pratham-cloud-ctrl/Project-ATO/docs/README.md

# Project ATO documentation

**[Open the browser build inspector](https://pratham-cloud-ctrl.github.io/Project-ATO/)**
for 3D models, PCB/component lookup, all four copper layers, schematic sheets
and standard/native downloads.

**[Open the Explore hub](explore/README.md)** for the current viewer guides.

| I want to… | Start here |
|---|---|
| Understand the research idea and mechanisms | [Theory](explore/theory.md) |
| Inspect the CAD and open editable models | [CAD & 3D](explore/cad.md) |
| Browse the boards and open KiCad | [Electronics](explore/electronics.md) |
| Understand the current target firmware | [Firmware](explore/firmware.md) |
| Assess the evidence or reproduce checks | [Reviewer guide](explore/reviewer-guide.md) |
| Locate the source behind a result | [Repository map](explore/repository-map.md) |

The [integrated paper](../output/pdf/Project_ATO_Integrated_Manuscript.pdf) is the
complete illustrated account. The [evidence audit](stage6/evidence-review.md),
[claim register](stage6/evidence-claims.csv) and
[requirements trace](stage6/requirements-claims-trace.csv) support detailed review.

The `stage1`–`stage6` folders preserve the development record. Their dates and
scope matter: an early allocation or historical subsystem is not automatically
the current implementation. The Explore guides identify the intended current
files without moving the preserved sources.
