pratham-cloud-ctrl/Project-ATO/electronics/stage4/integrated-pcb/provenance/exporter-sources/README.md

# Exact exporter source snapshots

The source snapshot is named by its LF-normalized SHA-256. It preserves the
actual source used for the first seven board exports before a final review
strengthened the exporter guard to require current native DRC hashes and exclude
the separately generated geometry receipt. It is evidence, not another entry
point to run. Use the current `export_boards.py` for future exports.

The current independent `verify_exports.py` checks every saved output, the
current source/DRC/project/schematic binding and the current STEP reimport receipt
for **all eight boards**, including earlier exports. Their already verified
geometry bytes are retained. No earlier render is relabeled as generated by a
new source revision.
