pratham-cloud-ctrl/Project-ATO/docs/stage3/mechanism-to-electronics-handoff.md

# Mechanism requirements for the detailed electronics design

12 October 2026. This is the handoff from reduced Stage 3 mechanisms to the
upcoming native electronics/firmware work. It is not a completed KiCad design,
selected monitor revision or implant qualification.

The system must retain the complete spinal recording → interpretation →
personalized stimulation → monitored response → feedback chain. Both retained
motor practice and specific physiological feedback use the platform, with
target-specific contacts and operating profiles. The existing Stage 2 FreeCAD
solids are allocation envelopes, not populated engineering CAD.

| Interface or responsibility | Present baseline / finding | Required detailed-design evidence |
|---|---|---|
| Recording | 16 contact streams at 4 kHz with timestamped block acquisition | Native differential acquisition/filter/ADC circuitry, noise/dynamic range, physical aperture timestamps, clipping and missing samples |
| Artifact/recovery | Digital residual qualification can reject recordings long after a train | Analog recovery/saturation analysis, route-coupled artifact model and recorded validity; the software counterfactual does not certify an AFE |
| Output | Two independent physical sources, whole 40 Hz reference profiles | Source/routing ownership, simultaneous-source service, waveform sequencing and no fractional catch-up pulses |
| Delivered dose | Independent current/charge/compliance observations; nominal uncertainty about 44.1% of phase charge | A revised independently evidenced integration/edge/guard scheme if tighter precision is needed; correlated errors and interrupted dose retained |
| Timing | 11.85 ms processing allocation plus support age, frame wait and observed response onset | Actual embedded schedules, buffering and worst-case latency, observed clock bounds, expiration and cancellation |
| Response authority | Actual motor authority remains negative; finite conditional resting maps only | Profile/route/context-bound mapping and uncertainty, including the product of gain and dose uncertainty; unsupported cases inhibit |
| Forecasting | New frozen external observer passes its finite no-dose confirmation; historical assisted-context validation still fails | Whole-prefix state/calibration resources, pre-dose freeze or qualified response correction, explicit support/horizon domain, target implementation; future commanded dose cannot be treated as measured |
| Pressure feedback | External pressure supports the selected model; dense active blocks do not qualify neural recording | Sensor transport/support/freshness, feedback/fallback state machines and appropriate power/rate allocations; no invented neural pressure value |
| Fault supervision | Offline pulse admission/rearm and finite fallback witnesses exist | Continuous route switching, guard latency, waveform faults, link loss, reboot and power behavior exercised in native circuit/firmware models |
| Power/package | Stage 2 budgets include rejected continuous strong-pressure and all-max cases | Recalculate instantaneous/average power, heat, memory and buses for actual components; populate matched CAD envelopes |

The current monitor candidate allocates 1 MHz aggregate ADC throughput and a
16 Mbit/s shared bus. Those limits apply across both sources and health/voltage
traffic. Prospective sampling rates from the
[precision requirements](motor-precision-requirements.md) are a redesign demand,
not approved settings on the existing architecture. More samples alone do not
prove a smaller edge, intersample waveform or gain error.

KiCad, ngspice, FreeCAD/build123d and Blender are already available in the
[verified free toolchain](toolchain-selection.md). Use KiCad for native electrical
sources and board layout, ngspice for scoped circuit evidence, and parametric
FreeCAD/build123d assemblies for component/package fit. Blender follows the
engineering geometry for technical views. No new paid software is required for
this handoff.

Keep interfaces, units, profile IDs and evidence qualifications machine readable.
Revise channel, monitoring, power or package budgets openly when mechanism work
requires it. A polished enclosure or PCB must not hide an unresolved causal link.

## New precision and timing input, 9 October 2026

The [observed-map requirements](delivery-requirements.md) add four fresh
calibrations and 24 precision thresholds. A prospective 4%-of-nominal charge
uncertainty is a circuit investigation target for selected single-route
corrections with an illustrative 8 mm forecast allocation. It is not an already
qualified monitor or predictor. At a 15 mm forecast input the corresponding
single-route target tightens below 0.5%; simultaneous full two-source correction
fails even with a perfect monitor because response uncertainty remains.

The [new predictor](assisted-prediction.md) admits selected finite predetermined
recordings but rejects changed response/faster/dense contexts. Dynamic
execution-time response and policy qualification are separate requirements in
the [coupling specification](dynamic-coupling-specification.md). Native firmware
must carry live dose intervals, physical support/availability, tested domain IDs
and cancellation state, rather than accepting a saved context name as authority.

New neural captures use [actual electrode apertures](source-sensitivity.md).
The digital bound does not establish analog AFE settling. Dense stimulation still
requires explicitly labeled external fallback in the tested configuration.

## Connected pilot and native monitoring input, 12 October 2026

The [reset-trial pilot](isolated-pilot.md) combines independent expert-reference
error, a zero-future baseline, finite-frame response intervals and timed delayed
residual cancellation. Its conservative learner-drift forecast gate fails before
any pulse is admitted. Improved charge precision alone cannot repair that
forecast. The fixed 15 mm baseline and 25 mm complete-correction allocations
remain unchanged.

Runtime firmware must retain tested support ranges and exact past-action
prefixes in addition to model/context IDs. Intersections must preserve holes in
validated coverage. Cached permission cannot replace a fresh guard check before
each launch; total measurement loss must expire pending forecasts.

The [Stage 4 entry plan](../stage4/entry-plan.md) starts a separate native
two-source Kelvin-shunt, signed-integrator and endpoint-monitoring circuit. Each
cathodic/anodic phase, net charge and recovery tail requires an observed window;
the final bipolar integral alone would conceal opposing phase errors. An
independent fault latch must also inhibit output. Its component power and input
bias may revise the Stage 2 allocation. Schematic/ERC correctness does not earn
the proposed 4% dose interval: continuous waveform, settling, window boundaries,
leakage and interrupted-charge errors still need quantified circuit evidence.

## Confirmed external observer and bounded integration input

The [separate observer confirmation](../../experiments/stage3/observed-state-observer/README.md)
retains 16 new sensor-noise pairs on two grids, with all 915,200 coordinate
residuals audited. The largest error plus the unchanged 3 mm label allowance is
11.354 mm, below the 15 mm forecast gate. This finite result uses one measured
prior, the whole accepted position prefix and a declared 60 ms synthetic
movement prior. It is external sensing, not evidence of useful live spinal
information. It does not replace the historical negative pilot.

The [reviewed pre-dose freeze](observer-integration-plan.md) seals the observer
at decision 0.975 s after consuming supports through 0.950 s. It records all 26
targets from 0.975 to 1.100 s, including a separate delayed diagnostic for the
target equal to creation time. After sealing, positions feed independent guards
only. A new measurement cannot revise the frozen candidate or grant a second
shot. Forecast authority ends at 1.100 s; it is not extended by an empty queue.
These clocks are a finite simulation contract, not measured embedded deadlines.

Two blocks remain independent of baseline prediction. The actual monitored
dose has approximately 44.1% nominal-charge uncertainty, and every inherited
isolated motor action domain rejects. In addition, inherited response
validation disabled learning. A stimulation-induced change to voluntary
movement in a learning-enabled trial requires a separately observed interaction
allowance; it cannot be absorbed into the no-dose predictor or assumed zero.
Neither a tighter proposed monitor nor a passing observer alone authorizes a
nonzero learning intervention.

Firmware cannot copy the desktop implementation without a resource redesign.
It has ten state means and 55 unique covariance entries, plus 101 learned prior
and drift entries. Python stores the full 100-entry covariance; its optional
transition cache alone can reach 1,638,400 bytes, above the proposed 512 KB RAM.
The [linked SDK example](../stage4/firmware-toolchain.md) proves compiler setup
only. Actual observer/controller memory, execution time, ADC/DMA, timer, bus and
supervision backends remain required Stage 4 evidence.

Keep prospective forecasts immutable after launch. A completed independent
monitor may supply a new actual-dose interval only when it becomes available;
it must not rewrite earlier commitments or erase a physically delivered phase.
The observed response window ends at 600 ms lag with no qualified release rule.
Unknown residual response remains unavailable rather than becoming zero.
Hard-OFF assessment, pending queues, inhibition and physical rearm therefore
need explicit target state machines. A full simulator reset is a declared
washout premise, not a future implant recovery mechanism.
