pratham-cloud-ctrl/Project-ATO/electronics/stage4/integrated-pcb/BOARD_INDEX.md

# Populated board index

Open the [master schematic project](integration/master/ATO_integrated.kicad_pro) with
`OPEN_MASTER_KICAD.cmd`. Each board has an explicit PCB Editor launcher below.
These use the installed KiCad executable and do not depend on Windows file associations.
On another installation set `ATO_KICAD_BIN` to its KiCad 10 `bin` directory.

The board set has 1,298 electrical positions, 1,296 fitted components and 32
mechanical mounting holes. Two optional driver capacitors remain DNP.
Native previews may show optional package placements; fitted STEP and placement
exports explicitly honor the original population flags. All geometry is nominal.

| Board | Native PCB / launcher | Fitted / positions | Size, mm | 3D / copper / fabrication |
|---|---|---:|---|---|
| Monitoring Cell | [PCB](boards/monitoring-cell/monitoring_cell.kicad_pcb) · [launcher](OPEN_MONITORING_CELL.cmd) | 71 / 71 | 120 × 145 | [STEP](exports/monitoring-cell/populated.step) · [top](exports/monitoring-cell/top.png) · [3D](exports/monitoring-cell/isometric.png) · [copper](exports/monitoring-cell/top-copper.svg) · [fabrication reference](exports/monitoring-cell/fabrication-reference/README.md) |
| Current Driver | [PCB](boards/current-driver/current_driver.kicad_pcb) · [launcher](OPEN_CURRENT_DRIVER.cmd) | 154 / 156 | 175 × 155 | [STEP](exports/current-driver/populated.step) · [top](exports/current-driver/top.png) · [3D](exports/current-driver/isometric.png) · [copper](exports/current-driver/top-copper.svg) · [fabrication reference](exports/current-driver/fabrication-reference/README.md) |
| Recording Front End | [PCB](boards/recording-front-end/recording_front_end.kicad_pcb) · [launcher](OPEN_RECORDING_FRONT_END.cmd) | 153 / 153 | 155 × 190 | [STEP](exports/recording-front-end/populated.step) · [top](exports/recording-front-end/top.png) · [3D](exports/recording-front-end/isometric.png) · [copper](exports/recording-front-end/top-copper.svg) · [fabrication reference](exports/recording-front-end/fabrication-reference/README.md) |
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
