pratham-cloud-ctrl/Project-ATO/cad/stage5/future-interface/future-exploded-native.png

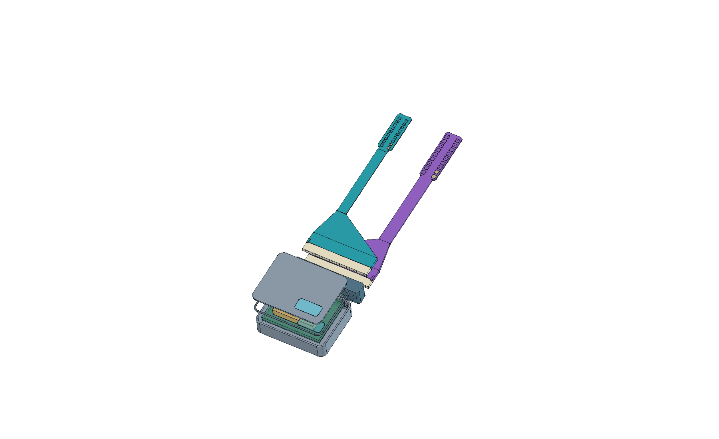
cad/stage5/future-interface/future-exploded-native.png
