pratham-cloud-ctrl/Project-ATO/cad/stage5/reference-full-native.png

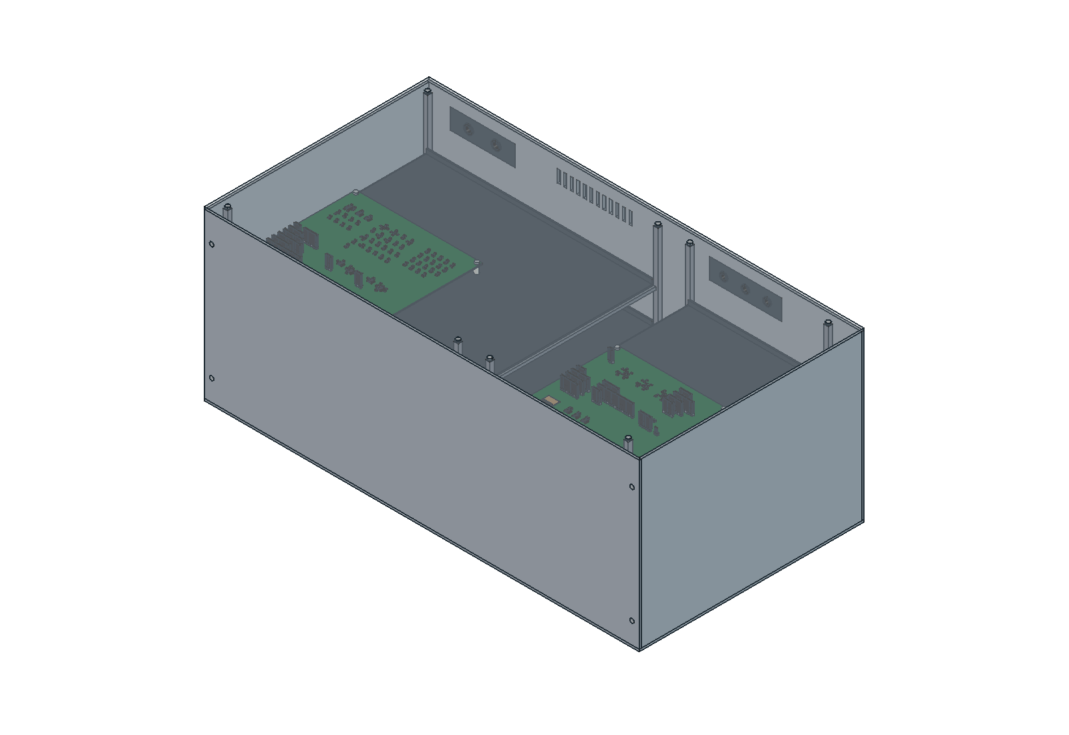
cad/stage5/reference-full-native.png
