pratham-cloud-ctrl/Project-ATO/cad/stage5/reference/drawings/contact-router-tray.png

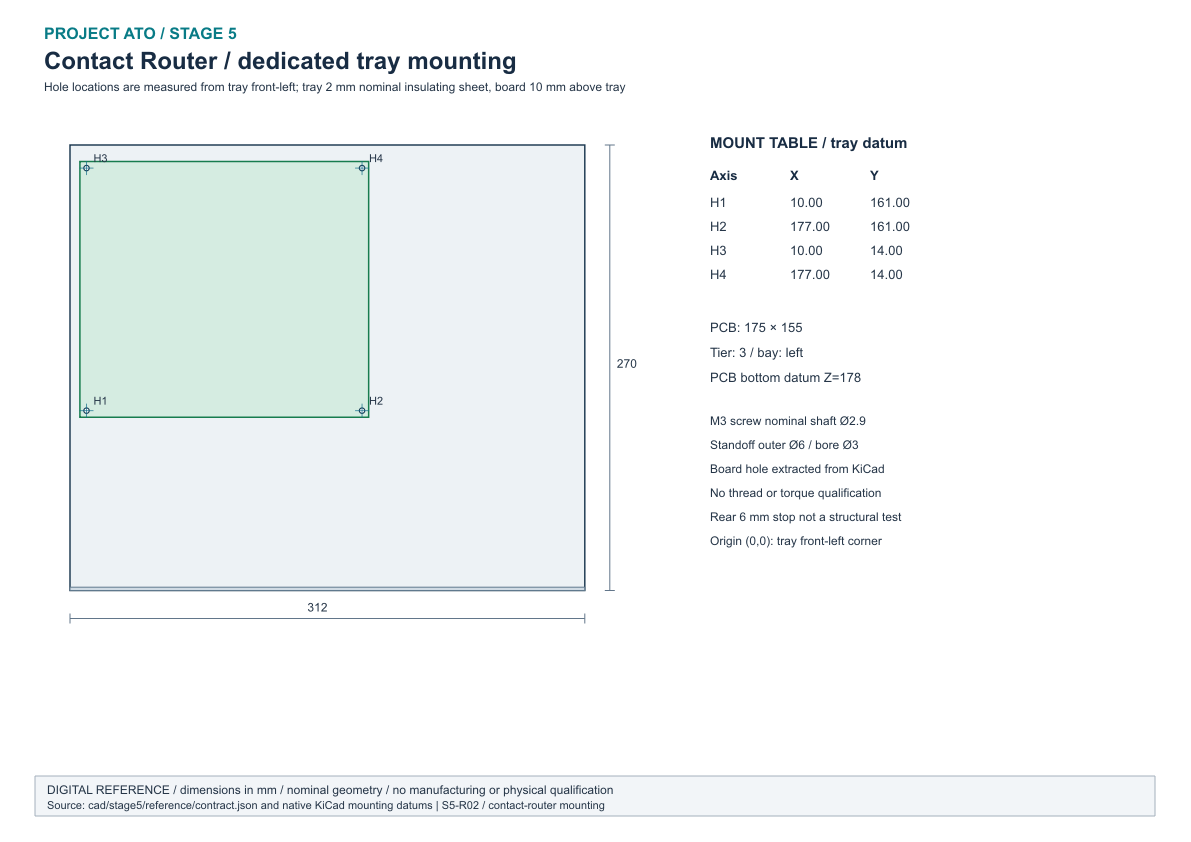
cad/stage5/reference/drawings/contact-router-tray.png
