pratham-cloud-ctrl/Project-ATO/cad/stage5/reference/drawings/controller-carrier-tray.png

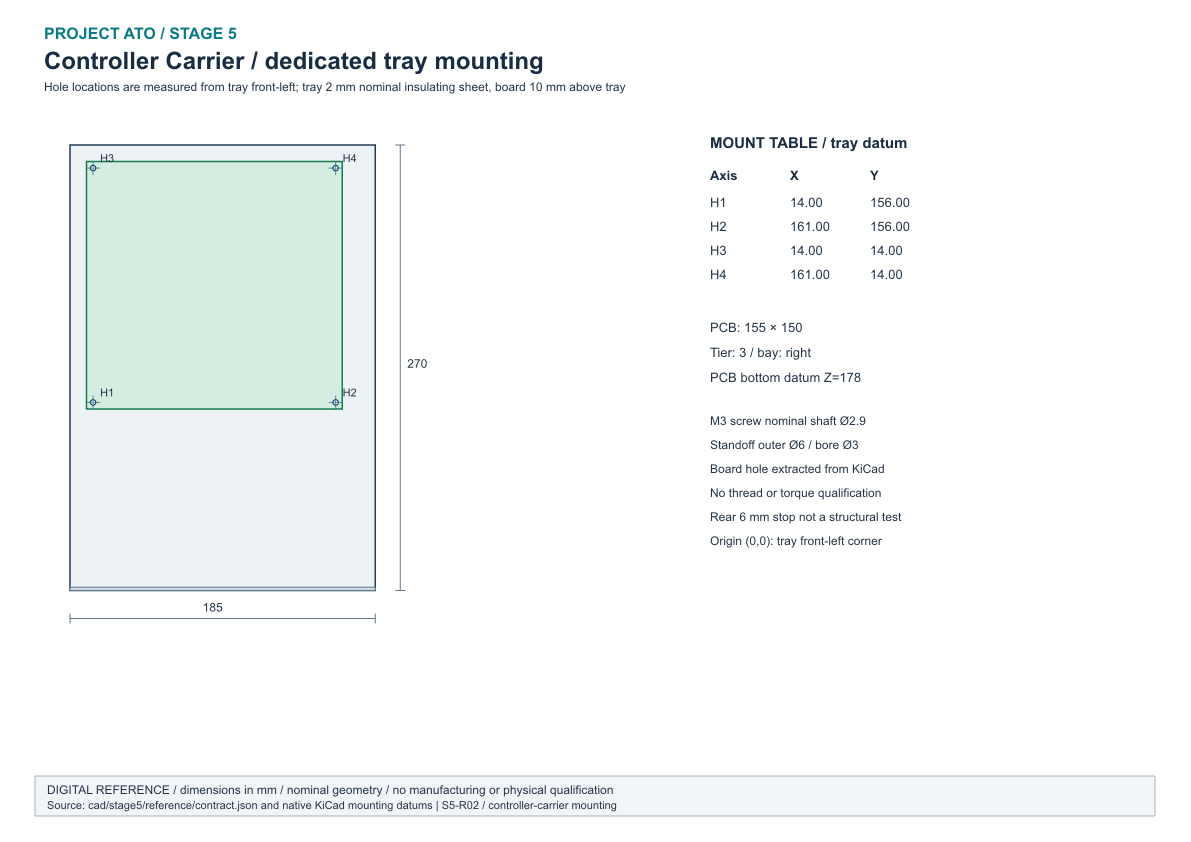
cad/stage5/reference/drawings/controller-carrier-tray.png
