pratham-cloud-ctrl/Project-ATO/cad/stage5/reference/drawings/reference-layout.png

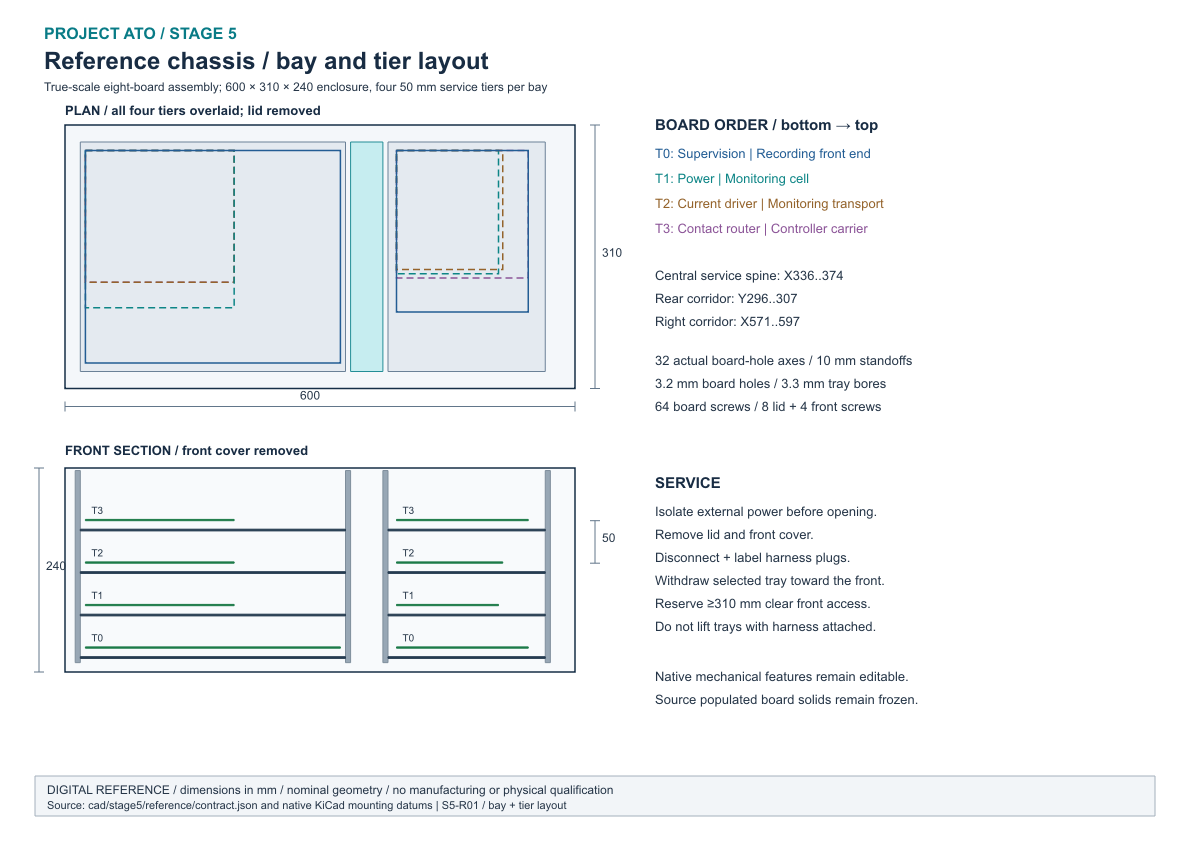
cad/stage5/reference/drawings/reference-layout.png
