pratham-cloud-ctrl/Project-ATO/cad/stage5/reference/drawings/supervision-tray.png

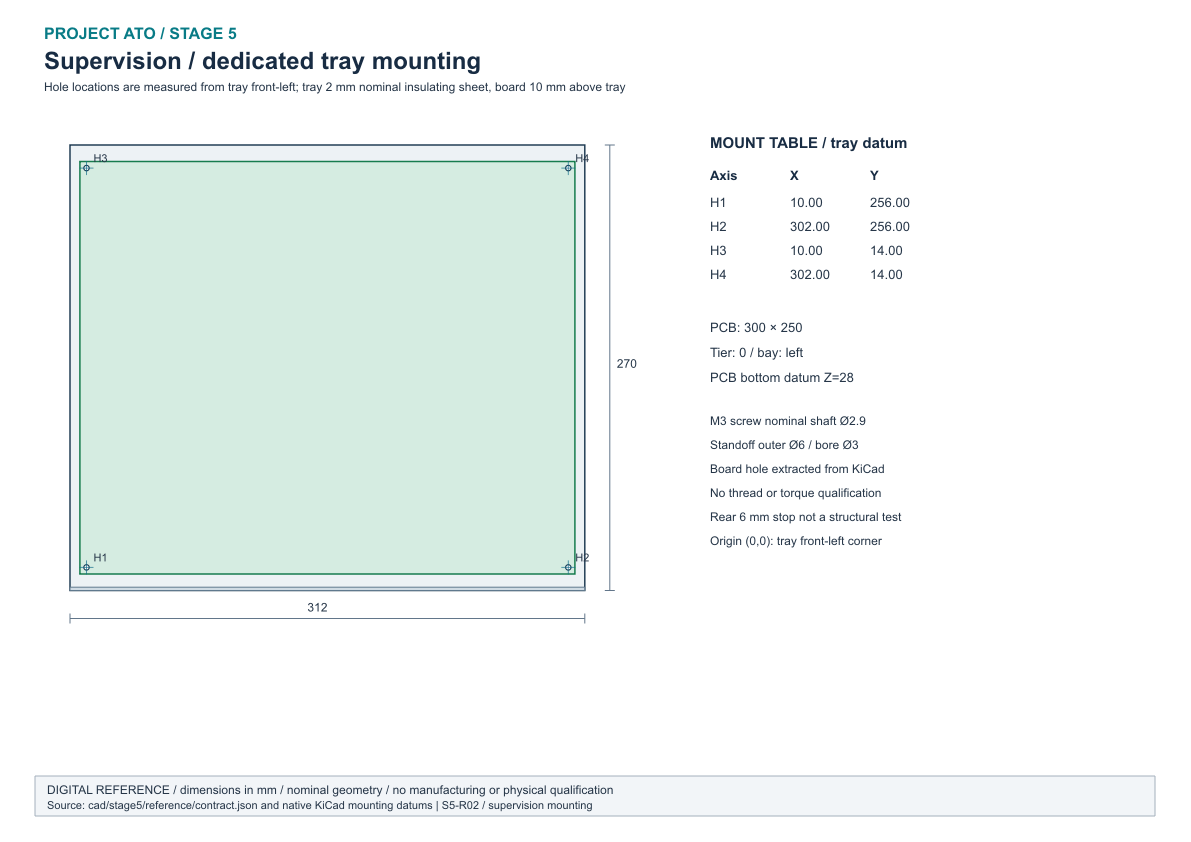
cad/stage5/reference/drawings/supervision-tray.png
