pratham-cloud-ctrl/Project-ATO/cad/stage5/renders/future_exploded.png

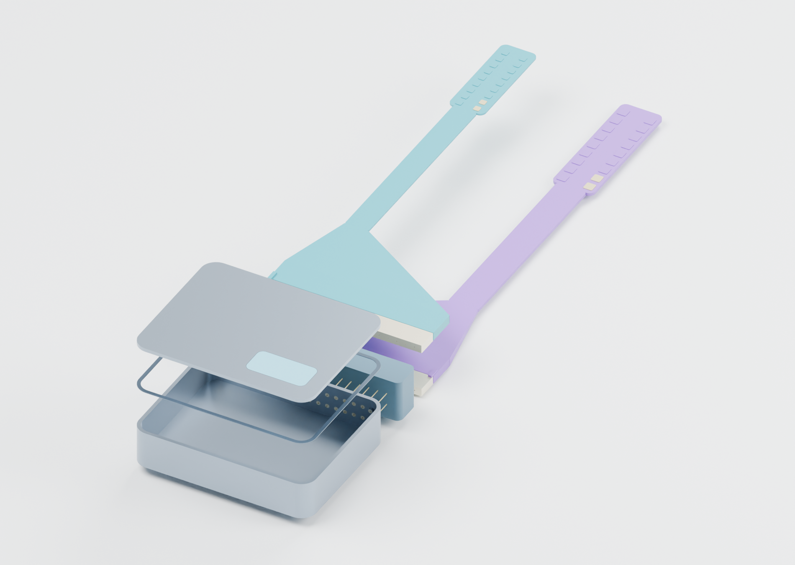
cad/stage5/renders/future_exploded.png
