pratham-cloud-ctrl/Project-ATO/docs/explore/inspector-review/reference-open.jpg

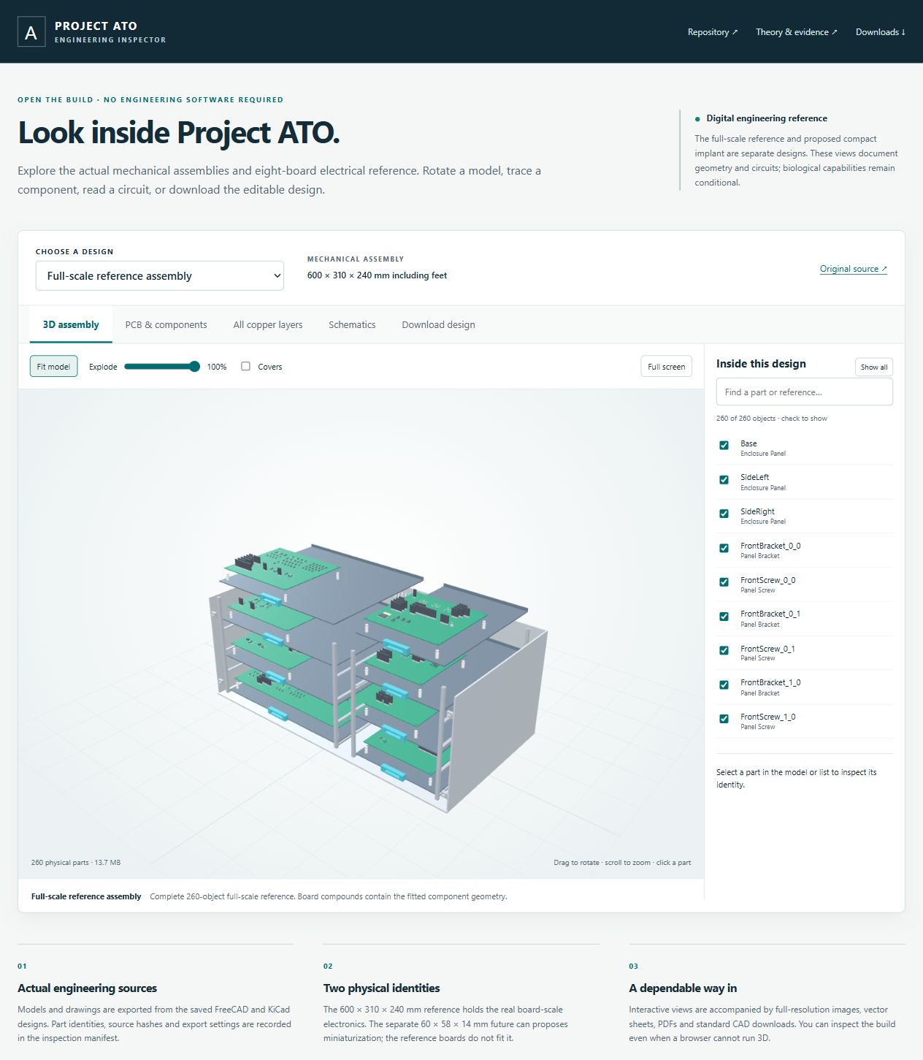
docs/explore/inspector-review/reference-open.jpg
