pratham-cloud-ctrl/Project-ATO/docs/stage1/figures/expert-learning.png

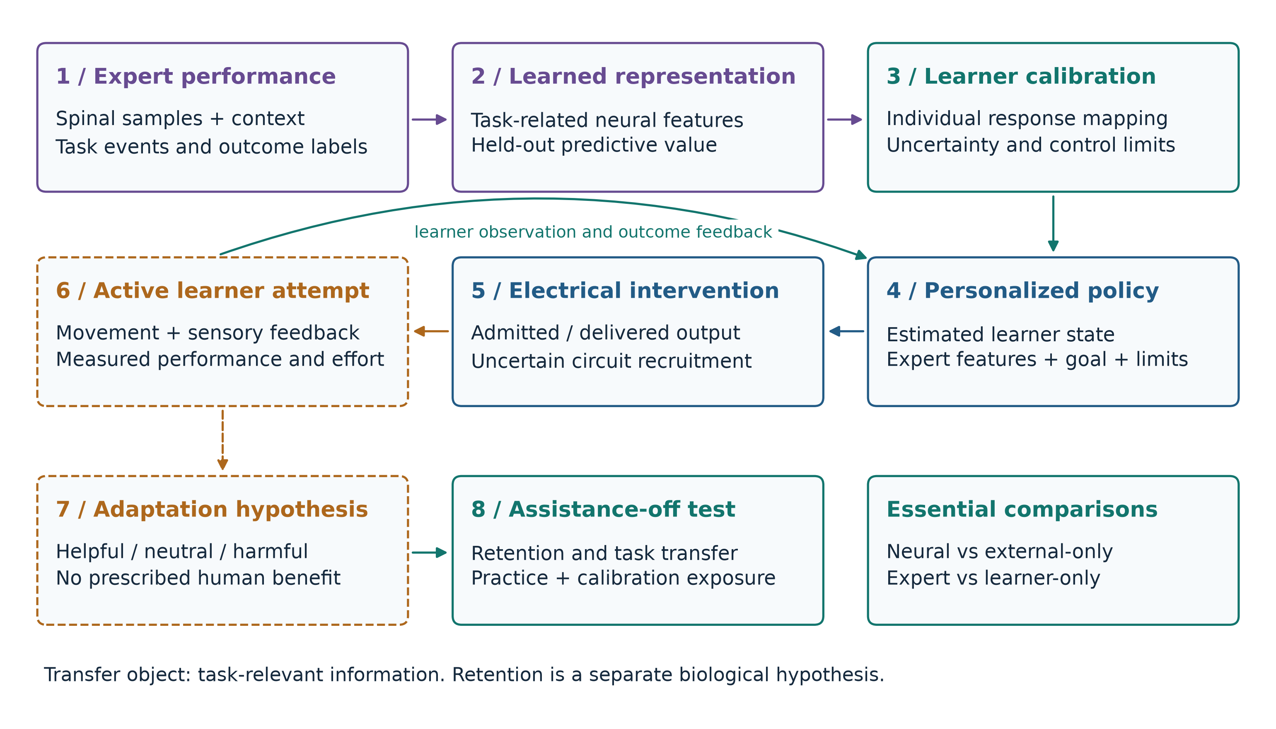
docs/stage1/figures/expert-learning.png
