pratham-cloud-ctrl/Project-ATO/docs/stage1/figures/full-system.png

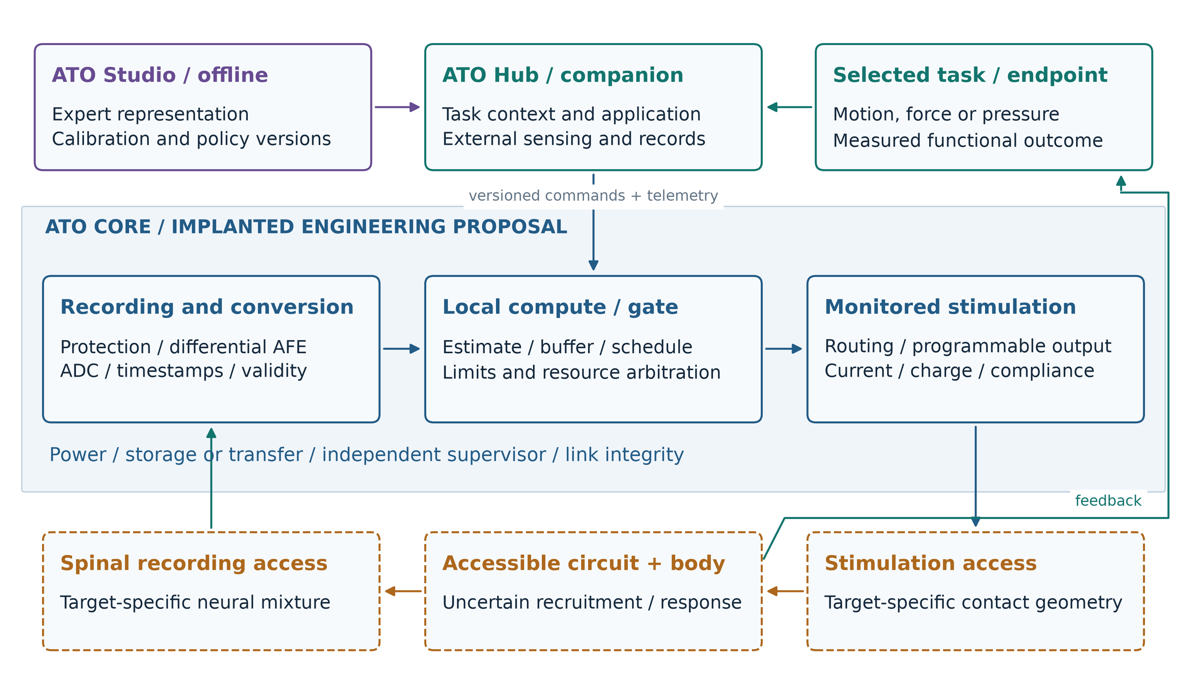
docs/stage1/figures/full-system.png
