pratham-cloud-ctrl/Project-ATO/docs/stage1/figures/physiological-control.png

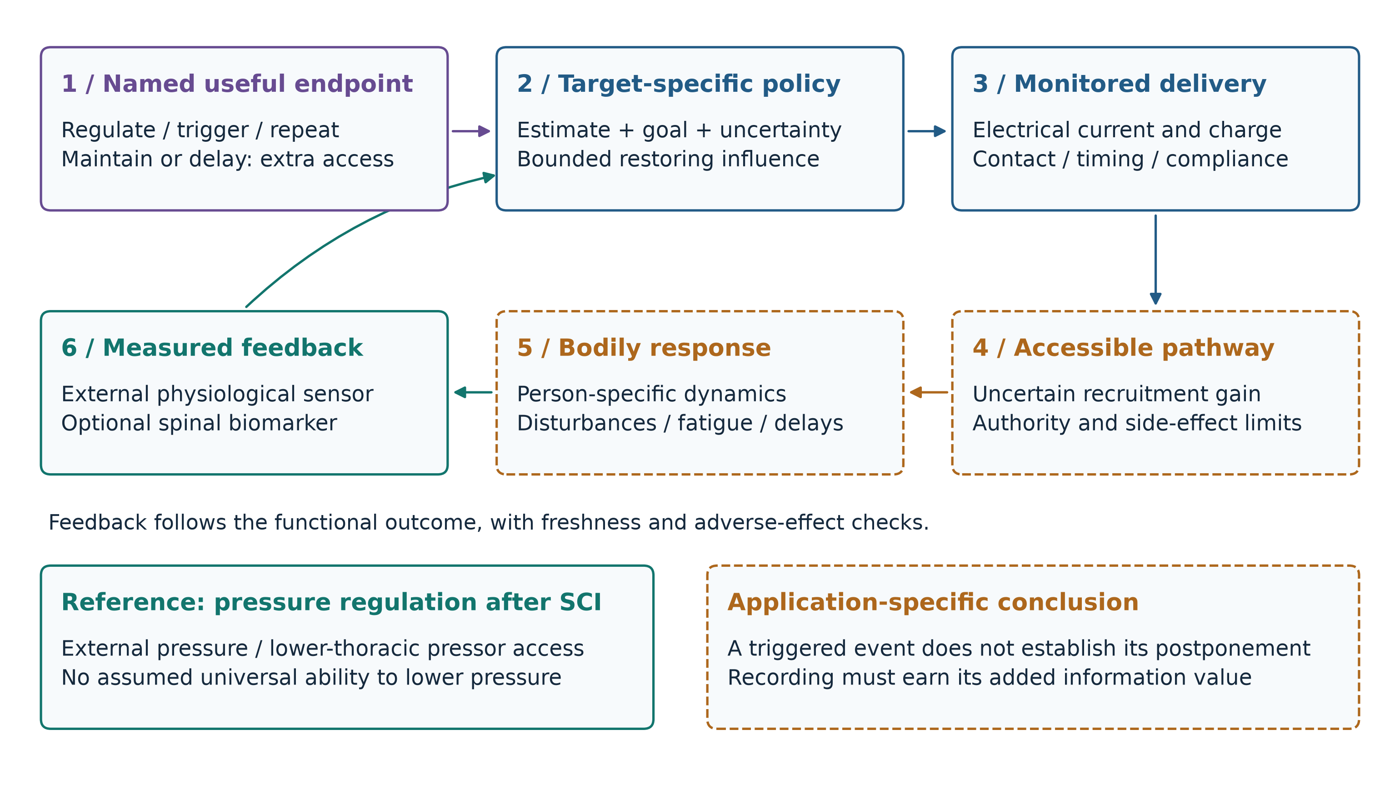
docs/stage1/figures/physiological-control.png
