pratham-cloud-ctrl/Project-ATO/docs/stage2/figures/artifact-timing.png

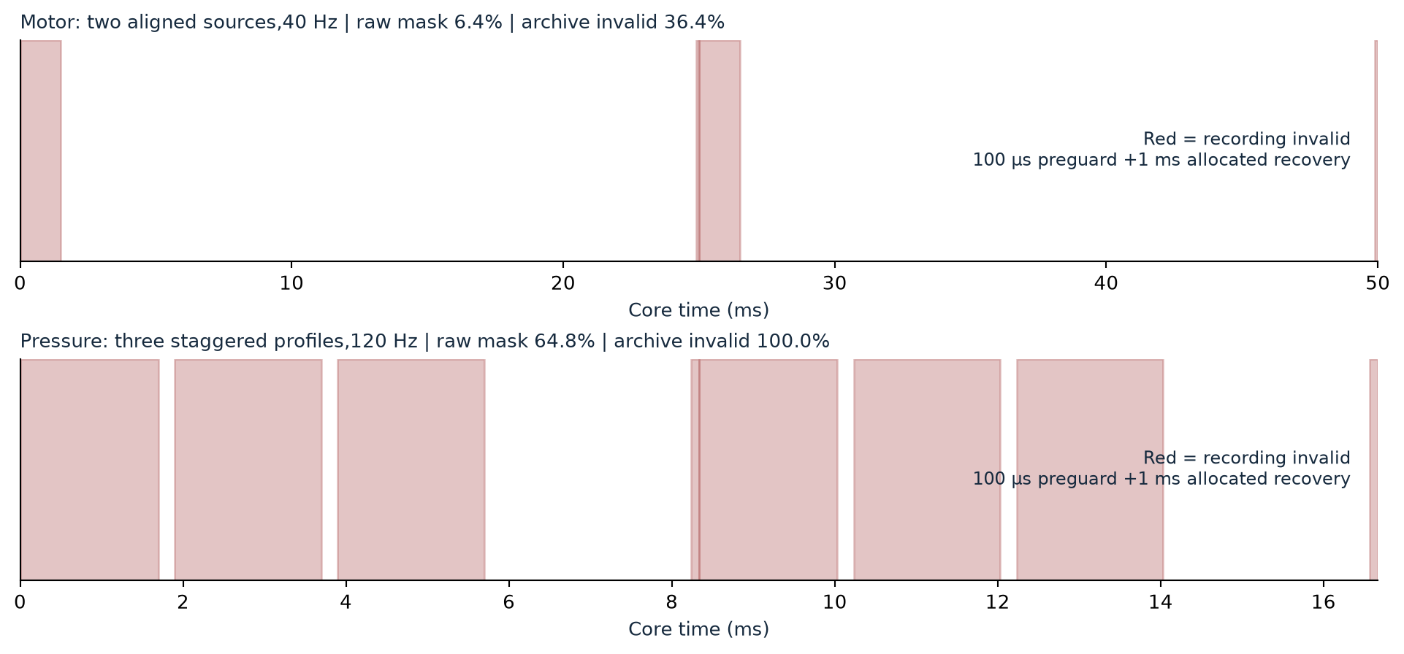
docs/stage2/figures/artifact-timing.png
