pratham-cloud-ctrl/Project-ATO/docs/stage2/figures/compliance-monitor.png

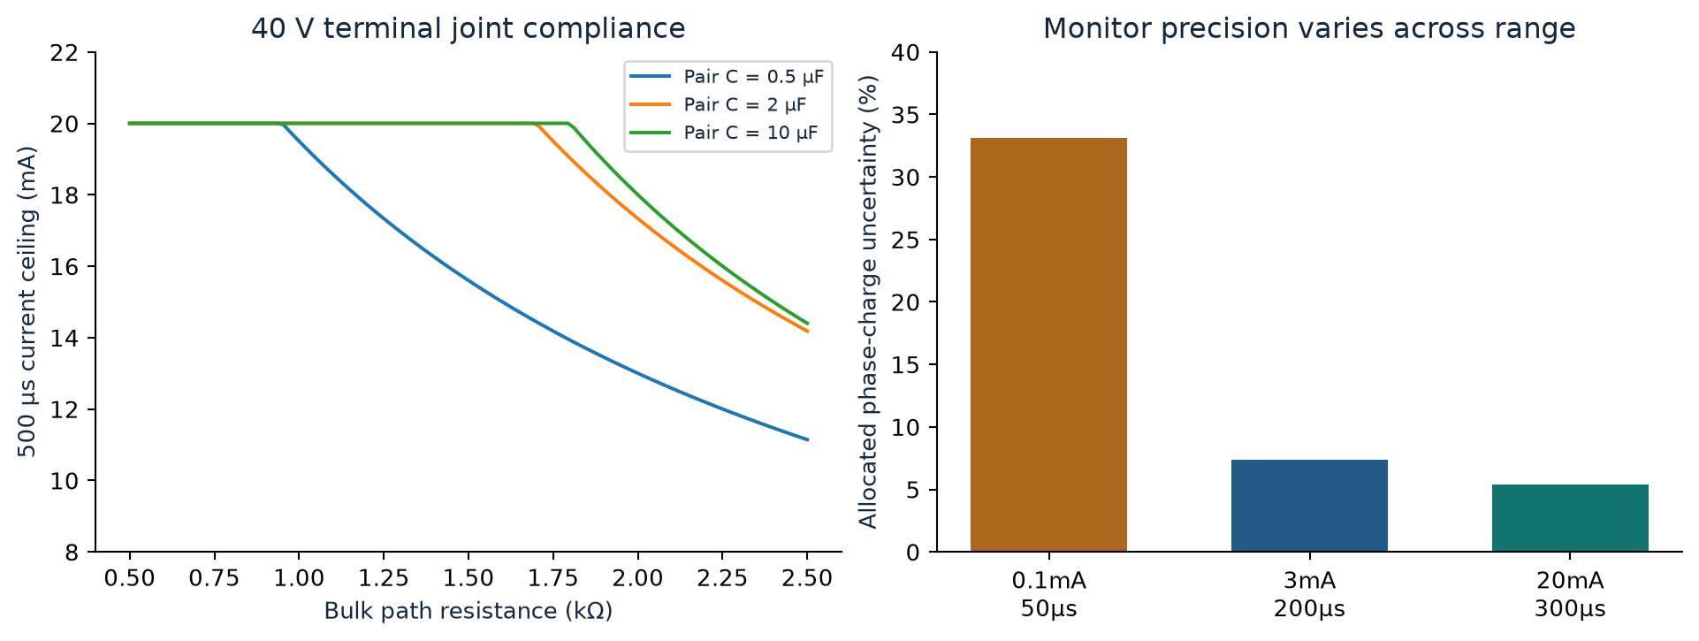
docs/stage2/figures/compliance-monitor.png
