pratham-cloud-ctrl/Project-ATO/docs/stage2/figures/mechanical-allocation.png

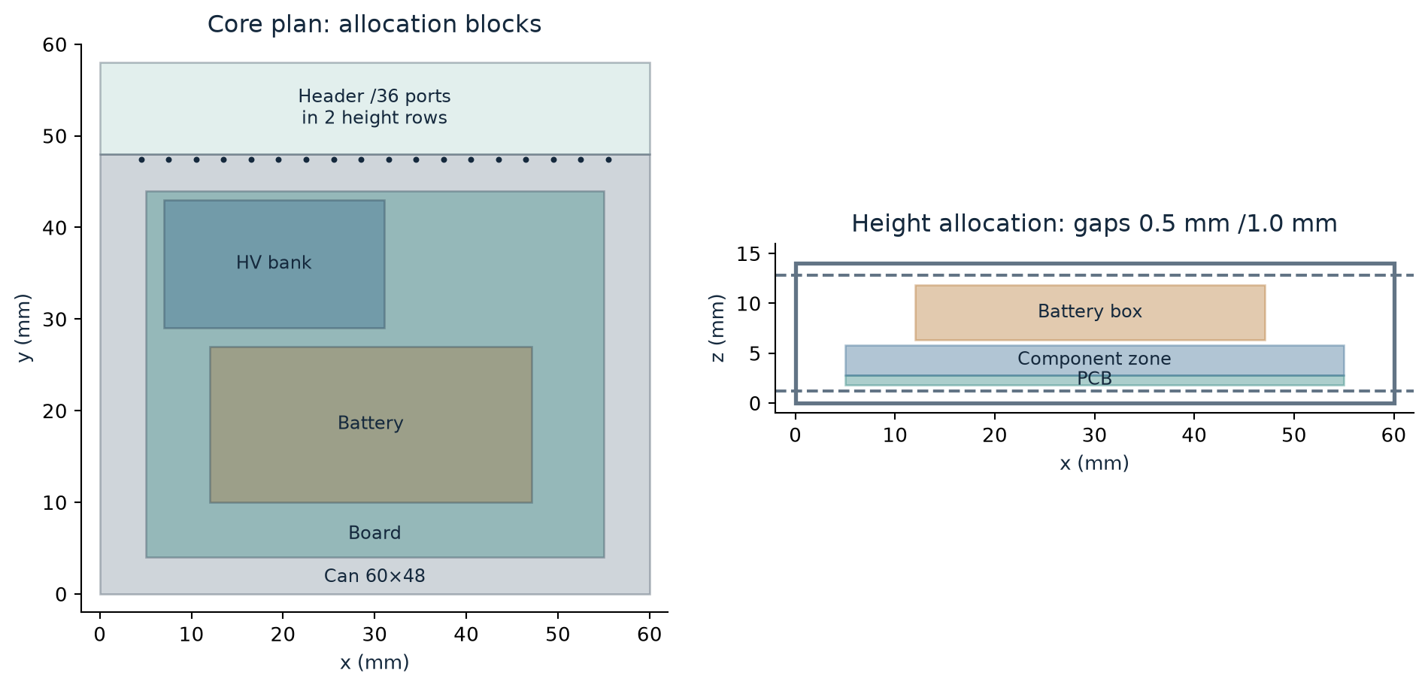
docs/stage2/figures/mechanical-allocation.png
