pratham-cloud-ctrl/Project-ATO/docs/stage2/figures/power-envelope.png

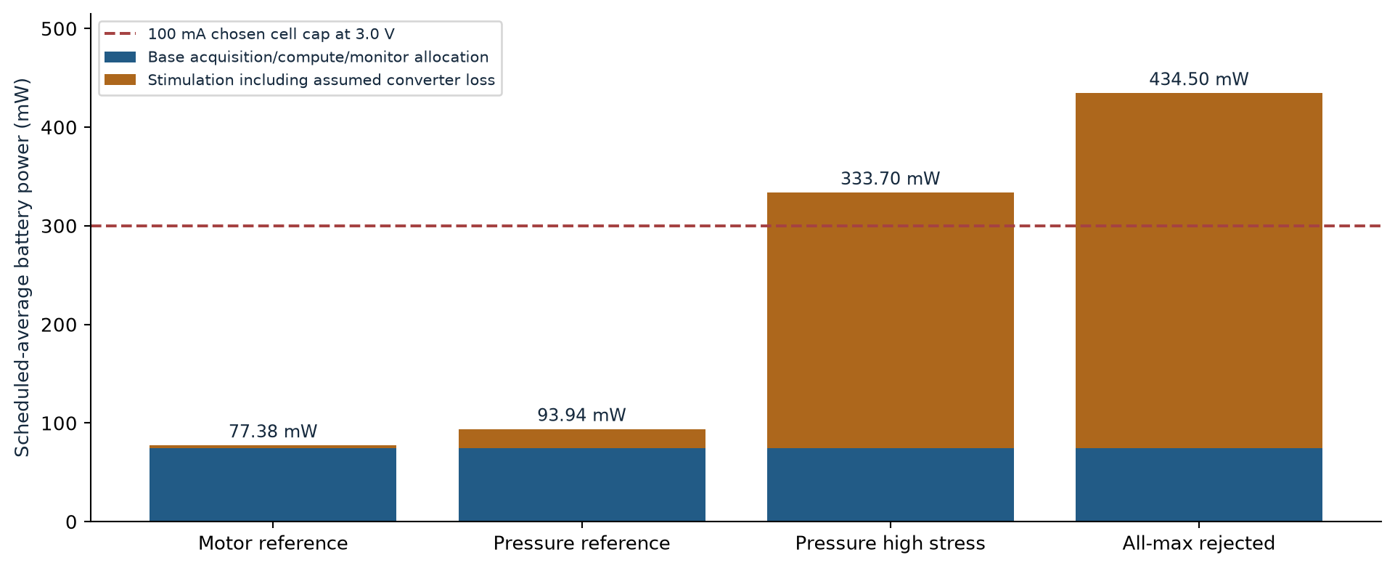
docs/stage2/figures/power-envelope.png
