pratham-cloud-ctrl/Project-ATO/docs/stage2/figures/recording-compute.png

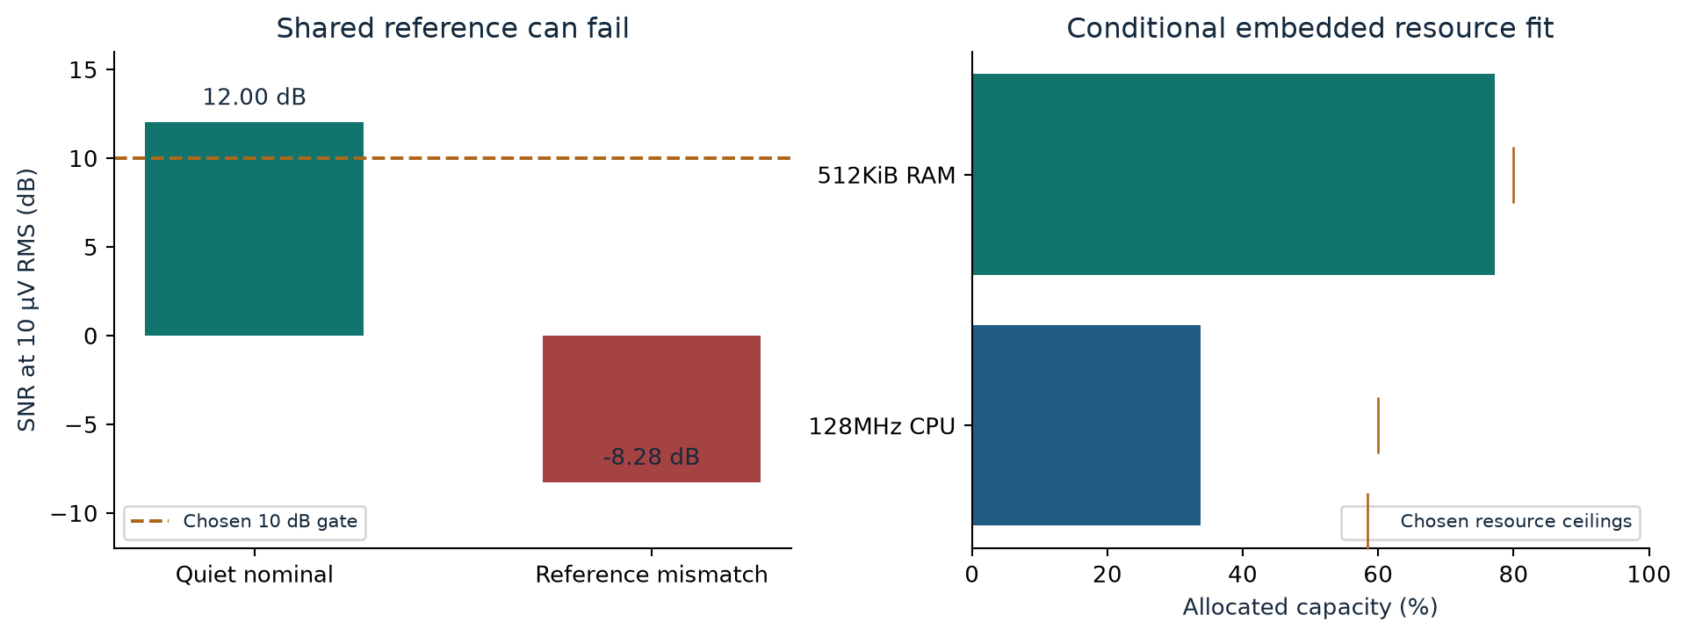
docs/stage2/figures/recording-compute.png
