pratham-cloud-ctrl/Project-ATO/docs/stage2/figures/thermal-envelope.png

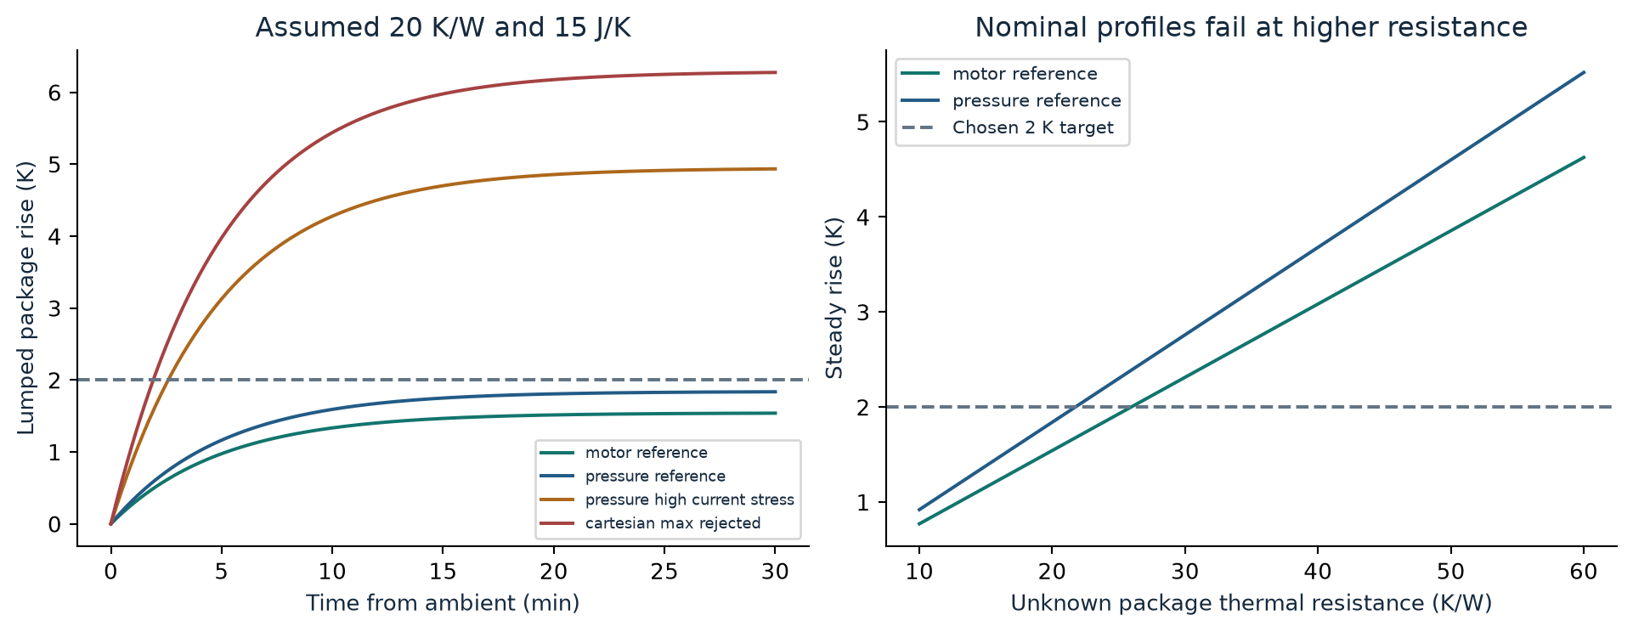
docs/stage2/figures/thermal-envelope.png
