pratham-cloud-ctrl/Project-ATO/docs/stage3/figures/acquisition-qualification.png

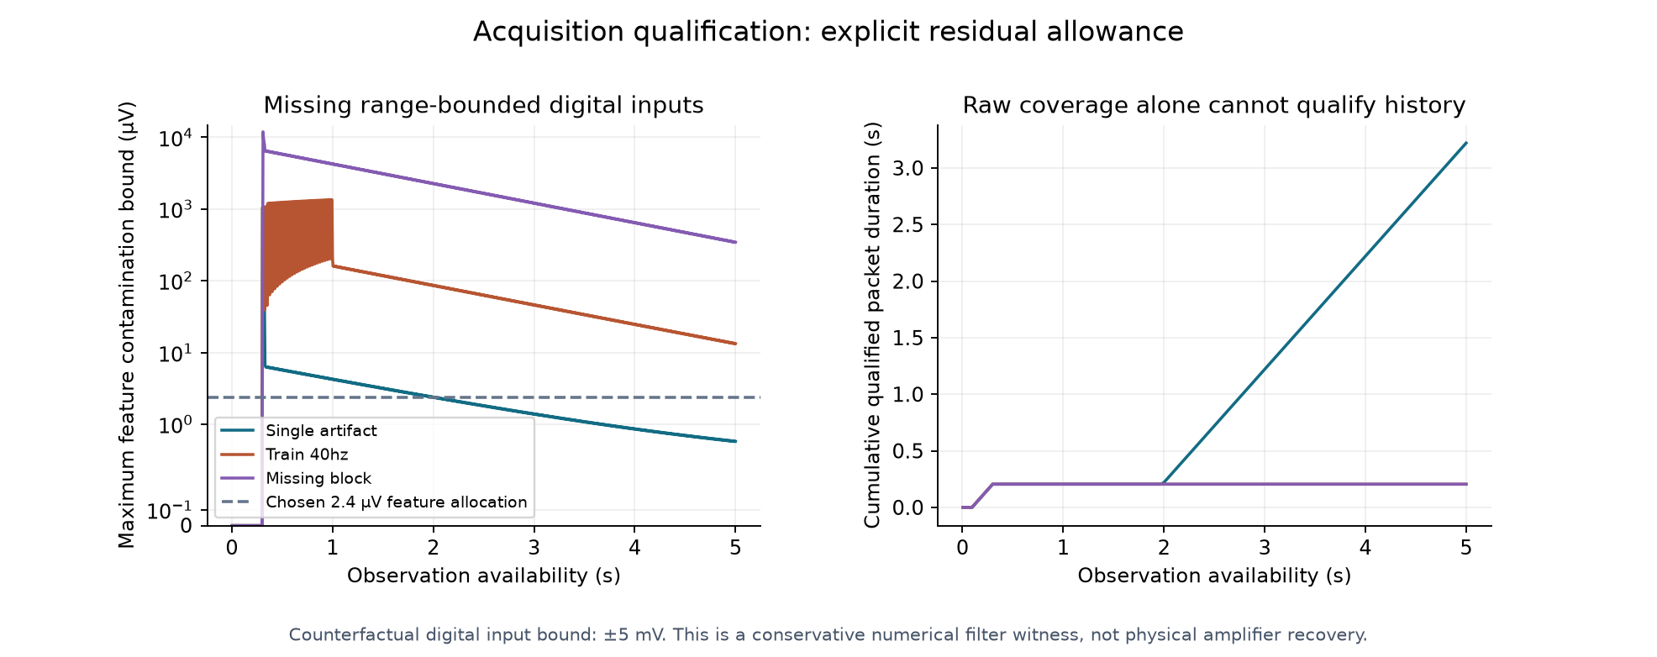
docs/stage3/figures/acquisition-qualification.png
