pratham-cloud-ctrl/Project-ATO/docs/stage3/figures/conditional-motor-comparisons.png

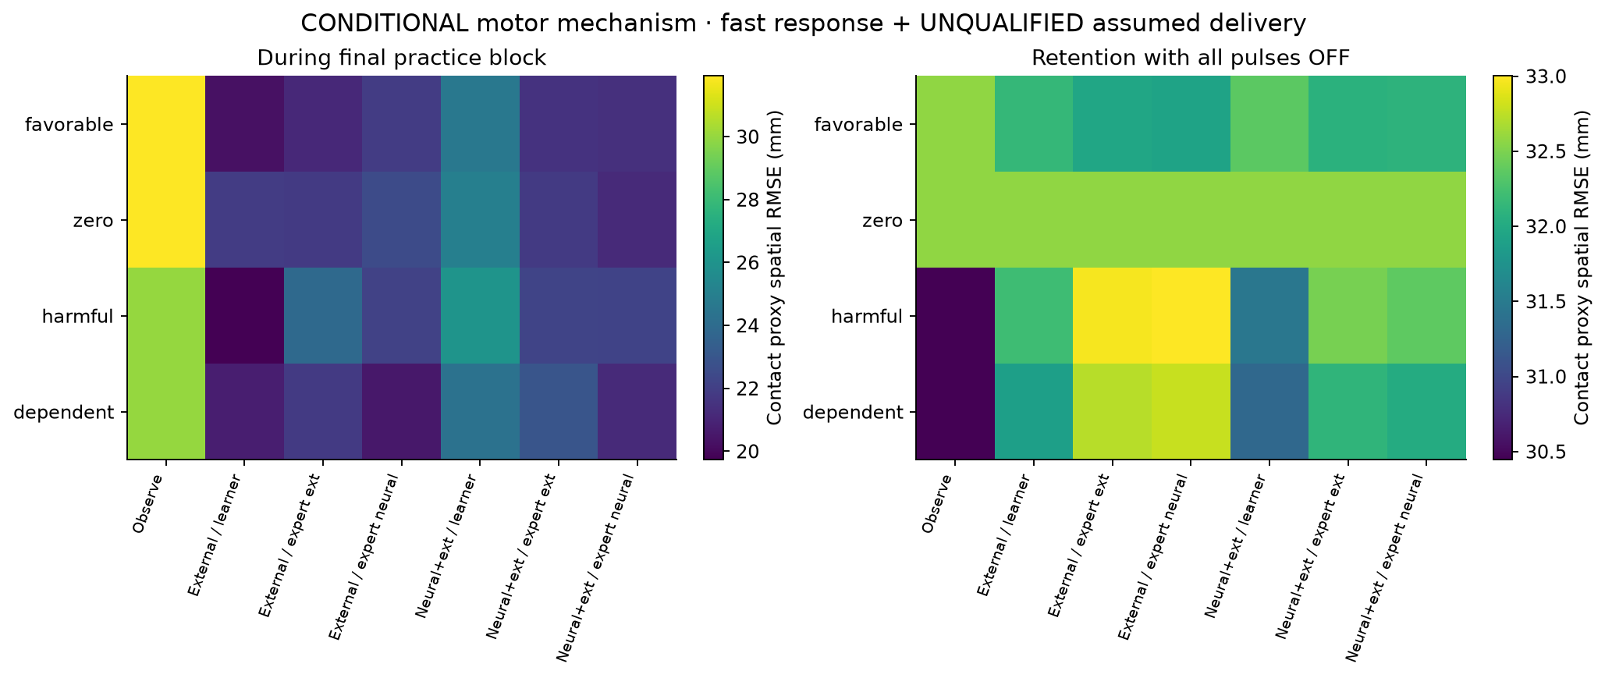
docs/stage3/figures/conditional-motor-comparisons.png
