pratham-cloud-ctrl/Project-ATO/docs/stage3/figures/electrical-delivery.png

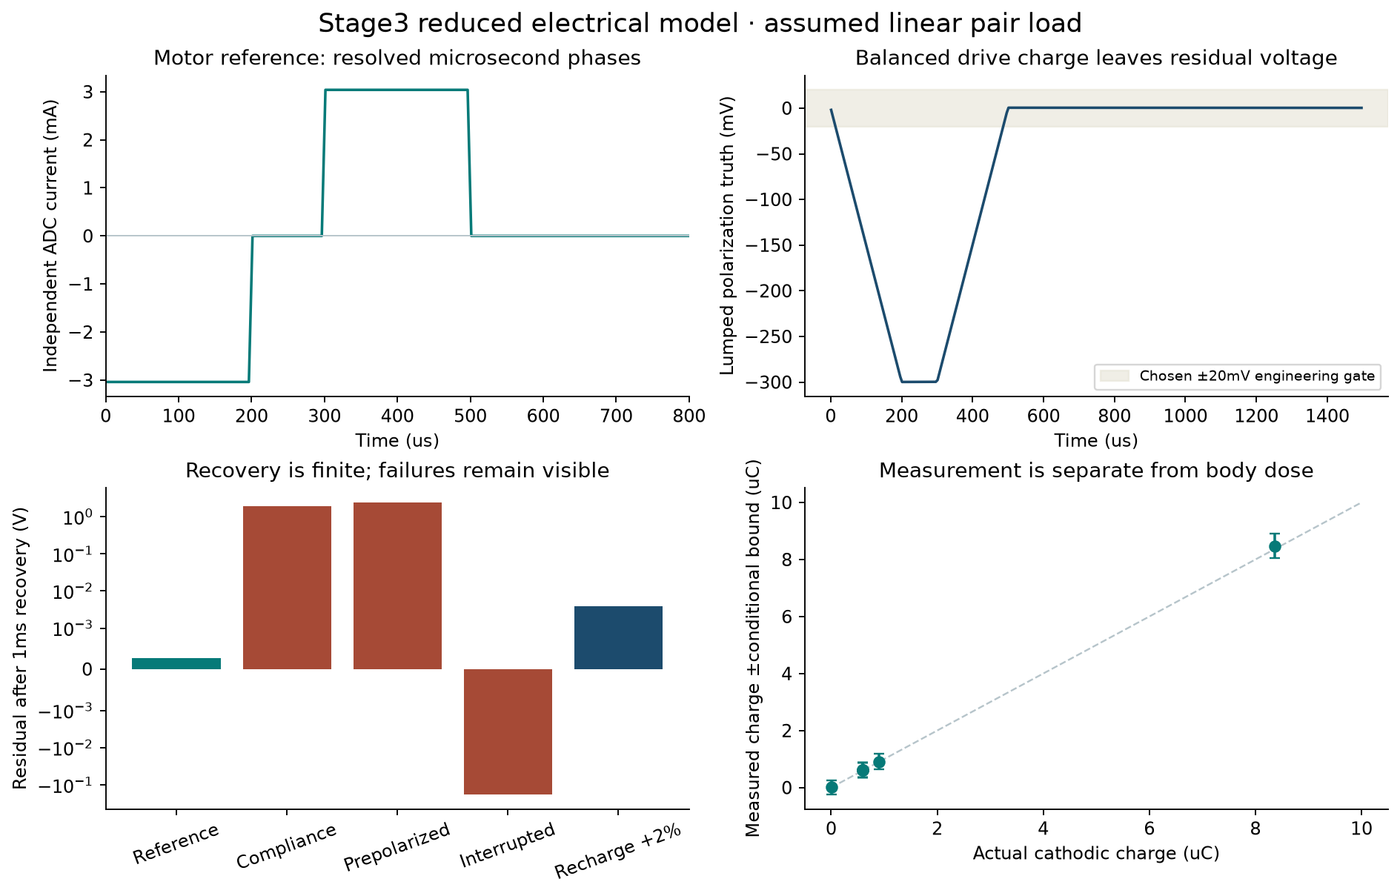
docs/stage3/figures/electrical-delivery.png
