pratham-cloud-ctrl/Project-ATO/docs/stage3/figures/mechanism-revision.png

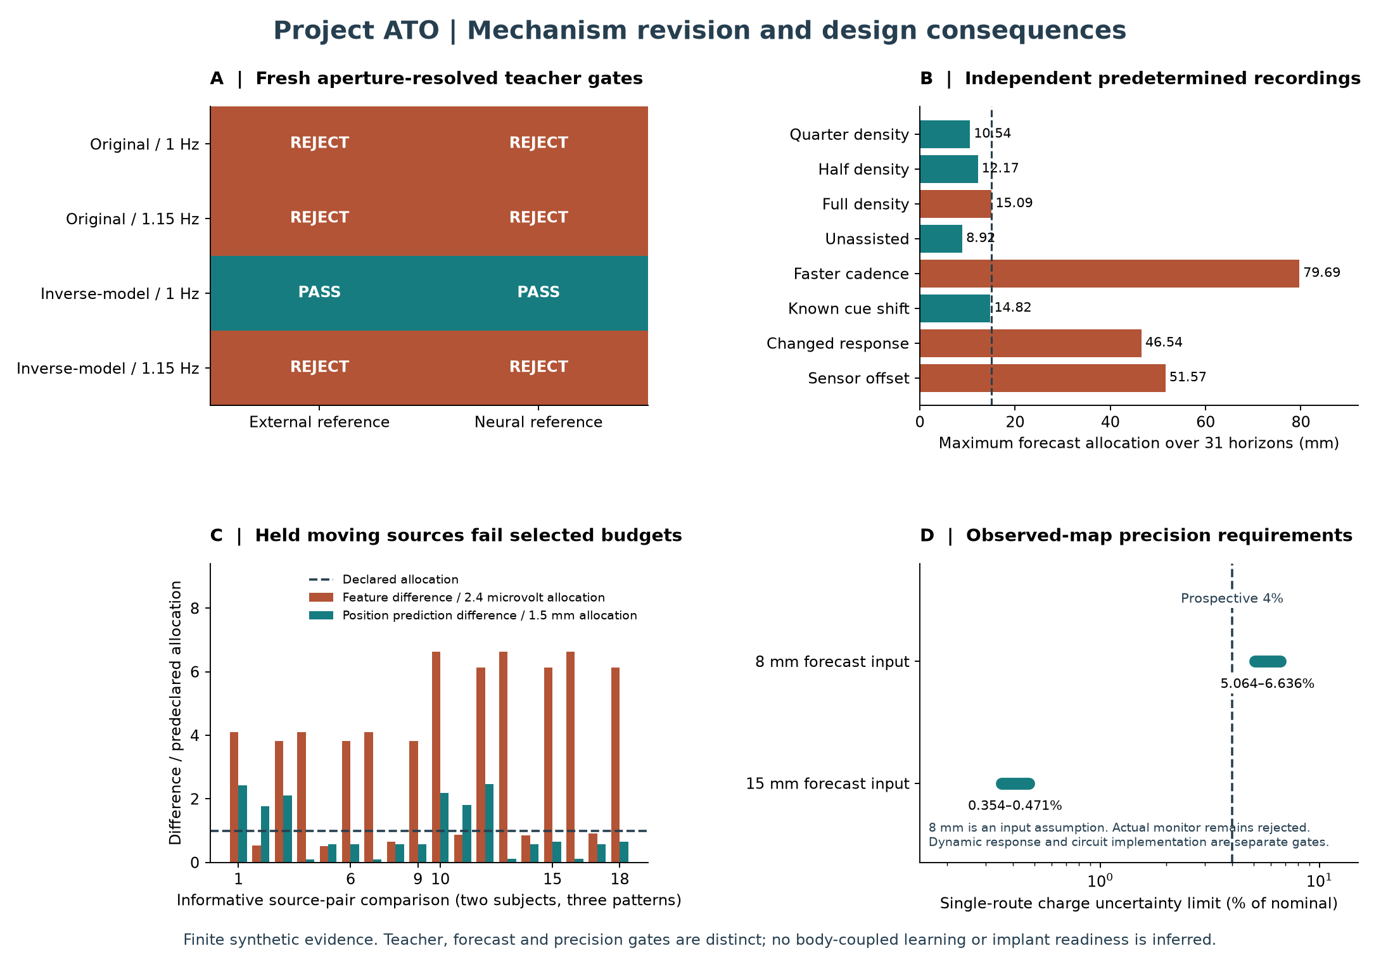
docs/stage3/figures/mechanism-revision.png
