pratham-cloud-ctrl/Project-ATO/docs/stage3/figures/pressure-comparisons.png

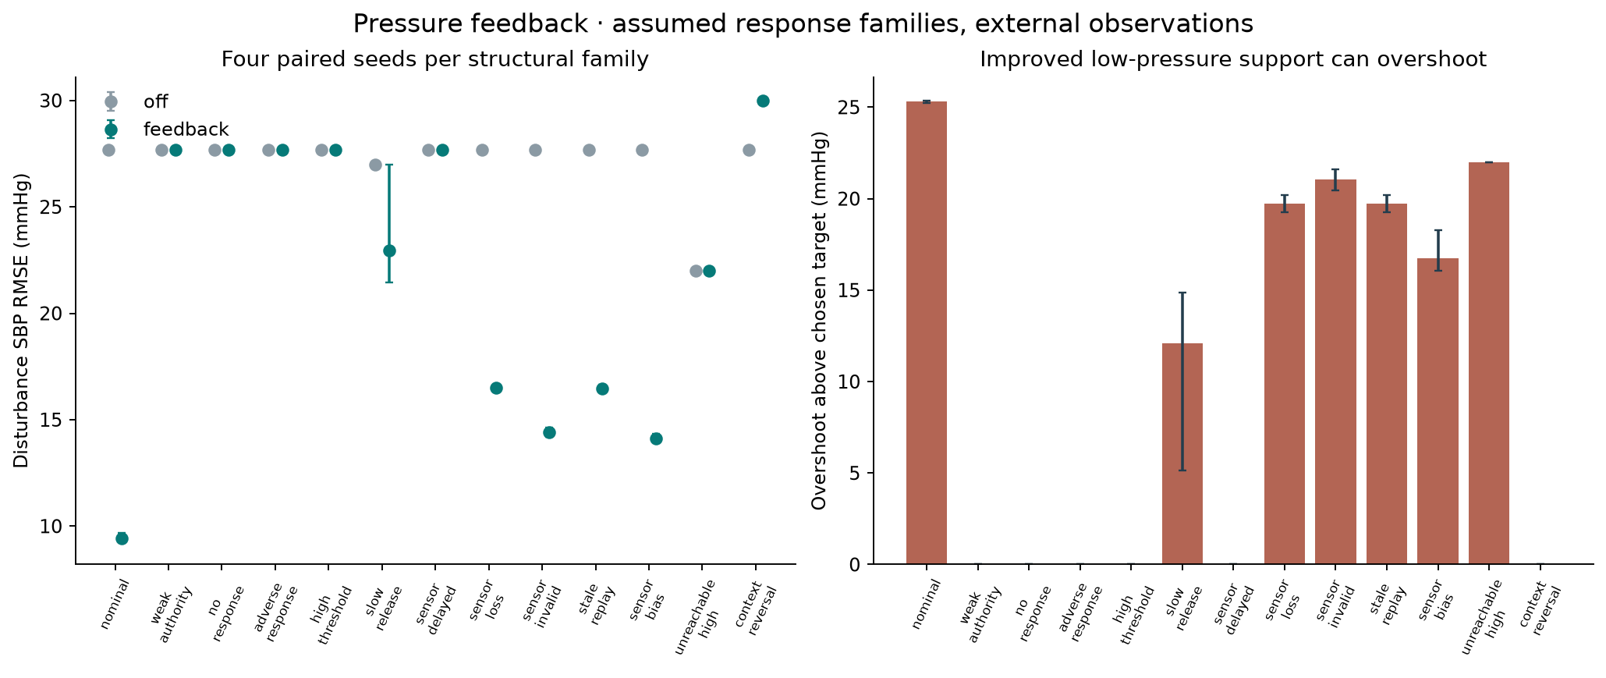
docs/stage3/figures/pressure-comparisons.png
