pratham-cloud-ctrl/Project-ATO/electronics/reports/schematic_preview.png

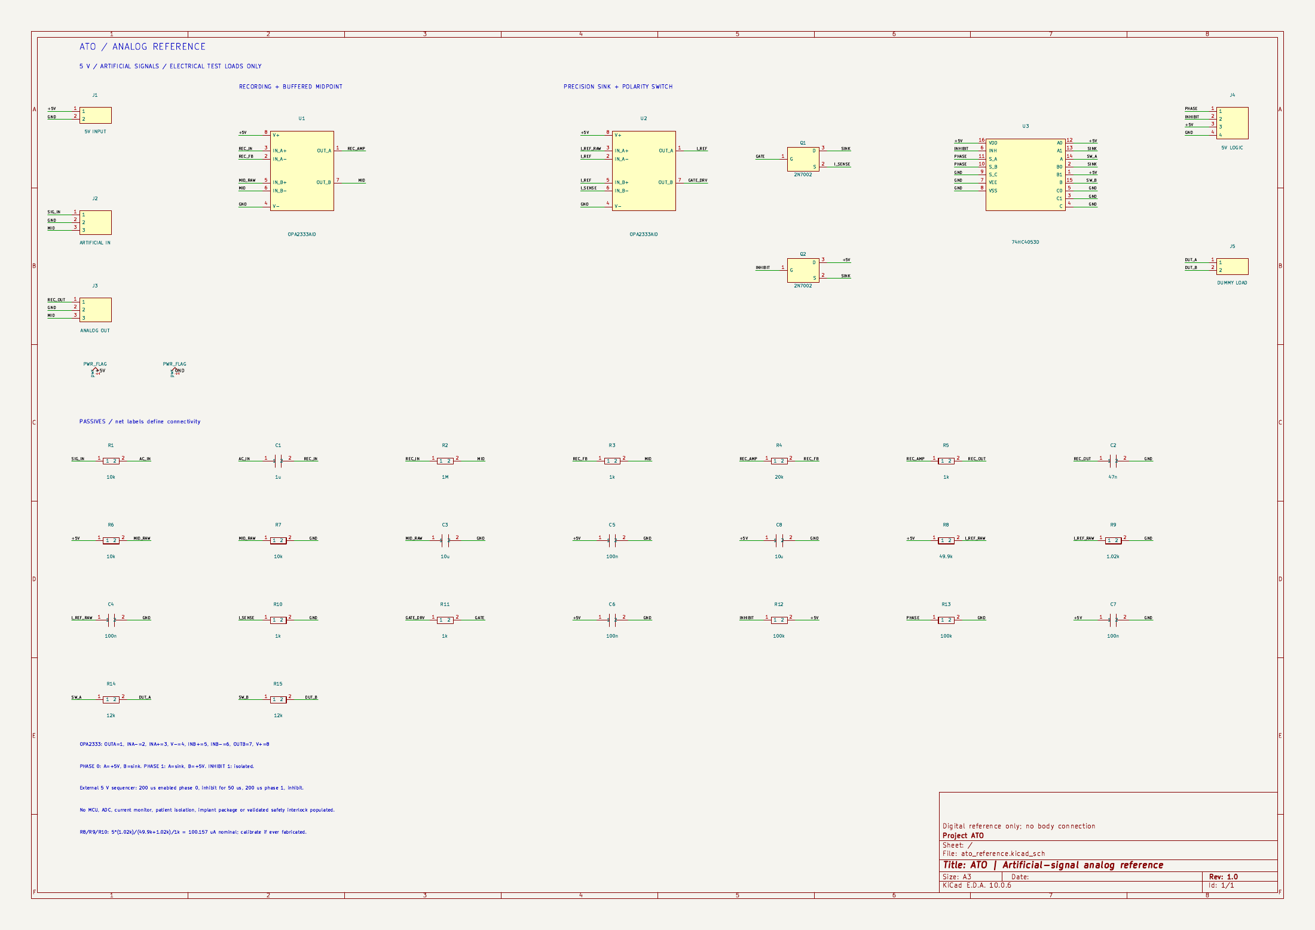
electronics/reports/schematic_preview.png
