pratham-cloud-ctrl/Project-ATO/electronics/stage4/contact-router/review/page-1.png

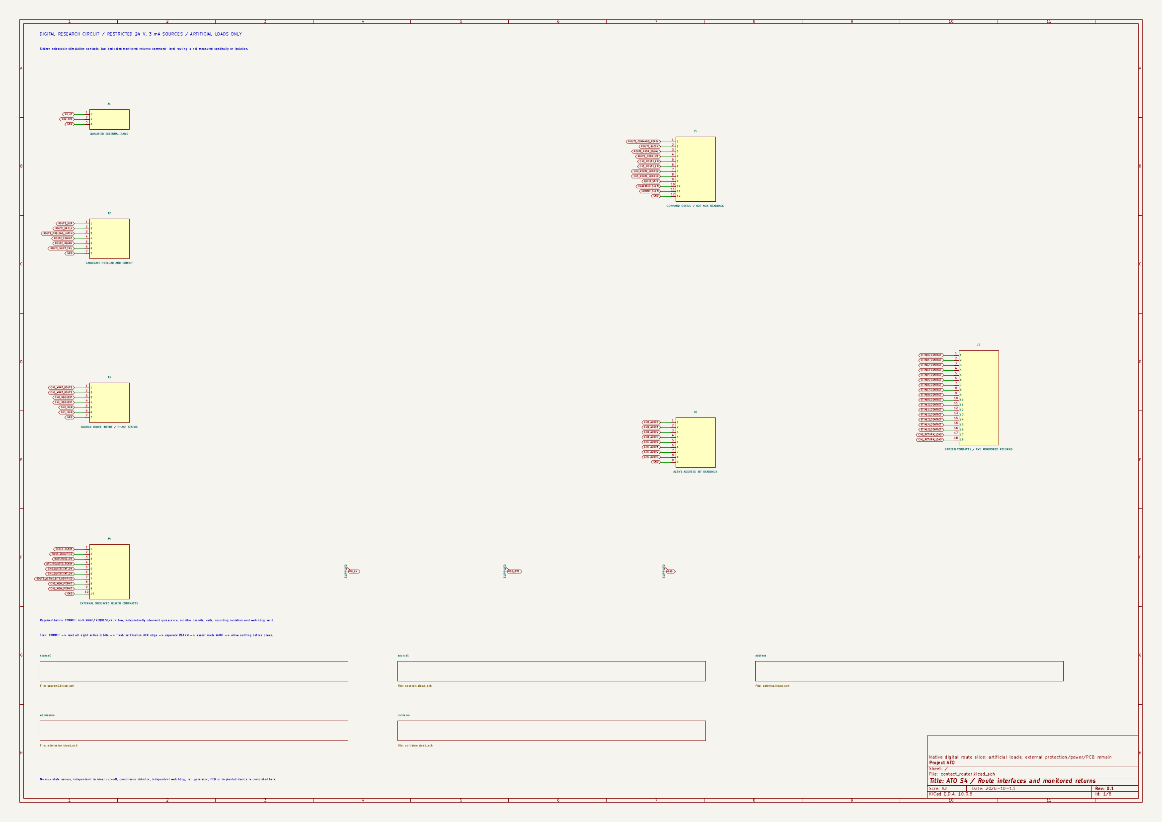
electronics/stage4/contact-router/review/page-1.png
