pratham-cloud-ctrl/Project-ATO/electronics/stage4/controller-carrier/review/page-2.png

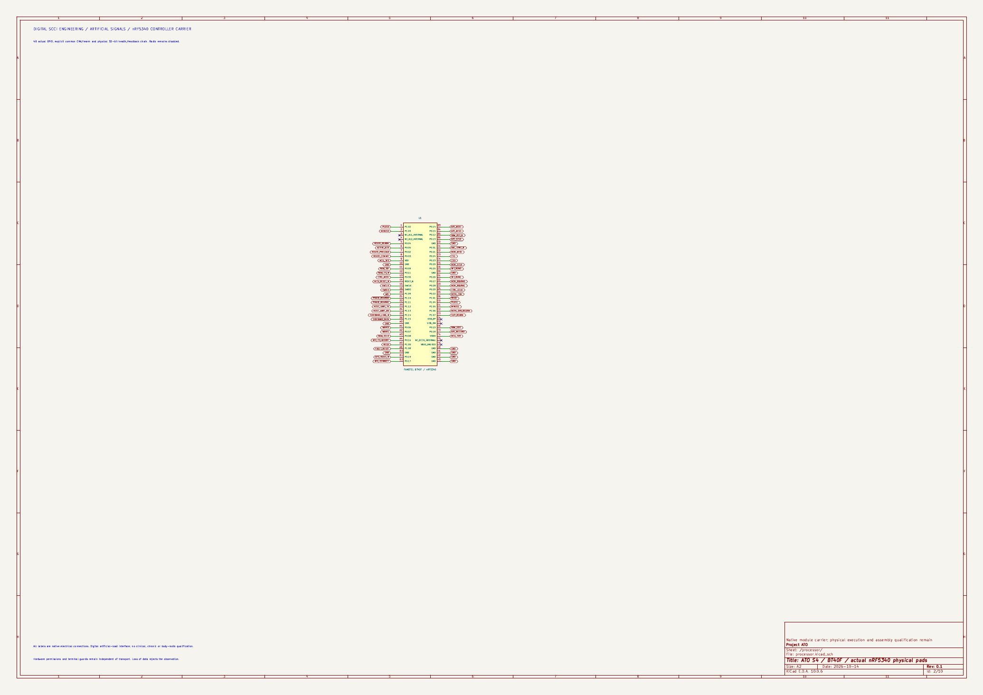
electronics/stage4/controller-carrier/review/page-2.png
