pratham-cloud-ctrl/Project-ATO/electronics/stage4/controller-carrier/review/page-8.png

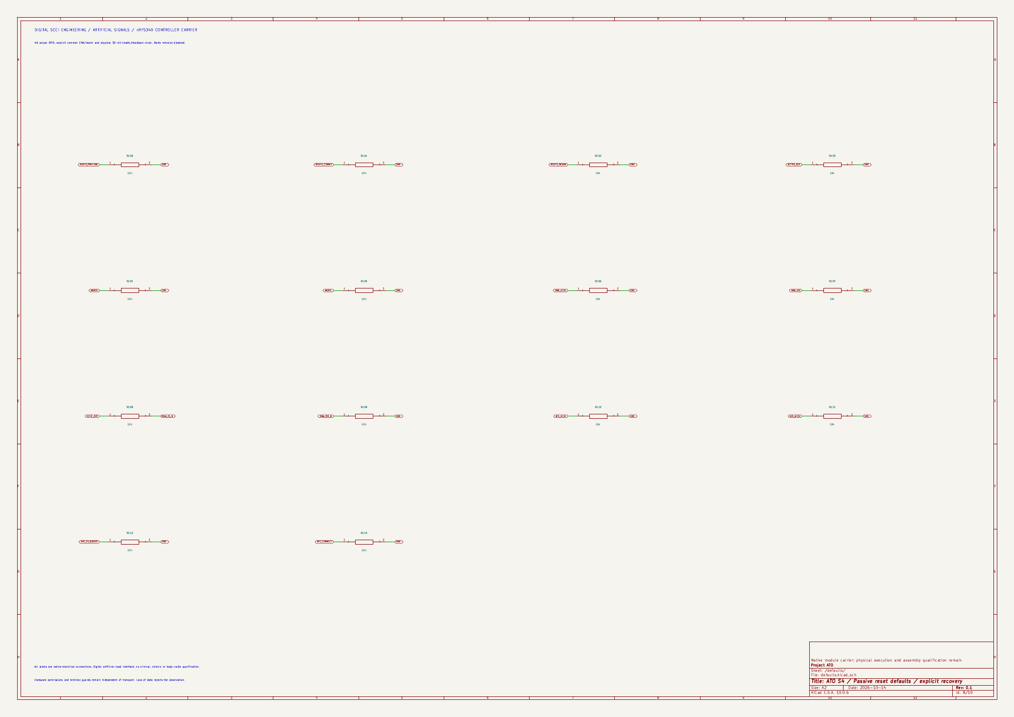
electronics/stage4/controller-carrier/review/page-8.png
