pratham-cloud-ctrl/Project-ATO/electronics/stage4/current-driver/review/page-1.png

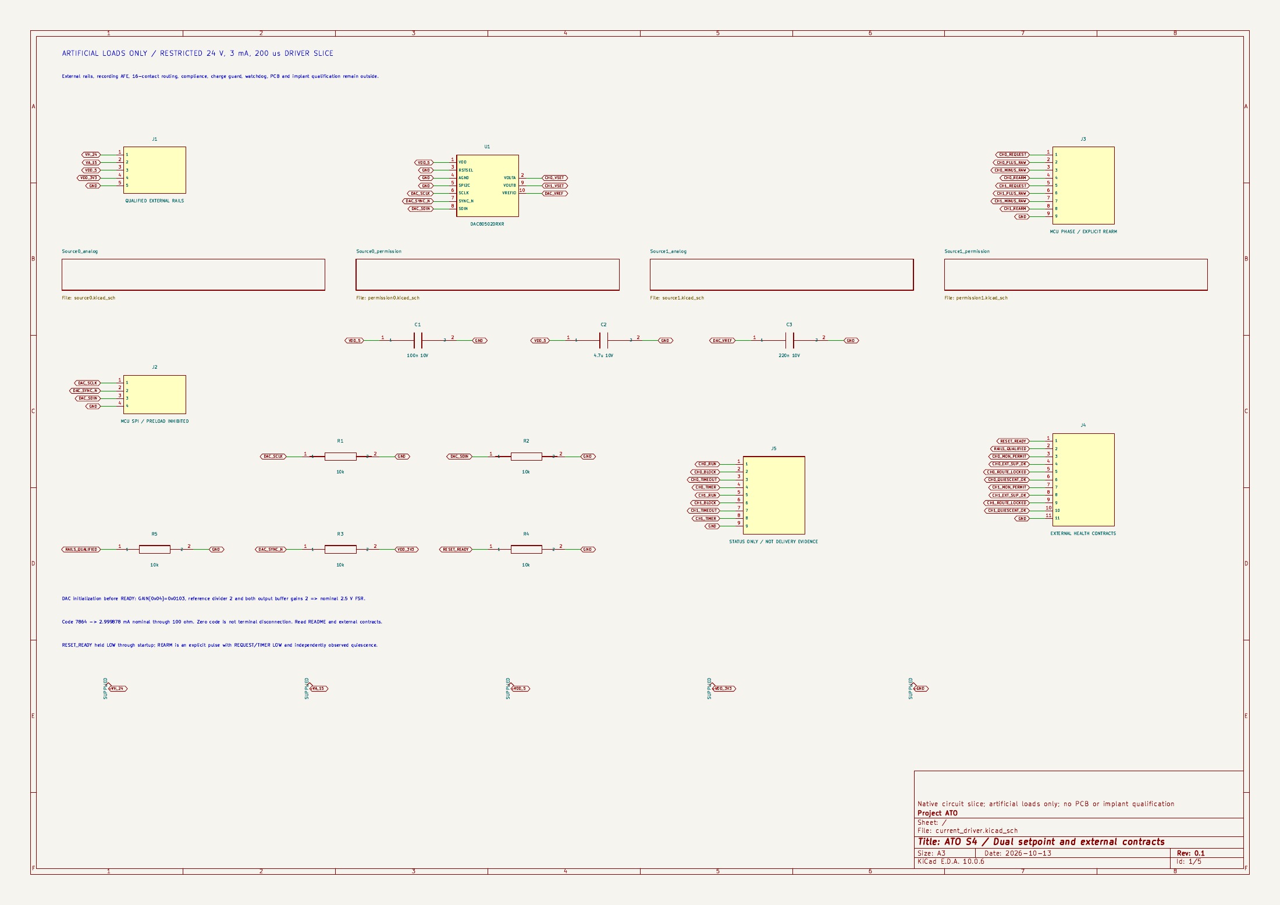
electronics/stage4/current-driver/review/page-1.png
