pratham-cloud-ctrl/Project-ATO/electronics/stage4/driver-study/driver-charge-paths.png

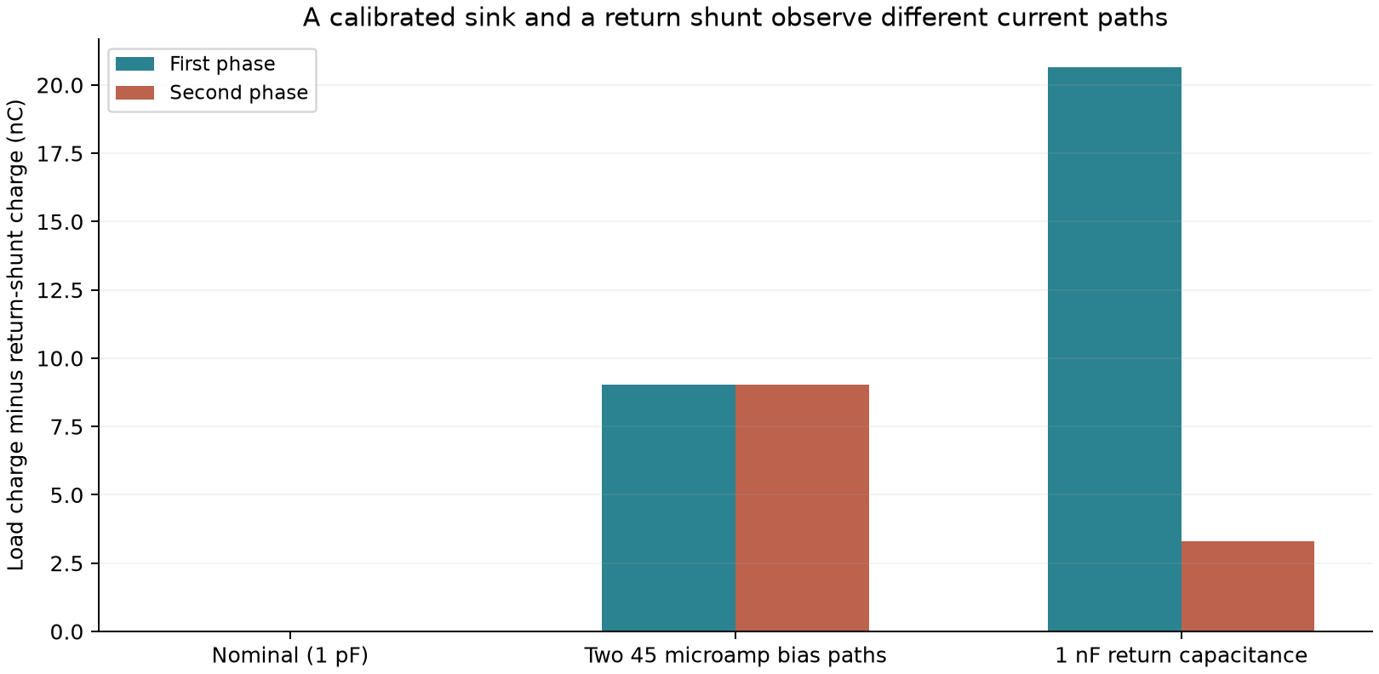
electronics/stage4/driver-study/driver-charge-paths.png
