pratham-cloud-ctrl/Project-ATO/electronics/stage4/driver-study/driver-waveforms.png

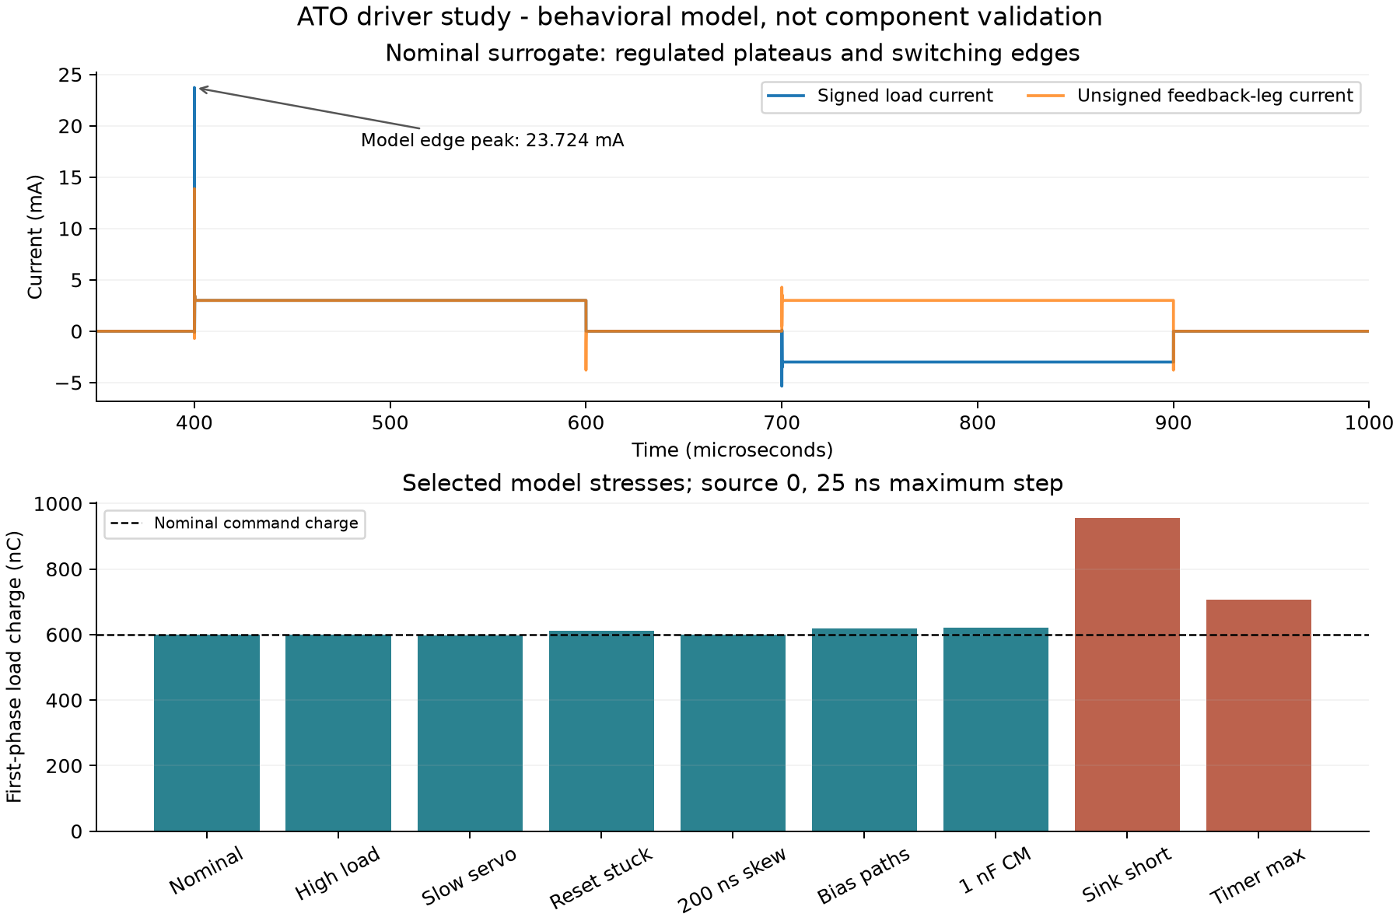
electronics/stage4/driver-study/driver-waveforms.png
