pratham-cloud-ctrl/Project-ATO/electronics/stage4/integrated-pcb/exports/contact-router/top.png

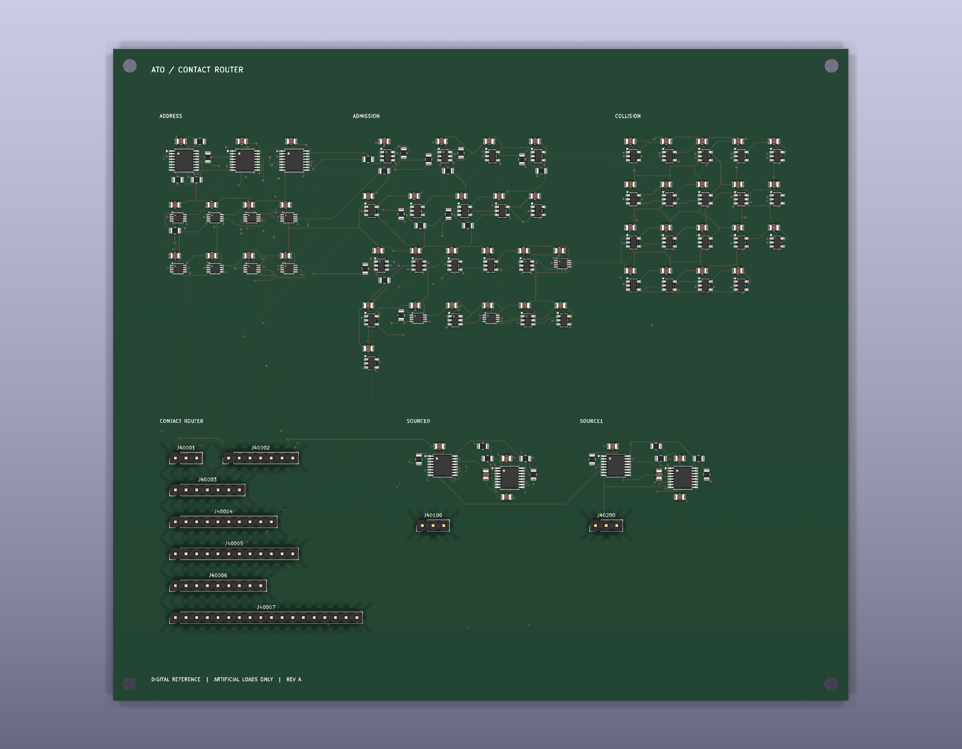
electronics/stage4/integrated-pcb/exports/contact-router/top.png
