pratham-cloud-ctrl/Project-ATO/electronics/stage4/integrated-pcb/exports/controller-carrier/bottom.png

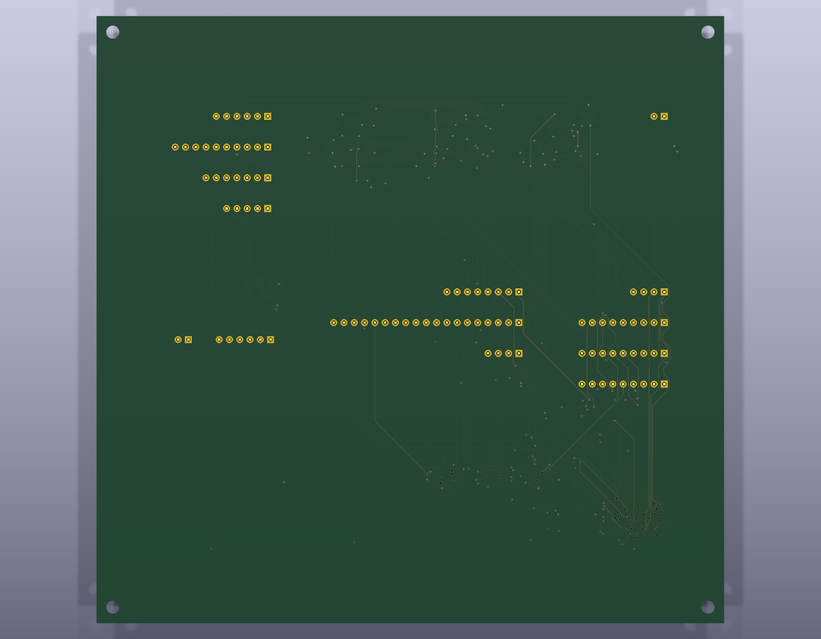
electronics/stage4/integrated-pcb/exports/controller-carrier/bottom.png
