pratham-cloud-ctrl/Project-ATO/electronics/stage4/integrated-pcb/exports/controller-carrier/top.png

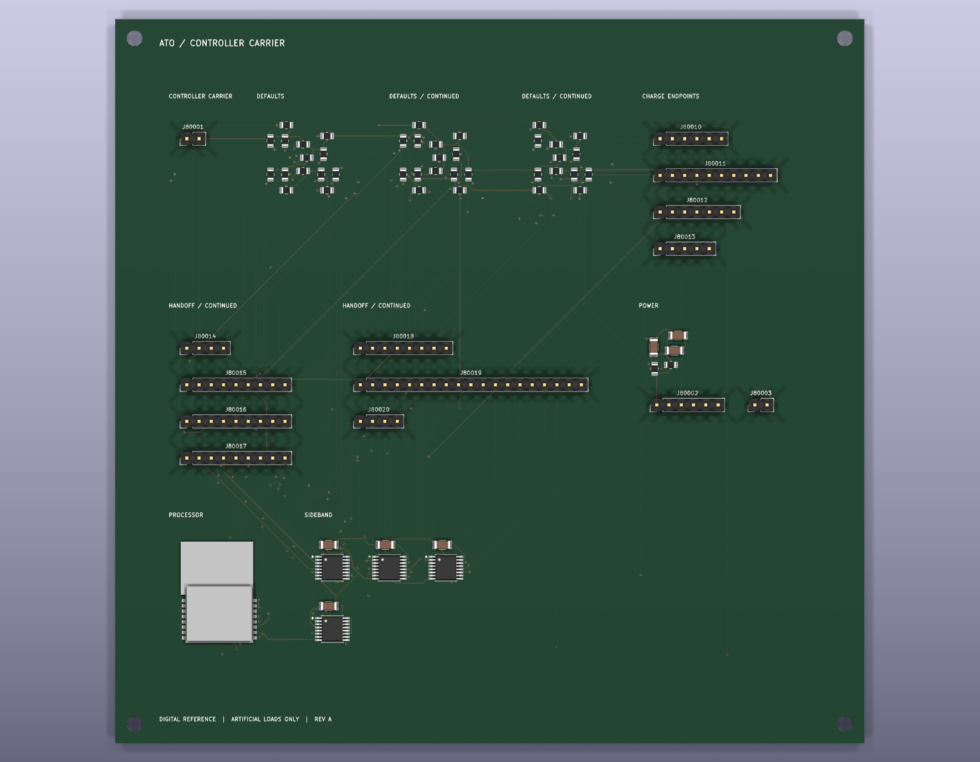
electronics/stage4/integrated-pcb/exports/controller-carrier/top.png
