pratham-cloud-ctrl/Project-ATO/electronics/stage4/integrated-pcb/exports/current-driver/bottom.png

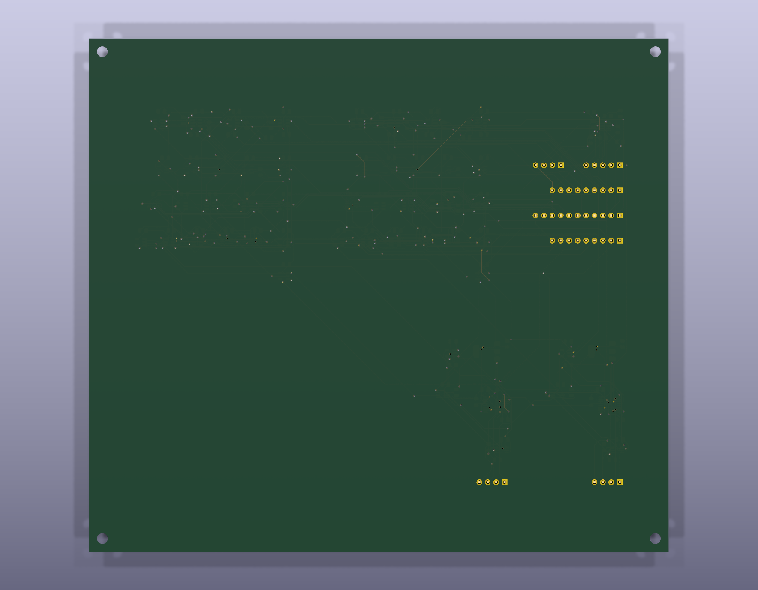
electronics/stage4/integrated-pcb/exports/current-driver/bottom.png
