pratham-cloud-ctrl/Project-ATO/electronics/stage4/integrated-pcb/exports/current-driver/top.png

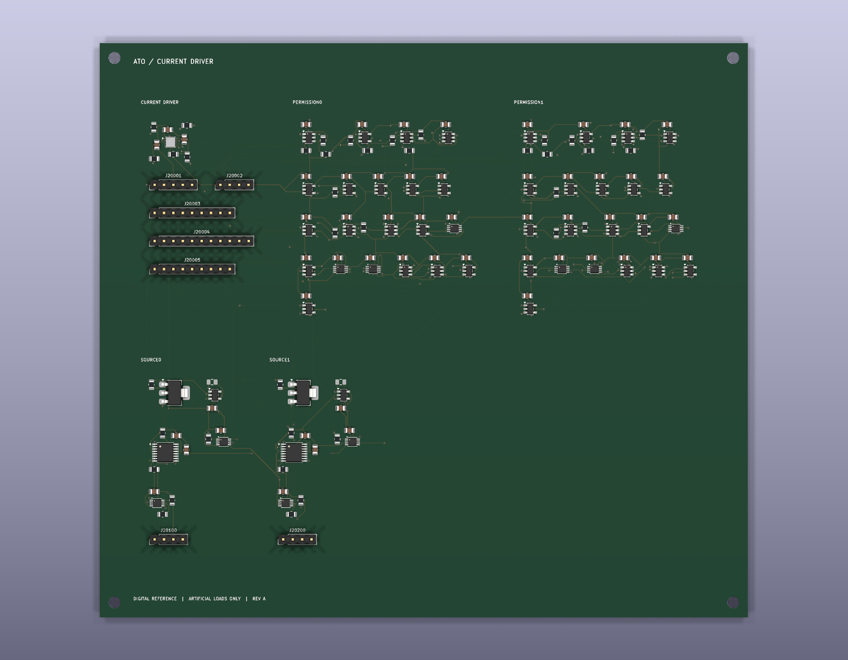
electronics/stage4/integrated-pcb/exports/current-driver/top.png
