pratham-cloud-ctrl/Project-ATO/electronics/stage4/integrated-pcb/exports/monitoring-cell/top.png

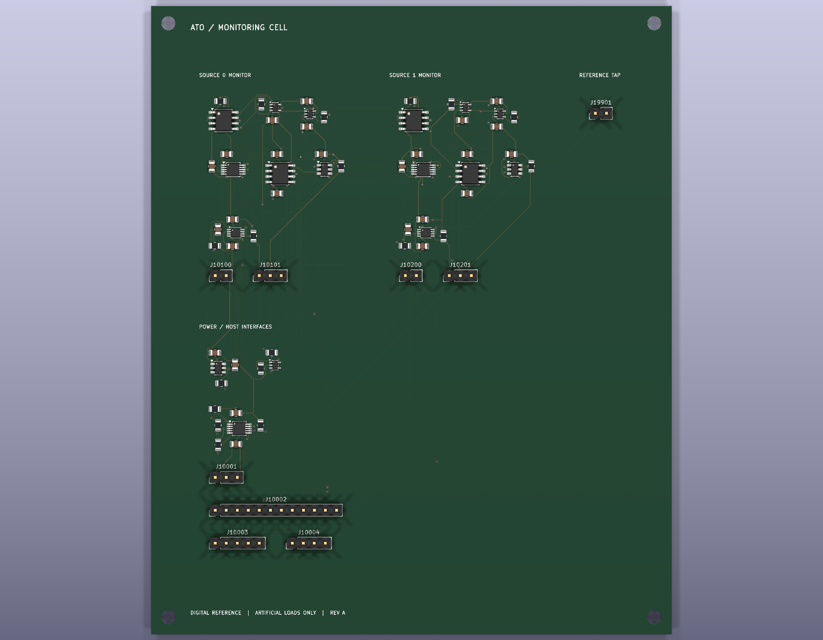
electronics/stage4/integrated-pcb/exports/monitoring-cell/top.png
