pratham-cloud-ctrl/Project-ATO/electronics/stage4/integrated-pcb/exports/monitoring-transport/top.png

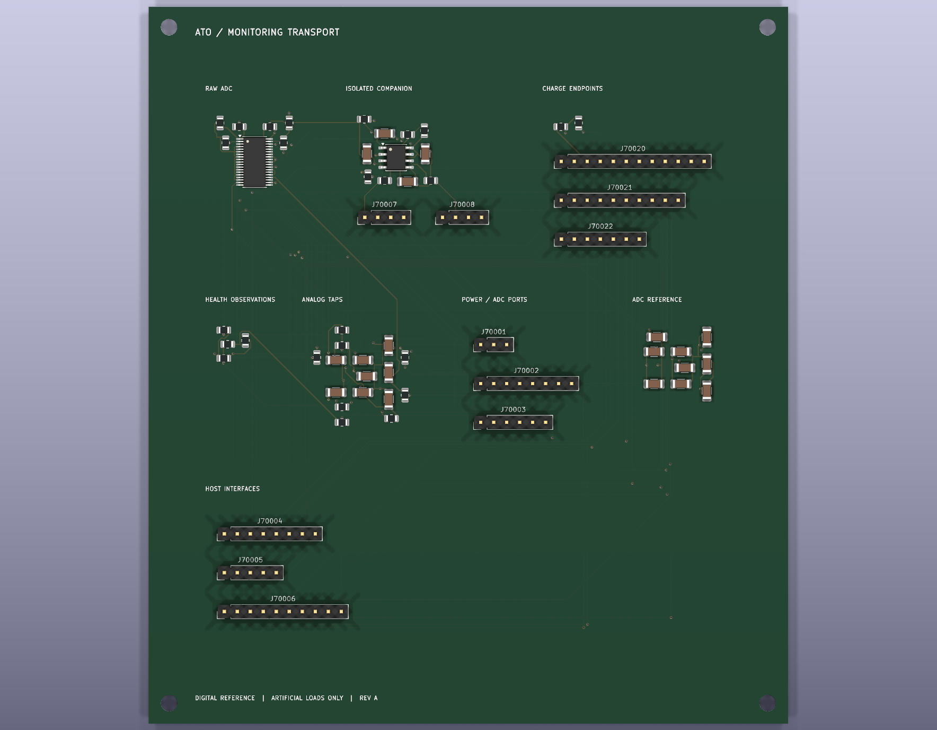
electronics/stage4/integrated-pcb/exports/monitoring-transport/top.png
