pratham-cloud-ctrl/Project-ATO/electronics/stage4/integrated-pcb/exports/power/bottom.png

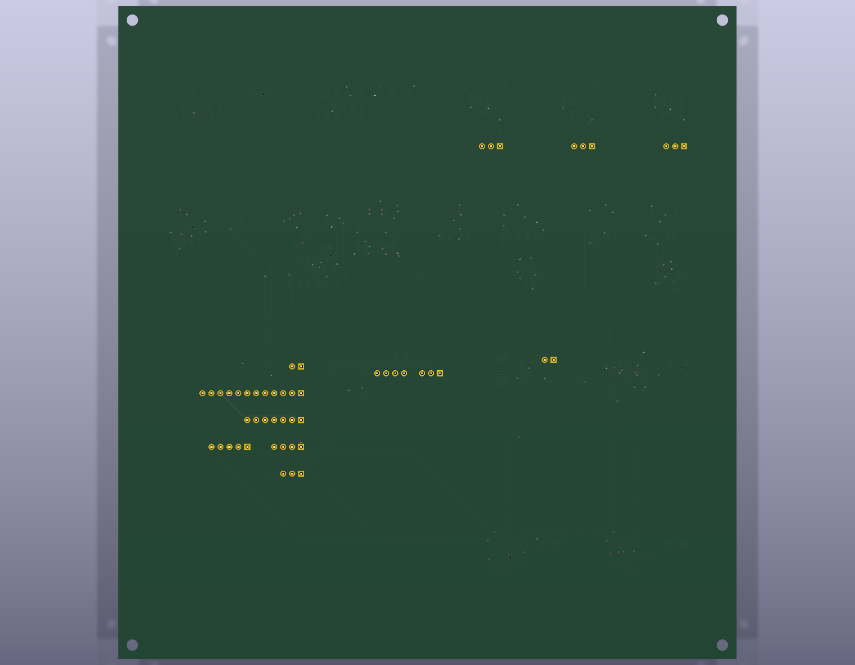
electronics/stage4/integrated-pcb/exports/power/bottom.png
