pratham-cloud-ctrl/Project-ATO/electronics/stage4/integrated-pcb/exports/power/top.png

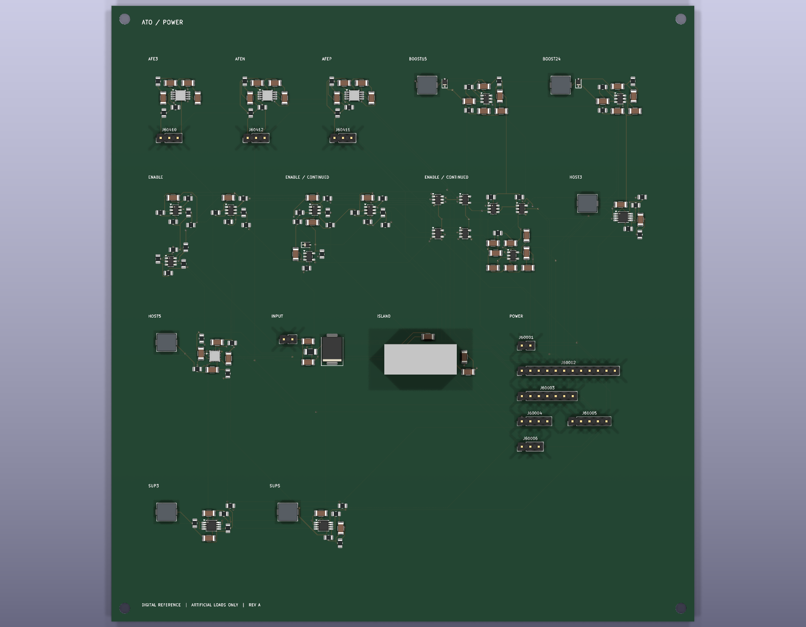
electronics/stage4/integrated-pcb/exports/power/top.png
