pratham-cloud-ctrl/Project-ATO/electronics/stage4/integrated-pcb/exports/recording-front-end/top.png

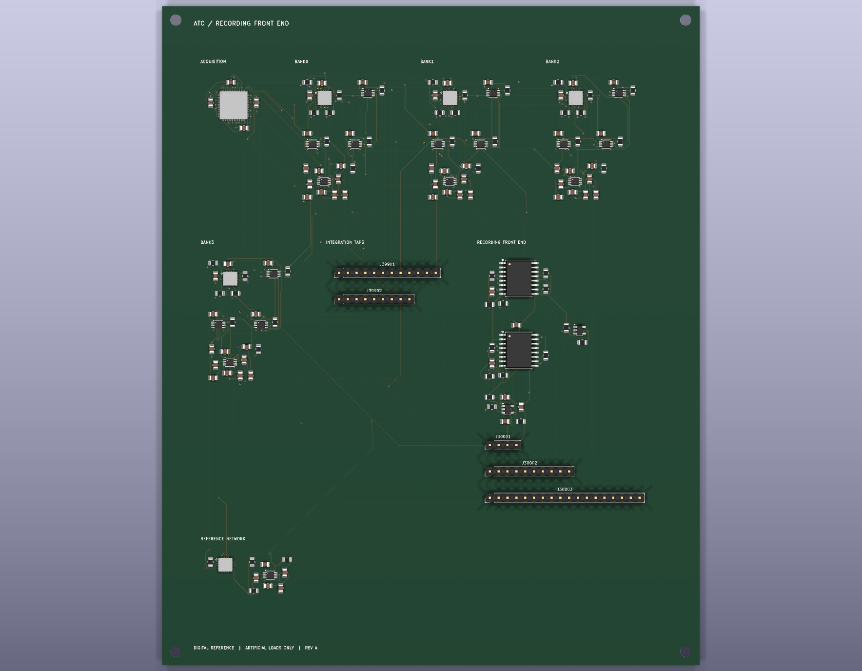
electronics/stage4/integrated-pcb/exports/recording-front-end/top.png
