pratham-cloud-ctrl/Project-ATO/electronics/stage4/integrated-pcb/exports/supervision/bottom.png

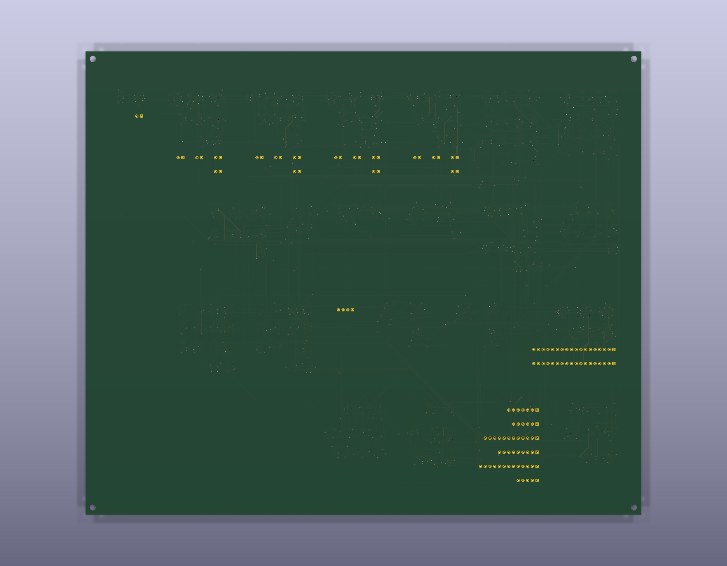
electronics/stage4/integrated-pcb/exports/supervision/bottom.png
