pratham-cloud-ctrl/Project-ATO/electronics/stage4/integrated-pcb/exports/supervision/top.png

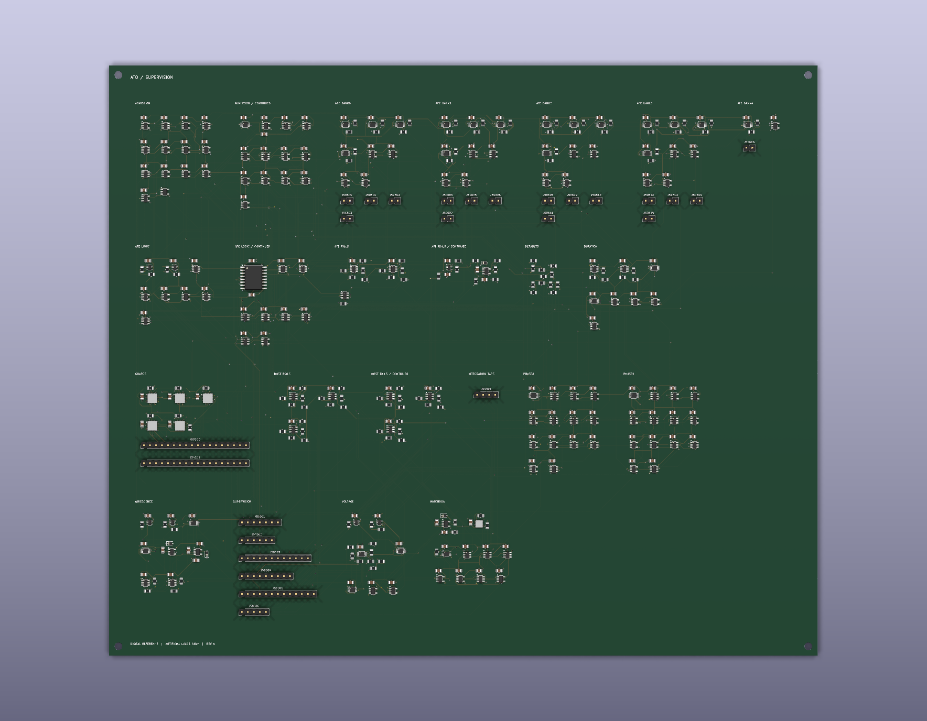
electronics/stage4/integrated-pcb/exports/supervision/top.png
