pratham-cloud-ctrl/Project-ATO/electronics/stage4/monitoring-cell/review/page-1.png

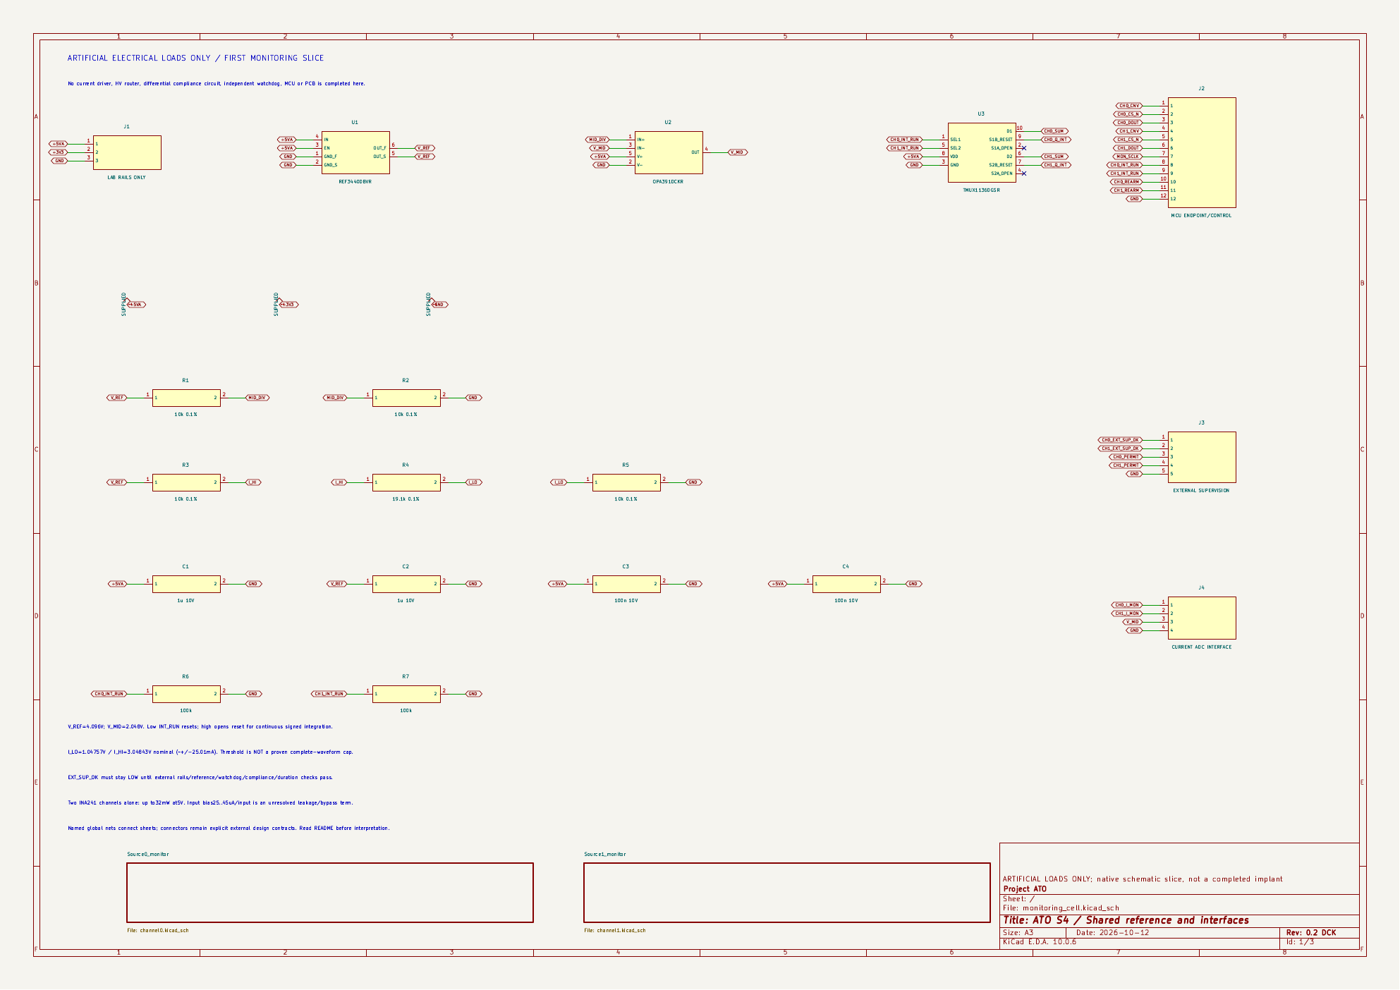
electronics/stage4/monitoring-cell/review/page-1.png
