pratham-cloud-ctrl/Project-ATO/electronics/stage4/monitoring-cell/review/page-2.png

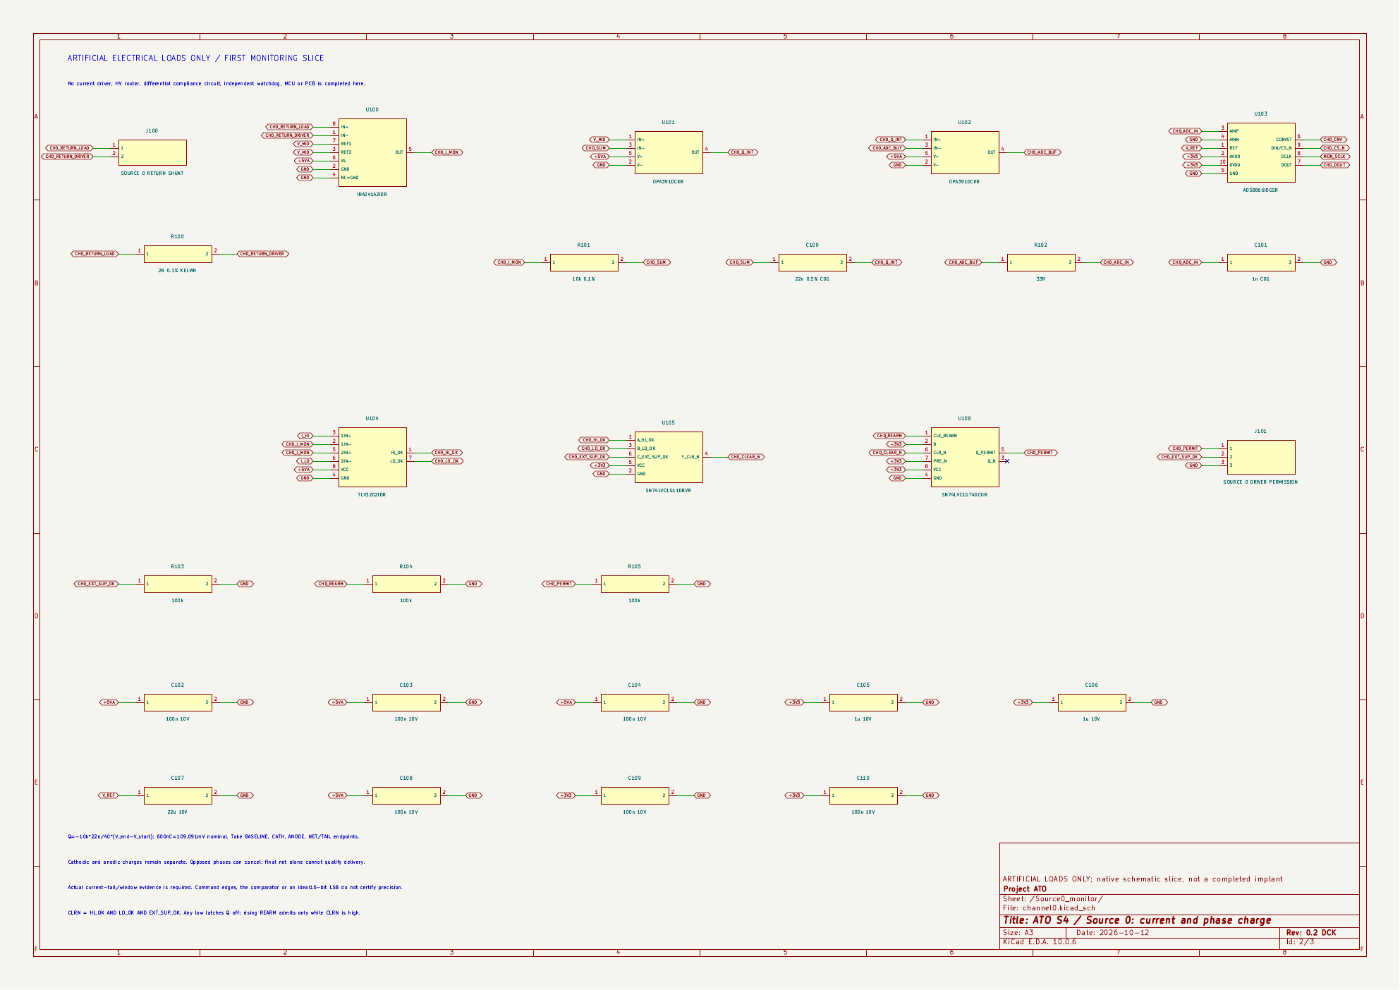
electronics/stage4/monitoring-cell/review/page-2.png
