pratham-cloud-ctrl/Project-ATO/electronics/stage4/monitoring-study/charge-witnesses.png

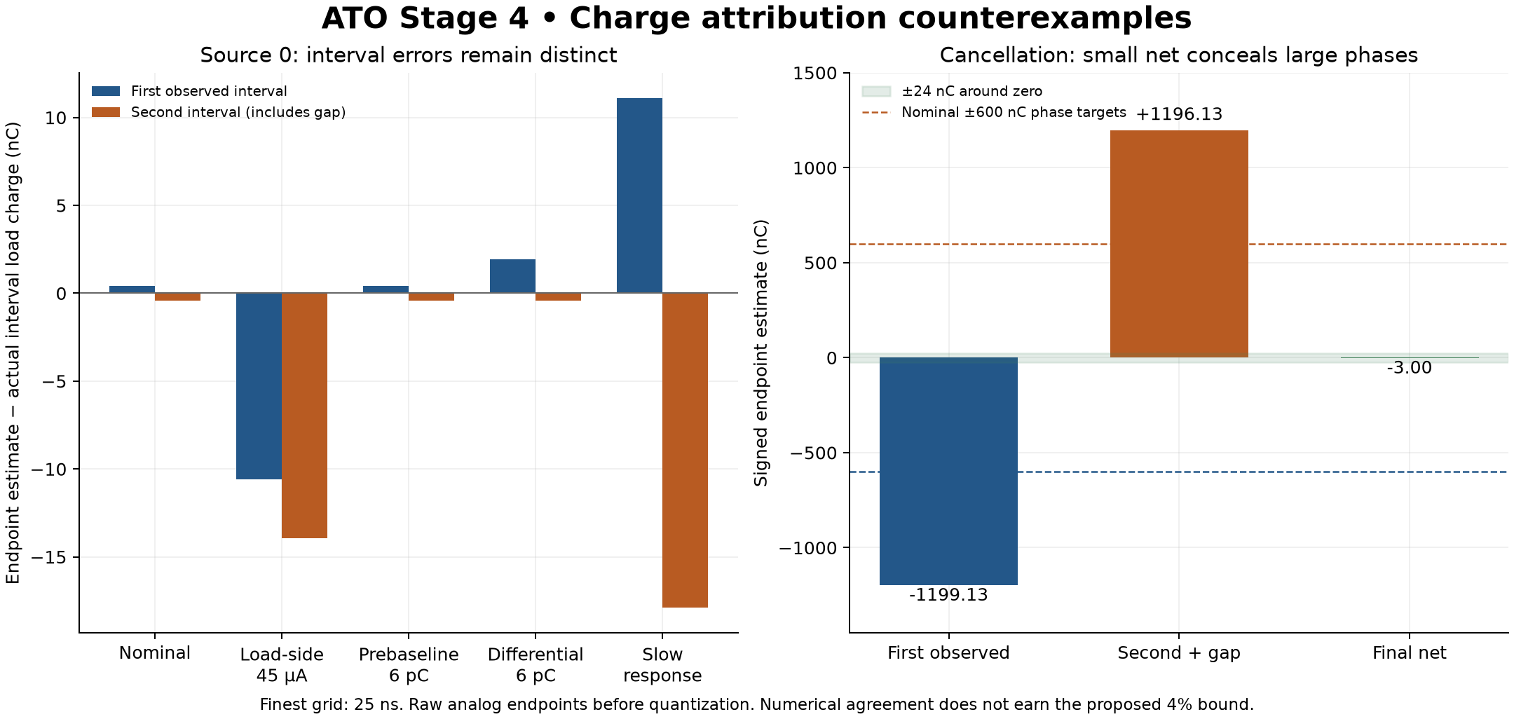
electronics/stage4/monitoring-study/charge-witnesses.png
