pratham-cloud-ctrl/Project-ATO/electronics/stage4/monitoring-study/waveforms.png

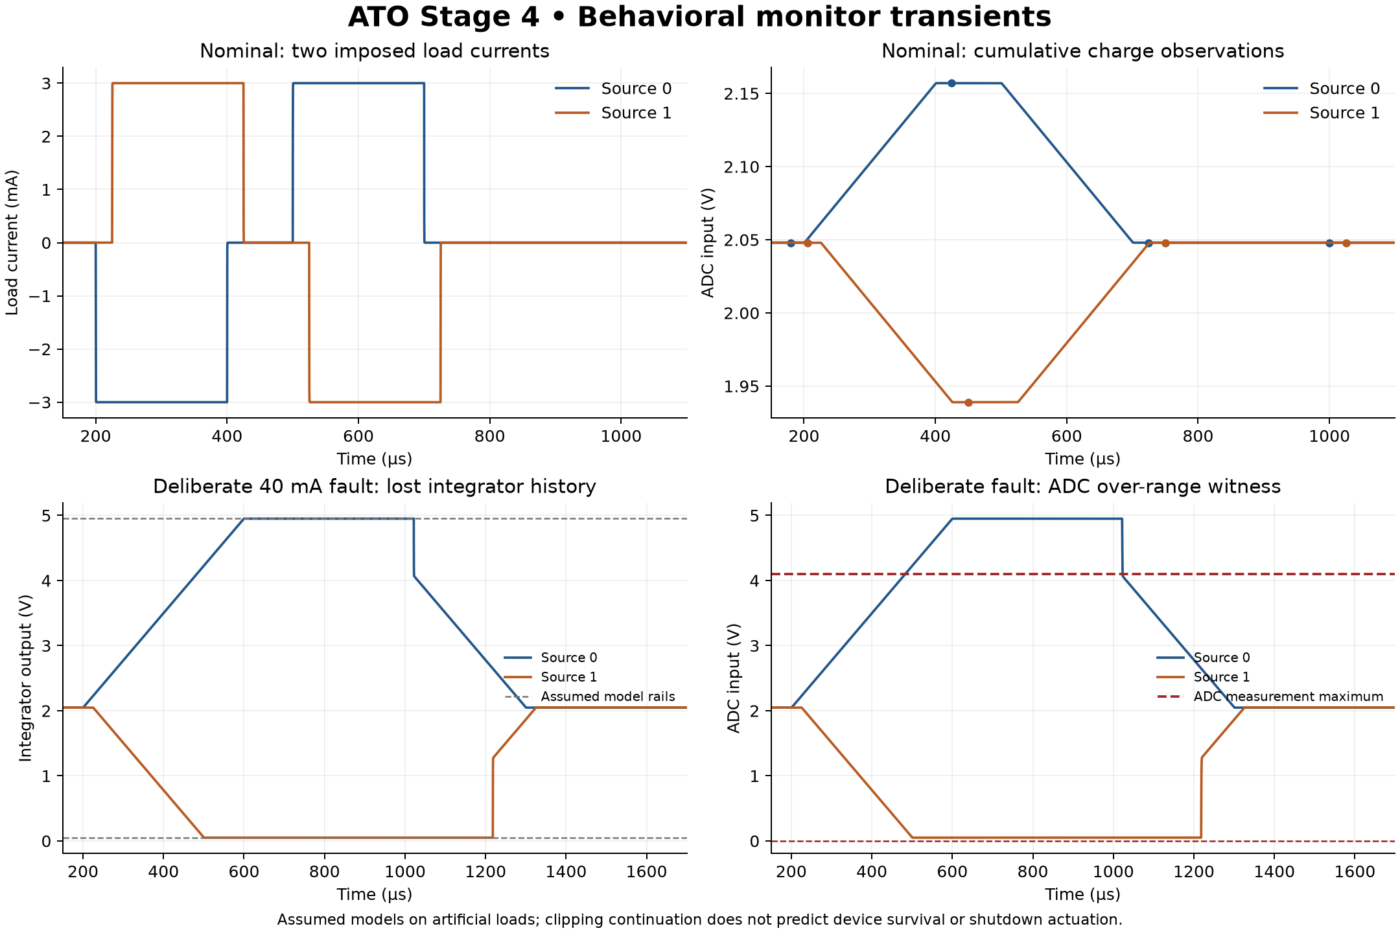
electronics/stage4/monitoring-study/waveforms.png
