pratham-cloud-ctrl/Project-ATO/electronics/stage4/monitoring-transport/review/final-review-contact.png

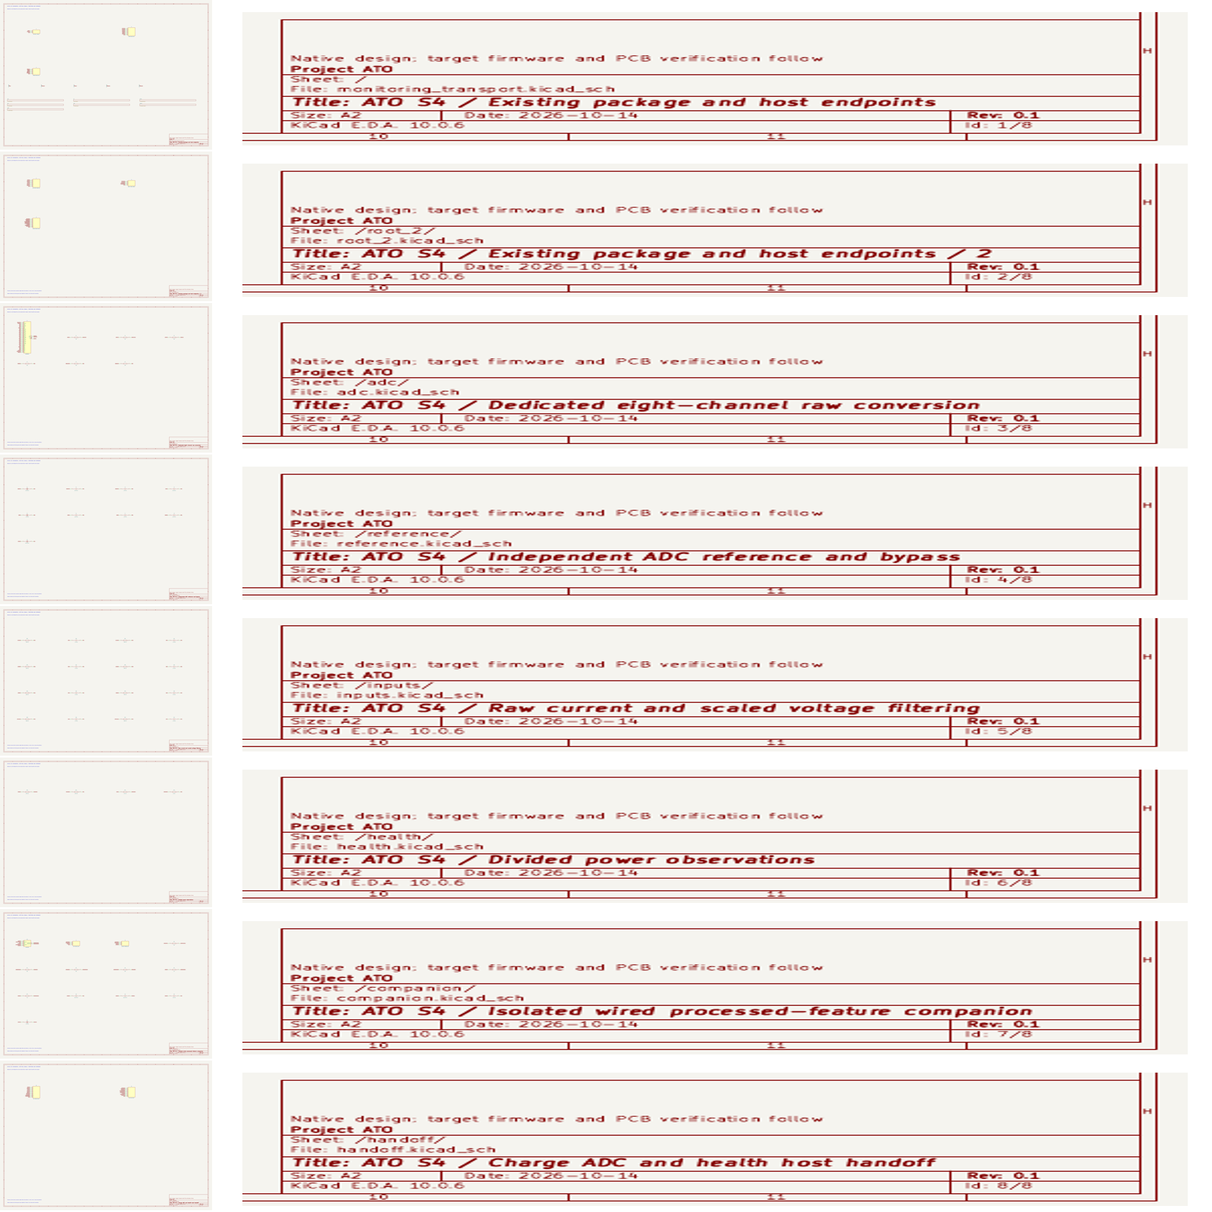
electronics/stage4/monitoring-transport/review/final-review-contact.png
