pratham-cloud-ctrl/Project-ATO/electronics/stage4/monitoring-transport/review/page-1.png

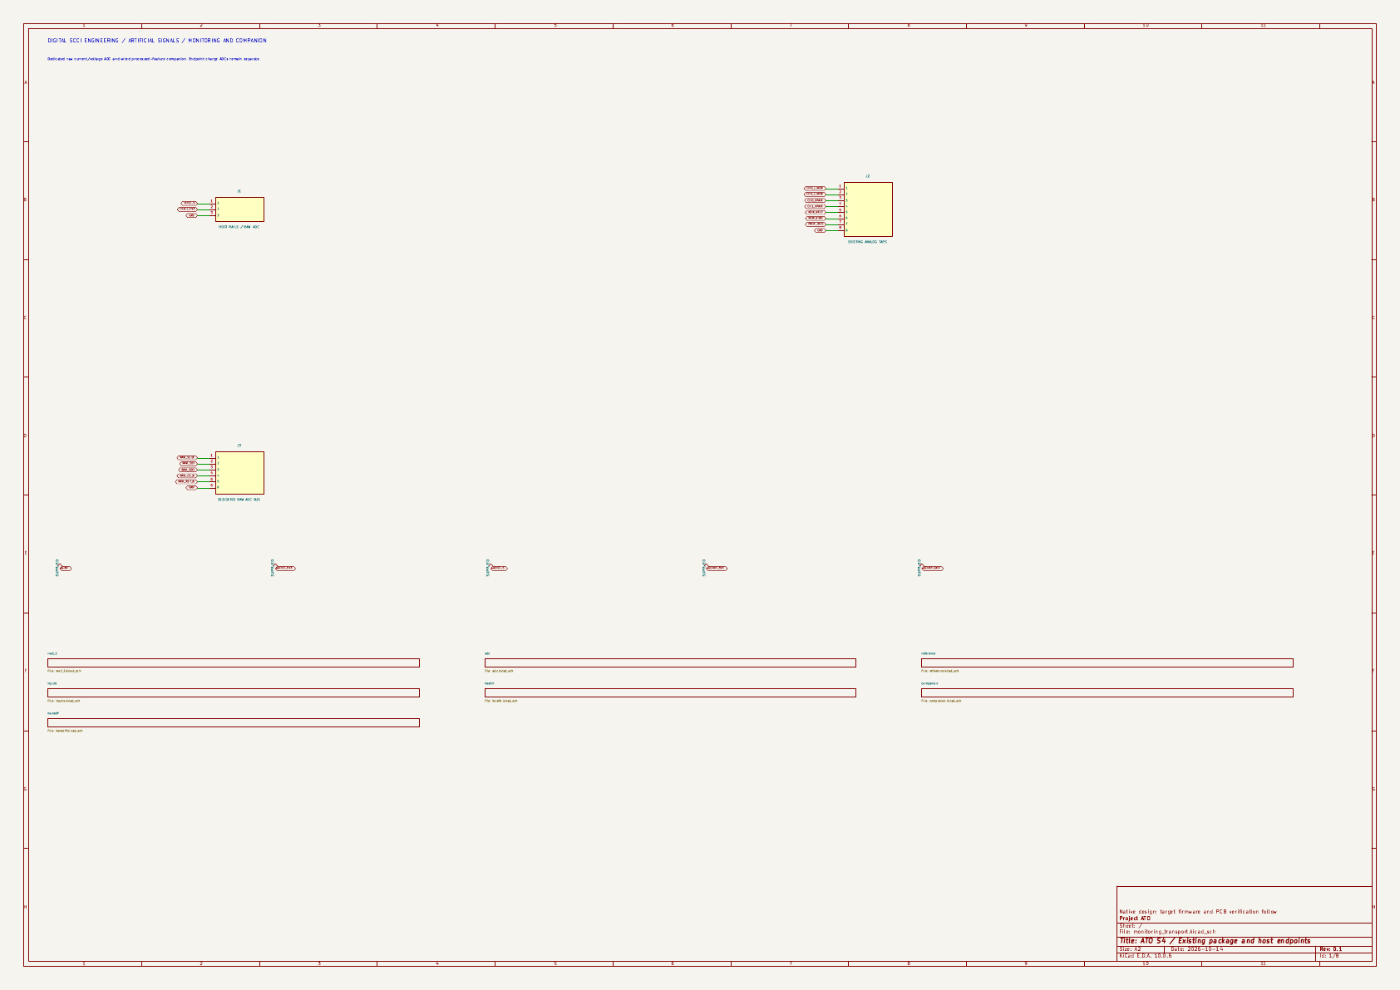
electronics/stage4/monitoring-transport/review/page-1.png
