pratham-cloud-ctrl/Project-ATO/electronics/stage4/monitoring-transport/review/page-2.png

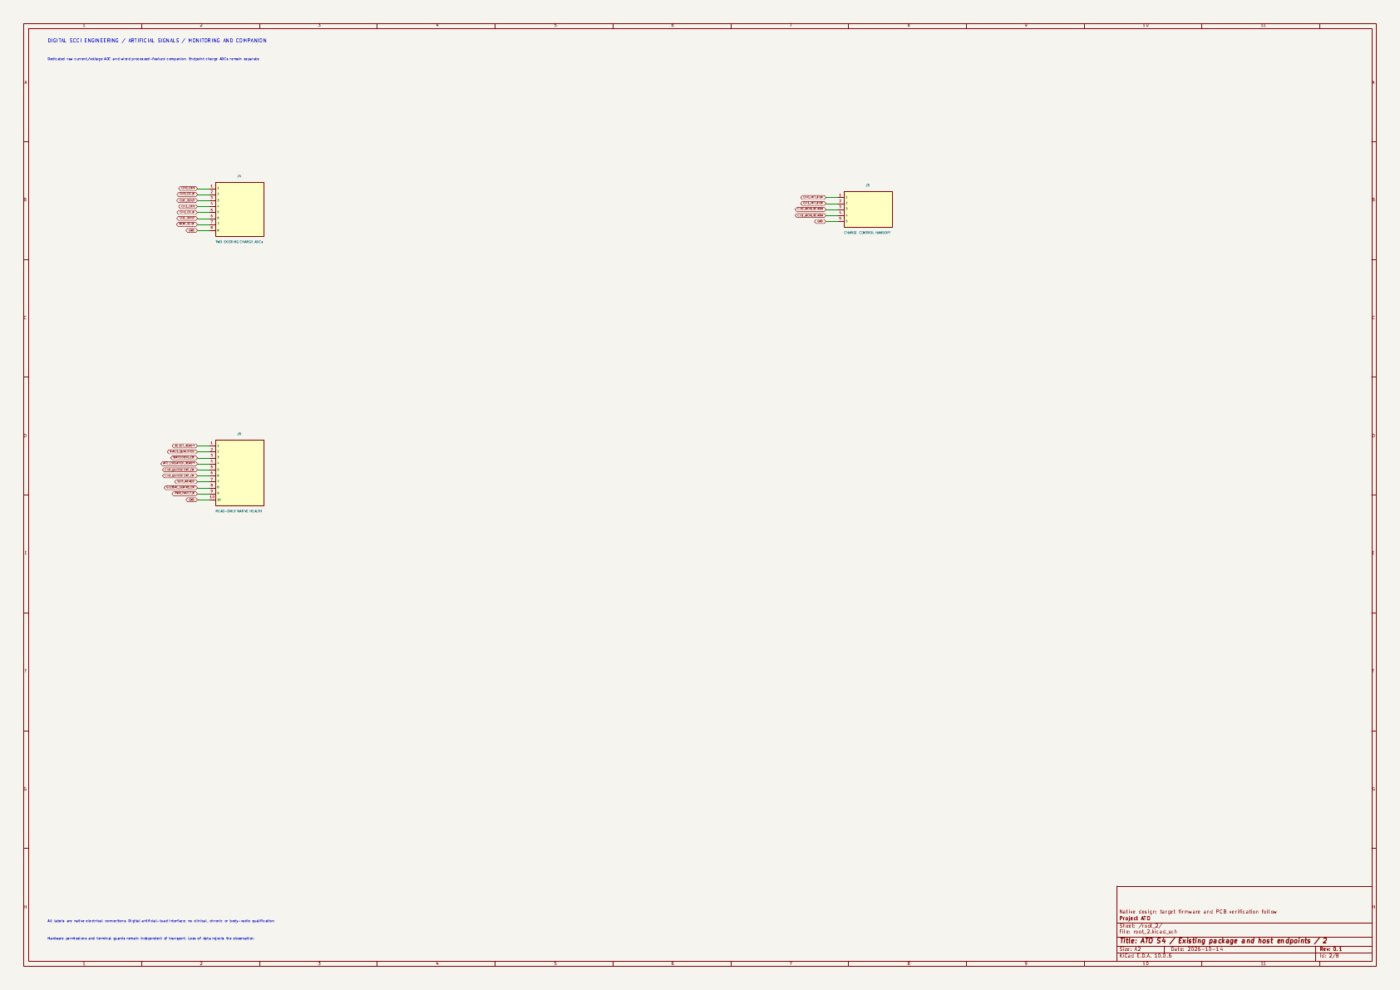
electronics/stage4/monitoring-transport/review/page-2.png
