pratham-cloud-ctrl/Project-ATO/electronics/stage4/monitoring-transport/review/page-7.png

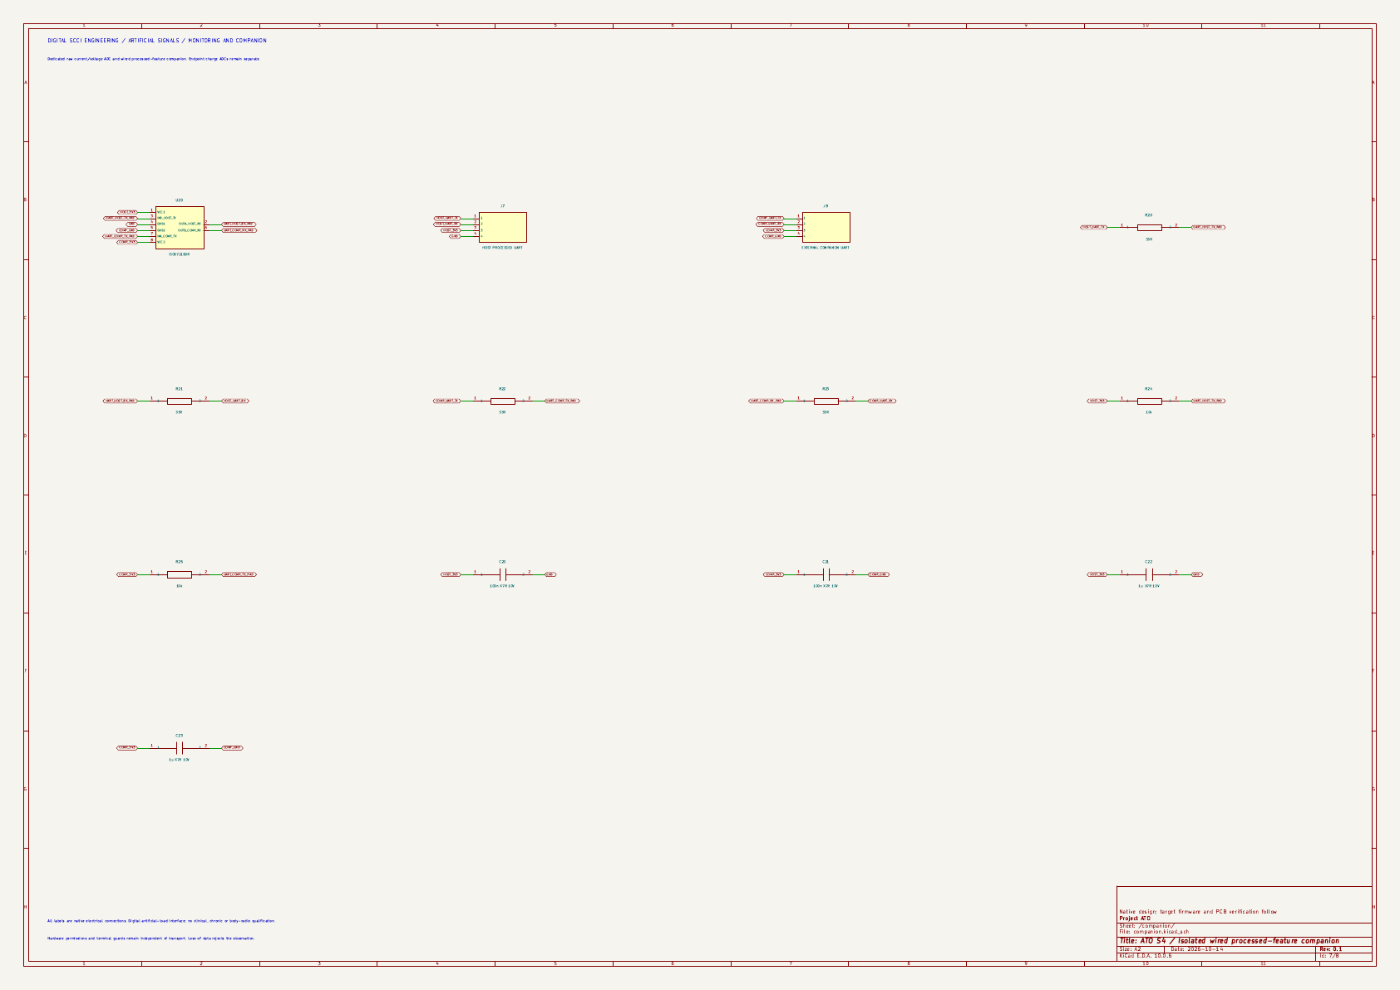
electronics/stage4/monitoring-transport/review/page-7.png
