pratham-cloud-ctrl/Project-ATO/electronics/stage4/power/review/page-07.png

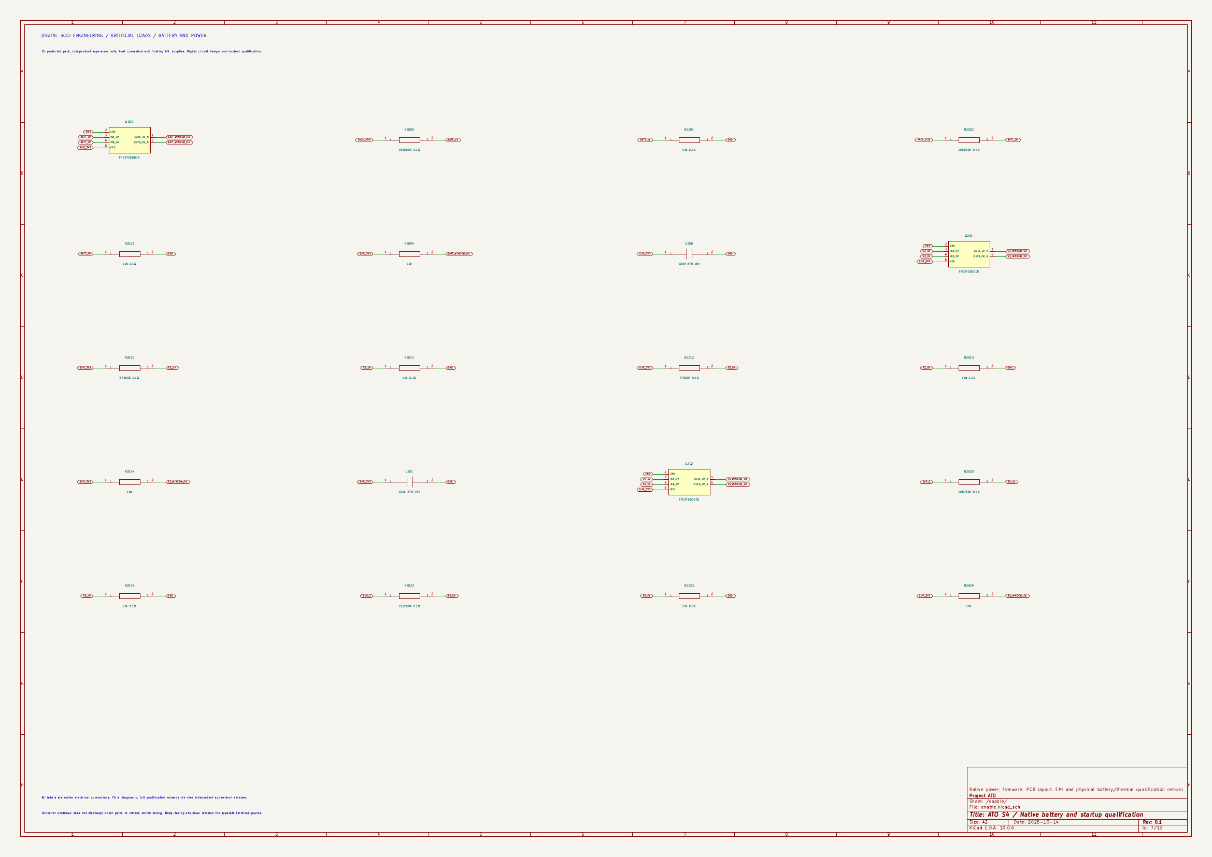
electronics/stage4/power/review/page-07.png
