pratham-cloud-ctrl/Project-ATO/electronics/stage4/power/review/page-08.png

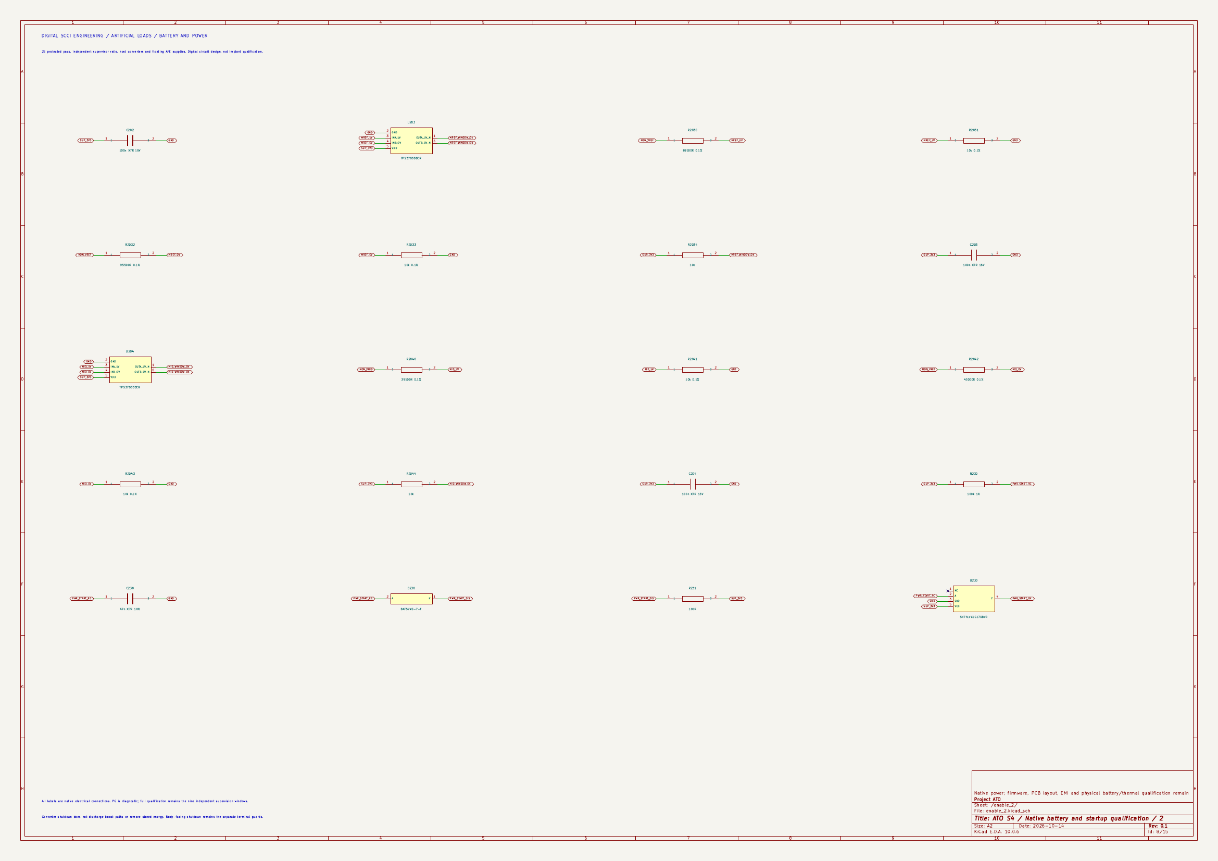
electronics/stage4/power/review/page-08.png
