pratham-cloud-ctrl/Project-ATO/electronics/stage4/power/review/page-09.png

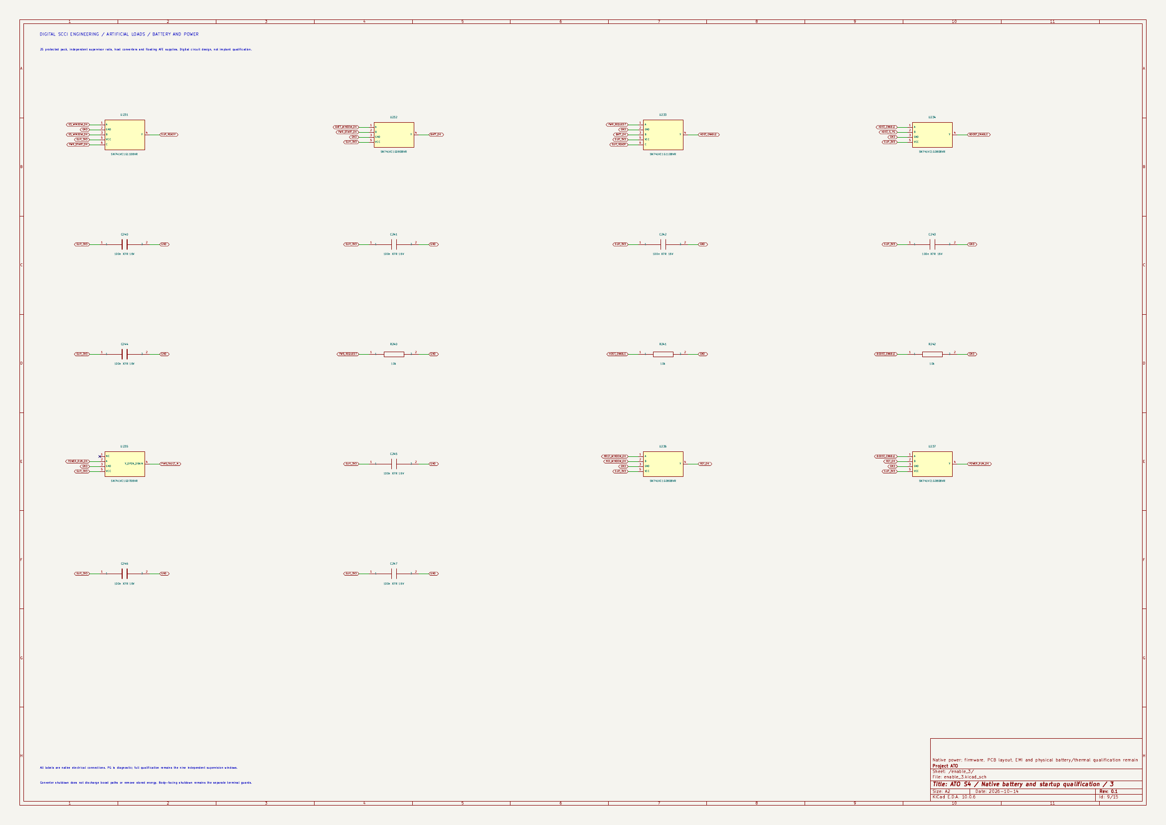
electronics/stage4/power/review/page-09.png
