pratham-cloud-ctrl/Project-ATO/electronics/stage4/recording-front-end/review/page-1.png

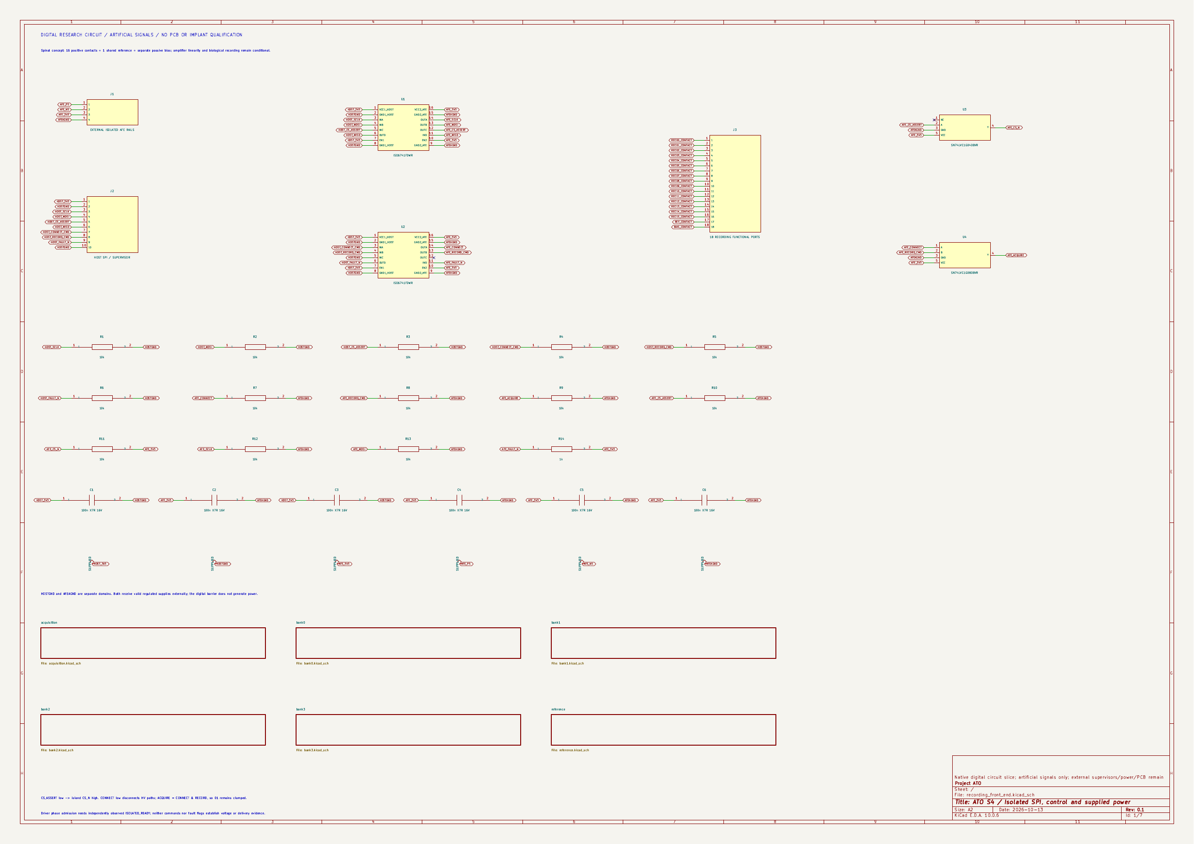
electronics/stage4/recording-front-end/review/page-1.png
