pratham-cloud-ctrl/Project-ATO/electronics/stage4/recording-front-end/review/page-2.png

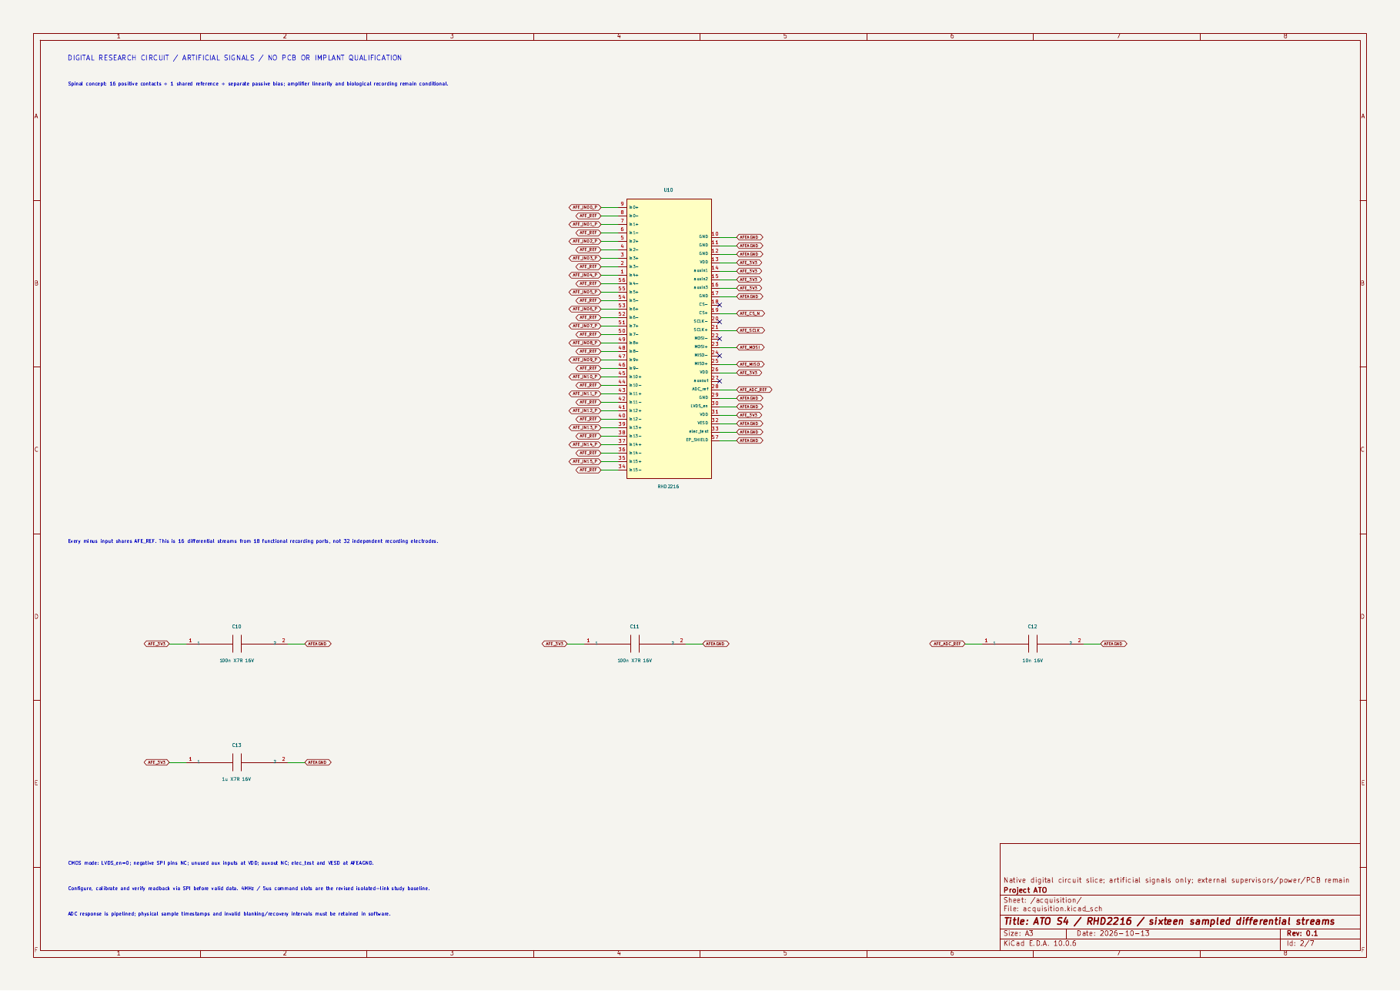
electronics/stage4/recording-front-end/review/page-2.png
