pratham-cloud-ctrl/Project-ATO/electronics/stage4/recording-front-end/review/page-3.png

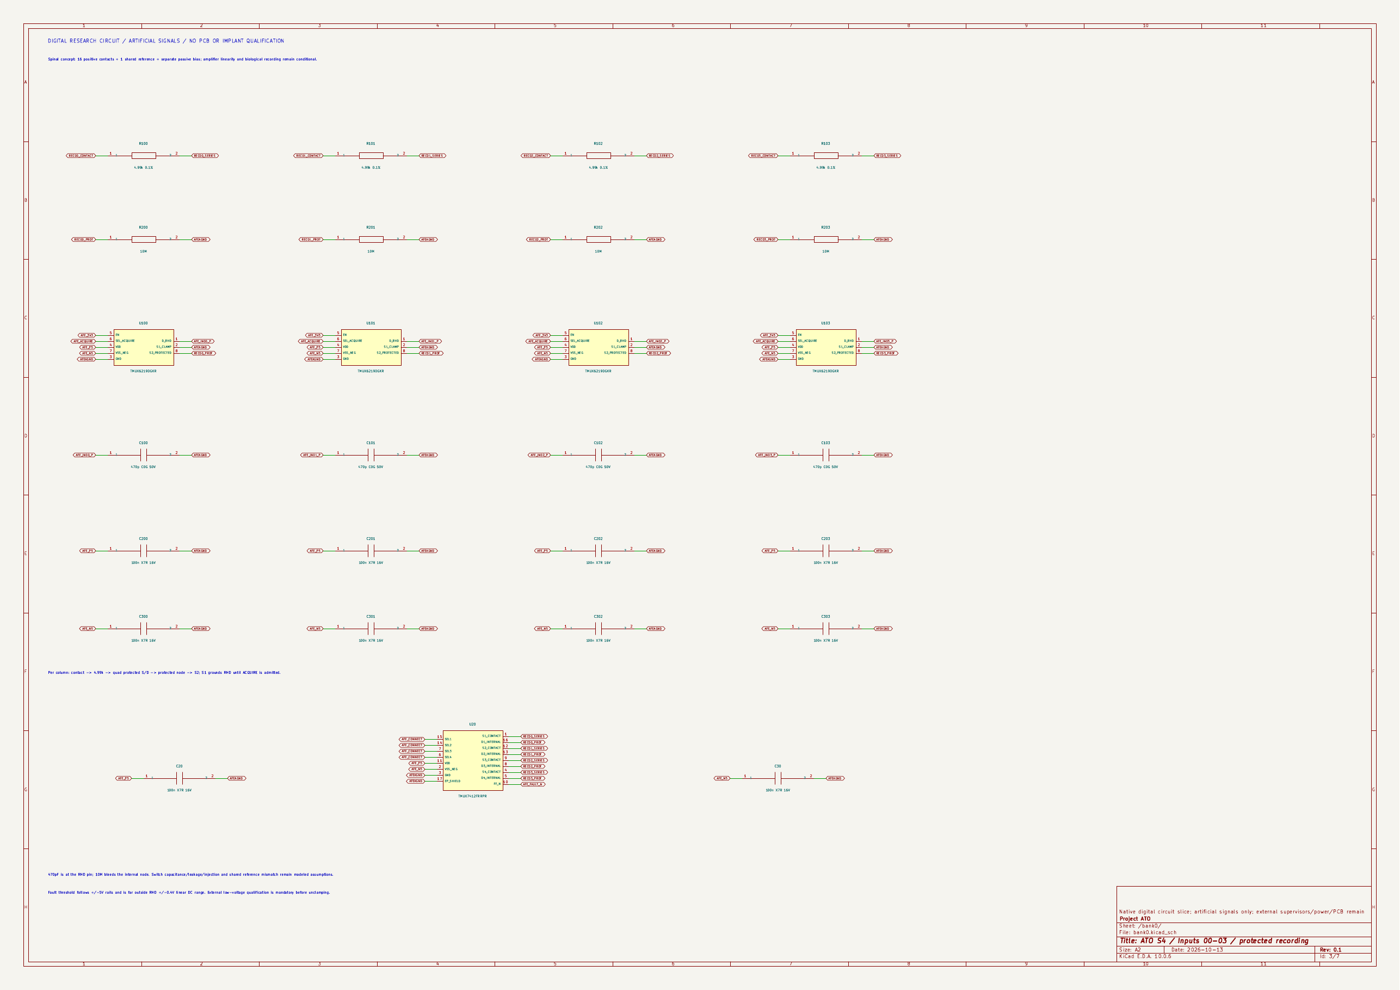
electronics/stage4/recording-front-end/review/page-3.png
