pratham-cloud-ctrl/Project-ATO/electronics/stage4/recording-study/input-network.png

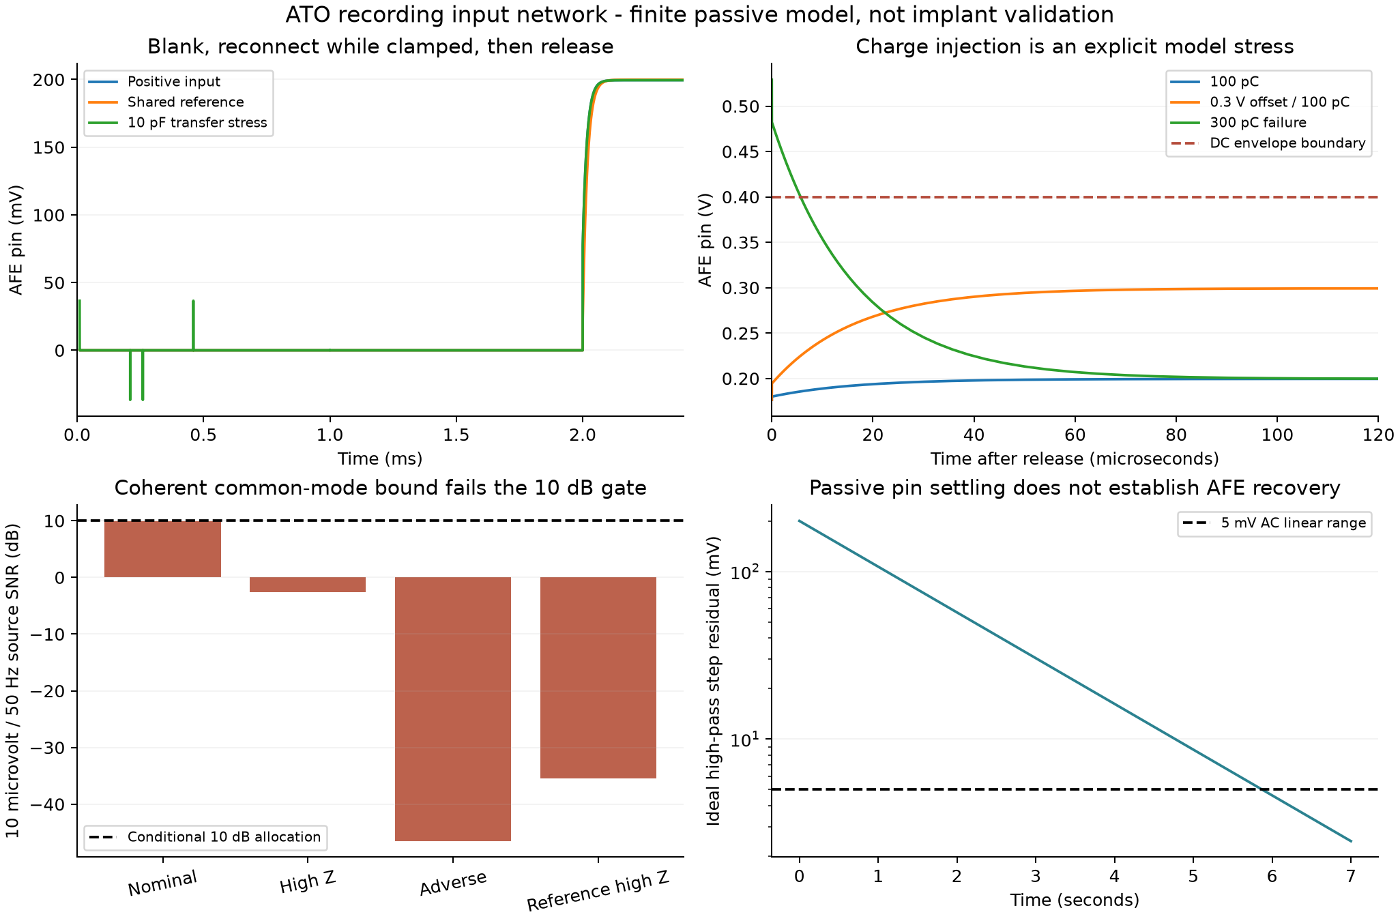
electronics/stage4/recording-study/input-network.png
