pratham-cloud-ctrl/Project-ATO/electronics/stage4/routing-study/router-parasitics.png

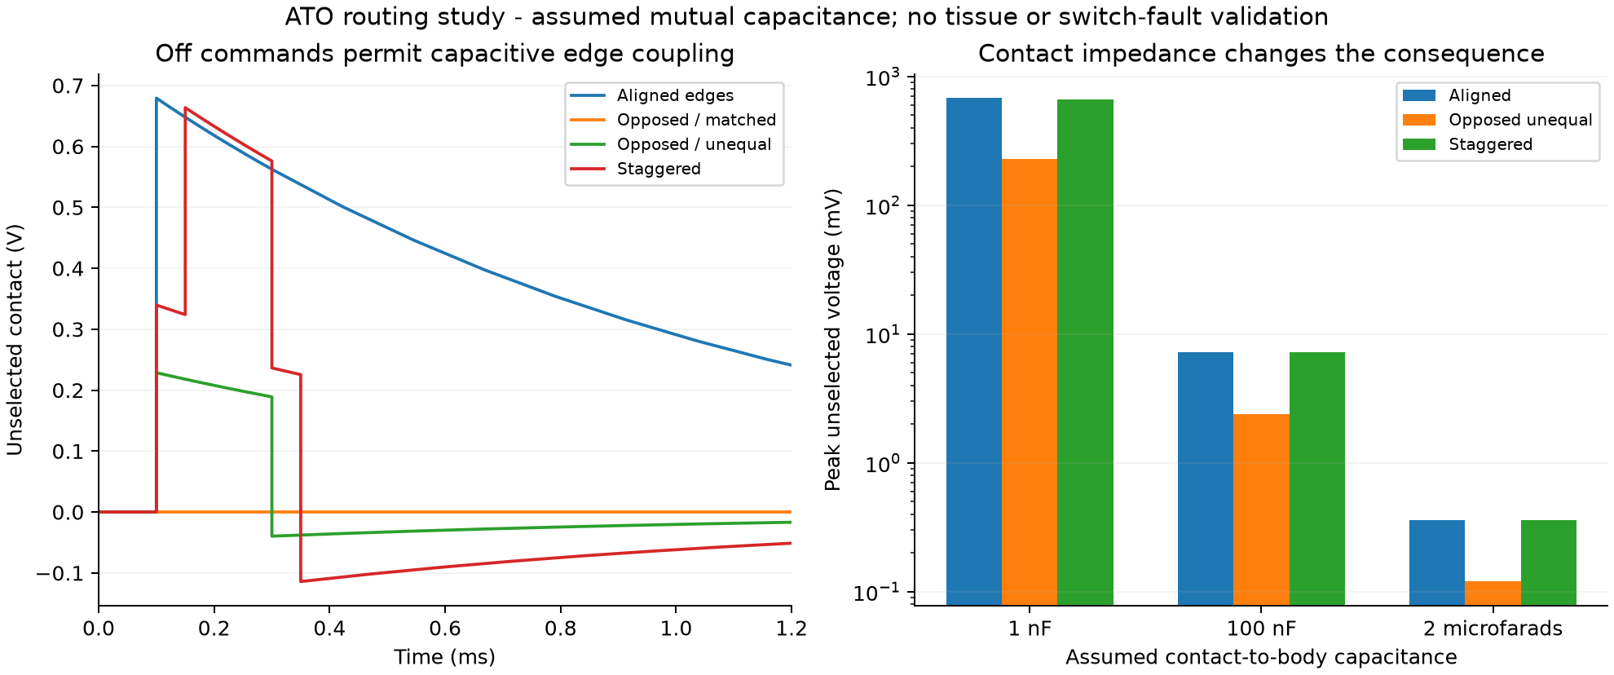
electronics/stage4/routing-study/router-parasitics.png
