pratham-cloud-ctrl/Project-ATO/electronics/stage4/supervision/review/page-1.png

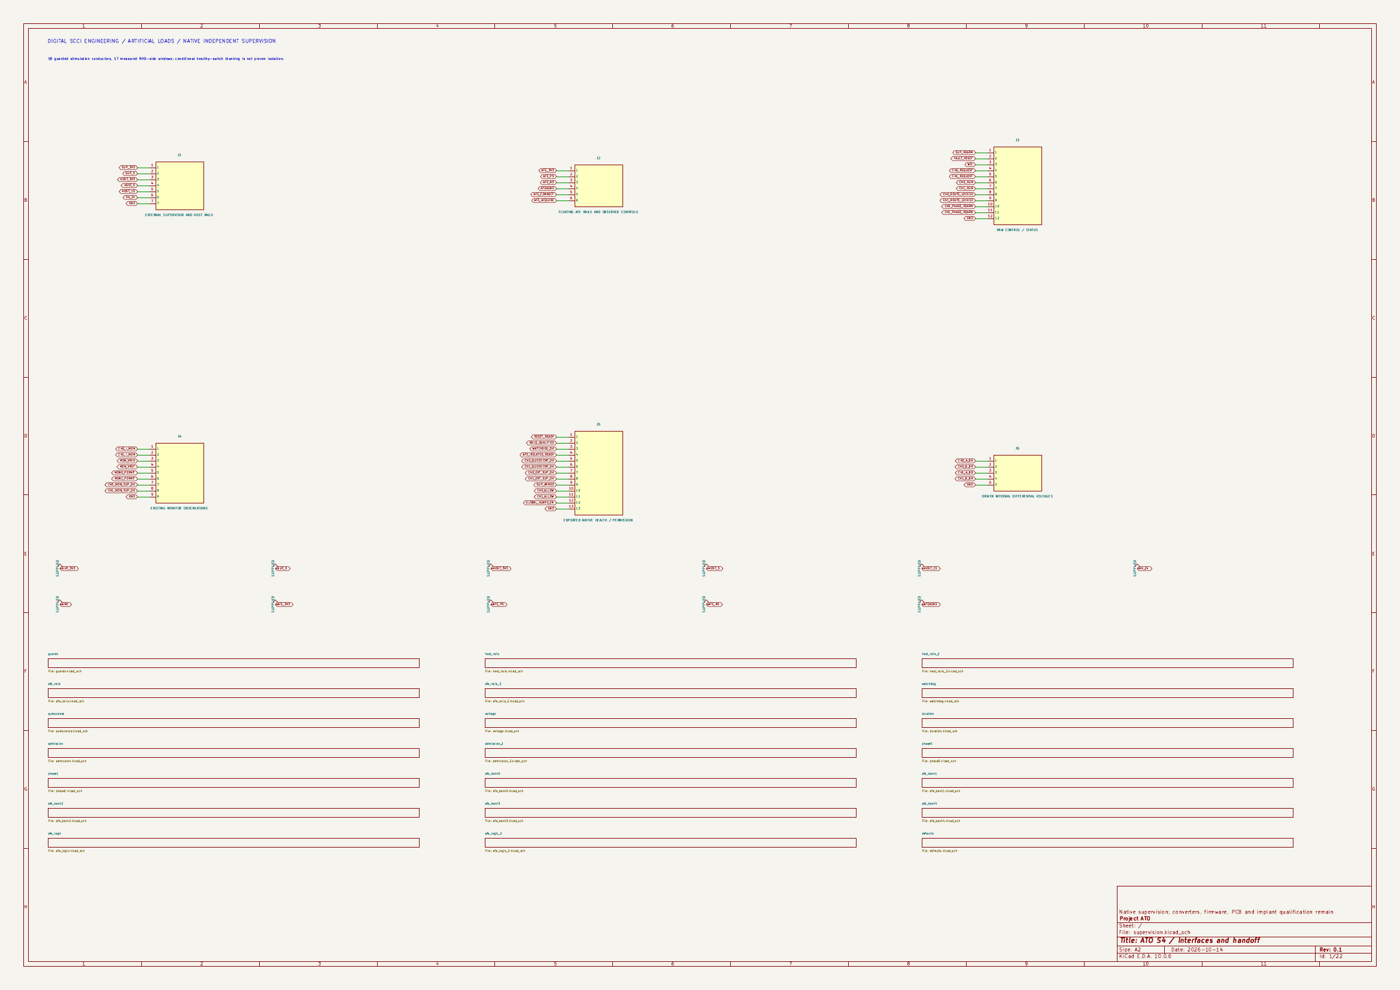
electronics/stage4/supervision/review/page-1.png
