pratham-cloud-ctrl/Project-ATO/electronics/stage4/supervision/review/page-2.png

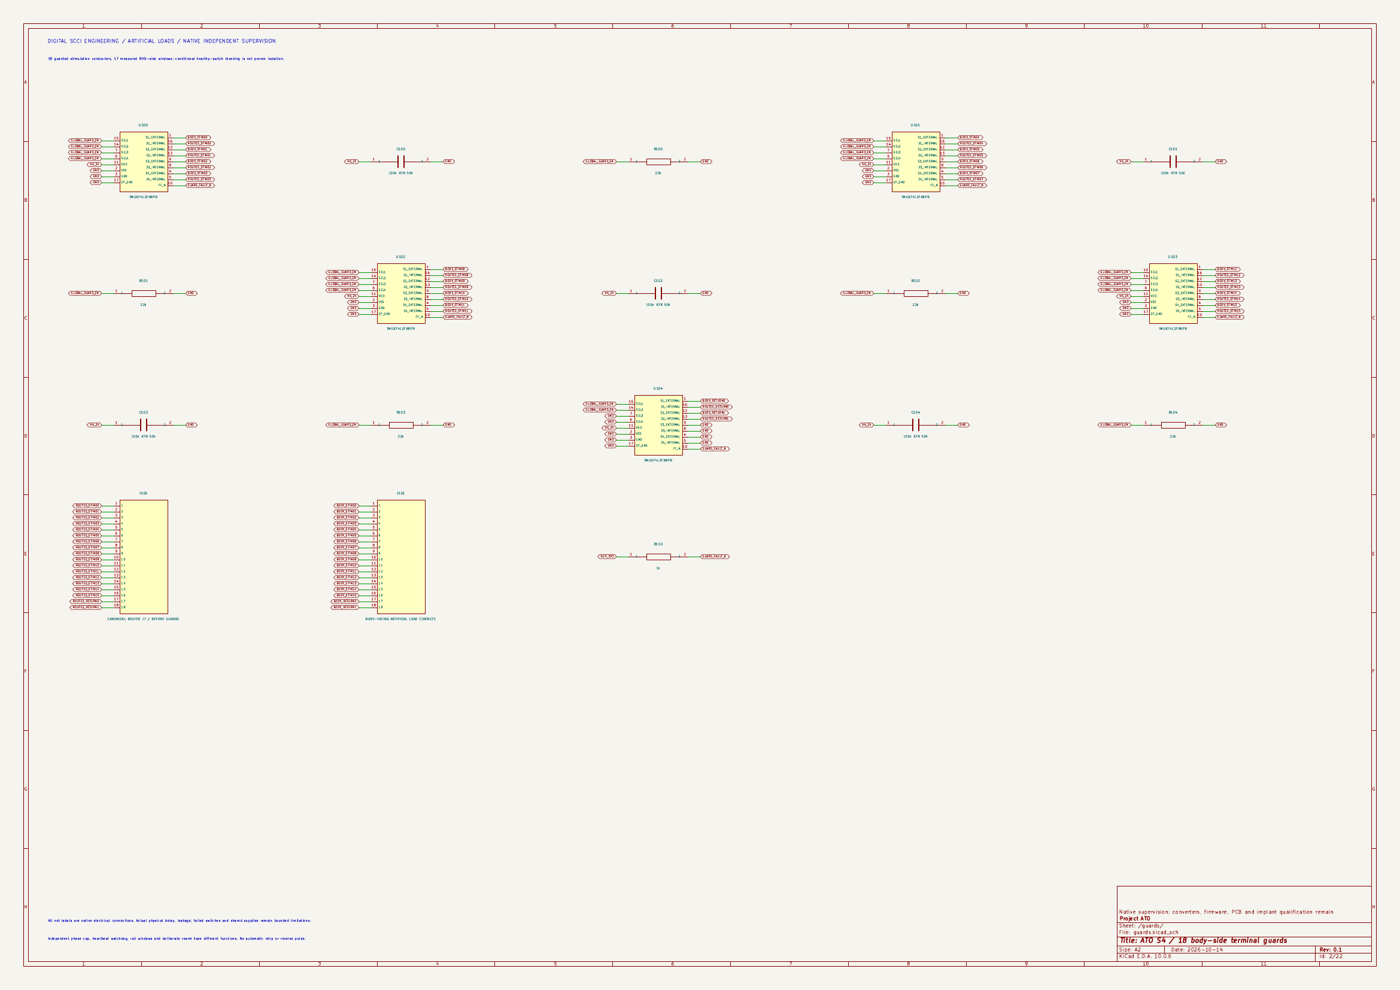
electronics/stage4/supervision/review/page-2.png
