pratham-cloud-ctrl/Project-ATO/electronics/stage4/supervision/review/page-7.png

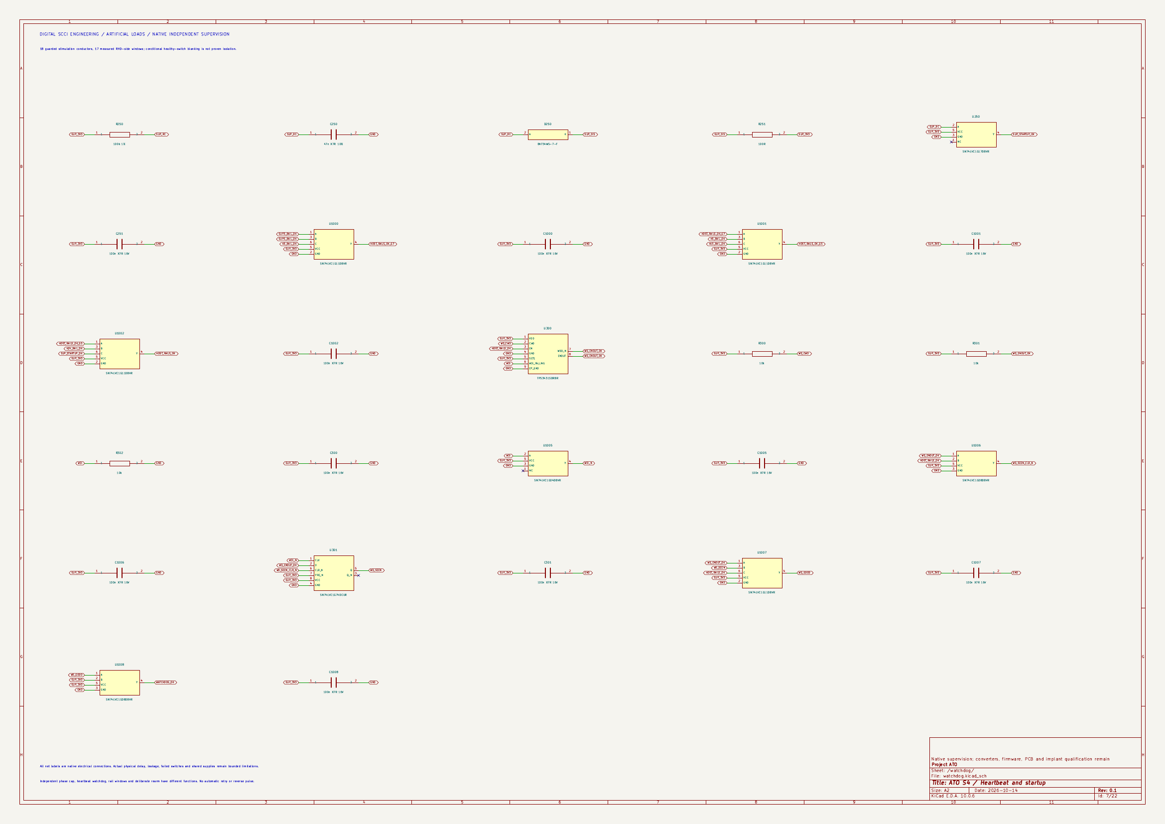
electronics/stage4/supervision/review/page-7.png
