pratham-cloud-ctrl/Project-ATO/electronics/stage4/supervision/review/page-9.png

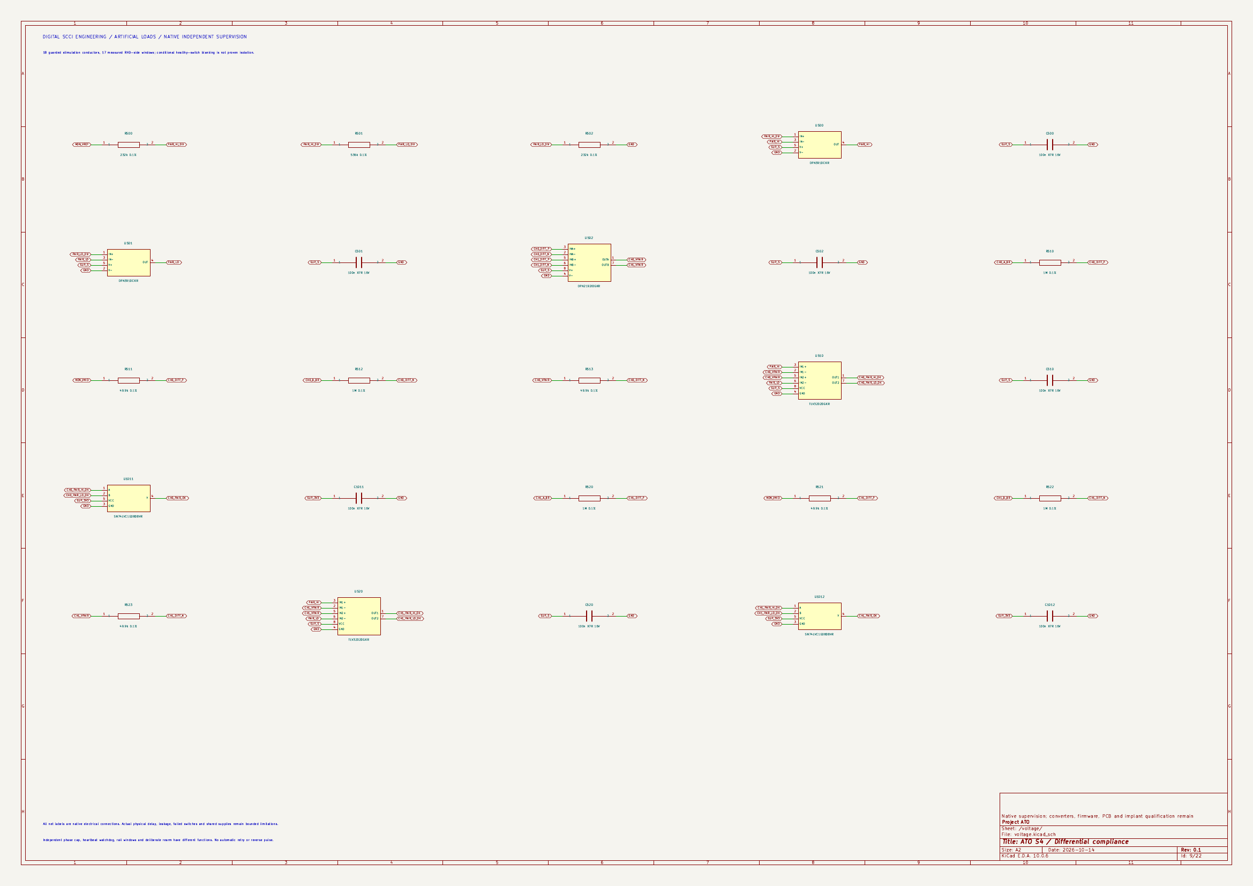
electronics/stage4/supervision/review/page-9.png
