pratham-cloud-ctrl/Project-ATO/experiments/stage3/conditional-concept/conditional-assistance.png

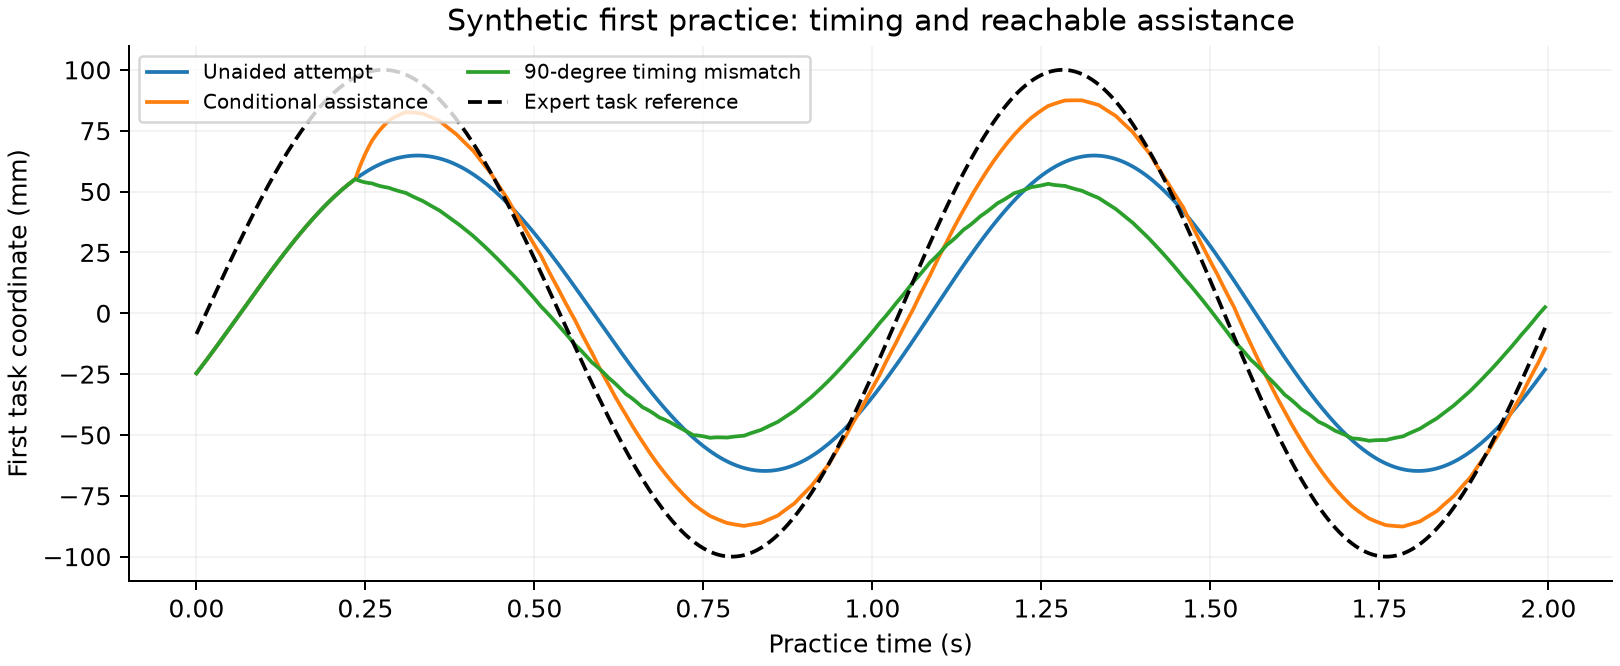
experiments/stage3/conditional-concept/conditional-assistance.png
