pratham-cloud-ctrl/Project-ATO/experiments/stage3/conditional-concept/conditional-learning.png

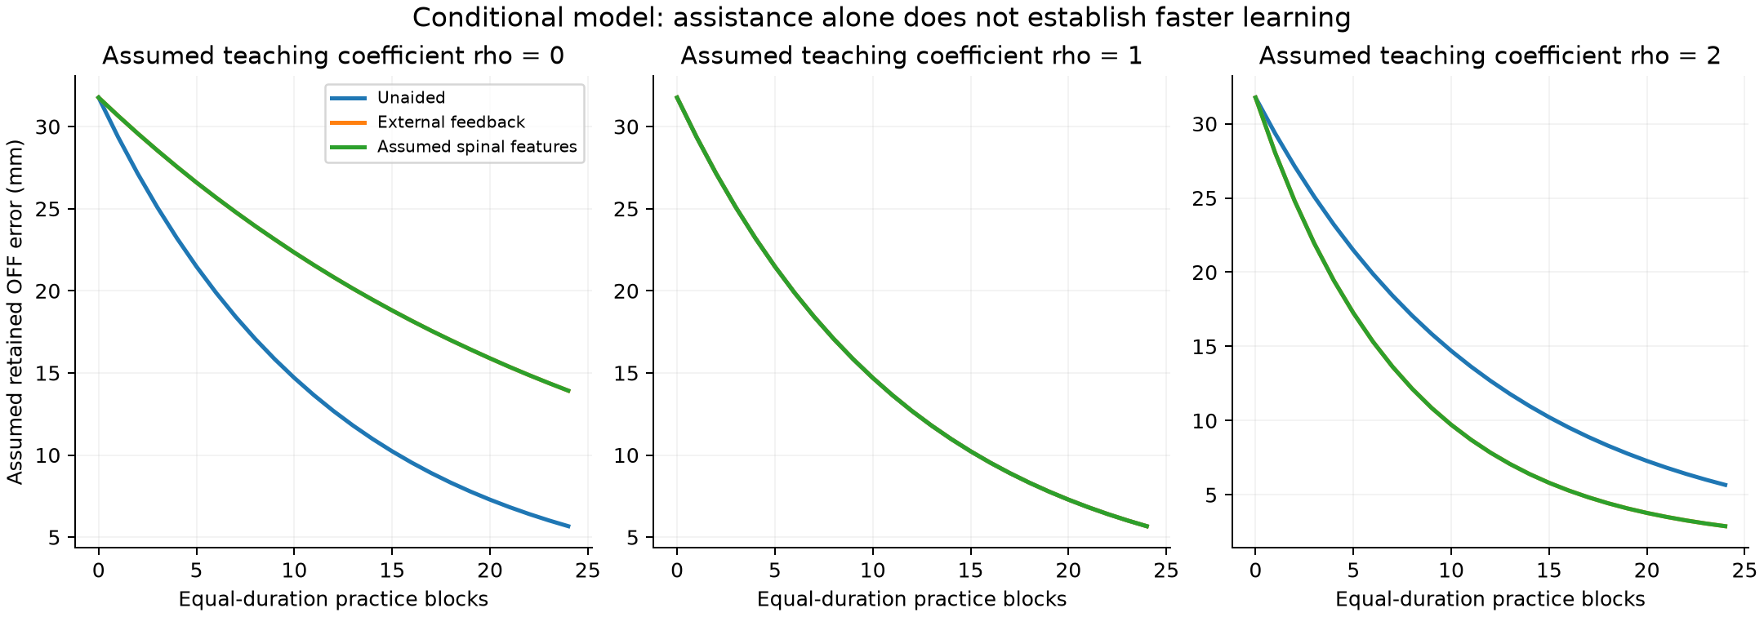
experiments/stage3/conditional-concept/conditional-learning.png
