pratham-cloud-ctrl/Project-ATO/figures/architecture.png

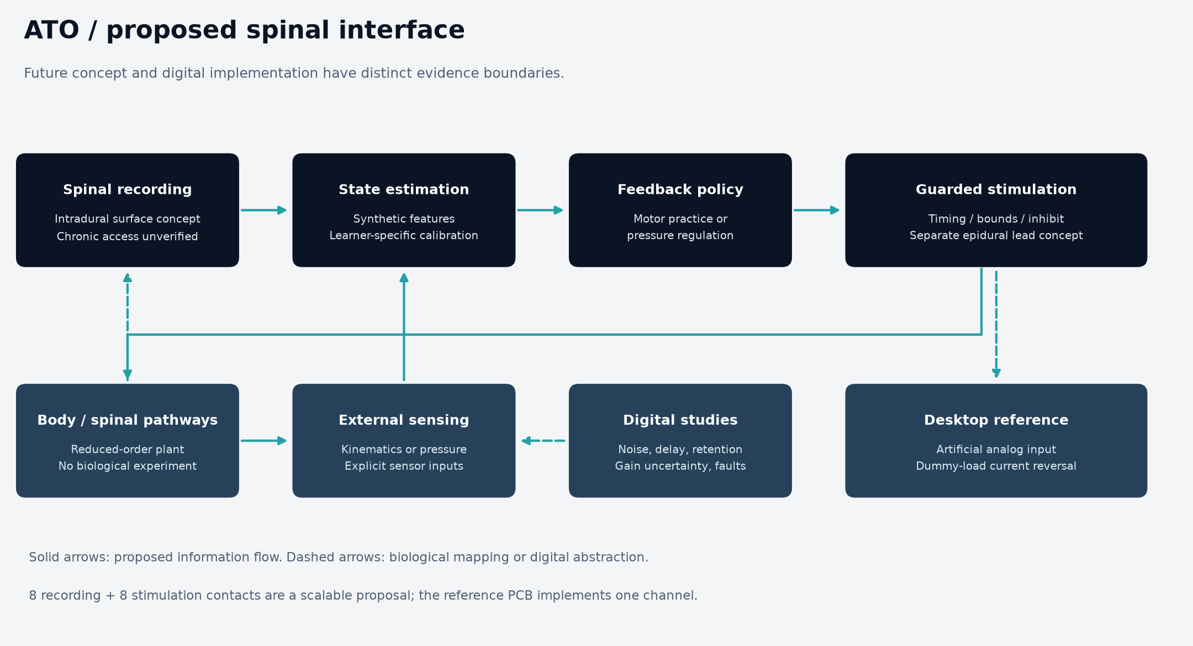
figures/architecture.png
