pratham-cloud-ctrl/Project-ATO/figures/mechanical-drawing.png

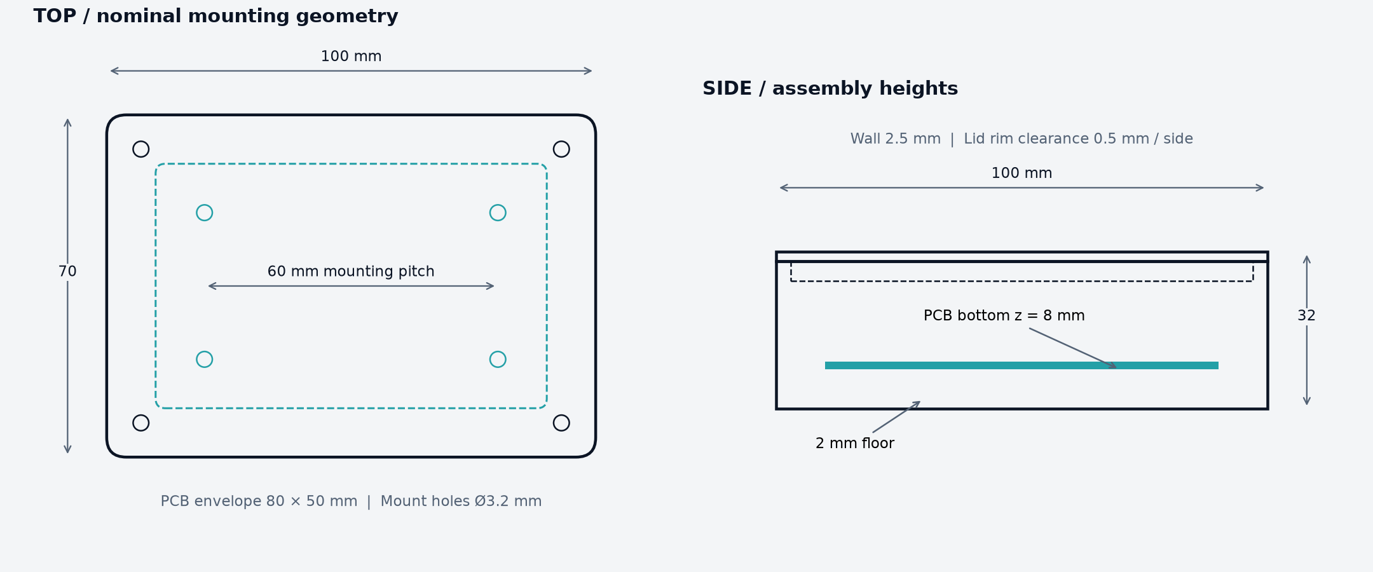
figures/mechanical-drawing.png
