pratham-cloud-ctrl/Project-ATO/figures/pulse_protocol.png

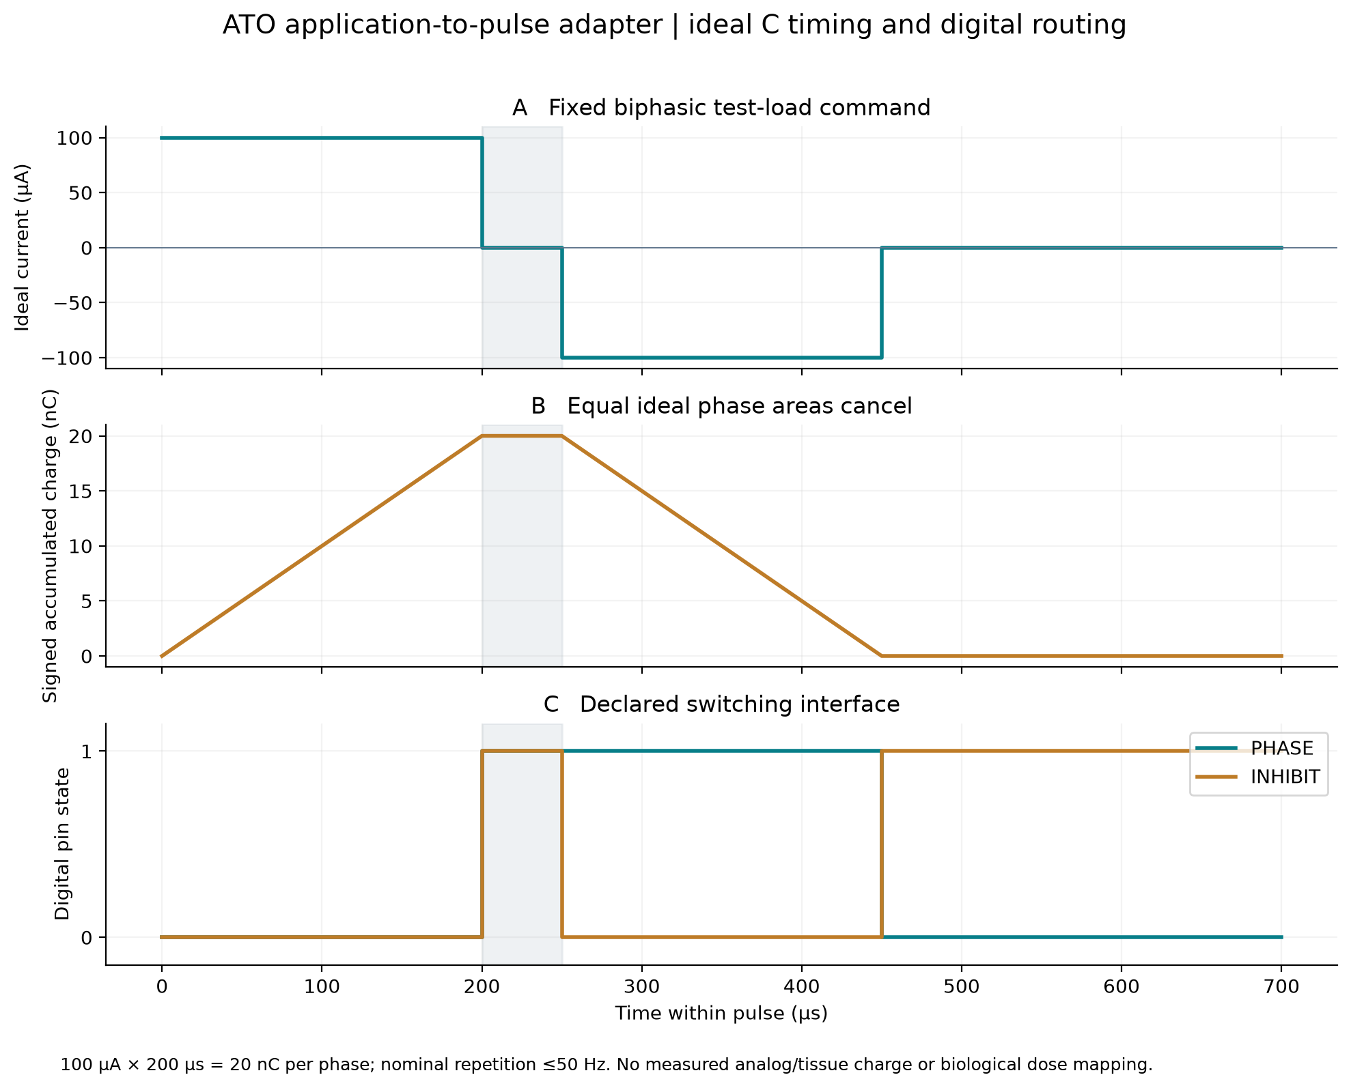
figures/pulse_protocol.png
