pratham-cloud-ctrl/Project-ATO/manuscript/stage6/figures/04_conditional_learning.png

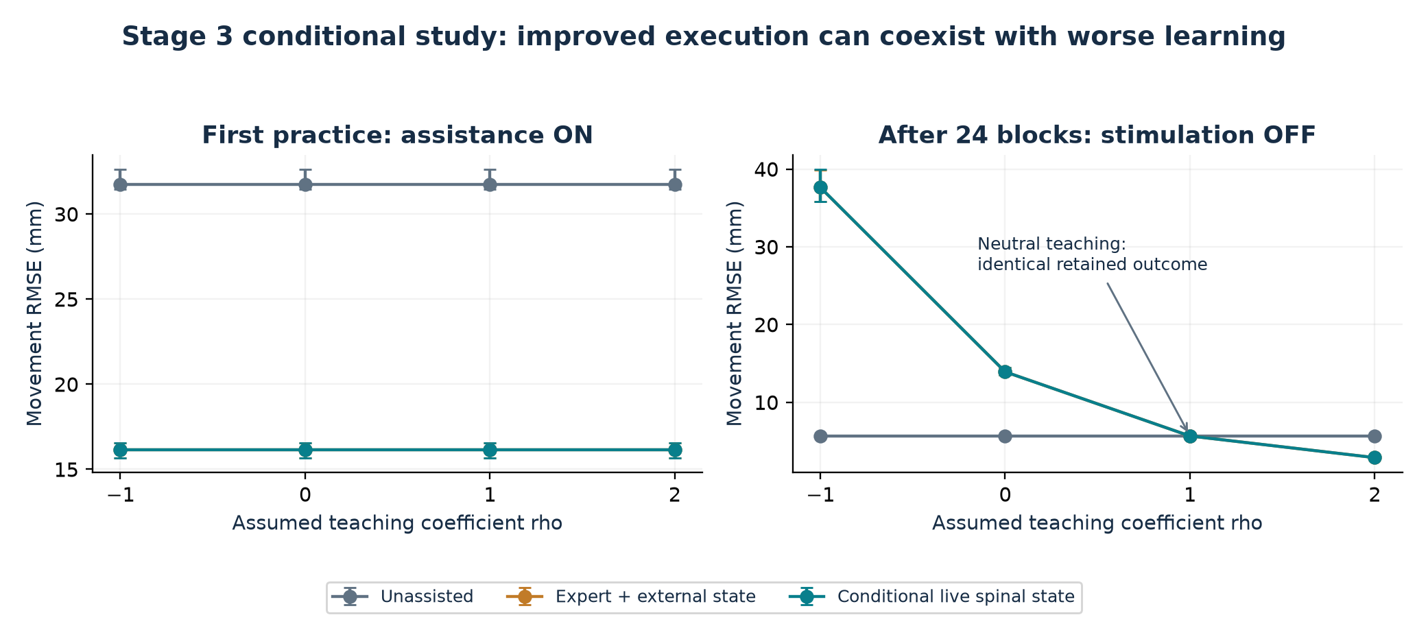
manuscript/stage6/figures/04_conditional_learning.png
