pratham-cloud-ctrl/Project-ATO/manuscript/stage6/figures/05_exposure.png

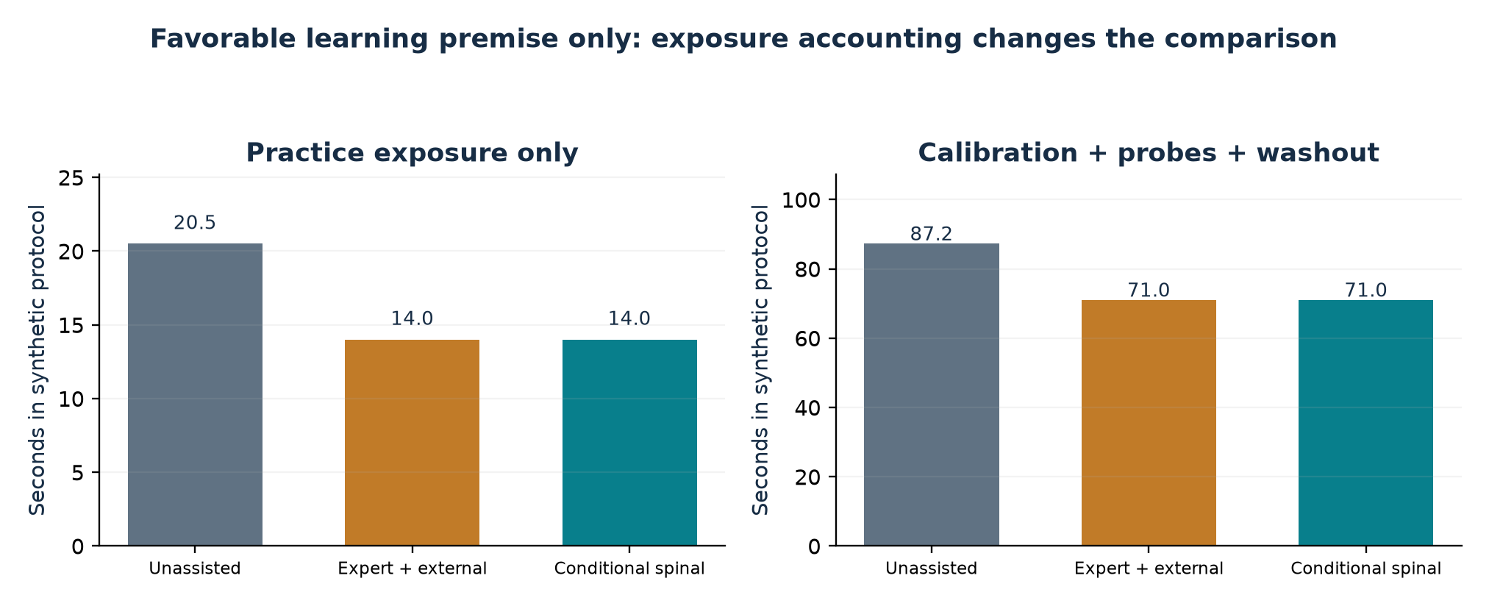
manuscript/stage6/figures/05_exposure.png
