pratham-cloud-ctrl/Project-ATO/manuscript/stage6/figures/06_pressure_tradeoff.png

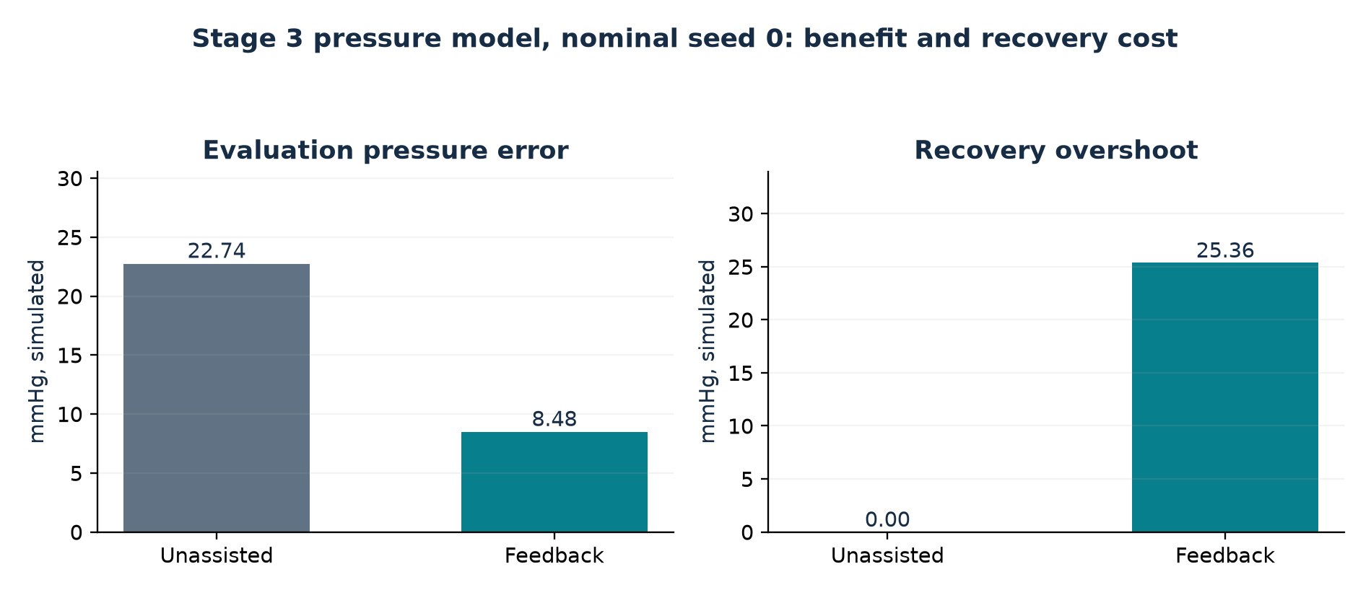
manuscript/stage6/figures/06_pressure_tradeoff.png
