pratham-cloud-ctrl/Project-ATO/manuscript/stage6/figures/07_integration.png

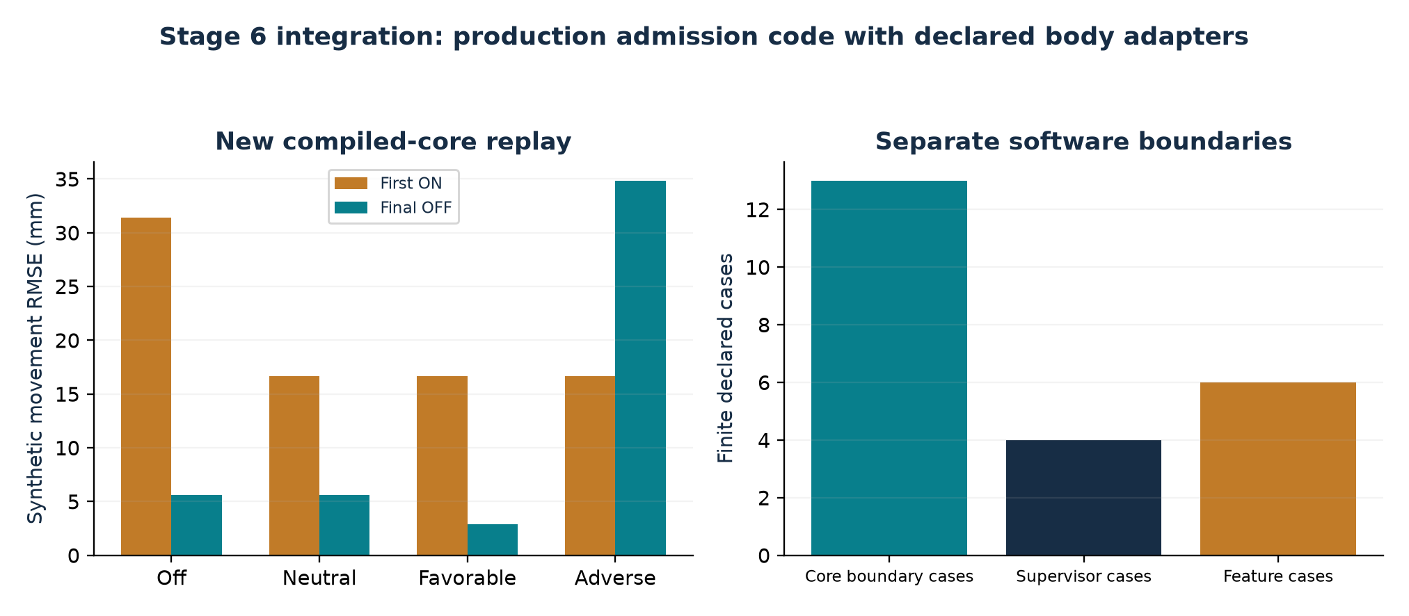
manuscript/stage6/figures/07_integration.png
