pratham-cloud-ctrl/Project-ATO/manuscript/stage6/figures/08_evidence.png

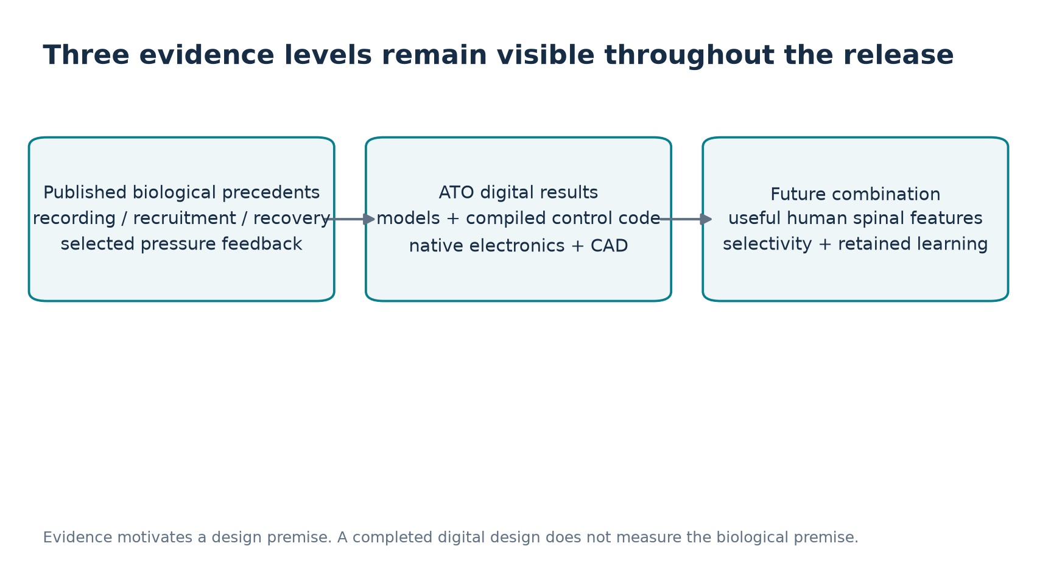
manuscript/stage6/figures/08_evidence.png
