pratham-cloud-ctrl/Project-ATO/manuscript/stage6/figures/09_runtime.png

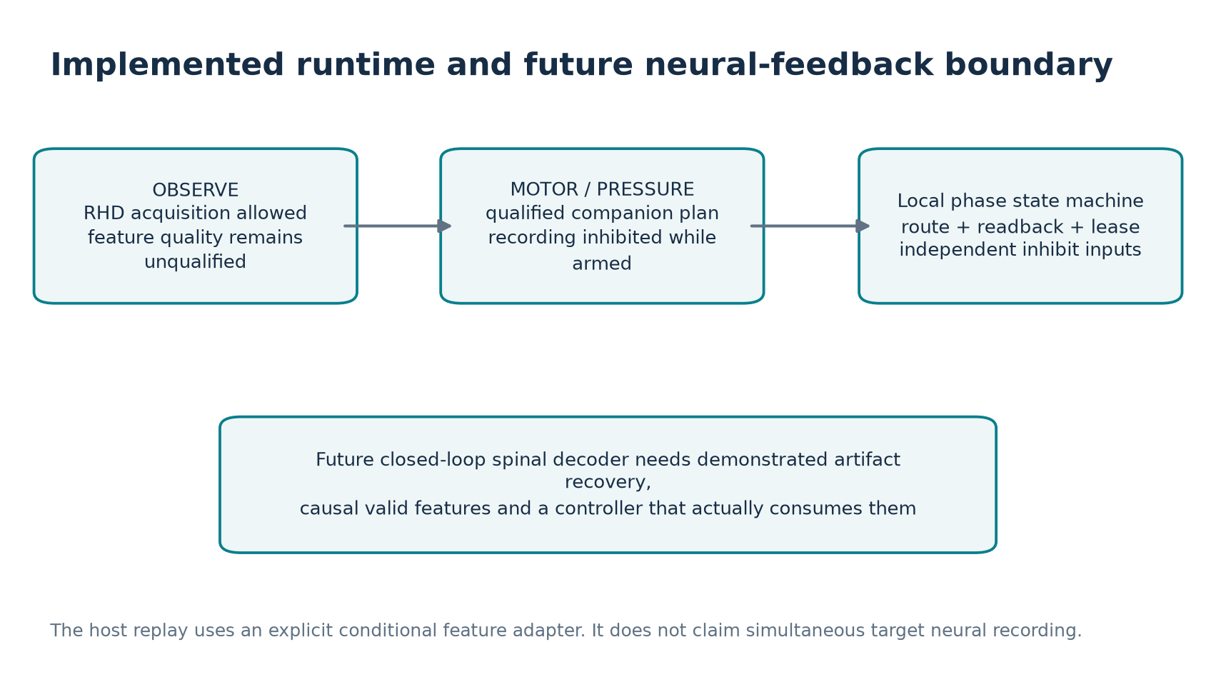
manuscript/stage6/figures/09_runtime.png
