pratham-cloud-ctrl/Project-ATO/media/ato-exploded.png

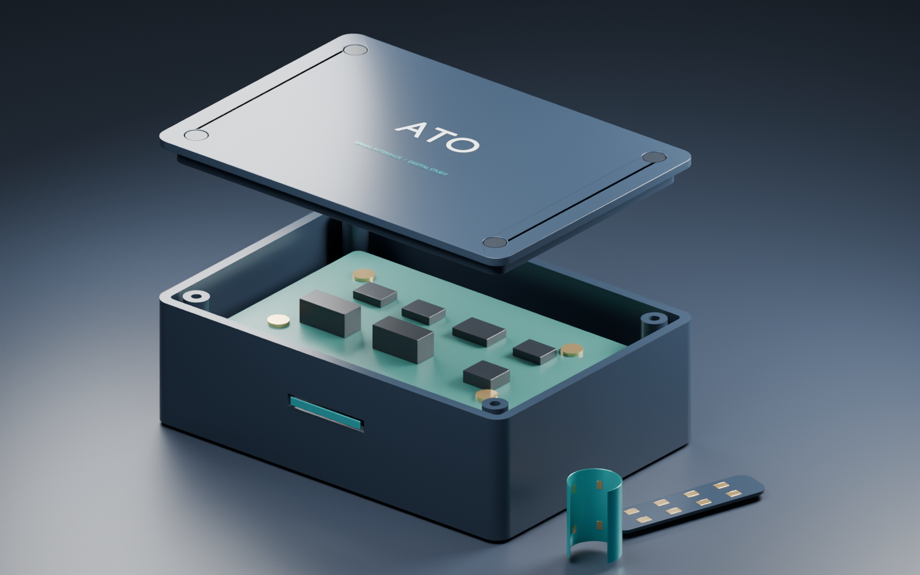
media/ato-exploded.png
