pratham-cloud-ctrl/Project-ATO/media/ato-hero.png

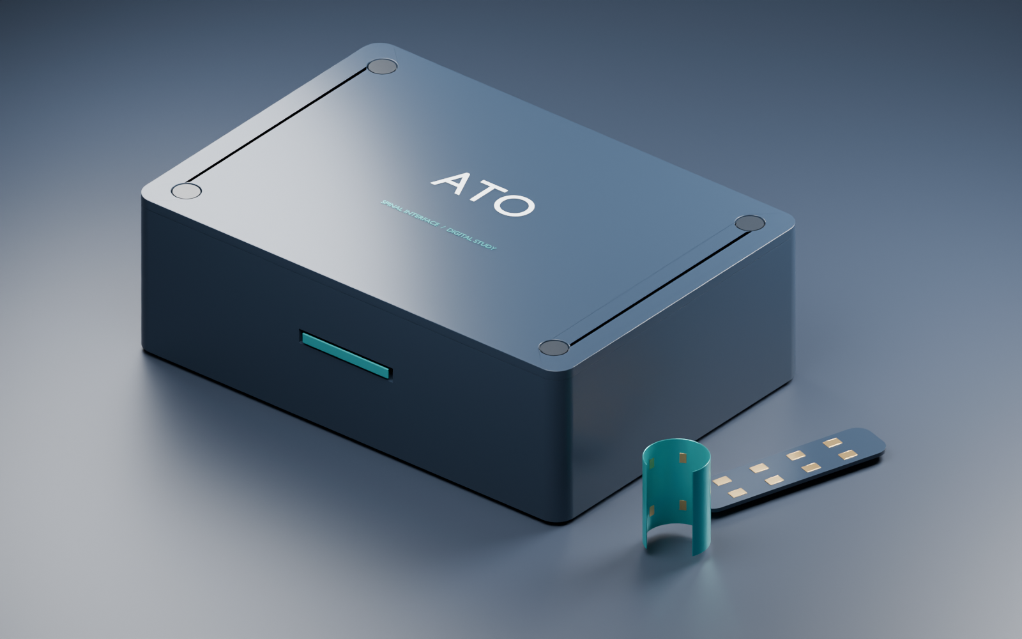
media/ato-hero.png
