pratham-cloud-ctrl/Project-ATO/electronics/stage4/controller-carrier/bom.csv

reference | value | footprint | sheet | description | primary_source
U1 | FANSTEL BT40F / nRF5340 | ato_controller:BT40F_Manufacturer_66Pad | processor | Actual66manufacturerpads;46GPIOallfree;32MHz/32.768kHzcrystalsandDC/DCnetworksinside;radioOFF;hostnormal3.3VtiesVDDandVDDH | https://www.fanstel.com/s/BT40F_BT40N-Product-Specifications.pdf
J1 | HOST POWER | ato_controller:PinHeader_1x02_P2.54mm_Vertical | root | Onlyhost3.3Vandreturn; noAFEisolatedreturnjoin
R1 | 0R | ato_controller:R_0805_2012Metric | power | Modulecurrentsense/link; inputrailquietnessandstartupunqualified
C1 | 47u X7R 10V | ato_controller:C_1206_3216Metric | power | Manufacturernoisyrailbulk; effectivecapacitanceandESRrequireselection
C2 | 1u X7R 10V | ato_controller:C_1206_3216Metric | power | Localmodulebypass
C3 | 100n X7R 10V | ato_controller:C_1206_3216Metric | power | LocalmoduleHFbypass
R2 | 10k | ato_controller:R_0805_2012Metric | power | ActiveLOWresetexternaldefault; SWDprobeorjumpercanassert
J2 | SWD / TARGET VREF | ato_controller:PinHeader_1x06_P2.54mm_Vertical | power | TargetVREFsenseonly; externalSWDprobenotpowerfeed; noradioorUSB
J3 | RESET SHORTING HEADER | ato_controller:PinHeader_1x02_P2.54mm_Vertical | power | Momentaryshortassertsreset; normallyopen
U10 | SN74LVC165APWR | ato_controller:TSSOP-16_4.4x5mm_P0.65mm | sideband | EightphysicalH..Asamplebits0..7; nearestQHreadbeforeshift; QH_Nunused | https://www.ti.com/lit/gpn/sn74lvc165a
C10 | 100n X7R 10V | ato_controller:C_1206_3216Metric | sideband | Onebypassattheactual165supplypins
U11 | SN74LVC165APWR | ato_controller:TSSOP-16_4.4x5mm_P0.65mm | sideband | EightphysicalH..Asamplebits8..15; nearestQHreadbeforeshift; QH_Nunused | https://www.ti.com/lit/gpn/sn74lvc165a
C11 | 100n X7R 10V | ato_controller:C_1206_3216Metric | sideband | Onebypassattheactual165supplypins
U12 | SN74LVC165APWR | ato_controller:TSSOP-16_4.4x5mm_P0.65mm | sideband | EightphysicalH..Asamplebits16..23; nearestQHreadbeforeshift; QH_Nunused | https://www.ti.com/lit/gpn/sn74lvc165a
C12 | 100n X7R 10V | ato_controller:C_1206_3216Metric | sideband | Onebypassattheactual165supplypins
U13 | SN74LVC165APWR | ato_controller:TSSOP-16_4.4x5mm_P0.65mm | sideband | EightphysicalH..Asamplebits24..31; nearestQHreadbeforeshift; QH_Nunused | https://www.ti.com/lit/gpn/sn74lvc165a
C13 | 100n X7R 10V | ato_controller:C_1206_3216Metric | sideband | Onebypassattheactual165supplypins
J10 | RAW MONITOR | ato_controller:PinHeader_1x06_P2.54mm_Vertical | handoff | monitoring-transport:J3
J11 | ISOLATED RECORDING HOST | ato_controller:PinHeader_1x10_P2.54mm_Vertical | handoff | recording-front-end:J2
J12 | SHARED CHARGE ENDPOINT SPI | ato_controller:PinHeader_1x07_P2.54mm_Vertical | handoff | monitoring-transport:J22
J13 | DOSE / MONITOR REARM | ato_controller:PinHeader_1x05_P2.54mm_Vertical | handoff | monitoring-transport:J20.8..11
J14 | DAC SERIAL | ato_controller:PinHeader_1x04_P2.54mm_Vertical | handoff_2 | current-driver:J2
J15 | DRIVER REQUEST / POLARITY | ato_controller:PinHeader_1x09_P2.54mm_Vertical | handoff_2 | current-driver:J3
J16 | ROUTE CANDIDATE / COMMIT | ato_controller:PinHeader_1x09_P2.54mm_Vertical | handoff_2 | contact-router:J2/J3/J4
J17 | ACTIVE ROUTE READBACK | ato_controller:PinHeader_1x09_P2.54mm_Vertical | handoff_2 | contact-router:J6
J18 | SUPERVISION CONTROL | ato_controller:PinHeader_1x08_P2.54mm_Vertical | handoff_3 | supervision:J3
J19 | NATIVE HEALTH OBSERVATIONS | ato_controller:PinHeader_1x19_P2.54mm_Vertical | handoff_3 | native health/status only; noindependentguardauthorityreplacement
J20 | ISOLATED COMPANION HOST UART | ato_controller:PinHeader_1x04_P2.54mm_Vertical | handoff_3 | monitoring-transport:J7
R100 | 10k | ato_controller:R_0805_2012Metric | defaults | Carrierresetbiaslow; unknownintegratorhistoryhelduntilqualifiedrecovery
R101 | 10k | ato_controller:R_0805_2012Metric | defaults | Carrierresetbiaslow; unknownintegratorhistoryhelduntilqualifiedrecovery
R102 | 10k | ato_controller:R_0805_2012Metric | defaults | Carrierresetbiaslow; unknownintegratorhistoryhelduntilqualifiedrecovery
R103 | 10k | ato_controller:R_0805_2012Metric | defaults | Carrierresetbiaslow; unknownintegratorhistoryhelduntilqualifiedrecovery
R104 | 10k | ato_controller:R_0805_2012Metric | defaults | Carrierresetbiaslow; unknownintegratorhistoryhelduntilqualifiedrecovery
R105 | 10k | ato_controller:R_0805_2012Metric | defaults | Carrierresetbiaslow; unknownintegratorhistoryhelduntilqualifiedrecovery
R106 | 10k | ato_controller:R_0805_2012Metric | defaults | Carrierresetbiaslow; unknownintegratorhistoryhelduntilqualifiedrecovery
R107 | 10k | ato_controller:R_0805_2012Metric | defaults | Carrierresetbiaslow; unknownintegratorhistoryhelduntilqualifiedrecovery
R108 | 10k | ato_controller:R_0805_2012Metric | defaults | Carrierresetbiashigh; unknownintegratorhistoryhelduntilqualifiedrecovery
R109 | 10k | ato_controller:R_0805_2012Metric | defaults | Carrierresetbiaslow; unknownintegratorhistoryhelduntilqualifiedrecovery
R110 | 10k | ato_controller:R_0805_2012Metric | defaults | Carrierresetbiaslow; unknownintegratorhistoryhelduntilqualifiedrecovery
R111 | 10k | ato_controller:R_0805_2012Metric | defaults | Carrierresetbiaslow; unknownintegratorhistoryhelduntilqualifiedrecovery
R112 | 10k | ato_controller:R_0805_2012Metric | defaults | Carrierresetbiaslow; unknownintegratorhistoryhelduntilqualifiedrecovery
R113 | 10k | ato_controller:R_0805_2012Metric | defaults | Carrierresetbiaslow; unknownintegratorhistoryhelduntilqualifiedrecovery
R114 | 10k | ato_controller:R_0805_2012Metric | defaults_2 | Carrierresetbiaslow; unknownintegratorhistoryhelduntilqualifiedrecovery
R115 | 10k | ato_controller:R_0805_2012Metric | defaults_2 | Carrierresetbiaslow; unknownintegratorhistoryhelduntilqualifiedrecovery
R116 | 10k | ato_controller:R_0805_2012Metric | defaults_2 | Carrierresetbiaslow; unknownintegratorhistoryhelduntilqualifiedrecovery
R117 | 10k | ato_controller:R_0805_2012Metric | defaults_2 | Carrierresetbiashigh; unknownintegratorhistoryhelduntilqualifiedrecovery
R118 | 10k | ato_controller:R_0805_2012Metric | defaults_2 | Carrierresetbiashigh; unknownintegratorhistoryhelduntilqualifiedrecovery
R119 | 10k | ato_controller:R_0805_2012Metric | defaults_2 | Carrierresetbiashigh; unknownintegratorhistoryhelduntilqualifiedrecovery
R120 | 10k | ato_controller:R_0805_2012Metric | defaults_2 | Carrierresetbiashigh; unknownintegratorhistoryhelduntilqualifiedrecovery
R121 | 10k | ato_controller:R_0805_2012Metric | defaults_2 | Carrierresetbiaslow; unknownintegratorhistoryhelduntilqualifiedrecovery
R122 | 10k | ato_controller:R_0805_2012Metric | defaults_2 | Carrierresetbiaslow; unknownintegratorhistoryhelduntilqualifiedrecovery
R123 | 10k | ato_controller:R_0805_2012Metric | defaults_2 | Carrierresetbiaslow; unknownintegratorhistoryhelduntilqualifiedrecovery
R124 | 10k | ato_controller:R_0805_2012Metric | defaults_2 | Carrierresetbiaslow; unknownintegratorhistoryhelduntilqualifiedrecovery
R125 | 10k | ato_controller:R_0805_2012Metric | defaults_2 | Carrierresetbiashigh; unknownintegratorhistoryhelduntilqualifiedrecovery
R126 | 10k | ato_controller:R_0805_2012Metric | defaults_2 | Carrierresetbiaslow; unknownintegratorhistoryhelduntilqualifiedrecovery
R127 | 10k | ato_controller:R_0805_2012Metric | defaults_2 | Carrierresetbiaslow; unknownintegratorhistoryhelduntilqualifiedrecovery
R128 | 10k | ato_controller:R_0805_2012Metric | defaults_3 | Carrierresetbiaslow; unknownintegratorhistoryhelduntilqualifiedrecovery
R129 | 10k | ato_controller:R_0805_2012Metric | defaults_3 | Carrierresetbiaslow; unknownintegratorhistoryhelduntilqualifiedrecovery
R130 | 10k | ato_controller:R_0805_2012Metric | defaults_3 | Carrierresetbiaslow; unknownintegratorhistoryhelduntilqualifiedrecovery
R131 | 10k | ato_controller:R_0805_2012Metric | defaults_3 | Carrierresetbiaslow; unknownintegratorhistoryhelduntilqualifiedrecovery
R132 | 10k | ato_controller:R_0805_2012Metric | defaults_3 | Carrierresetbiaslow; unknownintegratorhistoryhelduntilqualifiedrecovery
R133 | 10k | ato_controller:R_0805_2012Metric | defaults_3 | Carrierresetbiaslow; unknownintegratorhistoryhelduntilqualifiedrecovery
R134 | 10k | ato_controller:R_0805_2012Metric | defaults_3 | Carrierresetbiaslow; unknownintegratorhistoryhelduntilqualifiedrecovery
R135 | 10k | ato_controller:R_0805_2012Metric | defaults_3 | Carrierresetbiaslow; unknownintegratorhistoryhelduntilqualifiedrecovery
R136 | 10k | ato_controller:R_0805_2012Metric | defaults_3 | Carrierresetbiaslow; unknownintegratorhistoryhelduntilqualifiedrecovery
R137 | 10k | ato_controller:R_0805_2012Metric | defaults_3 | Carrierresetbiaslow; unknownintegratorhistoryhelduntilqualifiedrecovery
R138 | 10k | ato_controller:R_0805_2012Metric | defaults_3 | Carrierresetbiashigh; unknownintegratorhistoryhelduntilqualifiedrecovery
R139 | 10k | ato_controller:R_0805_2012Metric | defaults_3 | Carrierresetbiashigh; unknownintegratorhistoryhelduntilqualifiedrecovery
