pratham-cloud-ctrl/Project-ATO/electronics/stage4/recording-front-end/bom.csv

reference | value | footprint | sheet | dnp | description | primary_source
J1 | EXTERNAL ISOLATED AFE RAILS | ato_afe:PinHeader_1x04_P2.54mm_Vertical | root | False | Externally supplied regulated isolated rails; no isolated power converter or rail supervisor is implemented
J2 | HOST SPI / SUPERVISOR | ato_afe:PinHeader_1x10_P2.54mm_Vertical | root | False | Host/driver domain; active-high CS_ASSERT is inverted only on AFE island; voltage-qualified readiness is external
J3 | 18 RECORDING FUNCTIONAL PORTS | ato_afe:PinHeader_1x18_P2.54mm_Vertical | root | False | Research fixture header only: sixteen positive contacts, one reference and one separate body-bias contact; no stimulation return
U1 | ISO6741FDWR | ato_afe:SOIC-16W_7.5x10.3mm_P1.27mm | root | False | SPI galvanic barrier; F outputs default LOW when valid receive supply lacks valid input signal; no isolated power | https://www.ti.com/lit/ds/symlink/iso6741.pdf
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
