pratham-cloud-ctrl/Project-ATO/docs/explore/inspector-review/pcb-component.jpg

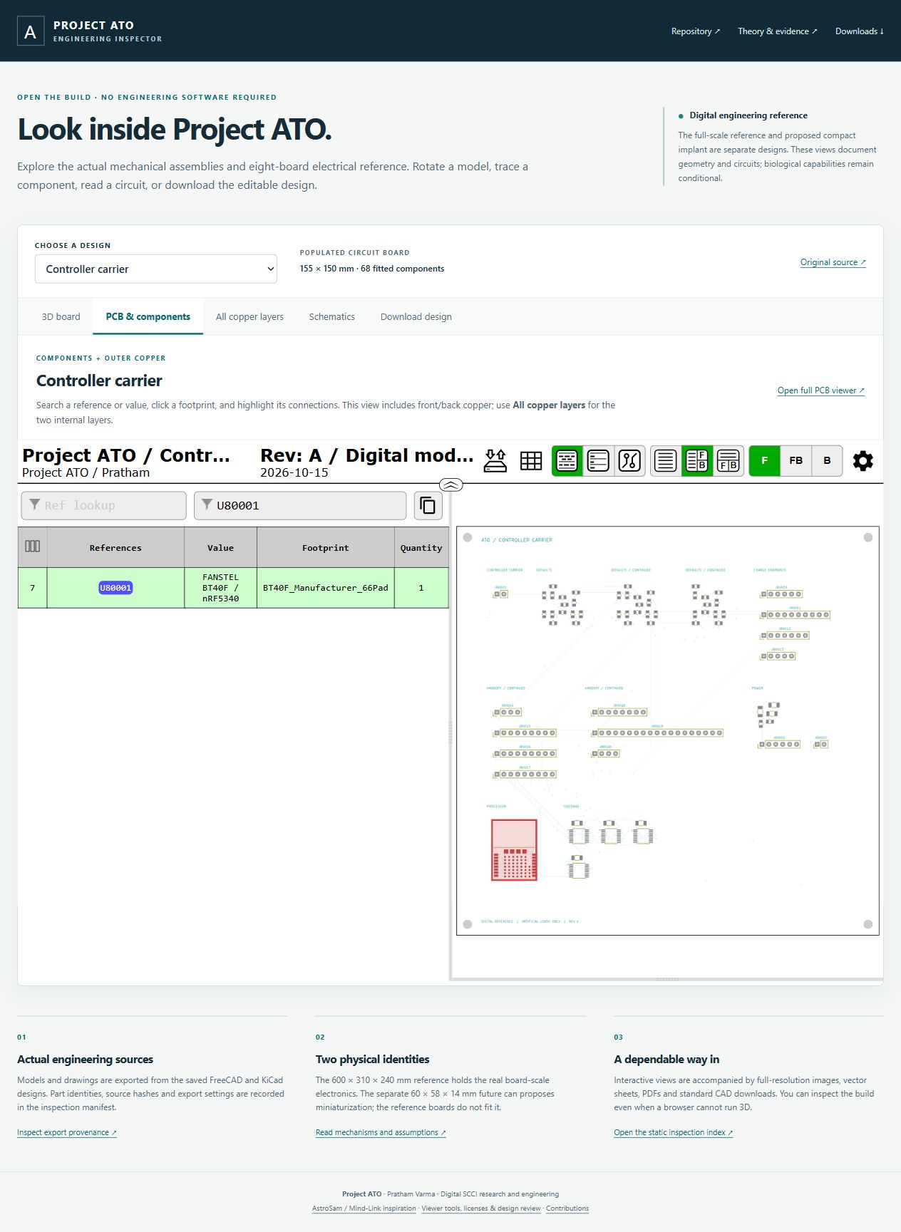
docs/explore/inspector-review/pcb-component.jpg
