pratham-cloud-ctrl/Project-ATO/cad/exports/ato-desktop-assembly.step

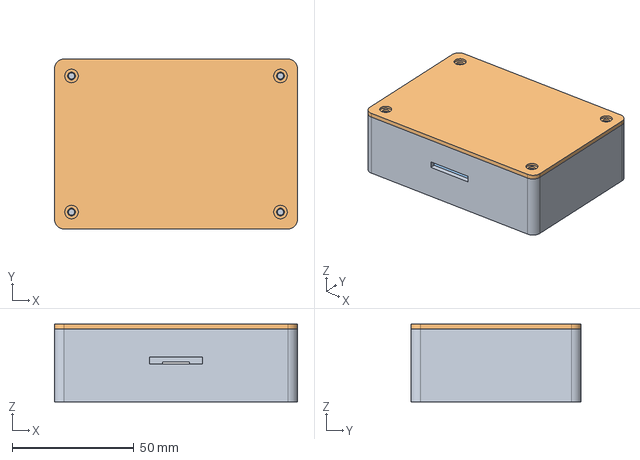
[picture p134: CAD file, 2026-10-07]
cad/exports/ato-desktop-assembly.step
100.0 x 70.0 x 32.0 mm
