pratham-cloud-ctrl/Project-ATO/cad/exports/lead-contacts.step

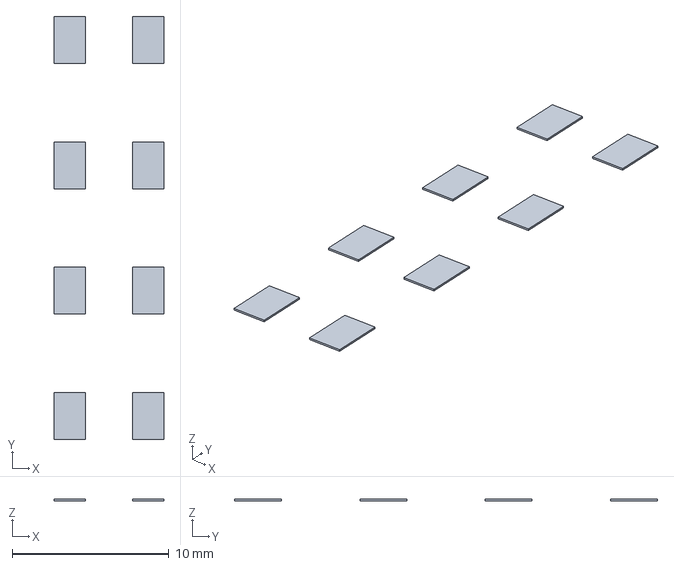
[picture p137: CAD file, 2026-10-07]
cad/exports/lead-contacts.step
7.00 x 27.0 x 0.1 mm
