pratham-cloud-ctrl/Project-ATO/cad/stage2/ATO_stage2_allocation.step

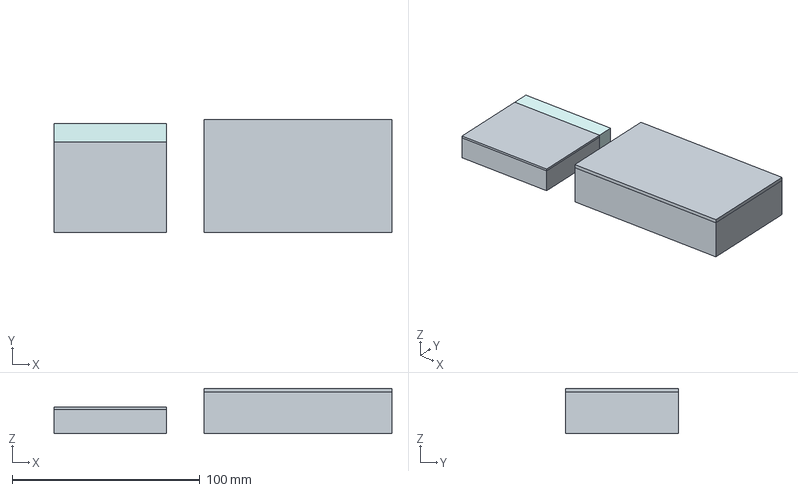
[picture p138: CAD file, 2026-10-16]
cad/stage2/ATO_stage2_allocation.step
180.0 x 60.0 x 24.0 mm
Core_Can_Open
Core_Lid_Unsealed
Dielectric_Header_Allocation
Unpopulated_PCB_Allocation
Contego_200_Bounding_Box
Effective_HV_Capacitor_Bank_Reservation
Hub_Open_Housing
Hub_Lid_Unsealed
Unqualified_Insulator_01
Interface_Port_01
Unqualified_Insulator_02
Interface_Port_02
Unqualified_Insulator_03
Interface_Port_03
Unqualified_Insulator_04
Interface_Port_04
Unqualified_Insulator_05
Interface_Port_05
Unqualified_Insulator_06
Interface_Port_06
Unqualified_Insulator_07
Interface_Port_07
Unqualified_Insulator_08
Interface_Port_08
Unqualified_Insulator_09
Interface_Port_09
Unqualified_Insulator_10
Interface_Port_10
Unqualified_Insulator_11
Interface_Port_11
Unqualified_Insulator_12
Interface_Port_12
Unqualified_Insulator_13
Interface_Port_13
Unqualified_Insulator_14
Interface_Port_14
Unqualified_Insulator_15
Interface_Port_15
Unqualified_Insulator_16
Interface_Port_16
Unqualified_Insulator_17
Interface_Port_17
Unqualified_Insulator_18
Interface_Port_18
Unqualified_Insulator_19
Interface_Port_19
Unqualified_Insulator_20
Interface_Port_20
Unqualified_Insulator_21
Interface_Port_21
Unqualified_Insulator_22
Interface_Port_22
Unqualified_Insulator_23
Interface_Port_23
Unqualified_Insulator_24
Interface_Port_24
Unqualified_Insulator_25
Interface_Port_25
Unqualified_Insulator_26
Interface_Port_26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
