pratham-cloud-ctrl/Project-ATO/cad/stage5/ATO_reference_inspection.stl

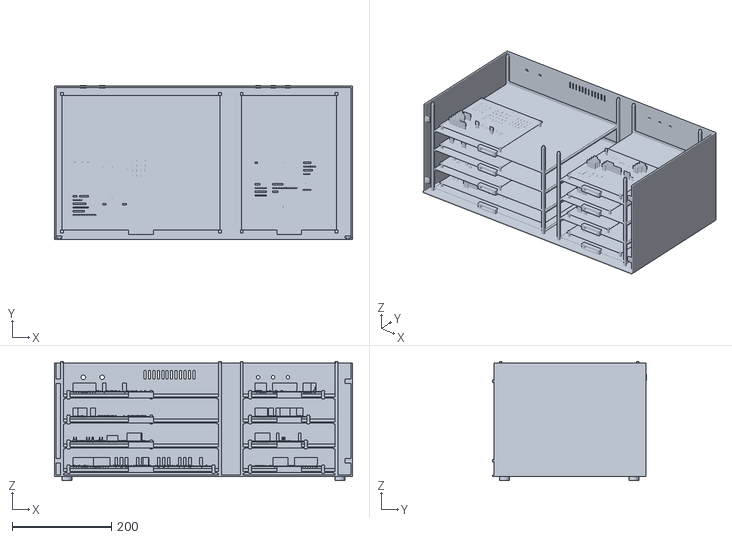
[picture p139: CAD file, 2026-10-16]
cad/stage5/ATO_reference_inspection.stl
600.0 x 311.0 x 240.0
