pratham-cloud-ctrl/Project-ATO/cad/stage5/future-interface/ATO_future_interface_exploded.step

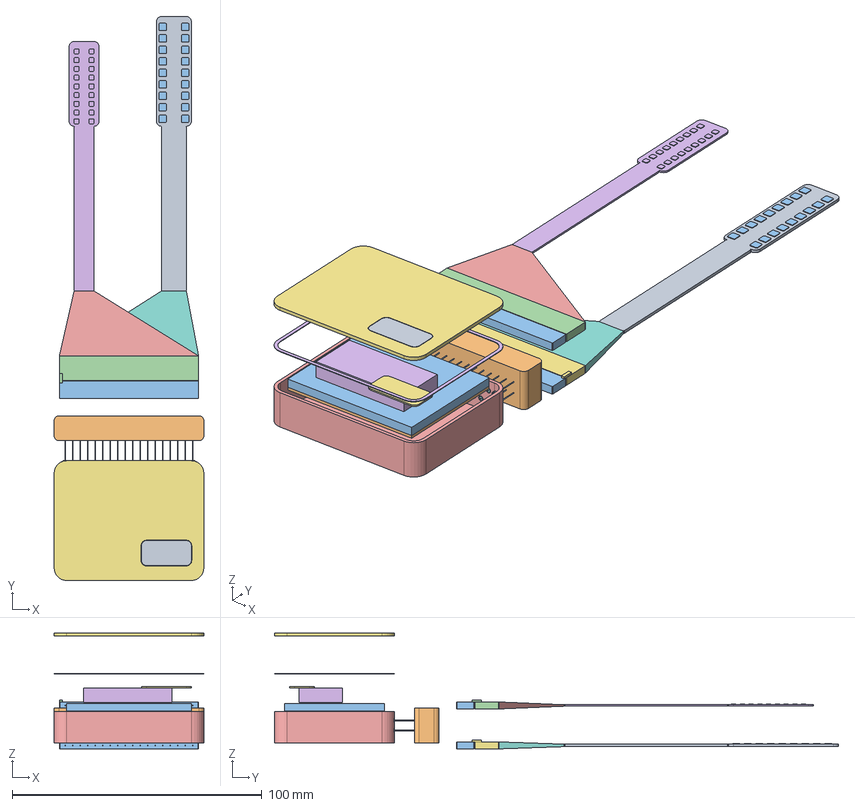
[picture p140: CAD file, 2026-10-16]
cad/stage5/future-interface/ATO_future_interface_exploded.step
60.0 x 226.0 x 46.4 mm
