pratham-cloud-ctrl/Project-ATO/cad/stage5/reference/stl/Standoff_monitoring_cell_H1.stl

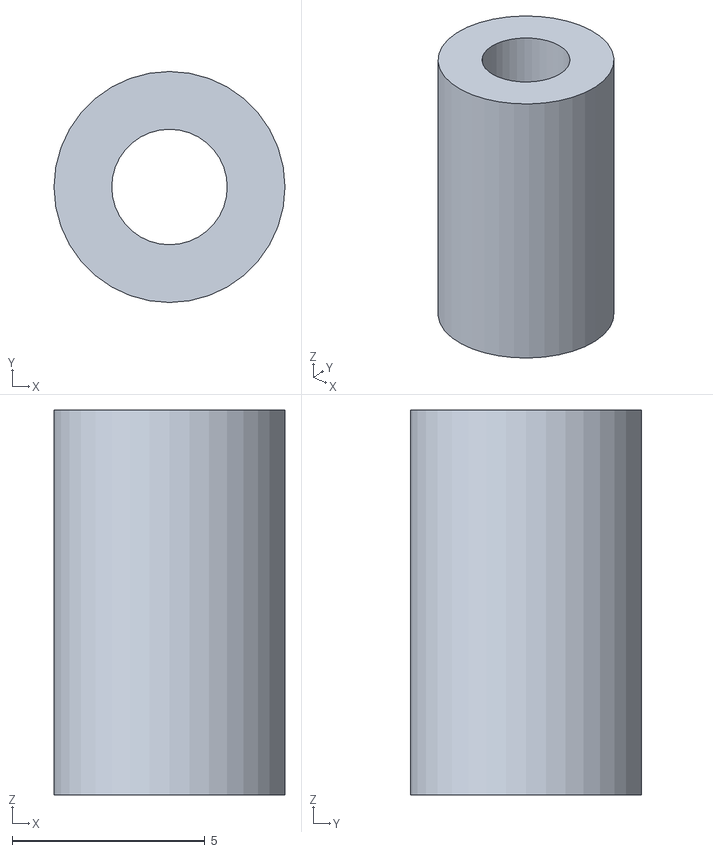
[picture p141: CAD file, 2026-10-16]
cad/stage5/reference/stl/Standoff_monitoring_cell_H1.stl
6.00 x 6.00 x 10.0
