pratham-cloud-ctrl/Project-ATO/electronics/models3d/SOT-23.step

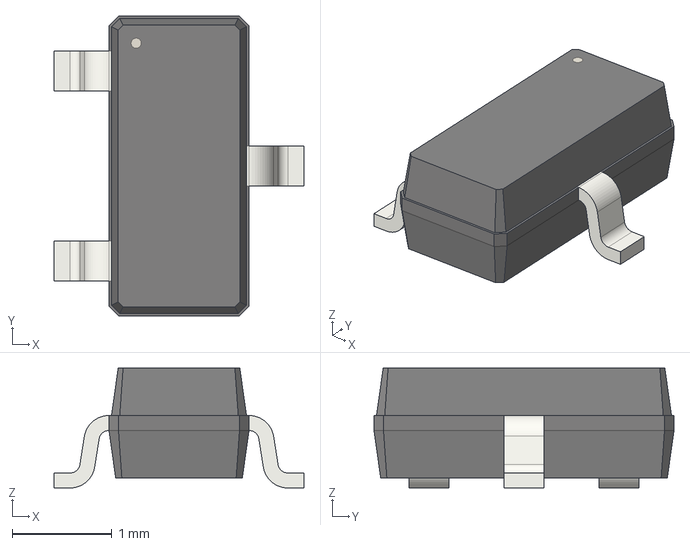
[picture p143: CAD file, 2026-10-07]
electronics/models3d/SOT-23.step
2.50 x 3.00 x 1.20 mm
