pratham-cloud-ctrl/Project-ATO/electronics/stage4/integrated-pcb/package-models/Texas_DGN0008D_VSSOP-8-1EP_3x3mm_P0.65mm_EP2x2.94mm_Mask1.57x1.89mm.step

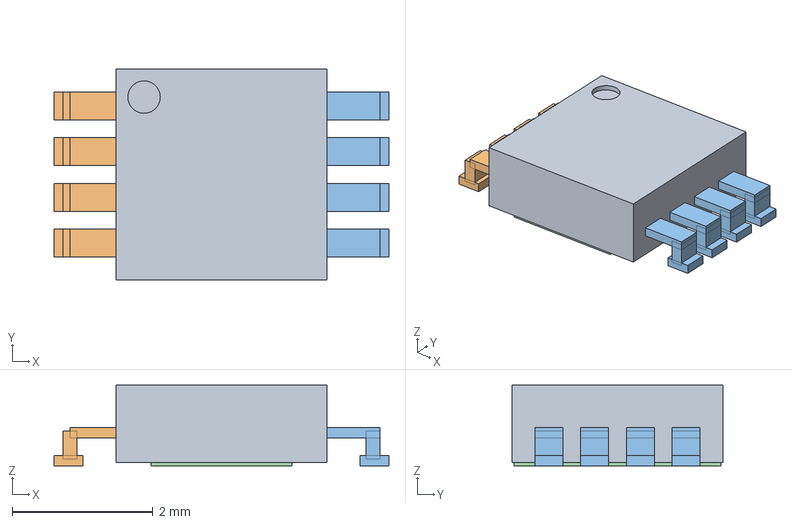
[picture p144: CAD file, 2026-10-16]
electronics/stage4/integrated-pcb/package-models/Texas_DGN0008D_VSSOP-8-1EP_3x3mm_P0.65mm_EP2x2.94mm_Mask1.57x1.89mm.step
4.76 x 3.00 x 1.15 mm
