pratham-cloud-ctrl/Project-ATO/inspector/downloads/ATO_monitoring-transport.step

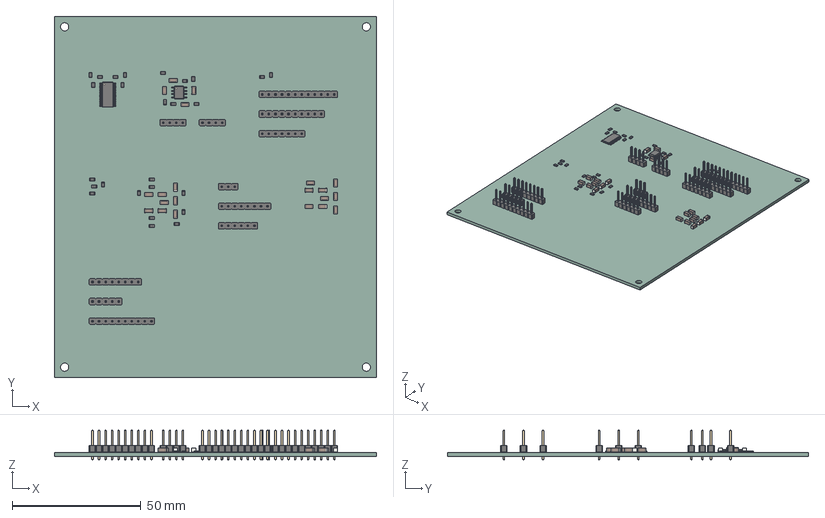
[picture p145: CAD file, 2026-10-16]
inspector/downloads/ATO_monitoring-transport.step
125.0 x 140.0 x 11.5 mm
C_1206_3216Metric x 21
SOIC-8_3.9x4.9mm_P1.27mm
R_0805_2012Metric x 26
PinHeader_1x04_P254mm_Vertical x 2
PinHeader_1x05_P254mm_Vertical
PinHeader_1x12_P254mm_Vertical
PinHeader_1x06_P254mm_Vertical
TSSOP-38_4.4x9.7mm_P0.5mm
PinHeader_1x10_P254mm_Vertical x 2
PinHeader_1x03_P254mm_Vertical
PinHeader_1x08_P254mm_Vertical x 2
PinHeader_1x07_P254mm_Vertical
monitoring_transport_PCB
