pratham-cloud-ctrl/Project-ATO/cad/stage2/populated_zone_reservation.step

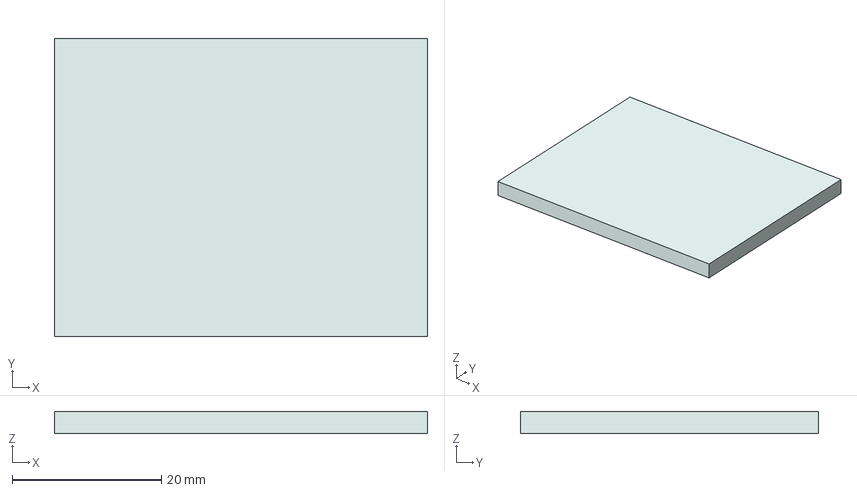
[picture p146: CAD file, 2026-10-16]
cad/stage2/populated_zone_reservation.step
50.0 x 40.0 x 3.00 mm
