pratham-cloud-ctrl/Project-ATO/cad/stage5/future-interface/ATO_future_interface.FCStd

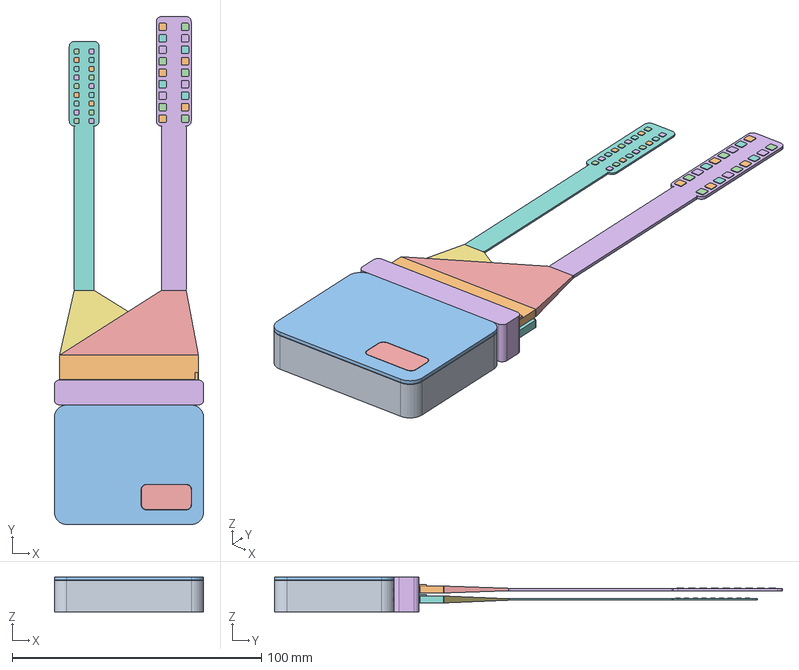
[picture p147: CAD file, 2026-10-16]
cad/stage5/future-interface/ATO_future_interface.FCStd
60.0 x 204.0 x 14.0 mm
Titanium can | 60 x 48 x 14 envelope
Conditional weld seam | no qualified process
Titanium lid | conditional RF window
RF window seal ring | nominal unqualified
Conditional RF glass window | 20 x 10 mm
Dielectric header | separately keyed R/S ports
P01 | Ti ferrule | REC_01
P01 | isolated ceramic sleeve
P01 | REC_01 feedthrough pin
P02 | Ti ferrule | REC_02
P02 | isolated ceramic sleeve
P02 | REC_02 feedthrough pin
P03 | Ti ferrule | REC_03
P03 | isolated ceramic sleeve
P03 | REC_03 feedthrough pin
P04 | Ti ferrule | REC_04
P04 | isolated ceramic sleeve
P04 | REC_04 feedthrough pin
P05 | Ti ferrule | REC_05
P05 | isolated ceramic sleeve
P05 | REC_05 feedthrough pin
P06 | Ti ferrule | REC_06
P06 | isolated ceramic sleeve
P06 | REC_06 feedthrough pin
P07 | Ti ferrule | REC_07
P07 | isolated ceramic sleeve
P07 | REC_07 feedthrough pin
P08 | Ti ferrule | REC_08
P08 | isolated ceramic sleeve
P08 | REC_08 feedthrough pin
P09 | Ti ferrule | REC_09
P09 | isolated ceramic sleeve
P09 | REC_09 feedthrough pin
P10 | Ti ferrule | REC_10
P10 | isolated ceramic sleeve
P10 | REC_10 feedthrough pin
P11 | Ti ferrule | REC_11
P11 | isolated ceramic sleeve
P11 | REC_11 feedthrough pin
P12 | Ti ferrule | REC_12
P12 | isolated ceramic sleeve
P12 | REC_12 feedthrough pin
P13 | Ti ferrule | REC_13
P13 | isolated ceramic sleeve
P13 | REC_13 feedthrough pin
P14 | Ti ferrule | REC_14
P14 | isolated ceramic sleeve
P14 | REC_14 feedthrough pin
P15 | Ti ferrule | REC_15
P15 | isolated ceramic sleeve
P15 | REC_15 feedthrough pin
P16 | Ti ferrule | REC_16
P16 | isolated ceramic sleeve
P16 | REC_16 feedthrough pin
P17 | Ti ferrule | REC_REFERENCE
P17 | isolated ceramic sleeve
P17 | REC_REFERENCE feedthrough pin
P18 | Ti ferrule | BODY_BIAS
P18 | isolated ceramic sleeve
P18 | BODY_BIAS feedthrough pin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
