pratham-cloud-ctrl/Project-ATO/electronics/models3d/SOIC-16_3.9x9.9mm_P1.27mm.step

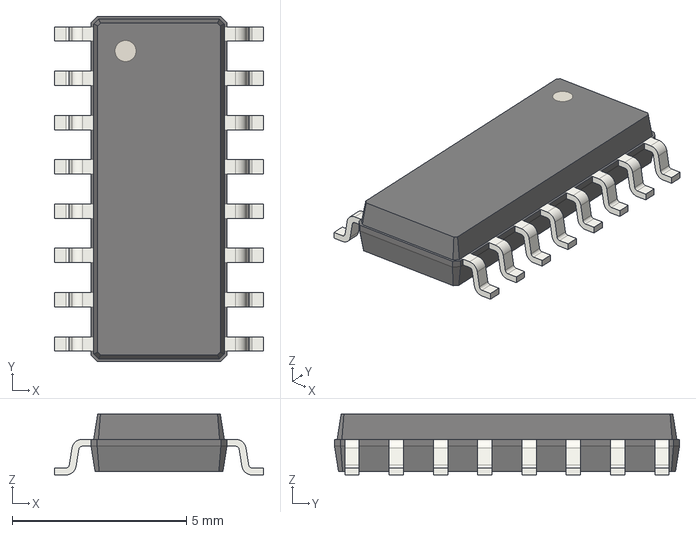
[picture p150: CAD file, 2026-10-07]
electronics/models3d/SOIC-16_3.9x9.9mm_P1.27mm.step
6.00 x 9.90 x 1.75 mm
