pratham-cloud-ctrl/Project-ATO/electronics/stage4/integrated-pcb/package-models/RHD2216_QFN56_8x8_P0.5_EP6.1.step

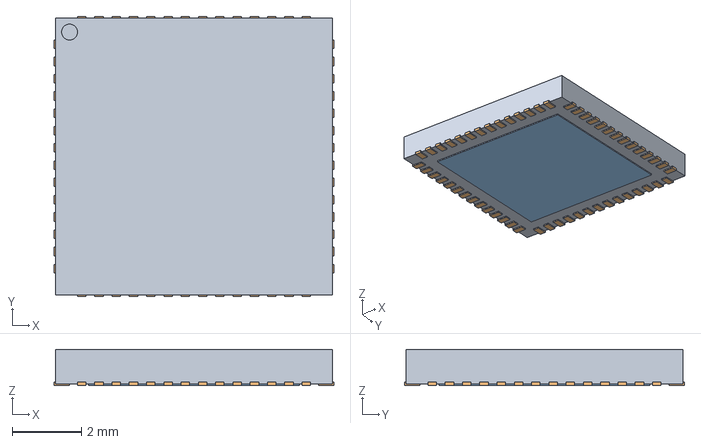
[picture p151: CAD file, 2026-10-16]
electronics/stage4/integrated-pcb/package-models/RHD2216_QFN56_8x8_P0.5_EP6.1.step
8.10 x 8.10 x 1.05 mm
