pratham-cloud-ctrl/Project-ATO/cad/exports/recording-cuff.step

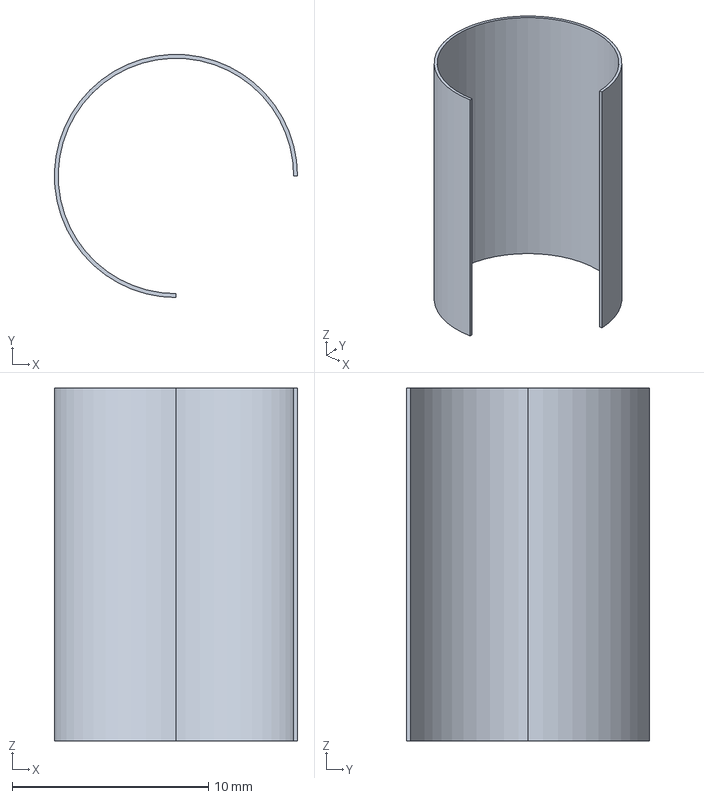
[picture p153: CAD file, 2026-10-07]
cad/exports/recording-cuff.step
12.4 x 12.4 x 18.0 mm
