pratham-cloud-ctrl/Project-ATO/electronics/stage4/integrated-pcb/package-models/TRACO_TMR3_SIP8_21.8x9.1_P2.54.step

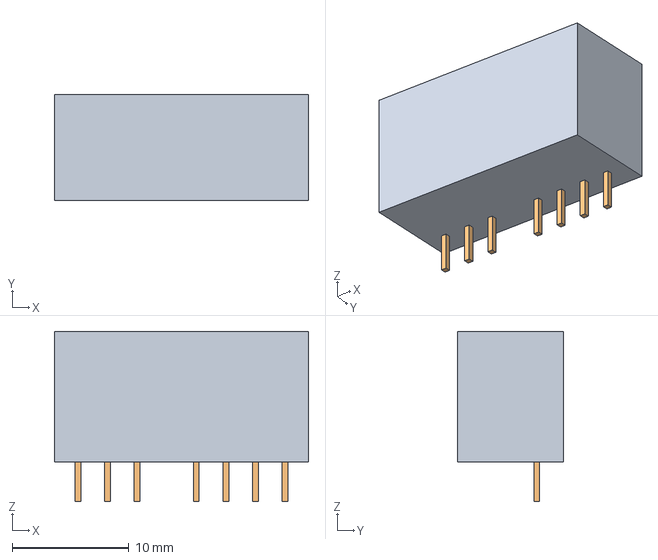
[picture p154: CAD file, 2026-10-16]
electronics/stage4/integrated-pcb/package-models/TRACO_TMR3_SIP8_21.8x9.1_P2.54.step
21.8 x 9.10 x 14.6 mm
