pratham-cloud-ctrl/Project-ATO/inspector/downloads/ATO_monitoring-cell.step

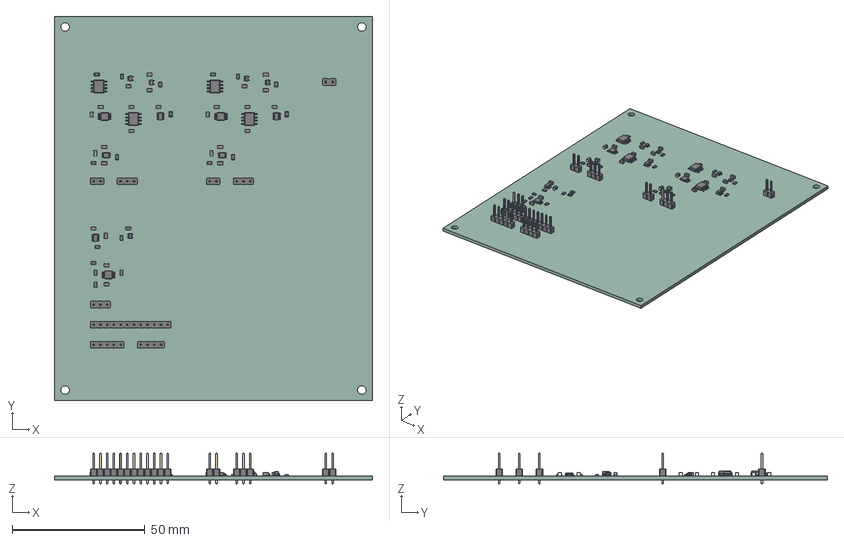
[picture p155: CAD file, 2026-10-16]
inspector/downloads/ATO_monitoring-cell.step
120.0 x 145.0 x 11.5 mm
C_0805_2012Metric x 26
PinHeader_1x02_P254mm_Vertical x 3
SOT-23-6 x 3
PinHeader_1x03_P254mm_Vertical x 3
R_0805_2012Metric x 19
MSOP-10_3x3mm_P0.5mm x 3
PinHeader_1x12_P254mm_Vertical
SOT-353_SC-70-5 x 5
VSSOP-8_2.3x2mm_P0.5mm x 2
PinHeader_1x05_P254mm_Vertical
SOIC-8_3.9x4.9mm_P1.27mm x 4
PinHeader_1x04_P254mm_Vertical
monitoring_cell_PCB
