pratham-cloud-ctrl/Project-ATO/cad/exports/lead-paddle.step

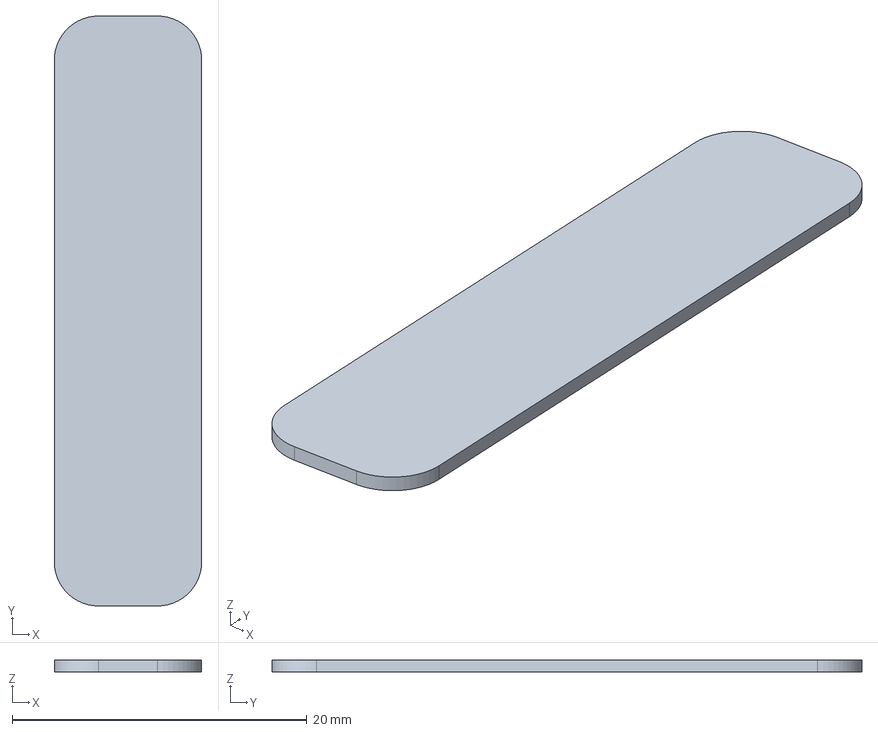
[picture p156: CAD file, 2026-10-07]
cad/exports/lead-paddle.step
10.0 x 40.0 x 0.8 mm
