pratham-cloud-ctrl/Project-ATO/electronics/stage4/integrated-pcb/package-models/Texas_DRB0008A_VSON8_3x3_P0.65_EP1.5x1.75.step

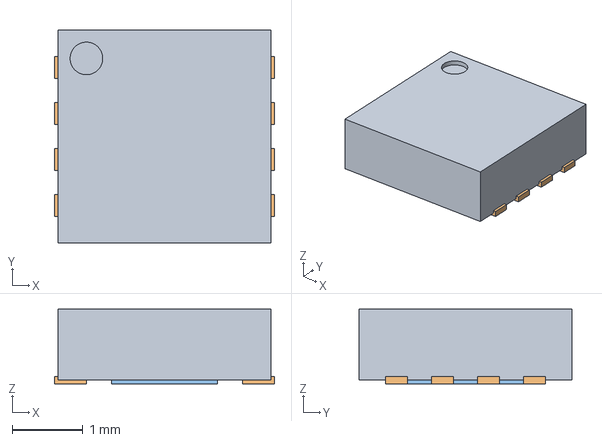
[picture p157: CAD file, 2026-10-16]
electronics/stage4/integrated-pcb/package-models/Texas_DRB0008A_VSON8_3x3_P0.65_EP1.5x1.75.step
3.10 x 3.00 x 1.05 mm
