pratham-cloud-ctrl/Project-ATO/inspector/downloads/ATO_recording-front-end.step

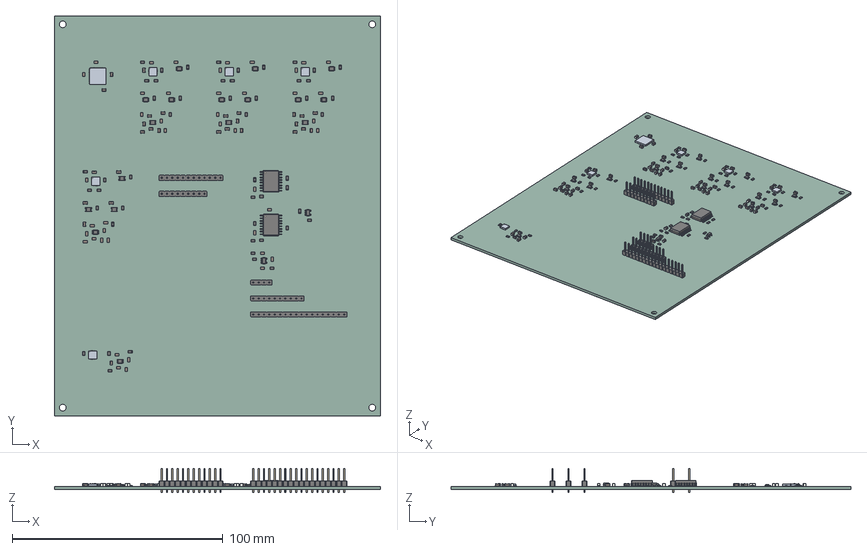
[picture p158: CAD file, 2026-10-16]
inspector/downloads/ATO_recording-front-end.step
155.0 x 190.0 x 11.5 mm
C_0805_2012Metric x 71
VSSOP-8_2.3x2mm_P0.5mm x 17
R_0805_2012Metric x 50
PinHeader_1x04_P254mm_Vertical
PinHeader_1x12_P254mm_Vertical
PinHeader_1x10_P254mm_Vertical
SOT-23-5 x 2
PinHeader_1x09_P254mm_Vertical
PinHeader_1x18_P254mm_Vertical
SOIC-16W_7.5x10.3mm_P1.27mm x 2
recording_front_end_PCB
