pratham-cloud-ctrl/Project-ATO/cad/exports/base.step

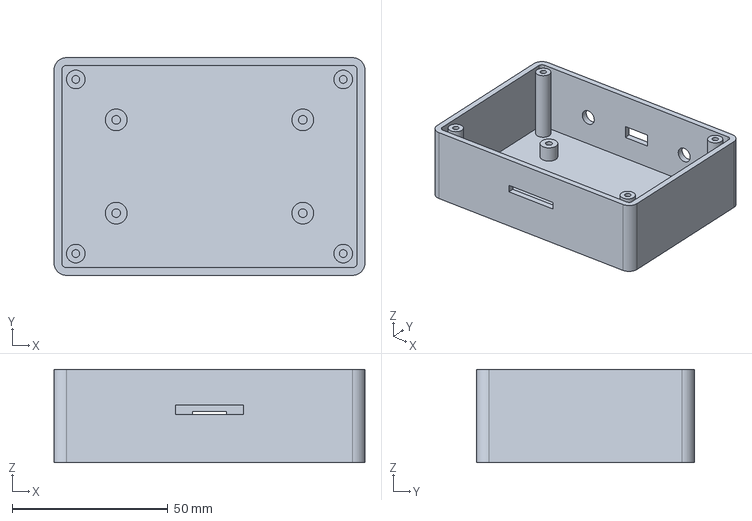
[picture p159: CAD file, 2026-10-07]
cad/exports/base.step
100.0 x 70.0 x 30.0 mm
