pratham-cloud-ctrl/Project-ATO/cad/stage5/reference/stl/Pull_controller_carrier.stl

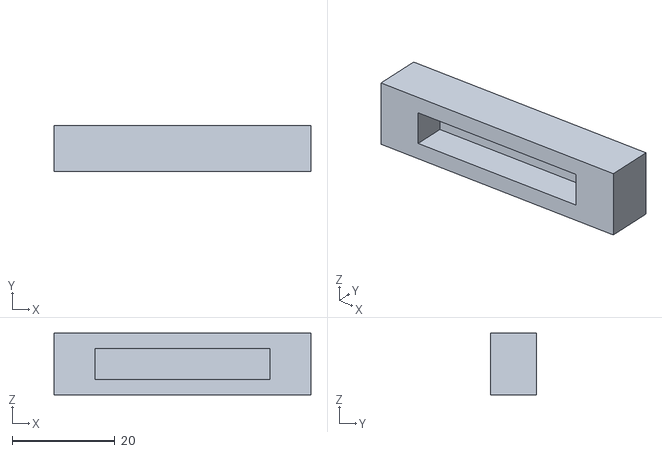
[picture p160: CAD file, 2026-10-16]
cad/stage5/reference/stl/Pull_controller_carrier.stl
50.0 x 9.00 x 12.0
