pratham-cloud-ctrl/Project-ATO/electronics/stage4/integrated-pcb/package-models/Texas_RRP0016A_WQFN16_4x4_P0.65_EP2.6.step

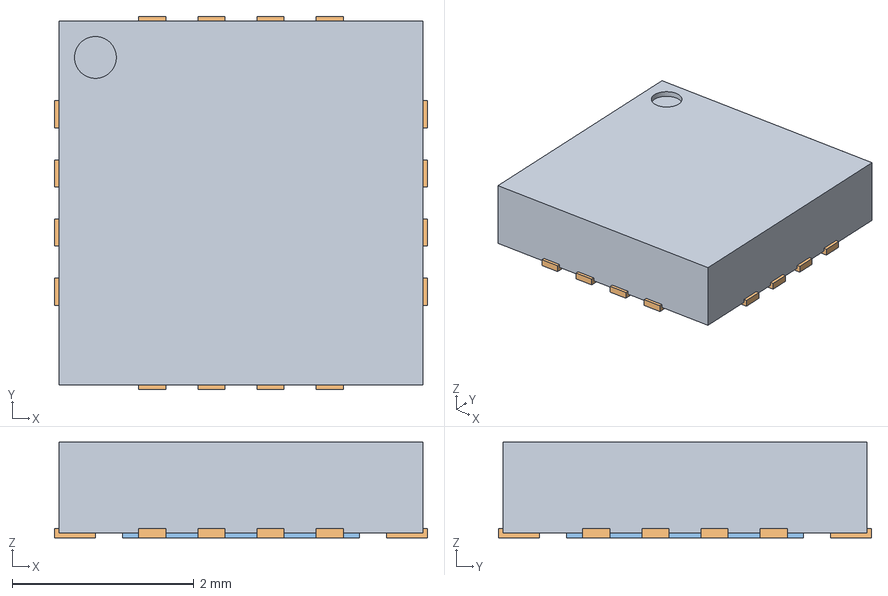
[picture p161: CAD file, 2026-10-16]
electronics/stage4/integrated-pcb/package-models/Texas_RRP0016A_WQFN16_4x4_P0.65_EP2.6.step
4.10 x 4.10 x 1.05 mm
