pratham-cloud-ctrl/Project-ATO/inspector/downloads/ATO_current-driver.step

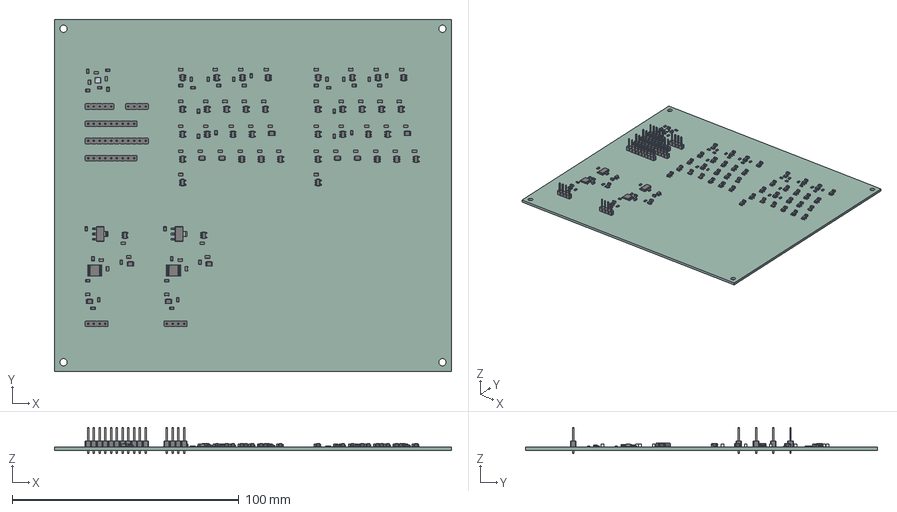
[picture p162: CAD file, 2026-10-16]
inspector/downloads/ATO_current-driver.step
175.0 x 155.0 x 11.5 mm
VSSOP-8_2.3x2mm_P0.5mm x 10
SOT-23-5 x 24
C_0805_2012Metric x 55
R_0805_2012Metric x 39
SOT-23-6 x 12
PinHeader_1x11_P254mm_Vertical
TSSOP-16_4.4x5mm_P0.65mm x 2
PinHeader_1x05_P254mm_Vertical
SOT-223 x 2
PinHeader_1x04_P254mm_Vertical x 3
PinHeader_1x09_P254mm_Vertical x 2
TSOT-23-6 x 2
current_driver_PCB
