pratham-cloud-ctrl/Project-ATO/cad/exports/recording-contacts.step

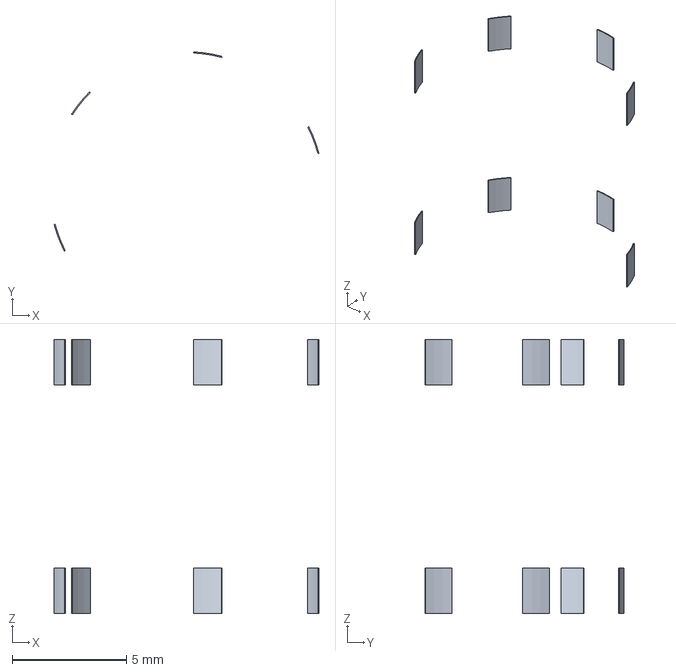
[picture p163: CAD file, 2026-10-07]
cad/exports/recording-contacts.step
11.6 x 8.72 x 12.0 mm
