pratham-cloud-ctrl/Project-ATO/cad/stage5/reference/stl/Rail_left_2_right.stl

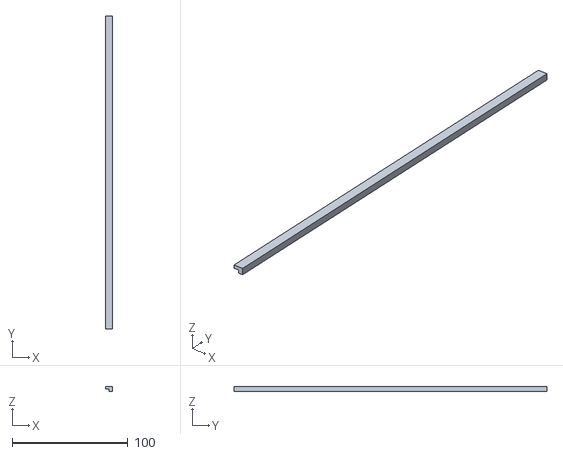
[picture p164: CAD file, 2026-10-16]
cad/stage5/reference/stl/Rail_left_2_right.stl
6.00 x 270.0 x 4.00
