pratham-cloud-ctrl/Project-ATO/electronics/stage4/integrated-pcb/package-models/VQFN-16-1EP_3x3mm_P0.5mm_EP1.68x1.68mm.step

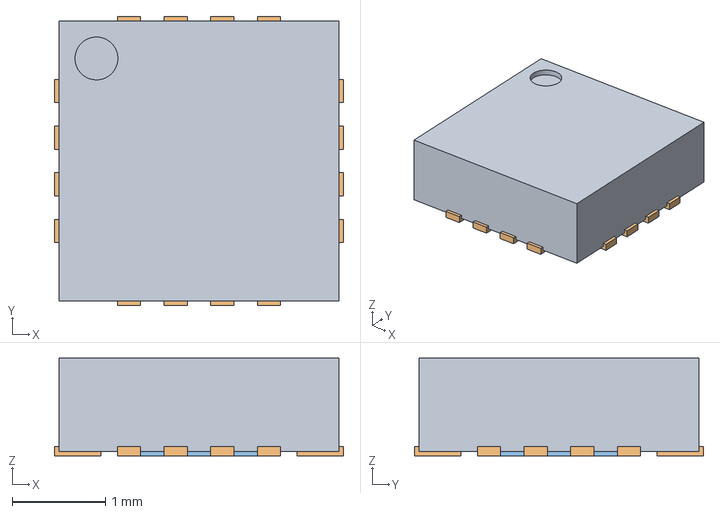
[picture p165: CAD file, 2026-10-16]
electronics/stage4/integrated-pcb/package-models/VQFN-16-1EP_3x3mm_P0.5mm_EP1.68x1.68mm.step
3.10 x 3.10 x 1.05 mm
