pratham-cloud-ctrl/Project-ATO/inspector/downloads/ATO_contact-router.step

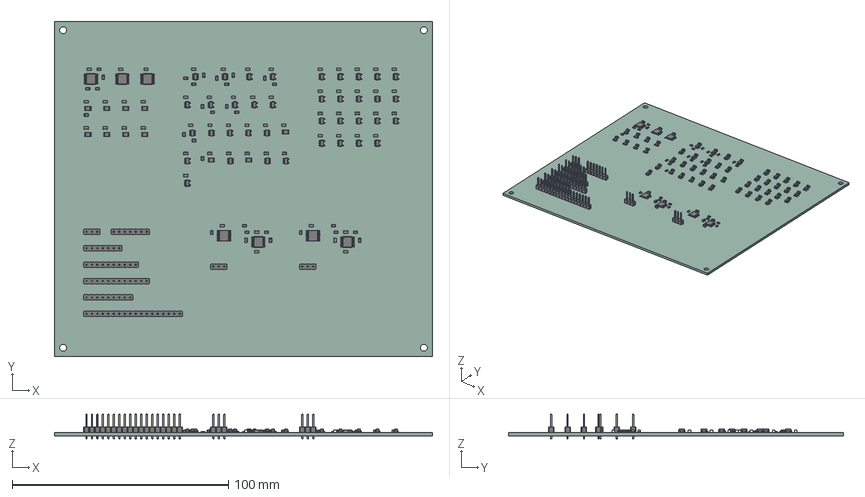
[picture p166: CAD file, 2026-10-16]
inspector/downloads/ATO_contact-router.step
175.0 x 155.0 x 11.5 mm
SOT-23-5 x 30
C_0805_2012Metric x 60
R_0805_2012Metric x 30
VSSOP-8_2.3x2mm_P0.5mm x 11
PinHeader_1x07_P254mm_Vertical x 2
TSSOP-16_4.4x5mm_P0.65mm x 7
PinHeader_1x18_P254mm_Vertical
PinHeader_1x09_P254mm_Vertical
SOT-23-6 x 8
PinHeader_1x12_P254mm_Vertical
PinHeader_1x03_P254mm_Vertical x 3
PinHeader_1x10_P254mm_Vertical
contact_router_PCB
