pratham-cloud-ctrl/Project-ATO/cad/exports/pcb-envelope.step

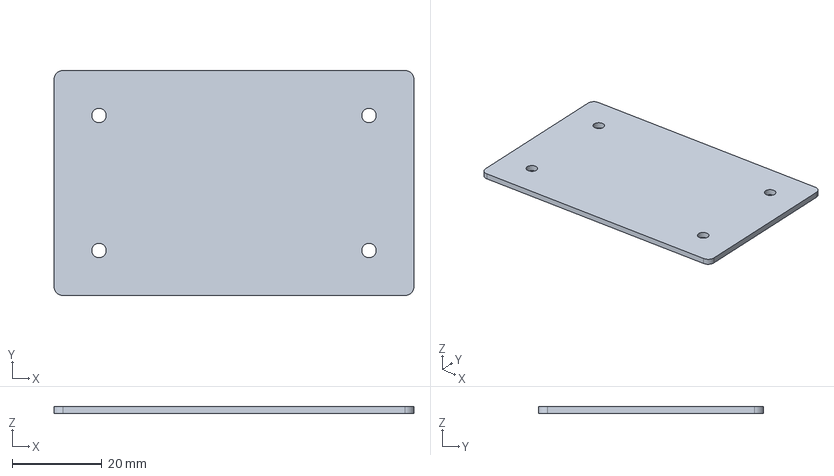
[picture p167: CAD file, 2026-10-07]
cad/exports/pcb-envelope.step
80.0 x 50.0 x 1.60 mm
