pratham-cloud-ctrl/Project-ATO/electronics/stage4/integrated-pcb/package-models/BT40F_Manufacturer_66Pad.step

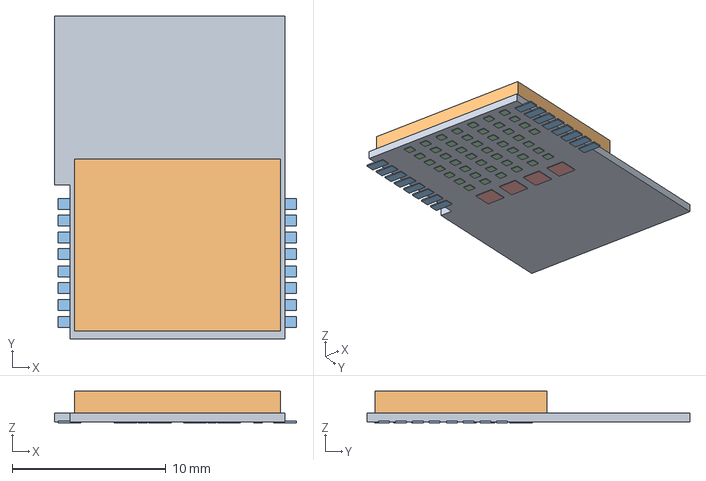
[picture p168: CAD file, 2026-10-16]
electronics/stage4/integrated-pcb/package-models/BT40F_Manufacturer_66Pad.step
15.7 x 21.0 x 2.05 mm
