pratham-cloud-ctrl/Project-ATO/inspector/downloads/ATO_power.step

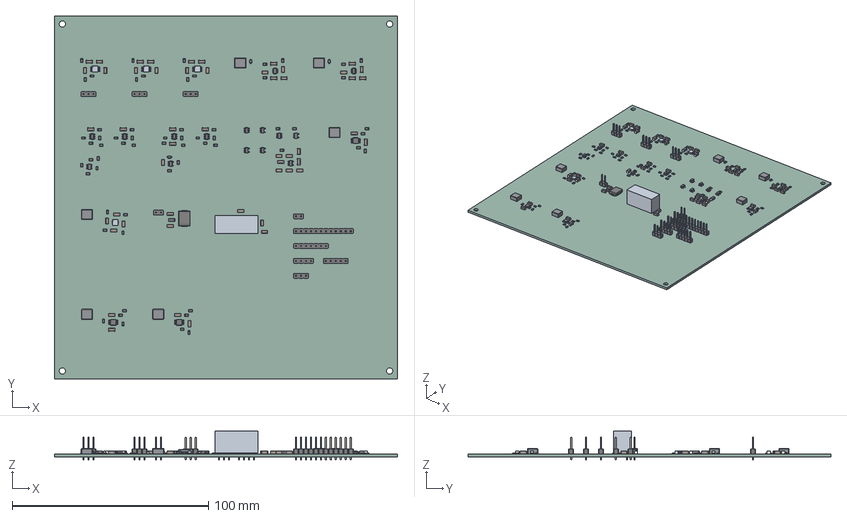
[picture p169: CAD file, 2026-10-16]
inspector/downloads/ATO_power.step
175.0 x 185.0 x 14.6 mm
R_0805_2012Metric x 61
C_1206_3216Metric x 51
L_Bourns_SRP5030T x 6
PinHeader_1x03_P254mm_Vertical x 4
VSSOP-8_3x3mm_P0.65mm x 3
PinHeader_1x12_P254mm_Vertical
D_SOD-323
Fuse_1206_3216Metric
SOT-23-6 x 7
SOT-23-5 x 6
D_SMC
PinHeader_1x05_P254mm_Vertical
PinHeader_1x04_P254mm_Vertical
PinHeader_1x07_P254mm_Vertical
PinHeader_1x02_P254mm_Vertical x 2
TSOT-23-6 x 2
D_SOD_323F x 2
power_PCB
