pratham-cloud-ctrl/Project-ATO/cad/exports/lid.step

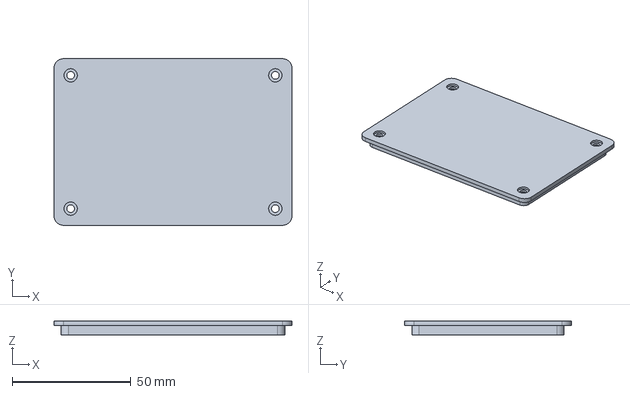
[picture p170: CAD file, 2026-10-07]
cad/exports/lid.step
100.0 x 70.0 x 6.00 mm
