pratham-cloud-ctrl/Project-ATO/electronics/stage4/integrated-pcb/package-models/Texas_DRX_WSON-10_2.5x2.5mm_P0.5mm.step

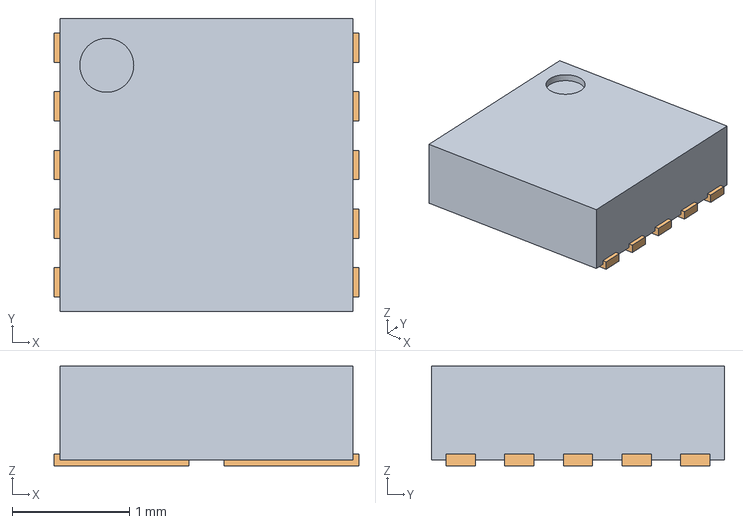
[picture p171: CAD file, 2026-10-16]
electronics/stage4/integrated-pcb/package-models/Texas_DRX_WSON-10_2.5x2.5mm_P0.5mm.step
2.60 x 2.50 x 0.85 mm
