pratham-cloud-ctrl/Project-ATO/cad/stage5/reference/stl/Base.stl

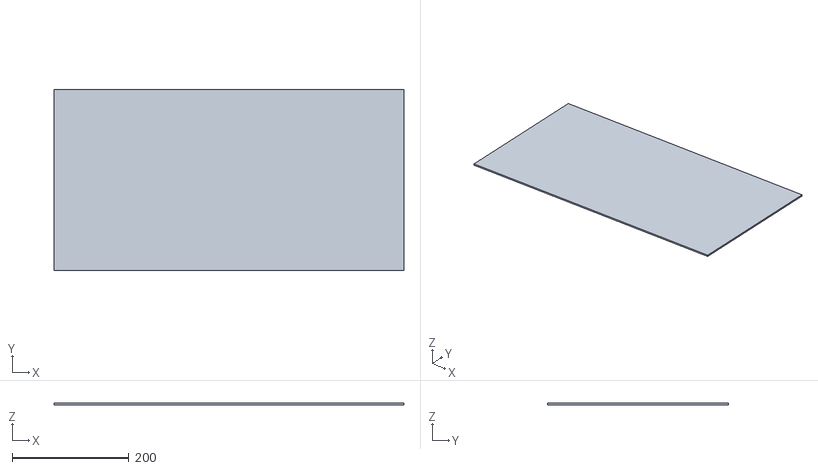
[picture p173: CAD file, 2026-10-16]
cad/stage5/reference/stl/Base.stl
600.0 x 310.0 x 3.00
