pratham-cloud-ctrl/Project-ATO/cad/stage5/reference/stl/Post_3_0.stl

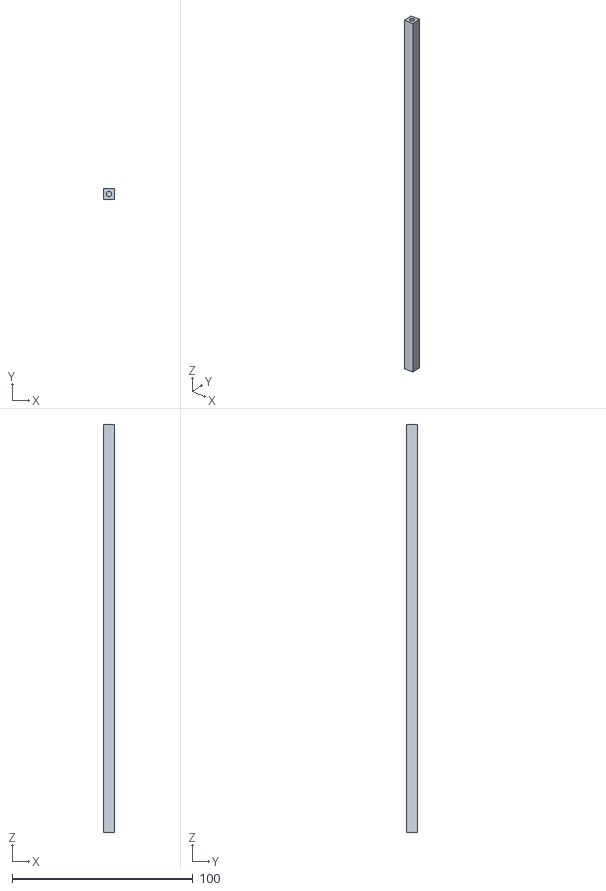
[picture p174: CAD file, 2026-10-16]
cad/stage5/reference/stl/Post_3_0.stl
6.00 x 6.00 x 226.0
