pratham-cloud-ctrl/Project-ATO/cad/stage5/reference/stl/Foot_2.stl

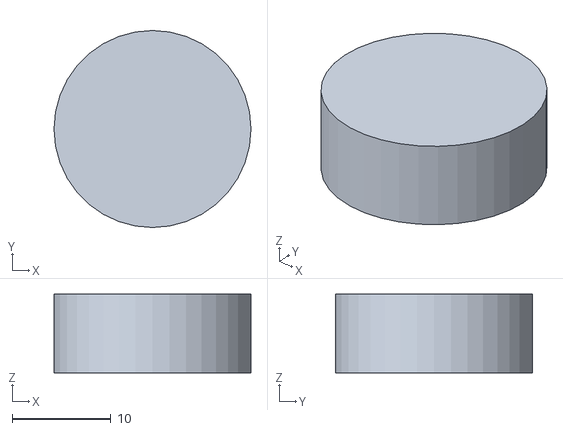
[picture p175: CAD file, 2026-10-16]
cad/stage5/reference/stl/Foot_2.stl
20.0 x 20.0 x 8.00
