pratham-cloud-ctrl/Project-ATO/cad/stage5/reference/stl/Tray_recording_front_end.stl

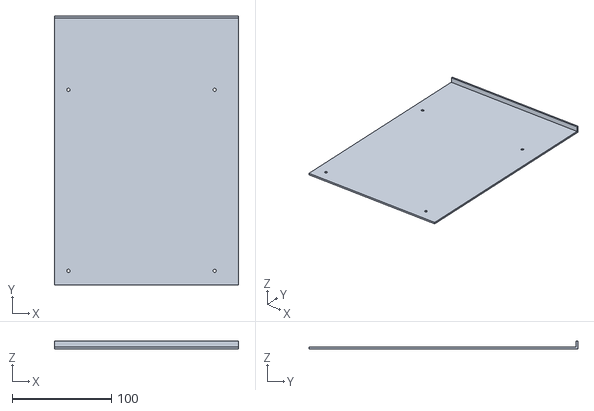
[picture p176: CAD file, 2026-10-16]
cad/stage5/reference/stl/Tray_recording_front_end.stl
185.0 x 270.0 x 8.00
