pratham-cloud-ctrl/Project-ATO/cad/stage5/reference/stl/Tray_power.stl

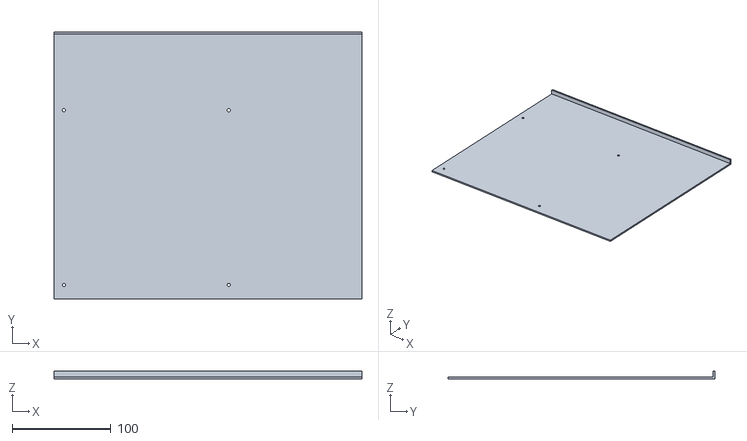
[picture p177: CAD file, 2026-10-16]
cad/stage5/reference/stl/Tray_power.stl
312.0 x 270.0 x 8.00
