pratham-cloud-ctrl/Project-ATO/cad/stage5/reference/stl/SideRight.stl

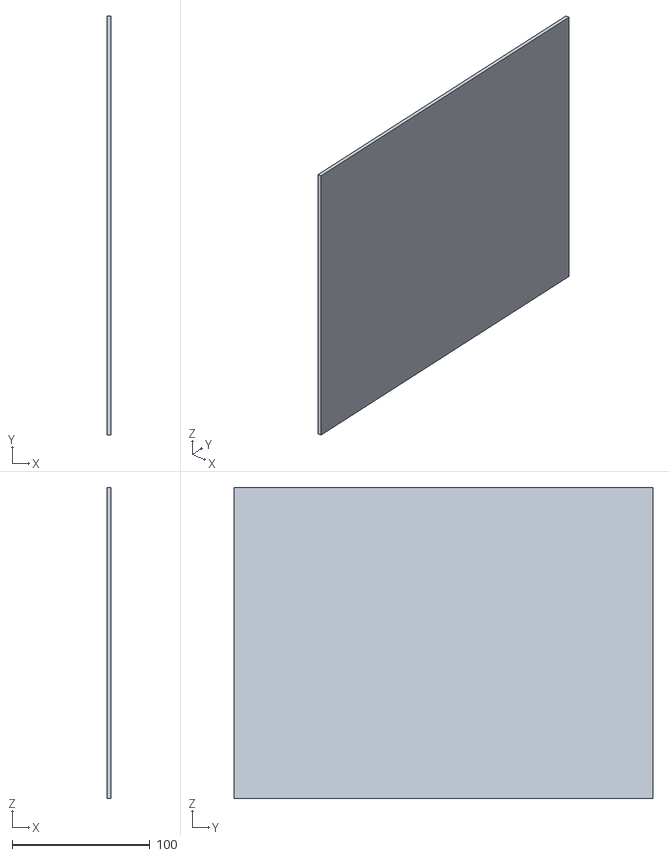
[picture p178: CAD file, 2026-10-16]
cad/stage5/reference/stl/SideRight.stl
3.00 x 304.0 x 226.0
