pratham-cloud-ctrl/Project-ATO/cad/stage5/reference/stl/FrontBracket_1_0.stl

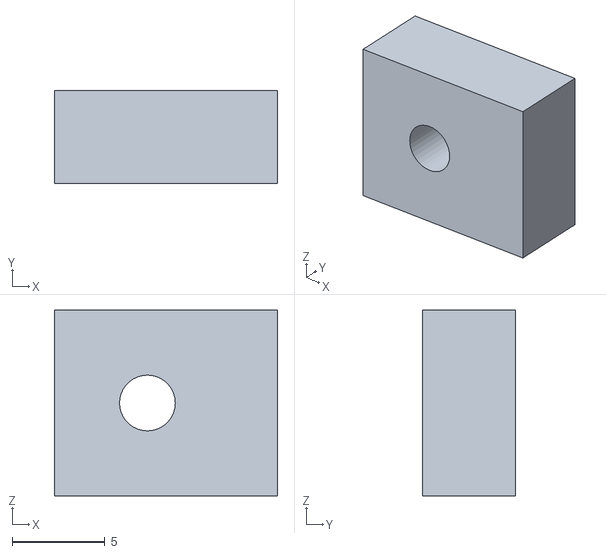
[picture p179: CAD file, 2026-10-16]
cad/stage5/reference/stl/FrontBracket_1_0.stl
12.0 x 5.00 x 10.0
