pratham-cloud-ctrl/Project-ATO/cad/stage5/reference/stl/RearPanel.stl

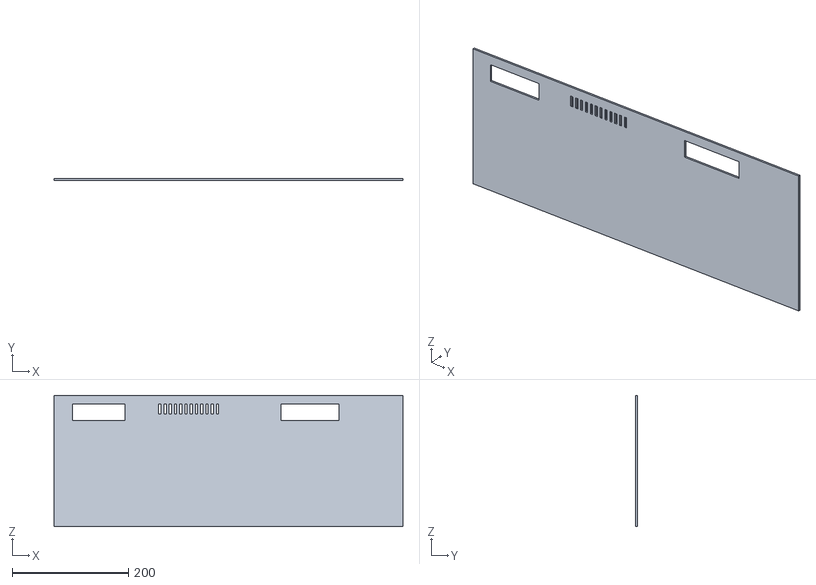
[picture p180: CAD file, 2026-10-16]
cad/stage5/reference/stl/RearPanel.stl
600.0 x 3.00 x 226.0
