pratham-cloud-ctrl/Project-ATO/(list of files, cad)

Other CAD files:
cad/ato-reference.FCStd
cad/stage5/harness/ATO_harness_routes.FCStd
cad/stage5/reference/ATO_reference_mechanical.step
cad/stage5/reference/stl/Standoff_power_H3.stl
cad/stage5/reference/stl/Rail_right_3_left.stl
inspector/downloads/ATO_Future_Interface.step
cad/stage5/reference/stl/Standoff_monitoring_transport_H3.stl
cad/stage5/reference/stl/Standoff_controller_carrier_H3.stl
cad/stage5/reference/stl/Standoff_recording_front_end_H2.stl
cad/stage5/reference/stl/Standoff_power_H2.stl
cad/stage5/reference/stl/Rail_right_0_right.stl
cad/stage5/reference/stl/Standoff_contact_router_H4.stl
cad/stage5/reference/stl/Rail_left_0_left.stl
cad/stage5/reference/stl/Standoff_controller_carrier_H1.stl
cad/stage5/reference/stl/Standoff_controller_carrier_H2.stl
cad/stage5/reference/stl/Post_2_0.stl
cad/stage5/reference/stl/Post_1_0.stl
cad/stage5/reference/stl/Tray_monitoring_cell.stl
cad/stage5/reference/stl/Pull_supervision.stl
cad/stage5/reference/stl/Rail_left_3_left.stl
cad/stage5/reference/stl/Rail_left_2_left.stl
cad/stage5/reference/stl/Rail_right_2_right.stl
cad/stage5/reference/stl/Standoff_contact_router_H2.stl
cad/stage5/reference/stl/Pull_contact_router.stl
cad/stage5/reference/stl/Rail_right_3_right.stl
cad/stage5/reference/stl/Standoff_power_H4.stl
cad/stage5/reference/stl/Standoff_supervision_H3.stl
cad/stage5/reference/stl/Standoff_monitoring_transport_H4.stl
cad/stage5/reference/stl/Post_0_1.stl
cad/stage5/reference/stl/Standoff_current_driver_H1.stl
cad/stage5/reference/stl/SideLeft.stl
cad/stage5/reference/stl/Standoff_monitoring_cell_H3.stl
cad/stage5/reference/stl/Pull_monitoring_cell.stl
cad/stage5/reference/stl/Pull_current_driver.stl
cad/stage5/reference/stl/Standoff_monitoring_transport_H2.stl
cad/stage5/reference/stl/Tray_current_driver.stl
cad/stage5/reference/stl/Foot_3.stl
cad/stage5/reference/stl/Post_2_1.stl
cad/stage5/reference/stl/Standoff_monitoring_cell_H2.stl
cad/stage5/reference/stl/Standoff_recording_front_end_H4.stl
cad/stage5/reference/stl/Standoff_monitoring_transport_H1.stl
cad/stage5/reference/stl/Standoff_current_driver_H4.stl
cad/stage5/reference/stl/Pull_recording_front_end.stl
cad/stage5/reference/stl/FrontBracket_0_1.stl
cad/stage5/reference/stl/Rail_left_1_left.stl
cad/stage5/reference/stl/Standoff_contact_router_H1.stl
cad/stage5/reference/stl/Tray_supervision.stl
cad/stage5/reference/stl/Post_0_0.stl
cad/stage5/reference/stl/Standoff_supervision_H2.stl
cad/stage5/reference/stl/Post_1_1.stl
cad/stage5/reference/stl/Rail_right_0_left.stl
cad/stage5/reference/stl/Rail_right_1_left.stl
cad/stage5/reference/stl/Standoff_contact_router_H3.stl
cad/stage5/reference/stl/FrontBracket_1_1.stl
cad/stage5/reference/stl/Standoff_supervision_H1.stl
cad/stage5/reference/stl/Rail_right_2_left.stl
cad/stage5/reference/stl/Pull_monitoring_transport.stl
cad/stage5/reference/stl/Rail_left_1_right.stl
cad/stage5/reference/stl/Standoff_current_driver_H2.stl
cad/stage5/reference/stl/FrontBracket_0_0.stl
cad/stage5/reference/stl/Standoff_controller_carrier_H4.stl
cad/stage5/reference/stl/Standoff_recording_front_end_H1.stl
cad/stage5/reference/stl/Standoff_power_H1.stl
cad/stage5/reference/stl/Tray_monitoring_transport.stl
cad/stage5/reference/stl/Standoff_current_driver_H3.stl
cad/stage5/reference/stl/Foot_0.stl
cad/stage5/reference/stl/Pull_power.stl
cad/stage5/reference/stl/Rail_right_1_right.stl
cad/stage5/reference/stl/Rail_left_0_right.stl
cad/stage5/reference/stl/Lid.stl
cad/stage5/reference/stl/Standoff_recording_front_end_H3.stl
cad/stage5/reference/stl/Post_3_1.stl
cad/stage5/reference/stl/Standoff_supervision_H4.stl
cad/stage5/reference/stl/Standoff_monitoring_cell_H4.stl
cad/stage5/reference/stl/Tray_contact_router.stl
cad/stage5/reference/stl/Rail_left_3_right.stl
cad/stage5/reference/stl/Tray_controller_carrier.stl
cad/stage5/reference/stl/Foot_1.stl
cad/ato-exploded.blend
cad/ato-presentation.blend
cad/exports/ato-desktop-assembly.stl
cad/exports/base.stl
cad/exports/lead-contacts.stl
cad/exports/lead-paddle.stl
cad/exports/lid.stl
cad/exports/pcb-envelope.stl
cad/exports/recording-contacts.stl
cad/exports/recording-cuff.stl
cad/stage2/ATO_stage2_allocation.FCStd
cad/stage5/future-interface/ATO_future_interface.stl
cad/stage5/future-interface/ATO_future_interface_exploded.FCStd
cad/stage5/harness/ATO_mating_interfaces.FCStd
cad/stage5/reference/stl/FrontScrew_0_0.stl
cad/stage5/reference/stl/FrontScrew_0_1.stl
cad/stage5/reference/stl/FrontScrew_1_0.stl
cad/stage5/reference/stl/FrontScrew_1_1.stl
cad/stage5/reference/stl/LidScrew_0_0.stl
cad/stage5/reference/stl/LidScrew_0_1.stl
cad/stage5/reference/stl/LidScrew_1_0.stl
cad/stage5/reference/stl/LidScrew_1_1.stl
cad/stage5/reference/stl/LidScrew_2_0.stl
cad/stage5/reference/stl/LidScrew_2_1.stl
cad/stage5/reference/stl/LidScrew_3_0.stl
cad/stage5/reference/stl/LidScrew_3_1.stl
cad/stage5/reference/stl/LowerScrew_contact_router_H1.stl
cad/stage5/reference/stl/LowerScrew_contact_router_H2.stl
cad/stage5/reference/stl/LowerScrew_contact_router_H3.stl
cad/stage5/reference/stl/LowerScrew_contact_router_H4.stl
cad/stage5/reference/stl/LowerScrew_controller_carrier_H1.stl
cad/stage5/reference/stl/LowerScrew_controller_carrier_H2.stl
cad/stage5/reference/stl/LowerScrew_controller_carrier_H3.stl
cad/stage5/reference/stl/LowerScrew_controller_carrier_H4.stl
cad/stage5/reference/stl/LowerScrew_current_driver_H1.stl
cad/stage5/reference/stl/LowerScrew_current_driver_H2.stl
cad/stage5/reference/stl/LowerScrew_current_driver_H3.stl
cad/stage5/reference/stl/LowerScrew_current_driver_H4.stl
cad/stage5/reference/stl/LowerScrew_monitoring_cell_H1.stl
cad/stage5/reference/stl/LowerScrew_monitoring_cell_H2.stl
cad/stage5/reference/stl/LowerScrew_monitoring_cell_H3.stl
cad/stage5/reference/stl/LowerScrew_monitoring_cell_H4.stl
cad/stage5/reference/stl/LowerScrew_monitoring_transport_H1.stl
cad/stage5/reference/stl/LowerScrew_monitoring_transport_H2.stl
cad/stage5/reference/stl/LowerScrew_monitoring_transport_H3.stl
cad/stage5/reference/stl/LowerScrew_monitoring_transport_H4.stl
cad/stage5/reference/stl/LowerScrew_power_H1.stl
cad/stage5/reference/stl/LowerScrew_power_H2.stl
cad/stage5/reference/stl/LowerScrew_power_H3.stl
cad/stage5/reference/stl/LowerScrew_power_H4.stl
cad/stage5/reference/stl/LowerScrew_recording_front_end_H1.stl
cad/stage5/reference/stl/LowerScrew_recording_front_end_H2.stl
cad/stage5/reference/stl/LowerScrew_recording_front_end_H3.stl
cad/stage5/reference/stl/LowerScrew_recording_front_end_H4.stl
cad/stage5/reference/stl/LowerScrew_supervision_H1.stl
cad/stage5/reference/stl/LowerScrew_supervision_H2.stl
cad/stage5/reference/stl/LowerScrew_supervision_H3.stl
cad/stage5/reference/stl/LowerScrew_supervision_H4.stl
cad/stage5/reference/stl/UpperScrew_contact_router_H1.stl
cad/stage5/reference/stl/UpperScrew_contact_router_H2.stl
cad/stage5/reference/stl/UpperScrew_contact_router_H3.stl
cad/stage5/reference/stl/UpperScrew_contact_router_H4.stl
cad/stage5/reference/stl/UpperScrew_controller_carrier_H1.stl
cad/stage5/reference/stl/UpperScrew_controller_carrier_H2.stl
cad/stage5/reference/stl/UpperScrew_controller_carrier_H3.stl
cad/stage5/reference/stl/UpperScrew_controller_carrier_H4.stl
cad/stage5/reference/stl/UpperScrew_current_driver_H1.stl
cad/stage5/reference/stl/UpperScrew_current_driver_H2.stl
cad/stage5/reference/stl/UpperScrew_current_driver_H3.stl
cad/stage5/reference/stl/UpperScrew_current_driver_H4.stl
cad/stage5/reference/stl/UpperScrew_monitoring_cell_H1.stl
cad/stage5/reference/stl/UpperScrew_monitoring_cell_H2.stl
cad/stage5/reference/stl/UpperScrew_monitoring_cell_H3.stl
cad/stage5/reference/stl/UpperScrew_monitoring_cell_H4.stl
cad/stage5/reference/stl/UpperScrew_monitoring_transport_H1.stl
cad/stage5/reference/stl/UpperScrew_monitoring_transport_H2.stl
cad/stage5/reference/stl/UpperScrew_monitoring_transport_H3.stl
cad/stage5/reference/stl/UpperScrew_monitoring_transport_H4.stl
cad/stage5/reference/stl/UpperScrew_power_H1.stl
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
