pratham-cloud-ctrl/Project-ATO/electronics/stage4/integrated-pcb/exports/contact-router/fabrication-reference/README.md

# Digital fabrication reference

Generated from the frozen native board. Gerbers, plated/nonplated drill,
all-footprint placement positions and an ungrouped source-XML BOM permit
inspection. Mounting holes are geometry rather than BOM components.
Placement coordinates retain KiCad native anchor convention and need
assembler-specific orientation review. No sourcing, stackup-vendor,
physical performance, medical clearance or manufacturing approval is
claimed. Use artificial loads only.
