pratham-cloud-ctrl/Project-ATO/cad/stage5/renders/future_assembled.png

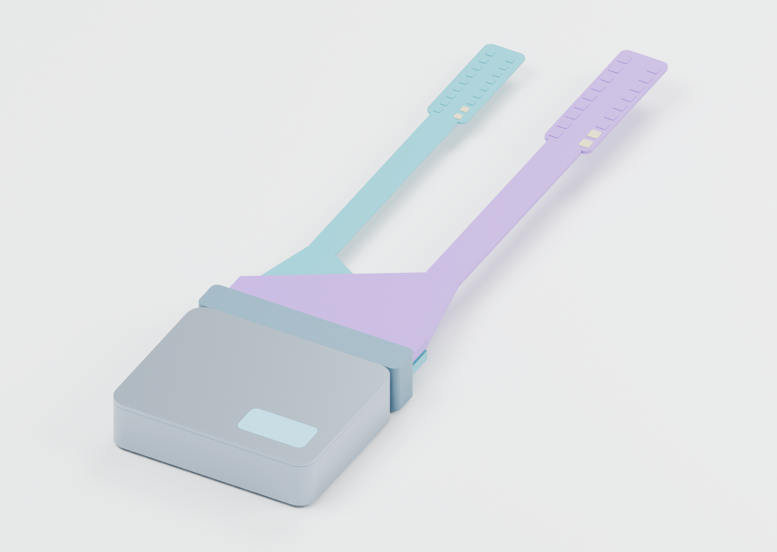
cad/stage5/renders/future_assembled.png
