pratham-cloud-ctrl/Project-ATO/docs/stage1/verification-matrix.csv

verification_id | objective | method | pass_criterion | evidence_type | stage | limitation
S1-V-001 | Preserve digital scope and release boundaries | Inspect specification; artifact status; spinal-only versus hybrid labels; synced-source handling; historical release boundaries; and attribution | Digital scope; source read-only policy; preserved historical release; AI and AstroSam contribution credit; and explicit hybrid labels agree across the dossier; no full implant or biological validation is claimed | Specification audit | Stage 1 | This row defines an audit; no new experiment or implementation is reported
S1-V-002 | Trace both ambitions through the complete mechanism | Inspect motor and target-specific physiological causal diagrams and interface ownership | Every required chain contains observations; interpretation; personalized or target-specific intervention; measured electrical delivery; uncertain response; and feedback with named owners | Specification audit | Stage 1 | Diagram completeness does not establish that the biological links work
S1-V-003 | Restrict online software to available information | Enumerate simulator truth; evaluator truth; training labels; decoder inputs; calibration observations; and controller payloads | No true phase; hidden learner skill; recruitment coefficient; future sample; or held-out outcome is available to online software except a labeled oracle condition | Specification audit | Stage 1 | Runtime leakage checks are planned for Stage 3; training-label availability may remain an explicit assumption
S1-V-004 | Separate evidence types and parameter provenance | Cross-reference model assumptions; evidence register; units; and values requiring primary-source investigation | Every biological link and provisional range is classified as published evidence; hypothesis; idealization; requirement; or digitally verified quantity with unresolved values identified | Specification audit | Stage 1 | This specification does not itself validate or source every provisional numerical range
S1-V-005 | Define comparisons capable of isolating information value | Review sensing-by-policy factorial and expert trajectory-only control | External-only and spinal-plus-external conditions cross expert-informed and learner-only policies; expert neural content has a trajectory-only comparator; null and harmful outcomes remain allowed | Specification audit | Stage 1 | Fair implemented comparisons and their outcomes remain future work
S1-V-006 | Define fair learner and evaluation budgets | Audit proposed practice; calibration; expert-resource; tuning; and evaluation budgets | Paired conditions share declared learner exposure; calibration effort; external sensors; disturbances; actuator constraints; and evaluation protocol; offline expert cost is disclosed separately | Specification audit | Stage 1 | Equal information availability is a design rule; it does not guarantee equivalent computation or biological burden
S1-V-007 | Separate contact and channel quantities | Audit proposed channel inventory and routing terminology | Recording contacts; digitized channels; independent output drivers; and simultaneous stimulation configurations are separately counted and connected to module responsibilities | Specification audit | Stage 1 | Final counts follow later observability; routing; timing; power; and mechanical budgets
S1-V-008 | Define later checks without claiming execution | Inspect every verification row and claim-to-evidence mapping | Each row states an objective; method; pass criterion; evidence type; stage; and limitation; future checks are not reported as passed | Specification audit | Stage 1 | A completed matrix is not completed verification
S1-V-009 | Keep application and placement selection reviewable | Compare candidate motor task families; physiological behaviors; external sensors; and placement alternatives | A reasoned recommendation and tradeoffs are prepared for the Stage 1 checkpoint; no old rhythmic task; contact count; or desktop dimensions are silently imposed | Specification audit | Stage 1 | Selection requires the project checkpoint and may change later budgets
S1-V-010 | Separate online assistance from retained learning claims | Audit proposed outcome definitions and adaptation assumptions | Active assistance; assistance-free retention; and held-out transfer have distinct trials and metrics; no fixed acquisition multiplier is an acceptance requirement | Specification audit | Stage 1 | Synthetic adaptation is not evidence of retained human learning
S1-V-101 | Generate electrode observations through a declared forward model | Implement source populations; geometry-dependent transfer; noise; drift; common mode; and artifact sources with unit tests | Decoder input is contact voltage after the declared acquisition path; source and transfer units close; no direct true-phase bypass supplies the normal controller | Synthetic model validation | Stage 3 | Planned; source populations and lead fields remain approximations rather than demonstrated human recordings
S1-V-102 | Prevent training and temporal information leakage | Audit grouped training splits; feature windows; timestamps; expert freezing; and held-out contexts | Online features use only causally available samples; repeated windows from held-out performances do not leak into training; expert pipeline is frozen before learner evaluation | Synthetic model validation | Stage 3 | Planned; a valid synthetic split does not establish generalization to real people
S1-V-103 | Expose observation identifiability failures | Construct distinct latent states with similar contact observations and reduced or redundant source information | Ambiguity is quantified; confidence or abstention reflects the declared criterion; failed discrimination is reported rather than repaired with hidden truth | Synthetic model validation | Stage 3 | Planned; the set of constructed ambiguous states is not an exhaustive biological identifiability proof
S1-V-104 | Learn expert content rather than replay expert voltage | Train the declared task-conditioned representation from expert observations and reference measurements | Representation generation is reproducible; includes multiple declared expert performances; maps into learner coordinates; and has no direct electrode-voltage replay equivalence claim | Synthetic model validation | Stage 3 | Planned; synthetic experts do not supply evidence that recorded human spinal features encode expertise
S1-V-105 | Identify learner response from calibration observations | Fit recruitment or local response models to bounded calibration inputs and measured delivery; evaluate held-out inputs and contexts | Parameter uncertainty and validity region are retained; held-out prediction is scored against preregistered Stage 2 criteria; unidentifiable or wrong-sign responses cause defined fallback or reported failure | Synthetic model validation | Stage 3 | Planned; response-model validity and acceptable prediction tolerances remain target-specific decisions
S1-V-106 | Measure incremental spinal and expert information value | Run paired sensing-by-policy factorial plus expert trajectory-only comparator using matched budgets | All primary contrasts and raw outcomes are reported including equality or deterioration; sensor timing and resource differences are disclosed; no superior result is required | Synthetic comparison | Stage 3 | Planned; favorable modeled information structure is not evidence of actual spinal access
S1-V-107 | Test content and mapping negative controls | Shuffle neural or expert associations; remove neural input; perturb expert context; and corrupt learner mapping | Comparisons expose sensitivity to relevant information and incorrect mappings; controls have equivalent declared information and exposure budgets | Synthetic comparison | Stage 3 | Planned; a shuffle can detect one dependency but cannot alone establish causal biological transfer
S1-V-108 | Permit favorable; zero; and harmful adaptation | Evaluate specified adaptation families with zero coupling; dependent learning; and detrimental intervention effects | Parameters are declared before comparisons; zero and harmful outcomes are preserved; no desired speedup is inserted and then treated as discovery | Synthetic model validation | Stage 3 | Planned; all artificial adaptation laws remain unvalidated models of biological learning
S1-V-109 | Measure unassisted retention and transfer separately | Disable assistance for probe trials and test held-out contexts with declared state reset; washout; and forgetting assumptions | Outcome scoring uses observed task performance; active-assistance metrics are separate; threshold censoring and any elapsed-time assumptions are reported | Synthetic comparison | Stage 3 | Planned; simulated retention intervals do not validate sleep consolidation or real elapsed-time learning
S1-V-110 | Challenge decoding and control under realistic interface defects | Sweep noise; geometry mismatch; drift; artifact recovery; unknown delay; saturation; sensor faults; and lost samples | Error; confidence; command activity; and failure transitions are reported over the declared envelope; unavailable observations are not silently replaced with truth | Synthetic robustness study | Stage 3 | Planned; selected sweeps are not an exhaustive operating or safety envelope
S1-V-111 | Expose insufficient authority and sensory costs | Construct unreachable task states; weak recruitment; cross-coupling; sensory-feedback disruption; and adverse response directions | The controller stays within the declared electrical contract and reports infeasibility; sensory cost; or target failure; authority is not increased silently to obtain success | Synthetic model validation | Stage 3 | Planned; modeled failure handling is not a safe clinical fallback and sensory-interference parameters remain uncertain
S1-V-112 | Use target-specific physiological dynamics and external sensing | After target selection connect measured delivery to uncertain recruitment; physiological response; and delayed biased external observation | The model names one output and requested behavior; unknown response parameters are estimated or bounded; physiological feedback is not assumed readable from spinal voltage | Synthetic model validation | Stage 3 | Planned; no human dose-response or clinical target is established
S1-V-113 | Determine whether physiological spinal recording adds value | Compare identical external-sensor feedback policies with and without the proposed additional spinal observable | Added information and its availability are defined; sustained and transient metrics are reported; no advantage is an acceptable result and the external-feedback stimulation architecture remains explicit | Synthetic comparison | Stage 3 | Planned; a recording benefit in a synthetic plant depends on its assumed observation mechanism
S1-V-114 | Account for physiological failure and termination | Challenge disturbance rejection; output limits; sensor bias and dropout; adverse coupling; and requested stop or mode transition | Sustained regulation and transient dips; overshoot; response onset; termination; effort; and loss of support are separately reported; inhibition is not labeled universally safe | Synthetic robustness study | Stage 3 | Planned; clinical harm and acceptable fallback behavior require evidence outside this digital project
S1-V-201 | Close signal and conversion budgets | Calculate source range; electrode impedance; AFE noise; headroom; filtering; ADC resolution; sampling; and saturation margins | Budget values have units and provenance; selected nominal and uncertainty cases meet declared margins or trigger a documented architecture change | Architecture analysis | Stage 2 | Planned; numerical acceptance thresholds require target-specific evidence and are not supplied here
S1-V-202 | Close causal timing and synchronization budgets | Analyze clocks; group delay; conversion; buffering; processing; telemetry; scheduling; jitter; and artifact recovery | End-to-end latency and clock uncertainty fit the declared control requirement or a specified redesign; future data and zero-cost communication are absent | Architecture analysis | Stage 2 | Planned; real MCU scheduling and clock performance remain unmeasured
S1-V-203 | Close power; heat; charge; and compliance budgets | Compute operating modes and worst declared load; energy; driver; monitor; reference; telemetry; and package cases | Power and delivery budgets include margins and failure cases; commanded and delivered current are distinct; no implicit free energy or universal analog cap is assumed | Architecture analysis | Stage 2 | Planned; a closed digital budget is not thermal; tissue; or hardware qualification
S1-V-204 | Bound uncertain response and control authority | Analyze identified parameter uncertainty and achievable target region under selected electrical limits | Authority and uncertainty envelopes are declared; unreachable targets and invalid response regions have specified outcomes; controller gains are not justified by a favorable plant alone | Architecture analysis | Stage 2 | Planned; selected reduced-order dynamics may omit adverse biological mechanisms
S1-V-301 | Integrate acquisition and ADC with actual decoder input | Run contact voltages through the selected digital circuit and sampling models and inspect sample frames | Decoder sees filtered; quantized; timestamped values with validity flags; clipping and recovery alter the input rather than bypassing it | Circuit and software simulation | Stage 4 | Planned; device-specific models remain conditional and no implanted recording is demonstrated
S1-V-302 | Verify multichannel sampling and stimulation routing | Exercise channel count; skew; multiplex settling; buffering; simultaneous routes; and invalid route requests | Observed timing and routing meet the versioned contract or produce a defined fault; channel identities do not change silently across modules | Circuit and software simulation | Stage 4 | Planned; this does not demonstrate chronic electrode independence or neural selectivity
S1-V-303 | Measure delivered charge under electrical uncertainty | Integrate modeled monitor current through electrode-load; compliance; mismatch; stored-polarization; and timing cases | Reported phase and net charge derive from modeled measured delivery rather than symmetric commands; uncertainty and violated limits are exposed | Circuit simulation | Stage 4 | Planned; circuit-model charge is not measured hardware or tissue safety evidence
S1-V-304 | Connect stimulation artifacts to acquisition validity | Drive artifact generation from actual modeled electrical delivery and route changes and test recovery | Invalid samples and recovery intervals enter the decoder quality contract; control uses no artifact-contaminated samples outside its declared policy | Circuit and software simulation | Stage 4 | Planned; artifact kernels and settling may differ substantially from a real implant
S1-V-305 | Verify independent current; voltage; and compliance monitoring | Inject delivery deviations while holding commanded values fixed and model sensor error and latency | The monitor detects deviations according to declared thresholds or reports blind regions; it does not infer delivery merely from the command | Circuit and software simulation | Stage 4 | Planned; monitoring independence and diagnostic coverage require hardware validation later
S1-V-306 | Exercise fault supervision and command admission | Inject stale or ambiguous state; lost radio; replayed or unauthorized messages; version-mismatched configuration; conflicting applications; reset; brownout; stuck monitor; main-clock failure; and independent supervisory faults | Local admission rejects invalid or unauthorized plans and configurations; application resource conflicts follow declared arbitration; independent detection and output response are measured; uncertain delivery and application-specific loss-of-support effects remain recorded | Software and circuit fault injection | Stage 4 | Planned; specified inhibition may itself cause lost physiological support and is not universally safe
S1-V-307 | Account for interrupted and distorted balancing phases | Interrupt power or timer action during a phase and apply compliance or current errors | Delivered charge imbalance is recorded; recovery or shutdown behavior is explicitly bounded; ideal completion on a software fault is not extended to a power-loss guarantee | Software and circuit fault injection | Stage 4 | Planned; a digital fallback does not establish electrochemical recovery or safe human interruption
S1-V-308 | Check supply and programmable-driver dependence | Sweep supply; reference; temperature-model parameters; configuration; current range; and electrode load | Driver behavior and compliance are evaluated against the declared contract; actual achievable settings and current uncertainty are recorded | Circuit simulation | Stage 4 | Planned; vendor and parasitic models may omit real worst cases
S1-V-309 | Verify native electronics completeness and consistency | Audit complete block schematic; native netlists; BOM; selected pinouts; logic levels; ERC; DRC; and schematic parity | Required acquisition; conversion; processing; stimulation; monitoring; power; communication; and supervision functions are represented; source and exports agree | Native design verification | Stage 4 | Planned; clean design rules do not prove signal integrity; analog stability; manufacturing yield; or biological effectiveness
S1-V-401 | Derive contact and lead geometry from mechanism | Map target structures; placement alternative; source transfer; recruitment assumptions; and contact rationale to parameterized geometry | Contact geometry and count have a stated rationale and uncertainty; different recording and stimulation placements are not conflated | Mechanical specification and geometry analysis | Stage 5 | Planned; anatomical fit and tissue compatibility are not established by a CAD model
S1-V-402 | Match physical contacts to electrical channels and routing | Cross-check contact; feedthrough; connector; harness; driver; and sampled-channel identities | A complete physical-to-electrical map exists and agrees with model and netlist identities; scaling adds its routing and resource costs | Mechanical and interface verification | Stage 5 | Planned; connection consistency does not demonstrate usable neural signals or selective recruitment
S1-V-403 | Fit selected components and interfaces in nominal assemblies | Import populated native boards; selected connectors; cable and feedthrough envelopes; and mounting geometry | No prohibited nominal interference remains; connector access; bend and strain-relief allowances are declared; generic holes are not called verified connector fits | Native CAD verification | Stage 5 | Planned; tolerances and physical assembly are not measured in an entirely digital project
S1-V-404 | Separate implant anatomy from desktop/test equivalents | Audit assemblies; drawings; coordinate systems; material assumptions; and purpose labels | Future implant; lead; companion; and test-equivalent geometries are distinctly identified; no desktop shell is relabeled as an implant package | Mechanical specification audit | Stage 5 | Planned; hermeticity; sterilization; chronic durability; and surgical feasibility need evidence beyond geometry
S1-V-405 | Connect package geometry to power and uncertainty budgets | Review thermal/energy analysis; material assumptions; anatomical reference variation; tolerances; and package envelopes | Mechanical choices are compatible with the declared budget and uncertainty cases or trigger a coordinated electronics/mechanical revision | Mechanical and architecture analysis | Stage 5 | Planned; no tissue-temperature or implant reliability guarantee follows from the selected reduced-order analysis
S1-V-501 | Trace the complete digital feedback loop | Replay generated sources through electrodes; AFE/ADC; embedded control; driver; measured current; recruitment; body response; and feedback on the declared clock | A trace links each interface and observed outcome for both selected applications; units; IDs; timing; quality; and faults agree without a hidden ideal bypass | Integrated digital verification | Stage 6 | Planned; full digital integration still does not prove the biological assumptions
S1-V-502 | Reproduce data and validity bookkeeping | Reproduce seeded studies and firmware traces from a clean checkout; inspect source/model/data versions and configuration/calibration/model activation logs and validity consistency | Raw results and metadata reproduce within declared tolerances; seeds and versions are preserved; every session and admitted output traces to the activated valid configuration calibration and model; incompatible or stale versions cannot silently activate | Reproducibility verification | Stage 6 | Planned; more repeatable synthetic data do not reduce unmodeled biological uncertainty
S1-V-503 | Audit every final claim against the appropriate evidence | Map manuscript and repository claims to requirements; assumptions; tests; sources; and unresolved links | No circuit; CAD; decoder; or synthetic-learning result is promoted into an unsupported human efficacy; implantation; or safety claim | Claim and evidence audit | Stage 6 | Planned; external evidence must be interpreted within its own placement; population; and study limits
S1-V-504 | Report negative outcomes and architecture revisions honestly | Review preregistered metrics; failures; censored thresholds; revisions; and uncertainty sensitivity | Null; harmful; unreachable; and failed comparisons are retained; revisions disclose changed assumptions; a positive effect is not required for a complete digital investigation | Integrated result audit | Stage 6 | Planned; a negative synthetic outcome also does not prove biological impossibility
S1-V-601 | Establish usable spinal observations in the intended setting | Evaluate independent experimental recordings and prospective validation against the chosen placement and task | Evidence establishes which target states are observable under declared context; artifact; and held-out conditions before a real biological decoding claim is made | External experimental evidence | Future biological validation outside project | Not performed or required to be generated by this entirely digital project; current synthetic sources cannot pass this check
S1-V-602 | Establish learner or physiological recruitment and causal influence | Evaluate controlled experiments relating measured delivery and anatomical route to response and adverse/off-target effects | Experimental evidence supports the claimed response and validity region before model recruitment is treated as established biology | External experimental evidence | Future biological validation outside project | Not performed here; a plausible mechanism or fitted synthetic map cannot establish this causal link
S1-V-603 | Establish retained skill and transfer rather than assistance only | Specify and eventually evaluate controlled assisted-practice; unassisted-retention; and transfer comparisons with appropriate review | Actual outcomes distinguish immediate assistance from retained causal learning and account for baseline practice and expert information before a human acceleration claim | External experimental evidence | Future biological validation outside project | No participant or animal experiments are authorized or reported; no fixed acquisition multiplier is presumed
S1-V-604 | Establish chronic interface and implanted-system suitability | Evaluate appropriate physical; electrochemical; biocompatibility; reliability; and chronic experimental evidence | Claims of chronic recording; tissue compatibility; sealing; implanted reliability; and safety have evidence specific to the proposed system | External physical and biological evidence | Future biological validation outside project | Not performed here; native CAD and circuit simulations cannot qualify an implant
