pratham-cloud-ctrl/Project-ATO/docs/stage2/verification-progress.csv

verification_id | stage2_status | completed_scope | remaining_scope | artifact
S1-V-201 | Analytical cases completed | Quiet nominal and adverse noise; range; sampling; FIR; ADC transport and compute budgets | Human signal range and contact impedance; component tolerances; physical artifact recovery | acquisition-and-compute.md
S1-V-202 | Conditional architecture specified and calculated | Causal processing/clock/blanking budgets; free-frame failure and paced-goal revision | Actual sensor/MCU timing; causal task information; recovery qualification | timing-and-control.md
S1-V-203 | Analytical cases completed with explicit rejections | Joint charge/compliance; monitor resources; energy/power/thermal cases; low-current reference and rejected strong cases | Delivered circuit waveforms; electrode chemistry; real cell/thermal/RF performance | selected-design.md
S1-V-204 | Partially specified; identification remains Stage3 | Pressor-only authority; calibration uncertainty and abstention contracts; electrical reachable inputs | Identify uncertain recruitment/body-response bounds and quantify functional target reachability from permitted observations | control-contracts.json
S1-V-402 | Functional inventory mapped; complete net map remains Stage4/5 | 36 CAD labels assigned to18 recording/reference/bias and18 stimulation/return roles;16 streams and2 sources | Exact chip pins/nets and anatomical lead configurations; coexistence of target lead sets | functional-port-map.csv
S1-V-403 | Preliminary geometry only | 80 allocation solids and STEP/FreeCAD round-trip;3088 nominal pair checks excluding72 intentional header/interface reservation pairs | Populated native PCB; true components/feedthroughs; harness access; tolerances and anatomical placement | ../../cad/stage2/inspection-checks.json
