pratham-cloud-ctrl/Project-ATO/results/application_pulse_events.csv

application | pulse_id | start_us | duration_us | current_ua | phase_pin | inhibit_pin | abstract_command | normalized_activity | state | ideal_net_pulse_charge_nc
pressure | 0 | 0 | 200 | 100 | 0 | 0 | 0.008792770680582679 | 0.008792770680582679 | 1 | 0.0
pressure | 0 | 200 | 50 | 0 | 1 | 1 | 0.008792770680582679 | 0.008792770680582679 | 2 | 0.0
pressure | 0 | 250 | 200 | -100 | 1 | 0 | 0.008792770680582679 | 0.008792770680582679 | 3 | 0.0
pressure | 0 | 450 | 19550 | 0 | 0 | 1 | 0.008792770680582679 | 0.008792770680582679 | 4 | 0.0
pressure | 1 | 2300000 | 200 | 100 | 0 | 0 | 0.0009735979524099427 | 0.0009735979524099427 | 1 | 0.0
pressure | 1 | 2300200 | 50 | 0 | 1 | 1 | 0.0009735979524099427 | 0.0009735979524099427 | 2 | 0.0
pressure | 1 | 2300250 | 200 | -100 | 1 | 0 | 0.0009735979524099427 | 0.0009735979524099427 | 3 | 0.0
pressure | 1 | 2300450 | 19550 | 0 | 0 | 1 | 0.0009735979524099427 | 0.0009735979524099427 | 4 | 0.0
pressure | 2 | 22842360 | 200 | 100 | 0 | 0 | 0.22145755878985762 | 0.22145755878985762 | 1 | 0.0
pressure | 2 | 22842560 | 50 | 0 | 1 | 1 | 0.22145755878985762 | 0.22145755878985762 | 2 | 0.0
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
