pratham-cloud-ctrl/Project-ATO/results/application_pulse_requests.csv

application | time_us | abstract_command | normalized_activity | sensor_fresh | accepted | firmware_fault
pressure | 0 | 0.008792770680582679 | 0.008792770680582679 | 1 | 1 | 0
pressure | 2300000 | 0.0009735979524099427 | 0.0009735979524099427 | 1 | 1 | 0
pressure | 22842360 | 0.22145755878985762 | 0.22145755878985762 | 1 | 1 | 0
pressure | 22932671 | 0.26145755878985766 | 0.26145755878985766 | 1 | 1 | 0
pressure | 23009165 | 0.2758001010246768 | 0.2758001010246768 | 1 | 1 | 0
pressure | 23081681 | 0.2958001010246768 | 0.2958001010246768 | 1 | 1 | 0
pressure | 23149294 | 0.301042749900912 | 0.301042749900912 | 1 | 1 | 0
pressure | 23215730 | 0.34104274990091205 | 0.34104274990091205 | 1 | 1 | 0
pressure | 23274374 | 0.36104274990091206 | 0.36104274990091206 | 1 | 1 | 0
pressure | 23329769 | 0.3583323622891609 | 0.3583323622891609 | 1 | 1 | 0
pressure | 23385583 | 0.3474635997031311 | 0.3474635997031311 | 1 | 1 | 0
pressure | 23443143 | 0.36184512132309943 | 0.36184512132309943 | 1 | 1 | 0
pressure | 23498415 | 0.3711543759842503 | 0.3711543759842503 | 1 | 1 | 0
pressure | 23552301 | 0.3828013042333759 | 0.3828013042333759 | 1 | 1 | 0
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
