pratham-cloud-ctrl/Project-ATO/results/motor_beta_sensitivity.csv

seed | policy | teaching_beta | noise | delay_s | learner_gain | assumed_delay_s | estimated_gain | baseline_rate | initial_skill | final_skill | final_unassisted_rmse | retained_rmse | first_assisted_rmse | first_unassisted_rmse | sessions_to_threshold | phase_rmse_rad
24000 | calibrated | 0.0 | 0.16 | 0.08 | 0.7521969270890319 | 0.08 | 0.7038819309749464 | 0.08984334611014975 | 0.22889042926787578 | 2.3751565330660247 | 0.04481345273333896 | 0.04709790839570682 | 0.09630411431055279 | 0.2990073946285305 | 25 | 0.0809173212703054
24001 | calibrated | 0.0 | 0.16 | 0.08 | 0.7646908587381082 | 0.08 | 0.7713242007840196 | 0.08559060392059196 | 0.12383913124885144 | 2.291831232136432 | 0.047505790101758164 | 0.04995011239915507 | 0.12259267191917243 | 0.32899240957898307 | 28 | 0.07487383218383538
24002 | calibrated | 0.0 | 0.16 | 0.08 | 0.9858108882636643 | 0.08 | 0.9687684057302318 | 0.08714521115695849 | 0.2397128069374236 | 2.345457625156278 | 0.04574040249617608 | 0.04808169776107684 | 0.10458549946456633 | 0.29606245353812527 | 26 | 0.0796778118062306
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
