pratham-cloud-ctrl/Project-ATO/experiments/stage3/observed-state-observer/frozen/observer-confirmation-root-review-12oct.md

# Independent root review before fresh capture generation

12 October 2026. This record was saved before the producer was run or any
confirmation sensor-noise draw was generated.

Root review message:

> ROOT PRE-GENERATION REVIEW APPROVED. Independently read complete protocol/
> producer, checked finite cohort/order, exact shared paired noise, sanitized
> runtime observations, fixed coverage/horizons, fullsrc byte manifest, immutable
> preflight, original observer/method bindings, unchanged gates and no-dose-only
> interpretation. Approved producer
> e177eb4837bbb437b8150a1a8a4daf9ee172719b6e3a2d407642771ac18d7c3d;
> protocol53658e9566216ab0358918cd2dc131dcb9aa6757987052001fd4d73319c4babf;
> receipt57c00950e44aee7c674f34a1335fd79f816f8ca09ce64ae66ce9916cf9bd3916.
> Save exact review record in tmp/observer-confirmation-root-review-12oct.md
> BEFORE running, then execute one --run-after-root-review referencing that file.
> No refit or revisions after outcomes. Report full coverage/failures and preserve
> original results. After run, independently audit saved raw targets/residuals/
> aggregates/sharednoise/hash bindings without regenerating/tuning.

This approves the bounded digital calculation. It is not approval for physical
stimulation, clinical/biological claims, an authoritative predictor replacement,
or any pilot/runtime change.
