pratham-cloud-ctrl/Project-ATO/experiments/stage3/observed-state-observer/frozen/observer-review-approval-12oct.md

# Pre-score independent review

The root agent independently reviewed the protocol, implementation, calibration
receipt and independent propagation/causality/noise check outputs before this
agent loaded or scored the sixteen development drift targets.

Frozen implementation SHA256:
`cbb2d6aa5a466261e372d1071cccf908983c8dbe8eeb8001b1d20428ed2362af`

Frozen method receipt SHA256:
`73a26e74e91f738fbc2f90e30655eaa0987a1e0d1ab905feb3b7aea52622e07a`

Root review message, 12 October 2026:

> Root independently reviewed revised protocol/source/receipt and check outputs;
> the timing issues are addressed and no remaining blocking issue found for this
> bounded development exercise. Approved to score the existing 16 development
> recordings and 8 temporal holdouts with EXACT frozen source and receipt,
> unchanged settings/gates. Record this review message/reference and both hashes
> in score outputs. No additional tuning after seeing outcomes. Full integration/
> fresh confirmation remains separate; desktop cache is not MCU evidence.

This is engineering review of a bounded development calculation. It is not
independent scientific confirmation or authorization to stimulate.
