pratham-cloud-ctrl/Project-ATO/electronics/stage4/driver-study/interval-results.csv

case | maximum_step_s | source | interval | start_s | end_s | load_charge_C | signed_shunt_charge_C | unsigned_feedback_charge_C | return_cap_charge_C | integrated_return_KCL_residual_C
nominal | 1e-07 | 0 | first | 0.0004 | 0.0006000000000000001 | 5.997914233194833e-07 | 5.997707877220627e-07 | 5.996977831124673e-07 | 2.06318532229607e-11 | 3.74419763236649e-15
nominal | 1e-07 | 0 | gap | 0.0006000000000000001 | 0.0007000000000000001 | 1.4959964687399479e-12 | 1.5014557308053114e-12 | -1.1019410080089492e-10 | -7.517746500461442e-15 | 2.058484435097964e-15
nominal | 1e-07 | 0 | second | 0.0007000000000000001 | 0.0009000000000000001 | -5.995669908701097e-07 | -5.995702959156774e-07 | 5.996749717415825e-07 | 3.3009321627302626e-12 | 4.113405019848151e-15
nominal | 1e-07 | 0 | whole_profile | 0.0004 | 0.0012000000000000001 | 2.2441267466920849e-10 | 2.0050218082515906e-10 | 1.1991523830816227e-06 | 2.389338536137684e-11 | 1.7108482672587324e-14
nominal | 1e-07 | 1 | first | 0.00042500000000000003 | 0.000625 | 5.997914201281901e-07 | 5.997707869295127e-07 | 5.996977829555874e-07 | 2.0629452481050596e-11 | 3.746196340075652e-15
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
