pratham-cloud-ctrl/Project-ATO/electronics/revisions/revA/spice_transient.csv

time_s | load_current_A | load_voltage_V | polarization_V
0.0 | -7.5386526841698e-22 | 1.5612511283791264e-17 | 1.5612511283791264e-17
5e-09 | -9.00684460487801e-18 | -8.991071775987791e-15 | 1.3877787807814457e-17
1e-08 | -9.00684460487801e-18 | -8.992806499463768e-15 | 1.214306433183765e-17
2e-08 | -9.00680091940191e-18 | -8.996275946415722e-15 | 8.673617379884035e-18
4e-08 | -1.2776651839398011e-18 | -1.2698175844150228e-15 | 6.938893903907228e-18
8e-08 | 2.5872906912752648e-18 | 2.5934115965853266e-15 | 5.204170427930421e-18
1.6e-07 | 6.561236556084565e-19 | 6.626643678231403e-16 | 5.204170427930421e-18
3.2e-07 | 6.582203225855569e-19 | 6.661338147750939e-16 | 6.938893903907228e-18
6.4e-07 | -3.0369466861822015e-19 | -2.96637714392034e-16 | 6.938893903907228e-18
1.14e-06 | -5.698778273681542e-20 | -5.0306980803327406e-17 | 6.938893903907228e-18
1.64e-06 | -5.599528878637397e-20 | -4.85722573273506e-17 | 6.938893903907228e-18
2.14e-06 | -5.59952904019611e-20 | -4.85722573273506e-17 | 6.938893903907228e-18
2.6399999999999997e-06 | -5.599529201754823e-20 | -4.85722573273506e-17 | 6.938893903907228e-18
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
