pratham-cloud-ctrl/Project-ATO/inspector/downloads/ATO_Integrated_Schematics.pdf

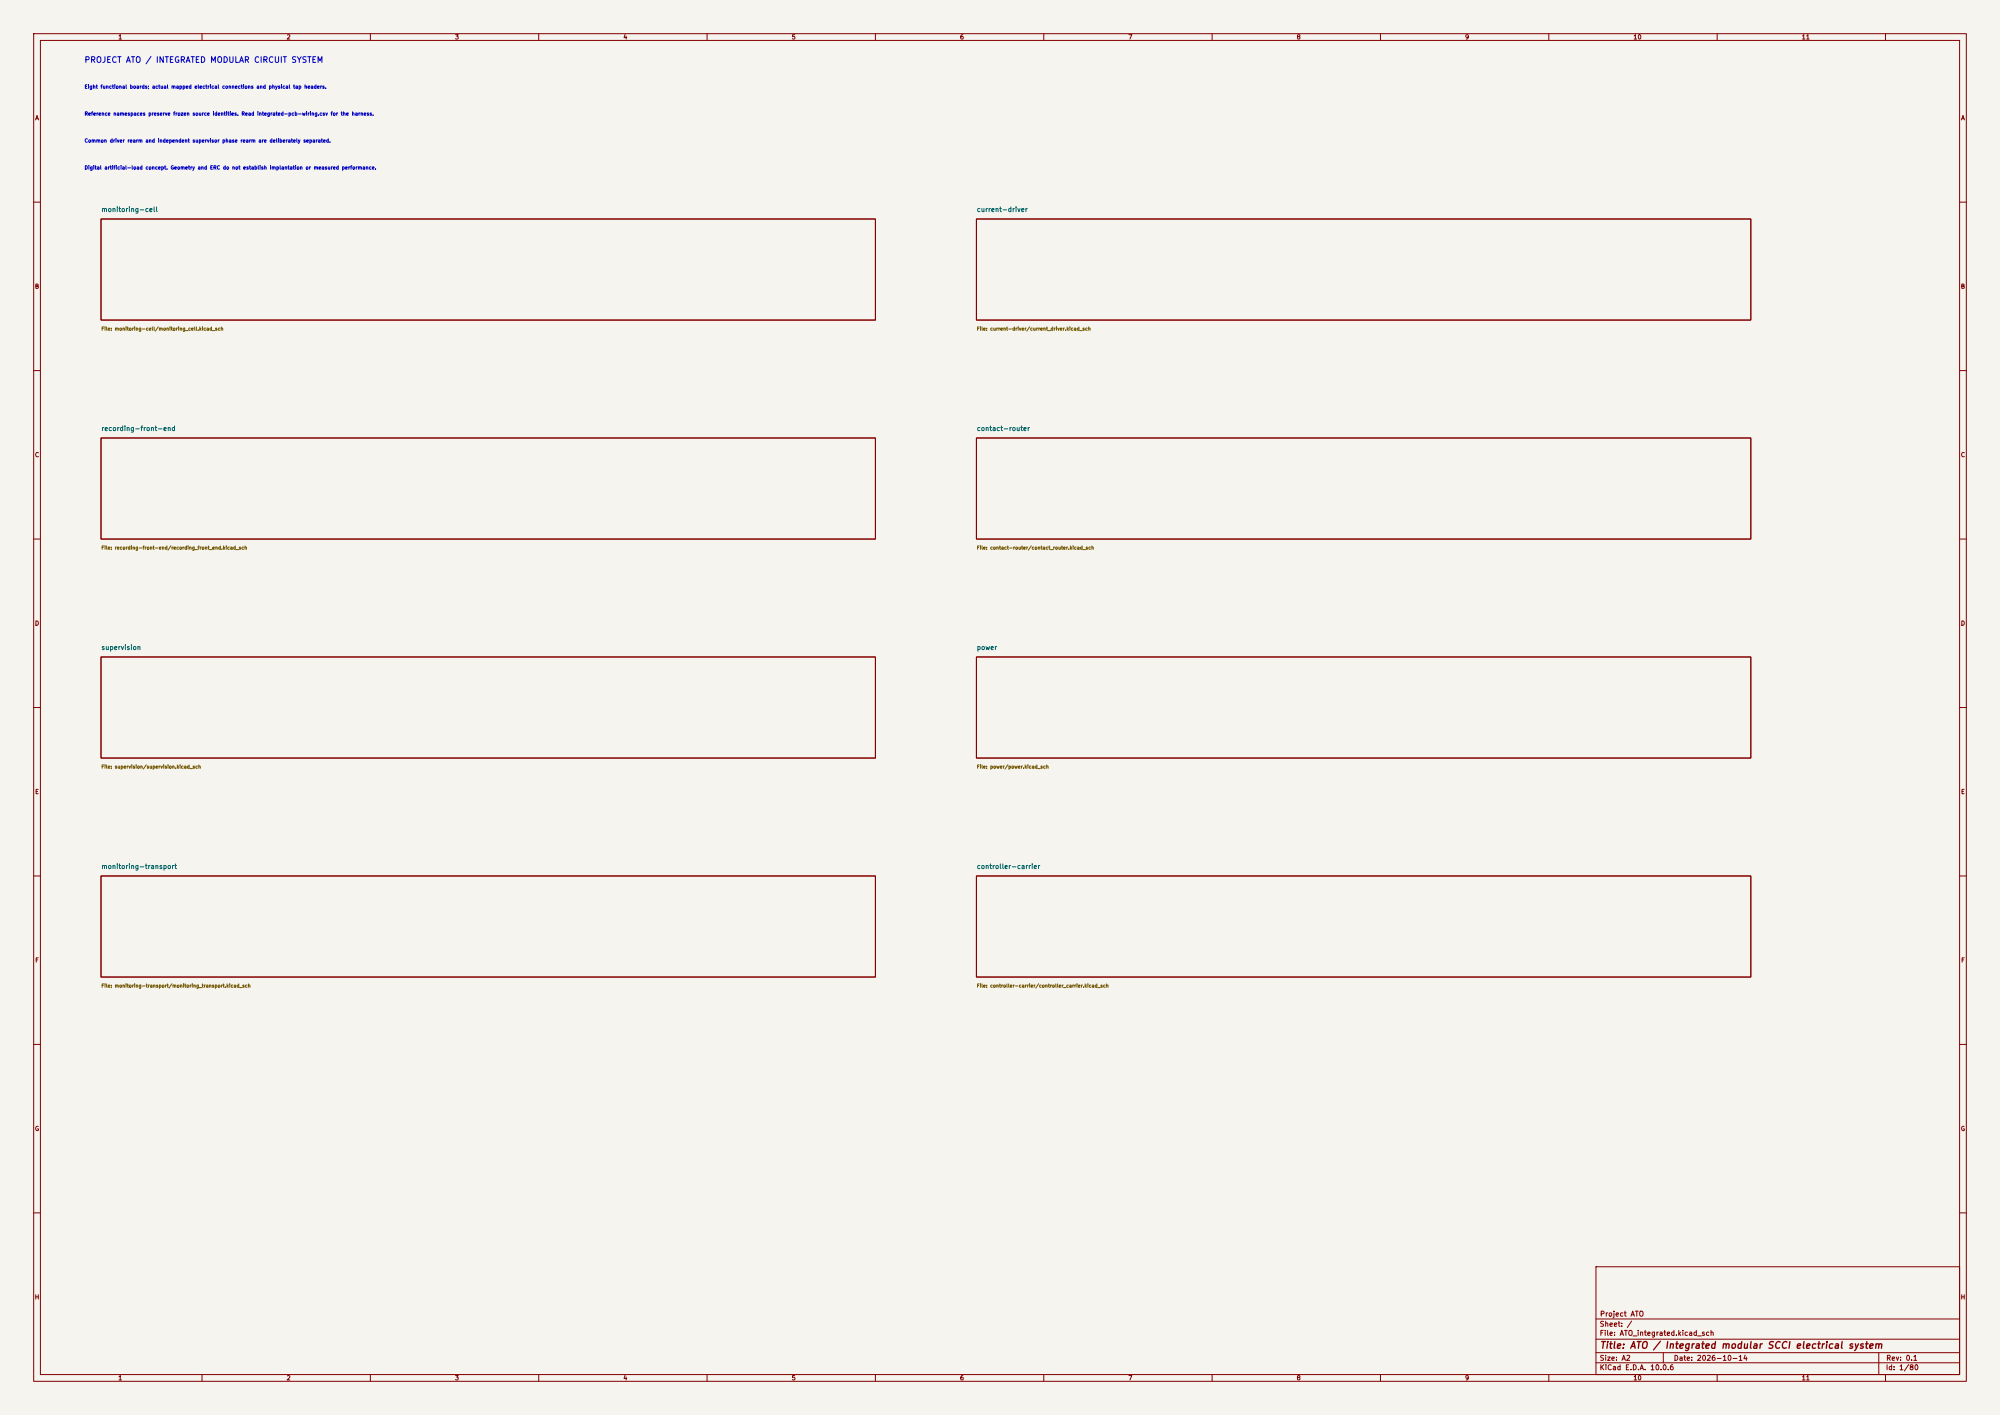
[picture p185: page 1]

PROJECT ATO / INTEGRATED MODULAR CIRCUIT SYSTEM

Eight functional boards; actual mapped electrical connections and physical tap headers. Reference namespaces preserve frozen source identities. Read integrated-pcb-wiring.csv for the harness. Common driver rearm and independent supervisor phase rearm are deliberately separated. Digital artificial-load concept. Geometry and ERC do not establish implantation or measured performance.

monitoring-cell File: monitoring-cell/monitoring_cell.kicad_sch

File: current-driver/current_driver.kicad_sch contact-router

File: recording-front-end/recording_front_end.kicad_sch supervision

File: contact-router/contact_router.kicad_sch power

File: supervision/supervision.kicad_sch monitoring-transport File: monitoring-transport/monitoring_transport.kicad_sch

File: power/power.kicad_sch controller-carrier

Project ATO
Sheet: /
File: ATO_integrated.kicad_sch
Title: ATO / Integrated modular SCCI electrical system

Size: A2 | Rev: 0.1
KiCad E.D.A. 10.0.6 | Id: 1/80

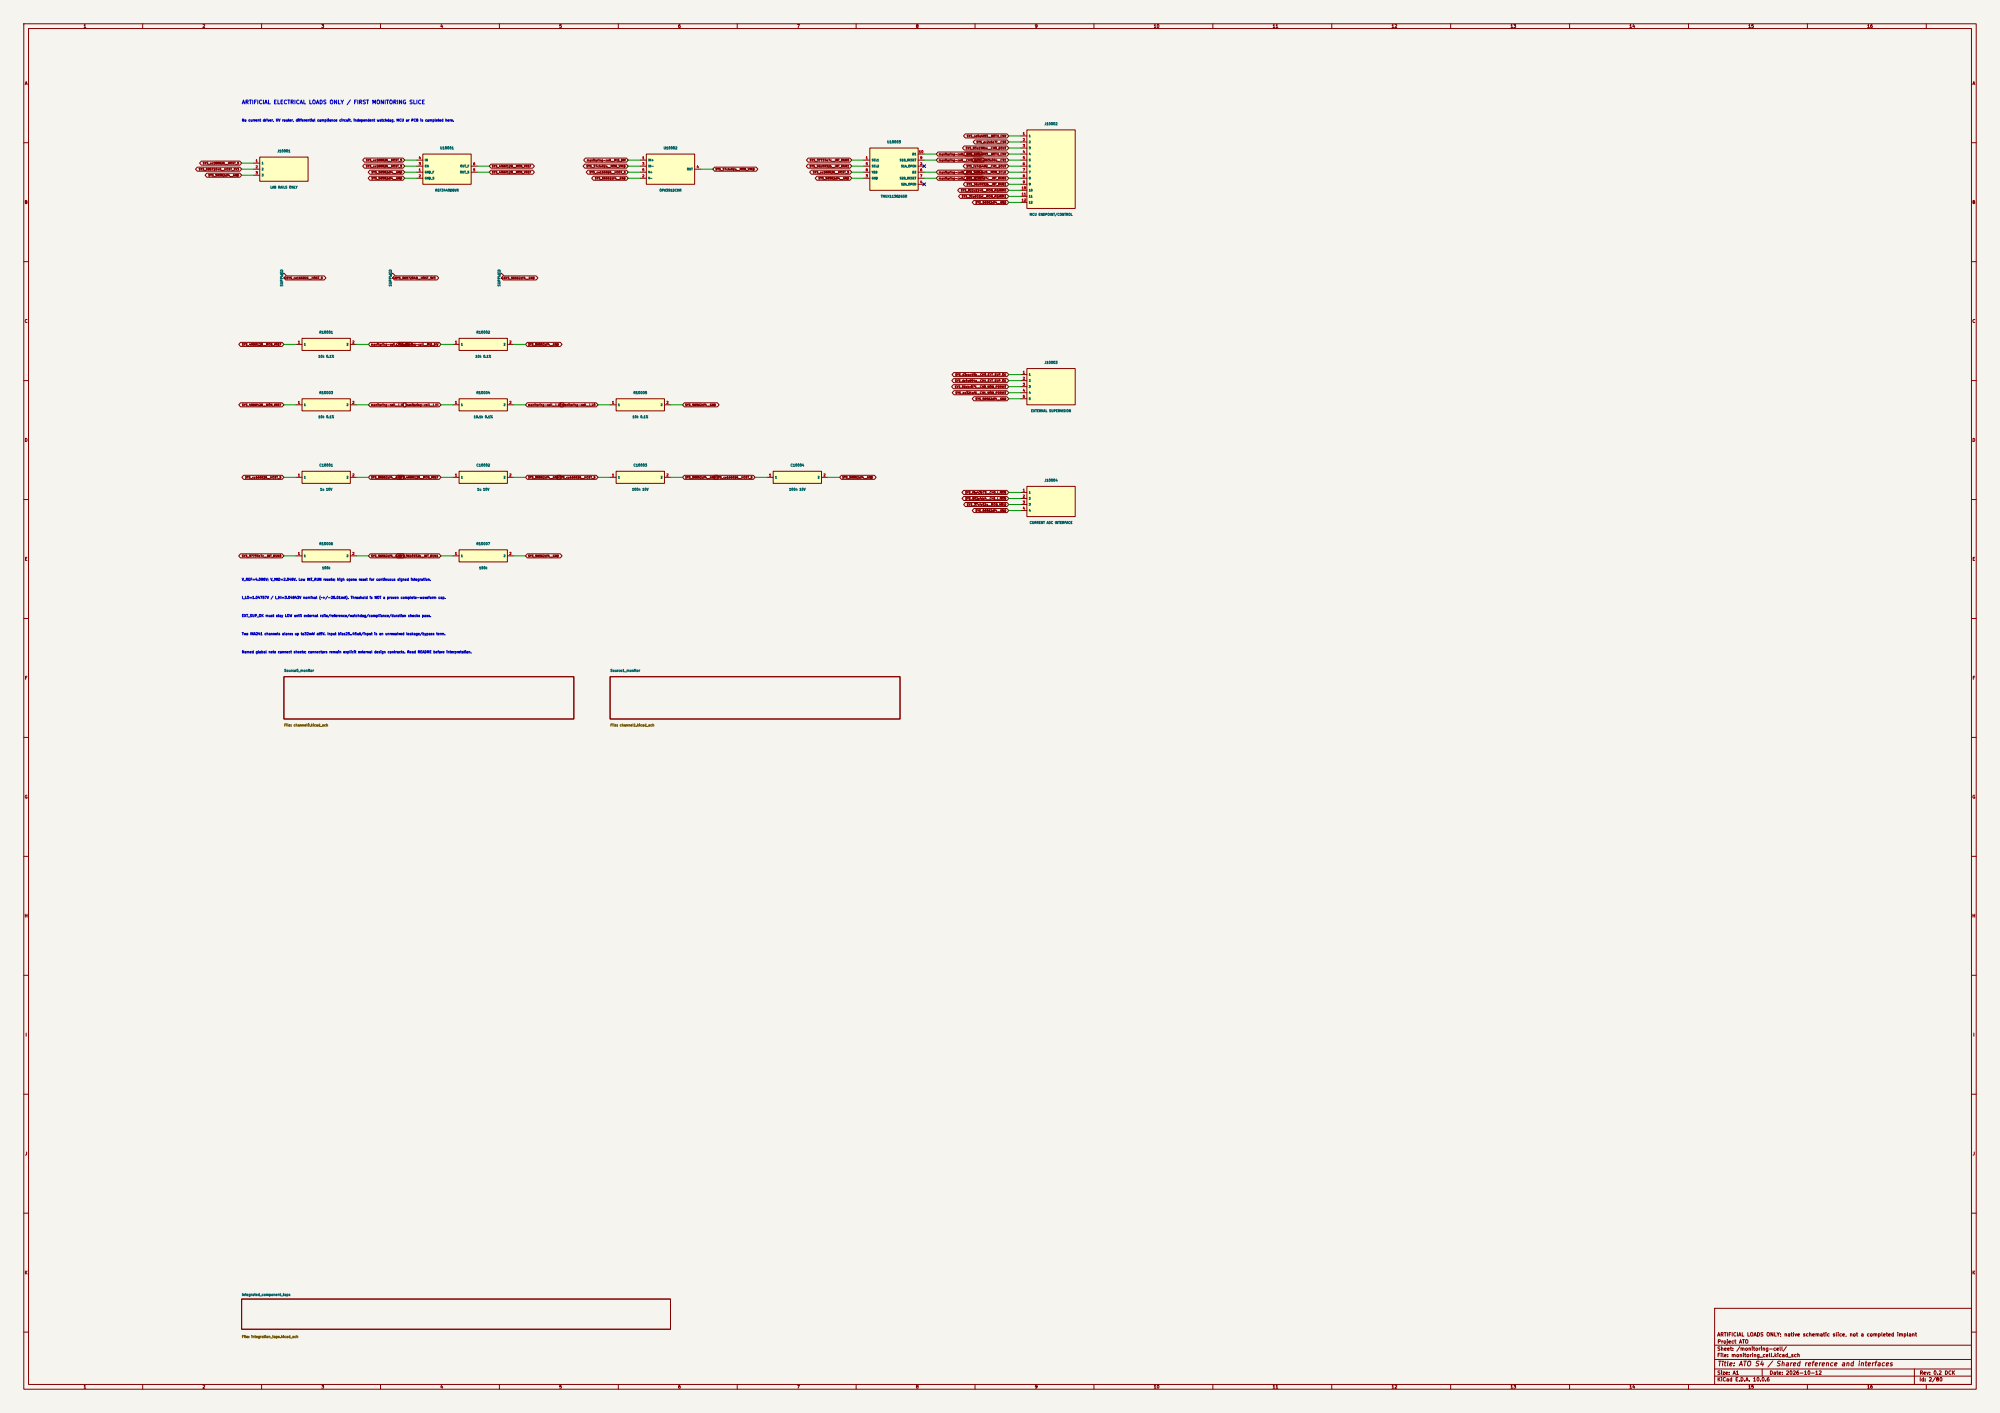
[picture p186: page 2]

No current driver, HV router, differential compliance circuit, independent watchdog, MCU or PCB is completed here. ARTIFICIAL ELECTRICAL LOADS ONLY / FIRST MONITORING SLICE

SYS_fd7db492__CH1_DOUT SYS_36b0932b__INT_RUN1 monitoring-cell__CH0_SUM monitoring-cell__CH0_Q_INT monitoring-cell__CH1_SUM monitoring-cell__CH1_Q_INT SYS_37cfe02a__MON_VMID monitoring-cell__MID_DIV monitoring-cell__MID_DIV monitoring-cell__I_HI monitoring-cell__I_HI SYS_ce166826__HOST_5

V_REF=4.096V; V_MID=2.048V. Low INT_RUN resets; high opens reset for continuous signed integration.

I_LO=1.04757V / I_HI=3.04843V nominal (~+/-25.01mA). Threshold is NOT a proven complete-waveform cap. EXT_SUP_OK must stay LOW until external rails/reference/watchdog/compliance/duration checks pass. Two INA241 channels alone: up to32mW at5V. Input bias25..45uA/input is an unresolved leakage/bypass term. Named global nets connect sheets; connectors remain explicit external design contracts. Read README before interpretation.

ARTIFICIAL LOADS ONLY; native schematic slice, not a completed implant

Sheet: /monitoring-cell/
File: monitoring_cell.kicad_sch
Title: ATO S4 / Shared reference and interfaces

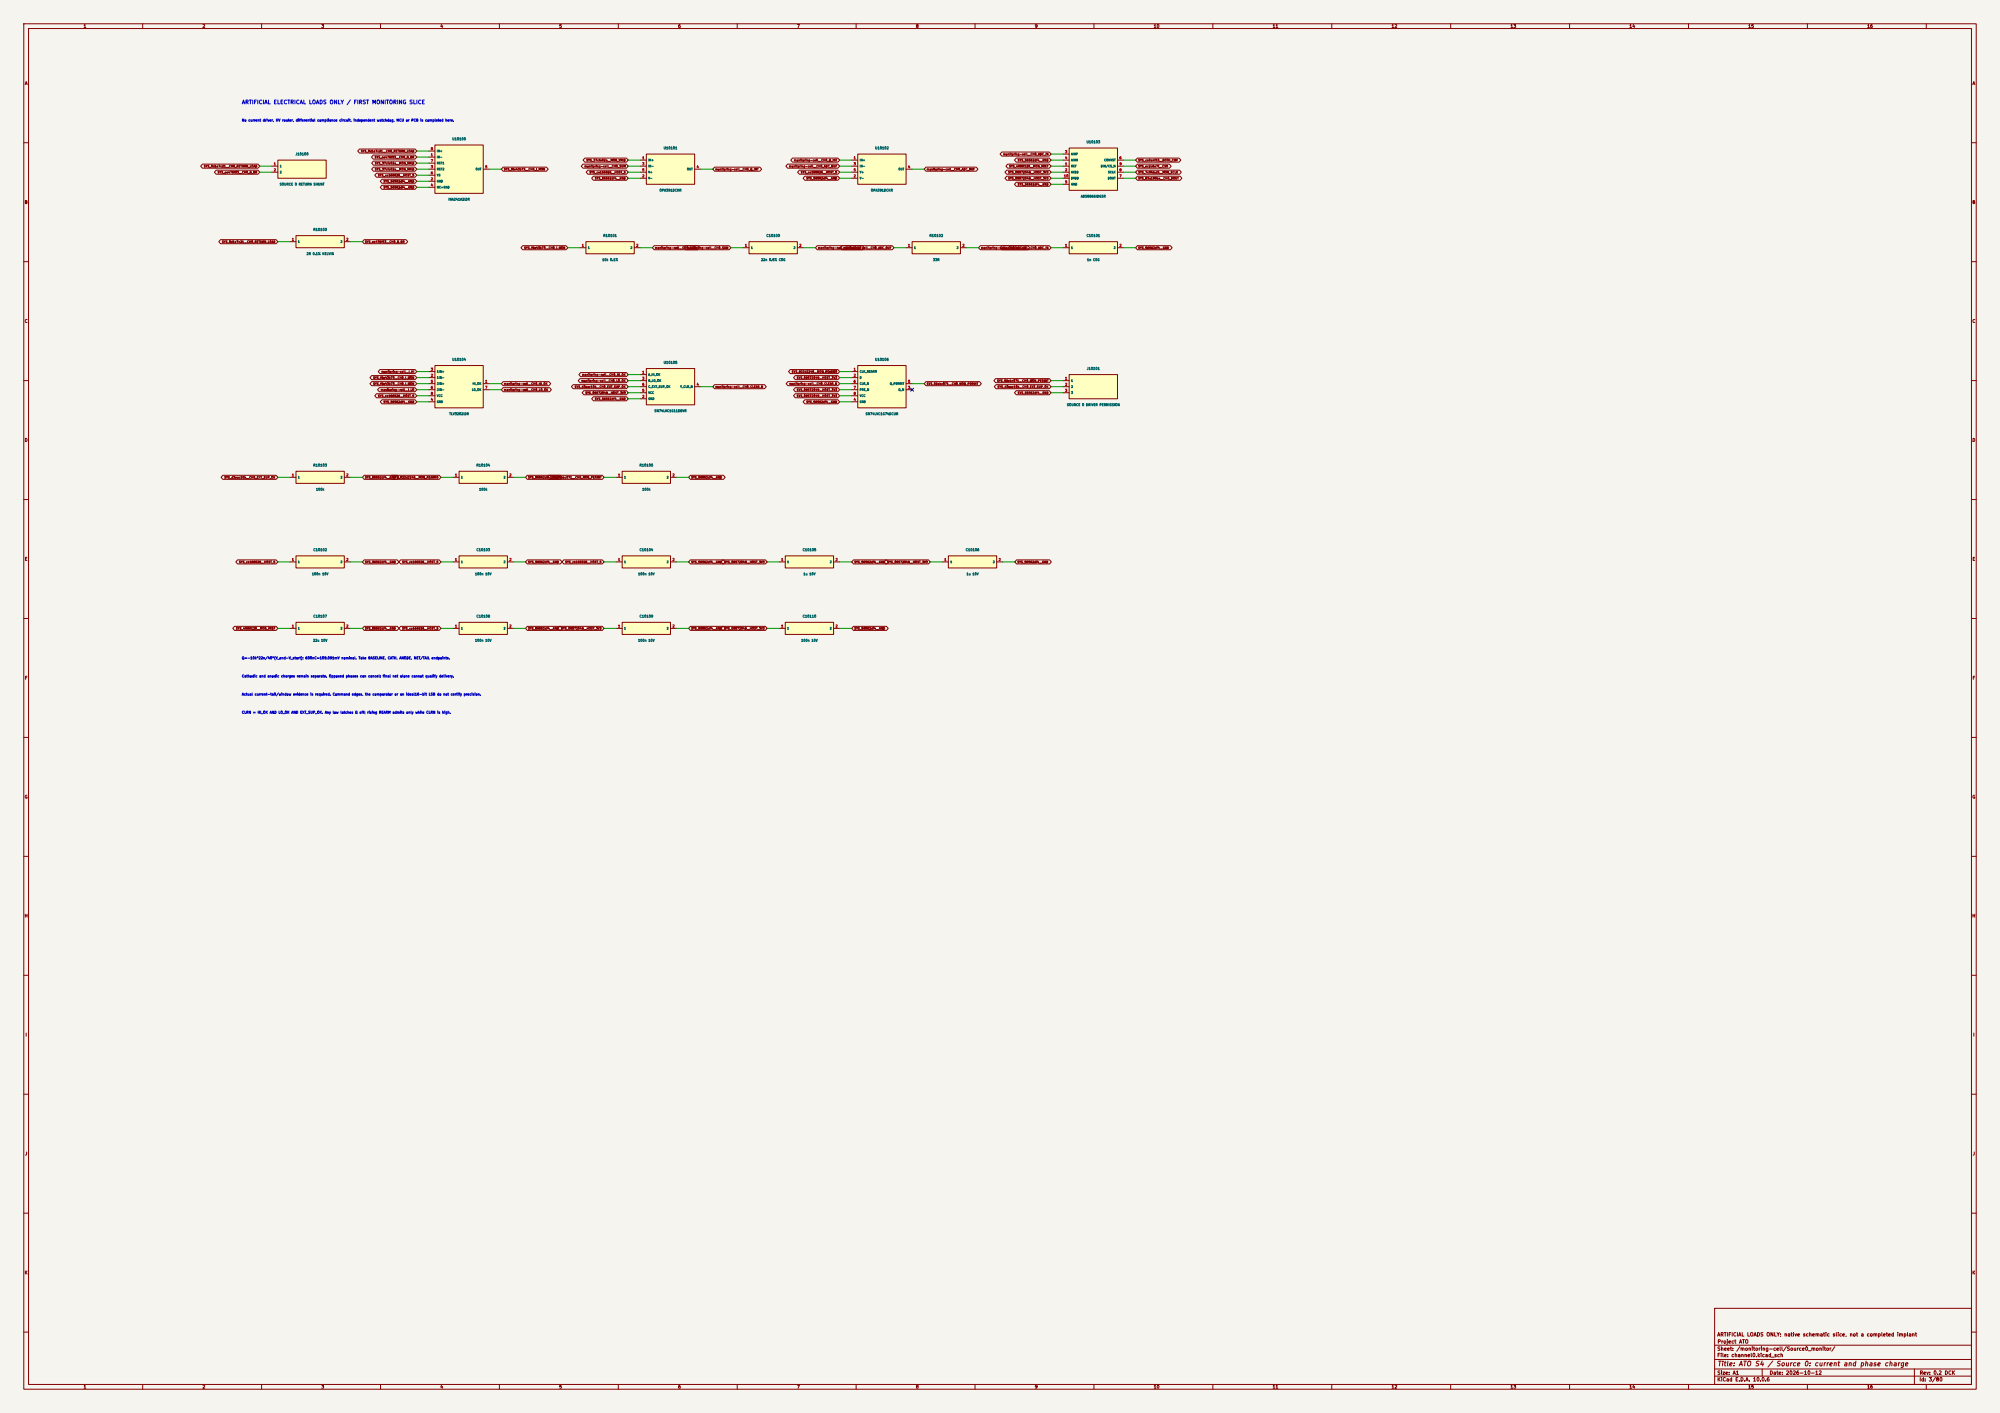
[picture p187: page 3]

SYS_08572049__HOST_3V3 ARTIFICIAL ELECTRICAL LOADS ONLY / FIRST MONITORING SLICE

No current driver, HV router, differential compliance circuit, independent watchdog, MCU or PCB is completed here.

CLRN = HI_OK AND LO_OK AND EXT_SUP_OK. Any low latches Q off; rising REARM admits only while CLRN is high. Q=-10k*22n/40*(V_end-V_start); 600nC=109.091mV nominal. Take BASELINE, CATH, ANODE, NET/TAIL endpoints. Cathodic and anodic charges remain separate. Opposed phases can cancel: final net alone cannot qualify delivery. Actual current-tail/window evidence is required. Command edges, the comparator or an ideal16-bit LSB do not certify precision.

ARTIFICIAL LOADS ONLY; native schematic slice, not a completed implant

Sheet: /monitoring-cell/Source0_monitor/
File: channel0.kicad_sch
Title: ATO S4 / Source 0: current and phase charge

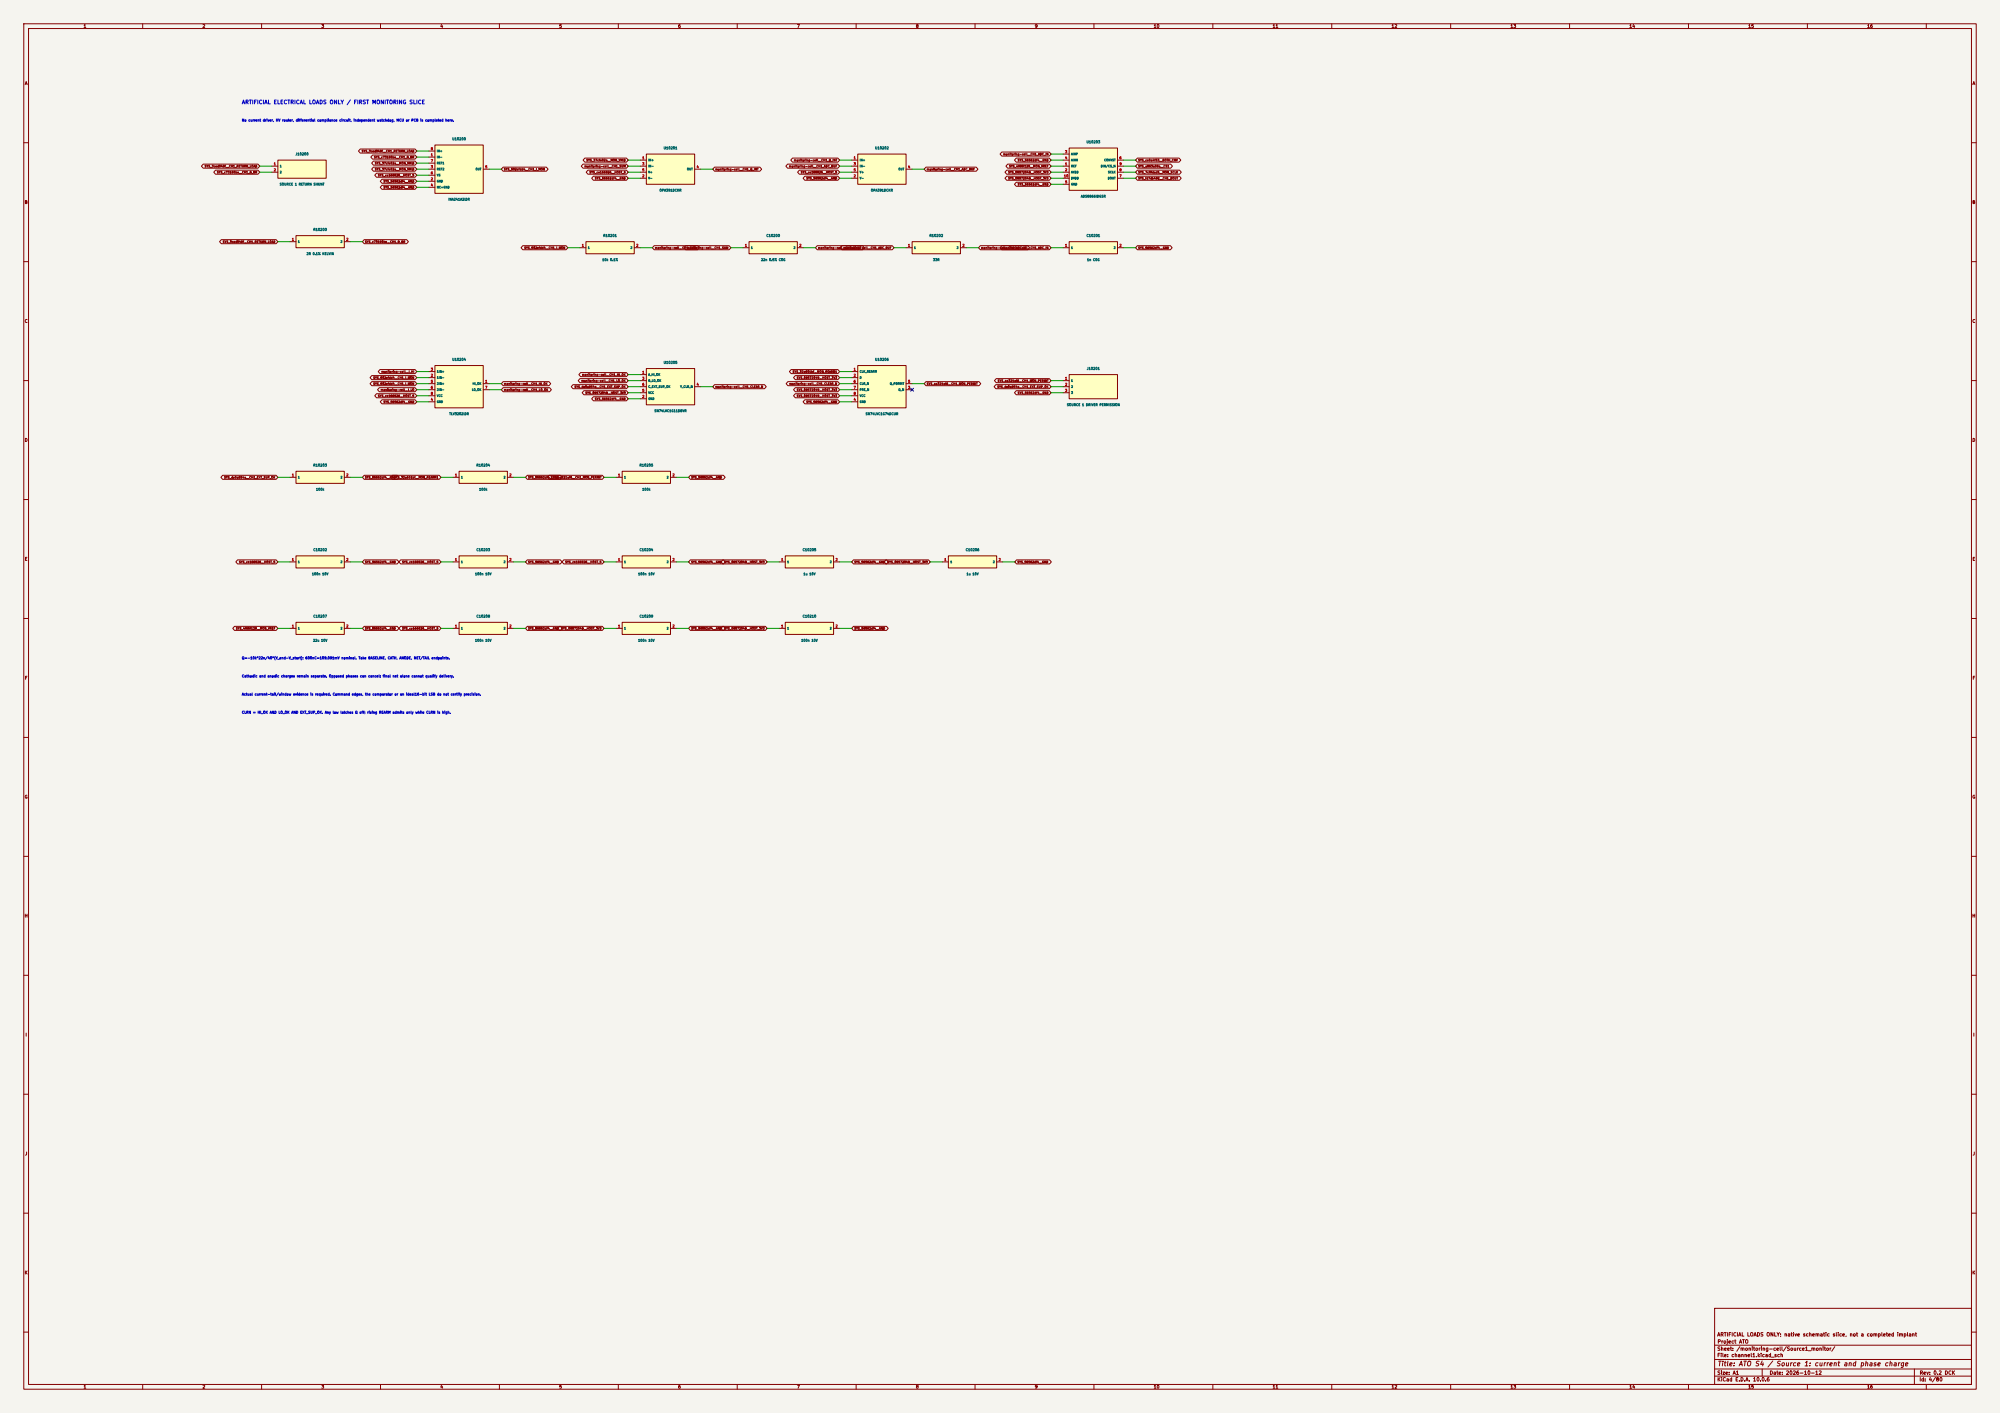
[picture p188: page 4]

SYS_08572049__HOST_3V3 ARTIFICIAL ELECTRICAL LOADS ONLY / FIRST MONITORING SLICE

No current driver, HV router, differential compliance circuit, independent watchdog, MCU or PCB is completed here.

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

ARTIFICIAL LOADS ONLY; native schematic slice, not a completed implant

Sheet: /monitoring-cell/Source1_monitor/
File: channel1.kicad_sch
Title: ATO S4 / Source 1: current and phase charge

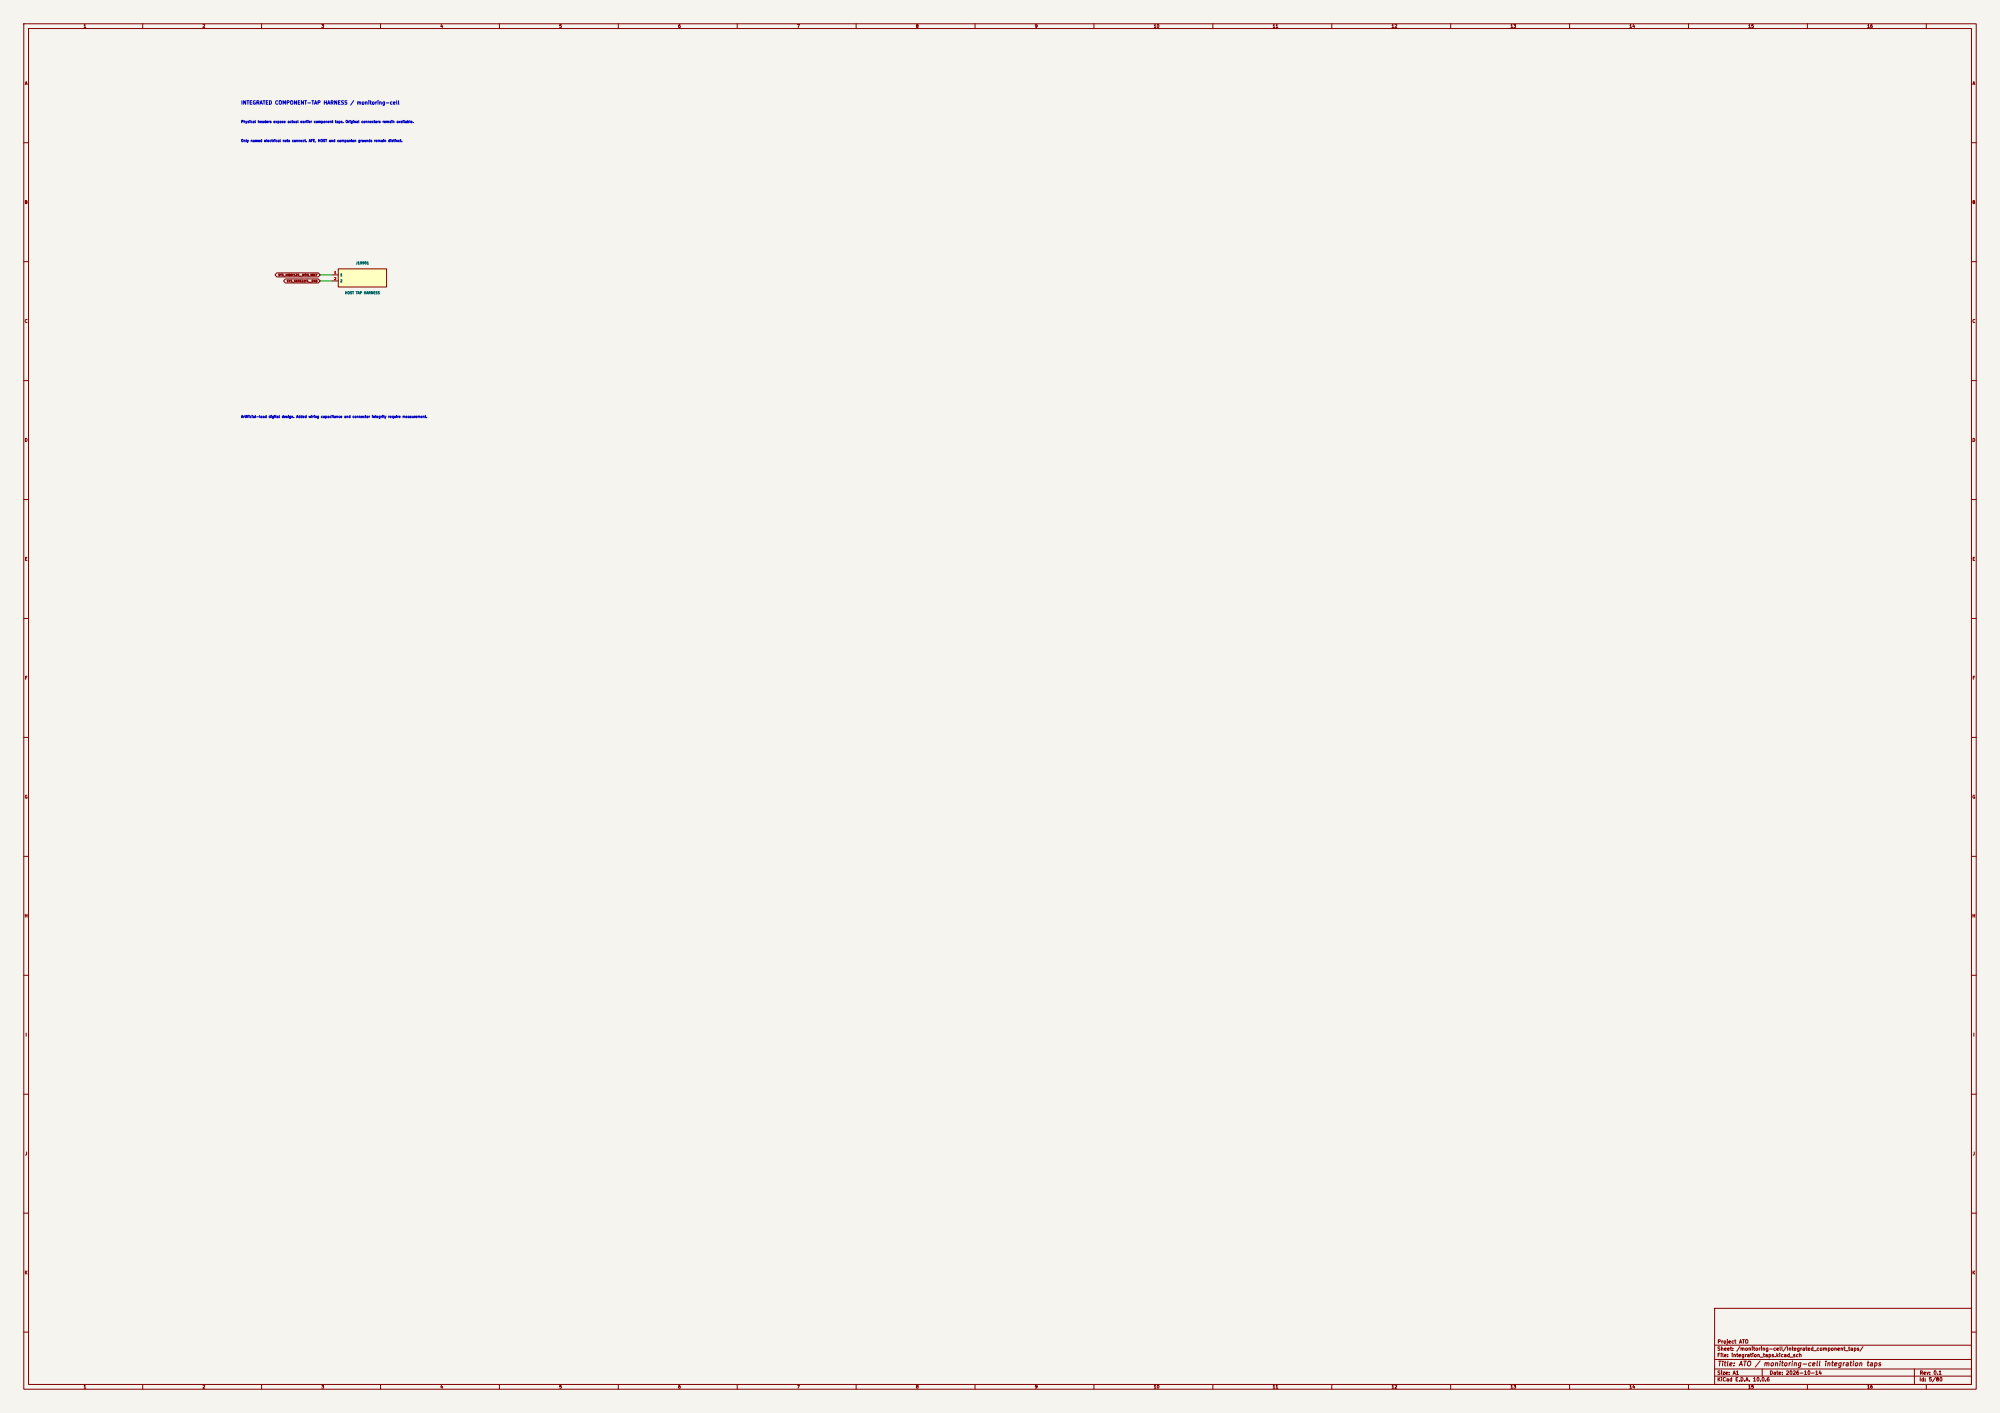
[picture p189: page 5]

INTEGRATED COMPONENT-TAP HARNESS / monitoring-cell Physical headers expose actual earlier component taps. Original connectors remain available. Only named electrical nets connect. AFE, HOST and companion grounds remain distinct.

Artificial-load digital design. Added wiring capacitance and connector integrity require measurement.

Sheet: /monitoring-cell/Integrated_component_taps/
File: integration_taps.kicad_sch
Title: ATO / monitoring-cell integration taps

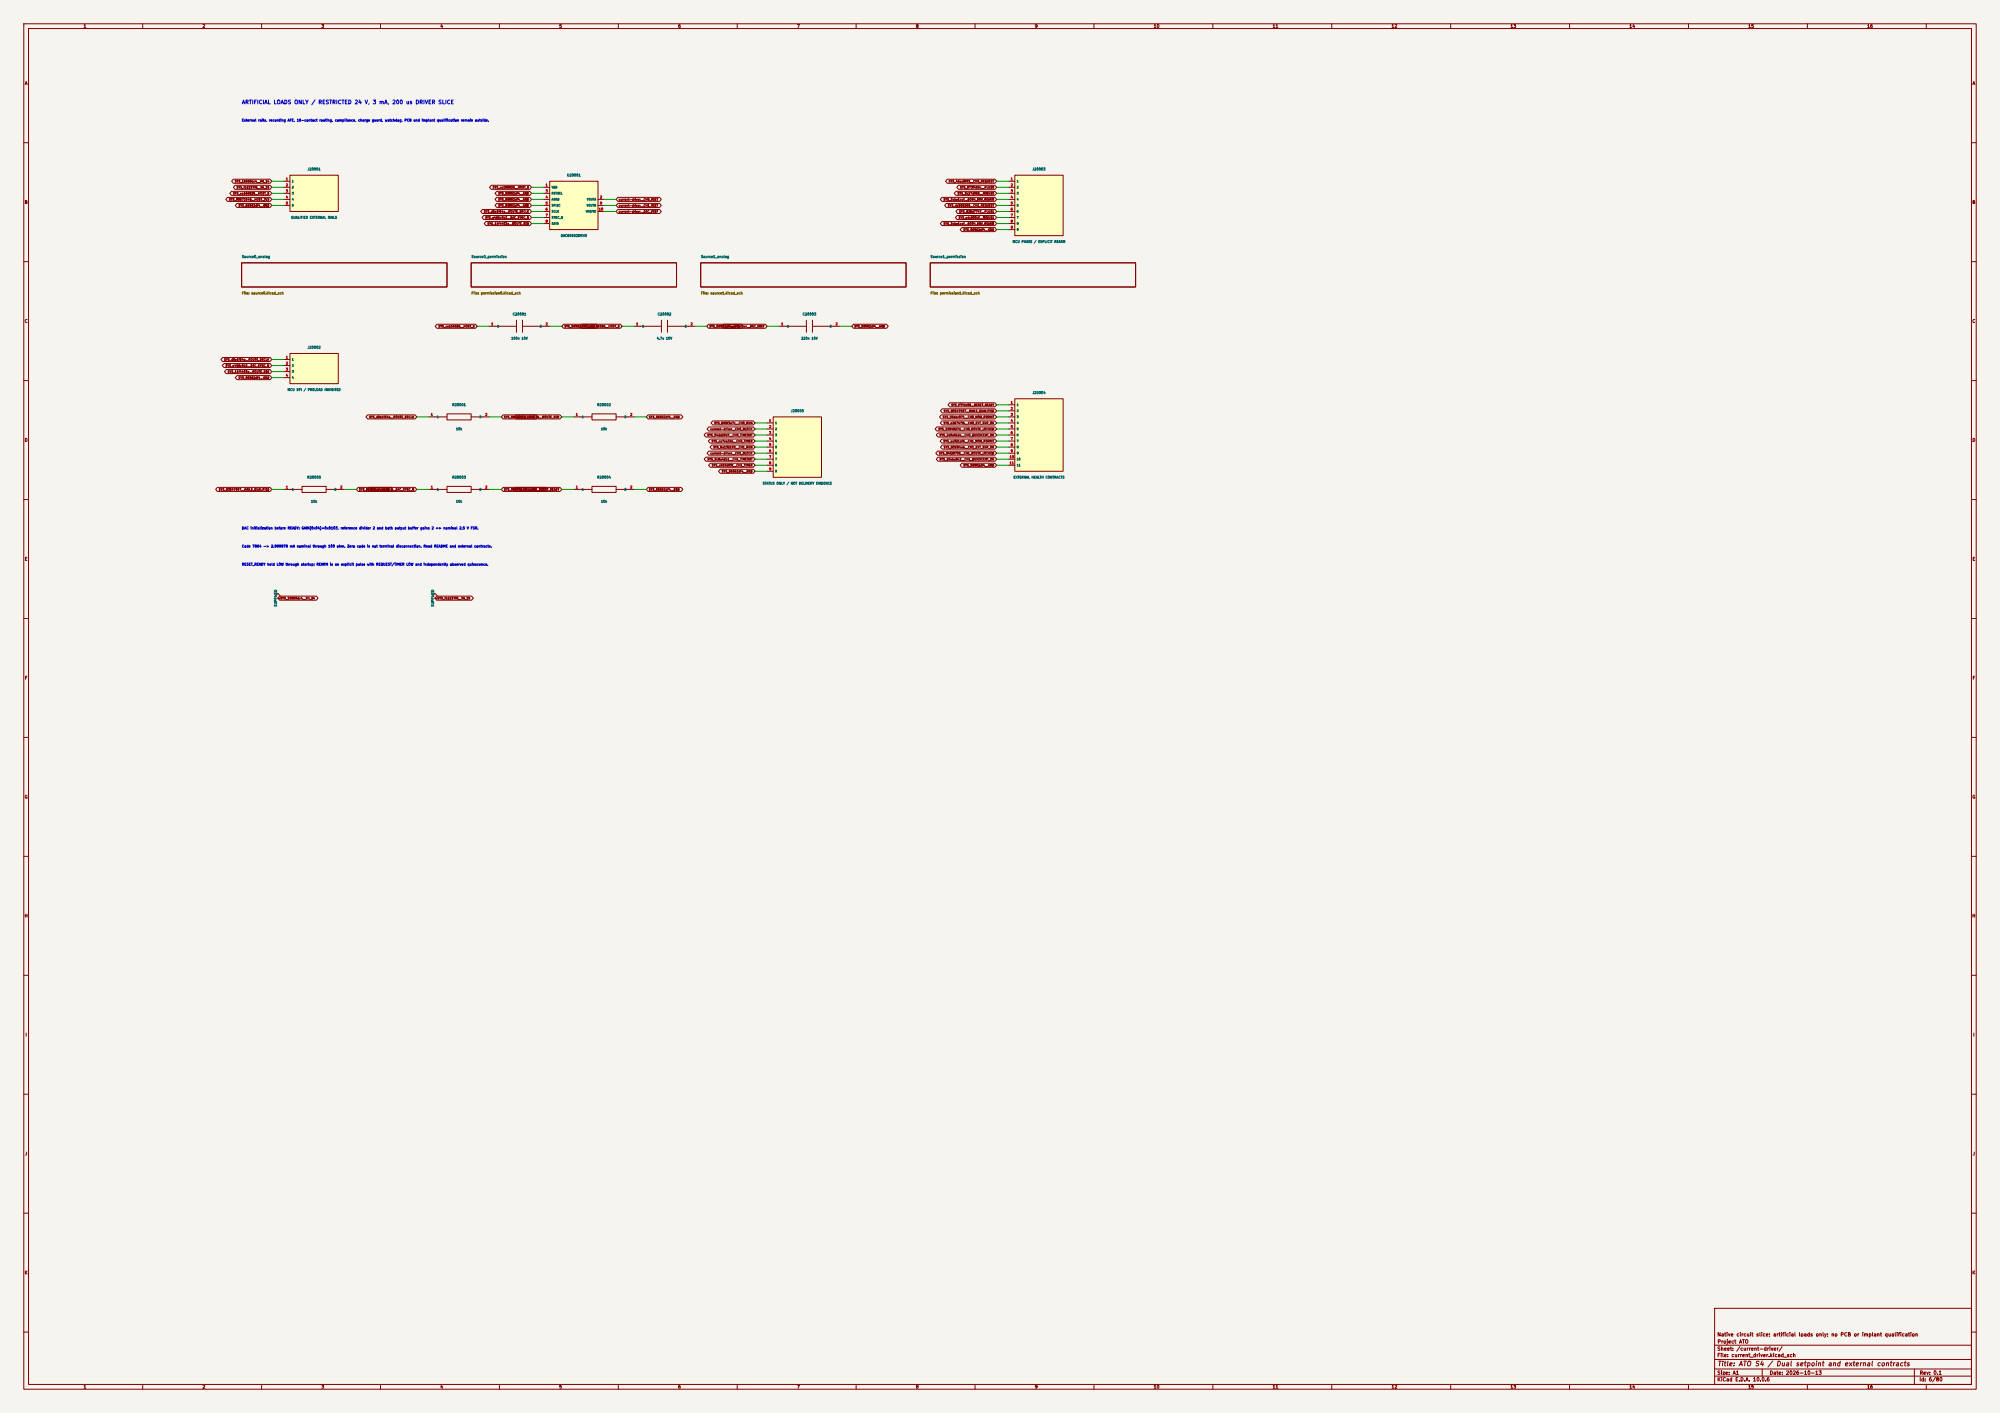
[picture p190: page 6]

ARTIFICIAL LOADS ONLY / RESTRICTED 24 V, 3 mA, 200 us DRIVER SLICE

External rails, recording AFE, 16-contact routing, compliance, charge guard, watchdog, PCB and implant qualification remain outside.

J20003 MCU PHASE / EXPLICIT REARM

J20002 MCU SPI / PRELOAD INHIBITED

STATUS ONLY / NOT DELIVERY EVIDENCE

DAC initialization before READY: GAIN[0x04]=0x0103, reference divider 2 and both output buffer gains 2 => nominal 2.5 V FSR. Code 7864 -> 2.999878 mA nominal through 100 ohm. Zero code is not terminal disconnection. Read README and external contracts. RESET_READY held LOW through startup; REARM is an explicit pulse with REQUEST/TIMER LOW and independently observed quiescence.

Native circuit slice; artificial loads only; no PCB or implant qualification

Sheet: /current-driver/
File: current_driver.kicad_sch
Title: ATO S4 / Dual setpoint and external contracts

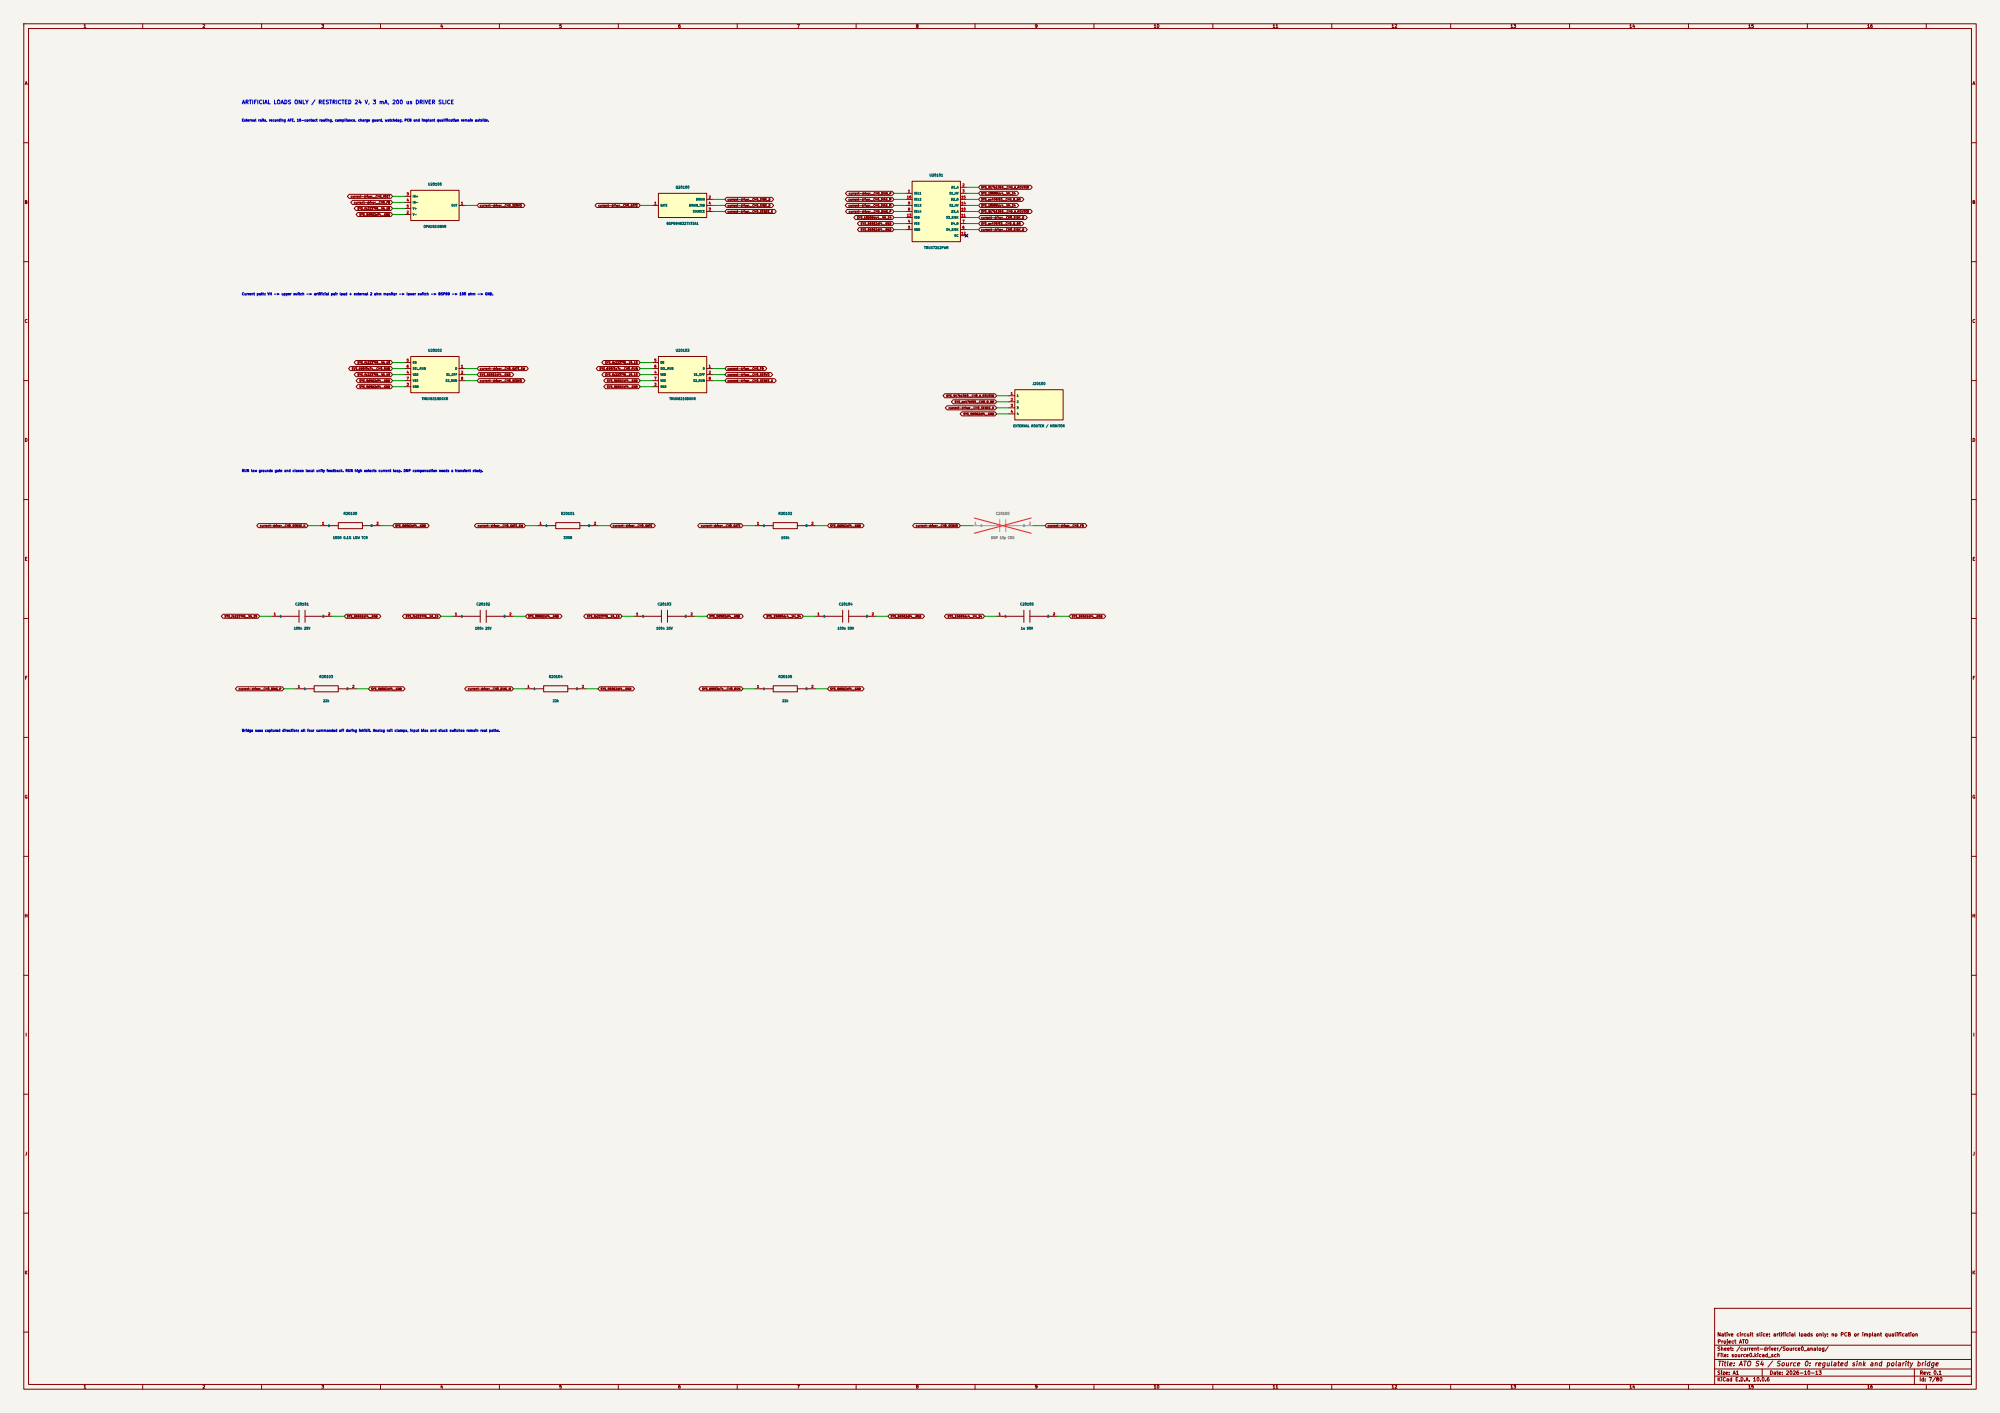
[picture p191: page 7]

ARTIFICIAL LOADS ONLY / RESTRICTED 24 V, 3 mA, 200 us DRIVER SLICE

External rails, recording AFE, 16-contact routing, compliance, charge guard, watchdog, PCB and implant qualification remain outside. Current path: VH -> upper switch -> artificial pair load + external 2 ohm monitor -> lower switch -> BSP89 -> 100 ohm -> GND. RUN low grounds gate and closes local unity feedback. RUN high selects current loop. DNP compensation needs a transient study.

Bridge uses captured direction; all four commanded off during inhibit. Analog rail clamps, input bias and stuck switches remain real paths.

Native circuit slice; artificial loads only; no PCB or implant qualification

Sheet: /current-driver/Source0_analog/
File: source0.kicad_sch
Title: ATO S4 / Source 0: regulated sink and polarity bridge

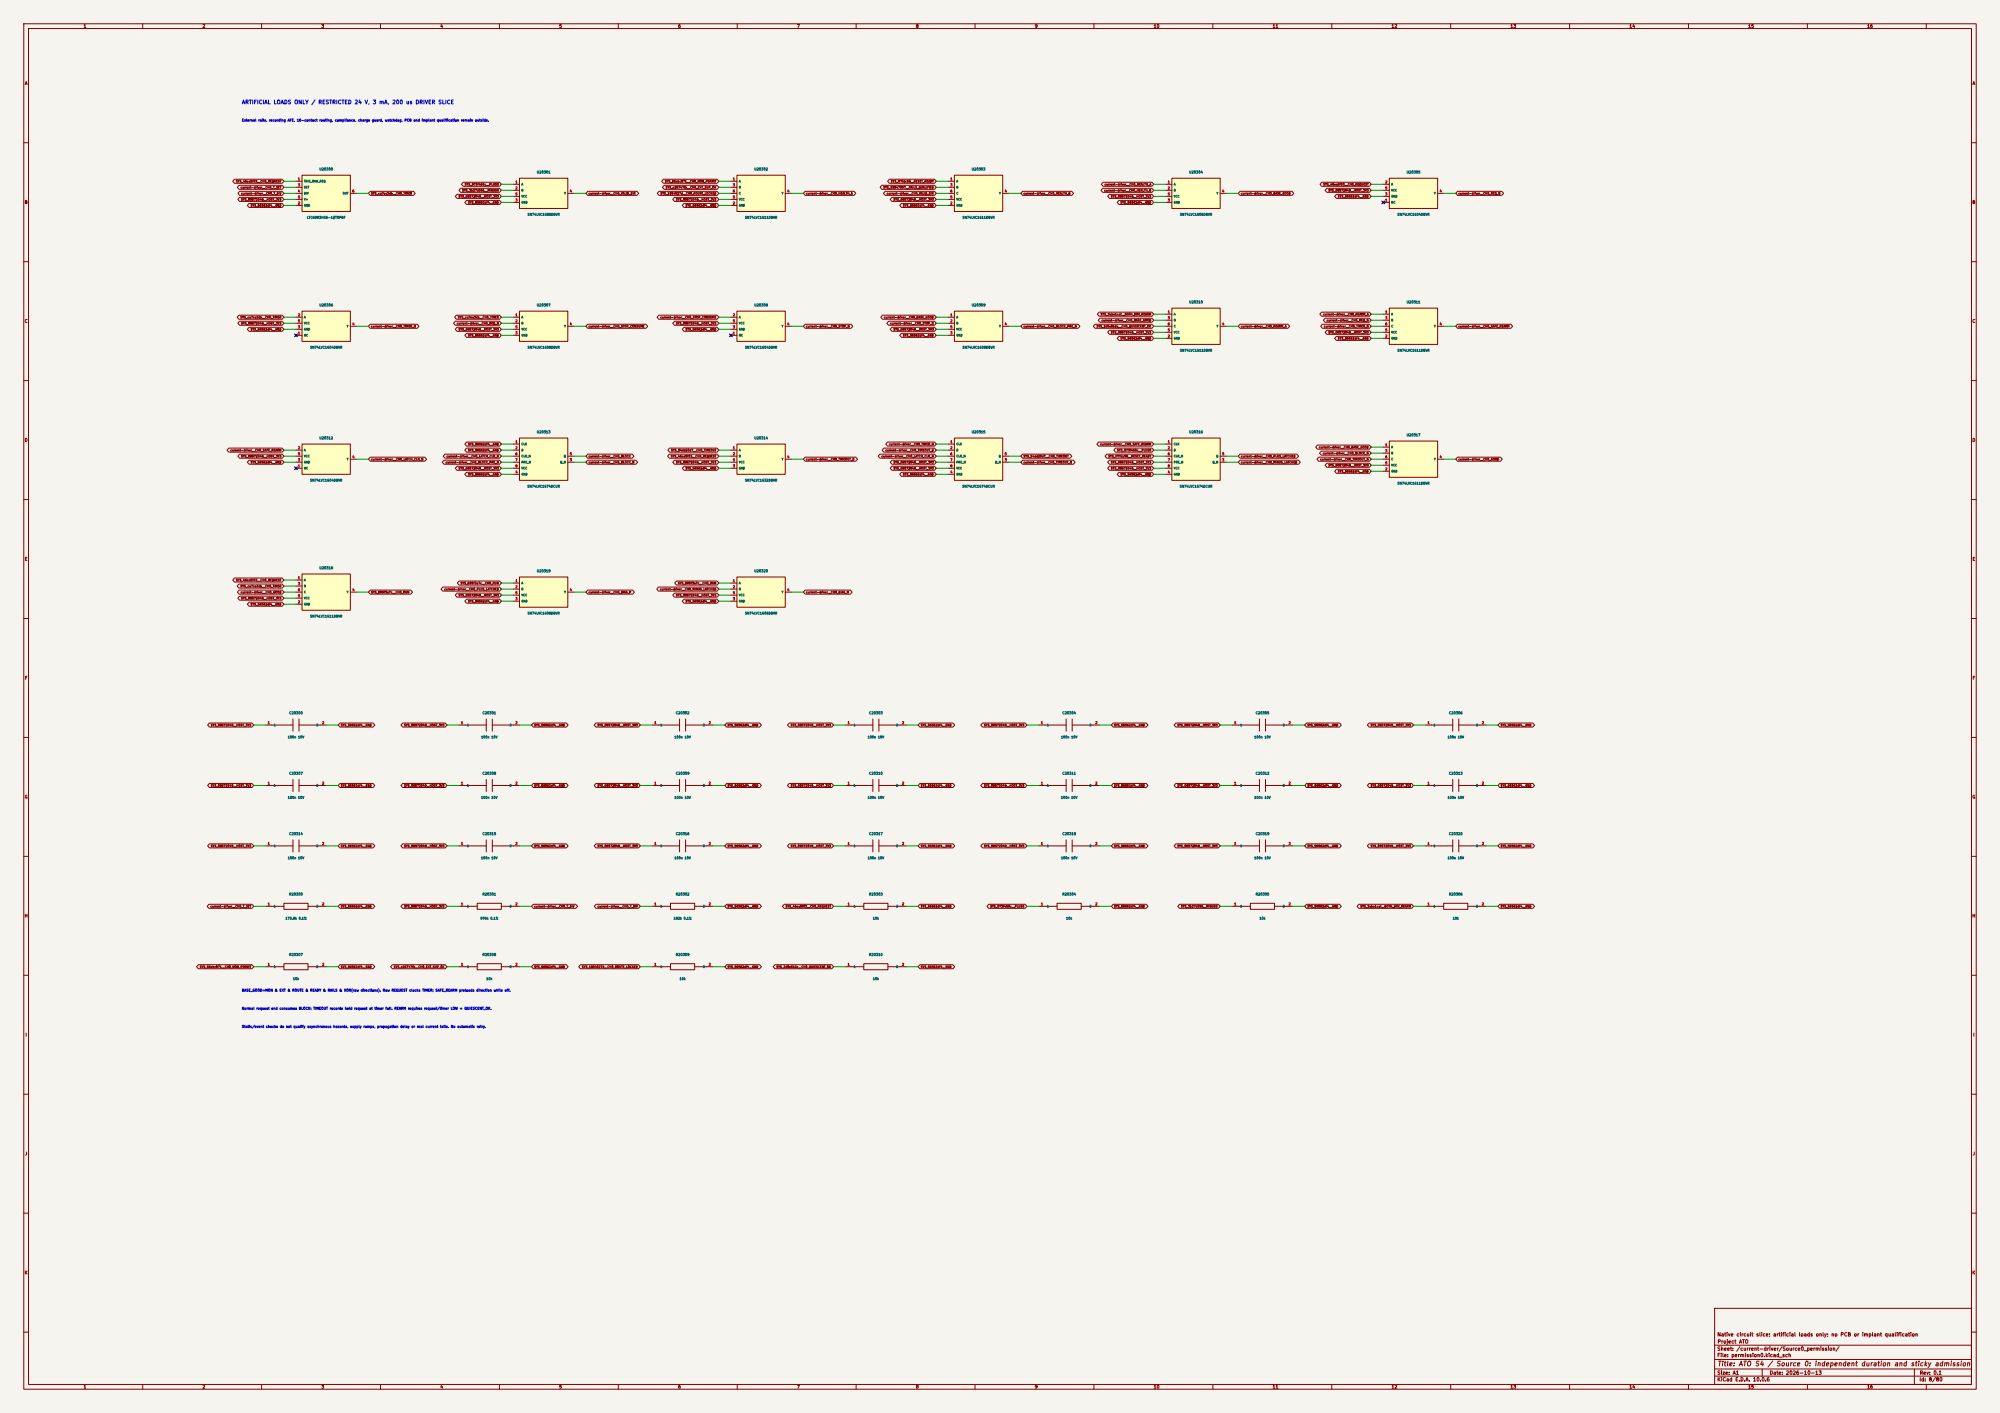
[picture p192: page 8]

ARTIFICIAL LOADS ONLY / RESTRICTED 24 V, 3 mA, 200 us DRIVER SLICE

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

BASE_GOOD=MON & EXT & ROUTE & READY & RAILS & XOR(raw directions). Raw REQUEST clocks TIMER; SAFE_REARM preloads direction while off.

Normal request end consumes BLOCK; TIMEOUT records held request at timer fall. REARM requires request/timer LOW + QUIESCENT_OK. Static/event checks do not qualify asynchronous hazards, supply ramps, propagation delay or real current tails. No automatic retry.

Native circuit slice; artificial loads only; no PCB or implant qualification

Sheet: /current-driver/Source0_permission/
File: permission0.kicad_sch
Title: ATO S4 / Source 0: independent duration and sticky admission

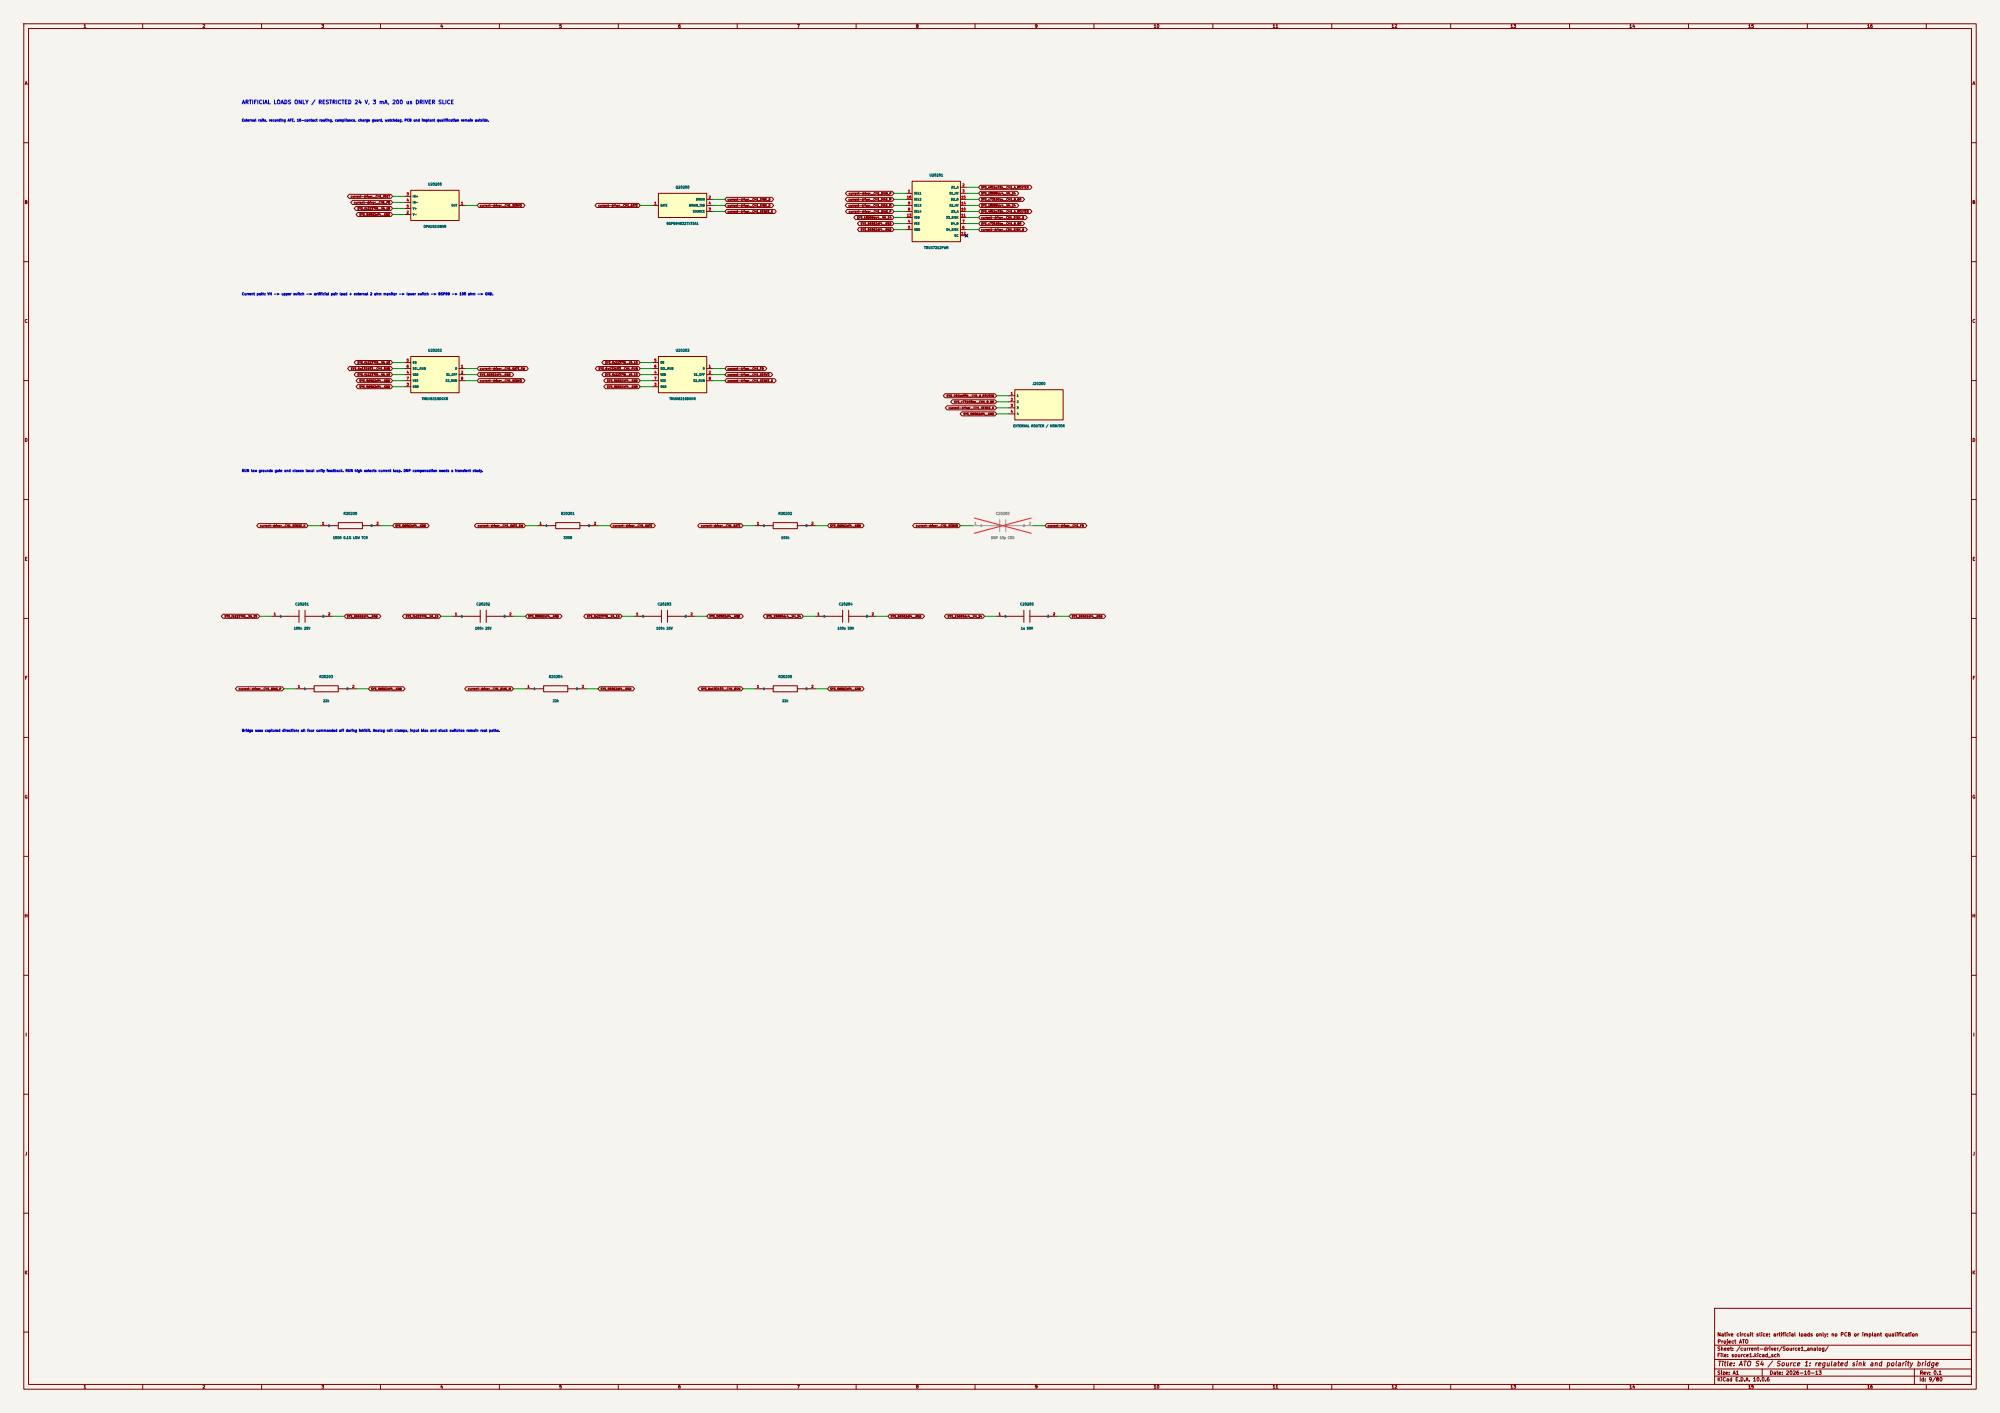
[picture p193: page 9]

ARTIFICIAL LOADS ONLY / RESTRICTED 24 V, 3 mA, 200 us DRIVER SLICE

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

Native circuit slice; artificial loads only; no PCB or implant qualification

Sheet: /current-driver/Source1_analog/
File: source1.kicad_sch
Title: ATO S4 / Source 1: regulated sink and polarity bridge

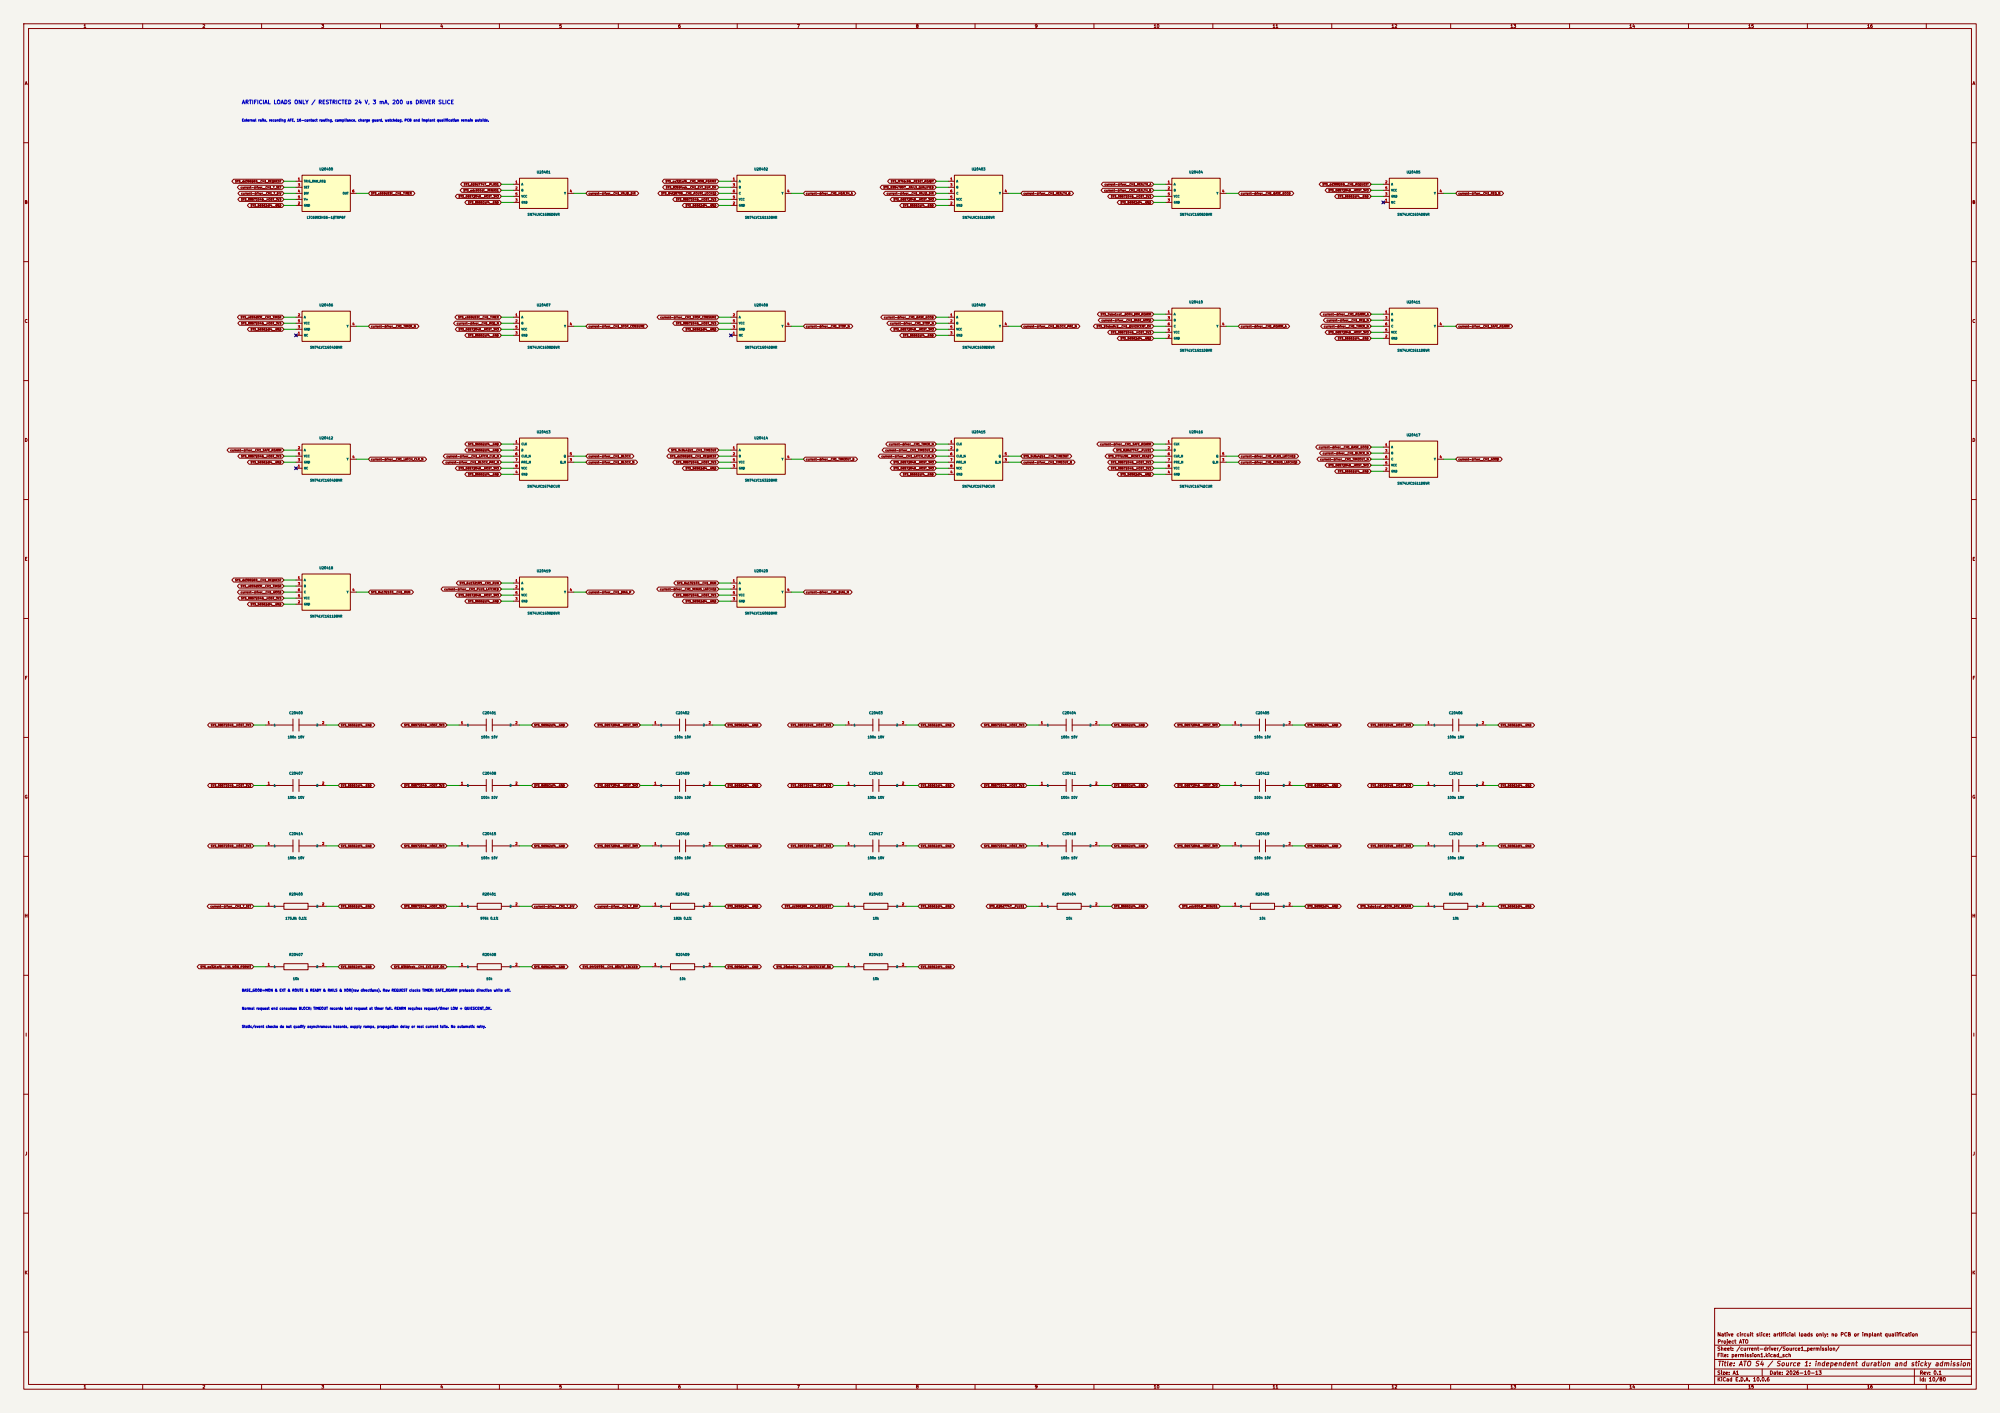
[picture p194: page 10]

ARTIFICIAL LOADS ONLY / RESTRICTED 24 V, 3 mA, 200 us DRIVER SLICE

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

Native circuit slice; artificial loads only; no PCB or implant qualification

Sheet: /current-driver/Source1_permission/
File: permission1.kicad_sch
Title: ATO S4 / Source 1: independent duration and sticky admission

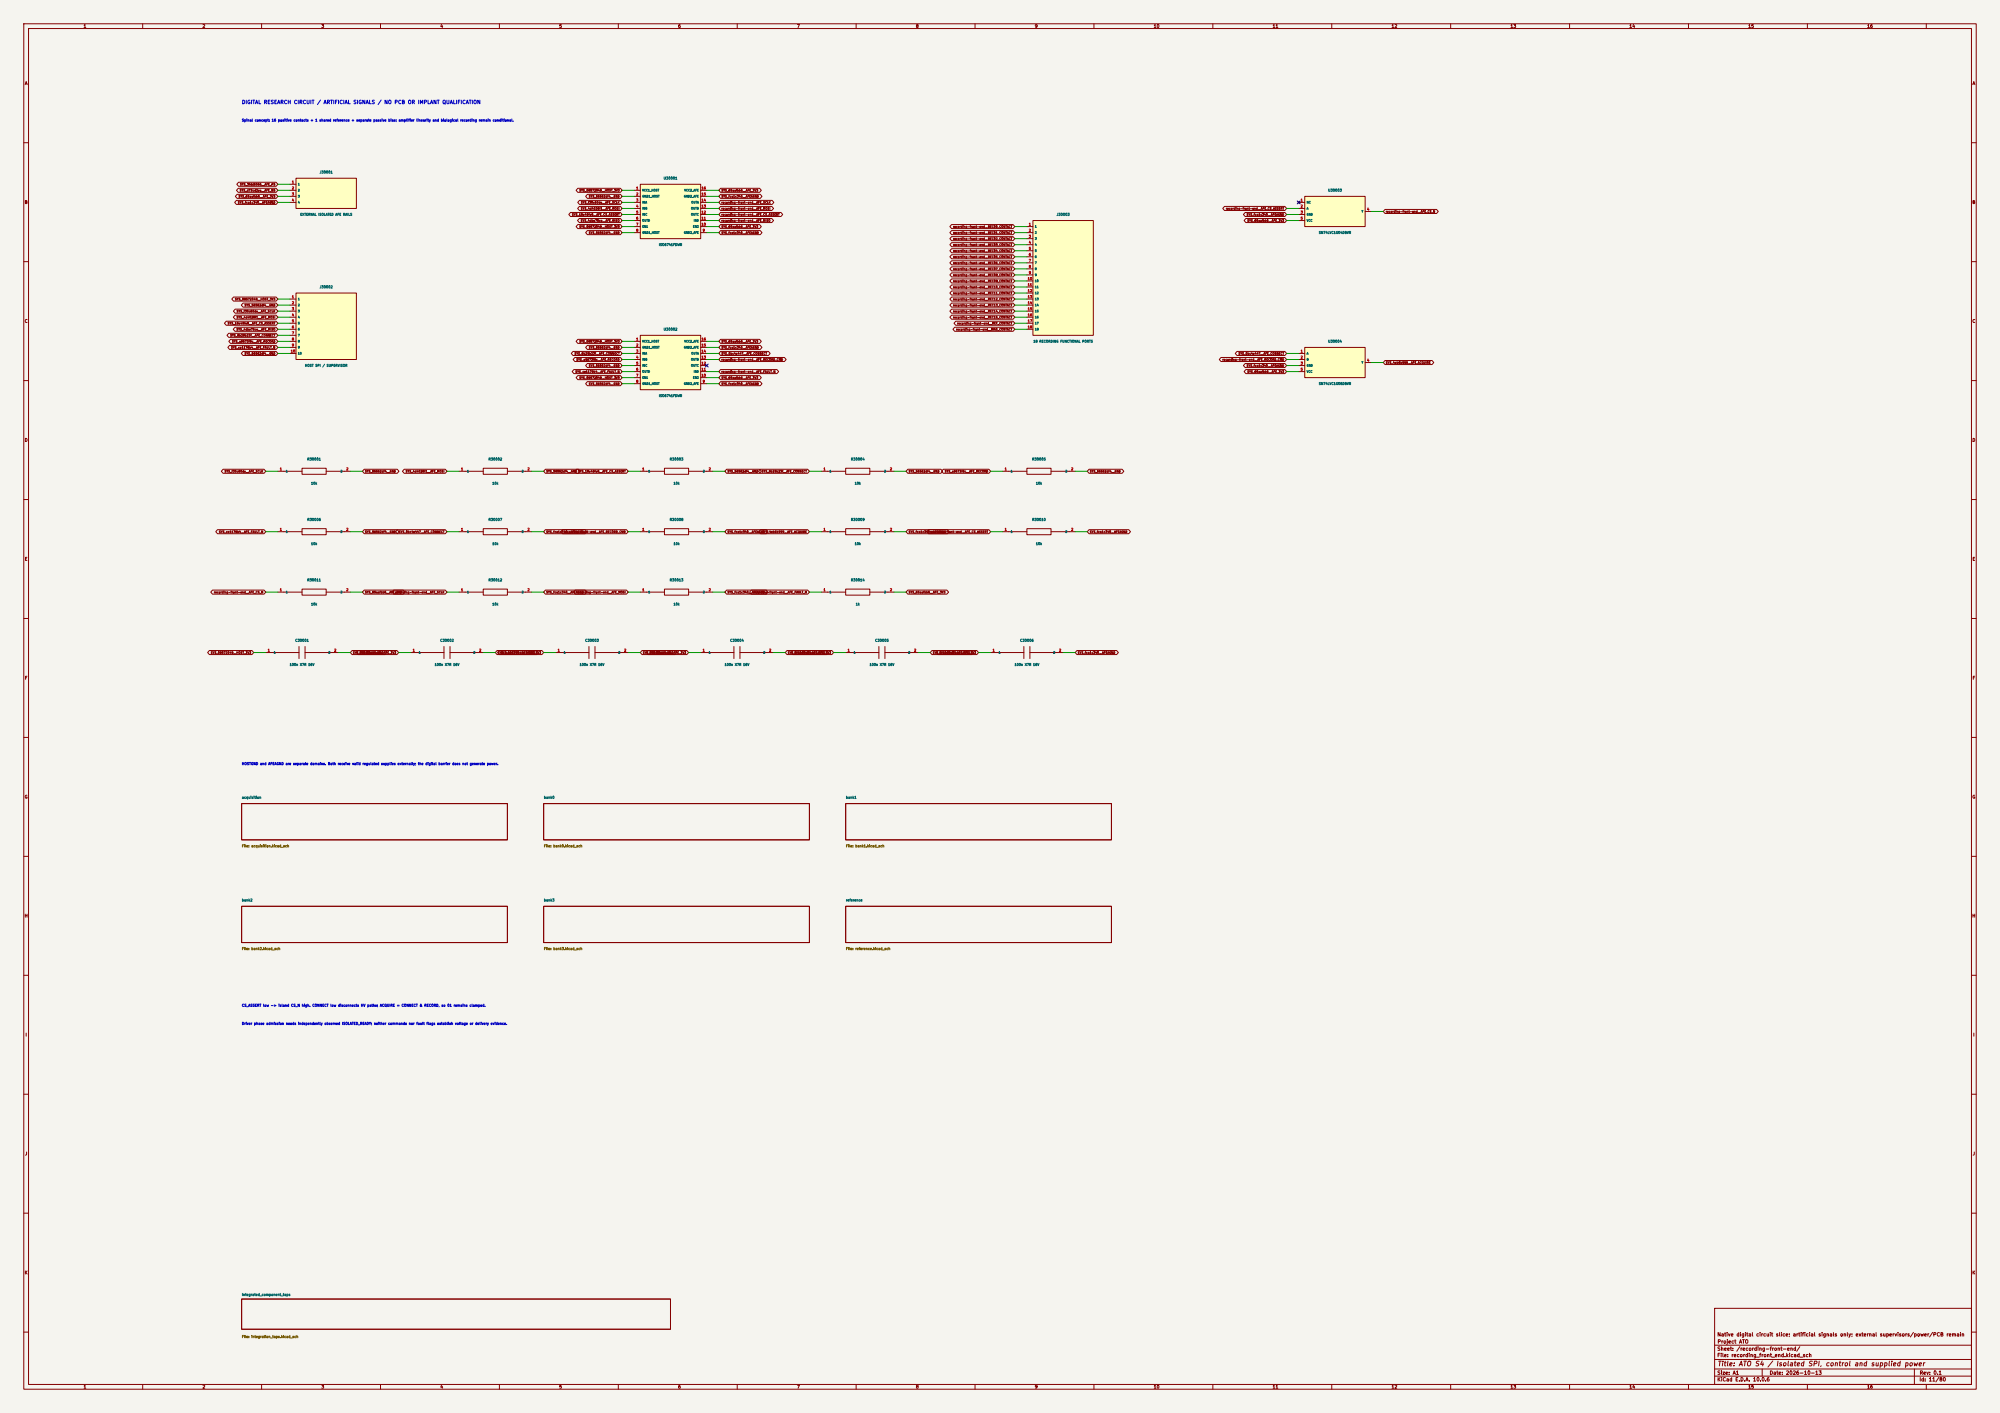
[picture p195: page 11]

SYS_08572049__HOST_3V3 DIGITAL RESEARCH CIRCUIT / ARTIFICIAL SIGNALS / NO PCB OR IMPLANT QUALIFICATION

Spinal concept: 16 positive contacts + 1 shared reference + separate passive bias; amplifier linearity and biological recording remain conditional.

recording-front-end__AFE_MOSI recording-front-end__AFE_CS_ASSERT

EXTERNAL ISOLATED AFE RAILS

HOSTGND and AFEAGND are separate domains. Both receive valid regulated supplies externally; the digital barrier does not generate power. CS_ASSERT low -> island CS_N high. CONNECT low disconnects HV paths; ACQUIRE = CONNECT & RECORD, so 01 remains clamped. Driver phase admission needs independently observed ISOLATED_READY; neither commands nor fault flags establish voltage or delivery evidence.

Native digital circuit slice; artificial signals only; external supervisors/power/PCB remain

Sheet: /recording-front-end/
File: recording_front_end.kicad_sch
Title: ATO S4 / Isolated SPI, control and supplied power

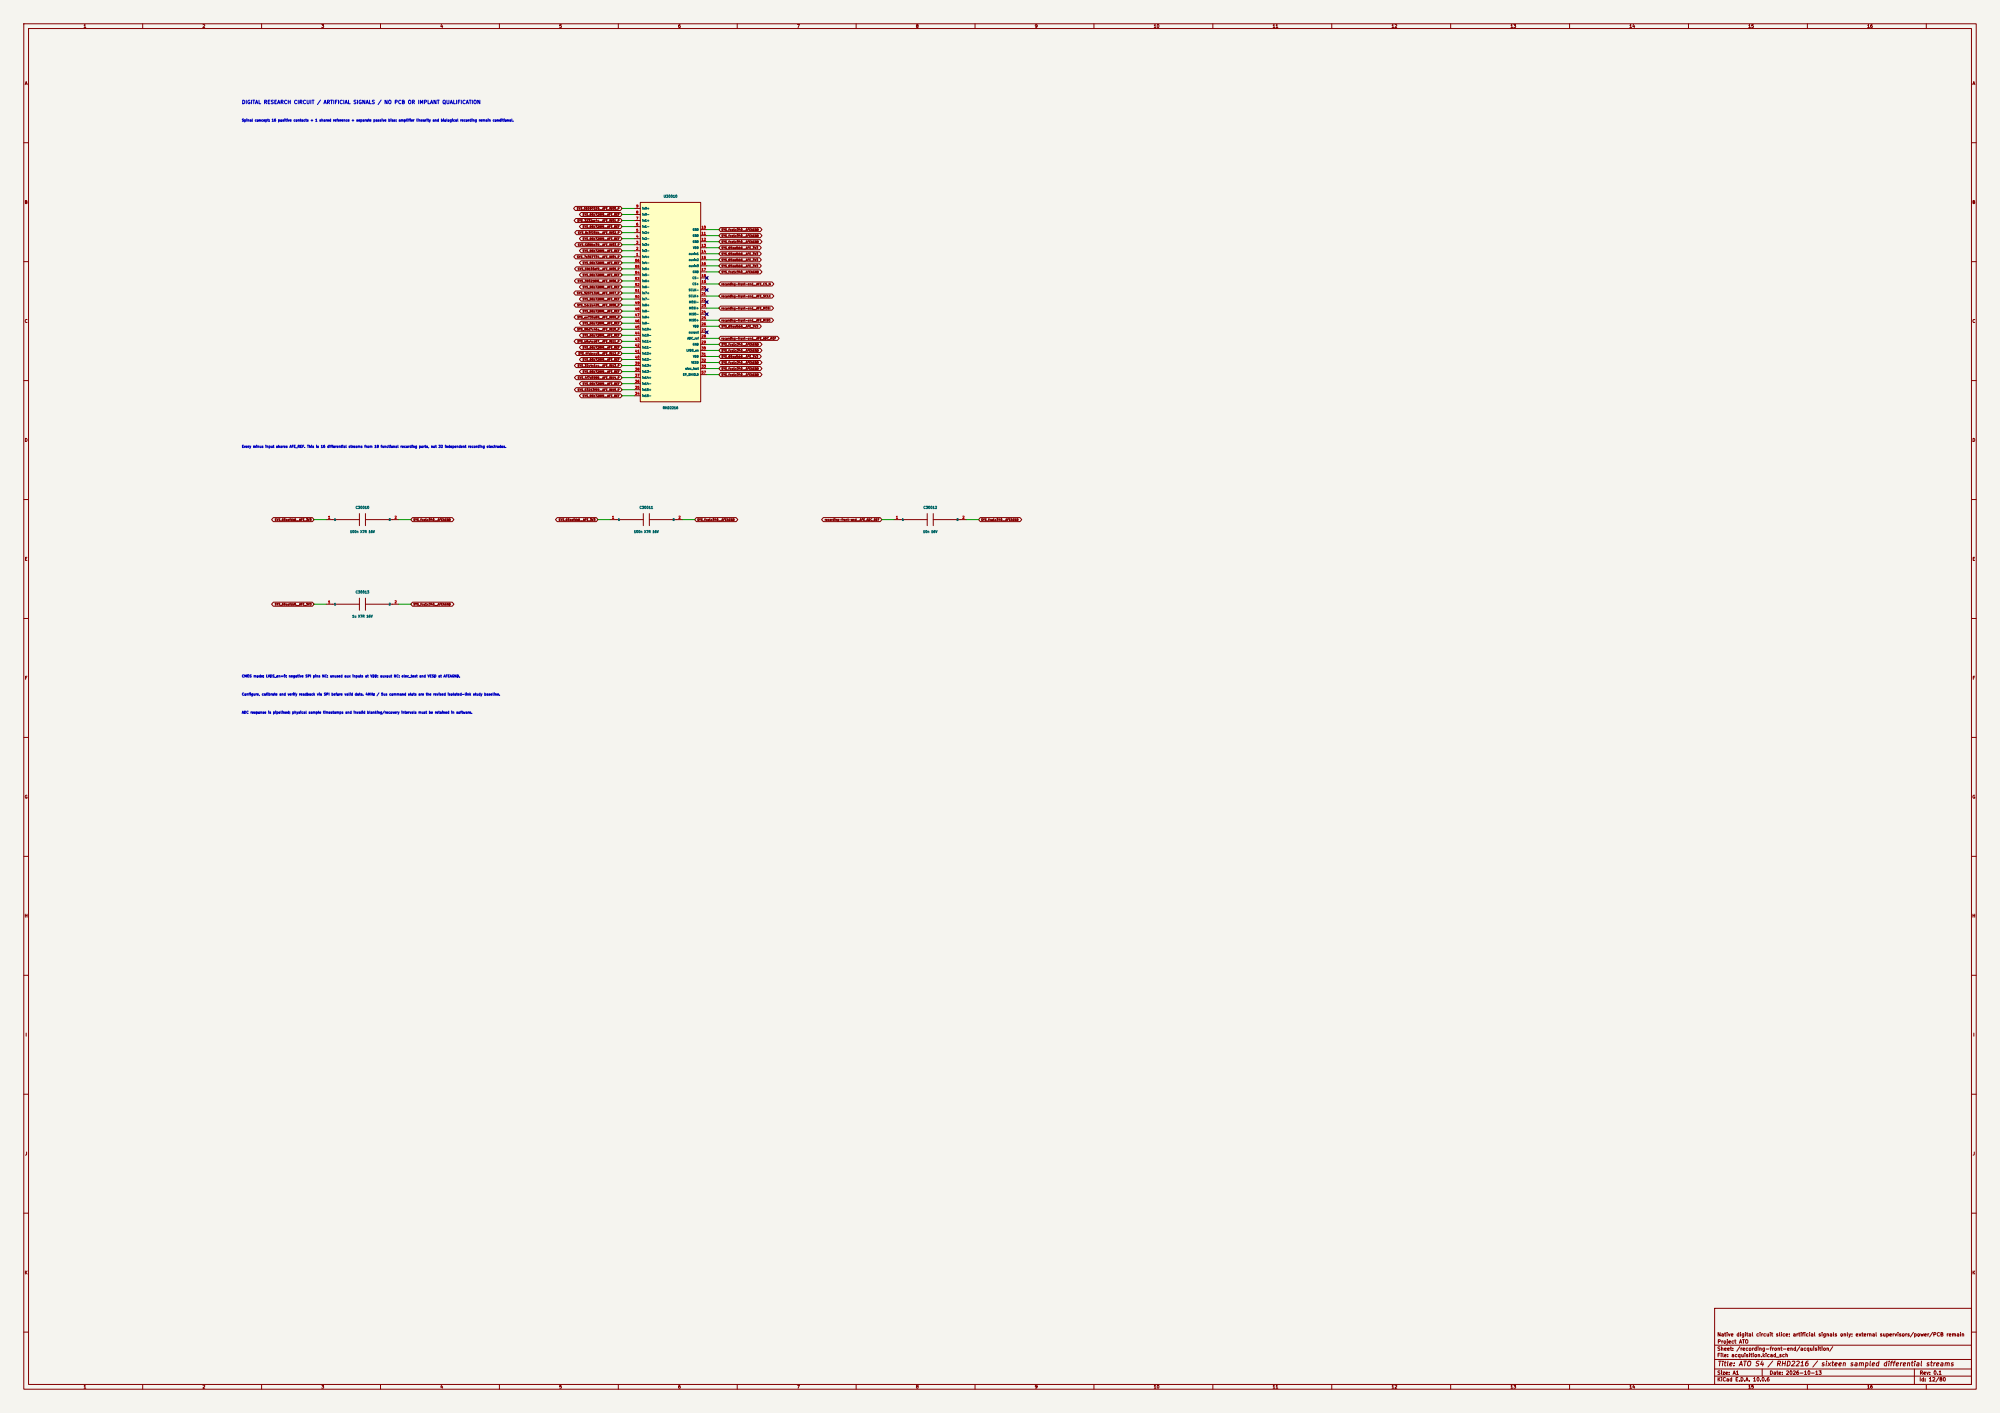
[picture p196: page 12]

Spinal concept: 16 positive contacts + 1 shared reference + separate passive bias; amplifier linearity and biological recording remain conditional. DIGITAL RESEARCH CIRCUIT / ARTIFICIAL SIGNALS / NO PCB OR IMPLANT QUALIFICATION

recording-front-end__AFE_MOSI recording-front-end__AFE_MISO

Every minus input shares AFE_REF. This is 16 differential streams from 18 functional recording ports, not 32 independent recording electrodes. Configure, calibrate and verify readback via SPI before valid data. 4MHz / 5us command slots are the revised isolated-link study baseline.

ADC response is pipelined; physical sample timestamps and invalid blanking/recovery intervals must be retained in software. CMOS mode: LVDS_en=0; negative SPI pins NC; unused aux inputs at VDD; auxout NC; elec_test and VESD at AFEAGND.

Native digital circuit slice; artificial signals only; external supervisors/power/PCB remain

Sheet: /recording-front-end/acquisition/
File: acquisition.kicad_sch
Title: ATO S4 / RHD2216 / sixteen sampled differential streams

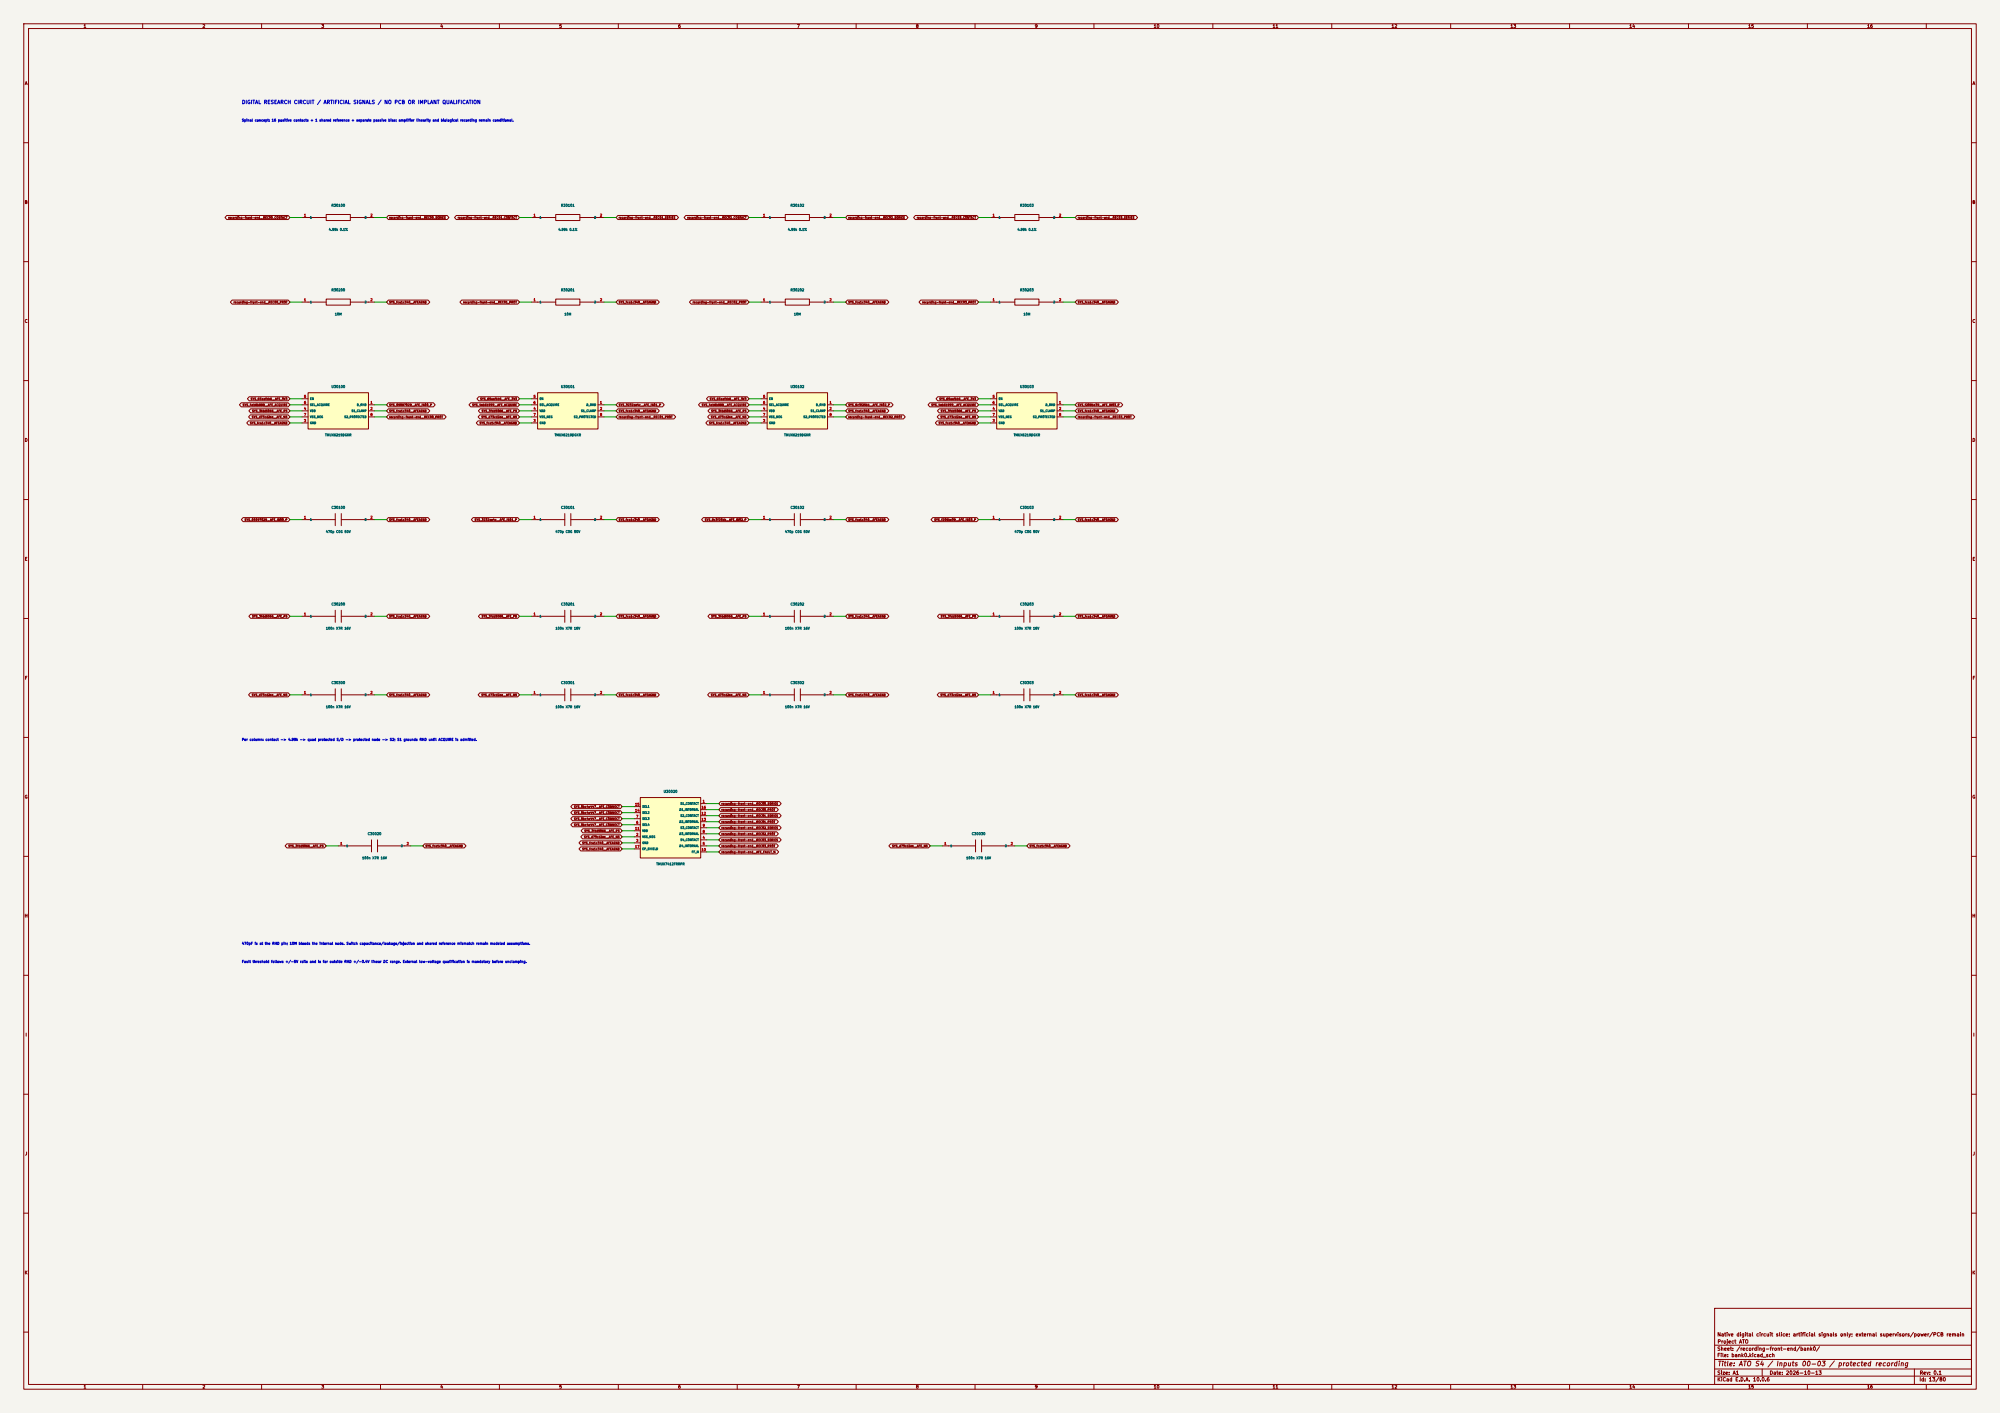
[picture p197: page 13]

DIGITAL RESEARCH CIRCUIT / ARTIFICIAL SIGNALS / NO PCB OR IMPLANT QUALIFICATION

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

Per column: contact -> 4.99k -> quad protected S/D -> protected node -> S2; S1 grounds RHD until ACQUIRE is admitted.

Fault threshold follows +/-5V rails and is far outside RHD +/-0.4V linear DC range. External low-voltage qualification is mandatory before unclamping. 470pF is at the RHD pin; 10M bleeds the internal node. Switch capacitance/leakage/injection and shared reference mismatch remain modeled assumptions.

Native digital circuit slice; artificial signals only; external supervisors/power/PCB remain

Sheet: /recording-front-end/bank0/
File: bank0.kicad_sch
Title: ATO S4 / Inputs 00-03 / protected recording

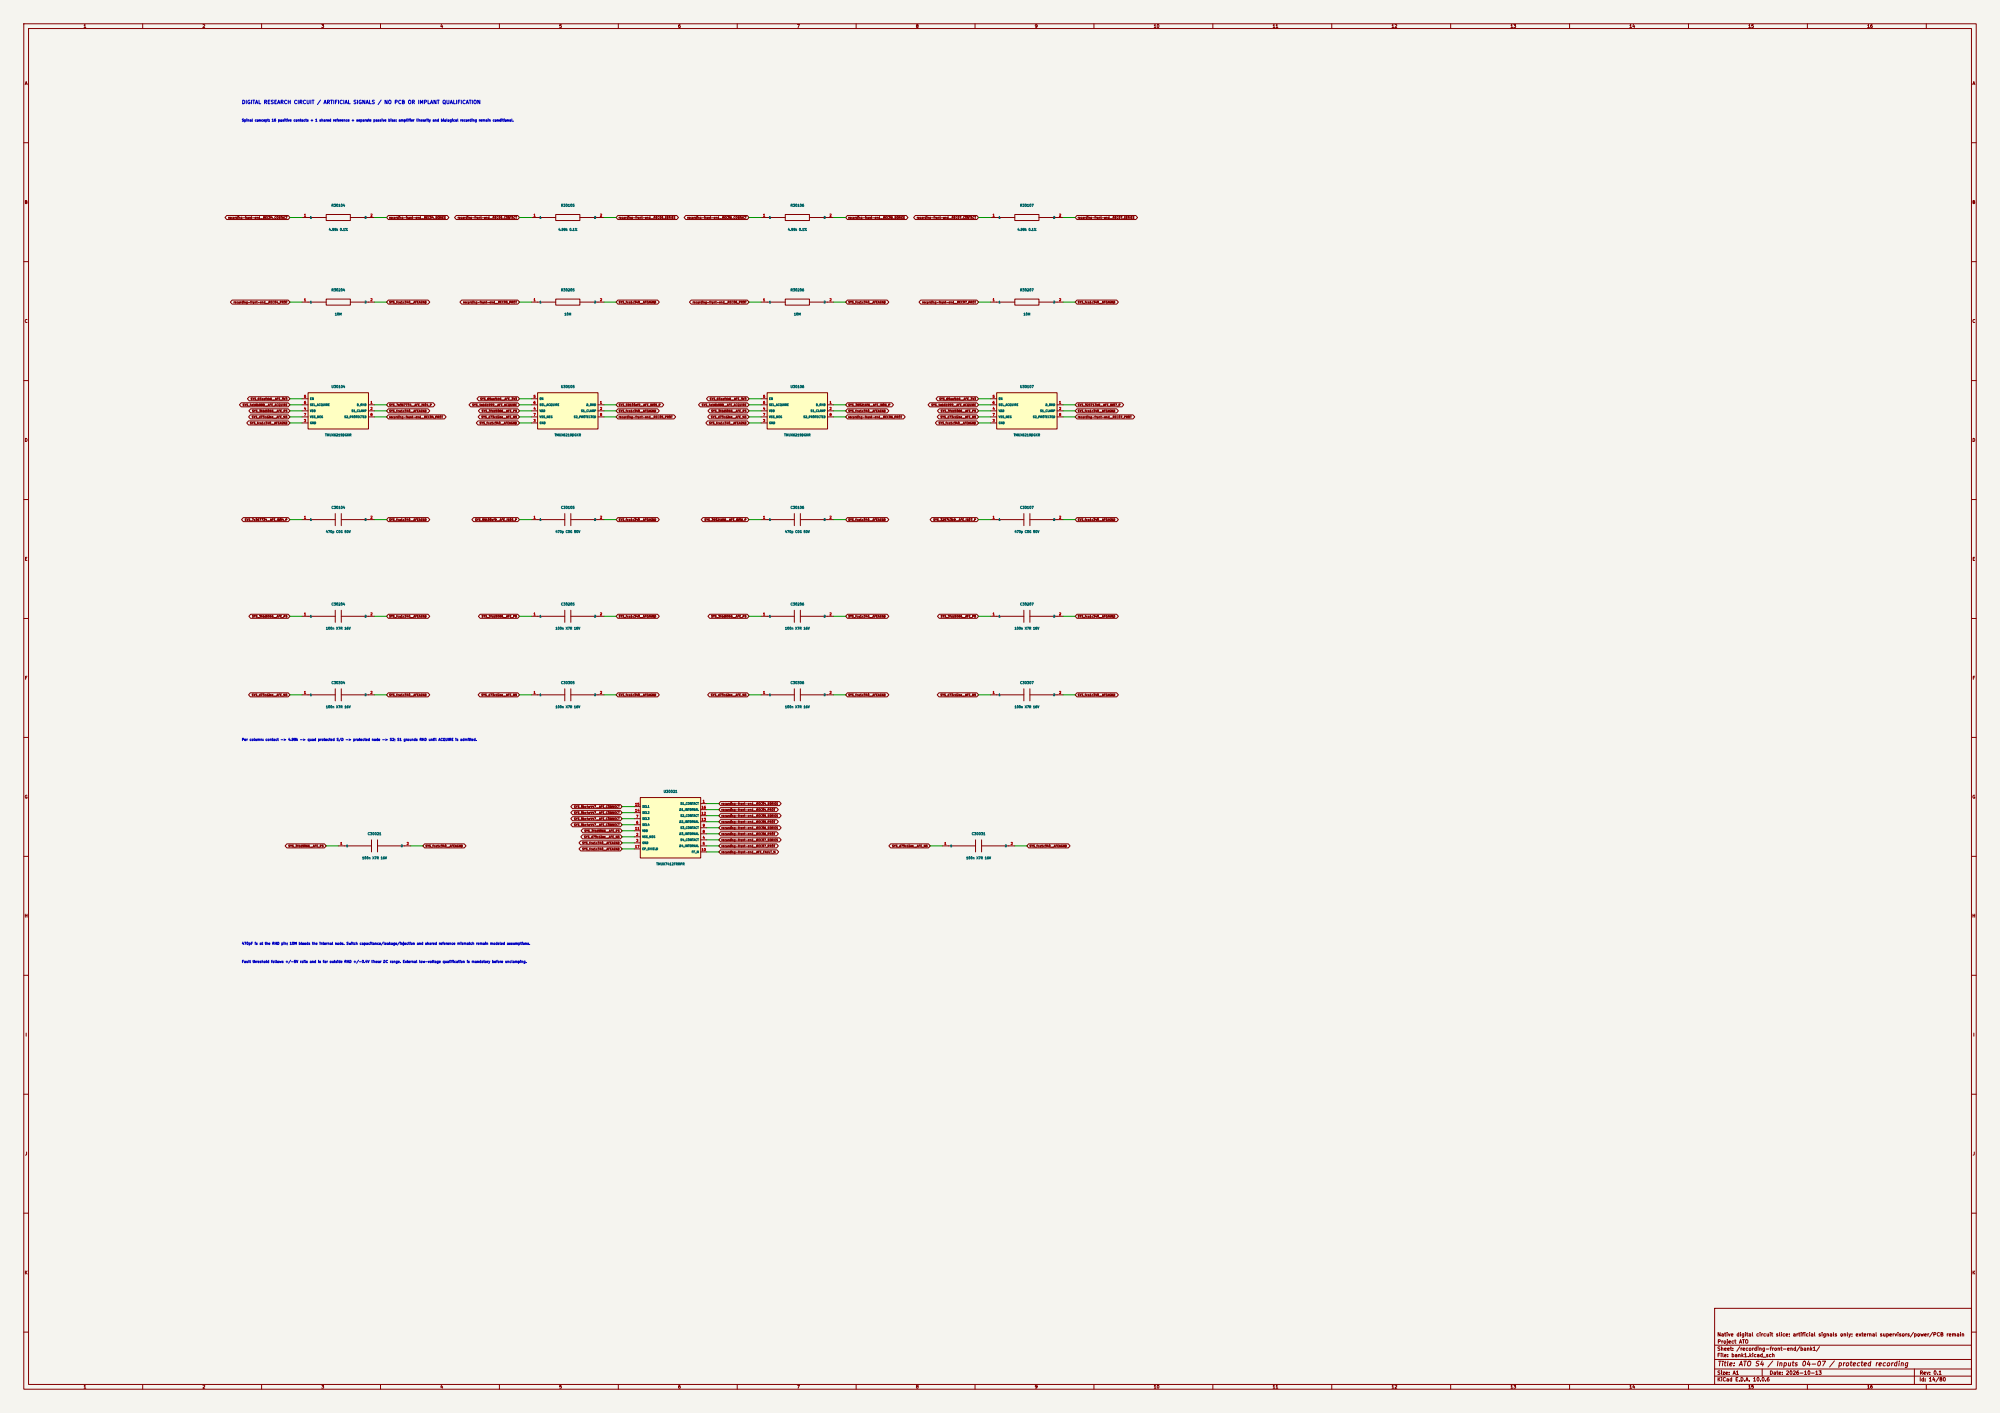
[picture p198: page 14]

DIGITAL RESEARCH CIRCUIT / ARTIFICIAL SIGNALS / NO PCB OR IMPLANT QUALIFICATION

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

Native digital circuit slice; artificial signals only; external supervisors/power/PCB remain

Sheet: /recording-front-end/bank1/
File: bank1.kicad_sch
Title: ATO S4 / Inputs 04-07 / protected recording

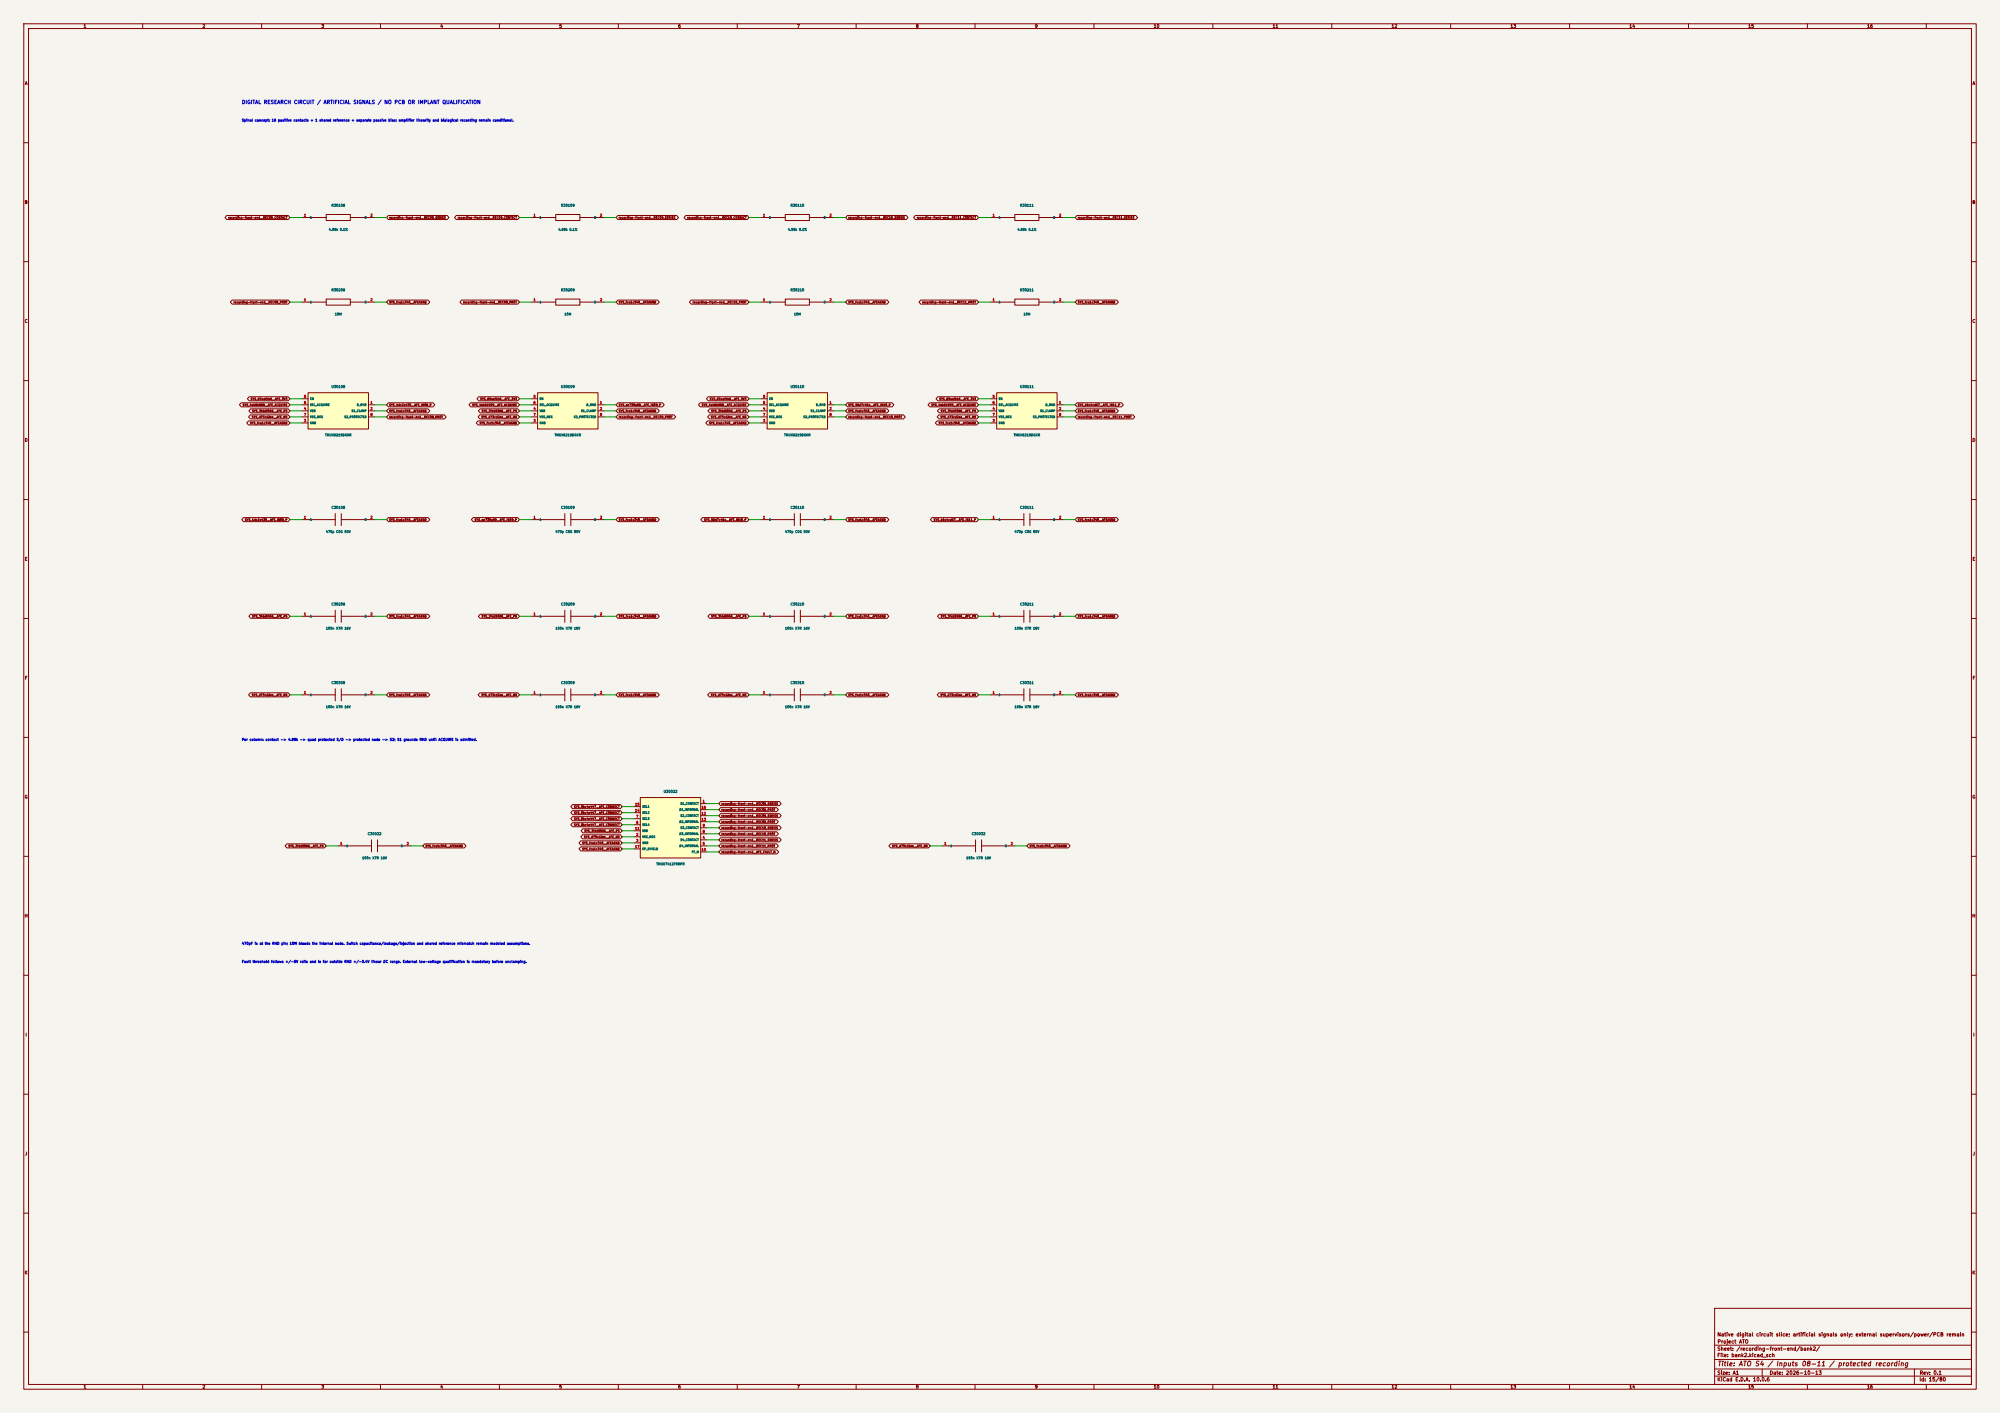
[picture p199: page 15]

DIGITAL RESEARCH CIRCUIT / ARTIFICIAL SIGNALS / NO PCB OR IMPLANT QUALIFICATION

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

Native digital circuit slice; artificial signals only; external supervisors/power/PCB remain

Sheet: /recording-front-end/bank2/
File: bank2.kicad_sch
Title: ATO S4 / Inputs 08-11 / protected recording

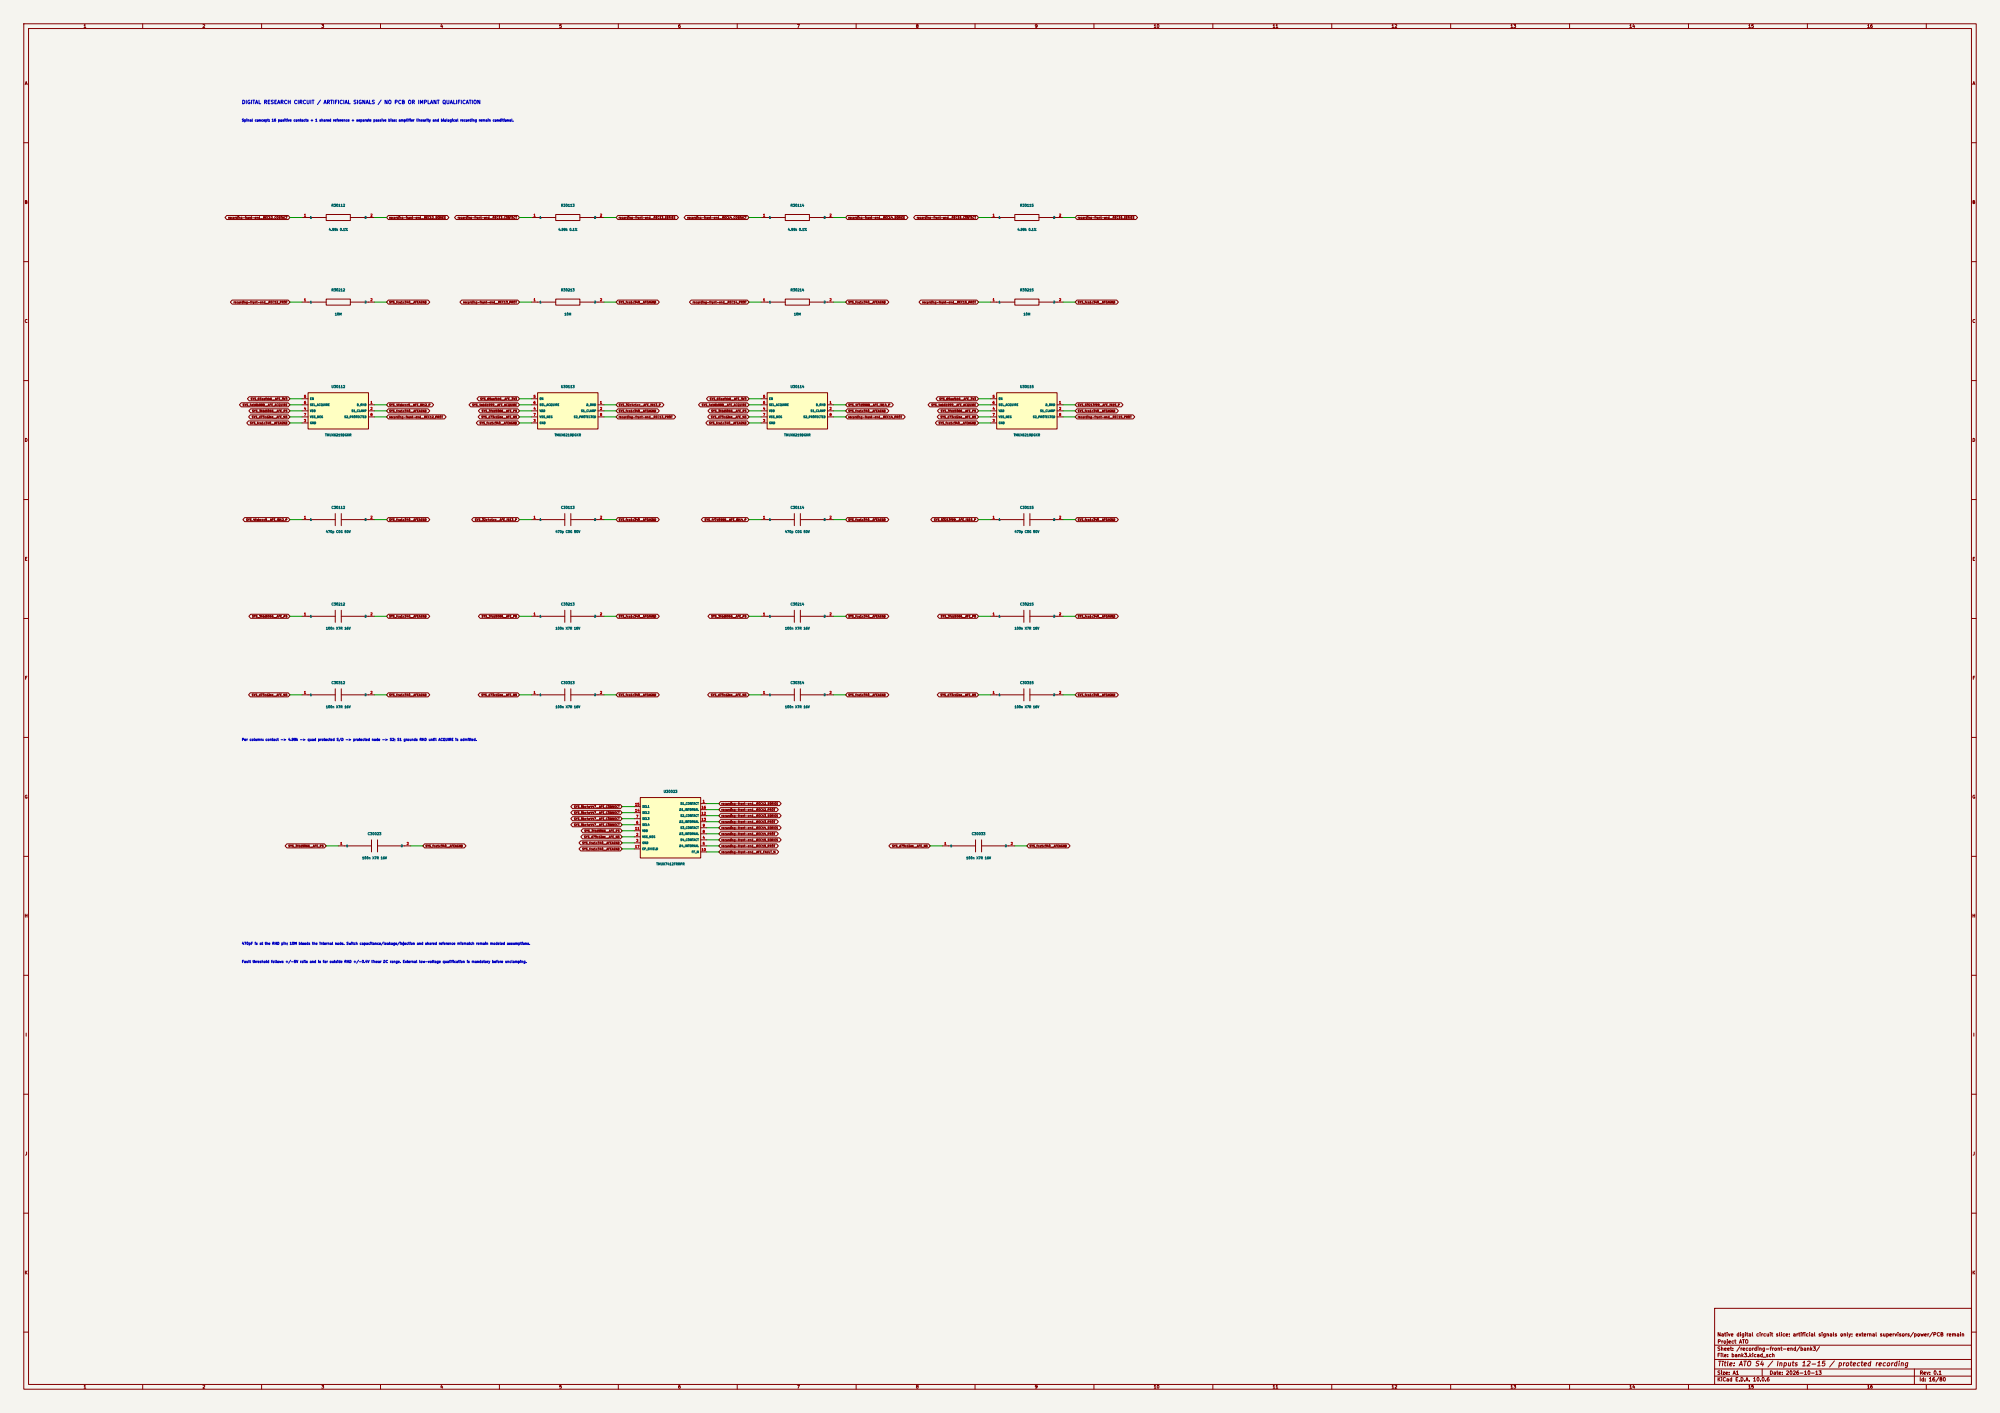
[picture p200: page 16]

DIGITAL RESEARCH CIRCUIT / ARTIFICIAL SIGNALS / NO PCB OR IMPLANT QUALIFICATION

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

Native digital circuit slice; artificial signals only; external supervisors/power/PCB remain

Sheet: /recording-front-end/bank3/
File: bank3.kicad_sch
Title: ATO S4 / Inputs 12-15 / protected recording

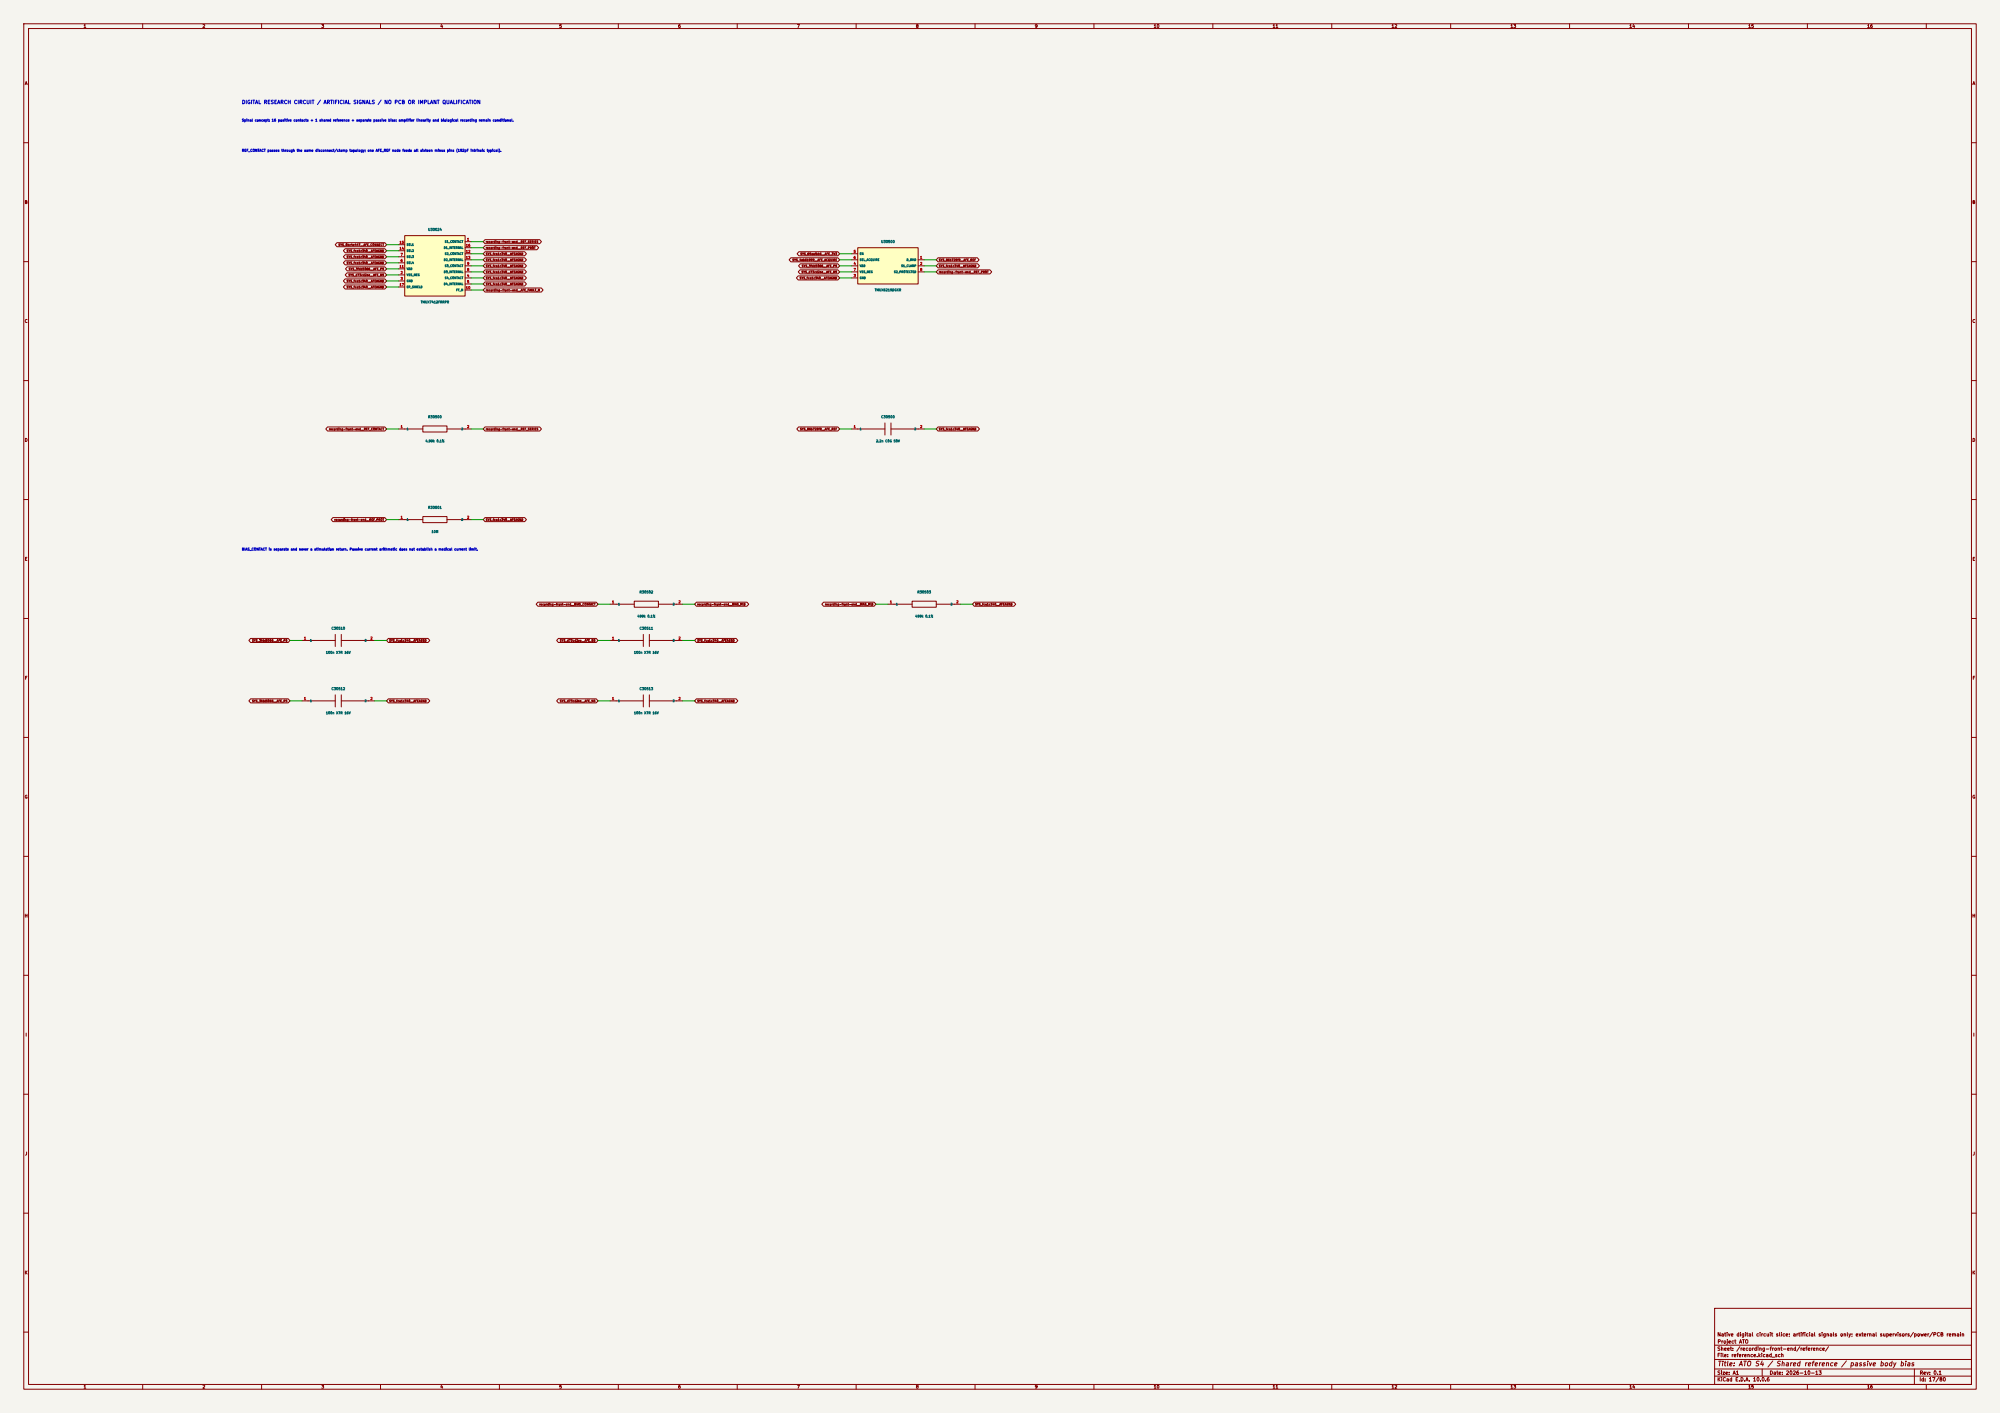
[picture p201: page 17]

recording-front-end__REF_PROT DIGITAL RESEARCH CIRCUIT / ARTIFICIAL SIGNALS / NO PCB OR IMPLANT QUALIFICATION

Spinal concept: 16 positive contacts + 1 shared reference + separate passive bias; amplifier linearity and biological recording remain conditional. REF_CONTACT passes through the same disconnect/clamp topology; one AFE_REF node feeds all sixteen minus pins (192pF intrinsic typical).

BIAS_CONTACT is separate and never a stimulation return. Passive current arithmetic does not establish a medical current limit.

Native digital circuit slice; artificial signals only; external supervisors/power/PCB remain

Sheet: /recording-front-end/reference/
File: reference.kicad_sch
Title: ATO S4 / Shared reference / passive body bias

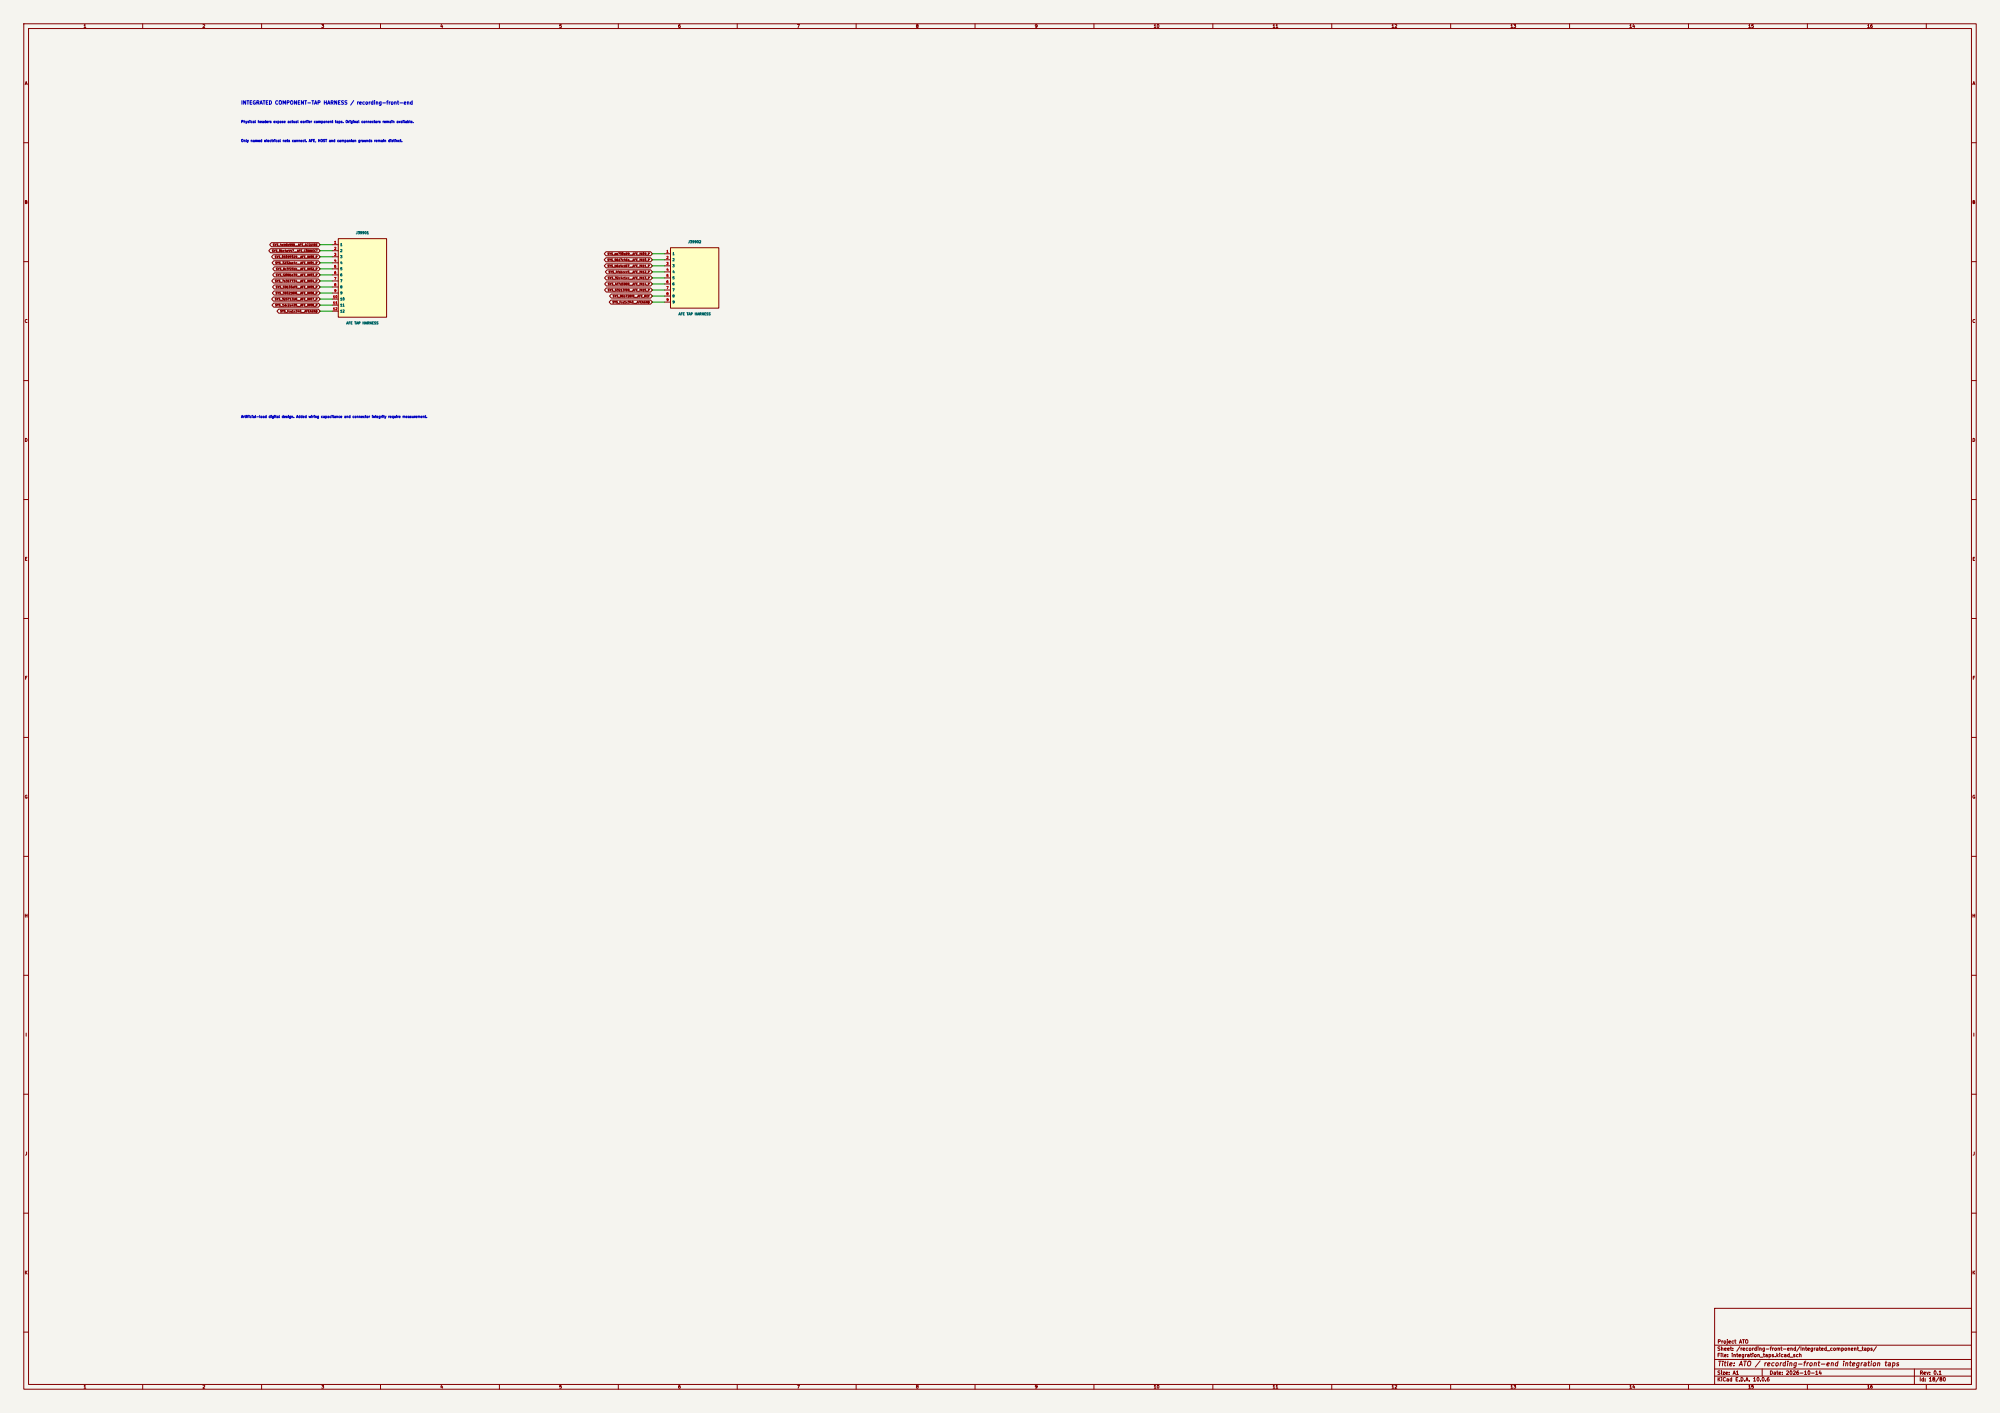
[picture p202: page 18]

Only named electrical nets connect. AFE, HOST and companion grounds remain distinct. Physical headers expose actual earlier component taps. Original connectors remain available. INTEGRATED COMPONENT-TAP HARNESS / recording-front-end

SYS_86b728f8__AFE_REF Artificial-load digital design. Added wiring capacitance and connector integrity require measurement.

Sheet: /recording-front-end/Integrated_component_taps/
File: integration_taps.kicad_sch
Title: ATO / recording-front-end integration taps

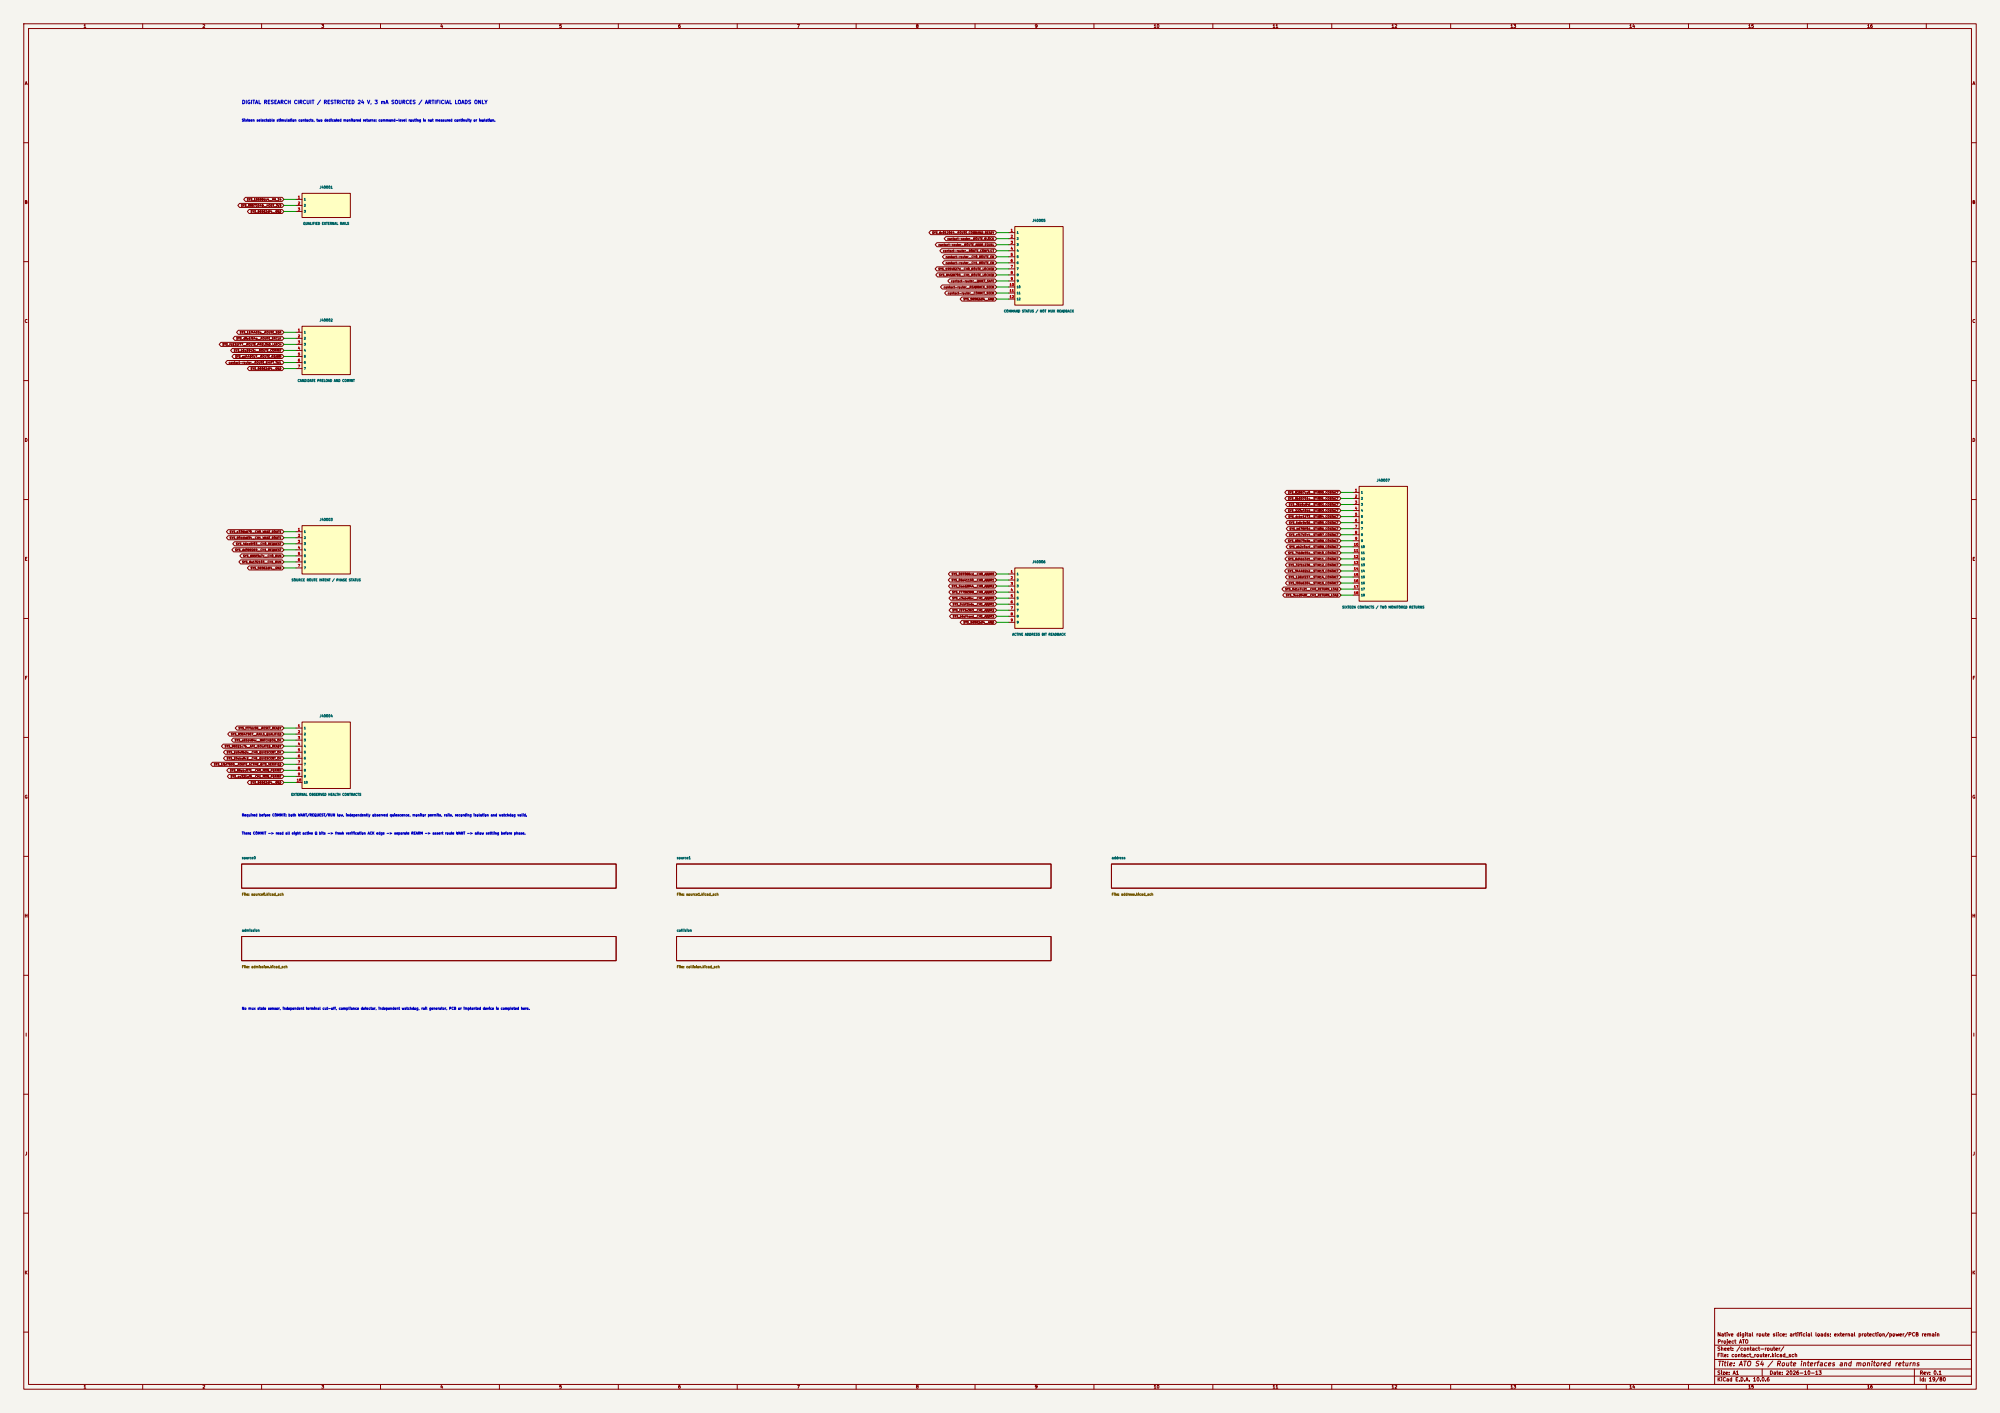
[picture p203: page 19]

contact-router__ROUTE_ADDR_EQUAL contact-router__ROUTE_CONFLICT Sixteen selectable stimulation contacts, two dedicated monitored returns; command-level routing is not measured continuity or isolation. DIGITAL RESEARCH CIRCUIT / RESTRICTED 24 V, 3 mA SOURCES / ARTIFICIAL LOADS ONLY

COMMAND STATUS / NOT MUX READBACK

CANDIDATE PRELOAD AND COMMIT

SOURCE ROUTE INTENT / PHASE STATUS

SIXTEEN CONTACTS / TWO MONITORED RETURNS

ACTIVE ADDRESS BIT READBACK

EXTERNAL OBSERVED HEALTH CONTRACTS

Required before COMMIT: both WANT/REQUEST/RUN low, independently observed quiescence, monitor permits, rails, recording isolation and watchdog valid. Then: COMMIT -> read all eight active Q bits -> fresh verification ACK edge -> separate REARM -> assert route WANT -> allow settling before phase. No mux state sensor, independent terminal cut-off, compliance detector, independent watchdog, rail generator, PCB or implanted device is completed here.

Native digital route slice; artificial loads; external protection/power/PCB remain

Sheet: /contact-router/
File: contact_router.kicad_sch
Title: ATO S4 / Route interfaces and monitored returns

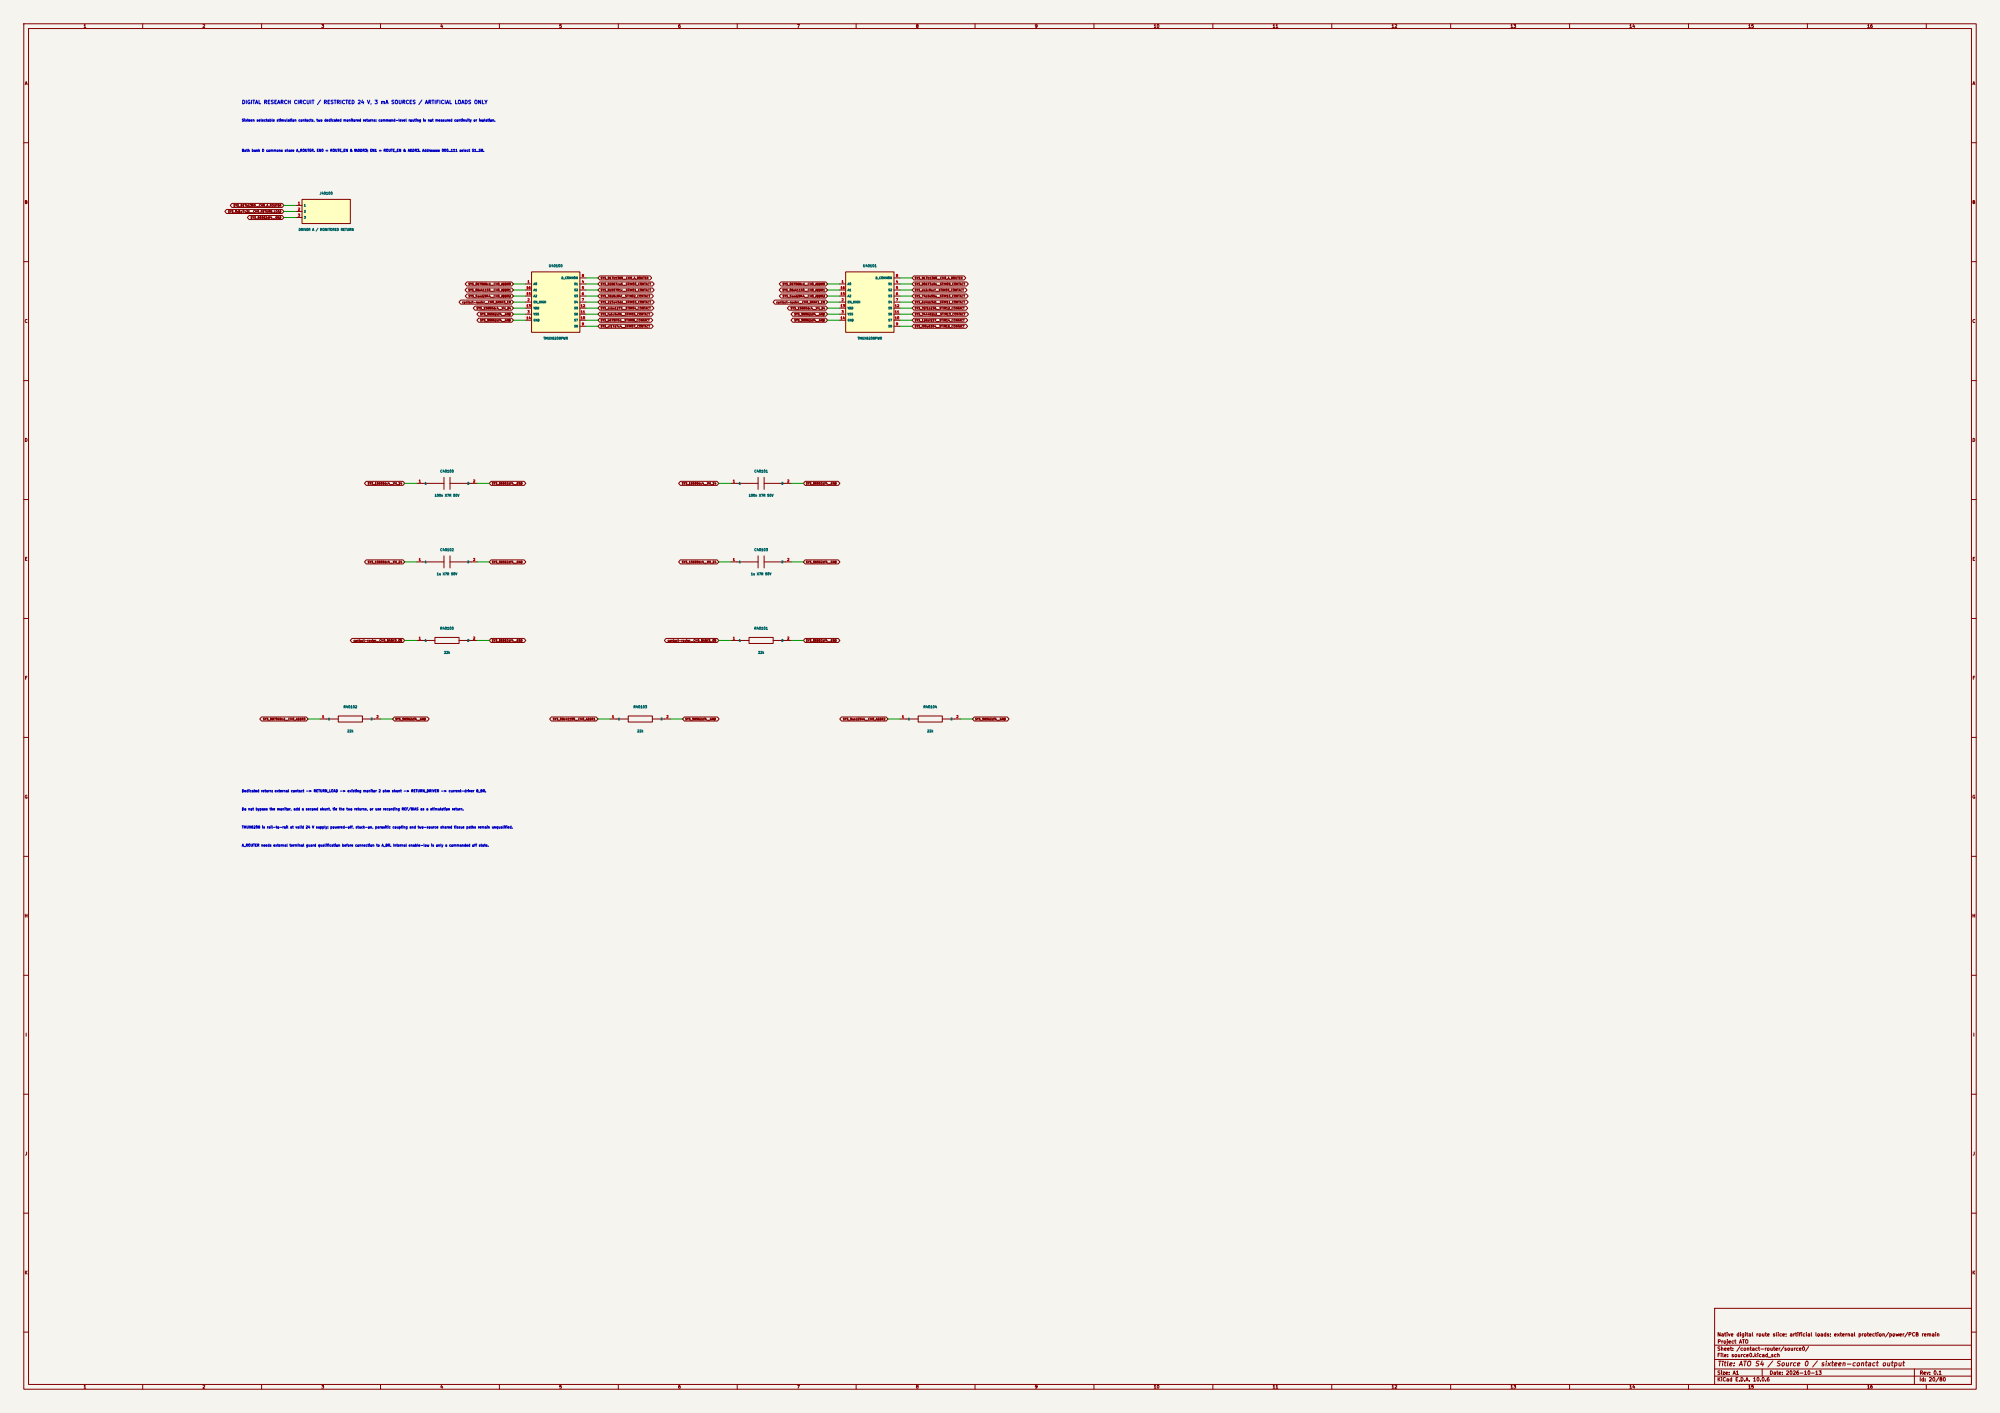
[picture p204: page 20]
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

Both bank D commons share A_ROUTER. EN0 = ROUTE_EN & !ADDR3; EN1 = ROUTE_EN & ADDR3. Addresses 000..111 select S1..S8.

Dedicated return: external contact -> RETURN_LOAD -> existing monitor 2 ohm shunt -> RETURN_DRIVER -> current-driver B_BR. Do not bypass the monitor, add a second shunt, tie the two returns, or use recording REF/BIAS as a stimulation return. TMUX6208 is rail-to-rail at valid 24 V supply; powered-off, stuck-on, parasitic coupling and two-source shared tissue paths remain unqualified. A_ROUTER needs external terminal guard qualification before connection to A_BR. Internal enable-low is only a commanded off state.

Native digital route slice; artificial loads; external protection/power/PCB remain

Sheet: /contact-router/source0/
File: source0.kicad_sch
Title: ATO S4 / Source 0 / sixteen-contact output

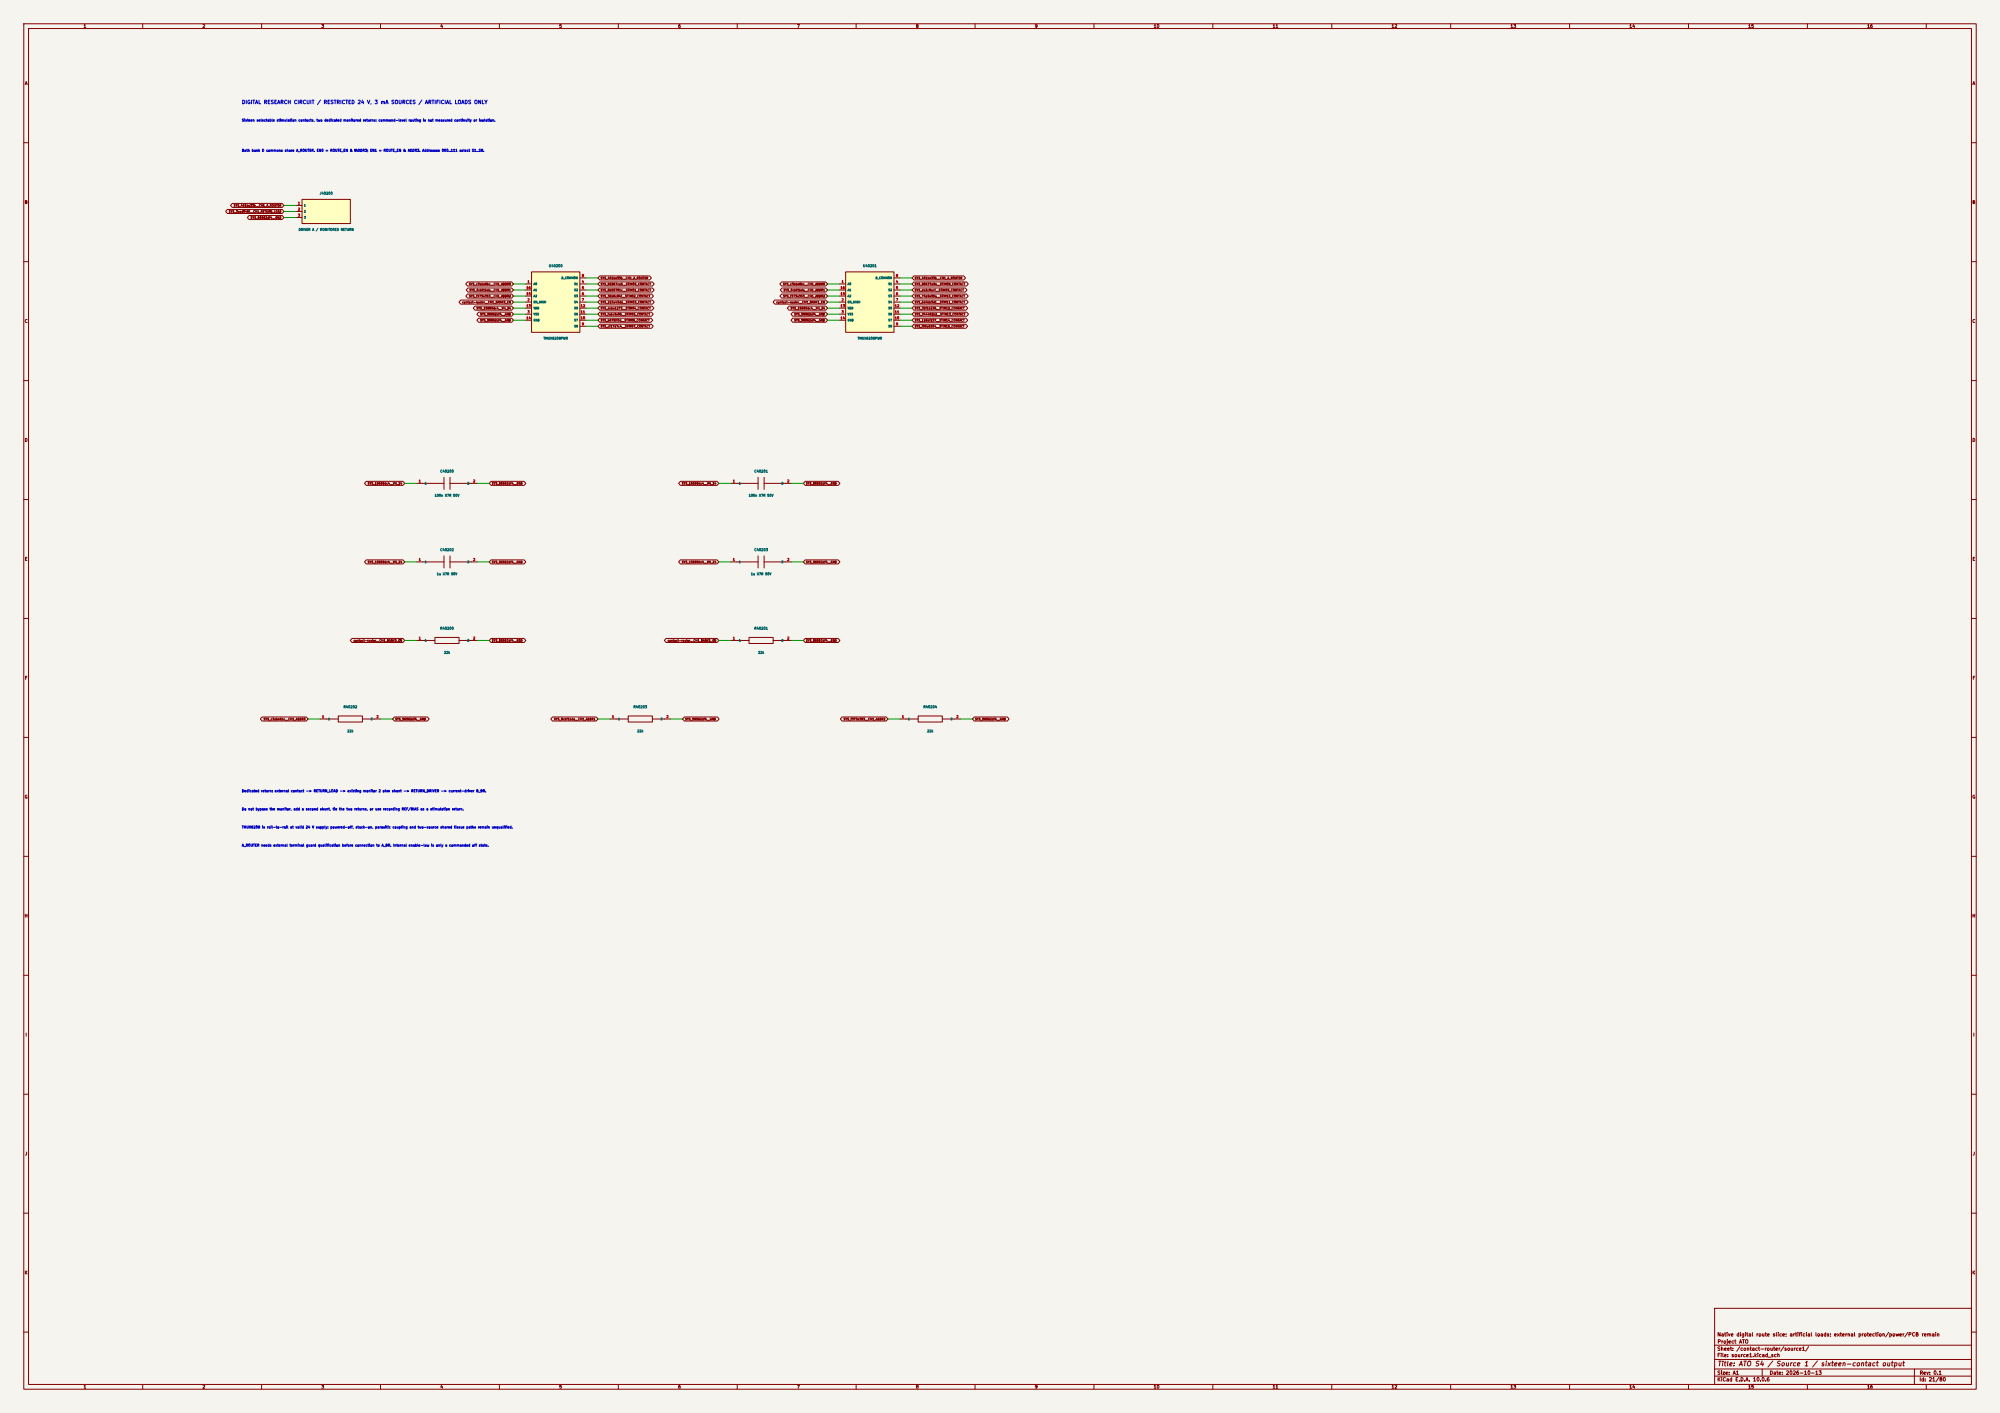
[picture p205: page 21]
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

Native digital route slice; artificial loads; external protection/power/PCB remain

Sheet: /contact-router/source1/
File: source1.kicad_sch
Title: ATO S4 / Source 1 / sixteen-contact output

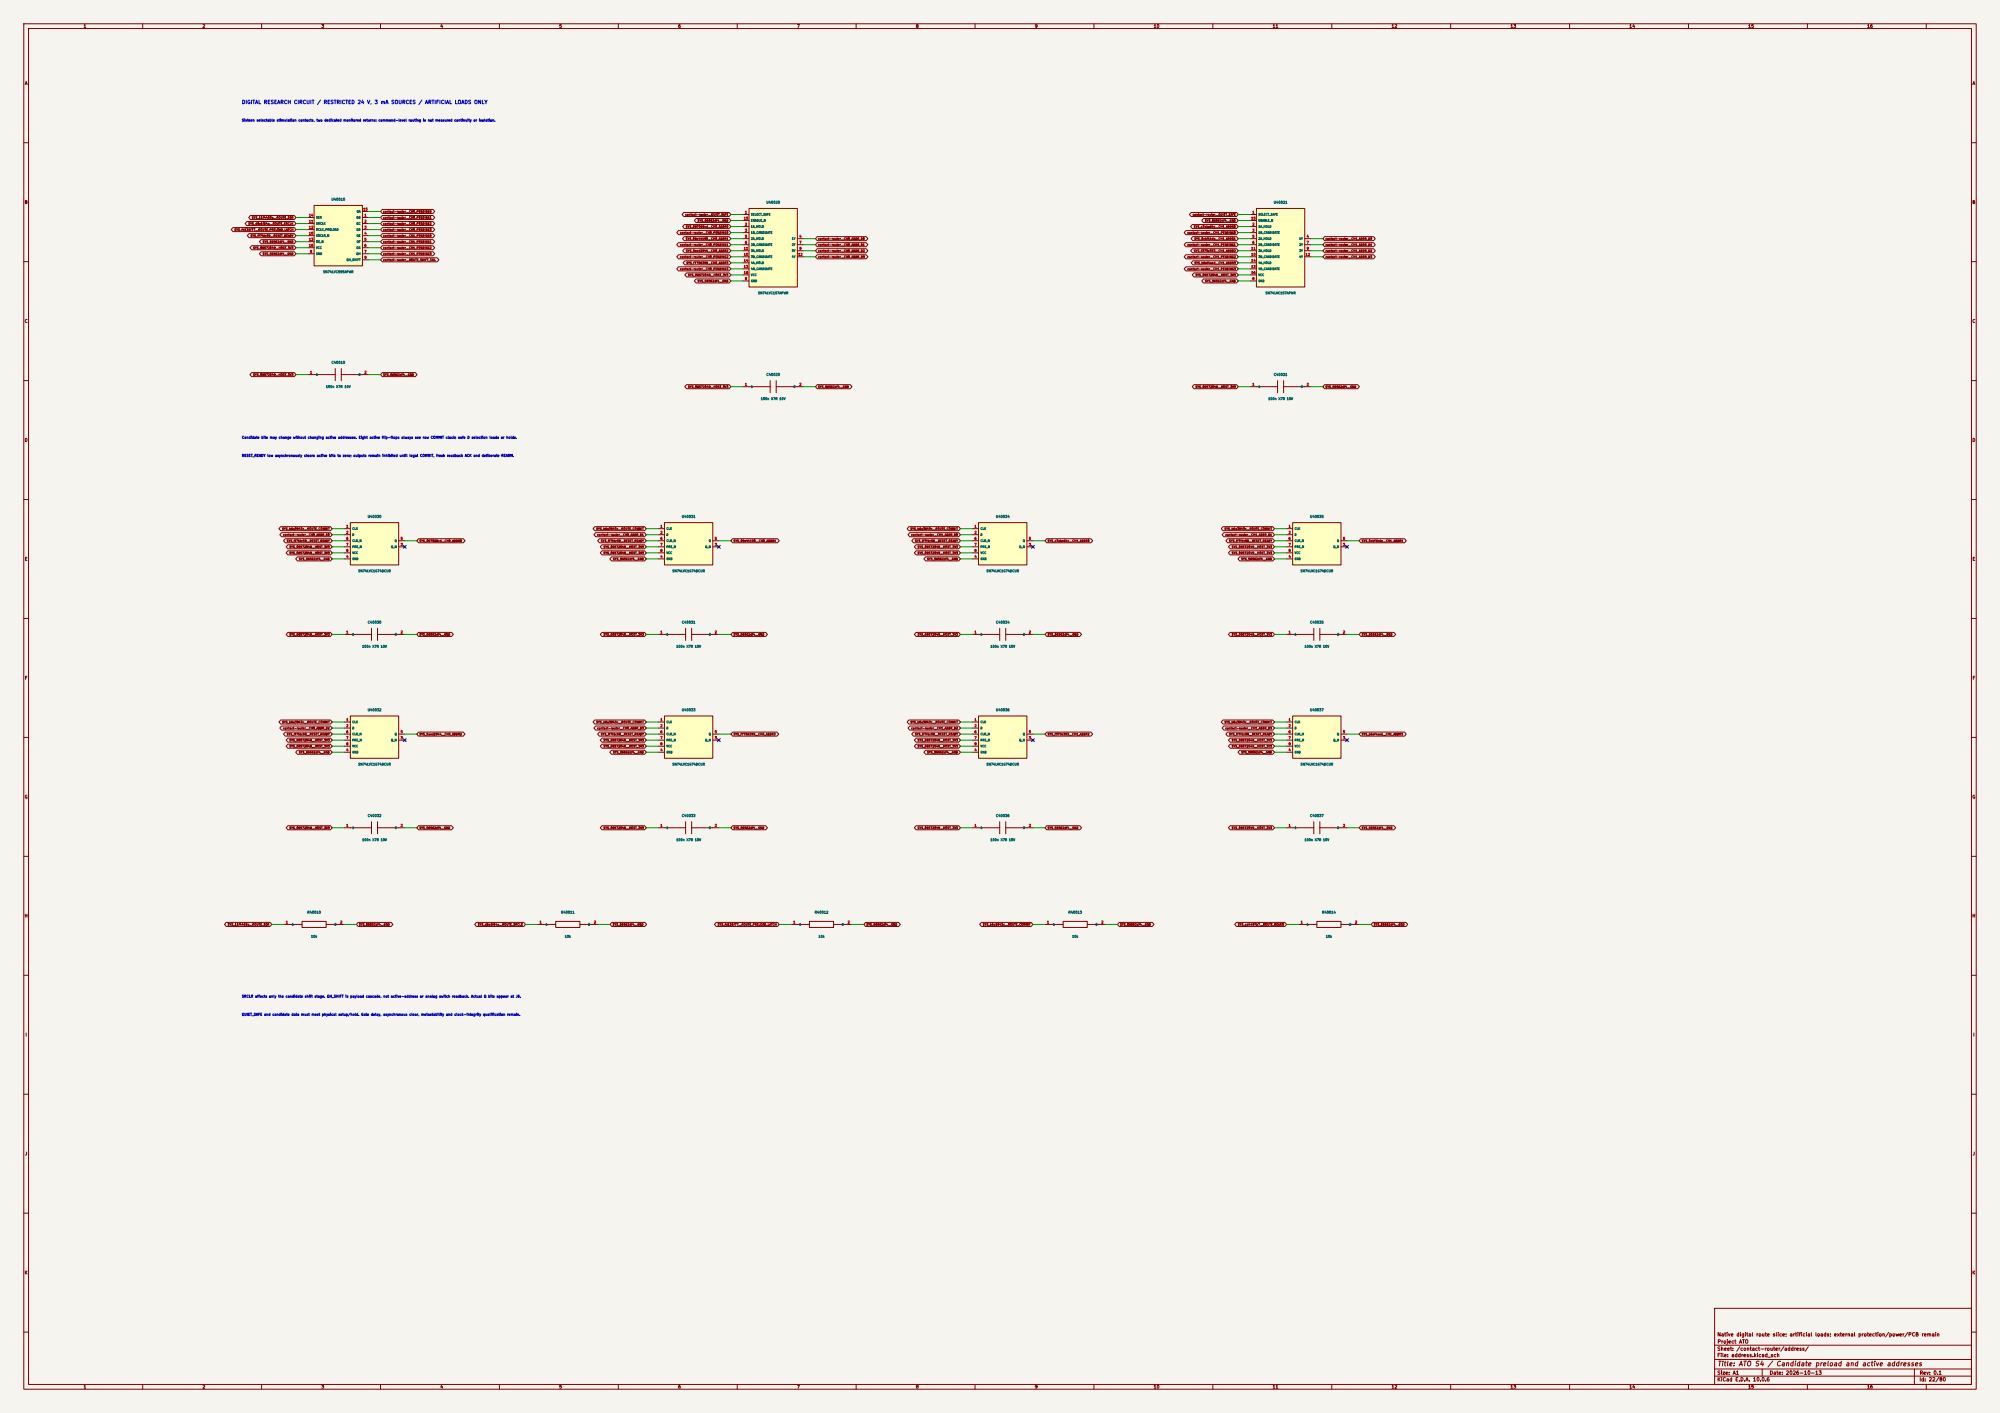
[picture p206: page 22]

DIGITAL RESEARCH CIRCUIT / RESTRICTED 24 V, 3 mA SOURCES / ARTIFICIAL LOADS ONLY

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

RESET_READY low asynchronously clears active bits to zero; outputs remain inhibited until legal COMMIT, fresh readback ACK and deliberate REARM. Candidate bits may change without changing active addresses. Eight active flip-flops always see raw COMMIT clock; safe D selection loads or holds.

SRCLR affects only the candidate shift stage. QH_SHIFT is payload cascade, not active-address or analog switch readback. Actual Q bits appear at J6. QUIET_SAFE and candidate data must meet physical setup/hold. Gate delay, asynchronous clear, metastability and clock-integrity qualification remain.

Native digital route slice; artificial loads; external protection/power/PCB remain

Sheet: /contact-router/address/
File: address.kicad_sch
Title: ATO S4 / Candidate preload and active addresses

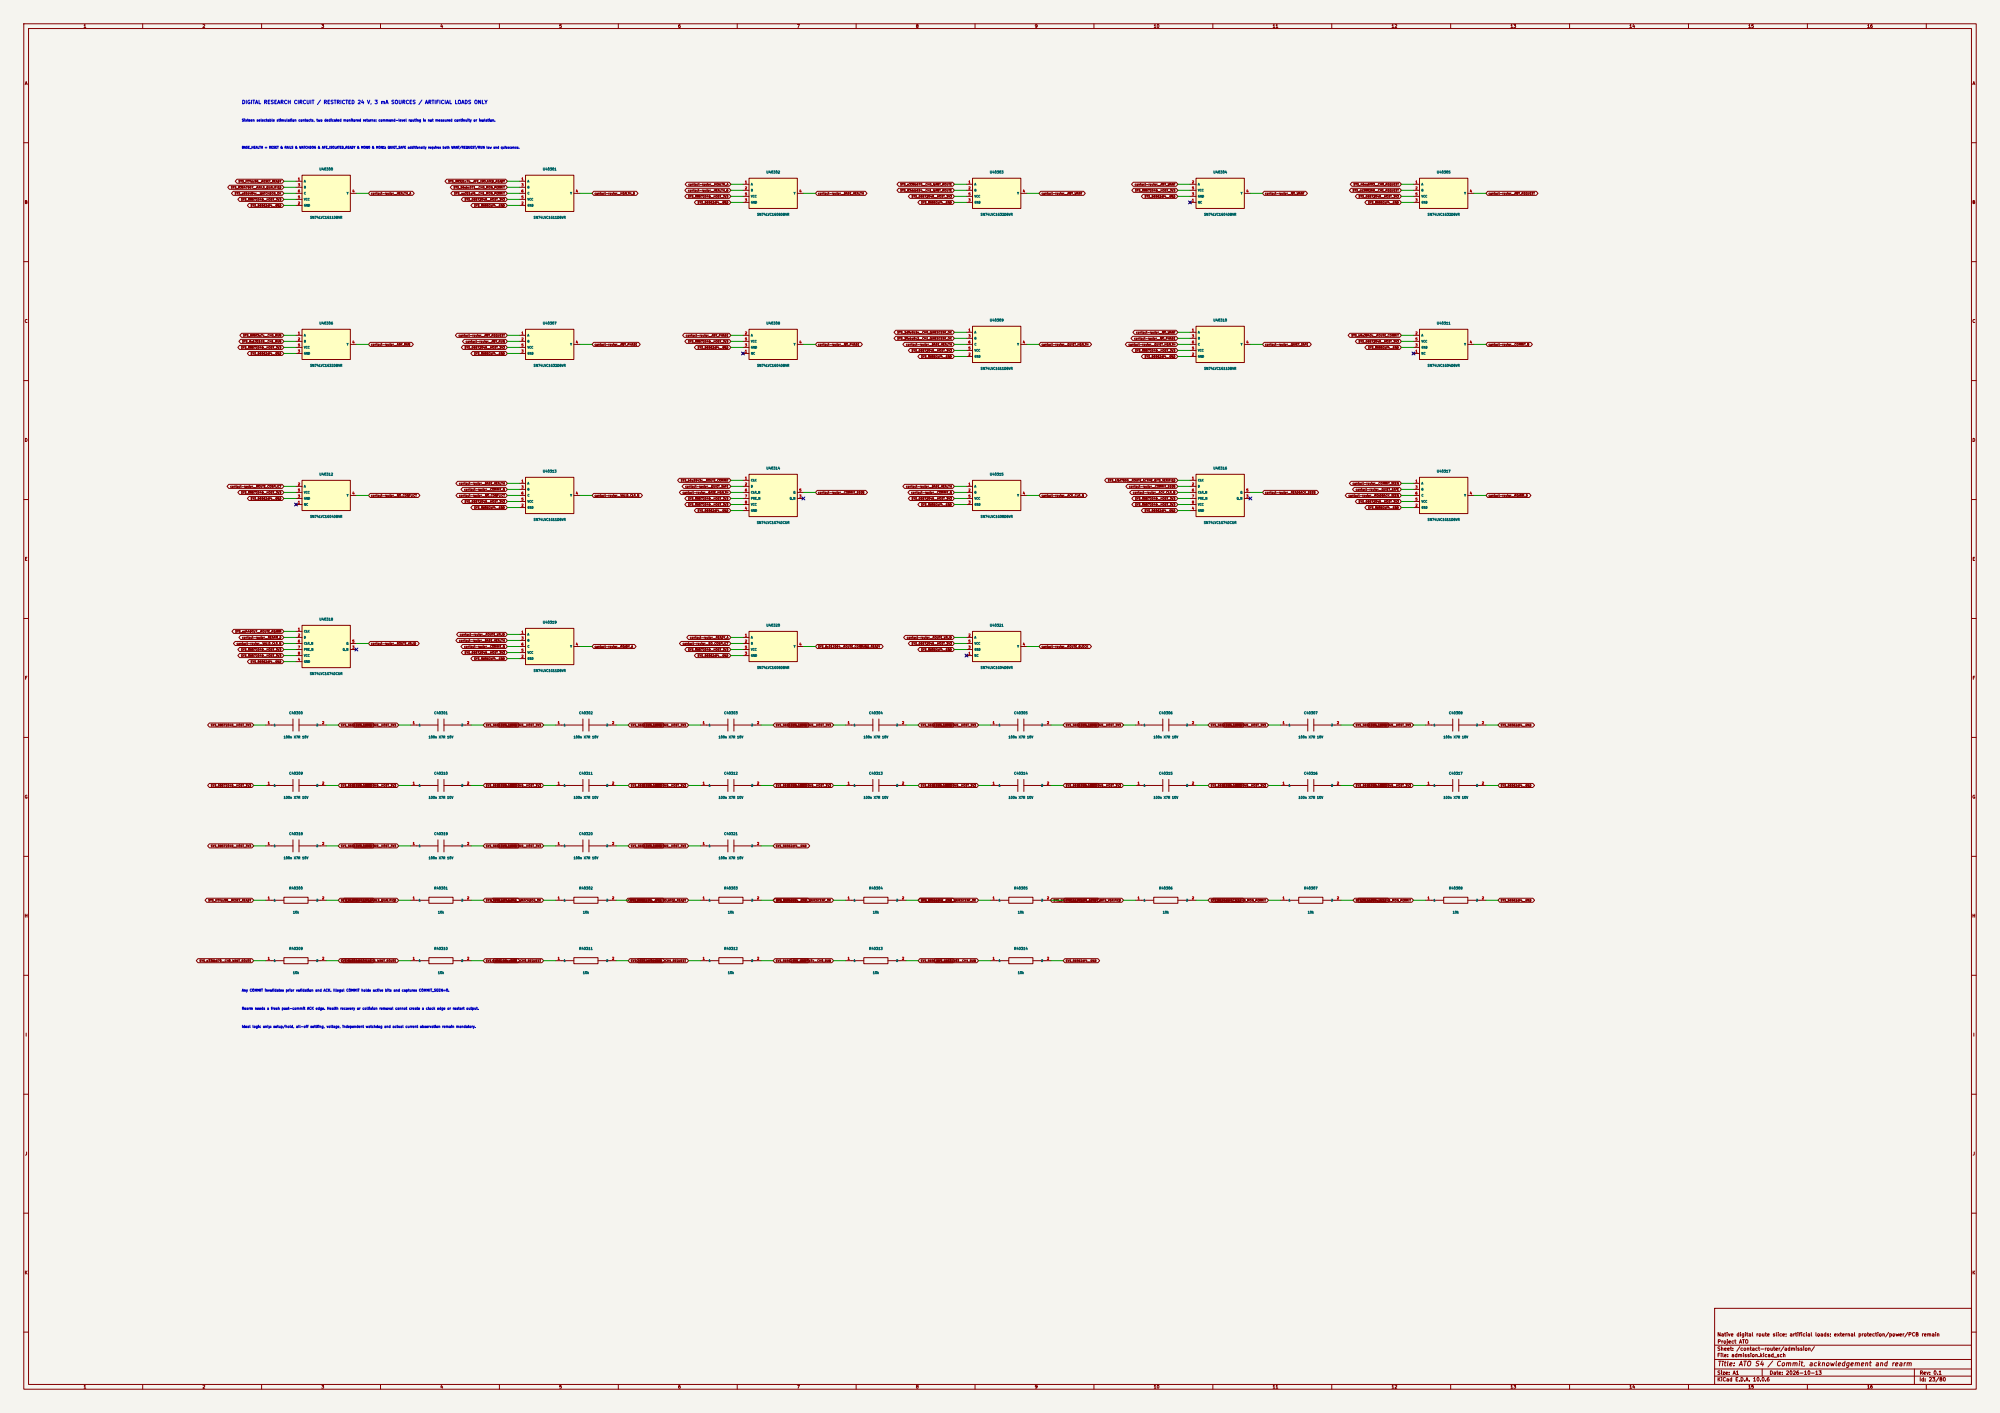
[picture p207: page 23]

DIGITAL RESEARCH CIRCUIT / RESTRICTED 24 V, 3 mA SOURCES / ARTIFICIAL LOADS ONLY

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

BASE_HEALTH = RESET & RAILS & WATCHDOG & AFE_ISOLATED_READY & MON0 & MON1; QUIET_SAFE additionally requires both WANT/REQUEST/RUN low and quiescence.

Rearm needs a fresh post-commit ACK edge. Health recovery or collision removal cannot create a clock edge or restart output. Any COMMIT invalidates prior validation and ACK. Illegal COMMIT holds active bits and captures COMMIT_SEEN=0.

Ideal logic only: setup/hold, all-off settling, voltage, independent watchdog and actual current observation remain mandatory.

Native digital route slice; artificial loads; external protection/power/PCB remain

Sheet: /contact-router/admission/
File: admission.kicad_sch
Title: ATO S4 / Commit, acknowledgement and rearm

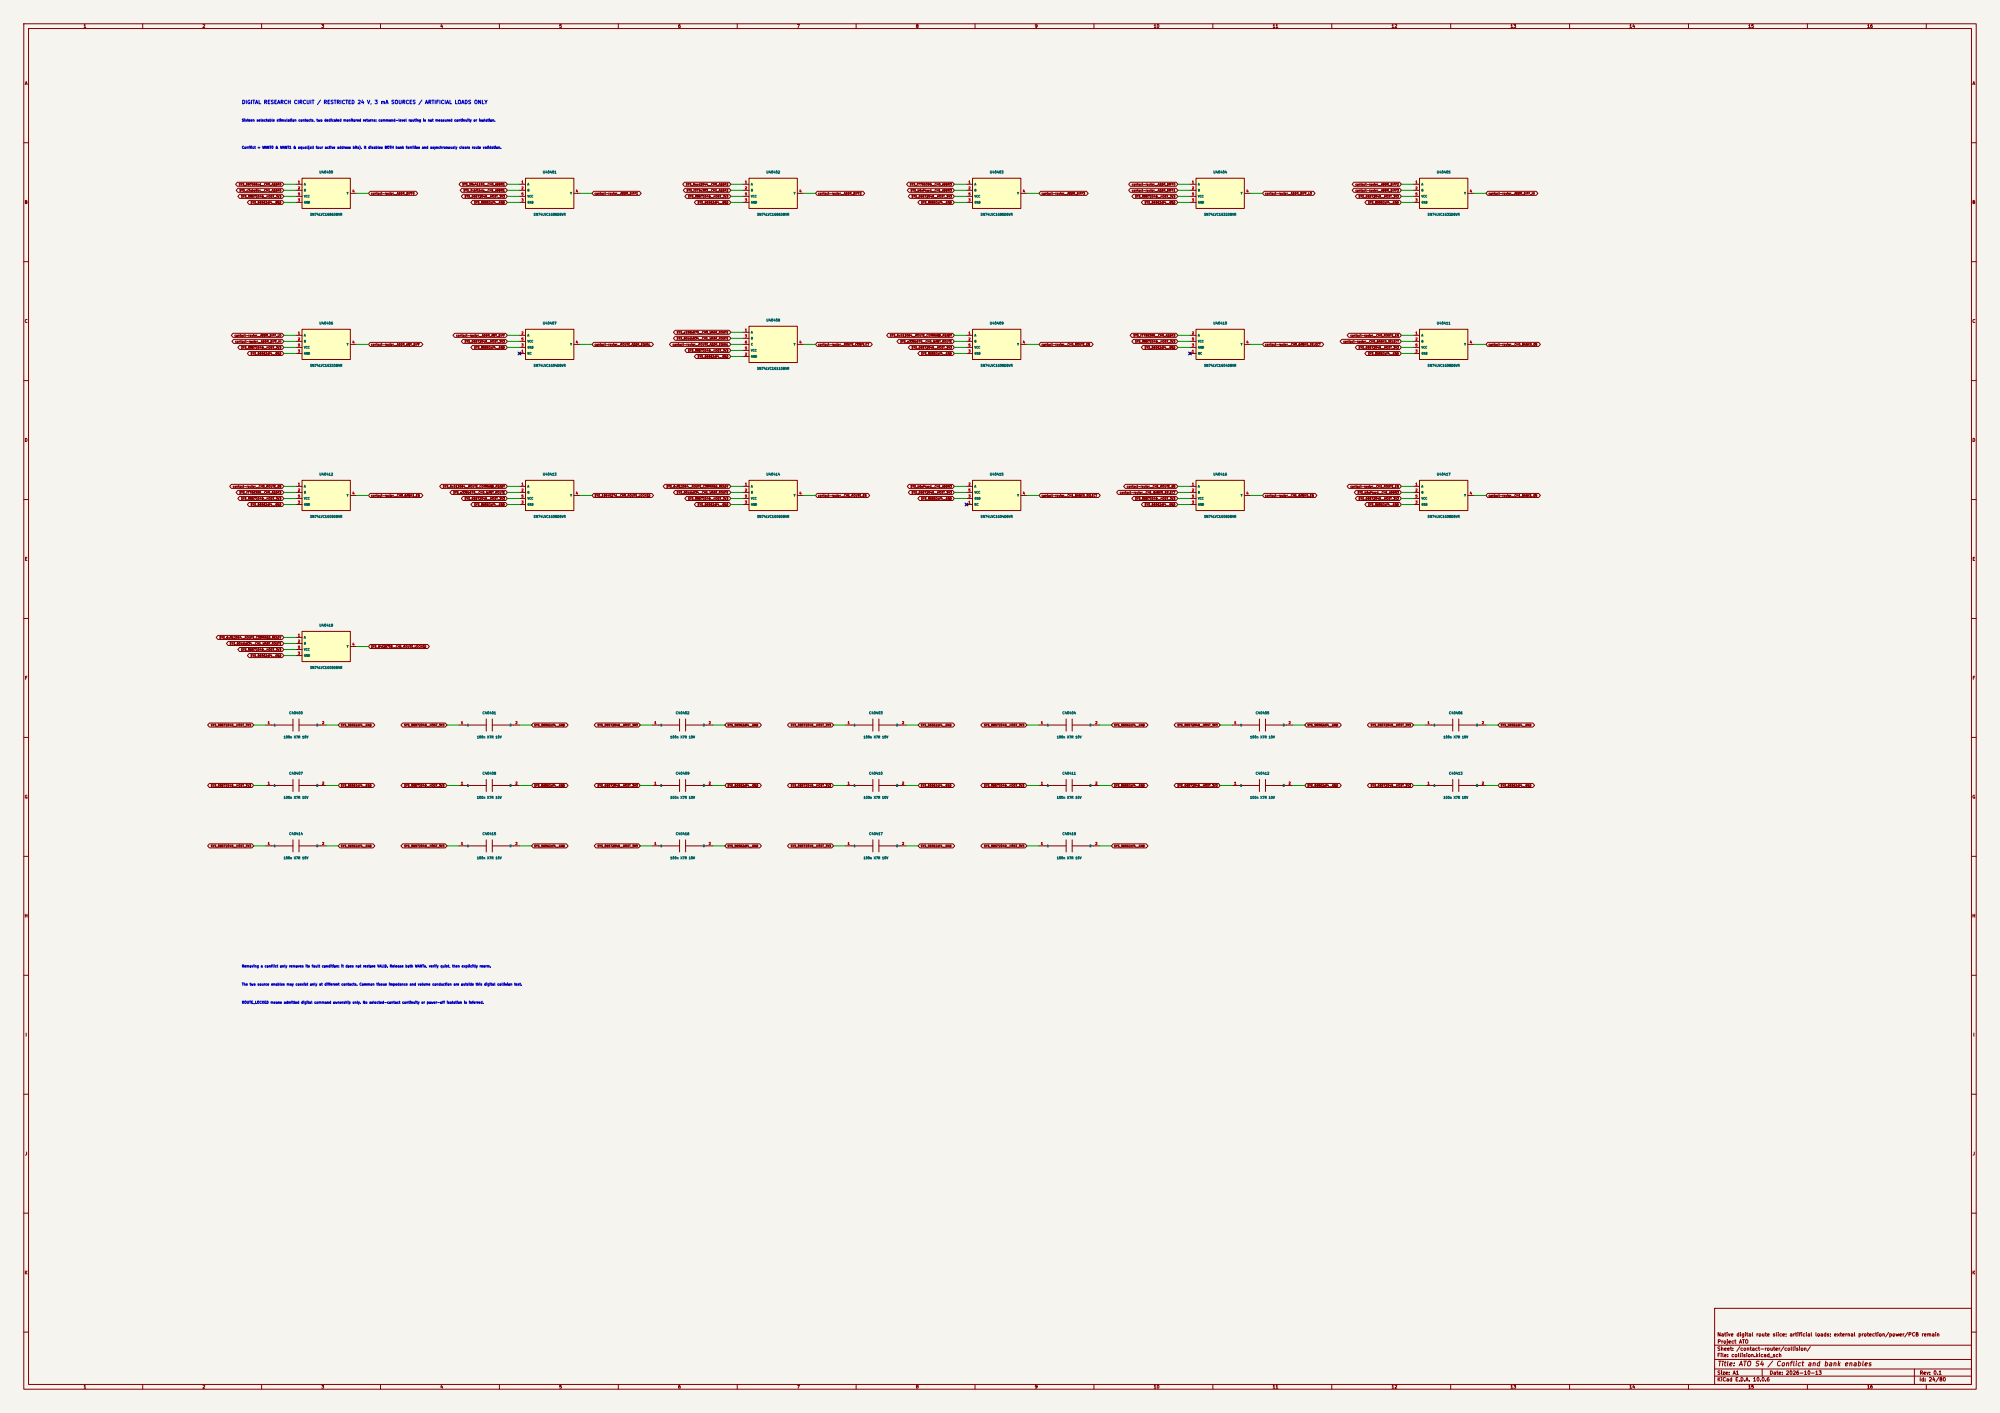
[picture p208: page 24]

Conflict = WANT0 & WANT1 & equal(all four active address bits). It disables BOTH bank families and asynchronously clears route validation. DIGITAL RESEARCH CIRCUIT / RESTRICTED 24 V, 3 mA SOURCES / ARTIFICIAL LOADS ONLY

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

Removing a conflict only removes its fault condition; it does not restore VALID. Release both WANTs, verify quiet, then explicitly rearm. The two source enables may coexist only at different contacts. Common tissue impedance and volume conduction are outside this digital collision test. ROUTE_LOCKED means admitted digital command ownership only. No selected-contact continuity or power-off isolation is inferred.

Native digital route slice; artificial loads; external protection/power/PCB remain

Sheet: /contact-router/collision/
File: collision.kicad_sch
Title: ATO S4 / Conflict and bank enables

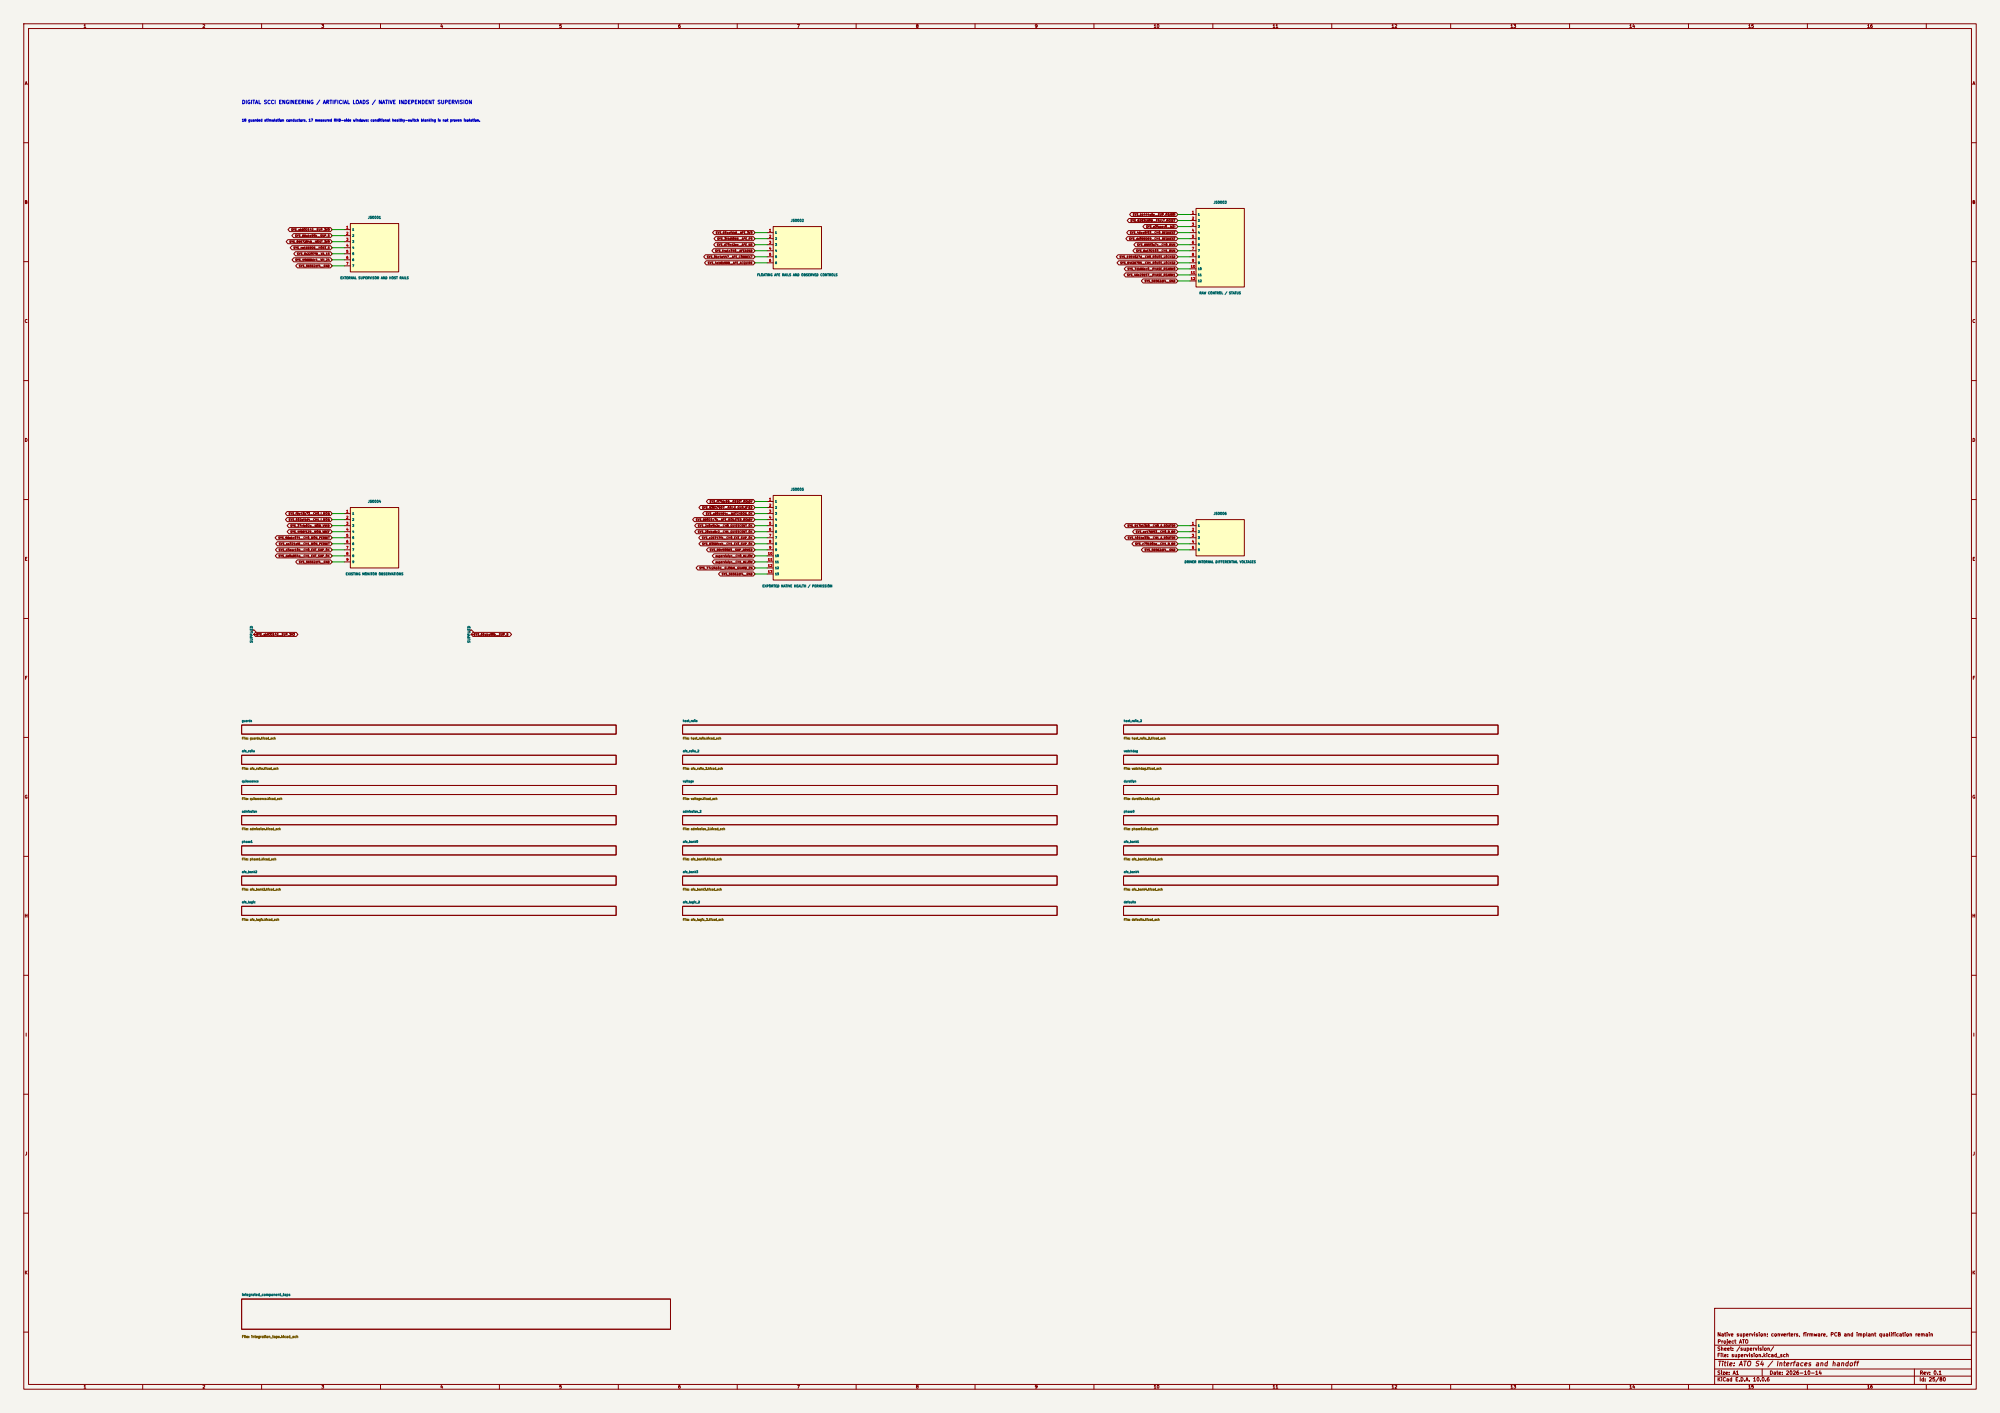
[picture p209: page 25]

DIGITAL SCCI ENGINEERING / ARTIFICIAL LOADS / NATIVE INDEPENDENT SUPERVISION

18 guarded stimulation conductors, 17 measured RHD-side windows; conditional healthy-switch blanking is not proven isolation.

EXTERNAL SUPERVISOR AND HOST RAILS

FLOATING AFE RAILS AND OBSERVED CONTROLS

DRIVER INTERNAL DIFFERENTIAL VOLTAGES

Native supervision; converters, firmware, PCB and implant qualification remain

Sheet: /supervision/
File: supervision.kicad_sch
Title: ATO S4 / Interfaces and handoff

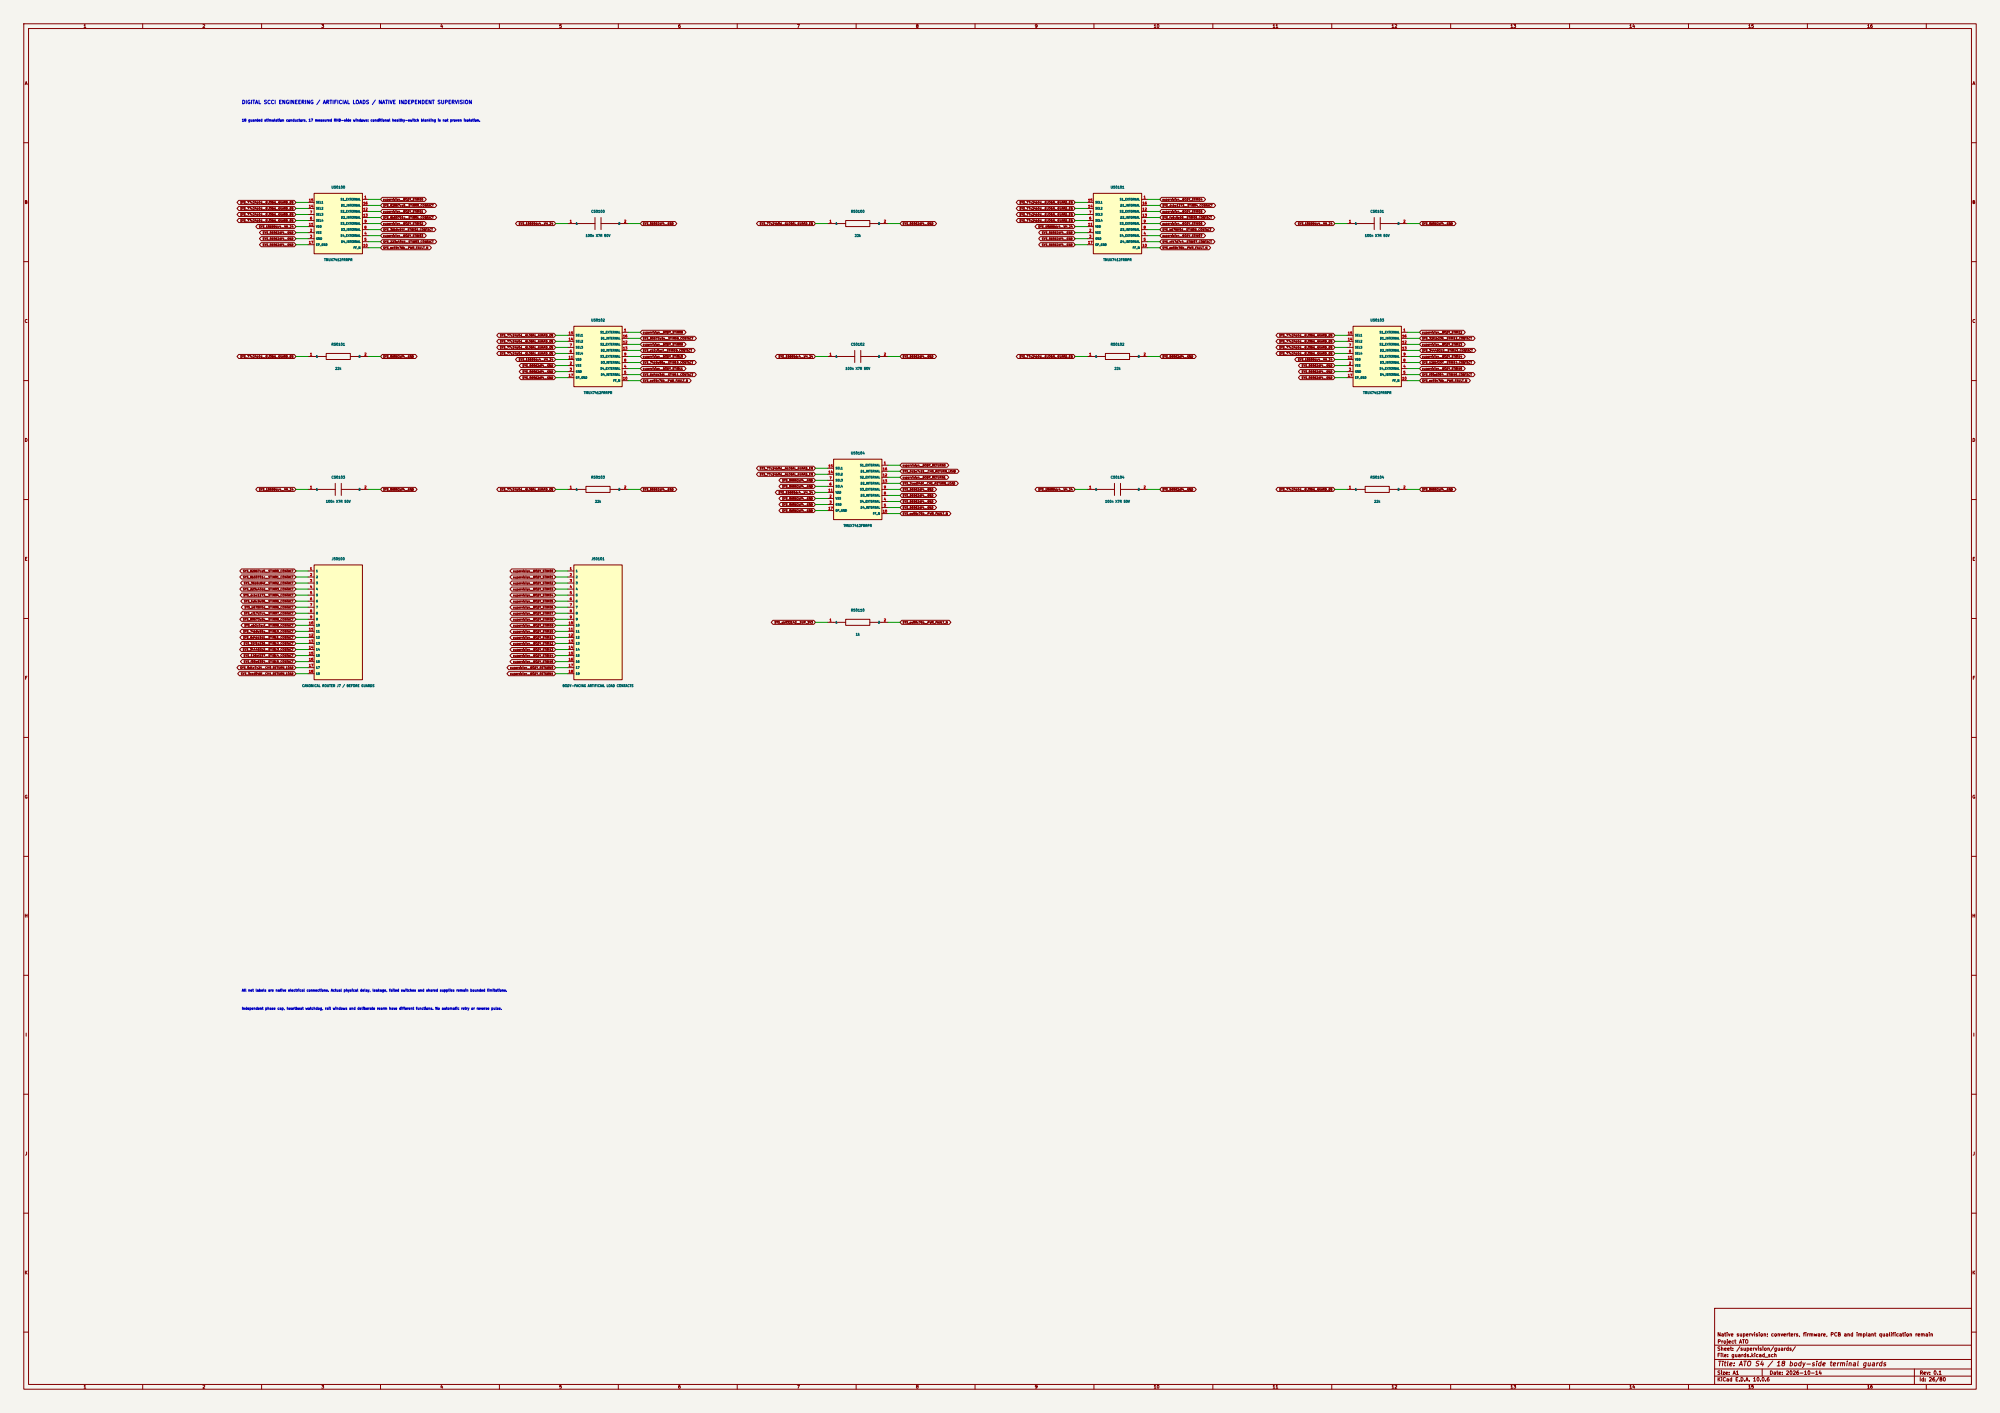
[picture p210: page 26]

SYS_77c24b0d__GLOBAL_GUARD_EN DIGITAL SCCI ENGINEERING / ARTIFICIAL LOADS / NATIVE INDEPENDENT SUPERVISION

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

CANONICAL ROUTER J7 / BEFORE GUARDS

BODY-FACING ARTIFICIAL LOAD CONTACTS

Independent phase cap, heartbeat watchdog, rail windows and deliberate rearm have different functions. No automatic retry or reverse pulse. All net labels are native electrical connections. Actual physical delay, leakage, failed switches and shared supplies remain bounded limitations.

Native supervision; converters, firmware, PCB and implant qualification remain

Sheet: /supervision/guards/
File: guards.kicad_sch
Title: ATO S4 / 18 body-side terminal guards

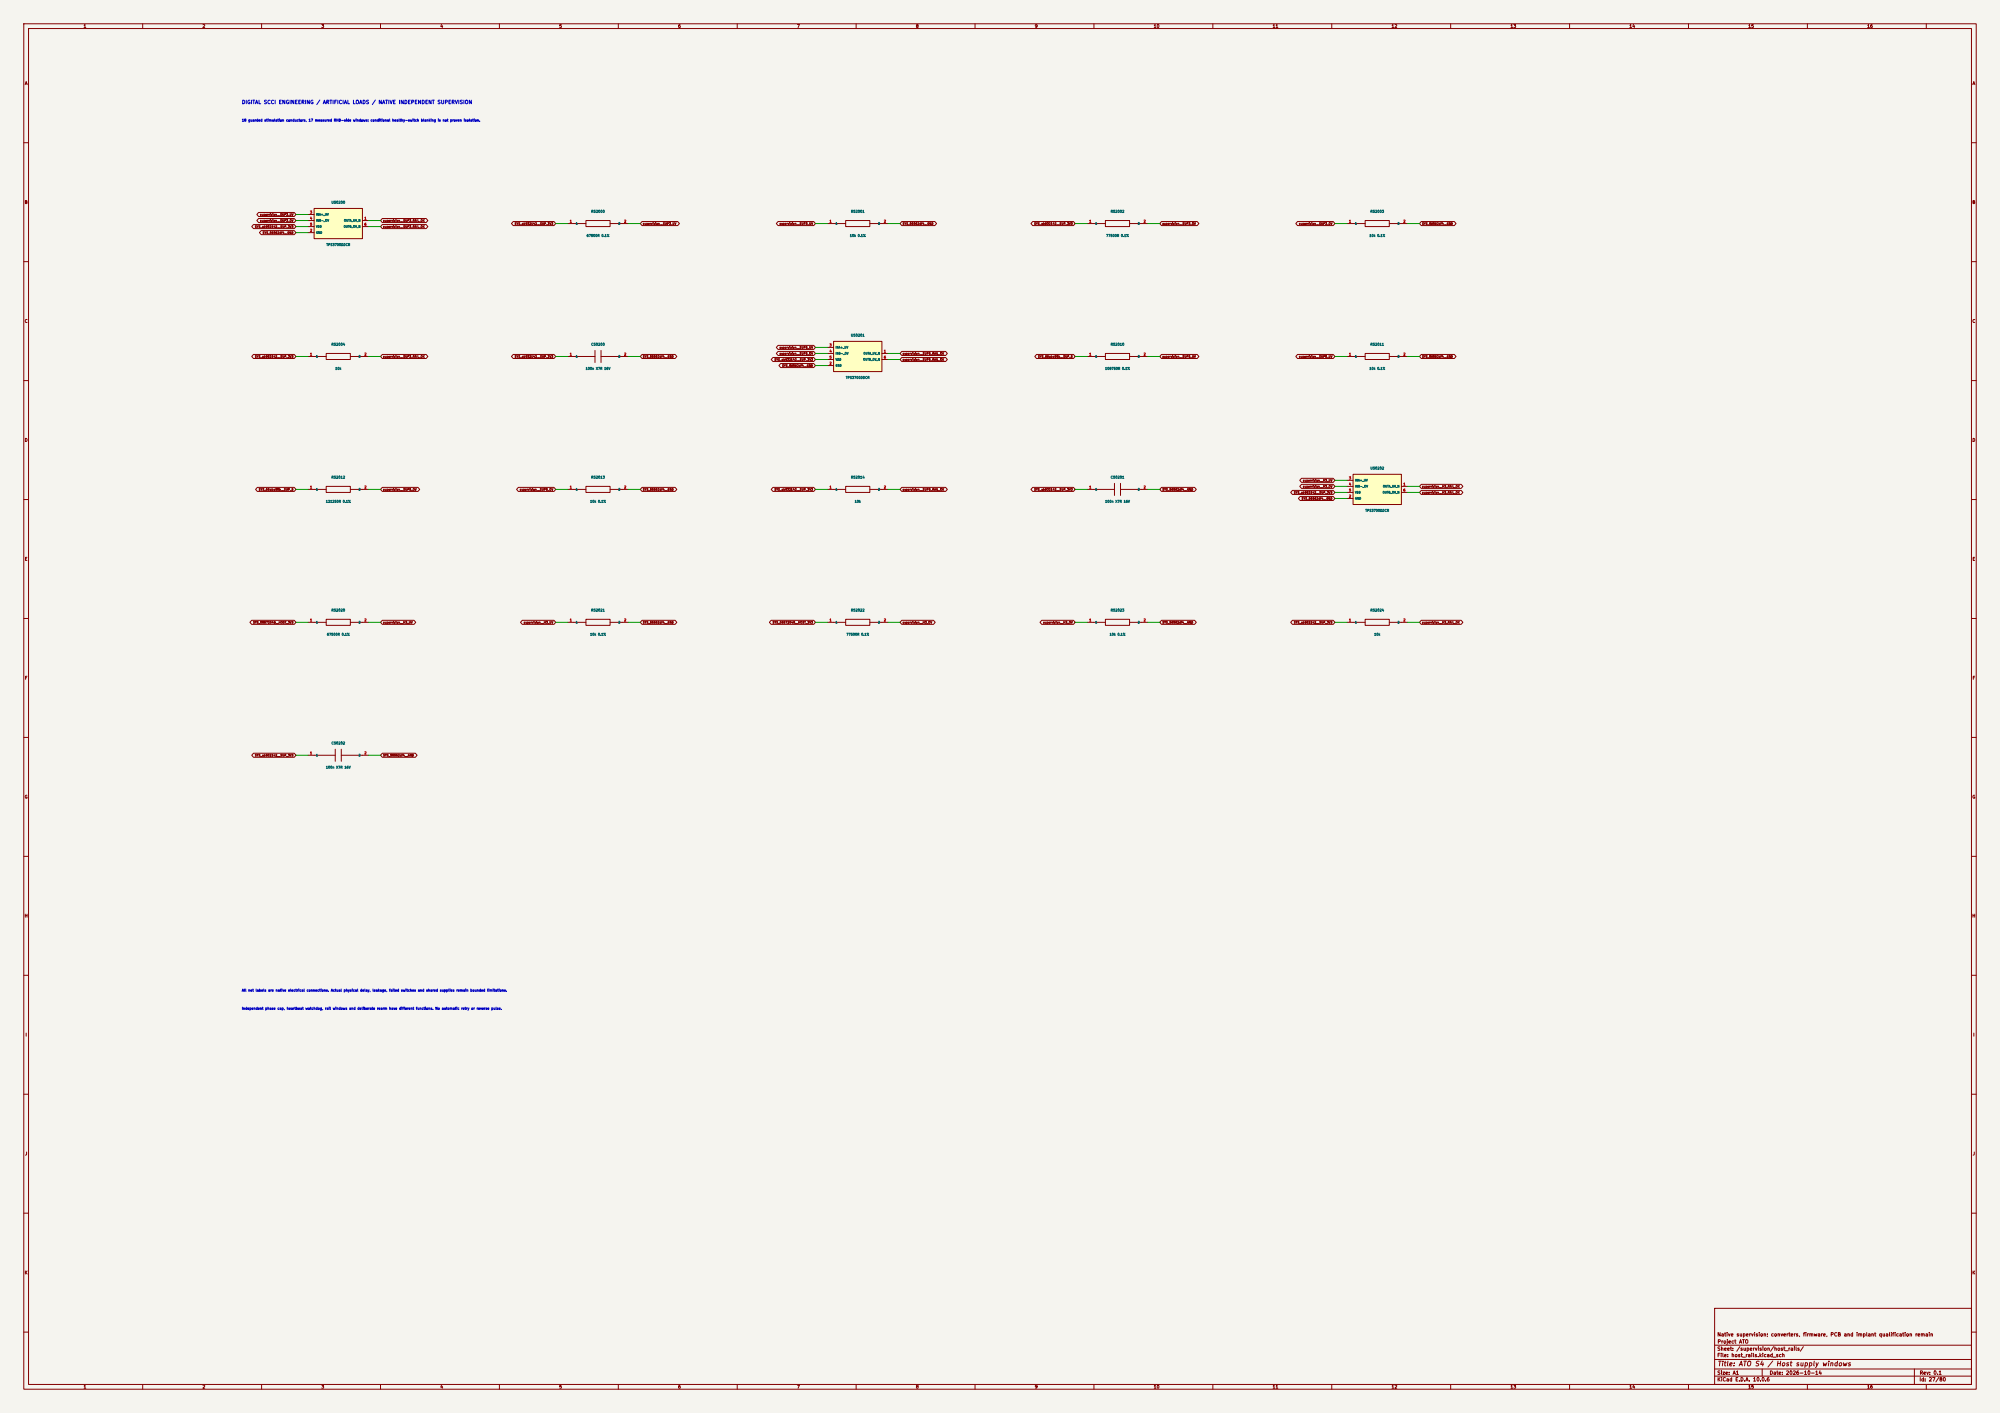
[picture p211: page 27]

DIGITAL SCCI ENGINEERING / ARTIFICIAL LOADS / NATIVE INDEPENDENT SUPERVISION

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

Native supervision; converters, firmware, PCB and implant qualification remain

Sheet: /supervision/host_rails/
File: host_rails.kicad_sch
Title: ATO S4 / Host supply windows

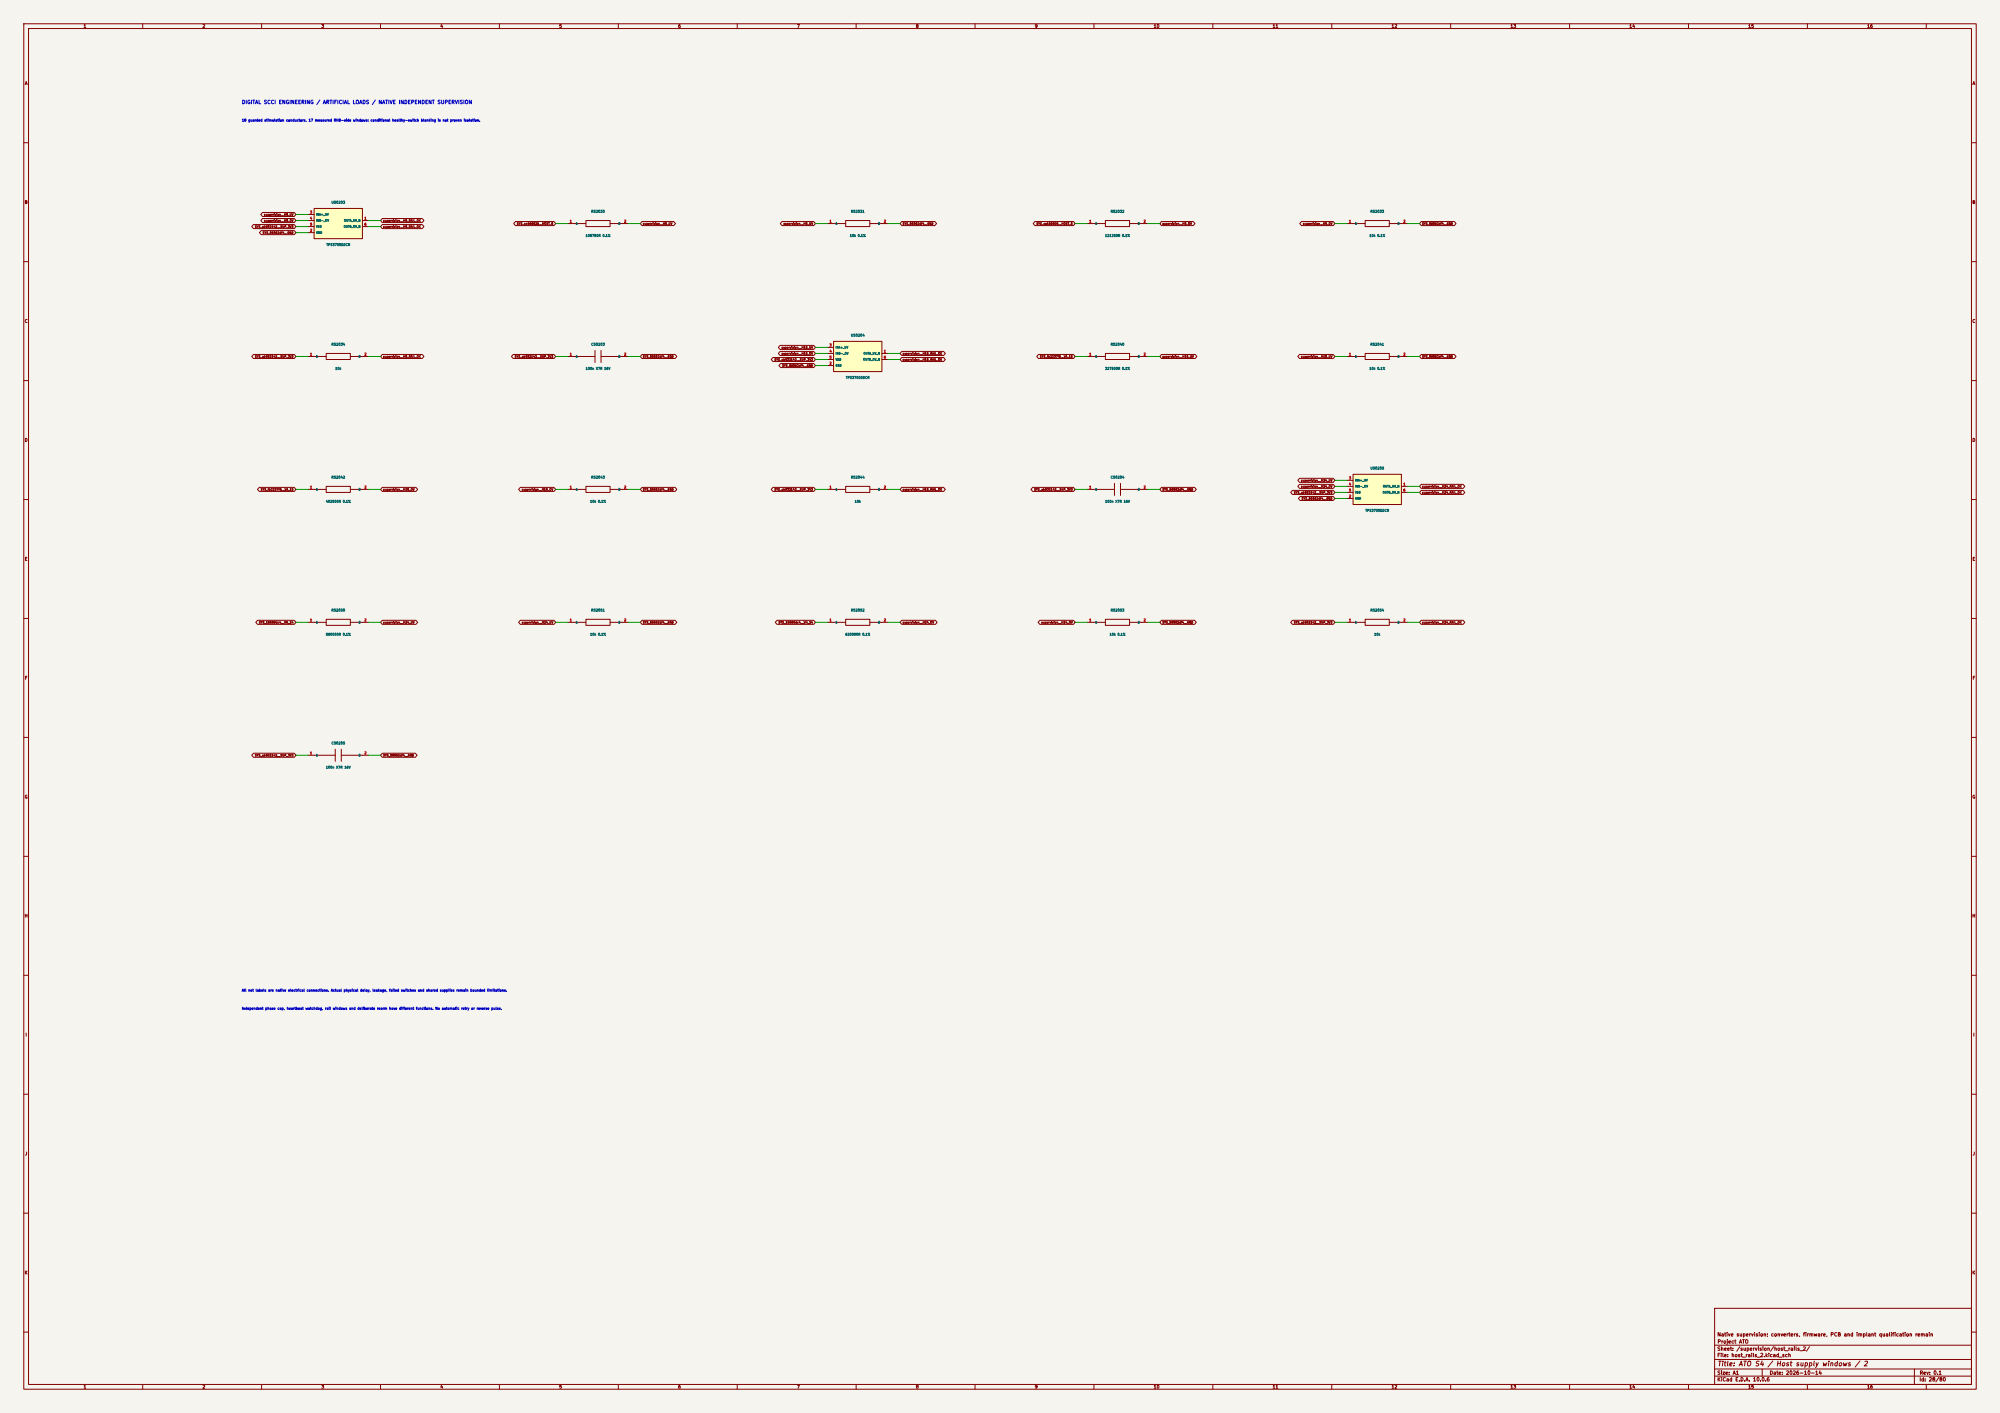
[picture p212: page 28]

DIGITAL SCCI ENGINEERING / ARTIFICIAL LOADS / NATIVE INDEPENDENT SUPERVISION

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

Native supervision; converters, firmware, PCB and implant qualification remain

Sheet: /supervision/host_rails_2/
File: host_rails_2.kicad_sch
Title: ATO S4 / Host supply windows / 2

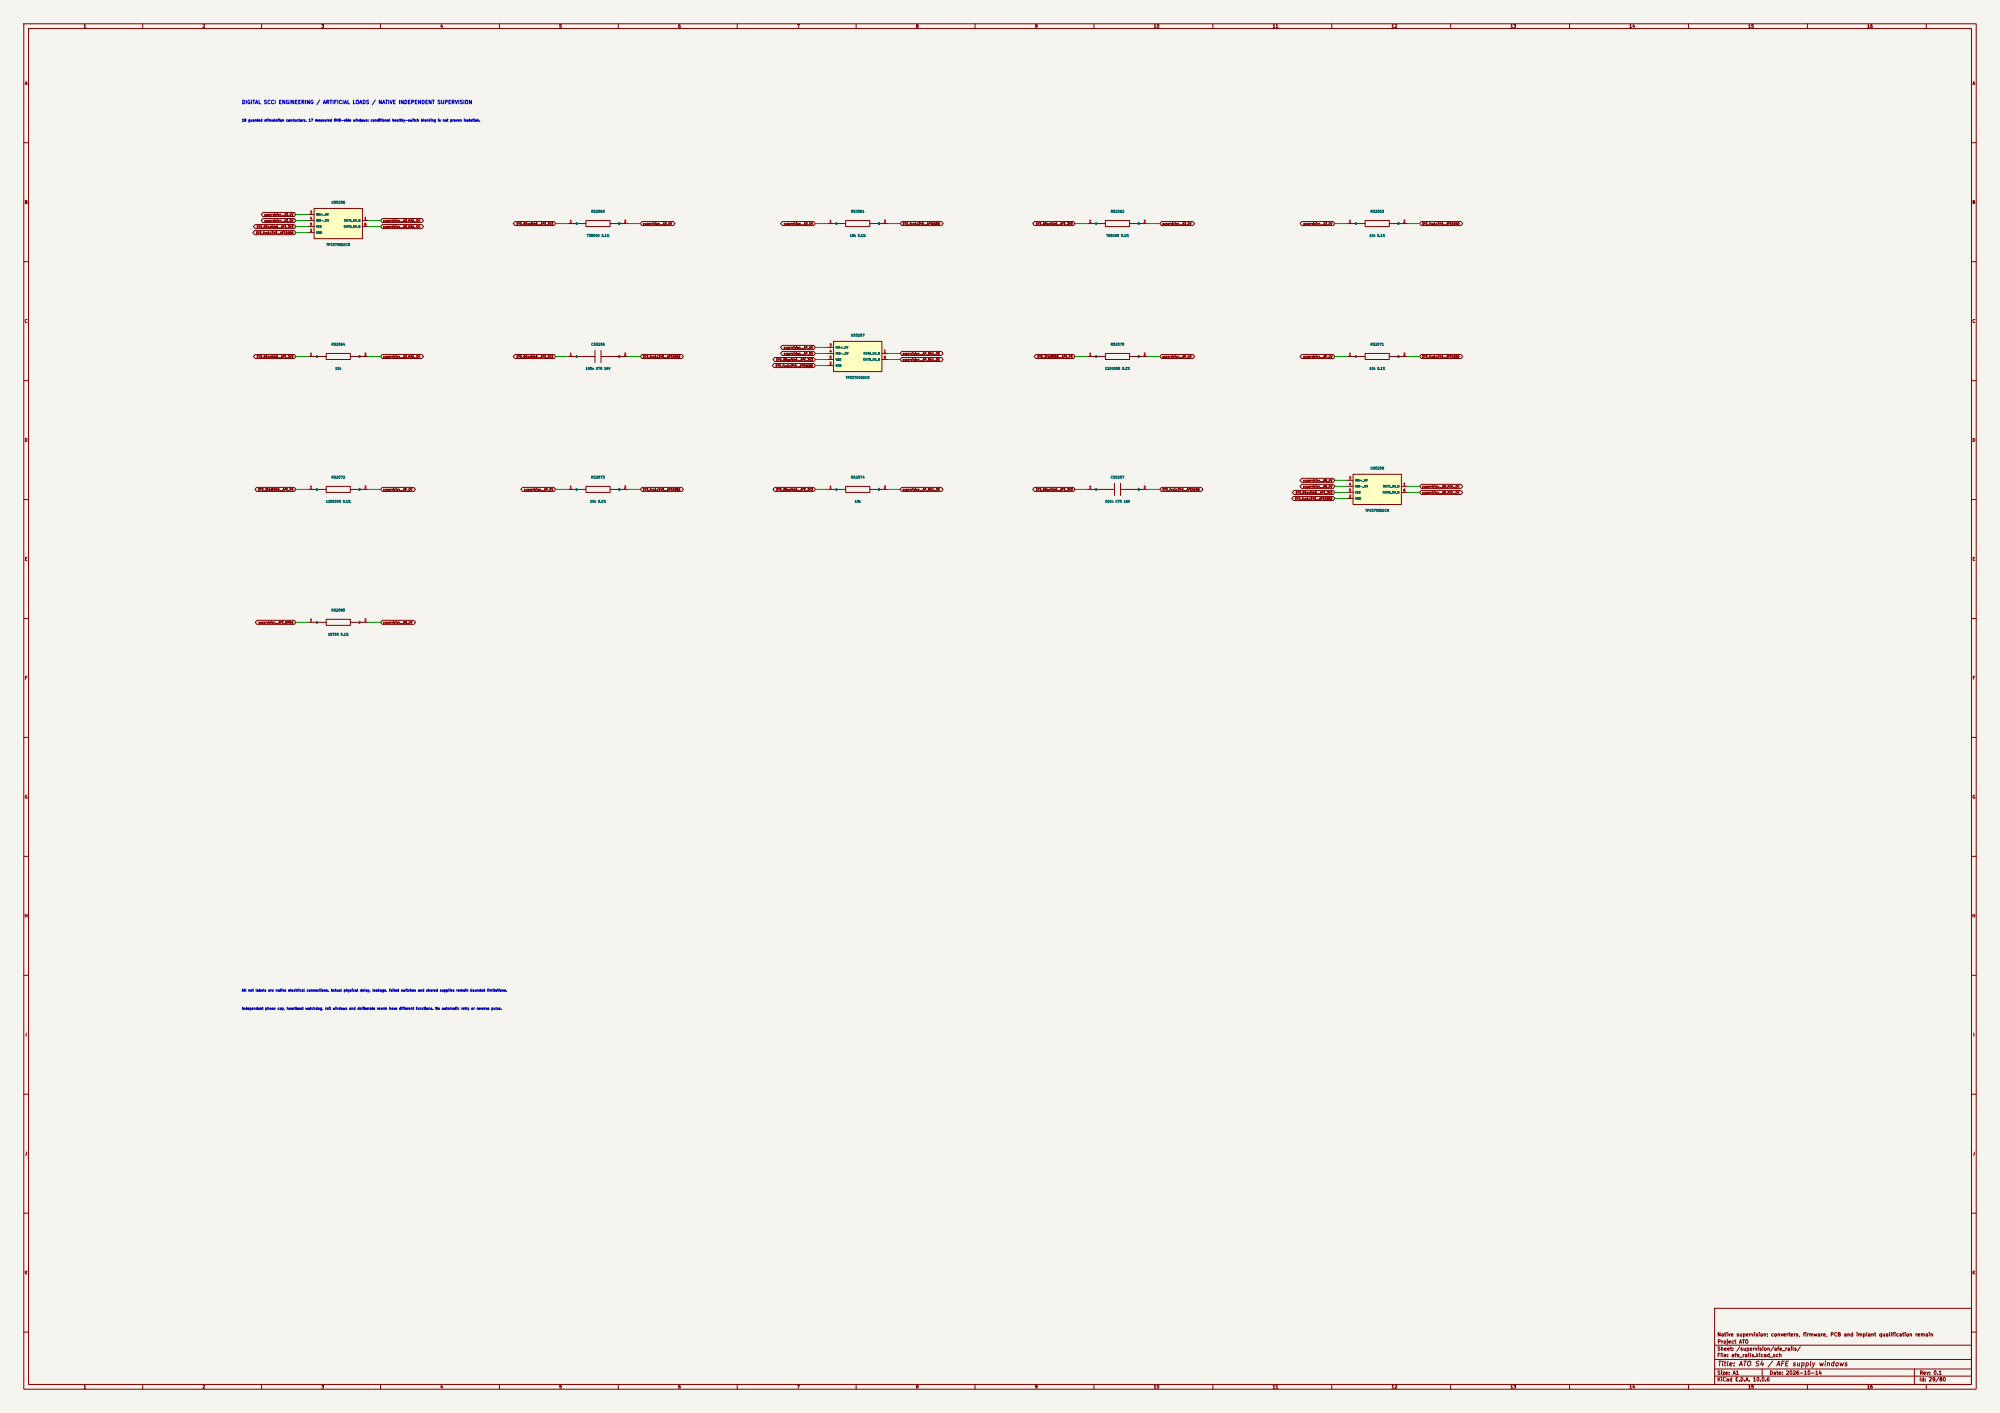
[picture p213: page 29]

DIGITAL SCCI ENGINEERING / ARTIFICIAL LOADS / NATIVE INDEPENDENT SUPERVISION

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

Native supervision; converters, firmware, PCB and implant qualification remain

Sheet: /supervision/afe_rails/
File: afe_rails.kicad_sch
Title: ATO S4 / AFE supply windows

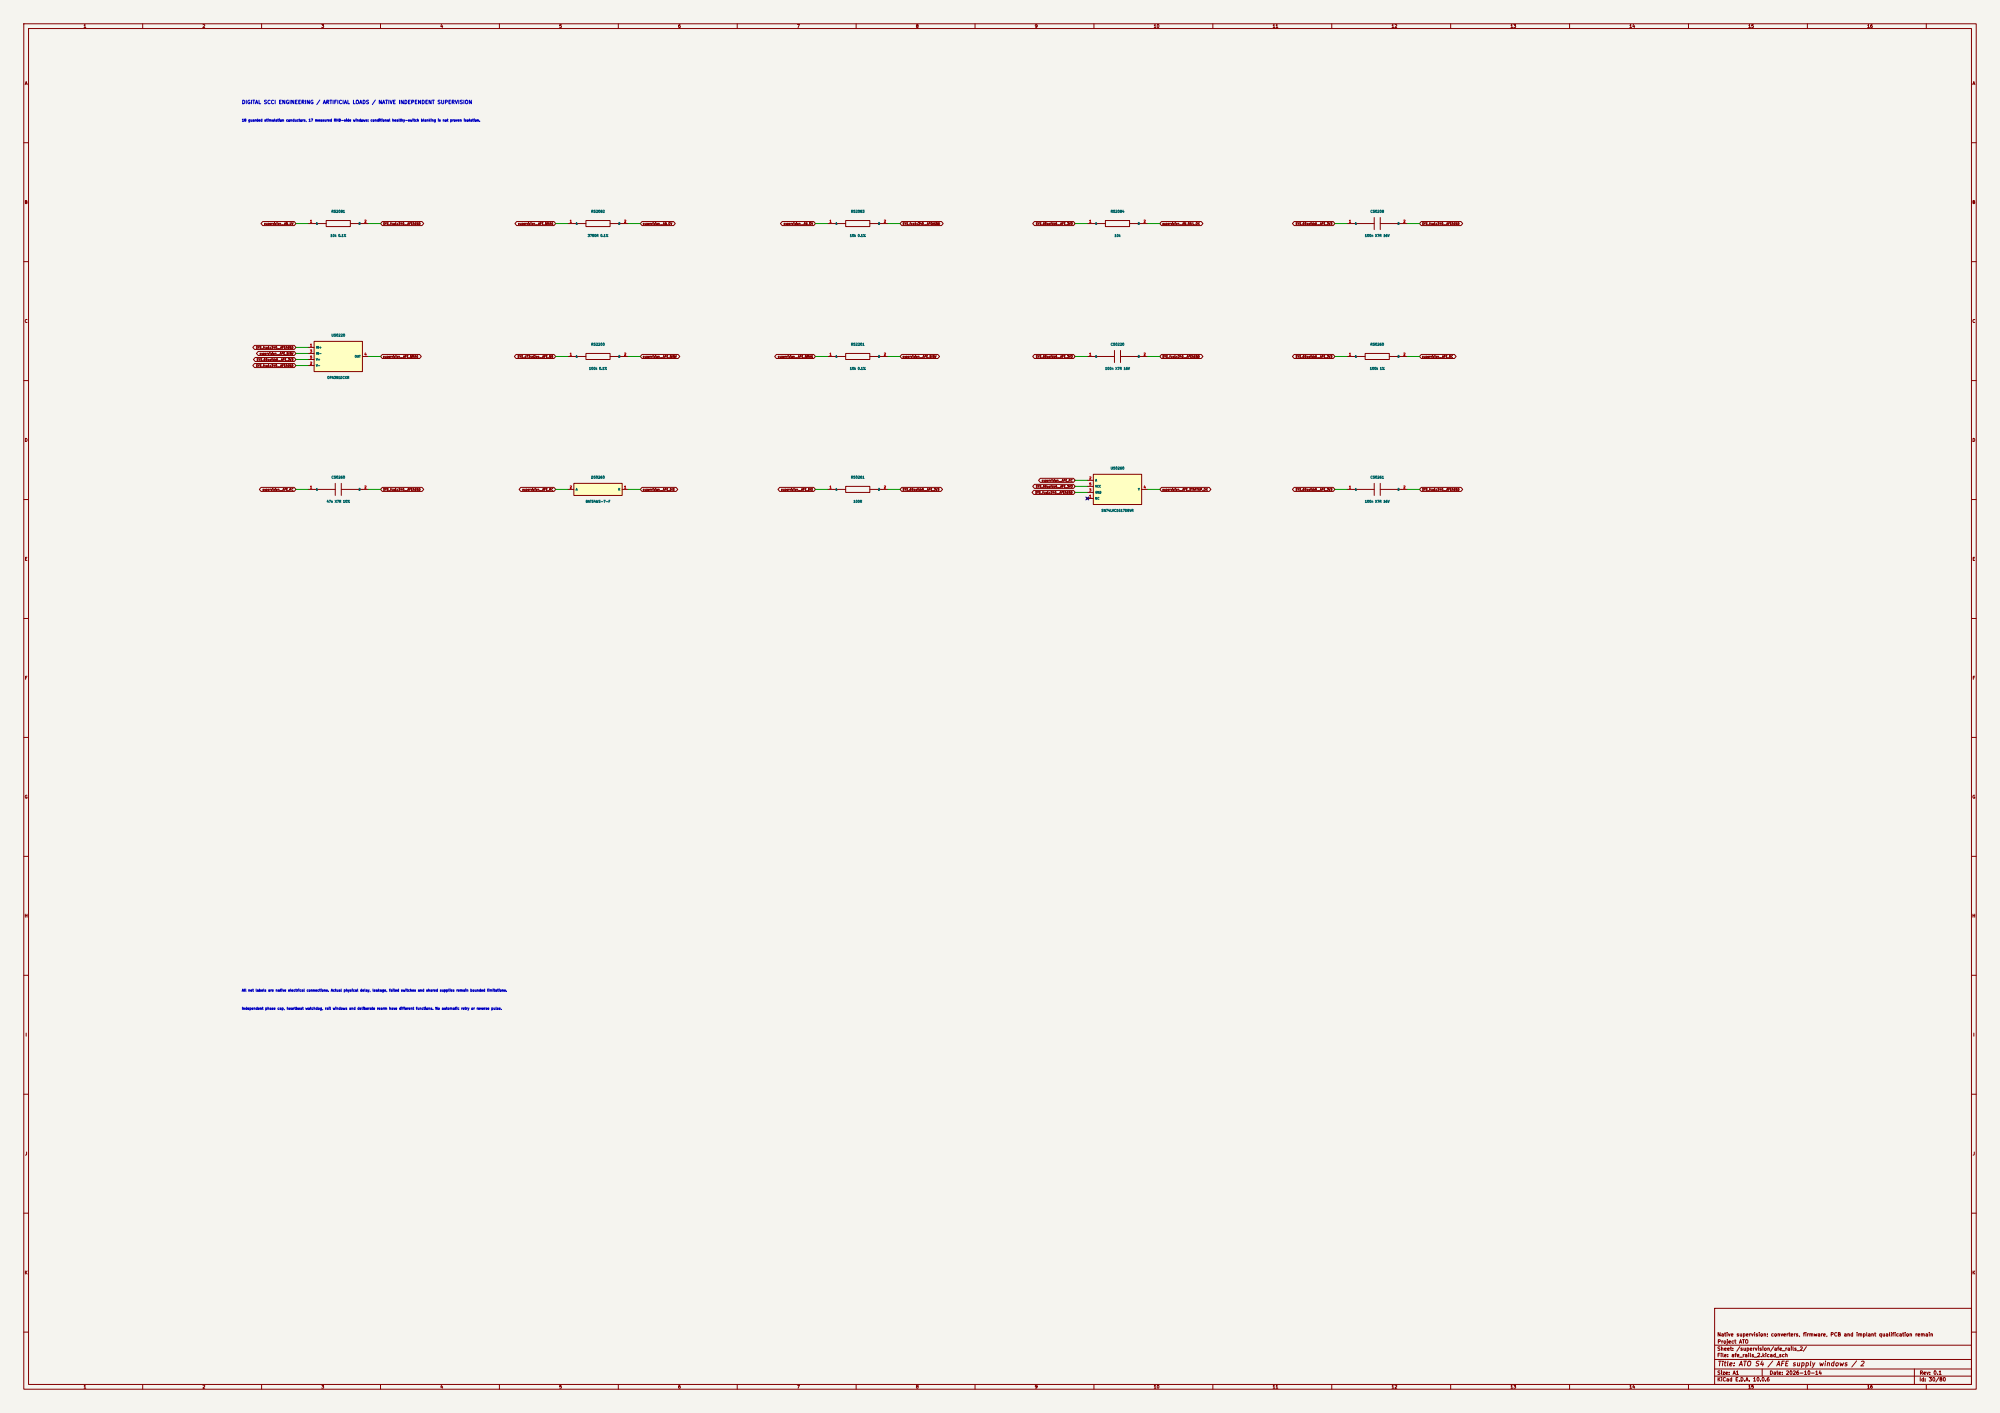
[picture p214: page 30]

DIGITAL SCCI ENGINEERING / ARTIFICIAL LOADS / NATIVE INDEPENDENT SUPERVISION

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

Native supervision; converters, firmware, PCB and implant qualification remain

Sheet: /supervision/afe_rails_2/
File: afe_rails_2.kicad_sch
Title: ATO S4 / AFE supply windows / 2

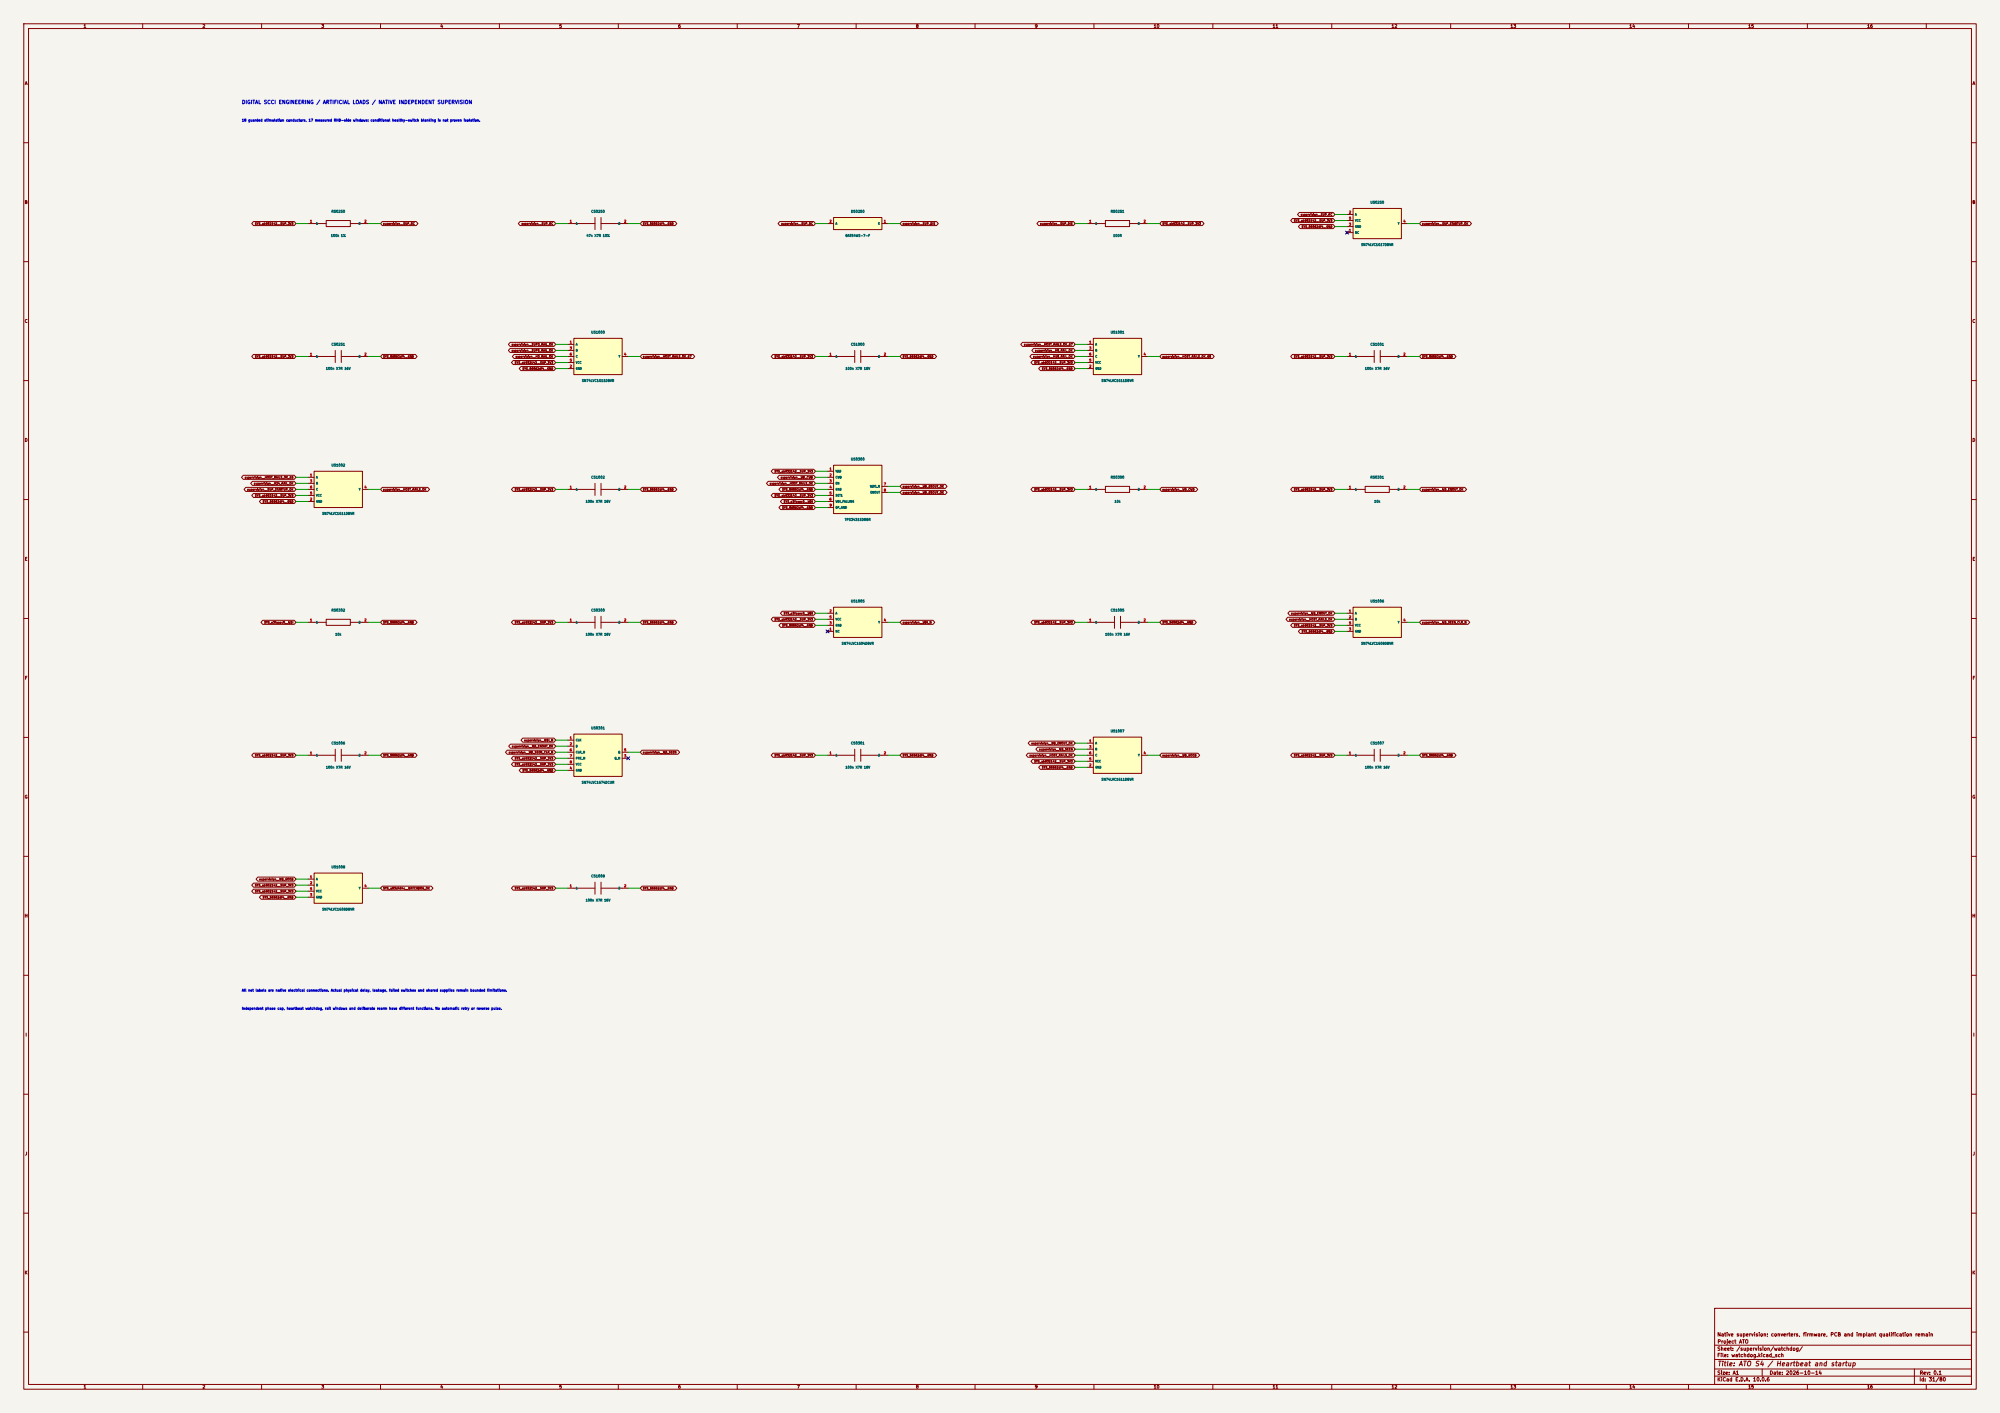
[picture p215: page 31]

DIGITAL SCCI ENGINEERING / ARTIFICIAL LOADS / NATIVE INDEPENDENT SUPERVISION

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

Native supervision; converters, firmware, PCB and implant qualification remain

Sheet: /supervision/watchdog/
File: watchdog.kicad_sch
Title: ATO S4 / Heartbeat and startup

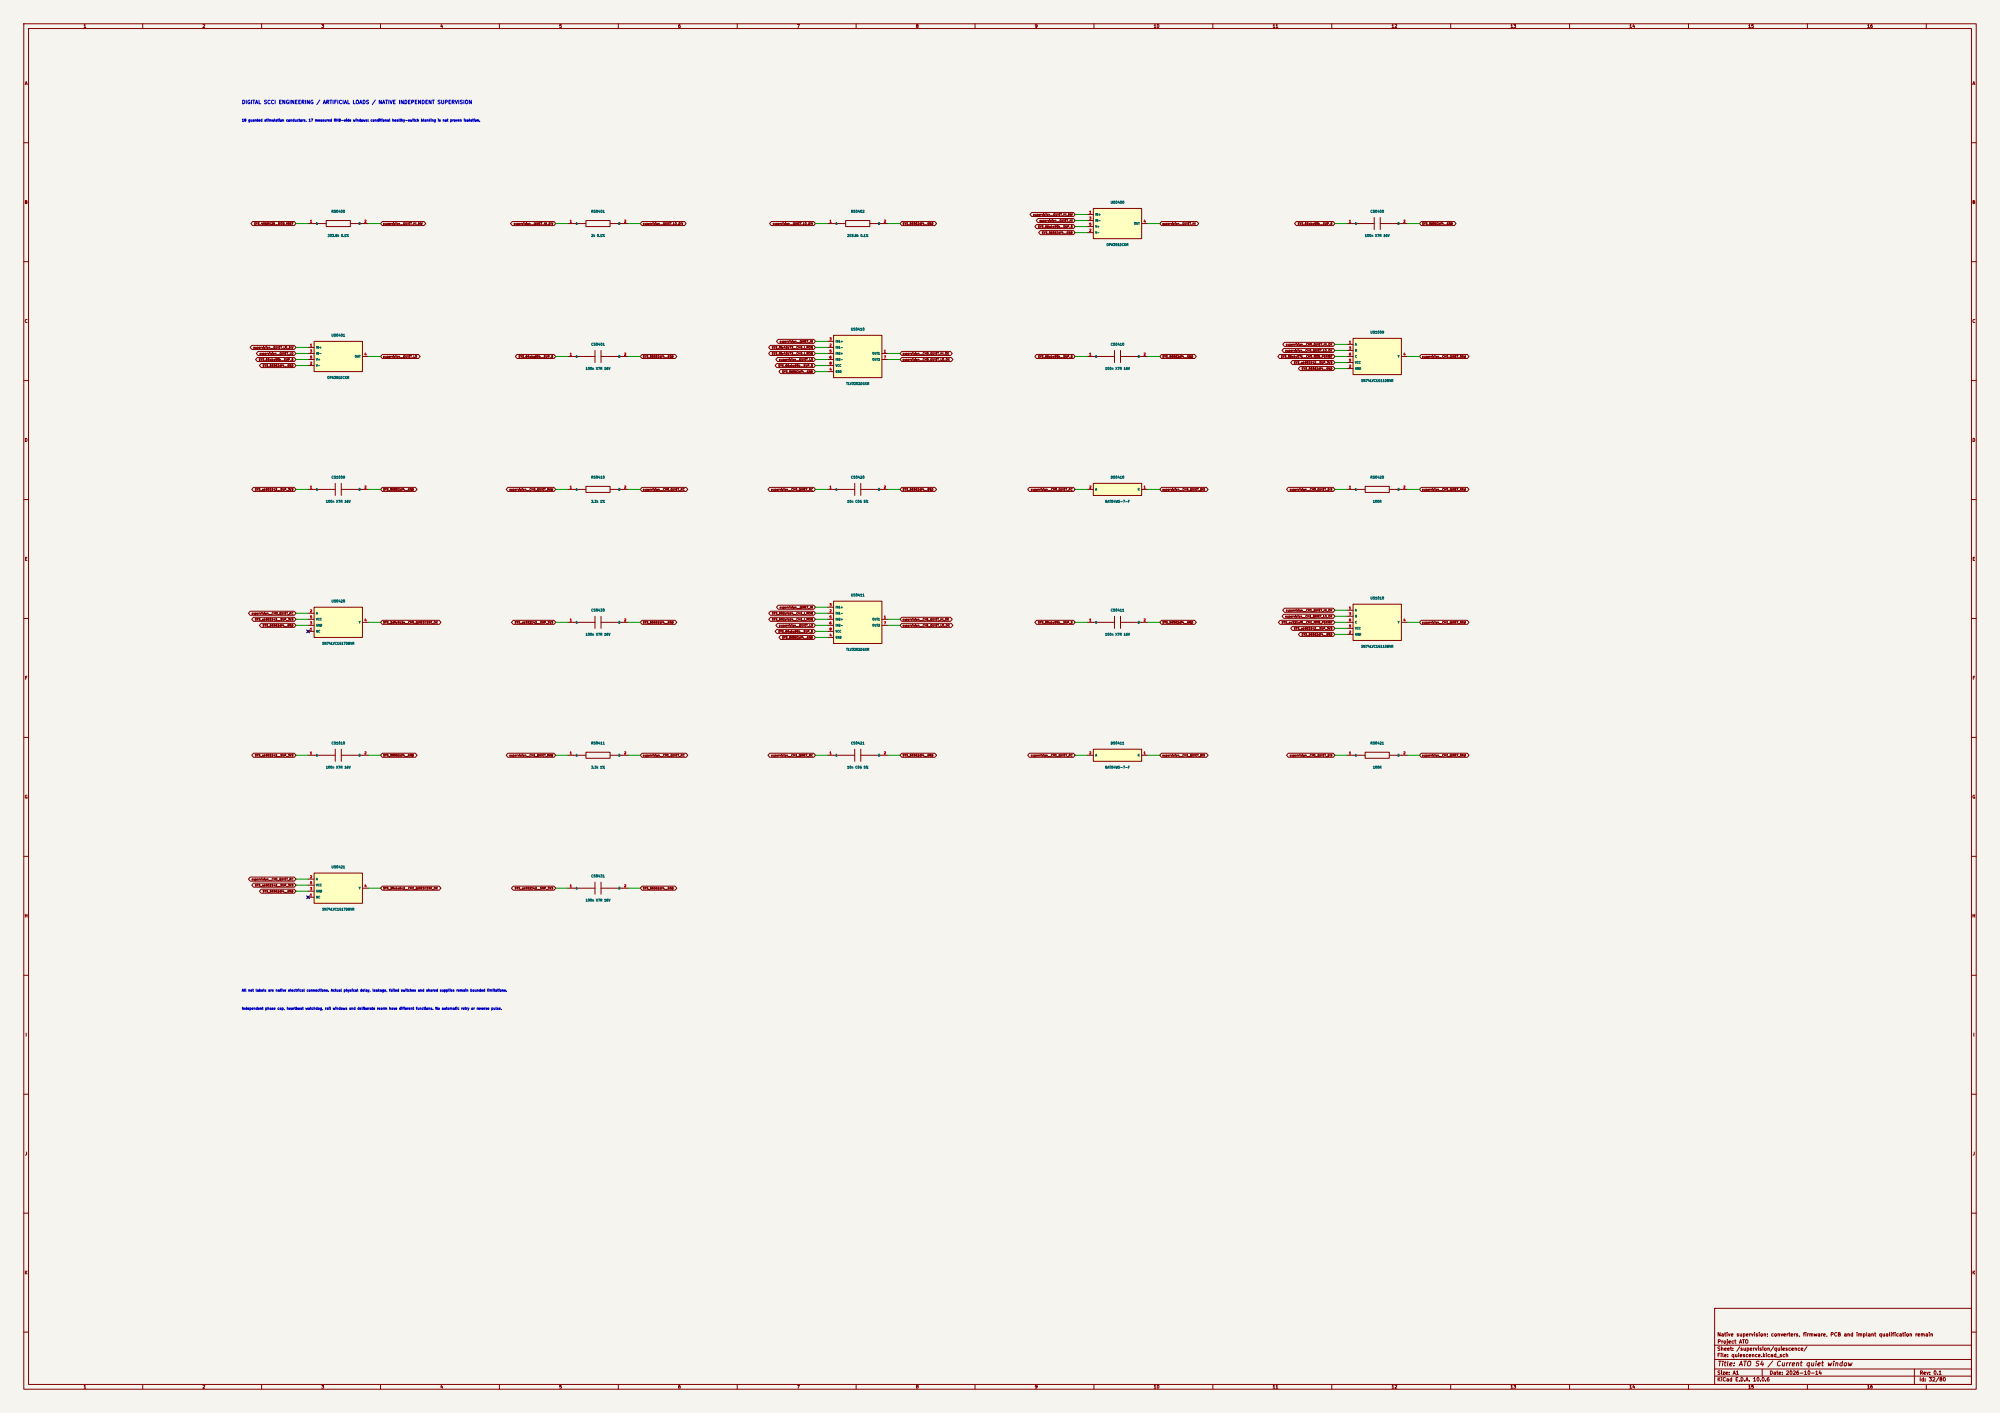
[picture p216: page 32]

DIGITAL SCCI ENGINEERING / ARTIFICIAL LOADS / NATIVE INDEPENDENT SUPERVISION

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

Native supervision; converters, firmware, PCB and implant qualification remain

Sheet: /supervision/quiescence/
File: quiescence.kicad_sch
Title: ATO S4 / Current quiet window

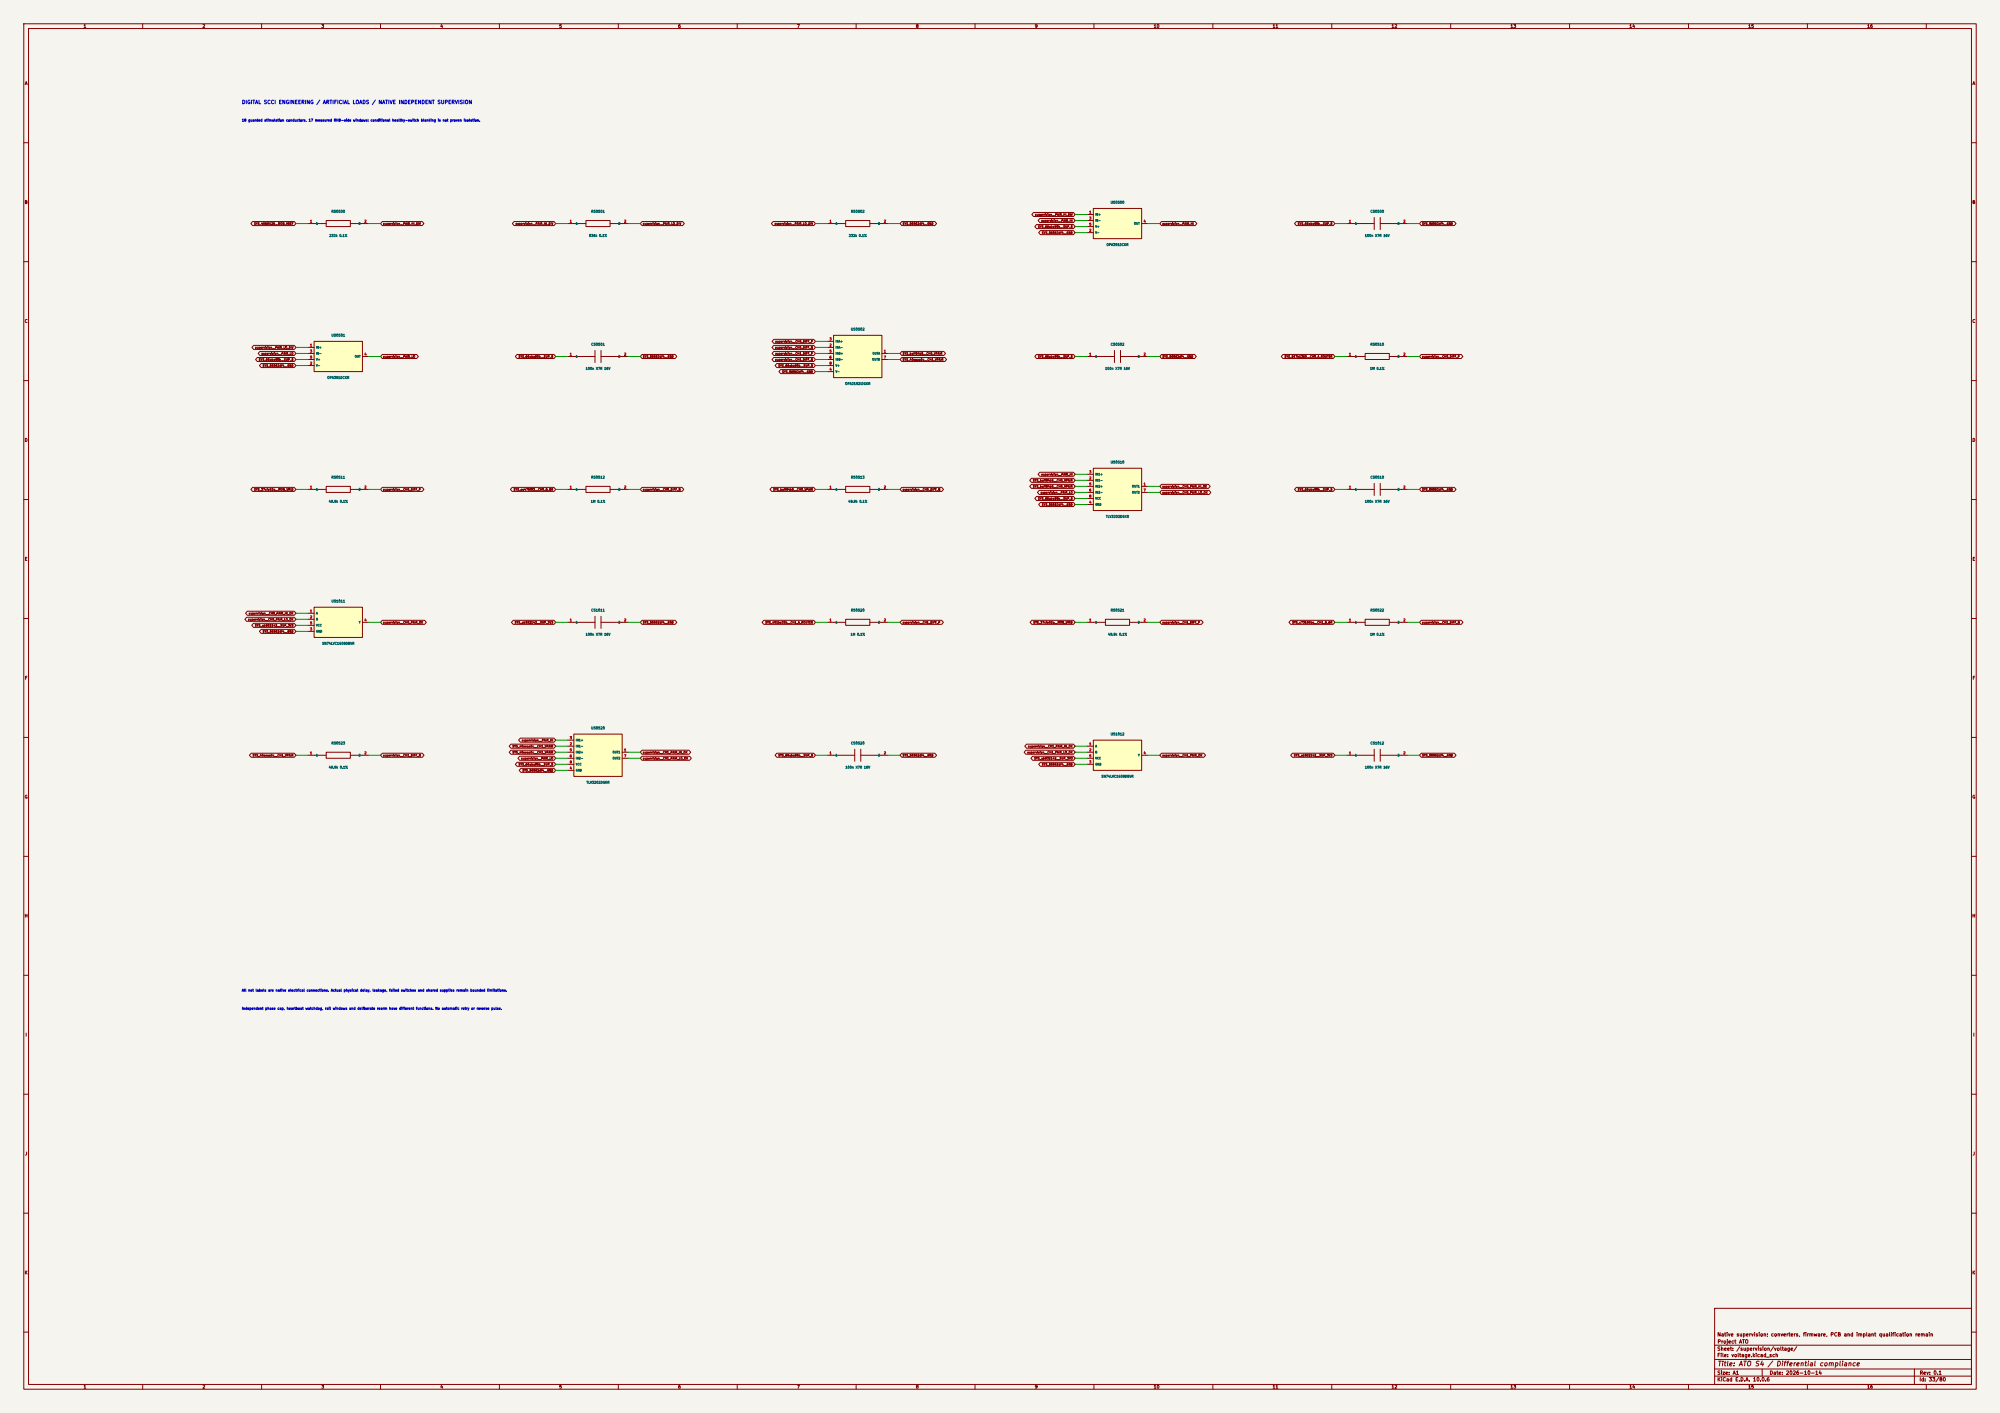
[picture p217: page 33]

18 guarded stimulation conductors, 17 measured RHD-side windows; conditional healthy-switch blanking is not proven isolation. DIGITAL SCCI ENGINEERING / ARTIFICIAL LOADS / NATIVE INDEPENDENT SUPERVISION

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

Native supervision; converters, firmware, PCB and implant qualification remain

Sheet: /supervision/voltage/
File: voltage.kicad_sch
Title: ATO S4 / Differential compliance

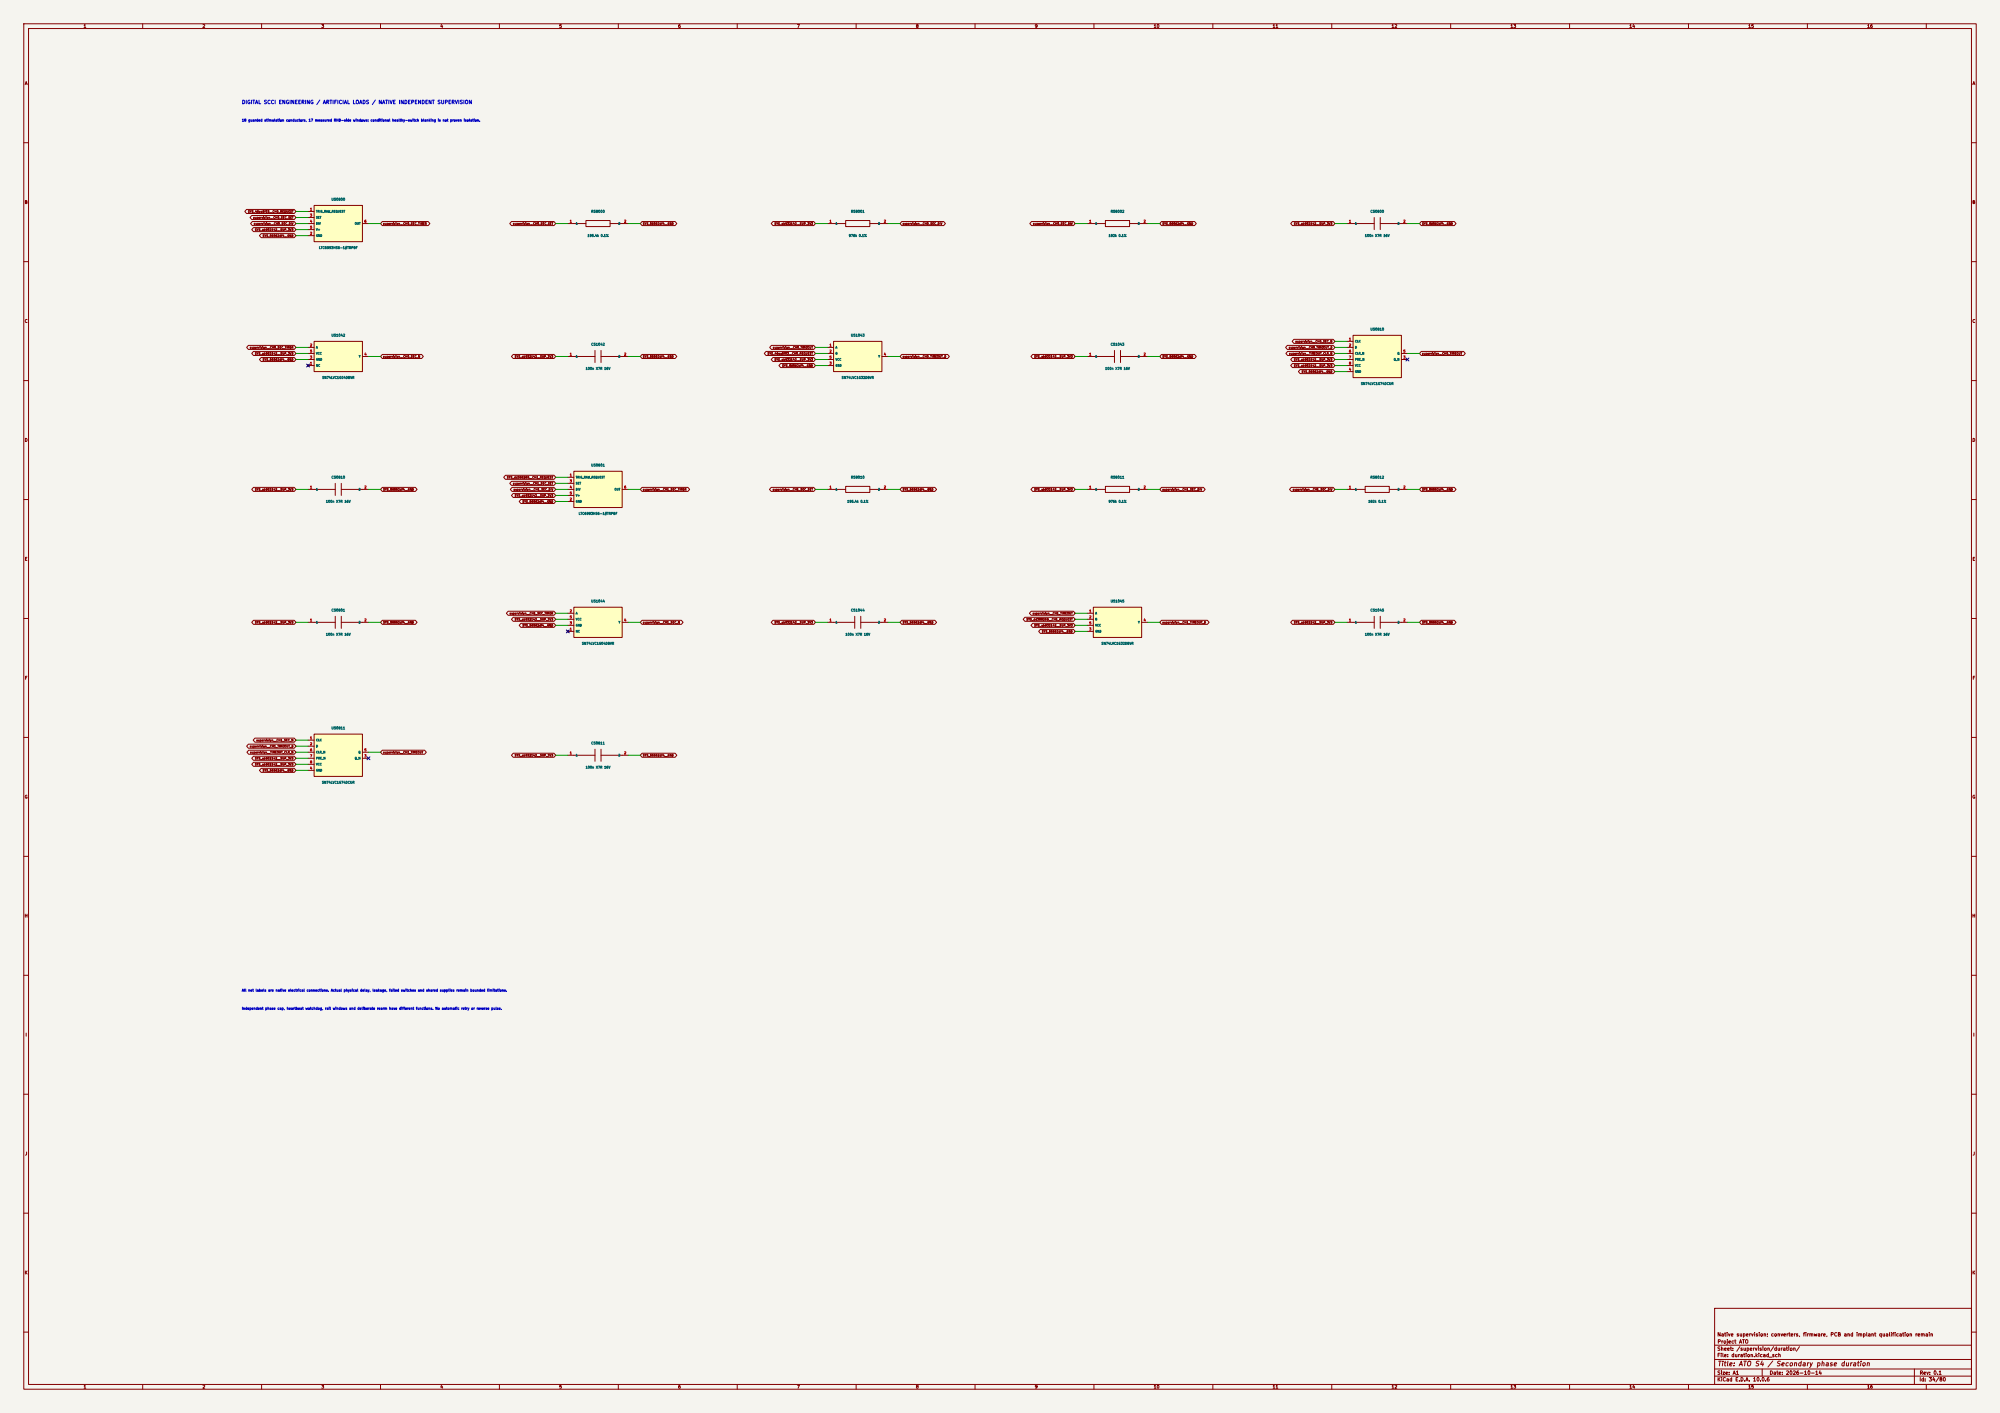
[picture p218: page 34]
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

Native supervision; converters, firmware, PCB and implant qualification remain

Sheet: /supervision/duration/
File: duration.kicad_sch
Title: ATO S4 / Secondary phase duration

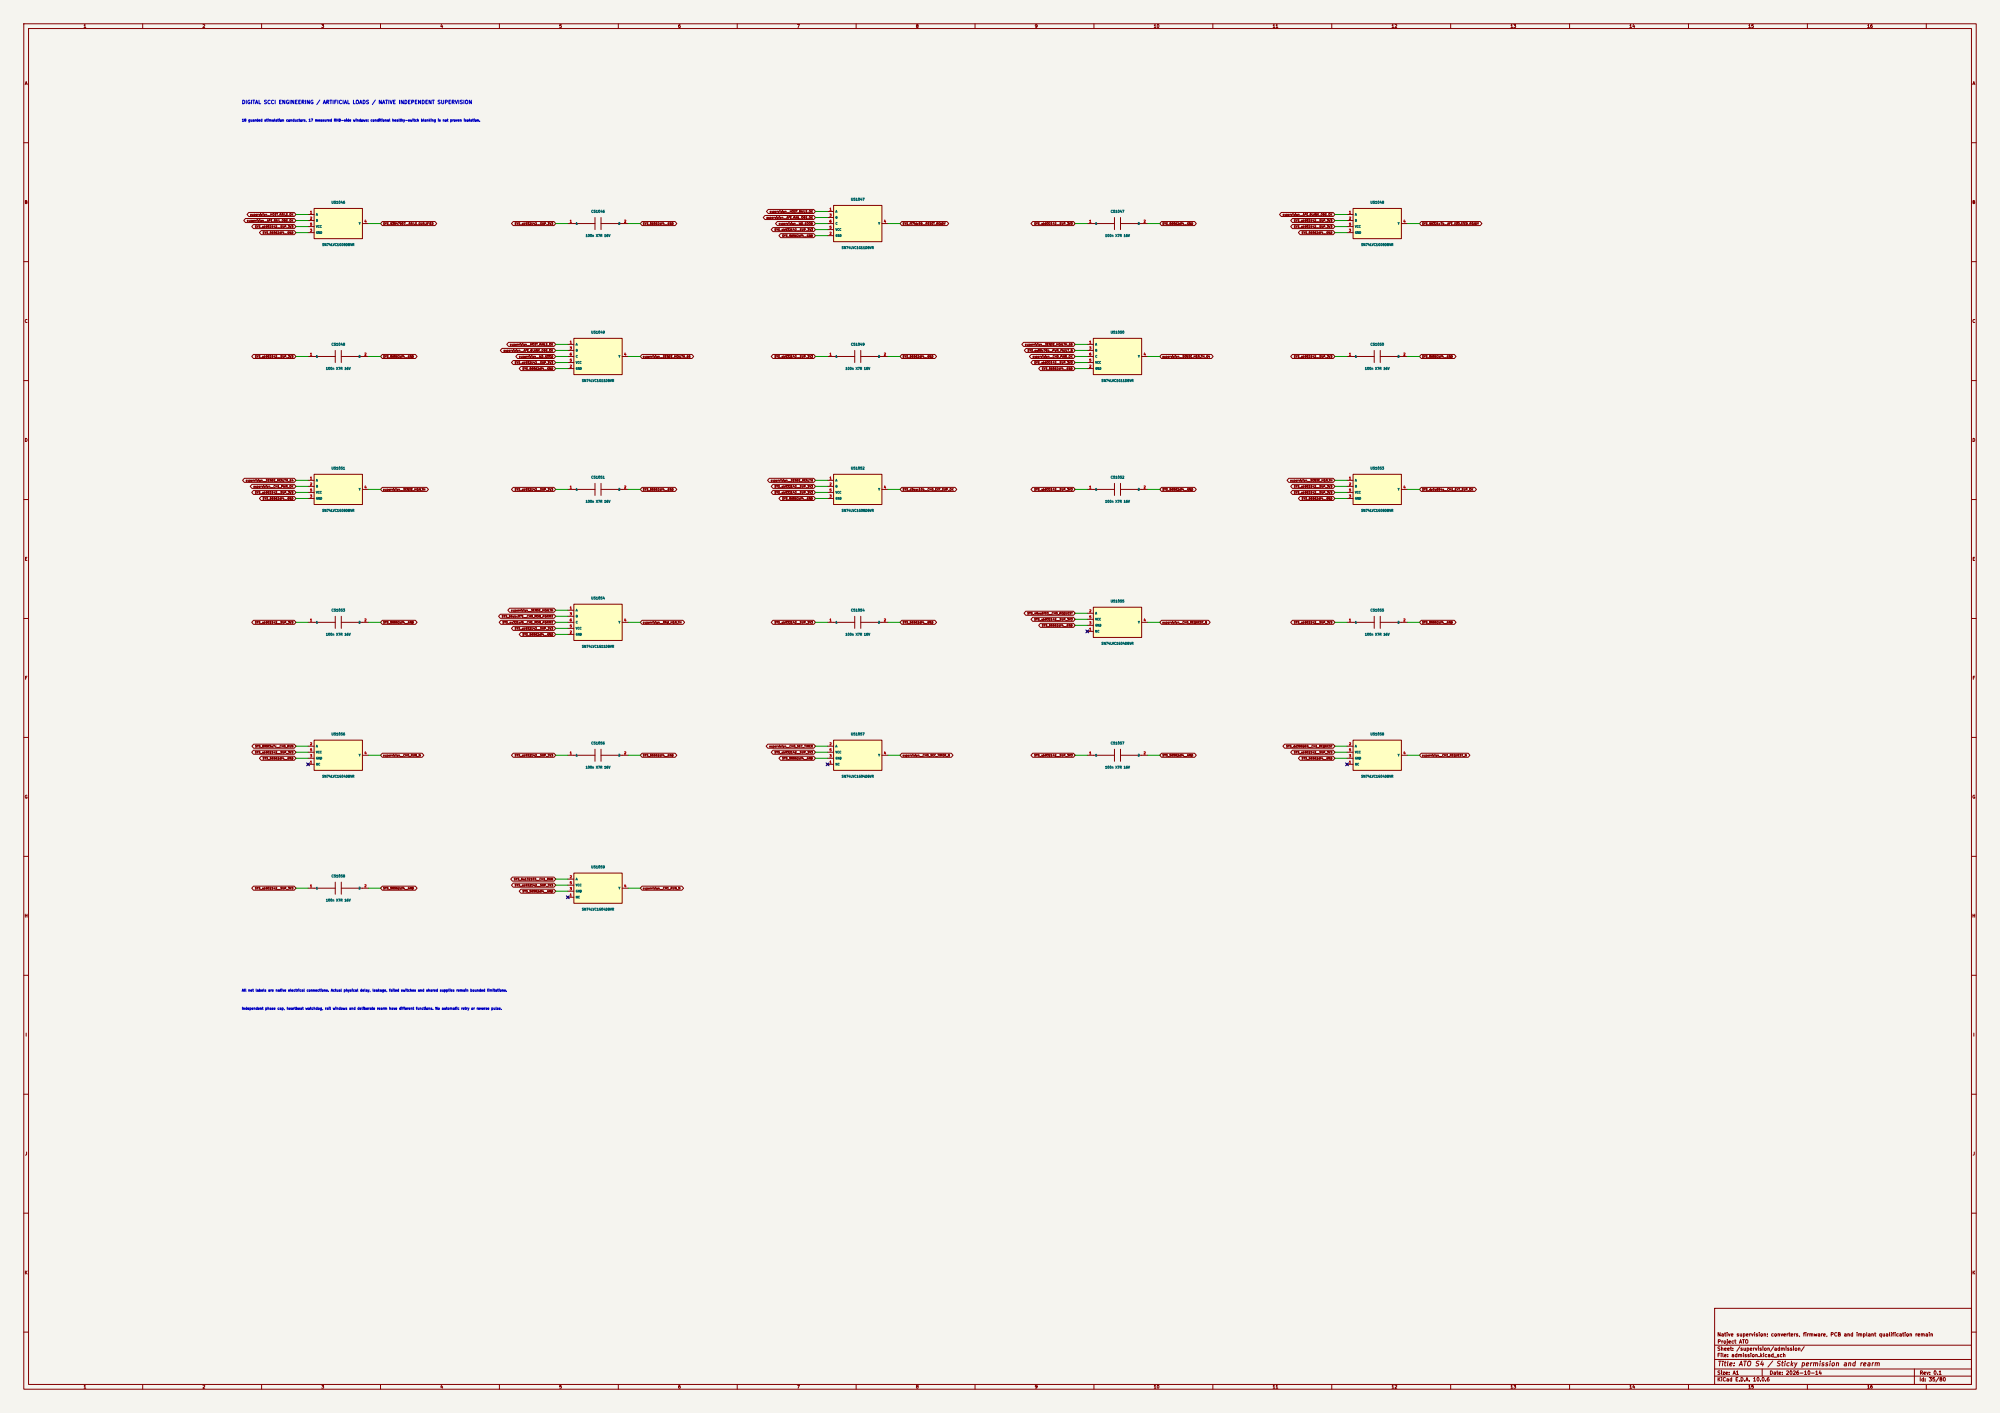
[picture p219: page 35]

DIGITAL SCCI ENGINEERING / ARTIFICIAL LOADS / NATIVE INDEPENDENT SUPERVISION

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

Native supervision; converters, firmware, PCB and implant qualification remain

Sheet: /supervision/admission/
File: admission.kicad_sch
Title: ATO S4 / Sticky permission and rearm

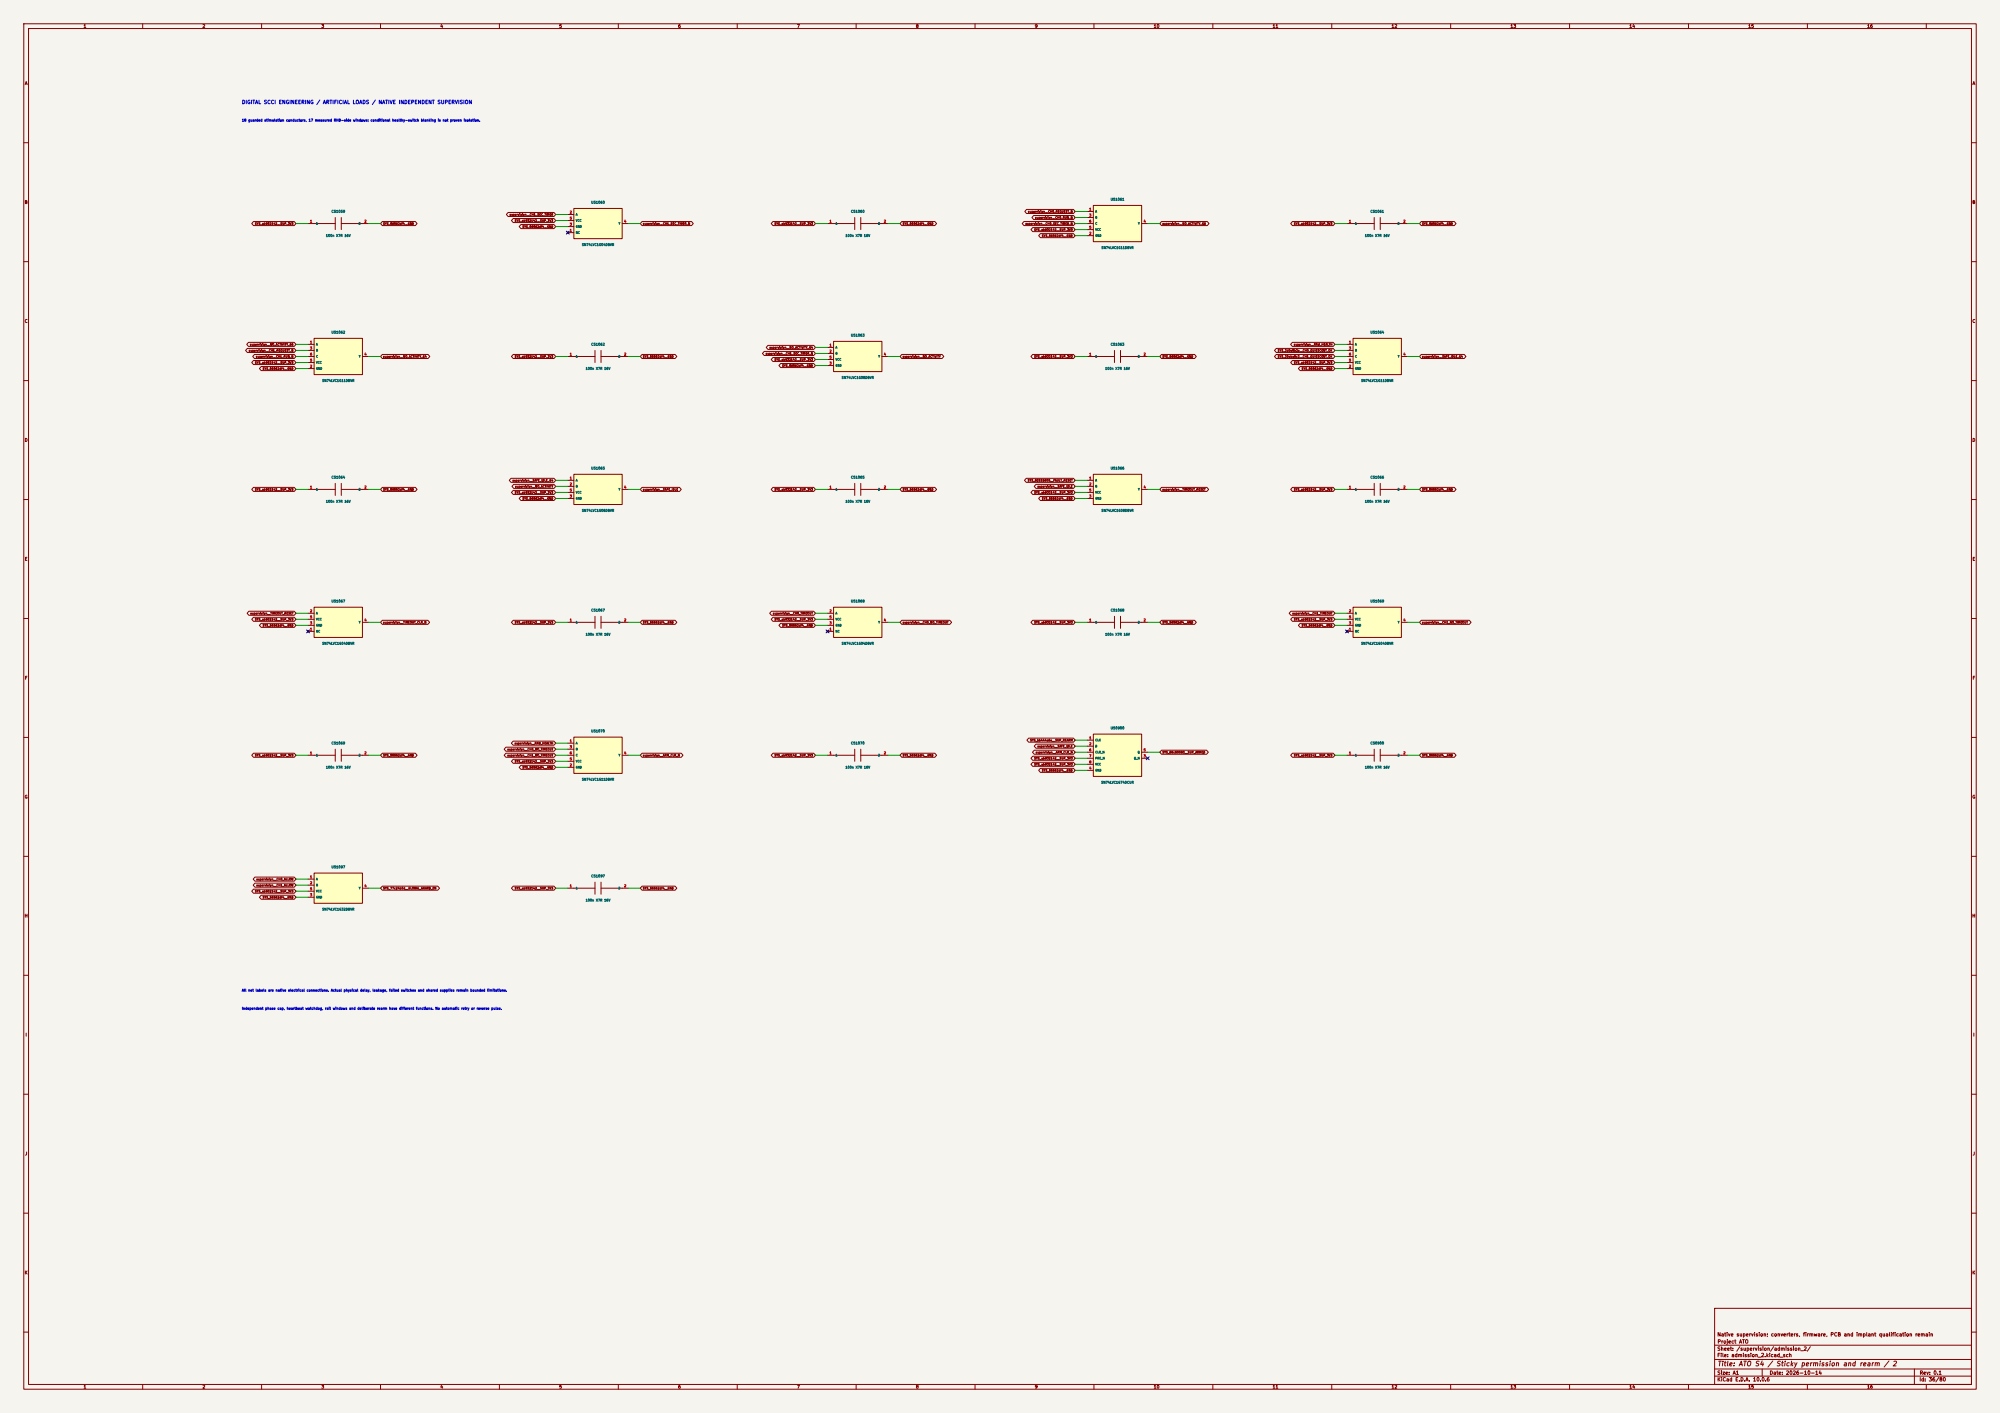
[picture p220: page 36]
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

Native supervision; converters, firmware, PCB and implant qualification remain
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
