pratham-cloud-ctrl/Project-ATO/electronics/stage4/contact-router/contact_router.pdf

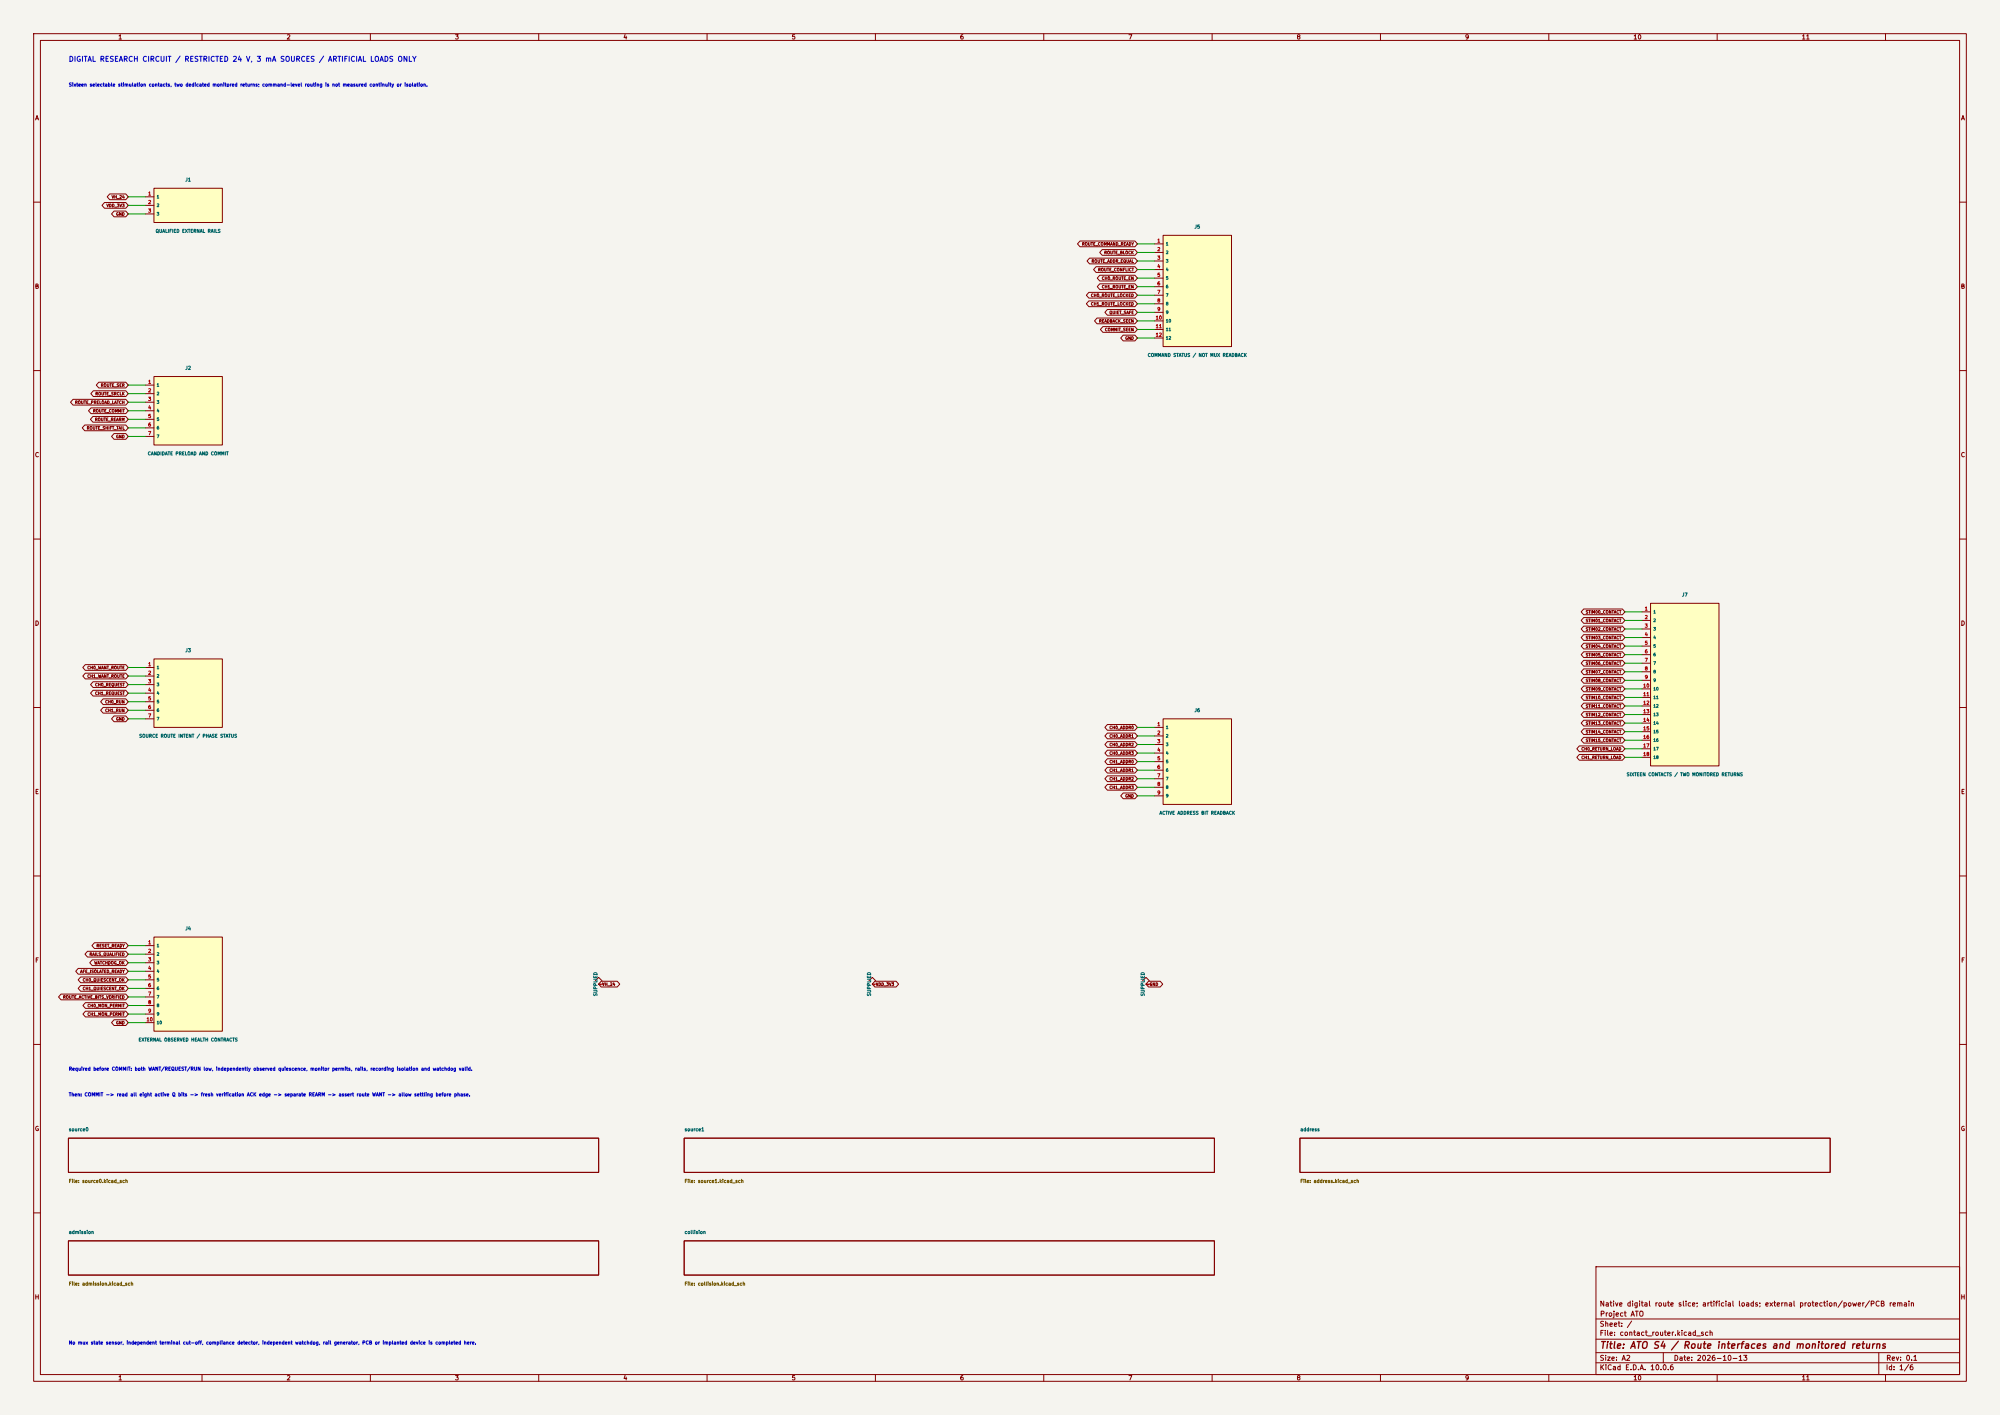
[picture p222: page 1]

Sixteen selectable stimulation contacts, two dedicated monitored returns; command-level routing is not measured continuity or isolation. DIGITAL RESEARCH CIRCUIT / RESTRICTED 24 V, 3 mA SOURCES / ARTIFICIAL LOADS ONLY

COMMAND STATUS / NOT MUX READBACK

SOURCE ROUTE INTENT / PHASE STATUS

SIXTEEN CONTACTS / TWO MONITORED RETURNS

ACTIVE ADDRESS BIT READBACK

Required before COMMIT: both WANT/REQUEST/RUN low, independently observed quiescence, monitor permits, rails, recording isolation and watchdog valid. Then: COMMIT -> read all eight active Q bits -> fresh verification ACK edge -> separate REARM -> assert route WANT -> allow settling before phase. No mux state sensor, independent terminal cut-off, compliance detector, independent watchdog, rail generator, PCB or implanted device is completed here.

Native digital route slice; artificial loads; external protection/power/PCB remain
Project ATO
Sheet: /
File: contact_router.kicad_sch
Title: ATO S4 / Route interfaces and monitored returns

Size: A2 | Rev: 0.1
KiCad E.D.A. 10.0.6 | Id: 1/6

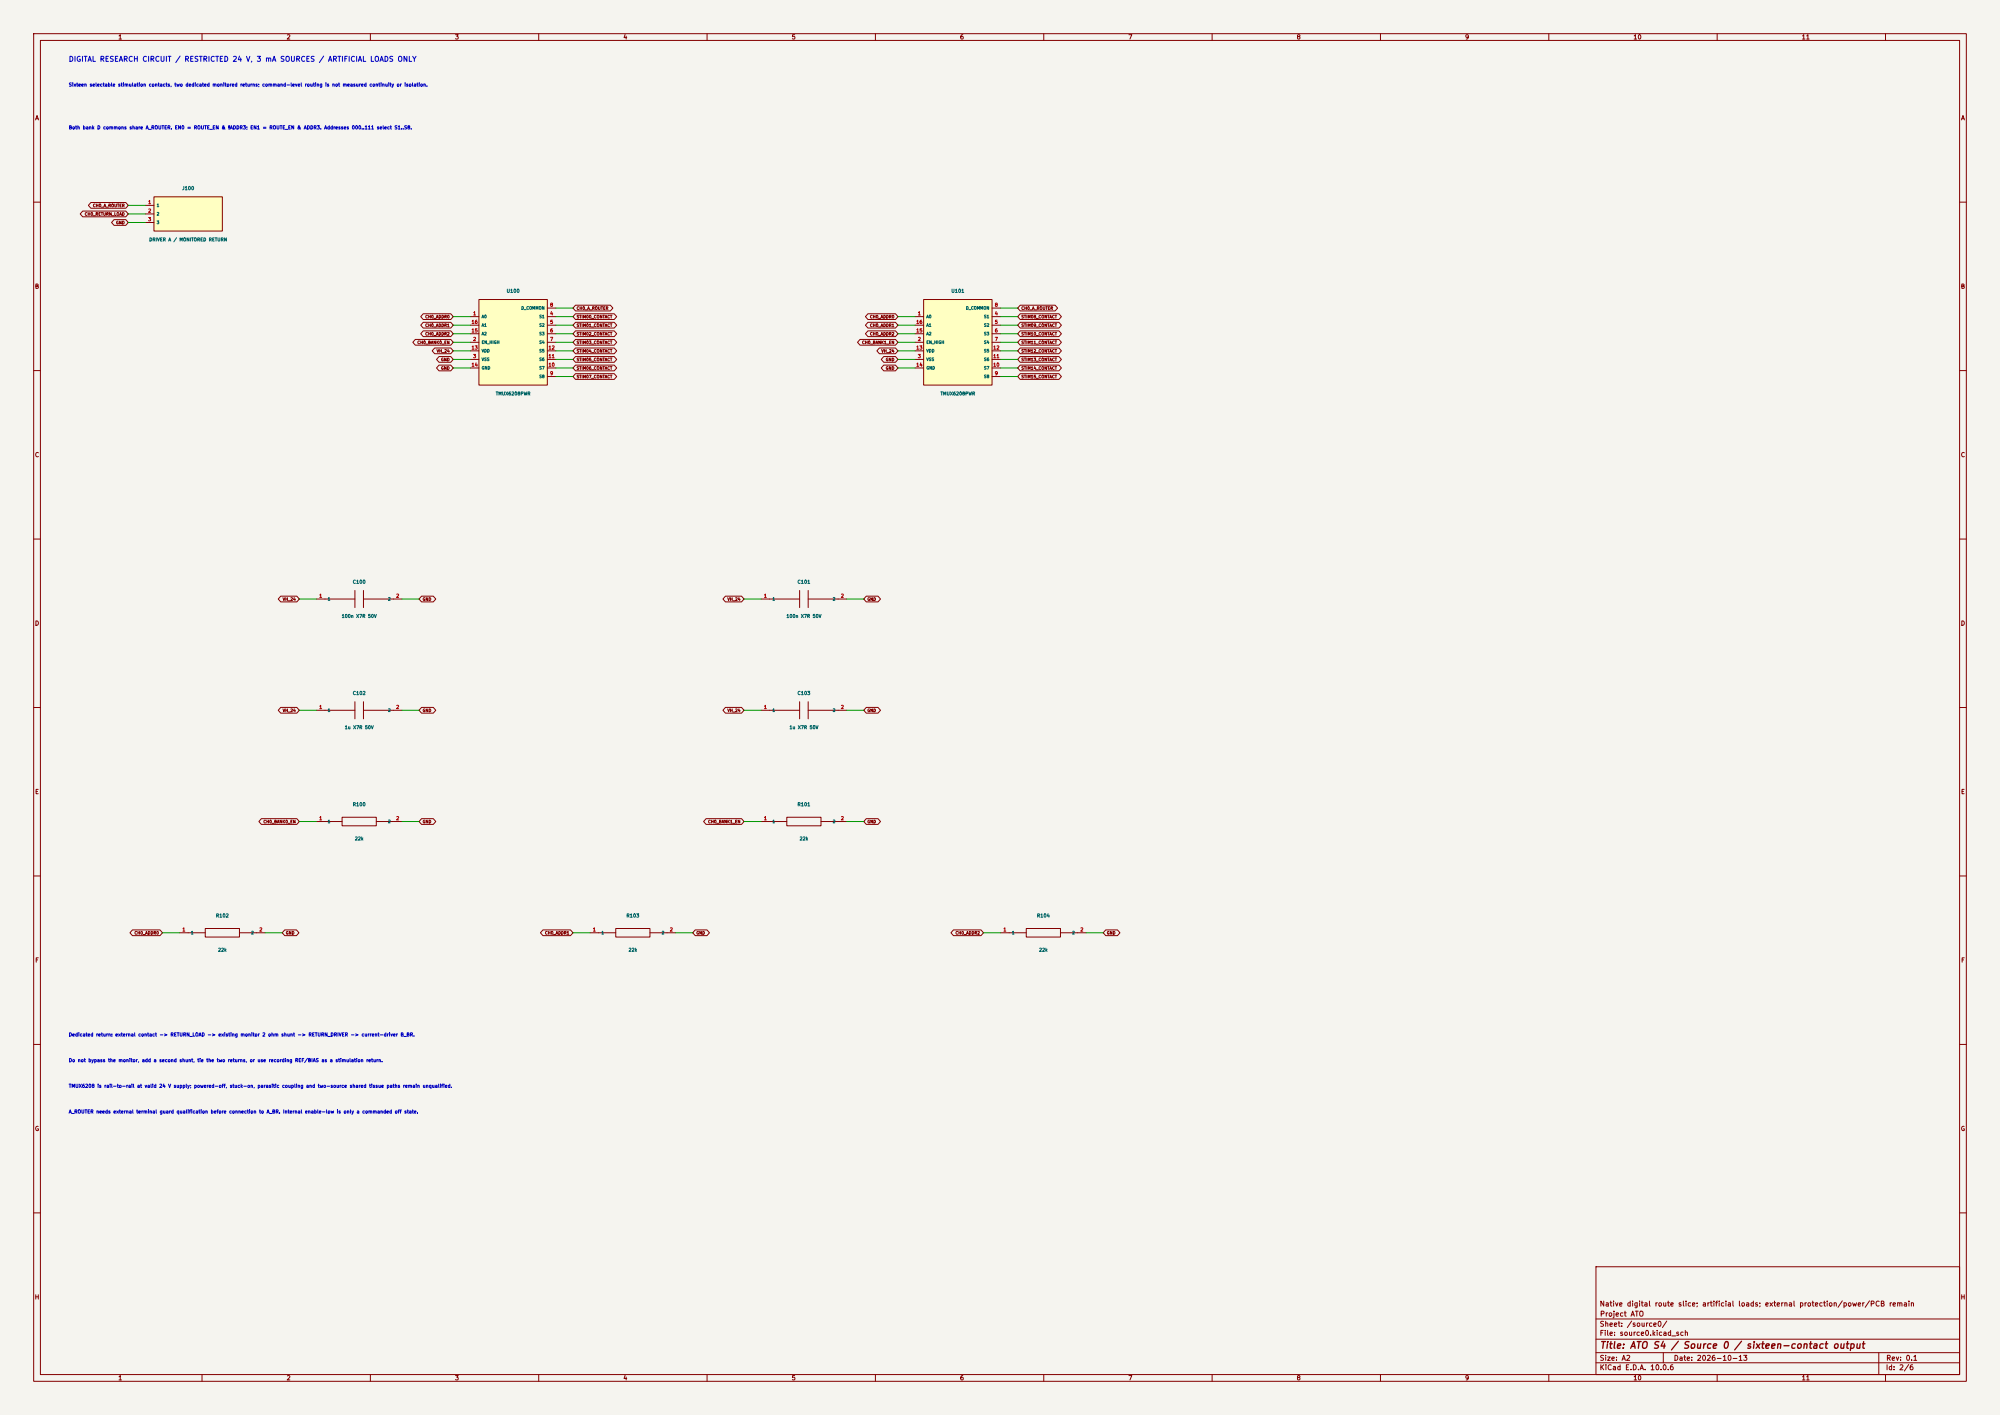
[picture p223: page 2]

DIGITAL RESEARCH CIRCUIT / RESTRICTED 24 V, 3 mA SOURCES / ARTIFICIAL LOADS ONLY

Sixteen selectable stimulation contacts, two dedicated monitored returns; command-level routing is not measured continuity or isolation. Both bank D commons share A_ROUTER. EN0 = ROUTE_EN & !ADDR3; EN1 = ROUTE_EN & ADDR3. Addresses 000..111 select S1..S8.

Dedicated return: external contact -> RETURN_LOAD -> existing monitor 2 ohm shunt -> RETURN_DRIVER -> current-driver B_BR. TMUX6208 is rail-to-rail at valid 24 V supply; powered-off, stuck-on, parasitic coupling and two-source shared tissue paths remain unqualified. A_ROUTER needs external terminal guard qualification before connection to A_BR. Internal enable-low is only a commanded off state. Do not bypass the monitor, add a second shunt, tie the two returns, or use recording REF/BIAS as a stimulation return.

Sheet: /source0/
File: source0.kicad_sch
Title: ATO S4 / Source 0 / sixteen-contact output

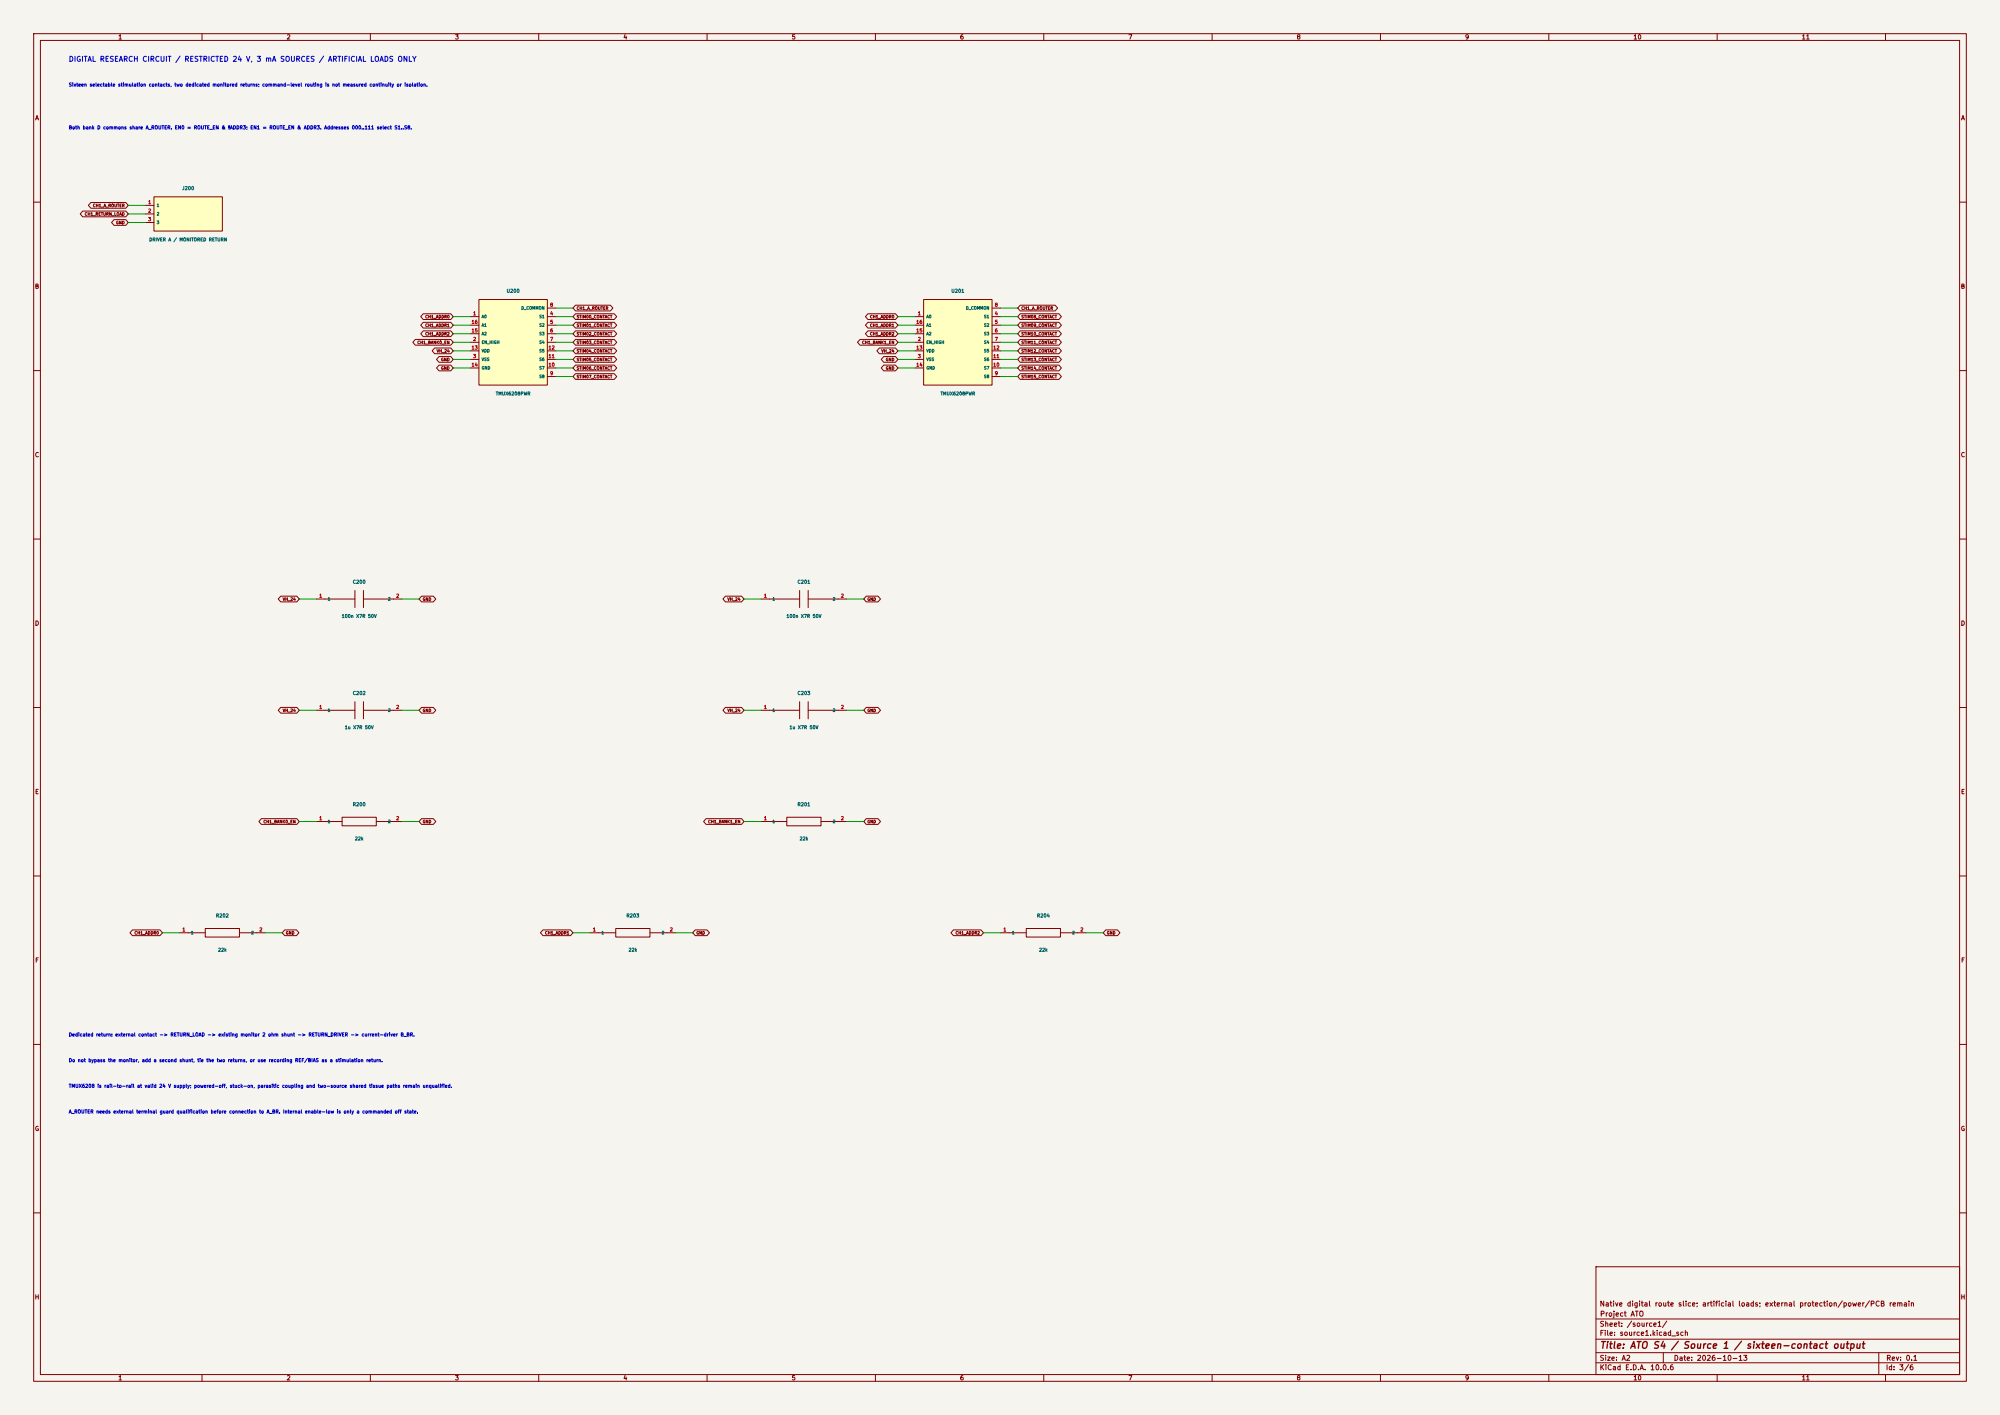
[picture p224: page 3]
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

Sheet: /source1/
File: source1.kicad_sch
Title: ATO S4 / Source 1 / sixteen-contact output

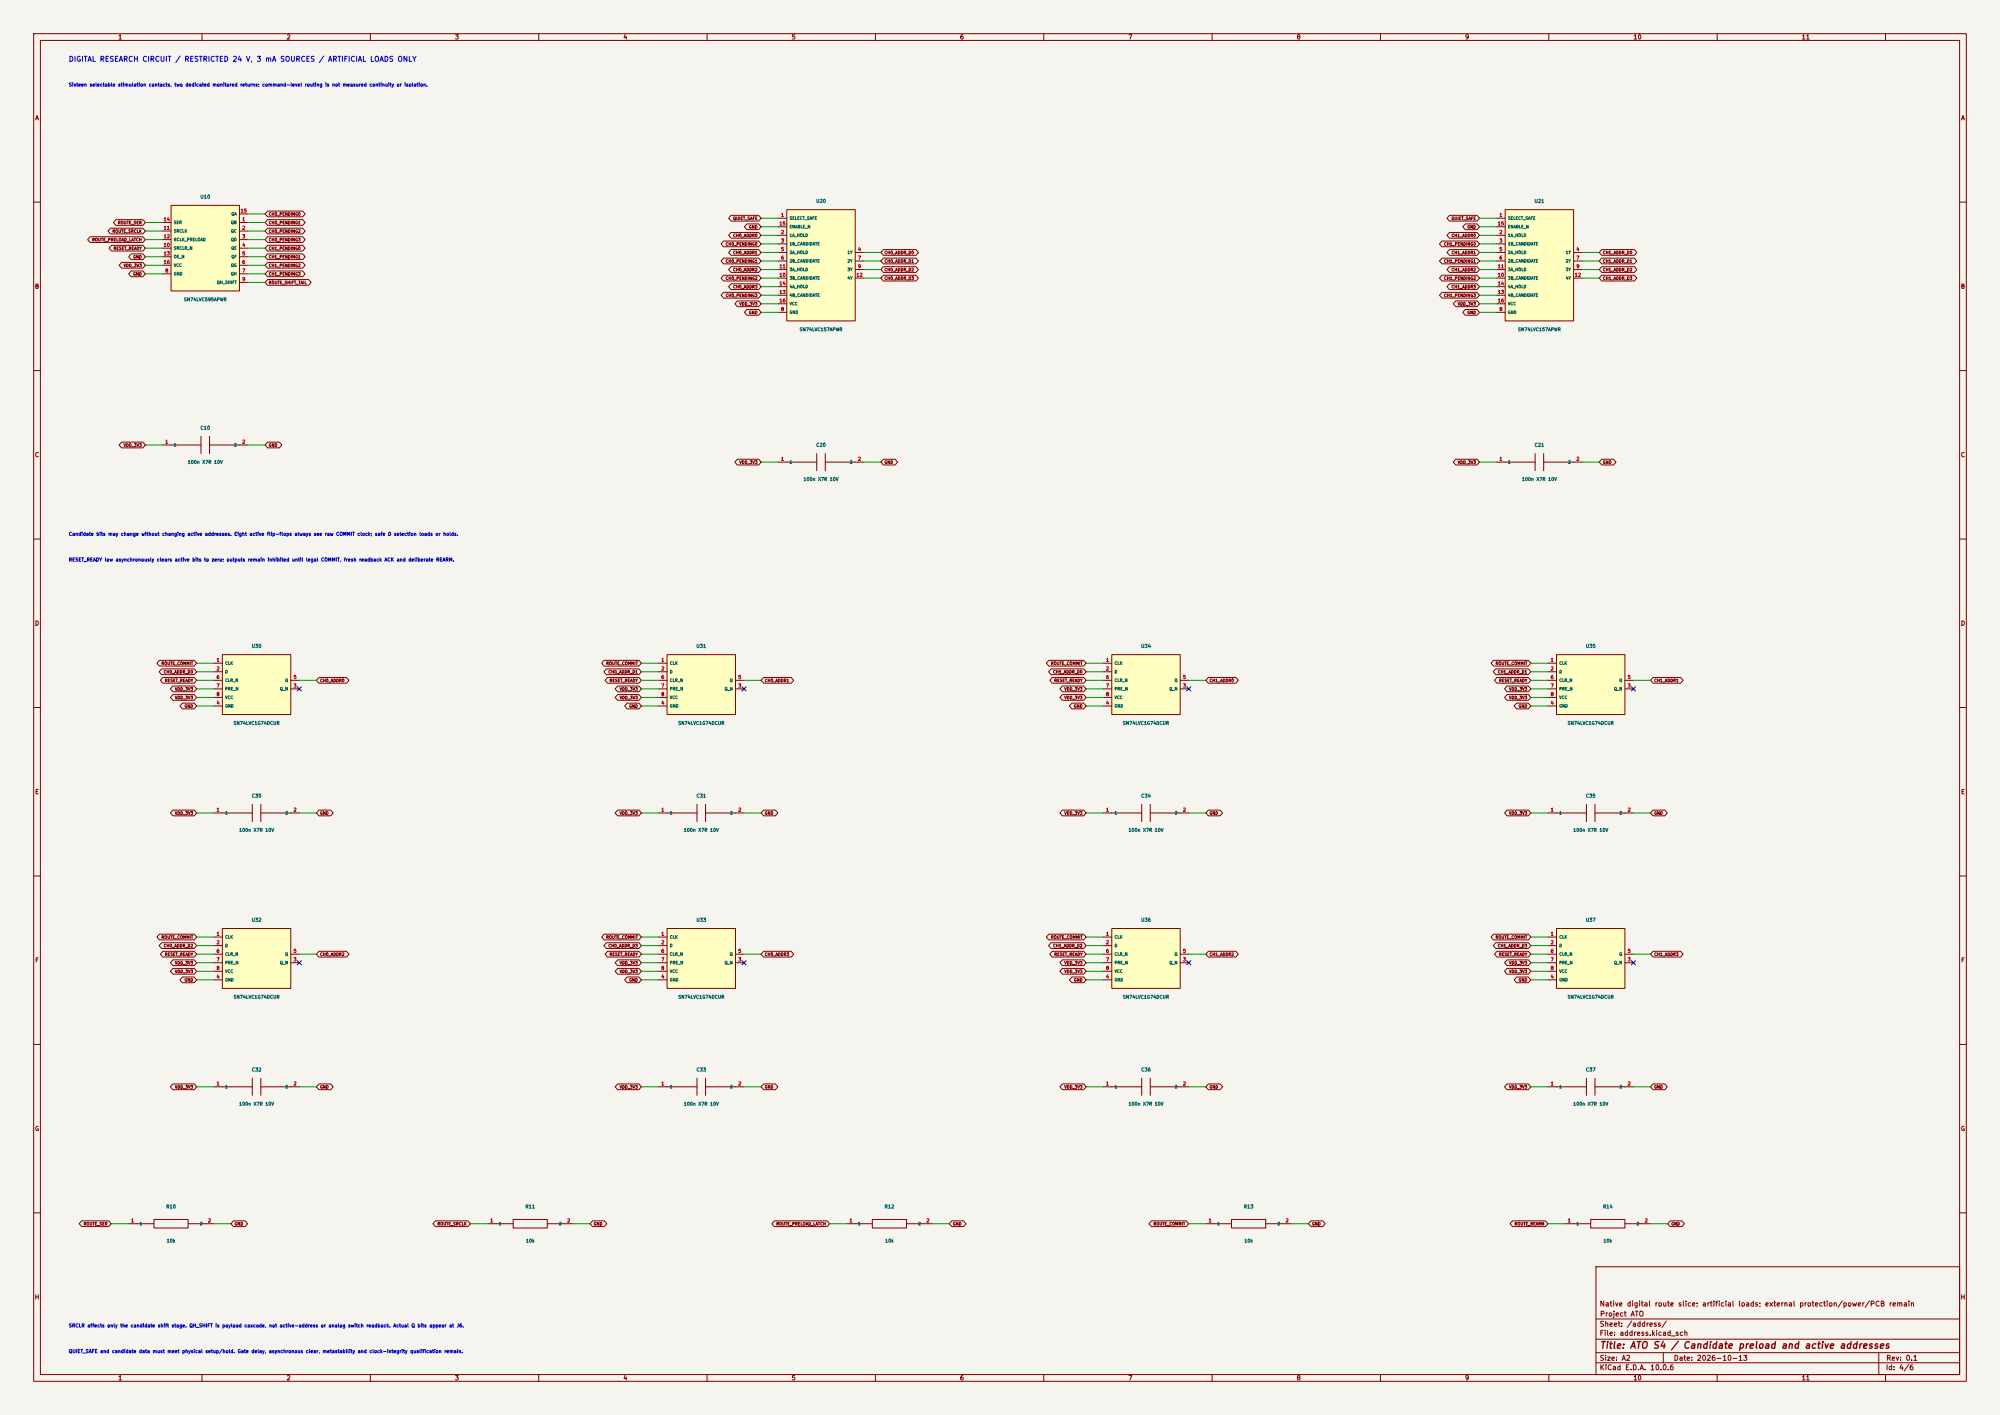
[picture p225: page 4]
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

RESET_READY low asynchronously clears active bits to zero; outputs remain inhibited until legal COMMIT, fresh readback ACK and deliberate REARM. Candidate bits may change without changing active addresses. Eight active flip-flops always see raw COMMIT clock; safe D selection loads or holds.

SRCLR affects only the candidate shift stage. QH_SHIFT is payload cascade, not active-address or analog switch readback. Actual Q bits appear at J6. QUIET_SAFE and candidate data must meet physical setup/hold. Gate delay, asynchronous clear, metastability and clock-integrity qualification remain.

Sheet: /address/
File: address.kicad_sch
Title: ATO S4 / Candidate preload and active addresses

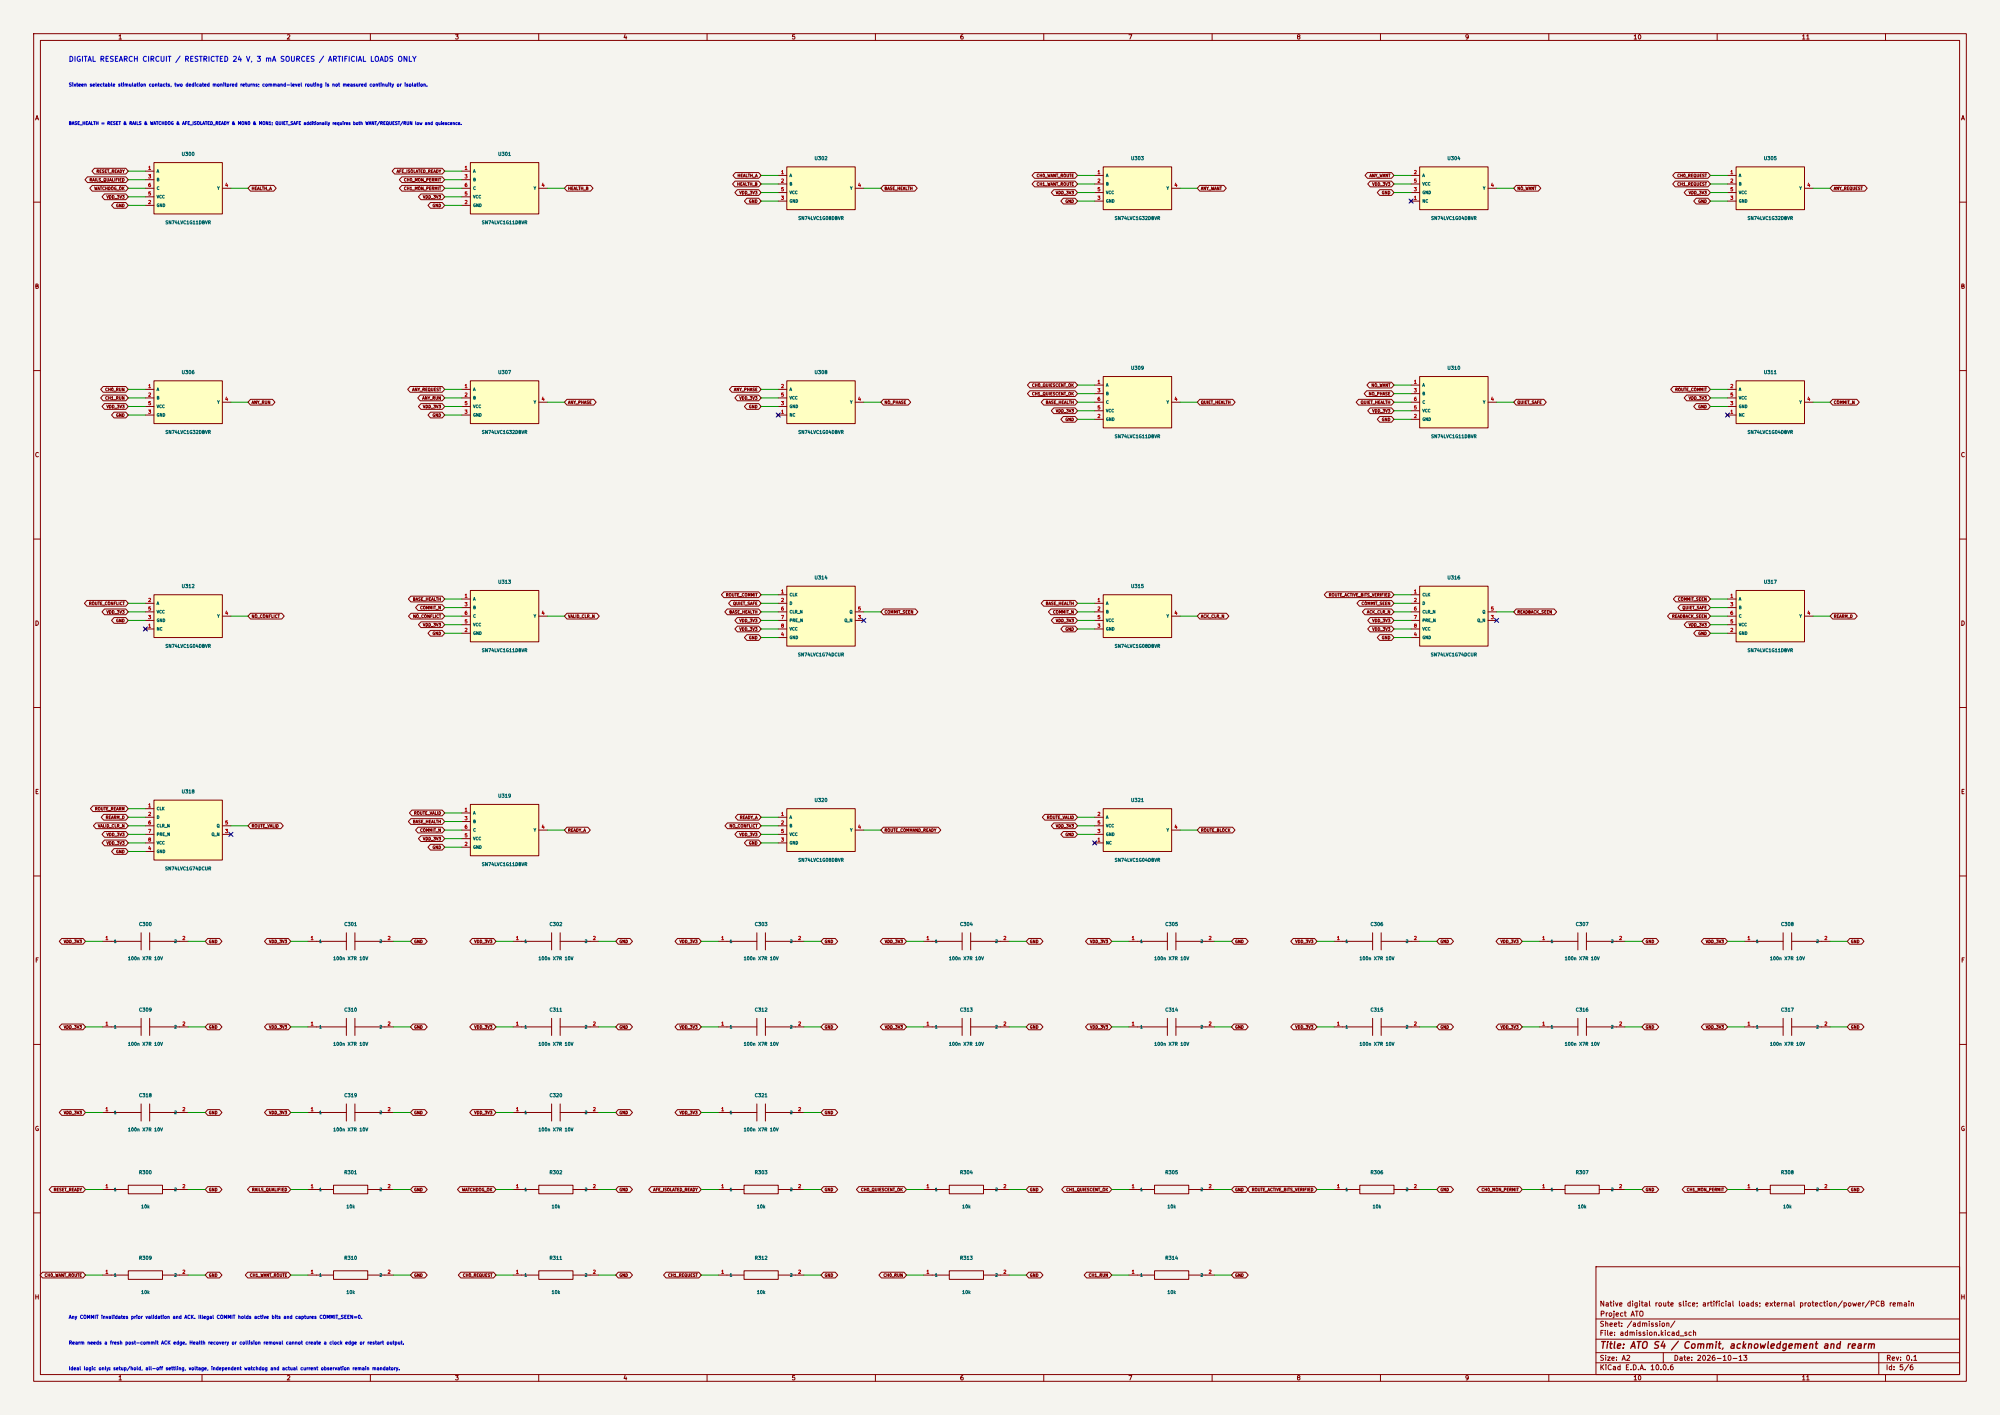
[picture p226: page 5]

BASE_HEALTH = RESET & RAILS & WATCHDOG & AFE_ISOLATED_READY & MON0 & MON1; QUIET_SAFE additionally requires both WANT/REQUEST/RUN low and quiescence. DIGITAL RESEARCH CIRCUIT / RESTRICTED 24 V, 3 mA SOURCES / ARTIFICIAL LOADS ONLY

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

Any COMMIT invalidates prior validation and ACK. Illegal COMMIT holds active bits and captures COMMIT_SEEN=0.

Sheet: /admission/
File: admission.kicad_sch
Title: ATO S4 / Commit, acknowledgement and rearm

Rearm needs a fresh post-commit ACK edge. Health recovery or collision removal cannot create a clock edge or restart output.

Ideal logic only: setup/hold, all-off settling, voltage, independent watchdog and actual current observation remain mandatory.

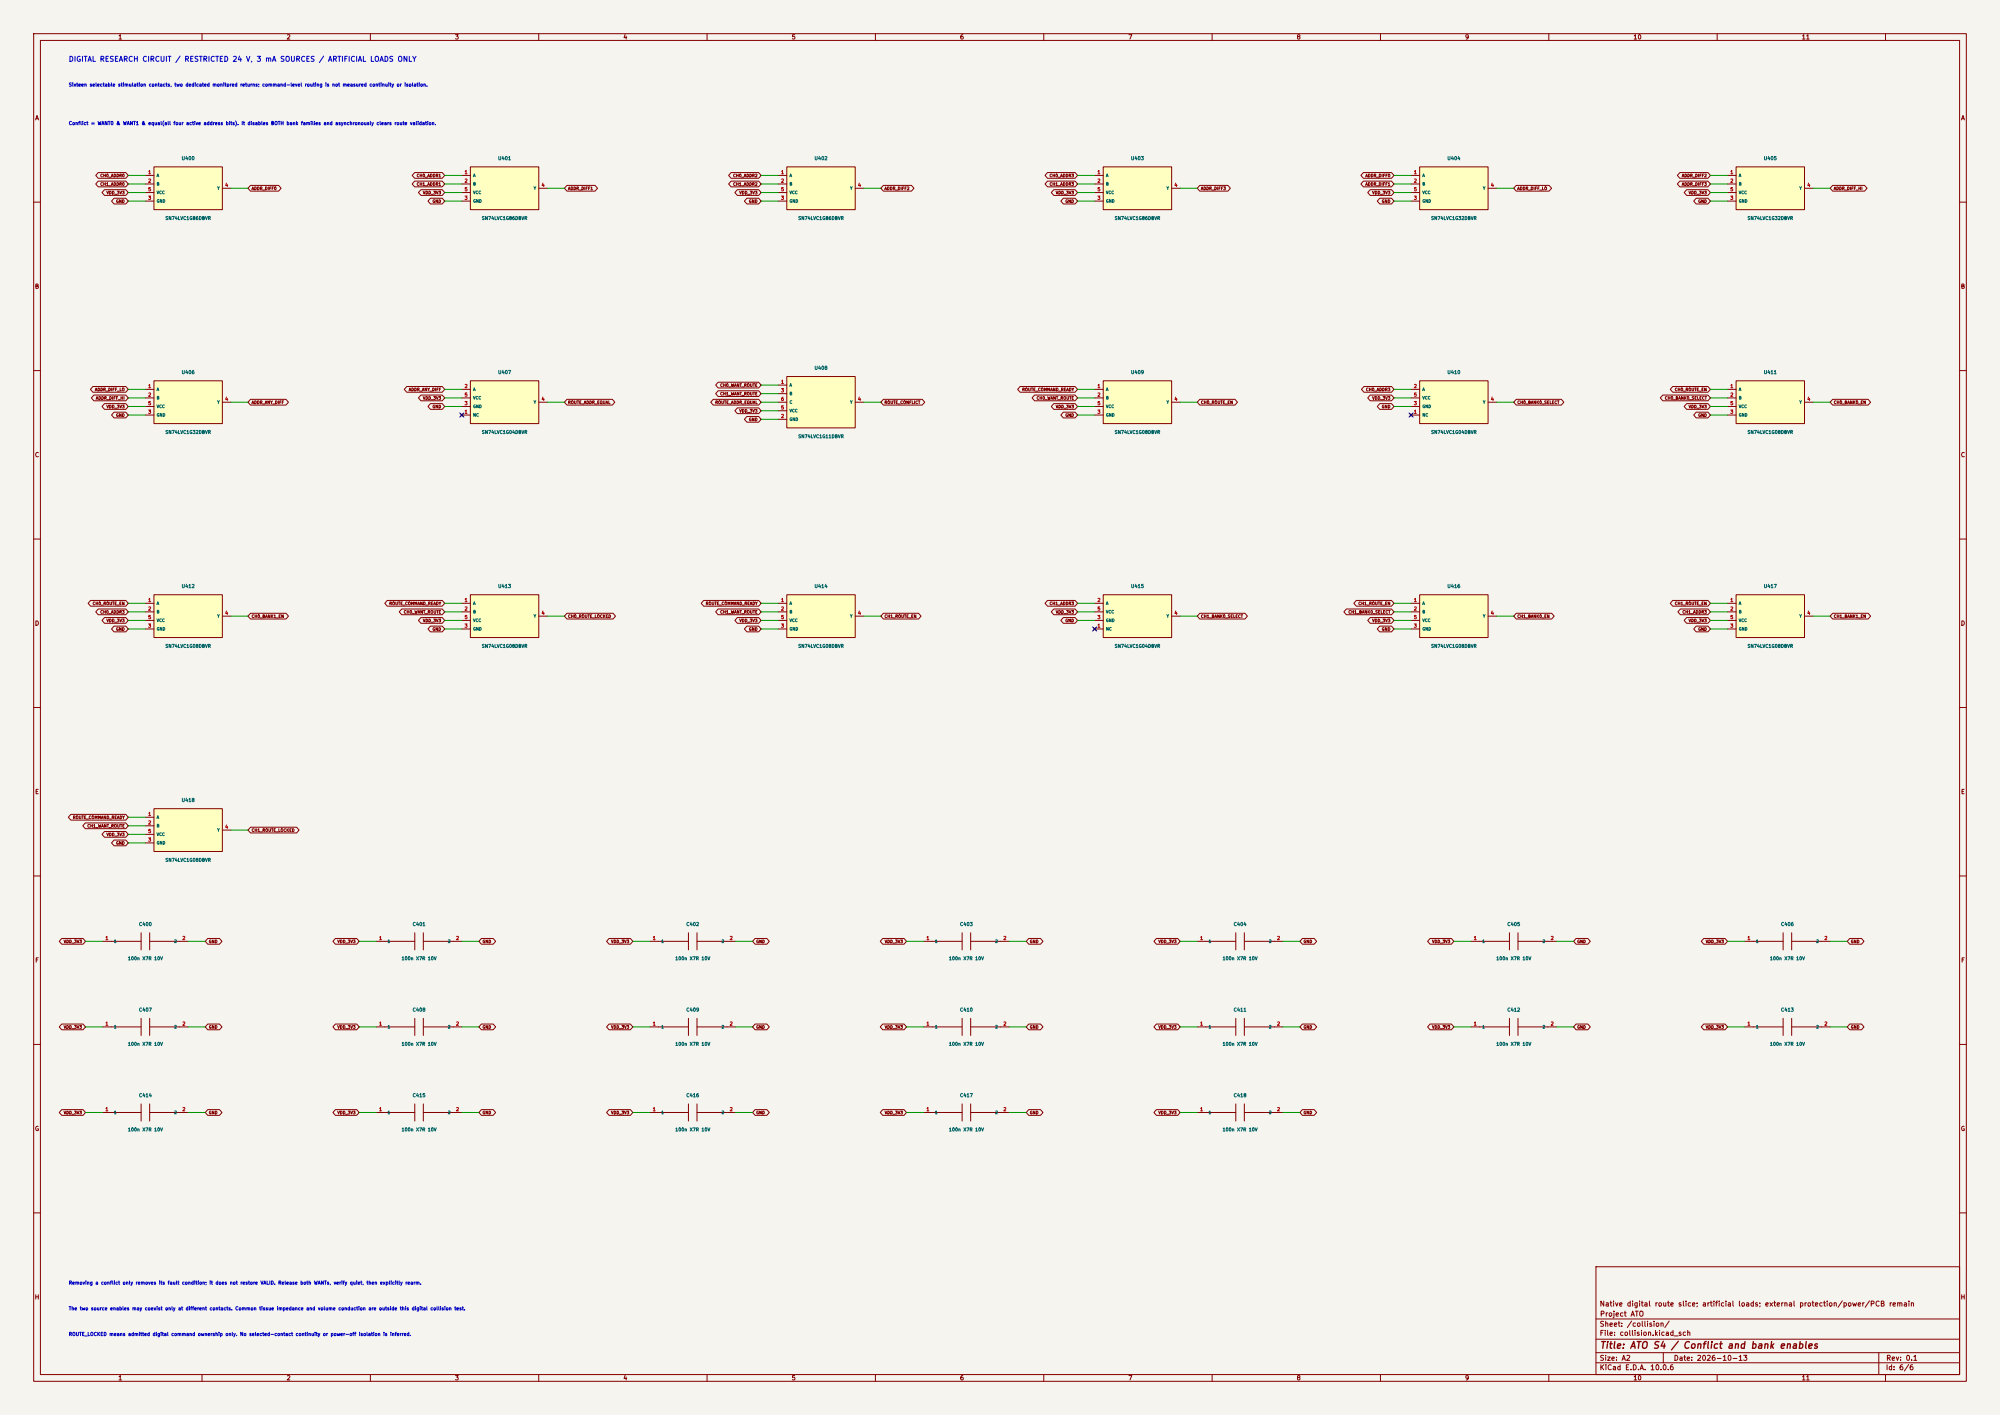
[picture p227: page 6]
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

Removing a conflict only removes its fault condition; it does not restore VALID. Release both WANTs, verify quiet, then explicitly rearm. The two source enables may coexist only at different contacts. Common tissue impedance and volume conduction are outside this digital collision test. ROUTE_LOCKED means admitted digital command ownership only. No selected-contact continuity or power-off isolation is inferred.

Sheet: /collision/
File: collision.kicad_sch
Title: ATO S4 / Conflict and bank enables
