pratham-cloud-ctrl/Project-ATO/electronics/stage4/power/power.pdf

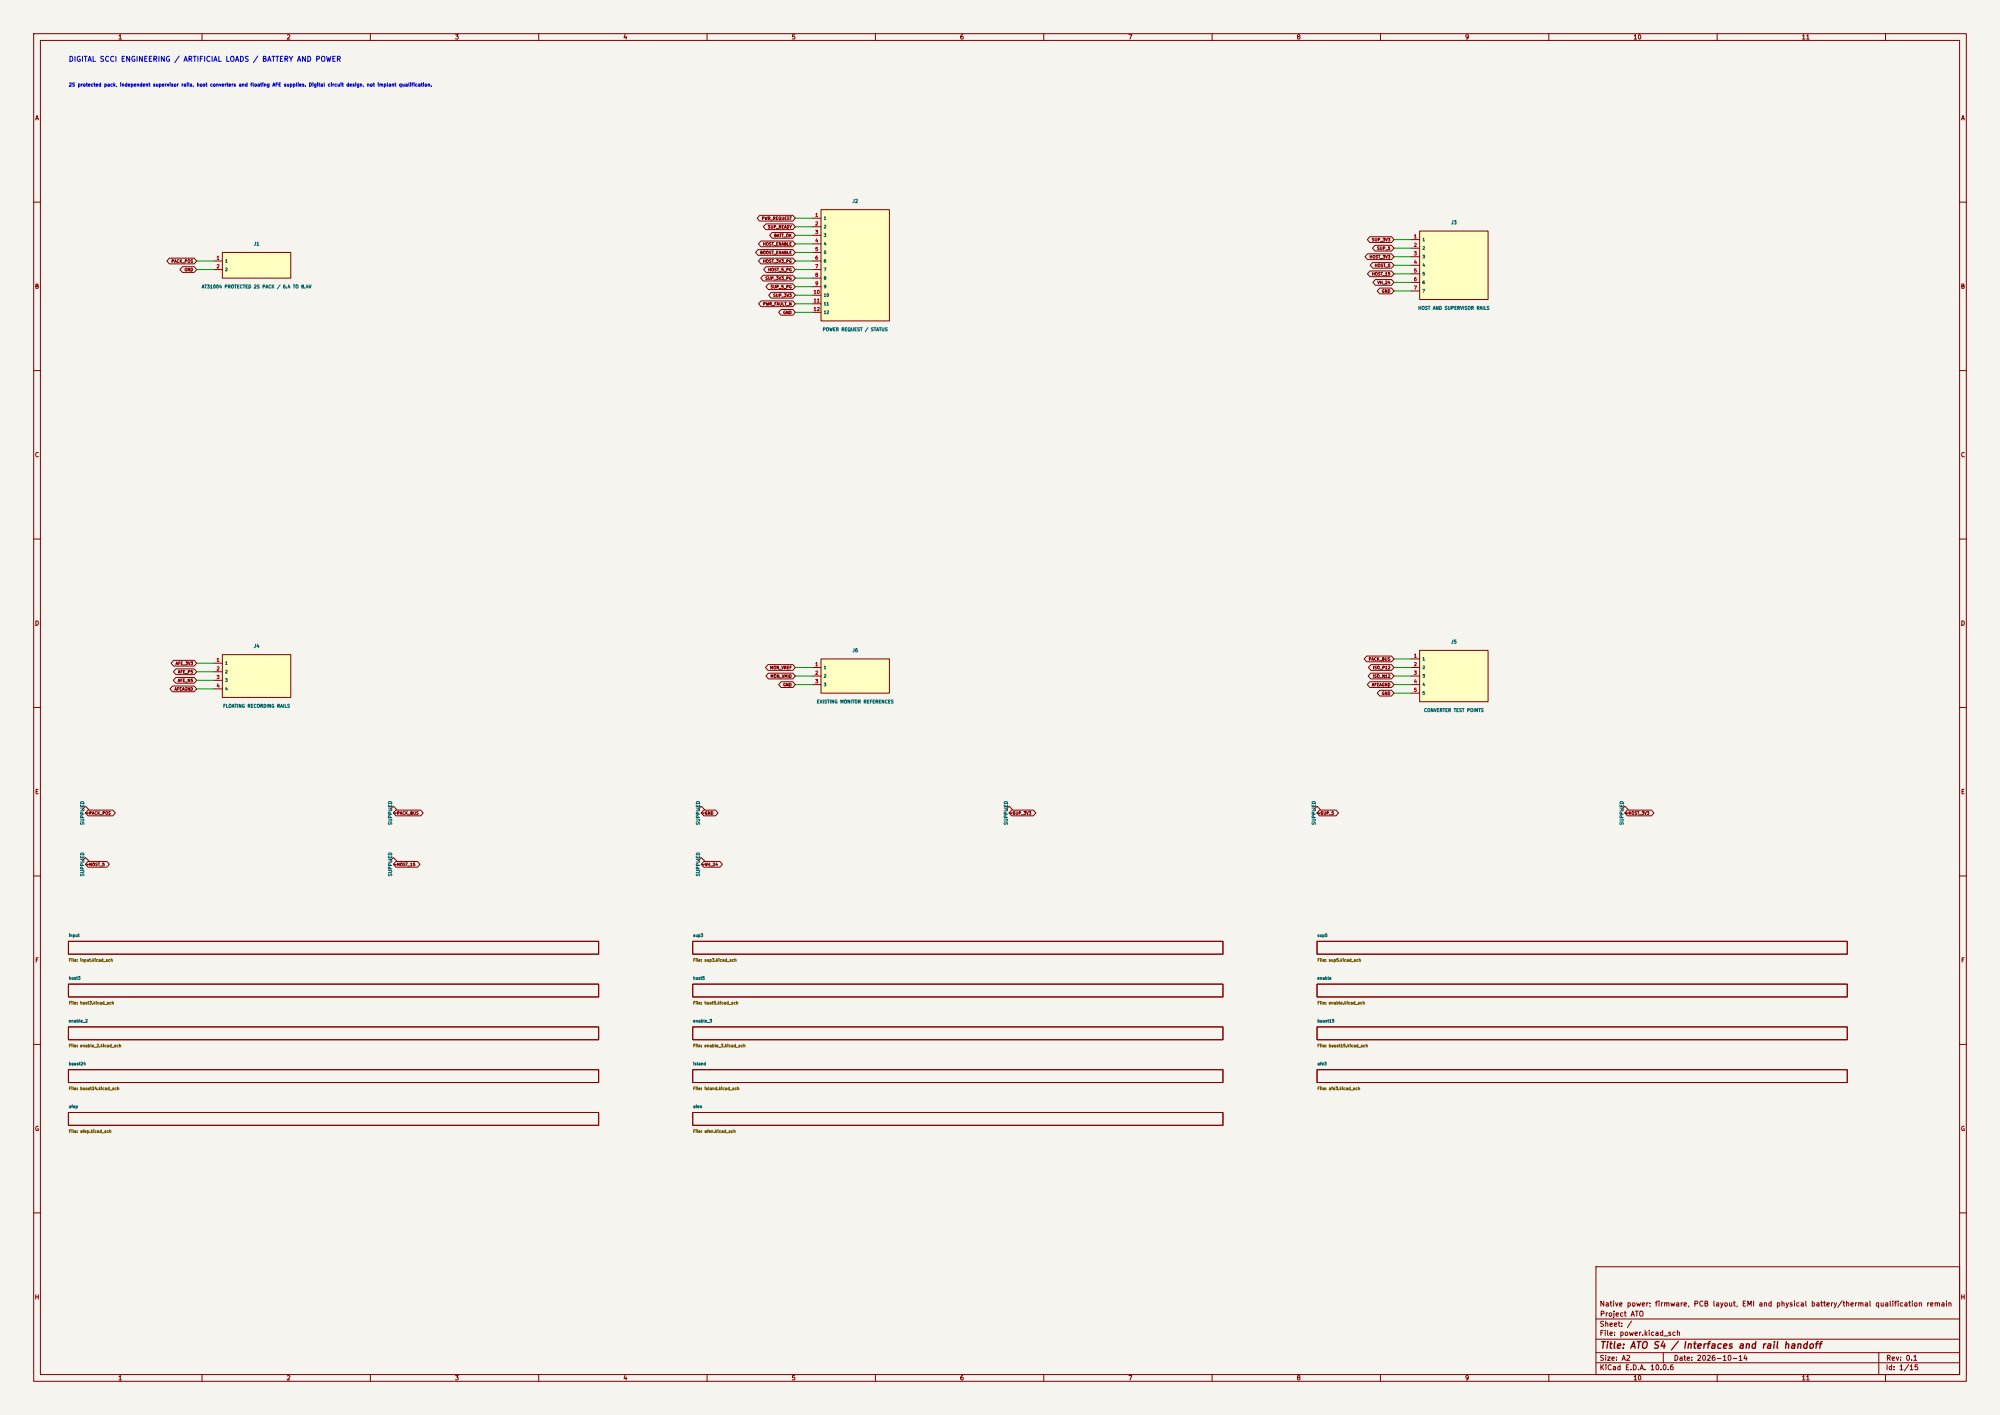
[picture p254: page 1]

2S protected pack, independent supervisor rails, host converters and floating AFE supplies. Digital circuit design, not implant qualification. DIGITAL SCCI ENGINEERING / ARTIFICIAL LOADS / BATTERY AND POWER

J3 HOST AND SUPERVISOR RAILS

Native power; firmware, PCB layout, EMI and physical battery/thermal qualification remain
Project ATO
Sheet: /
File: power.kicad_sch
Title: ATO S4 / Interfaces and rail handoff

Size: A2 | Rev: 0.1
KiCad E.D.A. 10.0.6 | Id: 1/15

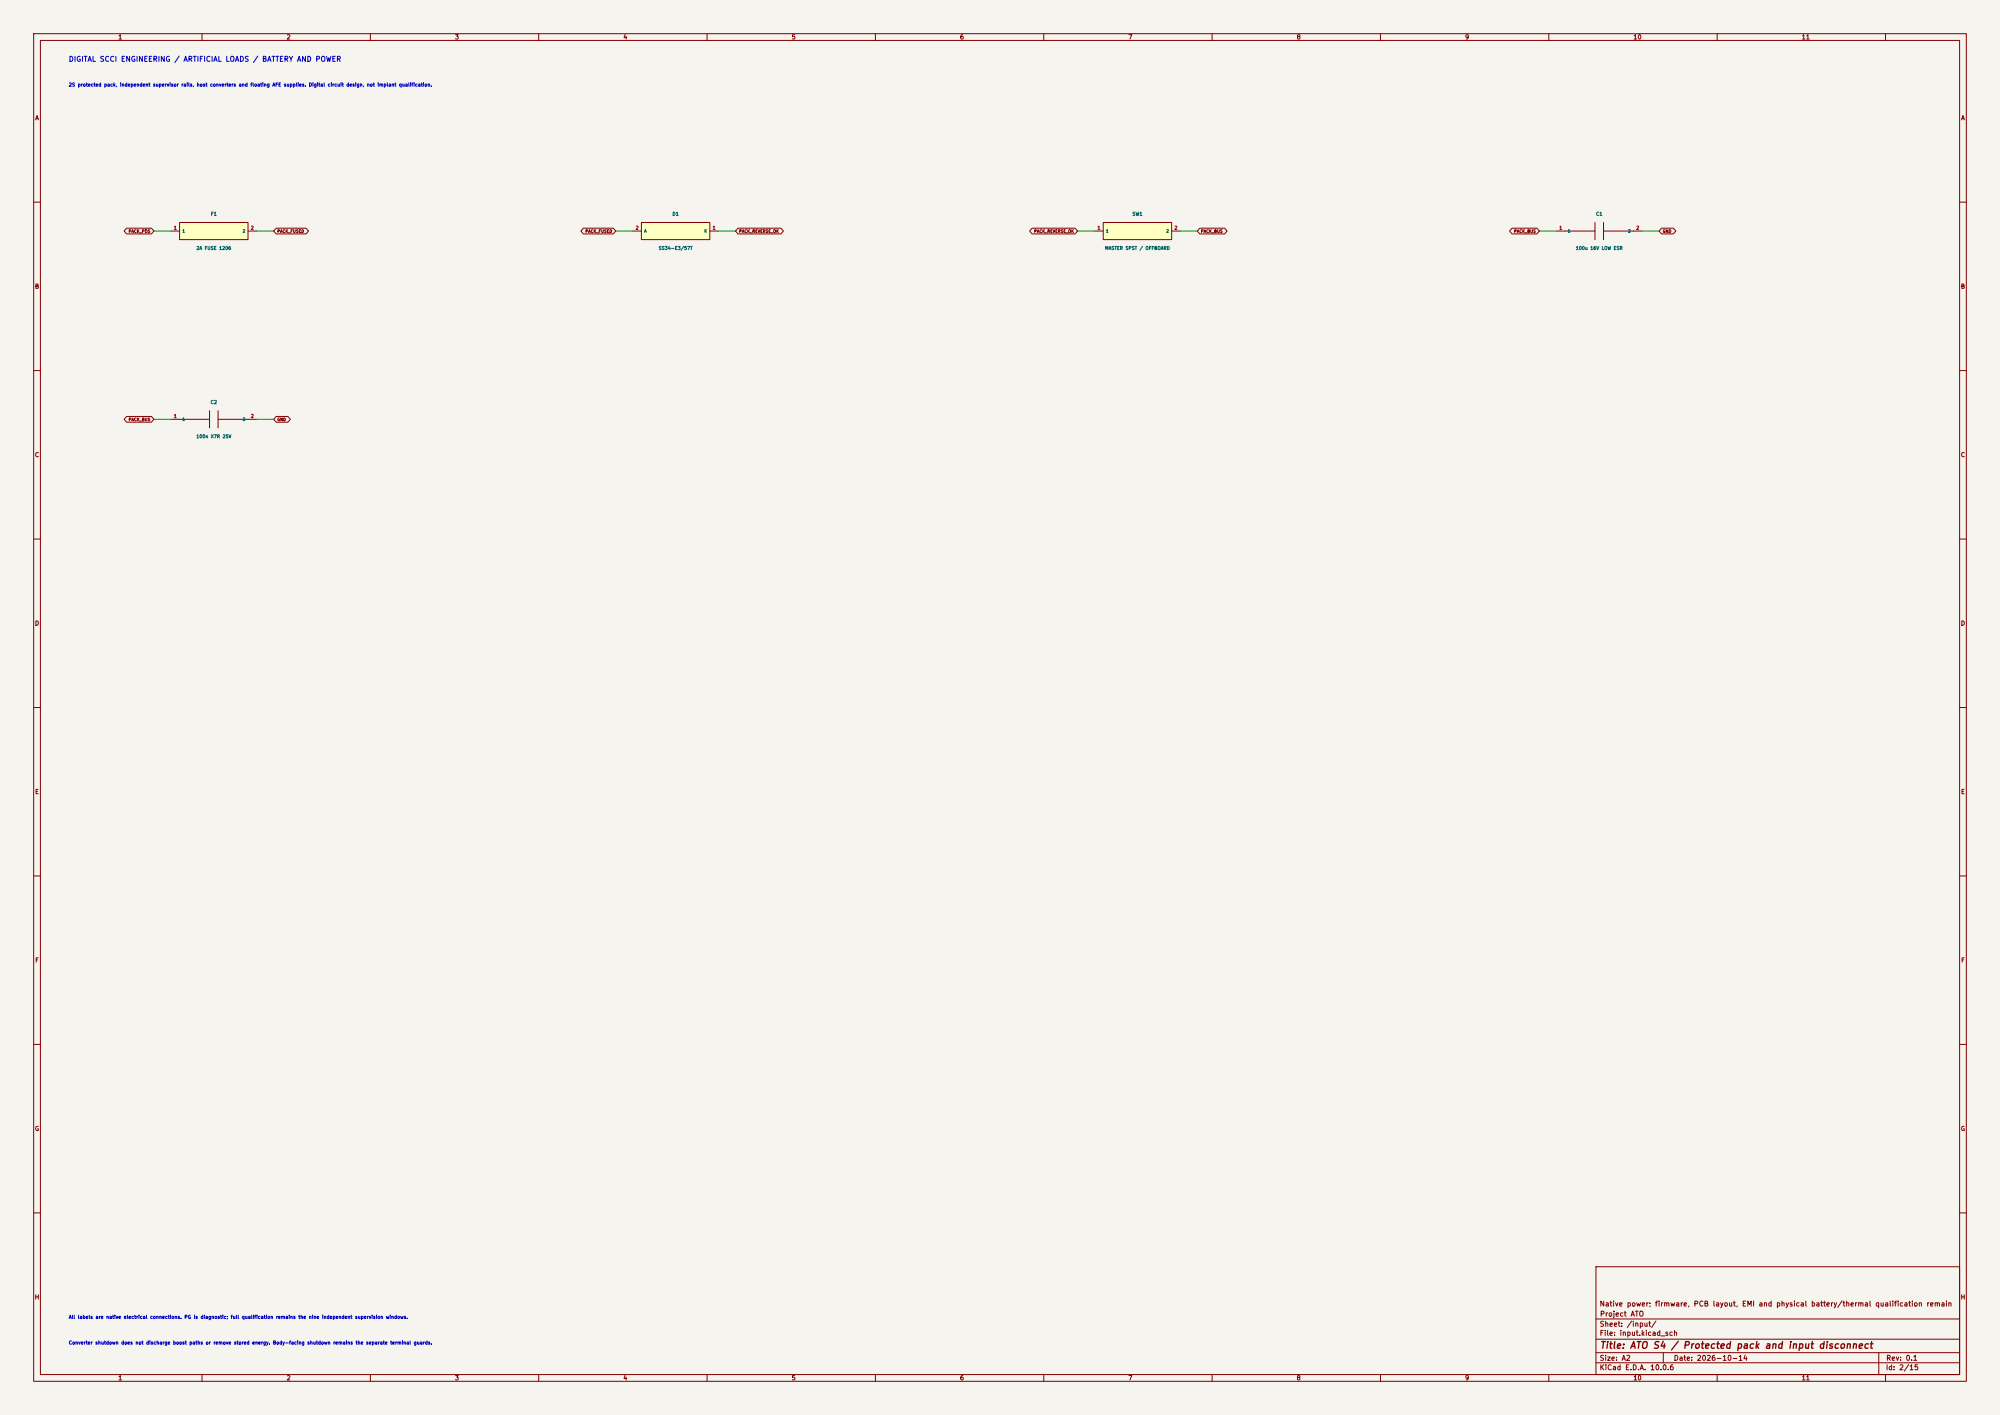
[picture p255: page 2]
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

Converter shutdown does not discharge boost paths or remove stored energy. Body-facing shutdown remains the separate terminal guards. All labels are native electrical connections. PG is diagnostic; full qualification remains the nine independent supervision windows.

Sheet: /input/
File: input.kicad_sch
Title: ATO S4 / Protected pack and input disconnect

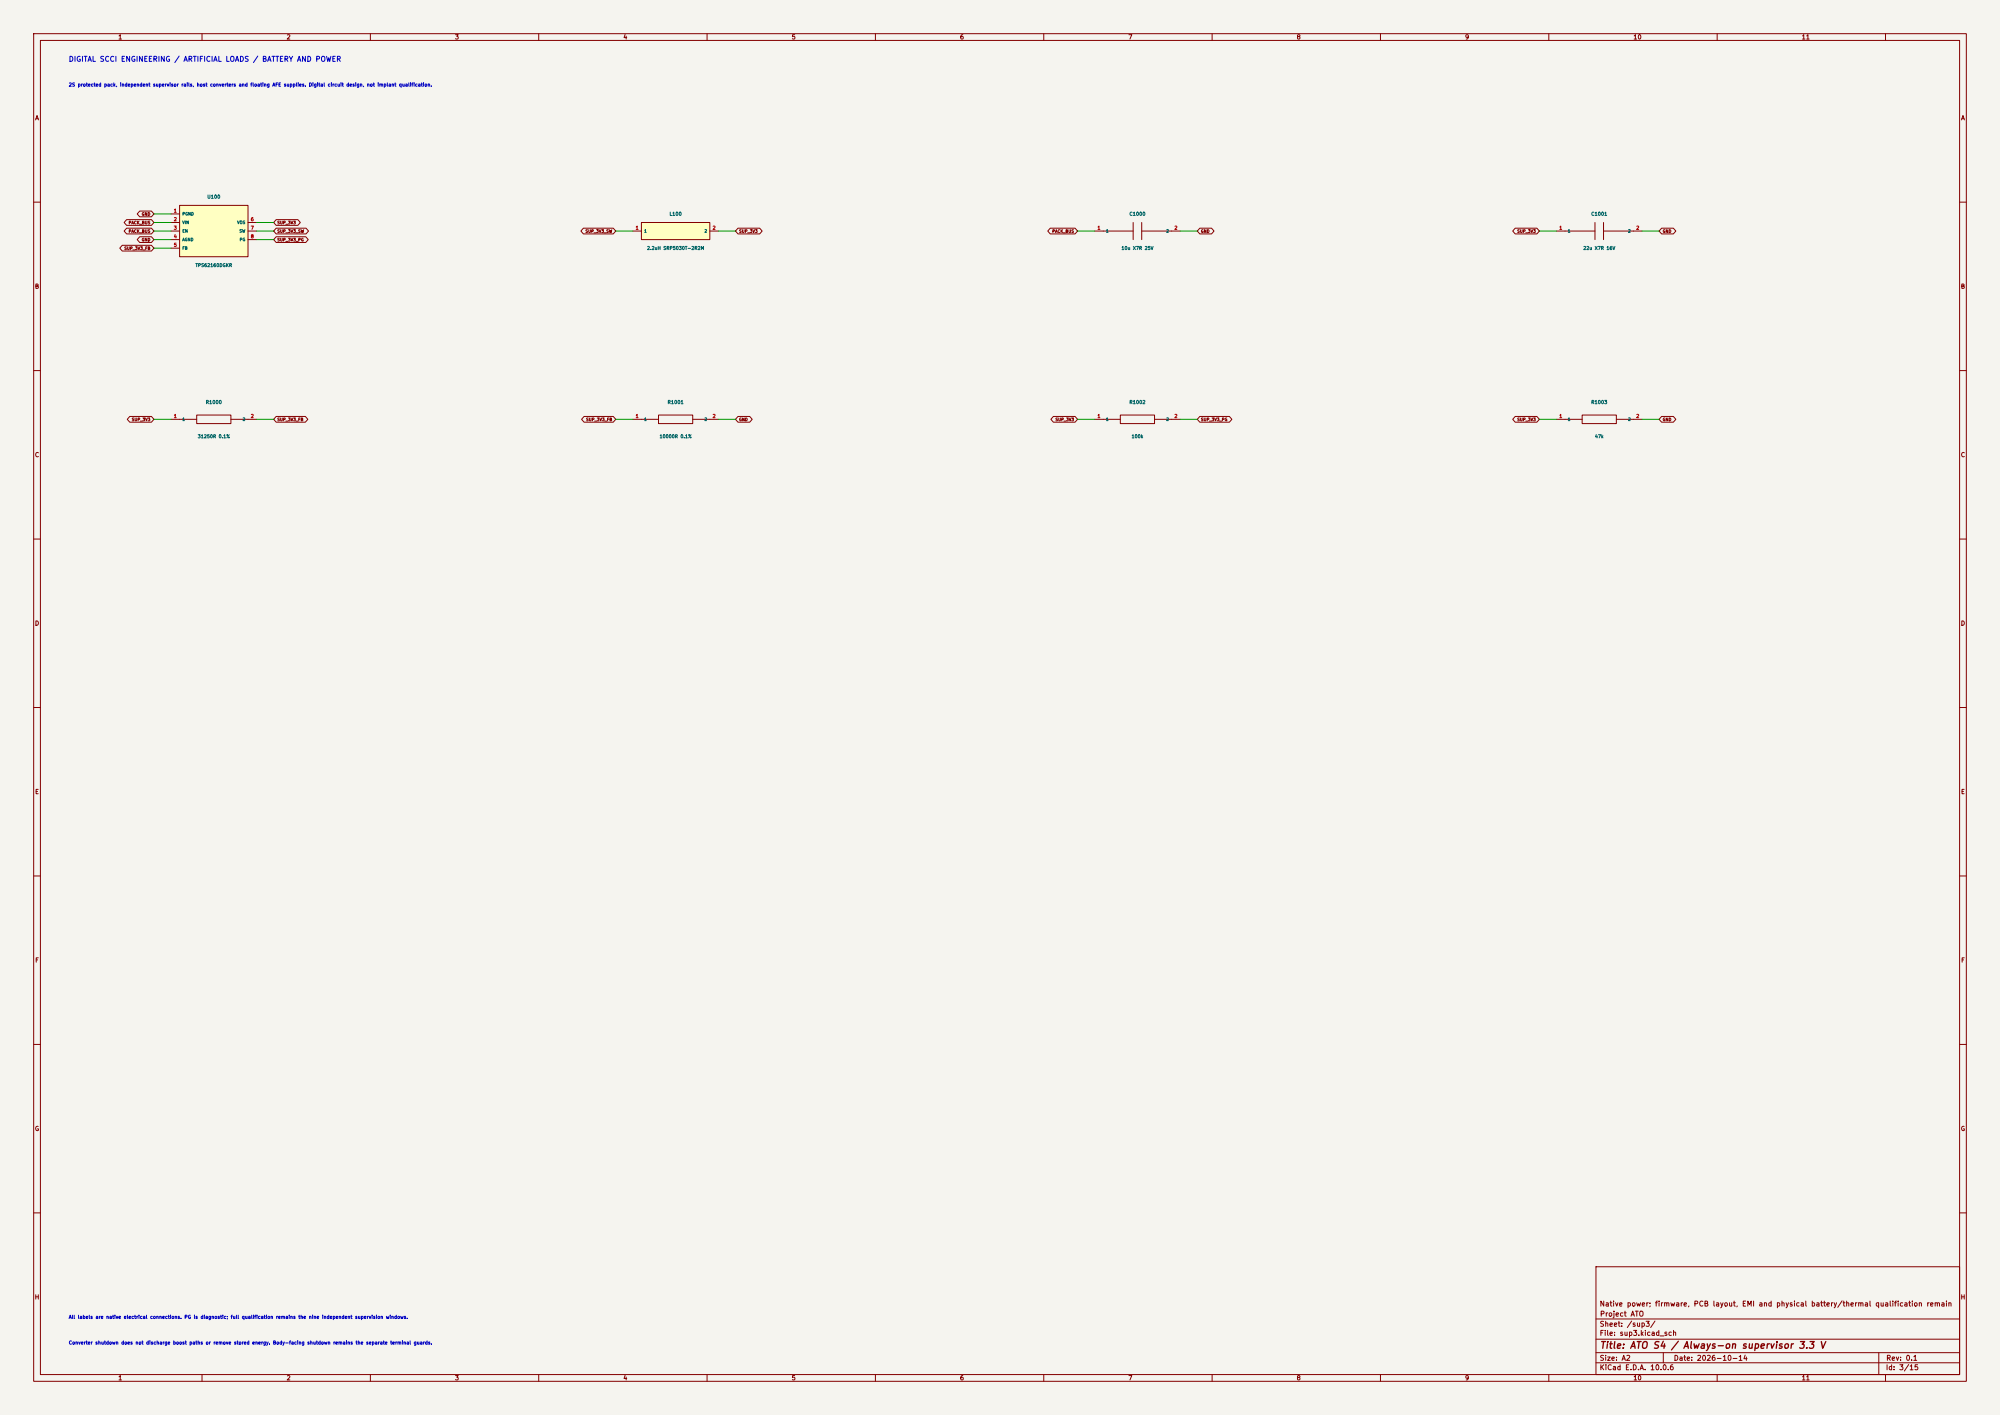
[picture p256: page 3]

PACK_BUS PACK_BUS DIGITAL SCCI ENGINEERING / ARTIFICIAL LOADS / BATTERY AND POWER

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

Sheet: /sup3/
File: sup3.kicad_sch
Title: ATO S4 / Always-on supervisor 3.3 V

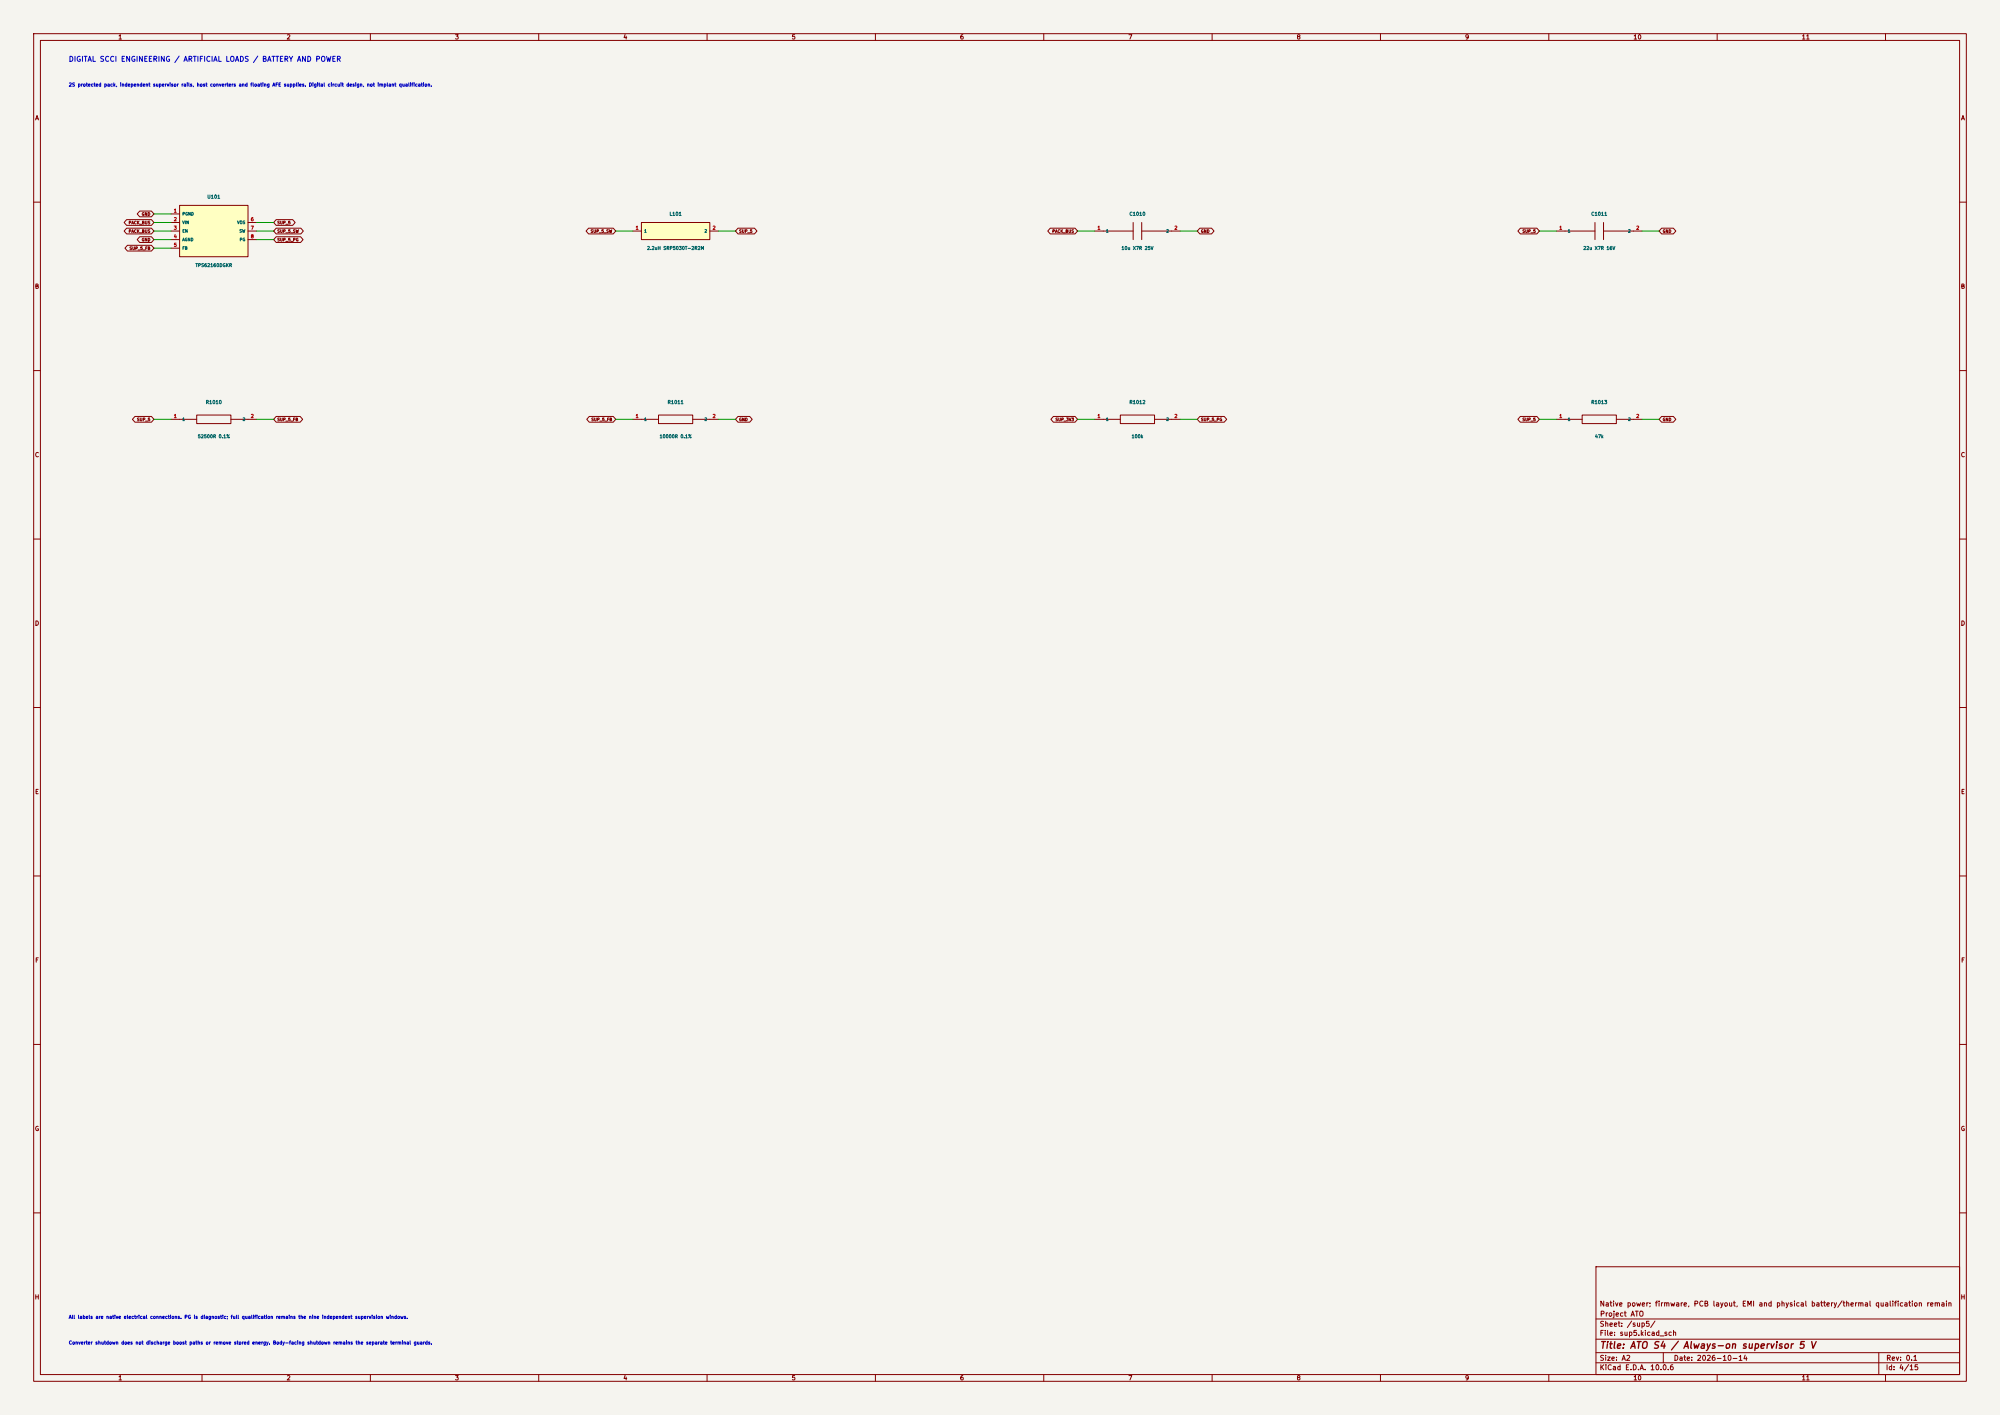
[picture p257: page 4]

PACK_BUS PACK_BUS DIGITAL SCCI ENGINEERING / ARTIFICIAL LOADS / BATTERY AND POWER

Sheet: /sup5/
File: sup5.kicad_sch
Title: ATO S4 / Always-on supervisor 5 V

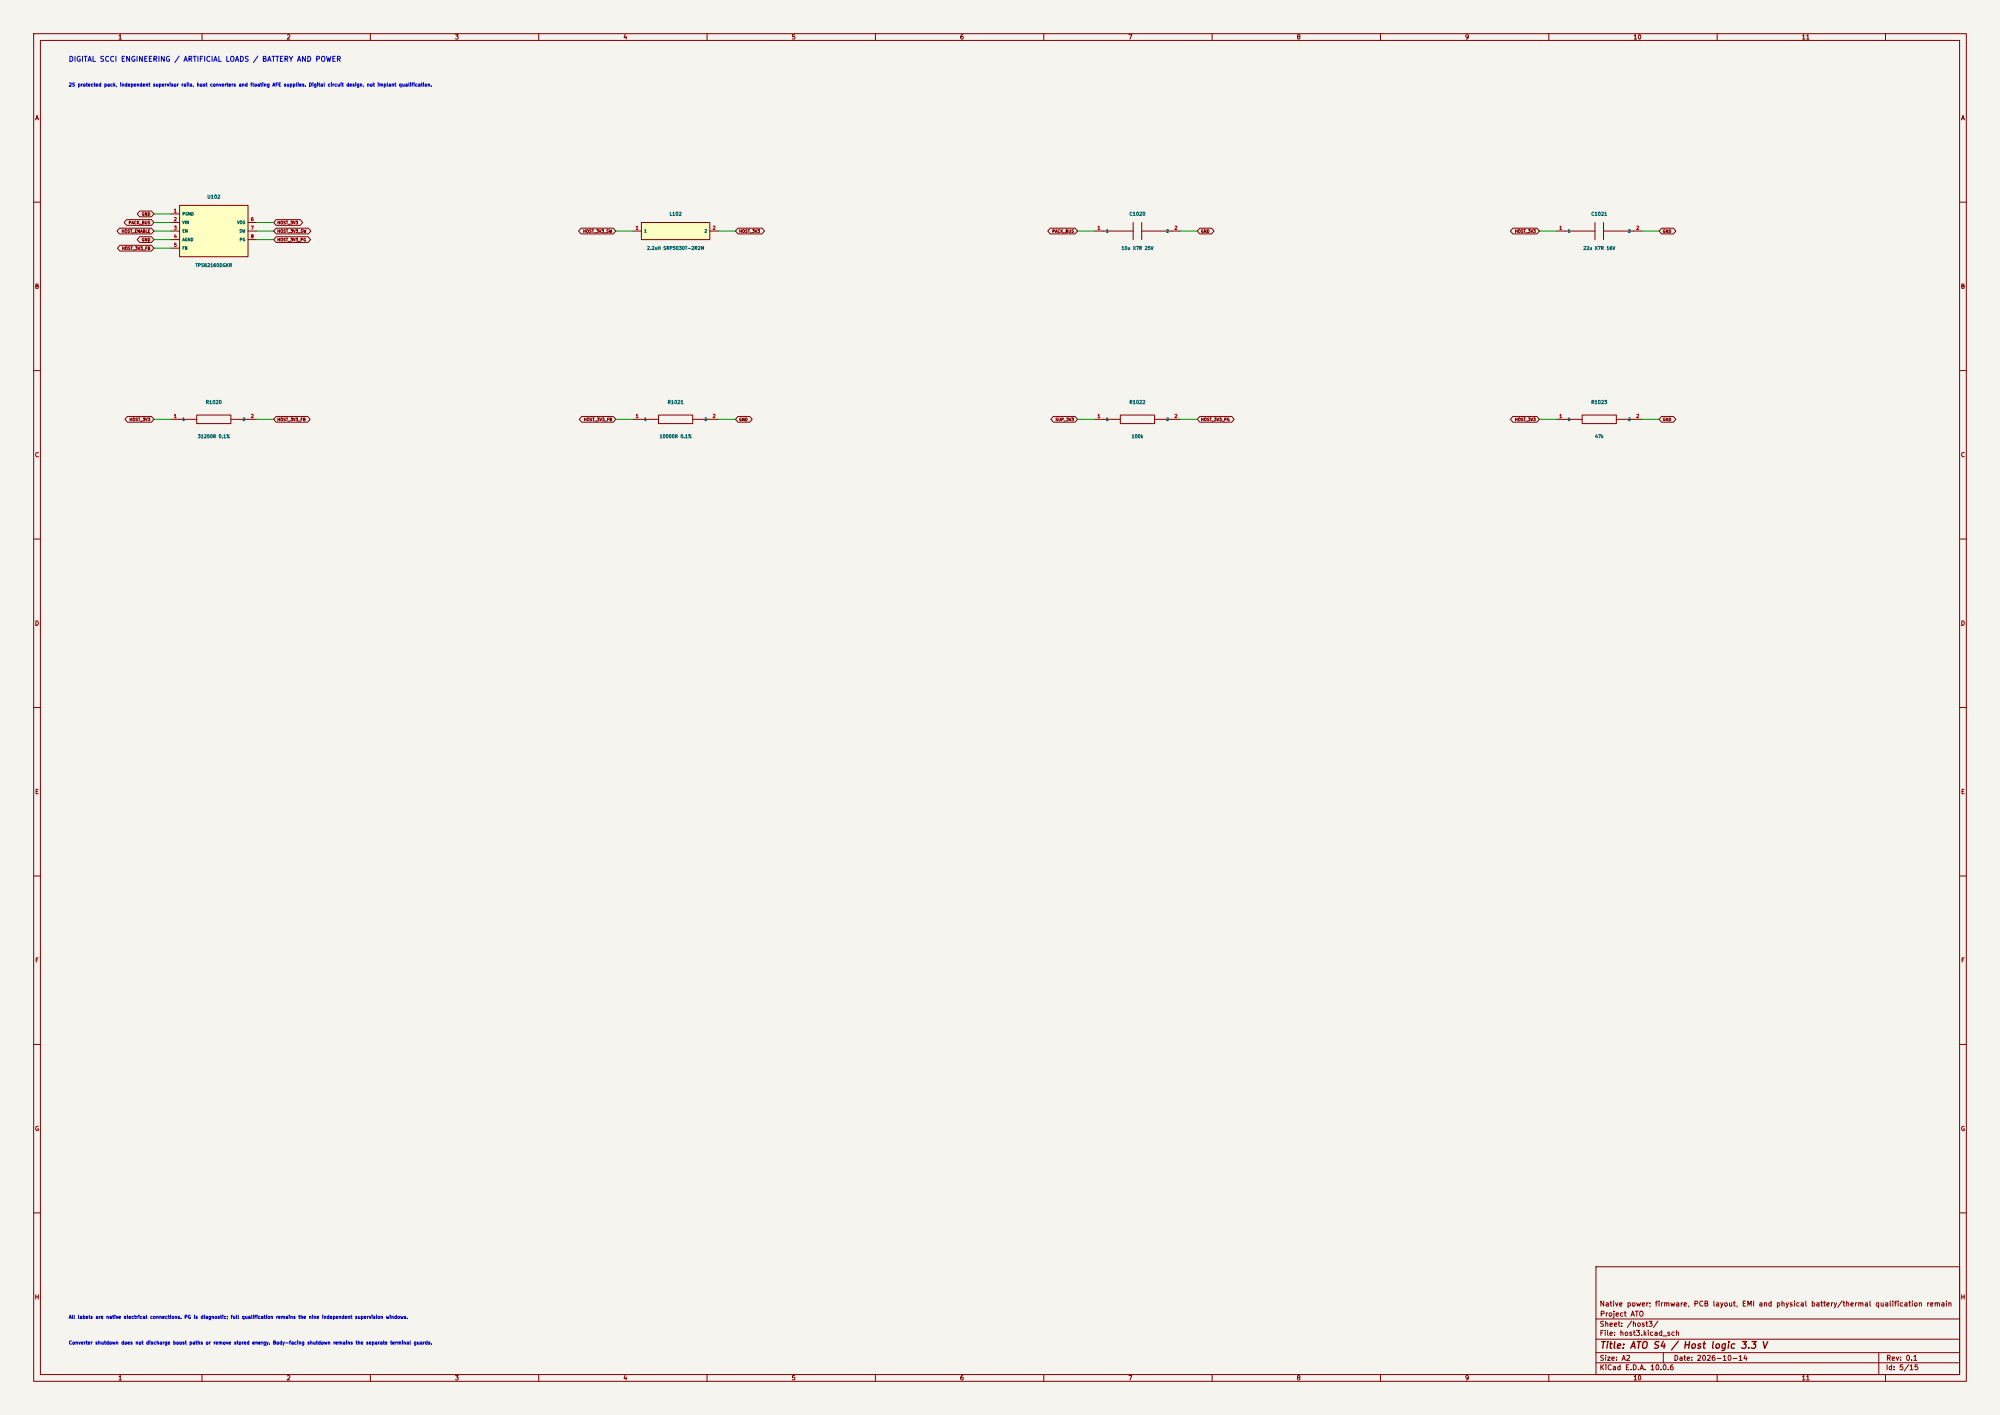
[picture p258: page 5]

PACK_BUS HOST_ENABLE DIGITAL SCCI ENGINEERING / ARTIFICIAL LOADS / BATTERY AND POWER

Sheet: /host3/
File: host3.kicad_sch
Title: ATO S4 / Host logic 3.3 V

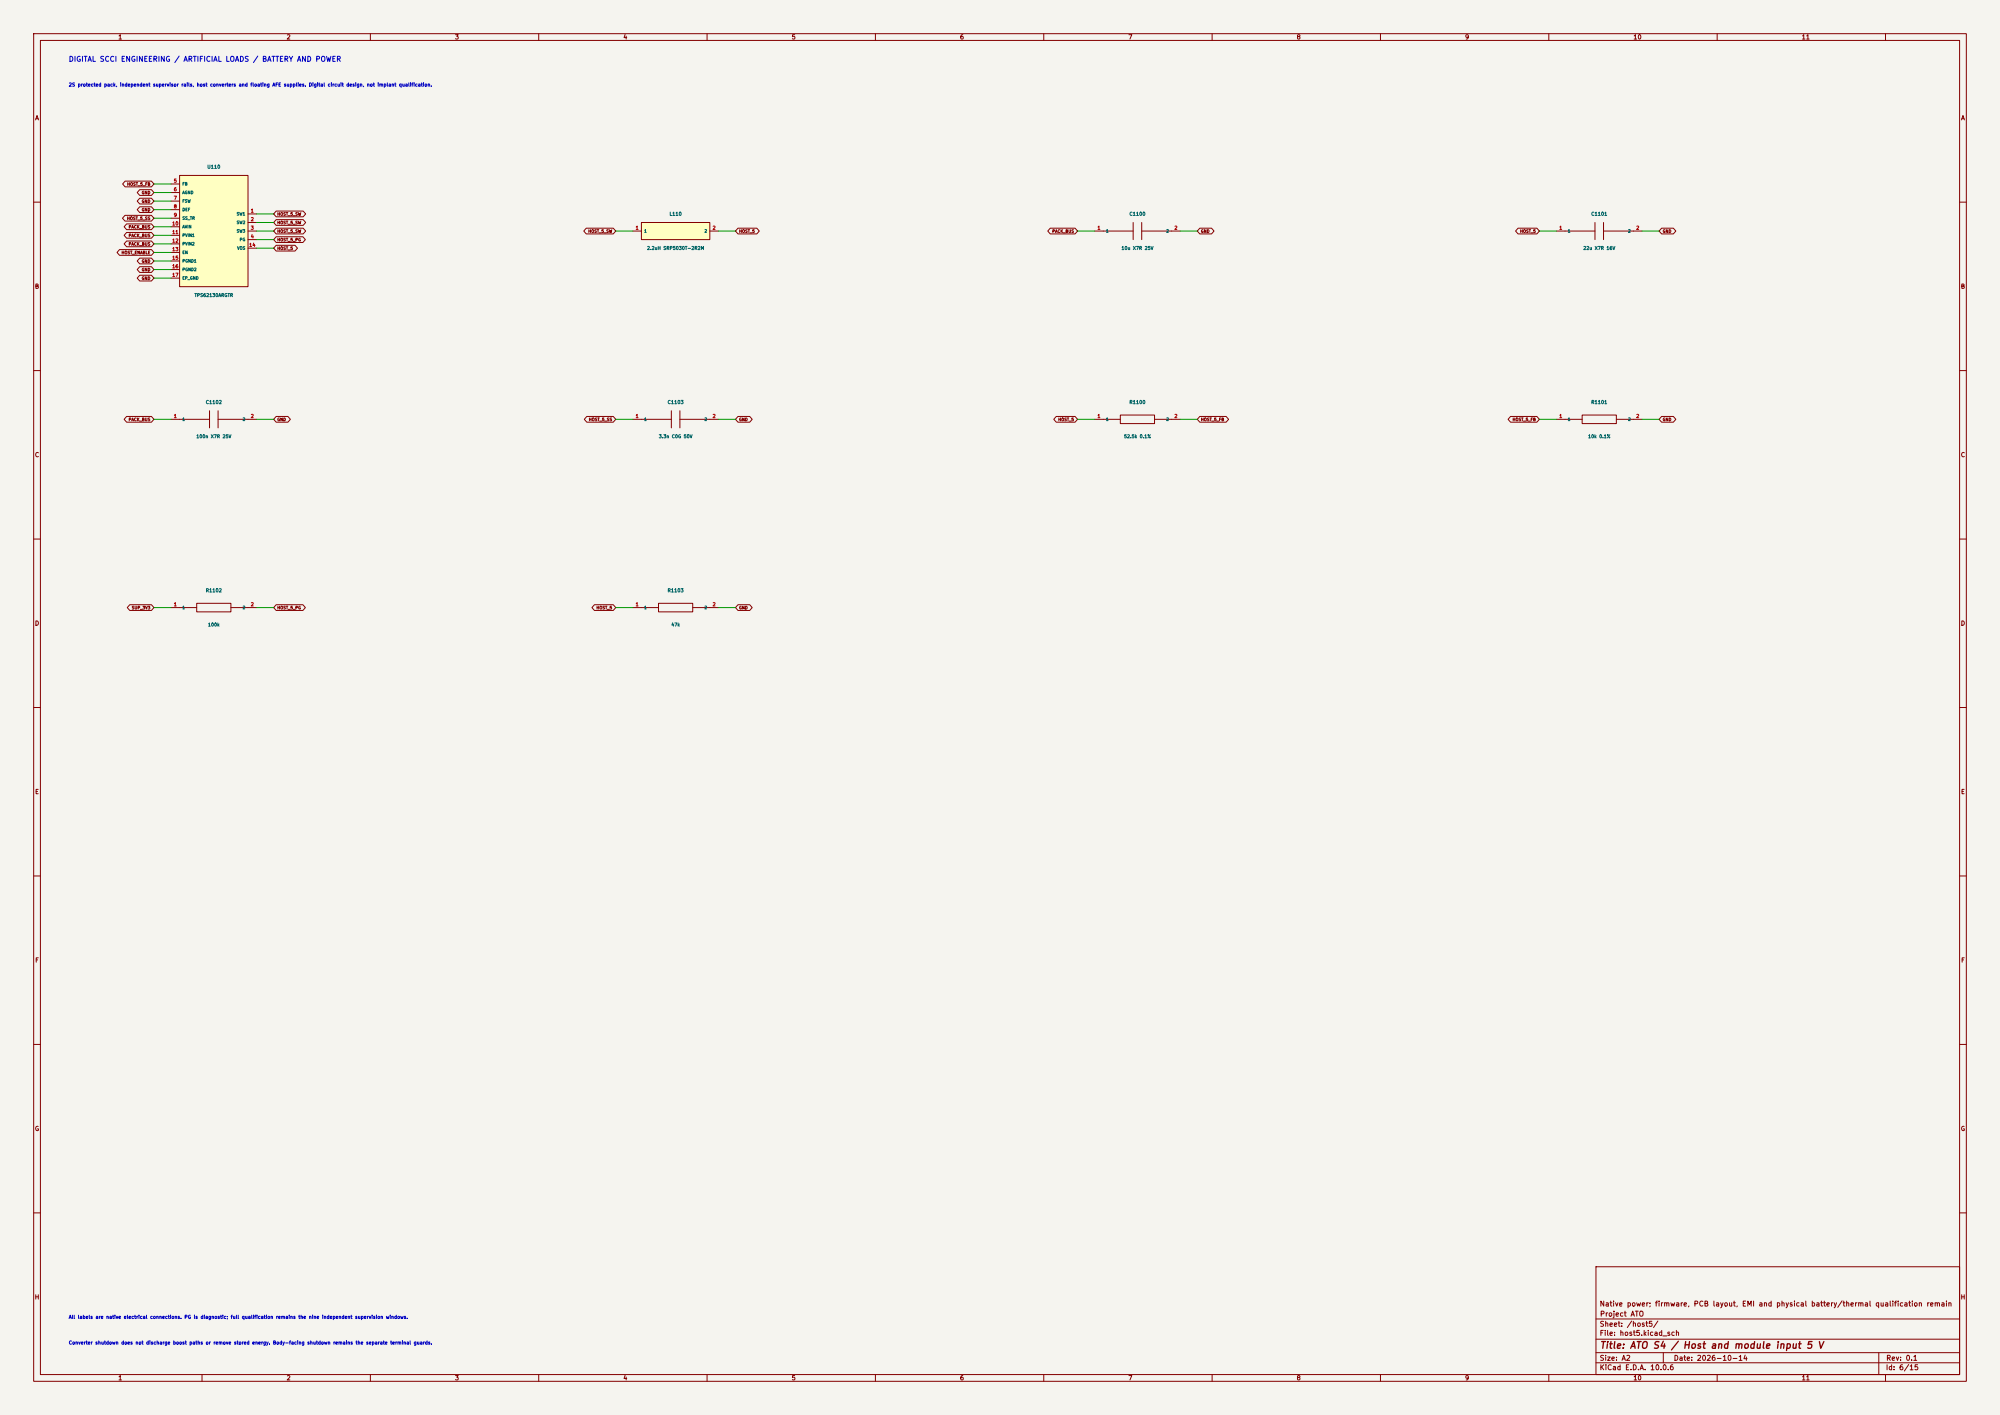
[picture p259: page 6]

All labels are native electrical connections. PG is diagnostic; full qualification remains the nine independent supervision windows. Converter shutdown does not discharge boost paths or remove stored energy. Body-facing shutdown remains the separate terminal guards.

Sheet: /host5/
File: host5.kicad_sch
Title: ATO S4 / Host and module input 5 V

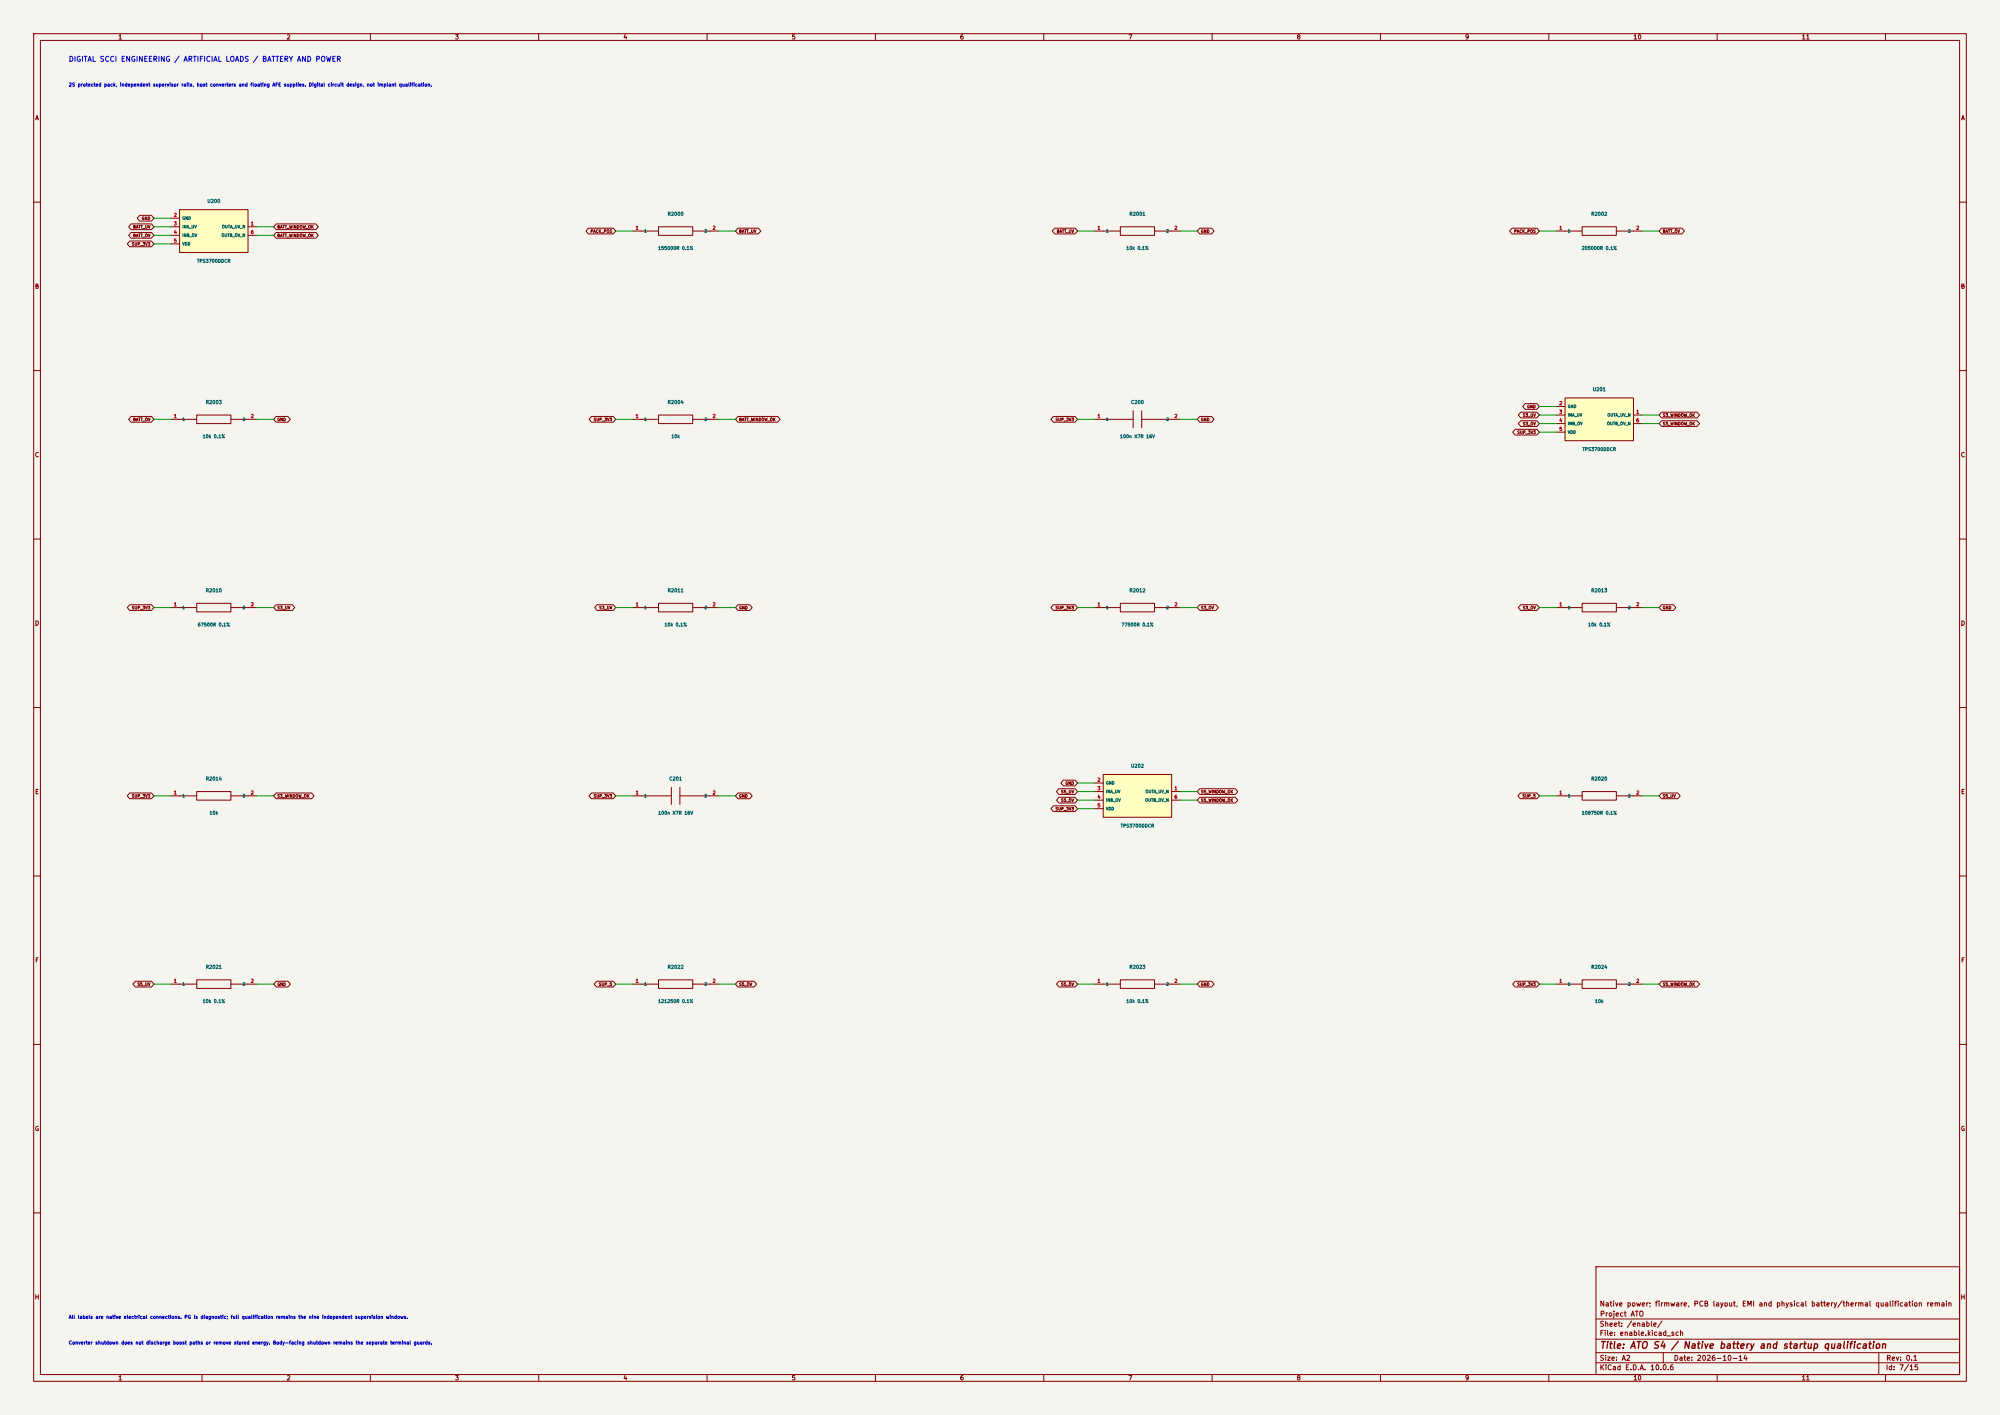
[picture p260: page 7]

DIGITAL SCCI ENGINEERING / ARTIFICIAL LOADS / BATTERY AND POWER

Sheet: /enable/
File: enable.kicad_sch
Title: ATO S4 / Native battery and startup qualification

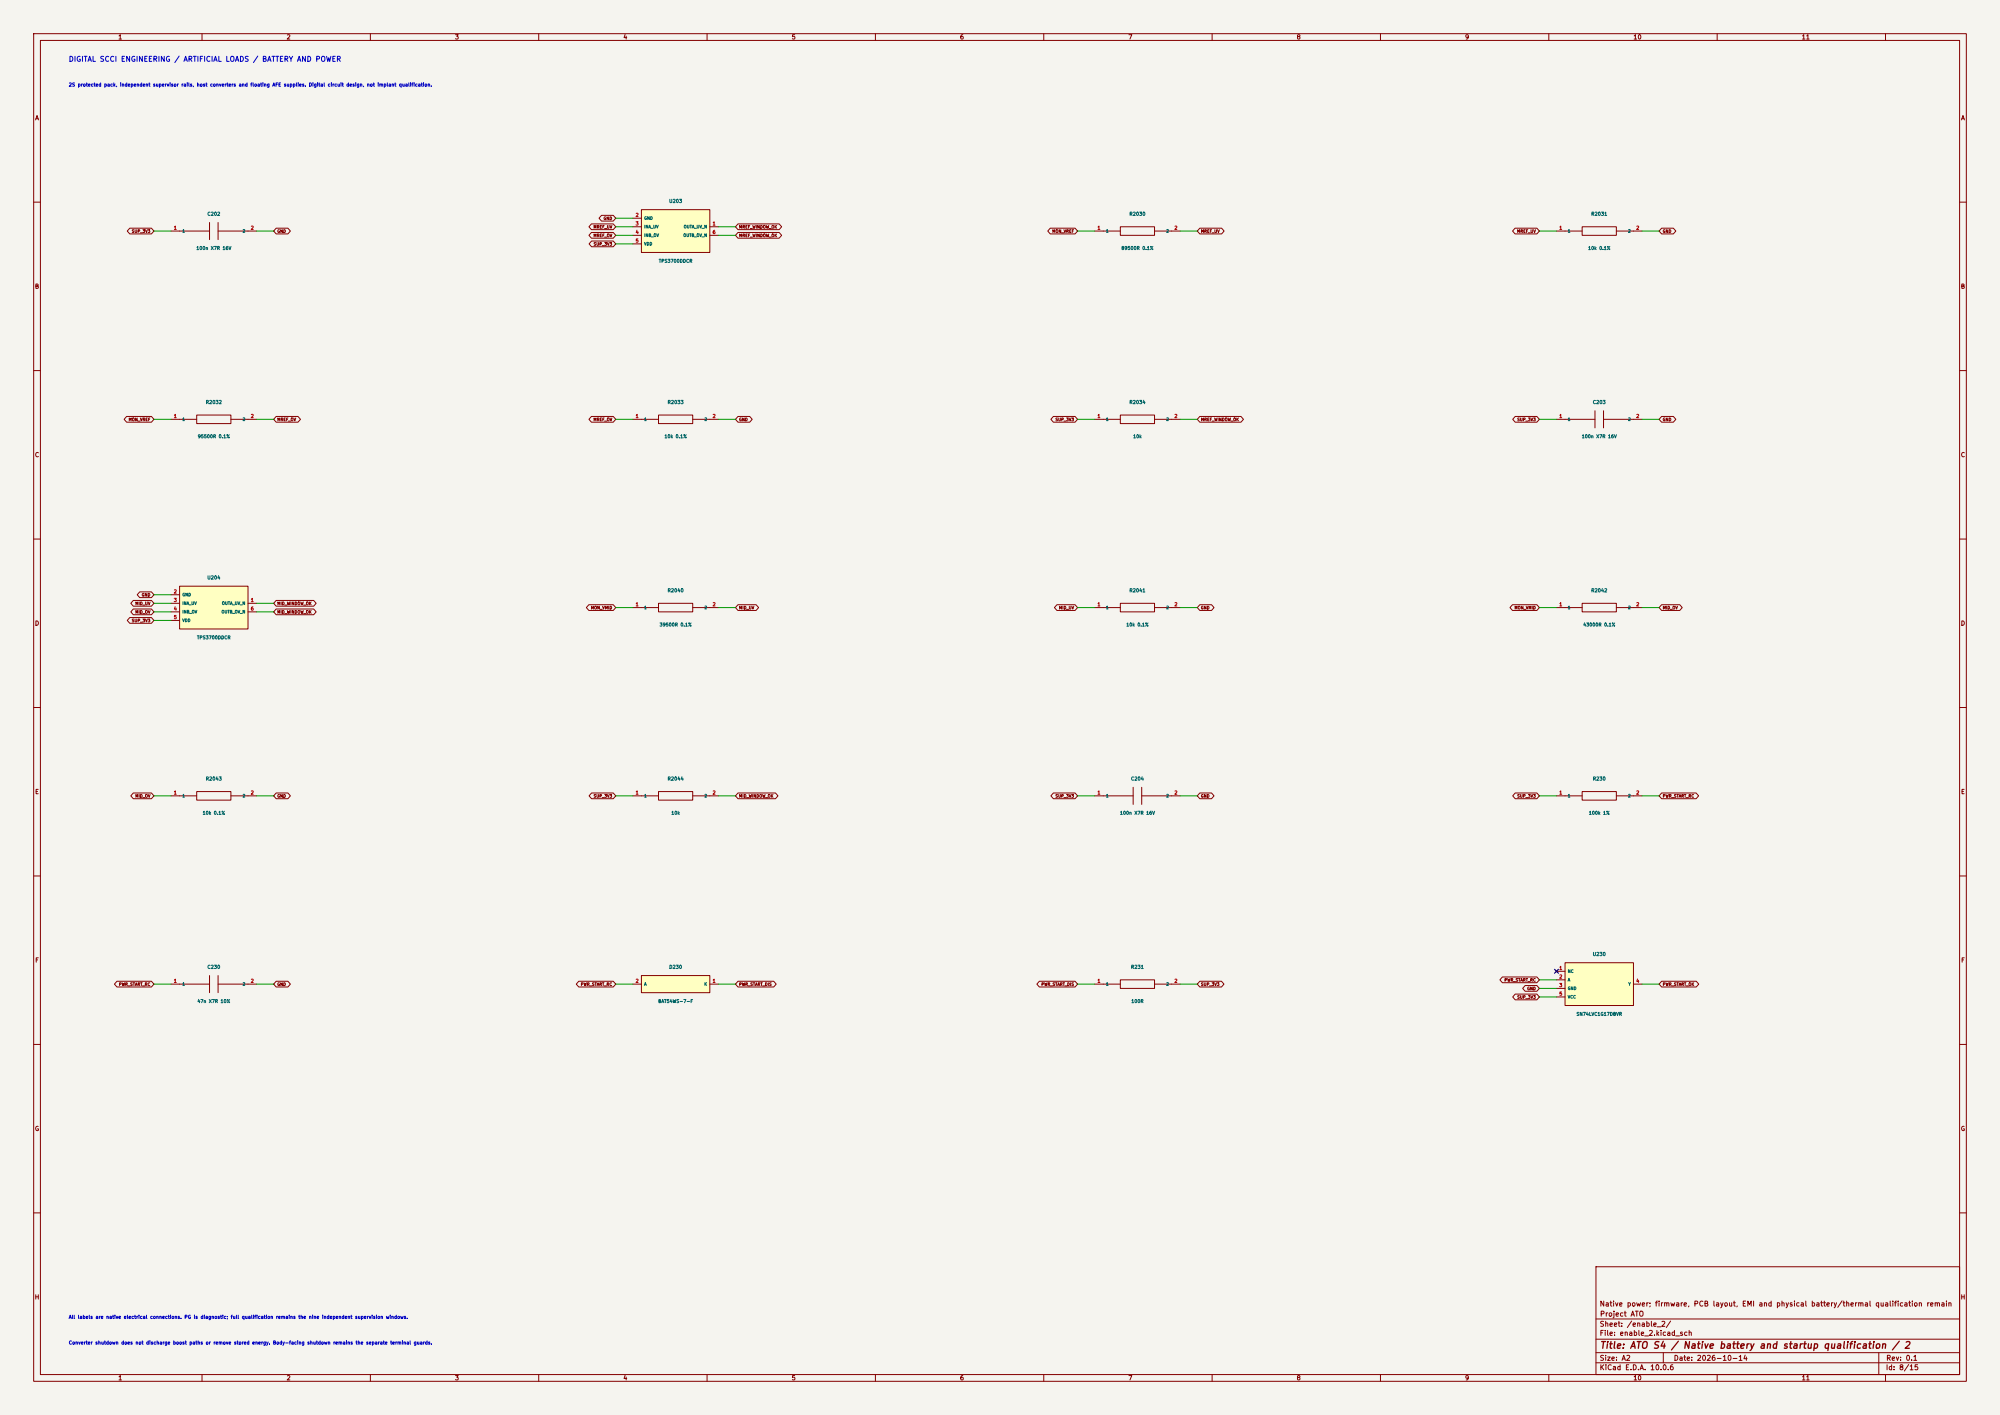
[picture p261: page 8]

DIGITAL SCCI ENGINEERING / ARTIFICIAL LOADS / BATTERY AND POWER

Sheet: /enable_2/
File: enable_2.kicad_sch
Title: ATO S4 / Native battery and startup qualification / 2

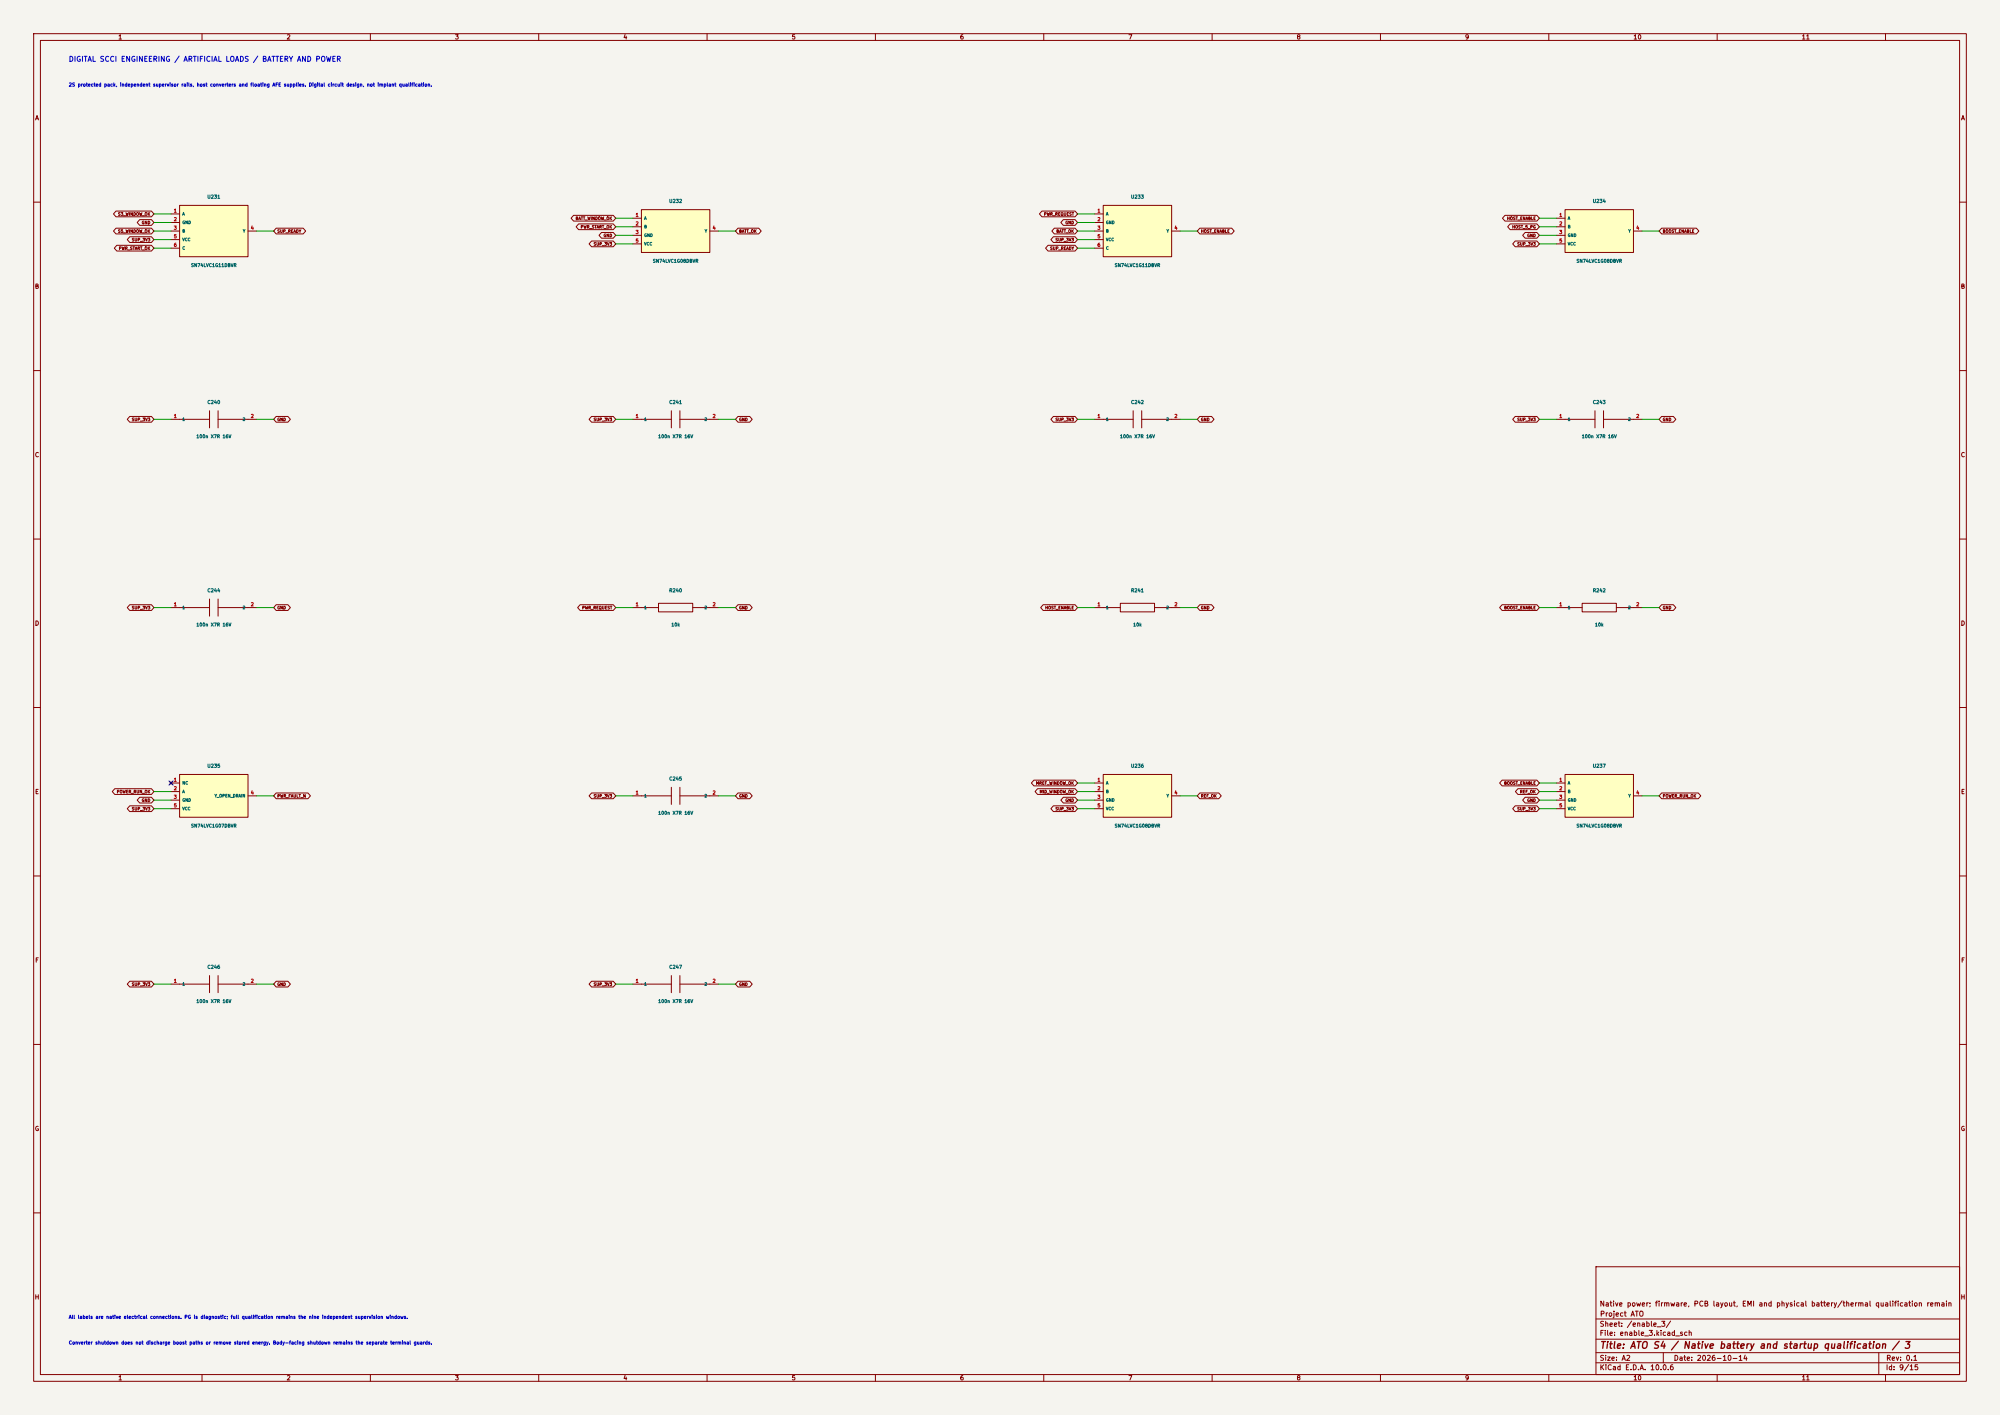
[picture p262: page 9]
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

Sheet: /enable_3/
File: enable_3.kicad_sch
Title: ATO S4 / Native battery and startup qualification / 3

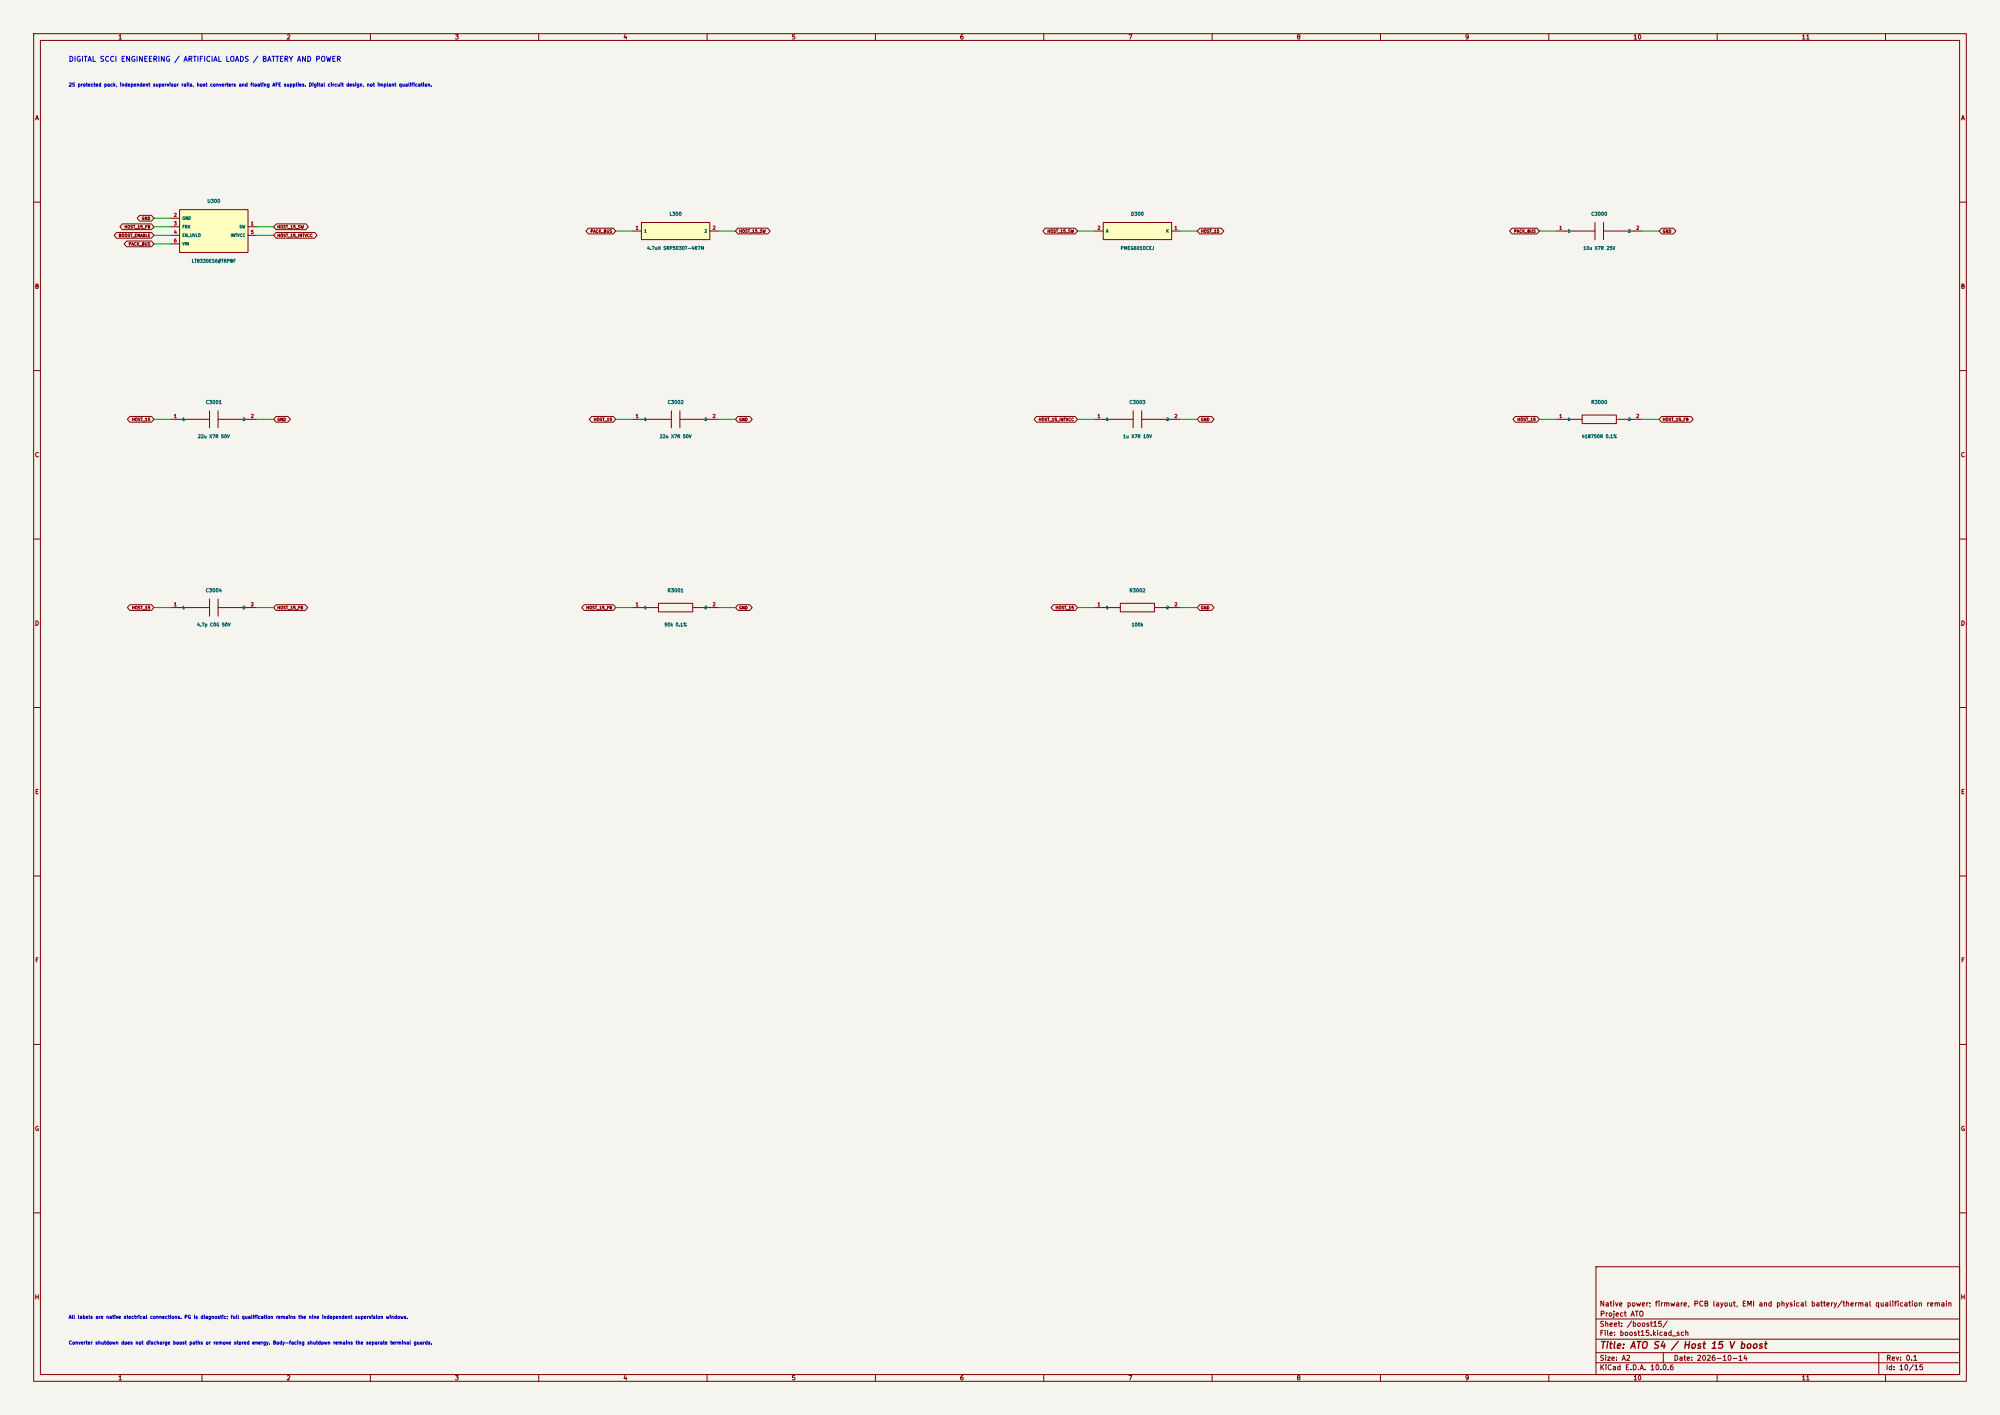
[picture p263: page 10]

DIGITAL SCCI ENGINEERING / ARTIFICIAL LOADS / BATTERY AND POWER

Sheet: /boost15/
File: boost15.kicad_sch
Title: ATO S4 / Host 15 V boost

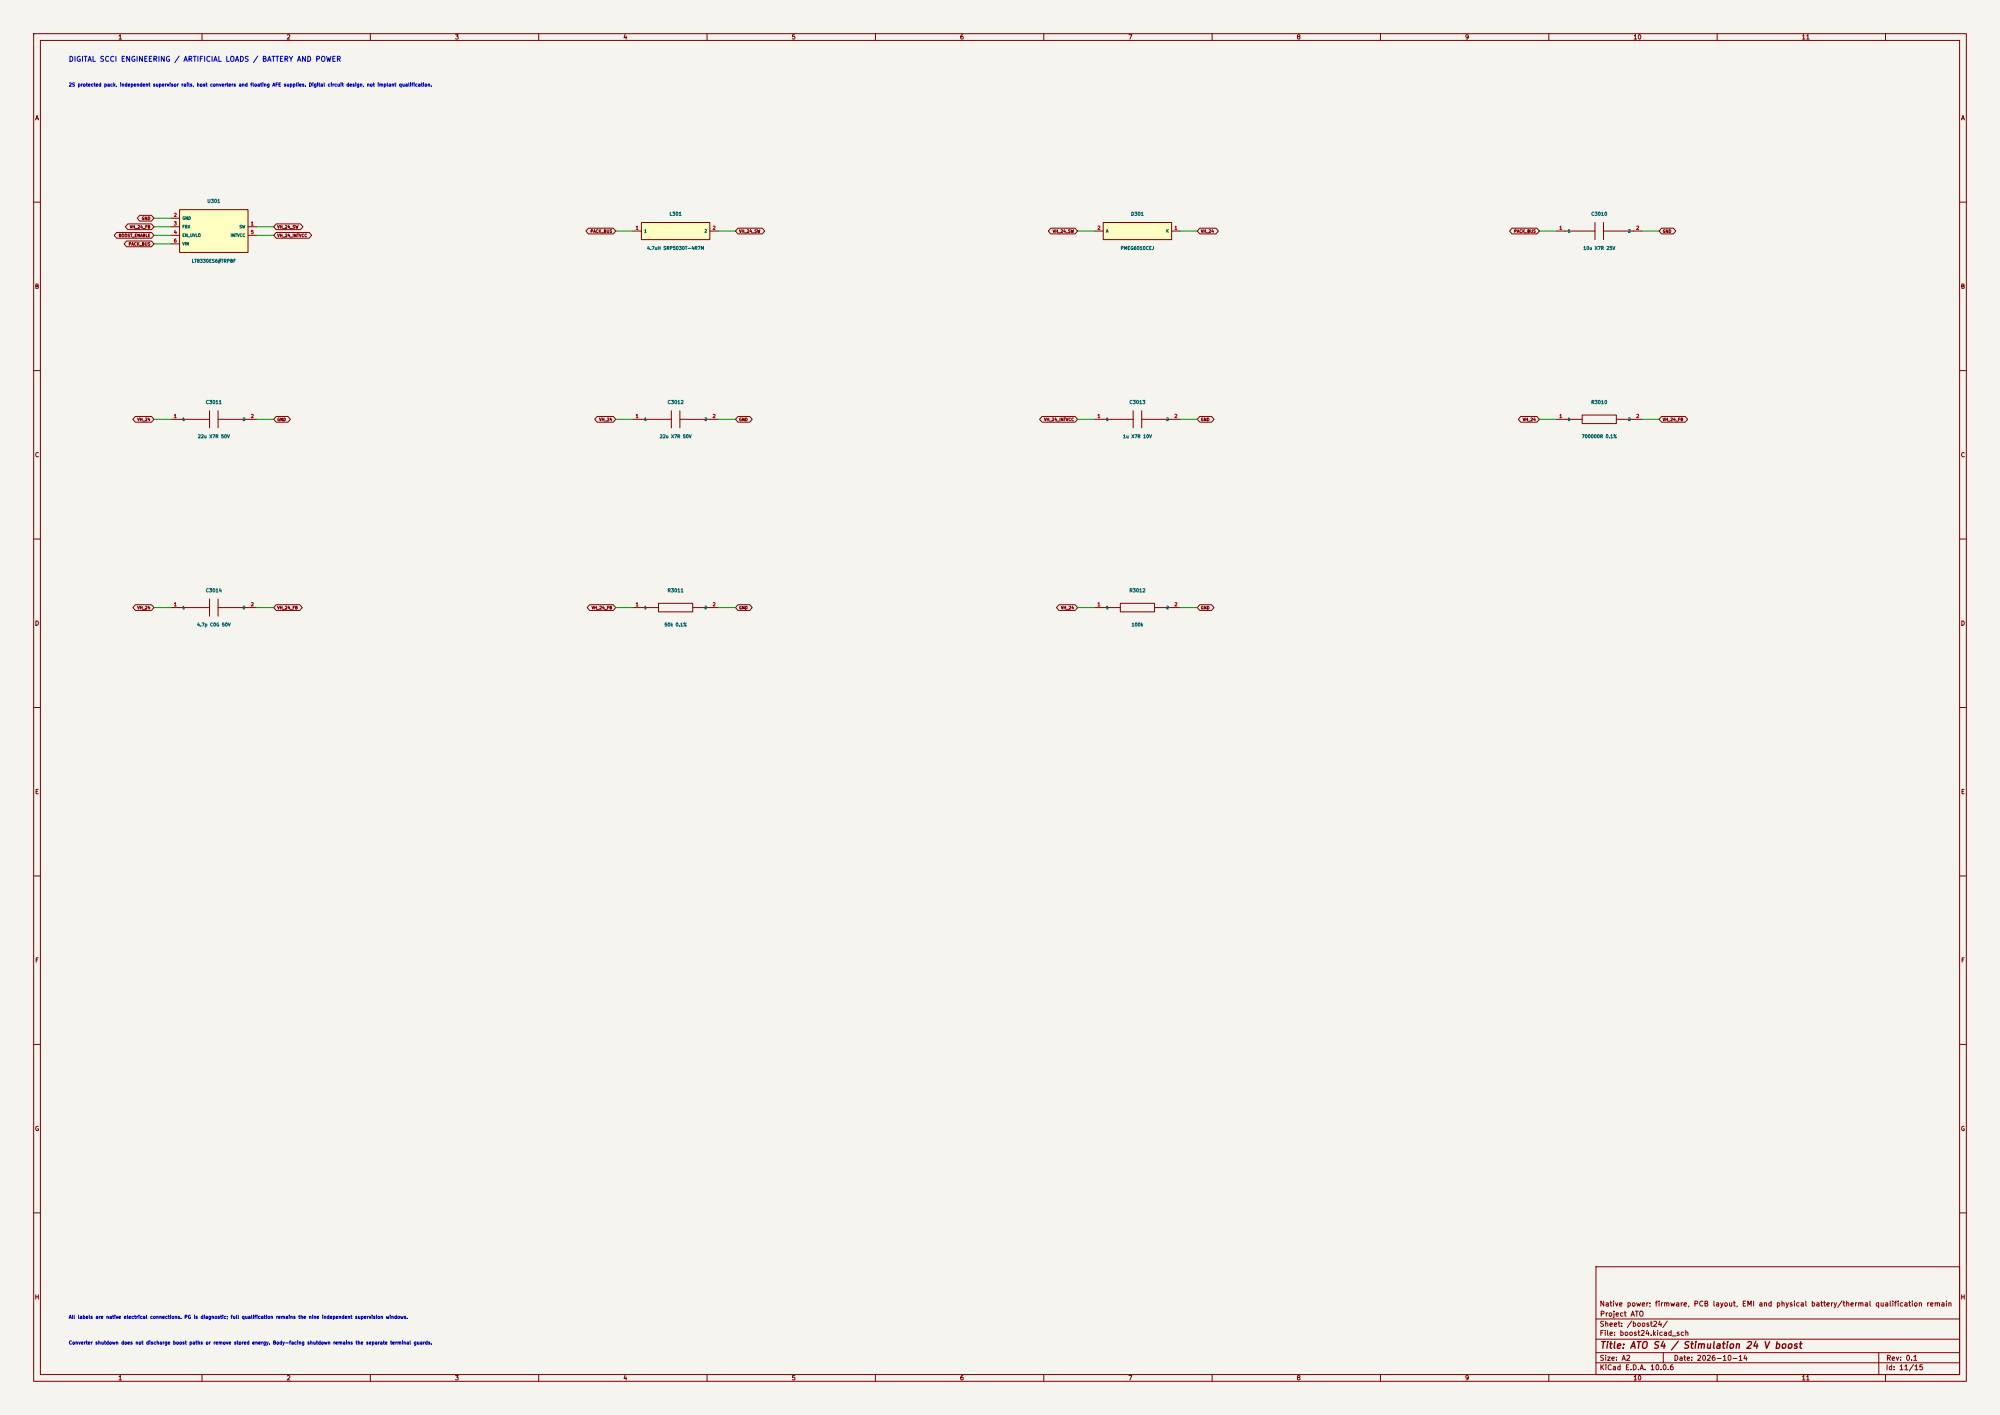
[picture p264: page 11]

DIGITAL SCCI ENGINEERING / ARTIFICIAL LOADS / BATTERY AND POWER

Sheet: /boost24/
File: boost24.kicad_sch
Title: ATO S4 / Stimulation 24 V boost

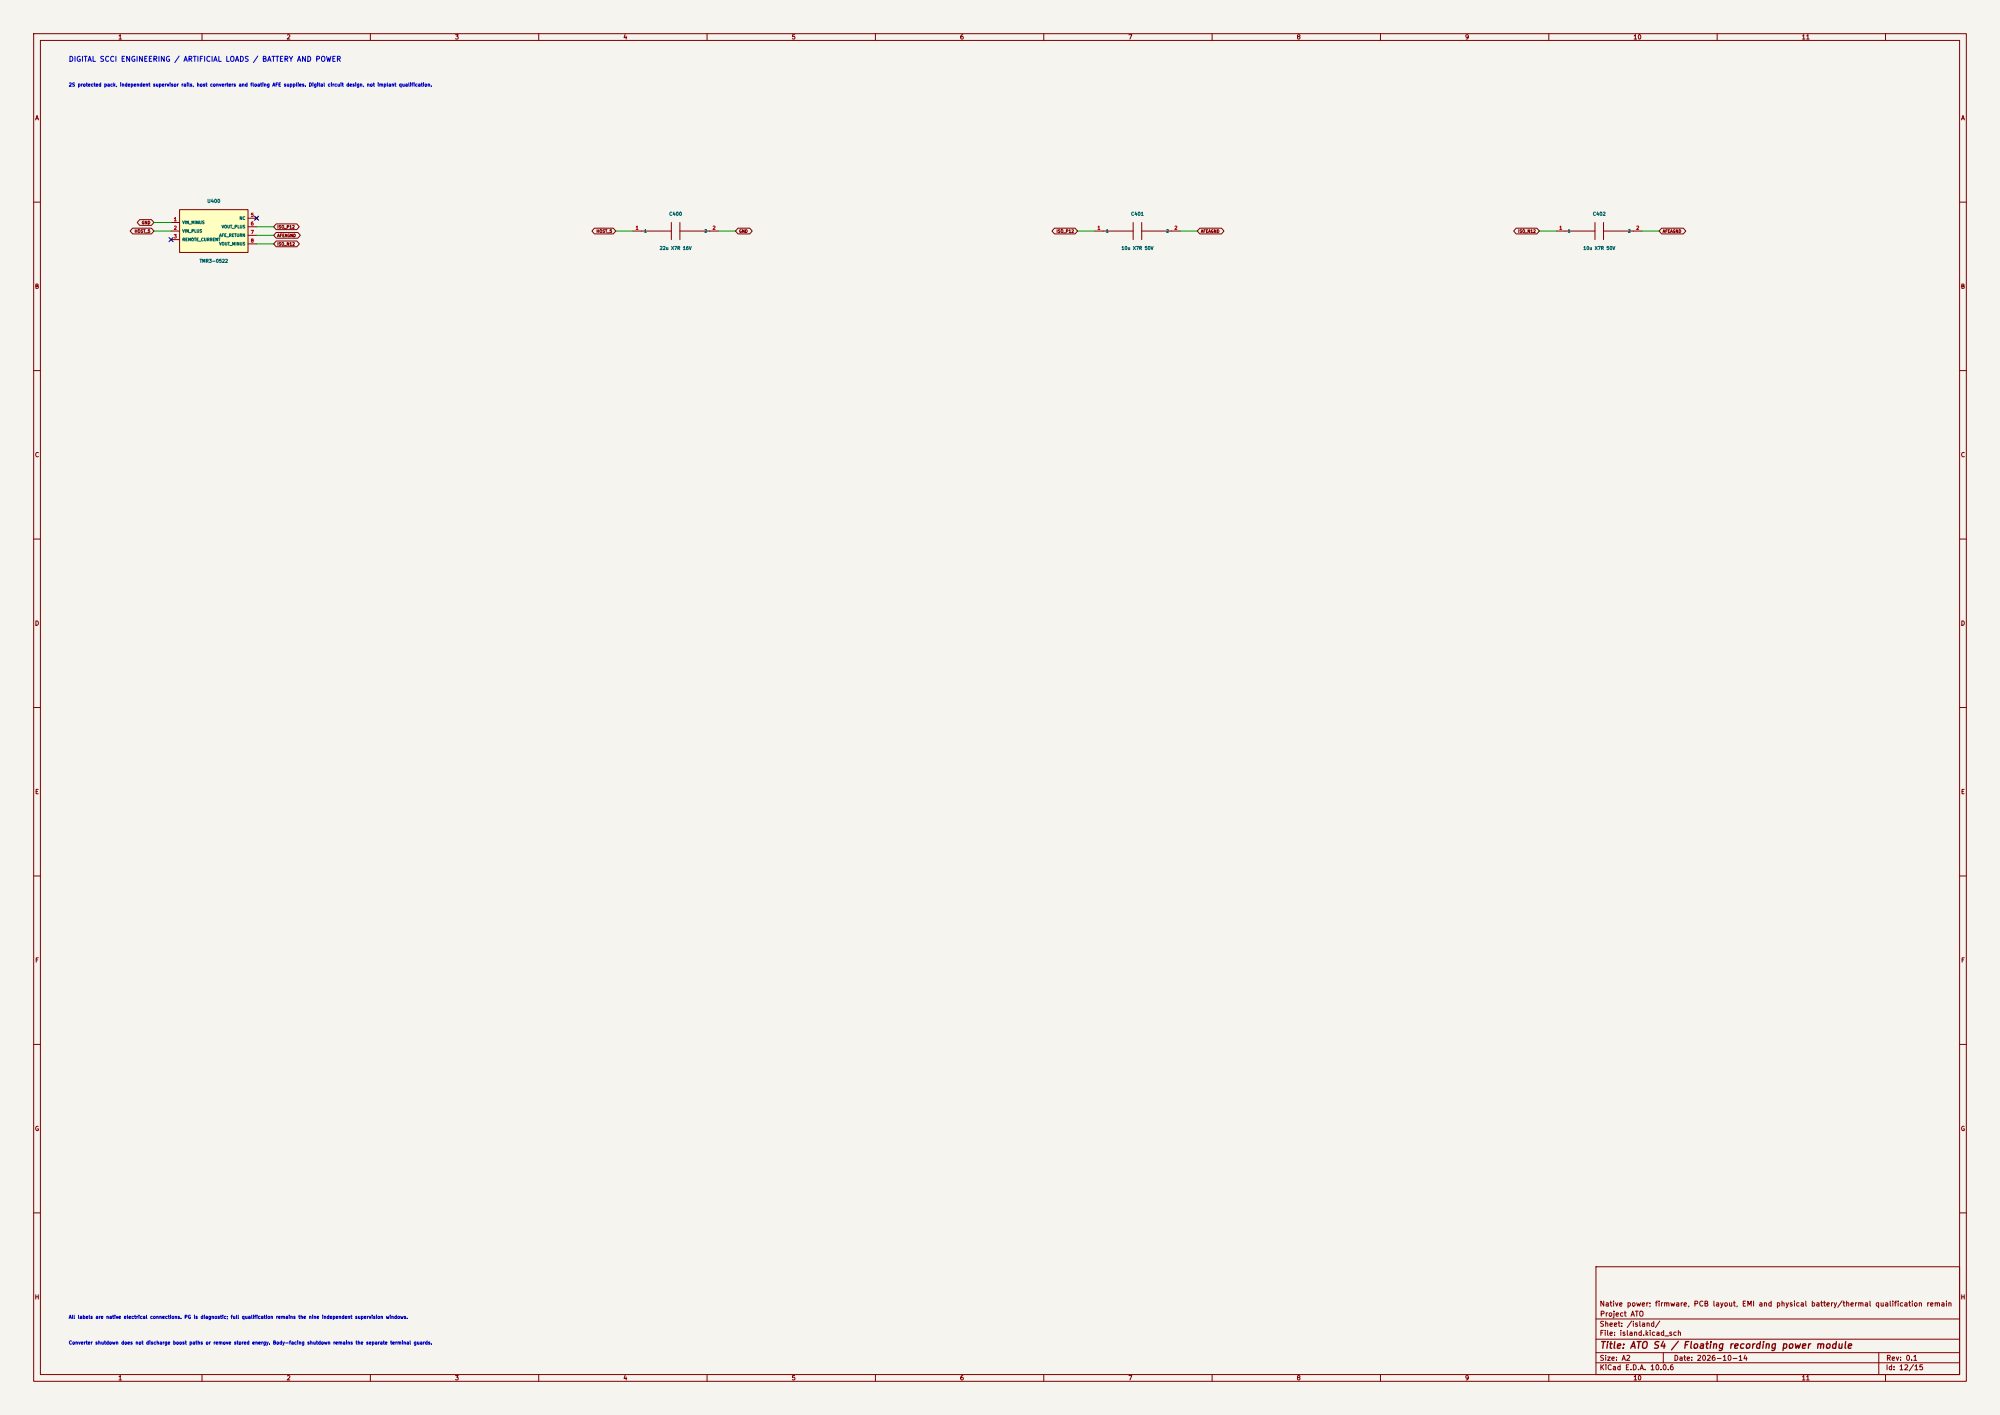
[picture p265: page 12]

DIGITAL SCCI ENGINEERING / ARTIFICIAL LOADS / BATTERY AND POWER

Sheet: /island/
File: island.kicad_sch
Title: ATO S4 / Floating recording power module

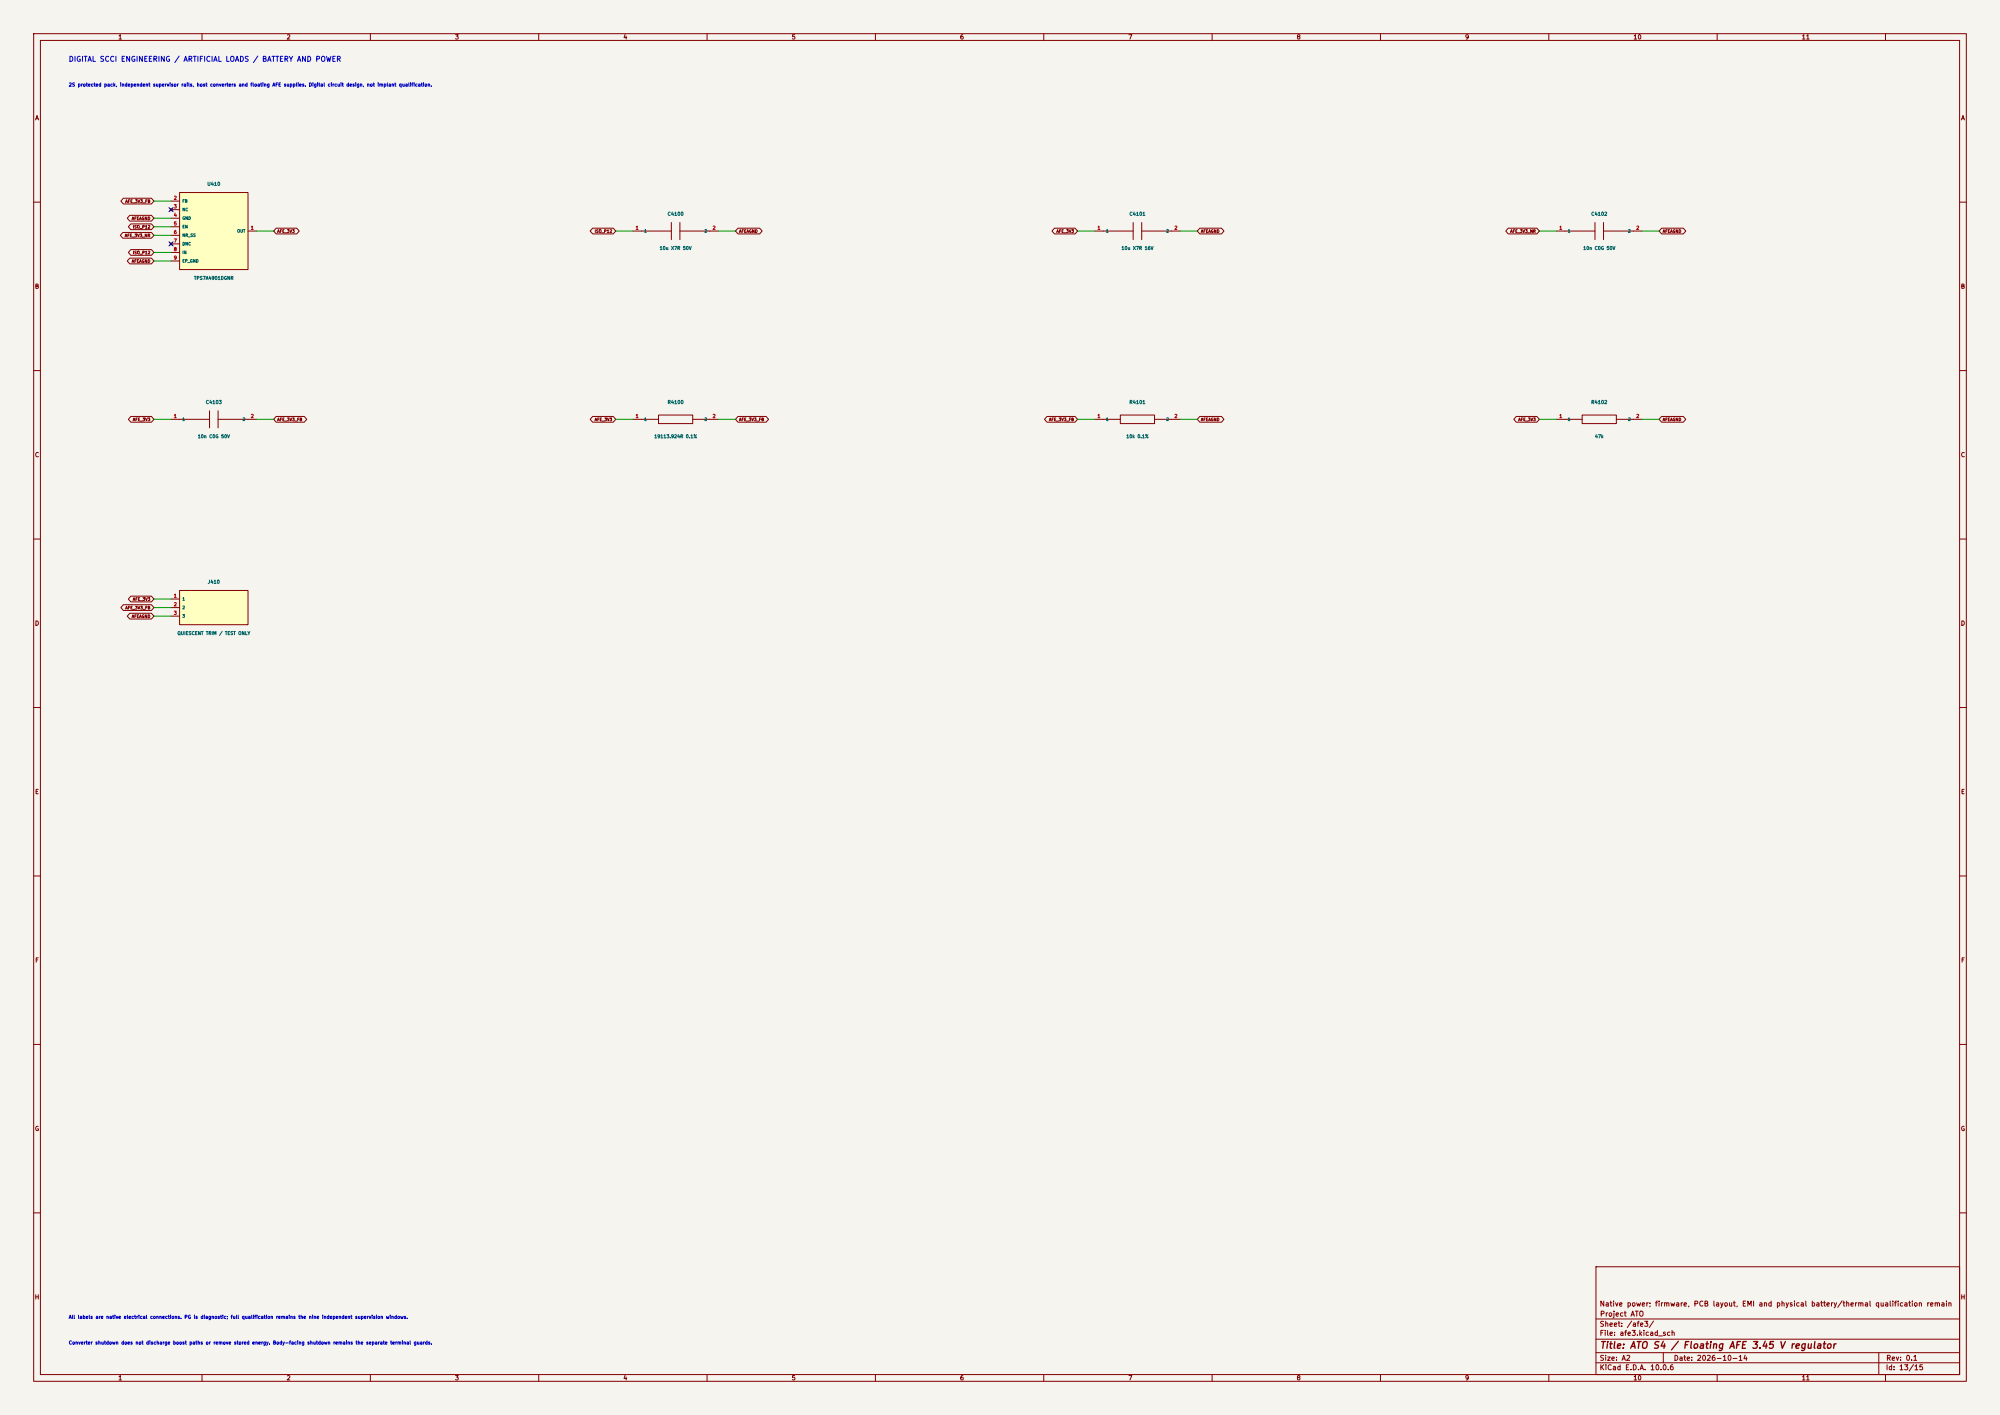
[picture p266: page 13]

AFE_3V3_FB 2S protected pack, independent supervisor rails, host converters and floating AFE supplies. Digital circuit design, not implant qualification. DIGITAL SCCI ENGINEERING / ARTIFICIAL LOADS / BATTERY AND POWER

J410 QUIESCENT TRIM / TEST ONLY

Sheet: /afe3/
File: afe3.kicad_sch
Title: ATO S4 / Floating AFE 3.45 V regulator

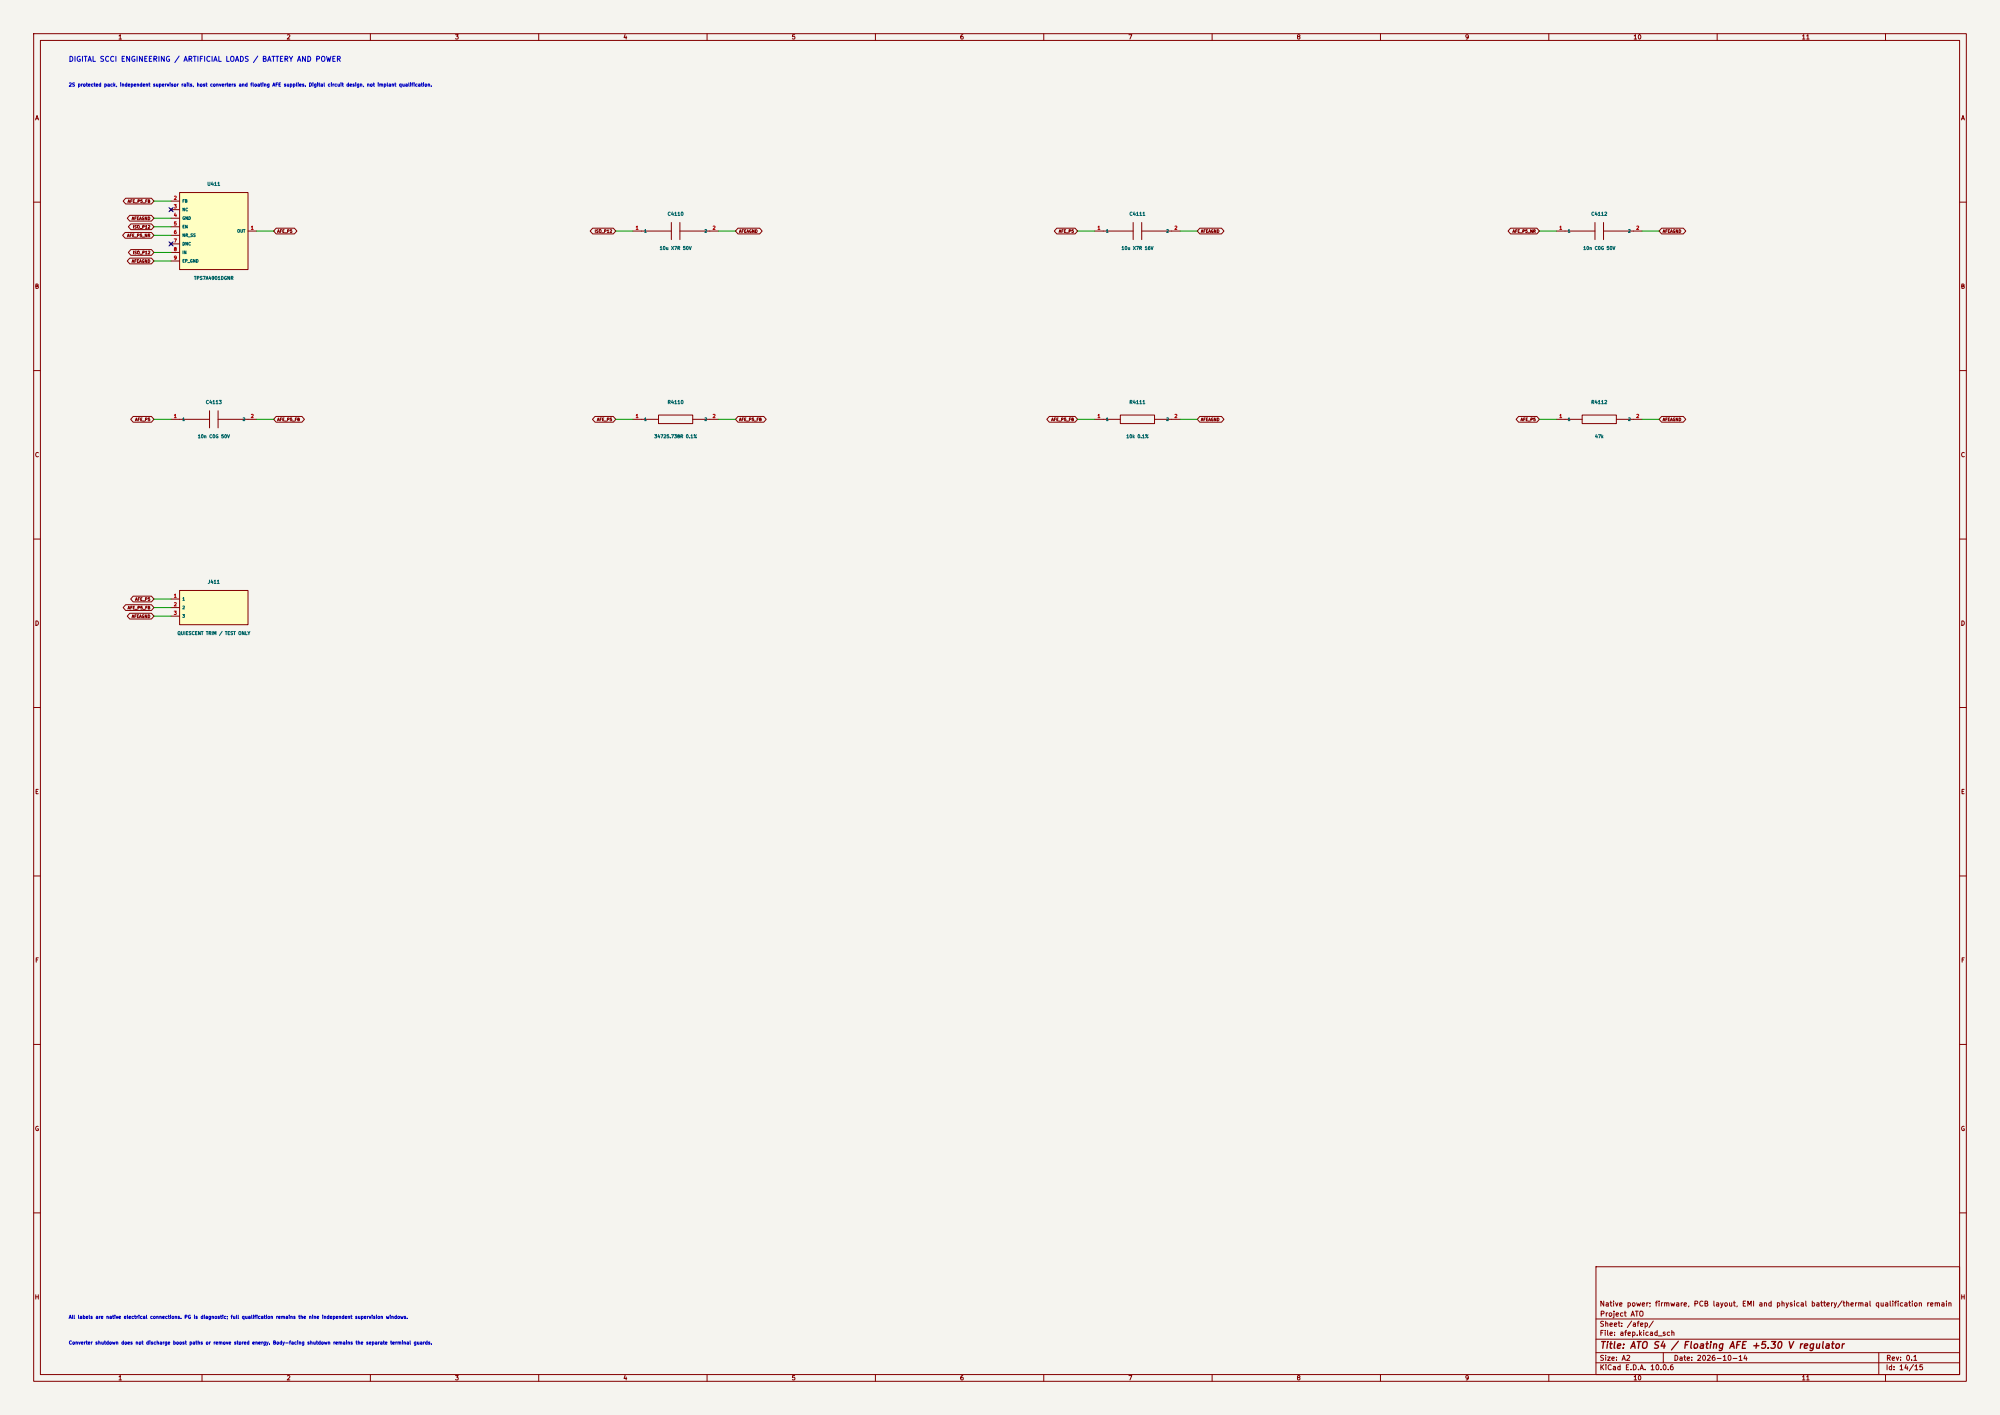
[picture p267: page 14]

AFE_P5_FB 2S protected pack, independent supervisor rails, host converters and floating AFE supplies. Digital circuit design, not implant qualification. DIGITAL SCCI ENGINEERING / ARTIFICIAL LOADS / BATTERY AND POWER

J411 QUIESCENT TRIM / TEST ONLY

Sheet: /afep/
File: afep.kicad_sch
Title: ATO S4 / Floating AFE +5.30 V regulator

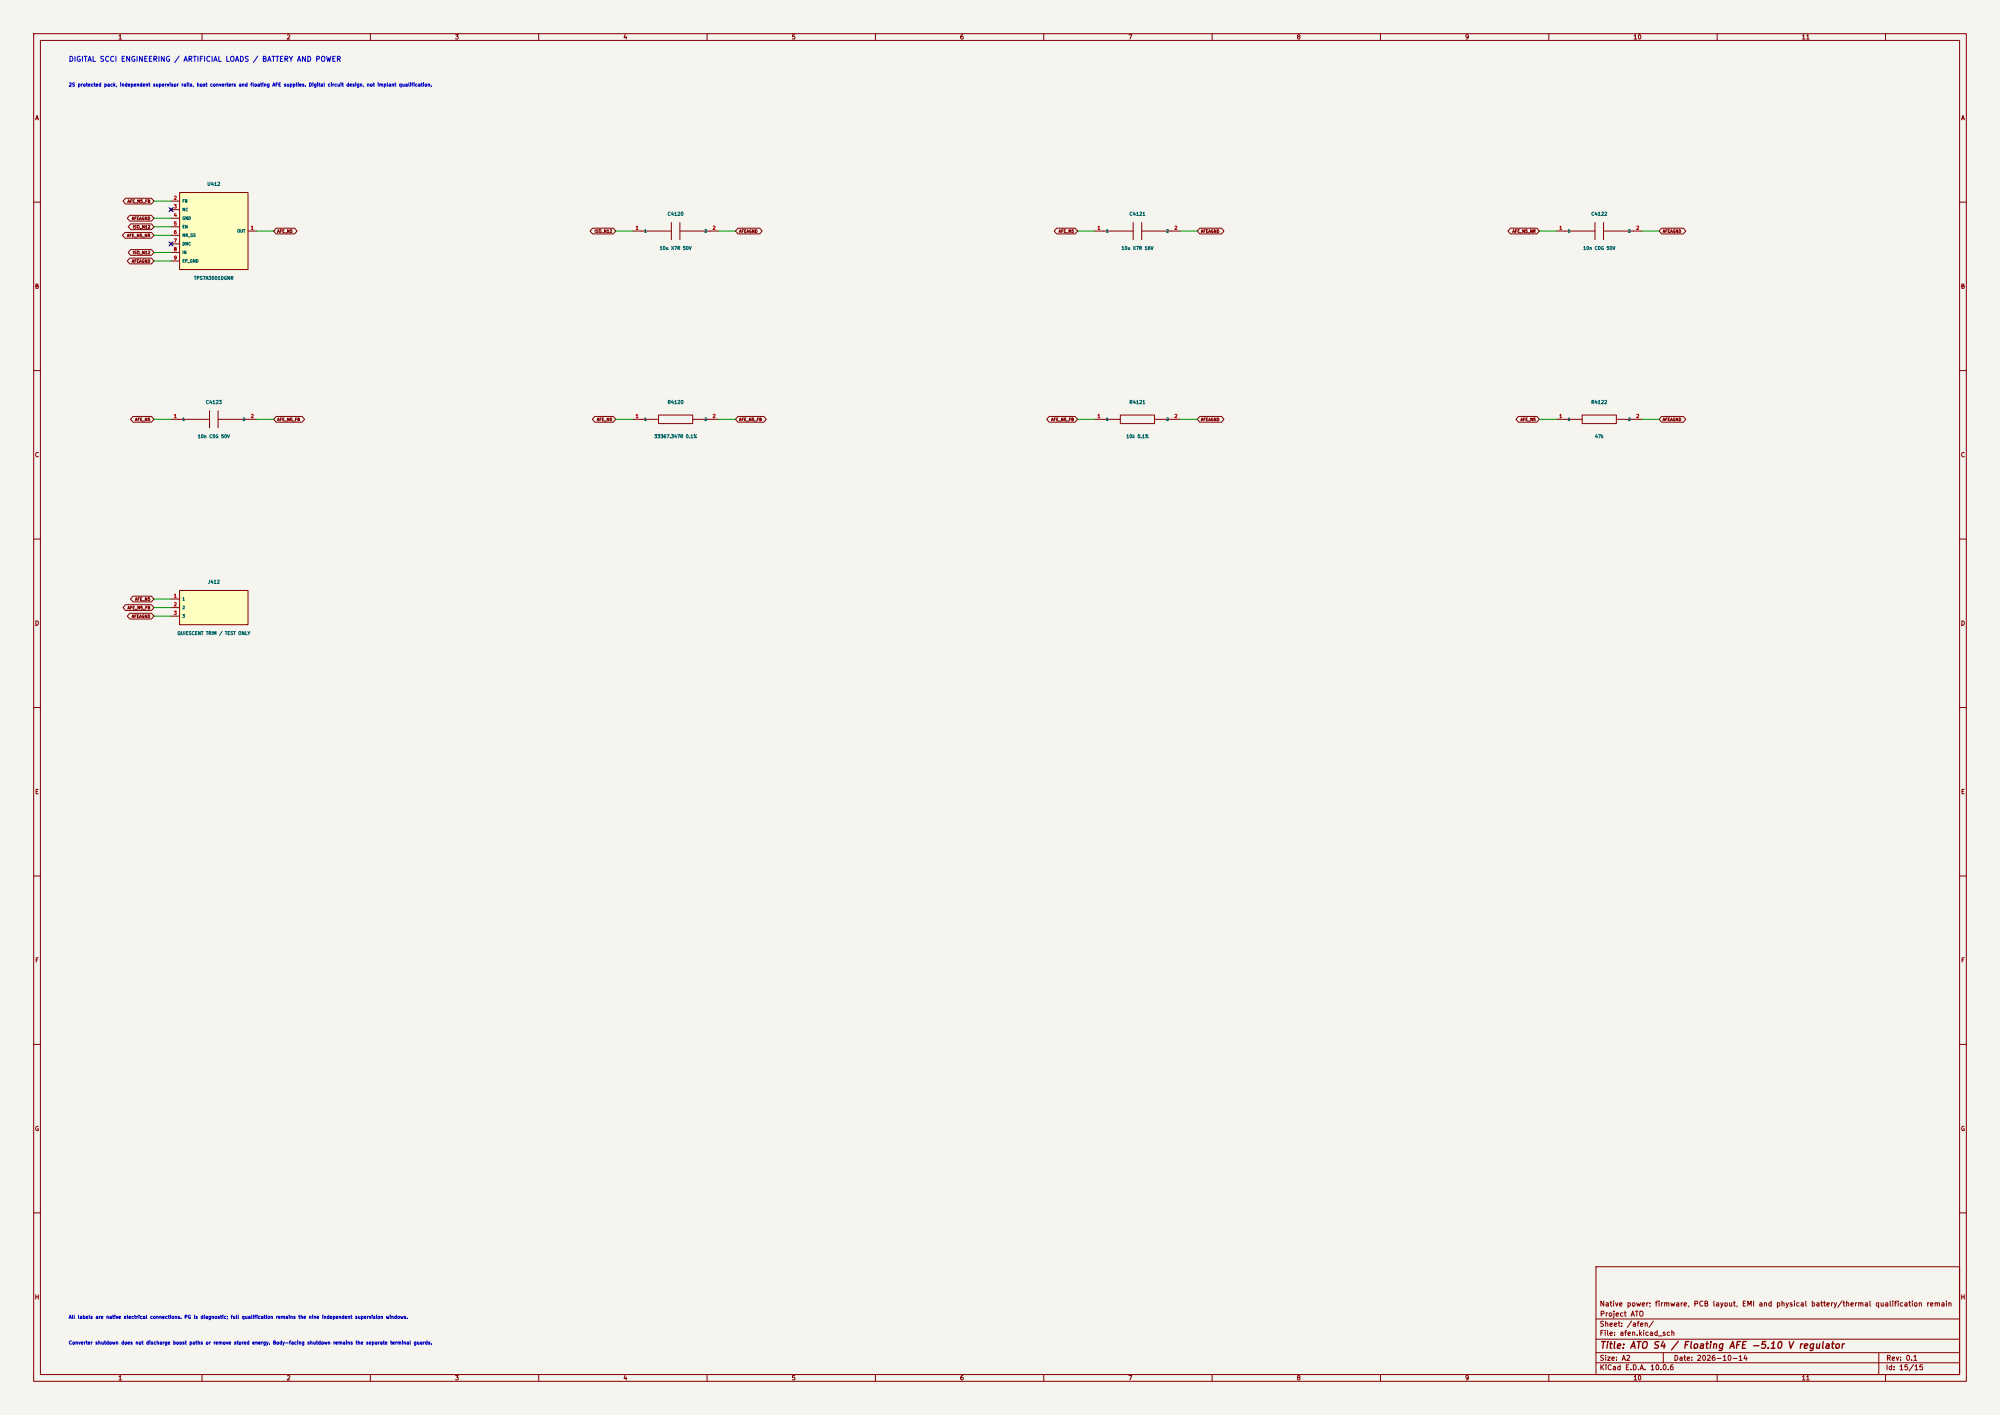
[picture p268: page 15]

AFE_N5_FB 2S protected pack, independent supervisor rails, host converters and floating AFE supplies. Digital circuit design, not implant qualification. DIGITAL SCCI ENGINEERING / ARTIFICIAL LOADS / BATTERY AND POWER

J412 QUIESCENT TRIM / TEST ONLY

Sheet: /afen/
File: afen.kicad_sch
Title: ATO S4 / Floating AFE -5.10 V regulator
