pratham-cloud-ctrl/Project-ATO/electronics/stage4/supervision/supervision.pdf

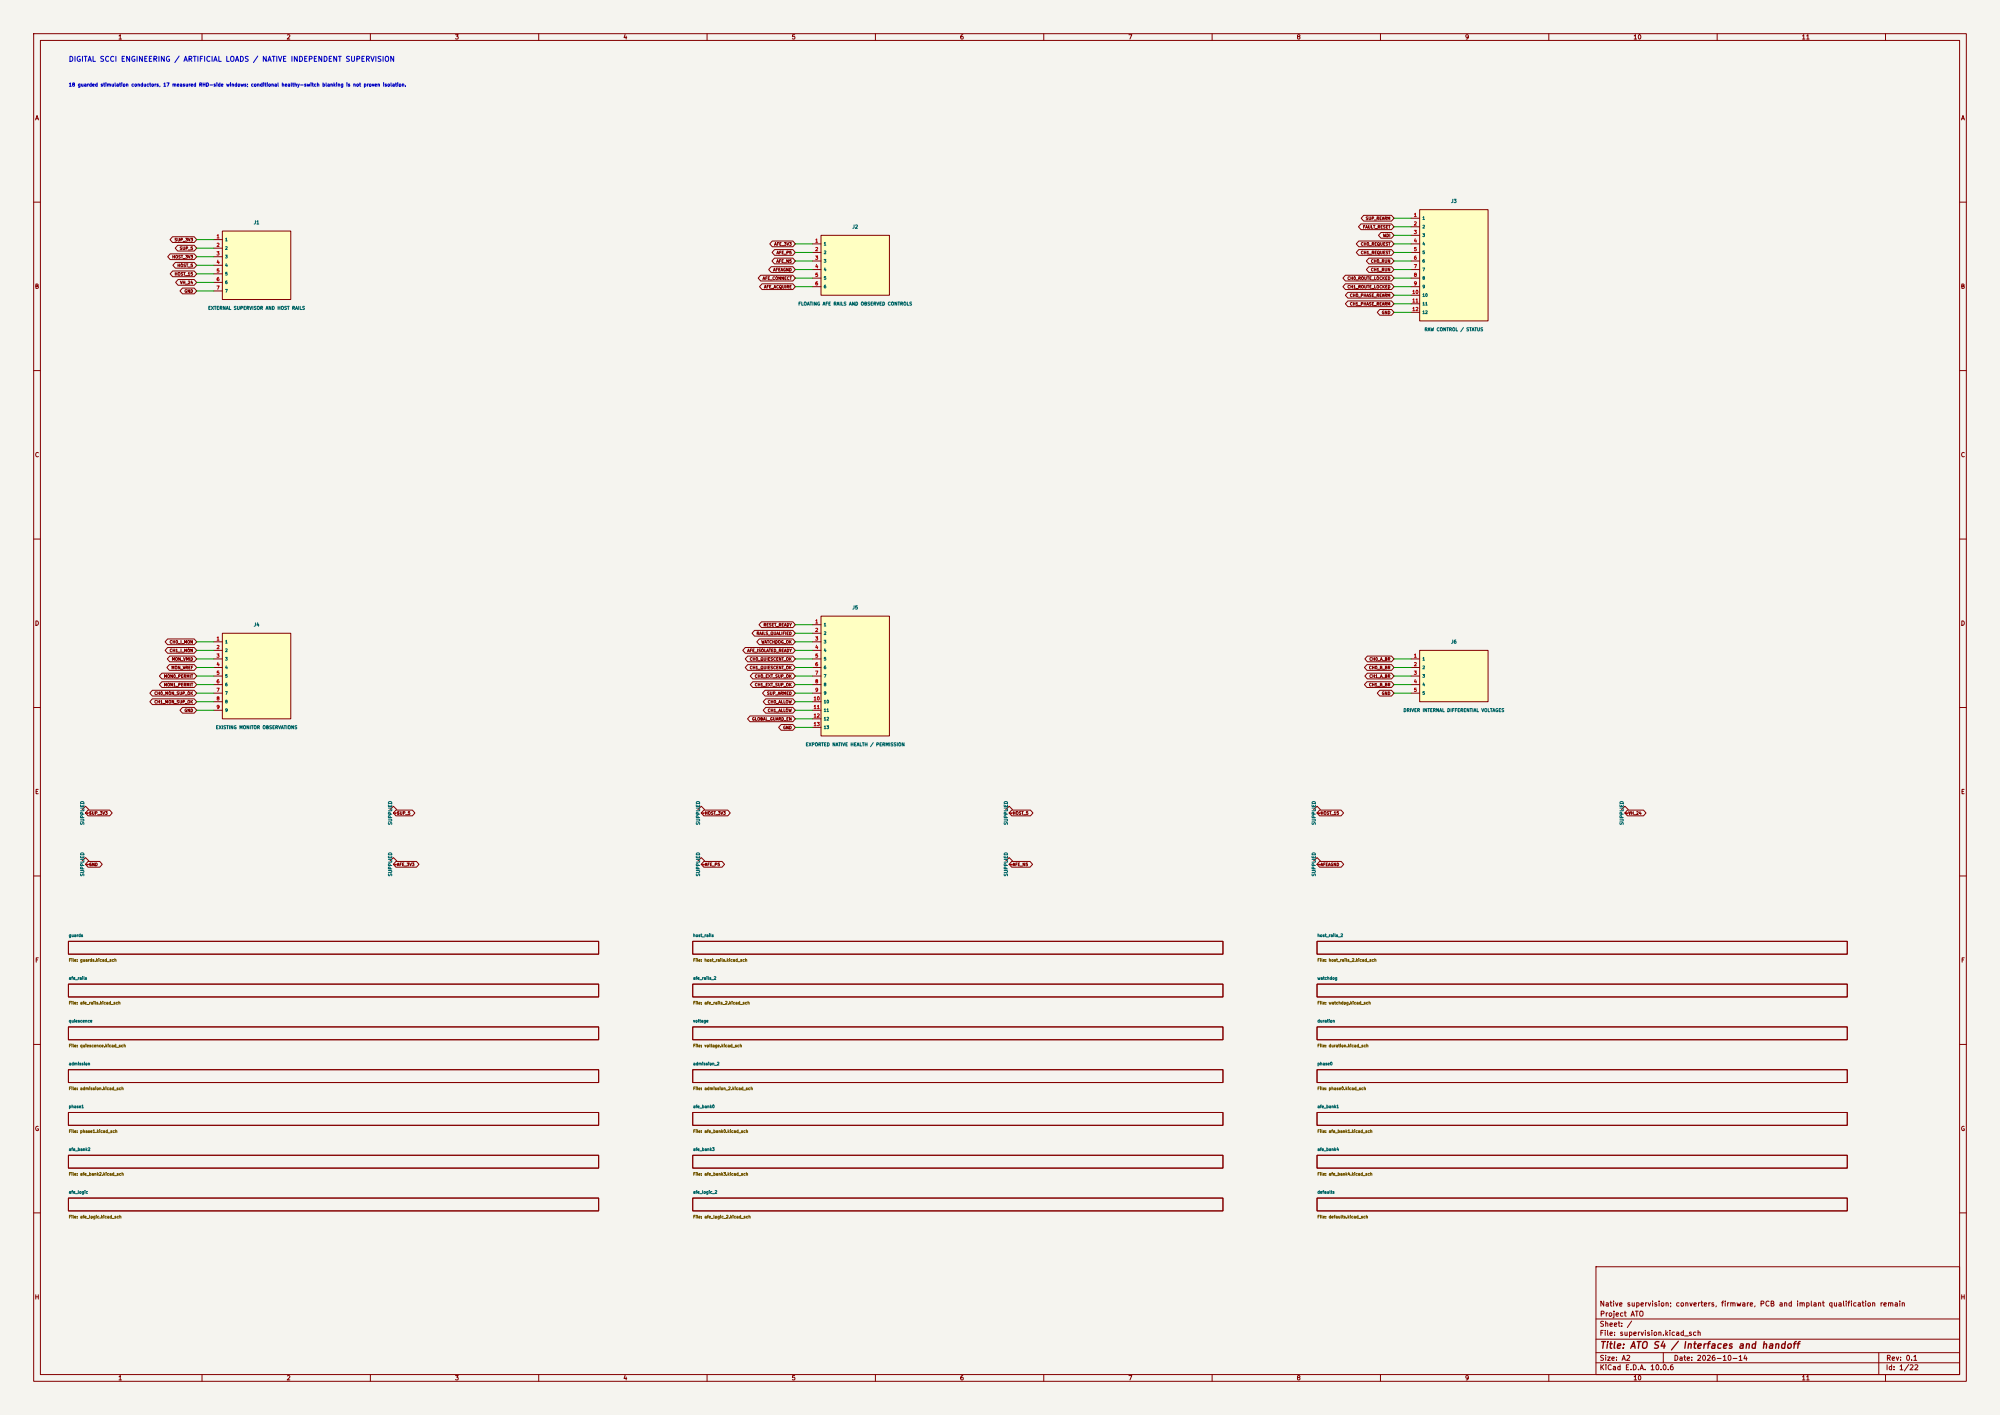
[picture p276: page 1]

18 guarded stimulation conductors, 17 measured RHD-side windows; conditional healthy-switch blanking is not proven isolation. DIGITAL SCCI ENGINEERING / ARTIFICIAL LOADS / NATIVE INDEPENDENT SUPERVISION

EXTERNAL SUPERVISOR AND HOST RAILS

DRIVER INTERNAL DIFFERENTIAL VOLTAGES SUPPLIED

EXPORTED NATIVE HEALTH / PERMISSION

Native supervision; converters, firmware, PCB and implant qualification remain
Project ATO
Sheet: /
File: supervision.kicad_sch
Title: ATO S4 / Interfaces and handoff

Size: A2 | Rev: 0.1
KiCad E.D.A. 10.0.6 | Id: 1/22

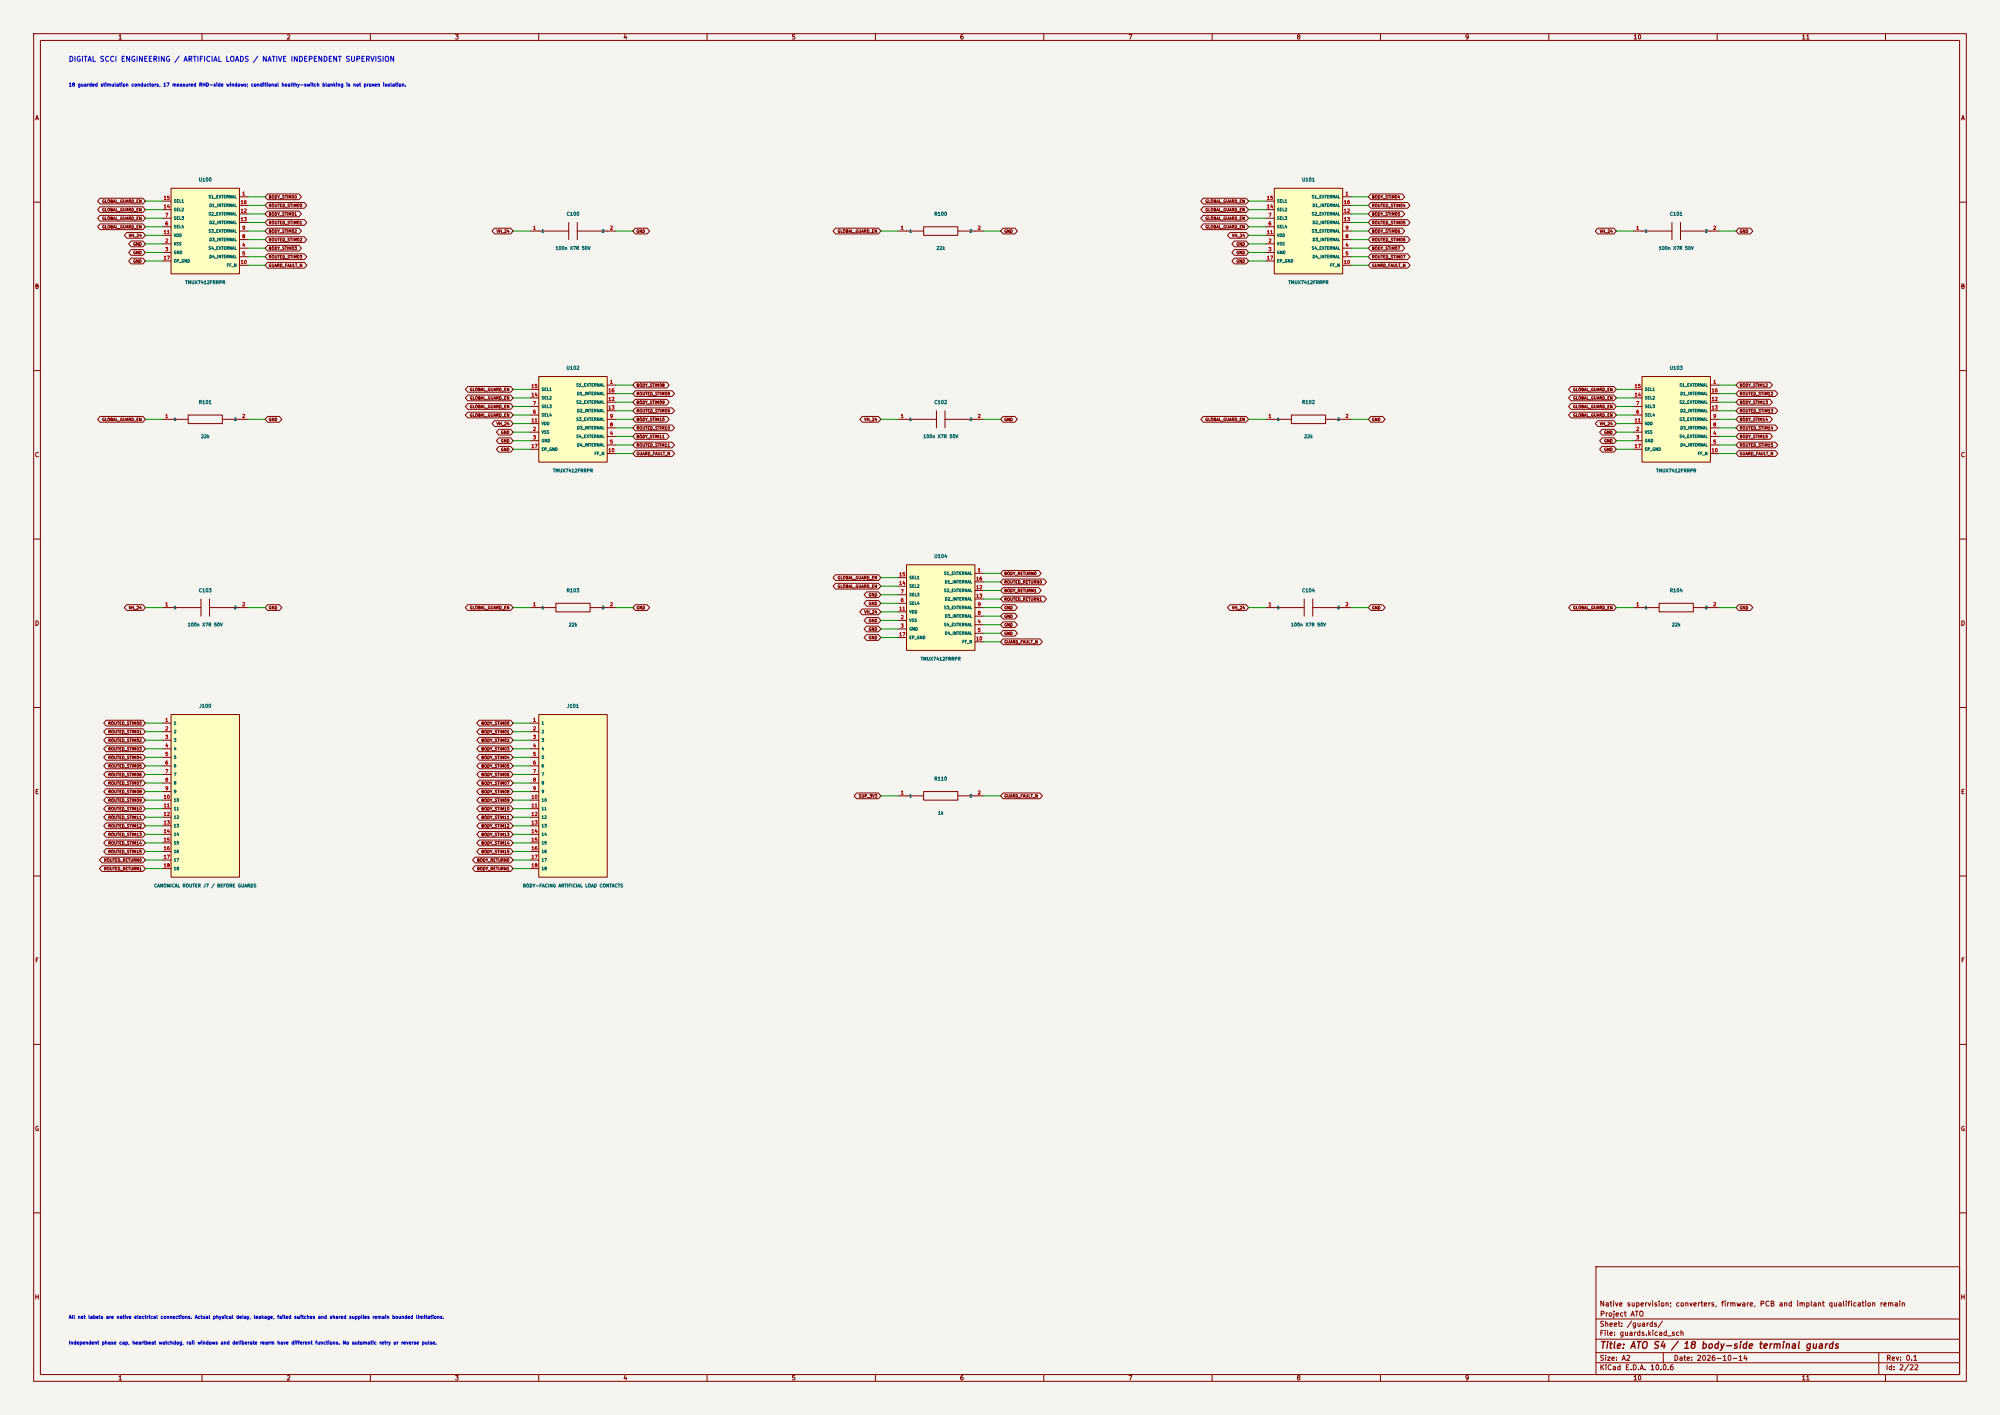
[picture p277: page 2]

DIGITAL SCCI ENGINEERING / ARTIFICIAL LOADS / NATIVE INDEPENDENT SUPERVISION

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

CANONICAL ROUTER J7 / BEFORE GUARDS

BODY-FACING ARTIFICIAL LOAD CONTACTS

All net labels are native electrical connections. Actual physical delay, leakage, failed switches and shared supplies remain bounded limitations.

Sheet: /guards/
File: guards.kicad_sch
Title: ATO S4 / 18 body-side terminal guards

Independent phase cap, heartbeat watchdog, rail windows and deliberate rearm have different functions. No automatic retry or reverse pulse.

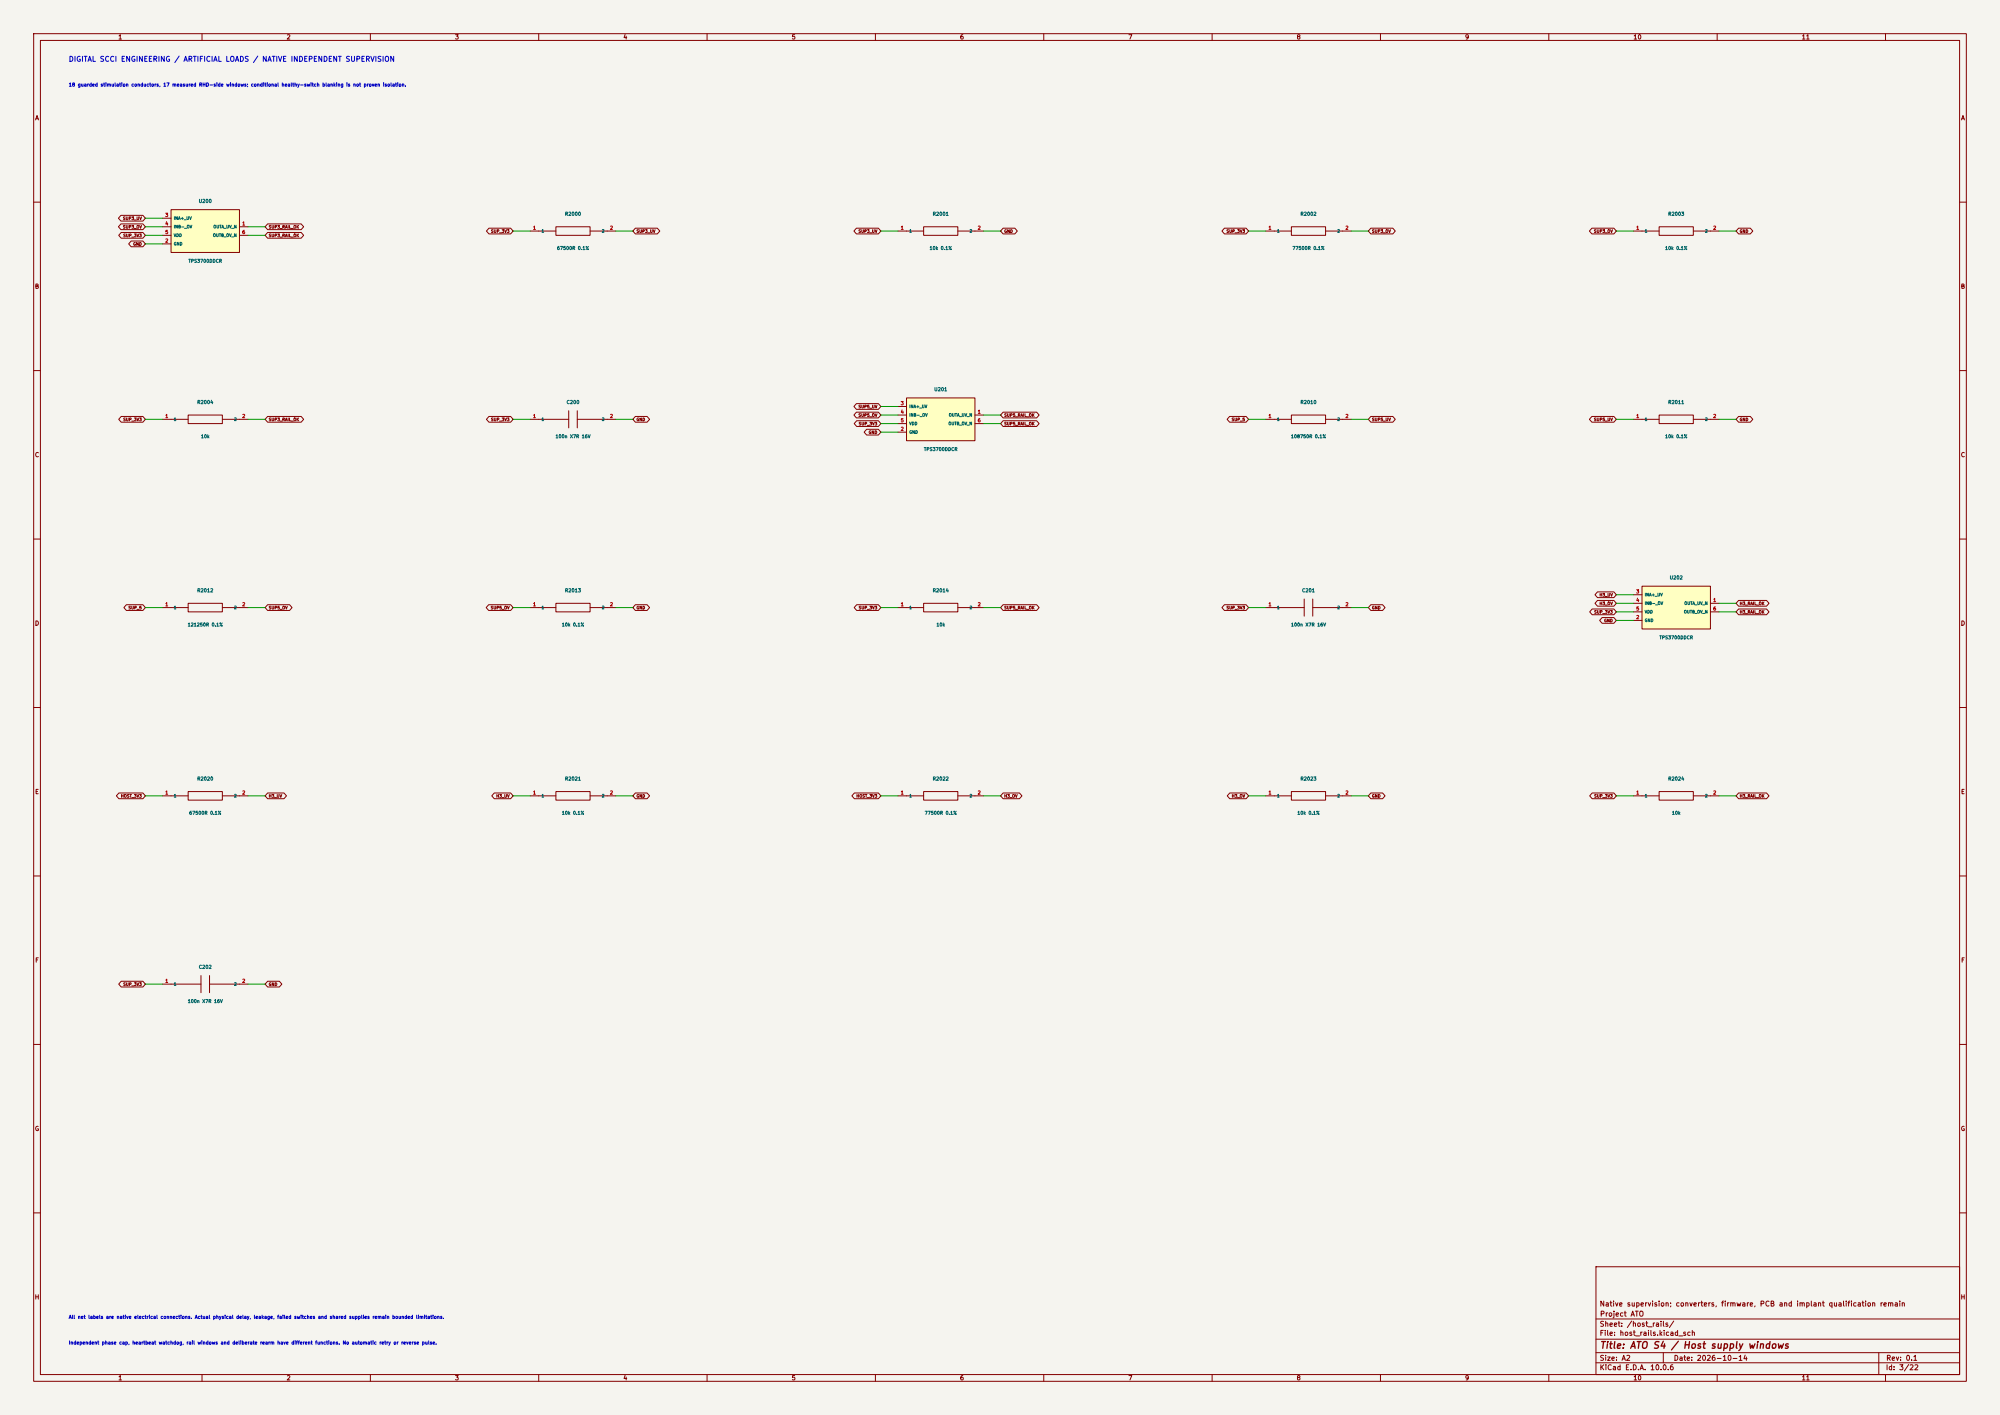
[picture p278: page 3]

Independent phase cap, heartbeat watchdog, rail windows and deliberate rearm have different functions. No automatic retry or reverse pulse. All net labels are native electrical connections. Actual physical delay, leakage, failed switches and shared supplies remain bounded limitations.

Sheet: /host_rails/
File: host_rails.kicad_sch
Title: ATO S4 / Host supply windows

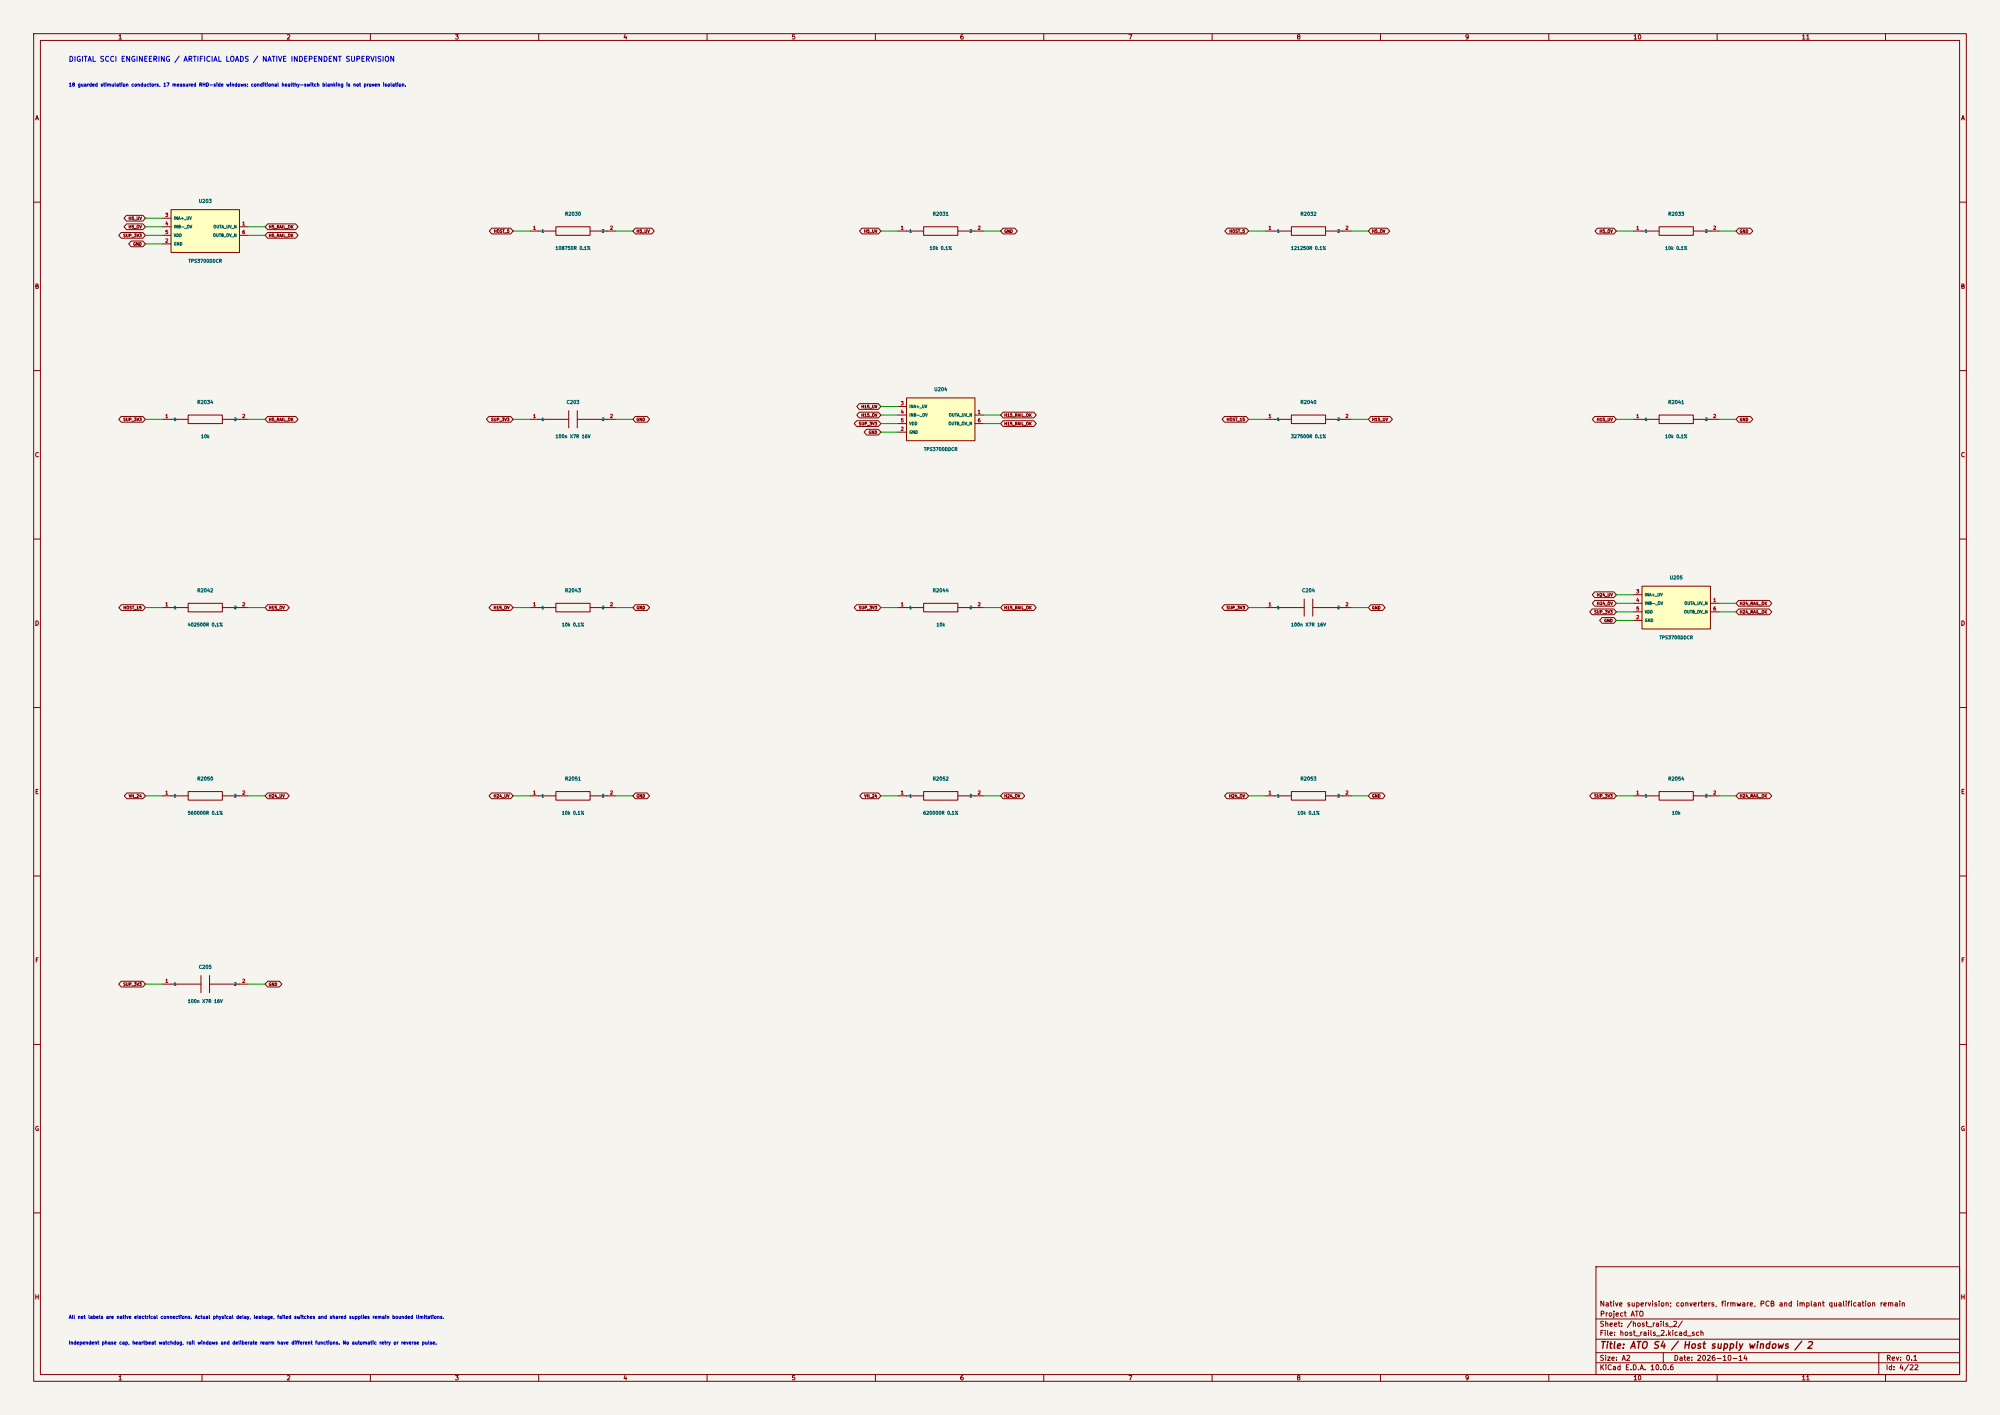
[picture p279: page 4]

H5_OV 18 guarded stimulation conductors, 17 measured RHD-side windows; conditional healthy-switch blanking is not proven isolation.

Sheet: /host_rails_2/
File: host_rails_2.kicad_sch
Title: ATO S4 / Host supply windows / 2

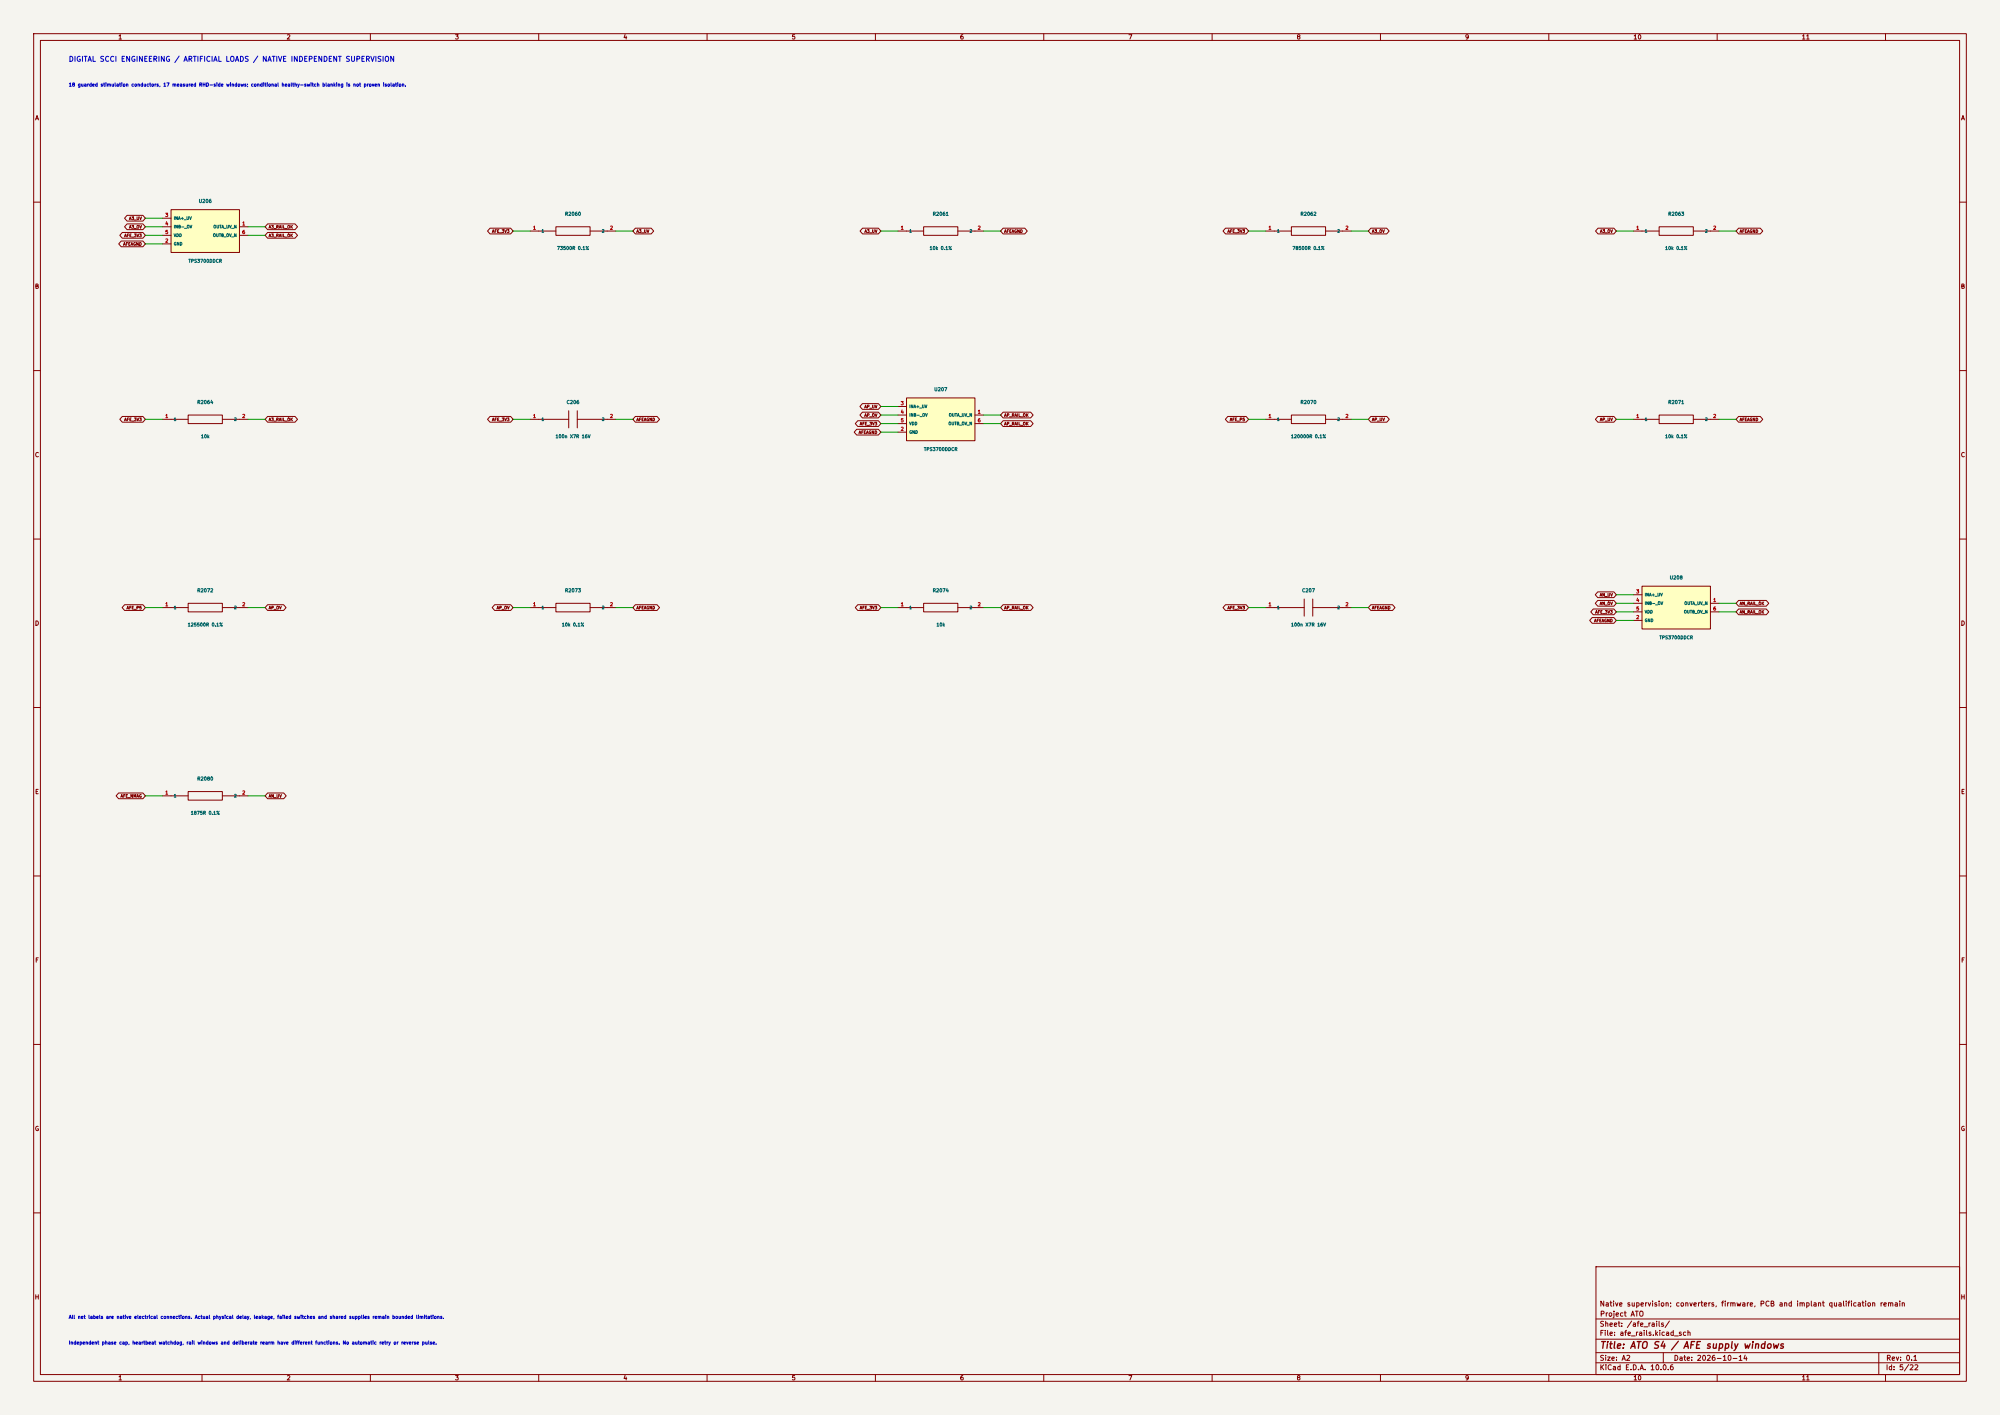
[picture p280: page 5]

Sheet: /afe_rails/
File: afe_rails.kicad_sch
Title: ATO S4 / AFE supply windows

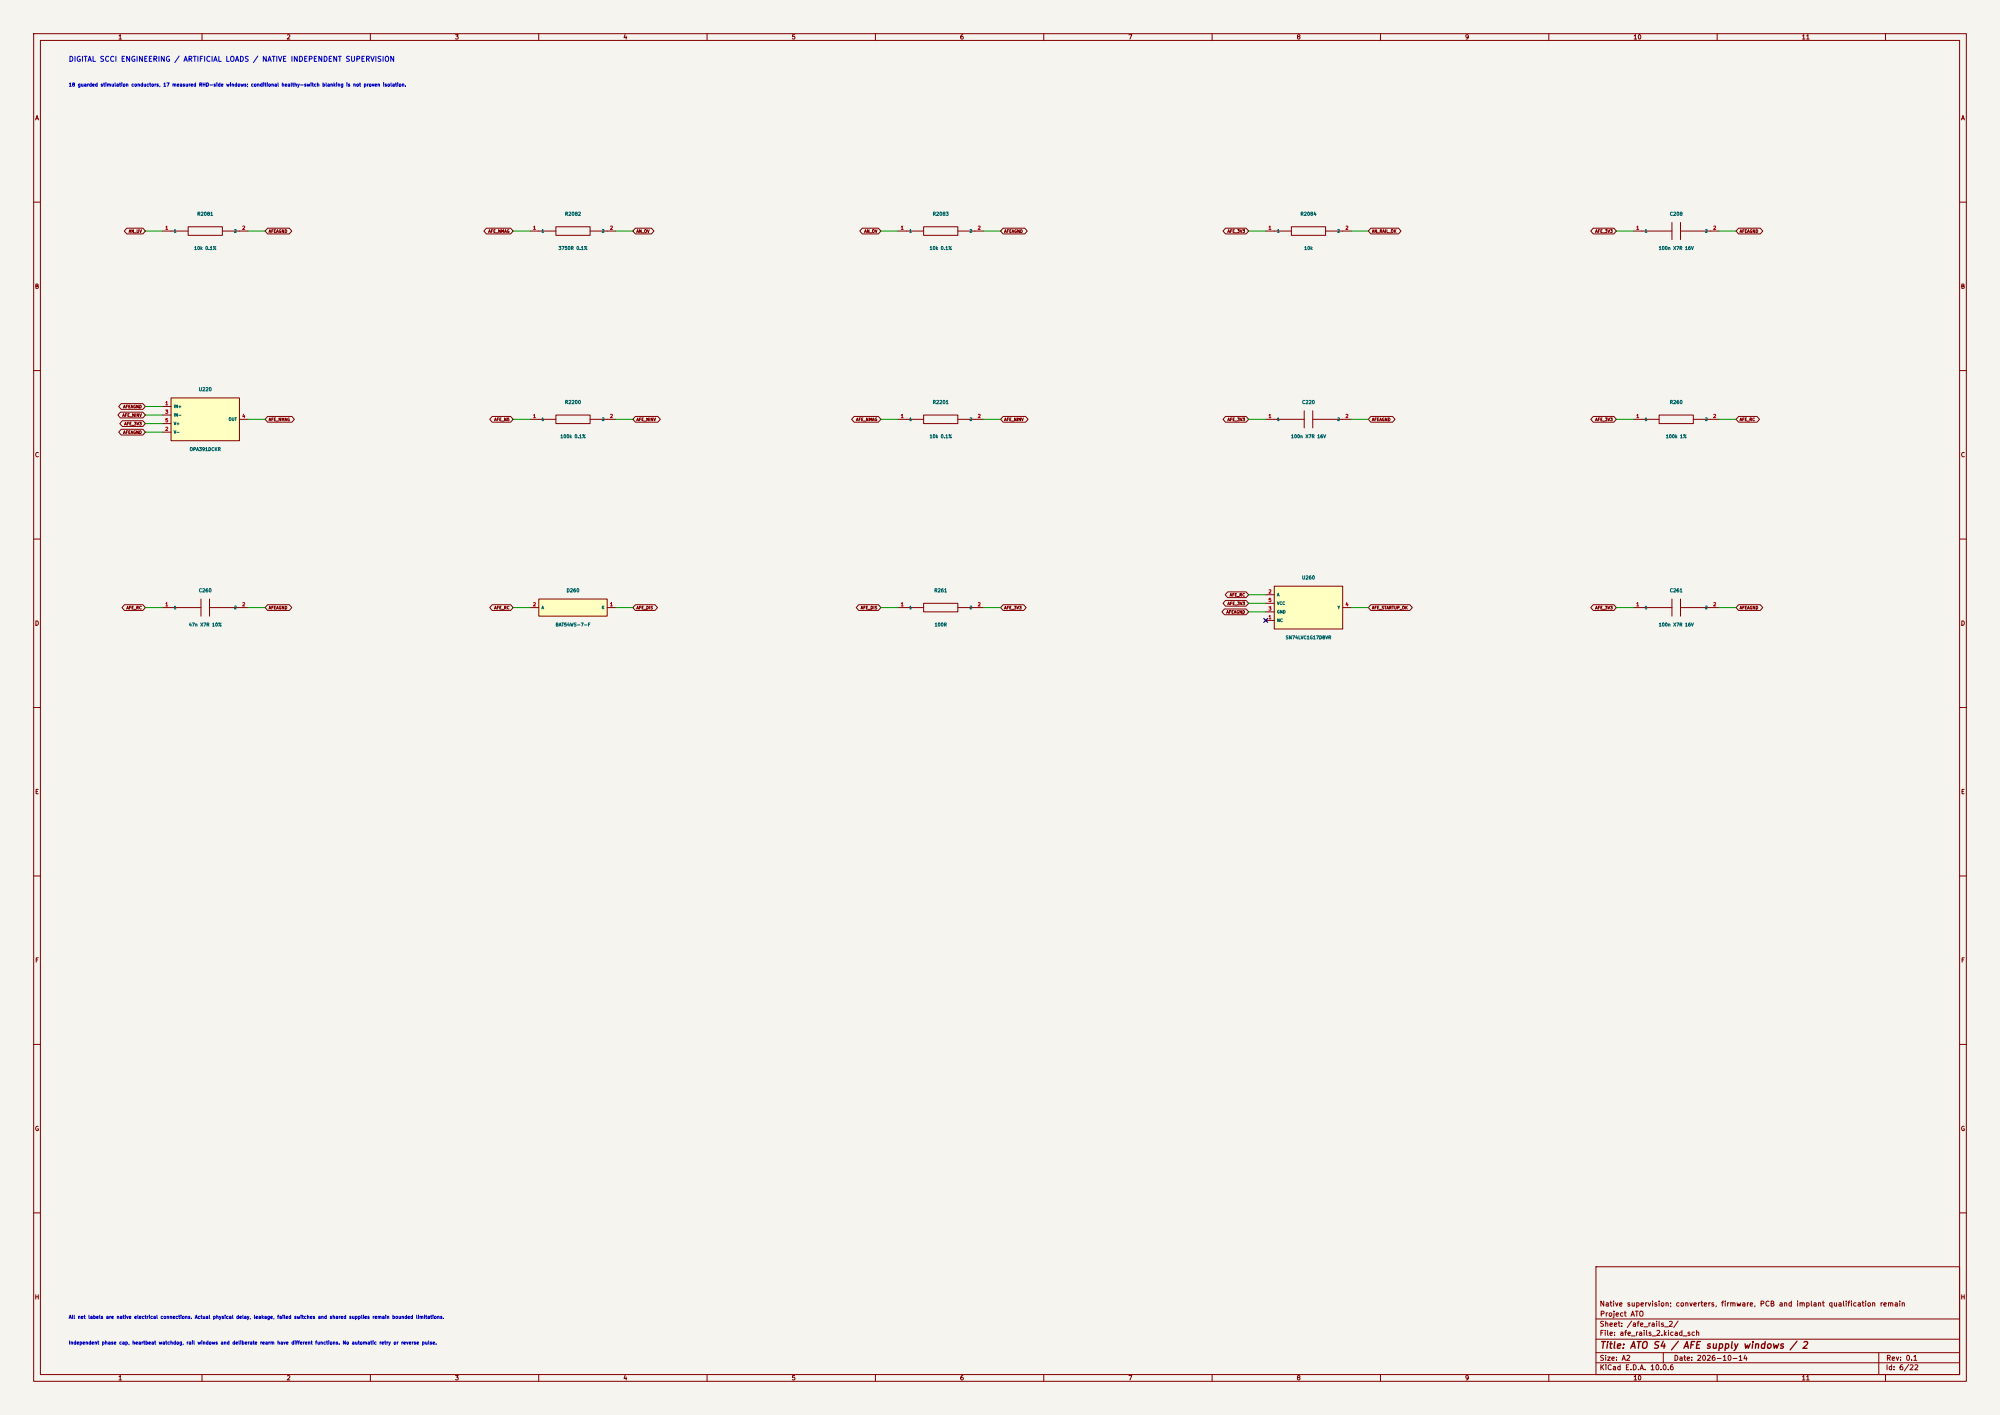
[picture p281: page 6]

Sheet: /afe_rails_2/
File: afe_rails_2.kicad_sch
Title: ATO S4 / AFE supply windows / 2

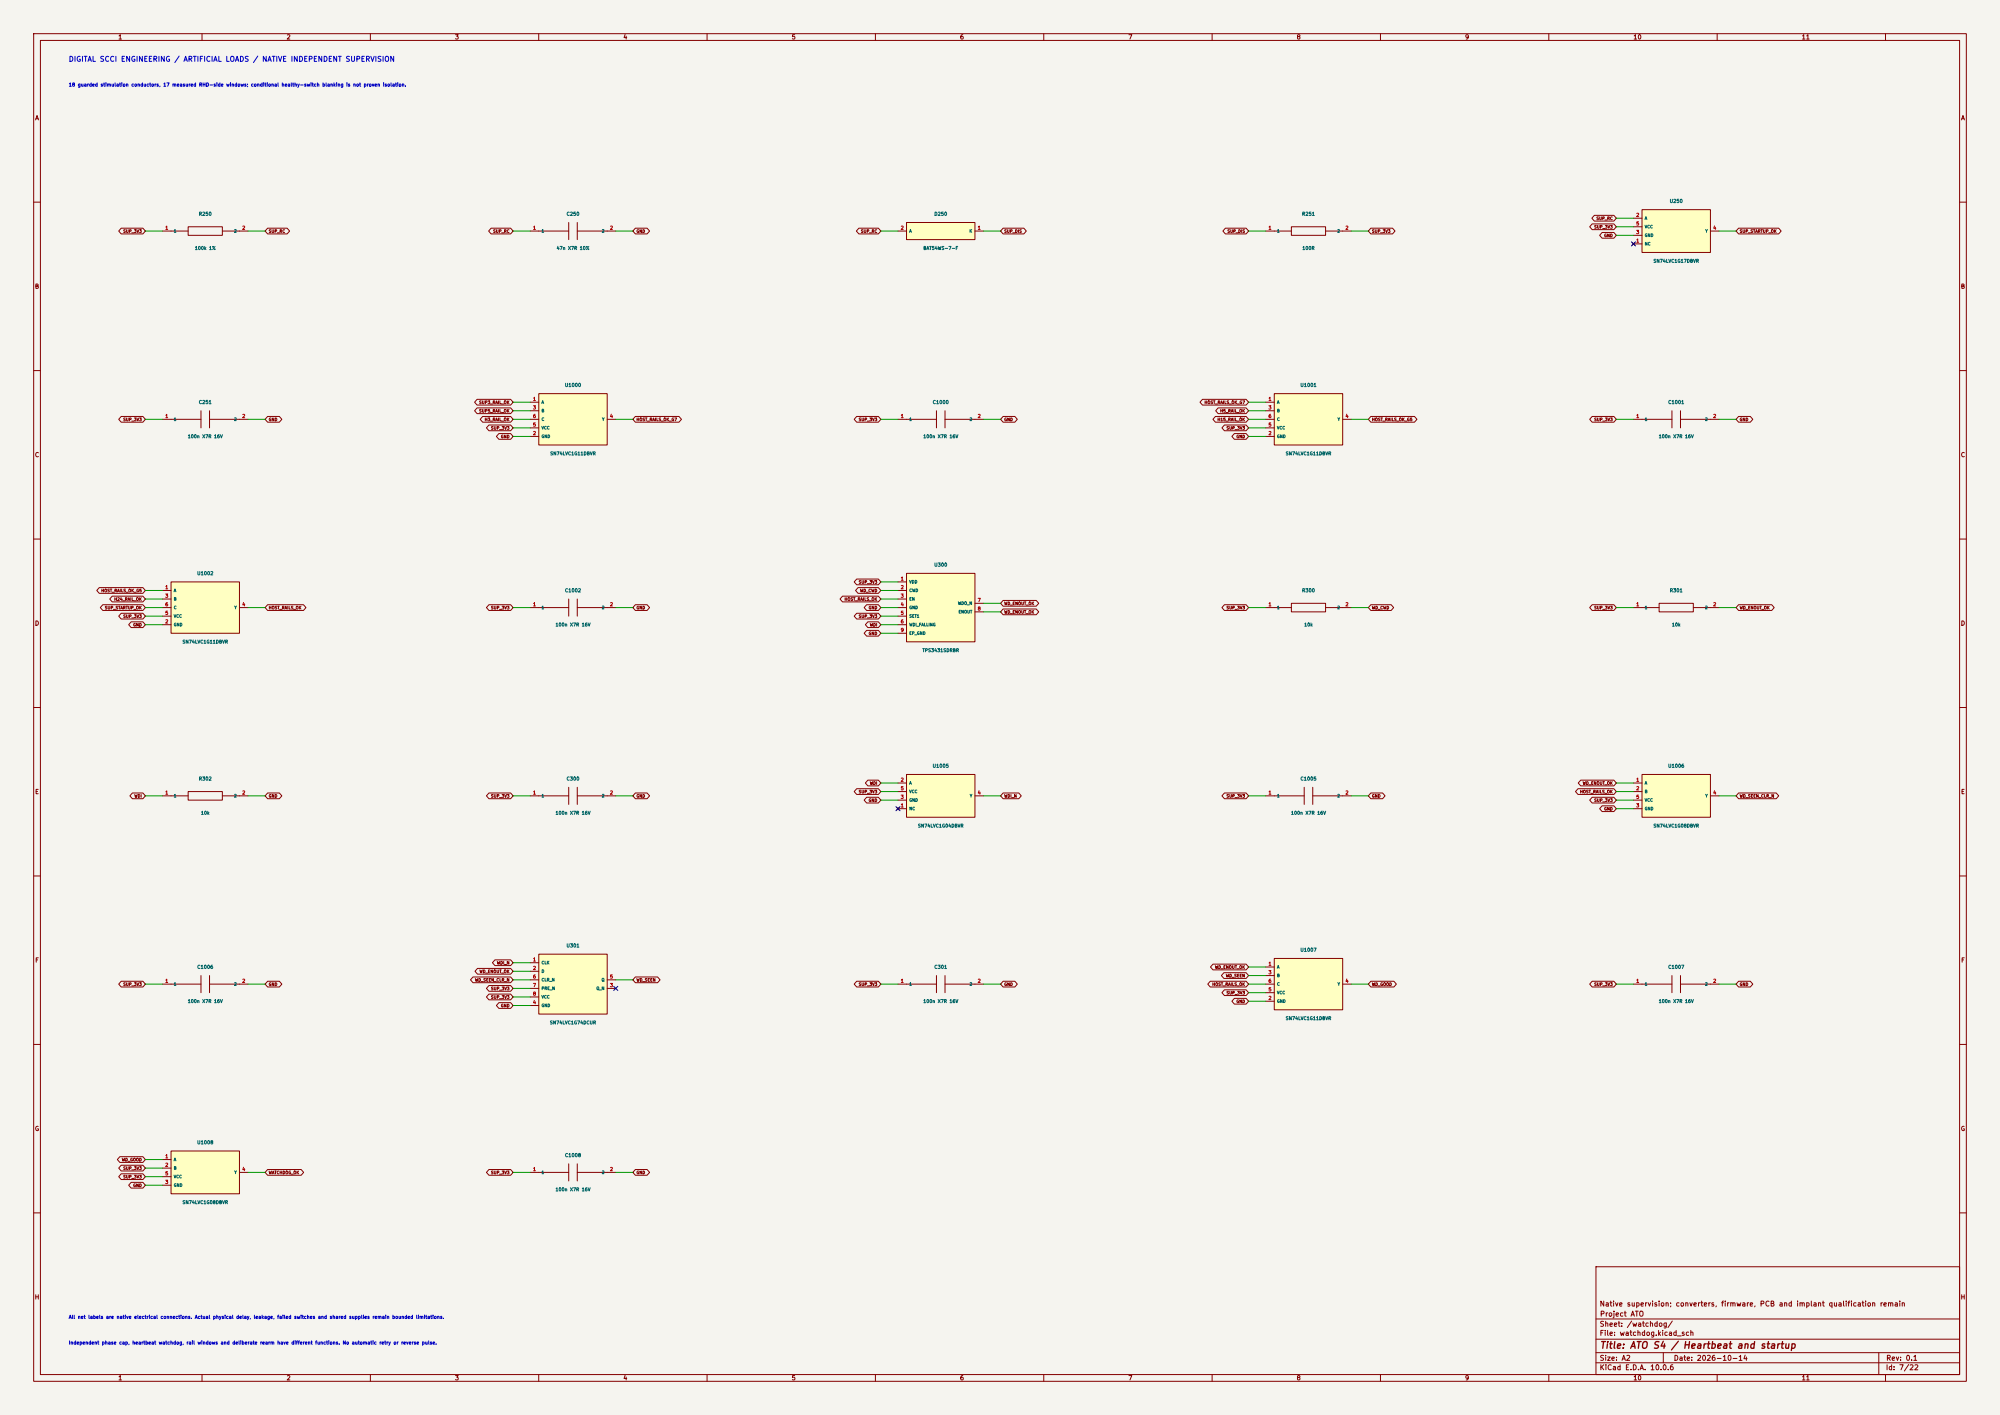
[picture p282: page 7]

Sheet: /watchdog/
File: watchdog.kicad_sch
Title: ATO S4 / Heartbeat and startup

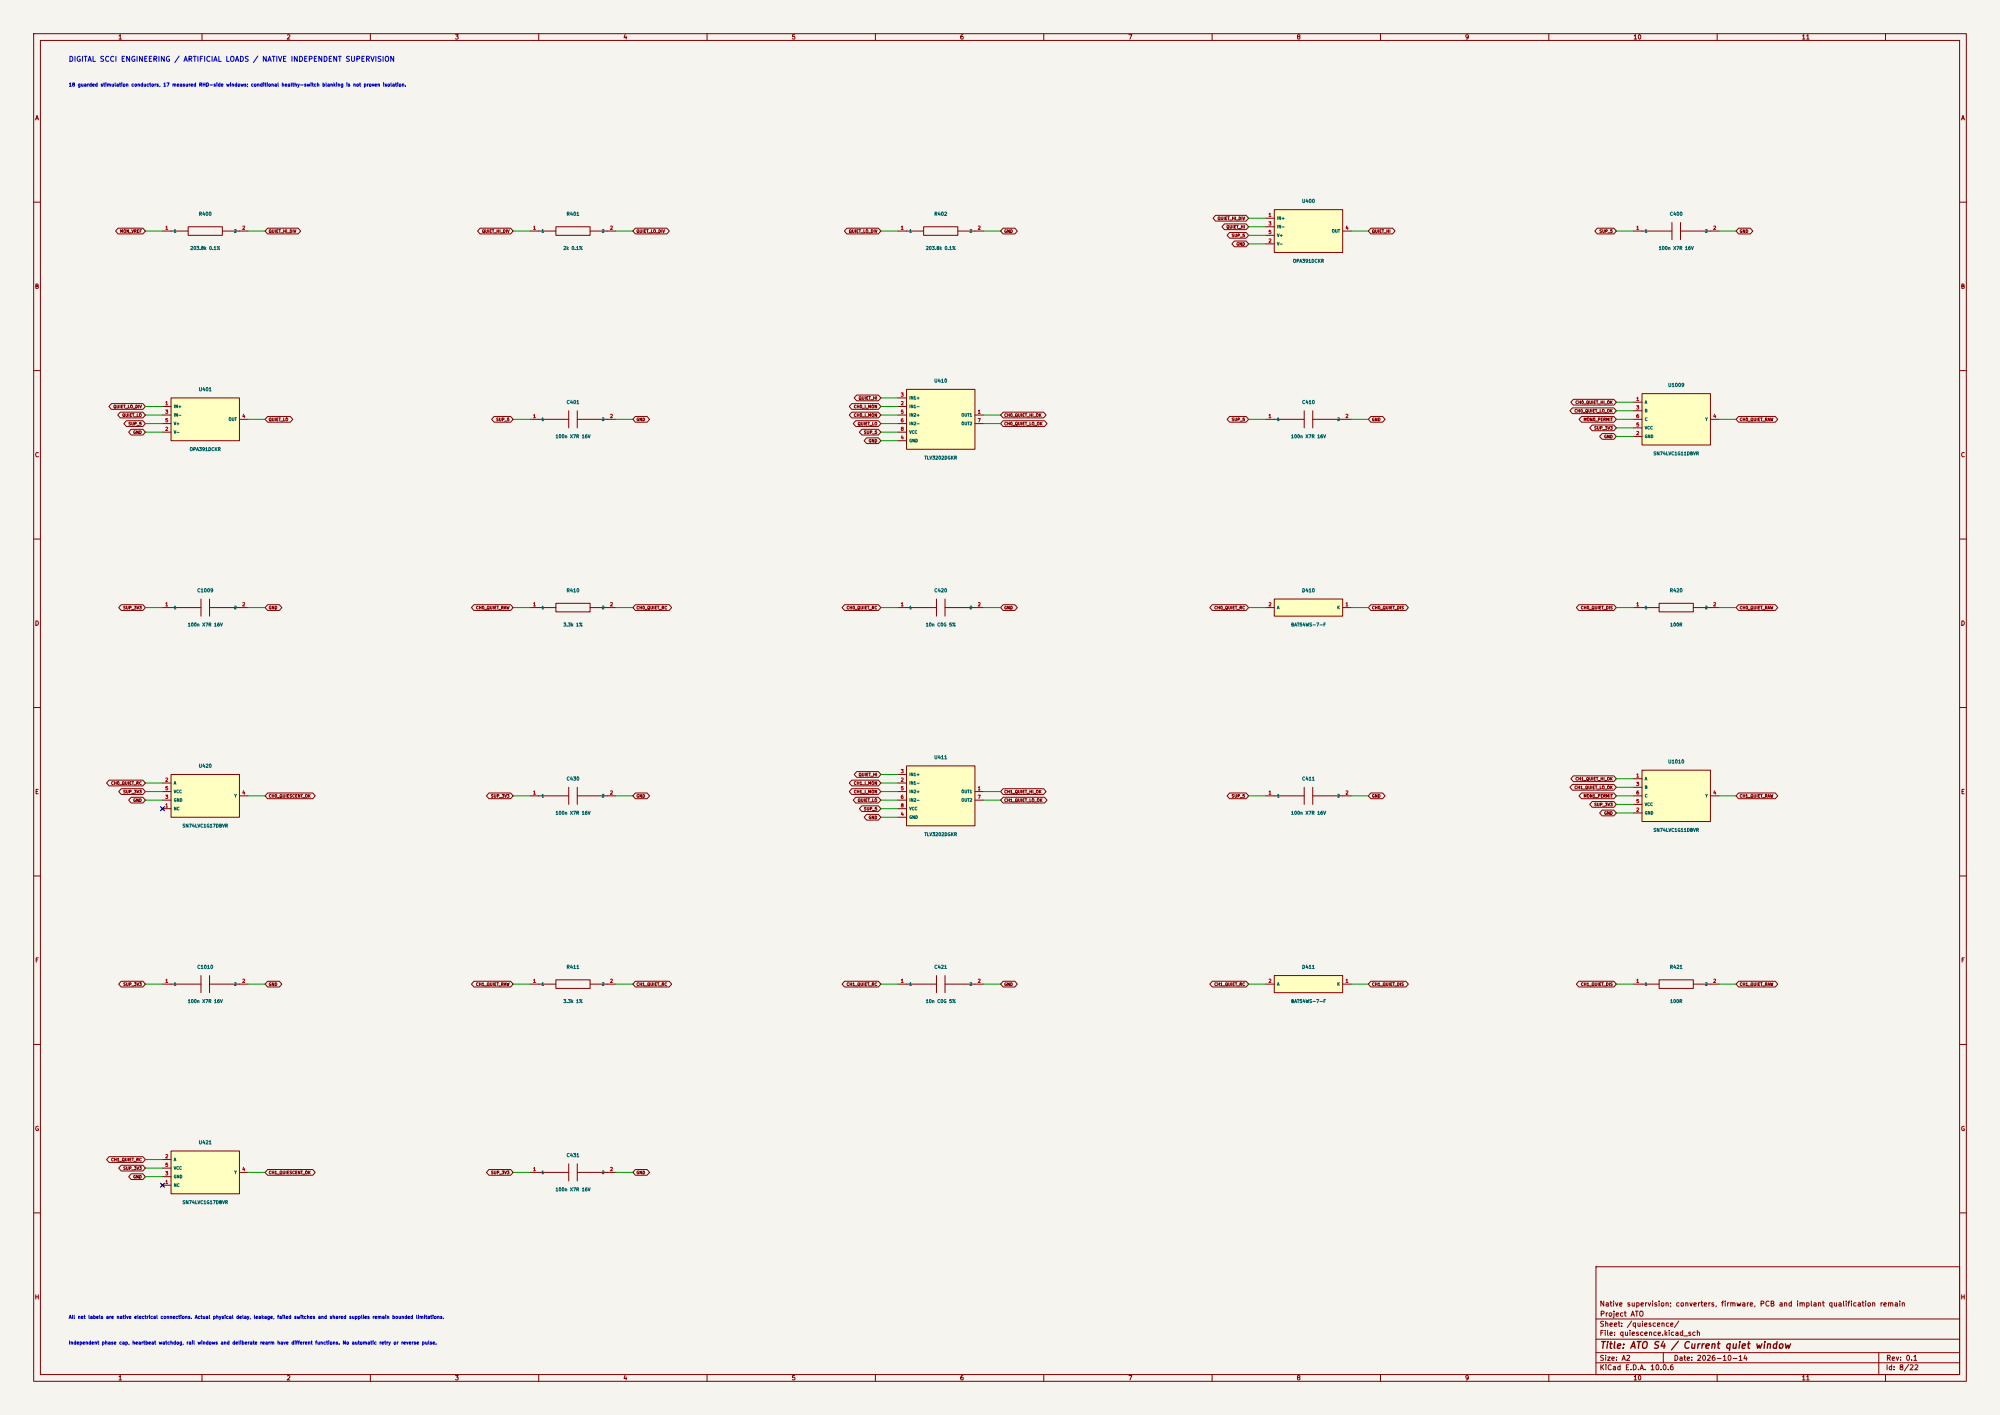
[picture p283: page 8]
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

Sheet: /quiescence/
File: quiescence.kicad_sch
Title: ATO S4 / Current quiet window

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

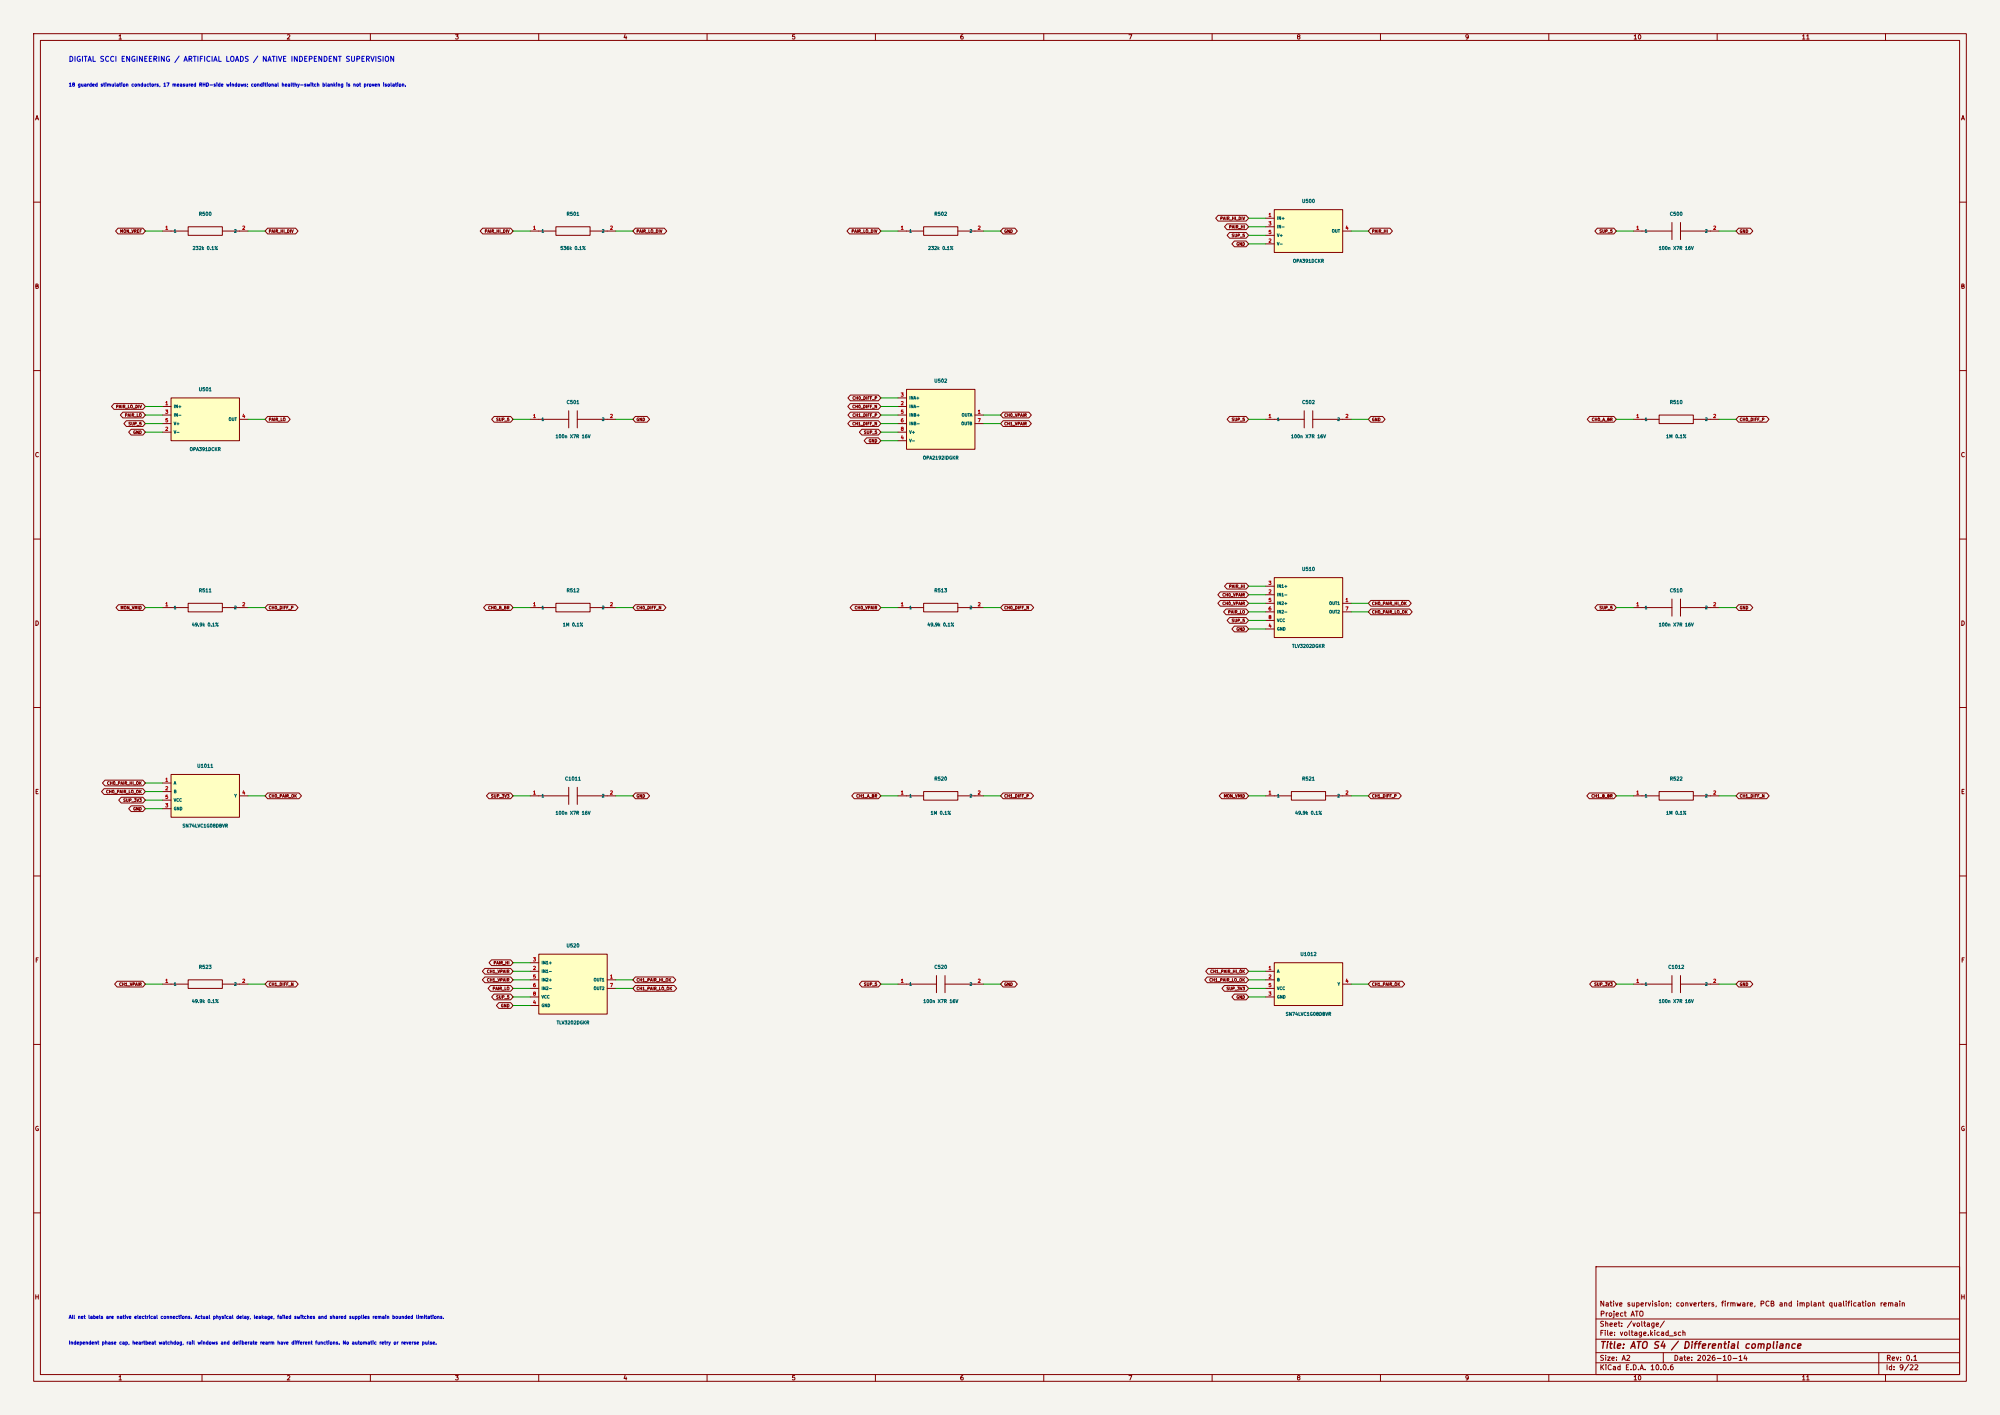
[picture p284: page 9]
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

Sheet: /voltage/
File: voltage.kicad_sch
Title: ATO S4 / Differential compliance

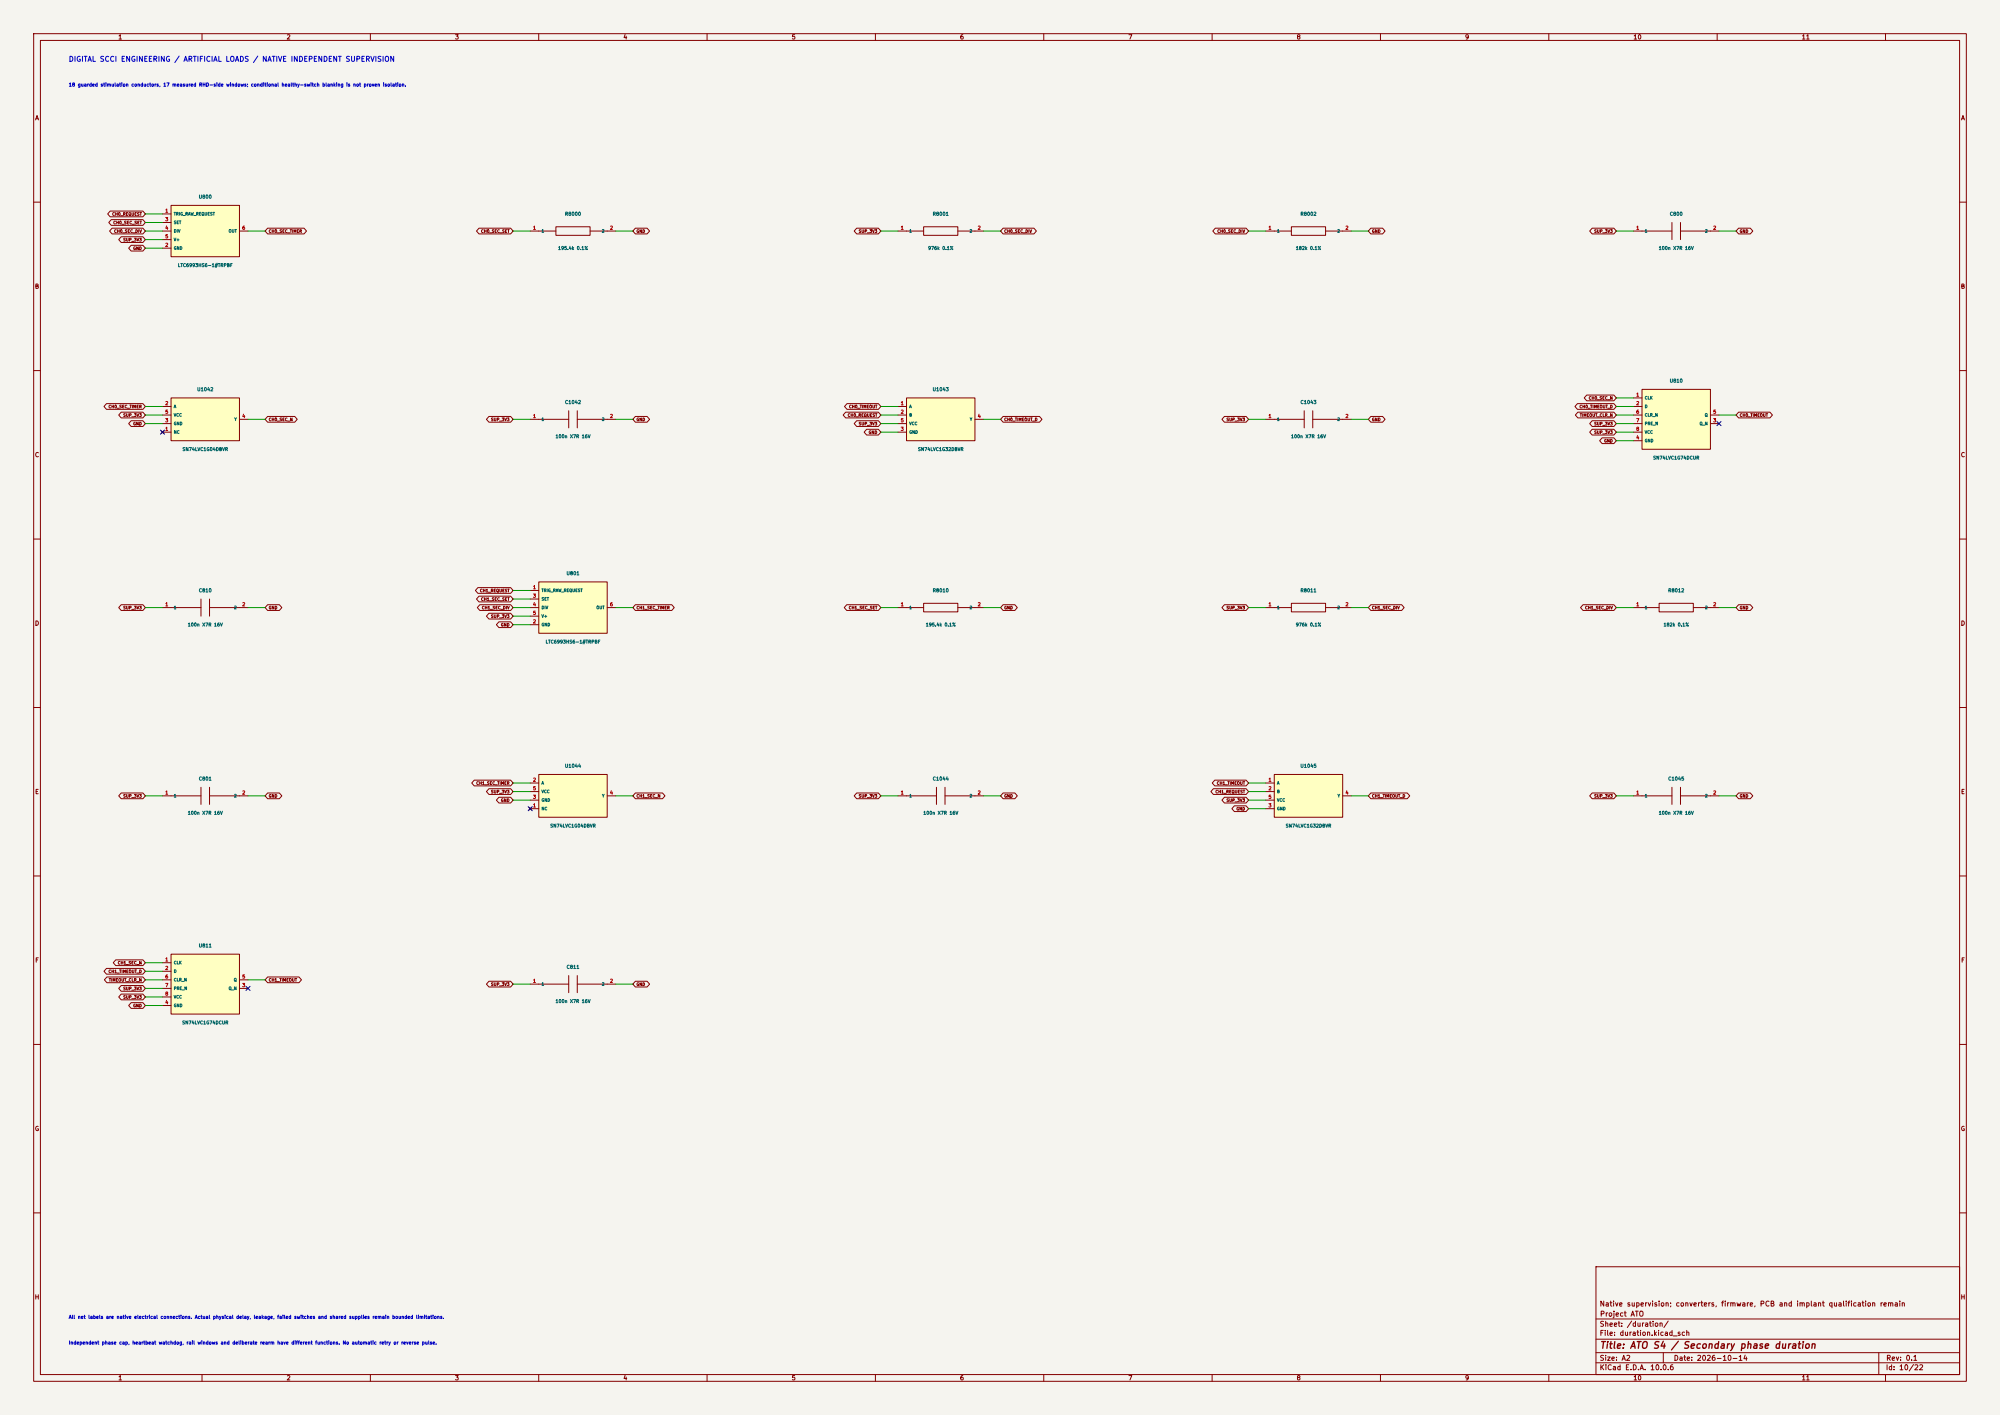
[picture p285: page 10]
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

Sheet: /duration/
File: duration.kicad_sch
Title: ATO S4 / Secondary phase duration

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

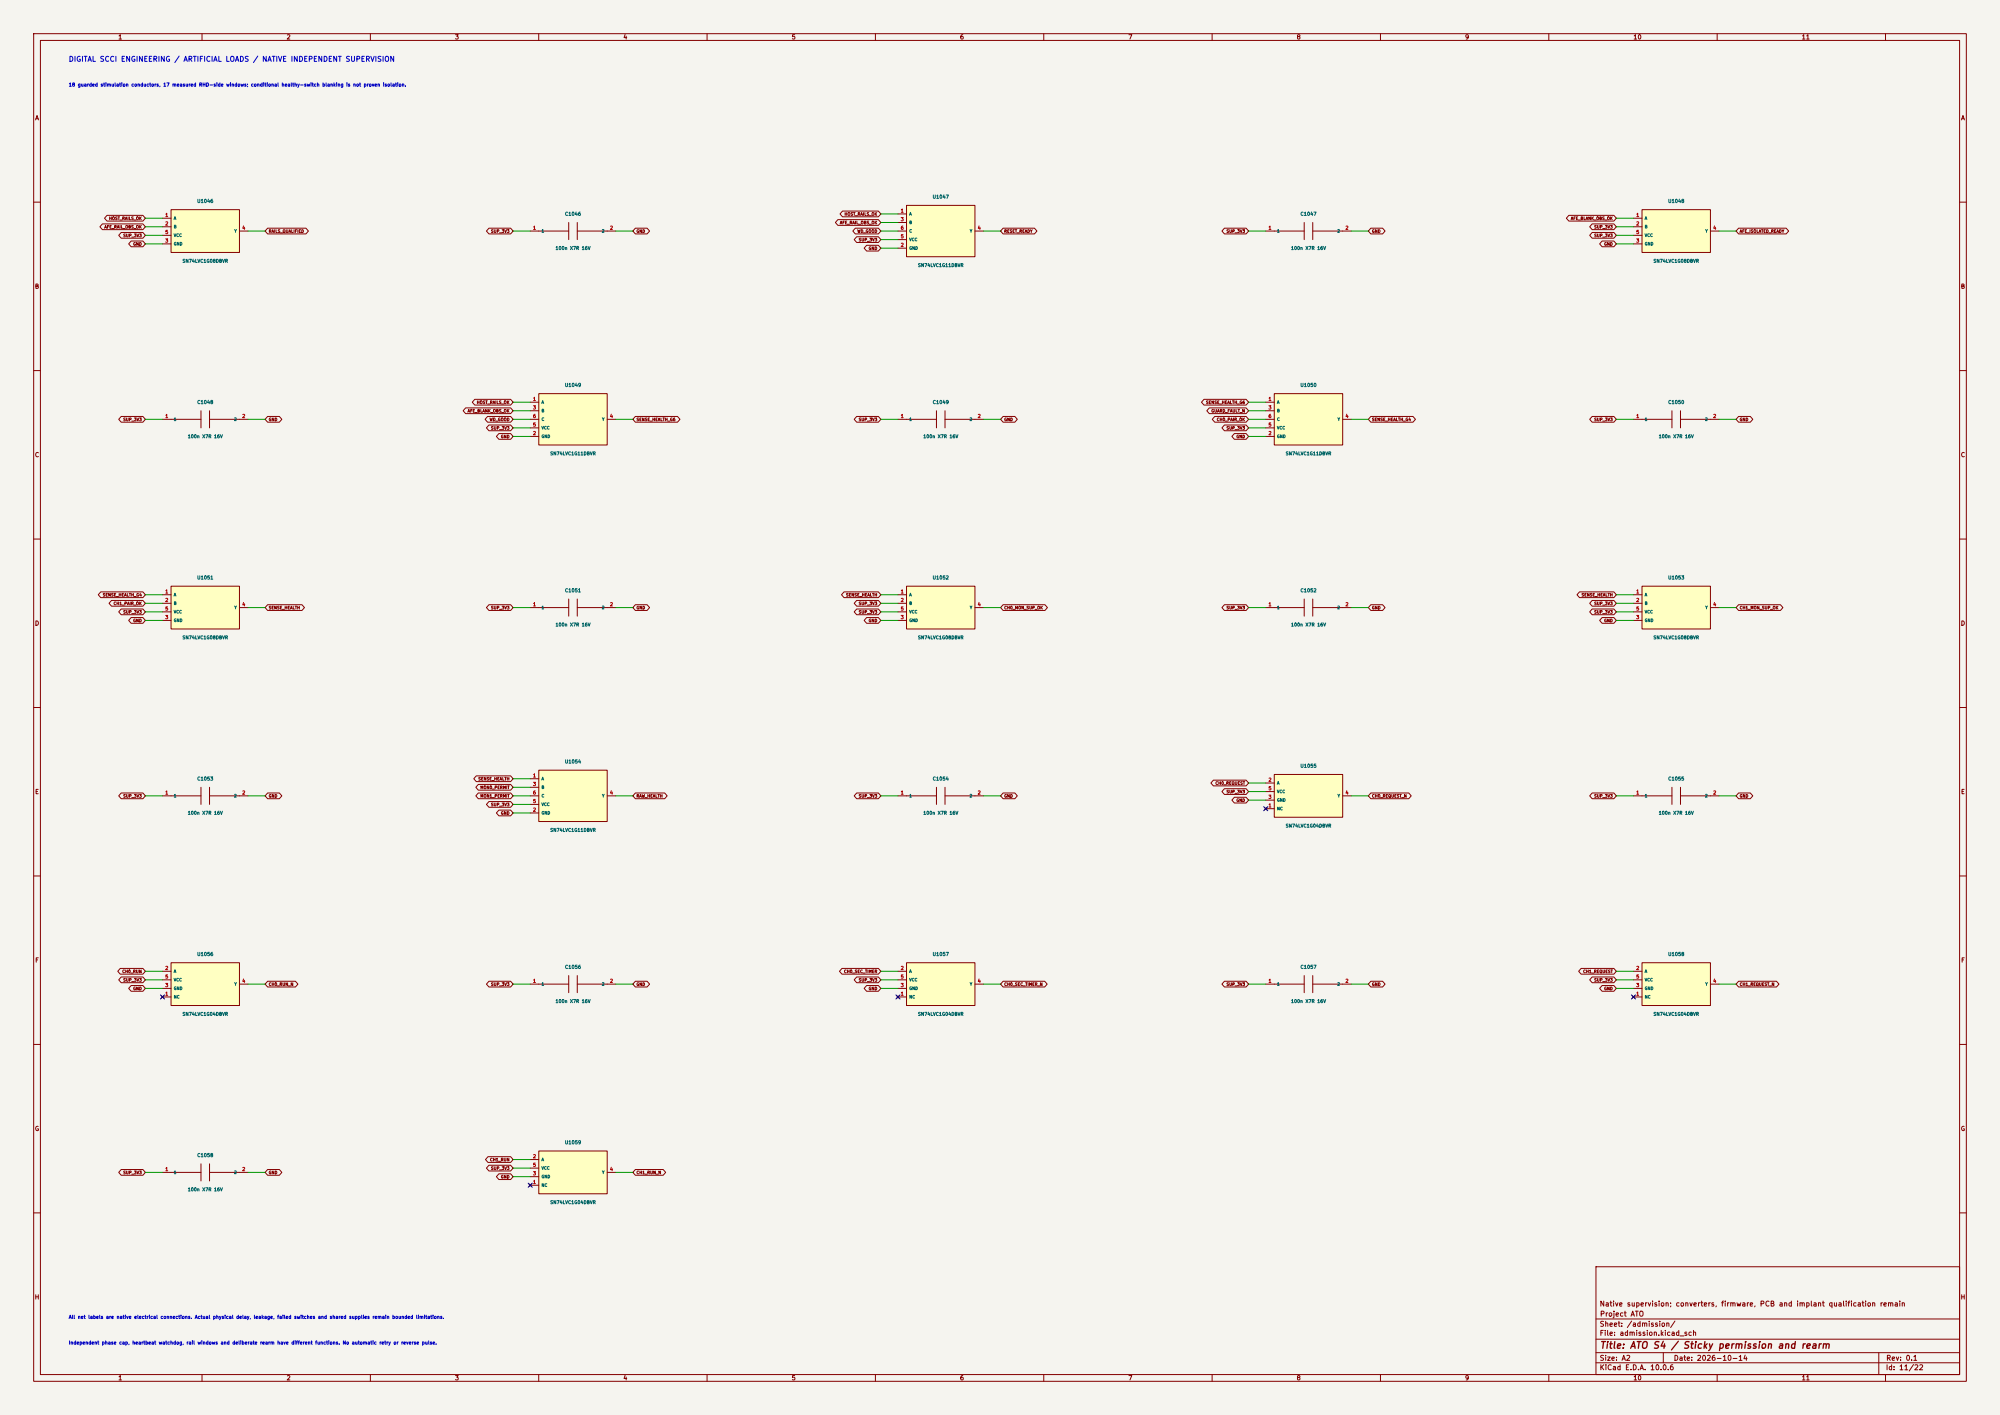
[picture p286: page 11]

Sheet: /admission/
File: admission.kicad_sch
Title: ATO S4 / Sticky permission and rearm

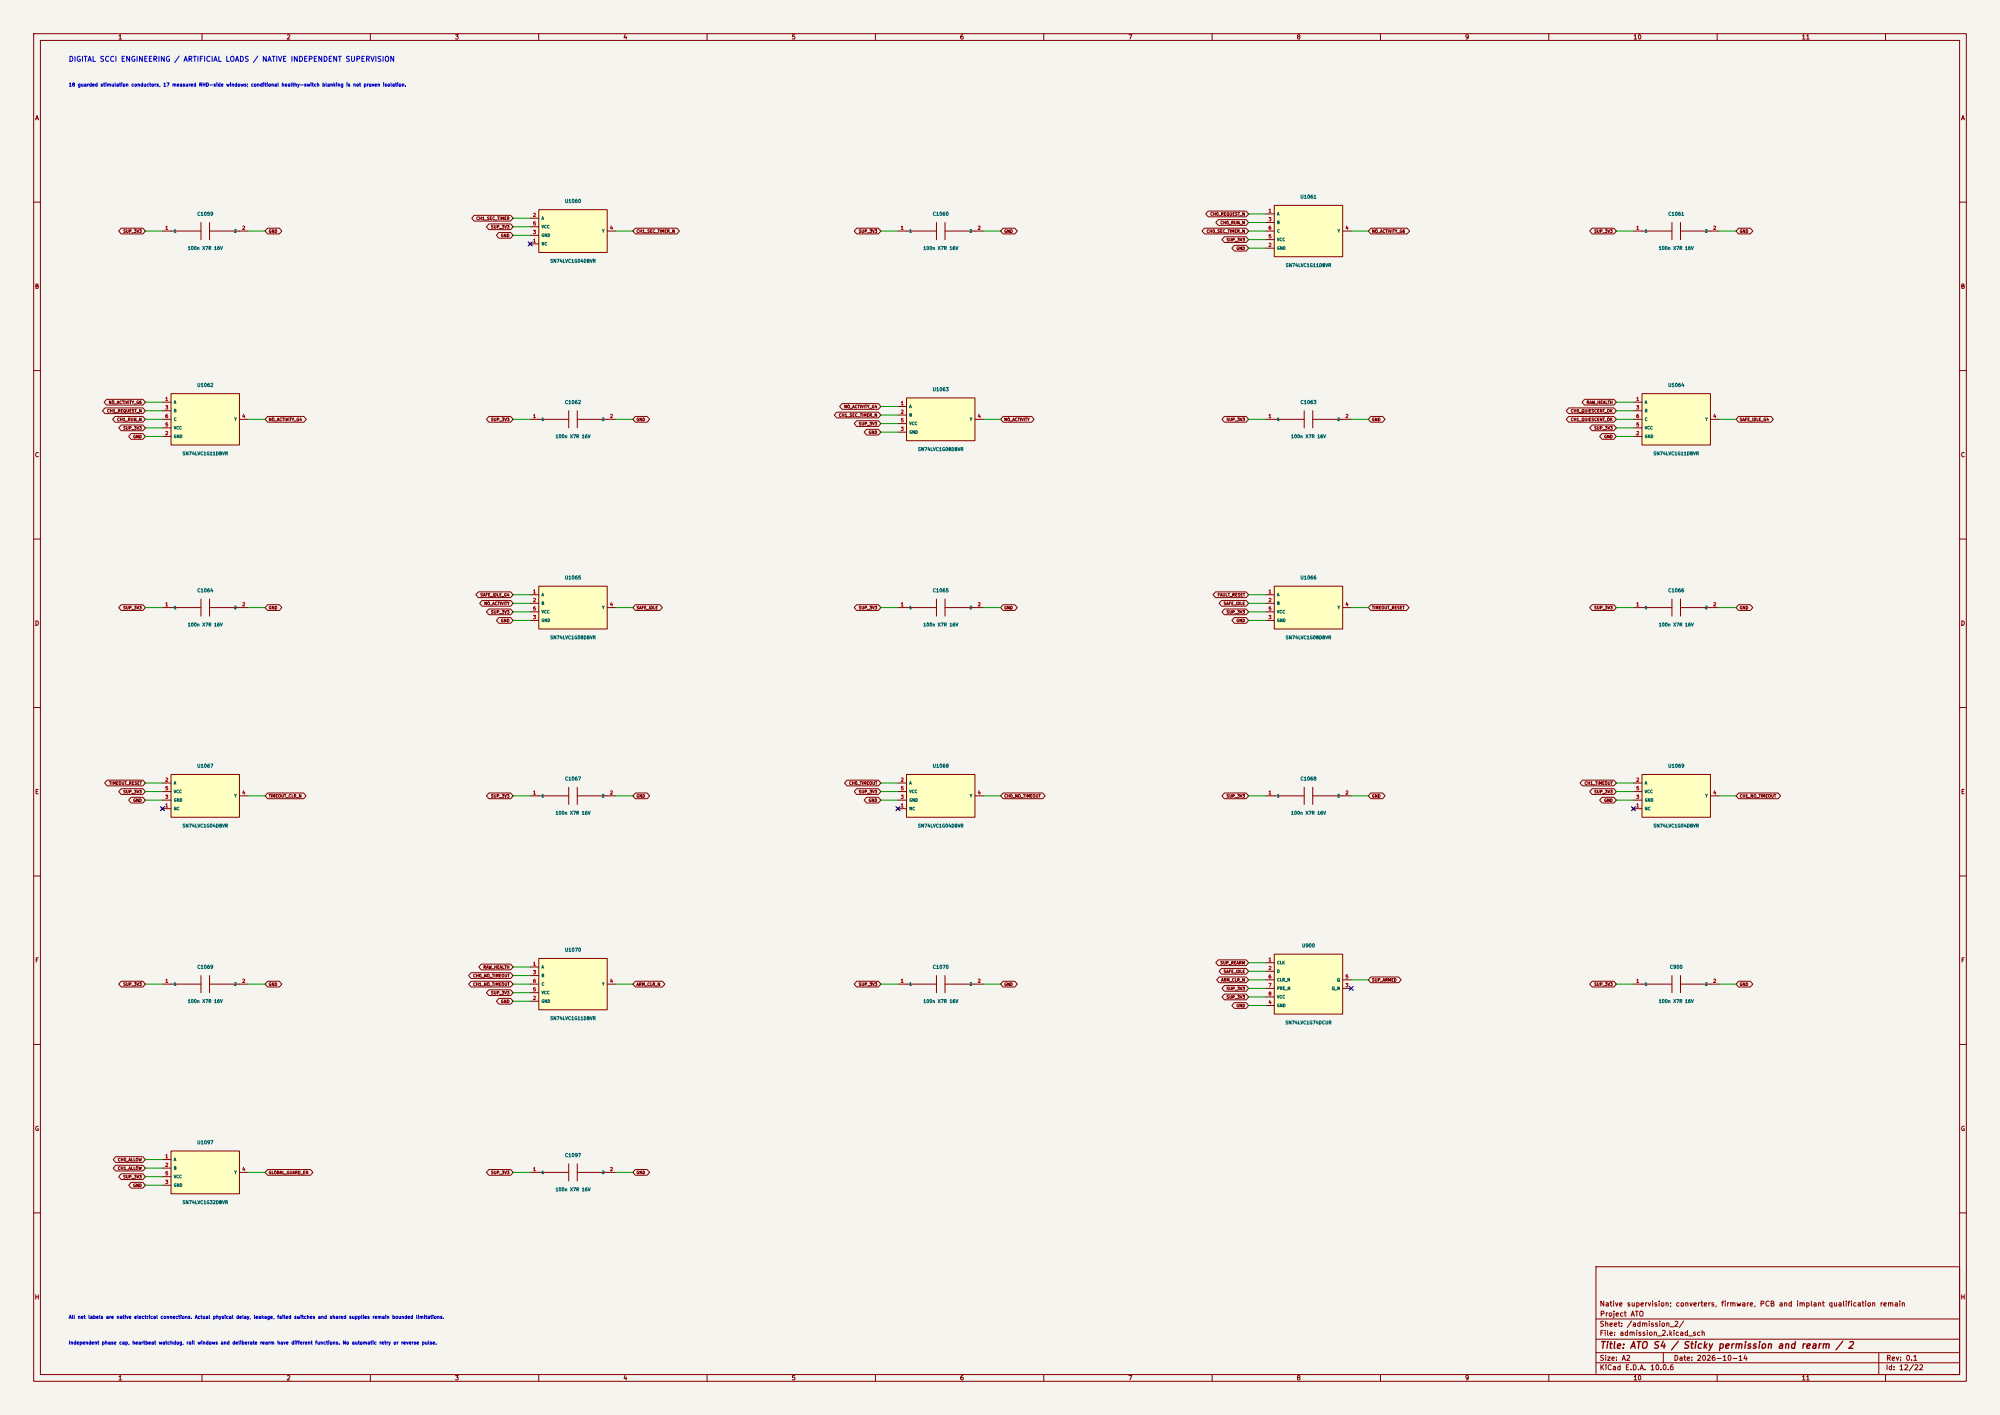
[picture p287: page 12]
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

Sheet: /admission_2/
File: admission_2.kicad_sch
Title: ATO S4 / Sticky permission and rearm / 2

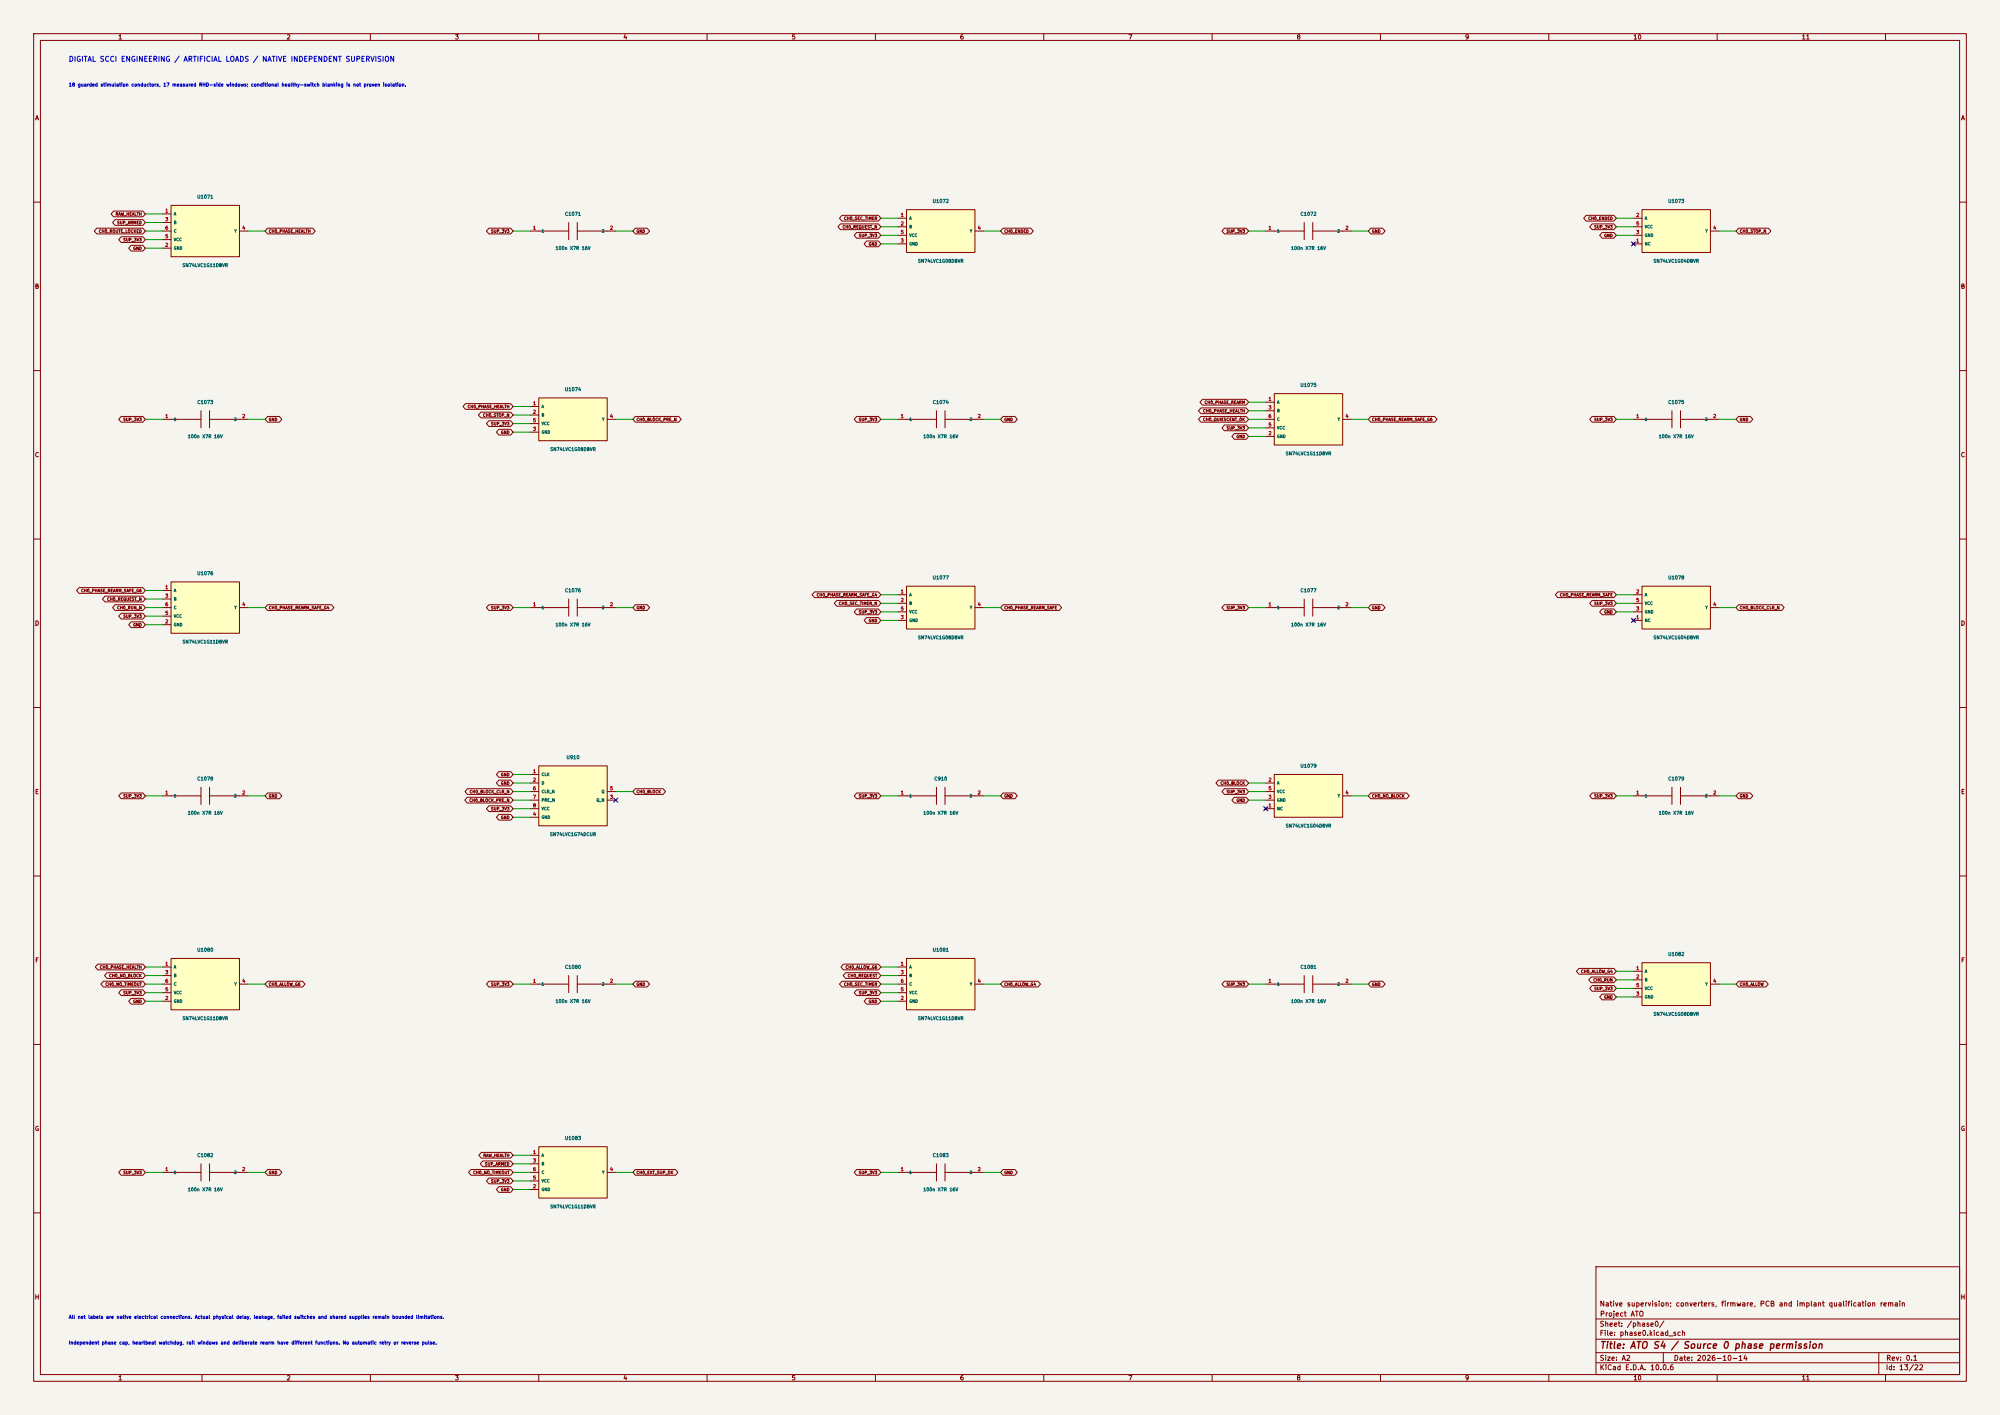
[picture p288: page 13]

Sheet: /phase0/
File: phase0.kicad_sch
Title: ATO S4 / Source 0 phase permission

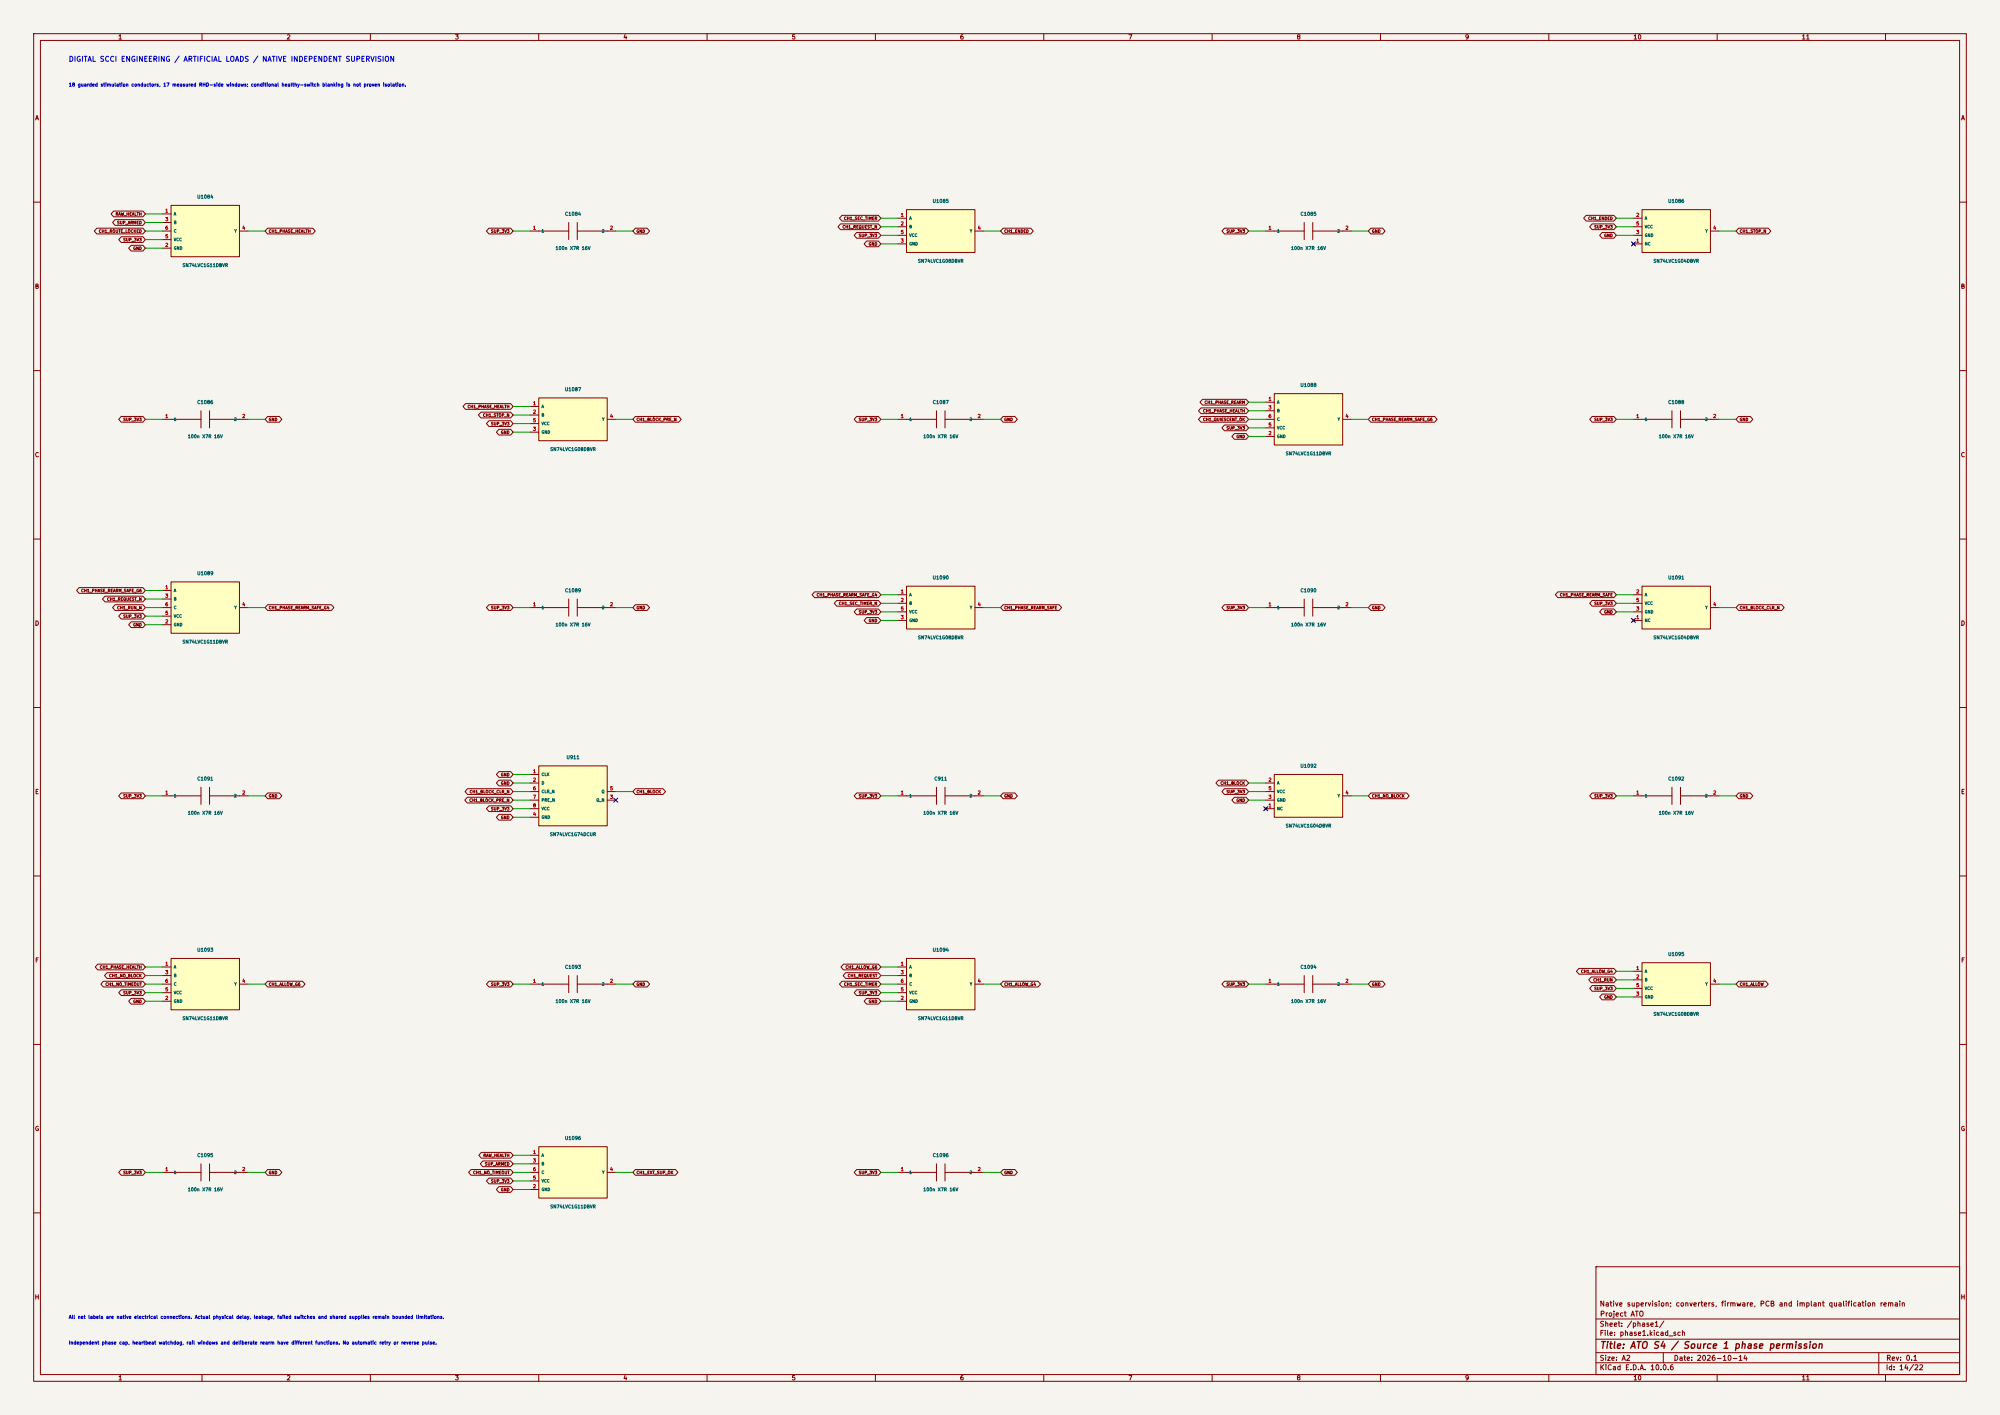
[picture p289: page 14]

Sheet: /phase1/
File: phase1.kicad_sch
Title: ATO S4 / Source 1 phase permission

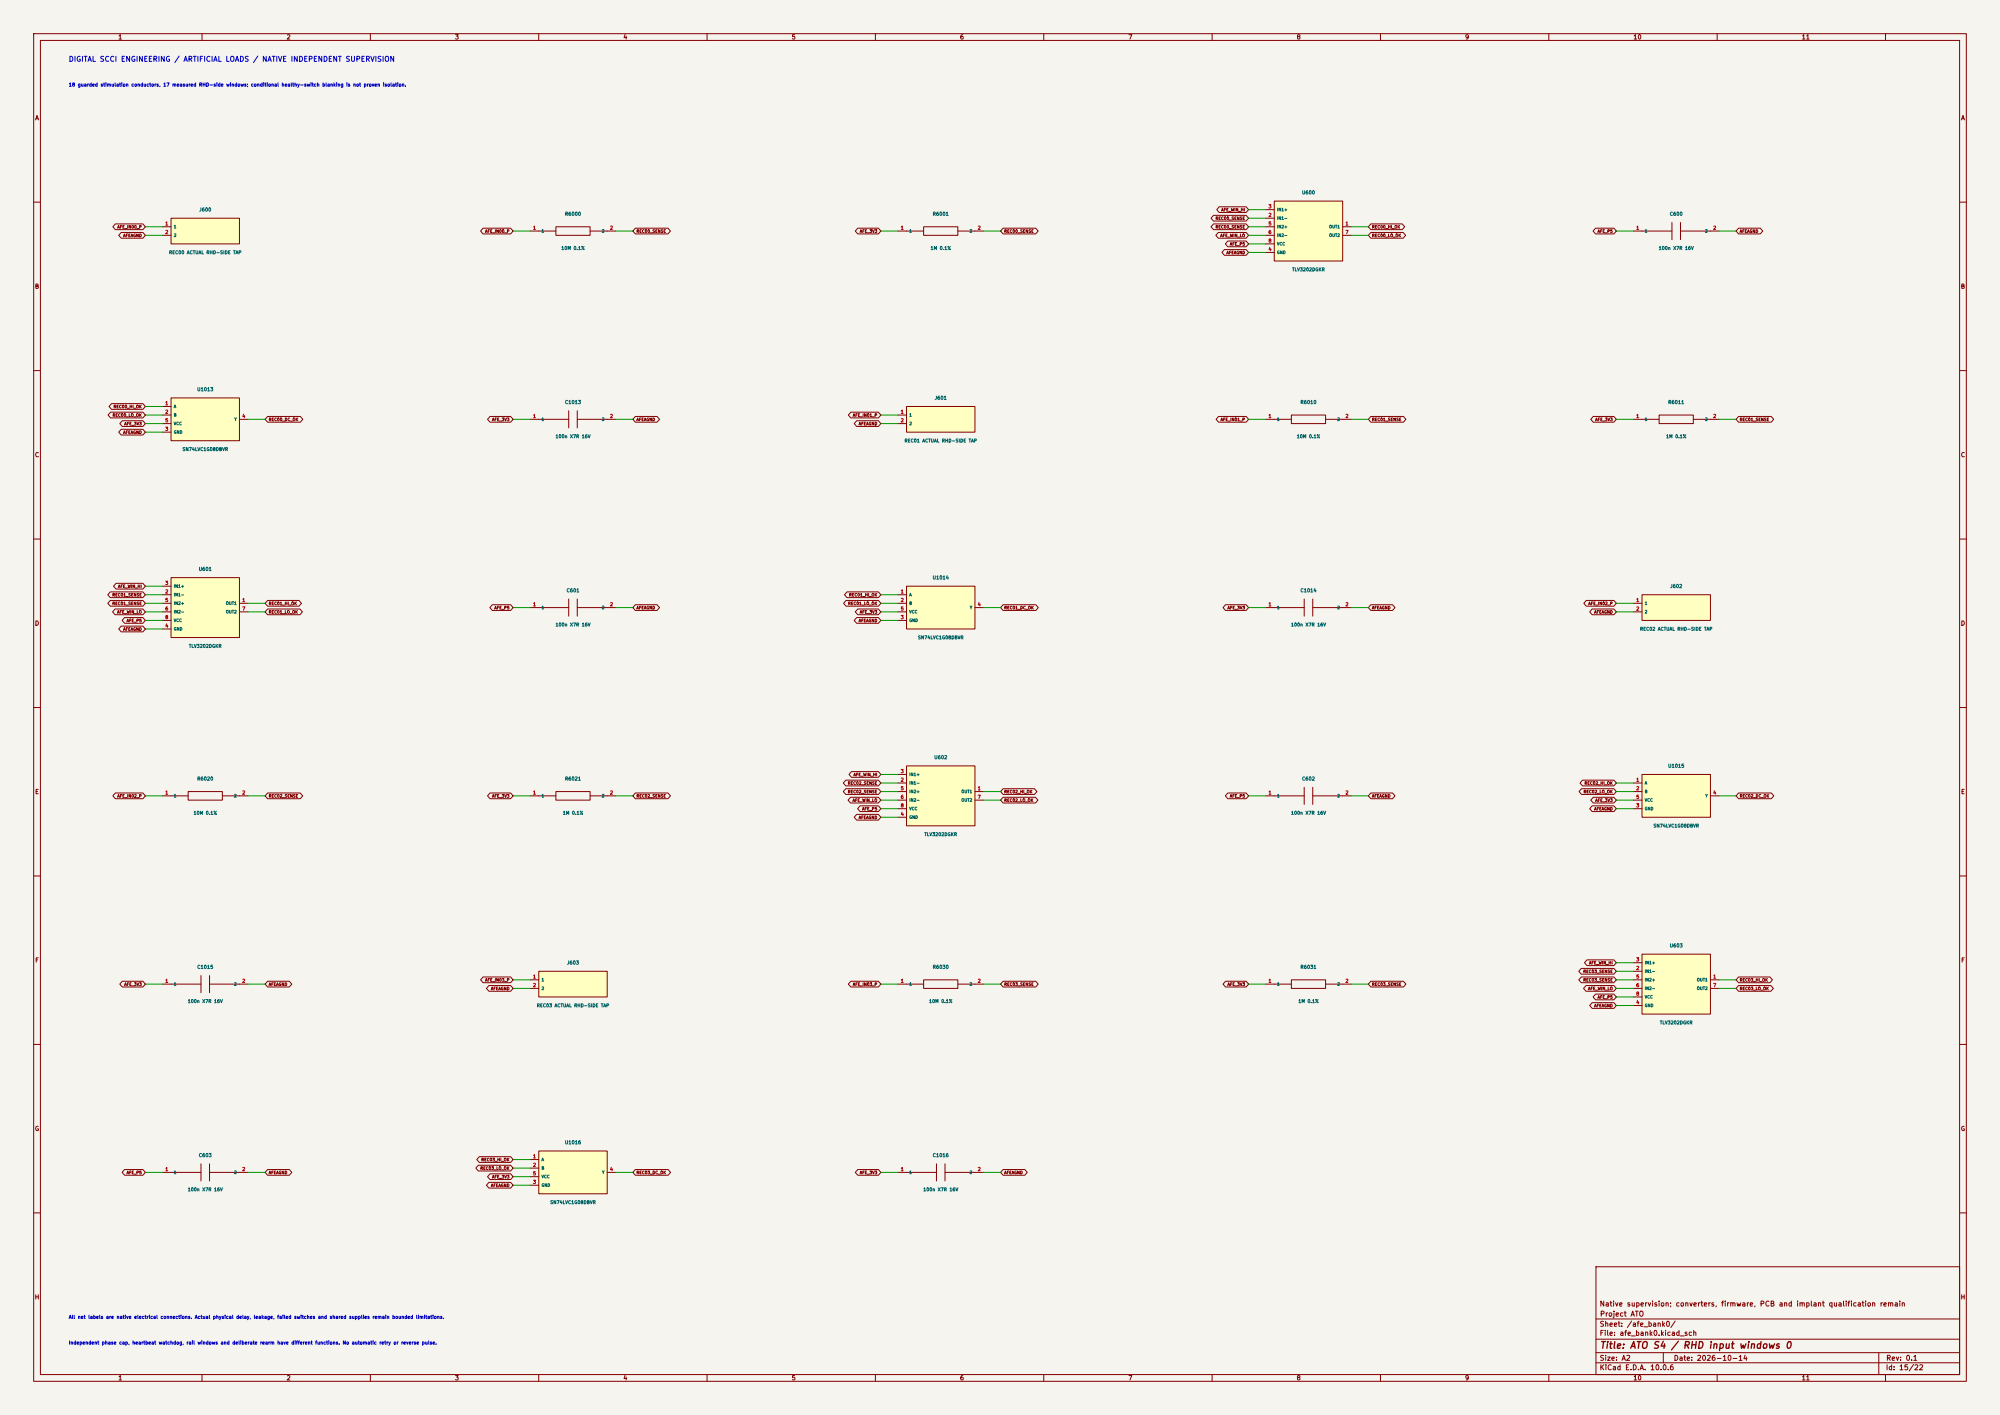
[picture p290: page 15]

REC00 ACTUAL RHD-SIDE TAP

REC01 ACTUAL RHD-SIDE TAP

REC02 ACTUAL RHD-SIDE TAP

REC03 ACTUAL RHD-SIDE TAP

Sheet: /afe_bank0/
File: afe_bank0.kicad_sch
Title: ATO S4 / RHD input windows 0

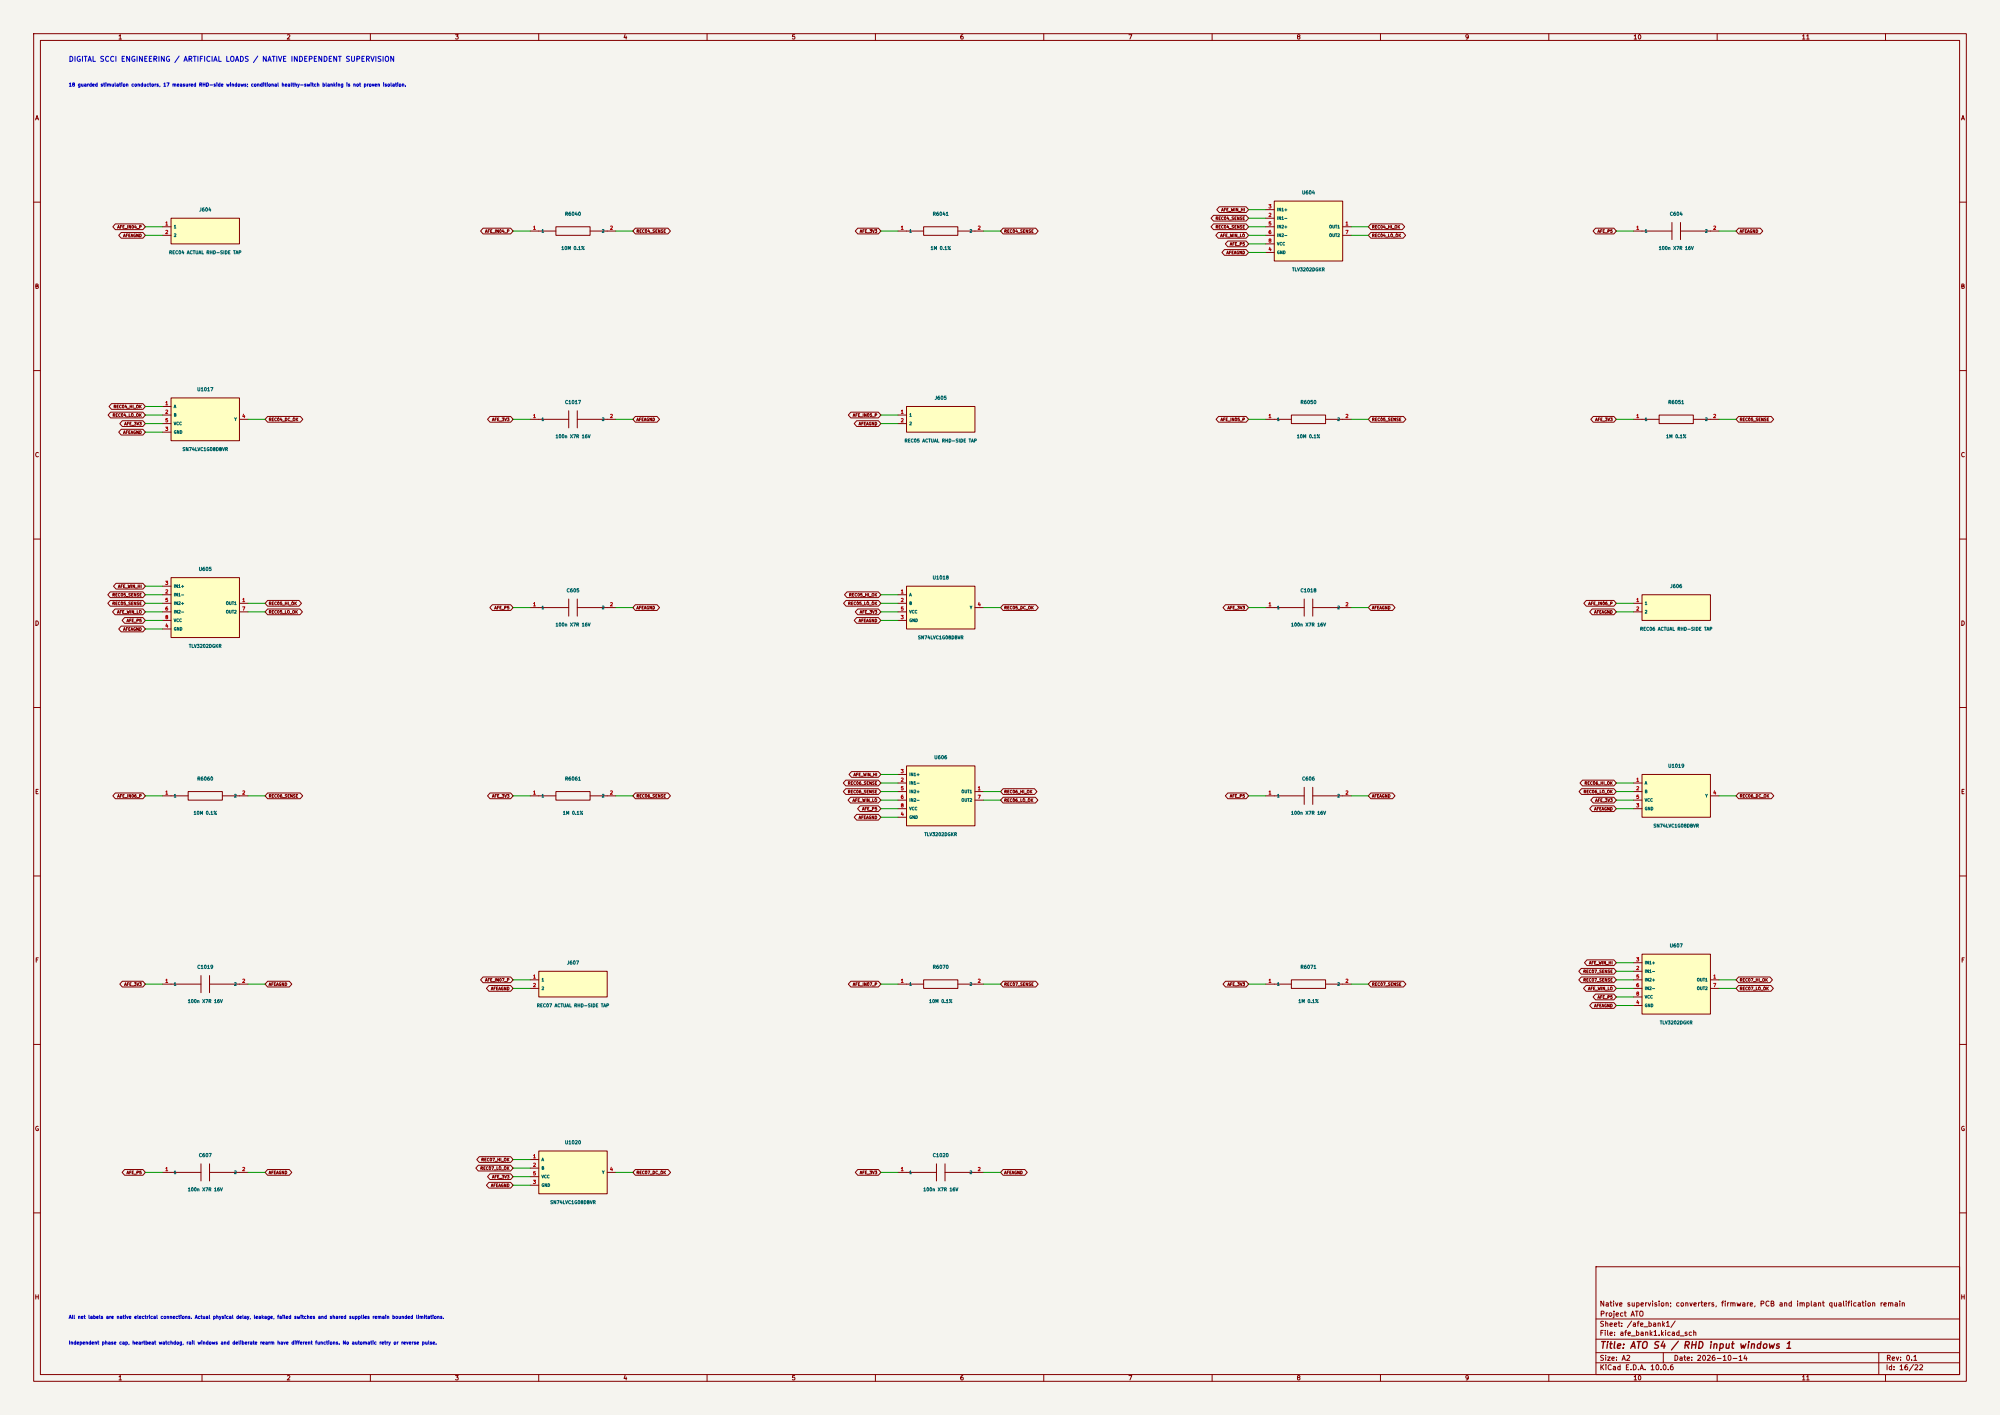
[picture p291: page 16]

REC04 ACTUAL RHD-SIDE TAP

REC05 ACTUAL RHD-SIDE TAP

REC06 ACTUAL RHD-SIDE TAP

REC07 ACTUAL RHD-SIDE TAP

Sheet: /afe_bank1/
File: afe_bank1.kicad_sch
Title: ATO S4 / RHD input windows 1

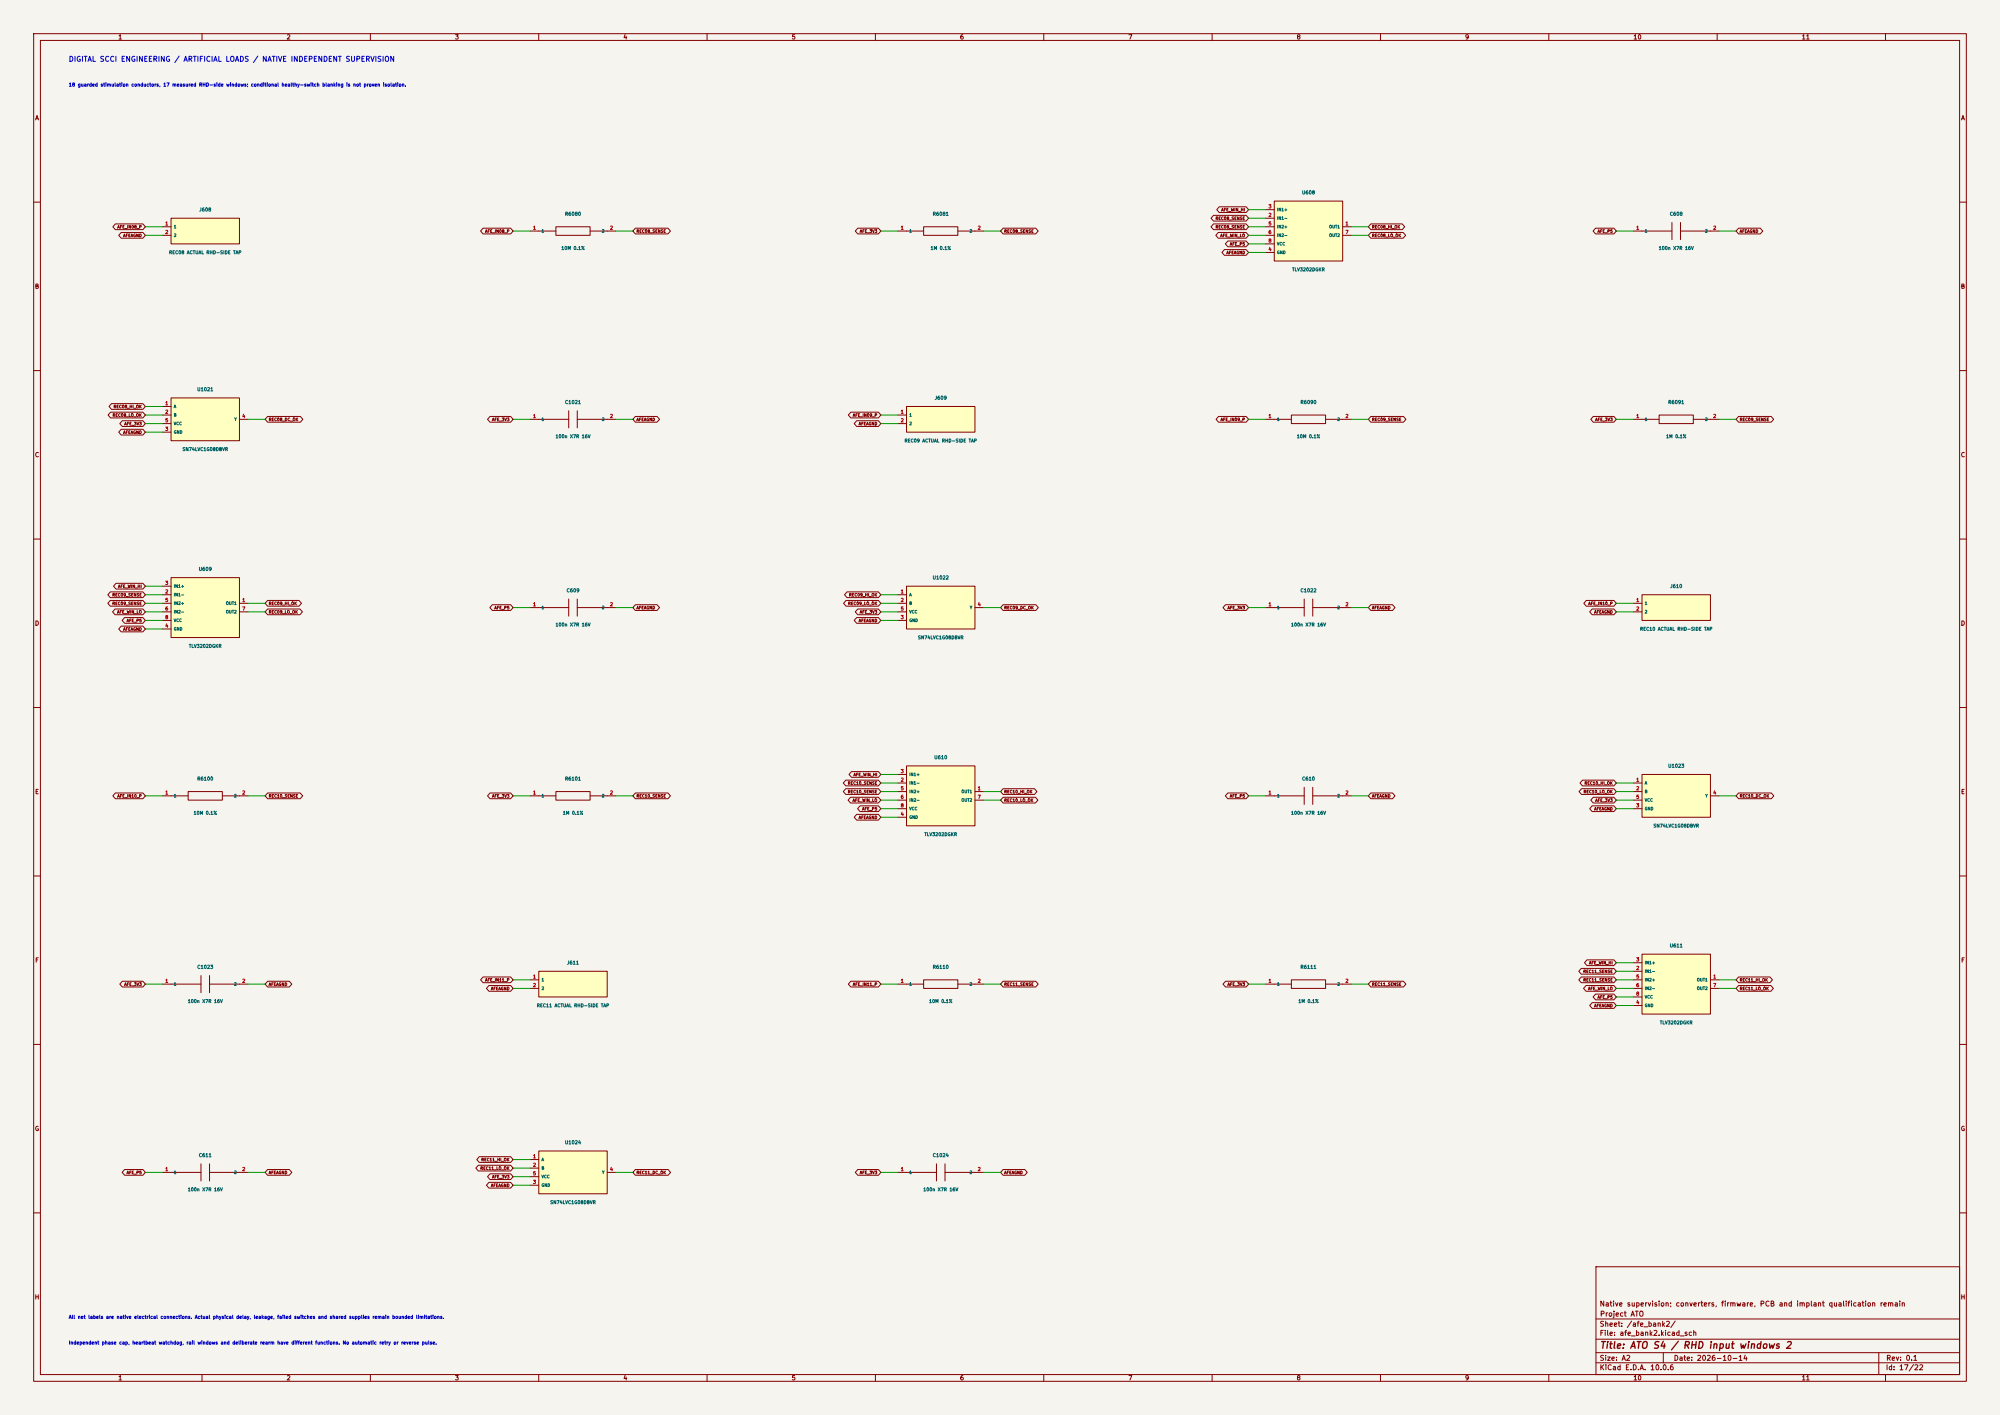
[picture p292: page 17]

REC08 ACTUAL RHD-SIDE TAP

REC09 ACTUAL RHD-SIDE TAP

REC10 ACTUAL RHD-SIDE TAP

REC11 ACTUAL RHD-SIDE TAP

Sheet: /afe_bank2/
File: afe_bank2.kicad_sch
Title: ATO S4 / RHD input windows 2

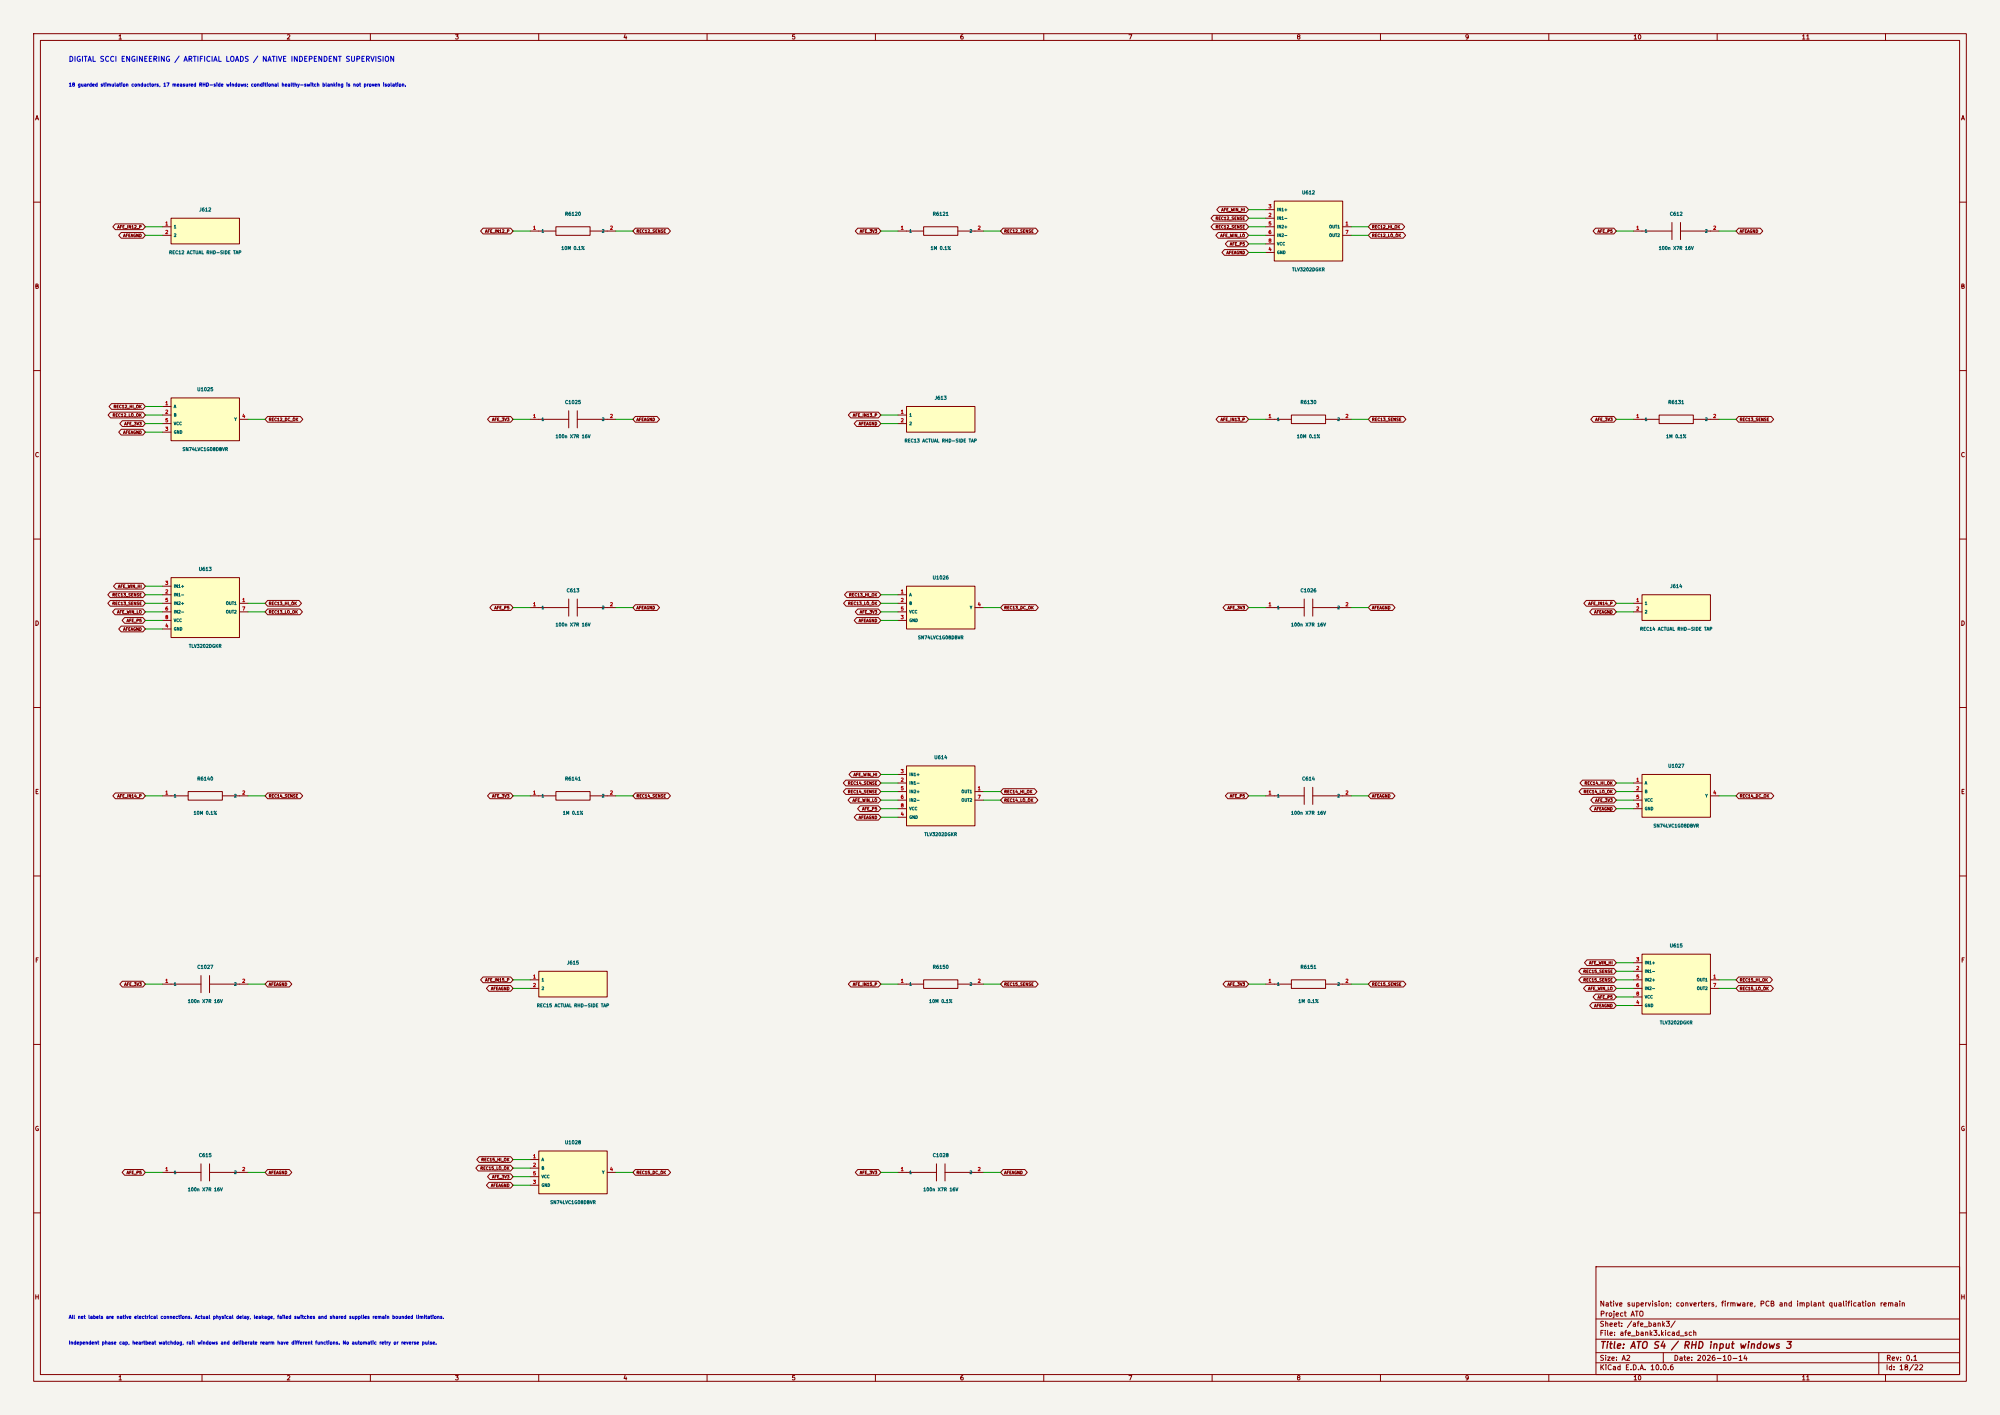
[picture p293: page 18]

REC12 ACTUAL RHD-SIDE TAP

REC13 ACTUAL RHD-SIDE TAP

REC14 ACTUAL RHD-SIDE TAP

REC15 ACTUAL RHD-SIDE TAP

Sheet: /afe_bank3/
File: afe_bank3.kicad_sch
Title: ATO S4 / RHD input windows 3

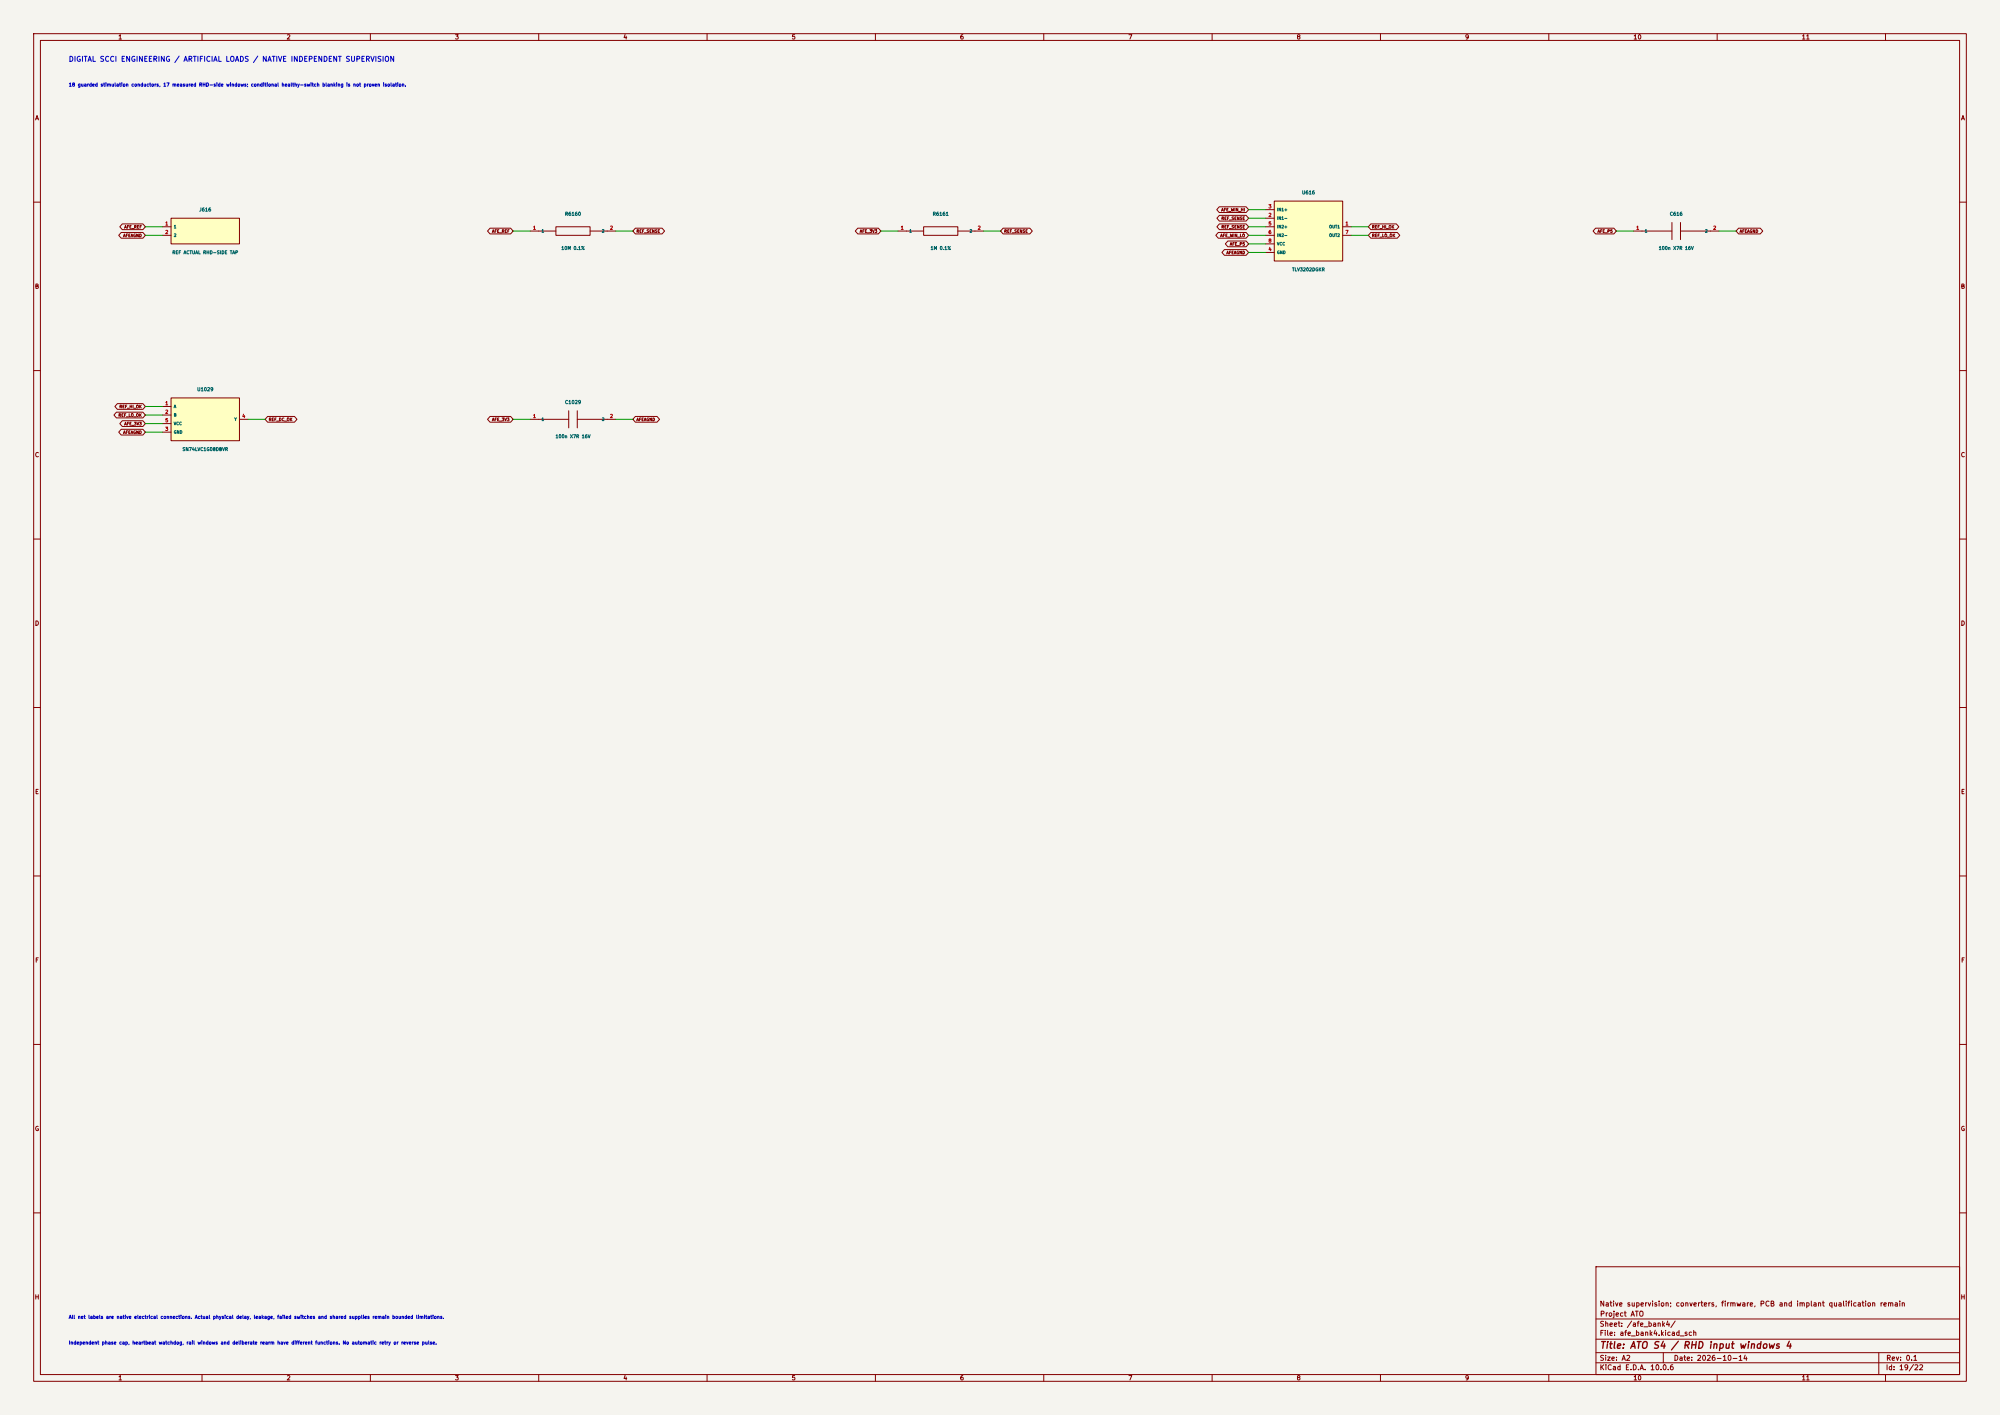
[picture p294: page 19]

AFEAGND DIGITAL SCCI ENGINEERING / ARTIFICIAL LOADS / NATIVE INDEPENDENT SUPERVISION

REF ACTUAL RHD-SIDE TAP

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

Sheet: /afe_bank4/
File: afe_bank4.kicad_sch
Title: ATO S4 / RHD input windows 4

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

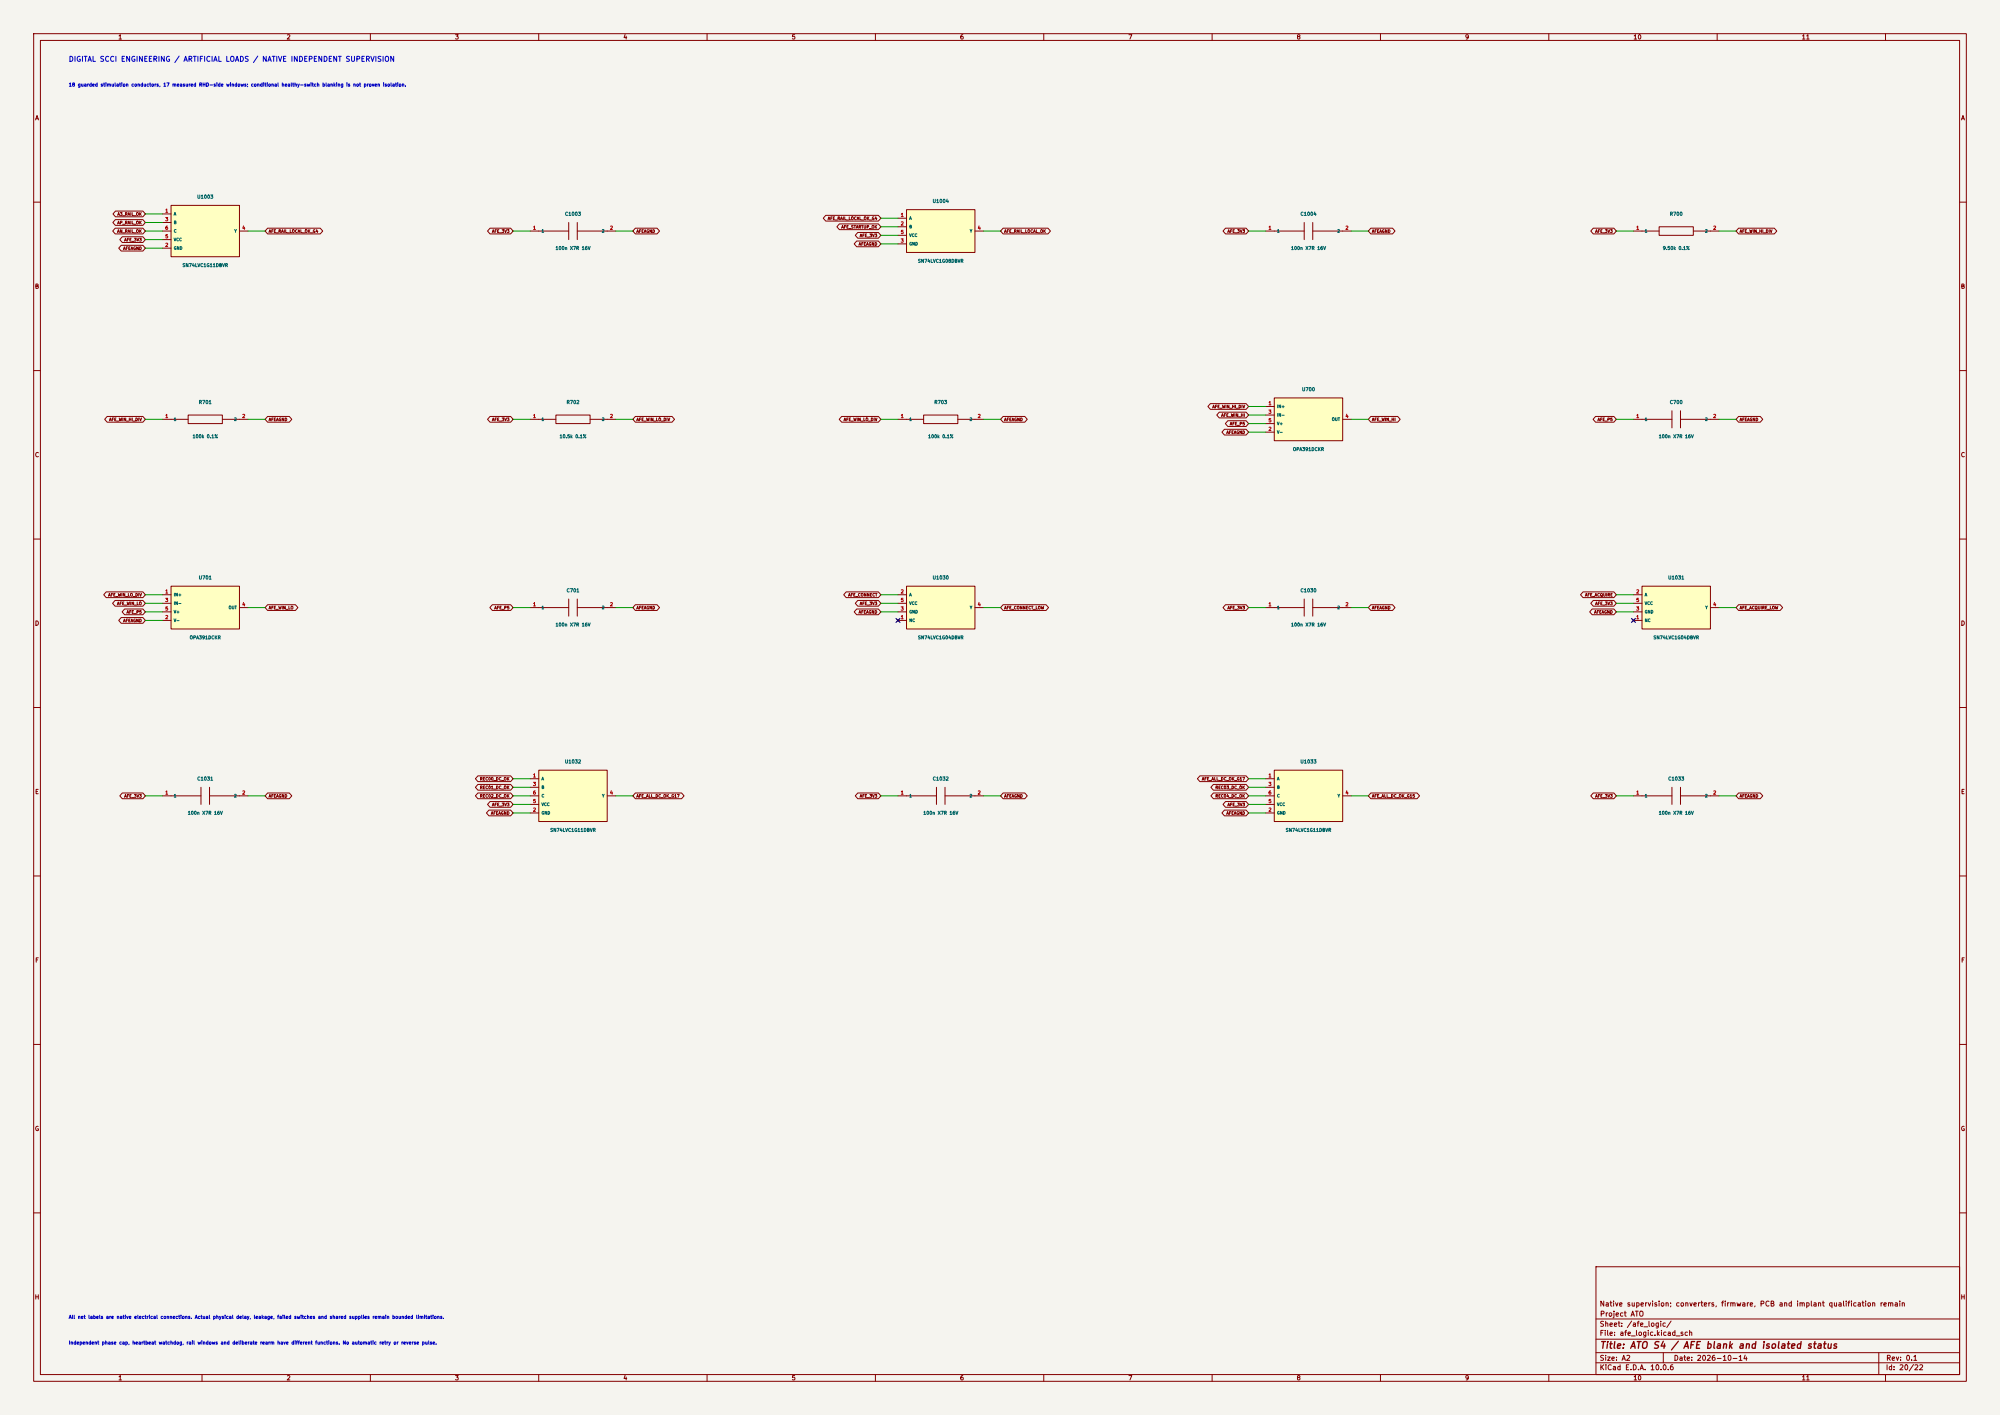
[picture p295: page 20]
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

Sheet: /afe_logic/
File: afe_logic.kicad_sch
Title: ATO S4 / AFE blank and isolated status

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

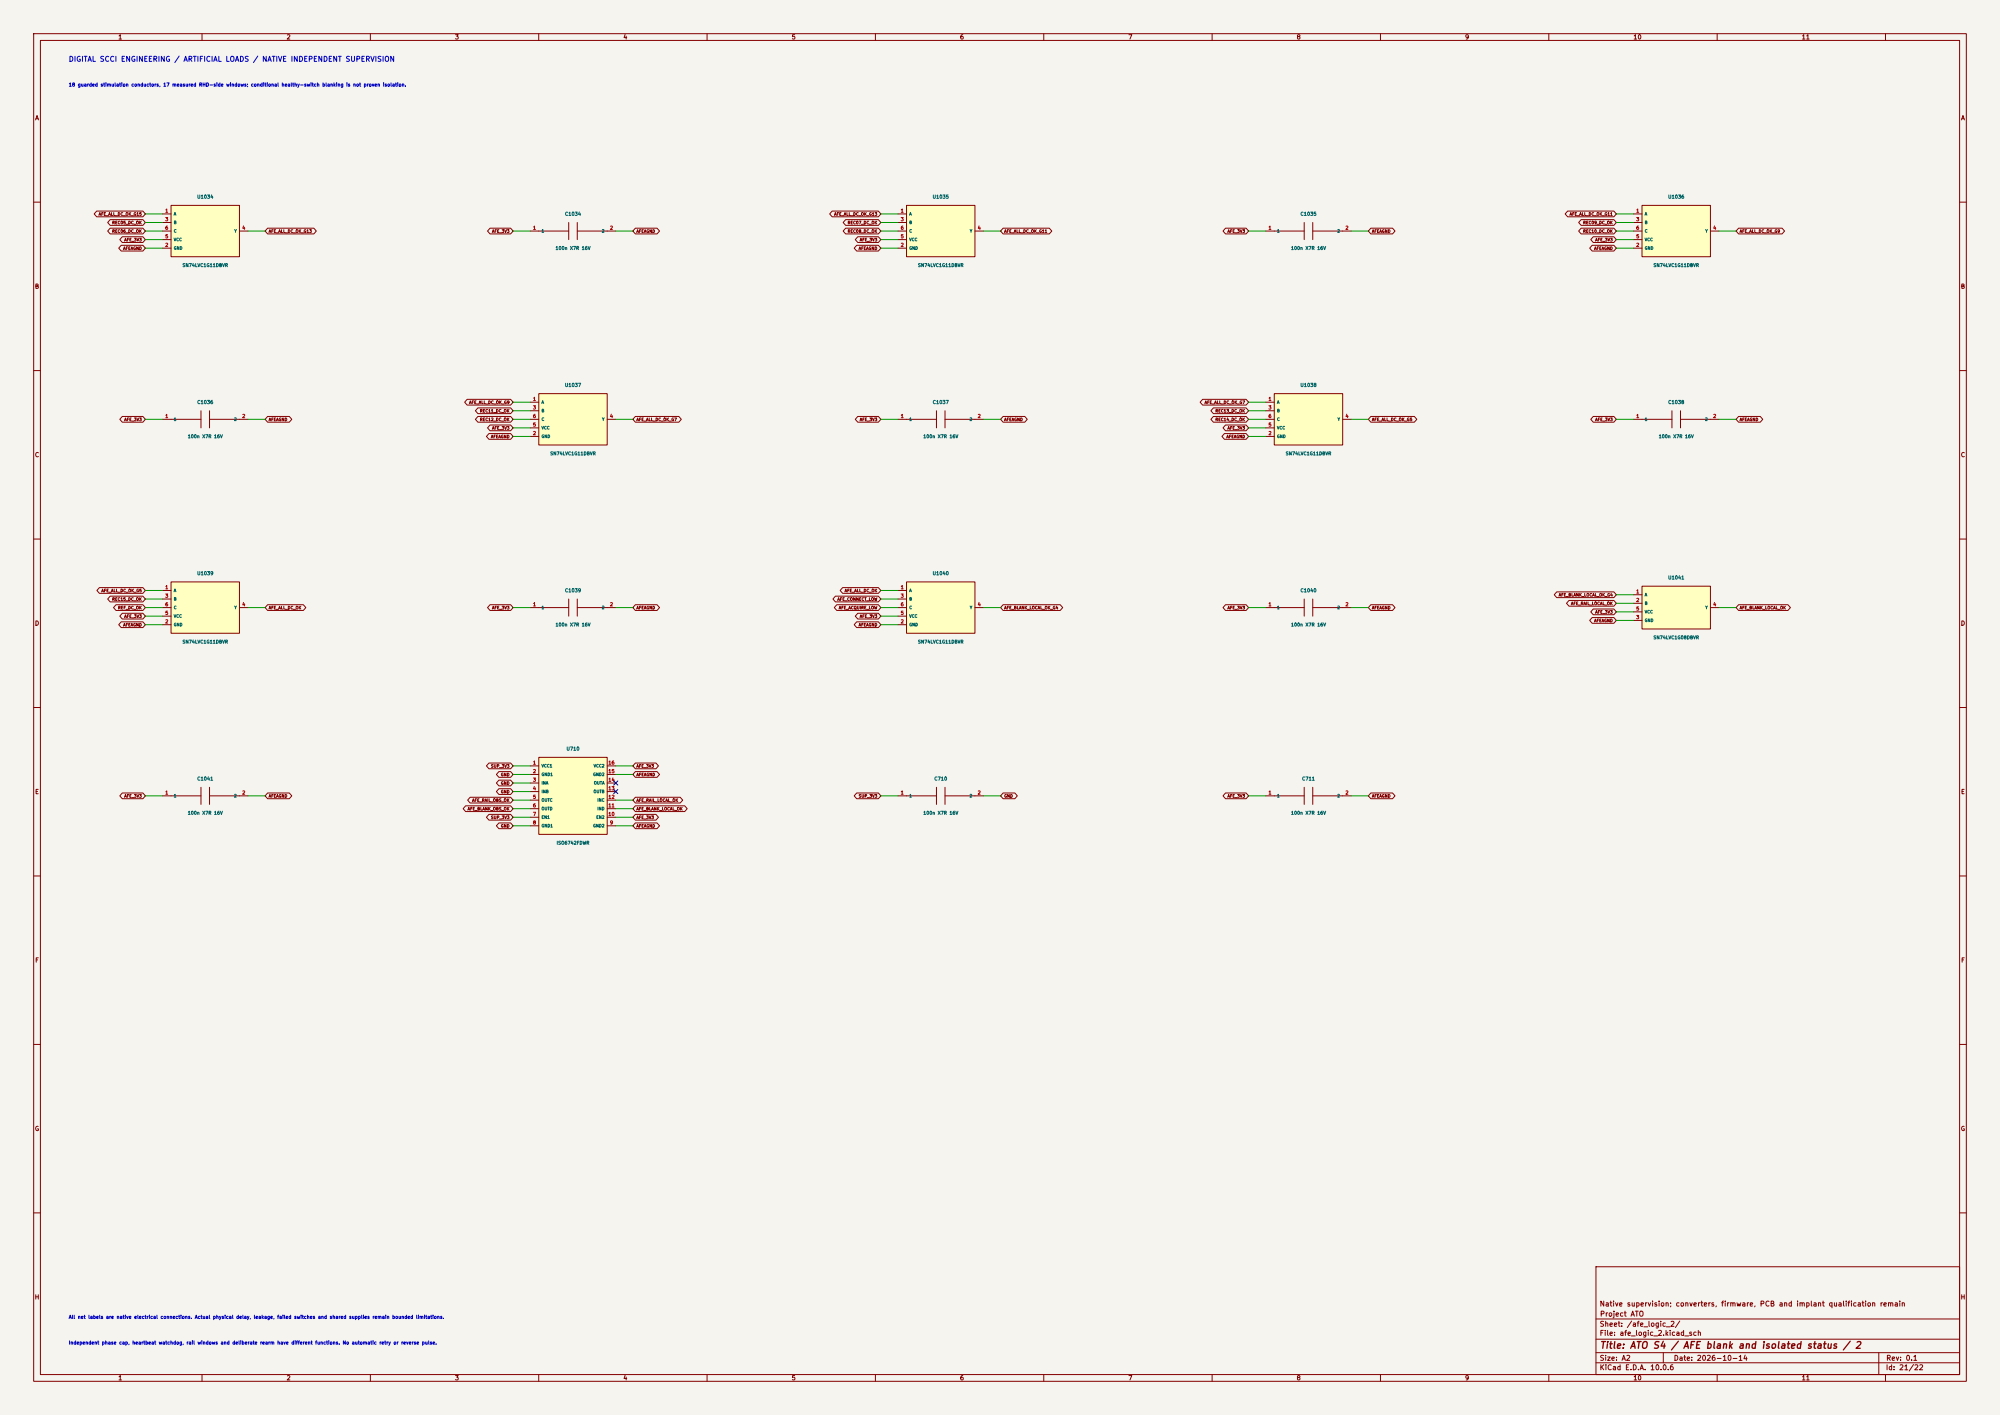
[picture p296: page 21]

AFEAGND DIGITAL SCCI ENGINEERING / ARTIFICIAL LOADS / NATIVE INDEPENDENT SUPERVISION

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

Sheet: /afe_logic_2/
File: afe_logic_2.kicad_sch
Title: ATO S4 / AFE blank and isolated status / 2

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

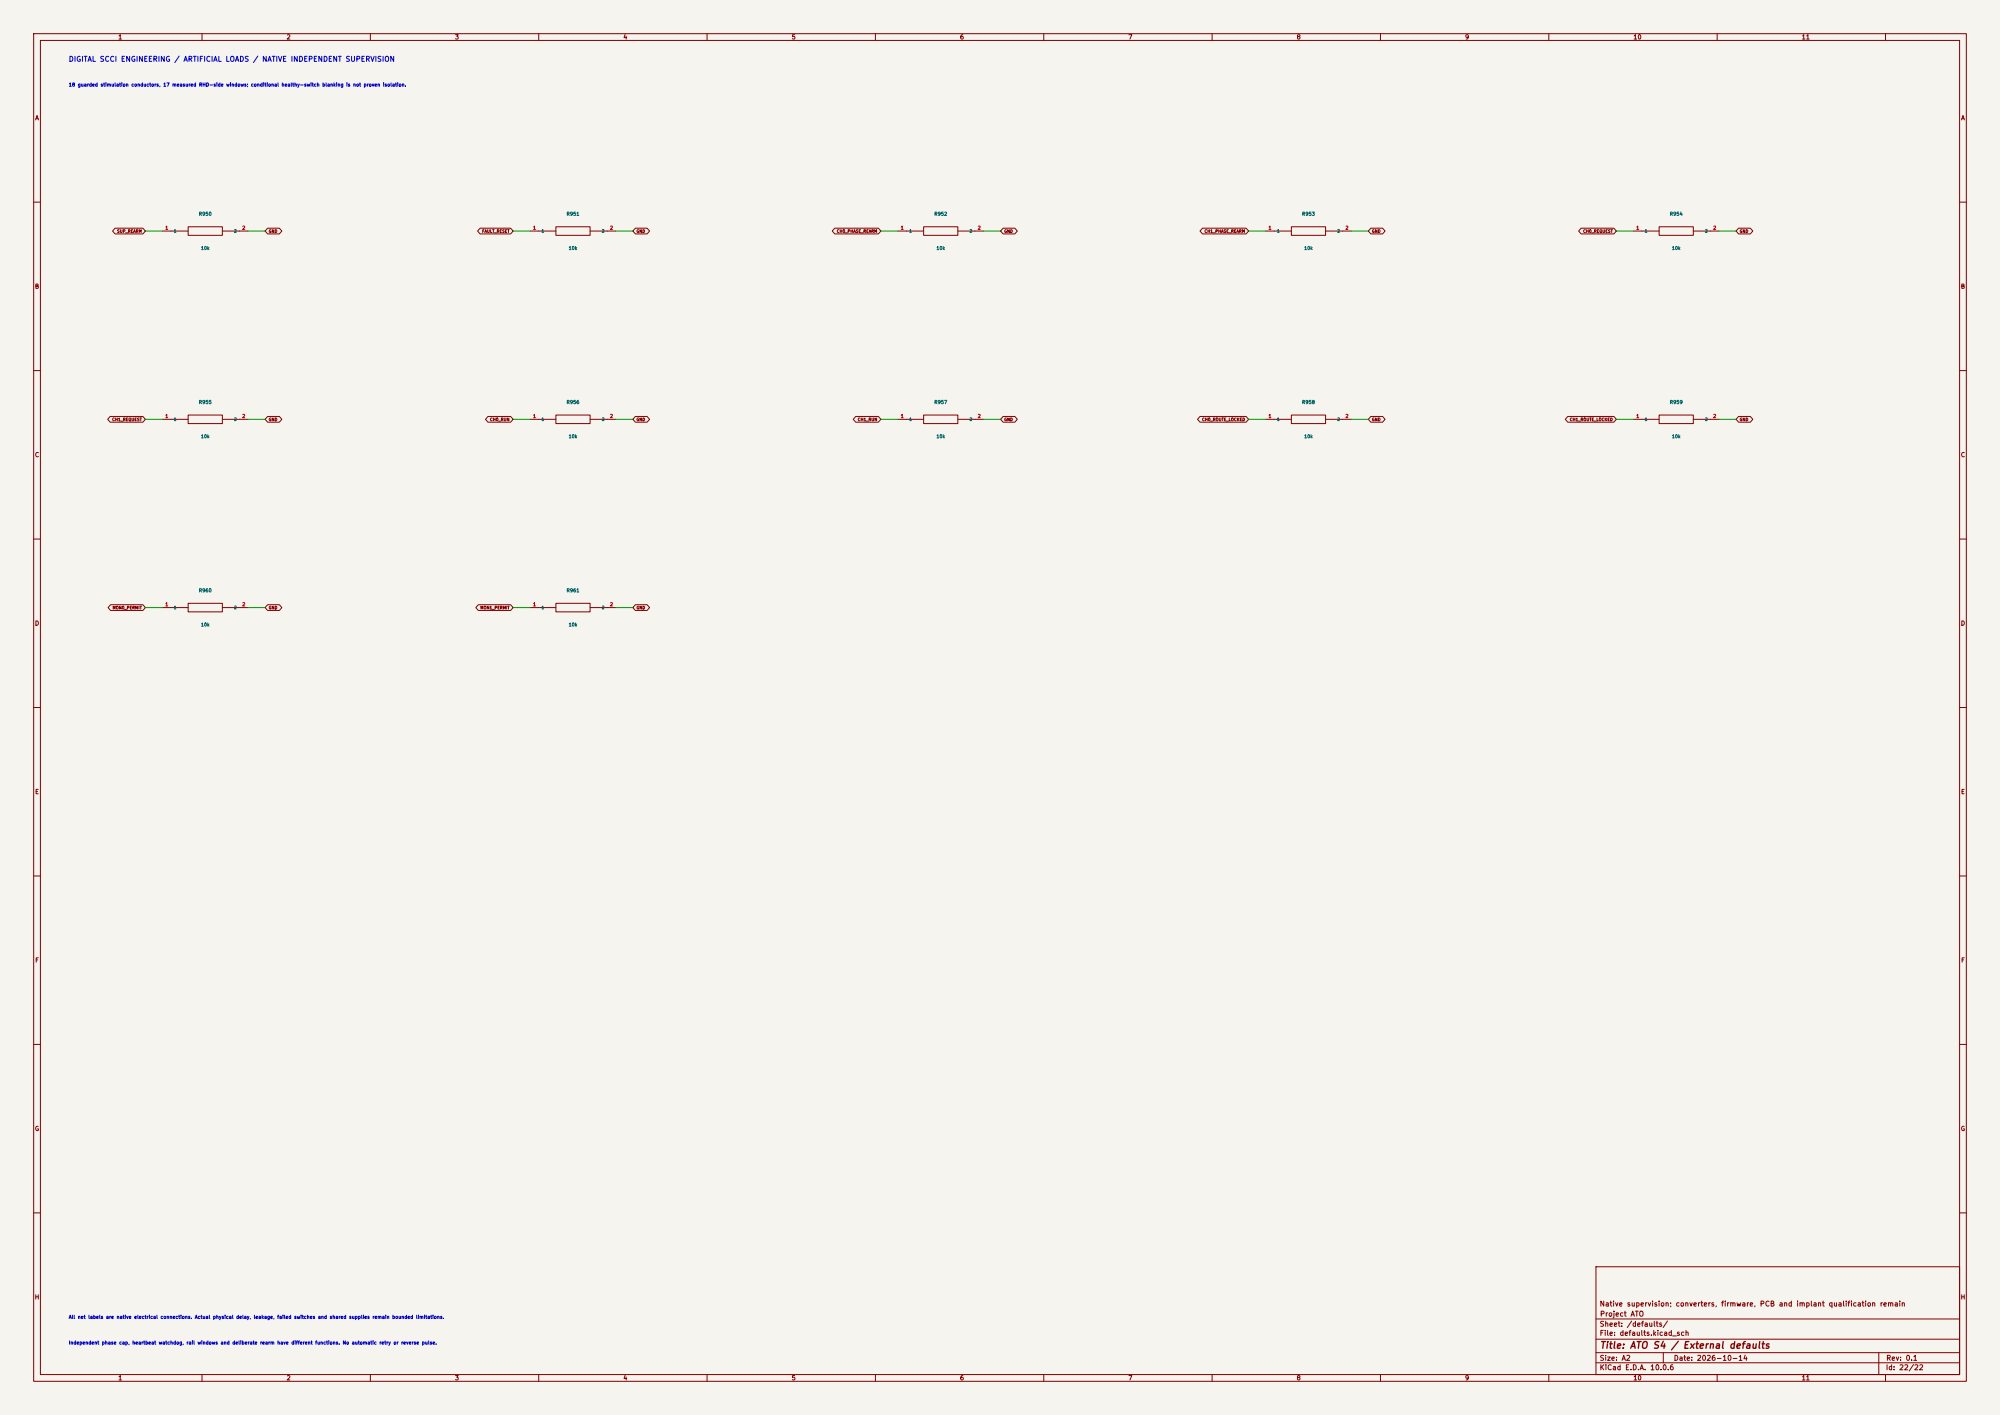
[picture p297: page 22]

Sheet: /defaults/
File: defaults.kicad_sch
Title: ATO S4 / External defaults
