pratham-cloud-ctrl/Project-ATO/(list of files, drawings)

Other design files:
electronics/stage4/integrated-pcb/boards/contact-router/contact_router.dsn
electronics/stage4/integrated-pcb/boards/contact-router/contact_router_corrected.dsn
electronics/stage4/integrated-pcb/boards/controller-carrier/controller_carrier.dsn
electronics/stage4/integrated-pcb/boards/current-driver/current_driver.dsn
electronics/stage4/integrated-pcb/boards/monitoring-cell/monitoring_cell.dsn
electronics/stage4/integrated-pcb/boards/monitoring-transport/monitoring_transport.dsn
electronics/stage4/integrated-pcb/boards/power/power.dsn
electronics/stage4/integrated-pcb/boards/recording-front-end/recording_front_end.dsn
electronics/stage4/integrated-pcb/boards/supervision/supervision.dsn
inspector/assets/schematic-hierarchy-mcp.json
