pratham-cloud-ctrl/Project-ATO/electronics/stage4/integrated-pcb/boards/supervision/supervision.kicad_pcb

## KiCad design electronics/stage4/integrated-pcb/boards/supervision/supervision.kicad_pcb (continued)

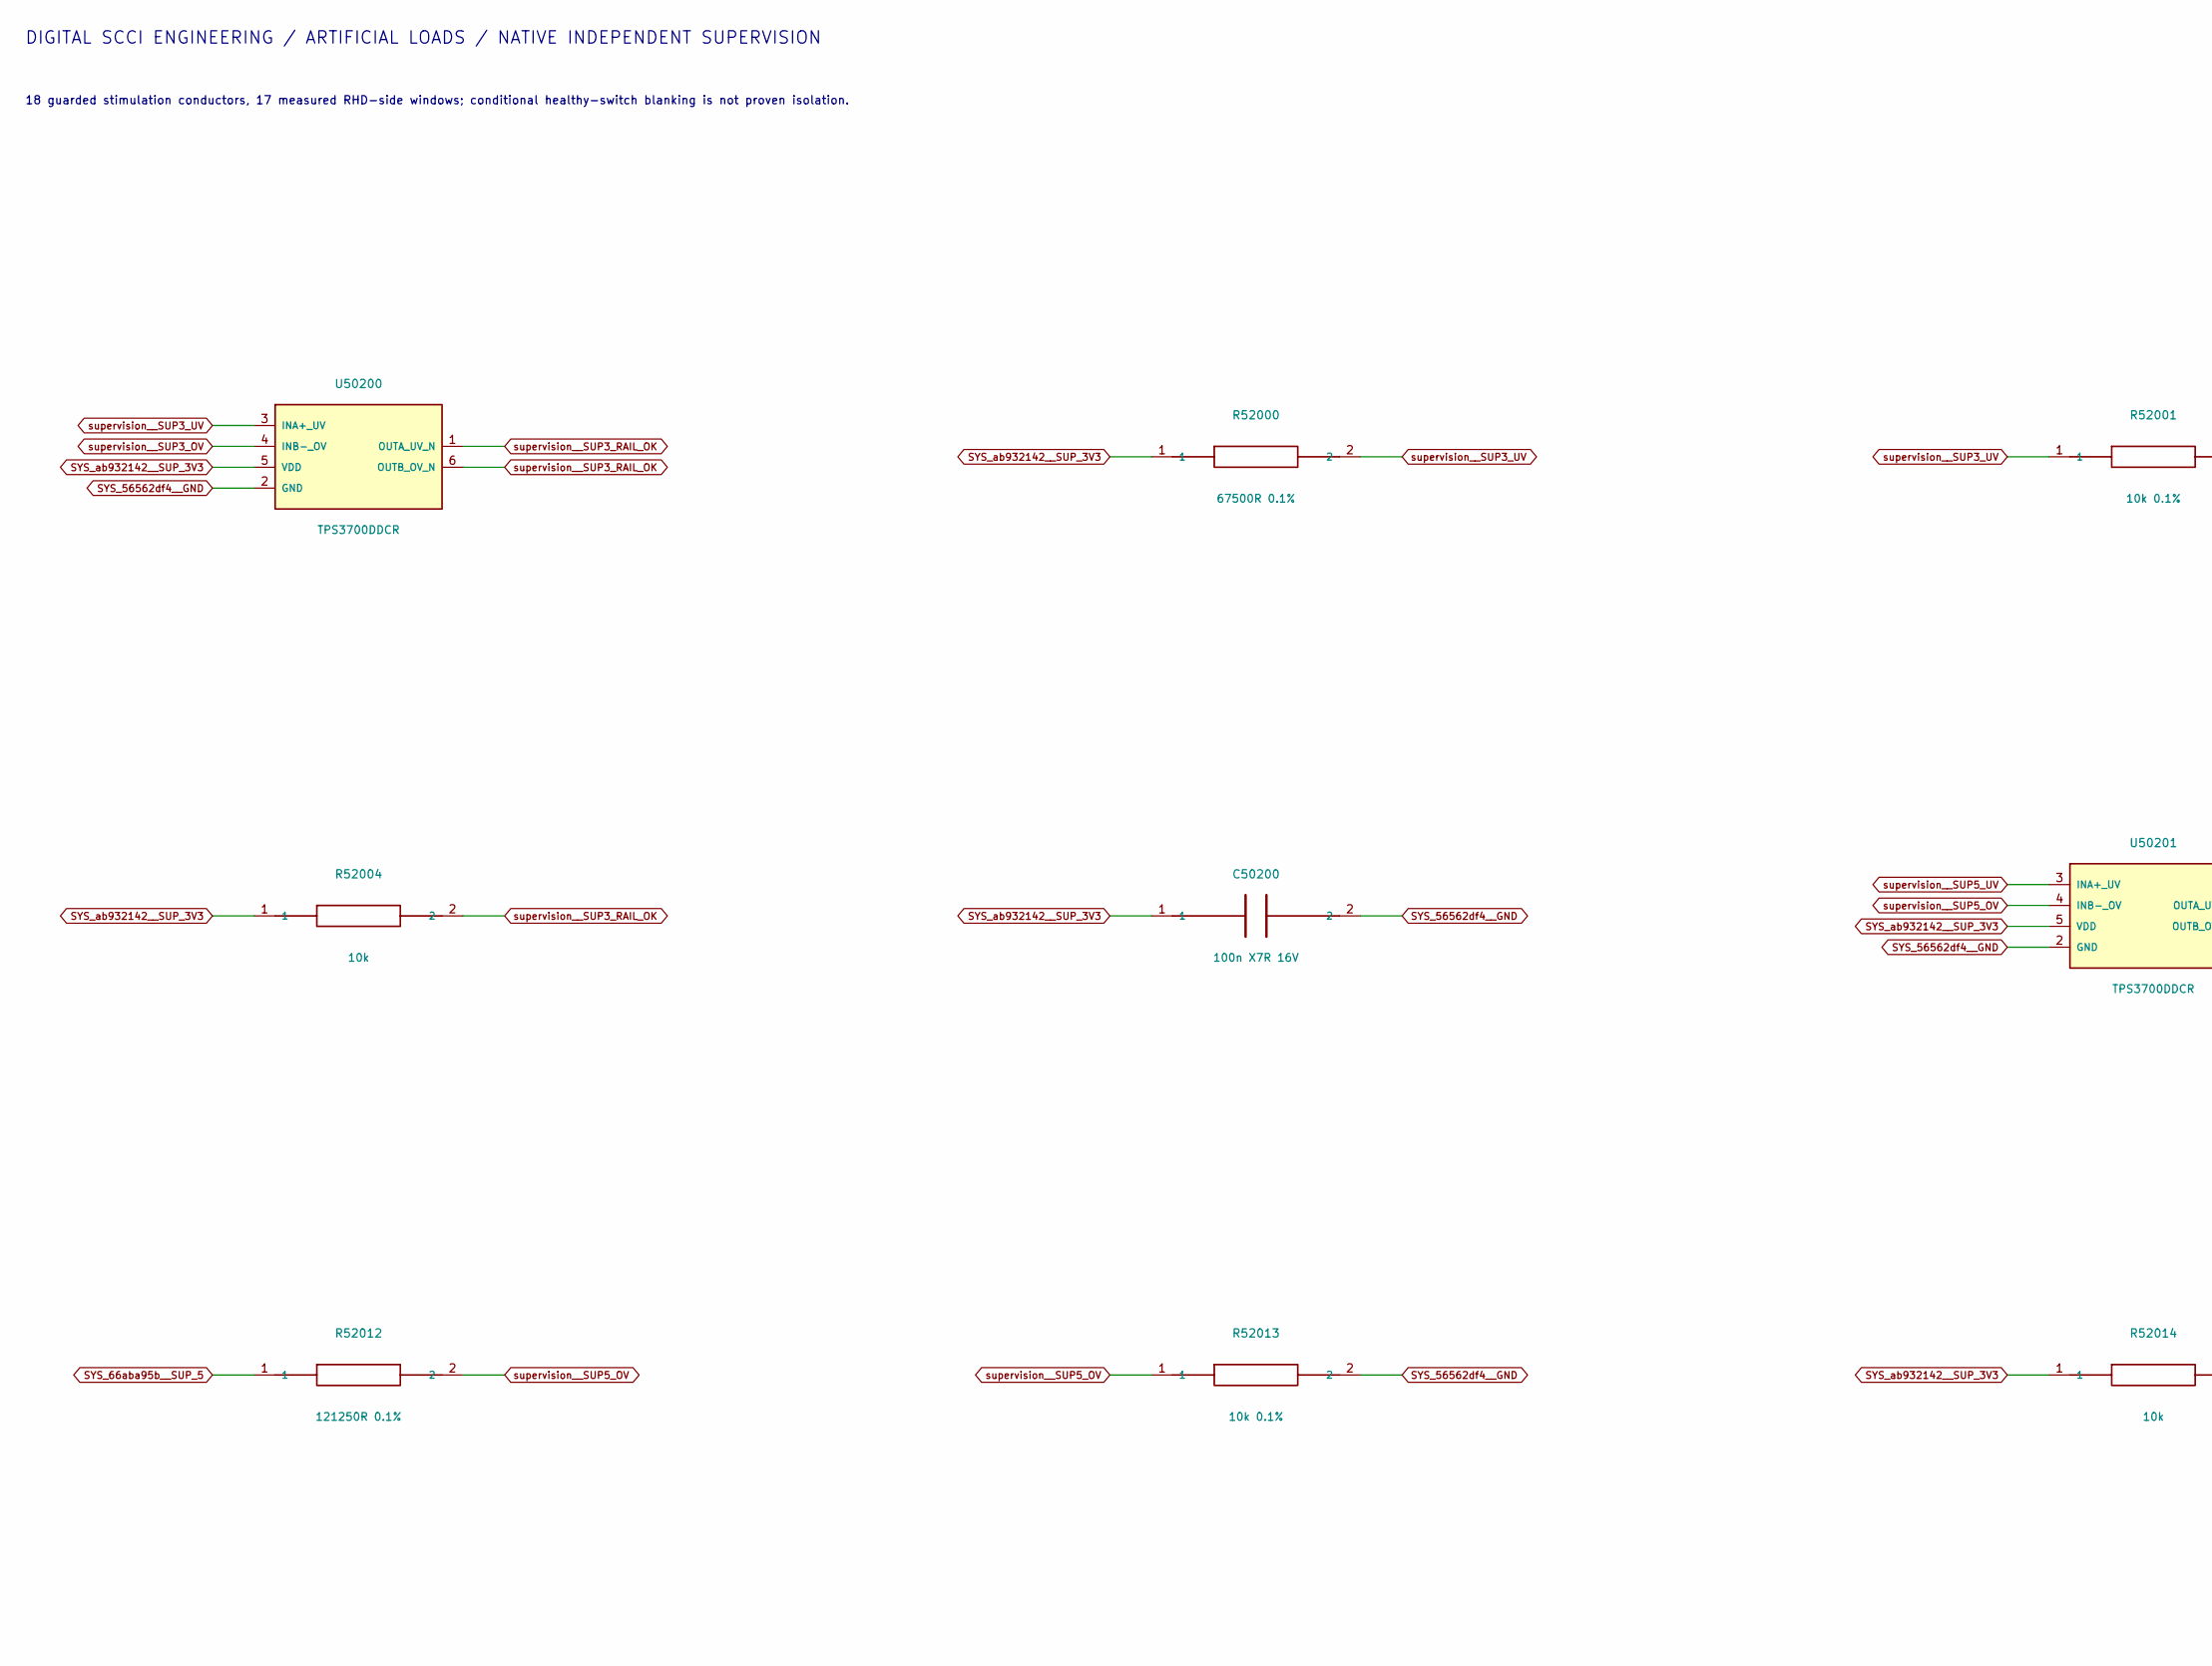
[picture p301: schematic host_rails.kicad_sch, ATO S4 / Host supply windows, part in row 1, column 1]

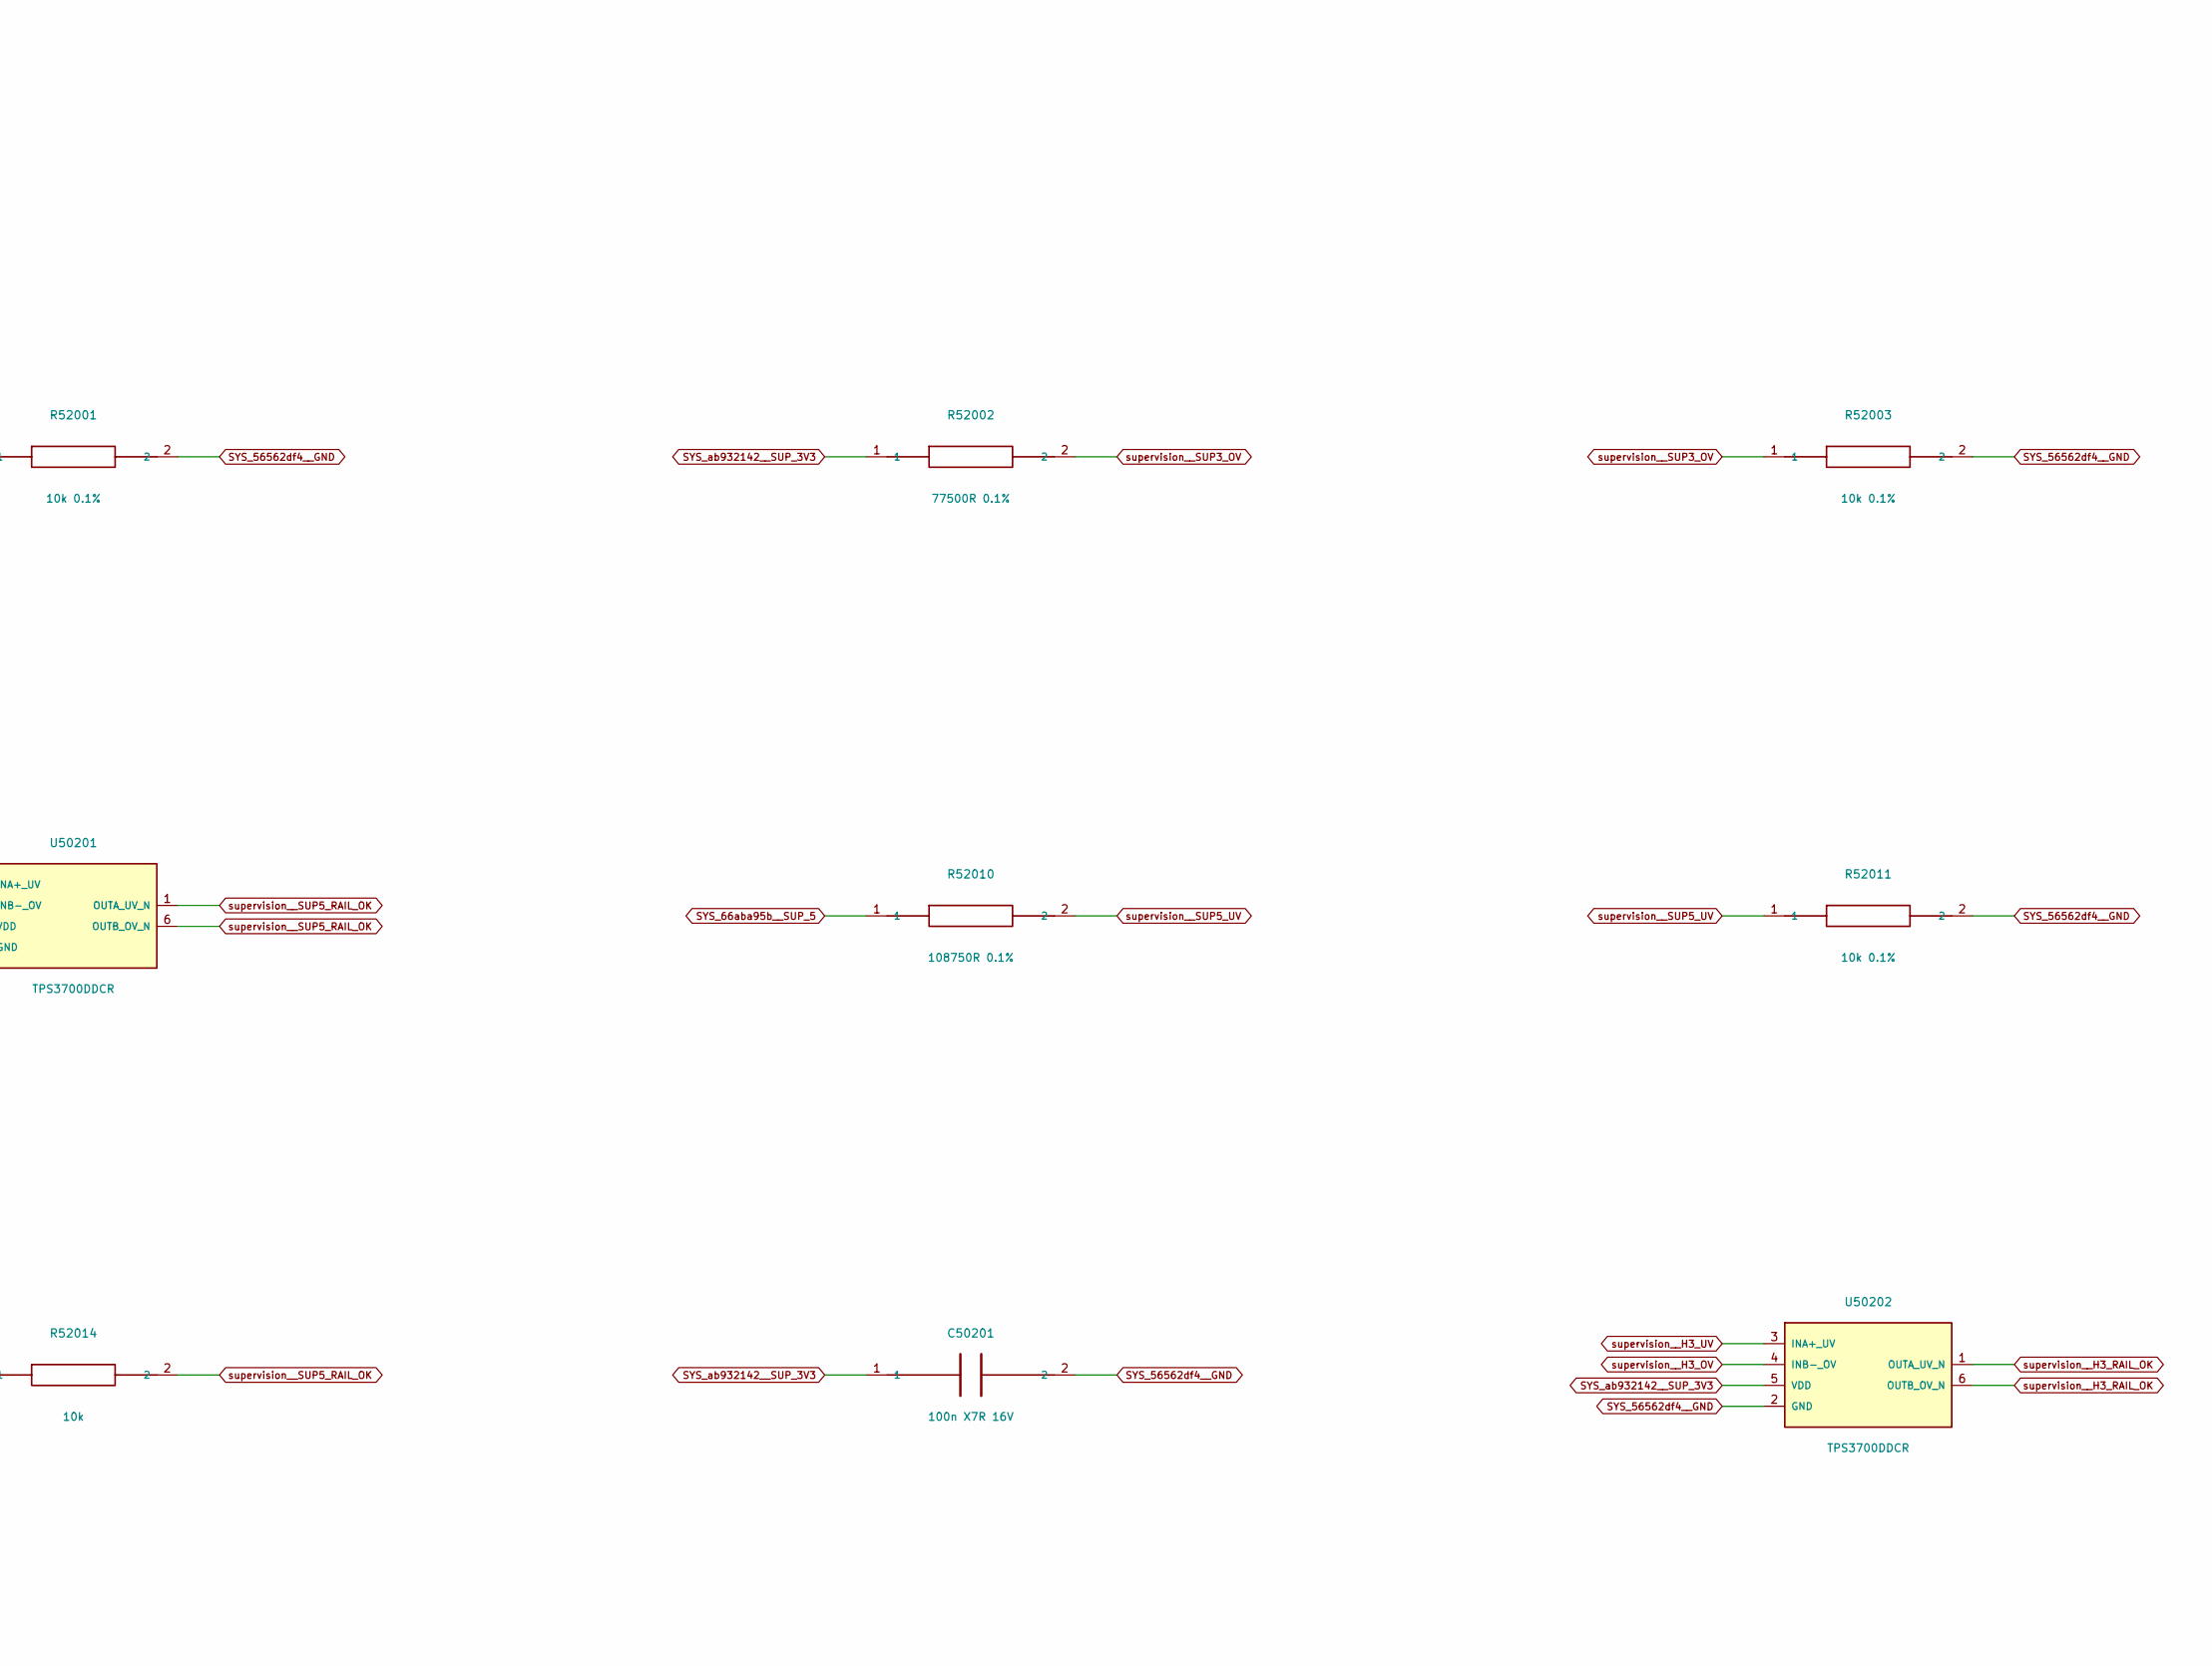
[picture p302: schematic host_rails.kicad_sch, ATO S4 / Host supply windows, part in row 1, column 2]

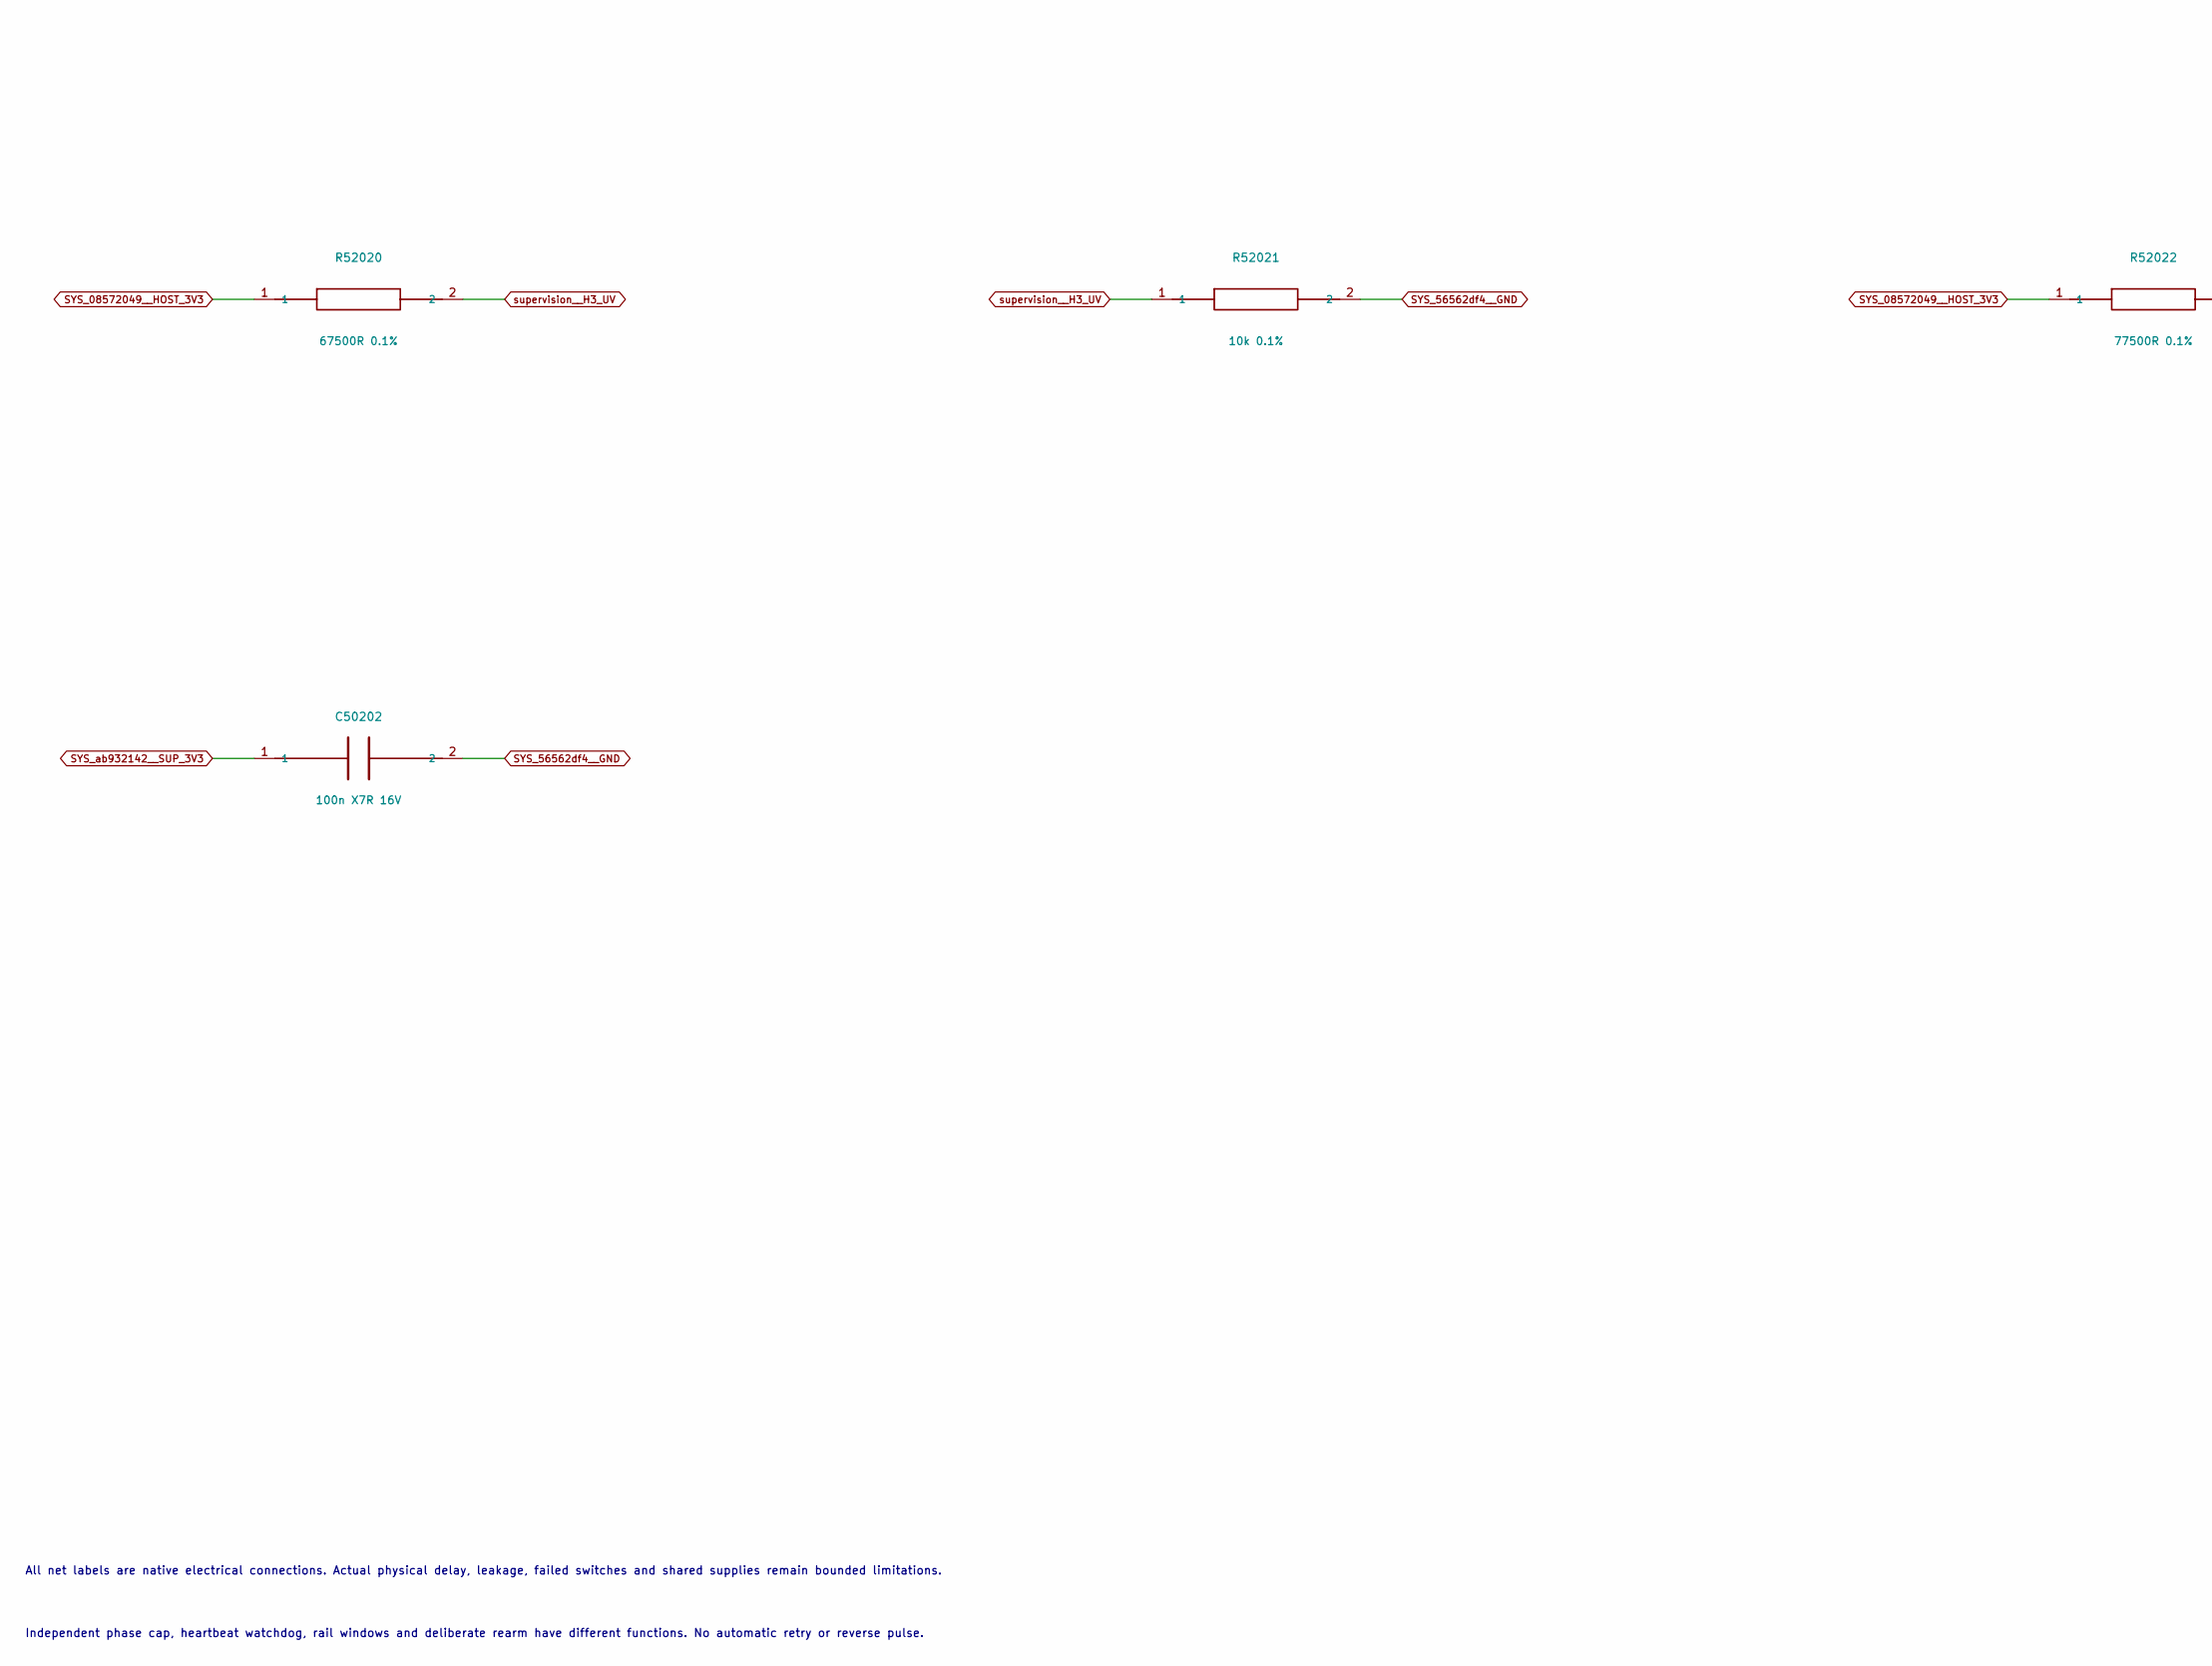
[picture p303: schematic host_rails.kicad_sch, ATO S4 / Host supply windows, part in row 2, column 1]

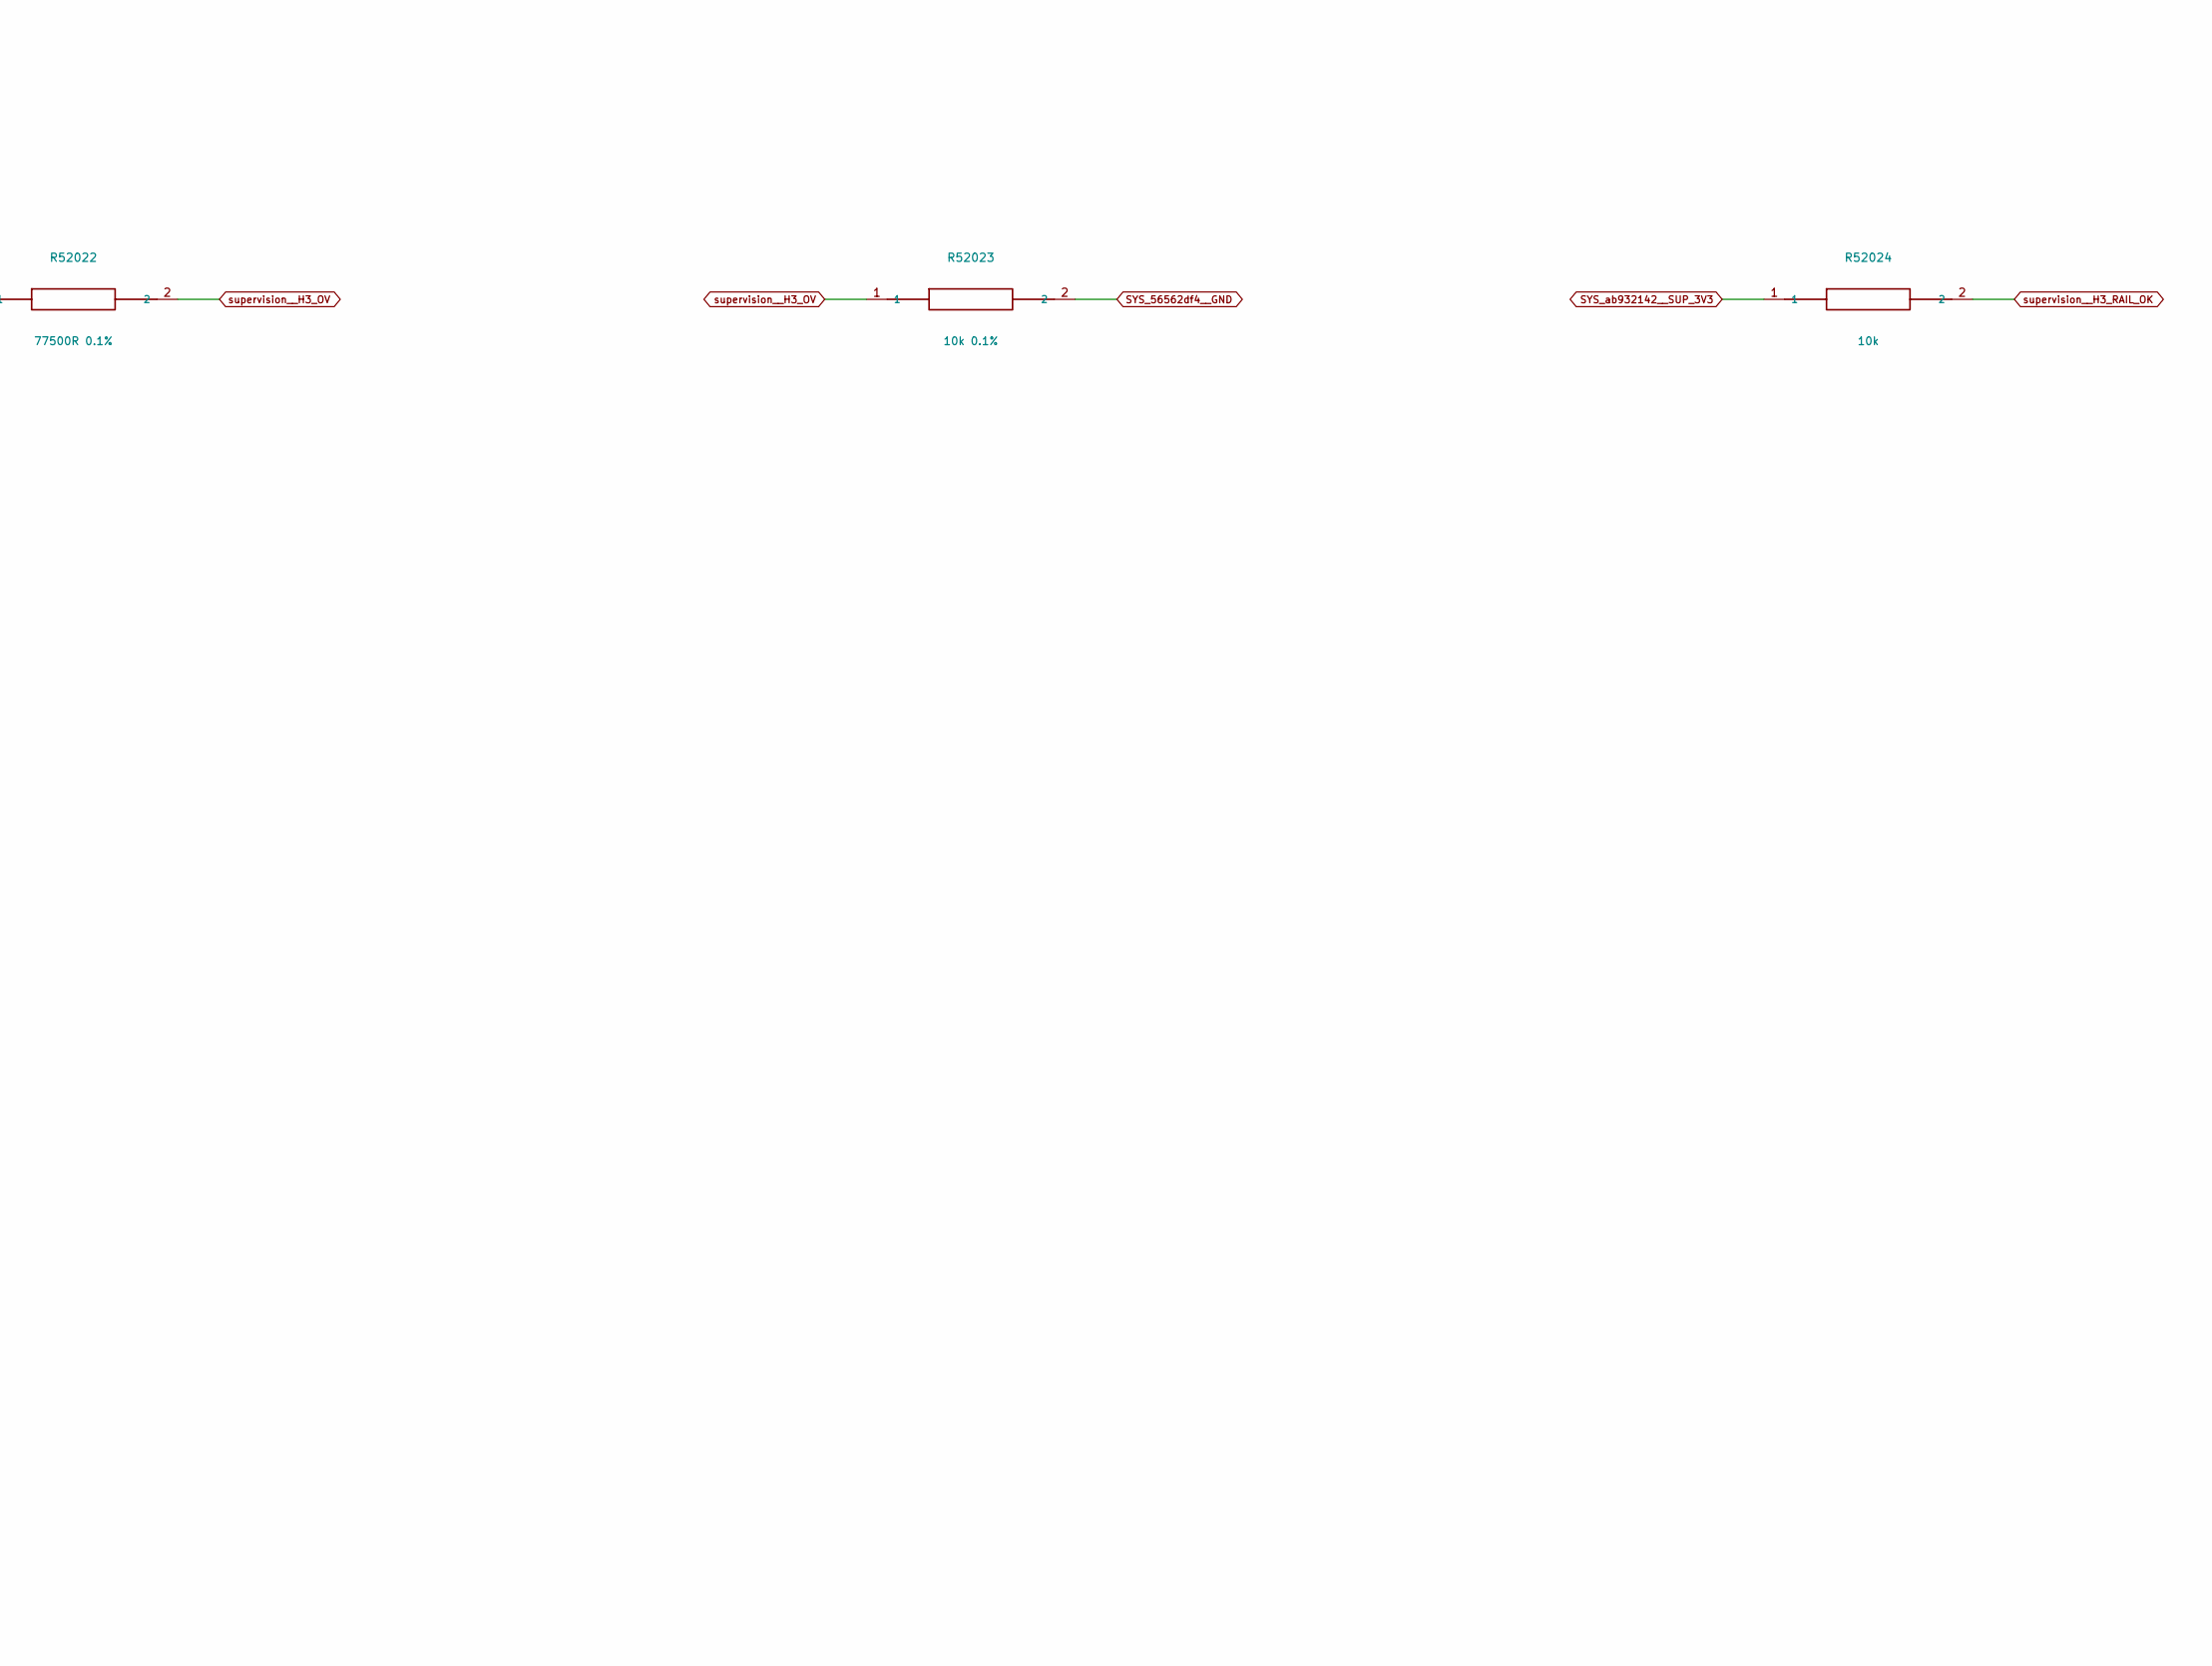
[picture p304: schematic host_rails.kicad_sch, ATO S4 / Host supply windows, part in row 2, column 2]

Parts:
C50200, C50201, C50202: 100n X7R 16V; C_0805_2012Metric
R52000, R52020: 67500R 0.1%; R_0805_2012Metric
R52001, R52003, R52011, R52013, R52021, R52023: 10k 0.1%; R_0805_2012Metric
R52002, R52022: 77500R 0.1%; R_0805_2012Metric
R52004, R52014, R52024: 10k; R_0805_2012Metric
R52010: 108750R 0.1%; R_0805_2012Metric
R52012: 121250R 0.1%; R_0805_2012Metric
U50200, U50201, U50202: TPS3700DDCR; SOT-23-6

Connections:
SYS_66aba95b__SUP_5: R52010.1, R52012.1; also elsewhere on the board
SYS_56562df4__GND: C50200.2, C50201.2, C50202.2, R52001.2, R52003.2, R52011.2, R52013.2, R52021.2, R52023.2, U50200.2 (GND), U50201.2 (GND), U50202.2 (GND); also elsewhere on the board
SYS_08572049__HOST_3V3: R52020.1, R52022.1; also elsewhere on the board
SYS_ab932142__SUP_3V3: C50200.1, C50201.1, C50202.1, R52000.1, R52002.1, R52004.1, R52014.1, R52024.1, U50200.5 (VDD), U50201.5 (VDD), U50202.5 (VDD); also elsewhere on the board
supervision__H3_OV: R52022.2, R52023.1, U50202.4 (INB-_OV)
supervision__H3_RAIL_OK: R52024.2, U50202.1 (OUTA_UV_N), U50202.6 (OUTB_OV_N); also elsewhere on the board
supervision__H3_UV: R52020.2, R52021.1, U50202.3 (INA+_UV)
supervision__SUP3_OV: R52002.2, R52003.1, U50200.4 (INB-_OV)
supervision__SUP3_RAIL_OK: R52004.2, U50200.1 (OUTA_UV_N), U50200.6 (OUTB_OV_N); also elsewhere on the board
supervision__SUP3_UV: R52000.2, R52001.1, U50200.3 (INA+_UV)
supervision__SUP5_OV: R52012.2, R52013.1, U50201.4 (INB-_OV)
supervision__SUP5_RAIL_OK: R52014.2, U50201.1 (OUTA_UV_N), U50201.6 (OUTB_OV_N); also elsewhere on the board
supervision__SUP5_UV: R52010.2, R52011.1, U50201.3 (INA+_UV)

Notes on the sheet:
DIGITAL SCCI ENGINEERING / ARTIFICIAL LOADS / NATIVE INDEPENDENT SUPERVISION
18 guarded stimulation conductors, 17 measured RHD-side windows; conditional healthy-switch blanking is not proven isolation.
All net labels are native electrical connections. Actual physical delay, leakage, failed switches and shared supplies remain bounded limitations.
Independent phase cap, heartbeat watchdog, rail windows and deliberate rearm have different functions. No automatic retry or reverse pulse.
