pratham-cloud-ctrl/Project-ATO/electronics/stage4/integrated-pcb/boards/supervision/supervision.kicad_pcb

## KiCad design electronics/stage4/integrated-pcb/boards/supervision/supervision.kicad_pcb (continued)

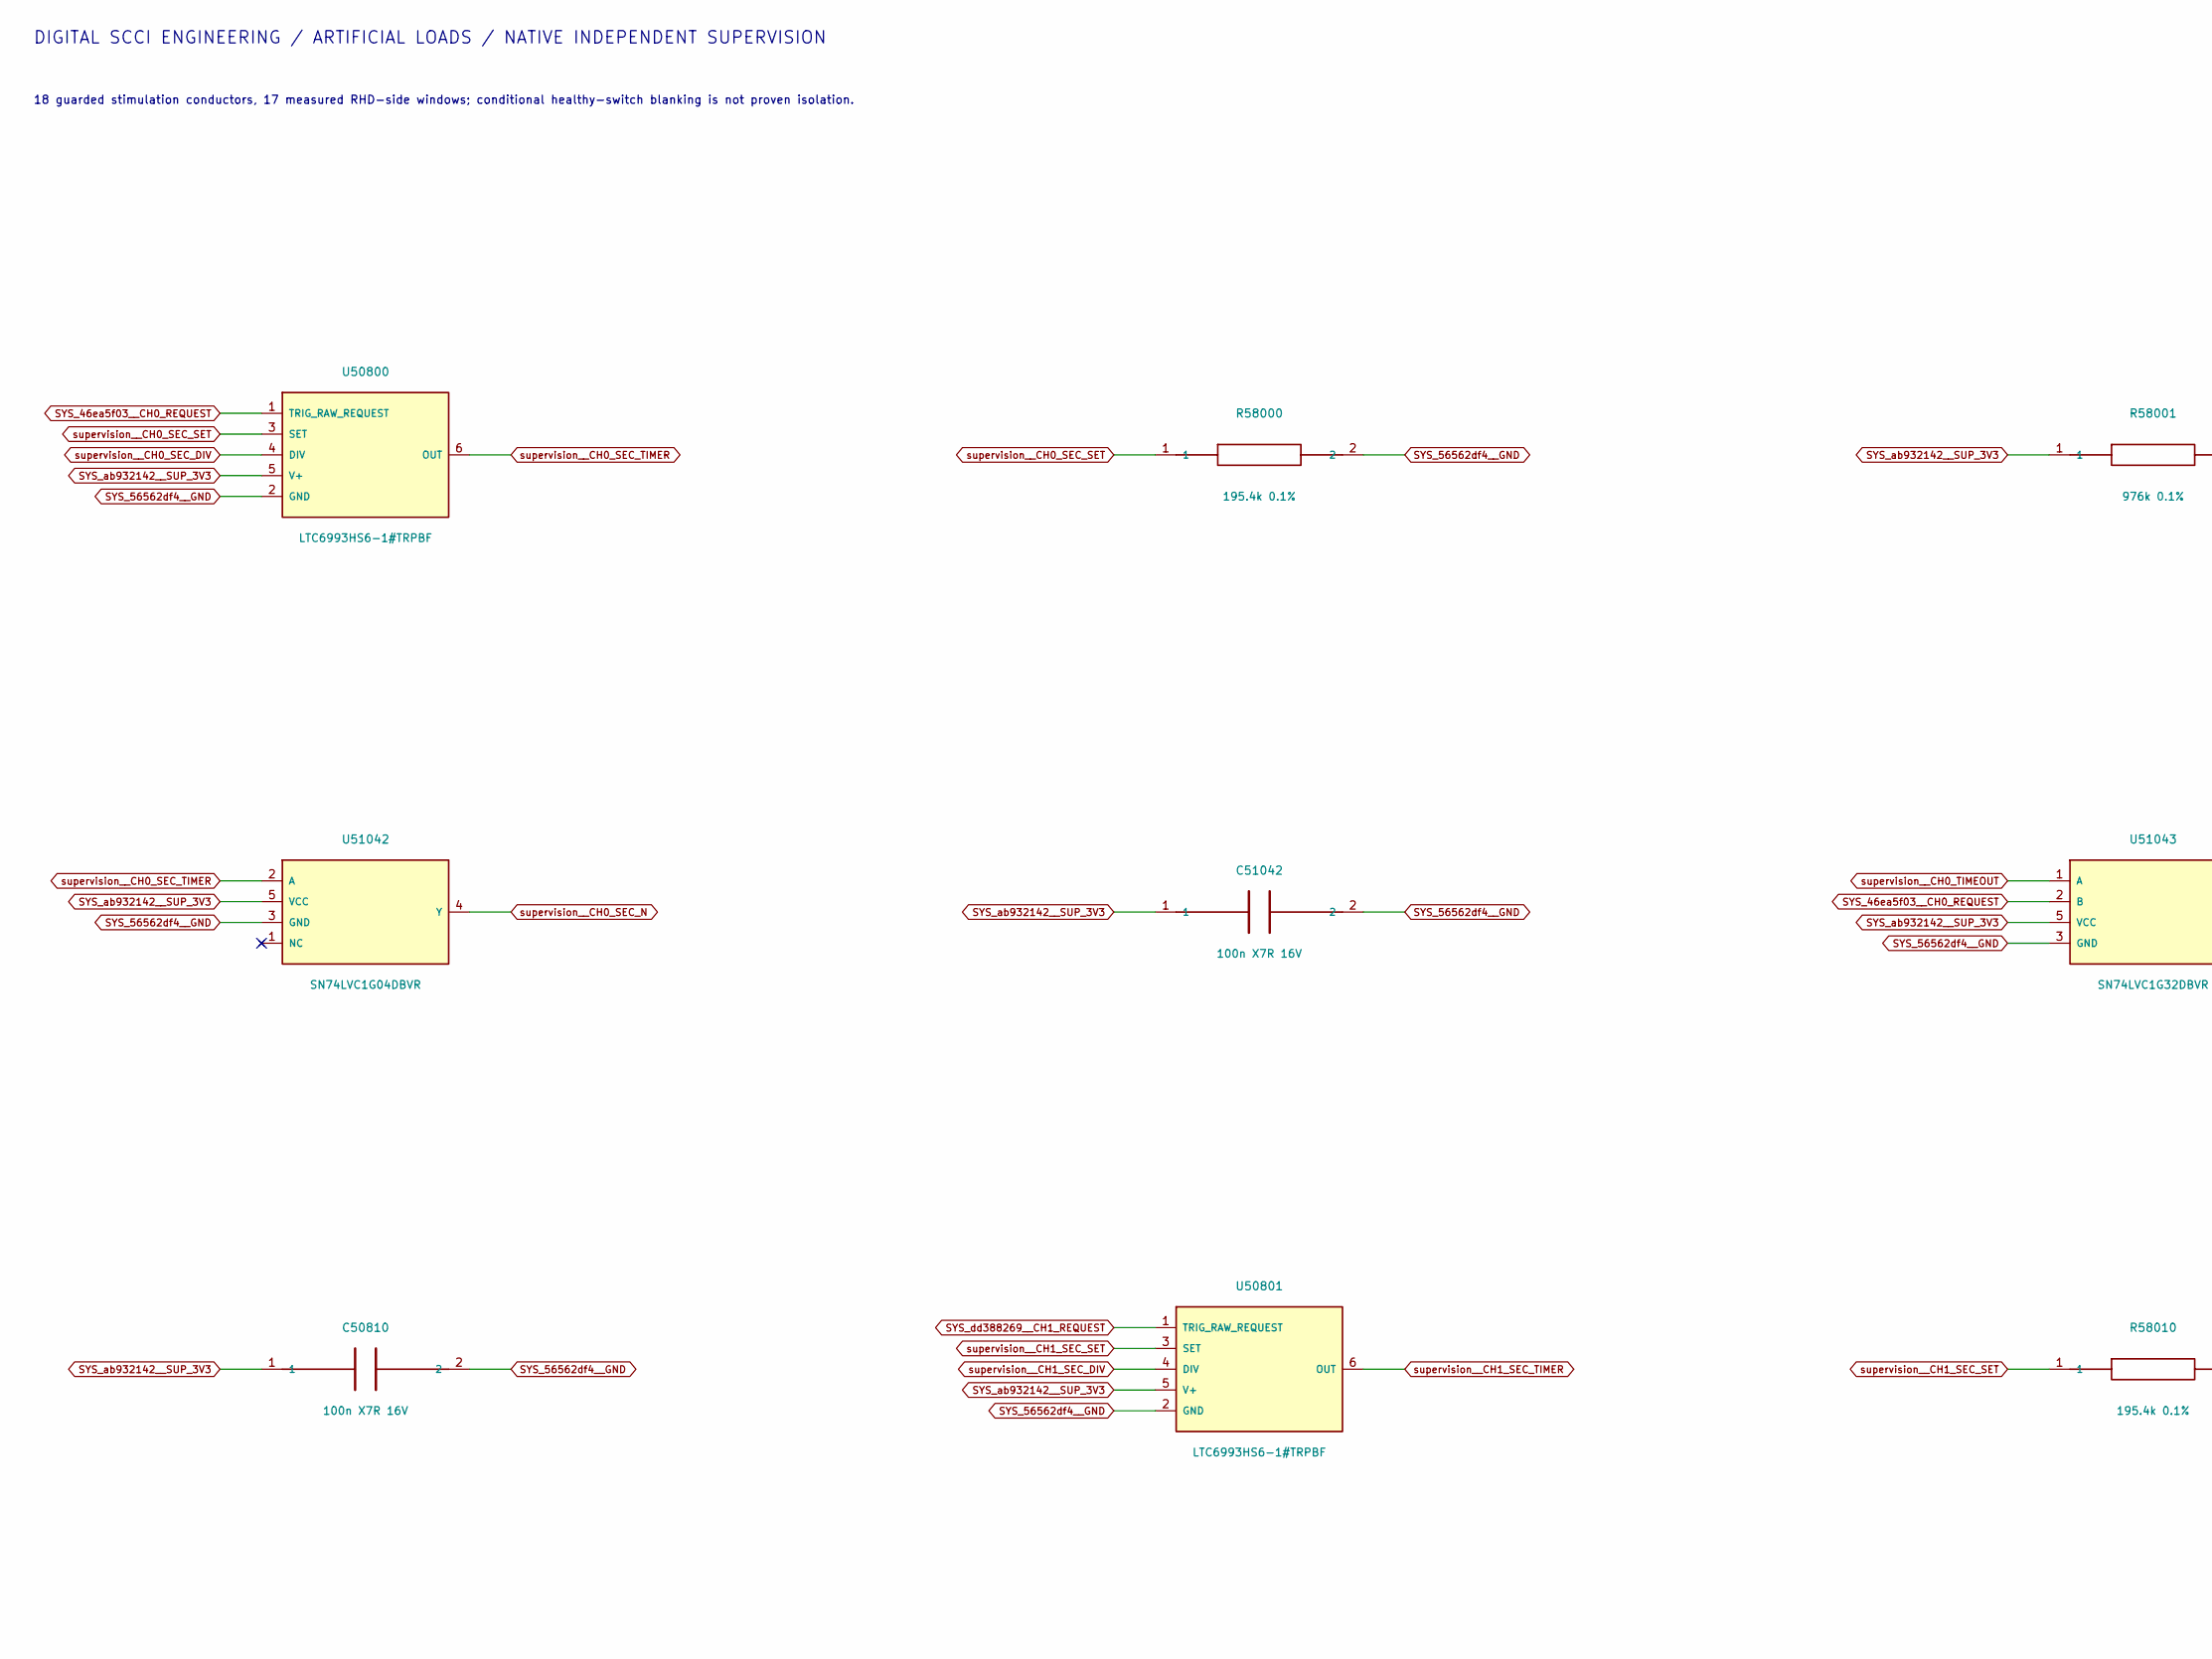
[picture p325: schematic duration.kicad_sch, ATO S4 / Secondary phase duration, part in row 1, column 1]

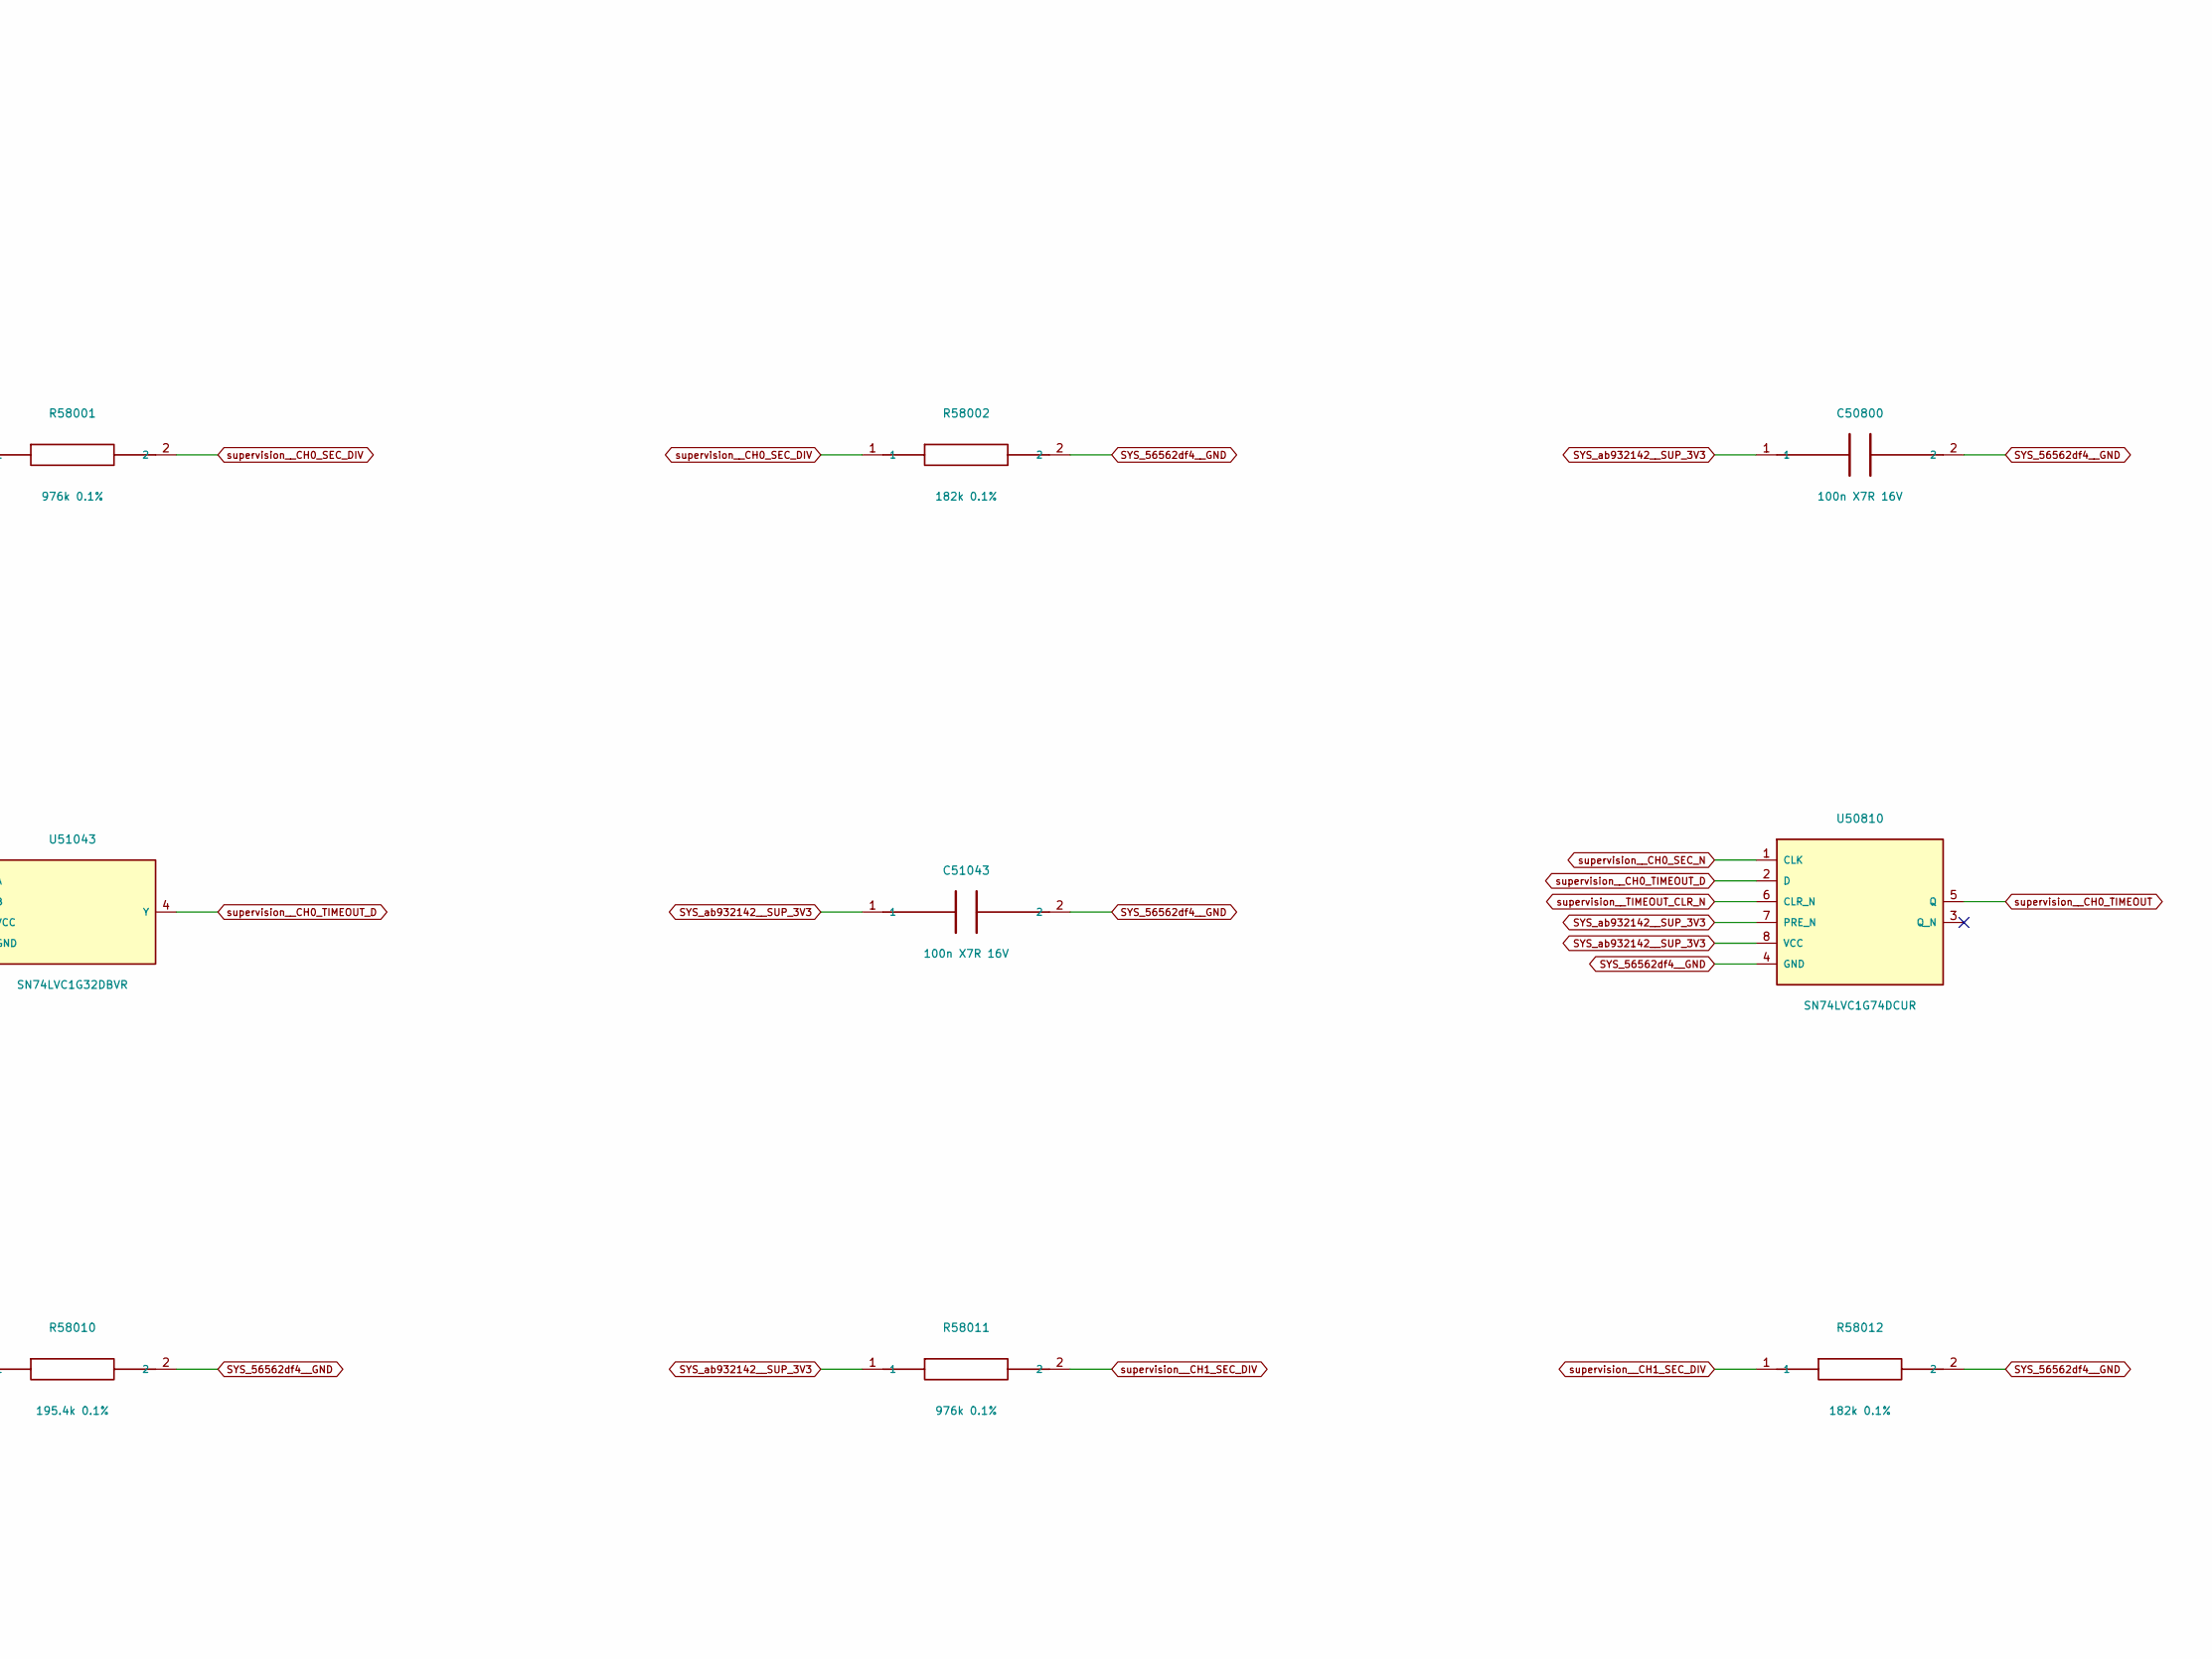
[picture p326: schematic duration.kicad_sch, ATO S4 / Secondary phase duration, part in row 1, column 2]

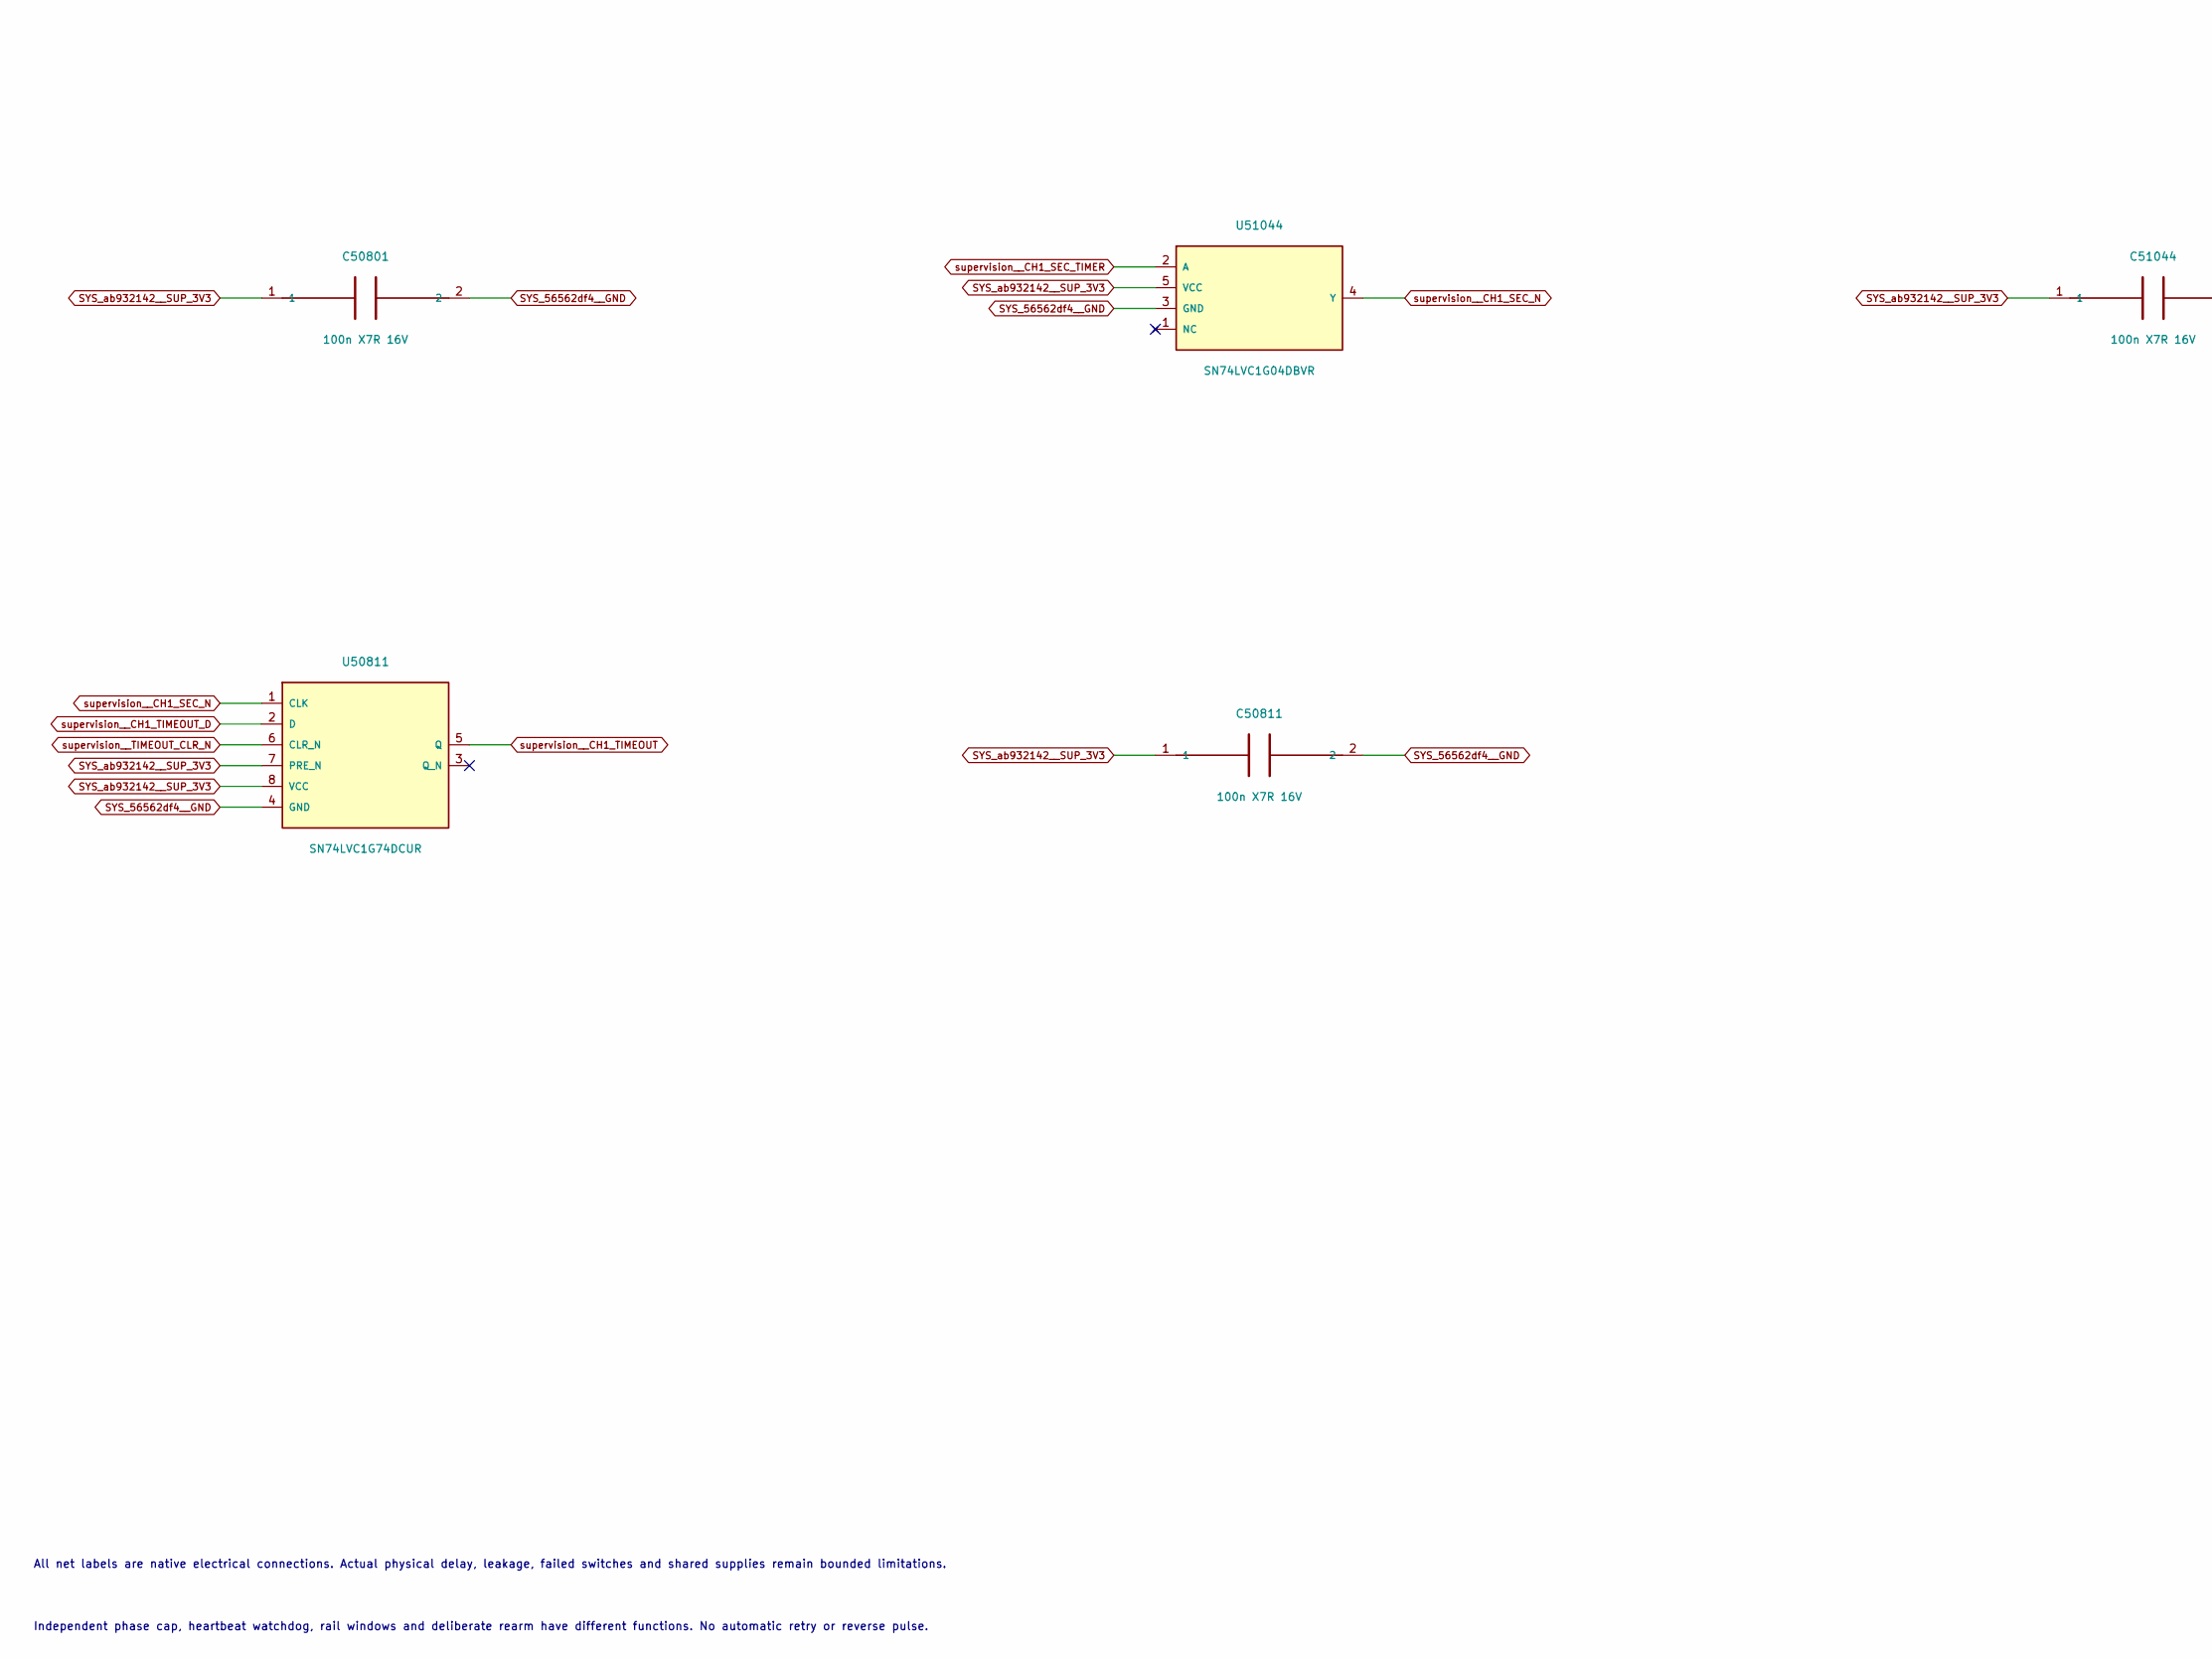
[picture p327: schematic duration.kicad_sch, ATO S4 / Secondary phase duration, part in row 2, column 1]

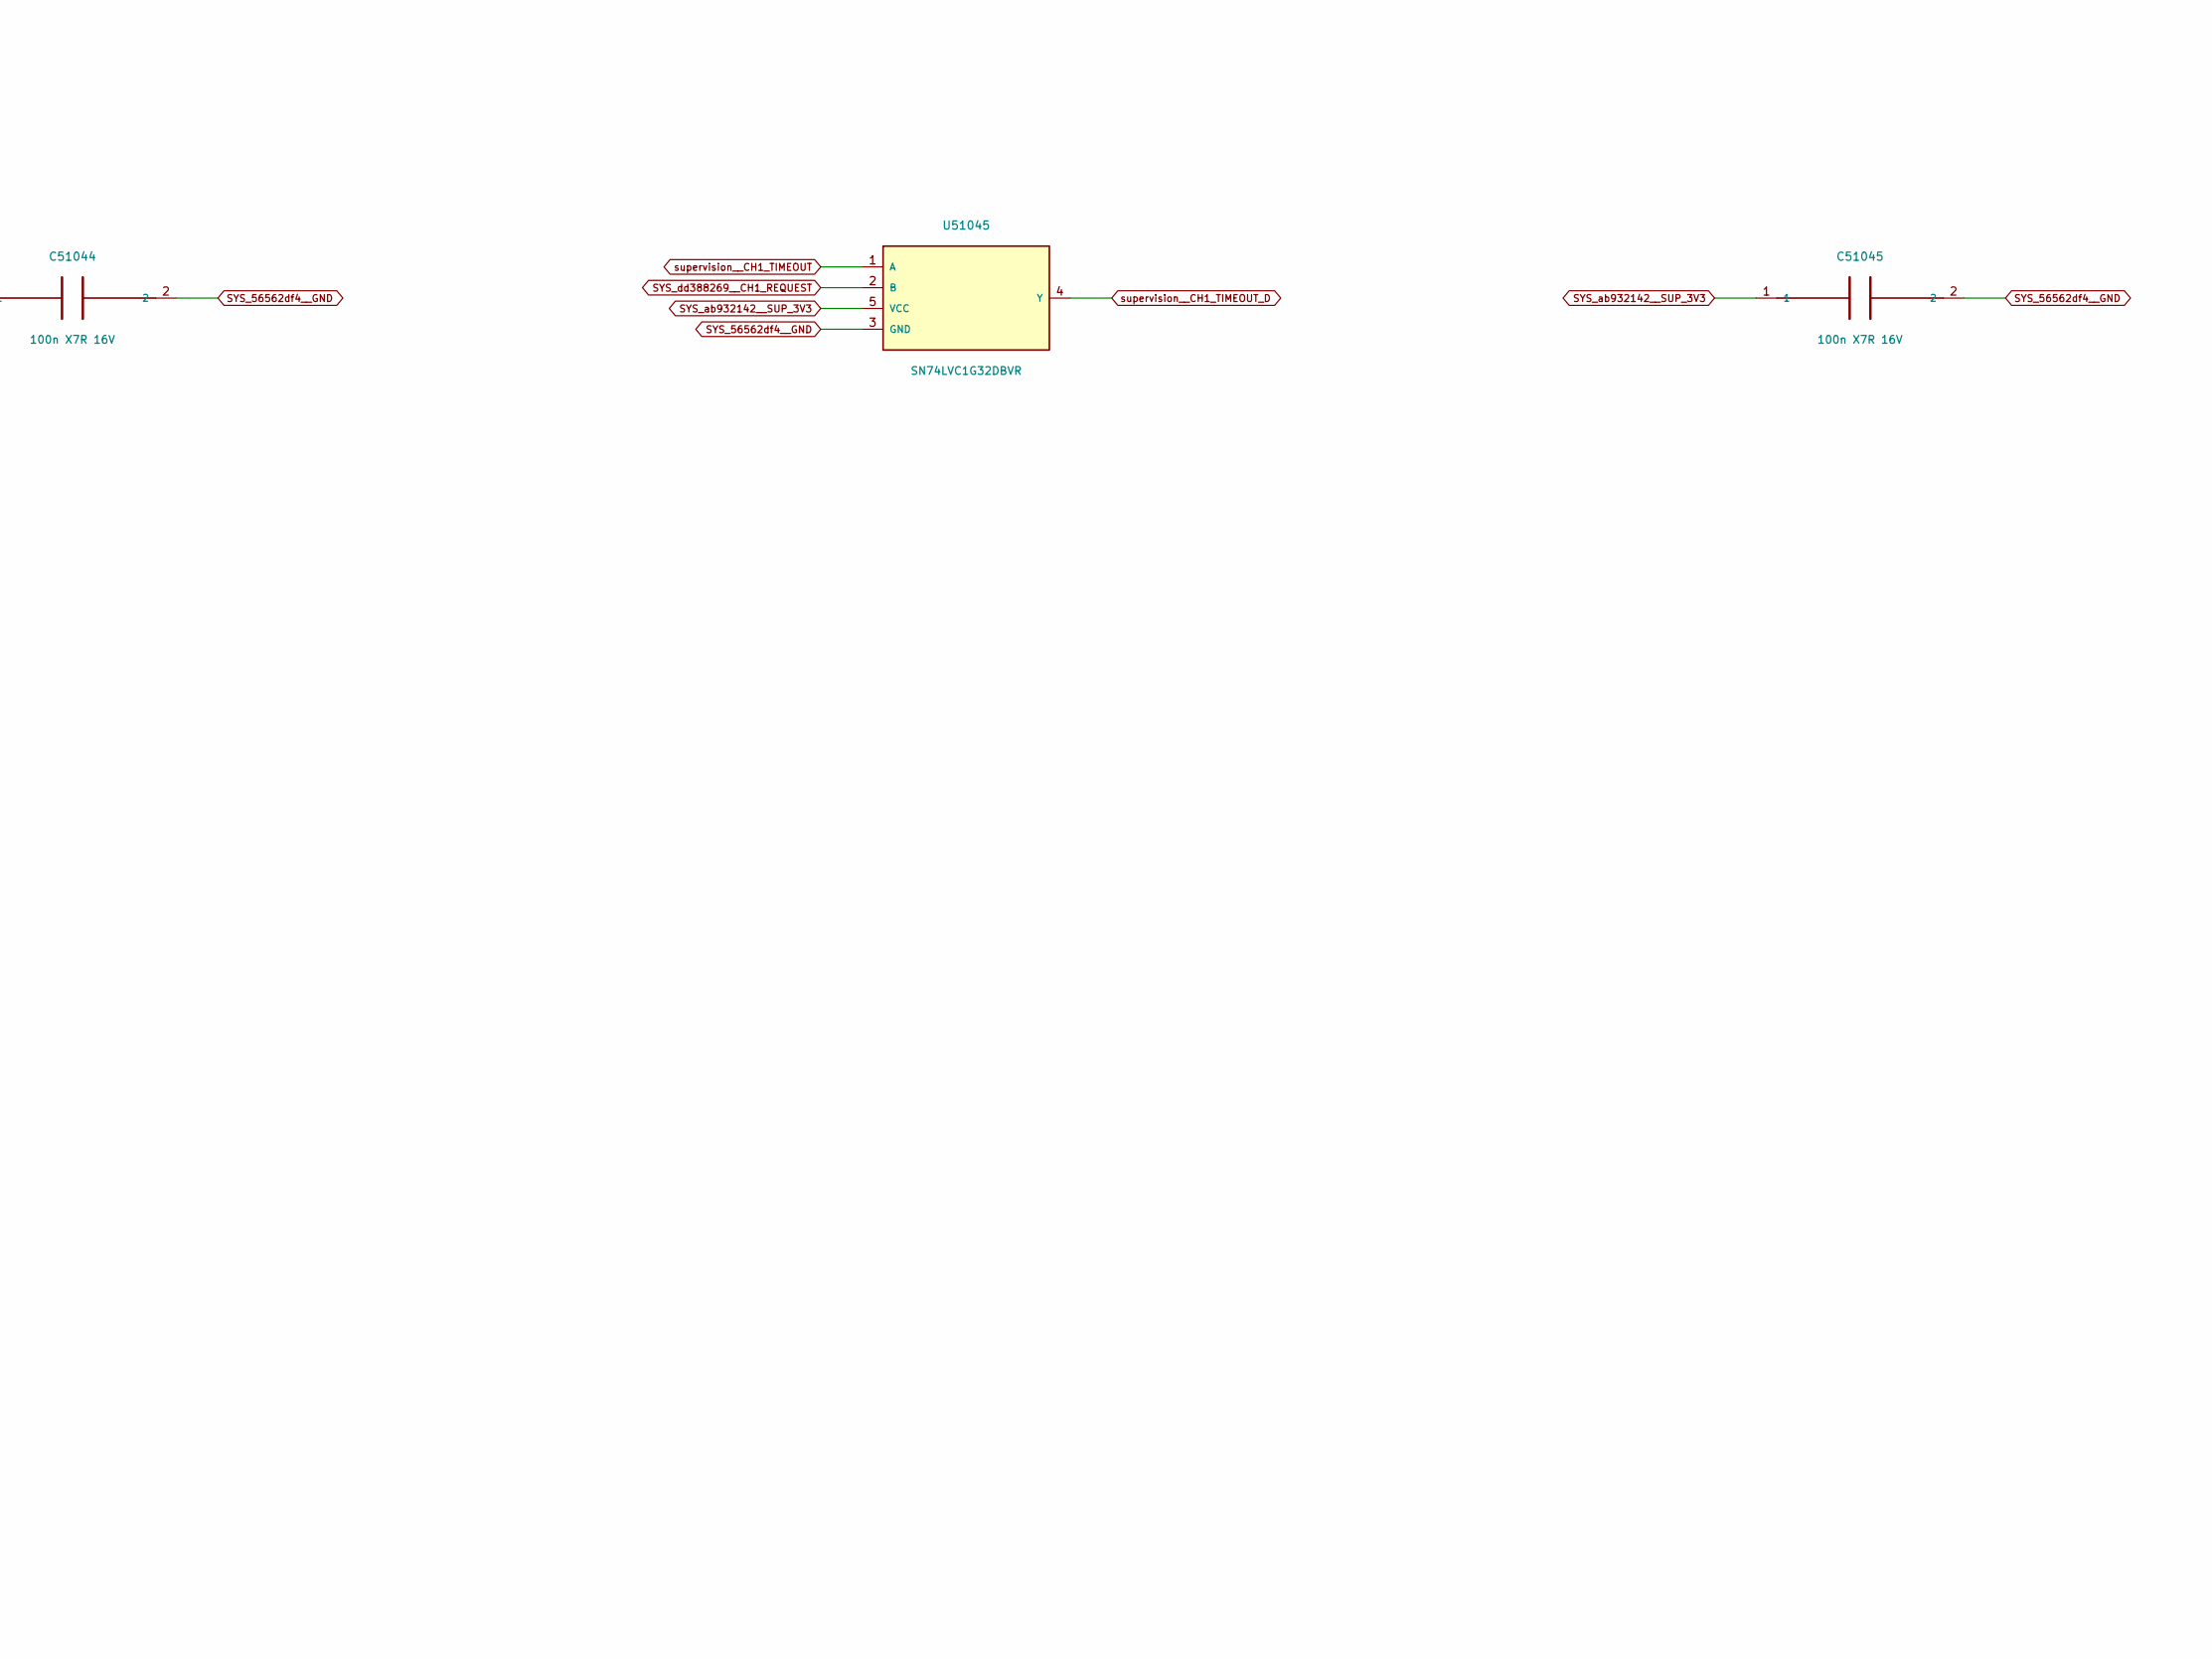
[picture p328: schematic duration.kicad_sch, ATO S4 / Secondary phase duration, part in row 2, column 2]

Parts:
C50800, C50801, C50810, C50811, C51042, C51043, C51044, C51045: 100n X7R 16V; C_0805_2012Metric
R58000, R58010: 195.4k 0.1%; R_0805_2012Metric
R58001, R58011: 976k 0.1%; R_0805_2012Metric
R58002, R58012: 182k 0.1%; R_0805_2012Metric
U50800, U50801: LTC6993HS6-1#TRPBF; TSOT-23-6
U50810, U50811: SN74LVC1G74DCUR; VSSOP-8_2.3x2mm_P0.5mm
U51042, U51044: SN74LVC1G04DBVR; SOT-23-5
U51043, U51045: SN74LVC1G32DBVR; SOT-23-5

Connections:
SYS_46ea5f03__CH0_REQUEST: U50800.1 (TRIG_RAW_REQUEST), U51043.2 (B); also elsewhere on the board
SYS_56562df4__GND: C50800.2, C50801.2, C50810.2, C50811.2, C51042.2, C51043.2, C51044.2, C51045.2, R58000.2, R58002.2, R58010.2, R58012.2, U50800.2 (GND), U50801.2 (GND), U50810.4 (GND), U50811.4 (GND), U51042.3 (GND), U51043.3 (GND), U51044.3 (GND), U51045.3 (GND); also elsewhere on the board
SYS_ab932142__SUP_3V3: C50800.1, C50801.1, C50810.1, C50811.1, C51042.1, C51043.1, C51044.1, C51045.1, R58001.1, R58011.1, U50800.5 (V+), U50801.5 (V+), U50810.7 (PRE_N), U50810.8 (VCC), U50811.7 (PRE_N), U50811.8 (VCC), U51042.5 (VCC), U51043.5 (VCC), U51044.5 (VCC), U51045.5 (VCC); also elsewhere on the board
SYS_dd388269__CH1_REQUEST: U50801.1 (TRIG_RAW_REQUEST), U51045.2 (B); also elsewhere on the board
supervision__CH0_SEC_DIV: R58001.2, R58002.1, U50800.4 (DIV)
supervision__CH0_SEC_N: U50810.1 (CLK), U51042.4 (Y)
supervision__CH0_SEC_SET: R58000.1, U50800.3 (SET)
supervision__CH0_SEC_TIMER: U50800.6 (OUT), U51042.2 (A); also elsewhere on the board
supervision__CH0_TIMEOUT: U50810.5 (Q), U51043.1 (A); also elsewhere on the board
supervision__CH0_TIMEOUT_D: U50810.2 (D), U51043.4 (Y)
supervision__CH1_SEC_DIV: R58011.2, R58012.1, U50801.4 (DIV)
supervision__CH1_SEC_N: U50811.1 (CLK), U51044.4 (Y)
supervision__CH1_SEC_SET: R58010.1, U50801.3 (SET)
supervision__CH1_SEC_TIMER: U50801.6 (OUT), U51044.2 (A); also elsewhere on the board
supervision__CH1_TIMEOUT: U50811.5 (Q), U51045.1 (A); also elsewhere on the board
supervision__CH1_TIMEOUT_D: U50811.2 (D), U51045.4 (Y)
supervision__TIMEOUT_CLR_N: U50810.6 (CLR_N), U50811.6 (CLR_N); also elsewhere on the board

Notes on the sheet:
DIGITAL SCCI ENGINEERING / ARTIFICIAL LOADS / NATIVE INDEPENDENT SUPERVISION
18 guarded stimulation conductors, 17 measured RHD-side windows; conditional healthy-switch blanking is not proven isolation.
All net labels are native electrical connections. Actual physical delay, leakage, failed switches and shared supplies remain bounded limitations.
Independent phase cap, heartbeat watchdog, rail windows and deliberate rearm have different functions. No automatic retry or reverse pulse.
