pratham-cloud-ctrl/Project-ATO/electronics/stage4/integrated-pcb/boards/supervision/supervision.kicad_pcb

## KiCad design electronics/stage4/integrated-pcb/boards/supervision/supervision.kicad_pcb (continued)

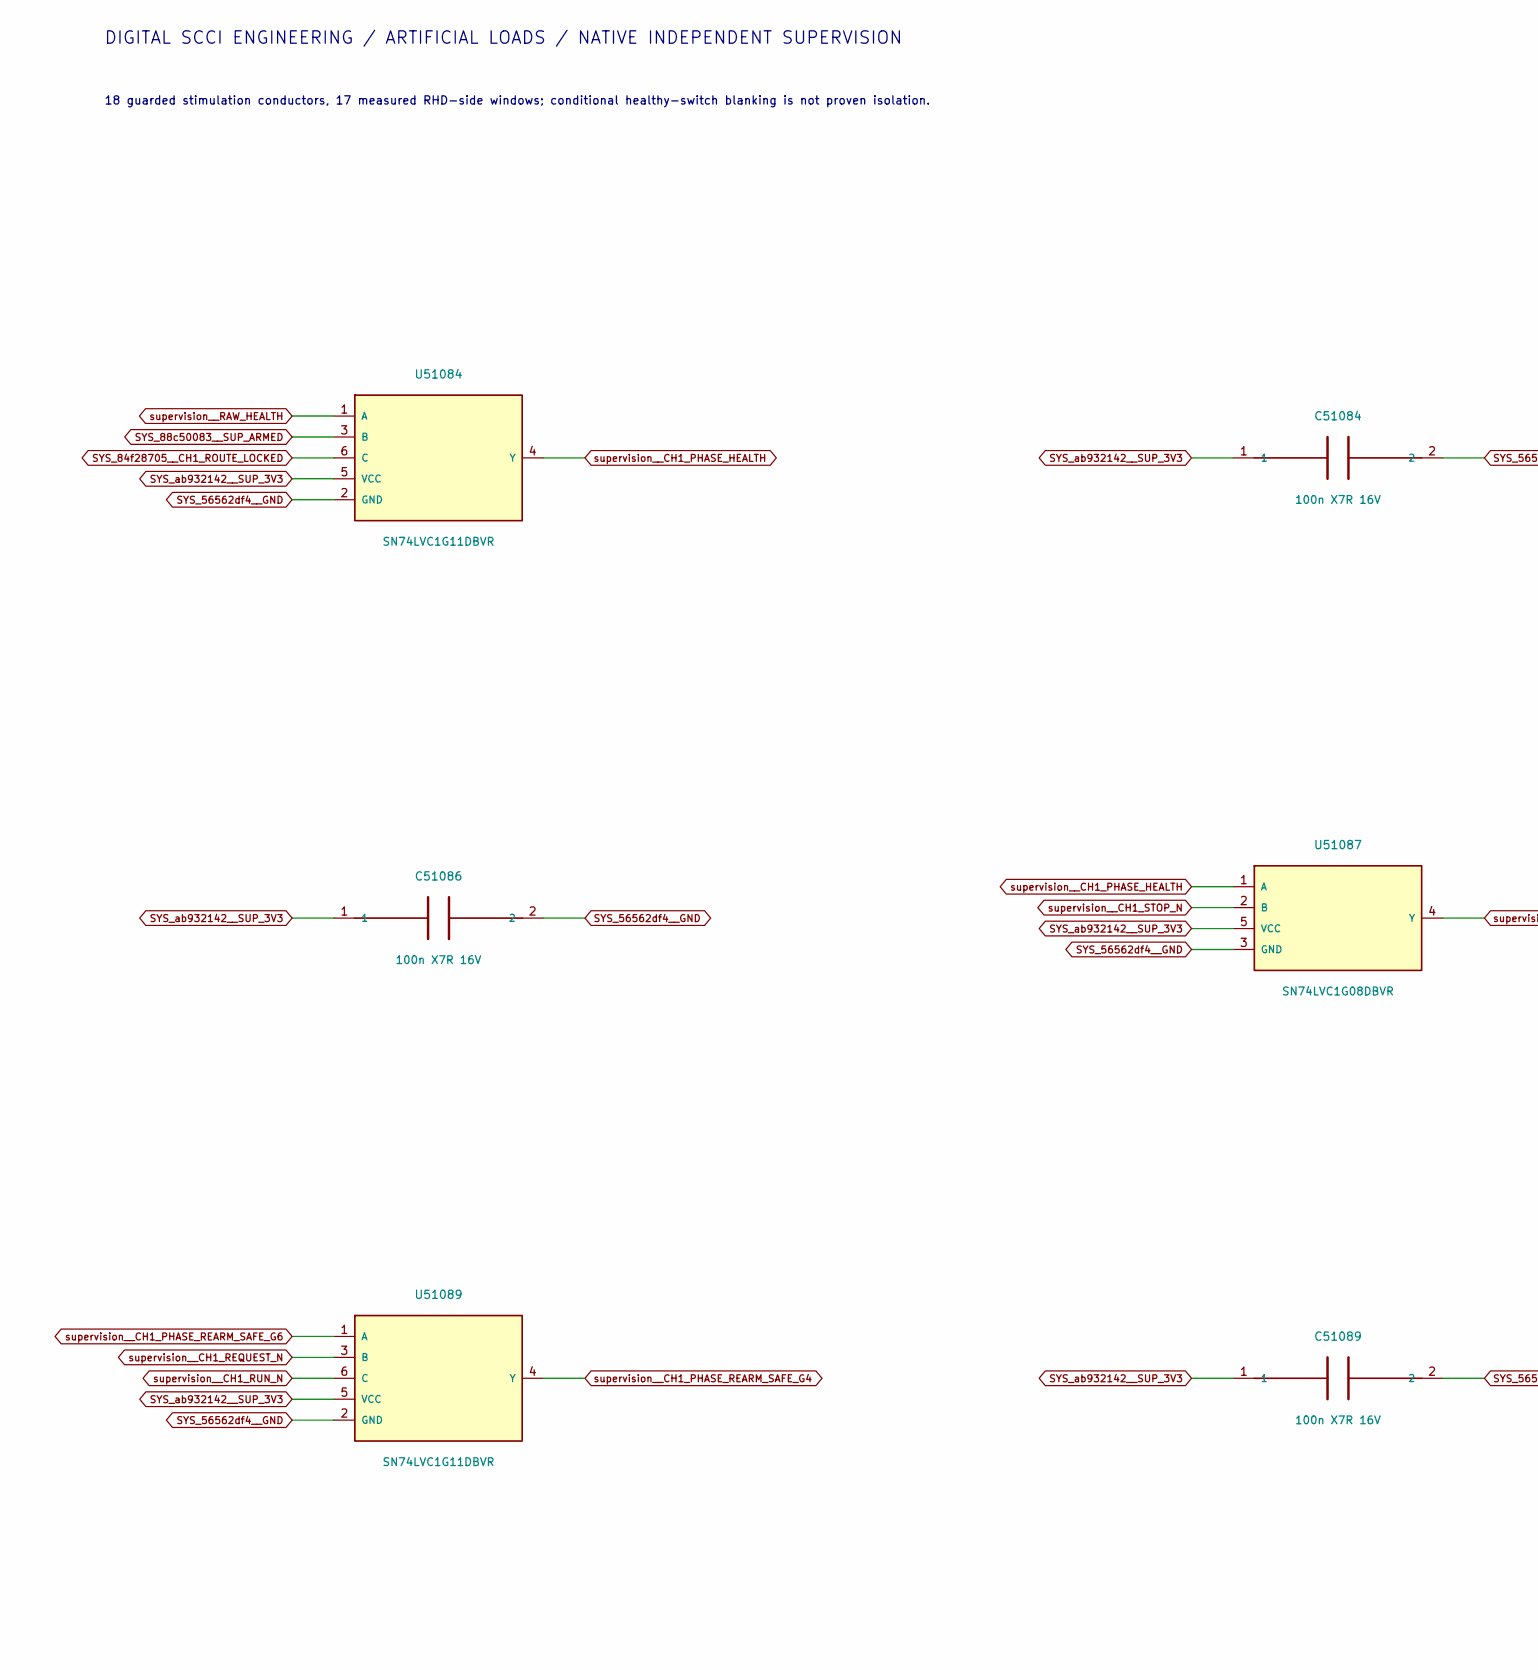
[picture p343: schematic phase1.kicad_sch, ATO S4 / Source 1 phase permission, part in row 1, column 1]

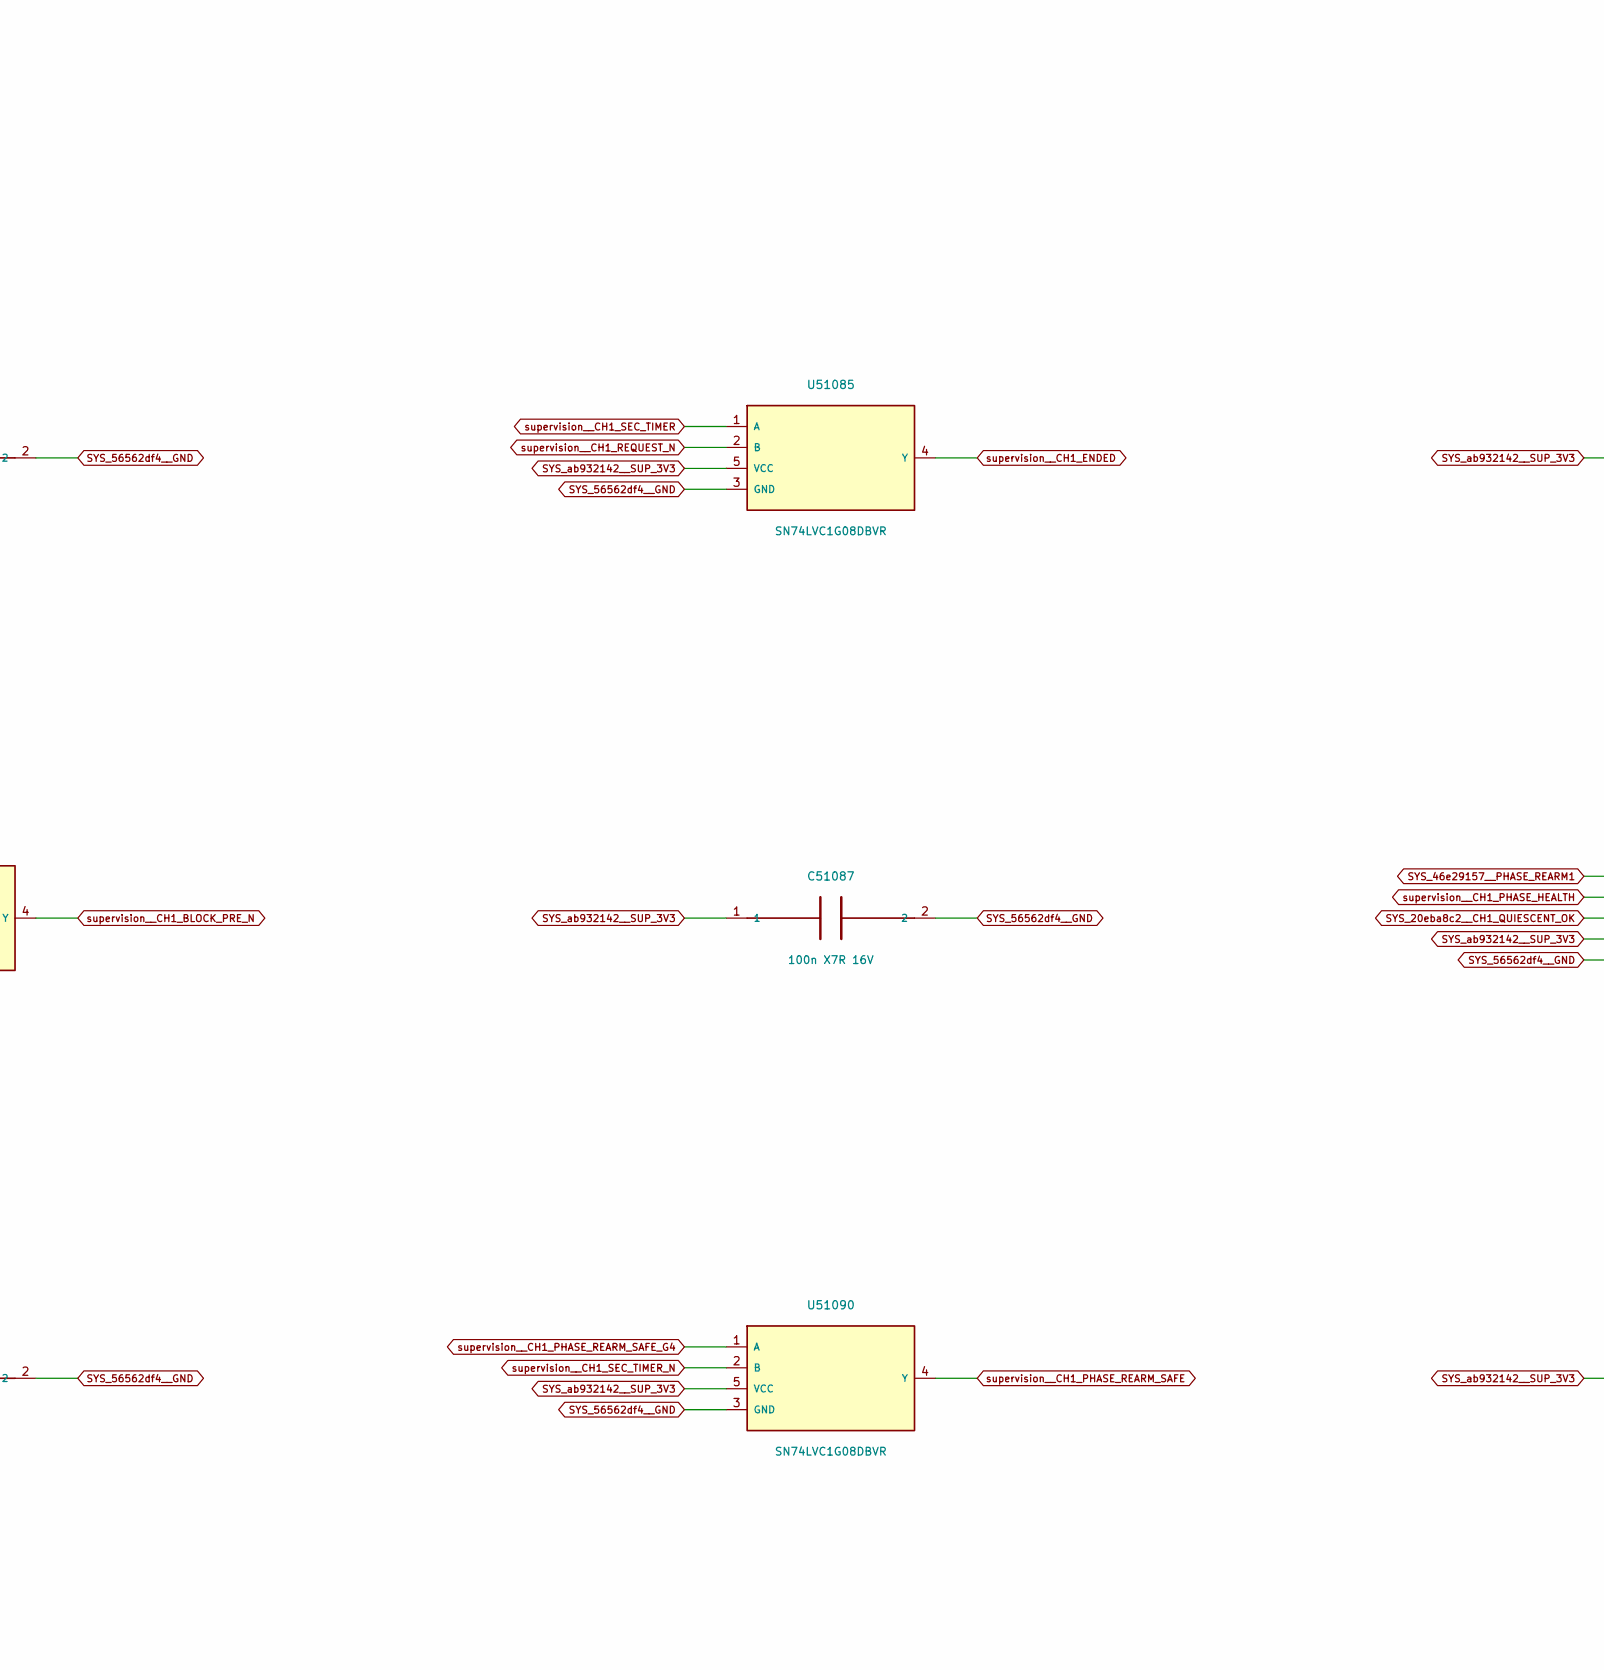
[picture p344: schematic phase1.kicad_sch, ATO S4 / Source 1 phase permission, part in row 1, column 2]

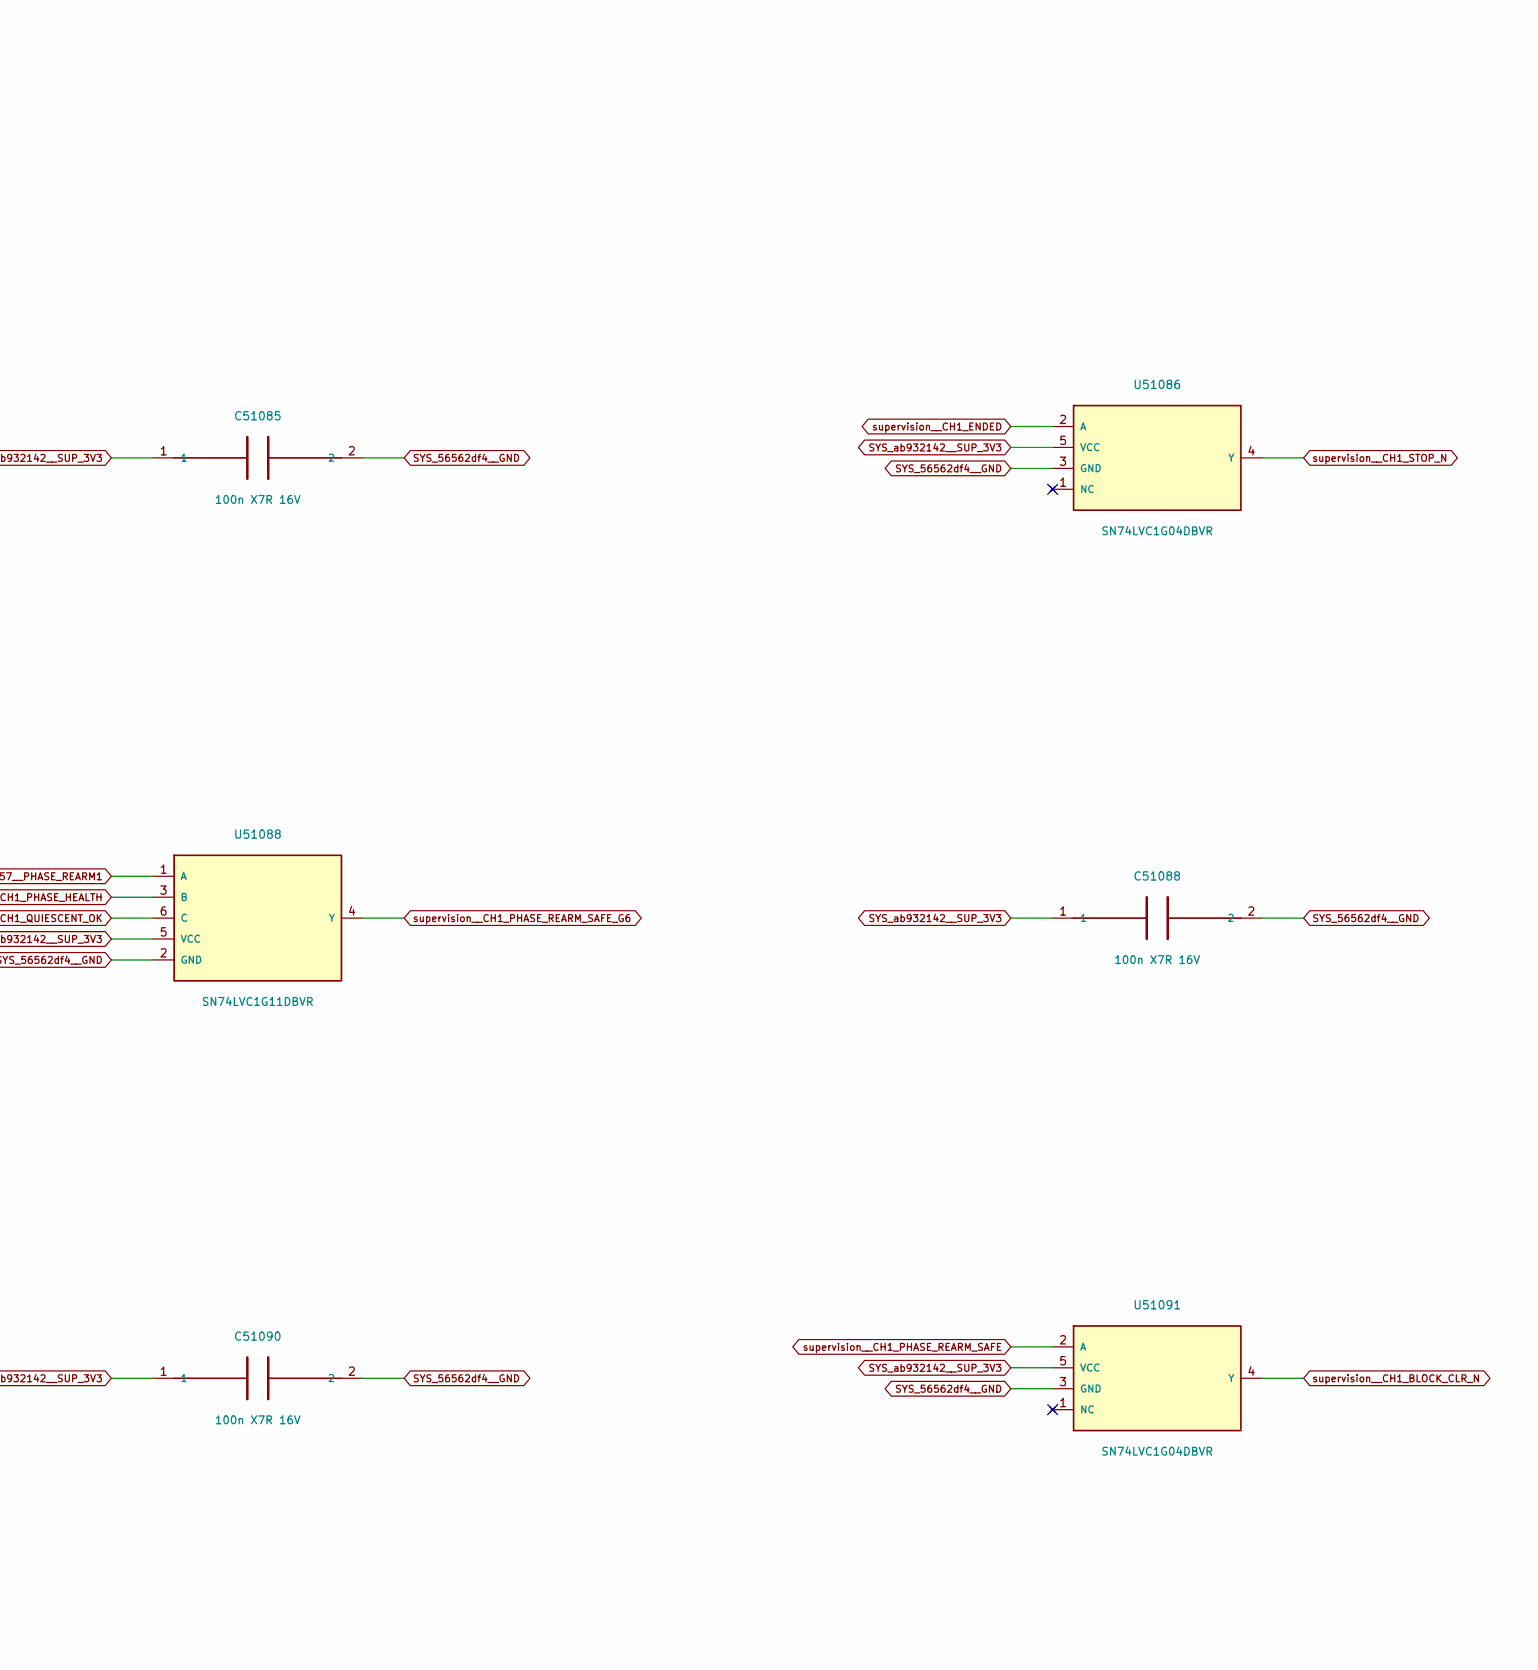
[picture p345: schematic phase1.kicad_sch, ATO S4 / Source 1 phase permission, part in row 1, column 3]

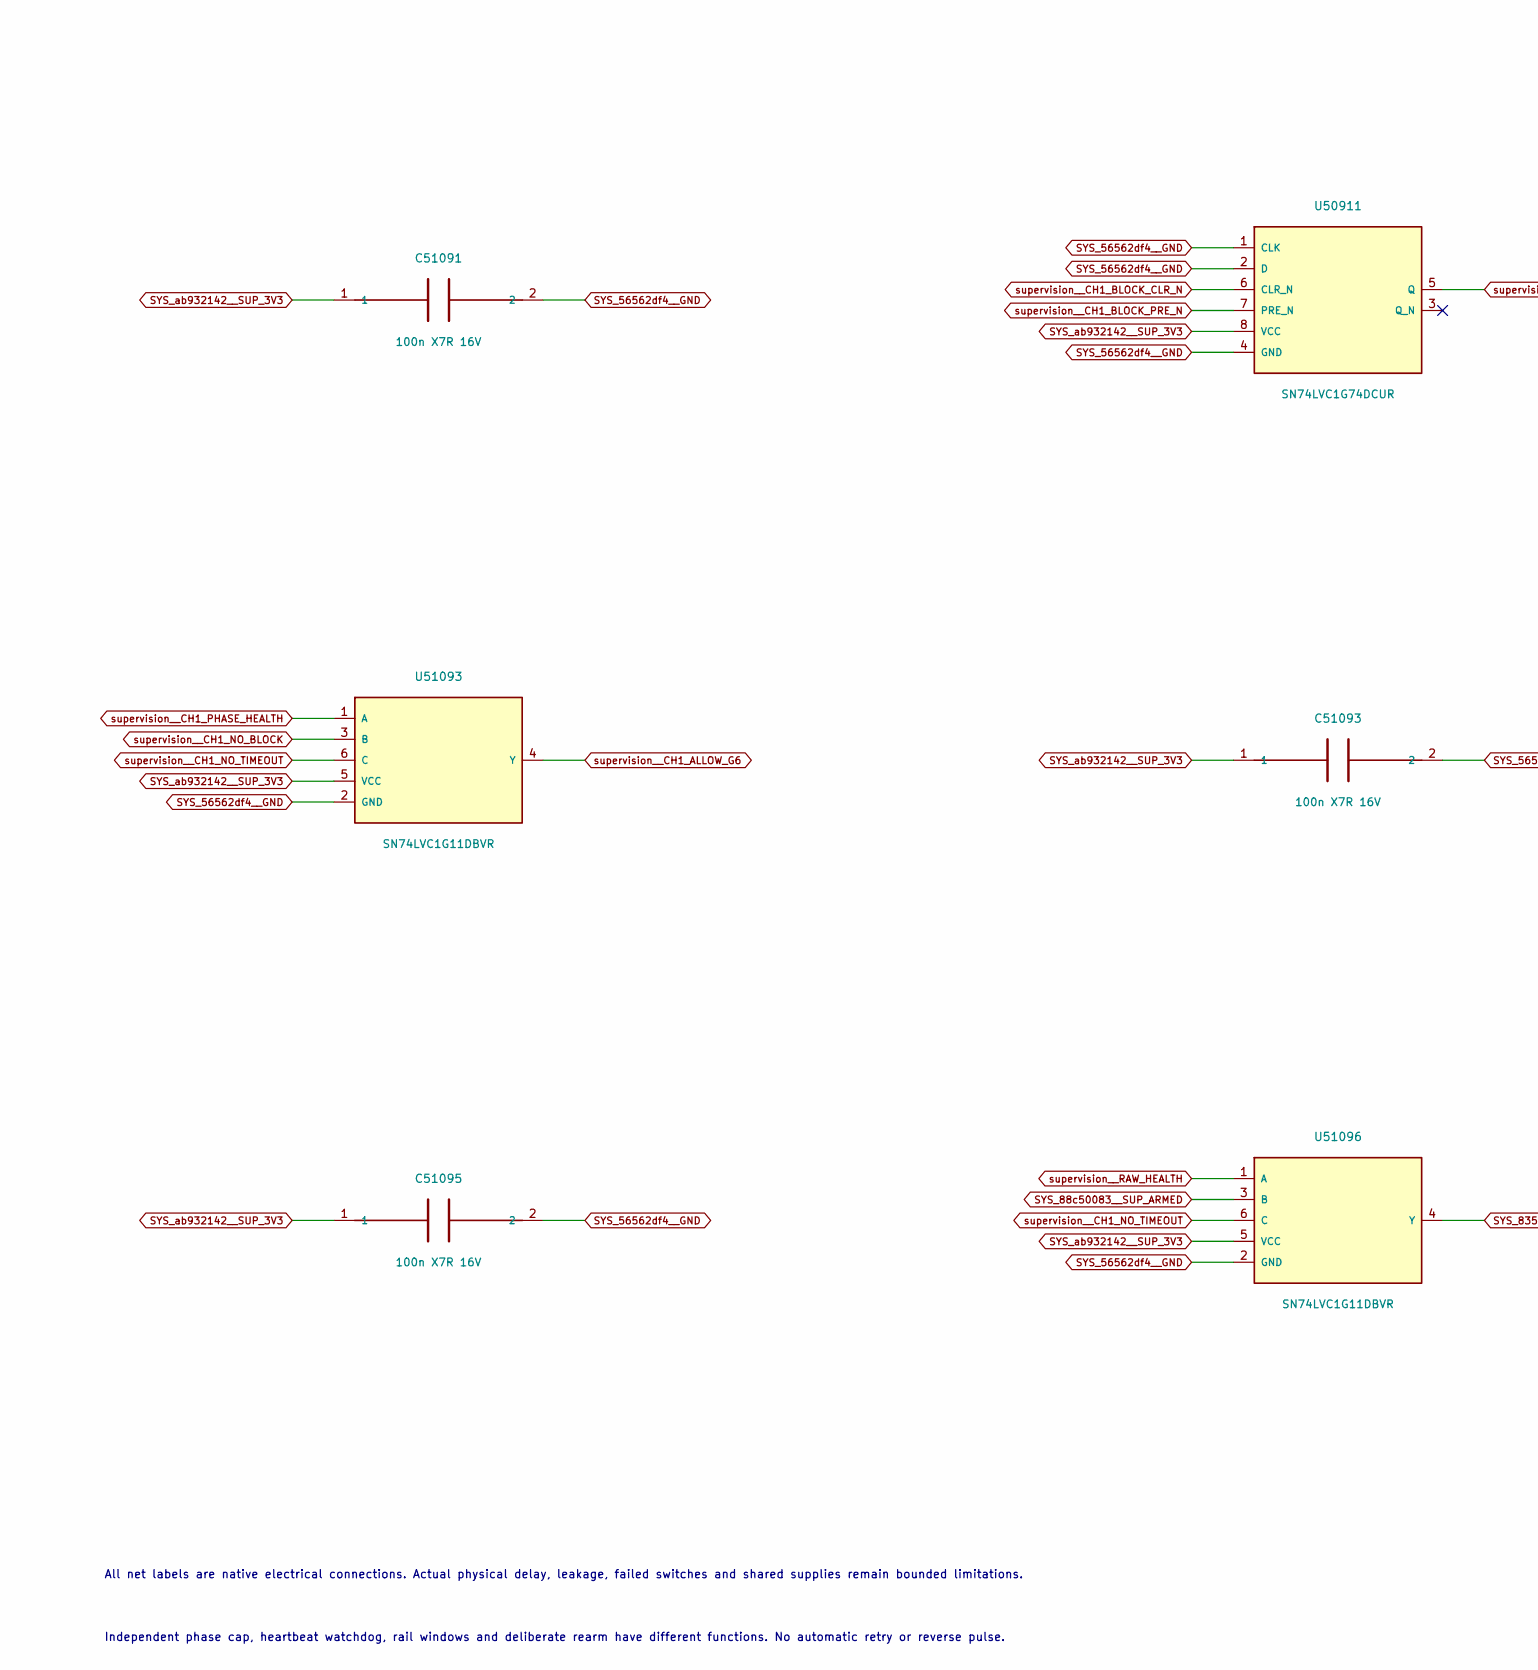
[picture p346: schematic phase1.kicad_sch, ATO S4 / Source 1 phase permission, part in row 2, column 1]

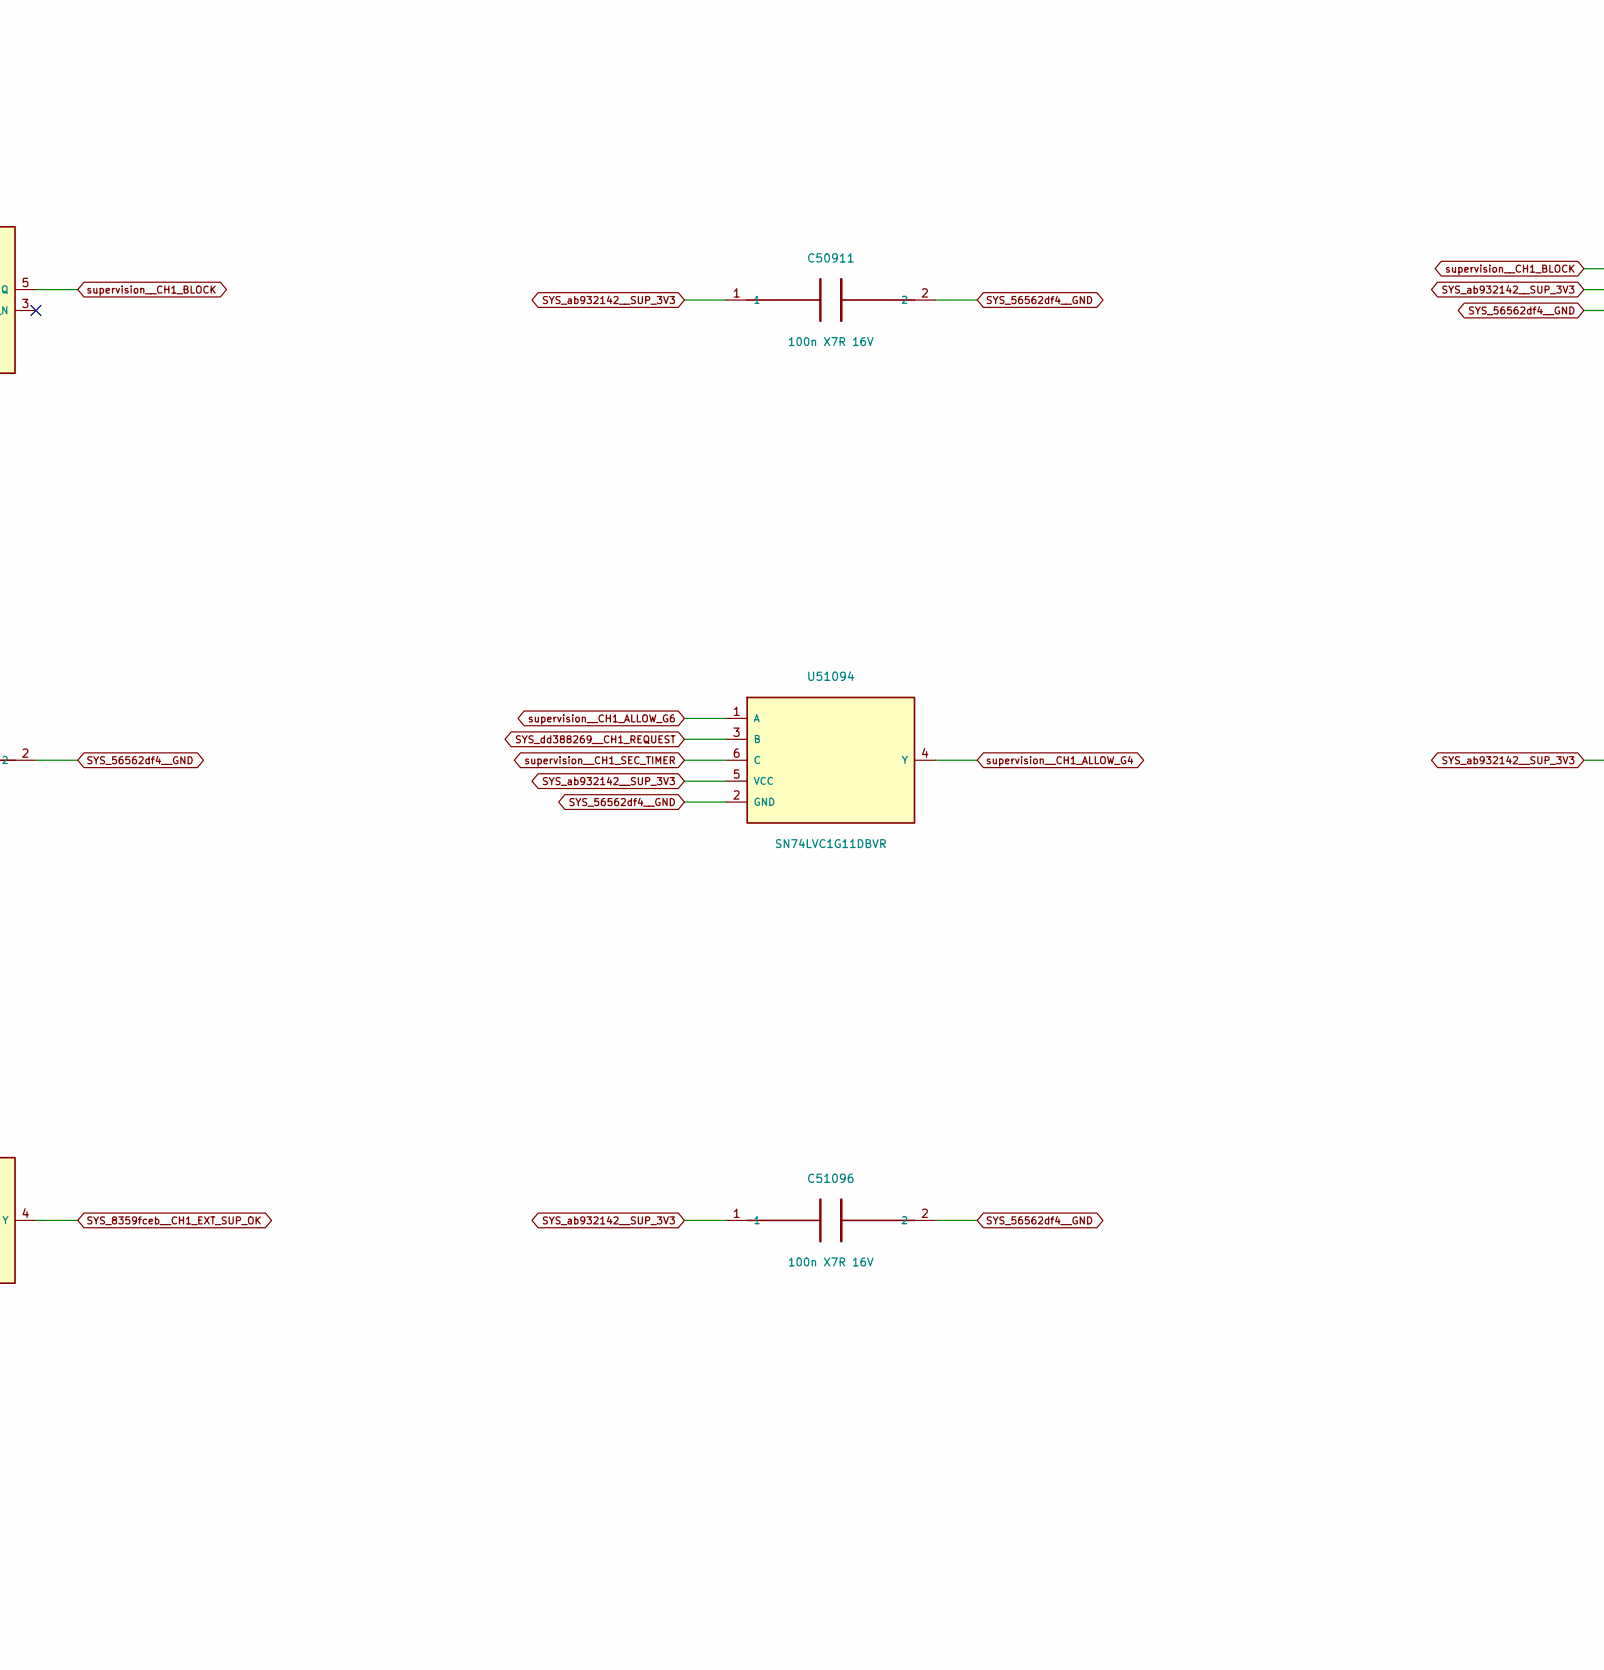
[picture p347: schematic phase1.kicad_sch, ATO S4 / Source 1 phase permission, part in row 2, column 2]

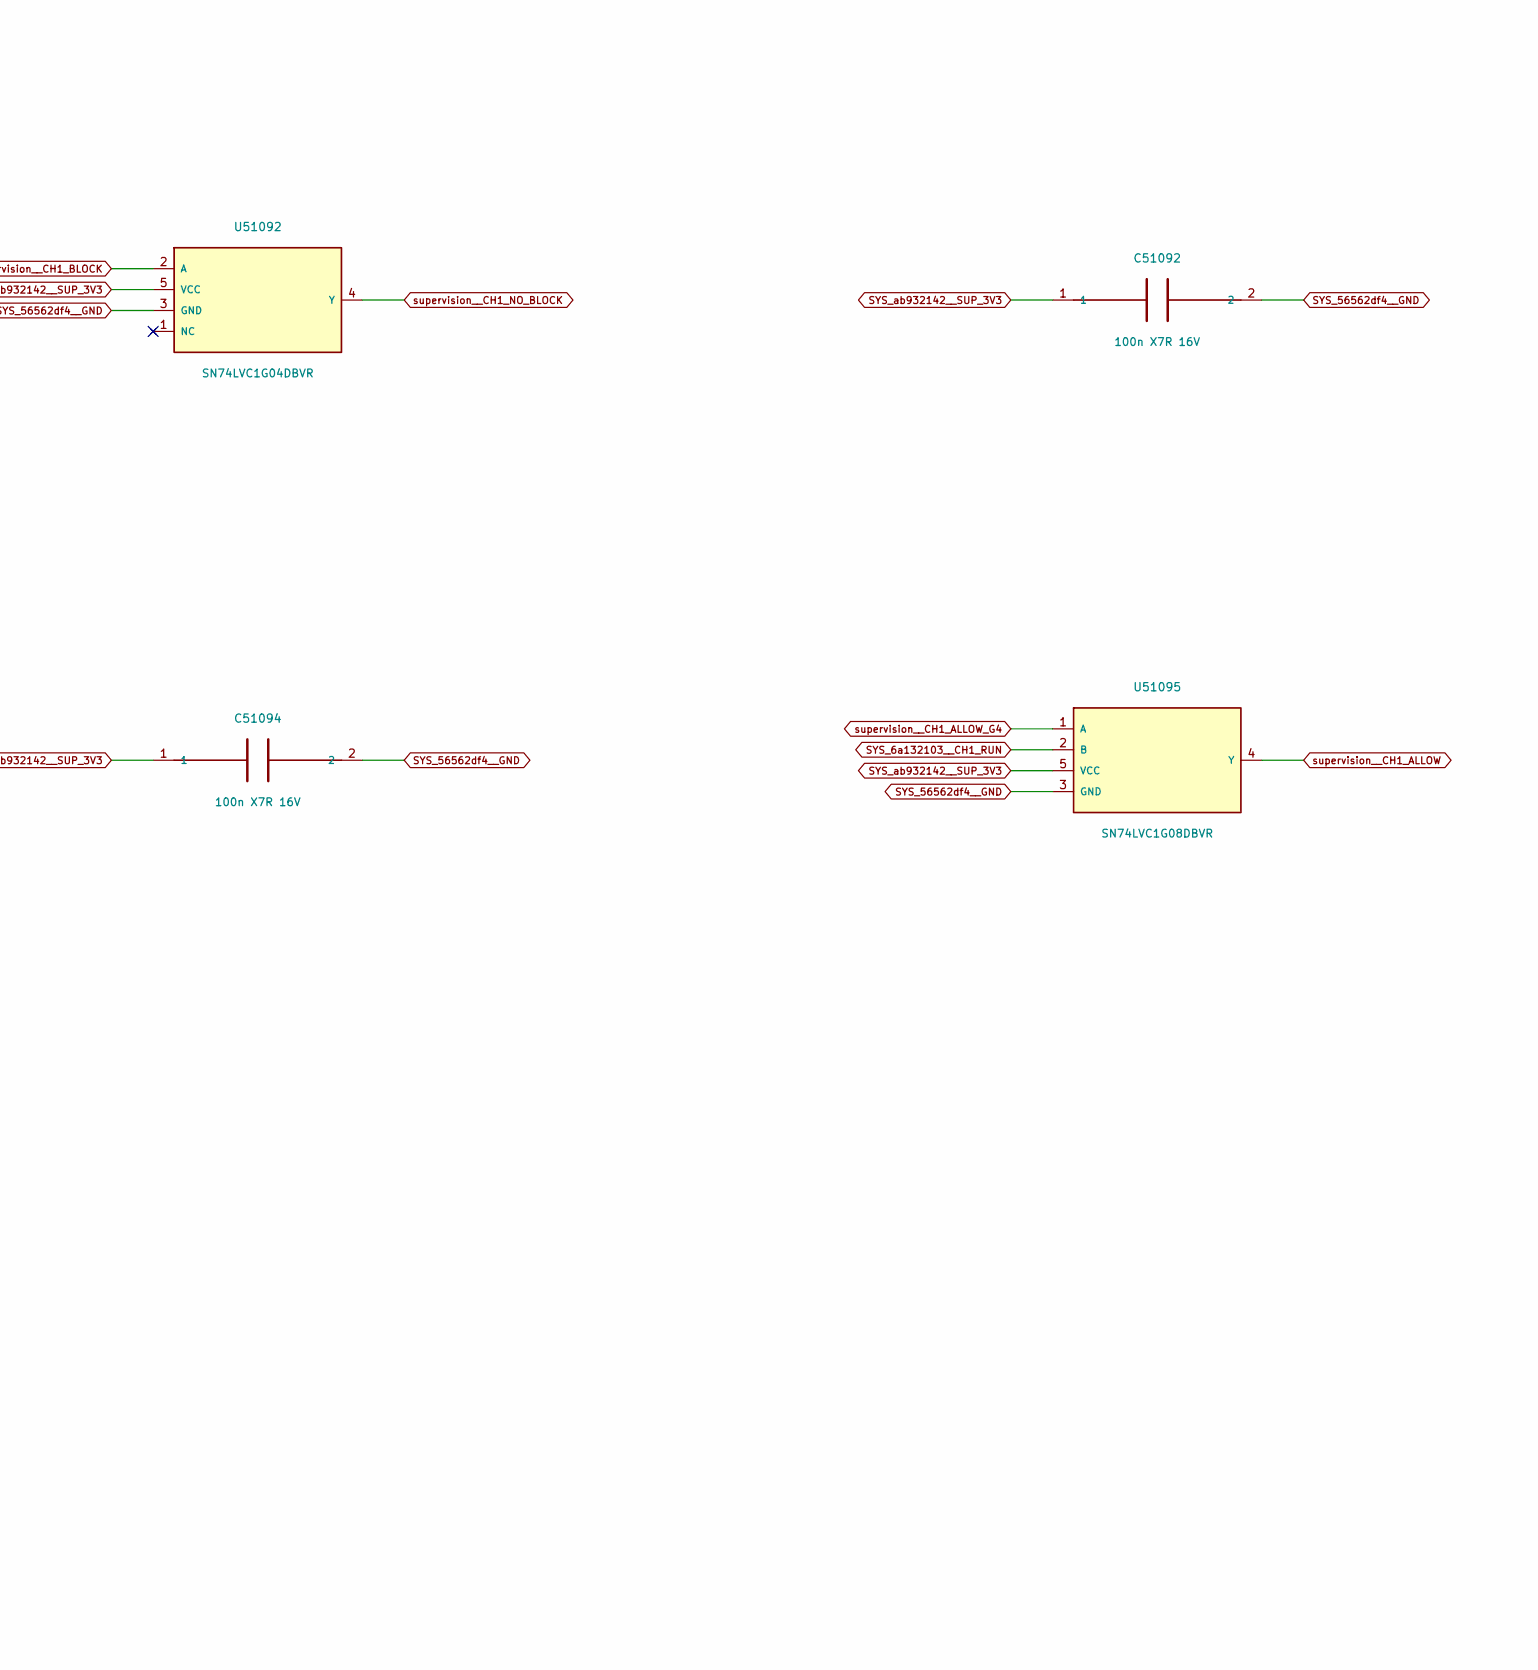
[picture p348: schematic phase1.kicad_sch, ATO S4 / Source 1 phase permission, part in row 2, column 3]

Parts:
C50911, C51084, C51085, C51086, C51087, C51088, C51089, C51090, C51091, C51092, C51093, C51094, C51095, C51096: 100n X7R 16V; C_0805_2012Metric
U50911: SN74LVC1G74DCUR; VSSOP-8_2.3x2mm_P0.5mm
U51084, U51088, U51089, U51093, U51094, U51096: SN74LVC1G11DBVR; SOT-23-6
U51085, U51087, U51090, U51095: SN74LVC1G08DBVR; SOT-23-5
U51086, U51091, U51092: SN74LVC1G04DBVR; SOT-23-5

Connections:
SYS_6a132103__CH1_RUN: U51095.2 (B); also elsewhere on the board
SYS_20eba8c2__CH1_QUIESCENT_OK: U51088.6 (C); also elsewhere on the board
SYS_46e29157__PHASE_REARM1: U51088.1 (A); also elsewhere on the board
SYS_84f28705__CH1_ROUTE_LOCKED: U51084.6 (C); also elsewhere on the board
SYS_88c50083__SUP_ARMED: U51084.3 (B), U51096.3 (B); also elsewhere on the board
SYS_8359fceb__CH1_EXT_SUP_OK: U51096.4 (Y); also elsewhere on the board
SYS_56562df4__GND: C50911.2, C51084.2, C51085.2, C51086.2, C51087.2, C51088.2, C51089.2, C51090.2, C51091.2, C51092.2, C51093.2, C51094.2, C51095.2, C51096.2, U50911.1 (CLK), U50911.2 (D), U50911.4 (GND), U51084.2 (GND), U51085.3 (GND), U51086.3 (GND), U51087.3 (GND), U51088.2 (GND), U51089.2 (GND), U51090.3 (GND), U51091.3 (GND), U51092.3 (GND), U51093.2 (GND), U51094.2 (GND), U51095.3 (GND), U51096.2 (GND); also elsewhere on the board
SYS_ab932142__SUP_3V3: C50911.1, C51084.1, C51085.1, C51086.1, C51087.1, C51088.1, C51089.1, C51090.1, C51091.1, C51092.1, C51093.1, C51094.1, C51095.1, C51096.1, U50911.8 (VCC), U51084.5 (VCC), U51085.5 (VCC), U51086.5 (VCC), U51087.5 (VCC), U51088.5 (VCC), U51089.5 (VCC), U51090.5 (VCC), U51091.5 (VCC), U51092.5 (VCC), U51093.5 (VCC), U51094.5 (VCC), U51095.5 (VCC), U51096.5 (VCC); also elsewhere on the board
SYS_dd388269__CH1_REQUEST: U51094.3 (B); also elsewhere on the board
supervision__CH1_ALLOW: U51095.4 (Y); also elsewhere on the board
supervision__CH1_ALLOW_G4: U51094.4 (Y), U51095.1 (A)
supervision__CH1_ALLOW_G6: U51093.4 (Y), U51094.1 (A)
supervision__CH1_BLOCK: U50911.5 (Q), U51092.2 (A)
supervision__CH1_BLOCK_CLR_N: U50911.6 (CLR_N), U51091.4 (Y)
supervision__CH1_BLOCK_PRE_N: U50911.7 (PRE_N), U51087.4 (Y)
supervision__CH1_ENDED: U51085.4 (Y), U51086.2 (A)
supervision__CH1_NO_BLOCK: U51092.4 (Y), U51093.3 (B)
supervision__CH1_NO_TIMEOUT: U51093.6 (C), U51096.6 (C); also elsewhere on the board
supervision__CH1_PHASE_HEALTH: U51084.4 (Y), U51087.1 (A), U51088.3 (B), U51093.1 (A)
supervision__CH1_PHASE_REARM_SAFE: U51090.4 (Y), U51091.2 (A)
supervision__CH1_PHASE_REARM_SAFE_G4: U51089.4 (Y), U51090.1 (A)
supervision__CH1_PHASE_REARM_SAFE_G6: U51088.4 (Y), U51089.1 (A)
supervision__CH1_REQUEST_N: U51085.2 (B), U51089.3 (B); also elsewhere on the board
supervision__CH1_RUN_N: U51089.6 (C); also elsewhere on the board
supervision__CH1_SEC_TIMER: U51085.1 (A), U51094.6 (C); also elsewhere on the board
supervision__CH1_SEC_TIMER_N: U51090.2 (B); also elsewhere on the board
supervision__CH1_STOP_N: U51086.4 (Y), U51087.2 (B)
supervision__RAW_HEALTH: U51084.1 (A), U51096.1 (A); also elsewhere on the board

Notes on the sheet:
DIGITAL SCCI ENGINEERING / ARTIFICIAL LOADS / NATIVE INDEPENDENT SUPERVISION
18 guarded stimulation conductors, 17 measured RHD-side windows; conditional healthy-switch blanking is not proven isolation.
All net labels are native electrical connections. Actual physical delay, leakage, failed switches and shared supplies remain bounded limitations.
Independent phase cap, heartbeat watchdog, rail windows and deliberate rearm have different functions. No automatic retry or reverse pulse.
