pratham-cloud-ctrl/Project-ATO/electronics/stage4/integrated-pcb/boards/monitoring-transport/monitoring_transport.kicad_pcb

## KiCad design electronics/stage4/integrated-pcb/boards/monitoring-transport/monitoring_transport.kicad_pcb (2026-10-16)

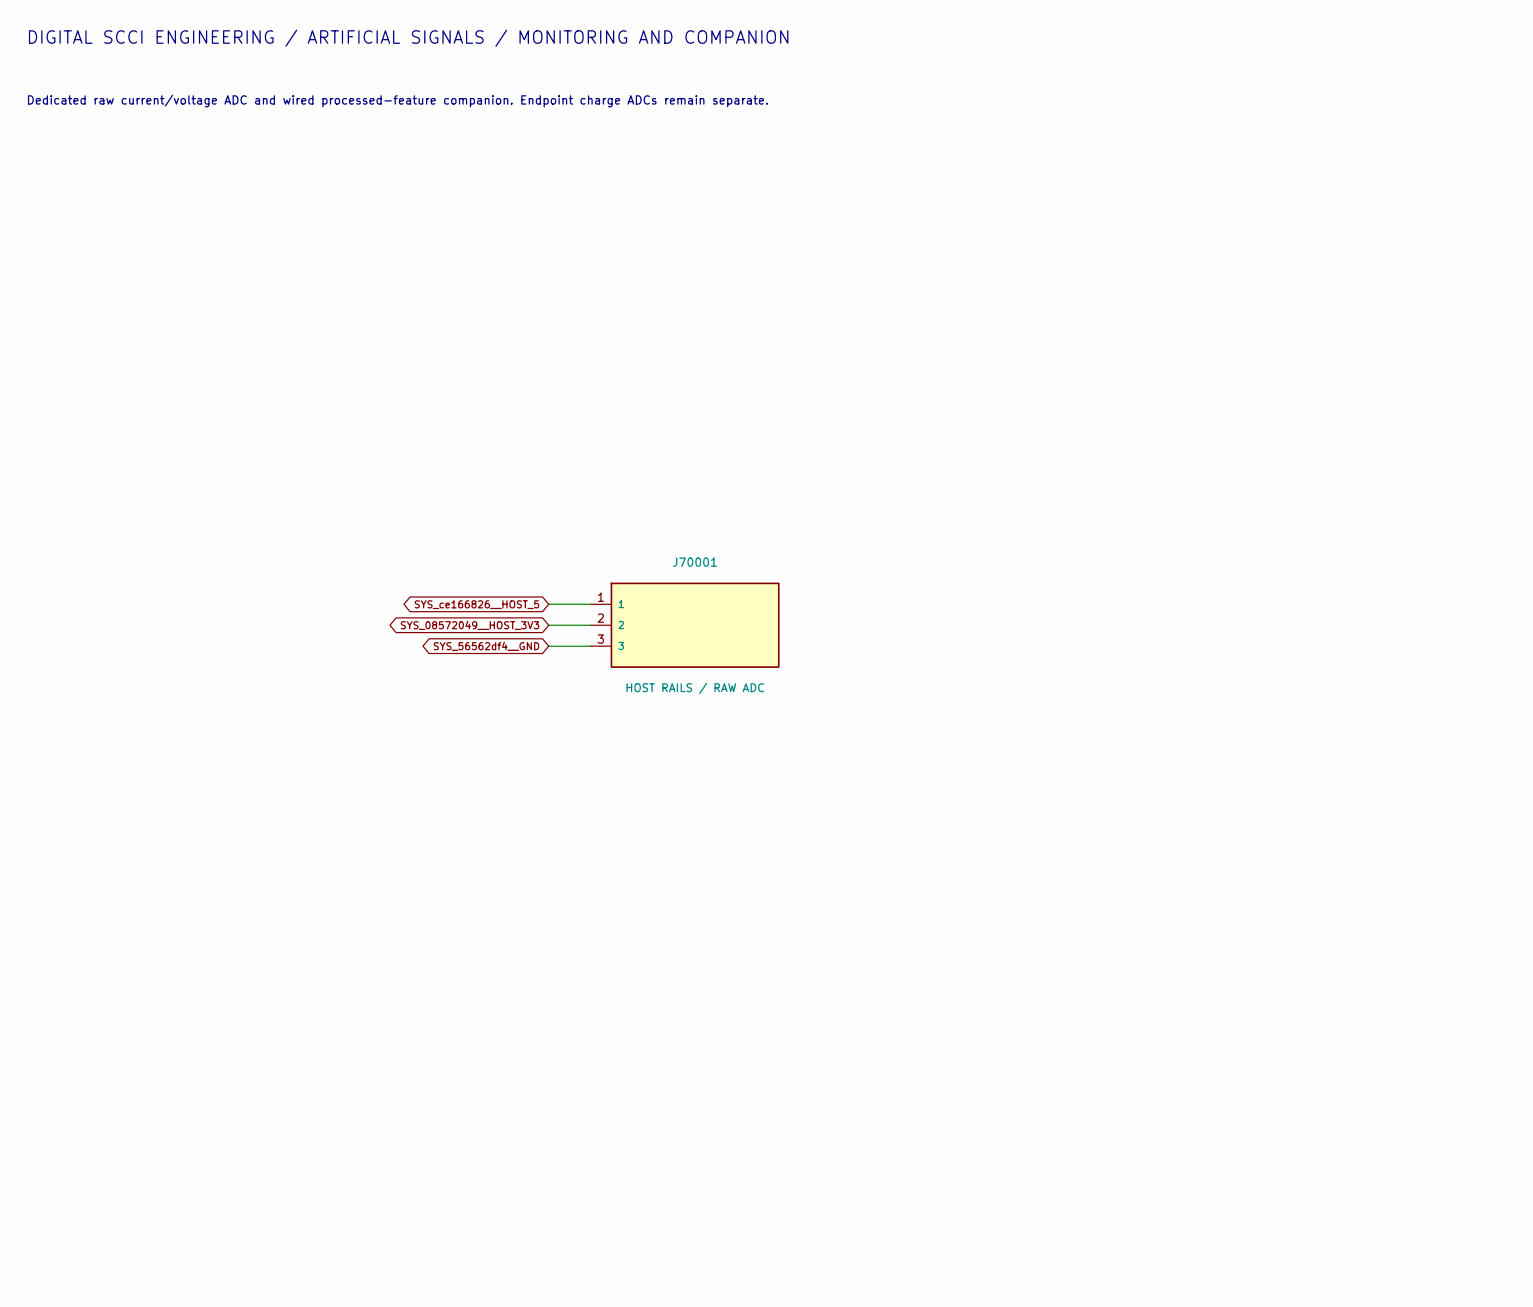
[picture p379: schematic monitoring_transport.kicad_sch, ATO S4 / Existing package and host endpoints, part in row 1, column 1]

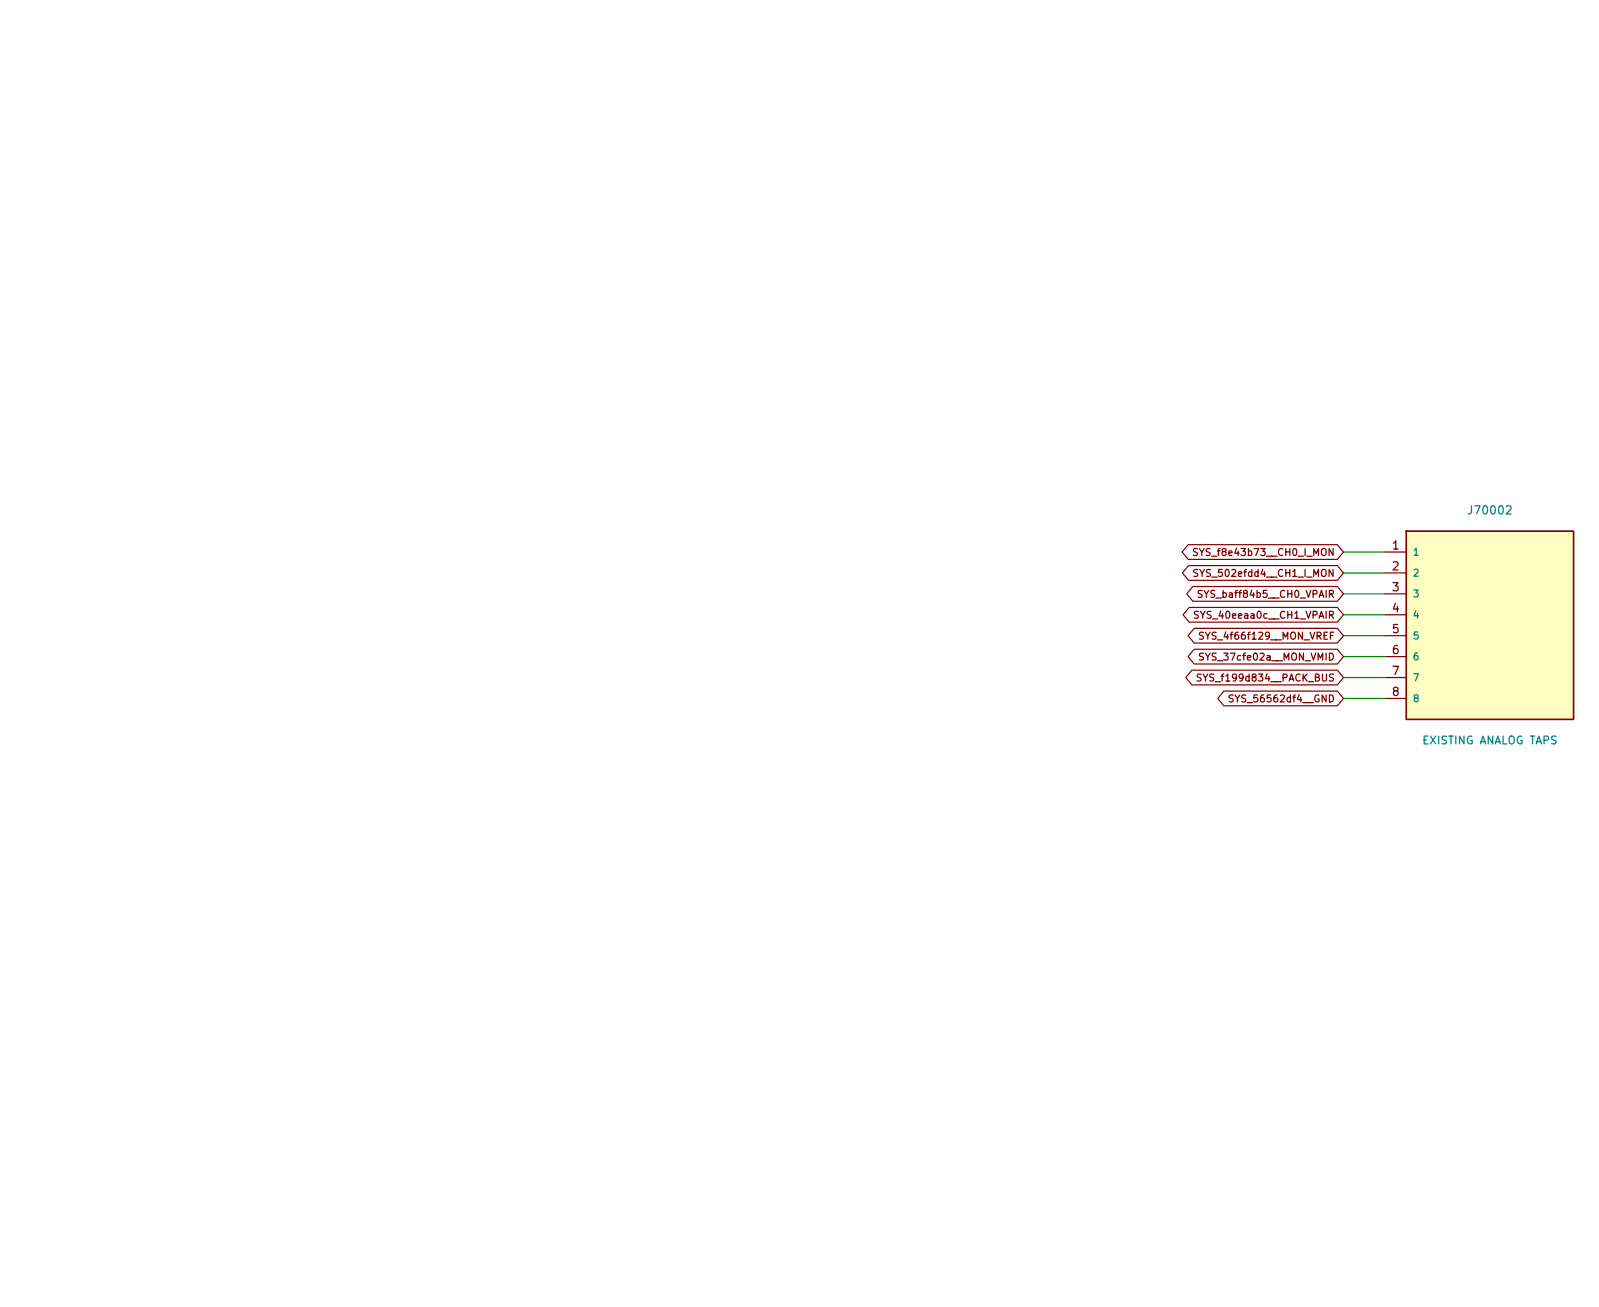
[picture p380: schematic monitoring_transport.kicad_sch, ATO S4 / Existing package and host endpoints, part in row 1, column 2]

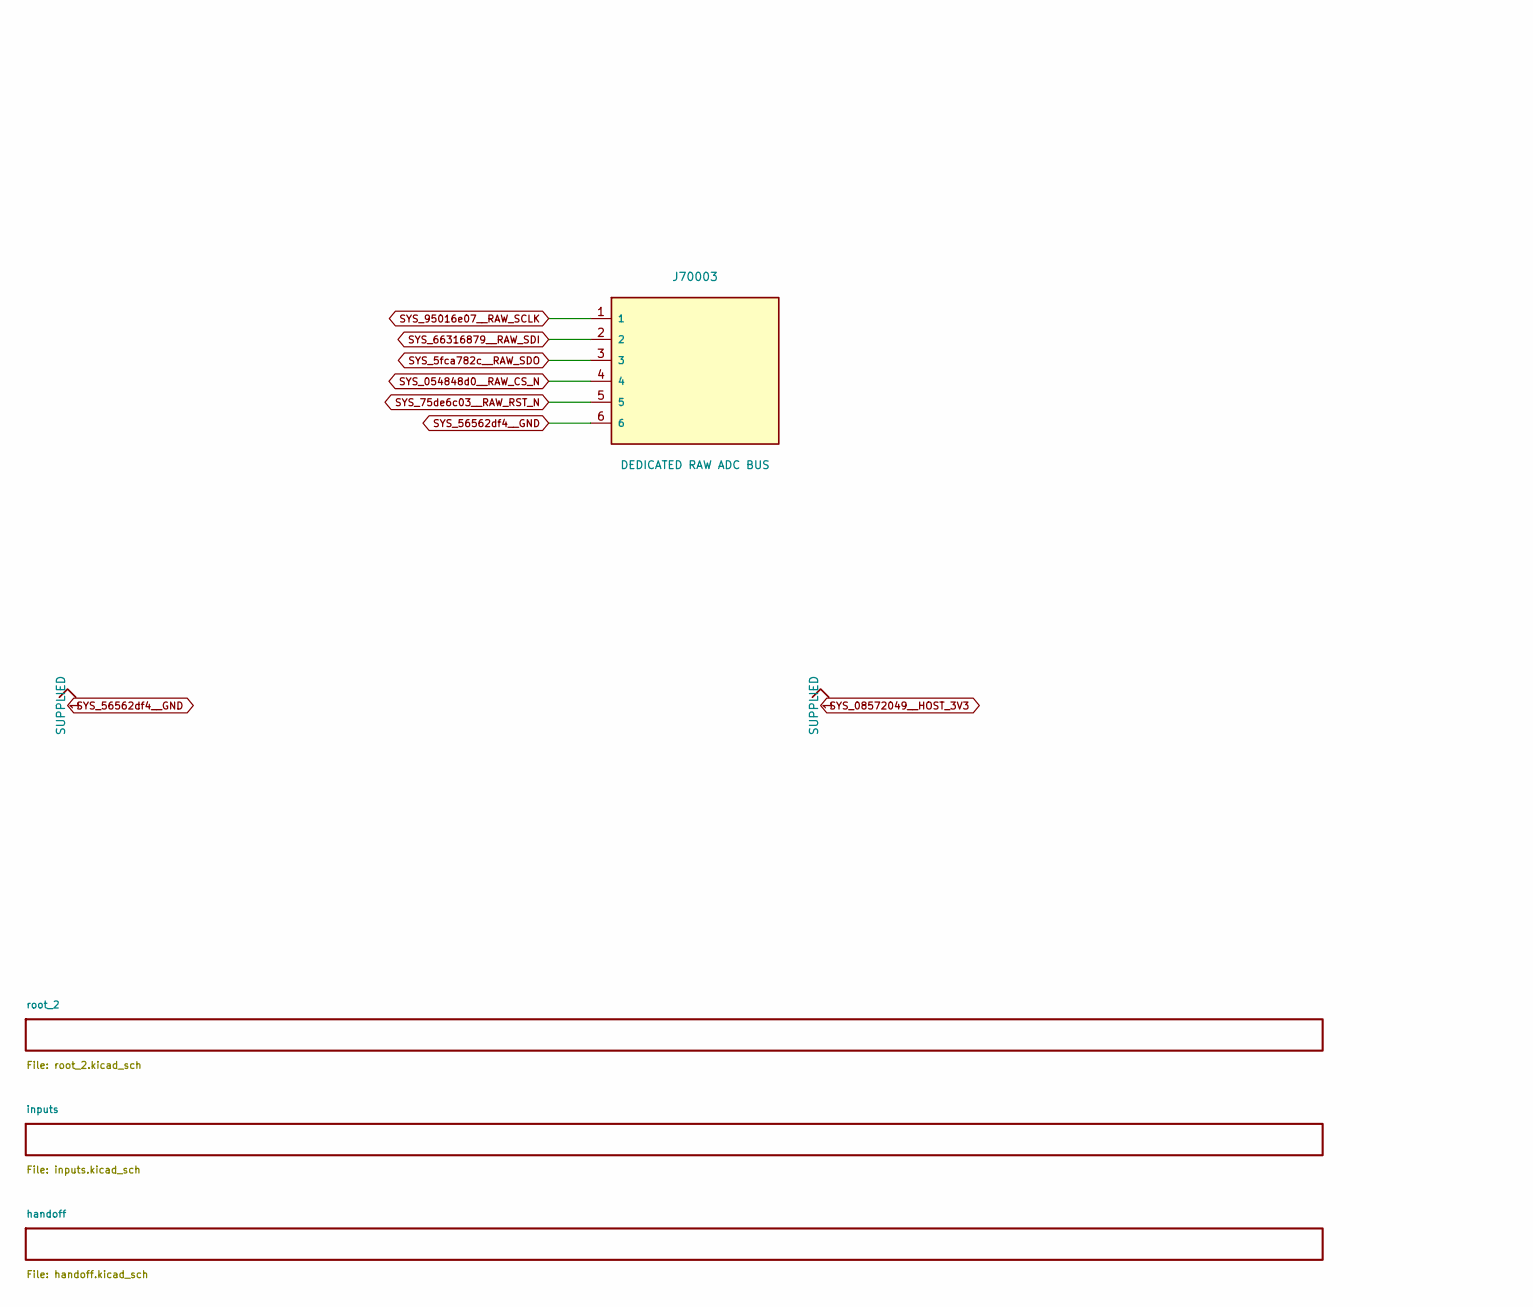
[picture p381: schematic monitoring_transport.kicad_sch, ATO S4 / Existing package and host endpoints, part in row 2, column 1]

Parts:
J70001: HOST RAILS / RAW ADC; PinHeader_1x03_P2.54mm_Vertical
J70002: EXISTING ANALOG TAPS; PinHeader_1x08_P2.54mm_Vertical
J70003: DEDICATED RAW ADC BUS; PinHeader_1x06_P2.54mm_Vertical

Connections:
SYS_4f66f129__MON_VREF: J70002.5; also elsewhere on the board
SYS_5fca782c__RAW_SDO: J70003.3; also elsewhere on the board
SYS_37cfe02a__MON_VMID: J70002.6; also elsewhere on the board
SYS_40eeaa0c__CH1_VPAIR: J70002.4; also elsewhere on the board
SYS_75de6c03__RAW_RST_N: J70003.5; also elsewhere on the board
SYS_502efdd4__CH1_I_MON: J70002.2; also elsewhere on the board
SYS_054848d0__RAW_CS_N: J70003.4; also elsewhere on the board
SYS_56562df4__GND: J70001.3, J70002.8, J70003.6; also elsewhere on the board
SYS_95016e07__RAW_SCLK: J70003.1; also elsewhere on the board
SYS_08572049__HOST_3V3: J70001.2; also elsewhere on the board
SYS_66316879__RAW_SDI: J70003.2; also elsewhere on the board
SYS_baff84b5__CH0_VPAIR: J70002.3; also elsewhere on the board
SYS_ce166826__HOST_5: J70001.1; also elsewhere on the board
SYS_f8e43b73__CH0_I_MON: J70002.1; also elsewhere on the board
SYS_f199d834__PACK_BUS: J70002.7; also elsewhere on the board

Notes on the sheet:
DIGITAL SCCI ENGINEERING / ARTIFICIAL SIGNALS / MONITORING AND COMPANION
Dedicated raw current/voltage ADC and wired processed-feature companion. Endpoint charge ADCs remain separate.
