pratham-cloud-ctrl/Project-ATO/electronics/stage4/integrated-pcb/boards/monitoring-transport/monitoring_transport.kicad_pcb

## KiCad design electronics/stage4/integrated-pcb/boards/monitoring-transport/monitoring_transport.kicad_pcb (continued)

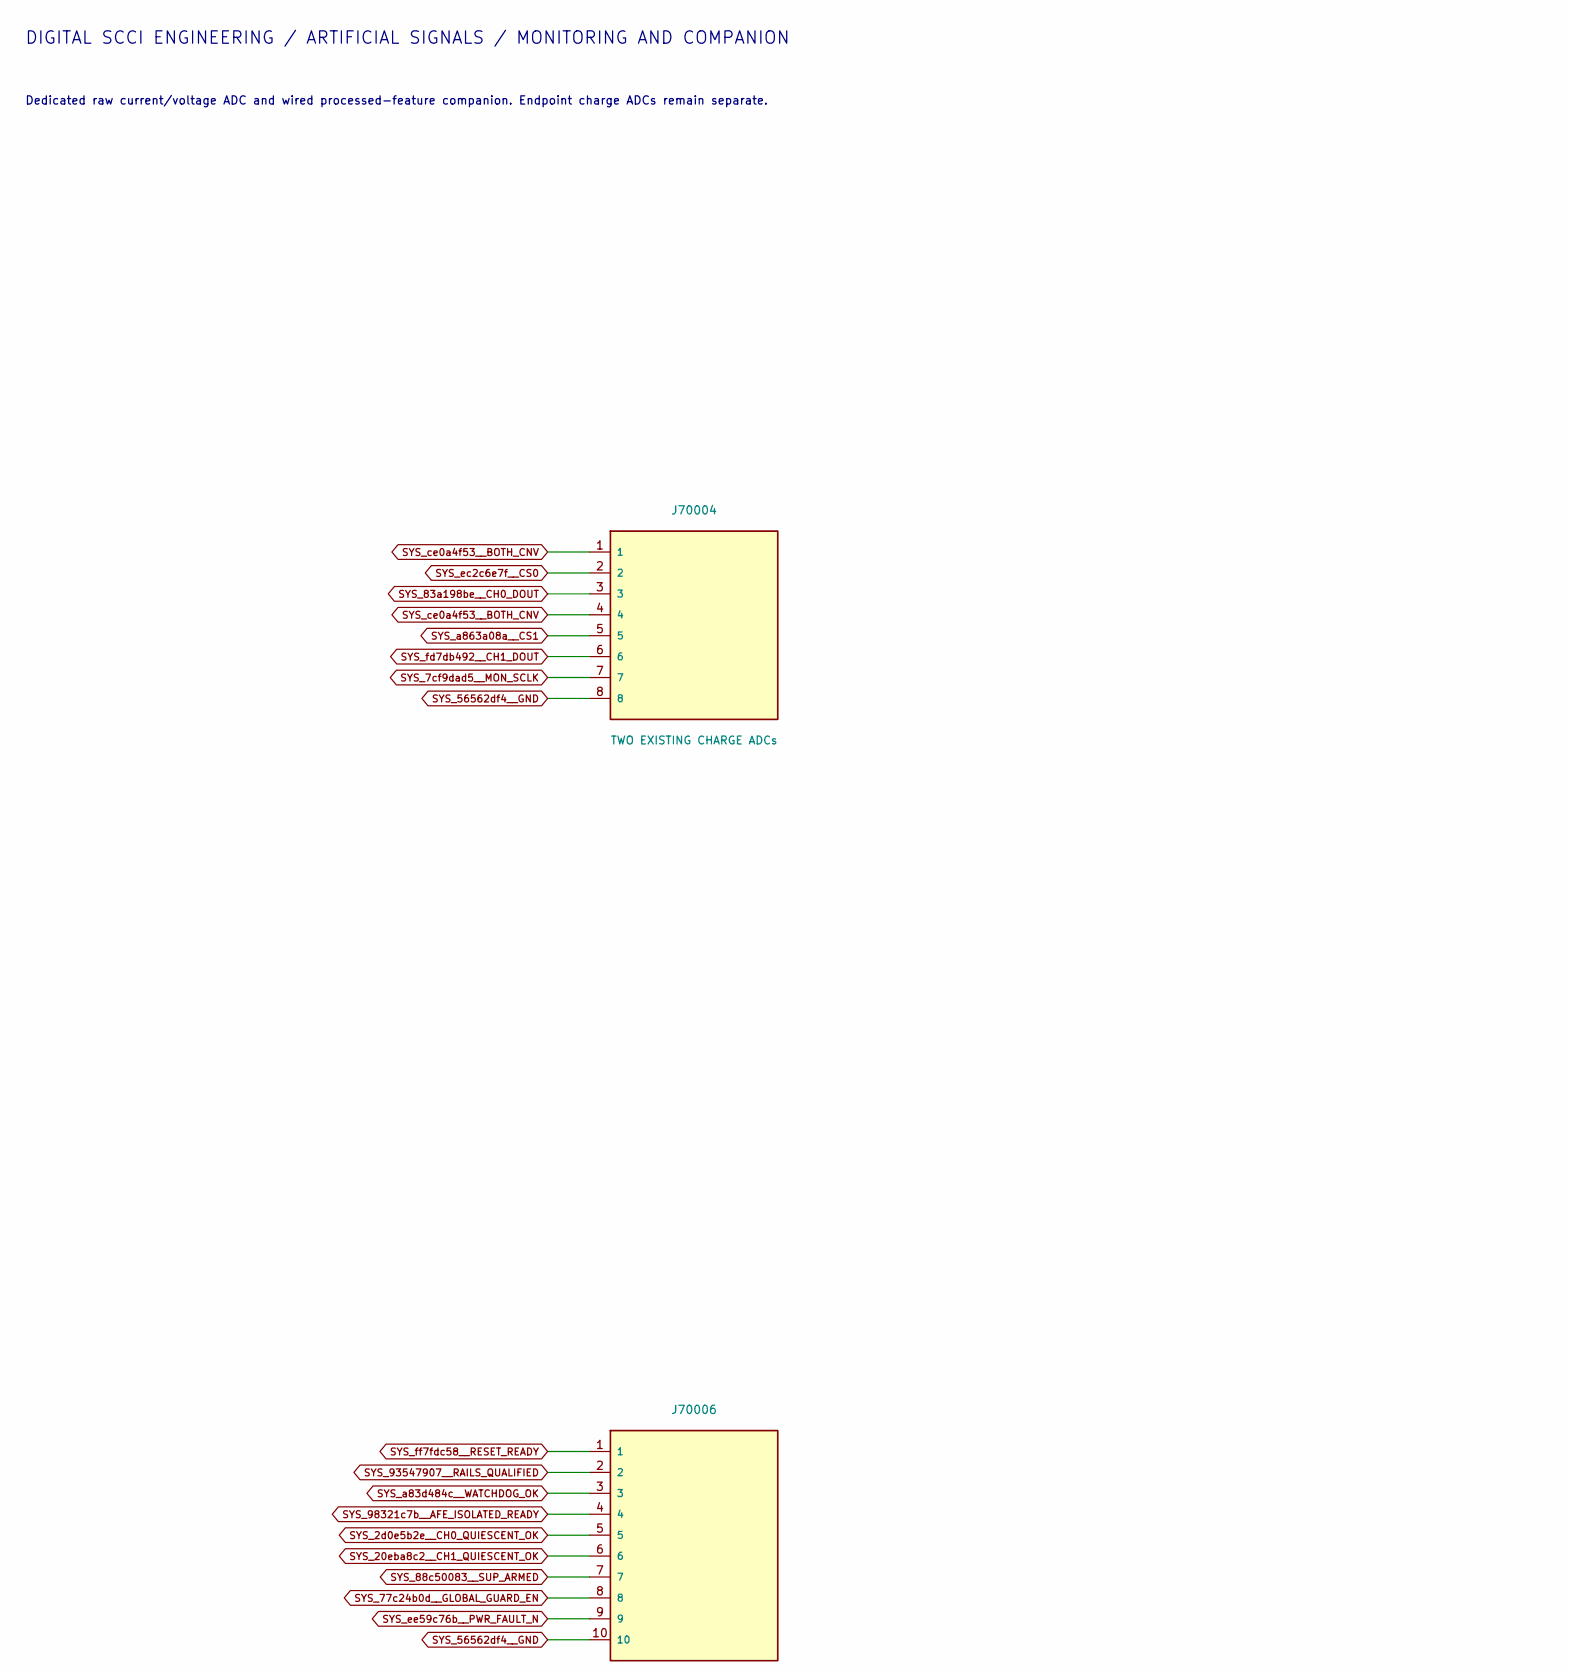
[picture p382: schematic root_2.kicad_sch, ATO S4 / Existing package and host endpoints / 2, part in row 1, column 1]

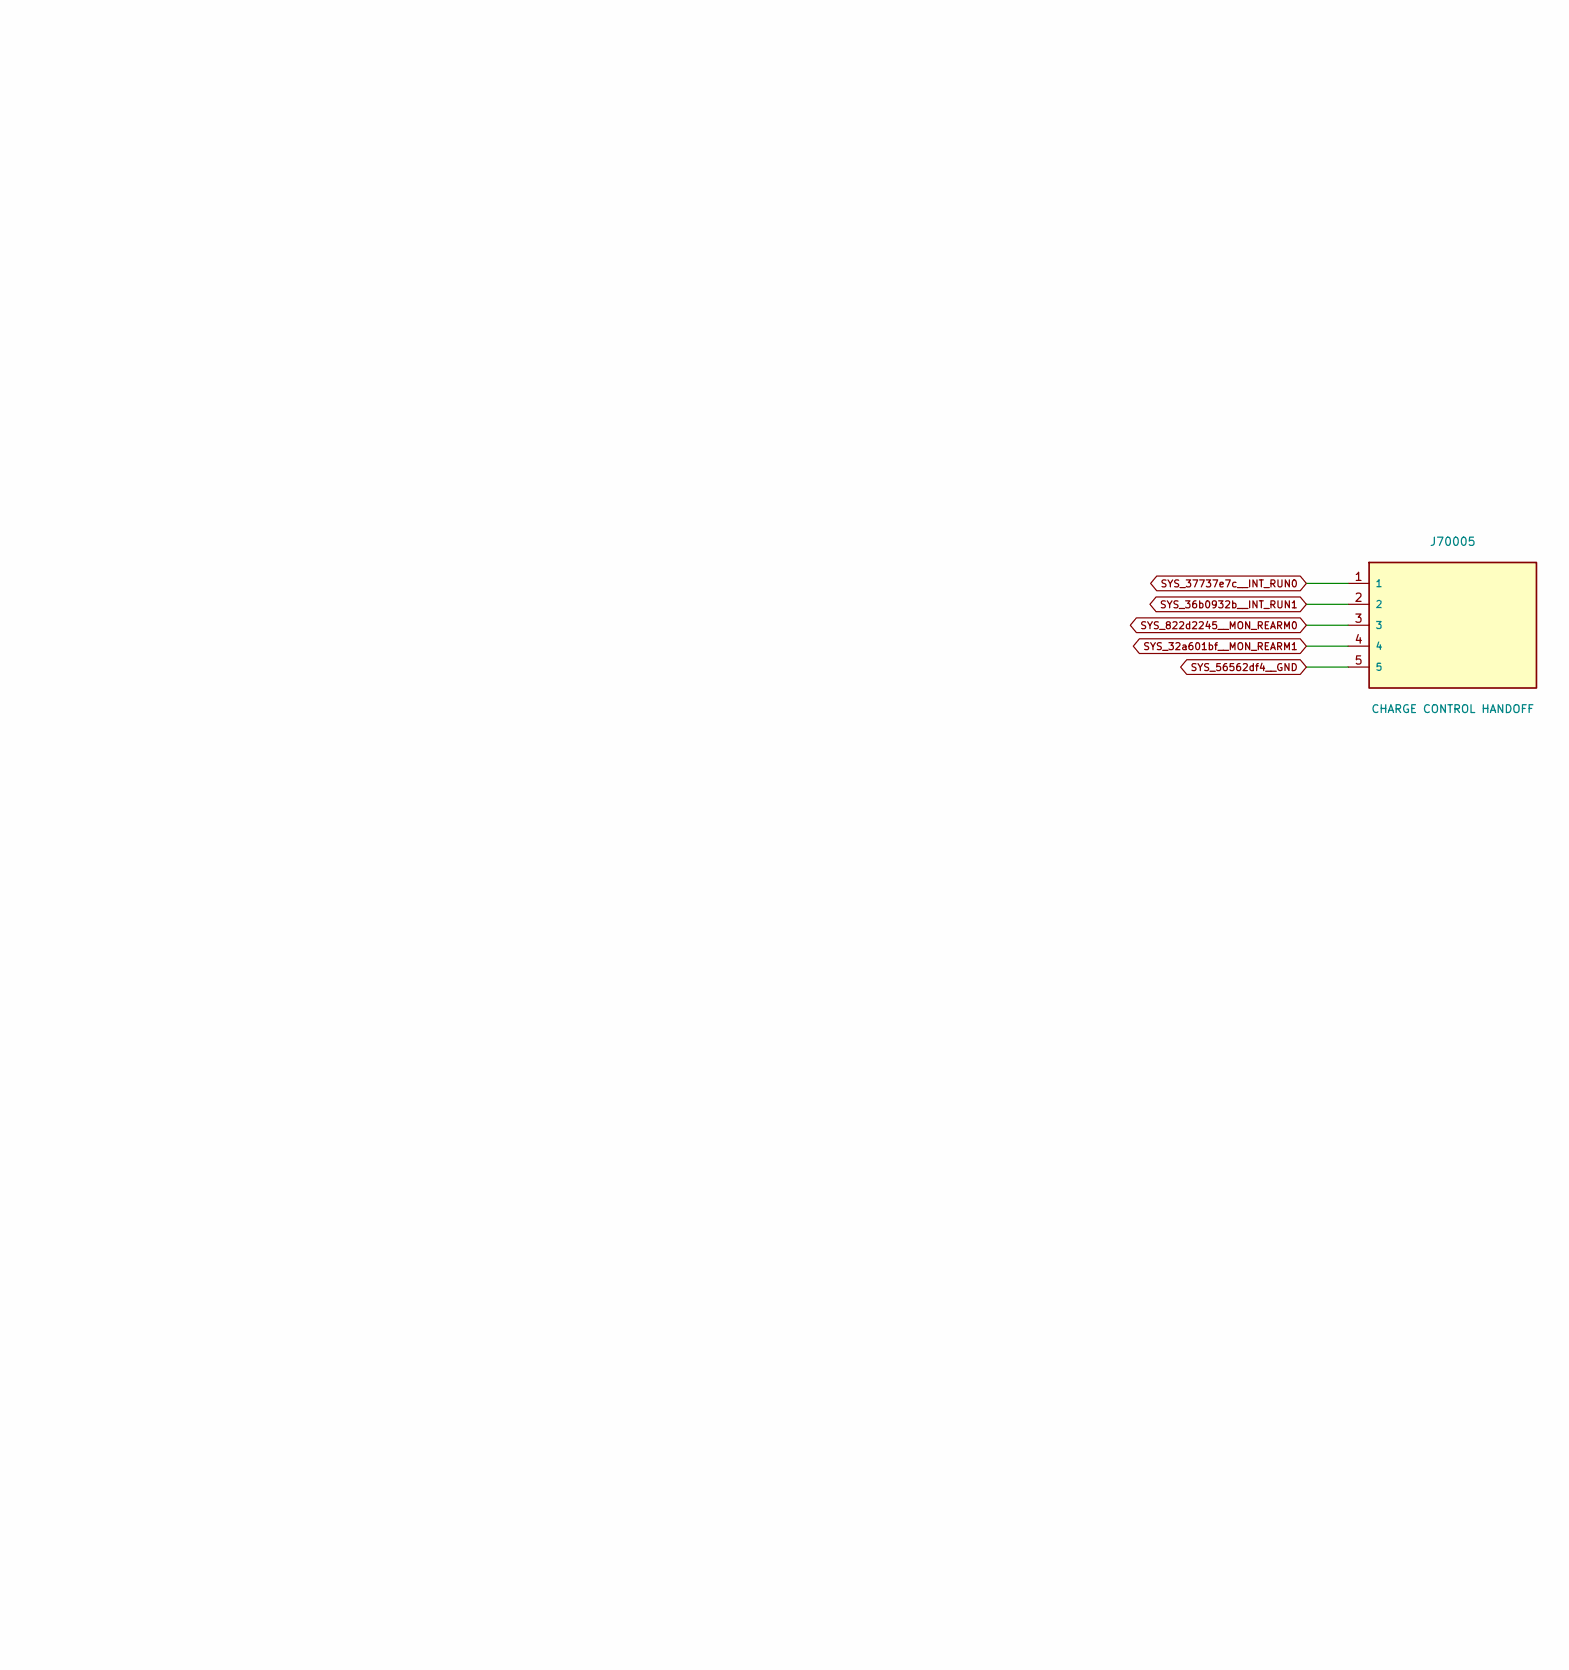
[picture p383: schematic root_2.kicad_sch, ATO S4 / Existing package and host endpoints / 2, part in row 1, column 2]

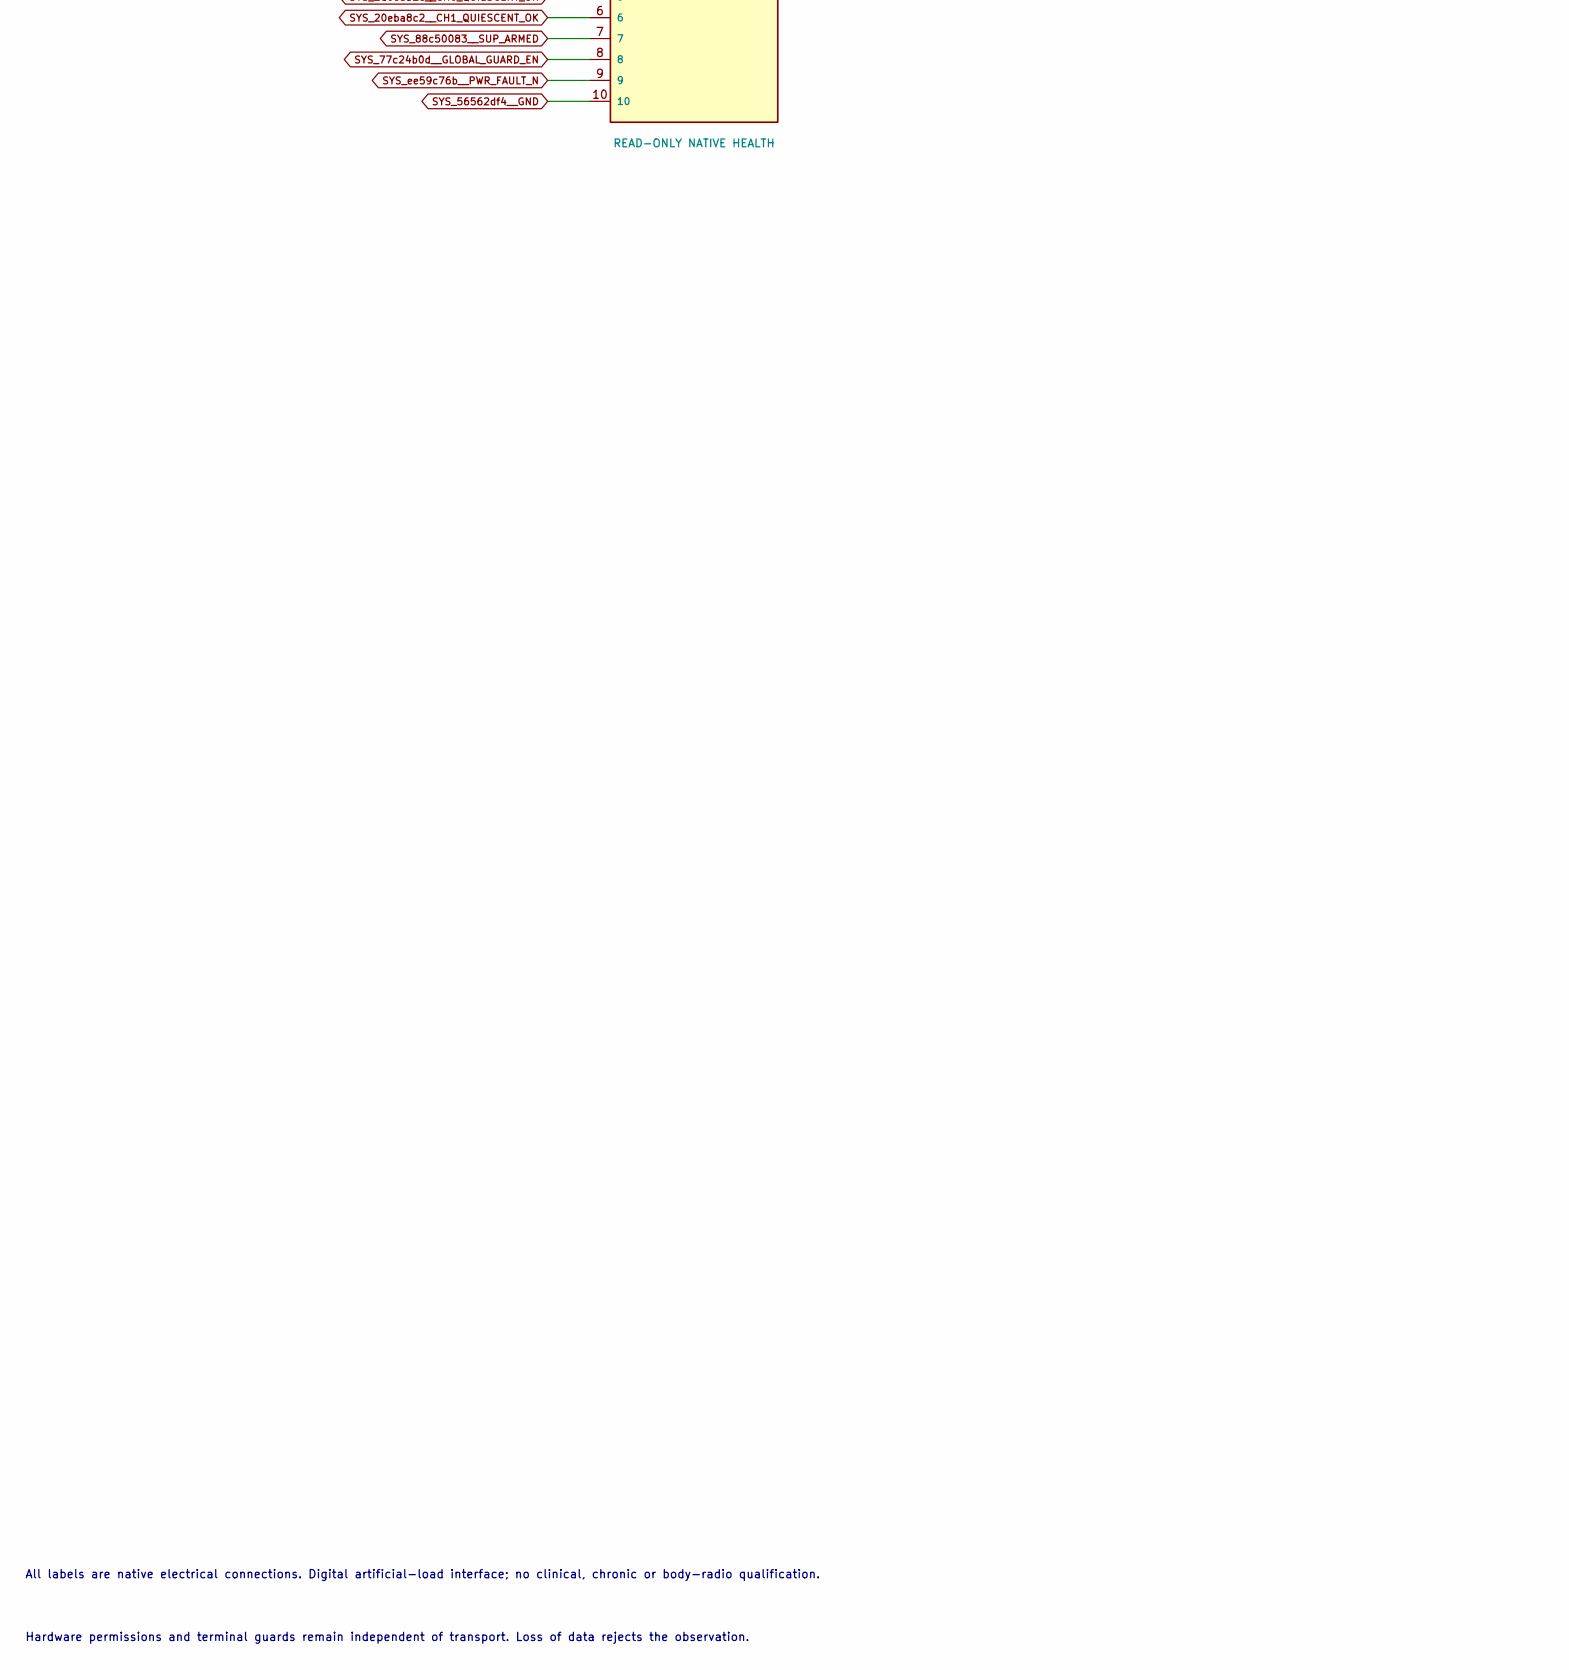
[picture p384: schematic root_2.kicad_sch, ATO S4 / Existing package and host endpoints / 2, part in row 2, column 1]

Parts:
J70004: TWO EXISTING CHARGE ADCs; PinHeader_1x08_P2.54mm_Vertical
J70005: CHARGE CONTROL HANDOFF; PinHeader_1x05_P2.54mm_Vertical
J70006: READ-ONLY NATIVE HEALTH; PinHeader_1x10_P2.54mm_Vertical

Connections:
SYS_2d0e5b2e__CH0_QUIESCENT_OK: J70006.5; also elsewhere on the board
SYS_7cf9dad5__MON_SCLK: J70004.7; also elsewhere on the board
SYS_20eba8c2__CH1_QUIESCENT_OK: J70006.6; also elsewhere on the board
SYS_32a601bf__MON_REARM1: J70005.4; also elsewhere on the board
SYS_36b0932b__INT_RUN1: J70005.2; also elsewhere on the board
SYS_77c24b0d__GLOBAL_GUARD_EN: J70006.8; also elsewhere on the board
SYS_83a198be__CH0_DOUT: J70004.3; also elsewhere on the board
SYS_88c50083__SUP_ARMED: J70006.7; also elsewhere on the board
SYS_822d2245__MON_REARM0: J70005.3; also elsewhere on the board
SYS_37737e7c__INT_RUN0: J70005.1; also elsewhere on the board
SYS_56562df4__GND: J70004.8, J70005.5, J70006.10; also elsewhere on the board
SYS_98321c7b__AFE_ISOLATED_READY: J70006.4; also elsewhere on the board
SYS_93547907__RAILS_QUALIFIED: J70006.2; also elsewhere on the board
SYS_a83d484c__WATCHDOG_OK: J70006.3; also elsewhere on the board
SYS_a863a08a__CS1: J70004.5; also elsewhere on the board
SYS_ce0a4f53__BOTH_CNV: J70004.1, J70004.4; also elsewhere on the board
SYS_ec2c6e7f__CS0: J70004.2; also elsewhere on the board
SYS_ee59c76b__PWR_FAULT_N: J70006.9; also elsewhere on the board
SYS_fd7db492__CH1_DOUT: J70004.6; also elsewhere on the board
SYS_ff7fdc58__RESET_READY: J70006.1; also elsewhere on the board

Notes on the sheet:
DIGITAL SCCI ENGINEERING / ARTIFICIAL SIGNALS / MONITORING AND COMPANION
Dedicated raw current/voltage ADC and wired processed-feature companion. Endpoint charge ADCs remain separate.
All labels are native electrical connections. Digital artificial-load interface; no clinical, chronic or body-radio qualification.
Hardware permissions and terminal guards remain independent of transport. Loss of data rejects the observation.

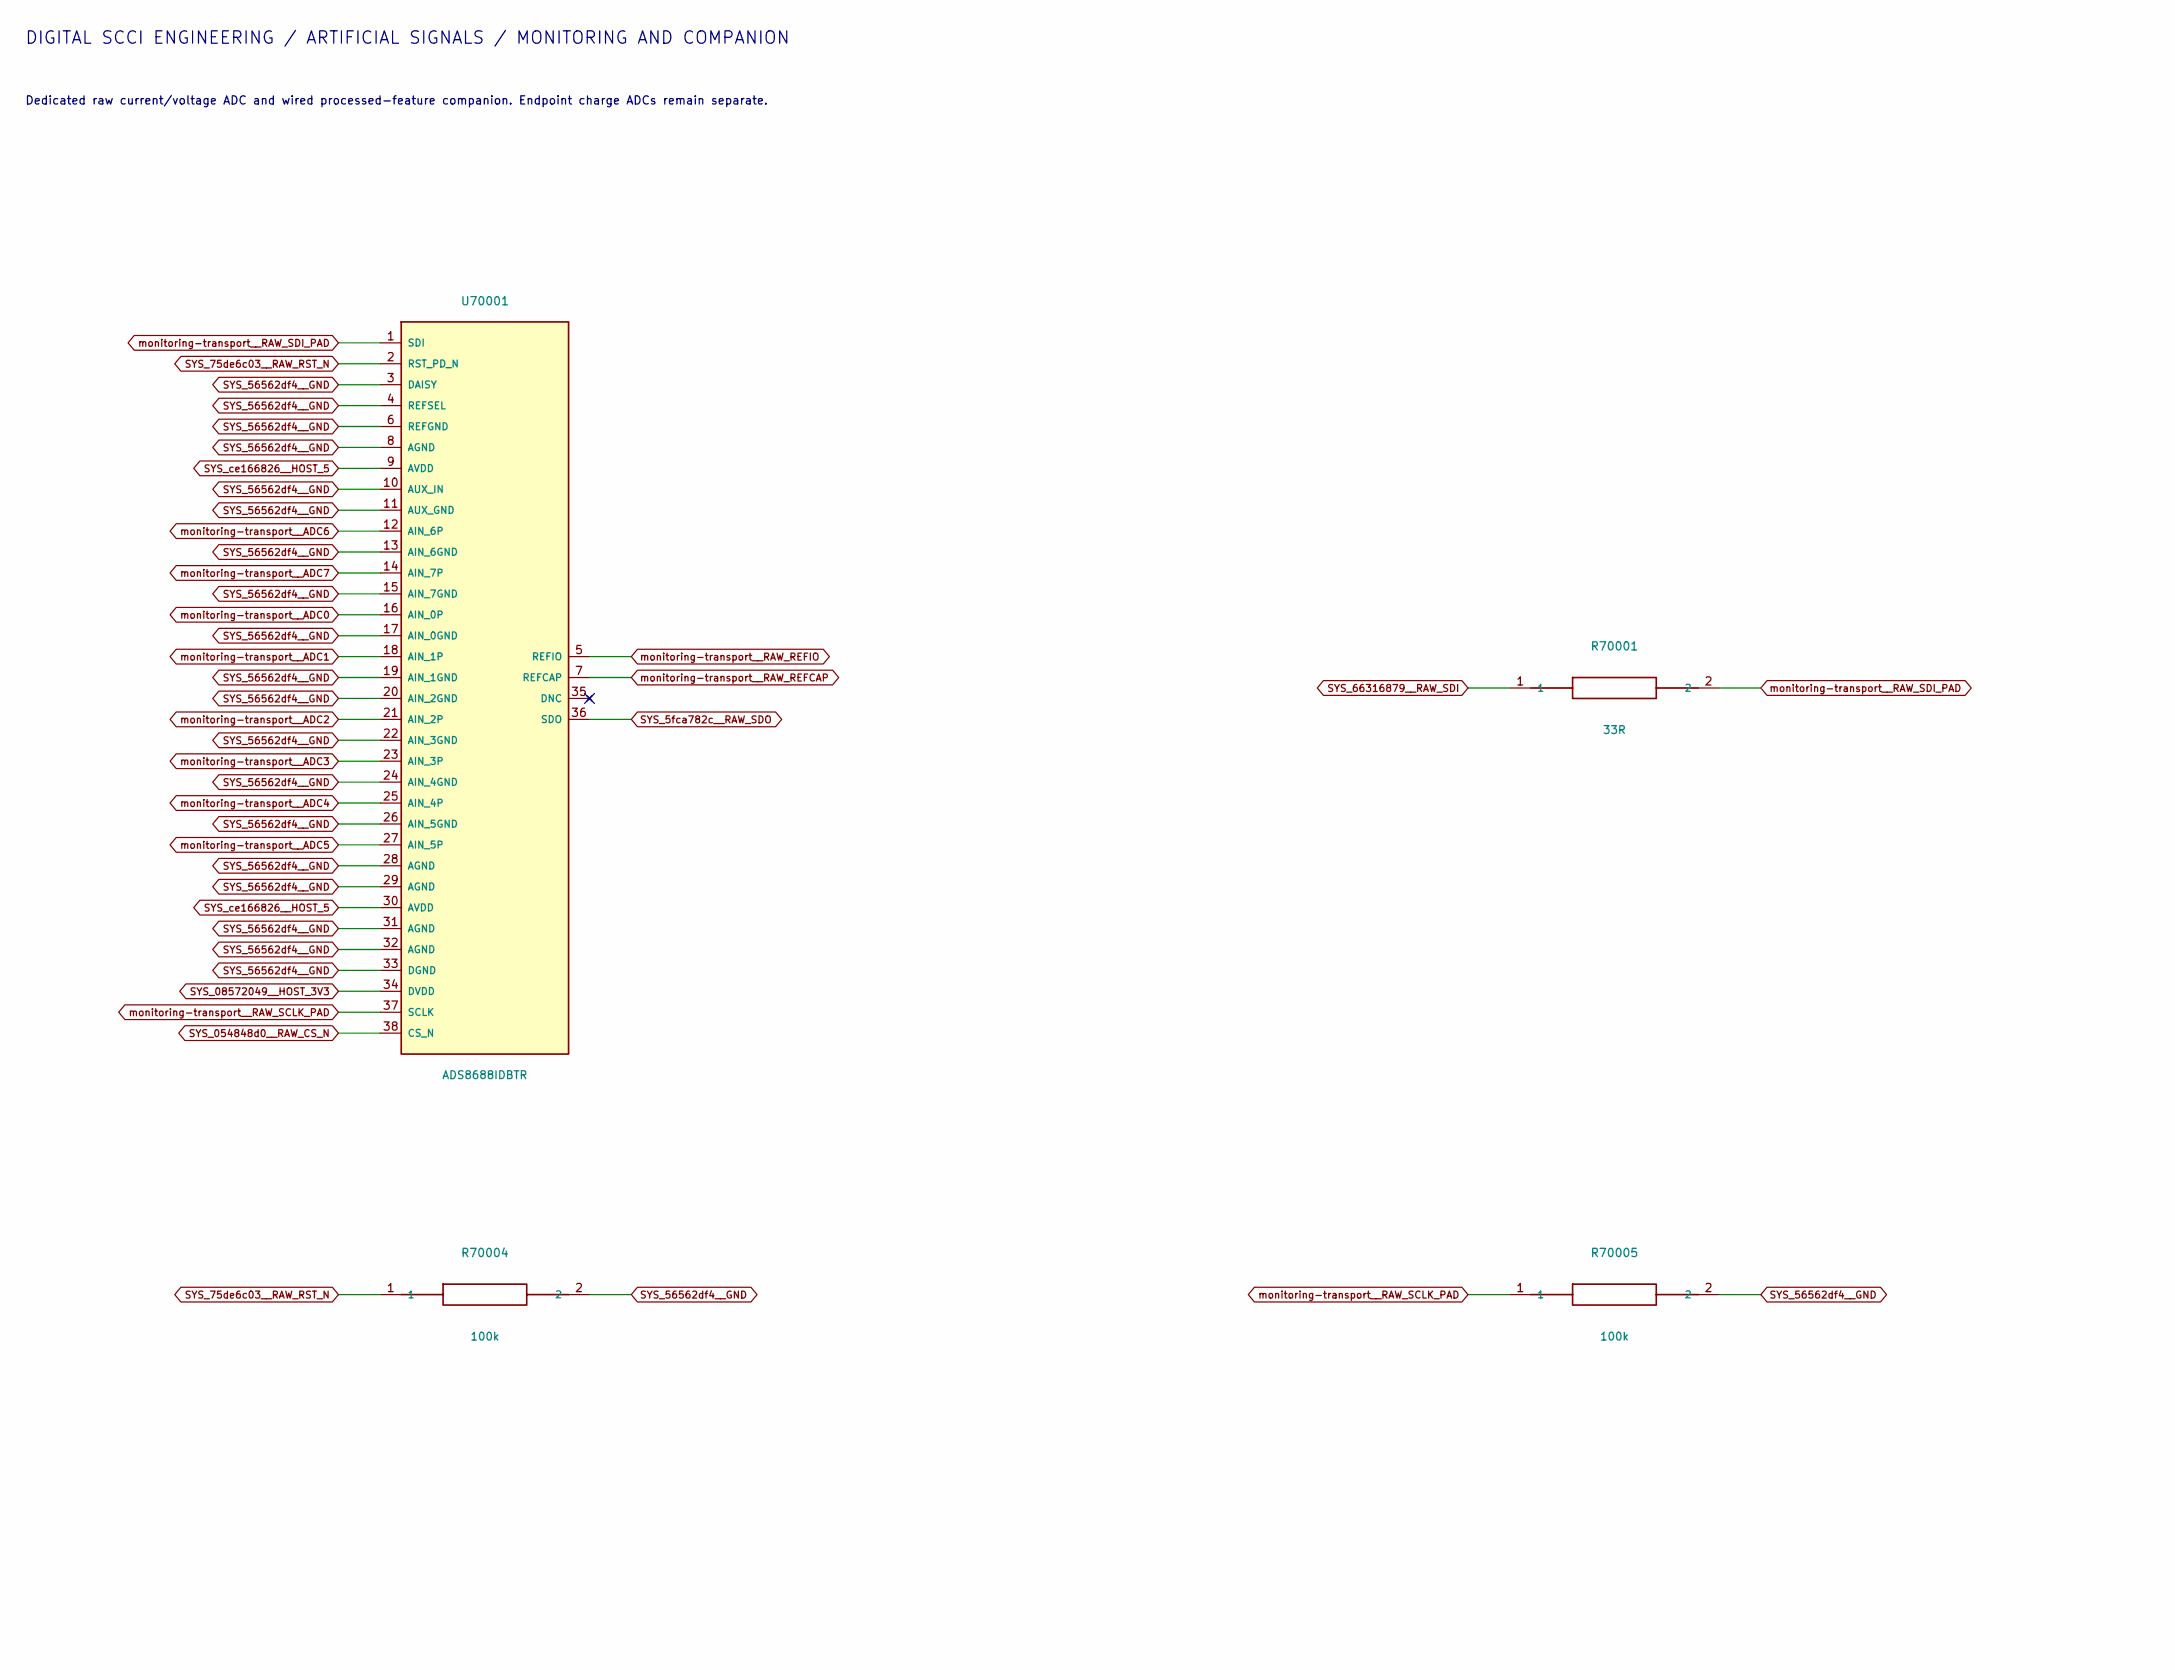
[picture p385: schematic adc.kicad_sch, ATO S4 / Dedicated eight-channel raw conversion, part in row 1, column 1]

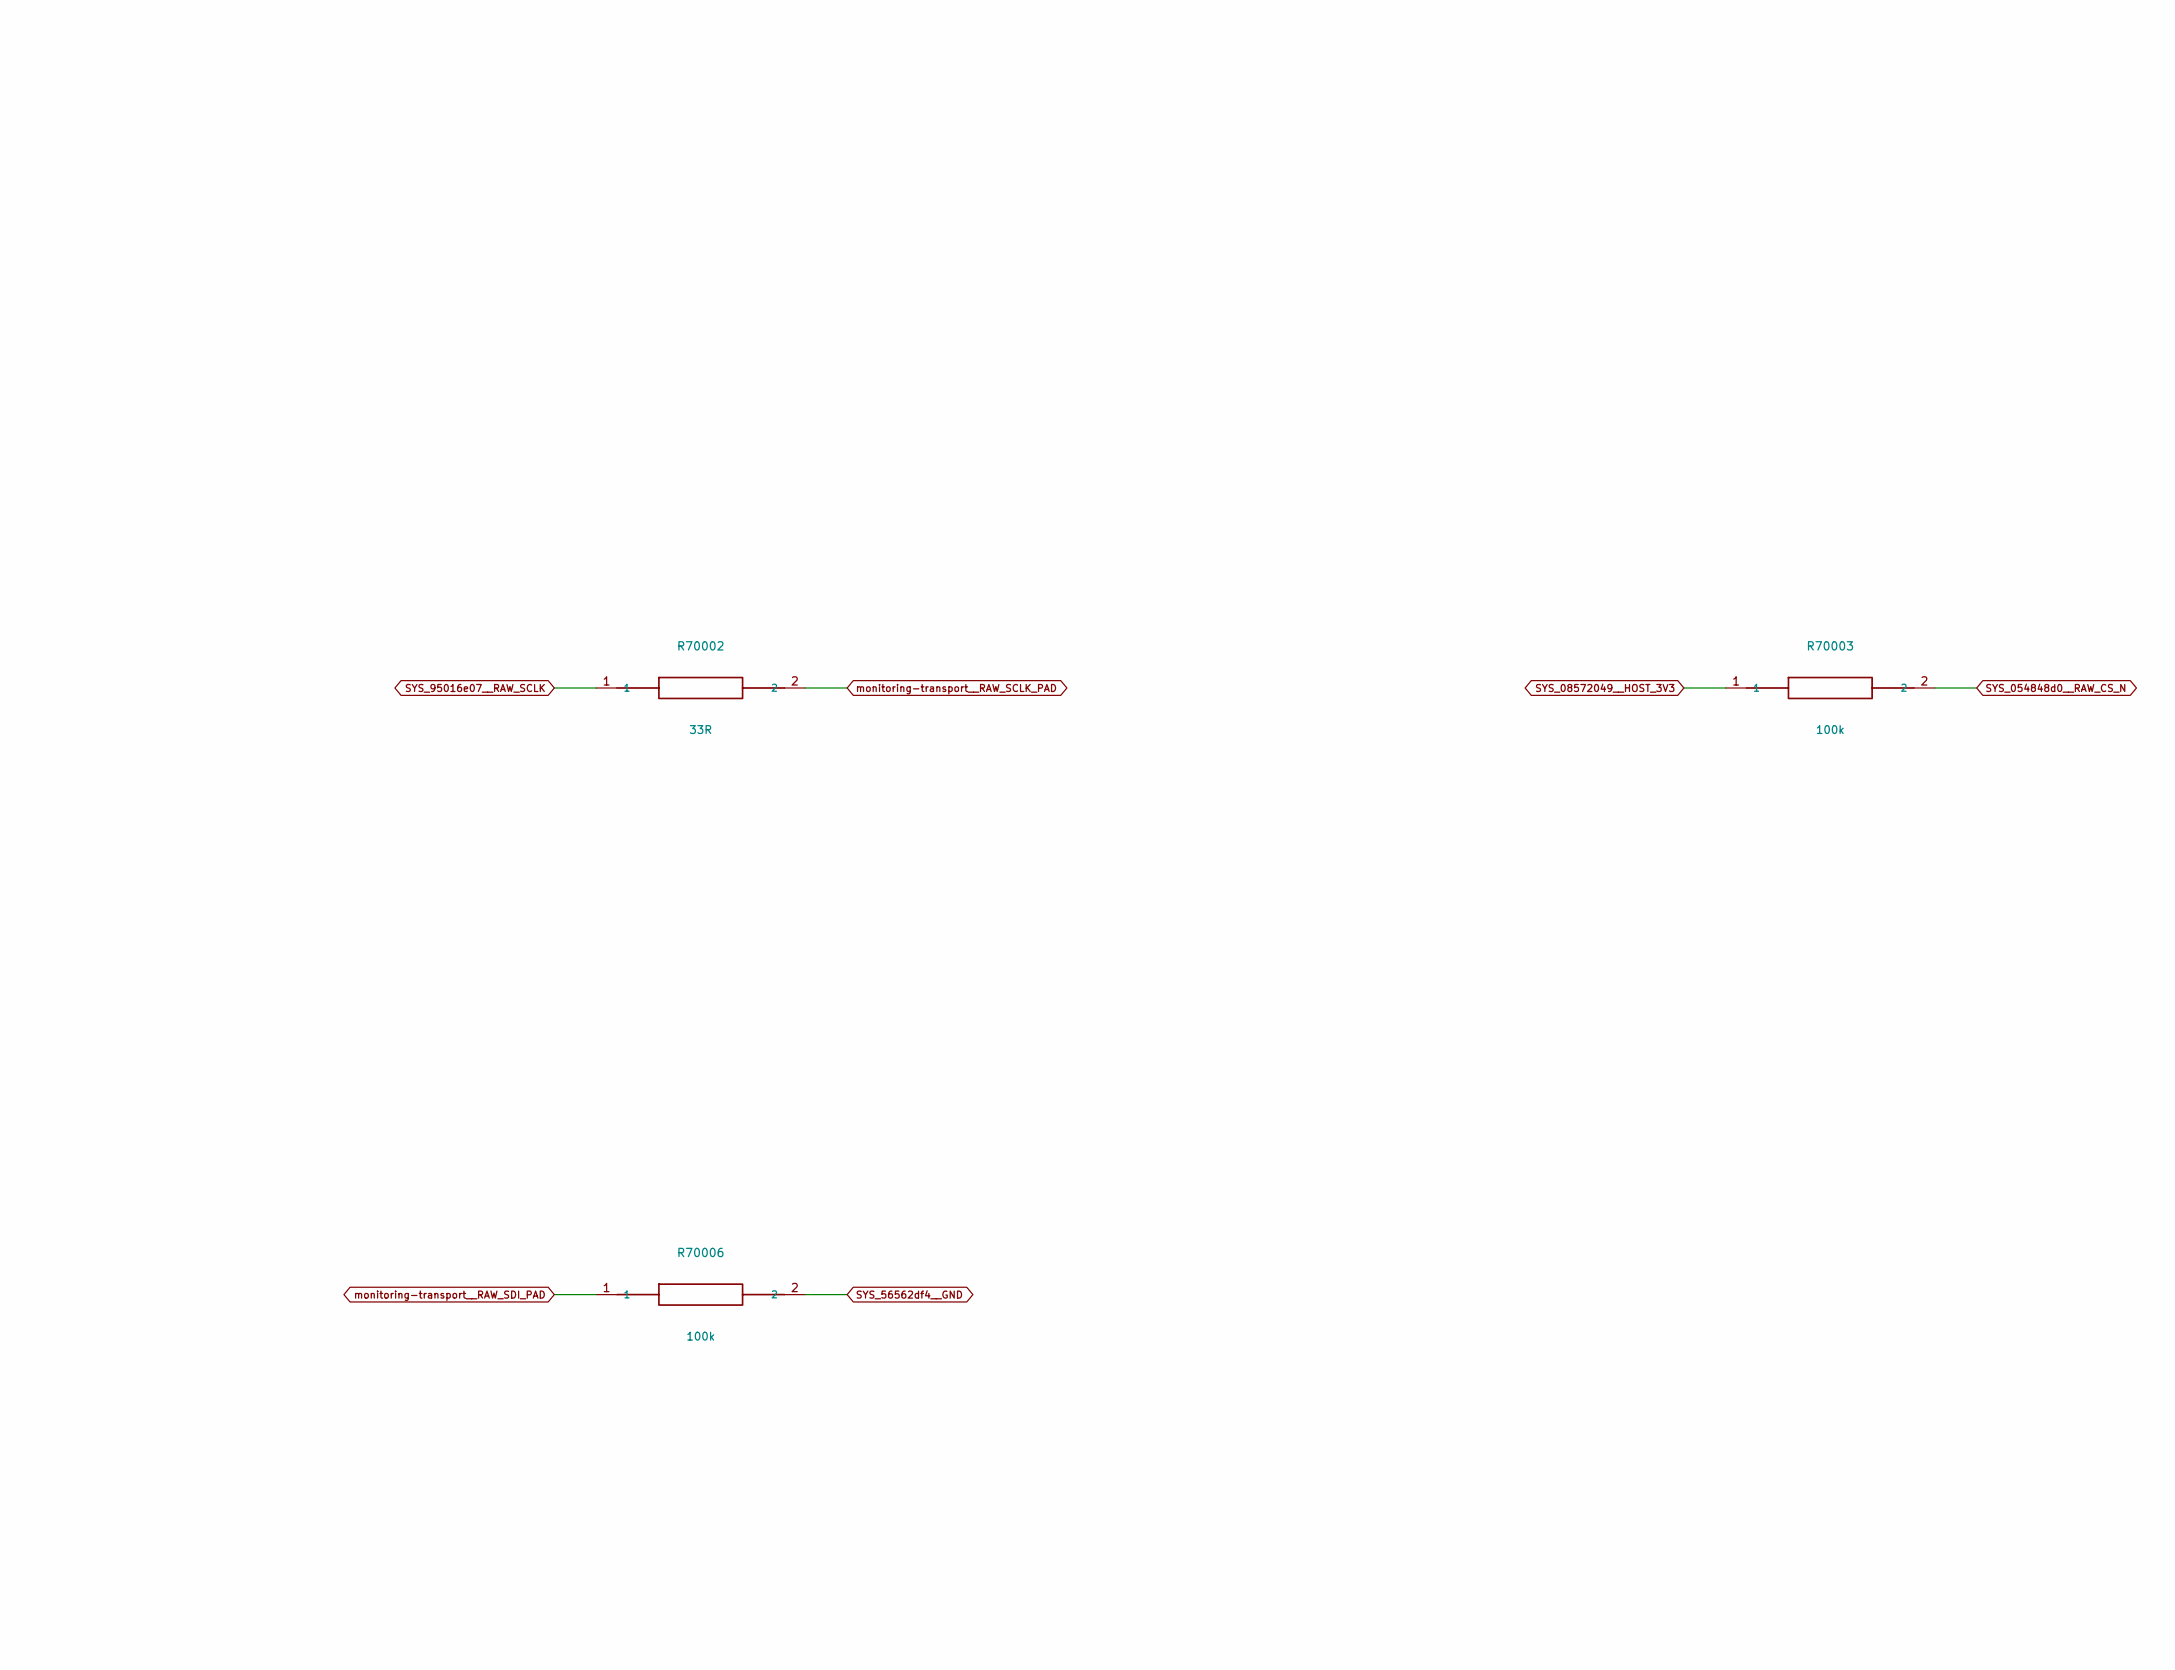
[picture p386: schematic adc.kicad_sch, ATO S4 / Dedicated eight-channel raw conversion, part in row 1, column 2]

Parts:
R70001, R70002: 33R; R_0805_2012Metric
R70003, R70004, R70005, R70006: 100k; R_0805_2012Metric
U70001: ADS8688IDBTR; TSSOP-38_4.4x9.7mm_P0.5mm

Connections:
SYS_5fca782c__RAW_SDO: U70001.36 (SDO); also elsewhere on the board
SYS_75de6c03__RAW_RST_N: R70004.1, U70001.2 (RST_PD_N); also elsewhere on the board
SYS_054848d0__RAW_CS_N: R70003.2, U70001.38 (CS_N); also elsewhere on the board
SYS_56562df4__GND: R70004.2, R70005.2, R70006.2, U70001.3 (DAISY), U70001.4 (REFSEL), U70001.6 (REFGND), U70001.8 (AGND), U70001.10 (AUX_IN), U70001.11 (AUX_GND), U70001.13 (AIN_6GND), U70001.15 (AIN_7GND), U70001.17 (AIN_0GND), U70001.19 (AIN_1GND), U70001.20 (AIN_2GND), U70001.22 (AIN_3GND), U70001.24 (AIN_4GND), U70001.26 (AIN_5GND), U70001.28 (AGND), U70001.29 (AGND), U70001.31 (AGND), U70001.32 (AGND), U70001.33 (DGND); also elsewhere on the board
SYS_95016e07__RAW_SCLK: R70002.1; also elsewhere on the board
SYS_08572049__HOST_3V3: R70003.1, U70001.34 (DVDD); also elsewhere on the board
SYS_66316879__RAW_SDI: R70001.1; also elsewhere on the board
SYS_ce166826__HOST_5: U70001.9 (AVDD), U70001.30 (AVDD); also elsewhere on the board
monitoring-transport__ADC0: U70001.16 (AIN_0P); also elsewhere on the board
monitoring-transport__ADC1: U70001.18 (AIN_1P); also elsewhere on the board
monitoring-transport__ADC2: U70001.21 (AIN_2P); also elsewhere on the board
monitoring-transport__ADC3: U70001.23 (AIN_3P); also elsewhere on the board
monitoring-transport__ADC4: U70001.25 (AIN_4P); also elsewhere on the board
monitoring-transport__ADC5: U70001.27 (AIN_5P); also elsewhere on the board
monitoring-transport__ADC6: U70001.12 (AIN_6P); also elsewhere on the board
monitoring-transport__ADC7: U70001.14 (AIN_7P); also elsewhere on the board
monitoring-transport__RAW_REFCAP: U70001.7 (REFCAP); also elsewhere on the board
monitoring-transport__RAW_REFIO: U70001.5 (REFIO); also elsewhere on the board
monitoring-transport__RAW_SCLK_PAD: R70002.2, R70005.1, U70001.37 (SCLK)
monitoring-transport__RAW_SDI_PAD: R70001.2, R70006.1, U70001.1 (SDI)

Notes on the sheet:
DIGITAL SCCI ENGINEERING / ARTIFICIAL SIGNALS / MONITORING AND COMPANION
Dedicated raw current/voltage ADC and wired processed-feature companion. Endpoint charge ADCs remain separate.
All labels are native electrical connections. Digital artificial-load interface; no clinical, chronic or body-radio qualification.
Hardware permissions and terminal guards remain independent of transport. Loss of data rejects the observation.
