pratham-cloud-ctrl/Project-ATO/electronics/stage4/integrated-pcb/boards/monitoring-transport/monitoring_transport.kicad_pcb

## KiCad design electronics/stage4/integrated-pcb/boards/monitoring-transport/monitoring_transport.kicad_pcb (continued)

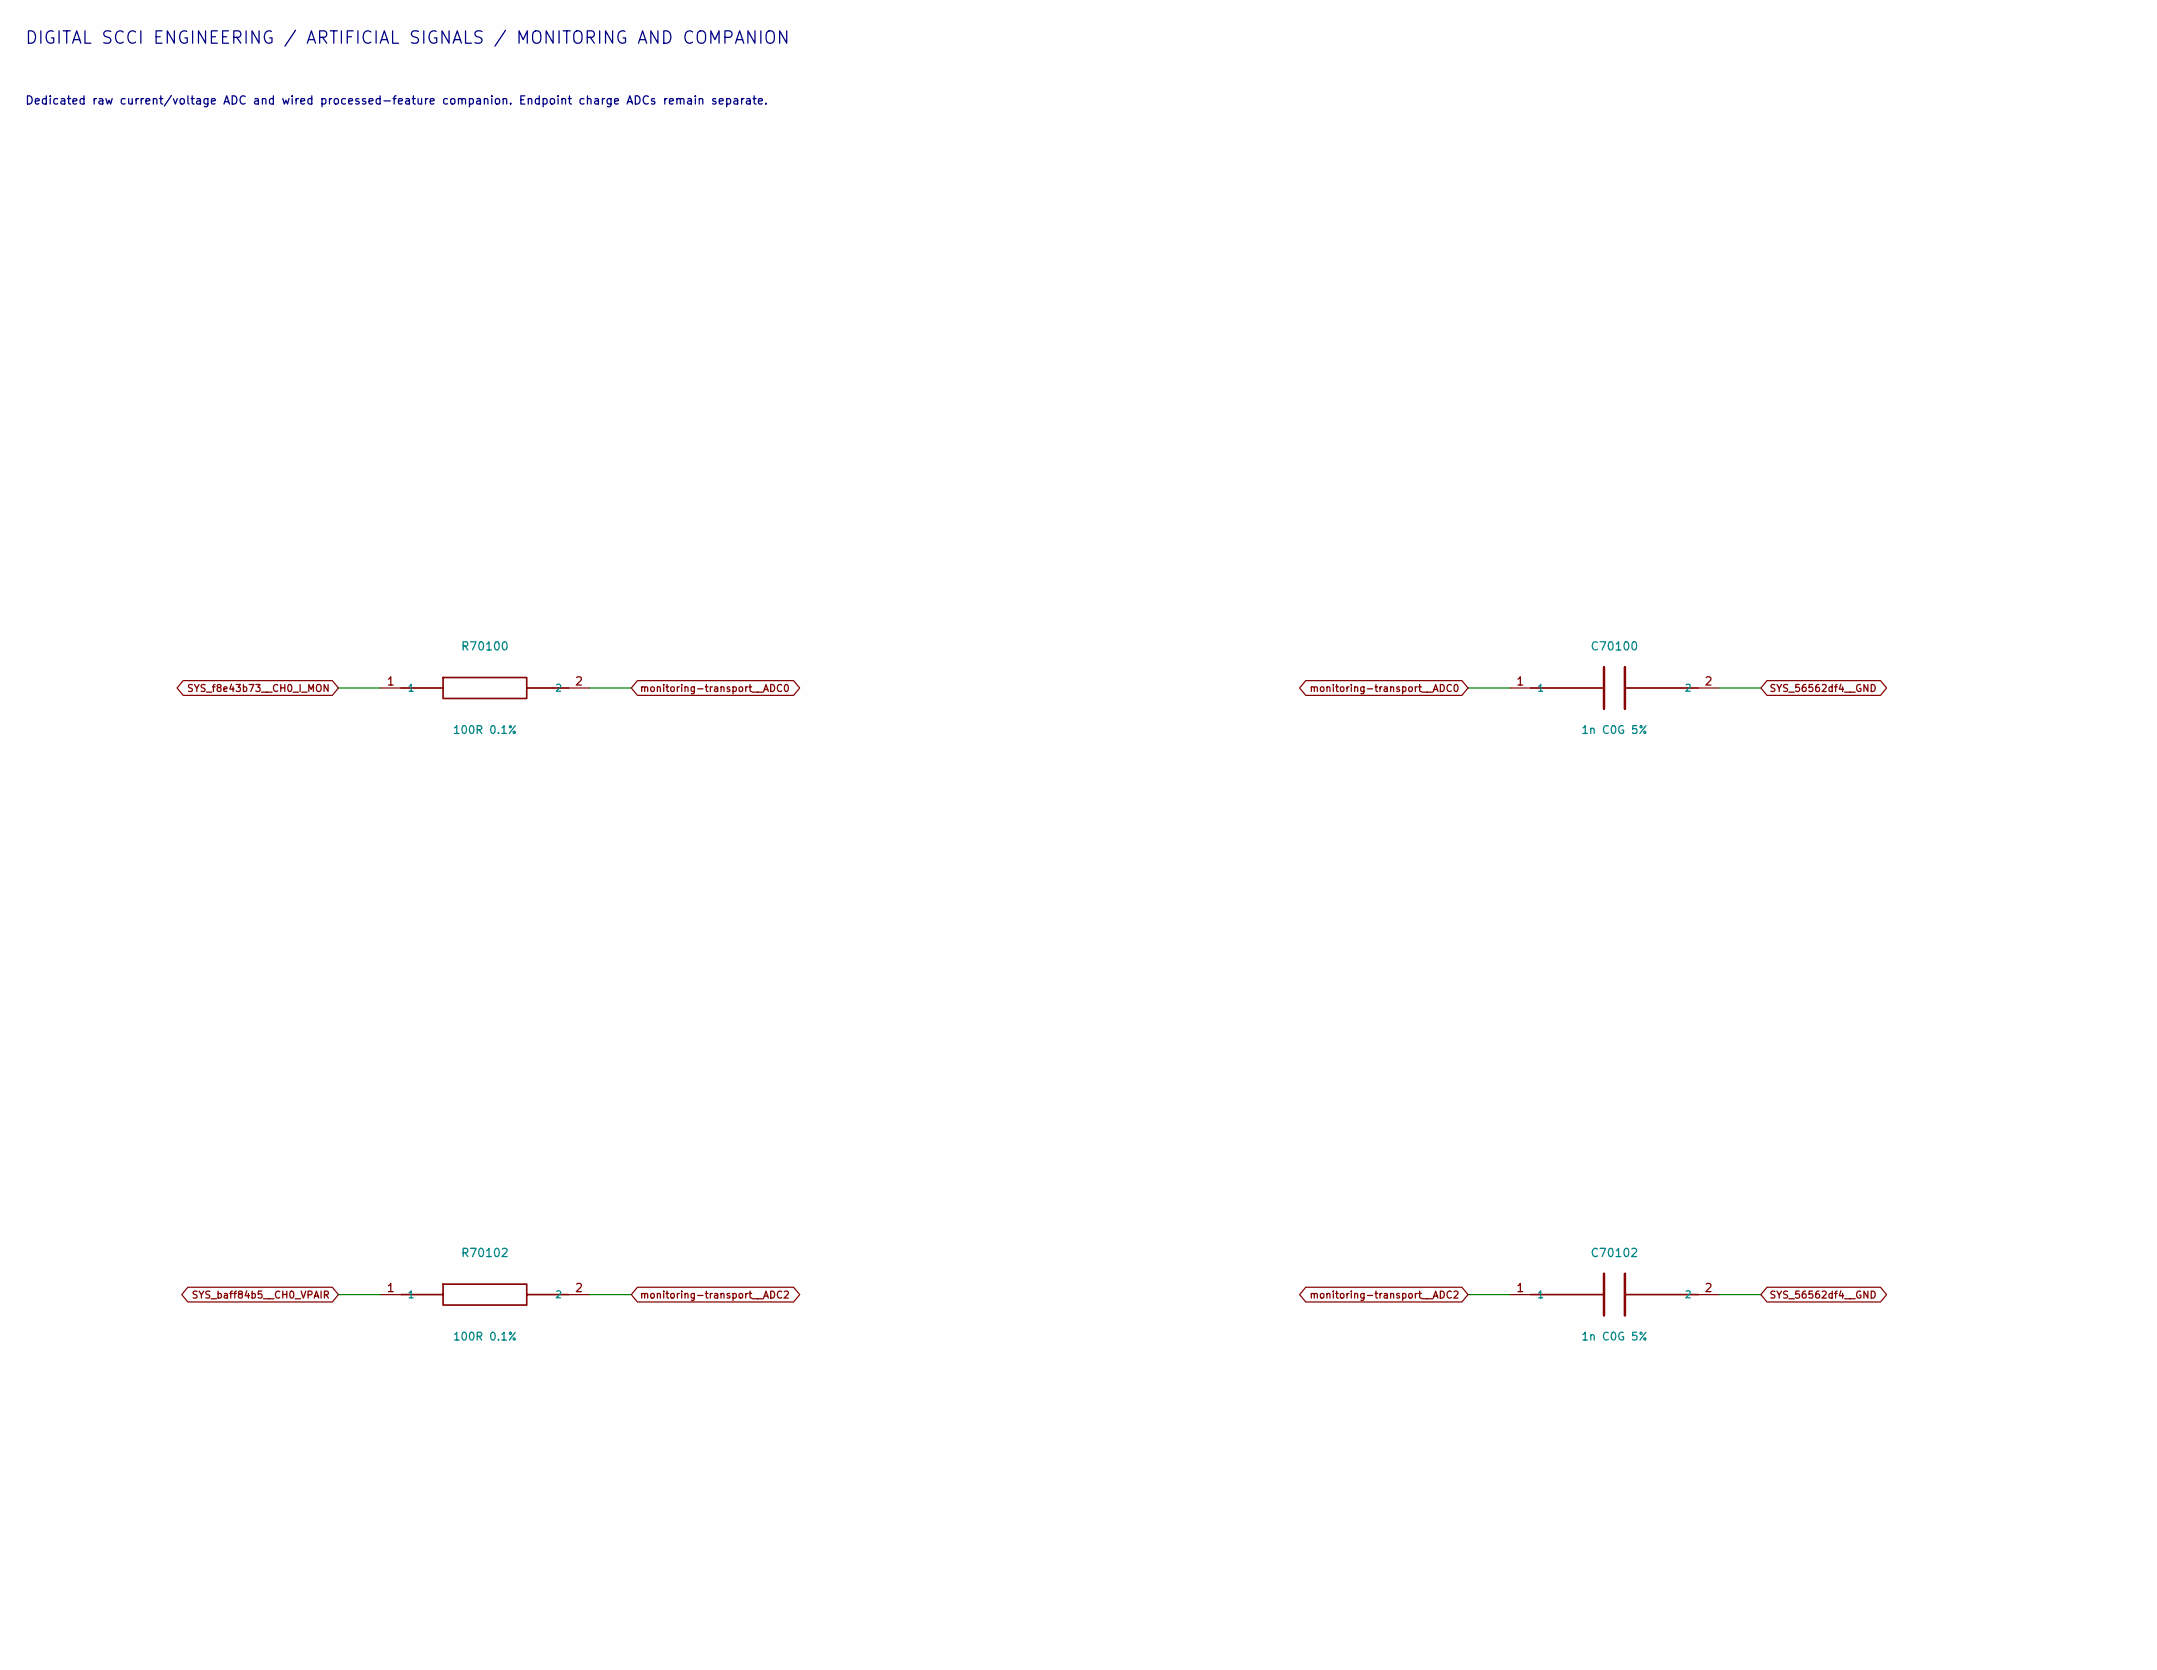
[picture p389: schematic inputs.kicad_sch, ATO S4 / Raw current and scaled voltage filtering, part in row 1, column 1]

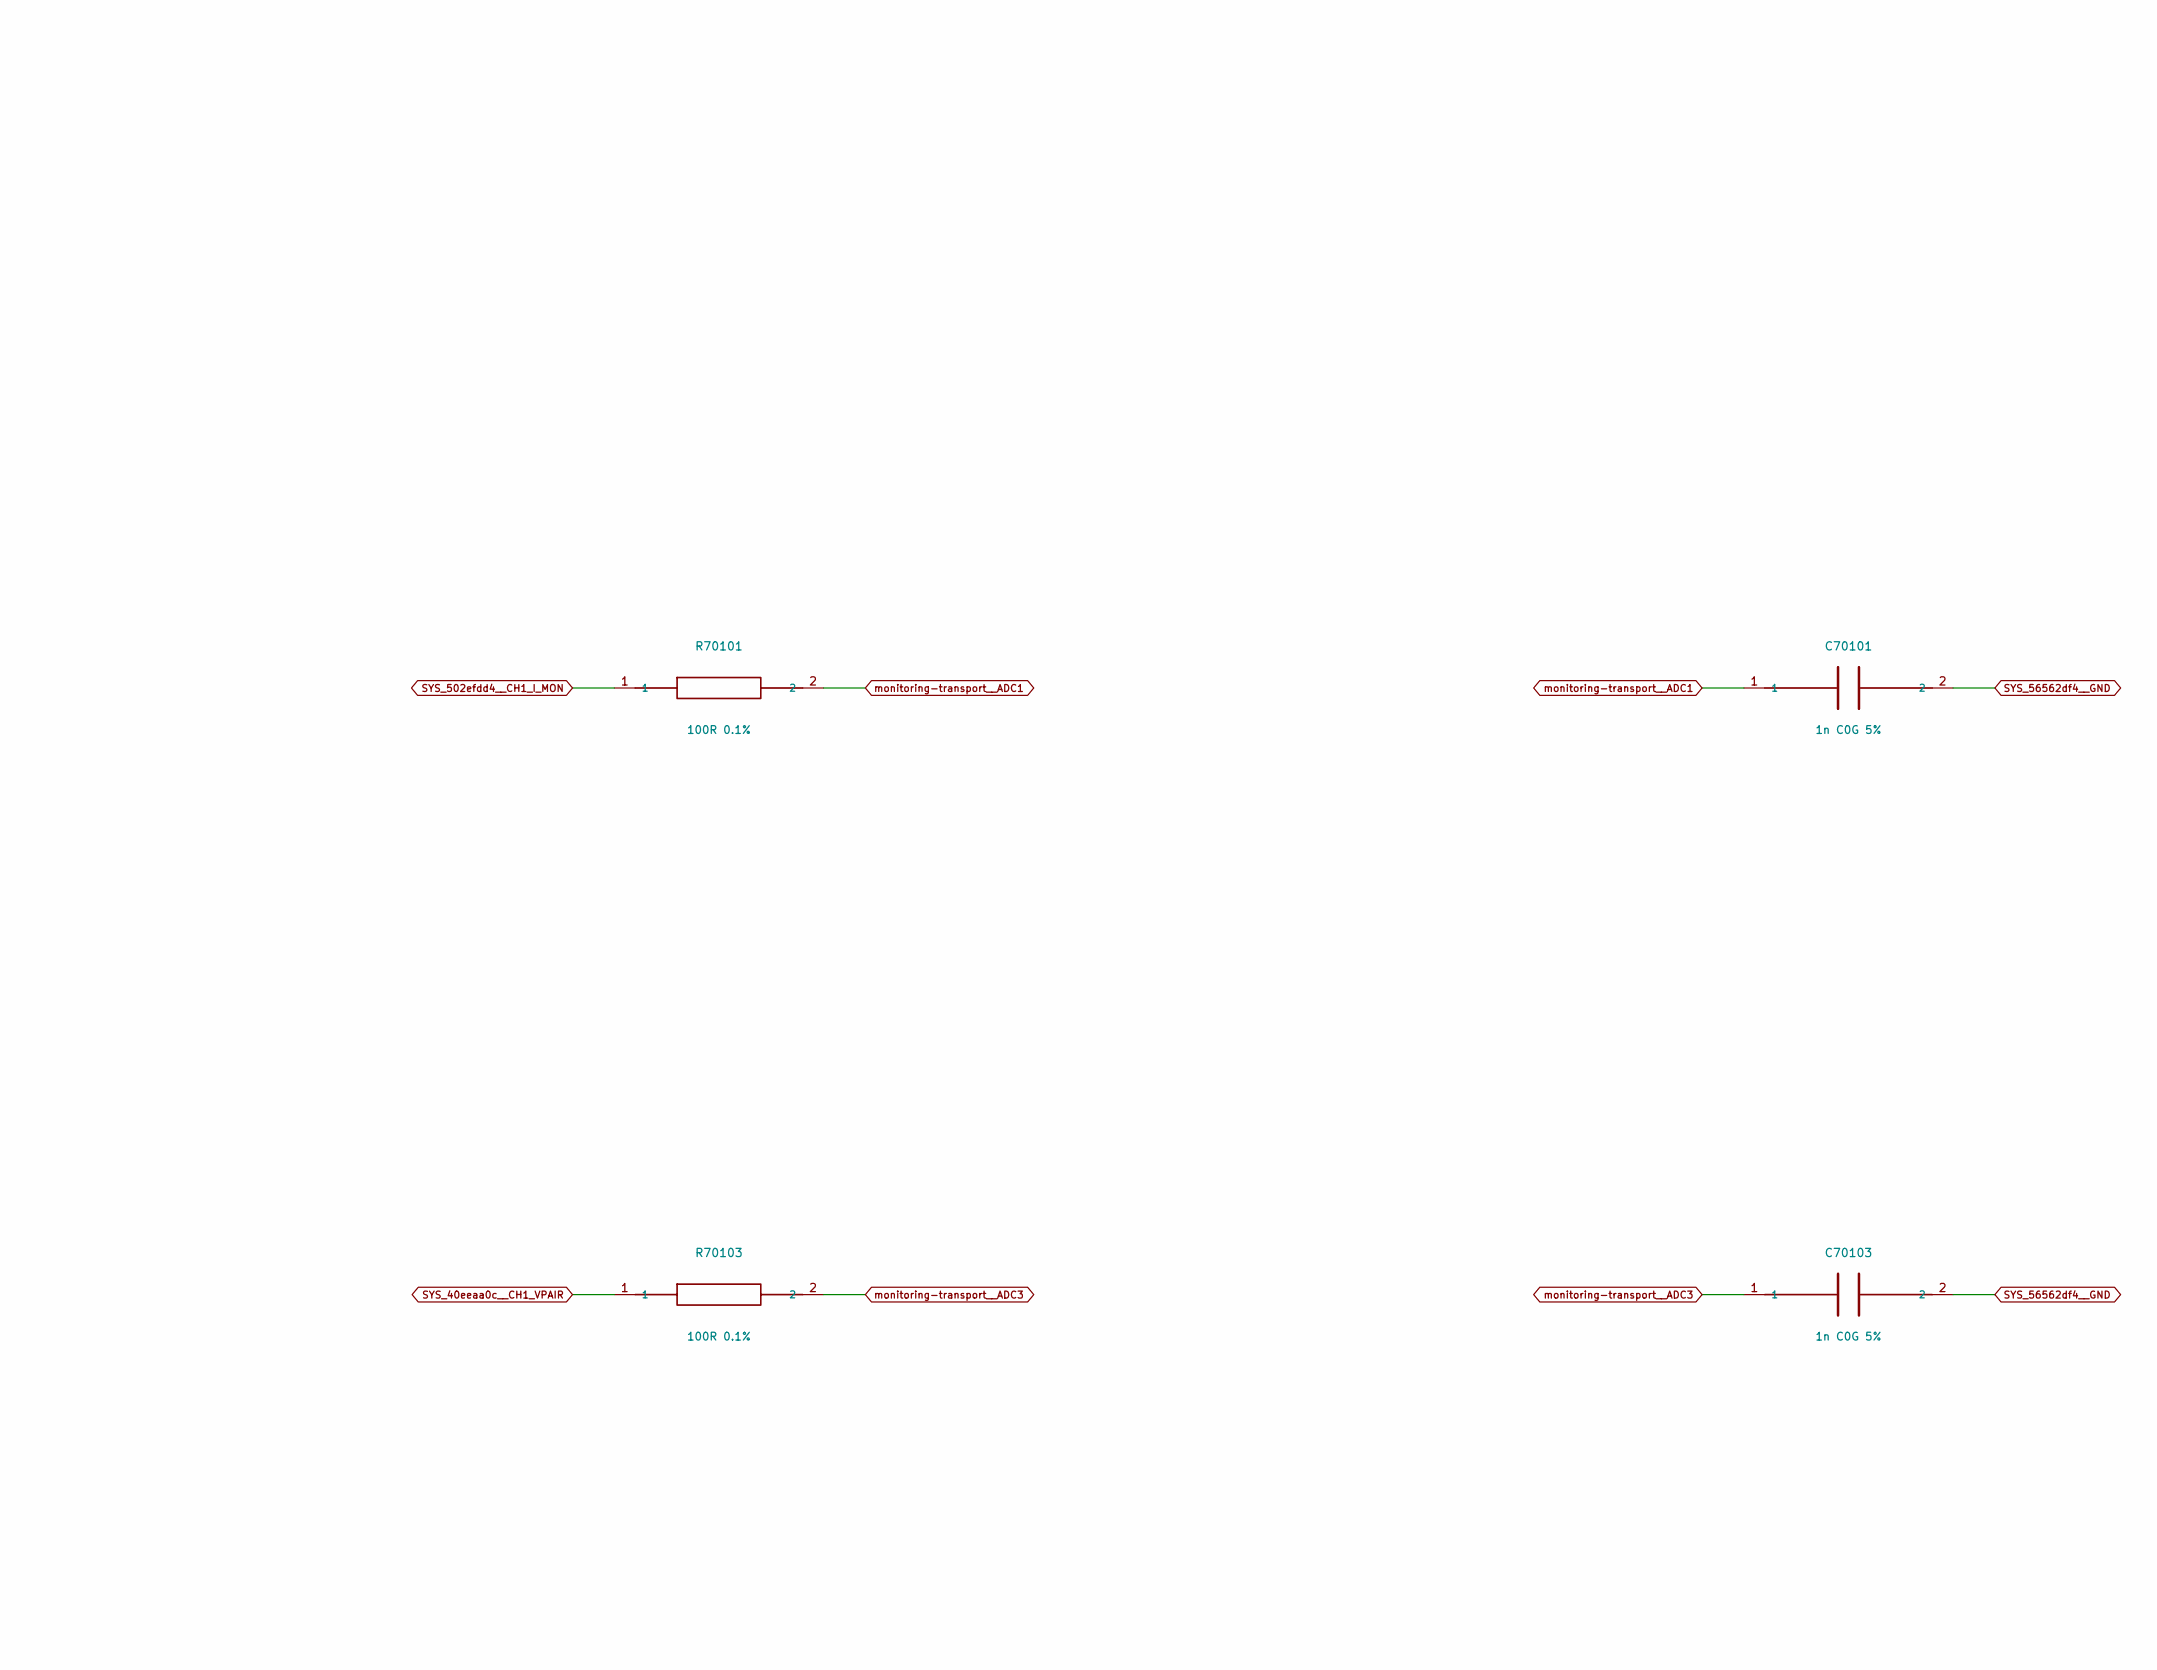
[picture p390: schematic inputs.kicad_sch, ATO S4 / Raw current and scaled voltage filtering, part in row 1, column 2]

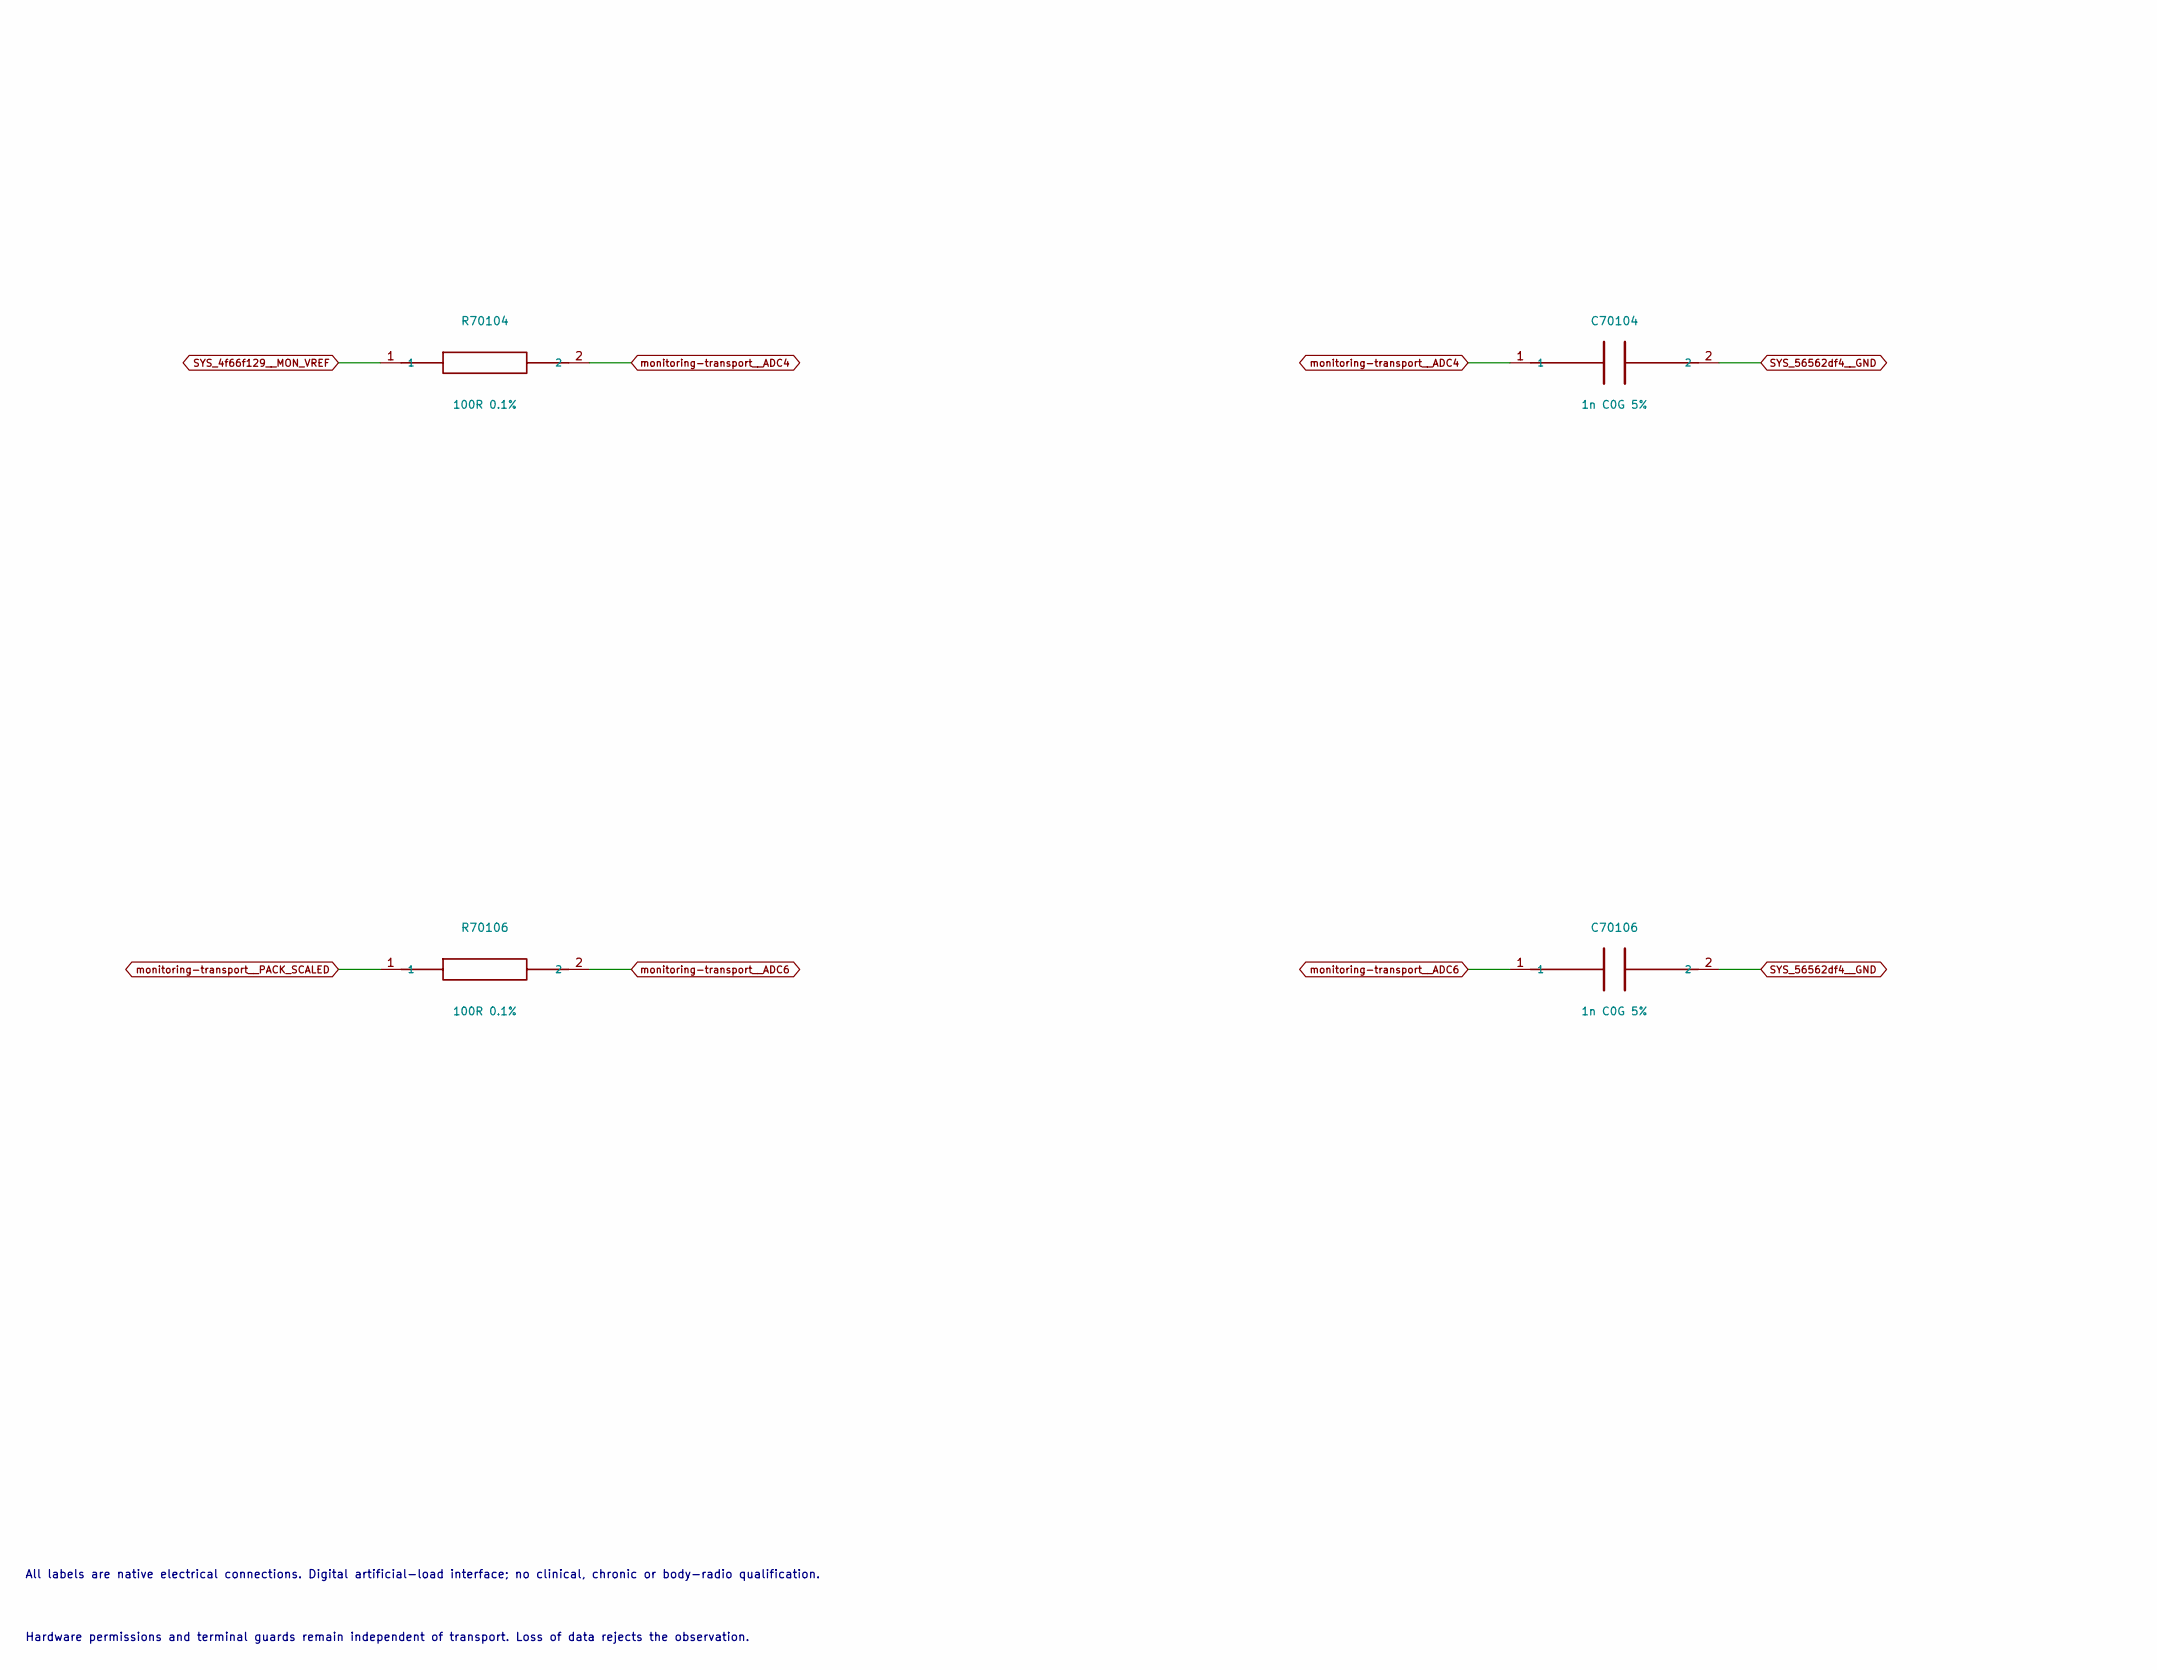
[picture p391: schematic inputs.kicad_sch, ATO S4 / Raw current and scaled voltage filtering, part in row 2, column 1]

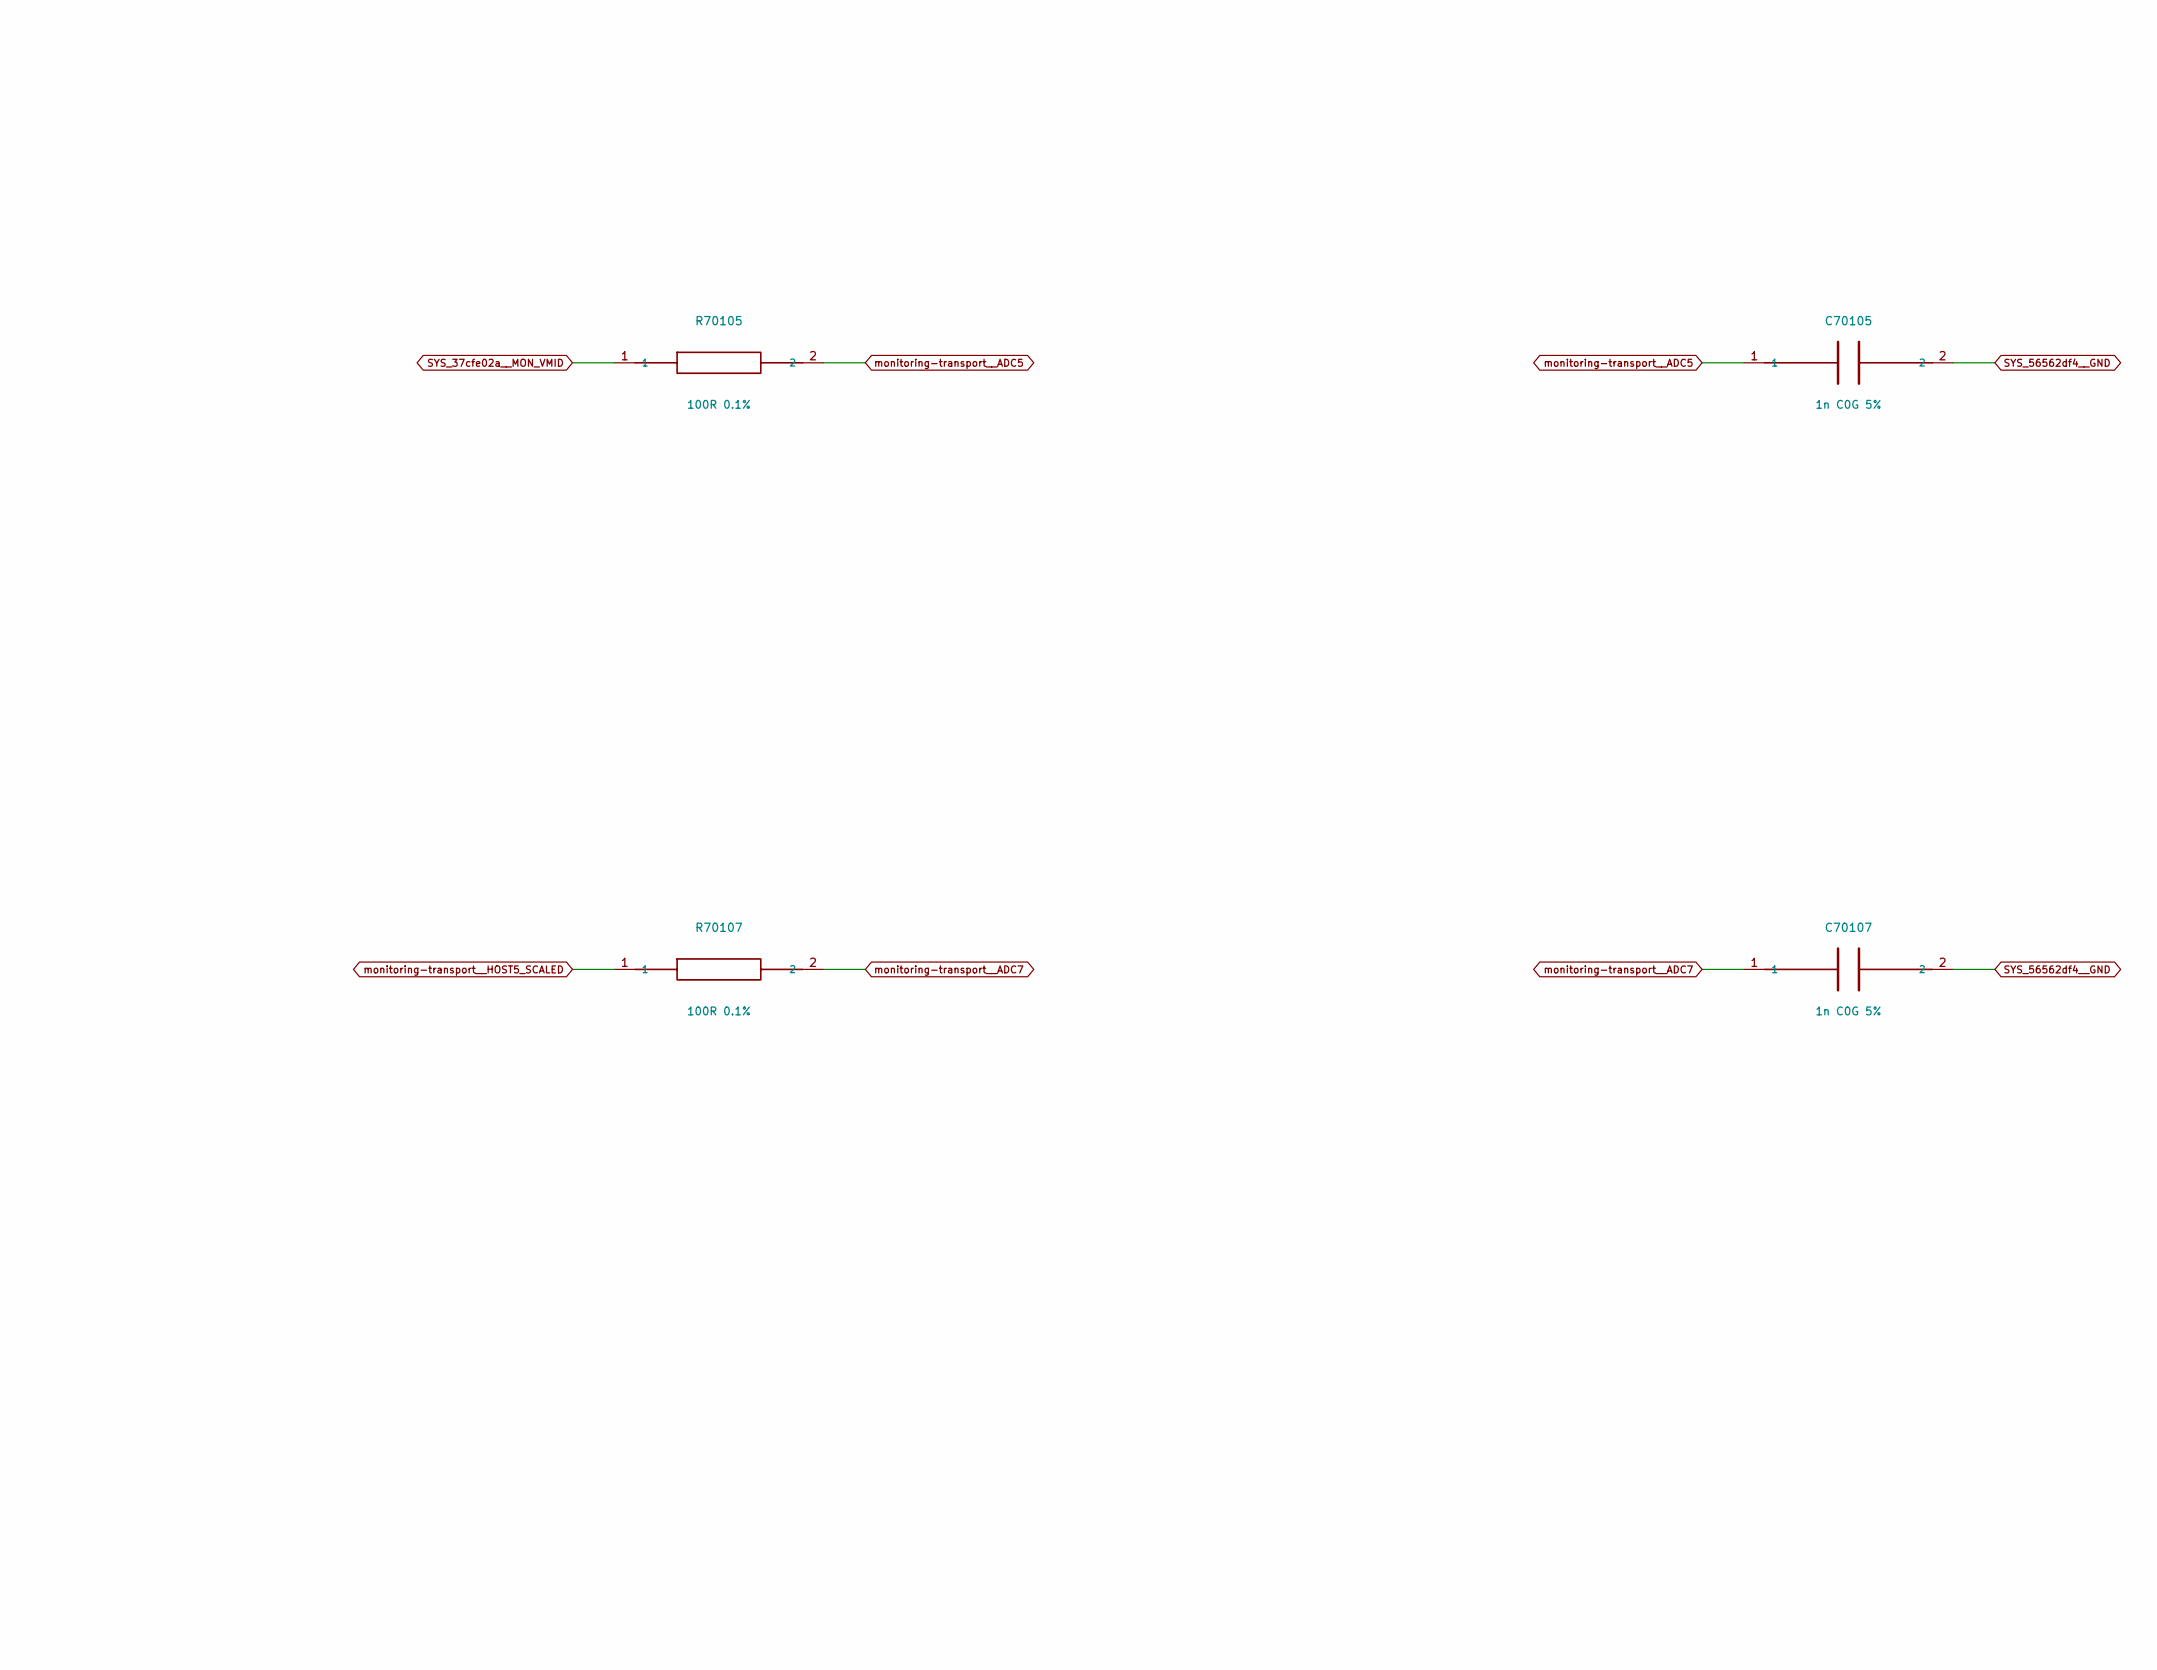
[picture p392: schematic inputs.kicad_sch, ATO S4 / Raw current and scaled voltage filtering, part in row 2, column 2]

Parts:
C70100, C70101, C70102, C70103, C70104, C70105, C70106, C70107: 1n C0G 5%; C_1206_3216Metric
R70100, R70101, R70102, R70103, R70104, R70105, R70106, R70107: 100R 0.1%; R_0805_2012Metric

Connections:
SYS_4f66f129__MON_VREF: R70104.1; also elsewhere on the board
SYS_37cfe02a__MON_VMID: R70105.1; also elsewhere on the board
SYS_40eeaa0c__CH1_VPAIR: R70103.1; also elsewhere on the board
SYS_502efdd4__CH1_I_MON: R70101.1; also elsewhere on the board
SYS_56562df4__GND: C70100.2, C70101.2, C70102.2, C70103.2, C70104.2, C70105.2, C70106.2, C70107.2; also elsewhere on the board
SYS_baff84b5__CH0_VPAIR: R70102.1; also elsewhere on the board
SYS_f8e43b73__CH0_I_MON: R70100.1; also elsewhere on the board
monitoring-transport__ADC0: C70100.1, R70100.2; also elsewhere on the board
monitoring-transport__ADC1: C70101.1, R70101.2; also elsewhere on the board
monitoring-transport__ADC2: C70102.1, R70102.2; also elsewhere on the board
monitoring-transport__ADC3: C70103.1, R70103.2; also elsewhere on the board
monitoring-transport__ADC4: C70104.1, R70104.2; also elsewhere on the board
monitoring-transport__ADC5: C70105.1, R70105.2; also elsewhere on the board
monitoring-transport__ADC6: C70106.1, R70106.2; also elsewhere on the board
monitoring-transport__ADC7: C70107.1, R70107.2; also elsewhere on the board
monitoring-transport__HOST5_SCALED: R70107.1; also elsewhere on the board
monitoring-transport__PACK_SCALED: R70106.1; also elsewhere on the board

Notes on the sheet:
DIGITAL SCCI ENGINEERING / ARTIFICIAL SIGNALS / MONITORING AND COMPANION
Dedicated raw current/voltage ADC and wired processed-feature companion. Endpoint charge ADCs remain separate.
All labels are native electrical connections. Digital artificial-load interface; no clinical, chronic or body-radio qualification.
Hardware permissions and terminal guards remain independent of transport. Loss of data rejects the observation.
