pratham-cloud-ctrl/Project-ATO/electronics/stage4/integrated-pcb/boards/monitoring-transport/monitoring_transport.kicad_pcb

## KiCad design electronics/stage4/integrated-pcb/boards/monitoring-transport/monitoring_transport.kicad_pcb (continued)

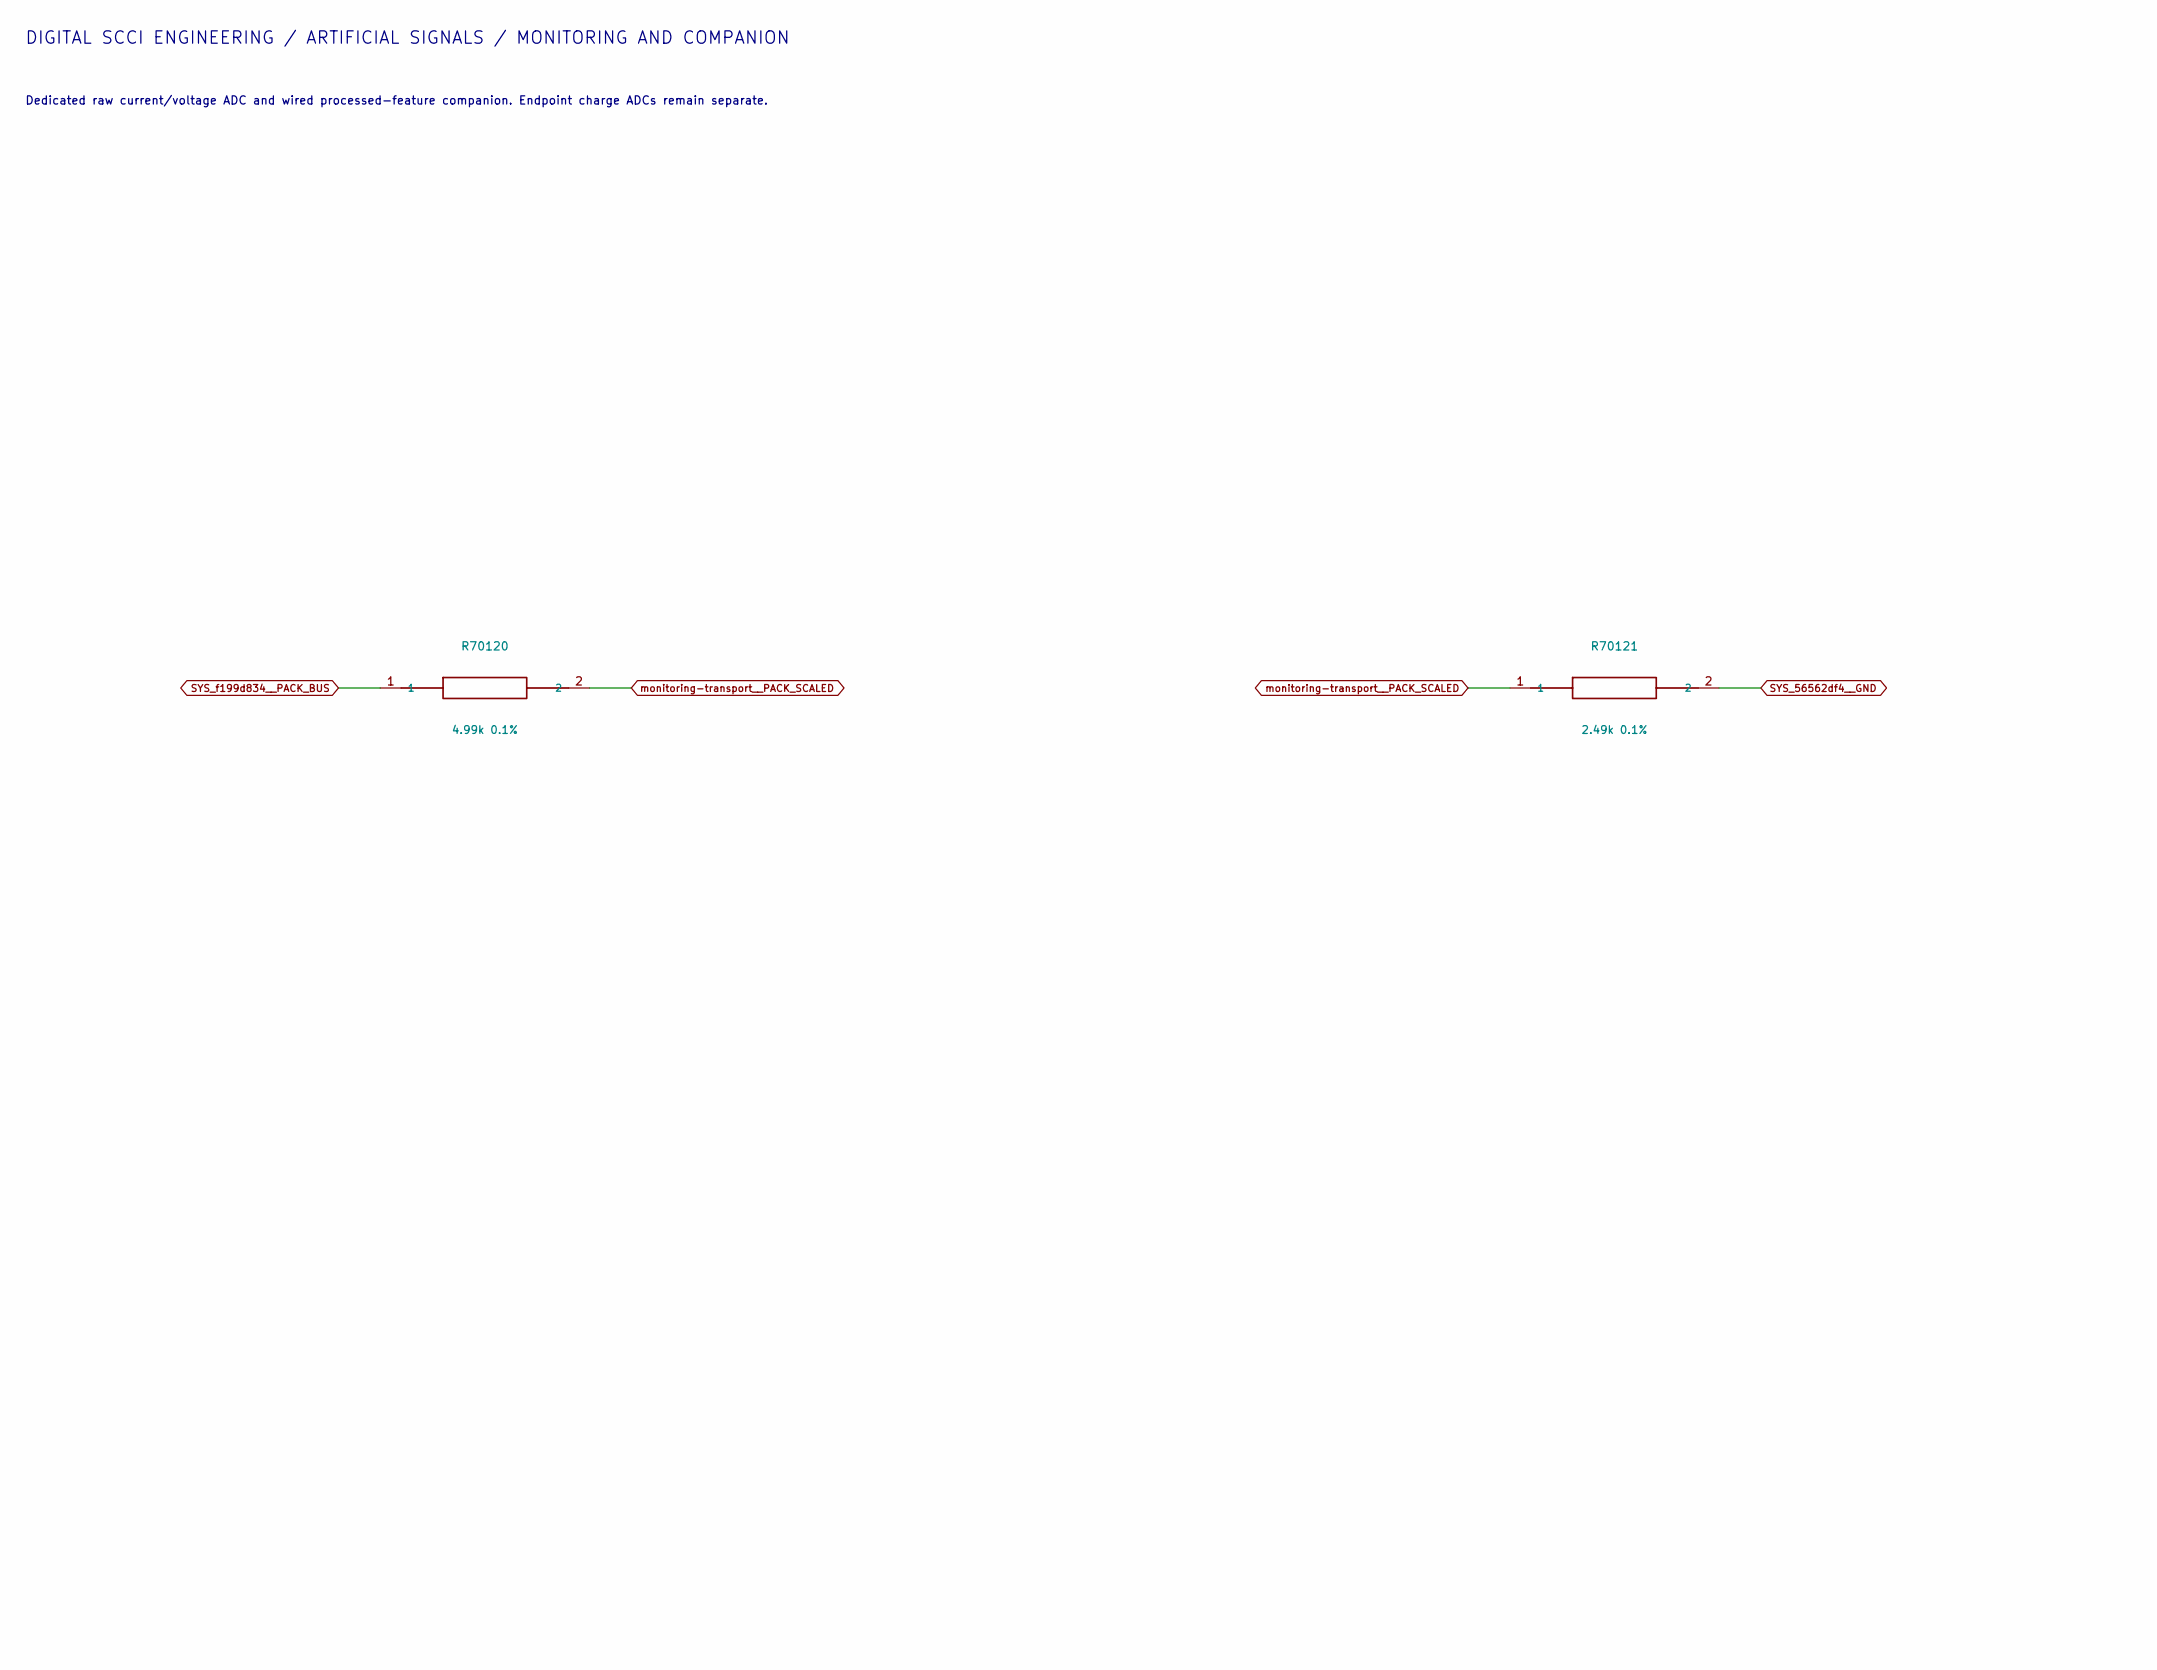
[picture p393: schematic health.kicad_sch, ATO S4 / Divided power observations, part in row 1, column 1]

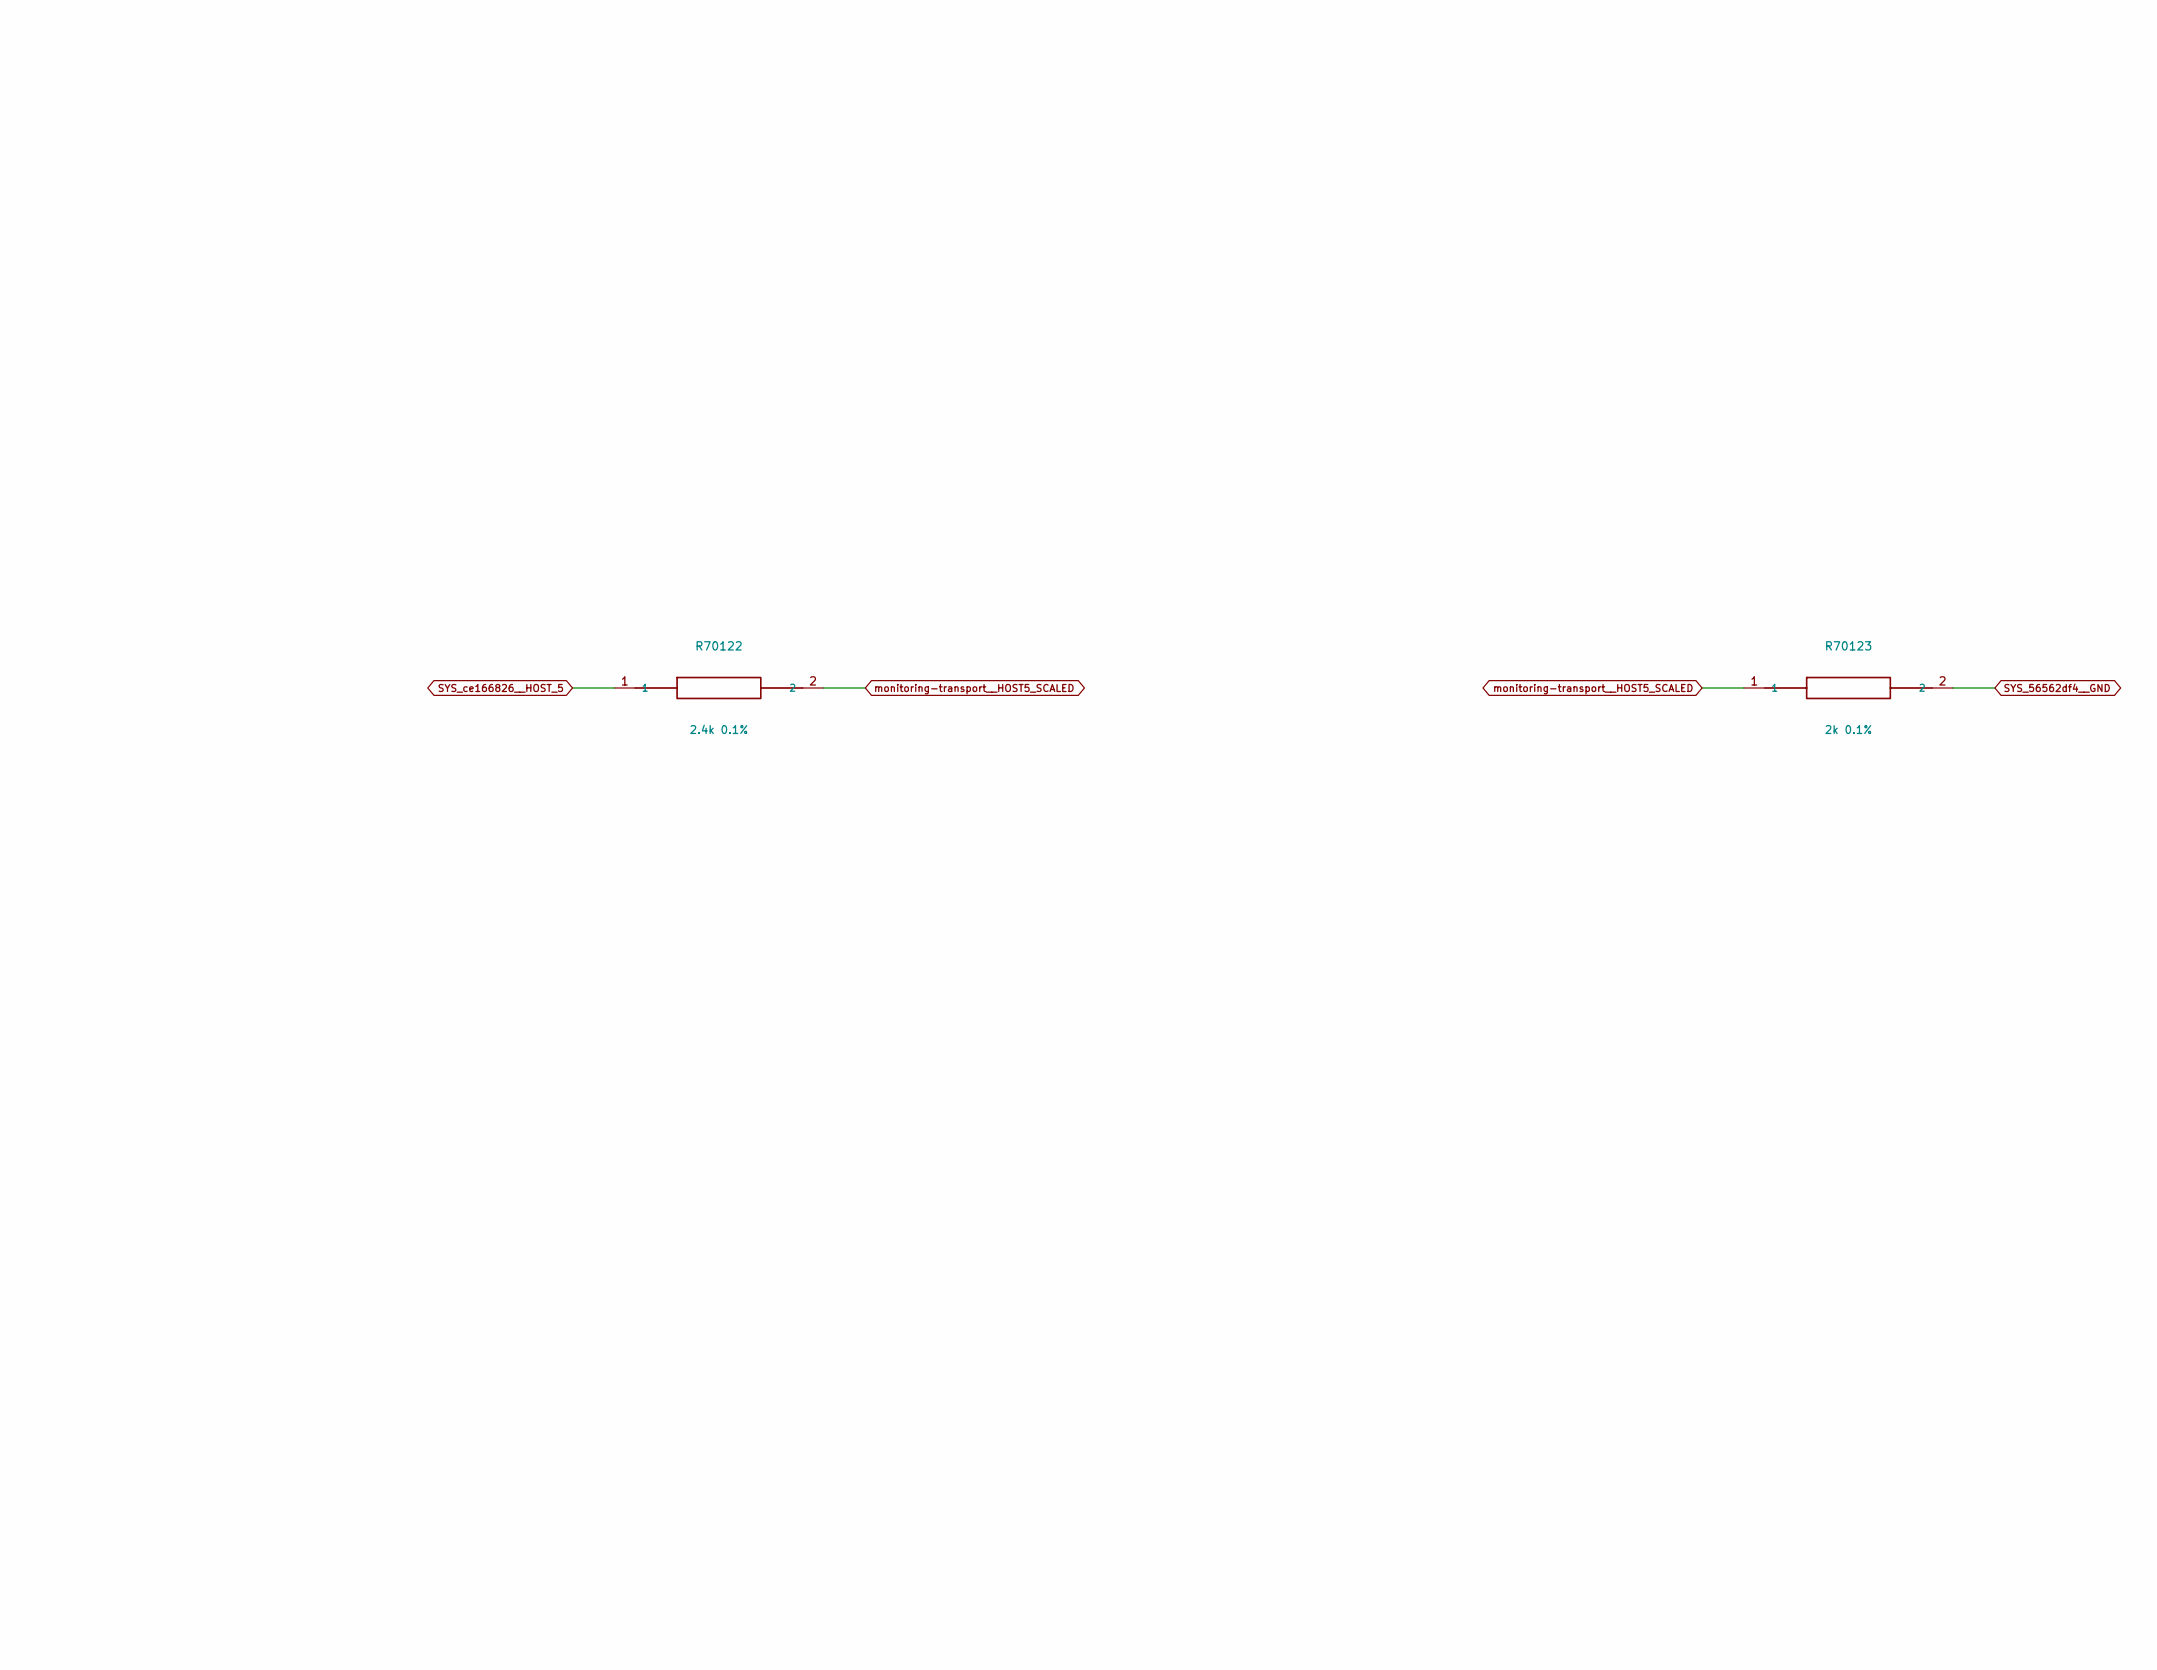
[picture p394: schematic health.kicad_sch, ATO S4 / Divided power observations, part in row 1, column 2]

Parts:
R70120: 4.99k 0.1%; R_0805_2012Metric
R70121: 2.49k 0.1%; R_0805_2012Metric
R70122: 2.4k 0.1%; R_0805_2012Metric
R70123: 2k 0.1%; R_0805_2012Metric

Connections:
SYS_56562df4__GND: R70121.2, R70123.2; also elsewhere on the board
SYS_ce166826__HOST_5: R70122.1; also elsewhere on the board
SYS_f199d834__PACK_BUS: R70120.1; also elsewhere on the board
monitoring-transport__HOST5_SCALED: R70122.2, R70123.1; also elsewhere on the board
monitoring-transport__PACK_SCALED: R70120.2, R70121.1; also elsewhere on the board

Notes on the sheet:
DIGITAL SCCI ENGINEERING / ARTIFICIAL SIGNALS / MONITORING AND COMPANION
Dedicated raw current/voltage ADC and wired processed-feature companion. Endpoint charge ADCs remain separate.
All labels are native electrical connections. Digital artificial-load interface; no clinical, chronic or body-radio qualification.
Hardware permissions and terminal guards remain independent of transport. Loss of data rejects the observation.
