pratham-cloud-ctrl/Project-ATO/electronics/stage4/integrated-pcb/boards/monitoring-transport/monitoring_transport.kicad_pcb

## KiCad design electronics/stage4/integrated-pcb/boards/monitoring-transport/monitoring_transport.kicad_pcb (continued)

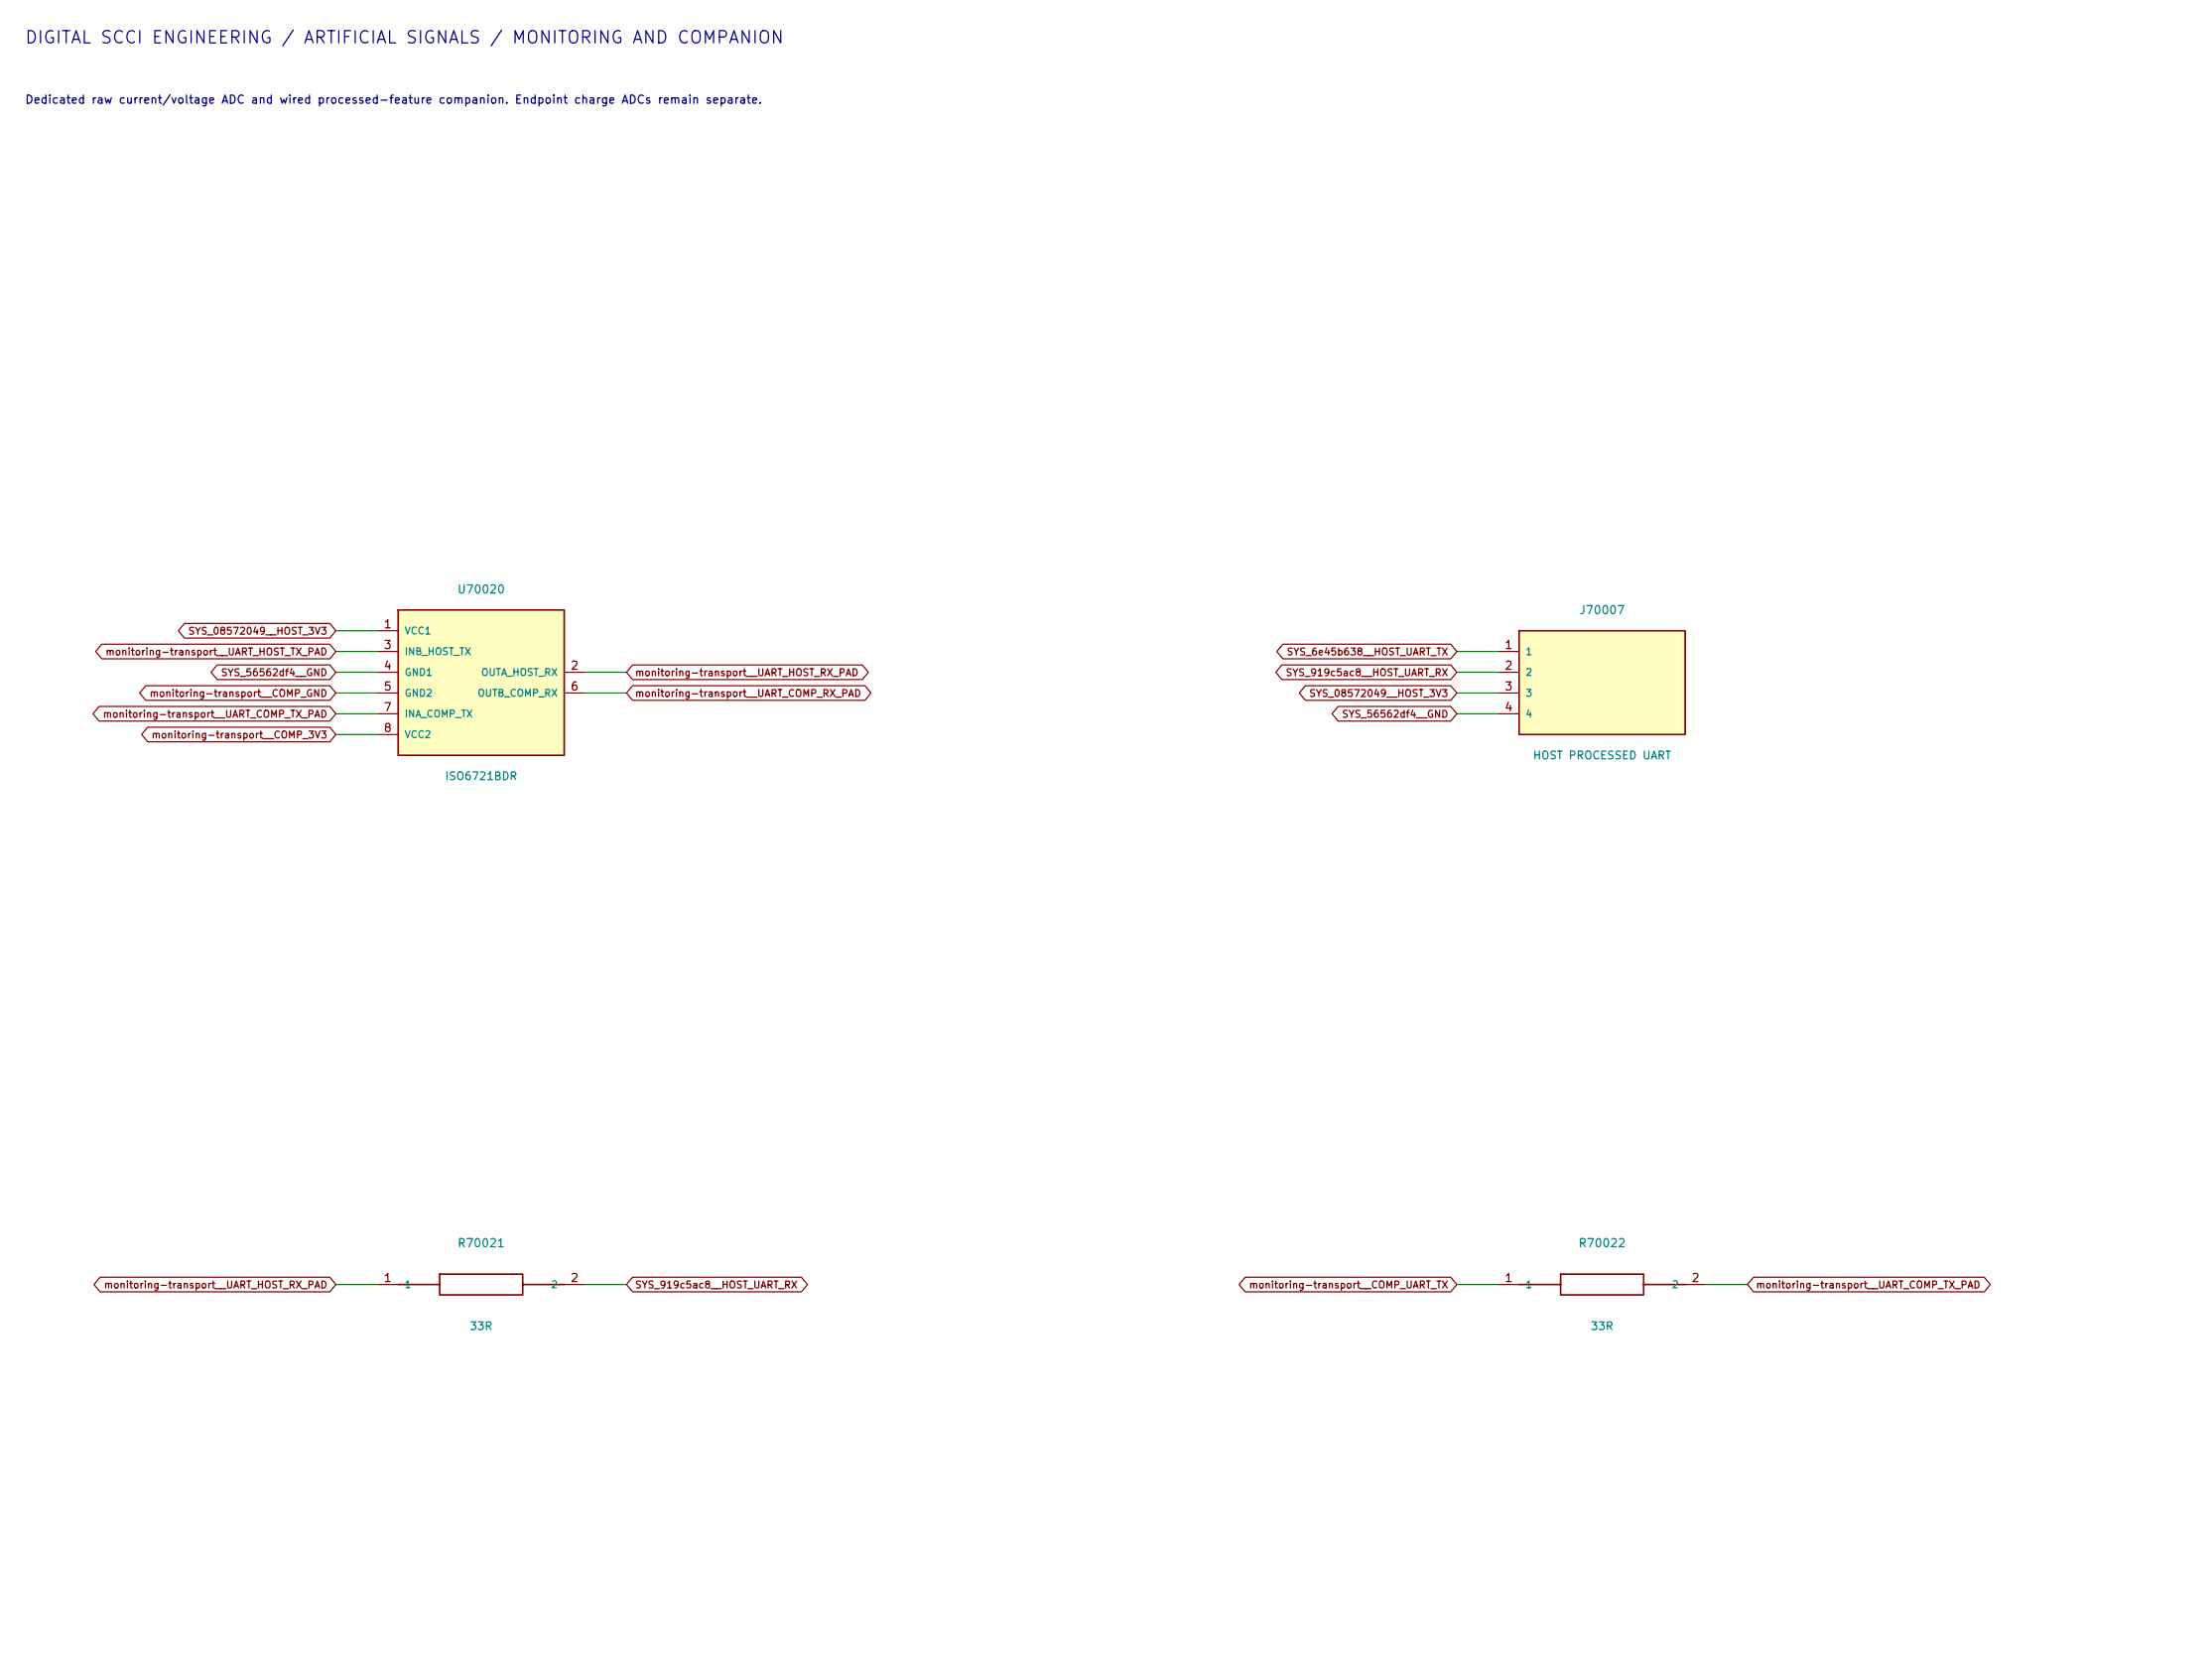
[picture p395: schematic companion.kicad_sch, ATO S4 / Isolated wired processed-feature companion, part in row 1, column 1]

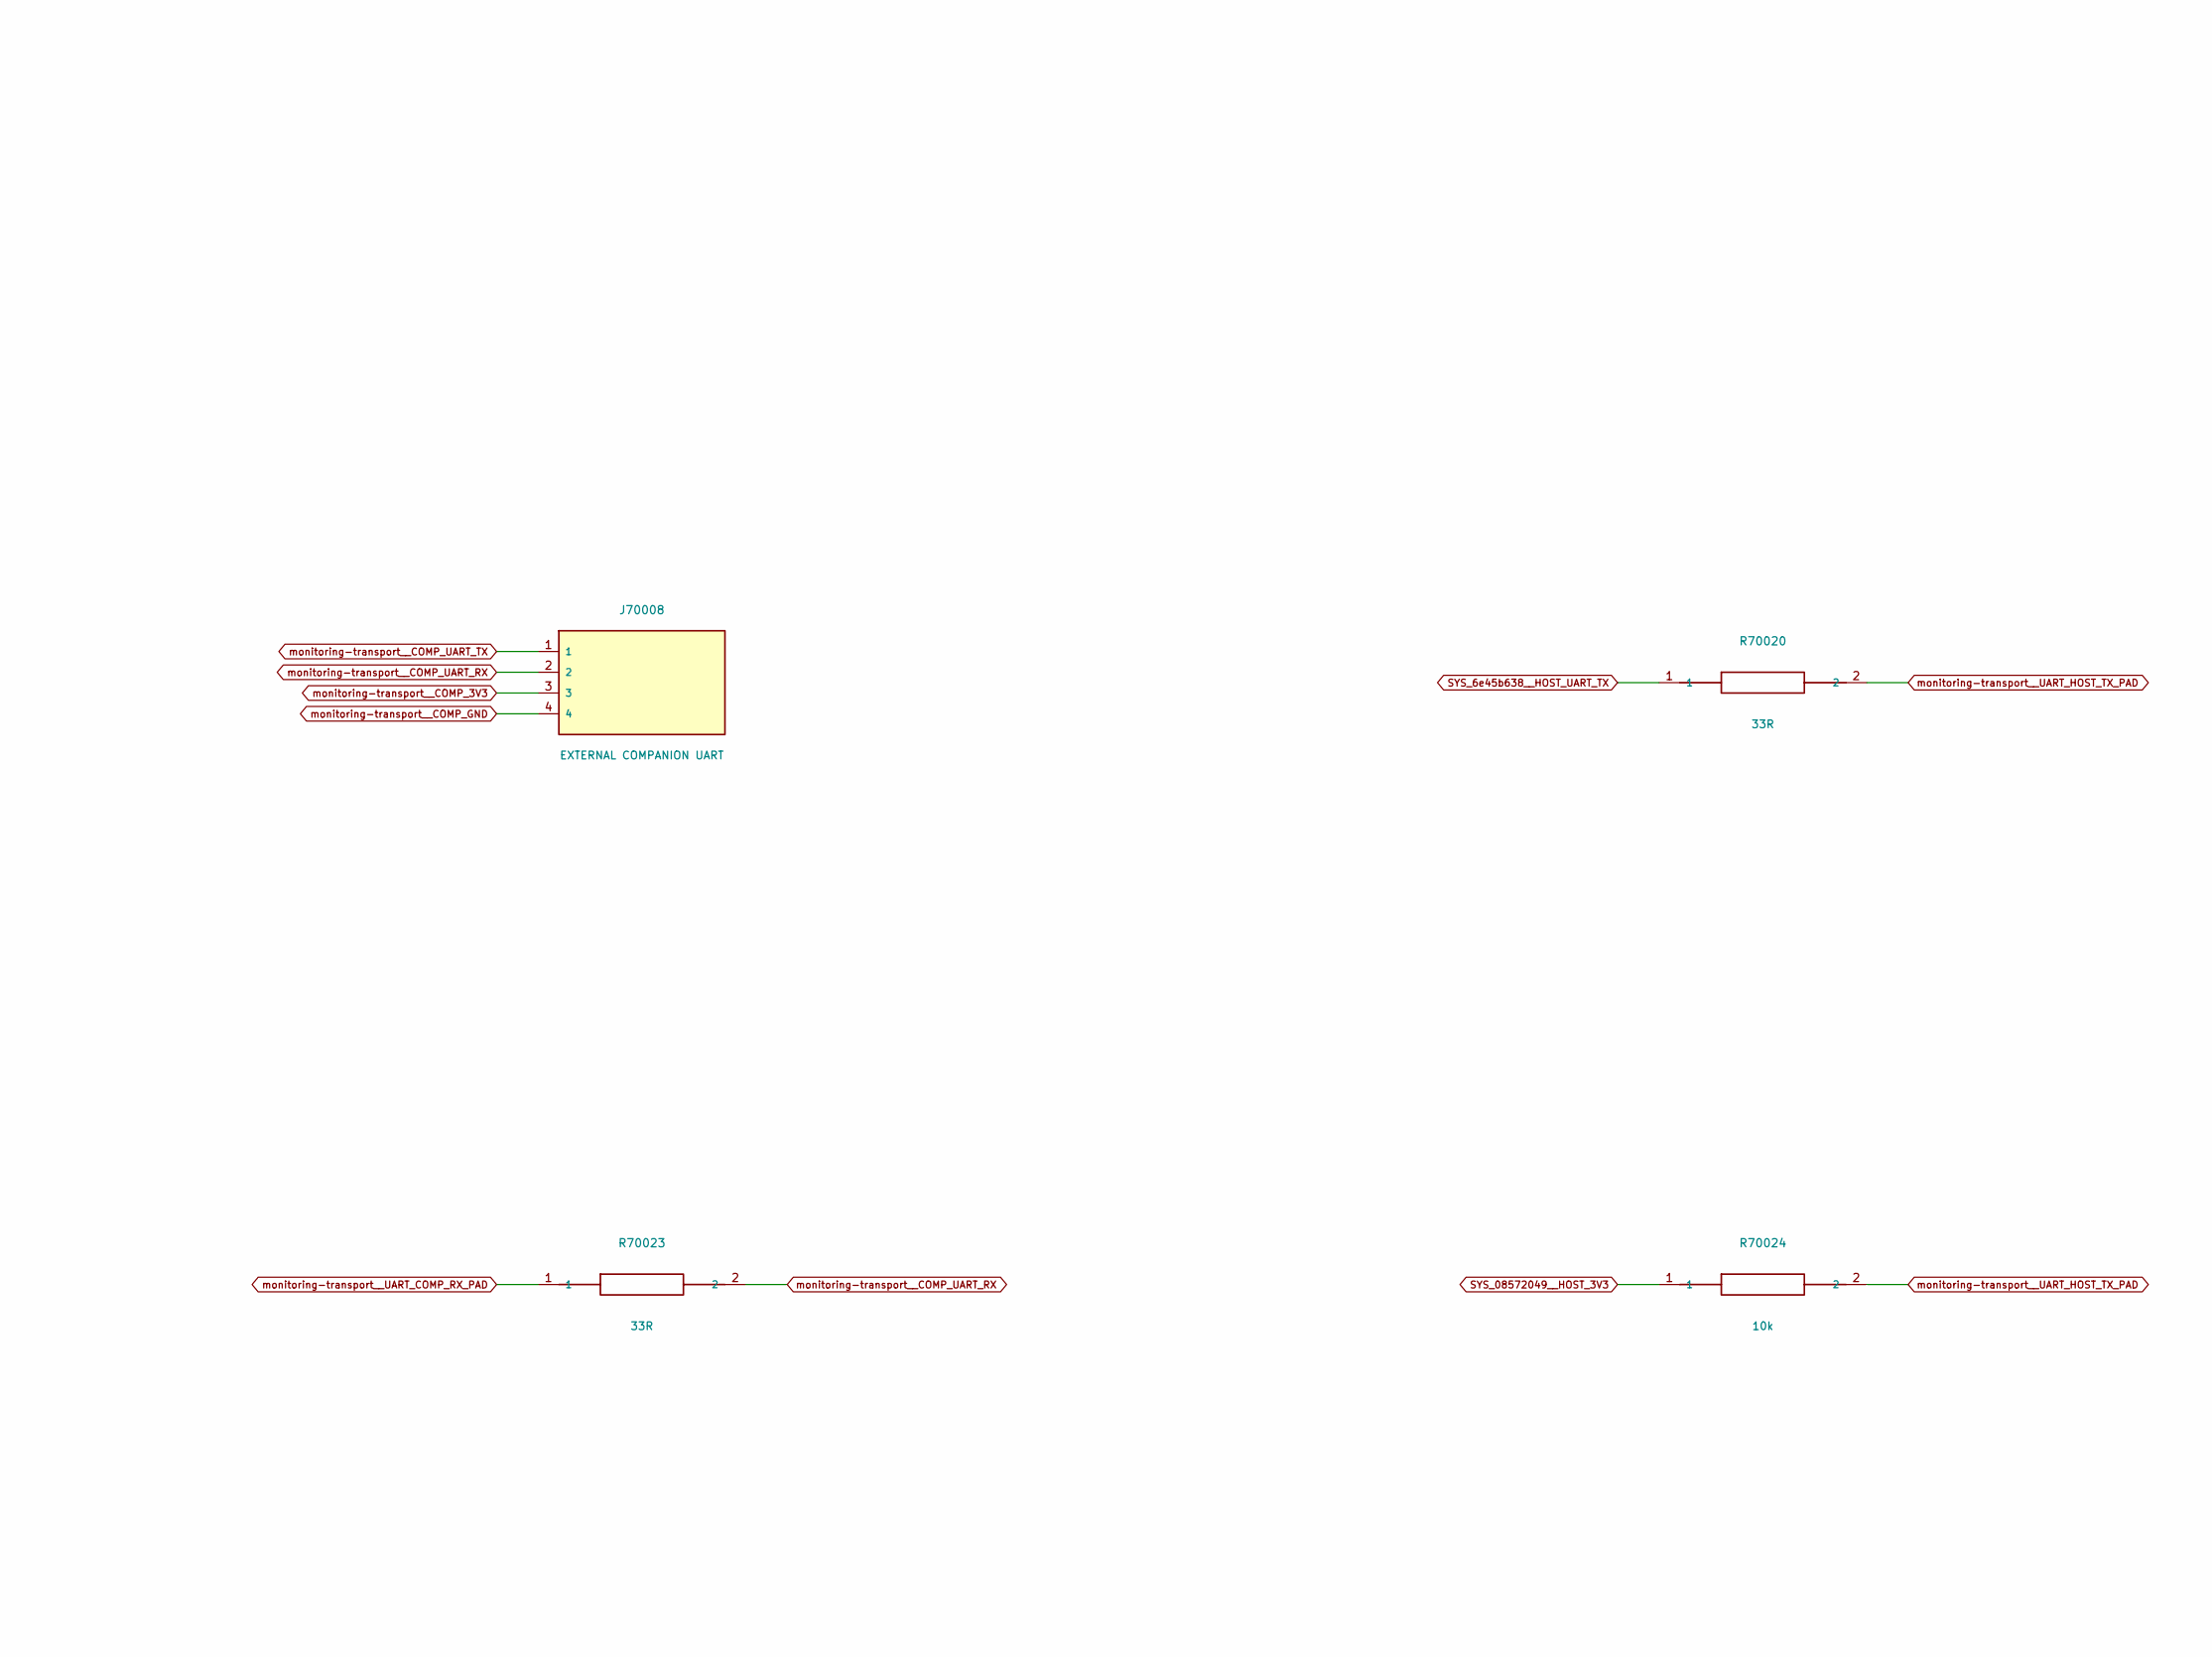
[picture p396: schematic companion.kicad_sch, ATO S4 / Isolated wired processed-feature companion, part in row 1, column 2]

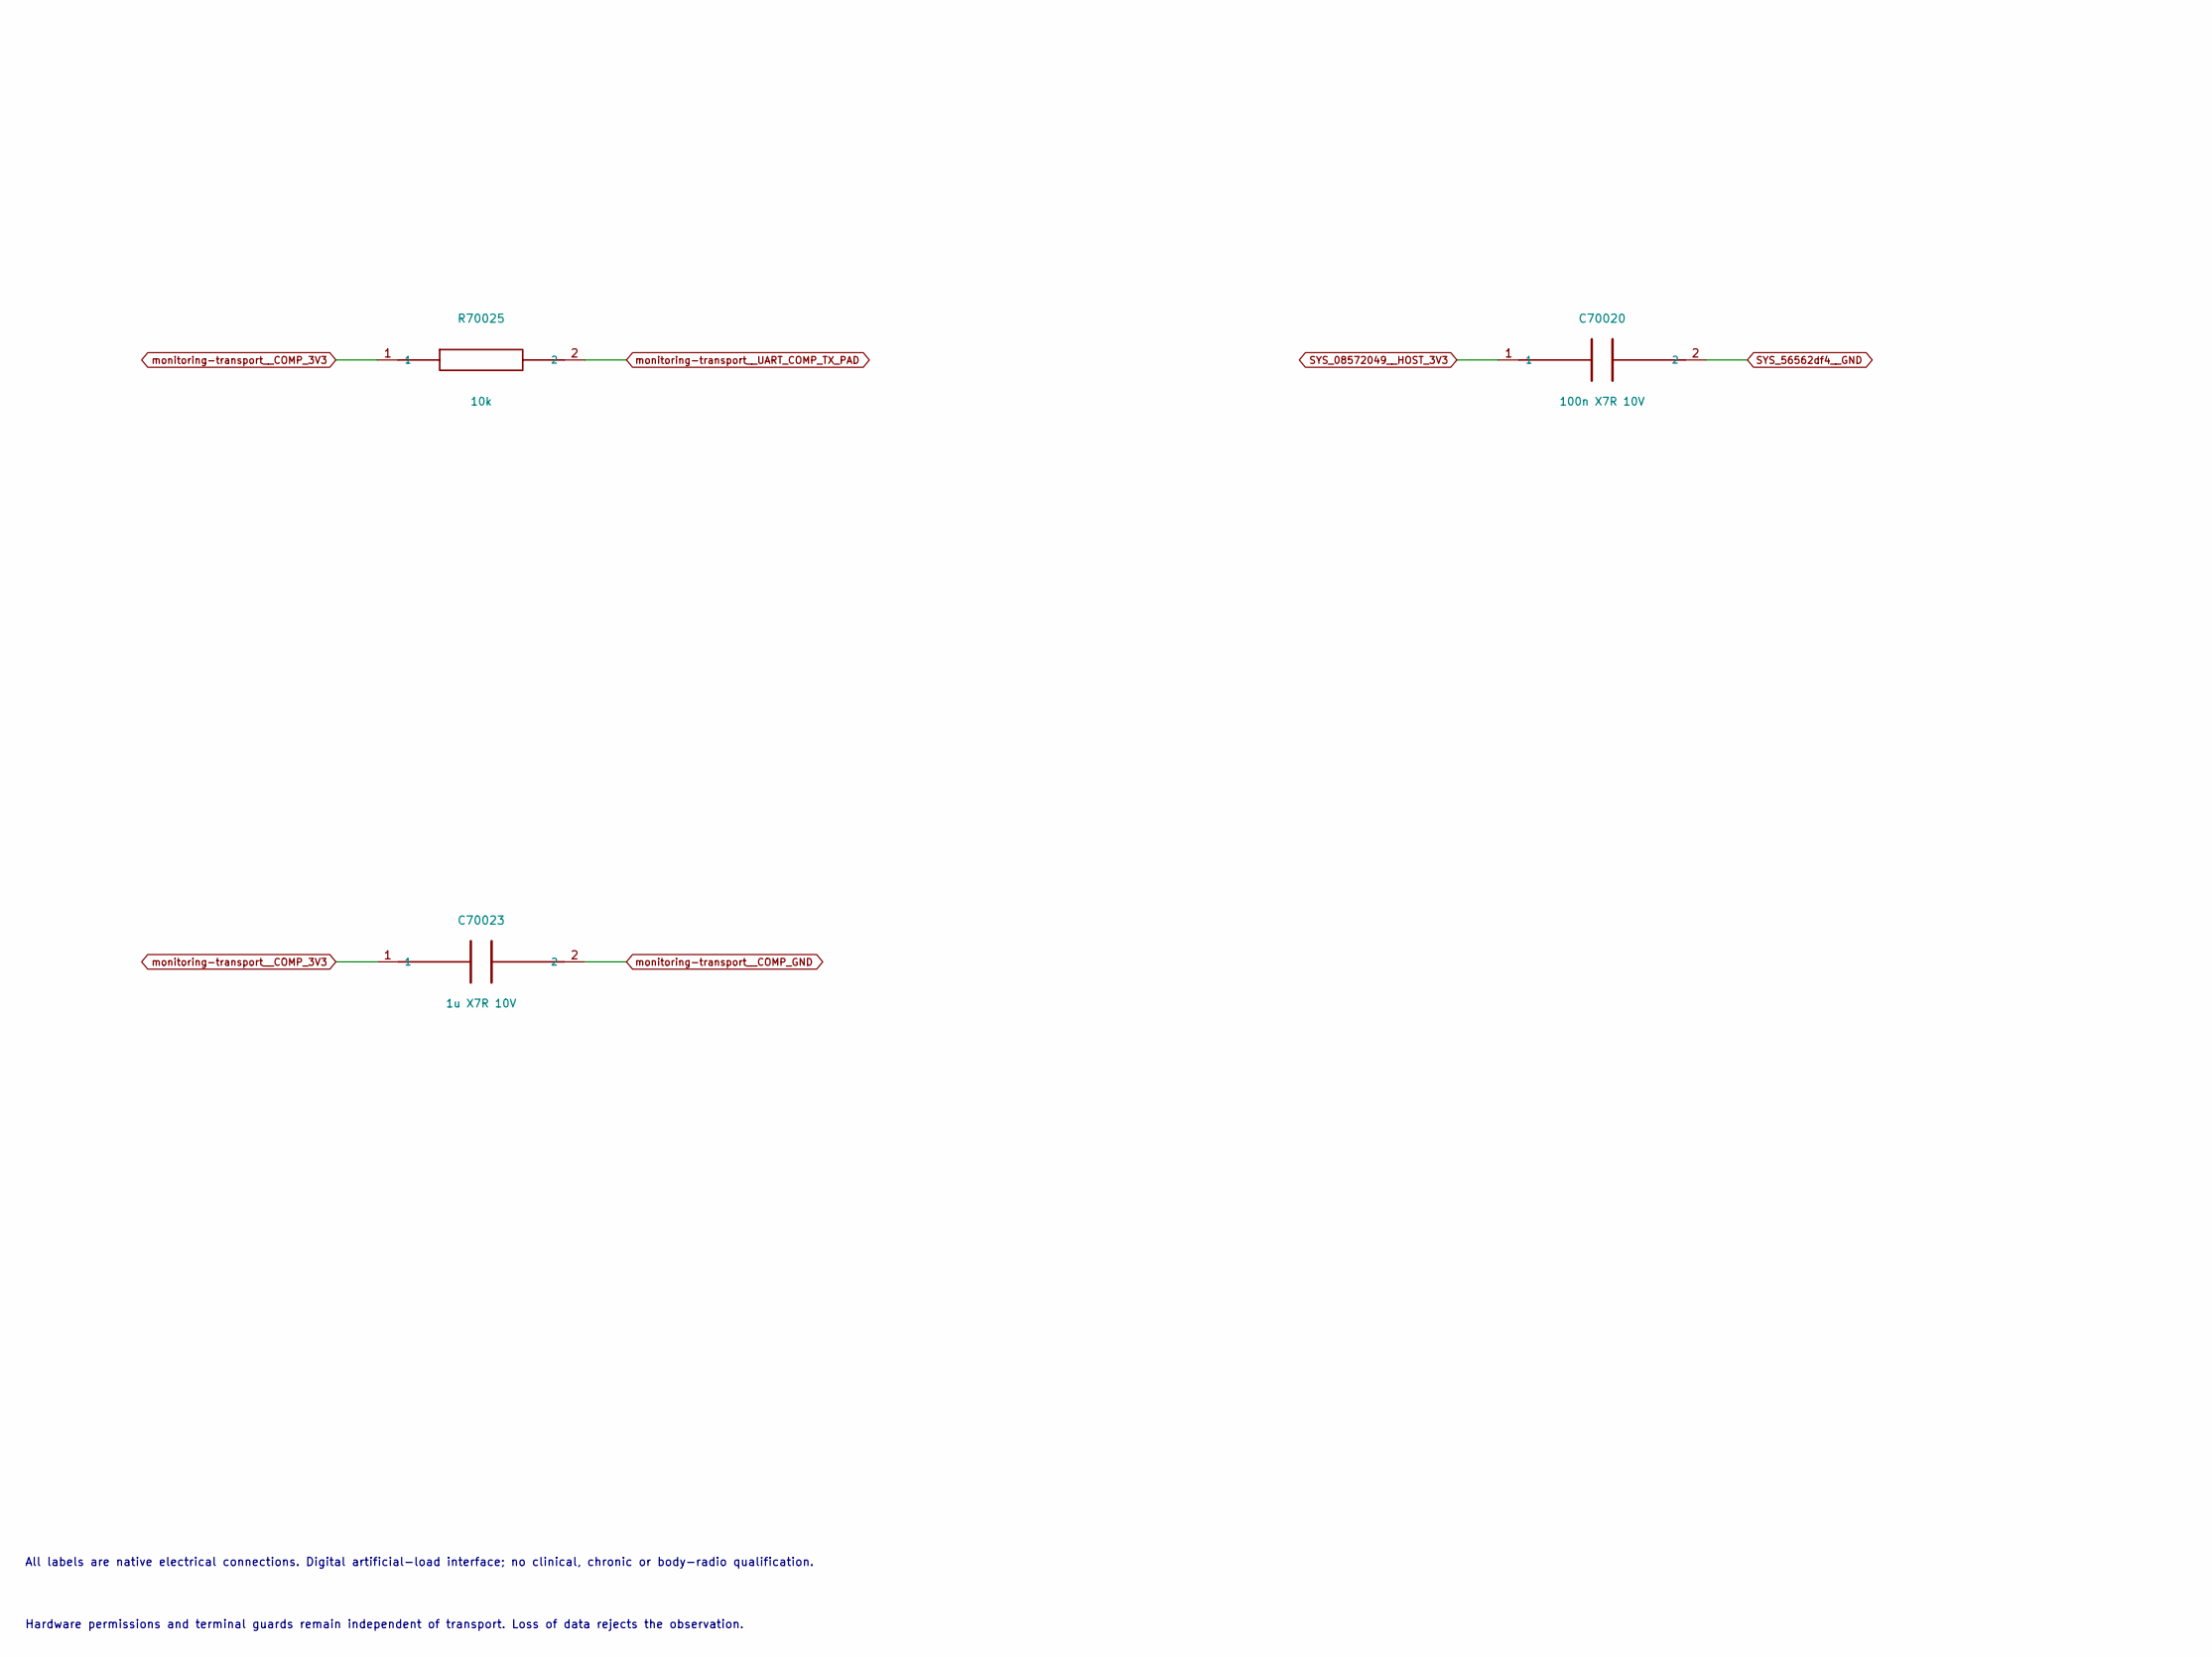
[picture p397: schematic companion.kicad_sch, ATO S4 / Isolated wired processed-feature companion, part in row 2, column 1]

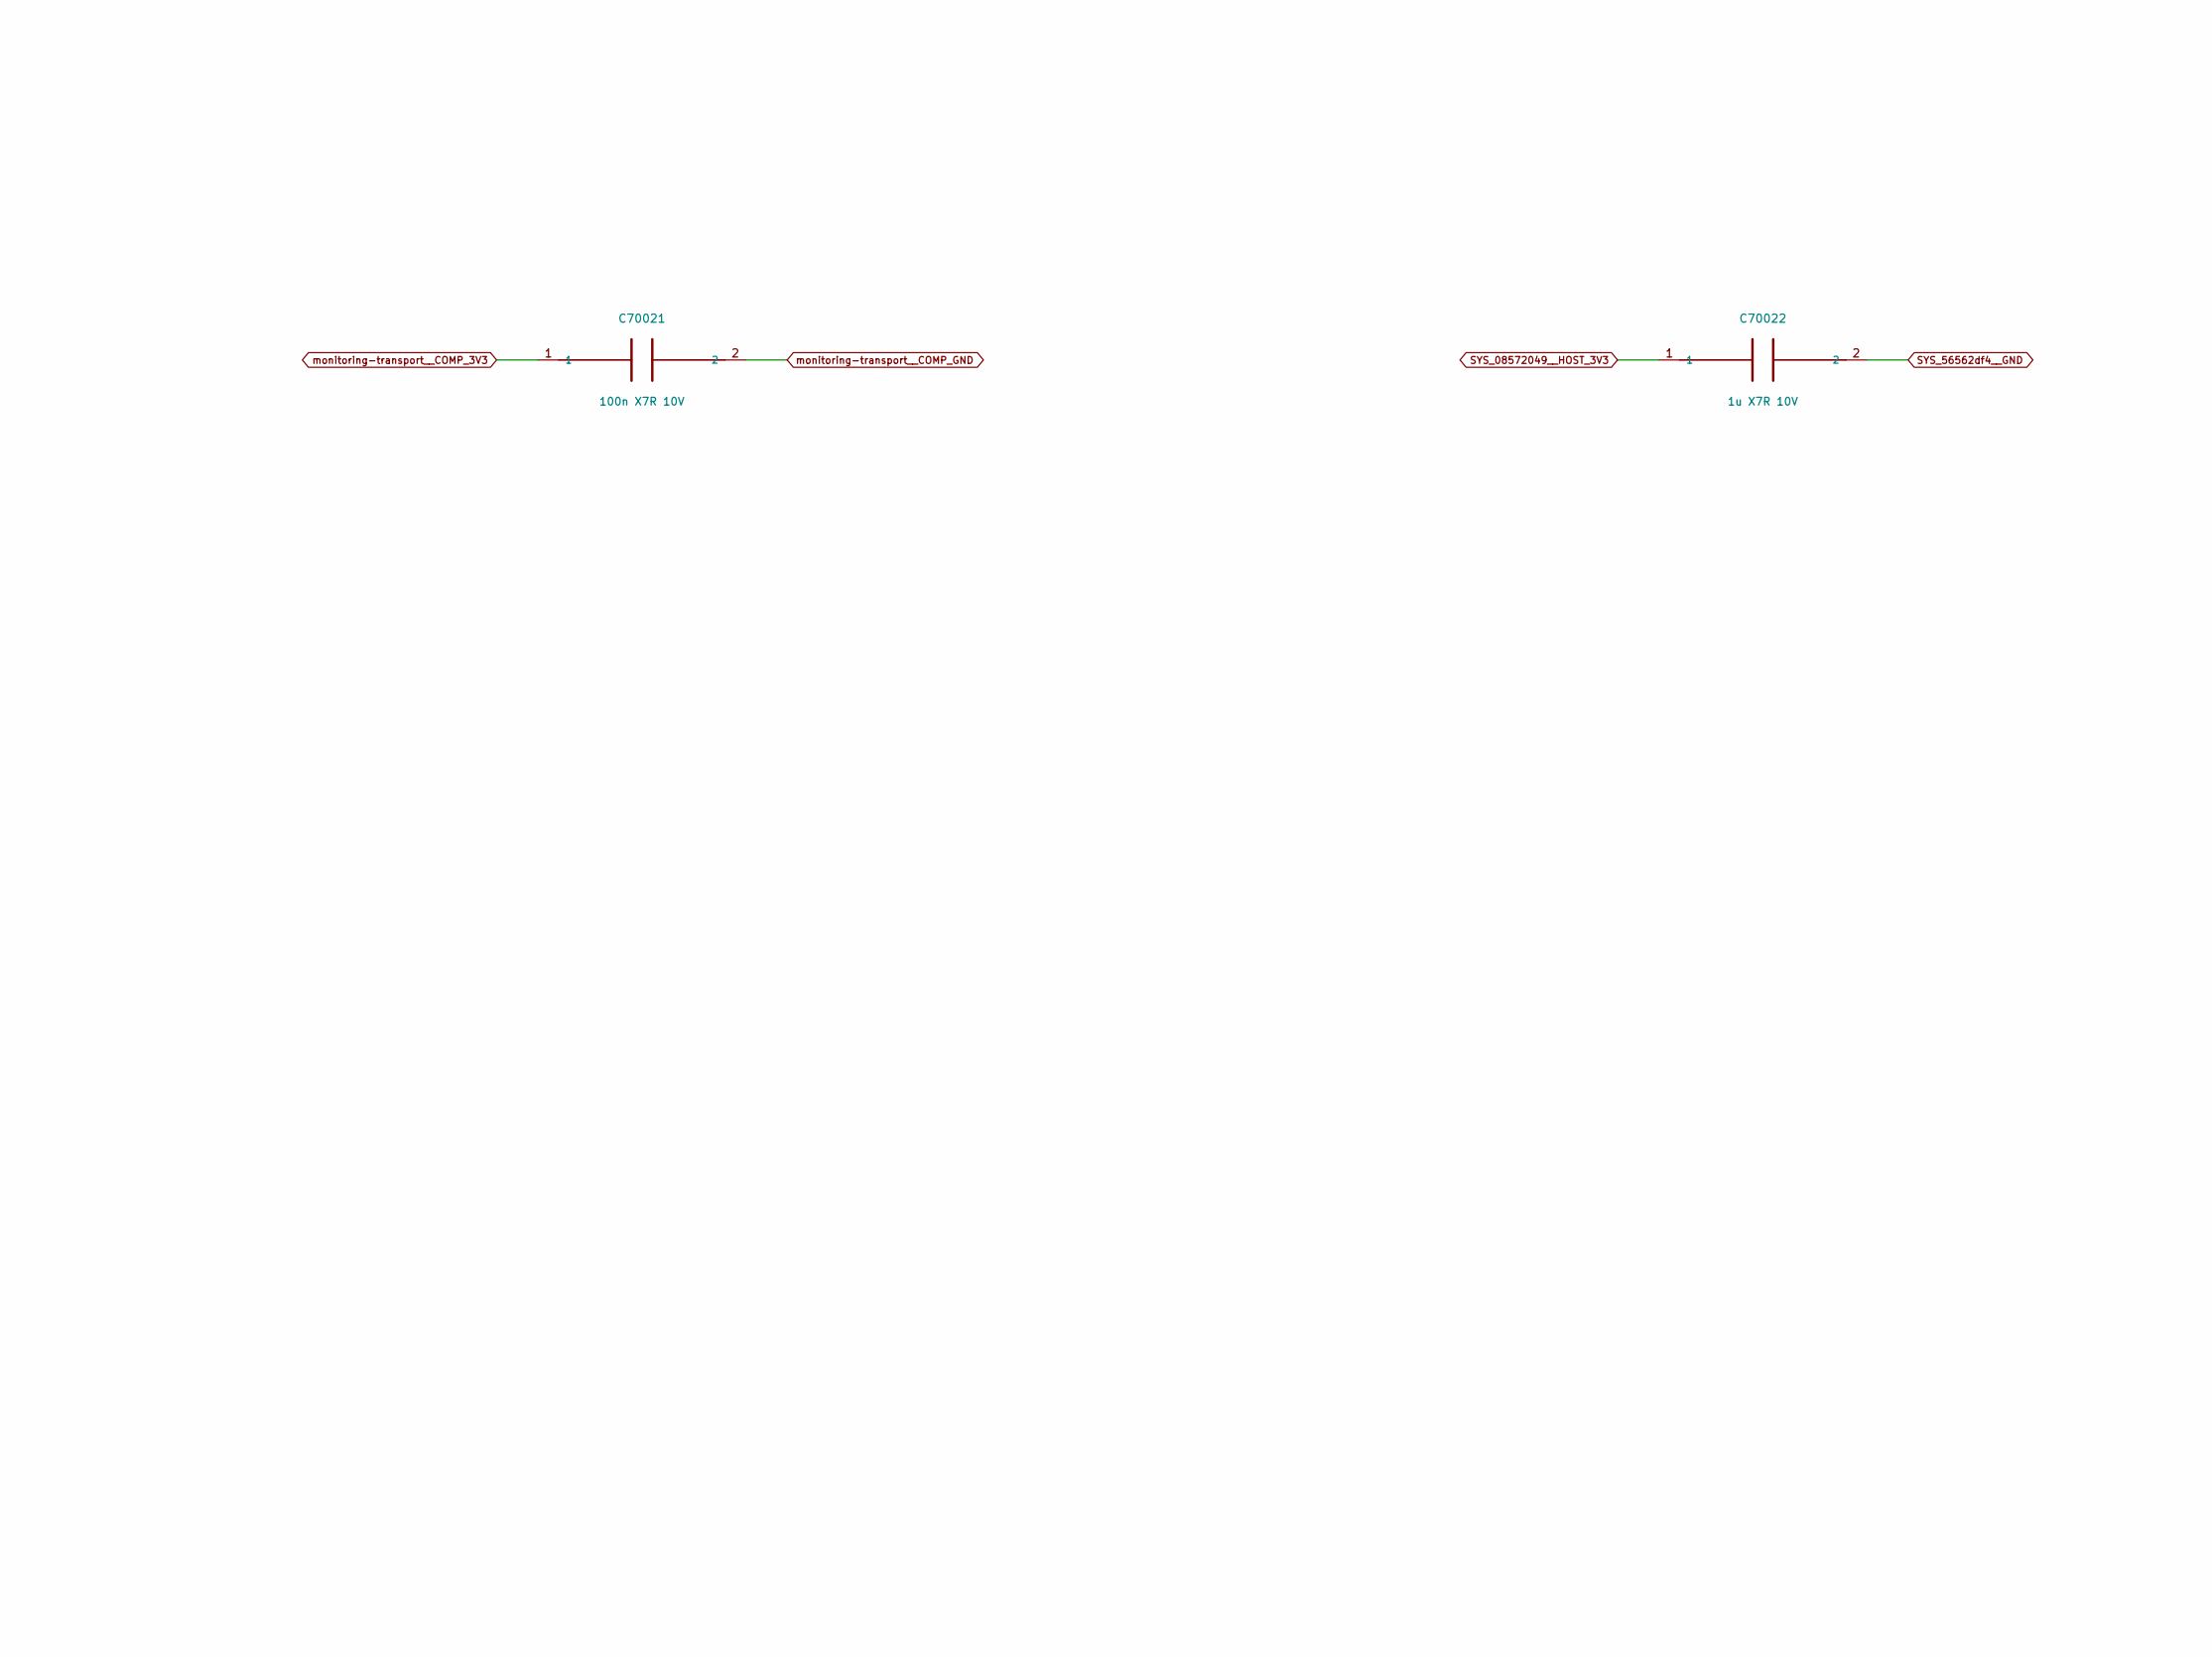
[picture p398: schematic companion.kicad_sch, ATO S4 / Isolated wired processed-feature companion, part in row 2, column 2]

Parts:
C70020, C70021: 100n X7R 10V; C_1206_3216Metric
C70022, C70023: 1u X7R 10V; C_1206_3216Metric
J70007: HOST PROCESSED UART; PinHeader_1x04_P2.54mm_Vertical
J70008: EXTERNAL COMPANION UART; PinHeader_1x04_P2.54mm_Vertical
R70020, R70021, R70022, R70023: 33R; R_0805_2012Metric
R70024, R70025: 10k; R_0805_2012Metric
U70020: ISO6721BDR; SOIC-8_3.9x4.9mm_P1.27mm

Connections:
SYS_6e45b638__HOST_UART_TX: J70007.1, R70020.1
SYS_919c5ac8__HOST_UART_RX: J70007.2, R70021.2
SYS_56562df4__GND: C70020.2, C70022.2, J70007.4, U70020.4 (GND1); also elsewhere on the board
SYS_08572049__HOST_3V3: C70020.1, C70022.1, J70007.3, R70024.1, U70020.1 (VCC1); also elsewhere on the board
monitoring-transport__COMP_3V3: C70021.1, C70023.1, J70008.3, R70025.1, U70020.8 (VCC2)
monitoring-transport__COMP_GND: C70021.2, C70023.2, J70008.4, U70020.5 (GND2)
monitoring-transport__COMP_UART_RX: J70008.2, R70023.2
monitoring-transport__COMP_UART_TX: J70008.1, R70022.1
monitoring-transport__UART_COMP_RX_PAD: R70023.1, U70020.6 (OUTB_COMP_RX)
monitoring-transport__UART_COMP_TX_PAD: R70022.2, R70025.2, U70020.7 (INA_COMP_TX)
monitoring-transport__UART_HOST_RX_PAD: R70021.1, U70020.2 (OUTA_HOST_RX)
monitoring-transport__UART_HOST_TX_PAD: R70020.2, R70024.2, U70020.3 (INB_HOST_TX)

Notes on the sheet:
DIGITAL SCCI ENGINEERING / ARTIFICIAL SIGNALS / MONITORING AND COMPANION
Dedicated raw current/voltage ADC and wired processed-feature companion. Endpoint charge ADCs remain separate.
All labels are native electrical connections. Digital artificial-load interface; no clinical, chronic or body-radio qualification.
Hardware permissions and terminal guards remain independent of transport. Loss of data rejects the observation.
