pratham-cloud-ctrl/Project-ATO/electronics/stage4/integrated-pcb/boards/monitoring-transport/monitoring_transport.kicad_pcb

## KiCad design electronics/stage4/integrated-pcb/boards/monitoring-transport/monitoring_transport.kicad_pcb (continued)

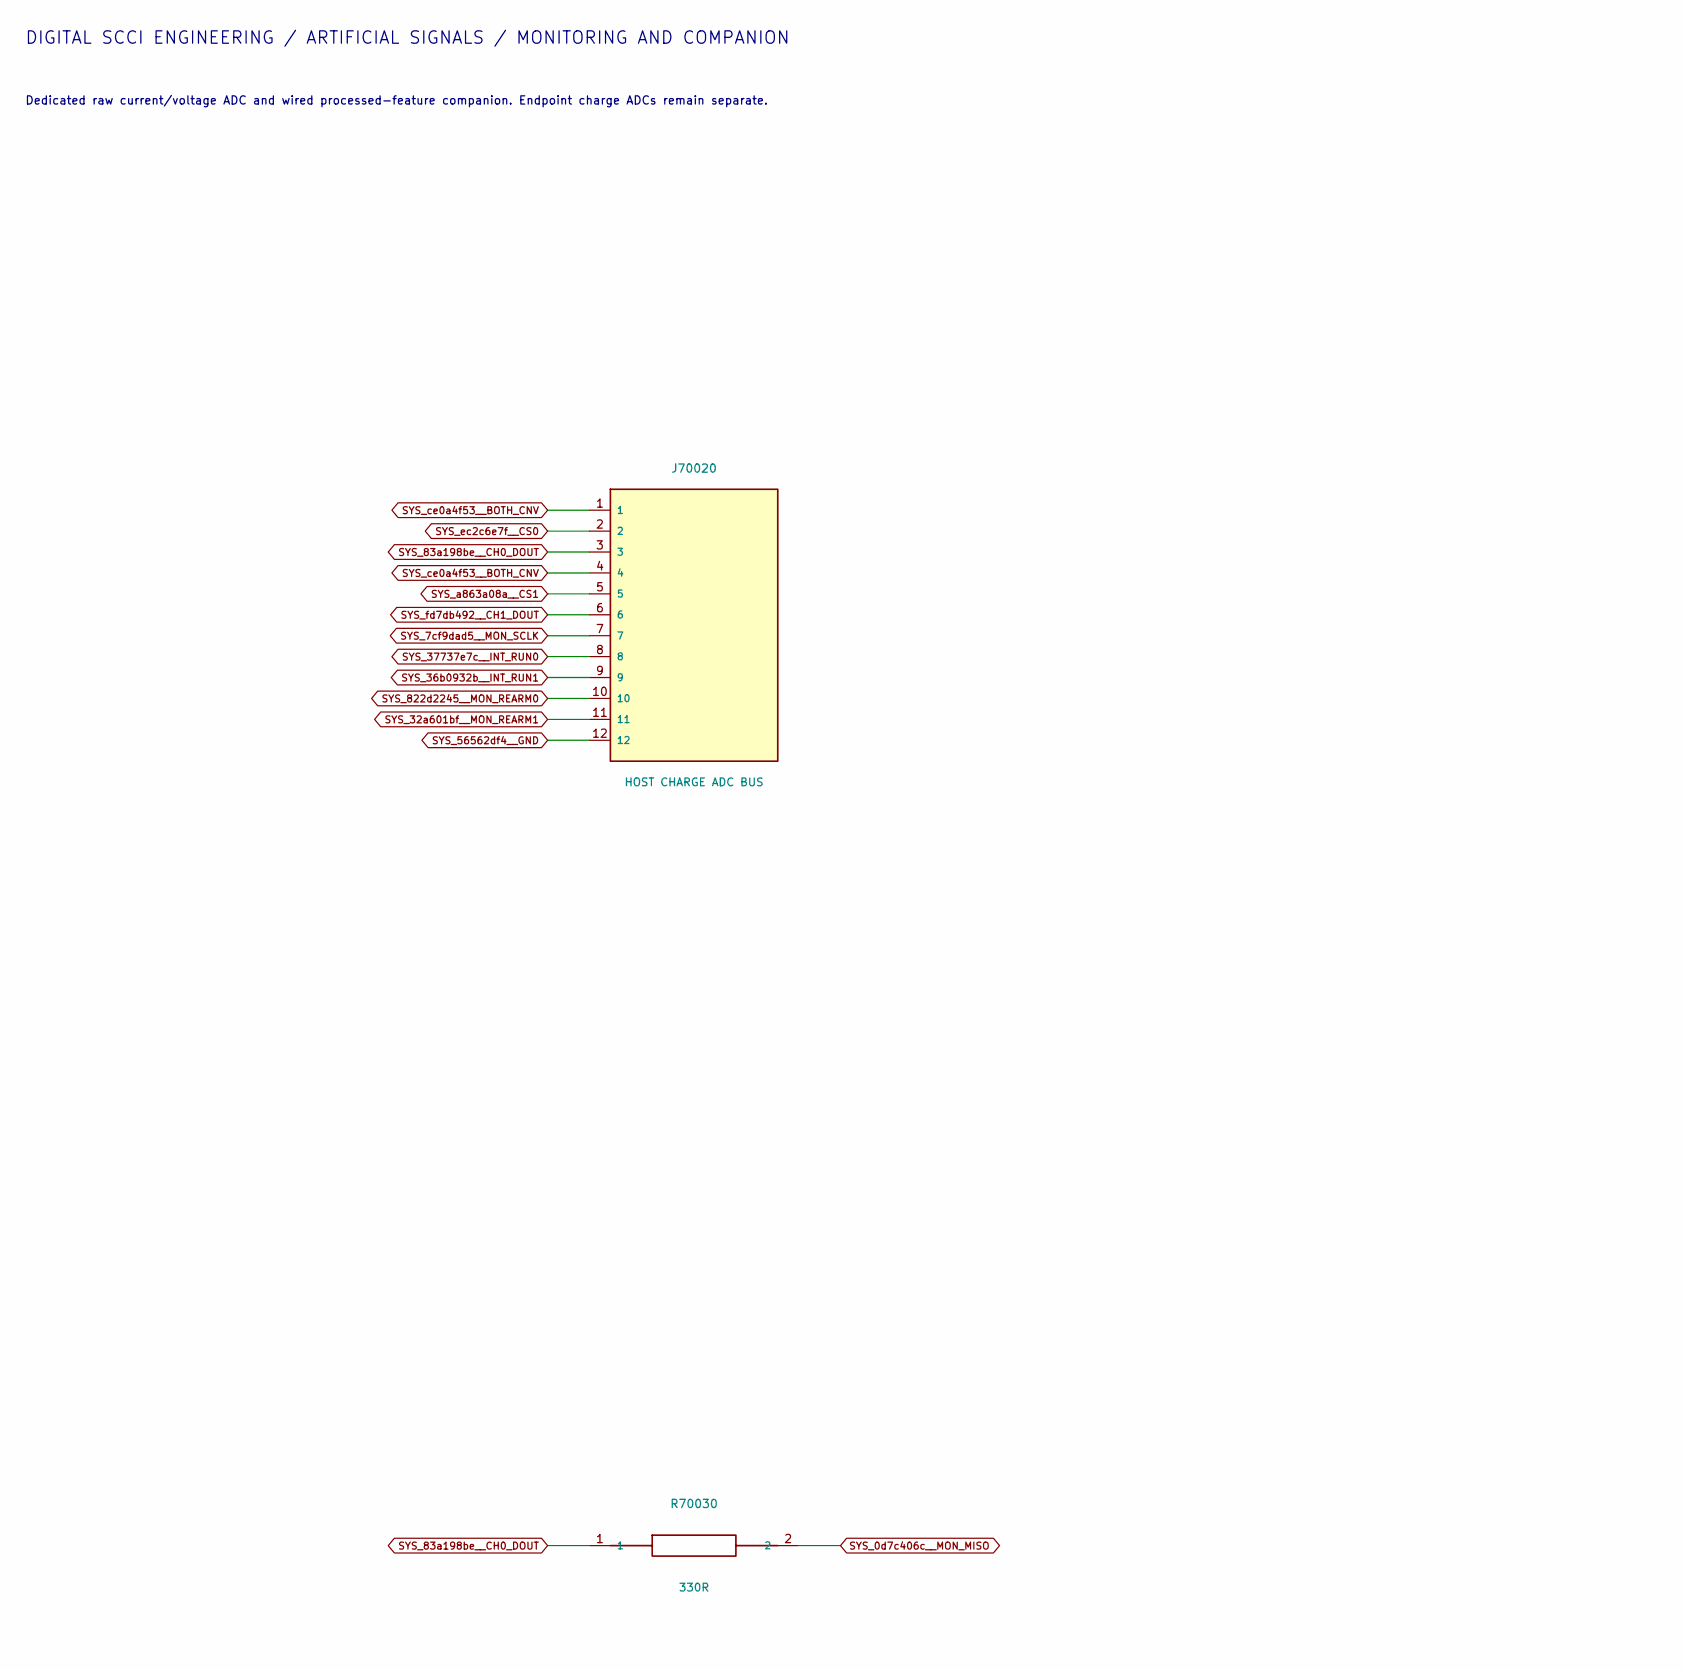
[picture p399: schematic handoff.kicad_sch, ATO S4 / Charge ADC and health host handoff, part in row 1, column 1]

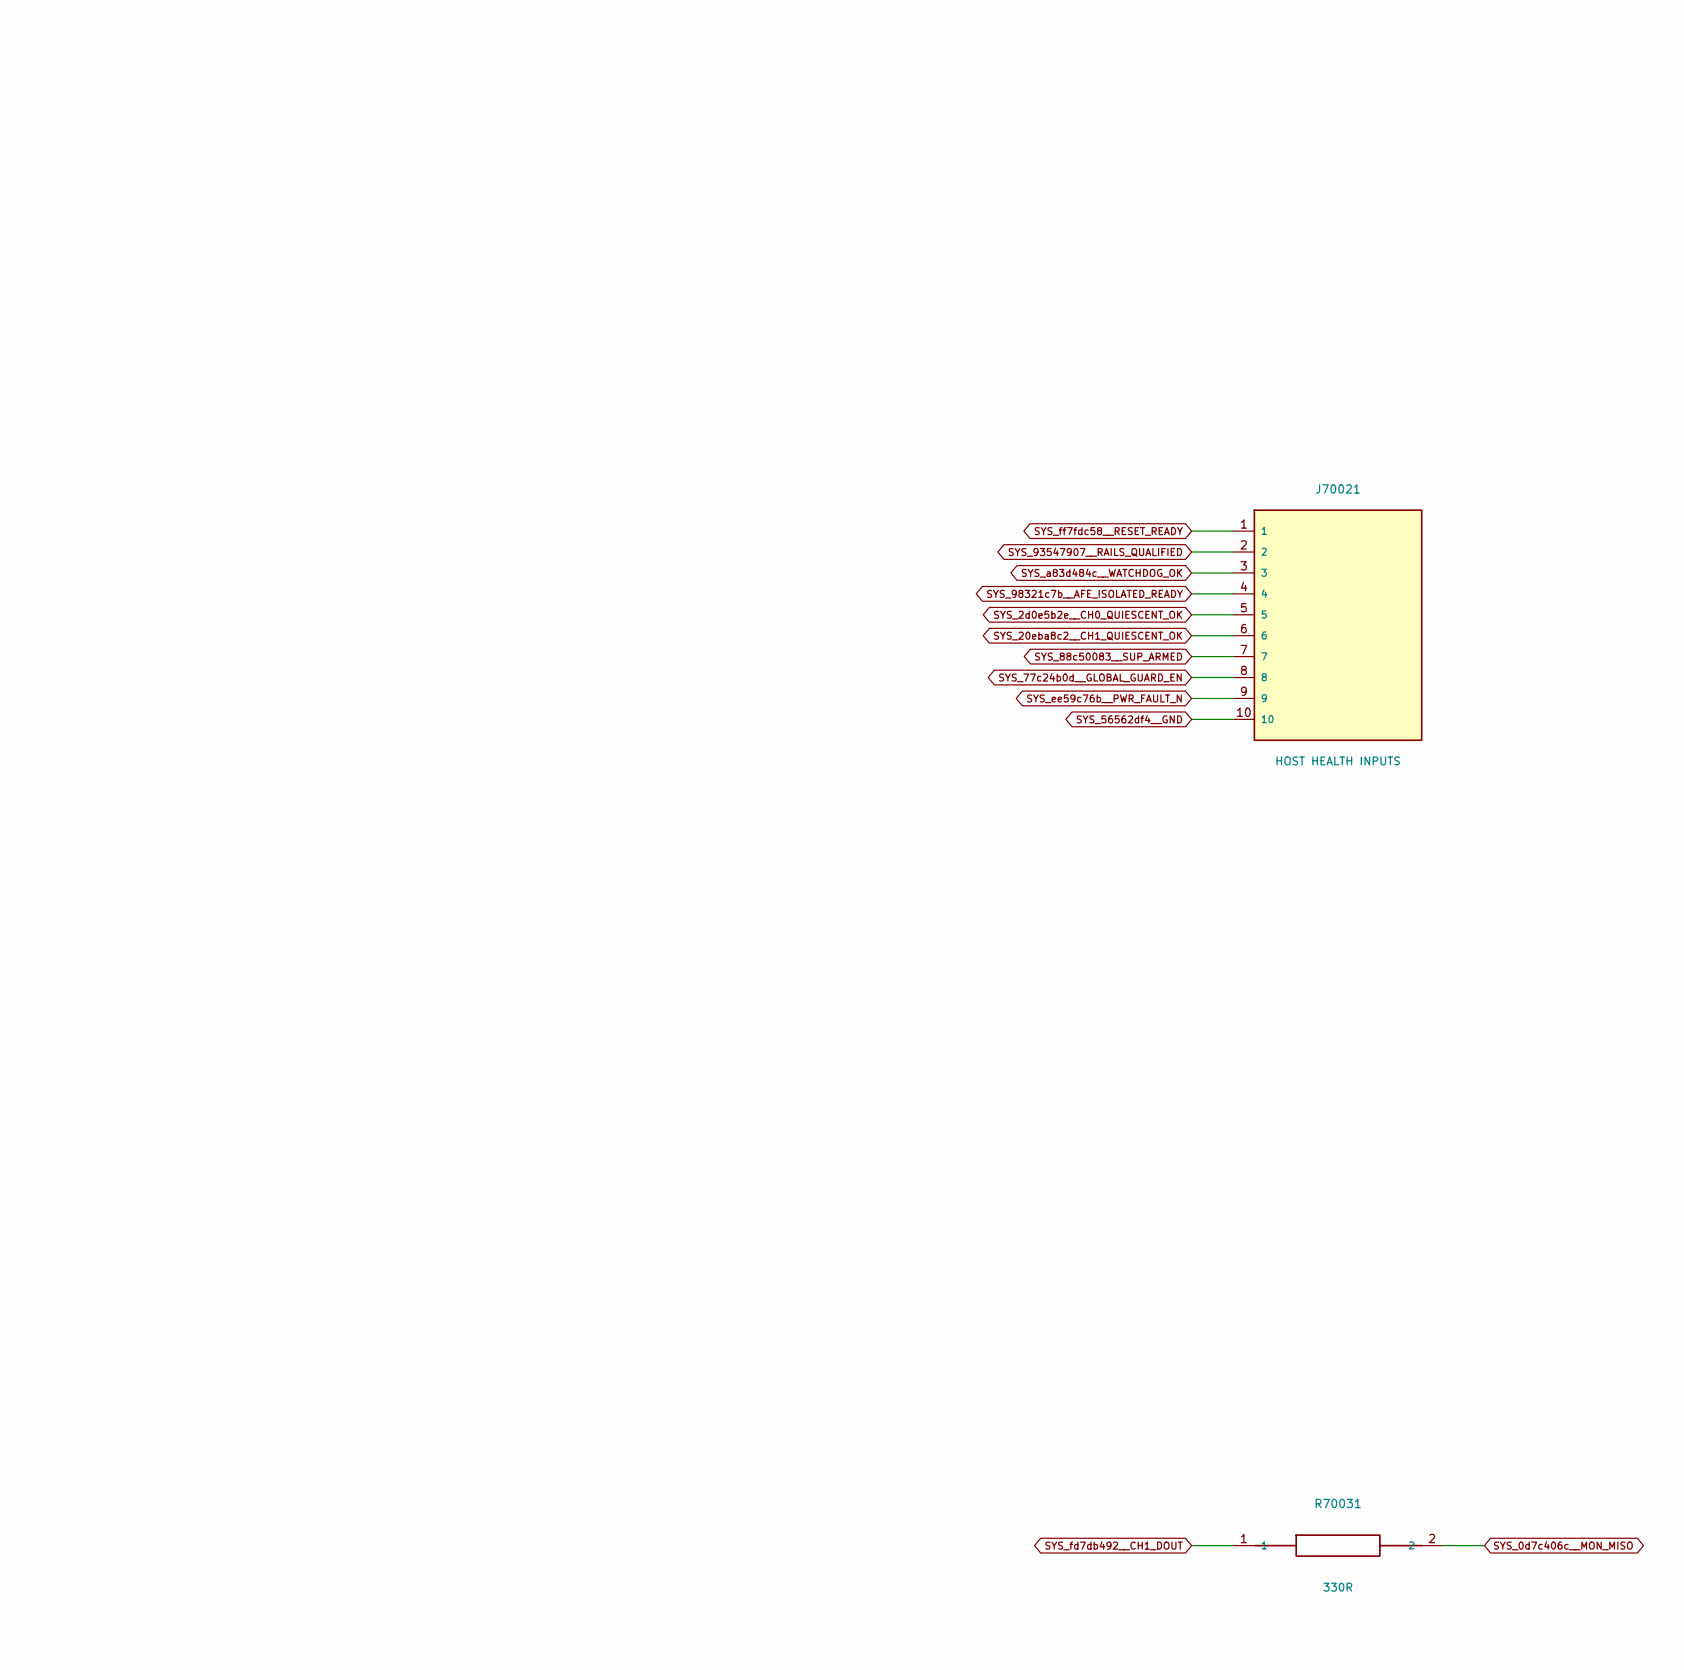
[picture p400: schematic handoff.kicad_sch, ATO S4 / Charge ADC and health host handoff, part in row 1, column 2]

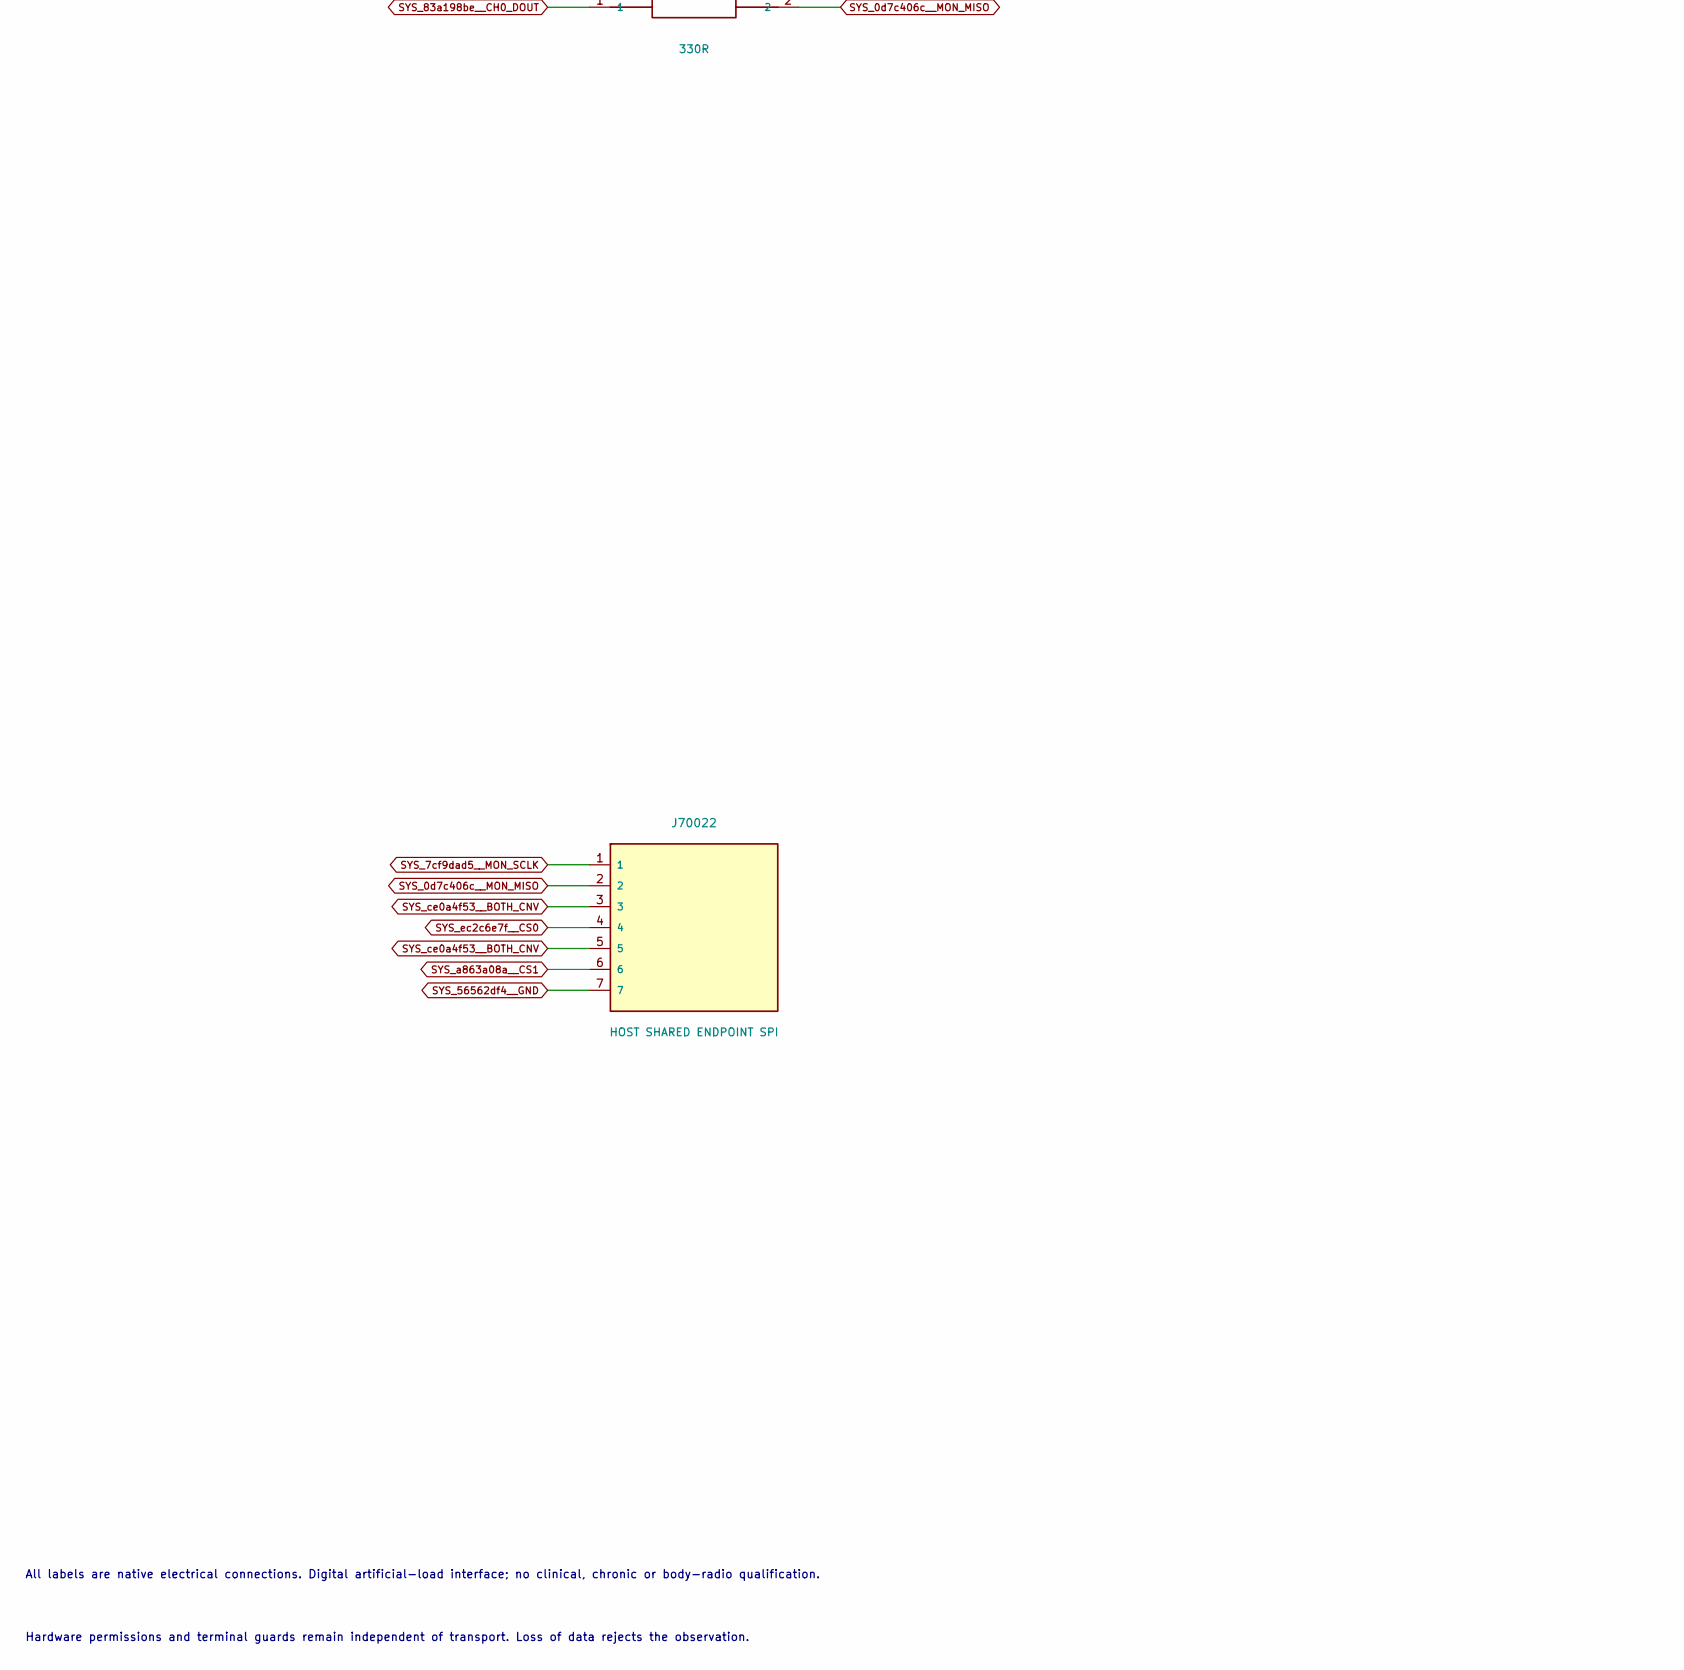
[picture p401: schematic handoff.kicad_sch, ATO S4 / Charge ADC and health host handoff, part in row 2, column 1]

Parts:
J70020: HOST CHARGE ADC BUS; PinHeader_1x12_P2.54mm_Vertical
J70021: HOST HEALTH INPUTS; PinHeader_1x10_P2.54mm_Vertical
J70022: HOST SHARED ENDPOINT SPI; PinHeader_1x07_P2.54mm_Vertical
R70030, R70031: 330R; R_0805_2012Metric

Connections:
SYS_0d7c406c__MON_MISO: J70022.2, R70030.2, R70031.2
SYS_2d0e5b2e__CH0_QUIESCENT_OK: J70021.5; also elsewhere on the board
SYS_7cf9dad5__MON_SCLK: J70020.7, J70022.1; also elsewhere on the board
SYS_20eba8c2__CH1_QUIESCENT_OK: J70021.6; also elsewhere on the board
SYS_32a601bf__MON_REARM1: J70020.11; also elsewhere on the board
SYS_36b0932b__INT_RUN1: J70020.9; also elsewhere on the board
SYS_77c24b0d__GLOBAL_GUARD_EN: J70021.8; also elsewhere on the board
SYS_83a198be__CH0_DOUT: J70020.3, R70030.1; also elsewhere on the board
SYS_88c50083__SUP_ARMED: J70021.7; also elsewhere on the board
SYS_822d2245__MON_REARM0: J70020.10; also elsewhere on the board
SYS_37737e7c__INT_RUN0: J70020.8; also elsewhere on the board
SYS_56562df4__GND: J70020.12, J70021.10, J70022.7; also elsewhere on the board
SYS_98321c7b__AFE_ISOLATED_READY: J70021.4; also elsewhere on the board
SYS_93547907__RAILS_QUALIFIED: J70021.2; also elsewhere on the board
SYS_a83d484c__WATCHDOG_OK: J70021.3; also elsewhere on the board
SYS_a863a08a__CS1: J70020.5, J70022.6; also elsewhere on the board
SYS_ce0a4f53__BOTH_CNV: J70020.1, J70020.4, J70022.3, J70022.5; also elsewhere on the board
SYS_ec2c6e7f__CS0: J70020.2, J70022.4; also elsewhere on the board
SYS_ee59c76b__PWR_FAULT_N: J70021.9; also elsewhere on the board
SYS_fd7db492__CH1_DOUT: J70020.6, R70031.1; also elsewhere on the board
SYS_ff7fdc58__RESET_READY: J70021.1; also elsewhere on the board

Notes on the sheet:
DIGITAL SCCI ENGINEERING / ARTIFICIAL SIGNALS / MONITORING AND COMPANION
Dedicated raw current/voltage ADC and wired processed-feature companion. Endpoint charge ADCs remain separate.
All labels are native electrical connections. Digital artificial-load interface; no clinical, chronic or body-radio qualification.
Hardware permissions and terminal guards remain independent of transport. Loss of data rejects the observation.

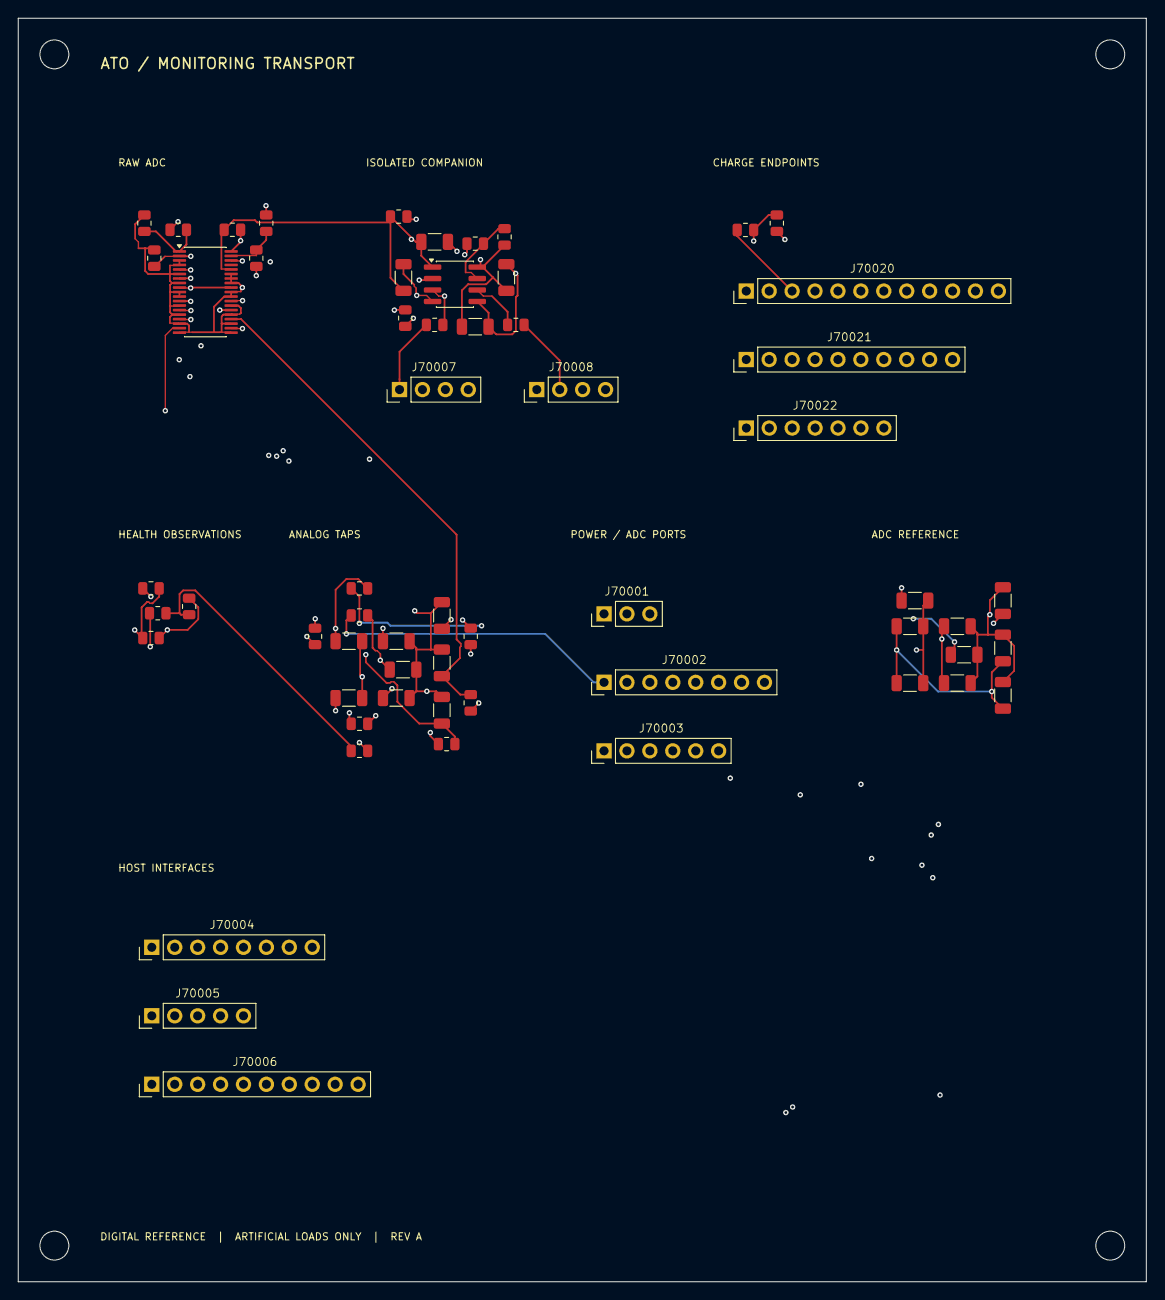
[picture p402: board monitoring_transport.kicad_pcb from above]

Board: 4 copper layers, 125.0 x 140.0 mm, 64 parts (0 on the bottom side), 59 nets.

Other parts of the board:
H1, H2, H3, H4: MountingHole_3.2mm_M3
