pratham-cloud-ctrl/Project-ATO/electronics/stage4/integrated-pcb/boards/power/power.kicad_pcb

## KiCad design electronics/stage4/integrated-pcb/boards/power/power.kicad_pcb (2026-10-16)

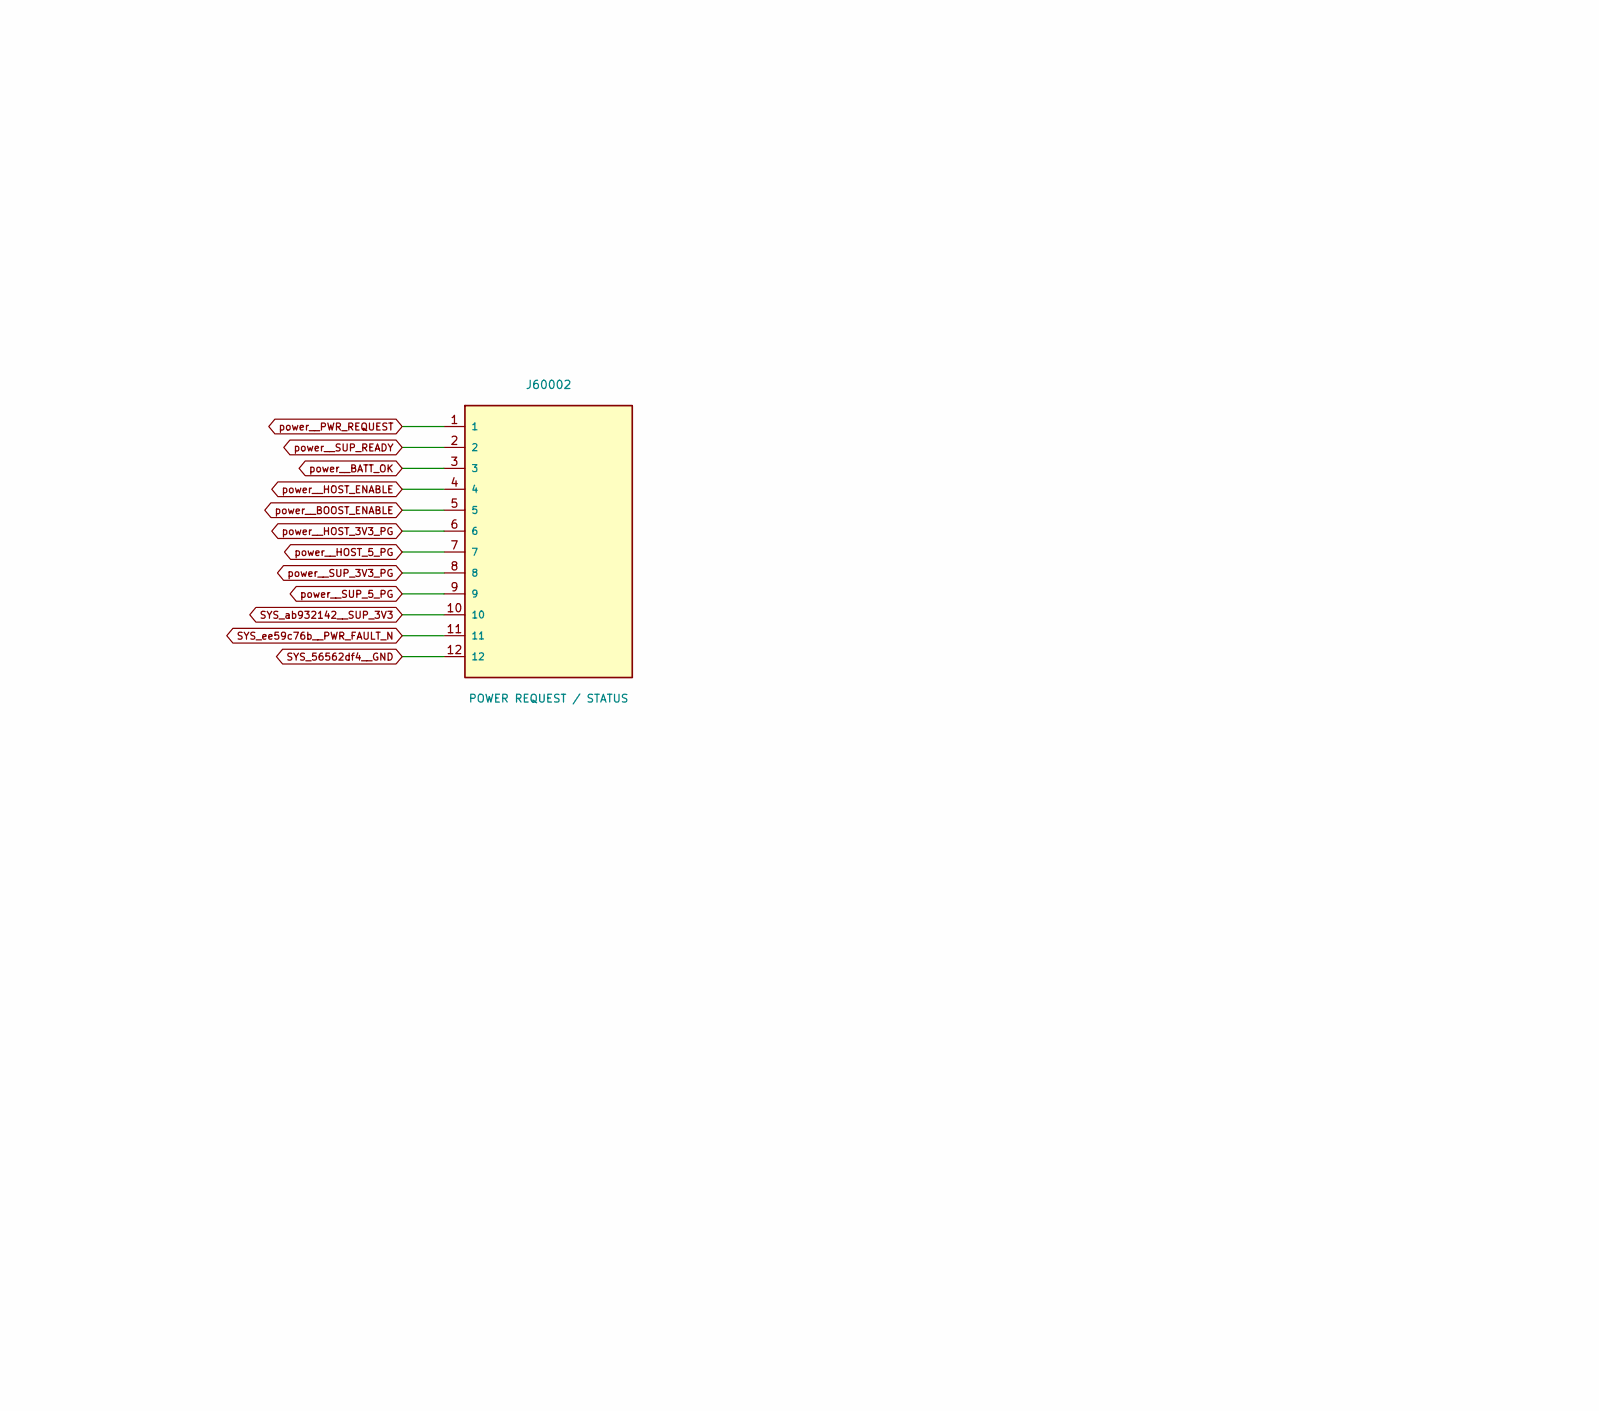
[picture p403: schematic power.kicad_sch, ATO S4 / Interfaces and rail handoff, part in row 1, column 2]

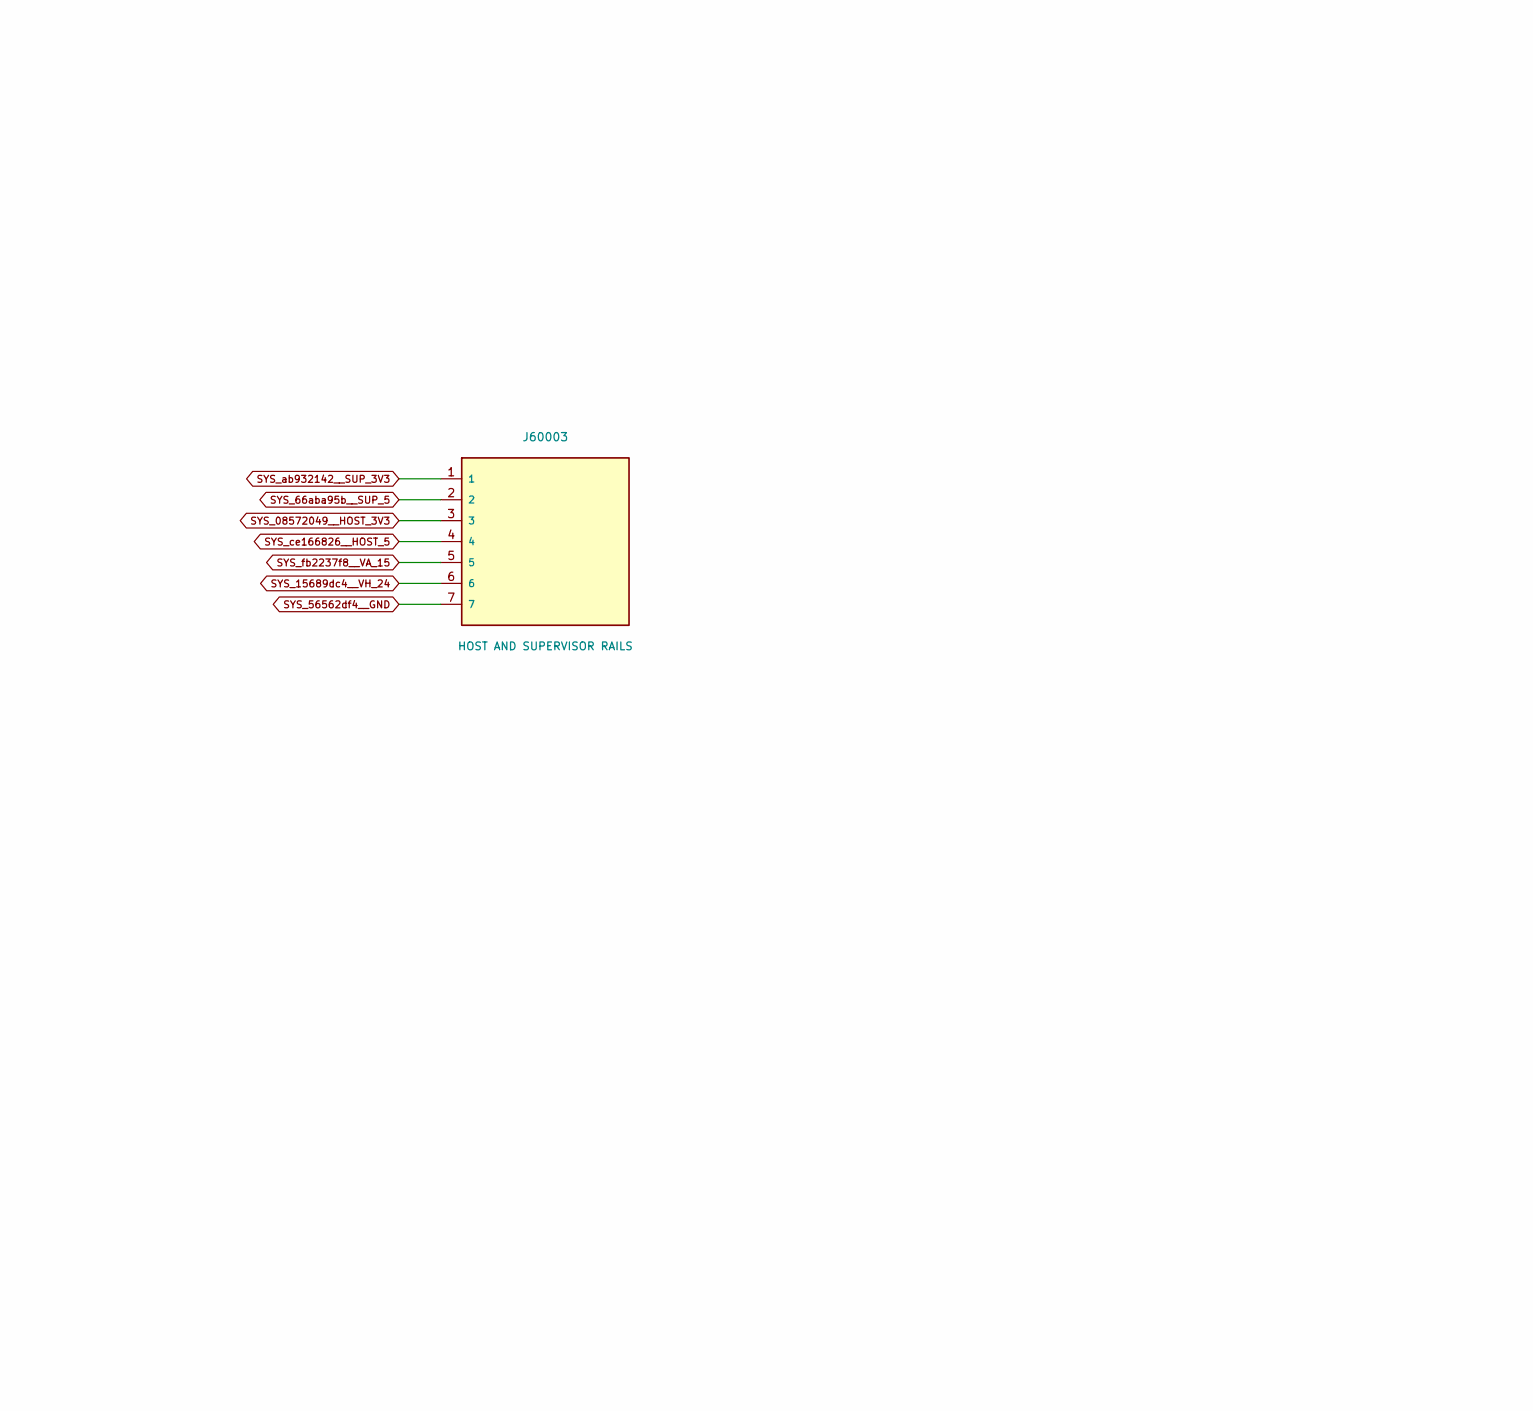
[picture p404: schematic power.kicad_sch, ATO S4 / Interfaces and rail handoff, part in row 1, column 3]

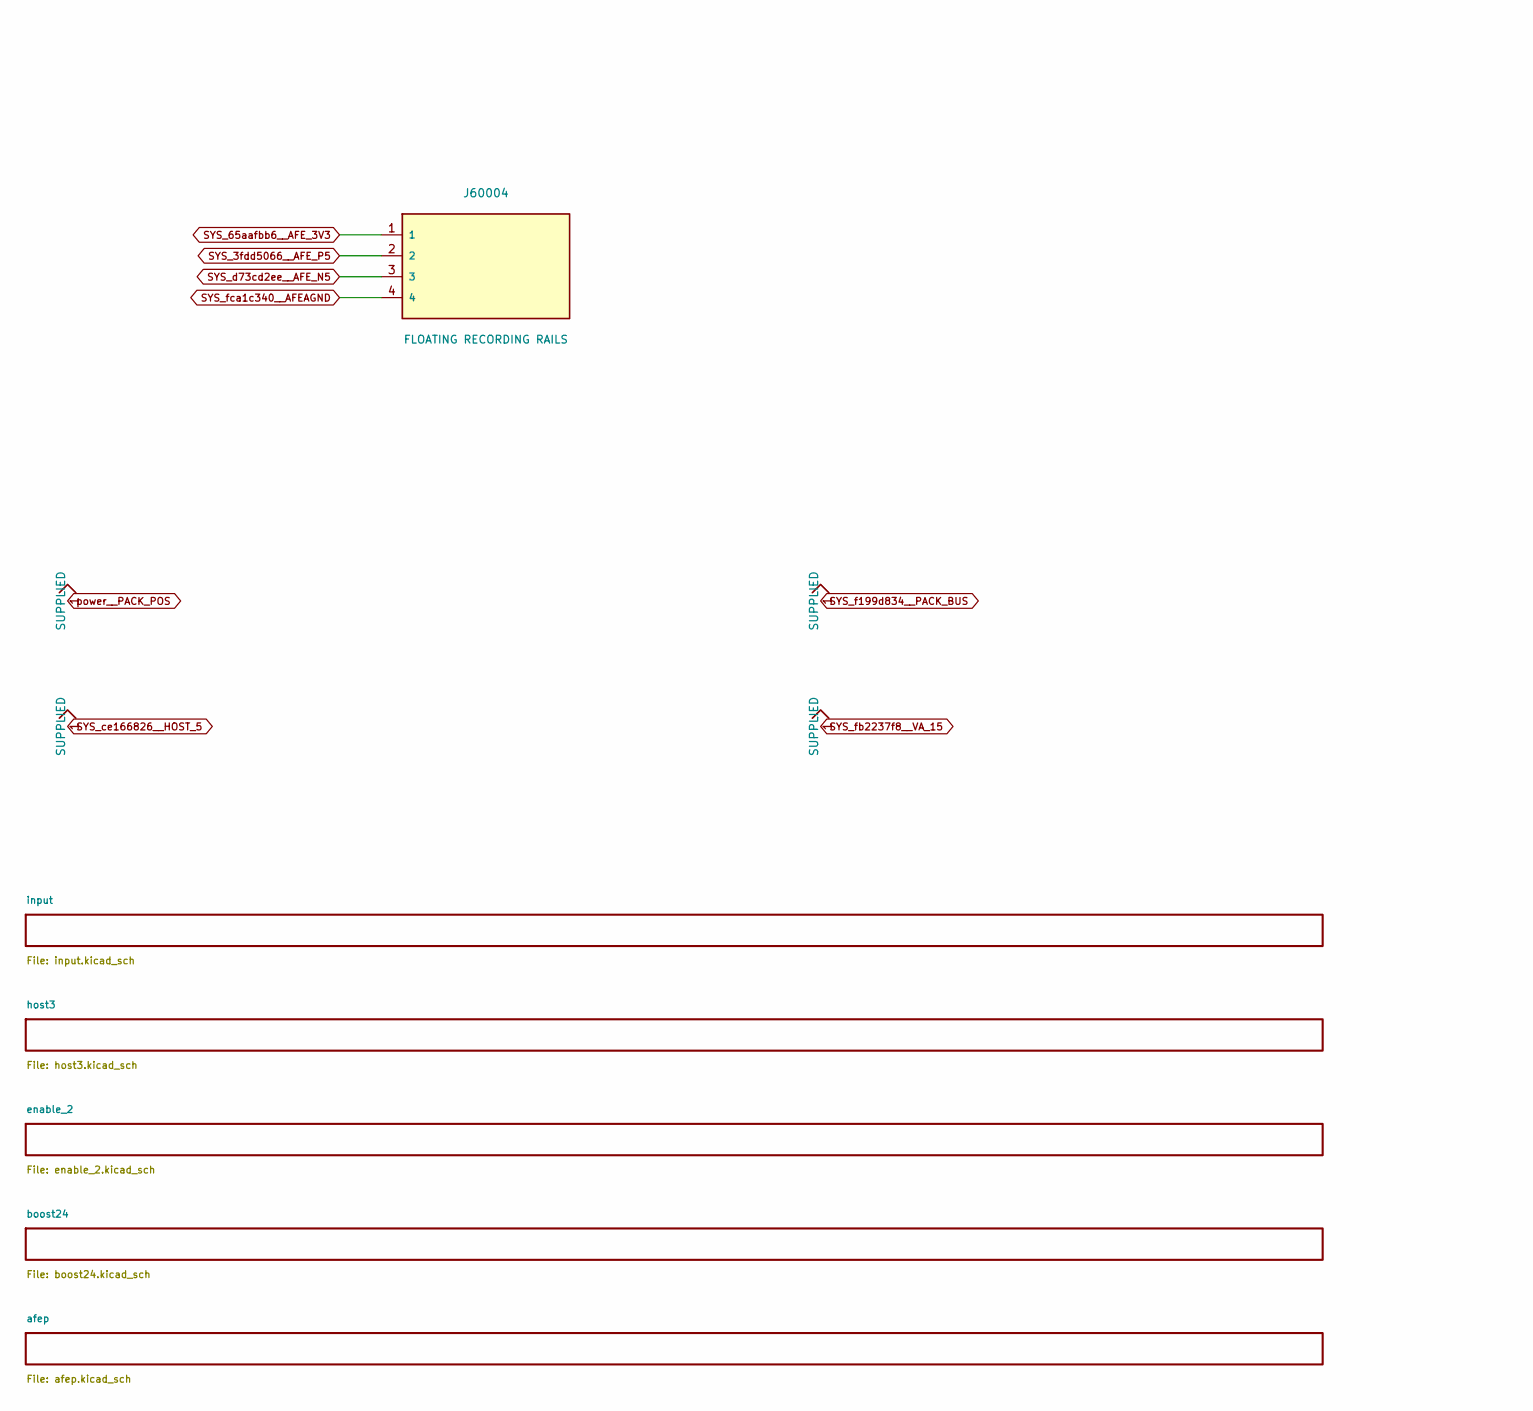
[picture p405: schematic power.kicad_sch, ATO S4 / Interfaces and rail handoff, part in row 2, column 1]

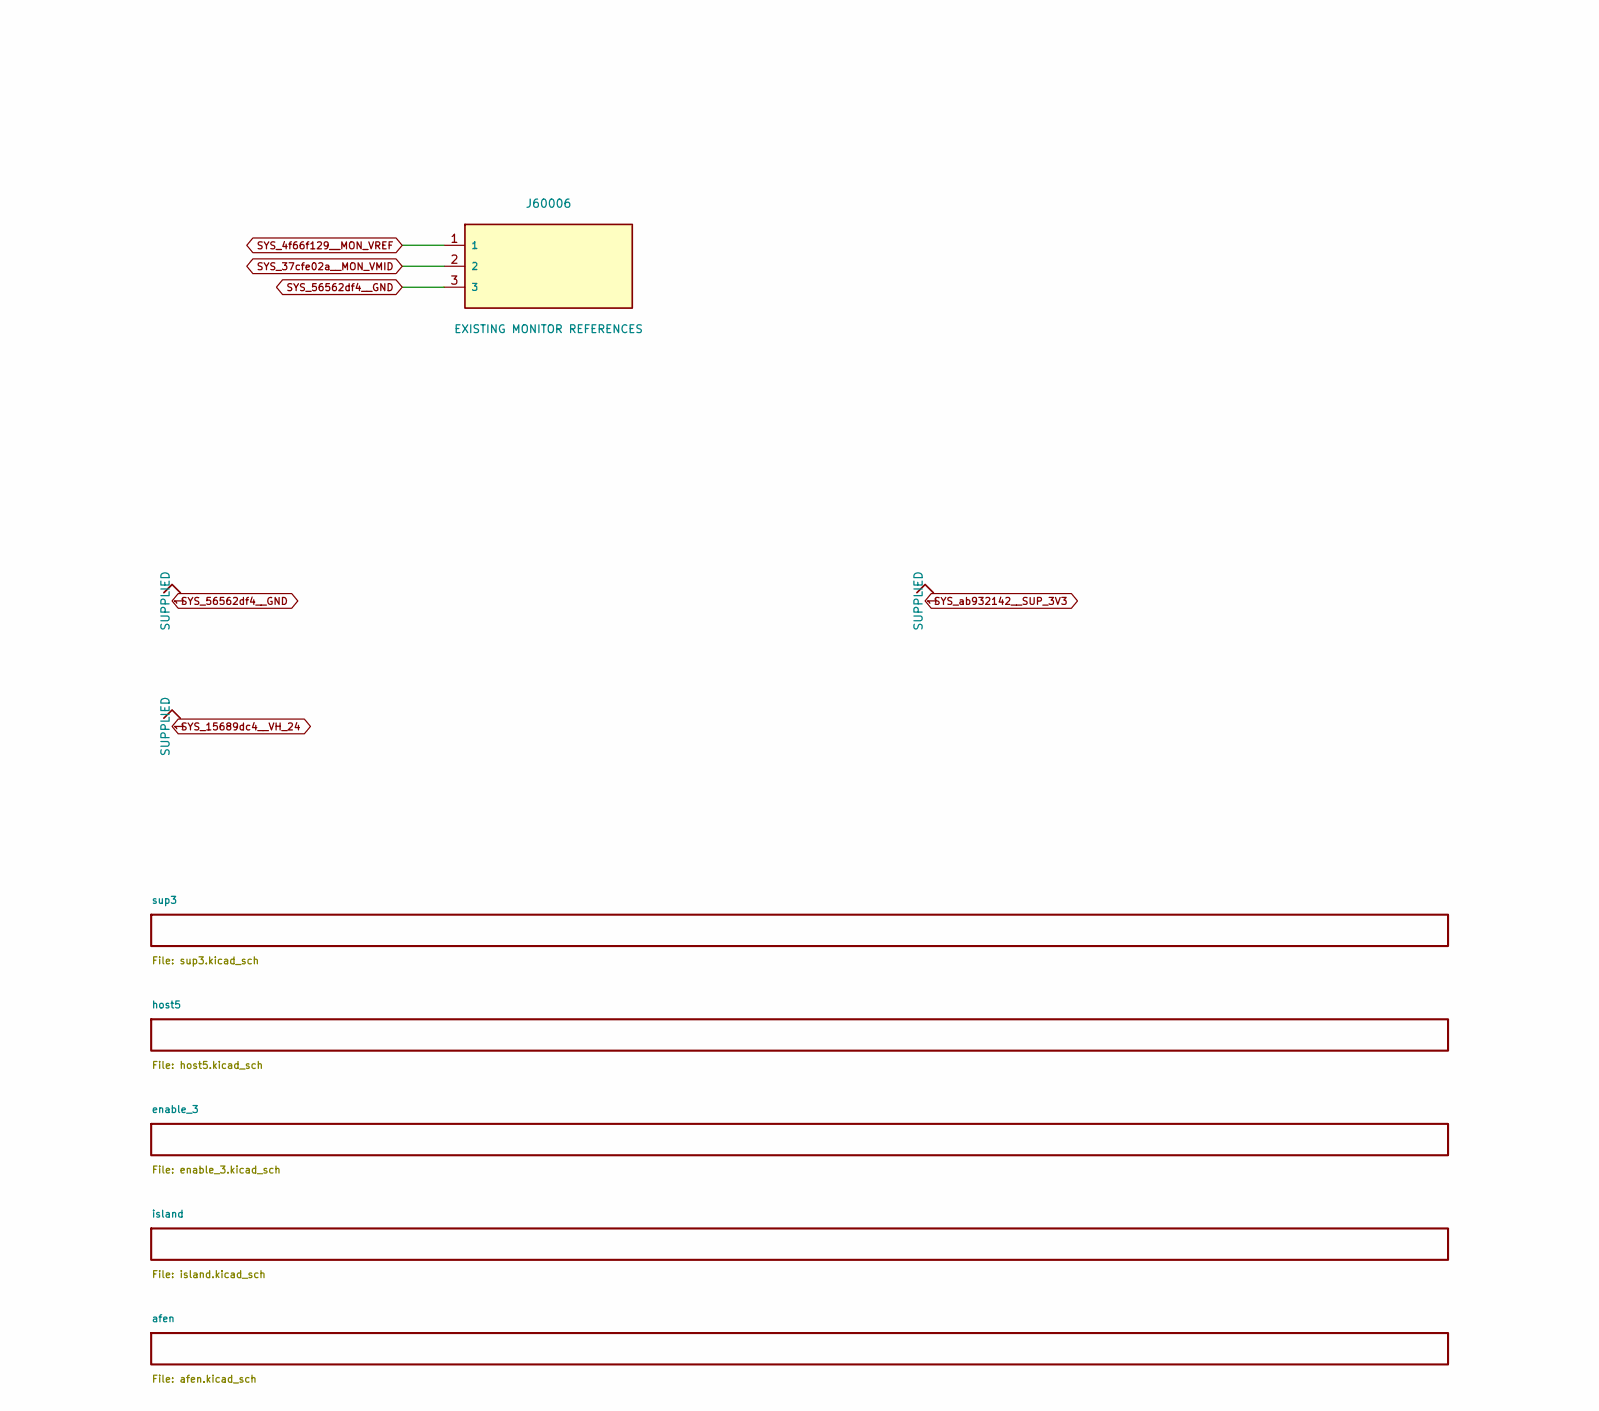
[picture p406: schematic power.kicad_sch, ATO S4 / Interfaces and rail handoff, part in row 2, column 2]

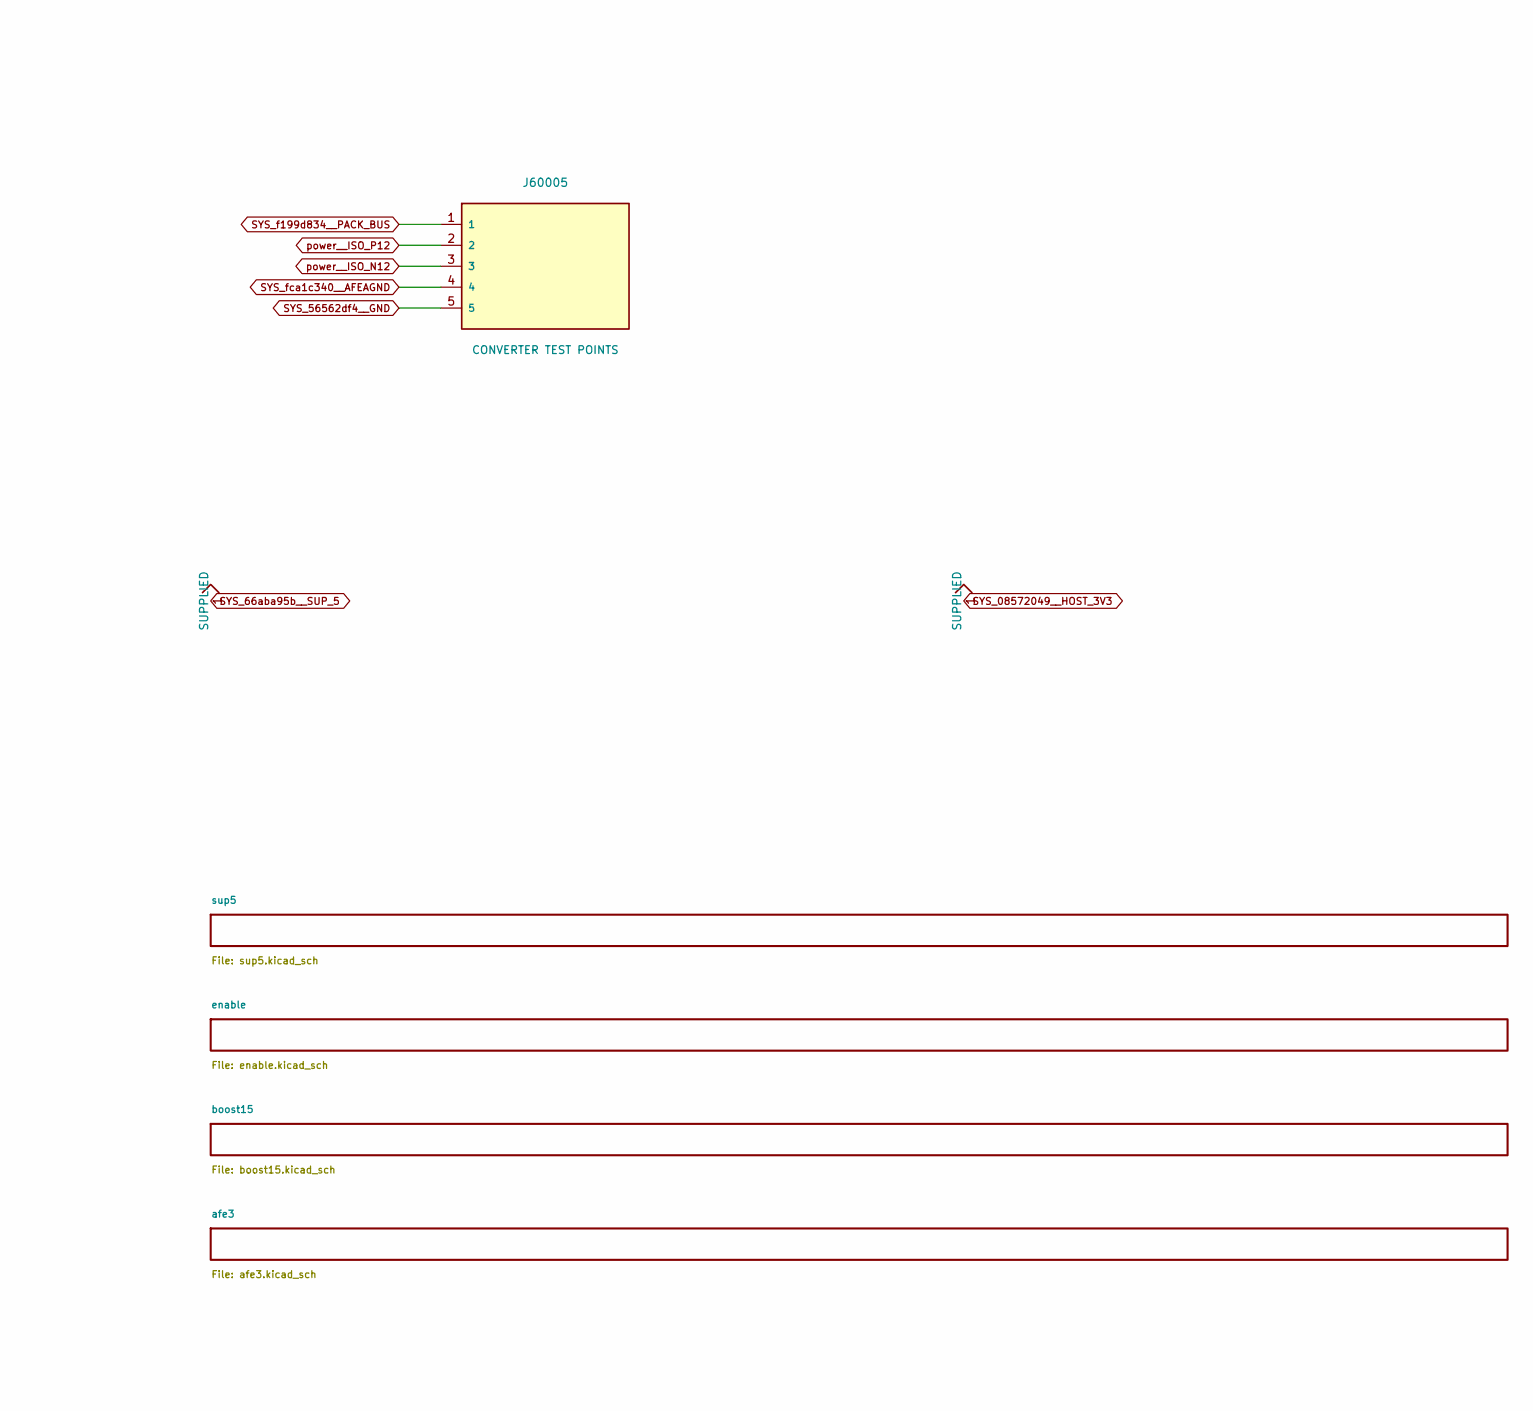
[picture p407: schematic power.kicad_sch, ATO S4 / Interfaces and rail handoff, part in row 2, column 3]

Parts:
J60001: AT31004 PROTECTED 2S PACK / 6.4 TO 8.4V; PinHeader_1x02_P2.54mm_Vertical
J60002: POWER REQUEST / STATUS; PinHeader_1x12_P2.54mm_Vertical
J60003: HOST AND SUPERVISOR RAILS; PinHeader_1x07_P2.54mm_Vertical
J60004: FLOATING RECORDING RAILS; PinHeader_1x04_P2.54mm_Vertical
J60005: CONVERTER TEST POINTS; PinHeader_1x05_P2.54mm_Vertical
J60006: EXISTING MONITOR REFERENCES; PinHeader_1x03_P2.54mm_Vertical

Connections:
SYS_3fdd5066__AFE_P5: J60004.2; also elsewhere on the board
SYS_4f66f129__MON_VREF: J60006.1; also elsewhere on the board
SYS_37cfe02a__MON_VMID: J60006.2; also elsewhere on the board
SYS_65aafbb6__AFE_3V3: J60004.1; also elsewhere on the board
SYS_66aba95b__SUP_5: J60003.2; also elsewhere on the board
SYS_15689dc4__VH_24: J60003.6; also elsewhere on the board
SYS_56562df4__GND: J60001.2, J60002.12, J60003.7, J60005.5, J60006.3; also elsewhere on the board
SYS_08572049__HOST_3V3: J60003.3; also elsewhere on the board
SYS_ab932142__SUP_3V3: J60002.10, J60003.1; also elsewhere on the board
SYS_ce166826__HOST_5: J60003.4; also elsewhere on the board
SYS_d73cd2ee__AFE_N5: J60004.3; also elsewhere on the board
SYS_ee59c76b__PWR_FAULT_N: J60002.11; also elsewhere on the board
SYS_f199d834__PACK_BUS: J60005.1; also elsewhere on the board
SYS_fb2237f8__VA_15: J60003.5; also elsewhere on the board
SYS_fca1c340__AFEAGND: J60004.4, J60005.4; also elsewhere on the board
power__BATT_OK: J60002.3; also elsewhere on the board
power__BOOST_ENABLE: J60002.5; also elsewhere on the board
power__HOST_3V3_PG: J60002.6; also elsewhere on the board
power__HOST_5_PG: J60002.7; also elsewhere on the board
power__HOST_ENABLE: J60002.4; also elsewhere on the board
power__ISO_N12: J60005.3; also elsewhere on the board
power__ISO_P12: J60005.2; also elsewhere on the board
power__PACK_POS: J60001.1; also elsewhere on the board
power__PWR_REQUEST: J60002.1; also elsewhere on the board
power__SUP_3V3_PG: J60002.8; also elsewhere on the board
power__SUP_5_PG: J60002.9; also elsewhere on the board
power__SUP_READY: J60002.2; also elsewhere on the board

Notes on the sheet:
DIGITAL SCCI ENGINEERING / ARTIFICIAL LOADS / BATTERY AND POWER
2S protected pack, independent supervisor rails, host converters and floating AFE supplies. Digital circuit design, not implant qualification.

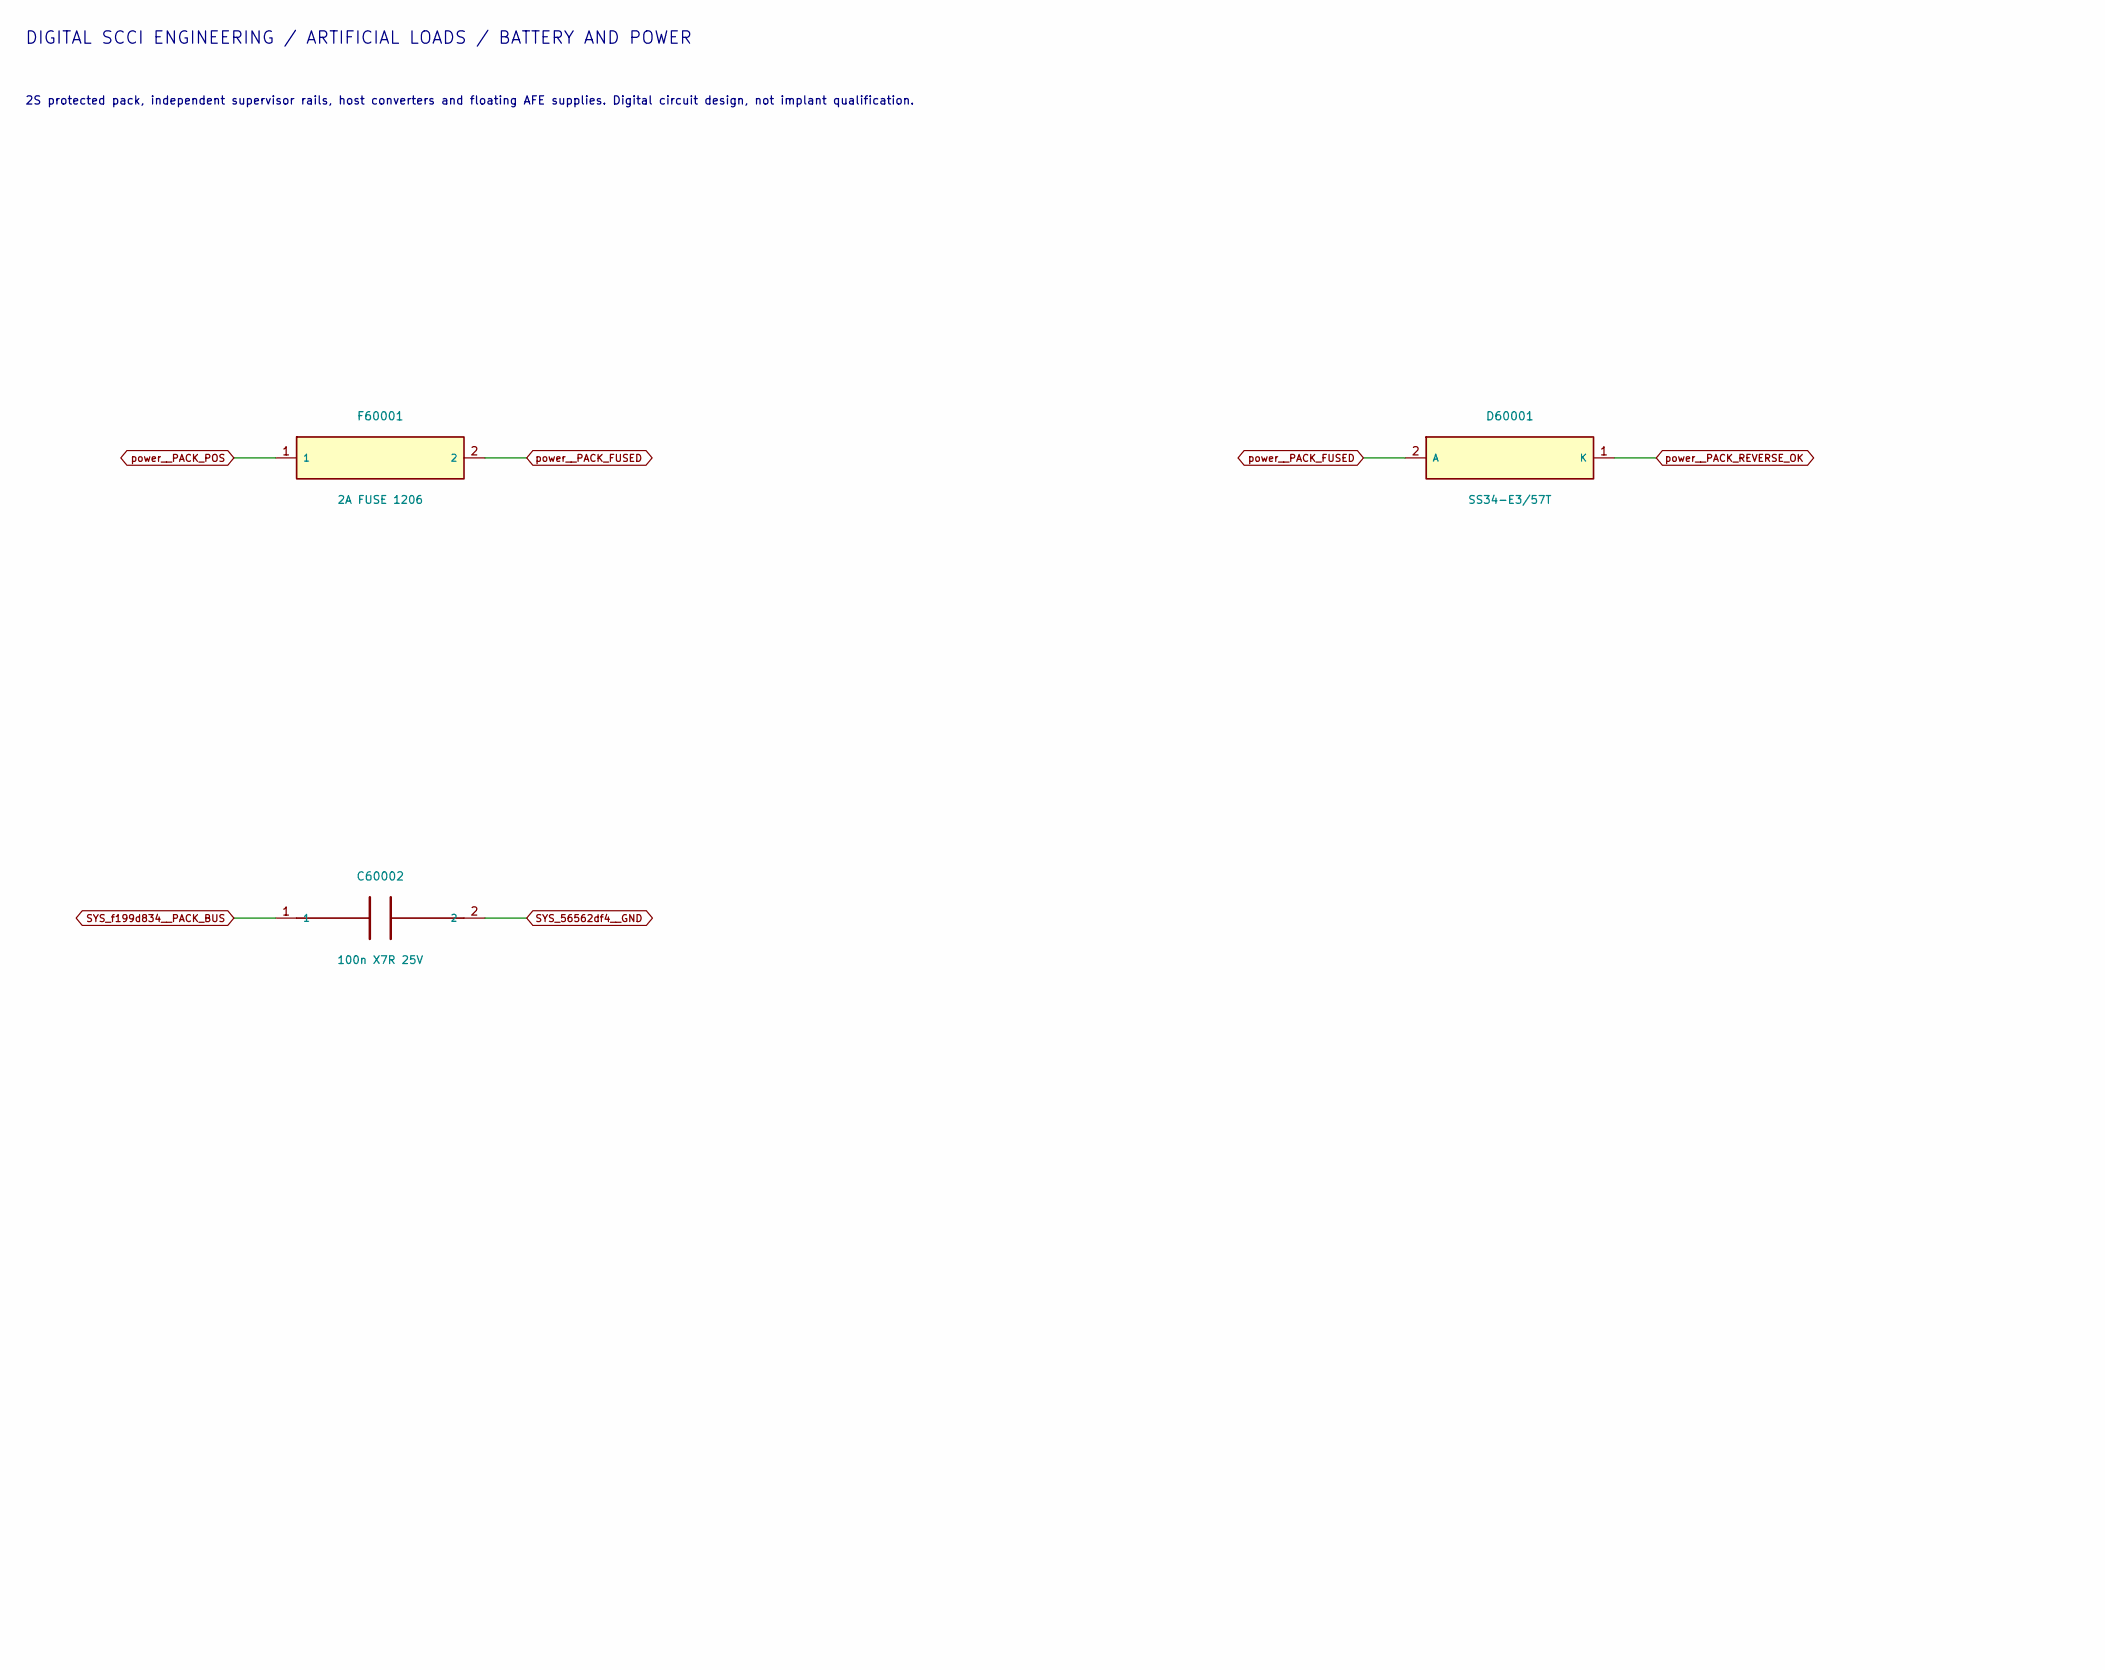
[picture p408: schematic input.kicad_sch, ATO S4 / Protected pack and input disconnect, part in row 1, column 1]

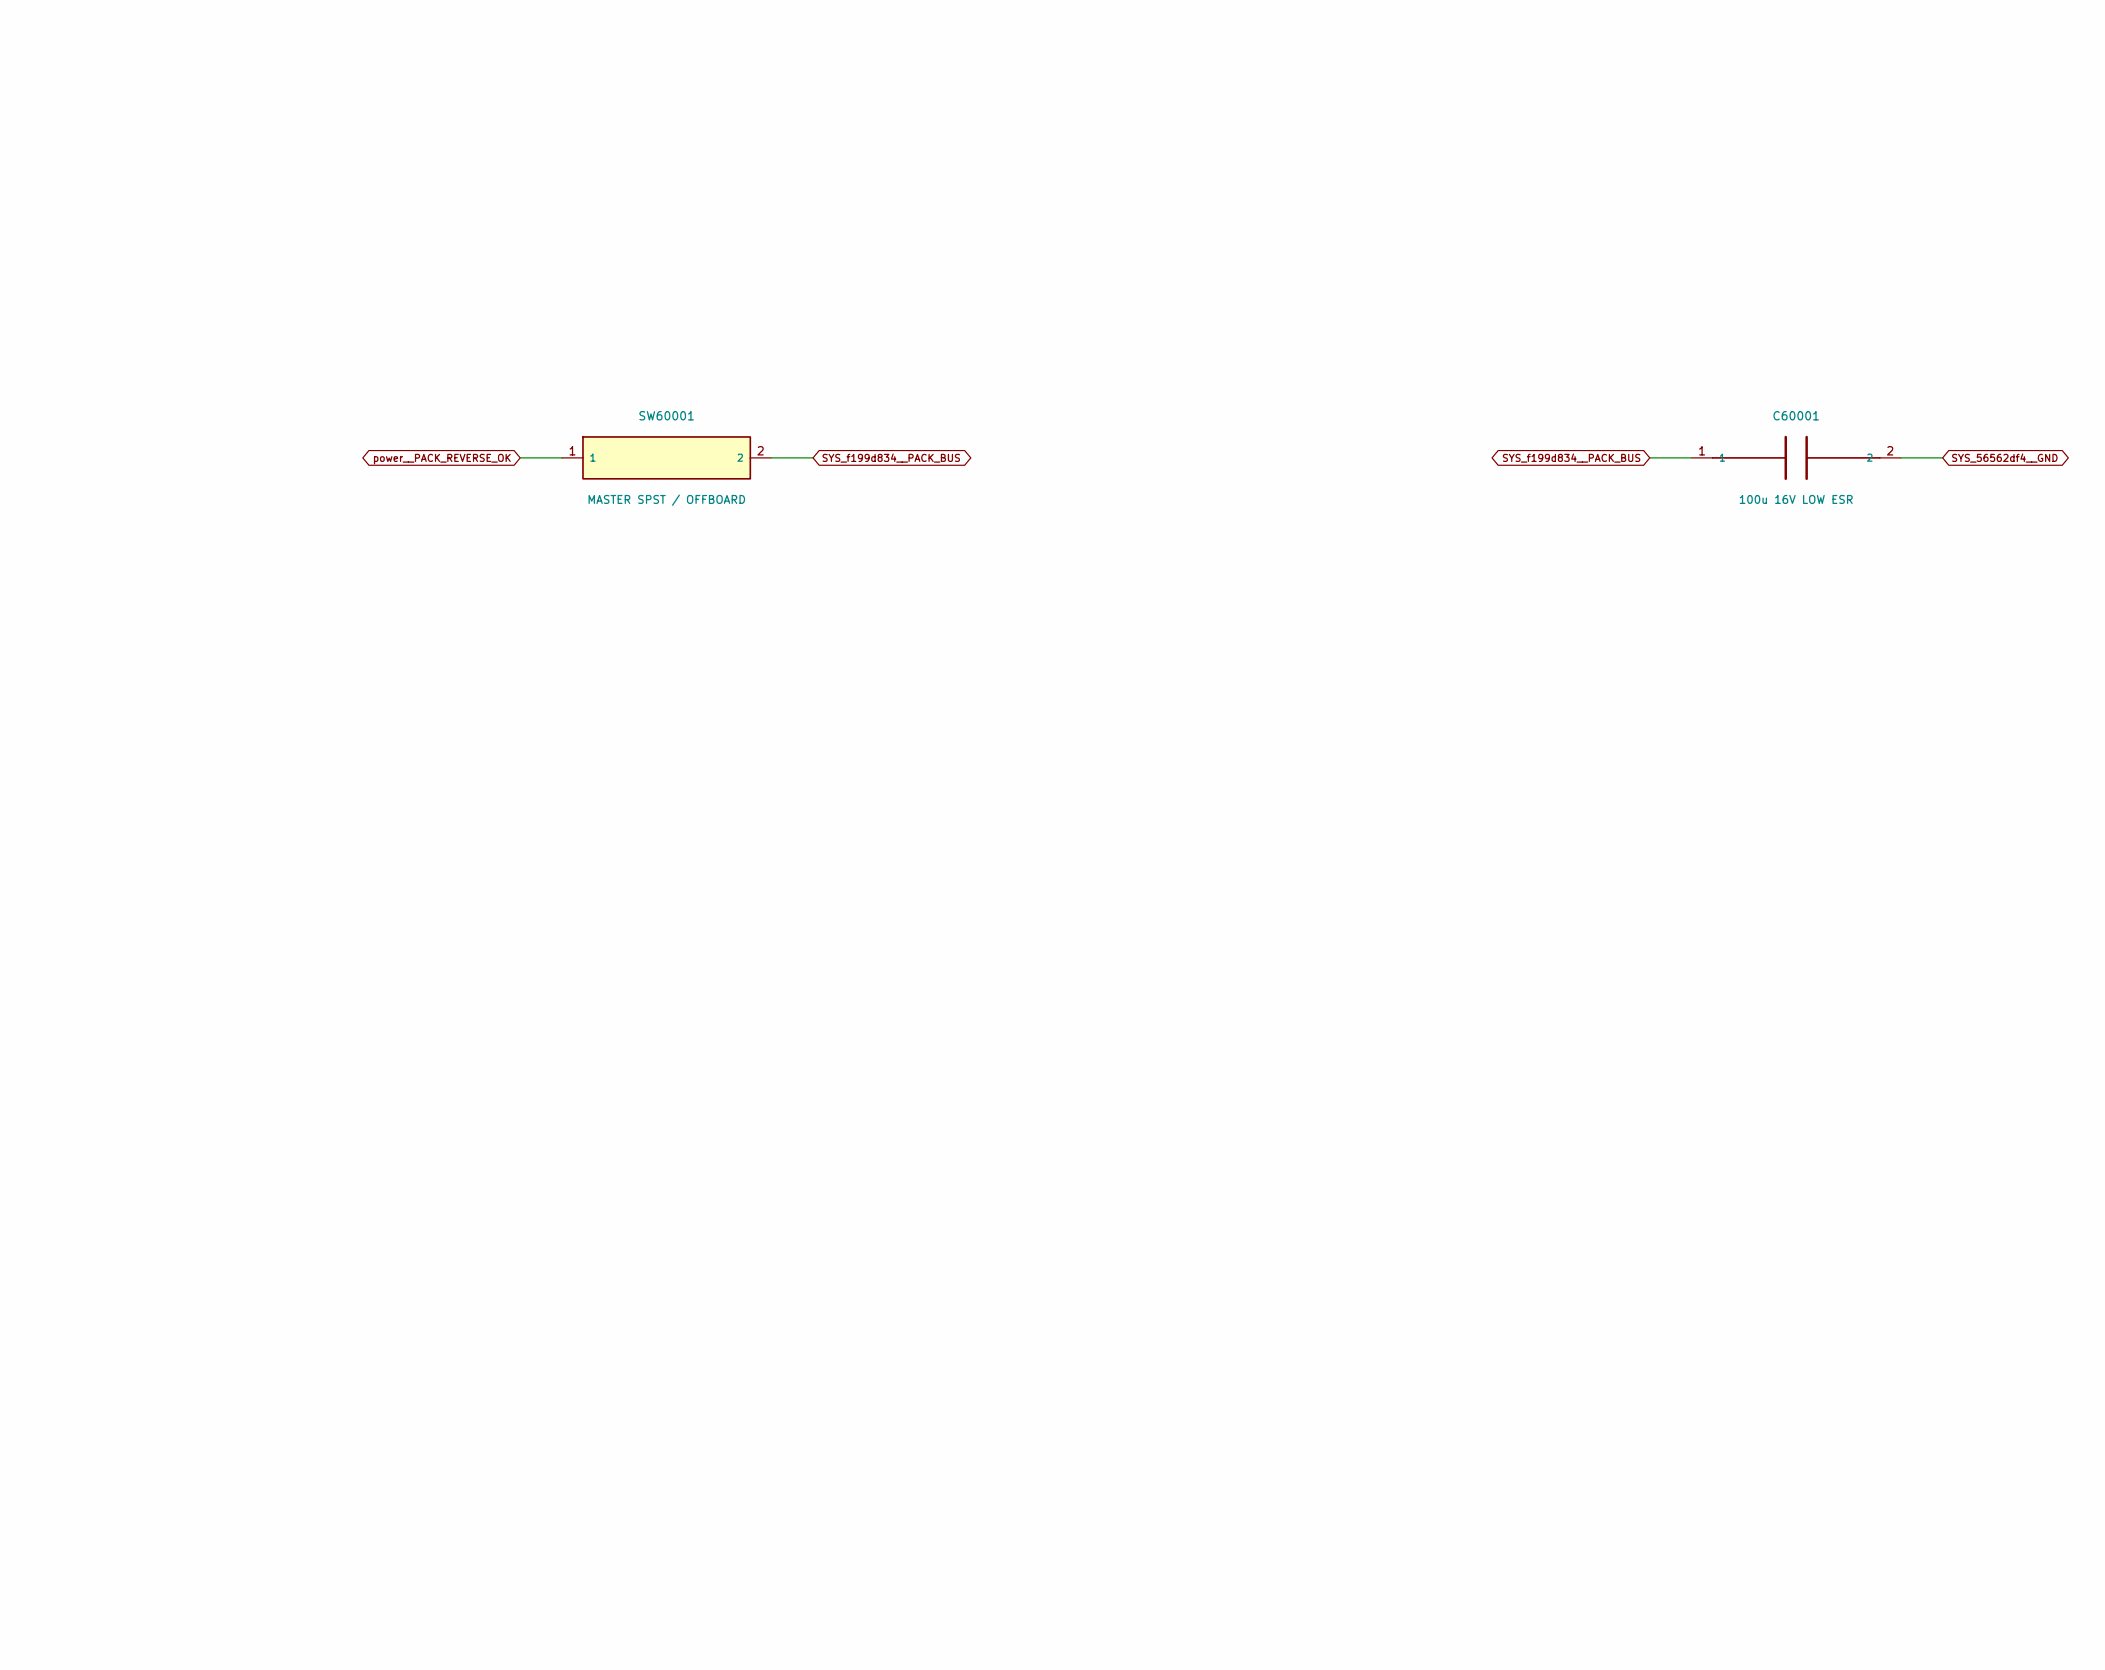
[picture p409: schematic input.kicad_sch, ATO S4 / Protected pack and input disconnect, part in row 1, column 2]

Parts:
C60001: 100u 16V LOW ESR; C_1206_3216Metric
C60002: 100n X7R 25V; C_1206_3216Metric
D60001: SS34-E3/57T; D_SMC
F60001: 2A FUSE 1206; Fuse_1206_3216Metric
SW60001: MASTER SPST / OFFBOARD; PinHeader_1x02_P2.54mm_Vertical

Connections:
SYS_56562df4__GND: C60001.2, C60002.2; also elsewhere on the board
SYS_f199d834__PACK_BUS: C60001.1, C60002.1, SW60001.2; also elsewhere on the board
power__PACK_FUSED: D60001.2 (A), F60001.2
power__PACK_POS: F60001.1; also elsewhere on the board
power__PACK_REVERSE_OK: D60001.1 (K), SW60001.1

Notes on the sheet:
DIGITAL SCCI ENGINEERING / ARTIFICIAL LOADS / BATTERY AND POWER
2S protected pack, independent supervisor rails, host converters and floating AFE supplies. Digital circuit design, not implant qualification.
All labels are native electrical connections. PG is diagnostic; full qualification remains the nine independent supervision windows.
Converter shutdown does not discharge boost paths or remove stored energy. Body-facing shutdown remains the separate terminal guards.
