pratham-cloud-ctrl/Project-ATO/electronics/stage4/integrated-pcb/boards/power/power.kicad_pcb

## KiCad design electronics/stage4/integrated-pcb/boards/power/power.kicad_pcb (continued)

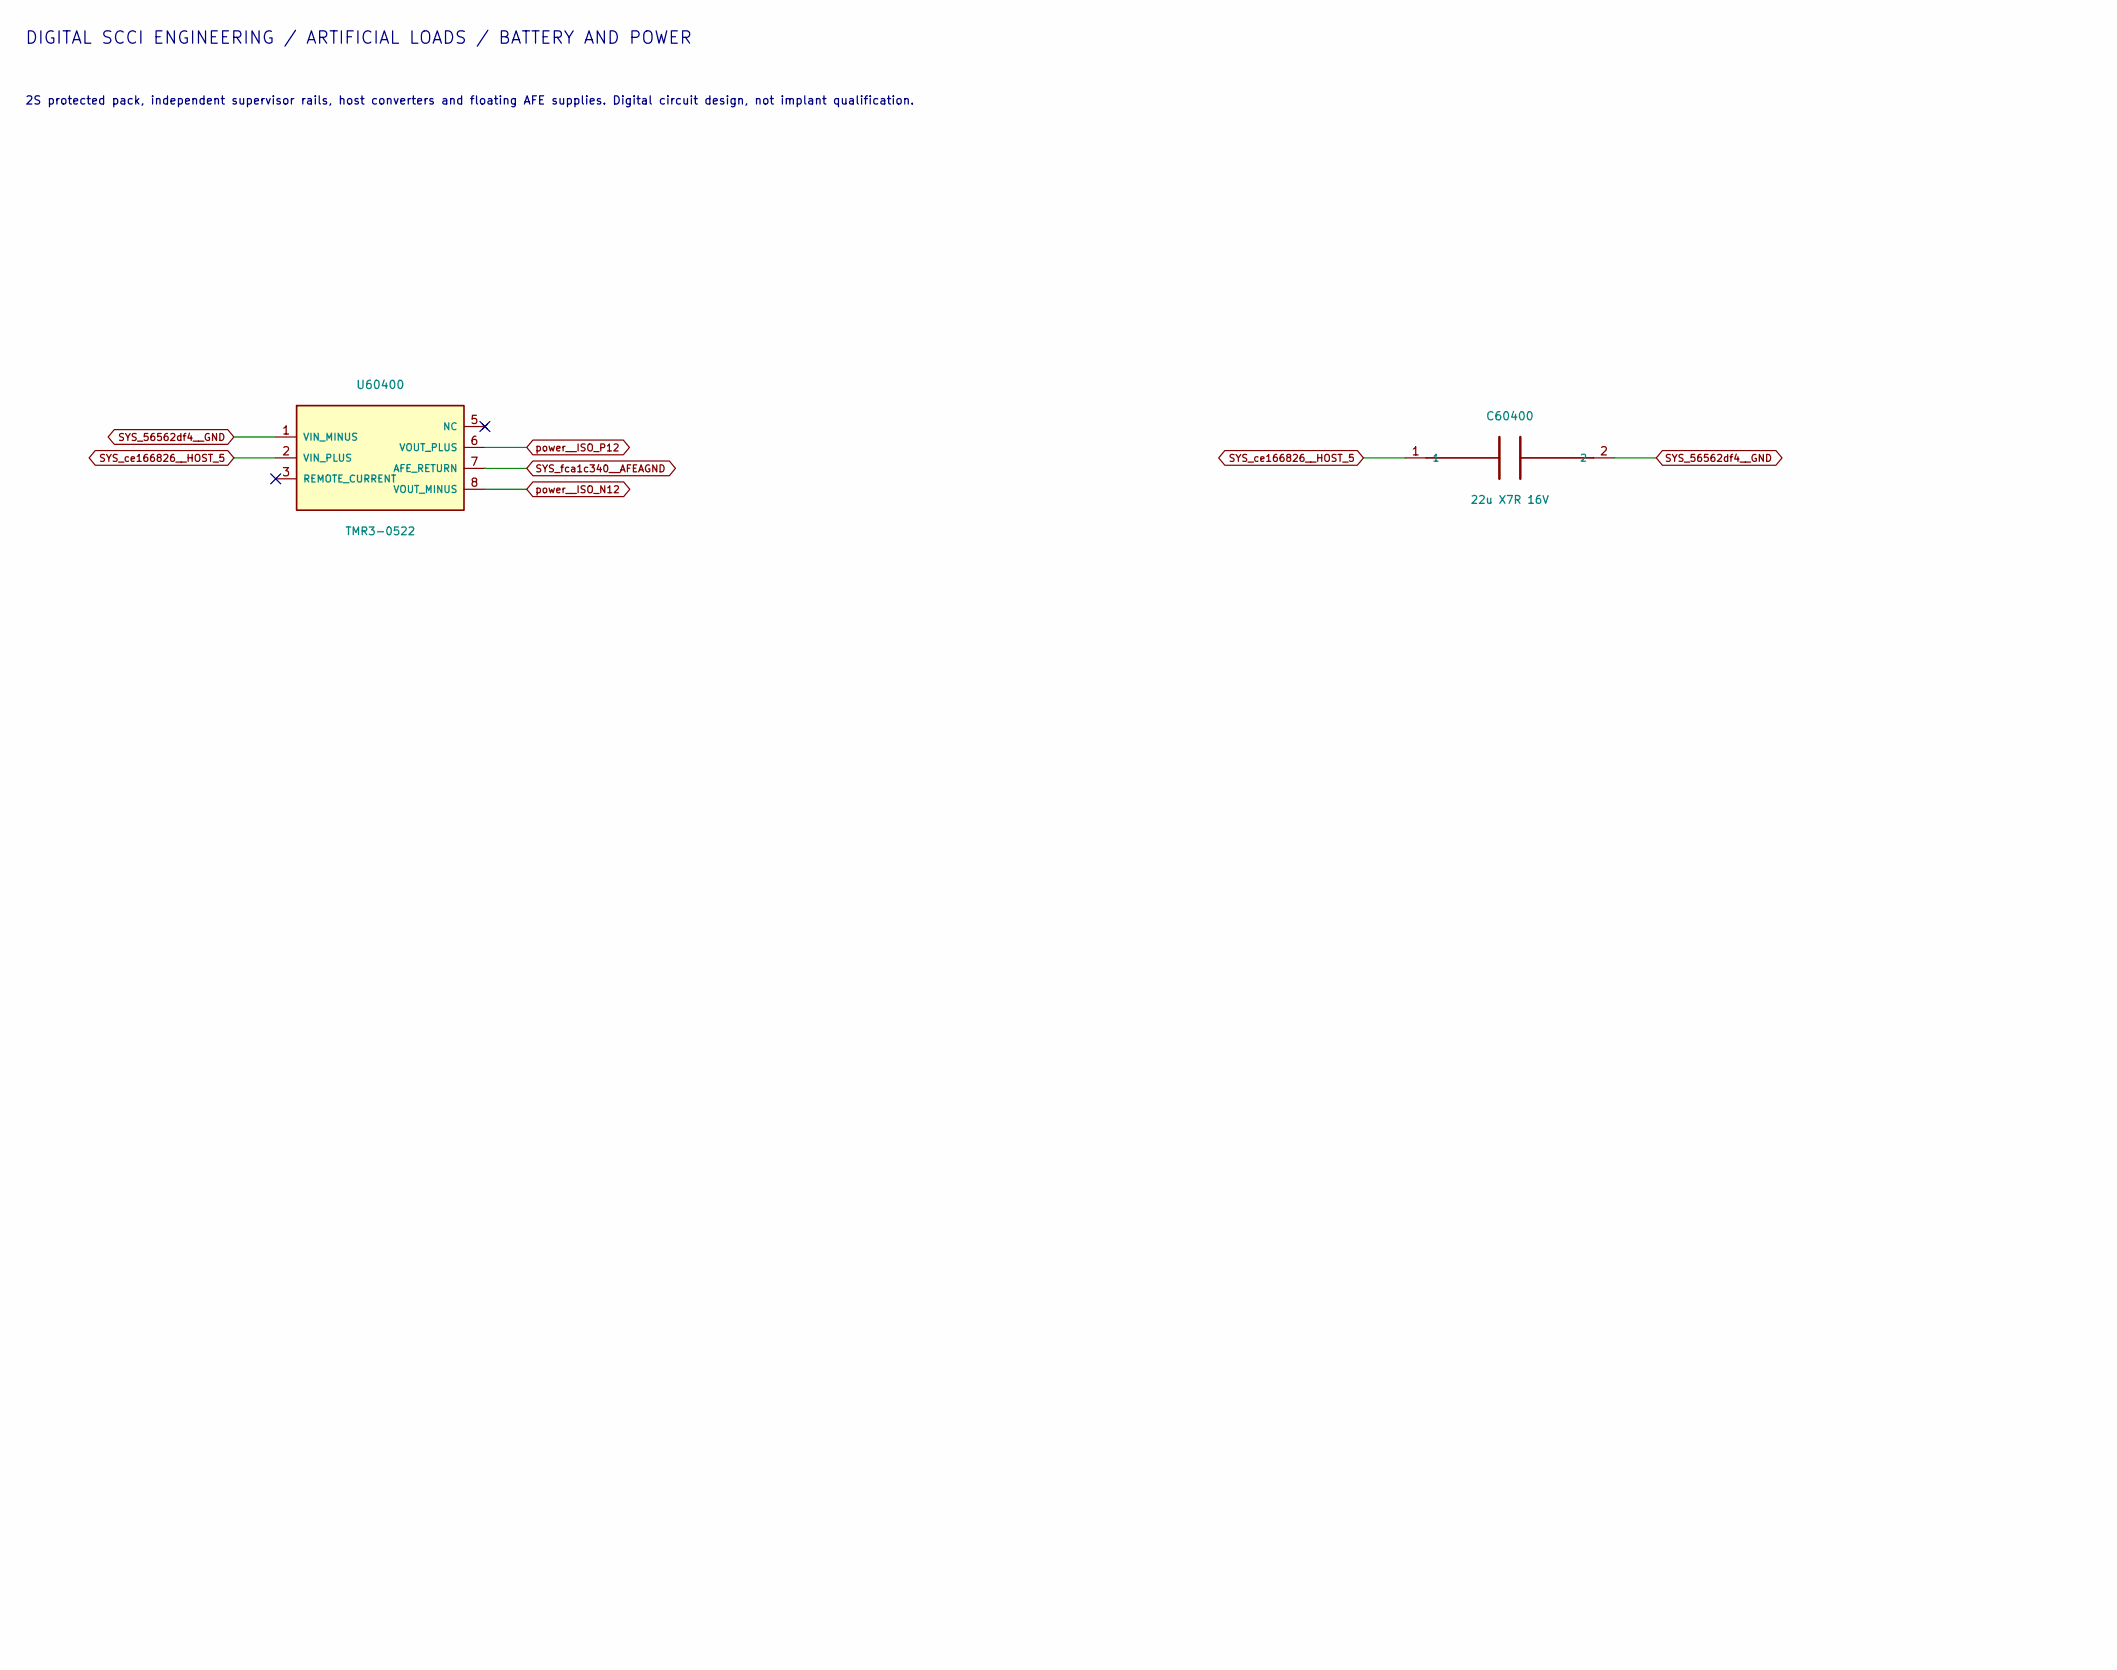
[picture p434: schematic island.kicad_sch, ATO S4 / Floating recording power module, part in row 1, column 1]

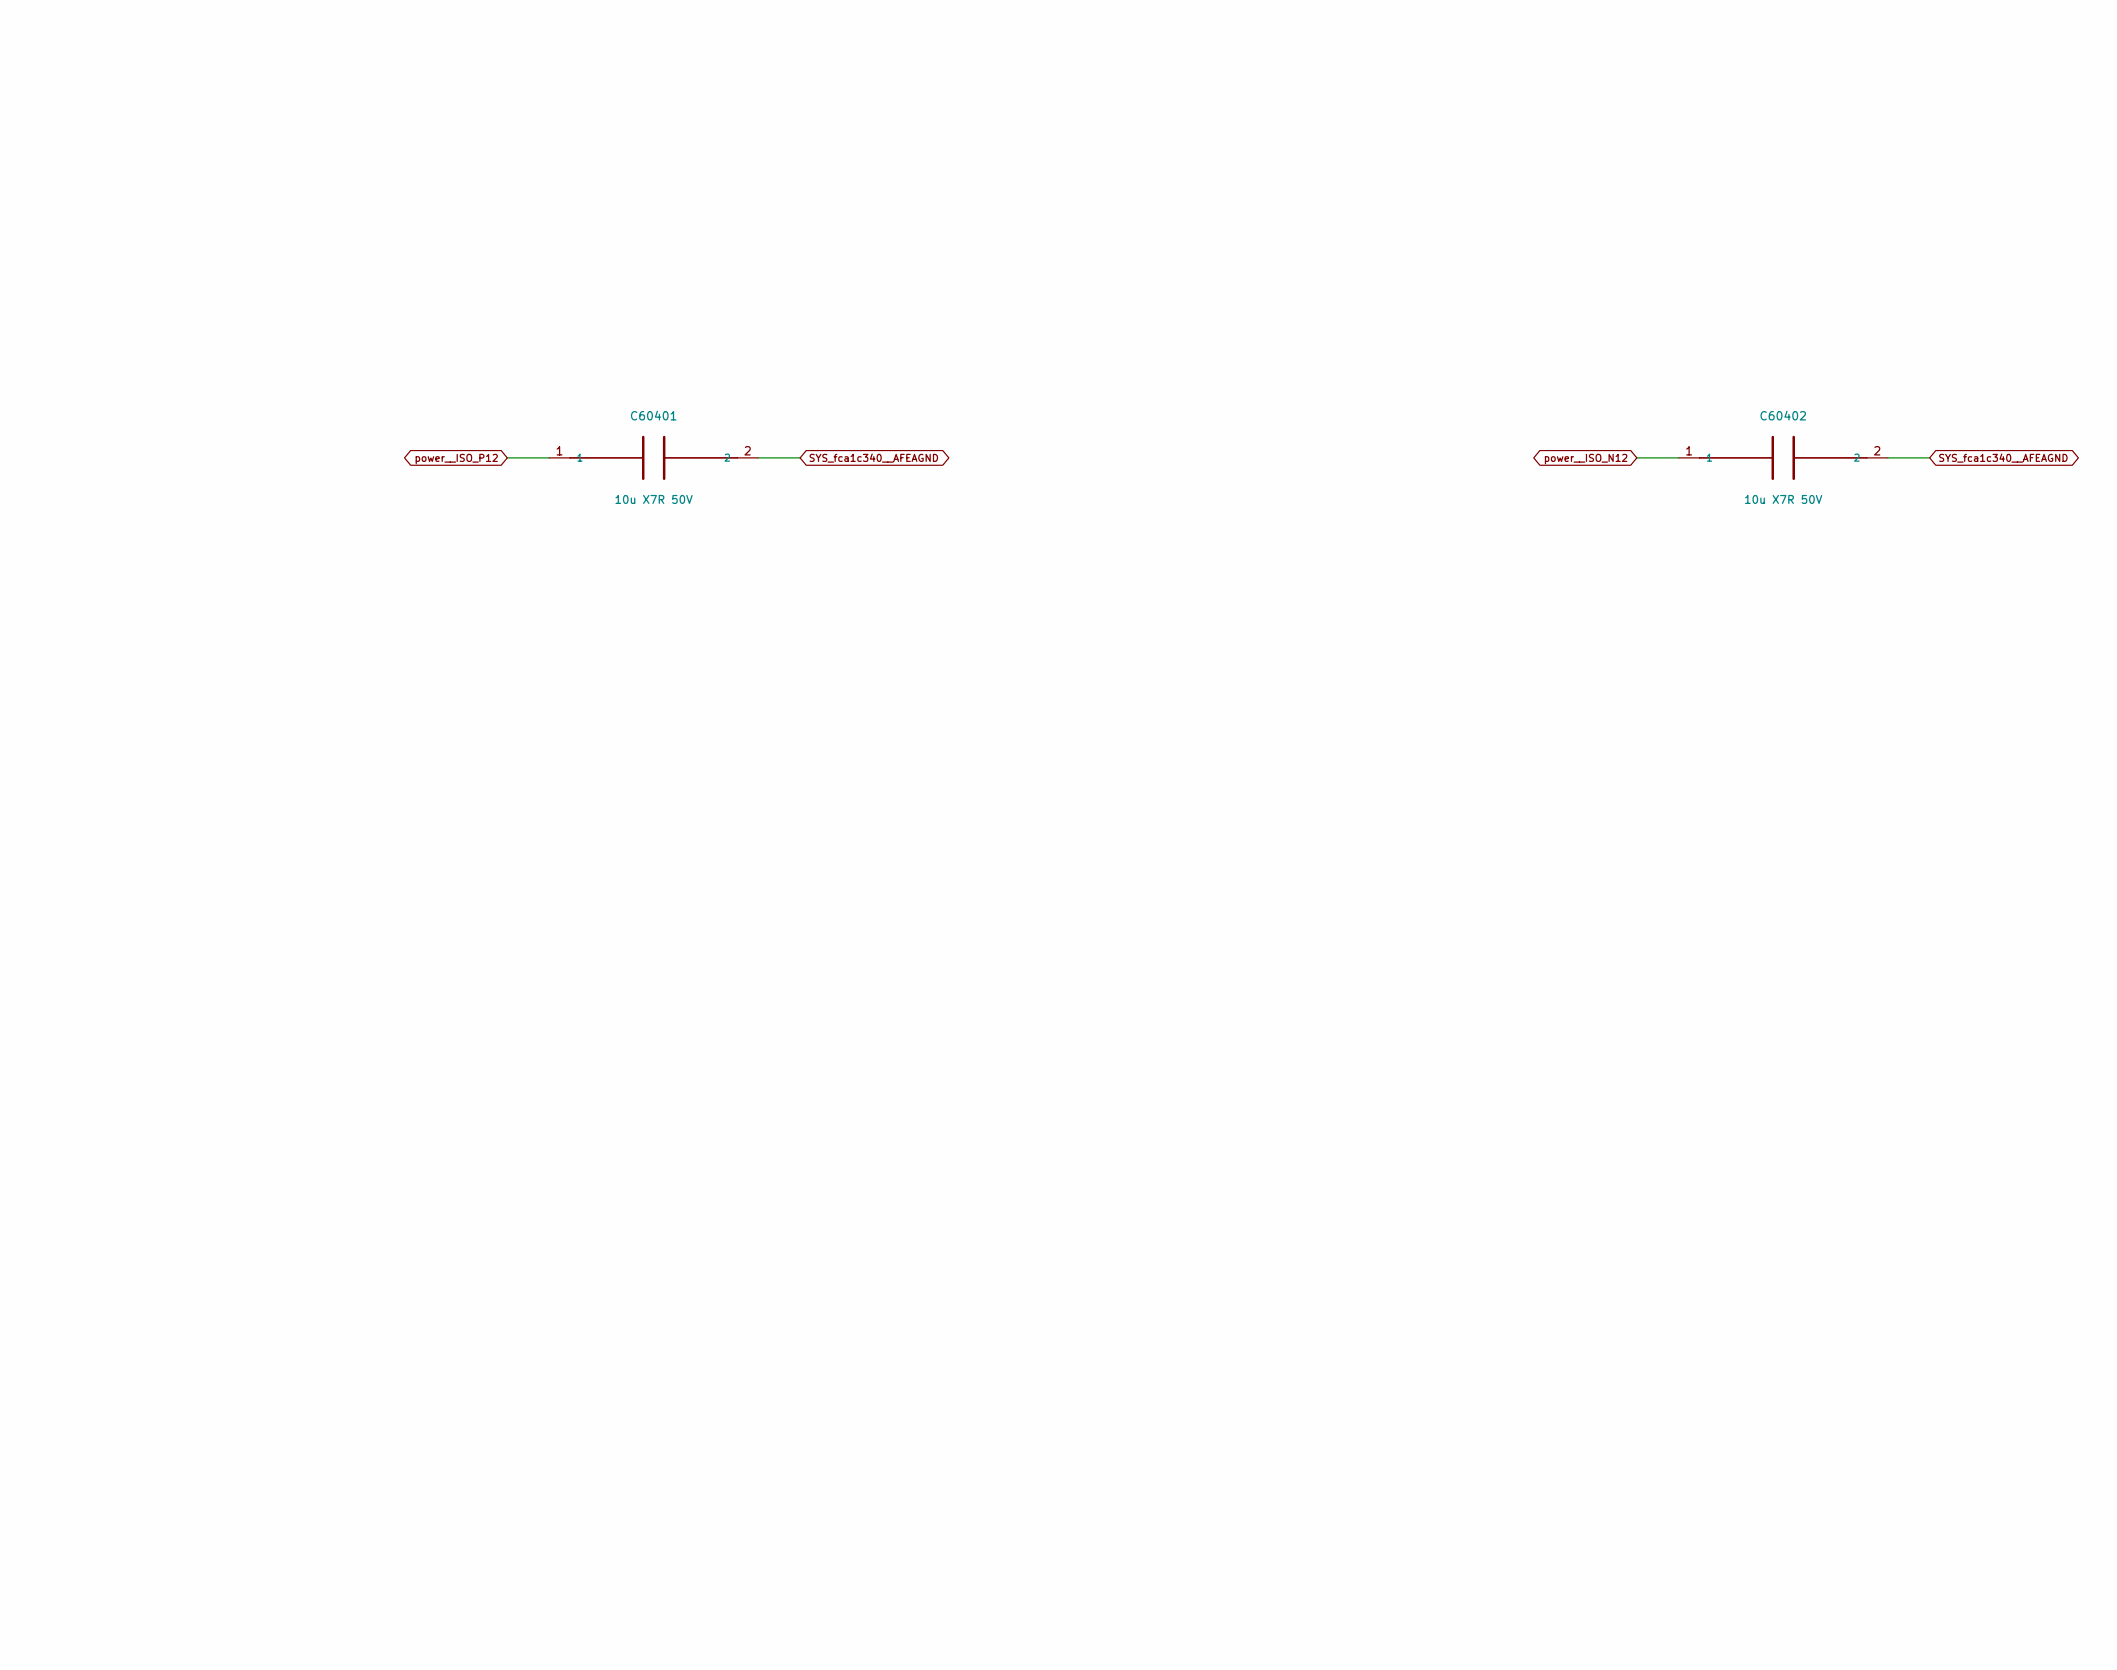
[picture p435: schematic island.kicad_sch, ATO S4 / Floating recording power module, part in row 1, column 2]

Parts:
C60400: 22u X7R 16V; C_1206_3216Metric
C60401, C60402: 10u X7R 50V; C_1206_3216Metric
U60400: TMR3-0522; TRACO_TMR3_SIP8_21.8x9.1_P2.54

Connections:
SYS_56562df4__GND: C60400.2, U60400.1 (VIN_MINUS); also elsewhere on the board
SYS_ce166826__HOST_5: C60400.1, U60400.2 (VIN_PLUS); also elsewhere on the board
SYS_fca1c340__AFEAGND: C60401.2, C60402.2, U60400.7 (AFE_RETURN); also elsewhere on the board
power__ISO_N12: C60402.1, U60400.8 (VOUT_MINUS); also elsewhere on the board
power__ISO_P12: C60401.1, U60400.6 (VOUT_PLUS); also elsewhere on the board

Notes on the sheet:
DIGITAL SCCI ENGINEERING / ARTIFICIAL LOADS / BATTERY AND POWER
2S protected pack, independent supervisor rails, host converters and floating AFE supplies. Digital circuit design, not implant qualification.
All labels are native electrical connections. PG is diagnostic; full qualification remains the nine independent supervision windows.
Converter shutdown does not discharge boost paths or remove stored energy. Body-facing shutdown remains the separate terminal guards.

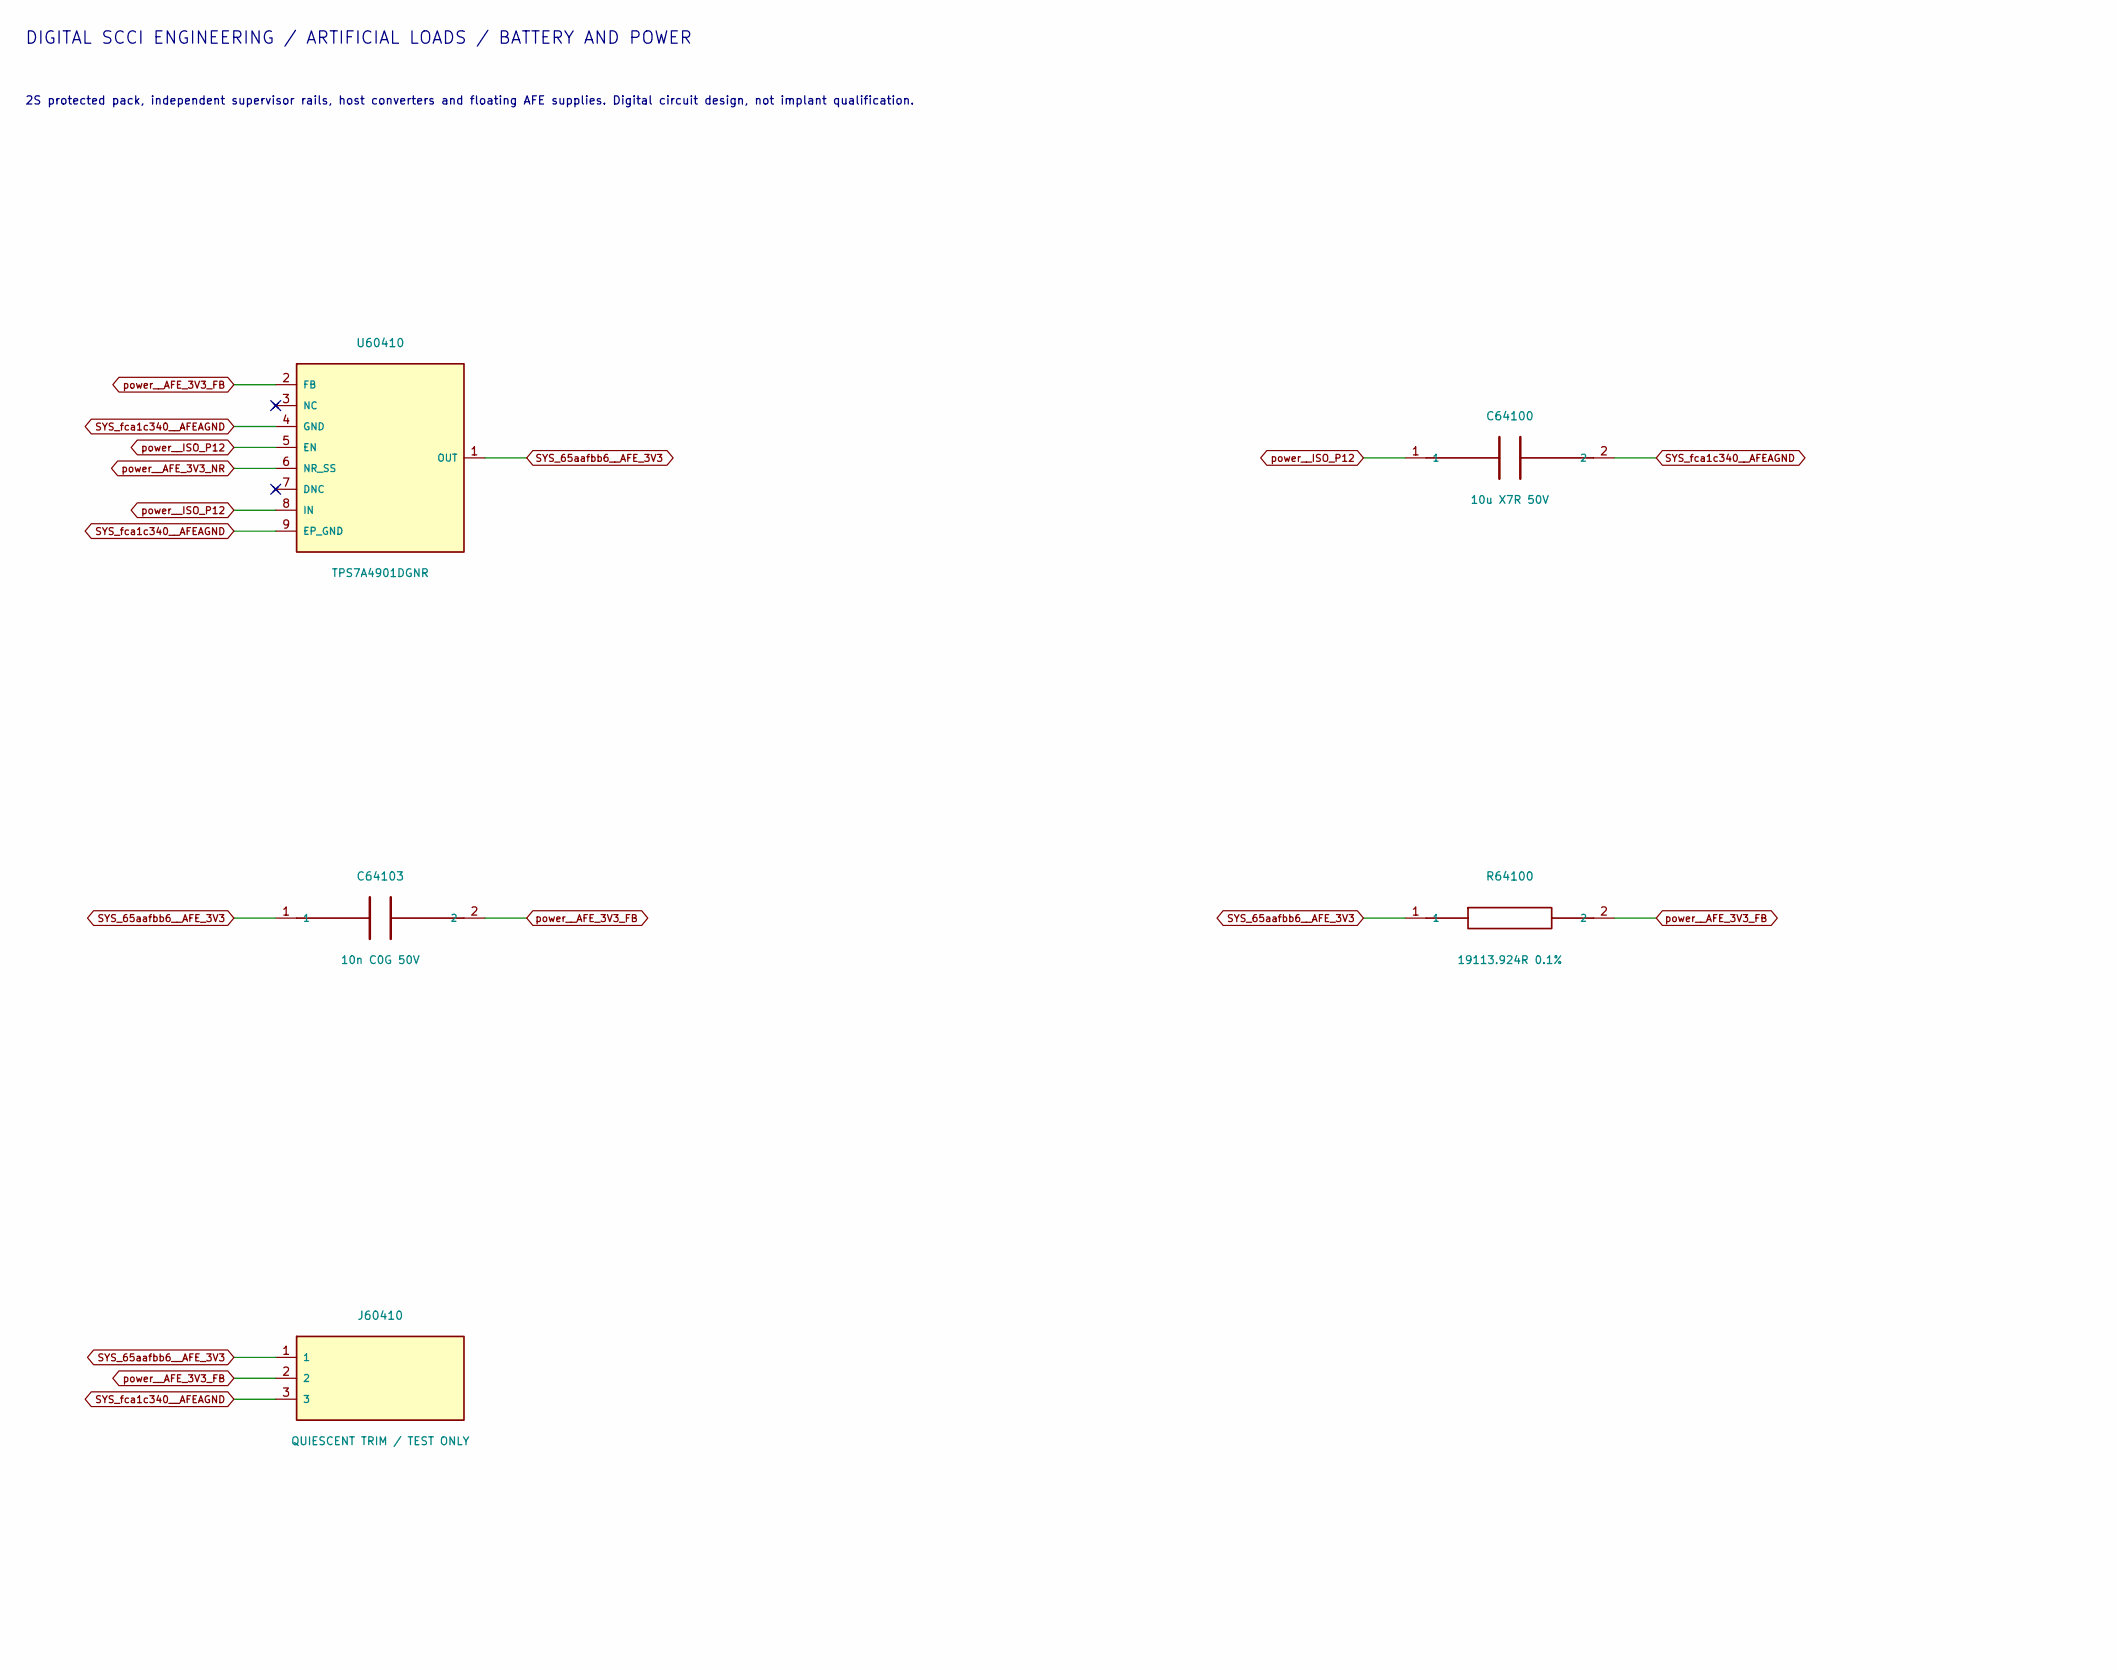
[picture p436: schematic afe3.kicad_sch, ATO S4 / Floating AFE 3.45 V regulator, part in row 1, column 1]

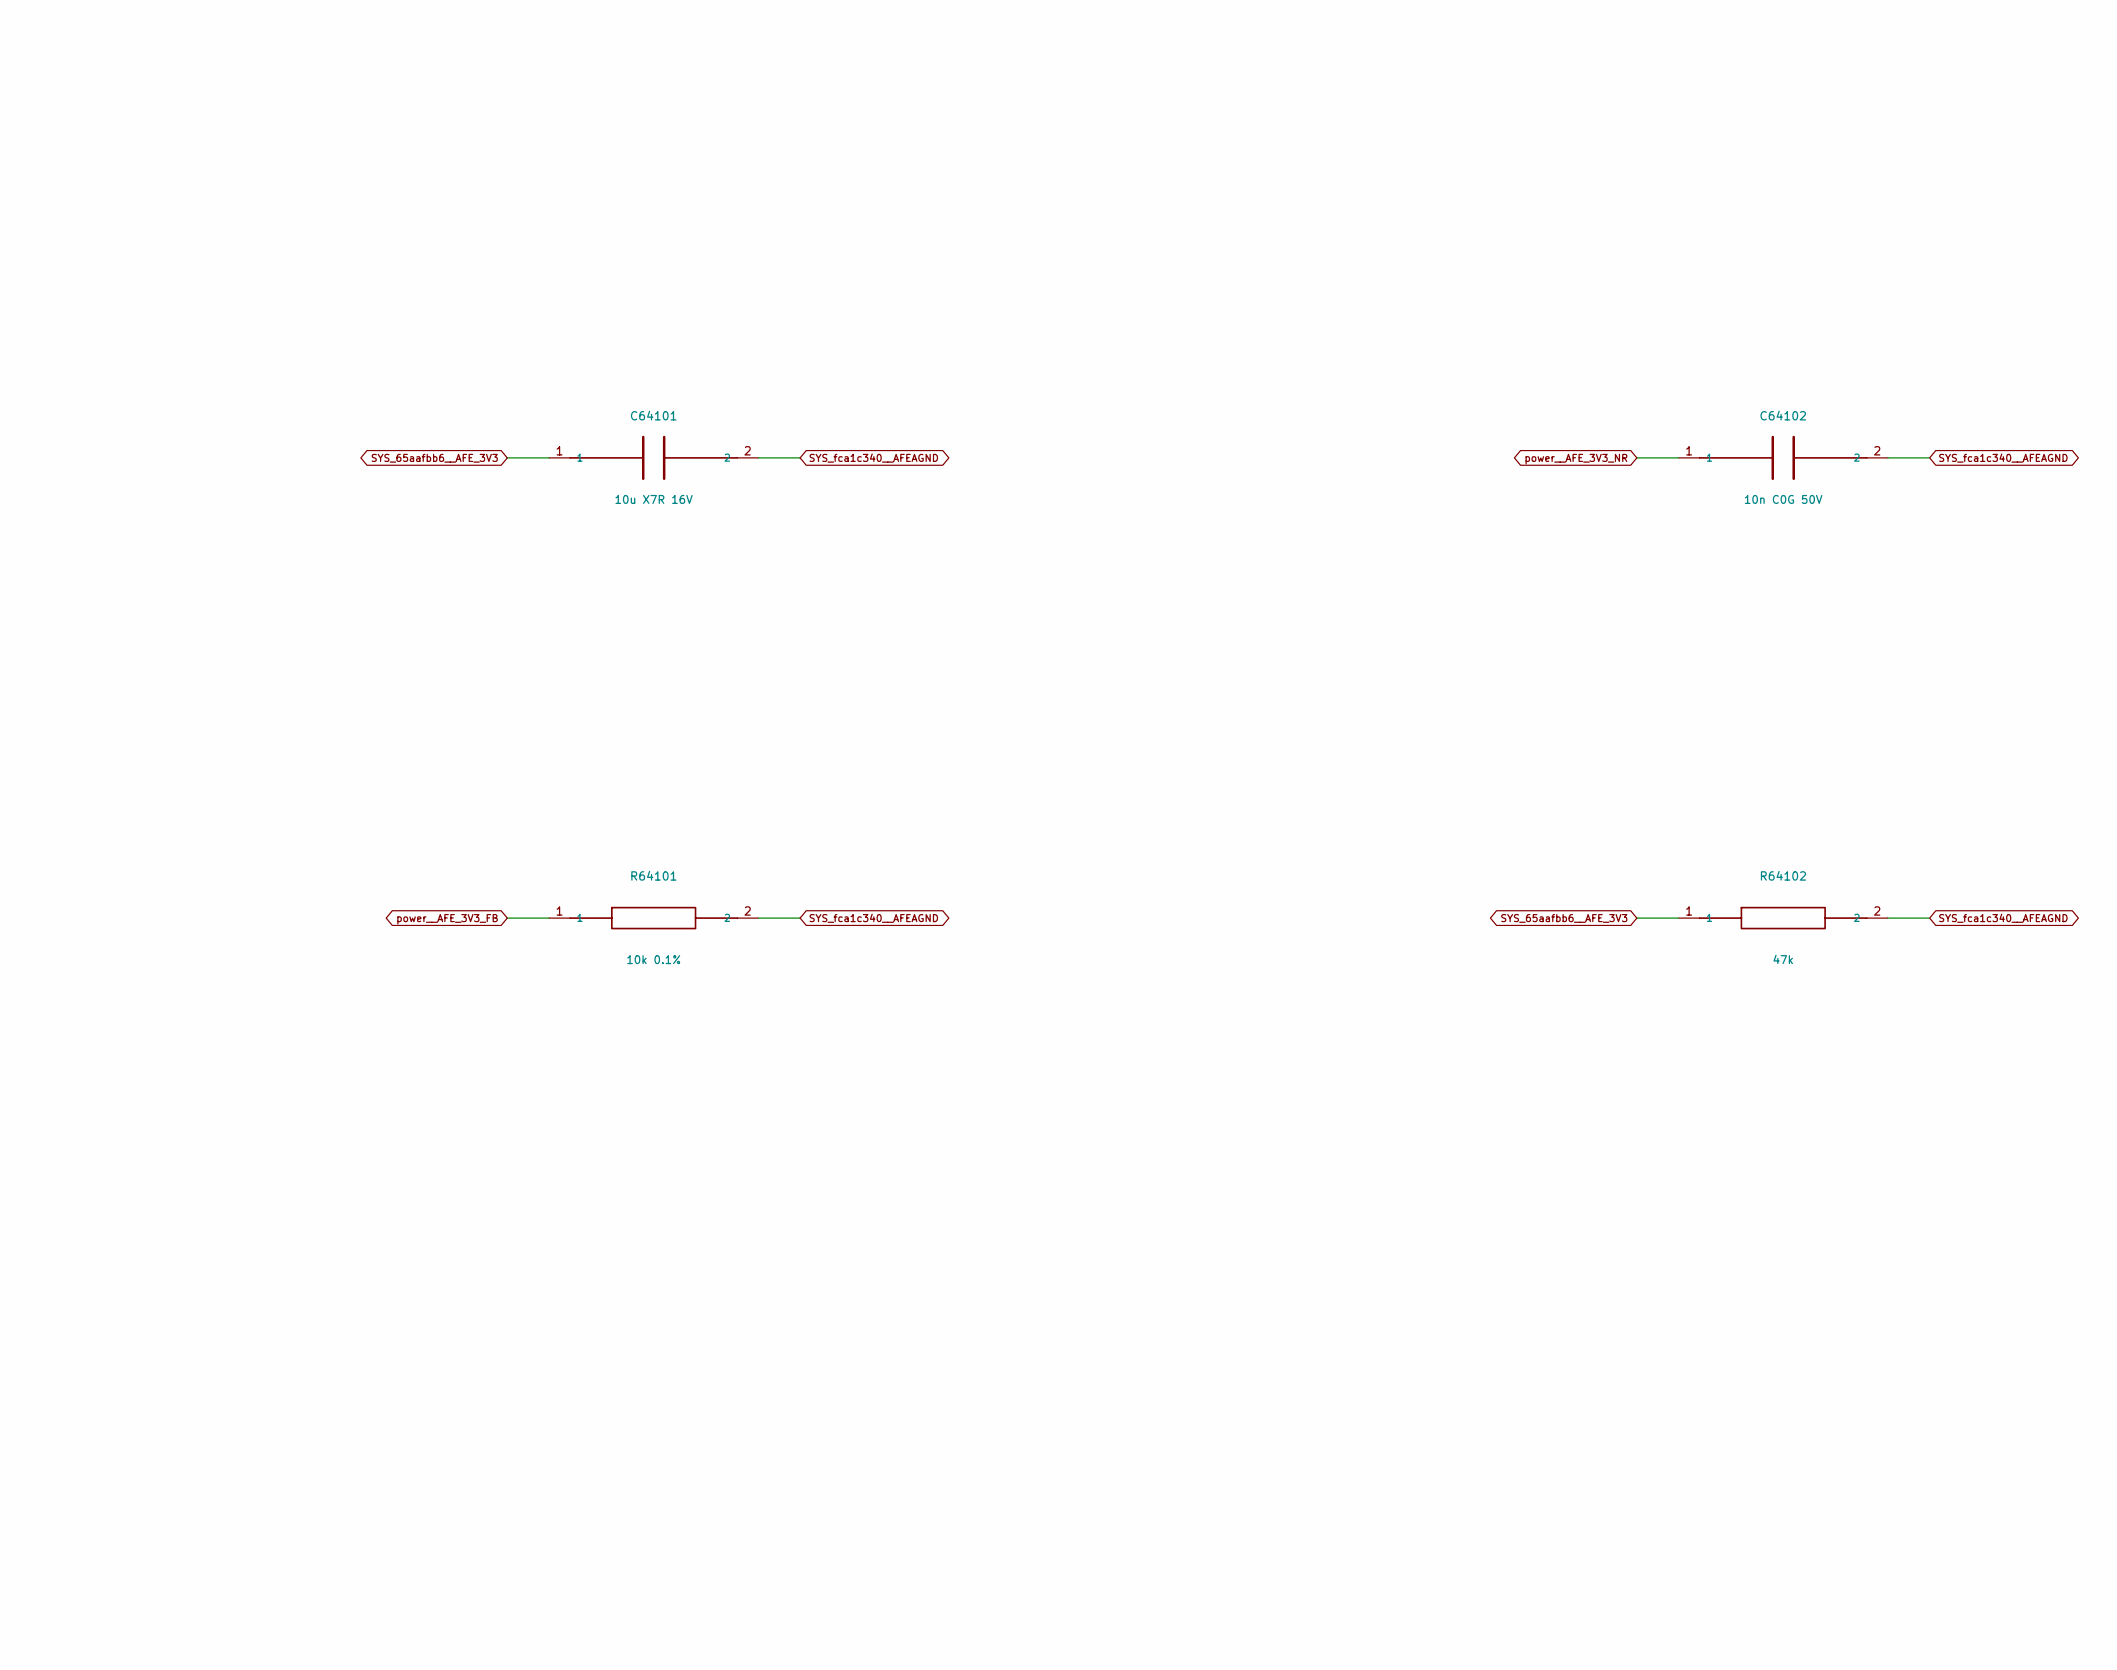
[picture p437: schematic afe3.kicad_sch, ATO S4 / Floating AFE 3.45 V regulator, part in row 1, column 2]

Parts:
C64100: 10u X7R 50V; C_1206_3216Metric
C64101: 10u X7R 16V; C_1206_3216Metric
C64102, C64103: 10n C0G 50V; C_1206_3216Metric
J60410: QUIESCENT TRIM / TEST ONLY; PinHeader_1x03_P2.54mm_Vertical
R64100: 19113.924R 0.1%; R_0805_2012Metric
R64101: 10k 0.1%; R_0805_2012Metric
R64102: 47k; R_0805_2012Metric
U60410: TPS7A4901DGNR; Texas_DGN0008D_VSSOP-8-1EP_3x3mm_P0.65mm_EP2x2.94mm_Mask1.5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

Connections:
SYS_65aafbb6__AFE_3V3: C64101.1, C64103.1, J60410.1, R64100.1, R64102.1, U60410.1 (OUT); also elsewhere on the board
SYS_fca1c340__AFEAGND: C64100.2, C64101.2, C64102.2, J60410.3, R64101.2, R64102.2, U60410.4 (GND), U60410.9 (EP_GND); also elsewhere on the board
power__AFE_3V3_FB: C64103.2, J60410.2, R64100.2, R64101.1, U60410.2 (FB)
power__AFE_3V3_NR: C64102.1, U60410.6 (NR_SS)
power__ISO_P12: C64100.1, U60410.5 (EN), U60410.8 (IN); also elsewhere on the board

Notes on the sheet:
DIGITAL SCCI ENGINEERING / ARTIFICIAL LOADS / BATTERY AND POWER
2S protected pack, independent supervisor rails, host converters and floating AFE supplies. Digital circuit design, not implant qualification.
All labels are native electrical connections. PG is diagnostic; full qualification remains the nine independent supervision windows.
Converter shutdown does not discharge boost paths or remove stored energy. Body-facing shutdown remains the separate terminal guards.
