pratham-cloud-ctrl/Project-ATO/electronics/stage4/integrated-pcb/boards/current-driver/current_driver.kicad_pcb

## KiCad design electronics/stage4/integrated-pcb/boards/current-driver/current_driver.kicad_pcb (2026-10-16)

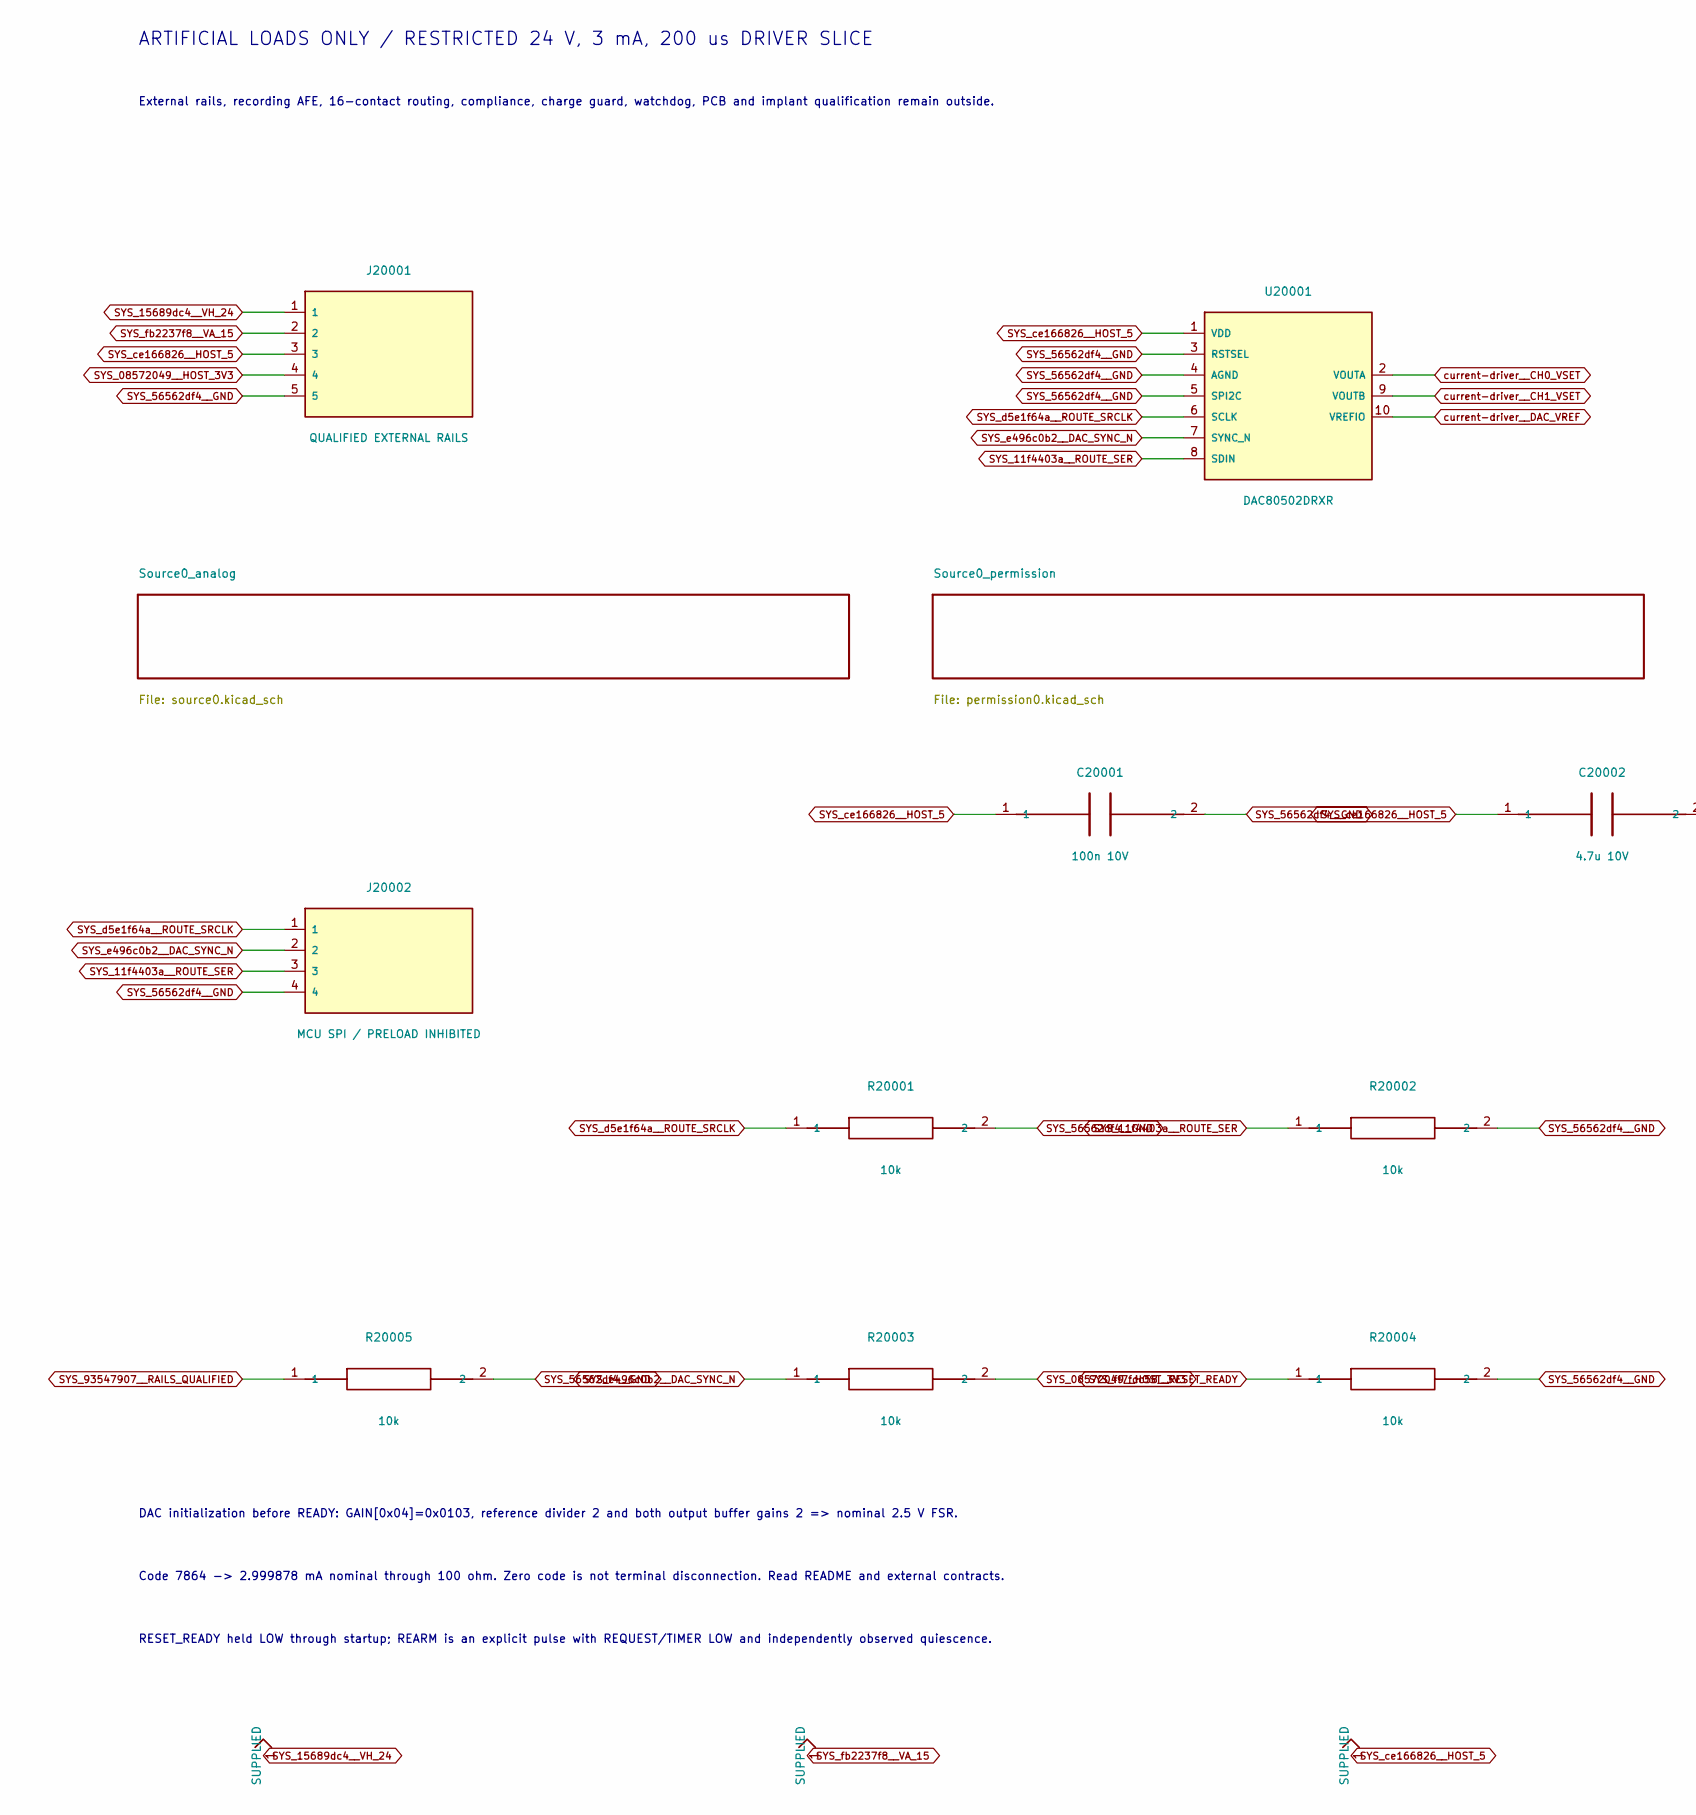
[picture p474: schematic current_driver.kicad_sch, ATO S4 / Dual setpoint and external contracts, part in row 1, column 1]

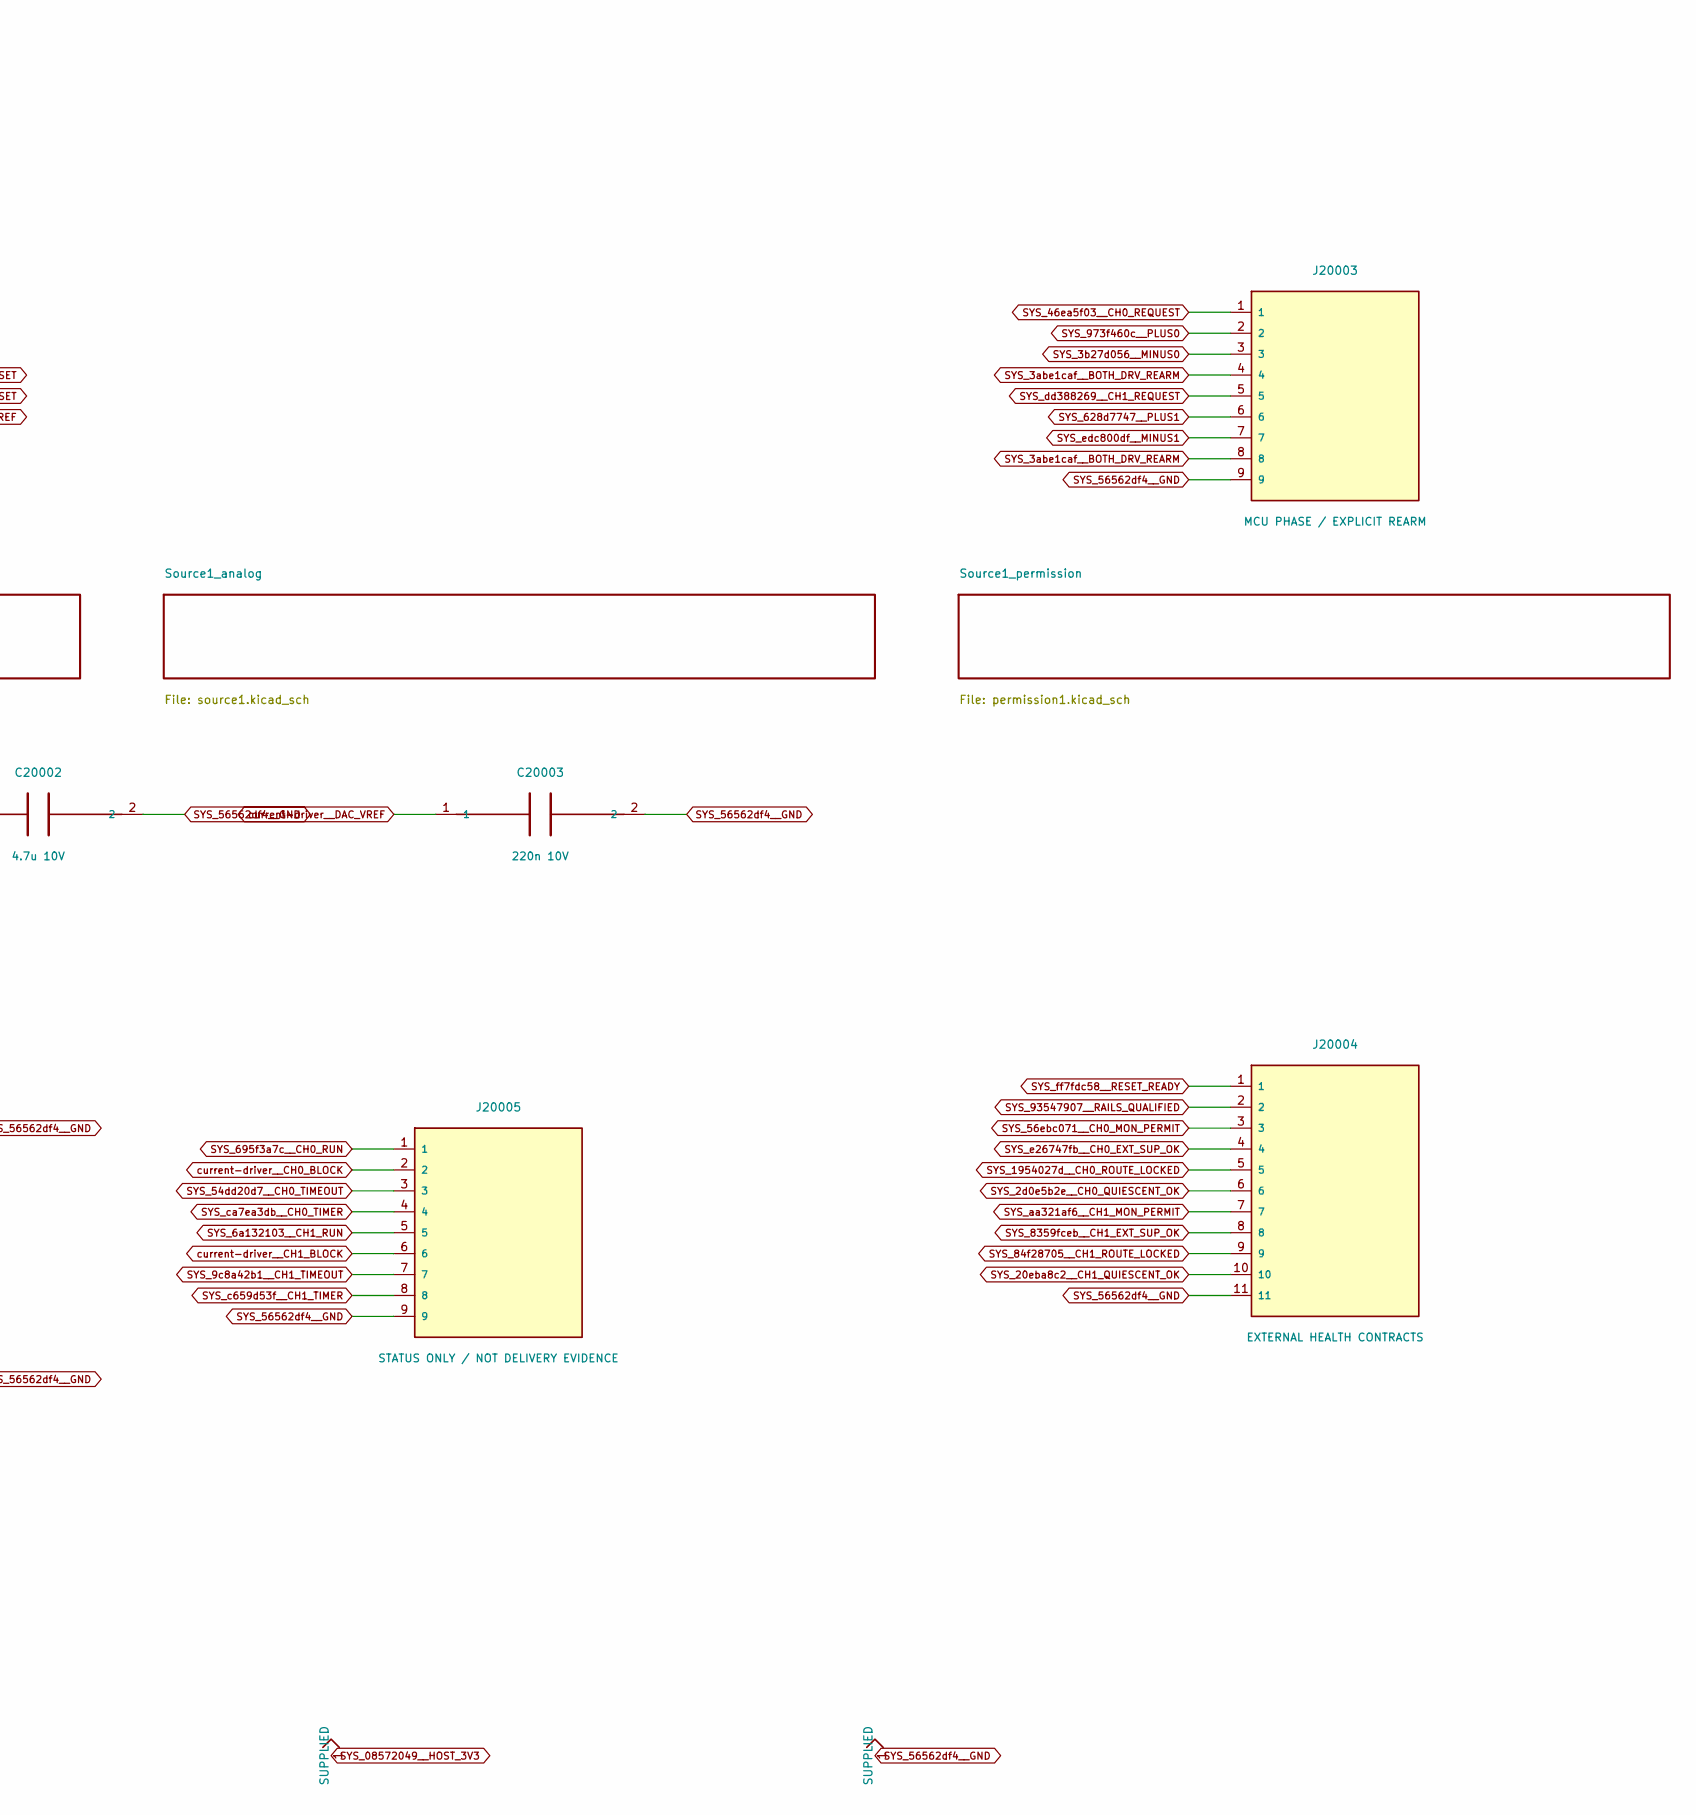
[picture p475: schematic current_driver.kicad_sch, ATO S4 / Dual setpoint and external contracts, part in row 1, column 2]

Parts:
C20001: 100n 10V; C_0805_2012Metric
C20002: 4.7u 10V; C_0805_2012Metric
C20003: 220n 10V; C_0805_2012Metric
J20001: QUALIFIED EXTERNAL RAILS; PinHeader_1x05_P2.54mm_Vertical
J20002: MCU SPI / PRELOAD INHIBITED; PinHeader_1x04_P2.54mm_Vertical
J20003: MCU PHASE / EXPLICIT REARM; PinHeader_1x09_P2.54mm_Vertical
J20004: EXTERNAL HEALTH CONTRACTS; PinHeader_1x11_P2.54mm_Vertical
J20005: STATUS ONLY / NOT DELIVERY EVIDENCE; PinHeader_1x09_P2.54mm_Vertical
R20001, R20002, R20003, R20004, R20005: 10k; R_0805_2012Metric
U20001: DAC80502DRXR; Texas_DRX_WSON-10_2.5x2.5mm_P0.5mm

Connections:
SYS_2d0e5b2e__CH0_QUIESCENT_OK: J20004.6; also elsewhere on the board
SYS_3abe1caf__BOTH_DRV_REARM: J20003.4, J20003.8; also elsewhere on the board
SYS_3b27d056__MINUS0: J20003.3; also elsewhere on the board
SYS_6a132103__CH1_RUN: J20005.5; also elsewhere on the board
SYS_9c8a42b1__CH1_TIMEOUT: J20005.7; also elsewhere on the board
SYS_11f4403a__ROUTE_SER: J20002.3, R20002.1, U20001.8 (SDIN)
SYS_20eba8c2__CH1_QUIESCENT_OK: J20004.10; also elsewhere on the board
SYS_46ea5f03__CH0_REQUEST: J20003.1; also elsewhere on the board
SYS_54dd20d7__CH0_TIMEOUT: J20005.3; also elsewhere on the board
SYS_56ebc071__CH0_MON_PERMIT: J20004.3; also elsewhere on the board
SYS_84f28705__CH1_ROUTE_LOCKED: J20004.9; also elsewhere on the board
SYS_628d7747__PLUS1: J20003.6; also elsewhere on the board
SYS_695f3a7c__CH0_RUN: J20005.1; also elsewhere on the board
SYS_973f460c__PLUS0: J20003.2; also elsewhere on the board
SYS_8359fceb__CH1_EXT_SUP_OK: J20004.8; also elsewhere on the board
SYS_15689dc4__VH_24: J20001.1; also elsewhere on the board
SYS_56562df4__GND: C20001.2, C20002.2, C20003.2, J20001.5, J20002.4, J20003.9, J20004.11, J20005.9, R20001.2, R20002.2, R20004.2, R20005.2, U20001.3 (RSTSEL), U20001.4 (AGND), U20001.5 (SPI2C); also elsewhere on the board
SYS_1954027d__CH0_ROUTE_LOCKED: J20004.5; also elsewhere on the board
SYS_08572049__HOST_3V3: J20001.4, R20003.2; also elsewhere on the board
SYS_93547907__RAILS_QUALIFIED: J20004.2, R20005.1; also elsewhere on the board
SYS_aa321af6__CH1_MON_PERMIT: J20004.7; also elsewhere on the board
SYS_c659d53f__CH1_TIMER: J20005.8; also elsewhere on the board
SYS_ca7ea3db__CH0_TIMER: J20005.4; also elsewhere on the board
SYS_ce166826__HOST_5: C20001.1, C20002.1, J20001.3, U20001.1 (VDD)
SYS_d5e1f64a__ROUTE_SRCLK: J20002.1, R20001.1, U20001.6 (SCLK)
SYS_dd388269__CH1_REQUEST: J20003.5; also elsewhere on the board
SYS_e496c0b2__DAC_SYNC_N: J20002.2, R20003.1, U20001.7 (SYNC_N)
SYS_e26747fb__CH0_EXT_SUP_OK: J20004.4; also elsewhere on the board
SYS_edc800df__MINUS1: J20003.7; also elsewhere on the board
SYS_fb2237f8__VA_15: J20001.2; also elsewhere on the board
SYS_ff7fdc58__RESET_READY: J20004.1, R20004.1; also elsewhere on the board
current-driver__CH0_BLOCK: J20005.2; also elsewhere on the board
current-driver__CH0_VSET: U20001.2 (VOUTA); also elsewhere on the board
current-driver__CH1_BLOCK: J20005.6; also elsewhere on the board
current-driver__CH1_VSET: U20001.9 (VOUTB); also elsewhere on the board
current-driver__DAC_VREF: C20003.1, U20001.10 (VREFIO)

Notes on the sheet:
ARTIFICIAL LOADS ONLY / RESTRICTED 24 V, 3 mA, 200 us DRIVER SLICE
External rails, recording AFE, 16-contact routing, compliance, charge guard, watchdog, PCB and implant qualification remain outside.
DAC initialization before READY: GAIN[0x04]=0x0103, reference divider 2 and both output buffer gains 2 => nominal 2.5 V FSR.
Code 7864 -> 2.999878 mA nominal through 100 ohm. Zero code is not terminal disconnection. Read README and external contracts.
RESET_READY held LOW through startup; REARM is an explicit pulse with REQUEST/TIMER LOW and independently observed quiescence.

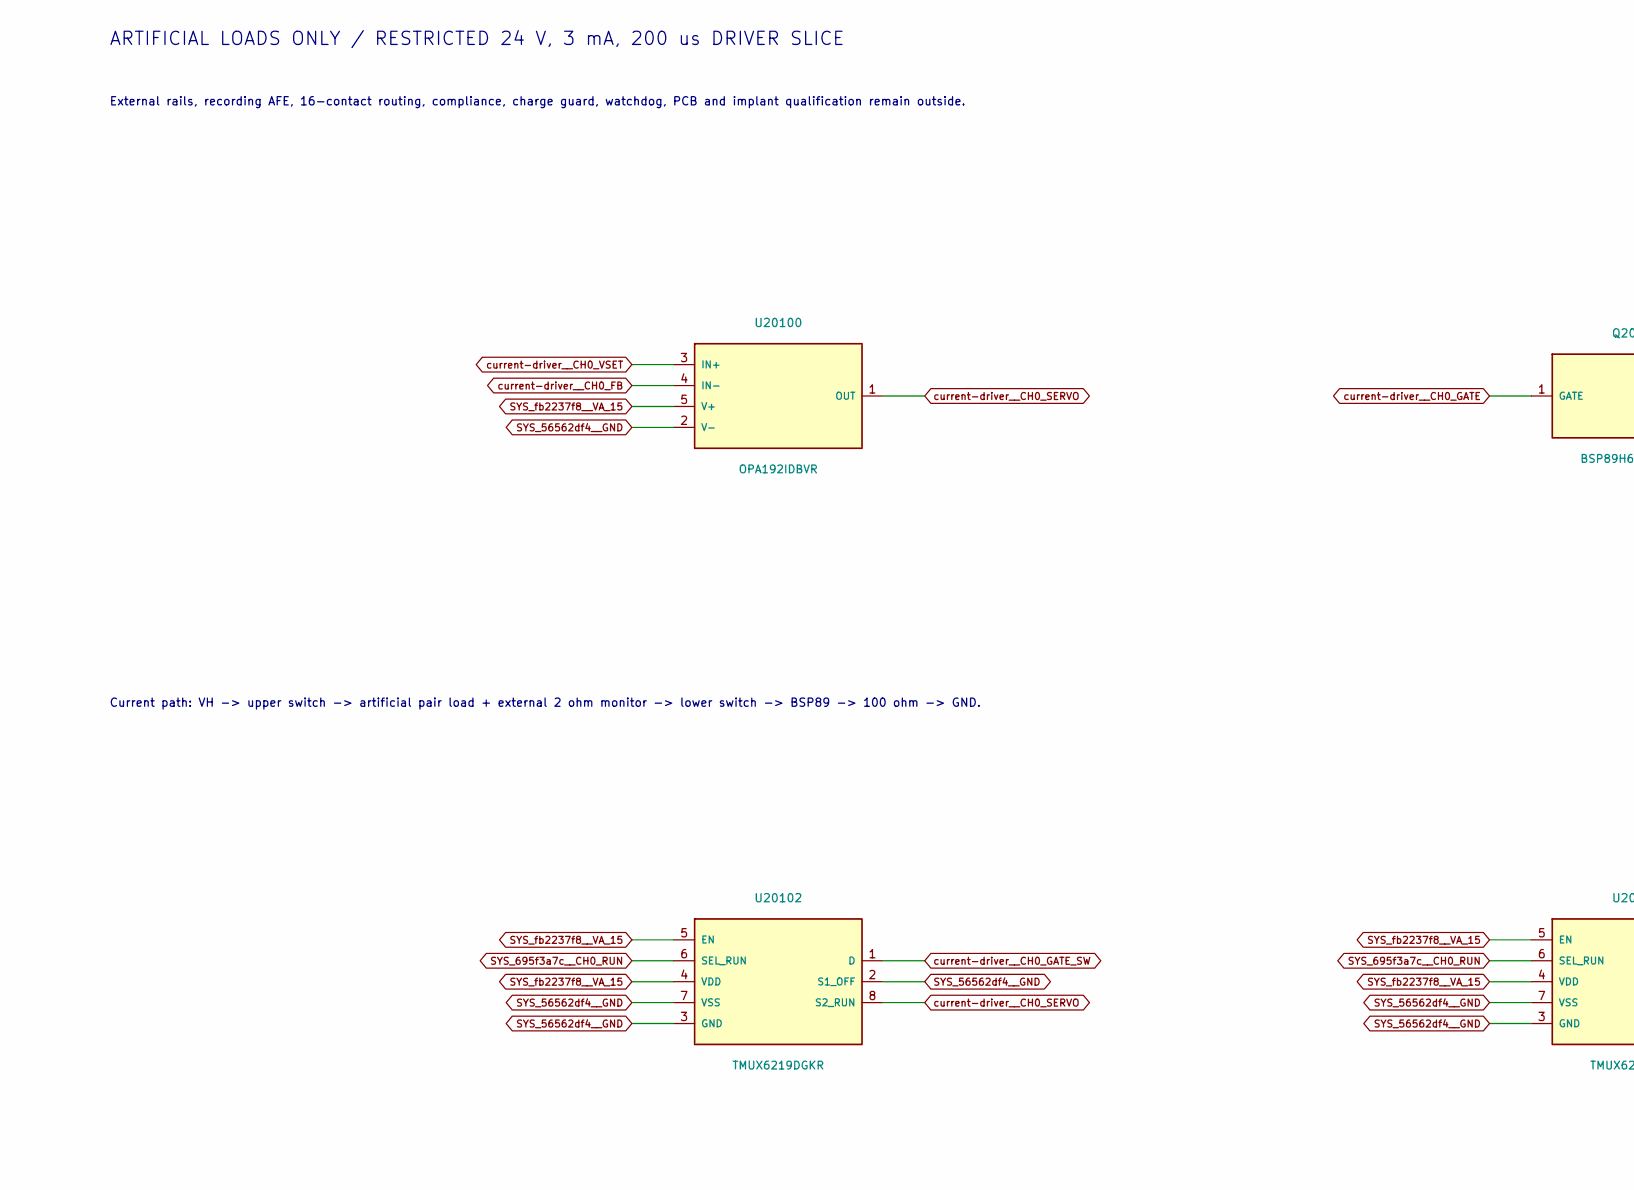
[picture p476: schematic source0.kicad_sch, ATO S4 / Source 0: regulated sink and polarity bridge, part in row 1, column 1]

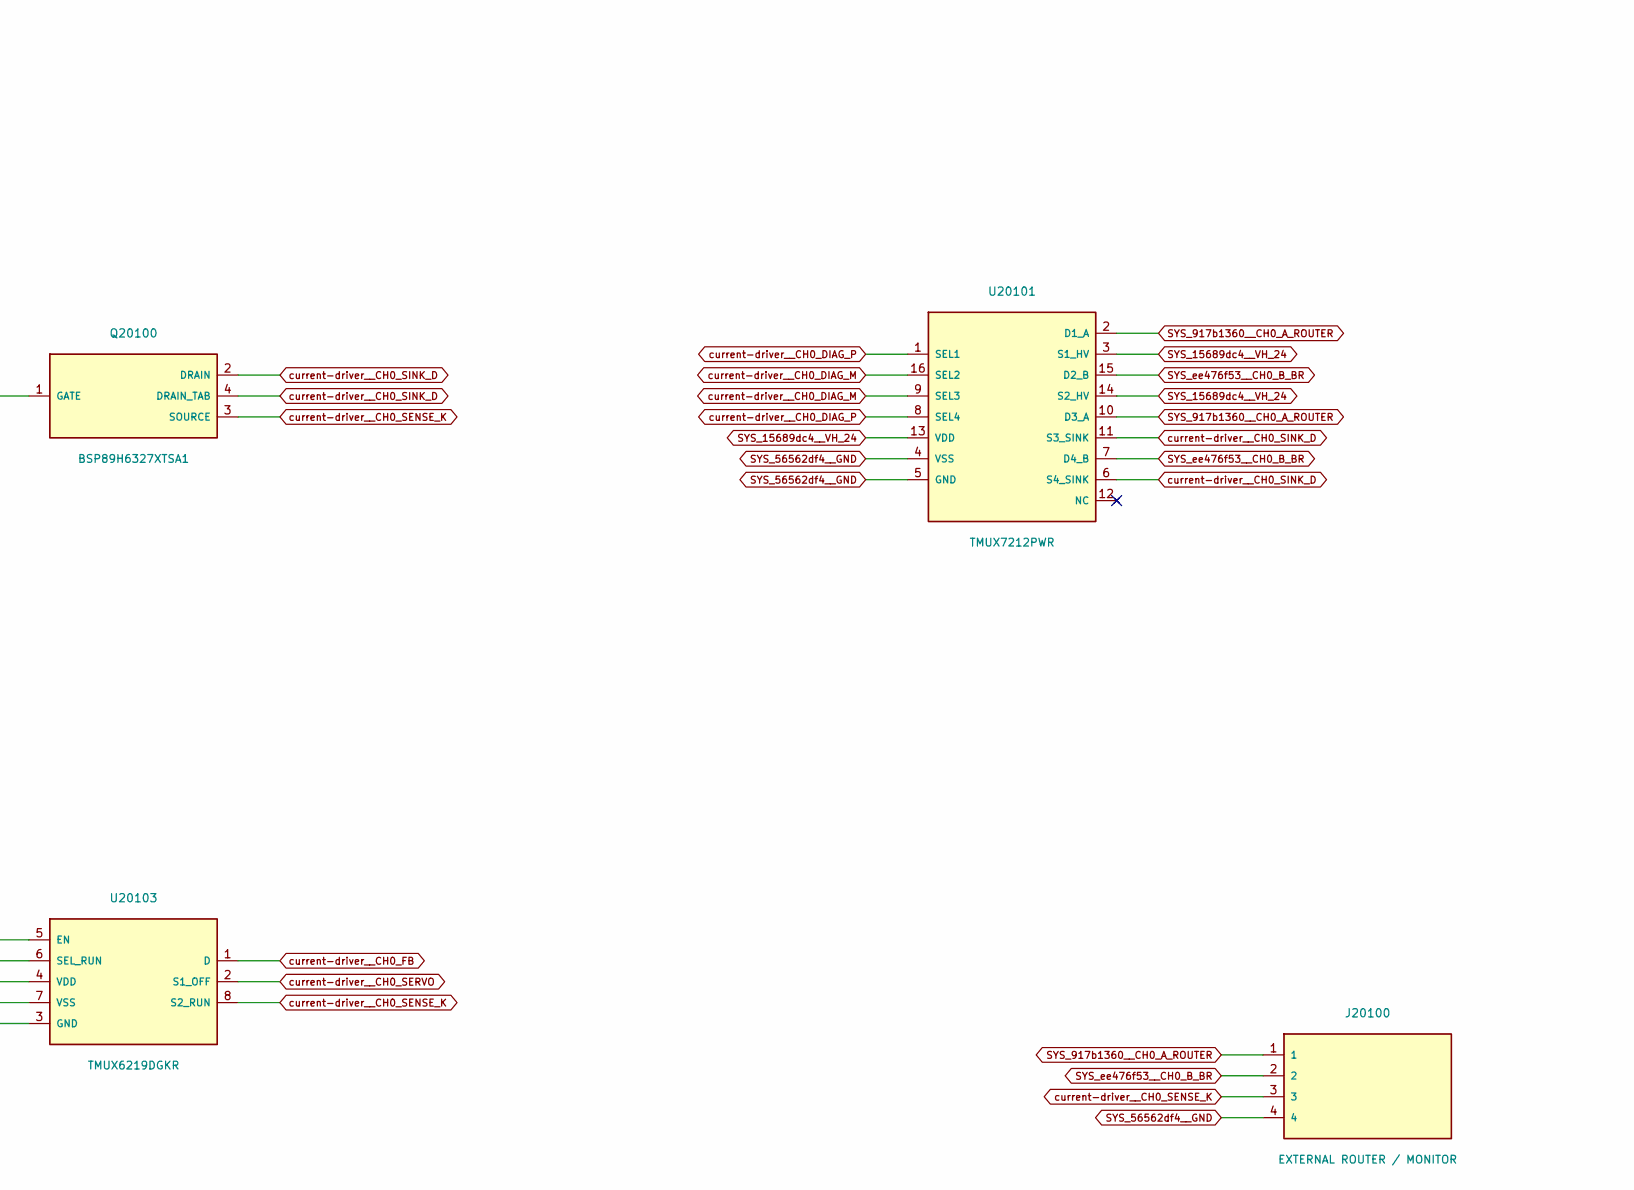
[picture p477: schematic source0.kicad_sch, ATO S4 / Source 0: regulated sink and polarity bridge, part in row 1, column 2]

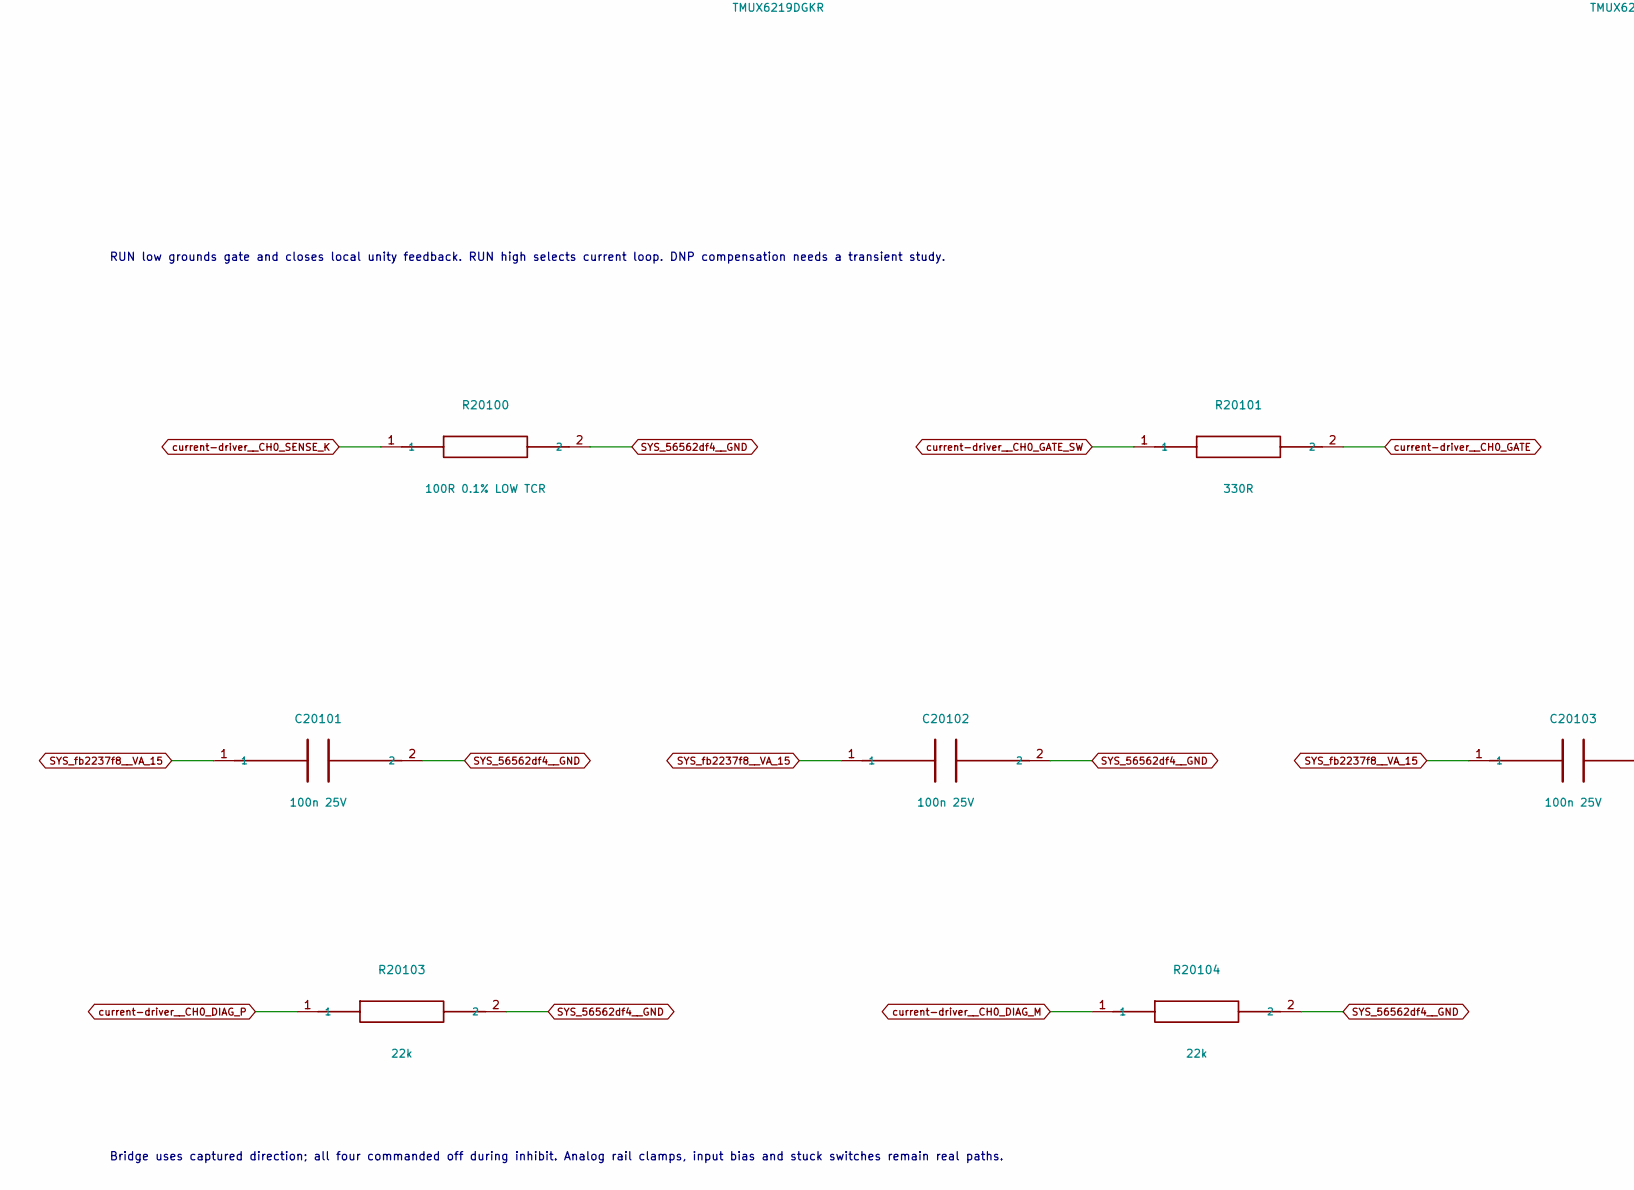
[picture p478: schematic source0.kicad_sch, ATO S4 / Source 0: regulated sink and polarity bridge, part in row 2, column 1]

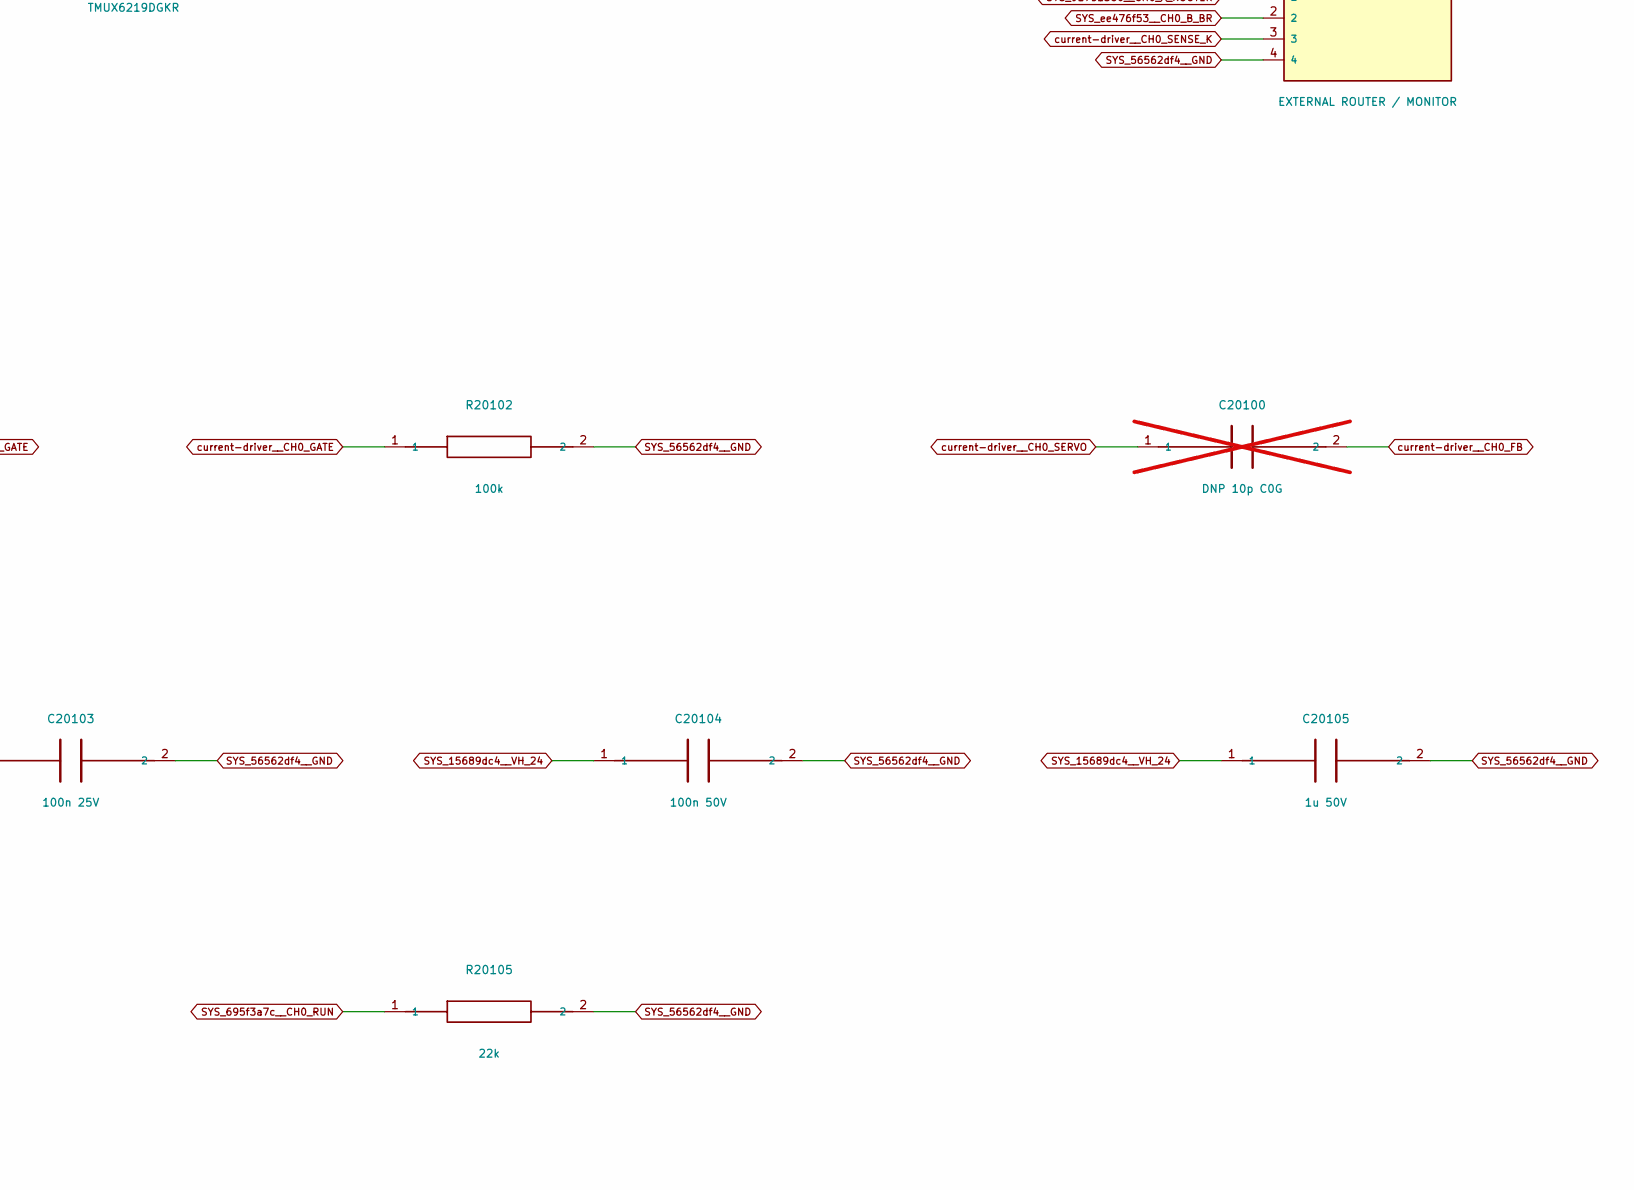
[picture p479: schematic source0.kicad_sch, ATO S4 / Source 0: regulated sink and polarity bridge, part in row 2, column 2]

Parts:
C20100: DNP 10p C0G; C_0805_2012Metric; not fitted
C20101, C20102, C20103: 100n 25V; C_0805_2012Metric
C20104: 100n 50V; C_0805_2012Metric
C20105: 1u 50V; C_0805_2012Metric
J20100: EXTERNAL ROUTER / MONITOR; PinHeader_1x04_P2.54mm_Vertical
Q20100: BSP89H6327XTSA1; BSP89_PG-SOT223-4_DrainTab
R20100: 100R 0.1% LOW TCR; R_0805_2012Metric
R20101: 330R; R_0805_2012Metric
R20102: 100k; R_0805_2012Metric
R20103, R20104, R20105: 22k; R_0805_2012Metric
U20100: OPA192IDBVR; SOT-23-5
U20101: TMUX7212PWR; TSSOP-16_4.4x5mm_P0.65mm
U20102, U20103: TMUX6219DGKR; VSSOP-8_2.3x2mm_P0.5mm

Connections:
SYS_695f3a7c__CH0_RUN: R20105.1, U20102.6 (SEL_RUN), U20103.6 (SEL_RUN); also elsewhere on the board
SYS_917b1360__CH0_A_ROUTER: J20100.1, U20101.2 (D1_A), U20101.10 (D3_A)
SYS_15689dc4__VH_24: C20104.1, C20105.1, U20101.3 (S1_HV), U20101.13 (VDD), U20101.14 (S2_HV); also elsewhere on the board
SYS_56562df4__GND: C20101.2, C20102.2, C20103.2, C20104.2, C20105.2, J20100.4, R20100.2, R20102.2, R20103.2, R20104.2, R20105.2, U20100.2 (V-), U20101.4 (VSS), U20101.5 (GND), U20102.2 (S1_OFF), U20102.3 (GND), U20102.7 (VSS), U20103.3 (GND), U20103.7 (VSS); also elsewhere on the board
SYS_ee476f53__CH0_B_BR: J20100.2, U20101.7 (D4_B), U20101.15 (D2_B)
SYS_fb2237f8__VA_15: C20101.1, C20102.1, C20103.1, U20100.5 (V+), U20102.4 (VDD), U20102.5 (EN), U20103.4 (VDD), U20103.5 (EN); also elsewhere on the board
current-driver__CH0_DIAG_M: R20104.1, U20101.9 (SEL3), U20101.16 (SEL2); also elsewhere on the board
current-driver__CH0_DIAG_P: R20103.1, U20101.1 (SEL1), U20101.8 (SEL4); also elsewhere on the board
current-driver__CH0_FB: C20100.2, U20100.4 (IN-), U20103.1 (D)
current-driver__CH0_GATE: Q20100.1 (GATE), R20101.2, R20102.1
current-driver__CH0_GATE_SW: R20101.1, U20102.1 (D)
current-driver__CH0_SENSE_K: J20100.3, Q20100.3 (SOURCE), R20100.1, U20103.8 (S2_RUN)
current-driver__CH0_SERVO: C20100.1, U20100.1 (OUT), U20102.8 (S2_RUN), U20103.2 (S1_OFF)
current-driver__CH0_SINK_D: Q20100.2 (DRAIN), Q20100.4 (DRAIN_TAB), U20101.6 (S4_SINK), U20101.11 (S3_SINK)
current-driver__CH0_VSET: U20100.3 (IN+); also elsewhere on the board

Notes on the sheet:
ARTIFICIAL LOADS ONLY / RESTRICTED 24 V, 3 mA, 200 us DRIVER SLICE
External rails, recording AFE, 16-contact routing, compliance, charge guard, watchdog, PCB and implant qualification remain outside.
Current path: VH -> upper switch -> artificial pair load + external 2 ohm monitor -> lower switch -> BSP89 -> 100 ohm -> GND.
RUN low grounds gate and closes local unity feedback. RUN high selects current loop. DNP compensation needs a transient study.
Bridge uses captured direction; all four commanded off during inhibit. Analog rail clamps, input bias and stuck switches remain real paths.
