pratham-cloud-ctrl/Project-ATO/electronics/stage4/integrated-pcb/boards/current-driver/current_driver.kicad_pcb

## KiCad design electronics/stage4/integrated-pcb/boards/current-driver/current_driver.kicad_pcb (continued)

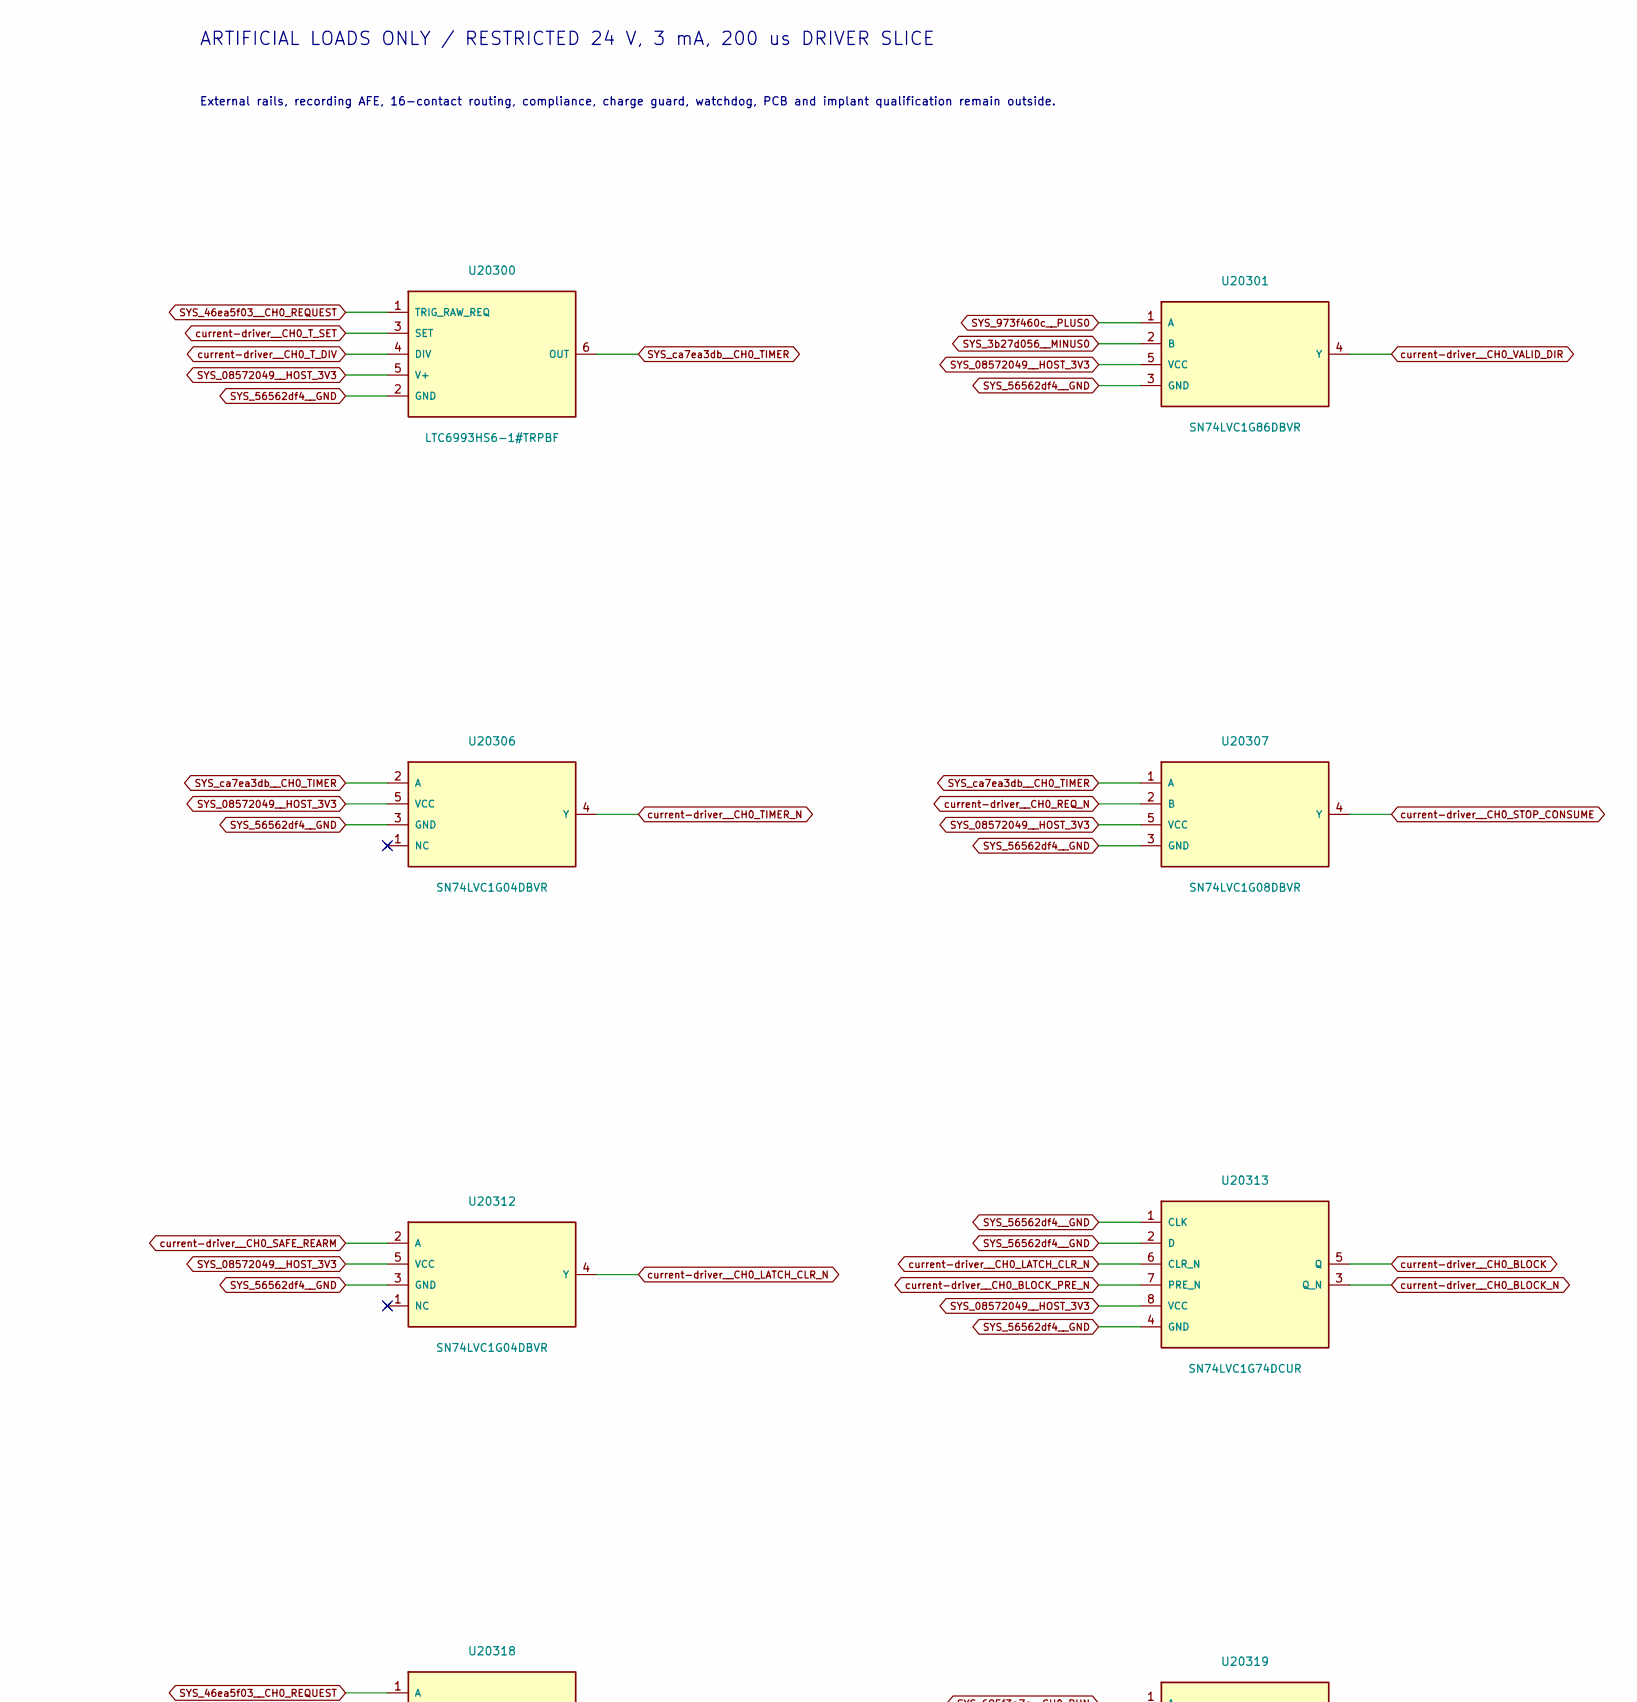
[picture p480: schematic permission0.kicad_sch, ATO S4 / Source 0: independent duration and sticky admission, part in row 1, column 1]

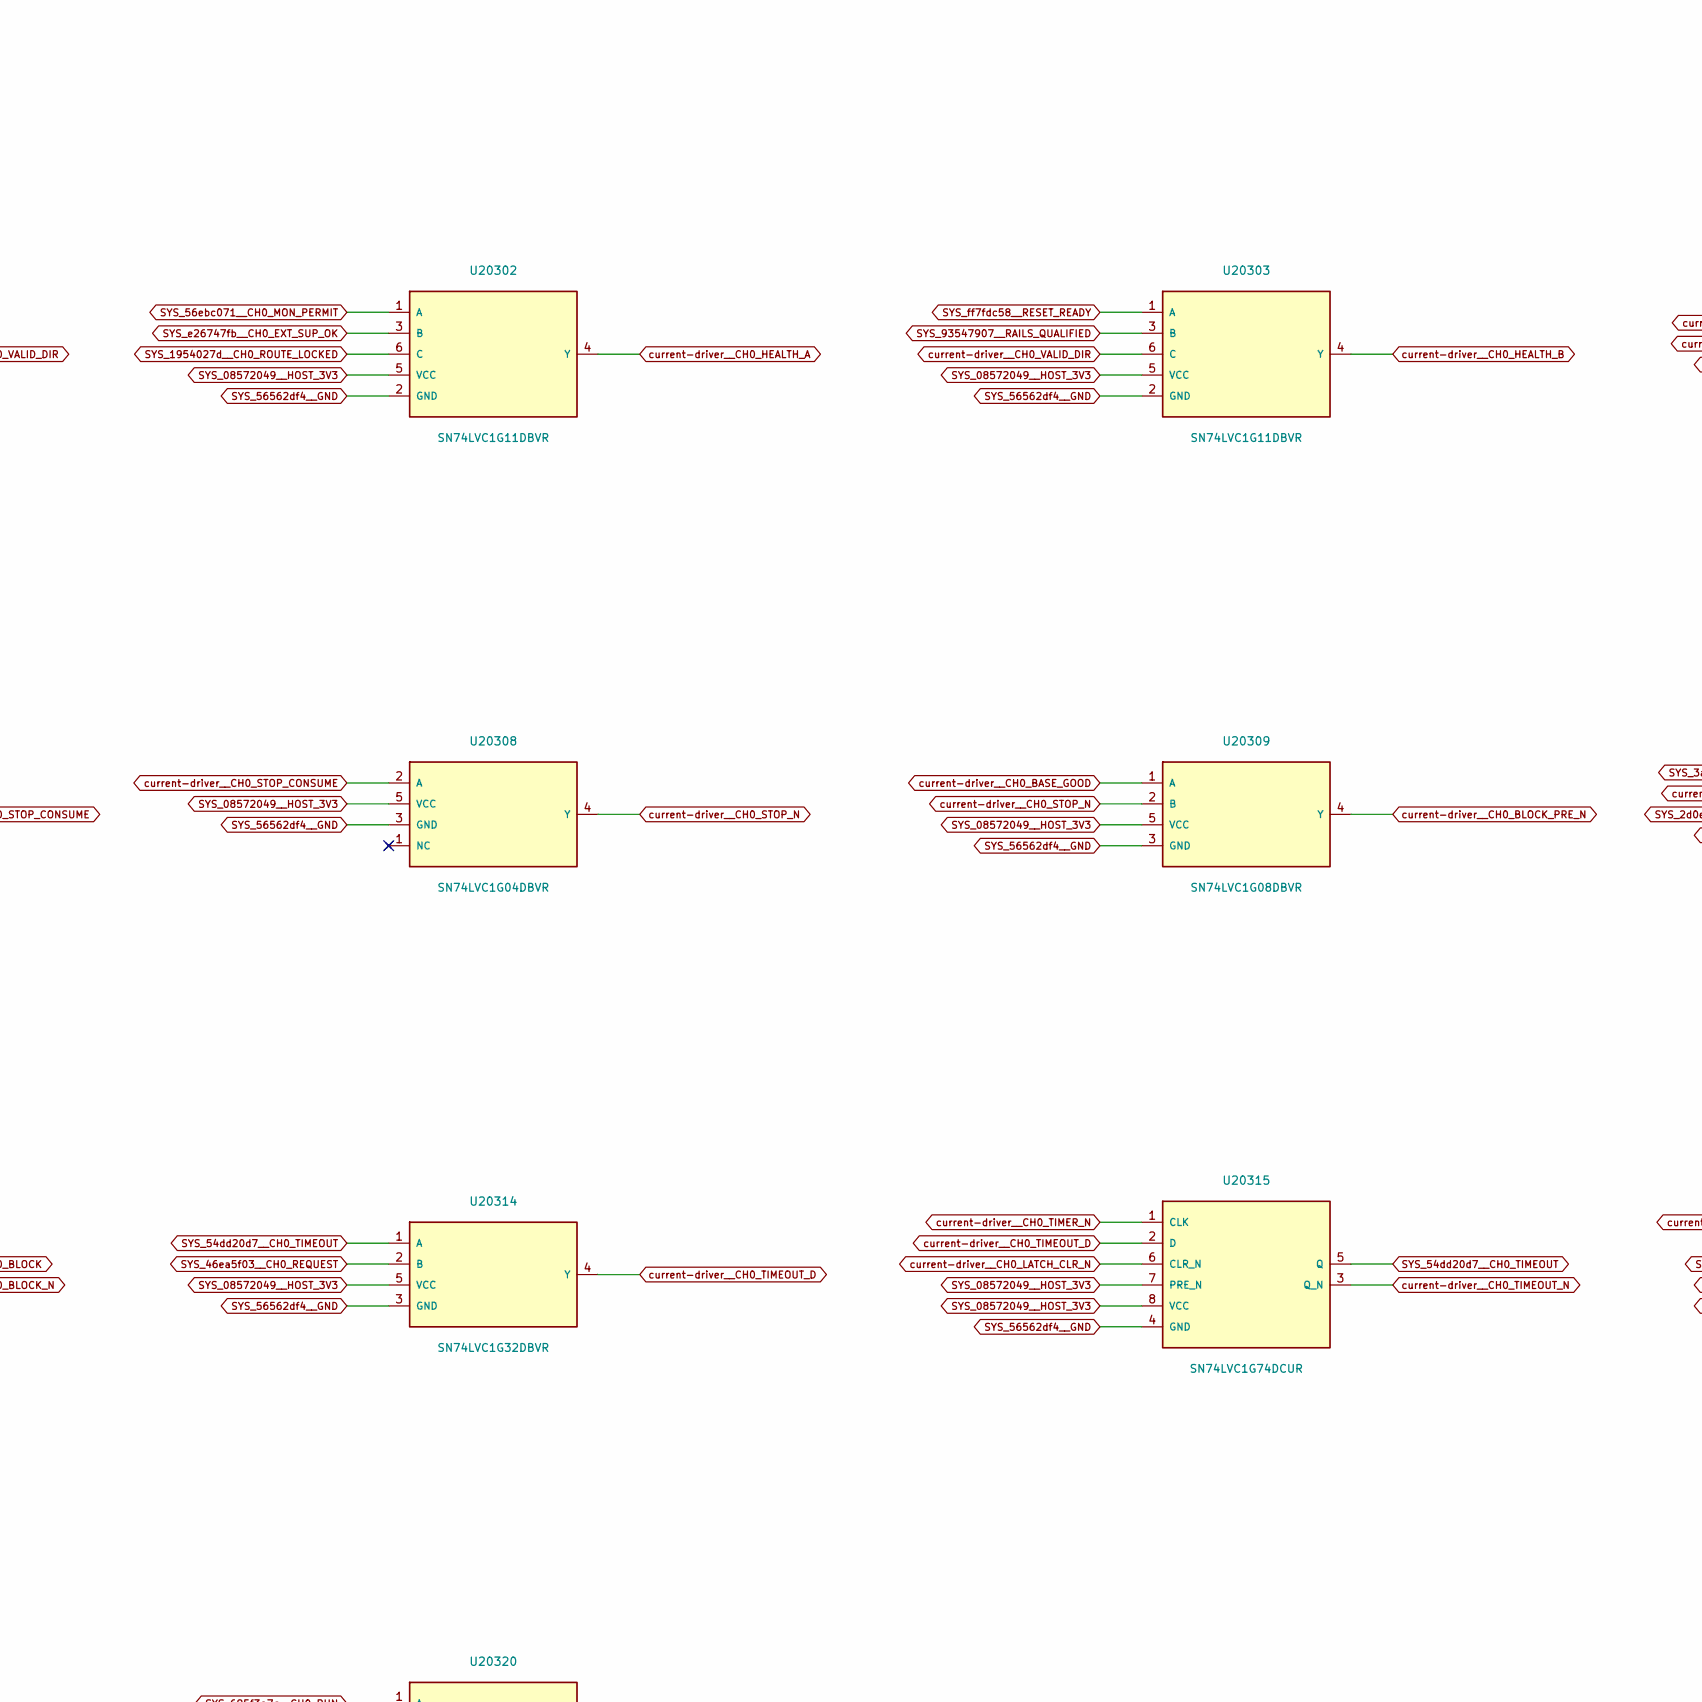
[picture p481: schematic permission0.kicad_sch, ATO S4 / Source 0: independent duration and sticky admission, part in row 1, column 2]

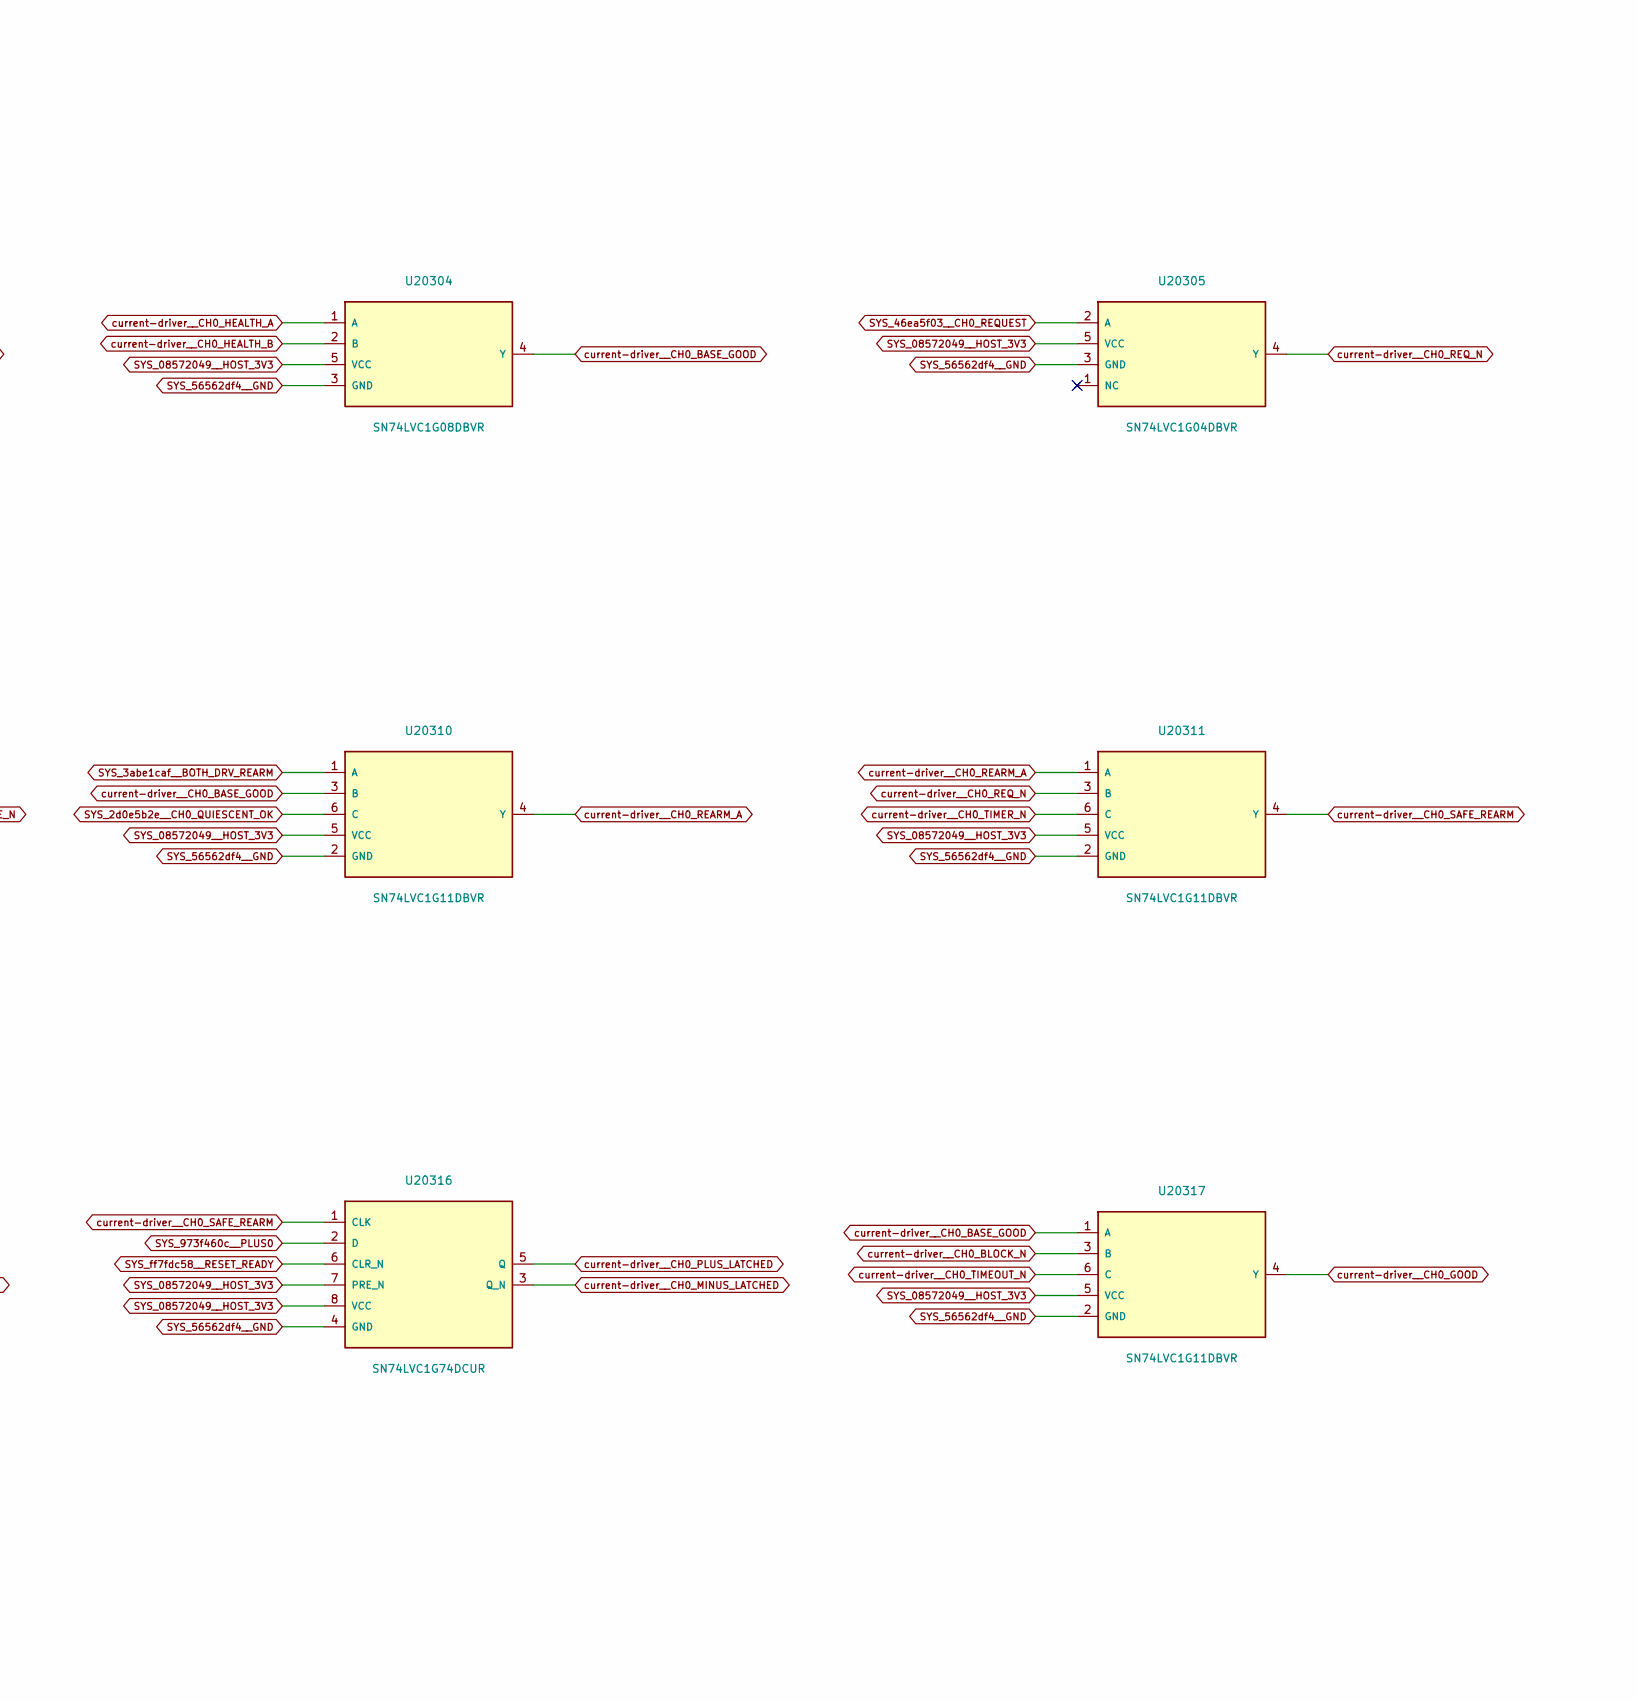
[picture p482: schematic permission0.kicad_sch, ATO S4 / Source 0: independent duration and sticky admission, part in row 1, column 3]

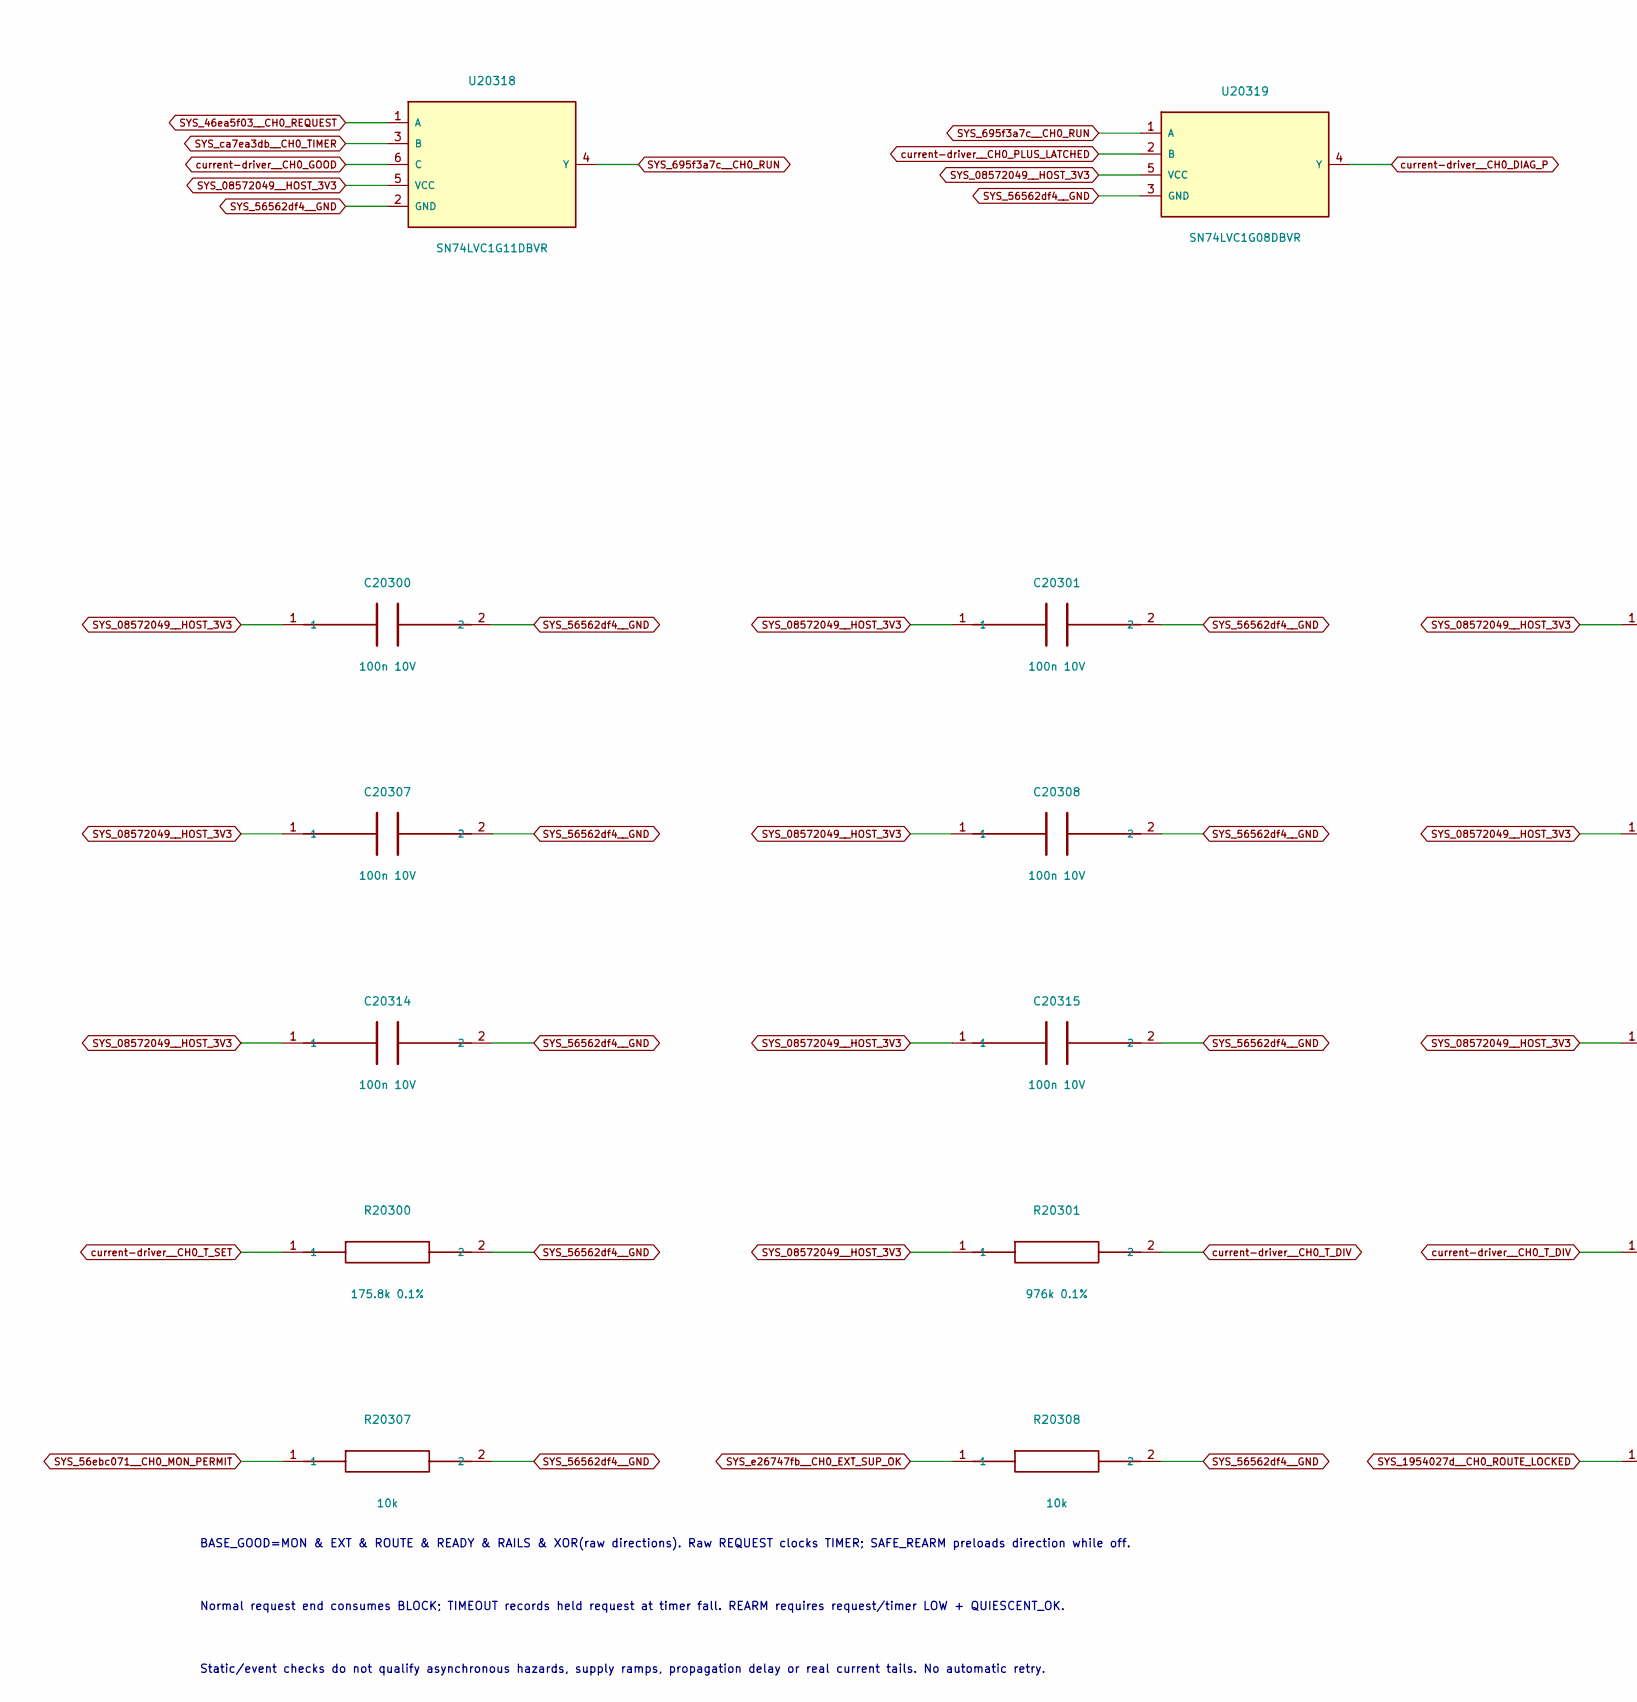
[picture p483: schematic permission0.kicad_sch, ATO S4 / Source 0: independent duration and sticky admission, part in row 2, column 1]

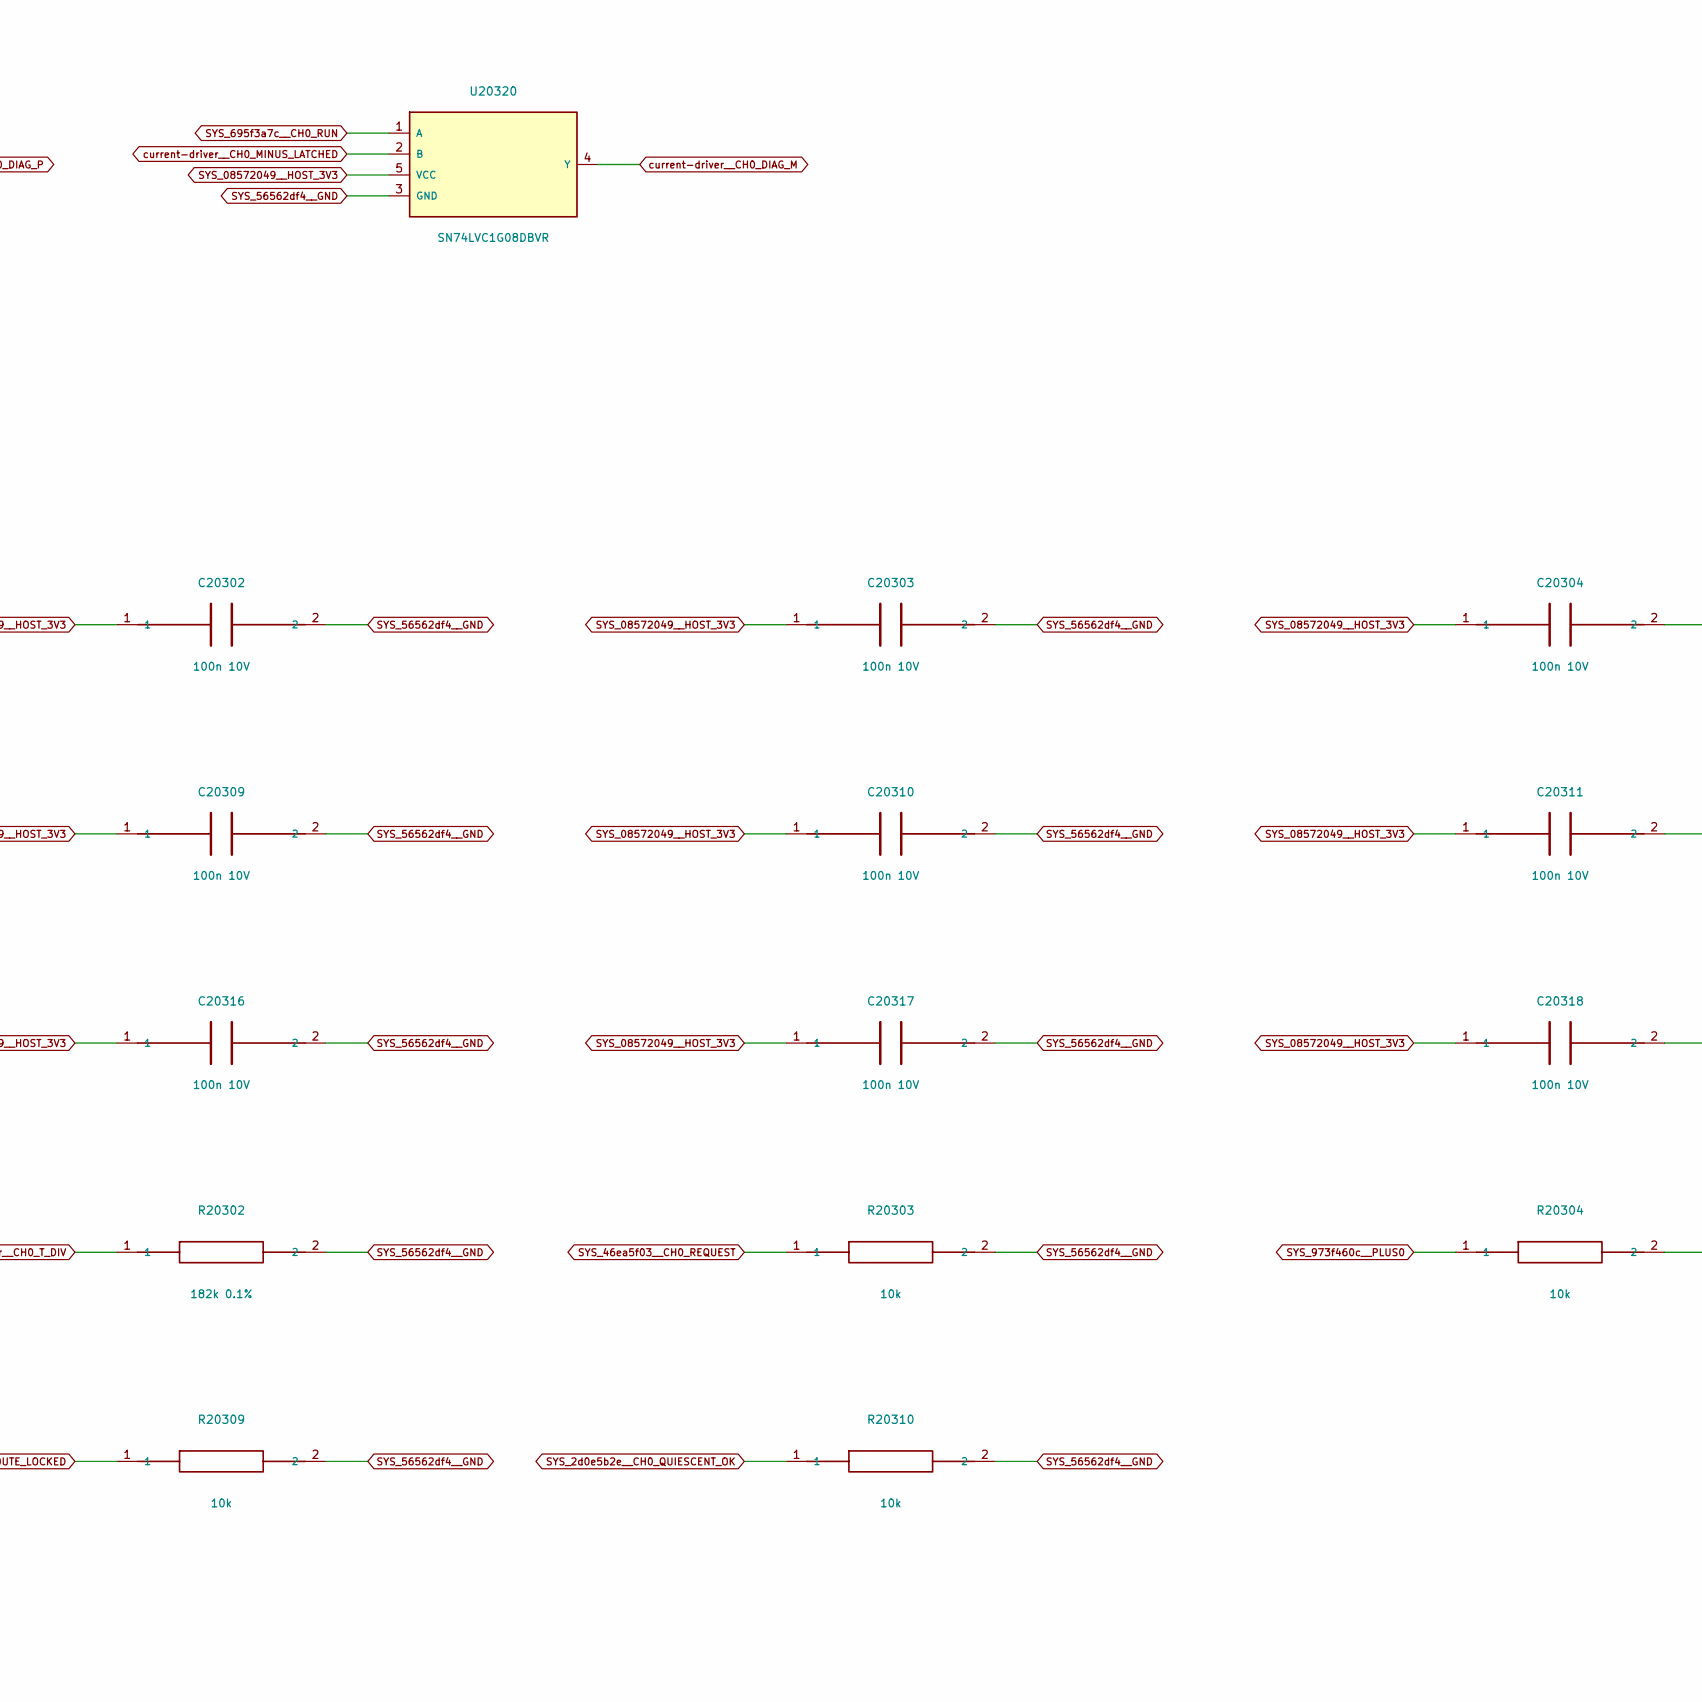
[picture p484: schematic permission0.kicad_sch, ATO S4 / Source 0: independent duration and sticky admission, part in row 2, column 2]

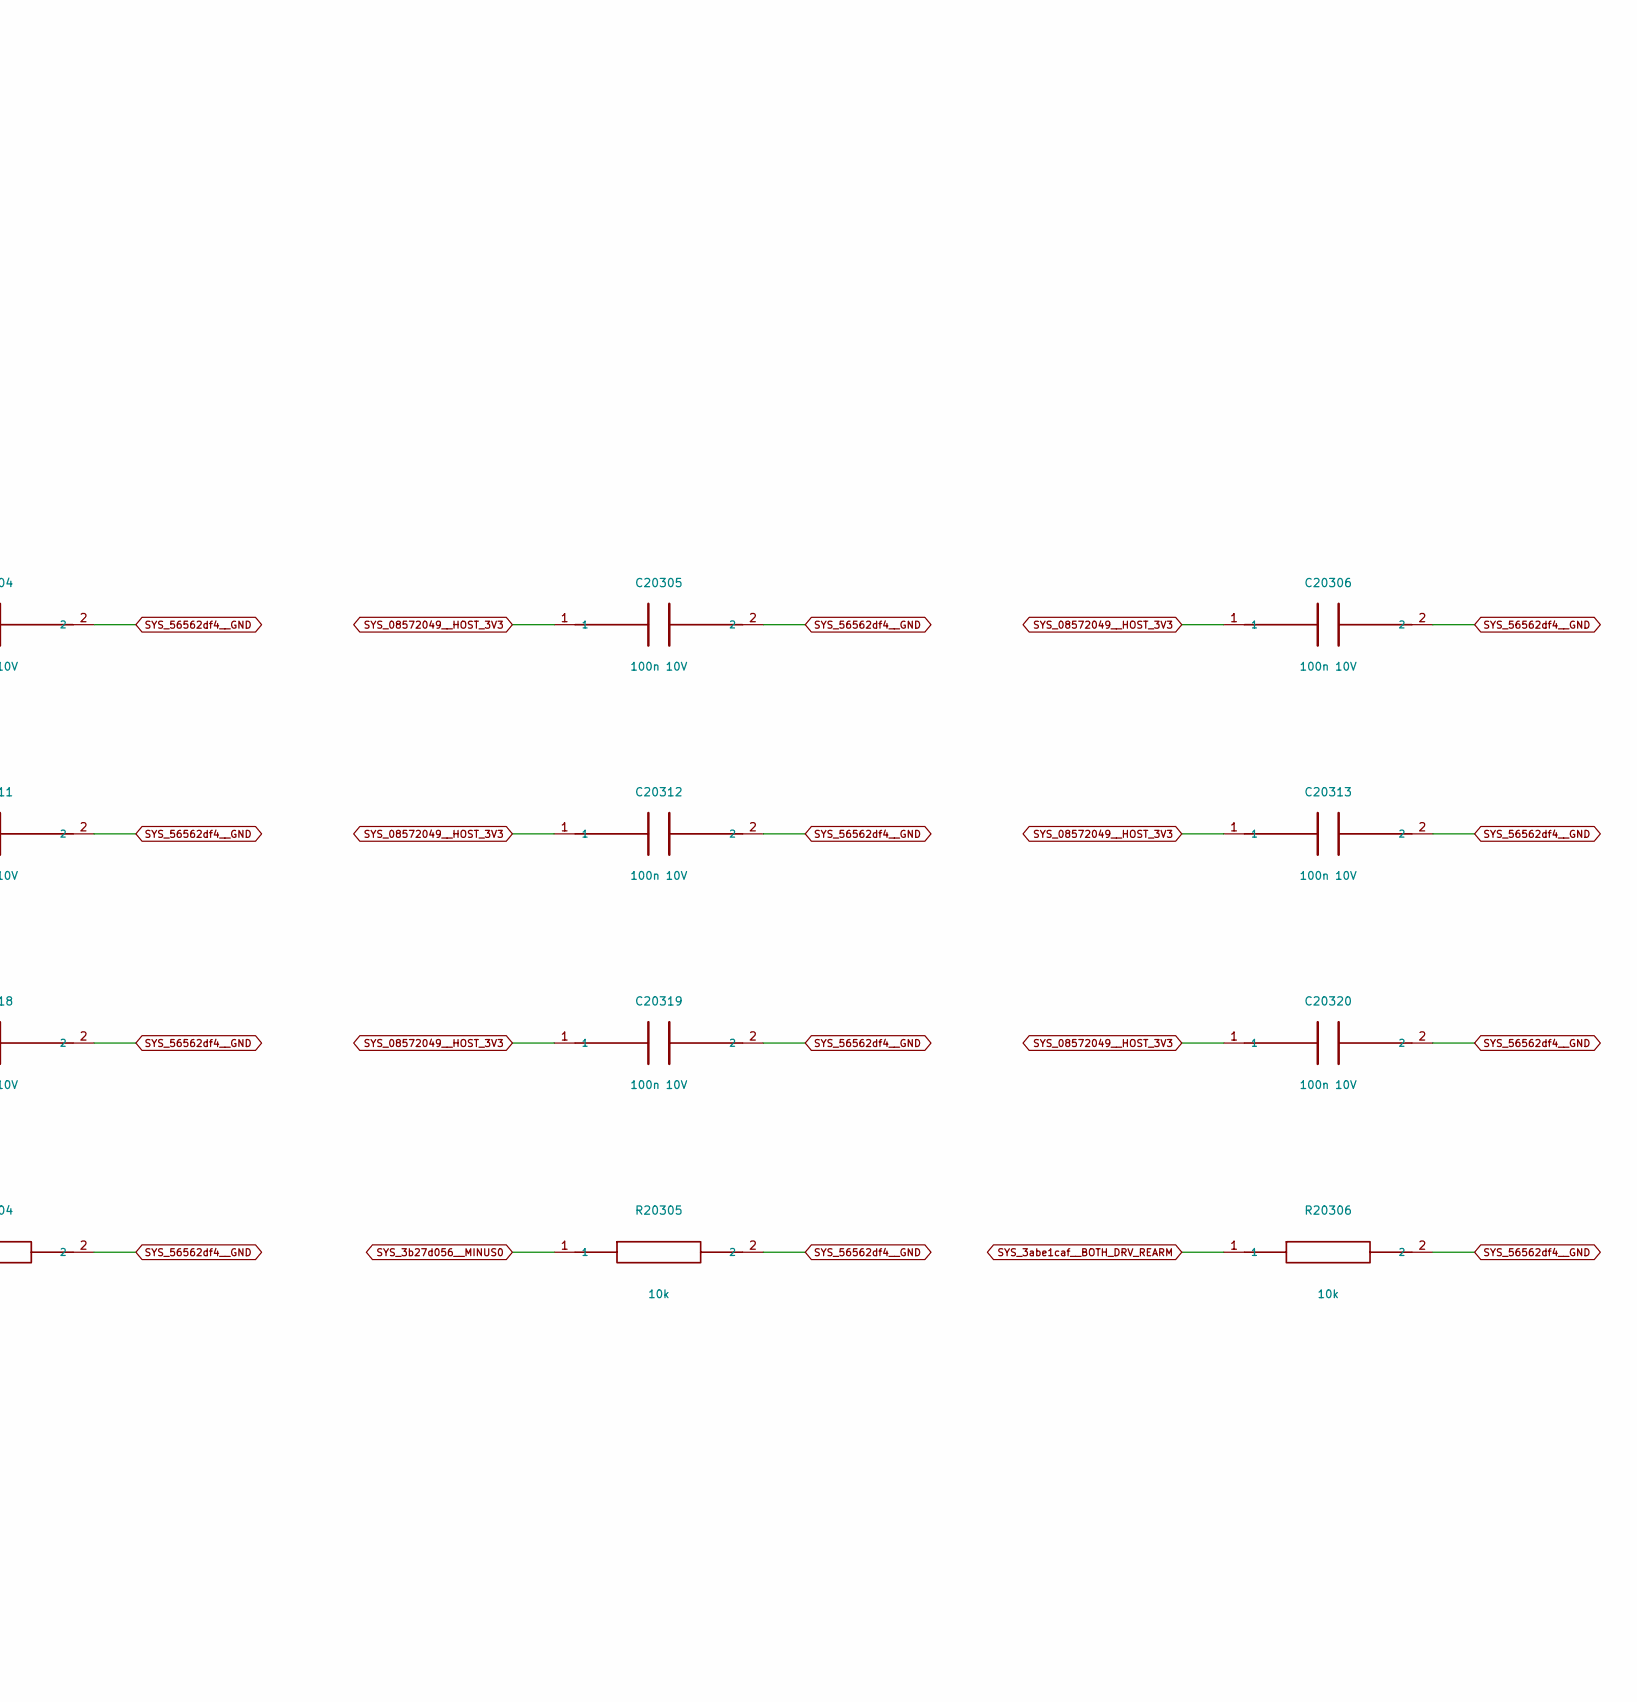
[picture p485: schematic permission0.kicad_sch, ATO S4 / Source 0: independent duration and sticky admission, part in row 2, column 3]

Parts:
C20300, C20301, C20302, C20303, C20304, C20305, C20306, C20307, C20308, C20309, C20310, C20311, C20312, C20313, C20314, C20315, C20316, C20317, C20318, C20319, C20320: 100n 10V; C_0805_2012Metric
R20300: 175.8k 0.1%; R_0805_2012Metric
R20301: 976k 0.1%; R_0805_2012Metric
R20302: 182k 0.1%; R_0805_2012Metric
R20303, R20304, R20305, R20306, R20307, R20308, R20309, R20310: 10k; R_0805_2012Metric
U20300: LTC6993HS6-1#TRPBF; TSOT-23-6
U20301: SN74LVC1G86DBVR; SOT-23-5
U20302, U20303, U20310, U20311, U20317, U20318: SN74LVC1G11DBVR; SOT-23-6
U20304, U20307, U20309, U20319, U20320: SN74LVC1G08DBVR; SOT-23-5
U20305, U20306, U20308, U20312: SN74LVC1G04DBVR; SOT-23-5
U20313, U20315, U20316: SN74LVC1G74DCUR; VSSOP-8_2.3x2mm_P0.5mm
U20314: SN74LVC1G32DBVR; SOT-23-5

Connections:
SYS_2d0e5b2e__CH0_QUIESCENT_OK: R20310.1, U20310.6 (C); also elsewhere on the board
SYS_3abe1caf__BOTH_DRV_REARM: R20306.1, U20310.1 (A); also elsewhere on the board
SYS_3b27d056__MINUS0: R20305.1, U20301.2 (B); also elsewhere on the board
SYS_46ea5f03__CH0_REQUEST: R20303.1, U20300.1 (TRIG_RAW_REQ), U20305.2 (A), U20314.2 (B), U20318.1 (A); also elsewhere on the board
SYS_54dd20d7__CH0_TIMEOUT: U20314.1 (A), U20315.5 (Q); also elsewhere on the board
SYS_56ebc071__CH0_MON_PERMIT: R20307.1, U20302.1 (A); also elsewhere on the board
SYS_695f3a7c__CH0_RUN: U20318.4 (Y), U20319.1 (A), U20320.1 (A); also elsewhere on the board
SYS_973f460c__PLUS0: R20304.1, U20301.1 (A), U20316.2 (D); also elsewhere on the board
SYS_56562df4__GND: C20300.2, C20301.2, C20302.2, C20303.2, C20304.2, C20305.2, C20306.2, C20307.2, C20308.2, C20309.2, C20310.2, C20311.2, C20312.2, C20313.2, C20314.2, C20315.2, C20316.2, C20317.2, C20318.2, C20319.2, C20320.2, R20300.2, R20302.2, R20303.2, R20304.2, R20305.2, R20306.2, R20307.2, R20308.2, R20309.2, R20310.2, U20300.2 (GND), U20301.3 (GND), U20302.2 (GND), U20303.2 (GND), U20304.3 (GND), U20305.3 (GND), U20306.3 (GND), U20307.3 (GND), U20308.3 (GND), U20309.3 (GND), U20310.2 (GND), U20311.2 (GND), U20312.3 (GND), U20313.1 (CLK), U20313.2 (D), U20313.4 (GND), U20314.3 (GND), U20315.4 (GND), U20316.4 (GND), U20317.2 (GND), U20318.2 (GND), U20319.3 (GND), U20320.3 (GND); also elsewhere on the board
SYS_1954027d__CH0_ROUTE_LOCKED: R20309.1, U20302.6 (C); also elsewhere on the board
SYS_08572049__HOST_3V3: C20300.1, C20301.1, C20302.1, C20303.1, C20304.1, C20305.1, C20306.1, C20307.1, C20308.1, C20309.1, C20310.1, C20311.1, C20312.1, C20313.1, C20314.1, C20315.1, C20316.1, C20317.1, C20318.1, C20319.1, C20320.1, R20301.1, U20300.5 (V+), U20301.5 (VCC), U20302.5 (VCC), U20303.5 (VCC), U20304.5 (VCC), U20305.5 (VCC), U20306.5 (VCC), U20307.5 (VCC), U20308.5 (VCC), U20309.5 (VCC), U20310.5 (VCC), U20311.5 (VCC), U20312.5 (VCC), U20313.8 (VCC), U20314.5 (VCC), U20315.7 (PRE_N), U20315.8 (VCC), U20316.7 (PRE_N), U20316.8 (VCC), U20317.5 (VCC), U20318.5 (VCC), U20319.5 (VCC), U20320.5 (VCC); also elsewhere on the board
SYS_93547907__RAILS_QUALIFIED: U20303.3 (B); also elsewhere on the board
SYS_ca7ea3db__CH0_TIMER: U20300.6 (OUT), U20306.2 (A), U20307.1 (A), U20318.3 (B); also elsewhere on the board
SYS_e26747fb__CH0_EXT_SUP_OK: R20308.1, U20302.3 (B); also elsewhere on the board
SYS_ff7fdc58__RESET_READY: U20303.1 (A), U20316.6 (CLR_N); also elsewhere on the board
current-driver__CH0_BASE_GOOD: U20304.4 (Y), U20309.1 (A), U20310.3 (B), U20317.1 (A)
current-driver__CH0_BLOCK: U20313.5 (Q); also elsewhere on the board
current-driver__CH0_BLOCK_N: U20313.3 (Q_N), U20317.3 (B)
current-driver__CH0_BLOCK_PRE_N: U20309.4 (Y), U20313.7 (PRE_N)
current-driver__CH0_DIAG_M: U20320.4 (Y); also elsewhere on the board
current-driver__CH0_DIAG_P: U20319.4 (Y); also elsewhere on the board
current-driver__CH0_GOOD: U20317.4 (Y), U20318.6 (C)
current-driver__CH0_HEALTH_A: U20302.4 (Y), U20304.1 (A)
current-driver__CH0_HEALTH_B: U20303.4 (Y), U20304.2 (B)
current-driver__CH0_LATCH_CLR_N: U20312.4 (Y), U20313.6 (CLR_N), U20315.6 (CLR_N)
current-driver__CH0_MINUS_LATCHED: U20316.3 (Q_N), U20320.2 (B)
current-driver__CH0_PLUS_LATCHED: U20316.5 (Q), U20319.2 (B)
current-driver__CH0_REARM_A: U20310.4 (Y), U20311.1 (A)
current-driver__CH0_REQ_N: U20305.4 (Y), U20307.2 (B), U20311.3 (B)
current-driver__CH0_SAFE_REARM: U20311.4 (Y), U20312.2 (A), U20316.1 (CLK)
current-driver__CH0_STOP_CONSUME: U20307.4 (Y), U20308.2 (A)
current-driver__CH0_STOP_N: U20308.4 (Y), U20309.2 (B)
current-driver__CH0_TIMEOUT_D: U20314.4 (Y), U20315.2 (D)
current-driver__CH0_TIMEOUT_N: U20315.3 (Q_N), U20317.6 (C)
current-driver__CH0_TIMER_N: U20306.4 (Y), U20311.6 (C), U20315.1 (CLK)
current-driver__CH0_T_DIV: R20301.2, R20302.1, U20300.4 (DIV)
current-driver__CH0_T_SET: R20300.1, U20300.3 (SET)
current-driver__CH0_VALID_DIR: U20301.4 (Y), U20303.6 (C)

Notes on the sheet:
ARTIFICIAL LOADS ONLY / RESTRICTED 24 V, 3 mA, 200 us DRIVER SLICE
External rails, recording AFE, 16-contact routing, compliance, charge guard, watchdog, PCB and implant qualification remain outside.
BASE_GOOD=MON & EXT & ROUTE & READY & RAILS & XOR(raw directions). Raw REQUEST clocks TIMER; SAFE_REARM preloads direction while off.
Normal request end consumes BLOCK; TIMEOUT records held request at timer fall. REARM requires request/timer LOW + QUIESCENT_OK.
Static/event checks do not qualify asynchronous hazards, supply ramps, propagation delay or real current tails. No automatic retry.
