pratham-cloud-ctrl/Project-ATO/electronics/stage4/integrated-pcb/boards/current-driver/current_driver.kicad_pcb

## KiCad design electronics/stage4/integrated-pcb/boards/current-driver/current_driver.kicad_pcb (continued)

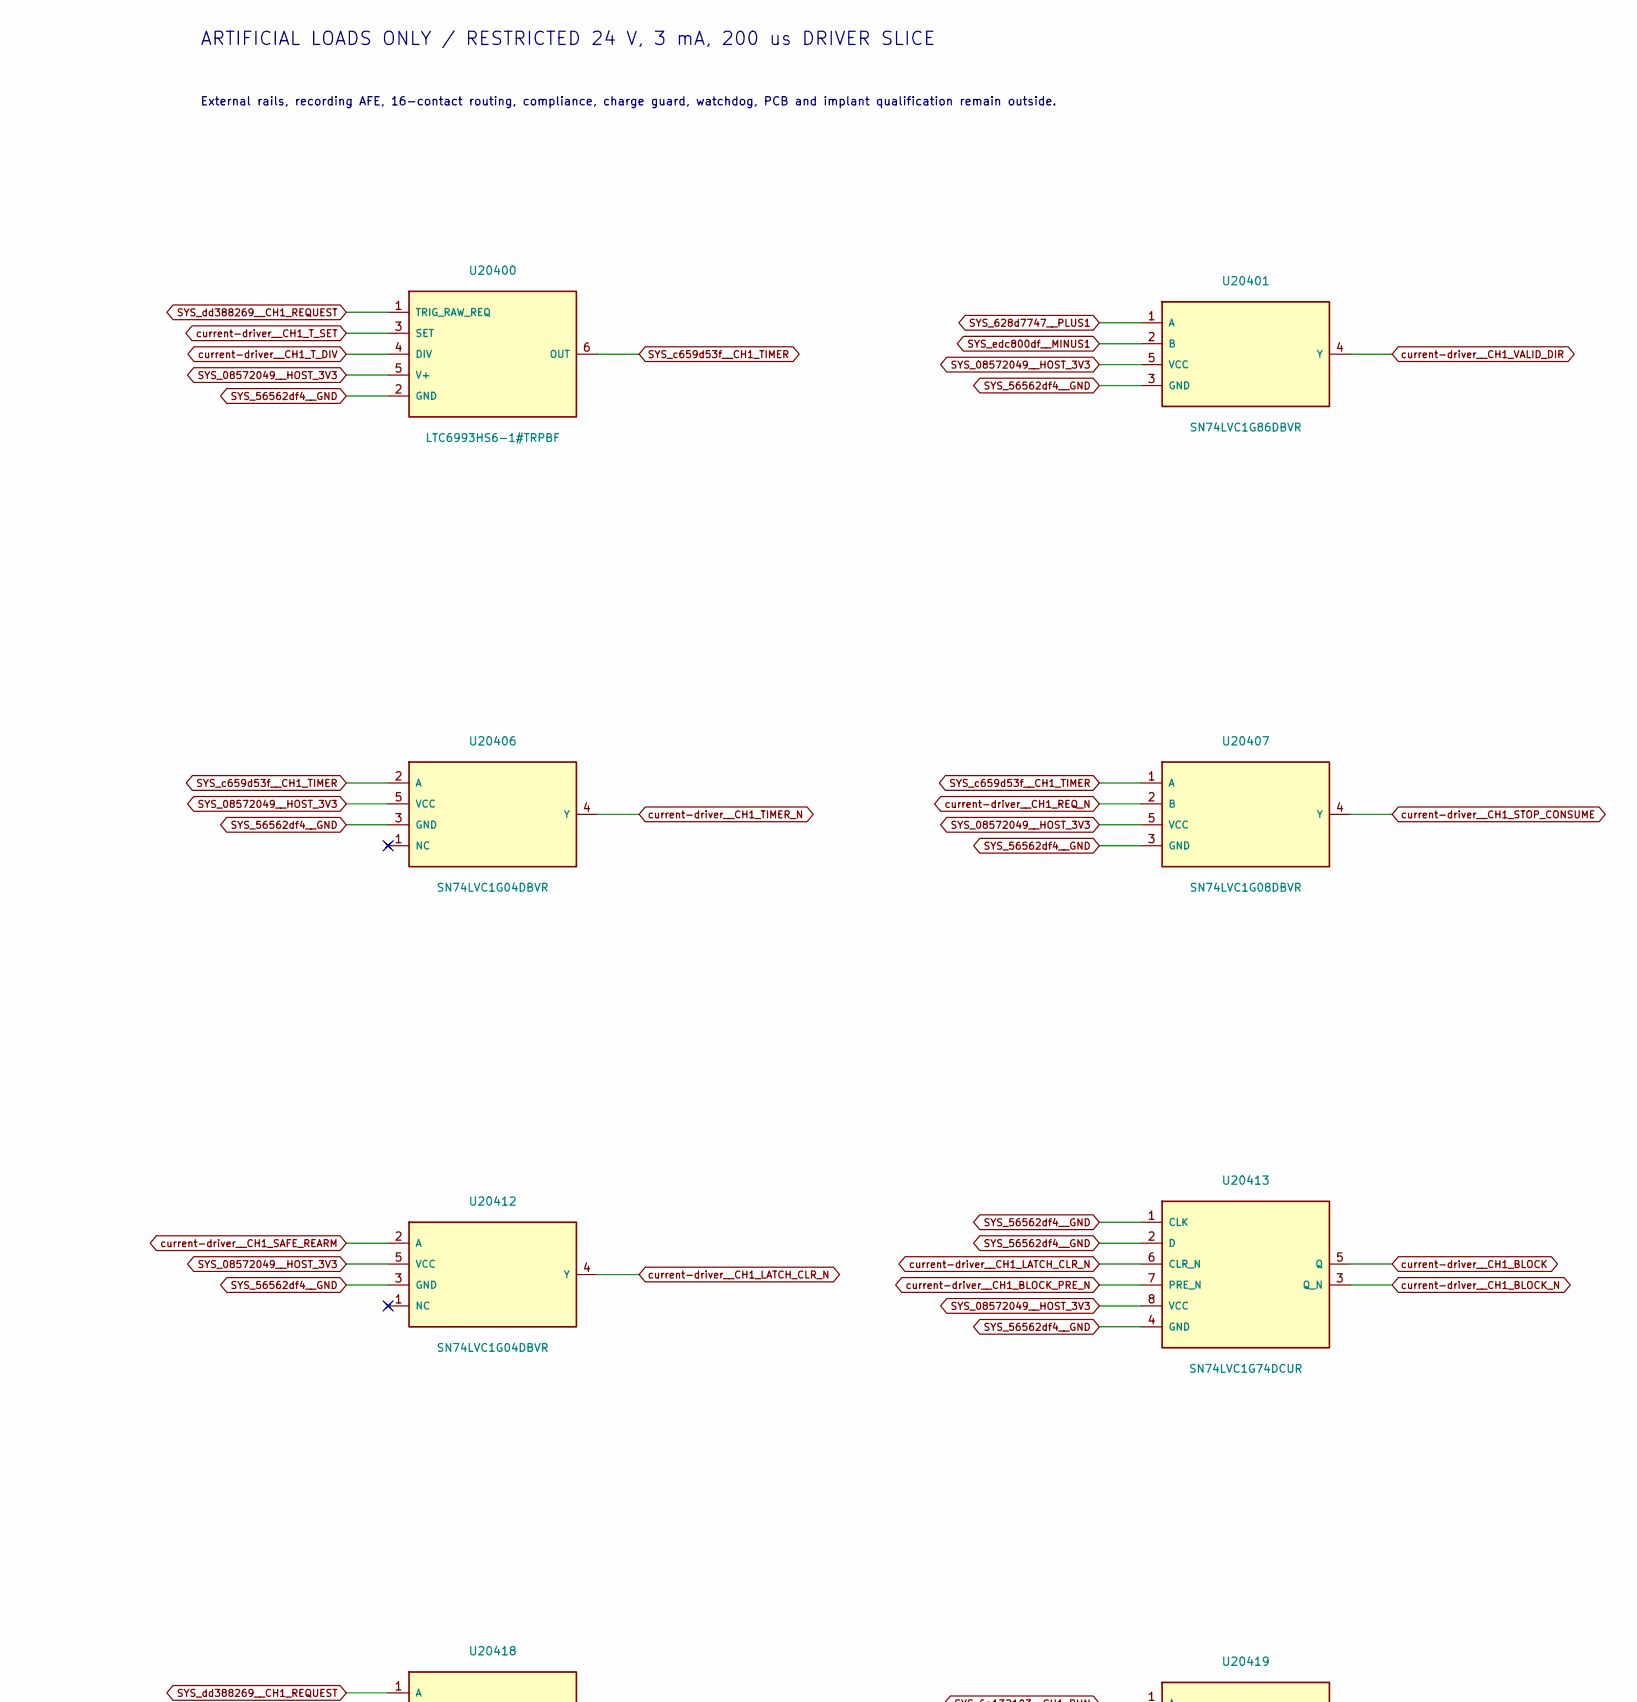
[picture p490: schematic permission1.kicad_sch, ATO S4 / Source 1: independent duration and sticky admission, part in row 1, column 1]

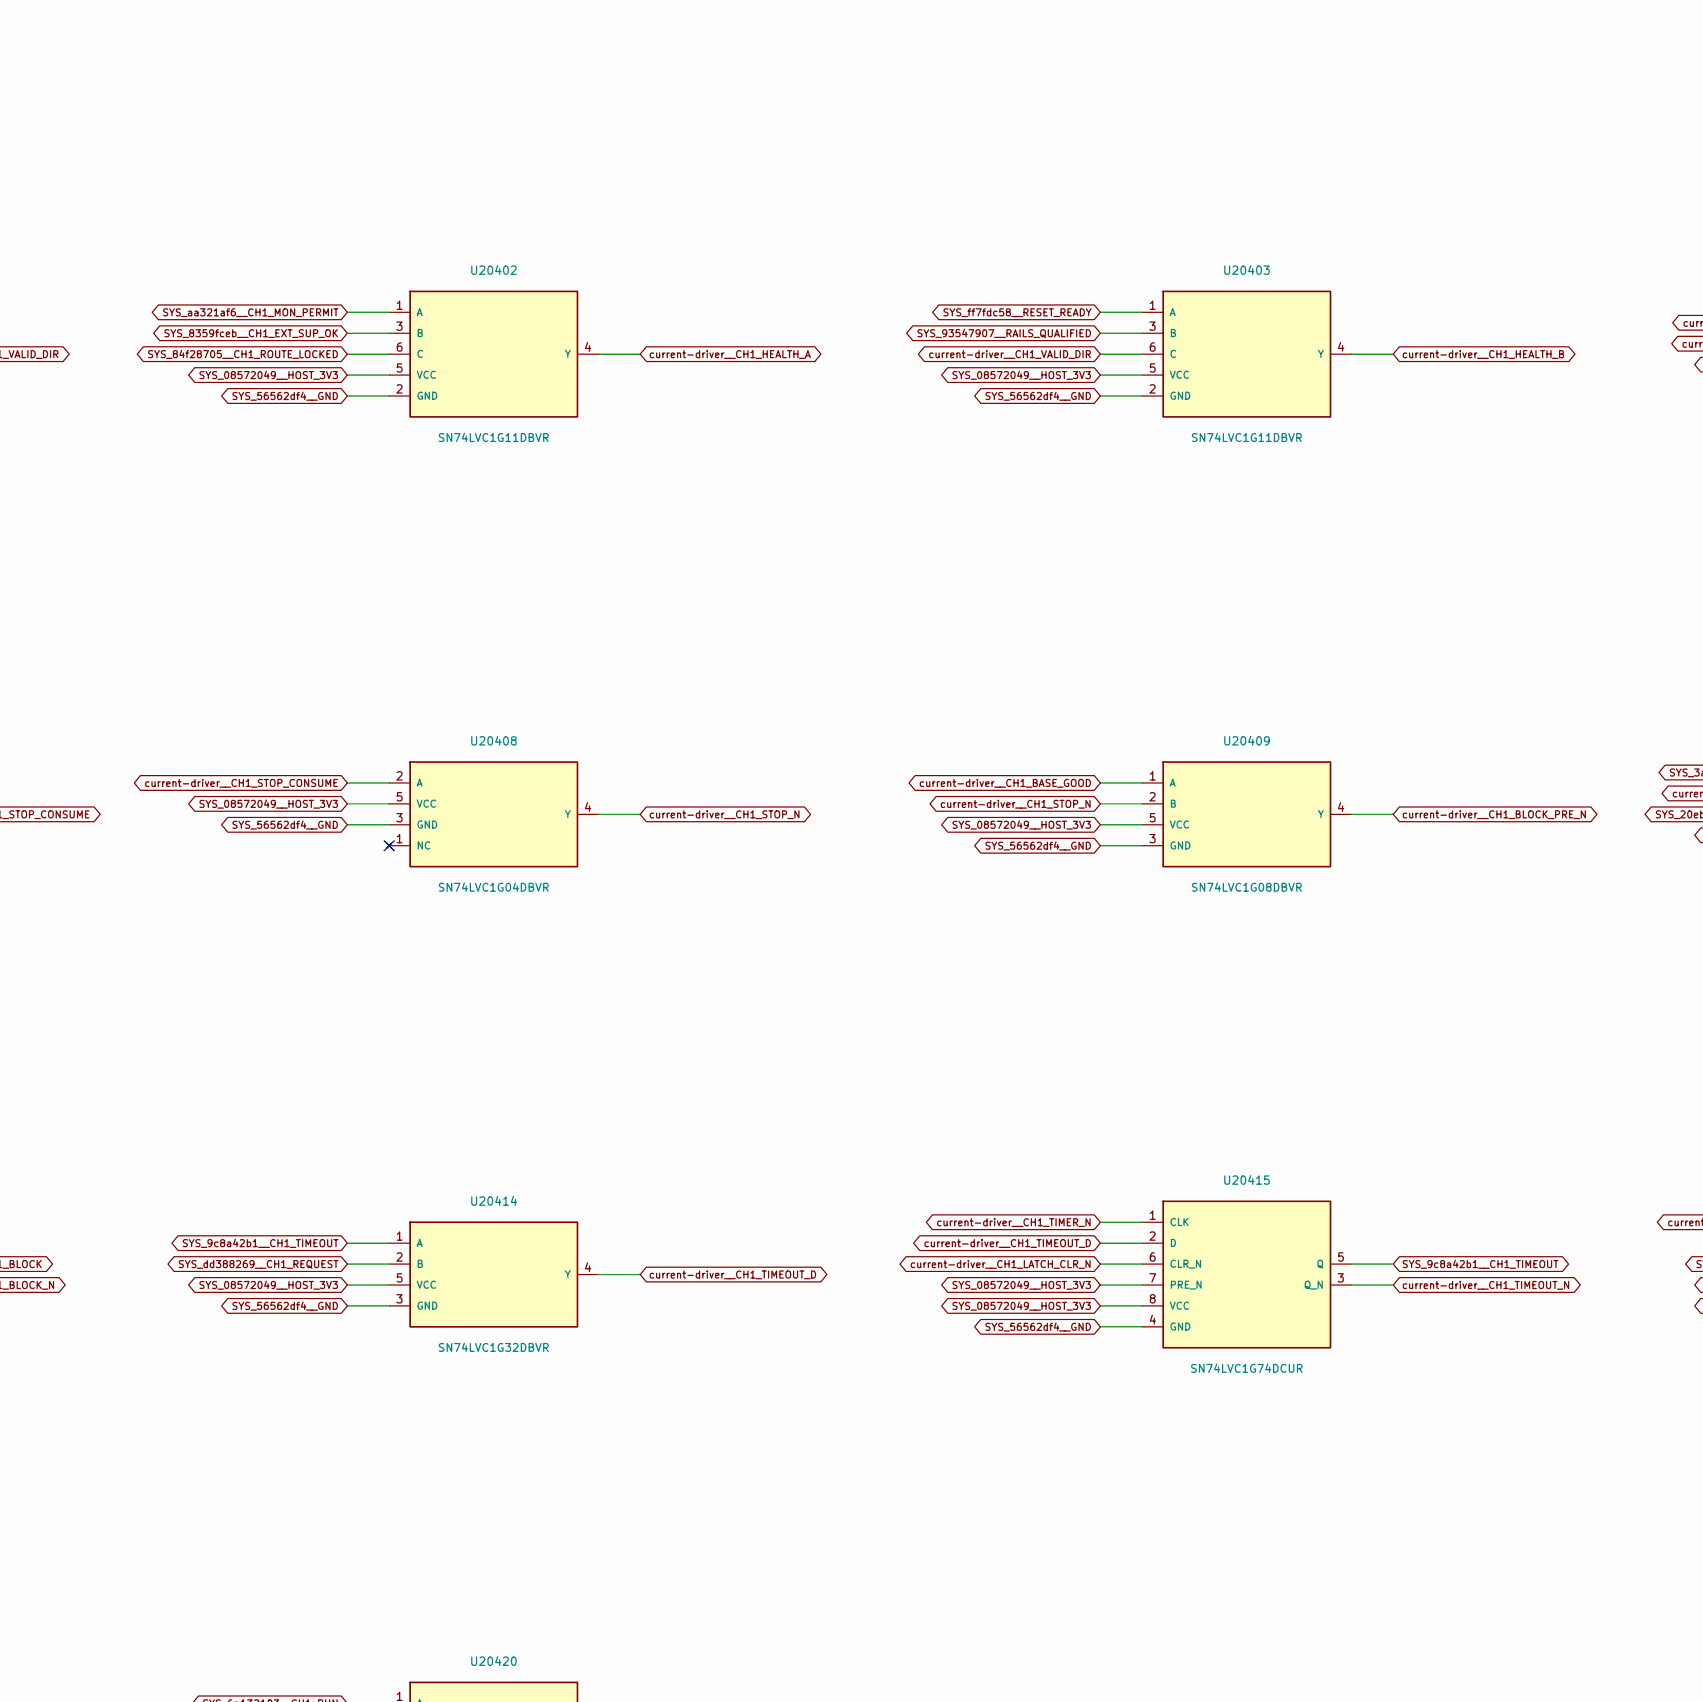
[picture p491: schematic permission1.kicad_sch, ATO S4 / Source 1: independent duration and sticky admission, part in row 1, column 2]

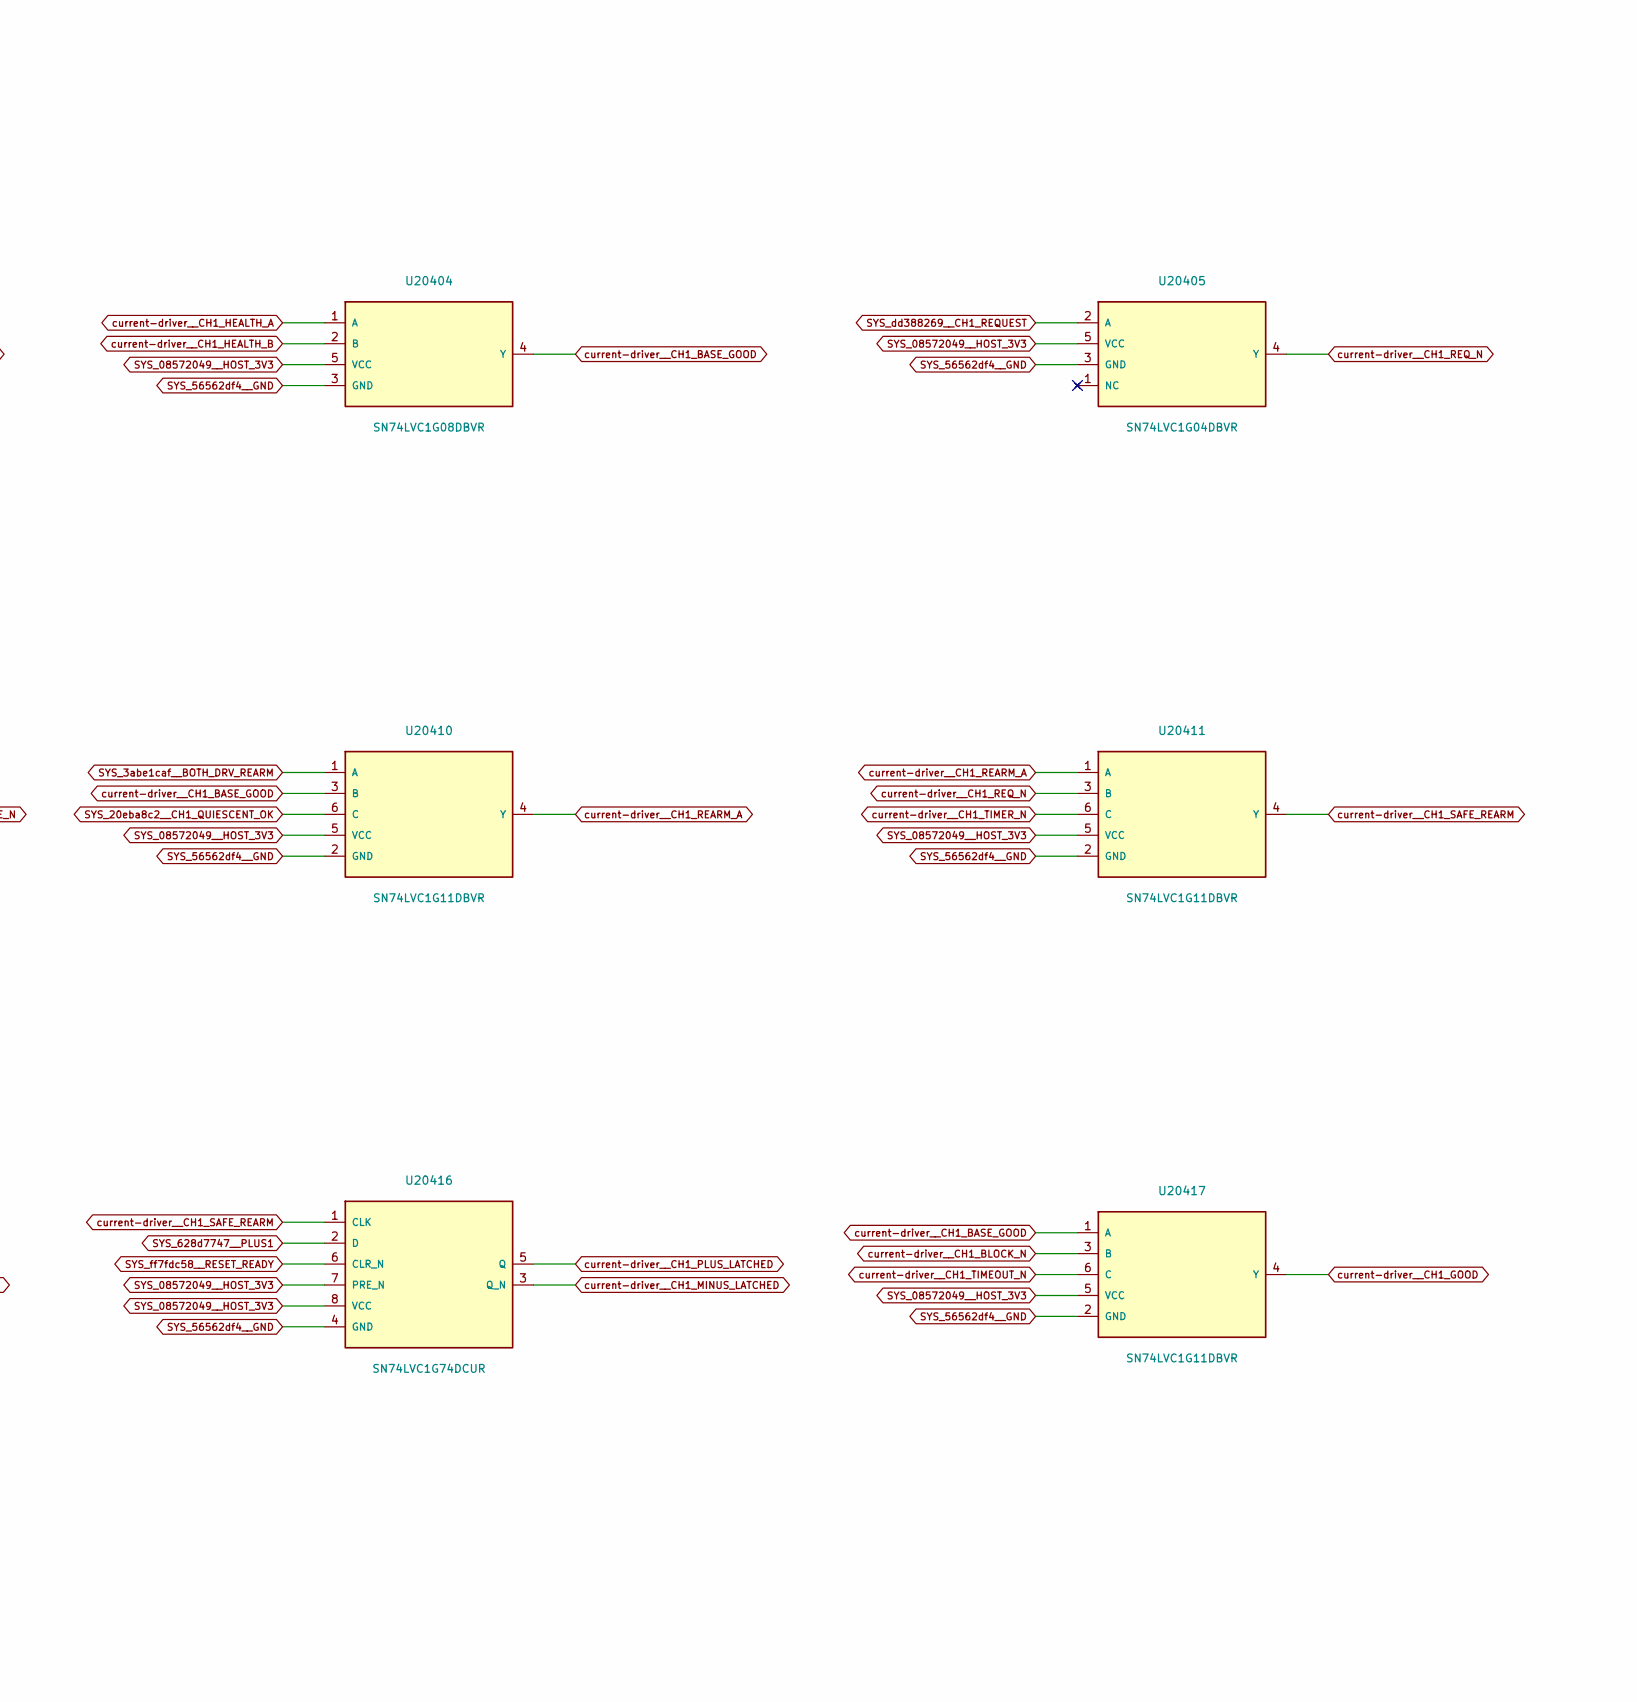
[picture p492: schematic permission1.kicad_sch, ATO S4 / Source 1: independent duration and sticky admission, part in row 1, column 3]

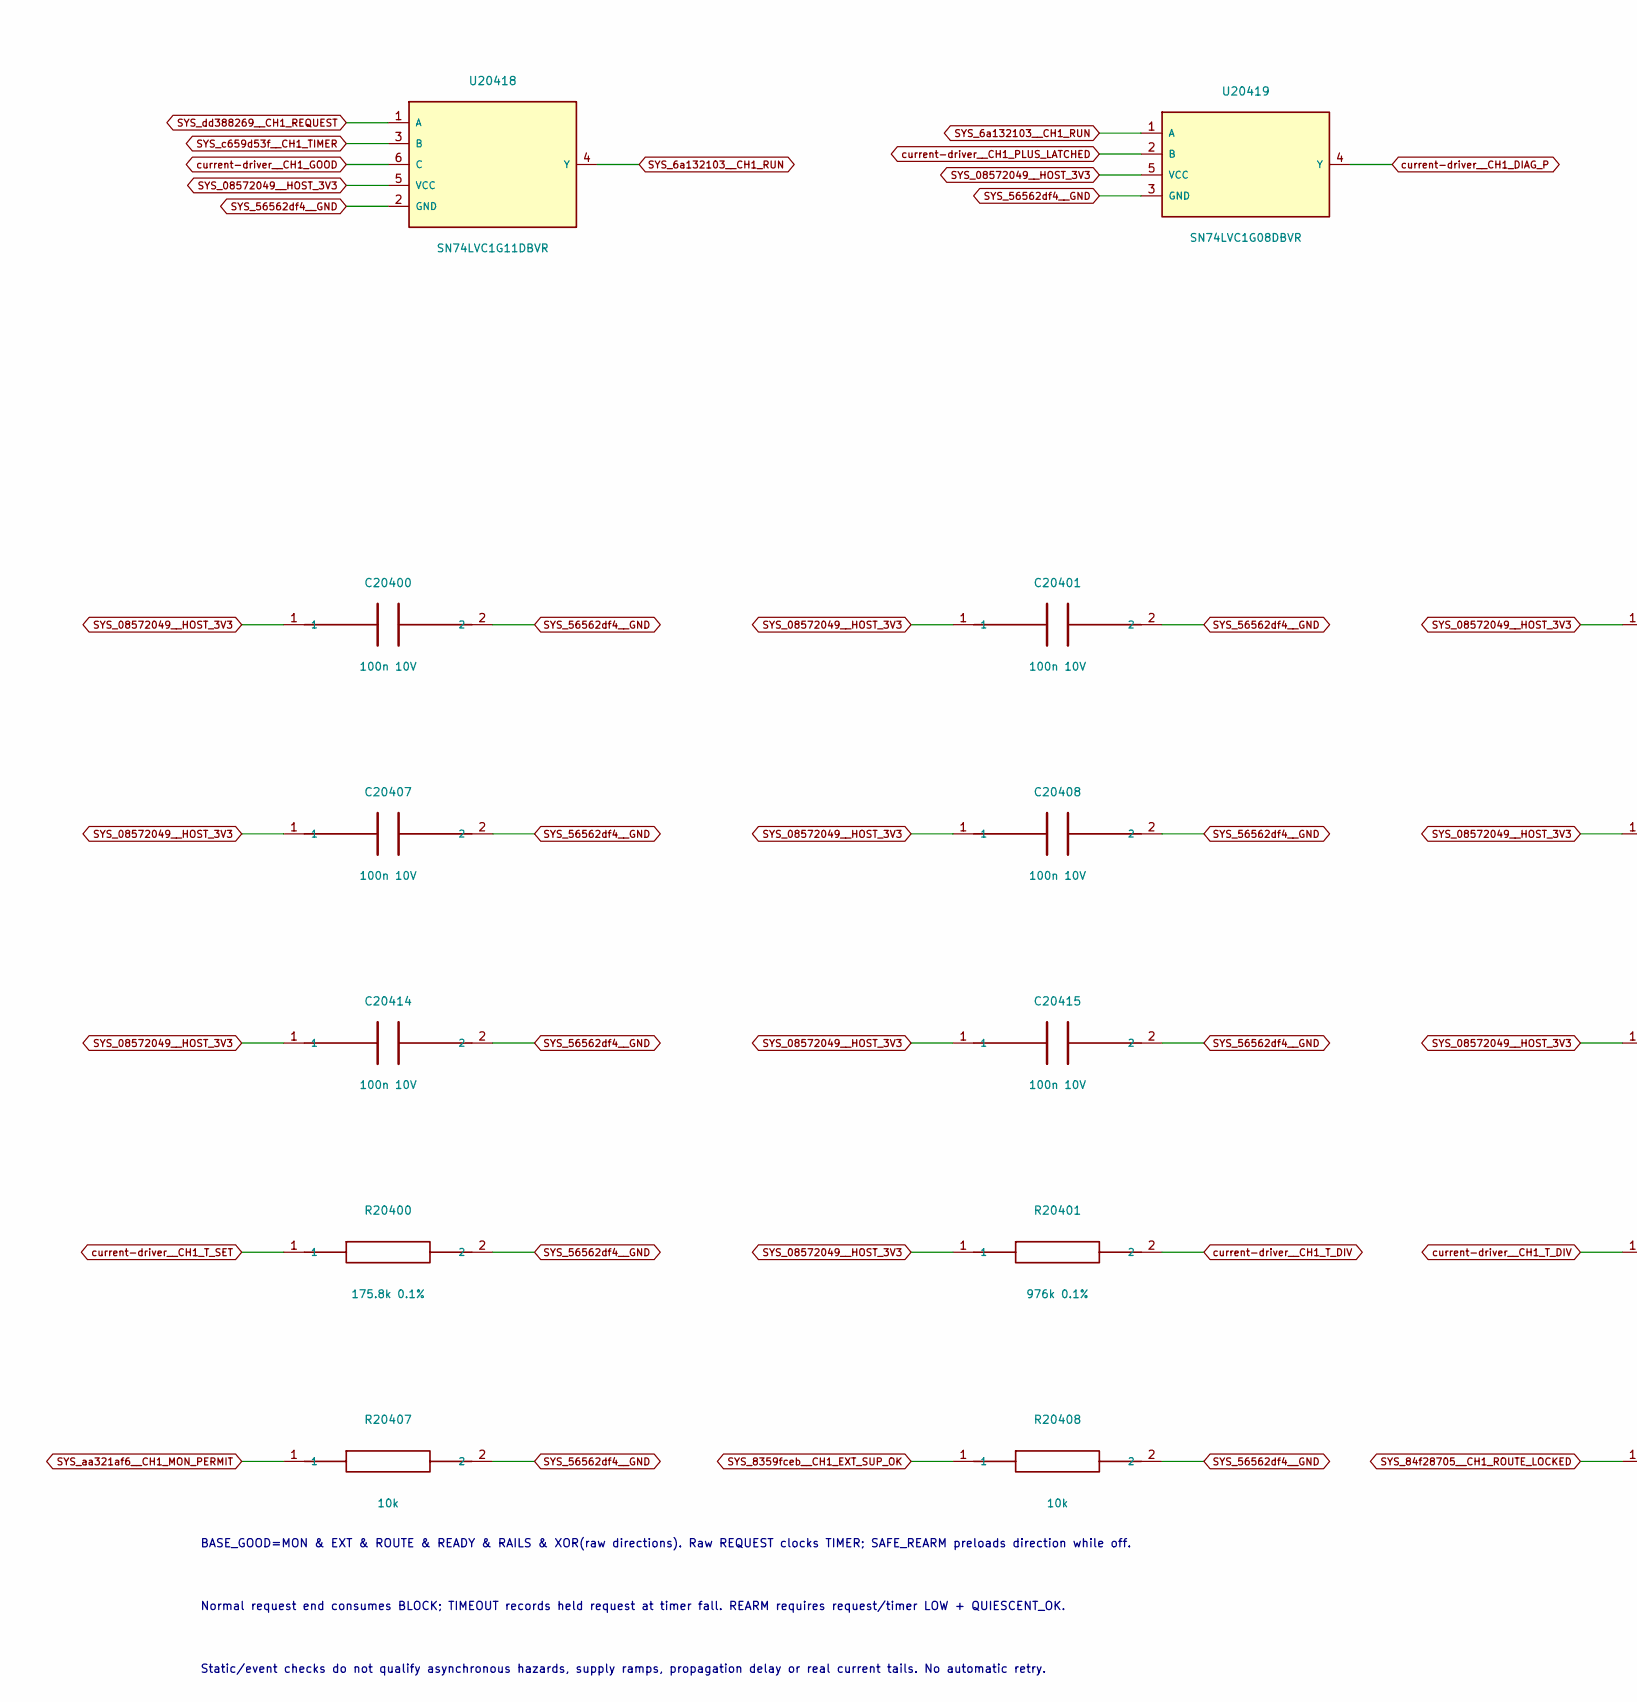
[picture p493: schematic permission1.kicad_sch, ATO S4 / Source 1: independent duration and sticky admission, part in row 2, column 1]

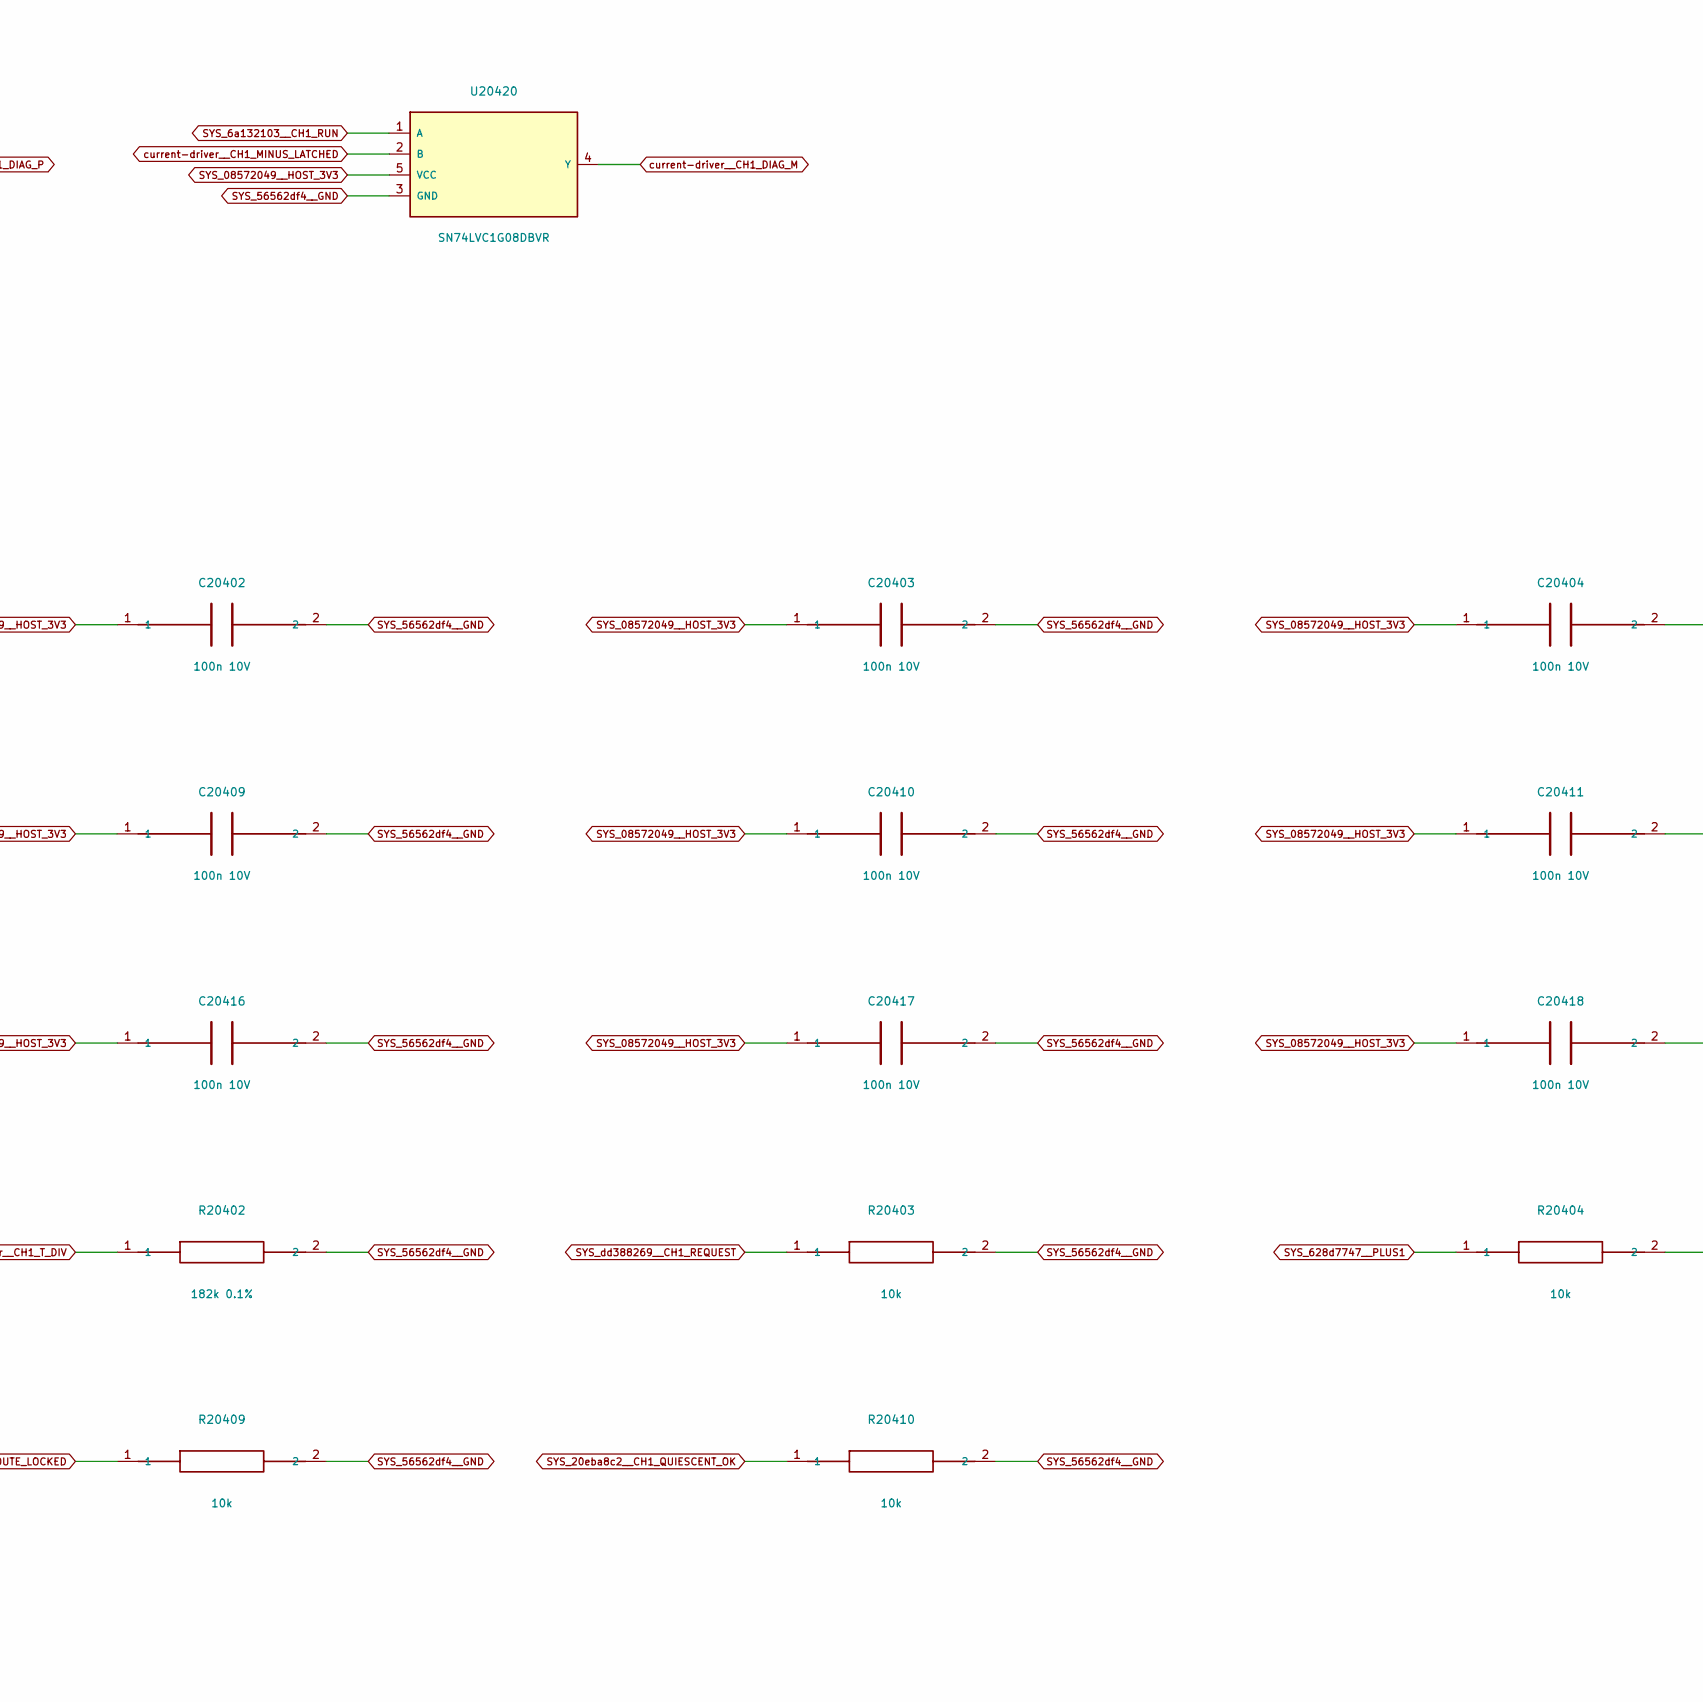
[picture p494: schematic permission1.kicad_sch, ATO S4 / Source 1: independent duration and sticky admission, part in row 2, column 2]

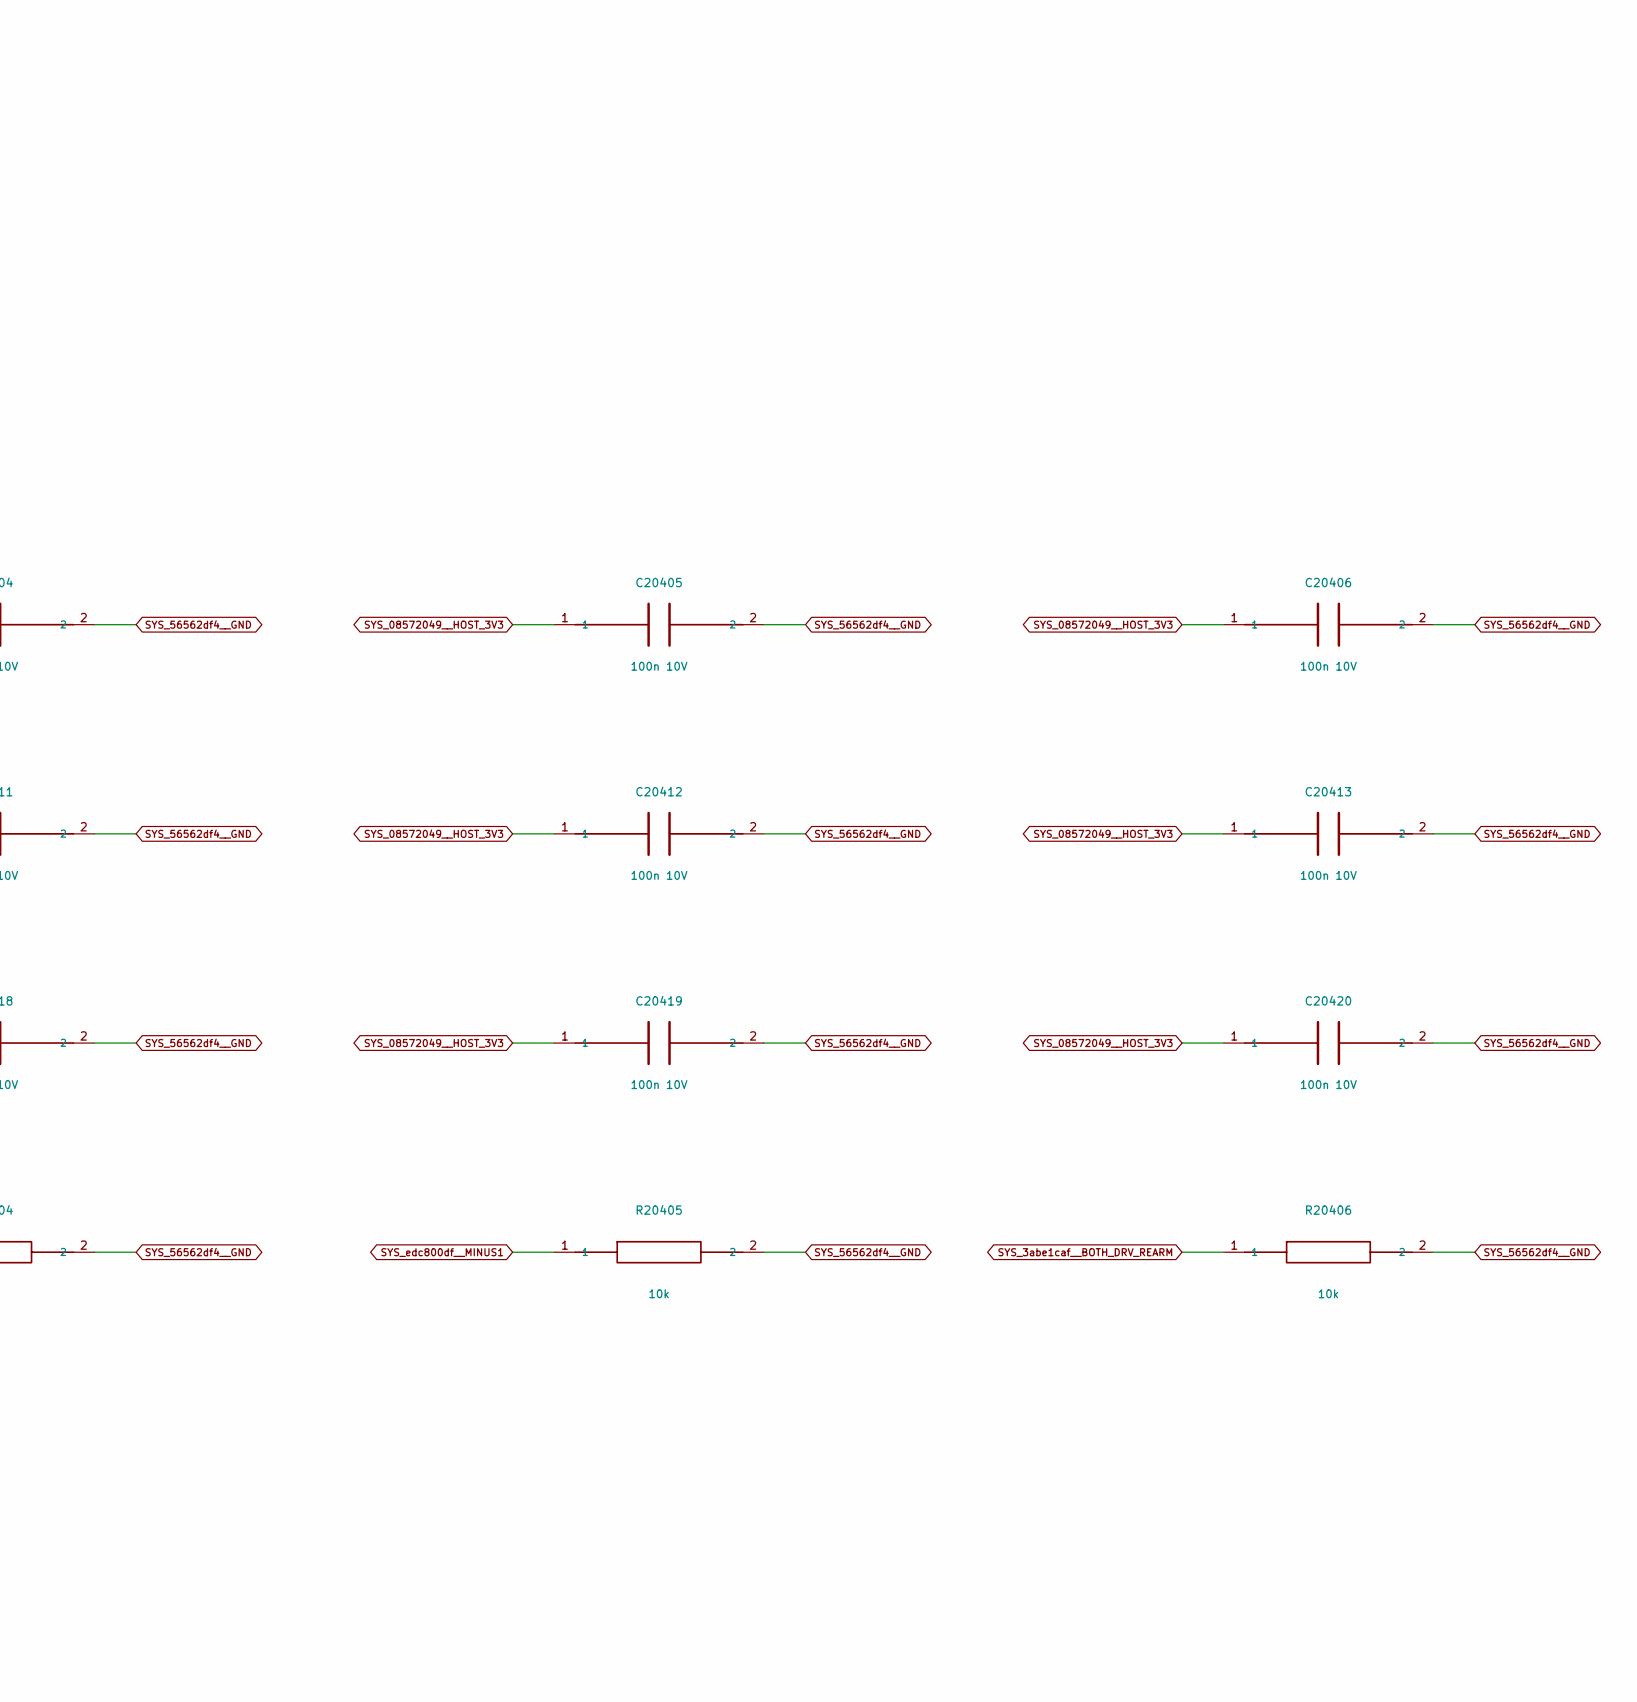
[picture p495: schematic permission1.kicad_sch, ATO S4 / Source 1: independent duration and sticky admission, part in row 2, column 3]

Parts:
C20400, C20401, C20402, C20403, C20404, C20405, C20406, C20407, C20408, C20409, C20410, C20411, C20412, C20413, C20414, C20415, C20416, C20417, C20418, C20419, C20420: 100n 10V; C_0805_2012Metric
R20400: 175.8k 0.1%; R_0805_2012Metric
R20401: 976k 0.1%; R_0805_2012Metric
R20402: 182k 0.1%; R_0805_2012Metric
R20403, R20404, R20405, R20406, R20407, R20408, R20409, R20410: 10k; R_0805_2012Metric
U20400: LTC6993HS6-1#TRPBF; TSOT-23-6
U20401: SN74LVC1G86DBVR; SOT-23-5
U20402, U20403, U20410, U20411, U20417, U20418: SN74LVC1G11DBVR; SOT-23-6
U20404, U20407, U20409, U20419, U20420: SN74LVC1G08DBVR; SOT-23-5
U20405, U20406, U20408, U20412: SN74LVC1G04DBVR; SOT-23-5
U20413, U20415, U20416: SN74LVC1G74DCUR; VSSOP-8_2.3x2mm_P0.5mm
U20414: SN74LVC1G32DBVR; SOT-23-5

Connections:
SYS_3abe1caf__BOTH_DRV_REARM: R20406.1, U20410.1 (A); also elsewhere on the board
SYS_6a132103__CH1_RUN: U20418.4 (Y), U20419.1 (A), U20420.1 (A); also elsewhere on the board
SYS_9c8a42b1__CH1_TIMEOUT: U20414.1 (A), U20415.5 (Q); also elsewhere on the board
SYS_20eba8c2__CH1_QUIESCENT_OK: R20410.1, U20410.6 (C); also elsewhere on the board
SYS_84f28705__CH1_ROUTE_LOCKED: R20409.1, U20402.6 (C); also elsewhere on the board
SYS_628d7747__PLUS1: R20404.1, U20401.1 (A), U20416.2 (D); also elsewhere on the board
SYS_8359fceb__CH1_EXT_SUP_OK: R20408.1, U20402.3 (B); also elsewhere on the board
SYS_56562df4__GND: C20400.2, C20401.2, C20402.2, C20403.2, C20404.2, C20405.2, C20406.2, C20407.2, C20408.2, C20409.2, C20410.2, C20411.2, C20412.2, C20413.2, C20414.2, C20415.2, C20416.2, C20417.2, C20418.2, C20419.2, C20420.2, R20400.2, R20402.2, R20403.2, R20404.2, R20405.2, R20406.2, R20407.2, R20408.2, R20409.2, R20410.2, U20400.2 (GND), U20401.3 (GND), U20402.2 (GND), U20403.2 (GND), U20404.3 (GND), U20405.3 (GND), U20406.3 (GND), U20407.3 (GND), U20408.3 (GND), U20409.3 (GND), U20410.2 (GND), U20411.2 (GND), U20412.3 (GND), U20413.1 (CLK), U20413.2 (D), U20413.4 (GND), U20414.3 (GND), U20415.4 (GND), U20416.4 (GND), U20417.2 (GND), U20418.2 (GND), U20419.3 (GND), U20420.3 (GND); also elsewhere on the board
SYS_08572049__HOST_3V3: C20400.1, C20401.1, C20402.1, C20403.1, C20404.1, C20405.1, C20406.1, C20407.1, C20408.1, C20409.1, C20410.1, C20411.1, C20412.1, C20413.1, C20414.1, C20415.1, C20416.1, C20417.1, C20418.1, C20419.1, C20420.1, R20401.1, U20400.5 (V+), U20401.5 (VCC), U20402.5 (VCC), U20403.5 (VCC), U20404.5 (VCC), U20405.5 (VCC), U20406.5 (VCC), U20407.5 (VCC), U20408.5 (VCC), U20409.5 (VCC), U20410.5 (VCC), U20411.5 (VCC), U20412.5 (VCC), U20413.8 (VCC), U20414.5 (VCC), U20415.7 (PRE_N), U20415.8 (VCC), U20416.7 (PRE_N), U20416.8 (VCC), U20417.5 (VCC), U20418.5 (VCC), U20419.5 (VCC), U20420.5 (VCC); also elsewhere on the board
SYS_93547907__RAILS_QUALIFIED: U20403.3 (B); also elsewhere on the board
SYS_aa321af6__CH1_MON_PERMIT: R20407.1, U20402.1 (A); also elsewhere on the board
SYS_c659d53f__CH1_TIMER: U20400.6 (OUT), U20406.2 (A), U20407.1 (A), U20418.3 (B); also elsewhere on the board
SYS_dd388269__CH1_REQUEST: R20403.1, U20400.1 (TRIG_RAW_REQ), U20405.2 (A), U20414.2 (B), U20418.1 (A); also elsewhere on the board
SYS_edc800df__MINUS1: R20405.1, U20401.2 (B); also elsewhere on the board
SYS_ff7fdc58__RESET_READY: U20403.1 (A), U20416.6 (CLR_N); also elsewhere on the board
current-driver__CH1_BASE_GOOD: U20404.4 (Y), U20409.1 (A), U20410.3 (B), U20417.1 (A)
current-driver__CH1_BLOCK: U20413.5 (Q); also elsewhere on the board
current-driver__CH1_BLOCK_N: U20413.3 (Q_N), U20417.3 (B)
current-driver__CH1_BLOCK_PRE_N: U20409.4 (Y), U20413.7 (PRE_N)
current-driver__CH1_DIAG_M: U20420.4 (Y); also elsewhere on the board
current-driver__CH1_DIAG_P: U20419.4 (Y); also elsewhere on the board
current-driver__CH1_GOOD: U20417.4 (Y), U20418.6 (C)
current-driver__CH1_HEALTH_A: U20402.4 (Y), U20404.1 (A)
current-driver__CH1_HEALTH_B: U20403.4 (Y), U20404.2 (B)
current-driver__CH1_LATCH_CLR_N: U20412.4 (Y), U20413.6 (CLR_N), U20415.6 (CLR_N)
current-driver__CH1_MINUS_LATCHED: U20416.3 (Q_N), U20420.2 (B)
current-driver__CH1_PLUS_LATCHED: U20416.5 (Q), U20419.2 (B)
current-driver__CH1_REARM_A: U20410.4 (Y), U20411.1 (A)
current-driver__CH1_REQ_N: U20405.4 (Y), U20407.2 (B), U20411.3 (B)
current-driver__CH1_SAFE_REARM: U20411.4 (Y), U20412.2 (A), U20416.1 (CLK)
current-driver__CH1_STOP_CONSUME: U20407.4 (Y), U20408.2 (A)
current-driver__CH1_STOP_N: U20408.4 (Y), U20409.2 (B)
current-driver__CH1_TIMEOUT_D: U20414.4 (Y), U20415.2 (D)
current-driver__CH1_TIMEOUT_N: U20415.3 (Q_N), U20417.6 (C)
current-driver__CH1_TIMER_N: U20406.4 (Y), U20411.6 (C), U20415.1 (CLK)
current-driver__CH1_T_DIV: R20401.2, R20402.1, U20400.4 (DIV)
current-driver__CH1_T_SET: R20400.1, U20400.3 (SET)
current-driver__CH1_VALID_DIR: U20401.4 (Y), U20403.6 (C)

Notes on the sheet:
ARTIFICIAL LOADS ONLY / RESTRICTED 24 V, 3 mA, 200 us DRIVER SLICE
External rails, recording AFE, 16-contact routing, compliance, charge guard, watchdog, PCB and implant qualification remain outside.
BASE_GOOD=MON & EXT & ROUTE & READY & RAILS & XOR(raw directions). Raw REQUEST clocks TIMER; SAFE_REARM preloads direction while off.
Normal request end consumes BLOCK; TIMEOUT records held request at timer fall. REARM requires request/timer LOW + QUIESCENT_OK.
Static/event checks do not qualify asynchronous hazards, supply ramps, propagation delay or real current tails. No automatic retry.

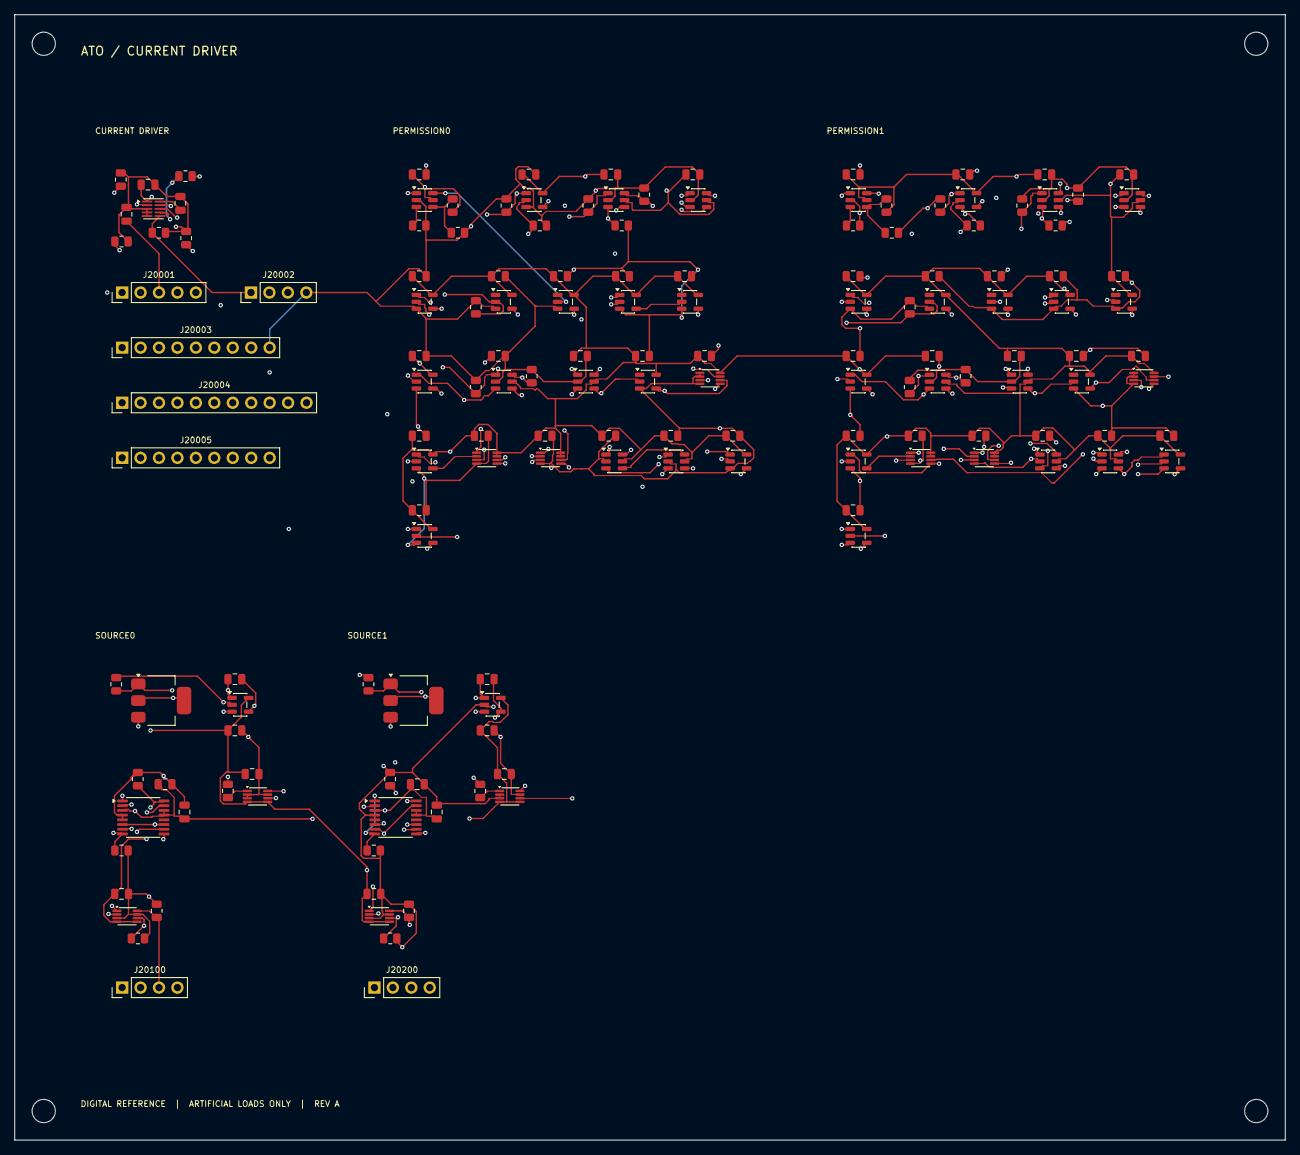
[picture p496: board current_driver.kicad_pcb from above]

Board: 4 copper layers, 175.0 x 155.0 mm, 160 parts (0 on the bottom side), 96 nets.

Other parts of the board:
H1, H2, H3, H4: MountingHole_3.2mm_M3
