pratham-cloud-ctrl/Project-ATO/electronics/stage4/integrated-pcb/boards/recording-front-end/recording_front_end.kicad_pcb

## KiCad design electronics/stage4/integrated-pcb/boards/recording-front-end/recording_front_end.kicad_pcb (2026-10-16)

Schematic: recording_front_end.kicad_sch, ATO S4 / Isolated SPI, control and supplied power

Parts:
C30001, C30002, C30003, C30004, C30005, C30006: 100n X7R 16V; C_0805_2012Metric
J30001: EXTERNAL ISOLATED AFE RAILS; PinHeader_1x04_P2.54mm_Vertical
J30002: HOST SPI / SUPERVISOR; PinHeader_1x10_P2.54mm_Vertical
J30003: 18 RECORDING FUNCTIONAL PORTS; PinHeader_1x18_P2.54mm_Vertical
R30001, R30002, R30003, R30004, R30005, R30006, R30007, R30008, R30009, R30010, R30011, R30012, R30013: 10k; R_0805_2012Metric
R30014: 1k; R_0805_2012Metric
U30001, U30002: ISO6741FDWR; SOIC-16W_7.5x10.3mm_P1.27mm
U30003: SN74LVC1G04DBVR; SOT-23-5
U30004: SN74LVC1G08DBVR; SOT-23-5

Connections:
SYS_0bc4e447__AFE_CONNECT: R30007.1, U30002.14 (OUTA), U30004.1 (A); also elsewhere on the board
SYS_3fdd5066__AFE_P5: J30001.1; also elsewhere on the board
SYS_4d4028f1__AFE_MOSI: J30002.4, R30002.1, U30001.4 (INB)
SYS_4dbe75ce__AFE_MISO: J30002.6, U30001.6 (OUTD)
SYS_4eb6b999__AFE_ACQUIRE: R30009.1, U30004.4 (Y); also elsewhere on the board
SYS_8b29b23f__AFE_CONNECT: J30002.7, R30004.1, U30002.3 (INA)
SYS_18e49fe8__AFE_CS_ASSERT: J30002.5, R30003.1, U30001.5 (INC)
SYS_65aafbb6__AFE_3V3: C30002.1, C30004.1, C30005.1, C30006.1, J30001.3, R30011.2, R30014.2, U30001.10 (EN2), U30001.16 (VCC2_AFE), U30002.10 (EN2), U30002.16 (VCC2_AFE), U30003.5 (VCC), U30004.5 (VCC); also elsewhere on the board
SYS_56562df4__GND: C30001.2, C30003.2, J30002.2, J30002.10, R30001.2, R30002.2, R30003.2, R30004.2, R30005.2, R30006.2, U30001.2 (GND1_HOST), U30001.8 (GND1_HOST), U30002.2 (GND1_HOST), U30002.5 (INC), U30002.8 (GND1_HOST)
SYS_08572049__HOST_3V3: C30001.1, C30003.1, J30002.1, U30001.1 (VCC1_HOST), U30001.7 (EN1), U30002.1 (VCC1_HOST), U30002.7 (EN1)
SYS_a9673f8c__AFE_RECORD: J30002.8, R30005.1, U30002.4 (INB)
SYS_ce1178b4__AFE_FAULT_N: J30002.9, R30006.1, U30002.6 (OUTD)
SYS_d73cd2ee__AFE_N5: J30001.2; also elsewhere on the board
SYS_f30c60de__AFE_SCLK: J30002.3, R30001.1, U30001.3 (INA)
SYS_fca1c340__AFEAGND: C30002.2, C30004.2, C30005.2, C30006.2, J30001.4, R30007.2, R30008.2, R30009.2, R30010.2, R30012.2, R30013.2, U30001.9 (GND2_AFE), U30001.15 (GND2_AFE), U30002.9 (GND2_AFE), U30002.15 (GND2_AFE), U30003.3 (GND), U30004.3 (GND); also elsewhere on the board
recording-front-end__AFE_CS_ASSERT: R30010.1, U30001.12 (OUTC), U30003.2 (A)
recording-front-end__AFE_CS_N: R30011.1, U30003.4 (Y); also elsewhere on the board
recording-front-end__AFE_FAULT_N: R30014.1, U30002.11 (IND); also elsewhere on the board
recording-front-end__AFE_MISO: U30001.11 (IND); also elsewhere on the board
recording-front-end__AFE_MOSI: R30013.1, U30001.13 (OUTB); also elsewhere on the board
recording-front-end__AFE_RECORD_CMD: R30008.1, U30002.13 (OUTB), U30004.2 (B)
recording-front-end__AFE_SCLK: R30012.1, U30001.14 (OUTA); also elsewhere on the board
recording-front-end__BIAS_CONTACT: J30003.18; also elsewhere on the board
recording-front-end__REC00_CONTACT: J30003.1; also elsewhere on the board
recording-front-end__REC01_CONTACT: J30003.2; also elsewhere on the board
recording-front-end__REC02_CONTACT: J30003.3; also elsewhere on the board
recording-front-end__REC03_CONTACT: J30003.4; also elsewhere on the board
recording-front-end__REC04_CONTACT: J30003.5; also elsewhere on the board
recording-front-end__REC05_CONTACT: J30003.6; also elsewhere on the board
recording-front-end__REC06_CONTACT: J30003.7; also elsewhere on the board
recording-front-end__REC07_CONTACT: J30003.8; also elsewhere on the board
recording-front-end__REC08_CONTACT: J30003.9; also elsewhere on the board
recording-front-end__REC09_CONTACT: J30003.10; also elsewhere on the board
recording-front-end__REC10_CONTACT: J30003.11; also elsewhere on the board
recording-front-end__REC11_CONTACT: J30003.12; also elsewhere on the board
recording-front-end__REC12_CONTACT: J30003.13; also elsewhere on the board
recording-front-end__REC13_CONTACT: J30003.14; also elsewhere on the board
recording-front-end__REC14_CONTACT: J30003.15; also elsewhere on the board
recording-front-end__REC15_CONTACT: J30003.16; also elsewhere on the board
recording-front-end__REF_CONTACT: J30003.17; also elsewhere on the board

Notes on the sheet:
DIGITAL RESEARCH CIRCUIT / ARTIFICIAL SIGNALS / NO PCB OR IMPLANT QUALIFICATION
Spinal concept: 16 positive contacts + 1 shared reference + separate passive bias; amplifier linearity and biological recording remain conditional.
HOSTGND and AFEAGND are separate domains. Both receive valid regulated supplies externally; the digital barrier does not generate power.
CS_ASSERT low -> island CS_N high. CONNECT low disconnects HV paths; ACQUIRE = CONNECT & RECORD, so 01 remains clamped.
Driver phase admission needs independently observed ISOLATED_READY; neither commands nor fault flags establish voltage or delivery evidence.

Schematic: acquisition.kicad_sch, ATO S4 / RHD2216 / sixteen sampled differential streams

Parts:
C30010, C30011: 100n X7R 16V; C_0805_2012Metric
C30012: 10n 16V; C_0805_2012Metric
C30013: 1u X7R 16V; C_0805_2012Metric
U30010: RHD2216; RHD2216_QFN56_8x8_P0.5_EP6.1

Connections:
SYS_1dc2a435__AFE_IN08_P: U30010.49 (in8+); also elsewhere on the board
SYS_4f7d5988__AFE_IN14_P: U30010.37 (in14+); also elsewhere on the board
SYS_4fabccc5__AFE_IN12_P: U30010.41 (in12+); also elsewhere on the board
SYS_7e367734__AFE_IN04_P: U30010.1 (in4+); also elsewhere on the board
SYS_8c3f25bb__AFE_IN02_P: U30010.5 (in2+); also elsewhere on the board
SYS_32c4c1cc__AFE_IN13_P: U30010.39 (in13+); also elsewhere on the board
SYS_65aafbb6__AFE_3V3: C30010.1, C30011.1, C30013.1, U30010.13 (VDD), U30010.14 (auxin1), U30010.15 (auxin2), U30010.16 (auxin3), U30010.26 (VDD), U30010.31 (VDD); also elsewhere on the board
SYS_86b728f8__AFE_REF: U30010.2 (in3-), U30010.4 (in2-), U30010.6 (in1-), U30010.8 (in0-), U30010.34 (in15-), U30010.36 (in14-), U30010.38 (in13-), U30010.40 (in12-), U30010.42 (in11-), U30010.44 (in10-), U30010.46 (in9-), U30010.48 (in8-), U30010.50 (in7-), U30010.52 (in6-), U30010.54 (in5-), U30010.56 (in4-); also elsewhere on the board
SYS_96d7c46a__AFE_IN10_P: U30010.45 (in10+); also elsewhere on the board
SYS_3232ae4c__AFE_IN01_P: U30010.7 (in1+); also elsewhere on the board
SYS_53213f89__AFE_IN15_P: U30010.35 (in15+); also elsewhere on the board
SYS_59100ef9__AFE_IN05_P: U30010.55 (in5+); also elsewhere on the board
SYS_325713b8__AFE_IN07_P: U30010.51 (in7+); also elsewhere on the board
SYS_380216f6__AFE_IN06_P: U30010.53 (in6+); also elsewhere on the board
SYS_05097029__AFE_IN00_P: U30010.9 (in0+); also elsewhere on the board
SYS_b6a4cd67__AFE_IN11_P: U30010.43 (in11+); also elsewhere on the board
SYS_ee730a89__AFE_IN09_P: U30010.47 (in9+); also elsewhere on the board
SYS_f208be39__AFE_IN03_P: U30010.3 (in3+); also elsewhere on the board
SYS_fca1c340__AFEAGND: C30010.2, C30011.2, C30012.2, C30013.2, U30010.10 (GND), U30010.11 (GND), U30010.12 (GND), U30010.17 (GND), U30010.29 (GND), U30010.30 (LVDS_en), U30010.32 (VESD), U30010.33 (elec_test), U30010.57 (EP_SHIELD); also elsewhere on the board
recording-front-end__AFE_ADC_REF: C30012.1, U30010.28 (ADC_ref)
recording-front-end__AFE_CS_N: U30010.19 (CS+); also elsewhere on the board
recording-front-end__AFE_MISO: U30010.25 (MISO+); also elsewhere on the board
recording-front-end__AFE_MOSI: U30010.23 (MOSI+); also elsewhere on the board
recording-front-end__AFE_SCLK: U30010.21 (SCLK+); also elsewhere on the board

Notes on the sheet:
DIGITAL RESEARCH CIRCUIT / ARTIFICIAL SIGNALS / NO PCB OR IMPLANT QUALIFICATION
Spinal concept: 16 positive contacts + 1 shared reference + separate passive bias; amplifier linearity and biological recording remain conditional.
Every minus input shares AFE_REF. This is 16 differential streams from 18 functional recording ports, not 32 independent recording electrodes.
CMOS mode: LVDS_en=0; negative SPI pins NC; unused aux inputs at VDD; auxout NC; elec_test and VESD at AFEAGND.
Configure, calibrate and verify readback via SPI before valid data. 4MHz / 5us command slots are the revised isolated-link study baseline.
ADC response is pipelined; physical sample timestamps and invalid blanking/recovery intervals must be retained in software.

Schematic: bank0.kicad_sch, ATO S4 / Inputs 00-03 / protected recording

Parts:
C30020, C30030, C30200, C30201, C30202, C30203, C30300, C30301, C30302, C30303: 100n X7R 16V; C_0805_2012Metric
C30100, C30101, C30102, C30103: 470p C0G 50V; C_0805_2012Metric
R30100, R30101, R30102, R30103: 4.99k 0.1%; R_0805_2012Metric
R30200, R30201, R30202, R30203: 10M; R_0805_2012Metric
U30020: TMUX7412FRRPR; Texas_RRP0016A_WQFN16_4x4_P0.65_EP2.6
U30100, U30101, U30102, U30103: TMUX6219DGKR; VSSOP-8_2.3x2mm_P0.5mm

Connections:
SYS_0bc4e447__AFE_CONNECT: U30020.6 (SEL4), U30020.7 (SEL3), U30020.14 (SEL2), U30020.15 (SEL1); also elsewhere on the board
SYS_3fdd5066__AFE_P5: C30020.1, C30200.1, C30201.1, C30202.1, C30203.1, U30020.11 (VDD), U30100.4 (VDD), U30101.4 (VDD), U30102.4 (VDD), U30103.4 (VDD); also elsewhere on the board
SYS_4eb6b999__AFE_ACQUIRE: U30100.6 (SEL_ACQUIRE), U30101.6 (SEL_ACQUIRE), U30102.6 (SEL_ACQUIRE), U30103.6 (SEL_ACQUIRE); also elsewhere on the board
SYS_8c3f25bb__AFE_IN02_P: C30102.1, U30102.1 (D_RHD); also elsewhere on the board
SYS_65aafbb6__AFE_3V3: U30100.5 (EN), U30101.5 (EN), U30102.5 (EN), U30103.5 (EN); also elsewhere on the board
SYS_3232ae4c__AFE_IN01_P: C30101.1, U30101.1 (D_RHD); also elsewhere on the board
SYS_05097029__AFE_IN00_P: C30100.1, U30100.1 (D_RHD); also elsewhere on the board
SYS_d73cd2ee__AFE_N5: C30030.1, C30300.1, C30301.1, C30302.1, C30303.1, U30020.2 (VSS_NEG), U30100.7 (VSS_NEG), U30101.7 (VSS_NEG), U30102.7 (VSS_NEG), U30103.7 (VSS_NEG); also elsewhere on the board
SYS_f208be39__AFE_IN03_P: C30103.1, U30103.1 (D_RHD); also elsewhere on the board
SYS_fca1c340__AFEAGND: C30020.2, C30030.2, C30100.2, C30101.2, C30102.2, C30103.2, C30200.2, C30201.2, C30202.2, C30203.2, C30300.2, C30301.2, C30302.2, C30303.2, R30200.2, R30201.2, R30202.2, R30203.2, U30020.3 (GND), U30020.17 (EP_SHIELD), U30100.2 (S1_CLAMP), U30100.3 (GND), U30101.2 (S1_CLAMP), U30101.3 (GND), U30102.2 (S1_CLAMP), U30102.3 (GND), U30103.2 (S1_CLAMP), U30103.3 (GND); also elsewhere on the board
recording-front-end__AFE_FAULT_N: U30020.10 (FF_N); also elsewhere on the board
recording-front-end__REC00_CONTACT: R30100.1; also elsewhere on the board
recording-front-end__REC00_PROT: R30200.1, U30020.16 (D1_INTERNAL), U30100.8 (S2_PROTECTED)
recording-front-end__REC00_SERIES: R30100.2, U30020.1 (S1_CONTACT)
recording-front-end__REC01_CONTACT: R30101.1; also elsewhere on the board
recording-front-end__REC01_PROT: R30201.1, U30020.13 (D2_INTERNAL), U30101.8 (S2_PROTECTED)
recording-front-end__REC01_SERIES: R30101.2, U30020.12 (S2_CONTACT)
recording-front-end__REC02_CONTACT: R30102.1; also elsewhere on the board
recording-front-end__REC02_PROT: R30202.1, U30020.8 (D3_INTERNAL), U30102.8 (S2_PROTECTED)
recording-front-end__REC02_SERIES: R30102.2, U30020.9 (S3_CONTACT)
recording-front-end__REC03_CONTACT: R30103.1; also elsewhere on the board
recording-front-end__REC03_PROT: R30203.1, U30020.5 (D4_INTERNAL), U30103.8 (S2_PROTECTED)
recording-front-end__REC03_SERIES: R30103.2, U30020.4 (S4_CONTACT)

Notes on the sheet:
DIGITAL RESEARCH CIRCUIT / ARTIFICIAL SIGNALS / NO PCB OR IMPLANT QUALIFICATION
Spinal concept: 16 positive contacts + 1 shared reference + separate passive bias; amplifier linearity and biological recording remain conditional.
Per column: contact -> 4.99k -> quad protected S/D -> protected node -> S2; S1 grounds RHD until ACQUIRE is admitted.
470pF is at the RHD pin; 10M bleeds the internal node. Switch capacitance/leakage/injection and shared reference mismatch remain modeled assumptions.
Fault threshold follows +/-5V rails and is far outside RHD +/-0.4V linear DC range. External low-voltage qualification is mandatory before unclamping.

Schematic: bank1.kicad_sch, ATO S4 / Inputs 04-07 / protected recording

Parts:
C30021, C30031, C30204, C30205, C30206, C30207, C30304, C30305, C30306, C30307: 100n X7R 16V; C_0805_2012Metric
C30104, C30105, C30106, C30107: 470p C0G 50V; C_0805_2012Metric
R30104, R30105, R30106, R30107: 4.99k 0.1%; R_0805_2012Metric
R30204, R30205, R30206, R30207: 10M; R_0805_2012Metric
U30021: TMUX7412FRRPR; Texas_RRP0016A_WQFN16_4x4_P0.65_EP2.6
U30104, U30105, U30106, U30107: TMUX6219DGKR; VSSOP-8_2.3x2mm_P0.5mm

Connections:
SYS_0bc4e447__AFE_CONNECT: U30021.6 (SEL4), U30021.7 (SEL3), U30021.14 (SEL2), U30021.15 (SEL1); also elsewhere on the board
SYS_3fdd5066__AFE_P5: C30021.1, C30204.1, C30205.1, C30206.1, C30207.1, U30021.11 (VDD), U30104.4 (VDD), U30105.4 (VDD), U30106.4 (VDD), U30107.4 (VDD); also elsewhere on the board
SYS_4eb6b999__AFE_ACQUIRE: U30104.6 (SEL_ACQUIRE), U30105.6 (SEL_ACQUIRE), U30106.6 (SEL_ACQUIRE), U30107.6 (SEL_ACQUIRE); also elsewhere on the board
SYS_7e367734__AFE_IN04_P: C30104.1, U30104.1 (D_RHD); also elsewhere on the board
SYS_65aafbb6__AFE_3V3: U30104.5 (EN), U30105.5 (EN), U30106.5 (EN), U30107.5 (EN); also elsewhere on the board
SYS_59100ef9__AFE_IN05_P: C30105.1, U30105.1 (D_RHD); also elsewhere on the board
SYS_325713b8__AFE_IN07_P: C30107.1, U30107.1 (D_RHD); also elsewhere on the board
SYS_380216f6__AFE_IN06_P: C30106.1, U30106.1 (D_RHD); also elsewhere on the board
SYS_d73cd2ee__AFE_N5: C30031.1, C30304.1, C30305.1, C30306.1, C30307.1, U30021.2 (VSS_NEG), U30104.7 (VSS_NEG), U30105.7 (VSS_NEG), U30106.7 (VSS_NEG), U30107.7 (VSS_NEG); also elsewhere on the board
SYS_fca1c340__AFEAGND: C30021.2, C30031.2, C30104.2, C30105.2, C30106.2, C30107.2, C30204.2, C30205.2, C30206.2, C30207.2, C30304.2, C30305.2, C30306.2, C30307.2, R30204.2, R30205.2, R30206.2, R30207.2, U30021.3 (GND), U30021.17 (EP_SHIELD), U30104.2 (S1_CLAMP), U30104.3 (GND), U30105.2 (S1_CLAMP), U30105.3 (GND), U30106.2 (S1_CLAMP), U30106.3 (GND), U30107.2 (S1_CLAMP), U30107.3 (GND); also elsewhere on the board
recording-front-end__AFE_FAULT_N: U30021.10 (FF_N); also elsewhere on the board
recording-front-end__REC04_CONTACT: R30104.1; also elsewhere on the board
recording-front-end__REC04_PROT: R30204.1, U30021.16 (D1_INTERNAL), U30104.8 (S2_PROTECTED)
recording-front-end__REC04_SERIES: R30104.2, U30021.1 (S1_CONTACT)
recording-front-end__REC05_CONTACT: R30105.1; also elsewhere on the board
recording-front-end__REC05_PROT: R30205.1, U30021.13 (D2_INTERNAL), U30105.8 (S2_PROTECTED)
recording-front-end__REC05_SERIES: R30105.2, U30021.12 (S2_CONTACT)
recording-front-end__REC06_CONTACT: R30106.1; also elsewhere on the board
recording-front-end__REC06_PROT: R30206.1, U30021.8 (D3_INTERNAL), U30106.8 (S2_PROTECTED)
recording-front-end__REC06_SERIES: R30106.2, U30021.9 (S3_CONTACT)
recording-front-end__REC07_CONTACT: R30107.1; also elsewhere on the board
recording-front-end__REC07_PROT: R30207.1, U30021.5 (D4_INTERNAL), U30107.8 (S2_PROTECTED)
recording-front-end__REC07_SERIES: R30107.2, U30021.4 (S4_CONTACT)

Notes on the sheet:
DIGITAL RESEARCH CIRCUIT / ARTIFICIAL SIGNALS / NO PCB OR IMPLANT QUALIFICATION
Spinal concept: 16 positive contacts + 1 shared reference + separate passive bias; amplifier linearity and biological recording remain conditional.
Per column: contact -> 4.99k -> quad protected S/D -> protected node -> S2; S1 grounds RHD until ACQUIRE is admitted.
470pF is at the RHD pin; 10M bleeds the internal node. Switch capacitance/leakage/injection and shared reference mismatch remain modeled assumptions.
Fault threshold follows +/-5V rails and is far outside RHD +/-0.4V linear DC range. External low-voltage qualification is mandatory before unclamping.

Schematic: bank2.kicad_sch, ATO S4 / Inputs 08-11 / protected recording

Parts:
C30022, C30032, C30208, C30209, C30210, C30211, C30308, C30309, C30310, C30311: 100n X7R 16V; C_0805_2012Metric
C30108, C30109, C30110, C30111: 470p C0G 50V; C_0805_2012Metric
R30108, R30109, R30110, R30111: 4.99k 0.1%; R_0805_2012Metric
R30208, R30209, R30210, R30211: 10M; R_0805_2012Metric
U30022: TMUX7412FRRPR; Texas_RRP0016A_WQFN16_4x4_P0.65_EP2.6
U30108, U30109, U30110, U30111: TMUX6219DGKR; VSSOP-8_2.3x2mm_P0.5mm

Connections:
SYS_0bc4e447__AFE_CONNECT: U30022.6 (SEL4), U30022.7 (SEL3), U30022.14 (SEL2), U30022.15 (SEL1); also elsewhere on the board
SYS_1dc2a435__AFE_IN08_P: C30108.1, U30108.1 (D_RHD); also elsewhere on the board
SYS_3fdd5066__AFE_P5: C30022.1, C30208.1, C30209.1, C30210.1, C30211.1, U30022.11 (VDD), U30108.4 (VDD), U30109.4 (VDD), U30110.4 (VDD), U30111.4 (VDD); also elsewhere on the board
SYS_4eb6b999__AFE_ACQUIRE: U30108.6 (SEL_ACQUIRE), U30109.6 (SEL_ACQUIRE), U30110.6 (SEL_ACQUIRE), U30111.6 (SEL_ACQUIRE); also elsewhere on the board
SYS_65aafbb6__AFE_3V3: U30108.5 (EN), U30109.5 (EN), U30110.5 (EN), U30111.5 (EN); also elsewhere on the board
SYS_96d7c46a__AFE_IN10_P: C30110.1, U30110.1 (D_RHD); also elsewhere on the board
SYS_b6a4cd67__AFE_IN11_P: C30111.1, U30111.1 (D_RHD); also elsewhere on the board
SYS_d73cd2ee__AFE_N5: C30032.1, C30308.1, C30309.1, C30310.1, C30311.1, U30022.2 (VSS_NEG), U30108.7 (VSS_NEG), U30109.7 (VSS_NEG), U30110.7 (VSS_NEG), U30111.7 (VSS_NEG); also elsewhere on the board
SYS_ee730a89__AFE_IN09_P: C30109.1, U30109.1 (D_RHD); also elsewhere on the board
SYS_fca1c340__AFEAGND: C30022.2, C30032.2, C30108.2, C30109.2, C30110.2, C30111.2, C30208.2, C30209.2, C30210.2, C30211.2, C30308.2, C30309.2, C30310.2, C30311.2, R30208.2, R30209.2, R30210.2, R30211.2, U30022.3 (GND), U30022.17 (EP_SHIELD), U30108.2 (S1_CLAMP), U30108.3 (GND), U30109.2 (S1_CLAMP), U30109.3 (GND), U30110.2 (S1_CLAMP), U30110.3 (GND), U30111.2 (S1_CLAMP), U30111.3 (GND); also elsewhere on the board
recording-front-end__AFE_FAULT_N: U30022.10 (FF_N); also elsewhere on the board
recording-front-end__REC08_CONTACT: R30108.1; also elsewhere on the board
recording-front-end__REC08_PROT: R30208.1, U30022.16 (D1_INTERNAL), U30108.8 (S2_PROTECTED)
recording-front-end__REC08_SERIES: R30108.2, U30022.1 (S1_CONTACT)
recording-front-end__REC09_CONTACT: R30109.1; also elsewhere on the board
recording-front-end__REC09_PROT: R30209.1, U30022.13 (D2_INTERNAL), U30109.8 (S2_PROTECTED)
recording-front-end__REC09_SERIES: R30109.2, U30022.12 (S2_CONTACT)
recording-front-end__REC10_CONTACT: R30110.1; also elsewhere on the board
recording-front-end__REC10_PROT: R30210.1, U30022.8 (D3_INTERNAL), U30110.8 (S2_PROTECTED)
recording-front-end__REC10_SERIES: R30110.2, U30022.9 (S3_CONTACT)
recording-front-end__REC11_CONTACT: R30111.1; also elsewhere on the board
recording-front-end__REC11_PROT: R30211.1, U30022.5 (D4_INTERNAL), U30111.8 (S2_PROTECTED)
recording-front-end__REC11_SERIES: R30111.2, U30022.4 (S4_CONTACT)

Notes on the sheet:
DIGITAL RESEARCH CIRCUIT / ARTIFICIAL SIGNALS / NO PCB OR IMPLANT QUALIFICATION
Spinal concept: 16 positive contacts + 1 shared reference + separate passive bias; amplifier linearity and biological recording remain conditional.
Per column: contact -> 4.99k -> quad protected S/D -> protected node -> S2; S1 grounds RHD until ACQUIRE is admitted.
470pF is at the RHD pin; 10M bleeds the internal node. Switch capacitance/leakage/injection and shared reference mismatch remain modeled assumptions.
Fault threshold follows +/-5V rails and is far outside RHD +/-0.4V linear DC range. External low-voltage qualification is mandatory before unclamping.

Schematic: bank3.kicad_sch, ATO S4 / Inputs 12-15 / protected recording

Parts:
C30023, C30033, C30212, C30213, C30214, C30215, C30312, C30313, C30314, C30315: 100n X7R 16V; C_0805_2012Metric
C30112, C30113, C30114, C30115: 470p C0G 50V; C_0805_2012Metric
R30112, R30113, R30114, R30115: 4.99k 0.1%; R_0805_2012Metric
R30212, R30213, R30214, R30215: 10M; R_0805_2012Metric
U30023: TMUX7412FRRPR; Texas_RRP0016A_WQFN16_4x4_P0.65_EP2.6
U30112, U30113, U30114, U30115: TMUX6219DGKR; VSSOP-8_2.3x2mm_P0.5mm

Connections:
SYS_0bc4e447__AFE_CONNECT: U30023.6 (SEL4), U30023.7 (SEL3), U30023.14 (SEL2), U30023.15 (SEL1); also elsewhere on the board
SYS_3fdd5066__AFE_P5: C30023.1, C30212.1, C30213.1, C30214.1, C30215.1, U30023.11 (VDD), U30112.4 (VDD), U30113.4 (VDD), U30114.4 (VDD), U30115.4 (VDD); also elsewhere on the board
SYS_4eb6b999__AFE_ACQUIRE: U30112.6 (SEL_ACQUIRE), U30113.6 (SEL_ACQUIRE), U30114.6 (SEL_ACQUIRE), U30115.6 (SEL_ACQUIRE); also elsewhere on the board
SYS_4f7d5988__AFE_IN14_P: C30114.1, U30114.1 (D_RHD); also elsewhere on the board
SYS_4fabccc5__AFE_IN12_P: C30112.1, U30112.1 (D_RHD); also elsewhere on the board
SYS_32c4c1cc__AFE_IN13_P: C30113.1, U30113.1 (D_RHD); also elsewhere on the board
SYS_65aafbb6__AFE_3V3: U30112.5 (EN), U30113.5 (EN), U30114.5 (EN), U30115.5 (EN); also elsewhere on the board
SYS_53213f89__AFE_IN15_P: C30115.1, U30115.1 (D_RHD); also elsewhere on the board
SYS_d73cd2ee__AFE_N5: C30033.1, C30312.1, C30313.1, C30314.1, C30315.1, U30023.2 (VSS_NEG), U30112.7 (VSS_NEG), U30113.7 (VSS_NEG), U30114.7 (VSS_NEG), U30115.7 (VSS_NEG); also elsewhere on the board
SYS_fca1c340__AFEAGND: C30023.2, C30033.2, C30112.2, C30113.2, C30114.2, C30115.2, C30212.2, C30213.2, C30214.2, C30215.2, C30312.2, C30313.2, C30314.2, C30315.2, R30212.2, R30213.2, R30214.2, R30215.2, U30023.3 (GND), U30023.17 (EP_SHIELD), U30112.2 (S1_CLAMP), U30112.3 (GND), U30113.2 (S1_CLAMP), U30113.3 (GND), U30114.2 (S1_CLAMP), U30114.3 (GND), U30115.2 (S1_CLAMP), U30115.3 (GND); also elsewhere on the board
recording-front-end__AFE_FAULT_N: U30023.10 (FF_N); also elsewhere on the board
recording-front-end__REC12_CONTACT: R30112.1; also elsewhere on the board
recording-front-end__REC12_PROT: R30212.1, U30023.16 (D1_INTERNAL), U30112.8 (S2_PROTECTED)
recording-front-end__REC12_SERIES: R30112.2, U30023.1 (S1_CONTACT)
recording-front-end__REC13_CONTACT: R30113.1; also elsewhere on the board
recording-front-end__REC13_PROT: R30213.1, U30023.13 (D2_INTERNAL), U30113.8 (S2_PROTECTED)
recording-front-end__REC13_SERIES: R30113.2, U30023.12 (S2_CONTACT)
recording-front-end__REC14_CONTACT: R30114.1; also elsewhere on the board
recording-front-end__REC14_PROT: R30214.1, U30023.8 (D3_INTERNAL), U30114.8 (S2_PROTECTED)
recording-front-end__REC14_SERIES: R30114.2, U30023.9 (S3_CONTACT)
recording-front-end__REC15_CONTACT: R30115.1; also elsewhere on the board
recording-front-end__REC15_PROT: R30215.1, U30023.5 (D4_INTERNAL), U30115.8 (S2_PROTECTED)
recording-front-end__REC15_SERIES: R30115.2, U30023.4 (S4_CONTACT)

Notes on the sheet:
DIGITAL RESEARCH CIRCUIT / ARTIFICIAL SIGNALS / NO PCB OR IMPLANT QUALIFICATION
Spinal concept: 16 positive contacts + 1 shared reference + separate passive bias; amplifier linearity and biological recording remain conditional.
Per column: contact -> 4.99k -> quad protected S/D -> protected node -> S2; S1 grounds RHD until ACQUIRE is admitted.
470pF is at the RHD pin; 10M bleeds the internal node. Switch capacitance/leakage/injection and shared reference mismatch remain modeled assumptions.
Fault threshold follows +/-5V rails and is far outside RHD +/-0.4V linear DC range. External low-voltage qualification is mandatory before unclamping.

Schematic: reference.kicad_sch, ATO S4 / Shared reference / passive body bias

Parts:
C30500: 2.2n C0G 50V; C_0805_2012Metric
C30510, C30511, C30512, C30513: 100n X7R 16V; C_0805_2012Metric
R30500: 4.99k 0.1%; R_0805_2012Metric
R30501: 10M; R_0805_2012Metric
R30502, R30503: 499k 0.1%; R_0805_2012Metric
U30024: TMUX7412FRRPR; Texas_RRP0016A_WQFN16_4x4_P0.65_EP2.6
U30500: TMUX6219DGKR; VSSOP-8_2.3x2mm_P0.5mm

Connections:
SYS_0bc4e447__AFE_CONNECT: U30024.15 (SEL1); also elsewhere on the board
SYS_3fdd5066__AFE_P5: C30510.1, C30512.1, U30024.11 (VDD), U30500.4 (VDD); also elsewhere on the board
SYS_4eb6b999__AFE_ACQUIRE: U30500.6 (SEL_ACQUIRE); also elsewhere on the board
SYS_65aafbb6__AFE_3V3: U30500.5 (EN); also elsewhere on the board
SYS_86b728f8__AFE_REF: C30500.1, U30500.1 (D_RHD); also elsewhere on the board
SYS_d73cd2ee__AFE_N5: C30511.1, C30513.1, U30024.2 (VSS_NEG), U30500.7 (VSS_NEG); also elsewhere on the board
SYS_fca1c340__AFEAGND: C30500.2, C30510.2, C30511.2, C30512.2, C30513.2, R30501.2, R30503.2, U30024.3 (GND), U30024.4 (S4_CONTACT), U30024.5 (D4_INTERNAL), U30024.6 (SEL4), U30024.7 (SEL3), U30024.8 (D3_INTERNAL), U30024.9 (S3_CONTACT), U30024.12 (S2_CONTACT), U30024.13 (D2_INTERNAL), U30024.14 (SEL2), U30024.17 (EP_SHIELD), U30500.2 (S1_CLAMP), U30500.3 (GND); also elsewhere on the board
recording-front-end__AFE_FAULT_N: U30024.10 (FF_N); also elsewhere on the board
recording-front-end__BIAS_CONTACT: R30502.1; also elsewhere on the board
recording-front-end__BIAS_MID: R30502.2, R30503.1
recording-front-end__REF_CONTACT: R30500.1; also elsewhere on the board
recording-front-end__REF_PROT: R30501.1, U30024.16 (D1_INTERNAL), U30500.8 (S2_PROTECTED)
recording-front-end__REF_SERIES: R30500.2, U30024.1 (S1_CONTACT)

Notes on the sheet:
DIGITAL RESEARCH CIRCUIT / ARTIFICIAL SIGNALS / NO PCB OR IMPLANT QUALIFICATION
Spinal concept: 16 positive contacts + 1 shared reference + separate passive bias; amplifier linearity and biological recording remain conditional.
REF_CONTACT passes through the same disconnect/clamp topology; one AFE_REF node feeds all sixteen minus pins (192pF intrinsic typical).
BIAS_CONTACT is separate and never a stimulation return. Passive current arithmetic does not establish a medical current limit.

Schematic: integration_taps.kicad_sch, ATO / recording-front-end integration taps

Parts:
J39901: AFE TAP HARNESS; PinHeader_1x12_P2.54mm_Vertical
J39902: AFE TAP HARNESS; PinHeader_1x09_P2.54mm_Vertical

Connections:
SYS_0bc4e447__AFE_CONNECT: J39901.2; also elsewhere on the board
SYS_1dc2a435__AFE_IN08_P: J39901.11; also elsewhere on the board
SYS_4eb6b999__AFE_ACQUIRE: J39901.1; also elsewhere on the board
SYS_4f7d5988__AFE_IN14_P: J39902.6; also elsewhere on the board
SYS_4fabccc5__AFE_IN12_P: J39902.4; also elsewhere on the board
SYS_7e367734__AFE_IN04_P: J39901.7; also elsewhere on the board
SYS_8c3f25bb__AFE_IN02_P: J39901.5; also elsewhere on the board
SYS_32c4c1cc__AFE_IN13_P: J39902.5; also elsewhere on the board
SYS_86b728f8__AFE_REF: J39902.8; also elsewhere on the board
SYS_96d7c46a__AFE_IN10_P: J39902.2; also elsewhere on the board
SYS_3232ae4c__AFE_IN01_P: J39901.4; also elsewhere on the board
SYS_53213f89__AFE_IN15_P: J39902.7; also elsewhere on the board
SYS_59100ef9__AFE_IN05_P: J39901.8; also elsewhere on the board
SYS_325713b8__AFE_IN07_P: J39901.10; also elsewhere on the board
SYS_380216f6__AFE_IN06_P: J39901.9; also elsewhere on the board
SYS_05097029__AFE_IN00_P: J39901.3; also elsewhere on the board
SYS_b6a4cd67__AFE_IN11_P: J39902.3; also elsewhere on the board
SYS_ee730a89__AFE_IN09_P: J39902.1; also elsewhere on the board
SYS_f208be39__AFE_IN03_P: J39901.6; also elsewhere on the board
SYS_fca1c340__AFEAGND: J39901.12, J39902.9; also elsewhere on the board

Notes on the sheet:
INTEGRATED COMPONENT-TAP HARNESS / recording-front-end
Physical headers expose actual earlier component taps. Original connectors remain available.
Only named electrical nets connect. AFE, HOST and companion grounds remain distinct.
Artificial-load digital design. Added wiring capacitance and connector integrity require measurement.

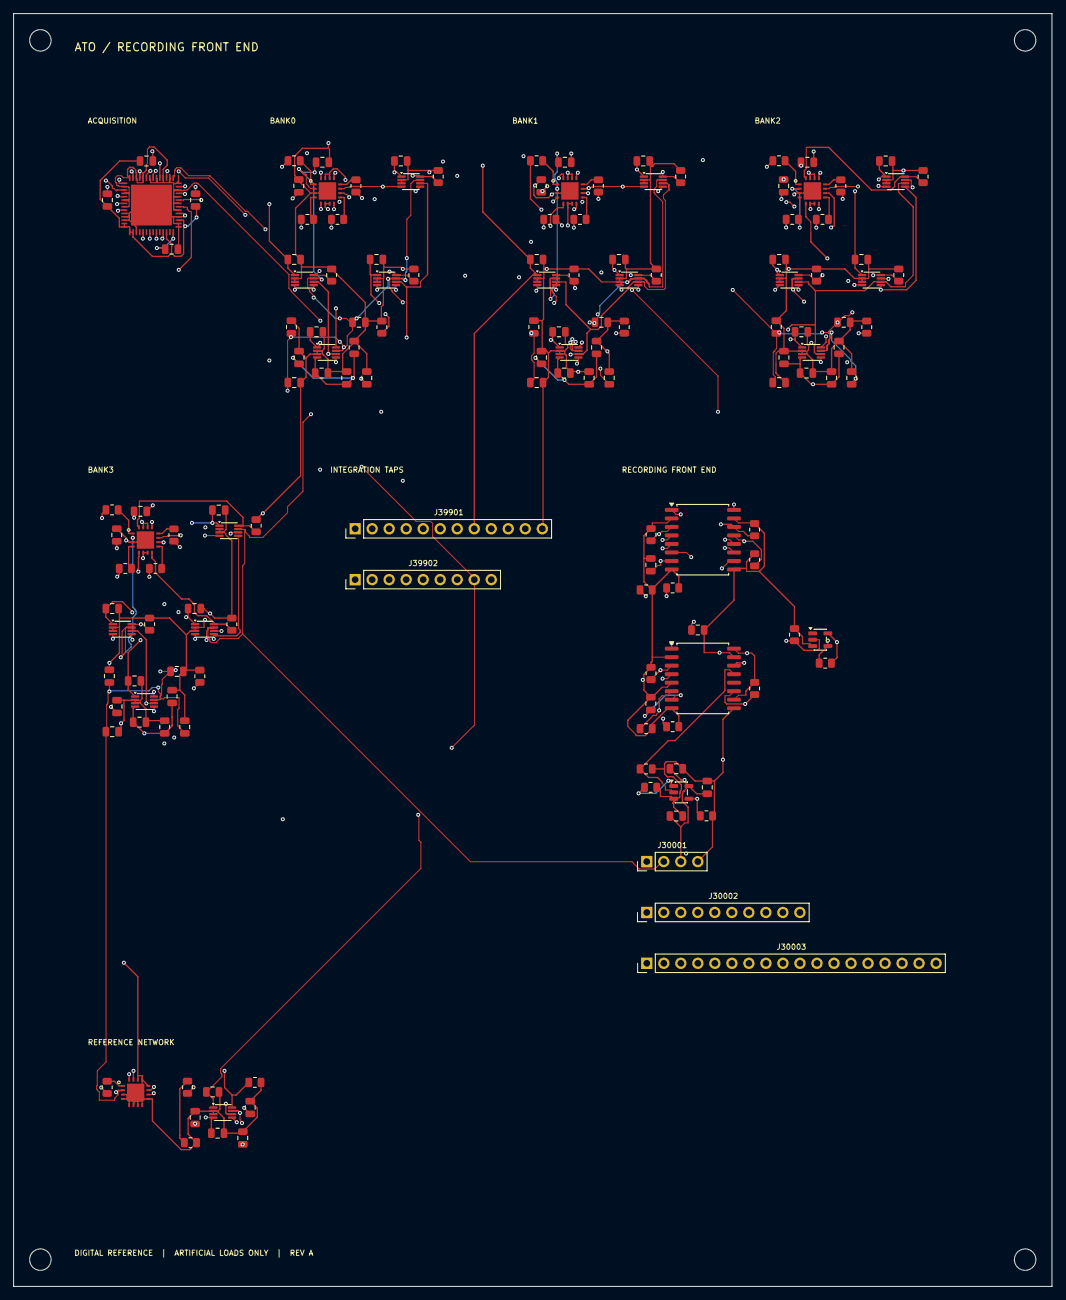
[picture p497: board recording_front_end.kicad_pcb from above]

Board: 4 copper layers, 155.0 x 190.0 mm, 157 parts (0 on the bottom side), 93 nets.

Other parts of the board:
H1, H2, H3, H4: MountingHole_3.2mm_M3
