pratham-cloud-ctrl/Project-ATO/electronics/stage4/integrated-pcb/boards/monitoring-cell/monitoring_cell.kicad_pcb

## KiCad design electronics/stage4/integrated-pcb/boards/monitoring-cell/monitoring_cell.kicad_pcb (2026-10-16)

Schematic: monitoring_cell.kicad_sch, ATO S4 / Shared reference and interfaces

Parts:
C10001, C10002: 1u 10V; C_0805_2012Metric
C10003, C10004: 100n 10V; C_0805_2012Metric
J10001: LAB RAILS ONLY; PinHeader_1x03_P2.54mm_Vertical
J10002: MCU ENDPOINT/CONTROL; PinHeader_1x12_P2.54mm_Vertical
J10003: EXTERNAL SUPERVISION; PinHeader_1x05_P2.54mm_Vertical
J10004: CURRENT ADC INTERFACE; PinHeader_1x04_P2.54mm_Vertical
R10001, R10002, R10003, R10005: 10k 0.1%; R_0805_2012Metric
R10004: 19.1k 0.1%; R_0805_2012Metric
R10006, R10007: 100k; R_0805_2012Metric
U10001: REF3440DBVR; SOT-23-6
U10002: OPA391DCKR; SOT-353_SC-70-5
U10003: TMUX1136DGSR; MSOP-10_3x3mm_P0.5mm

Connections:
SYS_4f66f129__MON_VREF: C10002.1, R10001.1, R10003.1, U10001.5 (OUT_S), U10001.6 (OUT_F); also elsewhere on the board
SYS_7cf9dad5__MON_SCLK: J10002.7; also elsewhere on the board
SYS_32a601bf__MON_REARM1: J10002.11; also elsewhere on the board
SYS_36b0932b__INT_RUN1: J10002.9, R10007.1, U10003.5 (SEL2)
SYS_37cfe02a__MON_VMID: J10004.3, U10002.3 (IN-), U10002.4 (OUT); also elsewhere on the board
SYS_56ebc071__CH0_MON_PERMIT: J10003.3; also elsewhere on the board
SYS_83a198be__CH0_DOUT: J10002.3; also elsewhere on the board
SYS_502efdd4__CH1_I_MON: J10004.2; also elsewhere on the board
SYS_822d2245__MON_REARM0: J10002.10; also elsewhere on the board
SYS_37737e7c__INT_RUN0: J10002.8, R10006.1, U10003.1 (SEL1)
SYS_56562df4__GND: C10001.2, C10002.2, C10003.2, C10004.2, J10001.3, J10002.12, J10003.5, J10004.4, R10002.2, R10005.2, R10006.2, R10007.2, U10001.1 (GND_F), U10001.2 (GND_S), U10002.2 (V-), U10003.3 (GND); also elsewhere on the board
SYS_08572049__HOST_3V3: J10001.2; also elsewhere on the board
SYS_a863a08a__CS1: J10002.5; also elsewhere on the board
SYS_aa321af6__CH1_MON_PERMIT: J10003.4; also elsewhere on the board
SYS_ce0a4f53__BOTH_CNV: J10002.1, J10002.4; also elsewhere on the board
SYS_ce166826__HOST_5: C10001.1, C10003.1, C10004.1, J10001.1, U10001.3 (EN), U10001.4 (IN), U10002.5 (V+), U10003.8 (VDD); also elsewhere on the board
SYS_d3eac10b__CH0_EXT_SUP_OK: J10003.1; also elsewhere on the board
SYS_de0a854a__CH1_EXT_SUP_OK: J10003.2; also elsewhere on the board
SYS_ec2c6e7f__CS0: J10002.2; also elsewhere on the board
SYS_f8e43b73__CH0_I_MON: J10004.1; also elsewhere on the board
SYS_fd7db492__CH1_DOUT: J10002.6; also elsewhere on the board
monitoring-cell__CH0_Q_INT: U10003.9 (S1B_RESET); also elsewhere on the board
monitoring-cell__CH0_SUM: U10003.10 (D1); also elsewhere on the board
monitoring-cell__CH1_Q_INT: U10003.7 (S2B_RESET); also elsewhere on the board
monitoring-cell__CH1_SUM: U10003.6 (D2); also elsewhere on the board
monitoring-cell__I_HI: R10003.2, R10004.1; also elsewhere on the board
monitoring-cell__I_LO: R10004.2, R10005.1; also elsewhere on the board
monitoring-cell__MID_DIV: R10001.2, R10002.1, U10002.1 (IN+)

Notes on the sheet:
ARTIFICIAL ELECTRICAL LOADS ONLY / FIRST MONITORING SLICE
No current driver, HV router, differential compliance circuit, independent watchdog, MCU or PCB is completed here.
V_REF=4.096V; V_MID=2.048V. Low INT_RUN resets; high opens reset for continuous signed integration.
I_LO=1.04757V / I_HI=3.04843V nominal (~+/-25.01mA). Threshold is NOT a proven complete-waveform cap.
EXT_SUP_OK must stay LOW until external rails/reference/watchdog/compliance/duration checks pass.
Two INA241 channels alone: up to32mW at5V. Input bias25..45uA/input is an unresolved leakage/bypass term.
Named global nets connect sheets; connectors remain explicit external design contracts. Read README before interpretation.

Schematic: channel0.kicad_sch, ATO S4 / Source 0: current and phase charge

Parts:
C10100: 22n 0.5% C0G; C_0805_2012Metric
C10101: 1n C0G; C_0805_2012Metric
C10102, C10103, C10104, C10108, C10109, C10110: 100n 10V; C_0805_2012Metric
C10105, C10106: 1u 10V; C_0805_2012Metric
C10107: 22u 10V; C_0805_2012Metric
J10100: SOURCE 0 RETURN SHUNT; PinHeader_1x02_P2.54mm_Vertical
J10101: SOURCE 0 DRIVER PERMISSION; PinHeader_1x03_P2.54mm_Vertical
R10100: 2R 0.1% KELVIN; R_0805_2012Metric
R10101: 10k 0.1%; R_0805_2012Metric
R10102: 33R; R_0805_2012Metric
R10103, R10104, R10105: 100k; R_0805_2012Metric
U10100: INA241A2IDR; SOIC-8_3.9x4.9mm_P1.27mm
U10101, U10102: OPA391DCKR; SOT-353_SC-70-5
U10103: ADS8866IDGSR; MSOP-10_3x3mm_P0.5mm
U10104: TLV3202IDR; SOIC-8_3.9x4.9mm_P1.27mm
U10105: SN74LVC1G11DBVR; SOT-23-6
U10106: SN74LVC1G74DCUR; VSSOP-8_2.3x2mm_P0.5mm

Connections:
SYS_0d1e7c21__CH0_RETURN_LOAD: J10100.1, R10100.1, U10100.8 (IN+)
SYS_4f66f129__MON_VREF: C10107.1, U10103.1 (REF); also elsewhere on the board
SYS_7cf9dad5__MON_SCLK: U10103.8 (SCLK); also elsewhere on the board
SYS_37cfe02a__MON_VMID: U10100.3 (REF2), U10100.7 (REF1), U10101.1 (IN+); also elsewhere on the board
SYS_56ebc071__CH0_MON_PERMIT: J10101.1, R10105.1, U10106.5 (Q_PERMIT); also elsewhere on the board
SYS_83a198be__CH0_DOUT: U10103.7 (DOUT); also elsewhere on the board
SYS_822d2245__MON_REARM0: R10104.1, U10106.1 (CLK_REARM); also elsewhere on the board
SYS_56562df4__GND: C10101.2, C10102.2, C10103.2, C10104.2, C10105.2, C10106.2, C10107.2, C10108.2, C10109.2, C10110.2, J10101.3, R10103.2, R10104.2, R10105.2, U10100.2 (GND), U10100.4 (NC=GND), U10101.2 (V-), U10102.2 (V-), U10103.4 (AINN), U10103.5 (GND), U10104.4 (GND), U10105.2 (GND), U10106.4 (GND); also elsewhere on the board
SYS_08572049__HOST_3V3: C10105.1, C10106.1, C10109.1, C10110.1, U10103.2 (AVDD), U10103.10 (DVDD), U10105.5 (VCC), U10106.2 (D), U10106.7 (PRE_N), U10106.8 (VCC); also elsewhere on the board
SYS_ce0a4f53__BOTH_CNV: U10103.6 (CONVST); also elsewhere on the board
SYS_ce166826__HOST_5: C10102.1, C10103.1, C10104.1, C10108.1, U10100.6 (VS), U10101.5 (V+), U10102.5 (V+), U10104.8 (VCC); also elsewhere on the board
SYS_d3eac10b__CH0_EXT_SUP_OK: J10101.2, R10103.1, U10105.6 (C_EXT_SUP_OK); also elsewhere on the board
SYS_ec2c6e7f__CS0: U10103.9 (DIN/CS_N); also elsewhere on the board
SYS_ee476f53__CH0_B_BR: J10100.2, R10100.2, U10100.1 (IN-)
SYS_f8e43b73__CH0_I_MON: R10101.1, U10100.5 (OUT), U10104.2 (1IN-), U10104.5 (2IN+); also elsewhere on the board
monitoring-cell__CH0_ADC_BUF: R10102.1, U10102.3 (IN-), U10102.4 (OUT)
monitoring-cell__CH0_ADC_IN: C10101.1, R10102.2, U10103.3 (AINP)
monitoring-cell__CH0_CLEAR_N: U10105.4 (Y_CLR_N), U10106.6 (CLR_N)
monitoring-cell__CH0_HI_OK: U10104.1 (HI_OK), U10105.1 (A_HI_OK)
monitoring-cell__CH0_LO_OK: U10104.7 (LO_OK), U10105.3 (B_LO_OK)
monitoring-cell__CH0_Q_INT: C10100.2, U10101.4 (OUT), U10102.1 (IN+); also elsewhere on the board
monitoring-cell__CH0_SUM: C10100.1, R10101.2, U10101.3 (IN-); also elsewhere on the board
monitoring-cell__I_HI: U10104.3 (1IN+); also elsewhere on the board
monitoring-cell__I_LO: U10104.6 (2IN-); also elsewhere on the board

Notes on the sheet:
ARTIFICIAL ELECTRICAL LOADS ONLY / FIRST MONITORING SLICE
No current driver, HV router, differential compliance circuit, independent watchdog, MCU or PCB is completed here.
Q=-10k*22n/40*(V_end-V_start); 600nC=109.091mV nominal. Take BASELINE, CATH, ANODE, NET/TAIL endpoints.
Cathodic and anodic charges remain separate. Opposed phases can cancel: final net alone cannot qualify delivery.
Actual current-tail/window evidence is required. Command edges, the comparator or an ideal16-bit LSB do not certify precision.
CLRN = HI_OK AND LO_OK AND EXT_SUP_OK. Any low latches Q off; rising REARM admits only while CLRN is high.

Schematic: channel1.kicad_sch, ATO S4 / Source 1: current and phase charge

Parts:
C10200: 22n 0.5% C0G; C_0805_2012Metric
C10201: 1n C0G; C_0805_2012Metric
C10202, C10203, C10204, C10208, C10209, C10210: 100n 10V; C_0805_2012Metric
C10205, C10206: 1u 10V; C_0805_2012Metric
C10207: 22u 10V; C_0805_2012Metric
J10200: SOURCE 1 RETURN SHUNT; PinHeader_1x02_P2.54mm_Vertical
J10201: SOURCE 1 DRIVER PERMISSION; PinHeader_1x03_P2.54mm_Vertical
R10200: 2R 0.1% KELVIN; R_0805_2012Metric
R10201: 10k 0.1%; R_0805_2012Metric
R10202: 33R; R_0805_2012Metric
R10203, R10204, R10205: 100k; R_0805_2012Metric
U10200: INA241A2IDR; SOIC-8_3.9x4.9mm_P1.27mm
U10201, U10202: OPA391DCKR; SOT-353_SC-70-5
U10203: ADS8866IDGSR; MSOP-10_3x3mm_P0.5mm
U10204: TLV3202IDR; SOIC-8_3.9x4.9mm_P1.27mm
U10205: SN74LVC1G11DBVR; SOT-23-6
U10206: SN74LVC1G74DCUR; VSSOP-8_2.3x2mm_P0.5mm

Connections:
SYS_3ced048f__CH1_RETURN_LOAD: J10200.1, R10200.1, U10200.8 (IN+)
SYS_4f66f129__MON_VREF: C10207.1, U10203.1 (REF); also elsewhere on the board
SYS_7cf9dad5__MON_SCLK: U10203.8 (SCLK); also elsewhere on the board
SYS_32a601bf__MON_REARM1: R10204.1, U10206.1 (CLK_REARM); also elsewhere on the board
SYS_37cfe02a__MON_VMID: U10200.3 (REF2), U10200.7 (REF1), U10201.1 (IN+); also elsewhere on the board
SYS_502efdd4__CH1_I_MON: R10201.1, U10200.5 (OUT), U10204.2 (1IN-), U10204.5 (2IN+); also elsewhere on the board
SYS_56562df4__GND: C10201.2, C10202.2, C10203.2, C10204.2, C10205.2, C10206.2, C10207.2, C10208.2, C10209.2, C10210.2, J10201.3, R10203.2, R10204.2, R10205.2, U10200.2 (GND), U10200.4 (NC=GND), U10201.2 (V-), U10202.2 (V-), U10203.4 (AINN), U10203.5 (GND), U10204.4 (GND), U10205.2 (GND), U10206.4 (GND); also elsewhere on the board
SYS_08572049__HOST_3V3: C10205.1, C10206.1, C10209.1, C10210.1, U10203.2 (AVDD), U10203.10 (DVDD), U10205.5 (VCC), U10206.2 (D), U10206.7 (PRE_N), U10206.8 (VCC); also elsewhere on the board
SYS_a863a08a__CS1: U10203.9 (DIN/CS_N); also elsewhere on the board
SYS_aa321af6__CH1_MON_PERMIT: J10201.1, R10205.1, U10206.5 (Q_PERMIT); also elsewhere on the board
SYS_c73180be__CH1_B_BR: J10200.2, R10200.2, U10200.1 (IN-)
SYS_ce0a4f53__BOTH_CNV: U10203.6 (CONVST); also elsewhere on the board
SYS_ce166826__HOST_5: C10202.1, C10203.1, C10204.1, C10208.1, U10200.6 (VS), U10201.5 (V+), U10202.5 (V+), U10204.8 (VCC); also elsewhere on the board
SYS_de0a854a__CH1_EXT_SUP_OK: J10201.2, R10203.1, U10205.6 (C_EXT_SUP_OK); also elsewhere on the board
SYS_fd7db492__CH1_DOUT: U10203.7 (DOUT); also elsewhere on the board
monitoring-cell__CH1_ADC_BUF: R10202.1, U10202.3 (IN-), U10202.4 (OUT)
monitoring-cell__CH1_ADC_IN: C10201.1, R10202.2, U10203.3 (AINP)
monitoring-cell__CH1_CLEAR_N: U10205.4 (Y_CLR_N), U10206.6 (CLR_N)
monitoring-cell__CH1_HI_OK: U10204.1 (HI_OK), U10205.1 (A_HI_OK)
monitoring-cell__CH1_LO_OK: U10204.7 (LO_OK), U10205.3 (B_LO_OK)
monitoring-cell__CH1_Q_INT: C10200.2, U10201.4 (OUT), U10202.1 (IN+); also elsewhere on the board
monitoring-cell__CH1_SUM: C10200.1, R10201.2, U10201.3 (IN-); also elsewhere on the board
monitoring-cell__I_HI: U10204.3 (1IN+); also elsewhere on the board
monitoring-cell__I_LO: U10204.6 (2IN-); also elsewhere on the board

Notes on the sheet:
ARTIFICIAL ELECTRICAL LOADS ONLY / FIRST MONITORING SLICE
No current driver, HV router, differential compliance circuit, independent watchdog, MCU or PCB is completed here.
Q=-10k*22n/40*(V_end-V_start); 600nC=109.091mV nominal. Take BASELINE, CATH, ANODE, NET/TAIL endpoints.
Cathodic and anodic charges remain separate. Opposed phases can cancel: final net alone cannot qualify delivery.
Actual current-tail/window evidence is required. Command edges, the comparator or an ideal16-bit LSB do not certify precision.
CLRN = HI_OK AND LO_OK AND EXT_SUP_OK. Any low latches Q off; rising REARM admits only while CLRN is high.
