pratham-cloud-ctrl/Project-ATO/electronics/stage4/integrated-pcb/boards/monitoring-cell/monitoring_cell.kicad_pcb

## KiCad design electronics/stage4/integrated-pcb/boards/monitoring-cell/monitoring_cell.kicad_pcb (continued)

Schematic: integration_taps.kicad_sch, ATO / monitoring-cell integration taps

Parts:
J19901: HOST TAP HARNESS; PinHeader_1x02_P2.54mm_Vertical

Connections:
SYS_4f66f129__MON_VREF: J19901.1; also elsewhere on the board
SYS_56562df4__GND: J19901.2; also elsewhere on the board

Notes on the sheet:
INTEGRATED COMPONENT-TAP HARNESS / monitoring-cell
Physical headers expose actual earlier component taps. Original connectors remain available.
Only named electrical nets connect. AFE, HOST and companion grounds remain distinct.
Artificial-load digital design. Added wiring capacitance and connector integrity require measurement.


Board: 4 copper layers, 120.0 x 145.0 mm, 75 parts (0 on the bottom side), 42 nets.

Other parts of the board:
H1, H2, H3, H4: MountingHole_3.2mm_M3
