pratham-cloud-ctrl/Project-ATO/electronics/stage4/integrated-pcb/boards/controller-carrier/controller_carrier.kicad_pcb

## KiCad design electronics/stage4/integrated-pcb/boards/controller-carrier/controller_carrier.kicad_pcb (2026-10-16)

Schematic: controller_carrier.kicad_sch, ATO S4 / Controller carrier / interface index

Parts:
J80001: HOST POWER; PinHeader_1x02_P2.54mm_Vertical

Connections:
SYS_56562df4__GND: J80001.2; also elsewhere on the board
SYS_08572049__HOST_3V3: J80001.1; also elsewhere on the board

Notes on the sheet:
DIGITAL SCCI ENGINEERING / ARTIFICIAL SIGNALS / nRF5340 CONTROLLER CARRIER
46 actual GPIO, explicit common CNV/rearm and physical 32-bit health/readback chain. Radio remains disabled.

Schematic: processor.kicad_sch, ATO S4 / BT40F / actual nRF5340 physical pads

Parts:
U80001: FANSTEL BT40F / nRF5340; BT40F_Manufacturer_66Pad

Connections:
SYS_0d7c406c__MON_MISO: U80001.C2 (P0.21); also elsewhere on the board
SYS_1fbf7500__ROUTE_ACTIVE_BITS_VERIFIED: U80001.6 (P0.05); also elsewhere on the board
SYS_3abe1caf__BOTH_DRV_REARM: U80001.E2 (P1.06); also elsewhere on the board
SYS_3b27d056__MINUS0: U80001.2 (P1.03); also elsewhere on the board
SYS_4d4028f1__AFE_MOSI: U80001.B3 (P0.14); also elsewhere on the board
SYS_4dbe75ce__AFE_MISO: U80001.B4 (P0.15); also elsewhere on the board
SYS_5fca782c__RAW_SDO: U80001.E6 (P0.10); also elsewhere on the board
SYS_6e45b638__HOST_UART_TX: U80001.Z3 (P1.12); also elsewhere on the board
SYS_7cf9dad5__MON_SCLK: U80001.C5 (P0.20); also elsewhere on the board
SYS_7db86ec0__PHASE_REARM0: U80001.Z1 (P1.10); also elsewhere on the board
SYS_8b29b23f__AFE_CONNECT: U80001.B2 (P0.17); also elsewhere on the board
SYS_11f4403a__ROUTE_SER: U80001.13 (P0.30); also elsewhere on the board
SYS_18e49fe8__AFE_CS_ASSERT: U80001.A4 (P0.16); also elsewhere on the board
SYS_32a601bf__MON_REARM1: U80001.D3 (P0.28); also elsewhere on the board
SYS_36b0932b__INT_RUN1: U80001.D1 (P0.26); also elsewhere on the board
SYS_46e29157__PHASE_REARM1: U80001.Z2 (P1.11); also elsewhere on the board
SYS_46ea5f03__CH0_REQUEST: U80001.A5 (P1.00); also elsewhere on the board
SYS_75de6c03__RAW_RST_N: U80001.B5 (P0.12); also elsewhere on the board
SYS_83ddb634__CH1_WANT_ROUTE: U80001.A2 (P0.07); also elsewhere on the board
SYS_628d7747__PLUS1: U80001.E0 (P1.04); also elsewhere on the board
SYS_822d2245__MON_REARM0: U80001.D2 (P0.27); also elsewhere on the board
SYS_919c5ac8__HOST_UART_RX: U80001.Z4 (P1.13); also elsewhere on the board
SYS_973f460c__PLUS0: U80001.1 (P1.02); also elsewhere on the board
SYS_37737e7c__INT_RUN0: U80001.C6 (P0.25); also elsewhere on the board
SYS_054848d0__RAW_CS_N: U80001.12 (P0.11); also elsewhere on the board
SYS_56562df4__GND: U80001.10 (GND), U80001.A0 (GND), U80001.B0 (GND), U80001.C0 (GND), U80001.D0 (GND), U80001.H0 (GND), U80001.H1 (GND), U80001.H2 (GND), U80001.H3 (GND); also elsewhere on the board
SYS_95016e07__RAW_SCLK: U80001.A3 (P0.08); also elsewhere on the board
SYS_66316879__RAW_SDI: U80001.11 (P0.09); also elsewhere on the board
SYS_82531809__FAULT_RESET: U80001.A6 (P1.08); also elsewhere on the board
SYS_a863a08a__CS1: U80001.C3 (P0.24); also elsewhere on the board
SYS_a9673f8c__AFE_RECORD: U80001.F3 (P0.18); also elsewhere on the board
SYS_b6a3943c__ROUTE_COMMIT: U80001.8 (P0.03); also elsewhere on the board
SYS_bb444a6e__SUP_REARM: U80001.E3 (P1.07); also elsewhere on the board
SYS_ce0a4f53__BOTH_CNV: U80001.D5 (P0.22); also elsewhere on the board
SYS_ce1178b4__AFE_FAULT_N: U80001.B1 (P0.19); also elsewhere on the board
SYS_d5e1f64a__ROUTE_SRCLK: U80001.D4 (P0.29); also elsewhere on the board
SYS_dd388269__CH1_REQUEST: U80001.D6 (P1.01); also elsewhere on the board
SYS_e3faaec0__WDI: U80001.Z0 (P1.09); also elsewhere on the board
SYS_e338b670__CH0_WANT_ROUTE: U80001.A1 (P0.06); also elsewhere on the board
SYS_e496c0b2__DAC_SYNC_N: U80001.C1 (P0.31); also elsewhere on the board
SYS_ec2c6e7f__CS0: U80001.C4 (P0.23); also elsewhere on the board
SYS_ed4497b7__ROUTE_REARM: U80001.5 (P0.04); also elsewhere on the board
SYS_edc800df__MINUS1: U80001.E1 (P1.05); also elsewhere on the board
SYS_f30c60de__AFE_SCLK: U80001.B6 (P0.13); also elsewhere on the board
SYS_fd131f77__ROUTE_PRELOAD_LATCH: U80001.7 (P0.02); also elsewhere on the board
controller-carrier__MCU_3V3: U80001.9 (VDD), U80001.F4 (VDDH); also elsewhere on the board
controller-carrier__MCU_RESET_N: U80001.14 (RESET_N); also elsewhere on the board
controller-carrier__SIDEBAND_DATA: U80001.Z6 (P1.15); also elsewhere on the board
controller-carrier__SIDEBAND_LOAD_N: U80001.Z5 (P1.14); also elsewhere on the board
controller-carrier__SWCLK: U80001.15 (SWCLK); also elsewhere on the board
controller-carrier__SWDIO: U80001.16 (SWDIO); also elsewhere on the board

Notes on the sheet:
DIGITAL SCCI ENGINEERING / ARTIFICIAL SIGNALS / nRF5340 CONTROLLER CARRIER
46 actual GPIO, explicit common CNV/rearm and physical 32-bit health/readback chain. Radio remains disabled.
All labels are native electrical connections. Digital artificial-load interface; no clinical, chronic or body-radio qualification.
Hardware permissions and terminal guards remain independent of transport. Loss of data rejects the observation.

Schematic: power.kicad_sch, ATO S4 / Module normal-voltage supply and SWD

Parts:
C80001: 47u X7R 10V; C_1206_3216Metric
C80002: 1u X7R 10V; C_1206_3216Metric
C80003: 100n X7R 10V; C_1206_3216Metric
J80002: SWD / TARGET VREF; PinHeader_1x06_P2.54mm_Vertical
J80003: RESET SHORTING HEADER; PinHeader_1x02_P2.54mm_Vertical
R80001: 0R; R_0805_2012Metric
R80002: 10k; R_0805_2012Metric

Connections:
SYS_56562df4__GND: C80001.2, C80002.2, C80003.2, J80002.3, J80002.6, J80003.2; also elsewhere on the board
SYS_08572049__HOST_3V3: R80001.1; also elsewhere on the board
controller-carrier__MCU_3V3: C80001.1, C80002.1, C80003.1, J80002.1, R80001.2, R80002.1; also elsewhere on the board
controller-carrier__MCU_RESET_N: J80002.5, J80003.1, R80002.2; also elsewhere on the board
controller-carrier__SWCLK: J80002.4; also elsewhere on the board
controller-carrier__SWDIO: J80002.2; also elsewhere on the board

Notes on the sheet:
DIGITAL SCCI ENGINEERING / ARTIFICIAL SIGNALS / nRF5340 CONTROLLER CARRIER
46 actual GPIO, explicit common CNV/rearm and physical 32-bit health/readback chain. Radio remains disabled.
All labels are native electrical connections. Digital artificial-load interface; no clinical, chronic or body-radio qualification.
Hardware permissions and terminal guards remain independent of transport. Loss of data rejects the observation.

Schematic: sideband.kicad_sch, ATO S4 / Four physical 165 devices / parallel observations

Parts:
C80010, C80011, C80012, C80013: 100n X7R 10V; C_1206_3216Metric
U80010, U80011, U80012, U80013: SN74LVC165APWR; TSSOP-16_4.4x5mm_P0.65mm

Connections:
SYS_0cbf1bda__CH1_ADDR1: U80010.13 (C); also elsewhere on the board
SYS_2d0e5b2e__CH0_QUIESCENT_OK: U80011.14 (D); also elsewhere on the board
SYS_5aed2944__CH0_ADDR2: U80010.4 (F); also elsewhere on the board
SYS_6a132103__CH1_RUN: U80012.14 (D); also elsewhere on the board
SYS_6c012064__ROUTE_COMMAND_READY: U80012.11 (A); also elsewhere on the board
SYS_08e41150__CH0_ADDR1: U80010.5 (G); also elsewhere on the board
SYS_9c8a42b1__CH1_TIMEOUT: U80013.5 (G); also elsewhere on the board
SYS_20eba8c2__CH1_QUIESCENT_OK: U80011.13 (C); also elsewhere on the board
SYS_54dd20d7__CH0_TIMEOUT: U80013.6 (H); also elsewhere on the board
SYS_56ebc071__CH0_MON_PERMIT: U80011.12 (B); also elsewhere on the board
SYS_77c24b0d__GLOBAL_GUARD_EN: U80012.4 (F); also elsewhere on the board
SYS_88c50083__SUP_ARMED: U80012.5 (G); also elsewhere on the board
SYS_695f3a7c__CH0_RUN: U80012.3 (E); also elsewhere on the board
SYS_56562df4__GND: C80010.2, C80011.2, C80012.2, C80013.2, U80010.8 (GND), U80010.15 (CLK_INH), U80011.8 (GND), U80011.15 (CLK_INH), U80012.8 (GND), U80012.15 (CLK_INH), U80013.3 (E), U80013.8 (GND), U80013.10 (SER), U80013.12 (B), U80013.14 (D), U80013.15 (CLK_INH); also elsewhere on the board
SYS_087068cd__CH0_ADDR0: U80010.6 (H); also elsewhere on the board
SYS_98321c7b__AFE_ISOLATED_READY: U80011.3 (E); also elsewhere on the board
SYS_08572049__HOST_3V3: C80010.1, C80011.1, C80012.1, C80013.1, U80010.16 (VCC), U80011.16 (VCC), U80012.16 (VCC), U80013.4 (F), U80013.11 (A), U80013.13 (C), U80013.16 (VCC); also elsewhere on the board
SYS_93547907__RAILS_QUALIFIED: U80011.5 (G); also elsewhere on the board
SYS_a83d484c__WATCHDOG_OK: U80011.4 (F); also elsewhere on the board
SYS_aa321af6__CH1_MON_PERMIT: U80011.11 (A); also elsewhere on the board
SYS_b6ef4aed__CH1_ADDR3: U80010.11 (A); also elsewhere on the board
SYS_c3abe6bc__CH1_ADDR0: U80010.14 (D); also elsewhere on the board
SYS_c659d53f__CH1_TIMER: U80012.12 (B); also elsewhere on the board
SYS_ca7ea3db__CH0_TIMER: U80012.13 (C); also elsewhere on the board
SYS_d5e1f64a__ROUTE_SRCLK: U80010.2 (CLK), U80011.2 (CLK), U80012.2 (CLK), U80013.2 (CLK); also elsewhere on the board
SYS_ee59c76b__PWR_FAULT_N: U80012.6 (H); also elsewhere on the board
SYS_f373e353__CH1_ADDR2: U80010.12 (B); also elsewhere on the board
SYS_f7756399__CH0_ADDR3: U80010.3 (E); also elsewhere on the board
SYS_ff7fdc58__RESET_READY: U80011.6 (H); also elsewhere on the board
controller-carrier__SB_Q1: U80010.10 (SER), U80011.9 (QH)
controller-carrier__SB_Q2: U80011.10 (SER), U80012.9 (QH)
controller-carrier__SB_Q3: U80012.10 (SER), U80013.9 (QH)
controller-carrier__SIDEBAND_DATA: U80010.9 (QH); also elsewhere on the board
controller-carrier__SIDEBAND_LOAD_N: U80010.1 (SH_LD_N), U80011.1 (SH_LD_N), U80012.1 (SH_LD_N), U80013.1 (SH_LD_N); also elsewhere on the board

Notes on the sheet:
DIGITAL SCCI ENGINEERING / ARTIFICIAL SIGNALS / nRF5340 CONTROLLER CARRIER
46 actual GPIO, explicit common CNV/rearm and physical 32-bit health/readback chain. Radio remains disabled.
All labels are native electrical connections. Digital artificial-load interface; no clinical, chronic or body-radio qualification.
Hardware permissions and terminal guards remain independent of transport. Loss of data rejects the observation.

Schematic: handoff.kicad_sch, ATO S4 / Matched peripheral handoff connectors

Parts:
J80010: RAW MONITOR; PinHeader_1x06_P2.54mm_Vertical
J80011: ISOLATED RECORDING HOST; PinHeader_1x10_P2.54mm_Vertical
J80012: SHARED CHARGE ENDPOINT SPI; PinHeader_1x07_P2.54mm_Vertical
J80013: DOSE / MONITOR REARM; PinHeader_1x05_P2.54mm_Vertical

Connections:
SYS_0d7c406c__MON_MISO: J80012.2; also elsewhere on the board
SYS_4d4028f1__AFE_MOSI: J80011.4; also elsewhere on the board
SYS_4dbe75ce__AFE_MISO: J80011.6; also elsewhere on the board
SYS_5fca782c__RAW_SDO: J80010.3; also elsewhere on the board
SYS_7cf9dad5__MON_SCLK: J80012.1; also elsewhere on the board
SYS_8b29b23f__AFE_CONNECT: J80011.7; also elsewhere on the board
SYS_18e49fe8__AFE_CS_ASSERT: J80011.5; also elsewhere on the board
SYS_32a601bf__MON_REARM1: J80013.4; also elsewhere on the board
SYS_36b0932b__INT_RUN1: J80013.2; also elsewhere on the board
SYS_75de6c03__RAW_RST_N: J80010.5; also elsewhere on the board
SYS_822d2245__MON_REARM0: J80013.3; also elsewhere on the board
SYS_37737e7c__INT_RUN0: J80013.1; also elsewhere on the board
SYS_054848d0__RAW_CS_N: J80010.4; also elsewhere on the board
SYS_56562df4__GND: J80010.6, J80011.2, J80011.10, J80012.7, J80013.5; also elsewhere on the board
SYS_95016e07__RAW_SCLK: J80010.1; also elsewhere on the board
SYS_08572049__HOST_3V3: J80011.1; also elsewhere on the board
SYS_66316879__RAW_SDI: J80010.2; also elsewhere on the board
SYS_a863a08a__CS1: J80012.6; also elsewhere on the board
SYS_a9673f8c__AFE_RECORD: J80011.8; also elsewhere on the board
SYS_ce0a4f53__BOTH_CNV: J80012.3, J80012.5; also elsewhere on the board
SYS_ce1178b4__AFE_FAULT_N: J80011.9; also elsewhere on the board
SYS_ec2c6e7f__CS0: J80012.4; also elsewhere on the board
SYS_f30c60de__AFE_SCLK: J80011.3; also elsewhere on the board

Notes on the sheet:
DIGITAL SCCI ENGINEERING / ARTIFICIAL SIGNALS / nRF5340 CONTROLLER CARRIER
46 actual GPIO, explicit common CNV/rearm and physical 32-bit health/readback chain. Radio remains disabled.
All labels are native electrical connections. Digital artificial-load interface; no clinical, chronic or body-radio qualification.
Hardware permissions and terminal guards remain independent of transport. Loss of data rejects the observation.

Schematic: handoff_2.kicad_sch, ATO S4 / Matched peripheral handoff connectors / 2

Parts:
J80014: DAC SERIAL; PinHeader_1x04_P2.54mm_Vertical
J80015: DRIVER REQUEST / POLARITY; PinHeader_1x09_P2.54mm_Vertical
J80016: ROUTE CANDIDATE / COMMIT; PinHeader_1x09_P2.54mm_Vertical
J80017: ACTIVE ROUTE READBACK; PinHeader_1x09_P2.54mm_Vertical

Connections:
SYS_0cbf1bda__CH1_ADDR1: J80017.6; also elsewhere on the board
SYS_1fbf7500__ROUTE_ACTIVE_BITS_VERIFIED: J80016.6; also elsewhere on the board
SYS_3abe1caf__BOTH_DRV_REARM: J80015.4, J80015.8; also elsewhere on the board
SYS_3b27d056__MINUS0: J80015.3; also elsewhere on the board
SYS_5aed2944__CH0_ADDR2: J80017.3; also elsewhere on the board
SYS_08e41150__CH0_ADDR1: J80017.2; also elsewhere on the board
SYS_11f4403a__ROUTE_SER: J80014.3, J80016.1; also elsewhere on the board
SYS_46ea5f03__CH0_REQUEST: J80015.1; also elsewhere on the board
SYS_83ddb634__CH1_WANT_ROUTE: J80016.8; also elsewhere on the board
SYS_628d7747__PLUS1: J80015.6; also elsewhere on the board
SYS_973f460c__PLUS0: J80015.2; also elsewhere on the board
SYS_56562df4__GND: J80014.4, J80015.9, J80016.9, J80017.9; also elsewhere on the board
SYS_087068cd__CH0_ADDR0: J80017.1; also elsewhere on the board
SYS_b6a3943c__ROUTE_COMMIT: J80016.4; also elsewhere on the board
SYS_b6ef4aed__CH1_ADDR3: J80017.8; also elsewhere on the board
SYS_c3abe6bc__CH1_ADDR0: J80017.5; also elsewhere on the board
SYS_d5e1f64a__ROUTE_SRCLK: J80014.1, J80016.2; also elsewhere on the board
SYS_dd388269__CH1_REQUEST: J80015.5; also elsewhere on the board
SYS_e338b670__CH0_WANT_ROUTE: J80016.7; also elsewhere on the board
SYS_e496c0b2__DAC_SYNC_N: J80014.2; also elsewhere on the board
SYS_ed4497b7__ROUTE_REARM: J80016.5; also elsewhere on the board
SYS_edc800df__MINUS1: J80015.7; also elsewhere on the board
SYS_f373e353__CH1_ADDR2: J80017.7; also elsewhere on the board
SYS_f7756399__CH0_ADDR3: J80017.4; also elsewhere on the board
SYS_fd131f77__ROUTE_PRELOAD_LATCH: J80016.3; also elsewhere on the board

Notes on the sheet:
DIGITAL SCCI ENGINEERING / ARTIFICIAL SIGNALS / nRF5340 CONTROLLER CARRIER
46 actual GPIO, explicit common CNV/rearm and physical 32-bit health/readback chain. Radio remains disabled.
All labels are native electrical connections. Digital artificial-load interface; no clinical, chronic or body-radio qualification.
Hardware permissions and terminal guards remain independent of transport. Loss of data rejects the observation.

Schematic: handoff_3.kicad_sch, ATO S4 / Matched peripheral handoff connectors / 3

Parts:
J80018: SUPERVISION CONTROL; PinHeader_1x08_P2.54mm_Vertical
J80019: NATIVE HEALTH OBSERVATIONS; PinHeader_1x19_P2.54mm_Vertical
J80020: ISOLATED COMPANION HOST UART; PinHeader_1x04_P2.54mm_Vertical

Connections:
SYS_2d0e5b2e__CH0_QUIESCENT_OK: J80019.5; also elsewhere on the board
SYS_6a132103__CH1_RUN: J80019.13; also elsewhere on the board
SYS_6c012064__ROUTE_COMMAND_READY: J80019.16; also elsewhere on the board
SYS_6e45b638__HOST_UART_TX: J80020.1; also elsewhere on the board
SYS_7db86ec0__PHASE_REARM0: J80018.6; also elsewhere on the board
SYS_9c8a42b1__CH1_TIMEOUT: J80019.18; also elsewhere on the board
SYS_20eba8c2__CH1_QUIESCENT_OK: J80019.6; also elsewhere on the board
SYS_46e29157__PHASE_REARM1: J80018.7; also elsewhere on the board
SYS_46ea5f03__CH0_REQUEST: J80018.4; also elsewhere on the board
SYS_54dd20d7__CH0_TIMEOUT: J80019.17; also elsewhere on the board
SYS_56ebc071__CH0_MON_PERMIT: J80019.7; also elsewhere on the board
SYS_77c24b0d__GLOBAL_GUARD_EN: J80019.11; also elsewhere on the board
SYS_88c50083__SUP_ARMED: J80019.10; also elsewhere on the board
SYS_695f3a7c__CH0_RUN: J80019.12; also elsewhere on the board
SYS_919c5ac8__HOST_UART_RX: J80020.2; also elsewhere on the board
SYS_56562df4__GND: J80018.8, J80019.19, J80020.4; also elsewhere on the board
SYS_98321c7b__AFE_ISOLATED_READY: J80019.4; also elsewhere on the board
SYS_08572049__HOST_3V3: J80020.3; also elsewhere on the board
SYS_82531809__FAULT_RESET: J80018.2; also elsewhere on the board
SYS_93547907__RAILS_QUALIFIED: J80019.2; also elsewhere on the board
SYS_a83d484c__WATCHDOG_OK: J80019.3; also elsewhere on the board
SYS_aa321af6__CH1_MON_PERMIT: J80019.8; also elsewhere on the board
SYS_bb444a6e__SUP_REARM: J80018.1; also elsewhere on the board
SYS_c659d53f__CH1_TIMER: J80019.15; also elsewhere on the board
SYS_ca7ea3db__CH0_TIMER: J80019.14; also elsewhere on the board
SYS_dd388269__CH1_REQUEST: J80018.5; also elsewhere on the board
SYS_e3faaec0__WDI: J80018.3; also elsewhere on the board
SYS_ee59c76b__PWR_FAULT_N: J80019.9; also elsewhere on the board
SYS_ff7fdc58__RESET_READY: J80019.1; also elsewhere on the board

Notes on the sheet:
DIGITAL SCCI ENGINEERING / ARTIFICIAL SIGNALS / nRF5340 CONTROLLER CARRIER
46 actual GPIO, explicit common CNV/rearm and physical 32-bit health/readback chain. Radio remains disabled.
All labels are native electrical connections. Digital artificial-load interface; no clinical, chronic or body-radio qualification.
Hardware permissions and terminal guards remain independent of transport. Loss of data rejects the observation.

Schematic: defaults.kicad_sch, ATO S4 / Passive reset defaults / explicit recovery

Parts:
R80100, R80101, R80102, R80103, R80104, R80105, R80106, R80107, R80108, R80109, R80110, R80111, R80112, R80113: 10k; R_0805_2012Metric

Connections:
SYS_1fbf7500__ROUTE_ACTIVE_BITS_VERIFIED: R80103.1; also elsewhere on the board
SYS_4d4028f1__AFE_MOSI: R80111.1; also elsewhere on the board
SYS_8b29b23f__AFE_CONNECT: R80113.1; also elsewhere on the board
SYS_18e49fe8__AFE_CS_ASSERT: R80112.1; also elsewhere on the board
SYS_75de6c03__RAW_RST_N: R80109.1; also elsewhere on the board
SYS_83ddb634__CH1_WANT_ROUTE: R80105.1; also elsewhere on the board
SYS_054848d0__RAW_CS_N: R80108.2; also elsewhere on the board
SYS_56562df4__GND: R80100.2, R80101.2, R80102.2, R80103.2, R80104.2, R80105.2, R80106.2, R80107.2, R80109.2, R80110.2, R80111.2, R80112.2, R80113.2; also elsewhere on the board
SYS_95016e07__RAW_SCLK: R80106.1; also elsewhere on the board
SYS_08572049__HOST_3V3: R80108.1; also elsewhere on the board
SYS_66316879__RAW_SDI: R80107.1; also elsewhere on the board
SYS_b6a3943c__ROUTE_COMMIT: R80101.1; also elsewhere on the board
SYS_e338b670__CH0_WANT_ROUTE: R80104.1; also elsewhere on the board
SYS_ed4497b7__ROUTE_REARM: R80102.1; also elsewhere on the board
SYS_f30c60de__AFE_SCLK: R80110.1; also elsewhere on the board
SYS_fd131f77__ROUTE_PRELOAD_LATCH: R80100.1; also elsewhere on the board

Notes on the sheet:
DIGITAL SCCI ENGINEERING / ARTIFICIAL SIGNALS / nRF5340 CONTROLLER CARRIER
46 actual GPIO, explicit common CNV/rearm and physical 32-bit health/readback chain. Radio remains disabled.
All labels are native electrical connections. Digital artificial-load interface; no clinical, chronic or body-radio qualification.
Hardware permissions and terminal guards remain independent of transport. Loss of data rejects the observation.

Schematic: defaults_2.kicad_sch, ATO S4 / Passive reset defaults / explicit recovery / 2

Parts:
R80114, R80115, R80116, R80117, R80118, R80119, R80120, R80121, R80122, R80123, R80124, R80125, R80126, R80127: 10k; R_0805_2012Metric

Connections:
SYS_7cf9dad5__MON_SCLK: R80115.1; also elsewhere on the board
SYS_11f4403a__ROUTE_SER: R80124.1; also elsewhere on the board
SYS_32a601bf__MON_REARM1: R80122.1; also elsewhere on the board
SYS_36b0932b__INT_RUN1: R80120.2; also elsewhere on the board
SYS_46ea5f03__CH0_REQUEST: R80126.1; also elsewhere on the board
SYS_822d2245__MON_REARM0: R80121.1; also elsewhere on the board
SYS_37737e7c__INT_RUN0: R80119.2; also elsewhere on the board
SYS_56562df4__GND: R80114.2, R80115.2, R80116.2, R80121.2, R80122.2, R80123.2, R80124.2, R80126.2, R80127.2; also elsewhere on the board
SYS_08572049__HOST_3V3: R80117.1, R80118.1, R80119.1, R80120.1, R80125.1; also elsewhere on the board
SYS_a863a08a__CS1: R80118.2; also elsewhere on the board
SYS_a9673f8c__AFE_RECORD: R80114.1; also elsewhere on the board
SYS_ce0a4f53__BOTH_CNV: R80116.1; also elsewhere on the board
SYS_d5e1f64a__ROUTE_SRCLK: R80123.1; also elsewhere on the board
SYS_dd388269__CH1_REQUEST: R80127.1; also elsewhere on the board
SYS_e496c0b2__DAC_SYNC_N: R80125.2; also elsewhere on the board
SYS_ec2c6e7f__CS0: R80117.2; also elsewhere on the board

Notes on the sheet:
DIGITAL SCCI ENGINEERING / ARTIFICIAL SIGNALS / nRF5340 CONTROLLER CARRIER
46 actual GPIO, explicit common CNV/rearm and physical 32-bit health/readback chain. Radio remains disabled.
All labels are native electrical connections. Digital artificial-load interface; no clinical, chronic or body-radio qualification.
Hardware permissions and terminal guards remain independent of transport. Loss of data rejects the observation.

Schematic: defaults_3.kicad_sch, ATO S4 / Passive reset defaults / explicit recovery / 3

Parts:
R80128, R80129, R80130, R80131, R80132, R80133, R80134, R80135, R80136, R80137, R80138, R80139: 10k; R_0805_2012Metric

Connections:
SYS_3abe1caf__BOTH_DRV_REARM: R80132.1; also elsewhere on the board
SYS_3b27d056__MINUS0: R80129.1; also elsewhere on the board
SYS_6e45b638__HOST_UART_TX: R80138.2; also elsewhere on the board
SYS_7db86ec0__PHASE_REARM0: R80136.1; also elsewhere on the board
SYS_46e29157__PHASE_REARM1: R80137.1; also elsewhere on the board
SYS_628d7747__PLUS1: R80130.1; also elsewhere on the board
SYS_973f460c__PLUS0: R80128.1; also elsewhere on the board
SYS_56562df4__GND: R80128.2, R80129.2, R80130.2, R80131.2, R80132.2, R80133.2, R80134.2, R80135.2, R80136.2, R80137.2; also elsewhere on the board
SYS_08572049__HOST_3V3: R80138.1, R80139.1; also elsewhere on the board
SYS_82531809__FAULT_RESET: R80134.1; also elsewhere on the board
SYS_bb444a6e__SUP_REARM: R80133.1; also elsewhere on the board
SYS_e3faaec0__WDI: R80135.1; also elsewhere on the board
SYS_edc800df__MINUS1: R80131.1; also elsewhere on the board
controller-carrier__SIDEBAND_LOAD_N: R80139.2; also elsewhere on the board

Notes on the sheet:
DIGITAL SCCI ENGINEERING / ARTIFICIAL SIGNALS / nRF5340 CONTROLLER CARRIER
46 actual GPIO, explicit common CNV/rearm and physical 32-bit health/readback chain. Radio remains disabled.
All labels are native electrical connections. Digital artificial-load interface; no clinical, chronic or body-radio qualification.
Hardware permissions and terminal guards remain independent of transport. Loss of data rejects the observation.


Board: 4 copper layers, 155.0 x 150.0 mm, 72 parts (0 on the bottom side), 81 nets.

Other parts of the board:
H1, H2, H3, H4: MountingHole_3.2mm_M3
