pratham-cloud-ctrl/Project-ATO/electronics/stage4/integrated-pcb/integration/boards/contact-router/collision.kicad_sch

## KiCad design electronics/stage4/integrated-pcb/integration/boards/contact-router/collision.kicad_sch (2026-10-16)







Parts:
C40400, C40401, C40402, C40403, C40404, C40405, C40406, C40407, C40408, C40409, C40410, C40411, C40412, C40413, C40414, C40415, C40416, C40417, C40418: 100n X7R 10V; C_0805_2012Metric
U40400, U40401, U40402, U40403: SN74LVC1G86DBVR; SOT-23-5
U40404, U40405, U40406: SN74LVC1G32DBVR; SOT-23-5
U40407, U40410, U40415: SN74LVC1G04DBVR; SOT-23-5
U40408: SN74LVC1G11DBVR; SOT-23-6
U40409, U40411, U40412, U40413, U40414, U40416, U40417, U40418: SN74LVC1G08DBVR; SOT-23-5

Connections:
SYS_0cbf1bda__CH1_ADDR1: U40401.2 (B)
SYS_5aed2944__CH0_ADDR2: U40402.1 (A)
SYS_6c012064__ROUTE_COMMAND_READY: U40409.1 (A), U40413.1 (A), U40414.1 (A), U40418.1 (A)
SYS_08e41150__CH0_ADDR1: U40401.1 (A)
SYS_83ddb634__CH1_WANT_ROUTE: U40408.3 (B), U40414.2 (B), U40418.2 (B)
SYS_84f28705__CH1_ROUTE_LOCKED: U40418.4 (Y)
SYS_56562df4__GND: C40400.2, C40401.2, C40402.2, C40403.2, C40404.2, C40405.2, C40406.2, C40407.2, C40408.2, C40409.2, C40410.2, C40411.2, C40412.2, C40413.2, C40414.2, C40415.2, C40416.2, C40417.2, C40418.2, U40400.3 (GND), U40401.3 (GND), U40402.3 (GND), U40403.3 (GND), U40404.3 (GND), U40405.3 (GND), U40406.3 (GND), U40407.3 (GND), U40408.2 (GND), U40409.3 (GND), U40410.3 (GND), U40411.3 (GND), U40412.3 (GND), U40413.3 (GND), U40414.3 (GND), U40415.3 (GND), U40416.3 (GND), U40417.3 (GND), U40418.3 (GND)
SYS_087068cd__CH0_ADDR0: U40400.1 (A)
SYS_1954027d__CH0_ROUTE_LOCKED: U40413.4 (Y)
SYS_08572049__HOST_3V3: C40400.1, C40401.1, C40402.1, C40403.1, C40404.1, C40405.1, C40406.1, C40407.1, C40408.1, C40409.1, C40410.1, C40411.1, C40412.1, C40413.1, C40414.1, C40415.1, C40416.1, C40417.1, C40418.1, U40400.5 (VCC), U40401.5 (VCC), U40402.5 (VCC), U40403.5 (VCC), U40404.5 (VCC), U40405.5 (VCC), U40406.5 (VCC), U40407.5 (VCC), U40408.5 (VCC), U40409.5 (VCC), U40410.5 (VCC), U40411.5 (VCC), U40412.5 (VCC), U40413.5 (VCC), U40414.5 (VCC), U40415.5 (VCC), U40416.5 (VCC), U40417.5 (VCC), U40418.5 (VCC)
SYS_b6ef4aed__CH1_ADDR3: U40403.2 (B), U40415.2 (A), U40417.2 (B)
SYS_c3abe6bc__CH1_ADDR0: U40400.2 (B)
SYS_e338b670__CH0_WANT_ROUTE: U40408.1 (A), U40409.2 (B), U40413.2 (B)
SYS_f373e353__CH1_ADDR2: U40402.2 (B)
SYS_f7756399__CH0_ADDR3: U40403.1 (A), U40410.2 (A), U40412.2 (B)
contact-router__ADDR_ANY_DIFF: U40406.4 (Y), U40407.2 (A)
contact-router__ADDR_DIFF0: U40400.4 (Y), U40404.1 (A)
contact-router__ADDR_DIFF1: U40401.4 (Y), U40404.2 (B)
contact-router__ADDR_DIFF2: U40402.4 (Y), U40405.1 (A)
contact-router__ADDR_DIFF3: U40403.4 (Y), U40405.2 (B)
contact-router__ADDR_DIFF_HI: U40405.4 (Y), U40406.2 (B)
contact-router__ADDR_DIFF_LO: U40404.4 (Y), U40406.1 (A)
contact-router__CH0_BANK0_EN: U40411.4 (Y)
contact-router__CH0_BANK0_SELECT: U40410.4 (Y), U40411.2 (B)
contact-router__CH0_BANK1_EN: U40412.4 (Y)
contact-router__CH0_ROUTE_EN: U40409.4 (Y), U40411.1 (A), U40412.1 (A)
contact-router__CH1_BANK0_EN: U40416.4 (Y)
contact-router__CH1_BANK0_SELECT: U40415.4 (Y), U40416.2 (B)
contact-router__CH1_BANK1_EN: U40417.4 (Y)
contact-router__CH1_ROUTE_EN: U40414.4 (Y), U40416.1 (A), U40417.1 (A)
contact-router__ROUTE_ADDR_EQUAL: U40407.4 (Y), U40408.6 (C)
contact-router__ROUTE_CONFLICT: U40408.4 (Y)

Notes on the sheet:
DIGITAL RESEARCH CIRCUIT / RESTRICTED 24 V, 3 mA SOURCES / ARTIFICIAL LOADS ONLY
Sixteen selectable stimulation contacts, two dedicated monitored returns; command-level routing is not measured continuity or isolation.
Conflict = WANT0 & WANT1 & equal(all four active address bits). It disables BOTH bank families and asynchronously clears route validation.
Removing a conflict only removes its fault condition; it does not restore VALID. Release both WANTs, verify quiet, then explicitly rearm.
The two source enables may coexist only at different contacts. Common tissue impedance and volume conduction are outside this digital collision test.
ROUTE_LOCKED means admitted digital command ownership only. No selected-contact continuity or power-off isolation is inferred.
