pratham-cloud-ctrl/Project-ATO/electronics/stage4/integrated-pcb/integration/boards/contact-router/source1.kicad_sch

## KiCad design electronics/stage4/integrated-pcb/integration/boards/contact-router/source1.kicad_sch (2026-10-16)





Parts:
C40200, C40201: 100n X7R 50V; C_0805_2012Metric
C40202, C40203: 1u X7R 50V; C_0805_2012Metric
J40200: DRIVER A / MONITORED RETURN; PinHeader_1x03_P2.54mm_Vertical
R40200, R40201, R40202, R40203, R40204: 22k; R_0805_2012Metric
U40200, U40201: TMUX6208PWR; TSSOP-16_4.4x5mm_P0.65mm

Connections:
SYS_0cbf1bda__CH1_ADDR1: R40203.1, U40200.16 (A1), U40201.16 (A1)
SYS_3ced048f__CH1_RETURN_LOAD: J40200.2
SYS_6d4bb3d1__STIM11_CONTACT: U40201.7 (S4)
SYS_8b50701c__STIM01_CONTACT: U40200.5 (S2)
SYS_32f1b236__STIM12_CONTACT: U40201.12 (S5)
SYS_36b8c84f__STIM02_CONTACT: U40200.6 (S3)
SYS_74b9e55a__STIM10_CONTACT: U40201.6 (S3)
SYS_126bf237__STIM14_CONTACT: U40201.10 (S7)
SYS_223a43dd__STIM03_CONTACT: U40200.7 (S4)
SYS_401be33b__CH1_A_ROUTER: J40200.1, U40200.8 (D_COMMON), U40201.8 (D_COMMON)
SYS_15689dc4__VH_24: C40200.1, C40201.1, C40202.1, C40203.1, U40200.13 (VDD), U40201.13 (VDD)
SYS_56562df4__GND: C40200.2, C40201.2, C40202.2, C40203.2, J40200.3, R40200.2, R40201.2, R40202.2, R40203.2, R40204.2, U40200.3 (VSS), U40200.14 (GND), U40201.3 (VSS), U40201.14 (GND)
SYS_80673a9e__STIM08_CONTACT: U40201.4 (S1)
SYS_82867ca5__STIM00_CONTACT: U40200.4 (S1)
SYS_344482b2__STIM13_CONTACT: U40201.11 (S6)
SYS_b675ff0d__STIM06_CONTACT: U40200.10 (S7)
SYS_c3abe6bc__CH1_ADDR0: R40202.1, U40200.1 (A0), U40201.1 (A0)
SYS_cf17d7c4__STIM07_CONTACT: U40200.9 (S8)
SYS_dcbe1273__STIM04_CONTACT: U40200.12 (S5)
SYS_eb2c0acf__STIM09_CONTACT: U40201.5 (S2)
SYS_f00e6304__STIM15_CONTACT: U40201.9 (S8)
SYS_f373e353__CH1_ADDR2: R40204.1, U40200.15 (A2), U40201.15 (A2)
SYS_fa6c9e06__STIM05_CONTACT: U40200.11 (S6)
contact-router__CH1_BANK0_EN: R40200.1, U40200.2 (EN_HIGH)
contact-router__CH1_BANK1_EN: R40201.1, U40201.2 (EN_HIGH)

Notes on the sheet:
DIGITAL RESEARCH CIRCUIT / RESTRICTED 24 V, 3 mA SOURCES / ARTIFICIAL LOADS ONLY
Sixteen selectable stimulation contacts, two dedicated monitored returns; command-level routing is not measured continuity or isolation.
Both bank D commons share A_ROUTER. EN0 = ROUTE_EN & !ADDR3; EN1 = ROUTE_EN & ADDR3. Addresses 000..111 select S1..S8.
Dedicated return: external contact -> RETURN_LOAD -> existing monitor 2 ohm shunt -> RETURN_DRIVER -> current-driver B_BR.
Do not bypass the monitor, add a second shunt, tie the two returns, or use recording REF/BIAS as a stimulation return.
TMUX6208 is rail-to-rail at valid 24 V supply; powered-off, stuck-on, parasitic coupling and two-source shared tissue paths remain unqualified.
A_ROUTER needs external terminal guard qualification before connection to A_BR. Internal enable-low is only a commanded off state.
