pratham-cloud-ctrl/Project-ATO/electronics/stage4/integrated-pcb/integration/boards/controller-carrier/defaults.kicad_sch

## KiCad design electronics/stage4/integrated-pcb/integration/boards/controller-carrier/defaults.kicad_sch (2026-10-16)





Parts:
R80100, R80101, R80102, R80103, R80104, R80105, R80106, R80107, R80108, R80109, R80110, R80111, R80112, R80113: 10k; R_0805_2012Metric

Connections:
SYS_1fbf7500__ROUTE_ACTIVE_BITS_VERIFIED: R80103.1
SYS_4d4028f1__AFE_MOSI: R80111.1
SYS_8b29b23f__AFE_CONNECT: R80113.1
SYS_18e49fe8__AFE_CS_ASSERT: R80112.1
SYS_75de6c03__RAW_RST_N: R80109.1
SYS_83ddb634__CH1_WANT_ROUTE: R80105.1
SYS_054848d0__RAW_CS_N: R80108.2
SYS_56562df4__GND: R80100.2, R80101.2, R80102.2, R80103.2, R80104.2, R80105.2, R80106.2, R80107.2, R80109.2, R80110.2, R80111.2, R80112.2, R80113.2
SYS_95016e07__RAW_SCLK: R80106.1
SYS_08572049__HOST_3V3: R80108.1
SYS_66316879__RAW_SDI: R80107.1
SYS_b6a3943c__ROUTE_COMMIT: R80101.1
SYS_e338b670__CH0_WANT_ROUTE: R80104.1
SYS_ed4497b7__ROUTE_REARM: R80102.1
SYS_f30c60de__AFE_SCLK: R80110.1
SYS_fd131f77__ROUTE_PRELOAD_LATCH: R80100.1

Notes on the sheet:
DIGITAL SCCI ENGINEERING / ARTIFICIAL SIGNALS / nRF5340 CONTROLLER CARRIER
46 actual GPIO, explicit common CNV/rearm and physical 32-bit health/readback chain. Radio remains disabled.
All labels are native electrical connections. Digital artificial-load interface; no clinical, chronic or body-radio qualification.
Hardware permissions and terminal guards remain independent of transport. Loss of data rejects the observation.
