pratham-cloud-ctrl/Project-ATO/electronics/stage4/integrated-pcb/integration/boards/controller-carrier/handoff.kicad_sch

## KiCad design electronics/stage4/integrated-pcb/integration/boards/controller-carrier/handoff.kicad_sch (2026-10-16)





Parts:
J80010: RAW MONITOR; PinHeader_1x06_P2.54mm_Vertical
J80011: ISOLATED RECORDING HOST; PinHeader_1x10_P2.54mm_Vertical
J80012: SHARED CHARGE ENDPOINT SPI; PinHeader_1x07_P2.54mm_Vertical
J80013: DOSE / MONITOR REARM; PinHeader_1x05_P2.54mm_Vertical

Connections:
SYS_0d7c406c__MON_MISO: J80012.2
SYS_4d4028f1__AFE_MOSI: J80011.4
SYS_4dbe75ce__AFE_MISO: J80011.6
SYS_5fca782c__RAW_SDO: J80010.3
SYS_7cf9dad5__MON_SCLK: J80012.1
SYS_8b29b23f__AFE_CONNECT: J80011.7
SYS_18e49fe8__AFE_CS_ASSERT: J80011.5
SYS_32a601bf__MON_REARM1: J80013.4
SYS_36b0932b__INT_RUN1: J80013.2
SYS_75de6c03__RAW_RST_N: J80010.5
SYS_822d2245__MON_REARM0: J80013.3
SYS_37737e7c__INT_RUN0: J80013.1
SYS_054848d0__RAW_CS_N: J80010.4
SYS_56562df4__GND: J80010.6, J80011.2, J80011.10, J80012.7, J80013.5
SYS_95016e07__RAW_SCLK: J80010.1
SYS_08572049__HOST_3V3: J80011.1
SYS_66316879__RAW_SDI: J80010.2
SYS_a863a08a__CS1: J80012.6
SYS_a9673f8c__AFE_RECORD: J80011.8
SYS_ce0a4f53__BOTH_CNV: J80012.3, J80012.5
SYS_ce1178b4__AFE_FAULT_N: J80011.9
SYS_ec2c6e7f__CS0: J80012.4
SYS_f30c60de__AFE_SCLK: J80011.3

Notes on the sheet:
DIGITAL SCCI ENGINEERING / ARTIFICIAL SIGNALS / nRF5340 CONTROLLER CARRIER
46 actual GPIO, explicit common CNV/rearm and physical 32-bit health/readback chain. Radio remains disabled.
All labels are native electrical connections. Digital artificial-load interface; no clinical, chronic or body-radio qualification.
Hardware permissions and terminal guards remain independent of transport. Loss of data rejects the observation.
