pratham-cloud-ctrl/Project-ATO/electronics/stage4/integrated-pcb/integration/boards/controller-carrier/handoff_2.kicad_sch

## KiCad design electronics/stage4/integrated-pcb/integration/boards/controller-carrier/handoff_2.kicad_sch (2026-10-16)





Parts:
J80014: DAC SERIAL; PinHeader_1x04_P2.54mm_Vertical
J80015: DRIVER REQUEST / POLARITY; PinHeader_1x09_P2.54mm_Vertical
J80016: ROUTE CANDIDATE / COMMIT; PinHeader_1x09_P2.54mm_Vertical
J80017: ACTIVE ROUTE READBACK; PinHeader_1x09_P2.54mm_Vertical

Connections:
SYS_0cbf1bda__CH1_ADDR1: J80017.6
SYS_1fbf7500__ROUTE_ACTIVE_BITS_VERIFIED: J80016.6
SYS_3abe1caf__BOTH_DRV_REARM: J80015.4, J80015.8
SYS_3b27d056__MINUS0: J80015.3
SYS_5aed2944__CH0_ADDR2: J80017.3
SYS_08e41150__CH0_ADDR1: J80017.2
SYS_11f4403a__ROUTE_SER: J80014.3, J80016.1
SYS_46ea5f03__CH0_REQUEST: J80015.1
SYS_83ddb634__CH1_WANT_ROUTE: J80016.8
SYS_628d7747__PLUS1: J80015.6
SYS_973f460c__PLUS0: J80015.2
SYS_56562df4__GND: J80014.4, J80015.9, J80016.9, J80017.9
SYS_087068cd__CH0_ADDR0: J80017.1
SYS_b6a3943c__ROUTE_COMMIT: J80016.4
SYS_b6ef4aed__CH1_ADDR3: J80017.8
SYS_c3abe6bc__CH1_ADDR0: J80017.5
SYS_d5e1f64a__ROUTE_SRCLK: J80014.1, J80016.2
SYS_dd388269__CH1_REQUEST: J80015.5
SYS_e338b670__CH0_WANT_ROUTE: J80016.7
SYS_e496c0b2__DAC_SYNC_N: J80014.2
SYS_ed4497b7__ROUTE_REARM: J80016.5
SYS_edc800df__MINUS1: J80015.7
SYS_f373e353__CH1_ADDR2: J80017.7
SYS_f7756399__CH0_ADDR3: J80017.4
SYS_fd131f77__ROUTE_PRELOAD_LATCH: J80016.3

Notes on the sheet:
DIGITAL SCCI ENGINEERING / ARTIFICIAL SIGNALS / nRF5340 CONTROLLER CARRIER
46 actual GPIO, explicit common CNV/rearm and physical 32-bit health/readback chain. Radio remains disabled.
All labels are native electrical connections. Digital artificial-load interface; no clinical, chronic or body-radio qualification.
Hardware permissions and terminal guards remain independent of transport. Loss of data rejects the observation.
