pratham-cloud-ctrl/Project-ATO/electronics/stage4/integrated-pcb/integration/boards/controller-carrier/handoff_3.kicad_sch

## KiCad design electronics/stage4/integrated-pcb/integration/boards/controller-carrier/handoff_3.kicad_sch (2026-10-16)




Parts:
J80018: SUPERVISION CONTROL; PinHeader_1x08_P2.54mm_Vertical
J80019: NATIVE HEALTH OBSERVATIONS; PinHeader_1x19_P2.54mm_Vertical
J80020: ISOLATED COMPANION HOST UART; PinHeader_1x04_P2.54mm_Vertical

Connections:
SYS_2d0e5b2e__CH0_QUIESCENT_OK: J80019.5
SYS_6a132103__CH1_RUN: J80019.13
SYS_6c012064__ROUTE_COMMAND_READY: J80019.16
SYS_6e45b638__HOST_UART_TX: J80020.1
SYS_7db86ec0__PHASE_REARM0: J80018.6
SYS_9c8a42b1__CH1_TIMEOUT: J80019.18
SYS_20eba8c2__CH1_QUIESCENT_OK: J80019.6
SYS_46e29157__PHASE_REARM1: J80018.7
SYS_46ea5f03__CH0_REQUEST: J80018.4
SYS_54dd20d7__CH0_TIMEOUT: J80019.17
SYS_56ebc071__CH0_MON_PERMIT: J80019.7
SYS_77c24b0d__GLOBAL_GUARD_EN: J80019.11
SYS_88c50083__SUP_ARMED: J80019.10
SYS_695f3a7c__CH0_RUN: J80019.12
SYS_919c5ac8__HOST_UART_RX: J80020.2
SYS_56562df4__GND: J80018.8, J80019.19, J80020.4
SYS_98321c7b__AFE_ISOLATED_READY: J80019.4
SYS_08572049__HOST_3V3: J80020.3
SYS_82531809__FAULT_RESET: J80018.2
SYS_93547907__RAILS_QUALIFIED: J80019.2
SYS_a83d484c__WATCHDOG_OK: J80019.3
SYS_aa321af6__CH1_MON_PERMIT: J80019.8
SYS_bb444a6e__SUP_REARM: J80018.1
SYS_c659d53f__CH1_TIMER: J80019.15
SYS_ca7ea3db__CH0_TIMER: J80019.14
SYS_dd388269__CH1_REQUEST: J80018.5
SYS_e3faaec0__WDI: J80018.3
SYS_ee59c76b__PWR_FAULT_N: J80019.9
SYS_ff7fdc58__RESET_READY: J80019.1

Notes on the sheet:
DIGITAL SCCI ENGINEERING / ARTIFICIAL SIGNALS / nRF5340 CONTROLLER CARRIER
46 actual GPIO, explicit common CNV/rearm and physical 32-bit health/readback chain. Radio remains disabled.
All labels are native electrical connections. Digital artificial-load interface; no clinical, chronic or body-radio qualification.
Hardware permissions and terminal guards remain independent of transport. Loss of data rejects the observation.
