pratham-cloud-ctrl/Project-ATO/electronics/stage4/integrated-pcb/integration/boards/controller-carrier/power.kicad_sch

## KiCad design electronics/stage4/integrated-pcb/integration/boards/controller-carrier/power.kicad_sch (2026-10-16)



Parts:
C80001: 47u X7R 10V; C_1206_3216Metric
C80002: 1u X7R 10V; C_1206_3216Metric
C80003: 100n X7R 10V; C_1206_3216Metric
J80002: SWD / TARGET VREF; PinHeader_1x06_P2.54mm_Vertical
J80003: RESET SHORTING HEADER; PinHeader_1x02_P2.54mm_Vertical
R80001: 0R; R_0805_2012Metric
R80002: 10k; R_0805_2012Metric

Connections:
SYS_56562df4__GND: C80001.2, C80002.2, C80003.2, J80002.3, J80002.6, J80003.2
SYS_08572049__HOST_3V3: R80001.1
controller-carrier__MCU_3V3: C80001.1, C80002.1, C80003.1, J80002.1, R80001.2, R80002.1
controller-carrier__MCU_RESET_N: J80002.5, J80003.1, R80002.2
controller-carrier__SWCLK: J80002.4
controller-carrier__SWDIO: J80002.2

Notes on the sheet:
DIGITAL SCCI ENGINEERING / ARTIFICIAL SIGNALS / nRF5340 CONTROLLER CARRIER
46 actual GPIO, explicit common CNV/rearm and physical 32-bit health/readback chain. Radio remains disabled.
All labels are native electrical connections. Digital artificial-load interface; no clinical, chronic or body-radio qualification.
Hardware permissions and terminal guards remain independent of transport. Loss of data rejects the observation.
