pratham-cloud-ctrl/Project-ATO/electronics/stage4/integrated-pcb/integration/boards/current-driver/current_driver.kicad_sch

## KiCad design electronics/stage4/integrated-pcb/integration/boards/current-driver/current_driver.kicad_sch (2026-10-16)



Parts:
C20001: 100n 10V; C_0805_2012Metric
C20002: 4.7u 10V; C_0805_2012Metric
C20003: 220n 10V; C_0805_2012Metric
J20001: QUALIFIED EXTERNAL RAILS; PinHeader_1x05_P2.54mm_Vertical
J20002: MCU SPI / PRELOAD INHIBITED; PinHeader_1x04_P2.54mm_Vertical
J20003: MCU PHASE / EXPLICIT REARM; PinHeader_1x09_P2.54mm_Vertical
J20004: EXTERNAL HEALTH CONTRACTS; PinHeader_1x11_P2.54mm_Vertical
J20005: STATUS ONLY / NOT DELIVERY EVIDENCE; PinHeader_1x09_P2.54mm_Vertical
R20001, R20002, R20003, R20004, R20005: 10k; R_0805_2012Metric
U20001: DAC80502DRXR; Texas_DRX_WSON-10_2.5x2.5mm_P0.5mm

Connections:
SYS_2d0e5b2e__CH0_QUIESCENT_OK: J20004.6
SYS_3abe1caf__BOTH_DRV_REARM: J20003.4, J20003.8
SYS_3b27d056__MINUS0: J20003.3
SYS_6a132103__CH1_RUN: J20005.5
SYS_9c8a42b1__CH1_TIMEOUT: J20005.7
SYS_11f4403a__ROUTE_SER: J20002.3, R20002.1, U20001.8 (SDIN)
SYS_20eba8c2__CH1_QUIESCENT_OK: J20004.10
SYS_46ea5f03__CH0_REQUEST: J20003.1
SYS_54dd20d7__CH0_TIMEOUT: J20005.3
SYS_56ebc071__CH0_MON_PERMIT: J20004.3
SYS_84f28705__CH1_ROUTE_LOCKED: J20004.9
SYS_628d7747__PLUS1: J20003.6
SYS_695f3a7c__CH0_RUN: J20005.1
SYS_973f460c__PLUS0: J20003.2
SYS_8359fceb__CH1_EXT_SUP_OK: J20004.8
SYS_15689dc4__VH_24: J20001.1
SYS_56562df4__GND: C20001.2, C20002.2, C20003.2, J20001.5, J20002.4, J20003.9, J20004.11, J20005.9, R20001.2, R20002.2, R20004.2, R20005.2, U20001.3 (RSTSEL), U20001.4 (AGND), U20001.5 (SPI2C)
SYS_1954027d__CH0_ROUTE_LOCKED: J20004.5
SYS_08572049__HOST_3V3: J20001.4, R20003.2
SYS_93547907__RAILS_QUALIFIED: J20004.2, R20005.1
SYS_aa321af6__CH1_MON_PERMIT: J20004.7
SYS_c659d53f__CH1_TIMER: J20005.8
SYS_ca7ea3db__CH0_TIMER: J20005.4
SYS_ce166826__HOST_5: C20001.1, C20002.1, J20001.3, U20001.1 (VDD)
SYS_d5e1f64a__ROUTE_SRCLK: J20002.1, R20001.1, U20001.6 (SCLK)
SYS_dd388269__CH1_REQUEST: J20003.5
SYS_e496c0b2__DAC_SYNC_N: J20002.2, R20003.1, U20001.7 (SYNC_N)
SYS_e26747fb__CH0_EXT_SUP_OK: J20004.4
SYS_edc800df__MINUS1: J20003.7
SYS_fb2237f8__VA_15: J20001.2
SYS_ff7fdc58__RESET_READY: J20004.1, R20004.1
current-driver__CH0_BLOCK: J20005.2
current-driver__CH0_VSET: U20001.2 (VOUTA)
current-driver__CH1_BLOCK: J20005.6
current-driver__CH1_VSET: U20001.9 (VOUTB)
current-driver__DAC_VREF: C20003.1, U20001.10 (VREFIO)

Notes on the sheet:
ARTIFICIAL LOADS ONLY / RESTRICTED 24 V, 3 mA, 200 us DRIVER SLICE
External rails, recording AFE, 16-contact routing, compliance, charge guard, watchdog, PCB and implant qualification remain outside.
DAC initialization before READY: GAIN[0x04]=0x0103, reference divider 2 and both output buffer gains 2 => nominal 2.5 V FSR.
Code 7864 -> 2.999878 mA nominal through 100 ohm. Zero code is not terminal disconnection. Read README and external contracts.
RESET_READY held LOW through startup; REARM is an explicit pulse with REQUEST/TIMER LOW and independently observed quiescence.
