pratham-cloud-ctrl/Project-ATO/electronics/stage4/integrated-pcb/integration/boards/monitoring-cell/channel0.kicad_sch

## KiCad design electronics/stage4/integrated-pcb/integration/boards/monitoring-cell/channel0.kicad_sch (2026-10-16)



Parts:
C10100: 22n 0.5% C0G; C_0805_2012Metric
C10101: 1n C0G; C_0805_2012Metric
C10102, C10103, C10104, C10108, C10109, C10110: 100n 10V; C_0805_2012Metric
C10105, C10106: 1u 10V; C_0805_2012Metric
C10107: 22u 10V; C_0805_2012Metric
J10100: SOURCE 0 RETURN SHUNT; PinHeader_1x02_P2.54mm_Vertical
J10101: SOURCE 0 DRIVER PERMISSION; PinHeader_1x03_P2.54mm_Vertical
R10100: 2R 0.1% KELVIN; R_0805_2012Metric
R10101: 10k 0.1%; R_0805_2012Metric
R10102: 33R; R_0805_2012Metric
R10103, R10104, R10105: 100k; R_0805_2012Metric
U10100: INA241A2IDR; SOIC-8_3.9x4.9mm_P1.27mm
U10101, U10102: OPA391DCKR; SOT-353_SC-70-5
U10103: ADS8866IDGSR; MSOP-10_3x3mm_P0.5mm
U10104: TLV3202IDR; SOIC-8_3.9x4.9mm_P1.27mm
U10105: SN74LVC1G11DBVR; SOT-23-6
U10106: SN74LVC1G74DCUR; VSSOP-8_2.3x2mm_P0.5mm

Connections:
SYS_0d1e7c21__CH0_RETURN_LOAD: J10100.1, R10100.1, U10100.8 (IN+)
SYS_4f66f129__MON_VREF: C10107.1, U10103.1 (REF)
SYS_7cf9dad5__MON_SCLK: U10103.8 (SCLK)
SYS_37cfe02a__MON_VMID: U10100.3 (REF2), U10100.7 (REF1), U10101.1 (IN+)
SYS_56ebc071__CH0_MON_PERMIT: J10101.1, R10105.1, U10106.5 (Q_PERMIT)
SYS_83a198be__CH0_DOUT: U10103.7 (DOUT)
SYS_822d2245__MON_REARM0: R10104.1, U10106.1 (CLK_REARM)
SYS_56562df4__GND: C10101.2, C10102.2, C10103.2, C10104.2, C10105.2, C10106.2, C10107.2, C10108.2, C10109.2, C10110.2, J10101.3, R10103.2, R10104.2, R10105.2, U10100.2 (GND), U10100.4 (NC=GND), U10101.2 (V-), U10102.2 (V-), U10103.4 (AINN), U10103.5 (GND), U10104.4 (GND), U10105.2 (GND), U10106.4 (GND)
SYS_08572049__HOST_3V3: C10105.1, C10106.1, C10109.1, C10110.1, U10103.2 (AVDD), U10103.10 (DVDD), U10105.5 (VCC), U10106.2 (D), U10106.7 (PRE_N), U10106.8 (VCC)
SYS_ce0a4f53__BOTH_CNV: U10103.6 (CONVST)
SYS_ce166826__HOST_5: C10102.1, C10103.1, C10104.1, C10108.1, U10100.6 (VS), U10101.5 (V+), U10102.5 (V+), U10104.8 (VCC)
SYS_d3eac10b__CH0_EXT_SUP_OK: J10101.2, R10103.1, U10105.6 (C_EXT_SUP_OK)
SYS_ec2c6e7f__CS0: U10103.9 (DIN/CS_N)
SYS_ee476f53__CH0_B_BR: J10100.2, R10100.2, U10100.1 (IN-)
SYS_f8e43b73__CH0_I_MON: R10101.1, U10100.5 (OUT), U10104.2 (1IN-), U10104.5 (2IN+)
monitoring-cell__CH0_ADC_BUF: R10102.1, U10102.3 (IN-), U10102.4 (OUT)
monitoring-cell__CH0_ADC_IN: C10101.1, R10102.2, U10103.3 (AINP)
monitoring-cell__CH0_CLEAR_N: U10105.4 (Y_CLR_N), U10106.6 (CLR_N)
monitoring-cell__CH0_HI_OK: U10104.1 (HI_OK), U10105.1 (A_HI_OK)
monitoring-cell__CH0_LO_OK: U10104.7 (LO_OK), U10105.3 (B_LO_OK)
monitoring-cell__CH0_Q_INT: C10100.2, U10101.4 (OUT), U10102.1 (IN+)
monitoring-cell__CH0_SUM: C10100.1, R10101.2, U10101.3 (IN-)
monitoring-cell__I_HI: U10104.3 (1IN+)
monitoring-cell__I_LO: U10104.6 (2IN-)

Notes on the sheet:
ARTIFICIAL ELECTRICAL LOADS ONLY / FIRST MONITORING SLICE
No current driver, HV router, differential compliance circuit, independent watchdog, MCU or PCB is completed here.
Q=-10k*22n/40*(V_end-V_start); 600nC=109.091mV nominal. Take BASELINE, CATH, ANODE, NET/TAIL endpoints.
Cathodic and anodic charges remain separate. Opposed phases can cancel: final net alone cannot qualify delivery.
Actual current-tail/window evidence is required. Command edges, the comparator or an ideal16-bit LSB do not certify precision.
CLRN = HI_OK AND LO_OK AND EXT_SUP_OK. Any low latches Q off; rising REARM admits only while CLRN is high.
