pratham-cloud-ctrl/Project-ATO/electronics/stage4/integrated-pcb/integration/boards/monitoring-cell/monitoring_cell.kicad_sch

## KiCad design electronics/stage4/integrated-pcb/integration/boards/monitoring-cell/monitoring_cell.kicad_sch (2026-10-16)



Parts:
C10001, C10002: 1u 10V; C_0805_2012Metric
C10003, C10004: 100n 10V; C_0805_2012Metric
J10001: LAB RAILS ONLY; PinHeader_1x03_P2.54mm_Vertical
J10002: MCU ENDPOINT/CONTROL; PinHeader_1x12_P2.54mm_Vertical
J10003: EXTERNAL SUPERVISION; PinHeader_1x05_P2.54mm_Vertical
J10004: CURRENT ADC INTERFACE; PinHeader_1x04_P2.54mm_Vertical
R10001, R10002, R10003, R10005: 10k 0.1%; R_0805_2012Metric
R10004: 19.1k 0.1%; R_0805_2012Metric
R10006, R10007: 100k; R_0805_2012Metric
U10001: REF3440DBVR; SOT-23-6
U10002: OPA391DCKR; SOT-353_SC-70-5
U10003: TMUX1136DGSR; MSOP-10_3x3mm_P0.5mm

Connections:
SYS_4f66f129__MON_VREF: C10002.1, R10001.1, R10003.1, U10001.5 (OUT_S), U10001.6 (OUT_F)
SYS_7cf9dad5__MON_SCLK: J10002.7
SYS_32a601bf__MON_REARM1: J10002.11
SYS_36b0932b__INT_RUN1: J10002.9, R10007.1, U10003.5 (SEL2)
SYS_37cfe02a__MON_VMID: J10004.3, U10002.3 (IN-), U10002.4 (OUT)
SYS_56ebc071__CH0_MON_PERMIT: J10003.3
SYS_83a198be__CH0_DOUT: J10002.3
SYS_502efdd4__CH1_I_MON: J10004.2
SYS_822d2245__MON_REARM0: J10002.10
SYS_37737e7c__INT_RUN0: J10002.8, R10006.1, U10003.1 (SEL1)
SYS_56562df4__GND: C10001.2, C10002.2, C10003.2, C10004.2, J10001.3, J10002.12, J10003.5, J10004.4, R10002.2, R10005.2, R10006.2, R10007.2, U10001.1 (GND_F), U10001.2 (GND_S), U10002.2 (V-), U10003.3 (GND)
SYS_08572049__HOST_3V3: J10001.2
SYS_a863a08a__CS1: J10002.5
SYS_aa321af6__CH1_MON_PERMIT: J10003.4
SYS_ce0a4f53__BOTH_CNV: J10002.1, J10002.4
SYS_ce166826__HOST_5: C10001.1, C10003.1, C10004.1, J10001.1, U10001.3 (EN), U10001.4 (IN), U10002.5 (V+), U10003.8 (VDD)
SYS_d3eac10b__CH0_EXT_SUP_OK: J10003.1
SYS_de0a854a__CH1_EXT_SUP_OK: J10003.2
SYS_ec2c6e7f__CS0: J10002.2
SYS_f8e43b73__CH0_I_MON: J10004.1
SYS_fd7db492__CH1_DOUT: J10002.6
monitoring-cell__CH0_Q_INT: U10003.9 (S1B_RESET)
monitoring-cell__CH0_SUM: U10003.10 (D1)
monitoring-cell__CH1_Q_INT: U10003.7 (S2B_RESET)
monitoring-cell__CH1_SUM: U10003.6 (D2)
monitoring-cell__I_HI: R10003.2, R10004.1
monitoring-cell__I_LO: R10004.2, R10005.1
monitoring-cell__MID_DIV: R10001.2, R10002.1, U10002.1 (IN+)

Notes on the sheet:
ARTIFICIAL ELECTRICAL LOADS ONLY / FIRST MONITORING SLICE
No current driver, HV router, differential compliance circuit, independent watchdog, MCU or PCB is completed here.
V_REF=4.096V; V_MID=2.048V. Low INT_RUN resets; high opens reset for continuous signed integration.
I_LO=1.04757V / I_HI=3.04843V nominal (~+/-25.01mA). Threshold is NOT a proven complete-waveform cap.
EXT_SUP_OK must stay LOW until external rails/reference/watchdog/compliance/duration checks pass.
Two INA241 channels alone: up to32mW at5V. Input bias25..45uA/input is an unresolved leakage/bypass term.
Named global nets connect sheets; connectors remain explicit external design contracts. Read README before interpretation.
