pratham-cloud-ctrl/Project-ATO/electronics/stage4/integrated-pcb/integration/boards/monitoring-transport/adc.kicad_sch

## KiCad design electronics/stage4/integrated-pcb/integration/boards/monitoring-transport/adc.kicad_sch (2026-10-16)



Parts:
R70001, R70002: 33R; R_0805_2012Metric
R70003, R70004, R70005, R70006: 100k; R_0805_2012Metric
U70001: ADS8688IDBTR; TSSOP-38_4.4x9.7mm_P0.5mm

Connections:
SYS_5fca782c__RAW_SDO: U70001.36 (SDO)
SYS_75de6c03__RAW_RST_N: R70004.1, U70001.2 (RST_PD_N)
SYS_054848d0__RAW_CS_N: R70003.2, U70001.38 (CS_N)
SYS_56562df4__GND: R70004.2, R70005.2, R70006.2, U70001.3 (DAISY), U70001.4 (REFSEL), U70001.6 (REFGND), U70001.8 (AGND), U70001.10 (AUX_IN), U70001.11 (AUX_GND), U70001.13 (AIN_6GND), U70001.15 (AIN_7GND), U70001.17 (AIN_0GND), U70001.19 (AIN_1GND), U70001.20 (AIN_2GND), U70001.22 (AIN_3GND), U70001.24 (AIN_4GND), U70001.26 (AIN_5GND), U70001.28 (AGND), U70001.29 (AGND), U70001.31 (AGND), U70001.32 (AGND), U70001.33 (DGND)
SYS_95016e07__RAW_SCLK: R70002.1
SYS_08572049__HOST_3V3: R70003.1, U70001.34 (DVDD)
SYS_66316879__RAW_SDI: R70001.1
SYS_ce166826__HOST_5: U70001.9 (AVDD), U70001.30 (AVDD)
monitoring-transport__ADC0: U70001.16 (AIN_0P)
monitoring-transport__ADC1: U70001.18 (AIN_1P)
monitoring-transport__ADC2: U70001.21 (AIN_2P)
monitoring-transport__ADC3: U70001.23 (AIN_3P)
monitoring-transport__ADC4: U70001.25 (AIN_4P)
monitoring-transport__ADC5: U70001.27 (AIN_5P)
monitoring-transport__ADC6: U70001.12 (AIN_6P)
monitoring-transport__ADC7: U70001.14 (AIN_7P)
monitoring-transport__RAW_REFCAP: U70001.7 (REFCAP)
monitoring-transport__RAW_REFIO: U70001.5 (REFIO)
monitoring-transport__RAW_SCLK_PAD: R70002.2, R70005.1, U70001.37 (SCLK)
monitoring-transport__RAW_SDI_PAD: R70001.2, R70006.1, U70001.1 (SDI)

Notes on the sheet:
DIGITAL SCCI ENGINEERING / ARTIFICIAL SIGNALS / MONITORING AND COMPANION
Dedicated raw current/voltage ADC and wired processed-feature companion. Endpoint charge ADCs remain separate.
All labels are native electrical connections. Digital artificial-load interface; no clinical, chronic or body-radio qualification.
Hardware permissions and terminal guards remain independent of transport. Loss of data rejects the observation.
