pratham-cloud-ctrl/Project-ATO/electronics/stage4/integrated-pcb/integration/boards/monitoring-transport/monitoring_transport.kicad_sch

## KiCad design electronics/stage4/integrated-pcb/integration/boards/monitoring-transport/monitoring_transport.kicad_sch (2026-10-16)




Parts:
J70001: HOST RAILS / RAW ADC; PinHeader_1x03_P2.54mm_Vertical
J70002: EXISTING ANALOG TAPS; PinHeader_1x08_P2.54mm_Vertical
J70003: DEDICATED RAW ADC BUS; PinHeader_1x06_P2.54mm_Vertical

Connections:
SYS_4f66f129__MON_VREF: J70002.5
SYS_5fca782c__RAW_SDO: J70003.3
SYS_37cfe02a__MON_VMID: J70002.6
SYS_40eeaa0c__CH1_VPAIR: J70002.4
SYS_75de6c03__RAW_RST_N: J70003.5
SYS_502efdd4__CH1_I_MON: J70002.2
SYS_054848d0__RAW_CS_N: J70003.4
SYS_56562df4__GND: J70001.3, J70002.8, J70003.6
SYS_95016e07__RAW_SCLK: J70003.1
SYS_08572049__HOST_3V3: J70001.2
SYS_66316879__RAW_SDI: J70003.2
SYS_baff84b5__CH0_VPAIR: J70002.3
SYS_ce166826__HOST_5: J70001.1
SYS_f8e43b73__CH0_I_MON: J70002.1
SYS_f199d834__PACK_BUS: J70002.7

Notes on the sheet:
DIGITAL SCCI ENGINEERING / ARTIFICIAL SIGNALS / MONITORING AND COMPANION
Dedicated raw current/voltage ADC and wired processed-feature companion. Endpoint charge ADCs remain separate.
