pratham-cloud-ctrl/Project-ATO/electronics/stage4/integrated-pcb/integration/boards/monitoring-transport/reference.kicad_sch

## KiCad design electronics/stage4/integrated-pcb/integration/boards/monitoring-transport/reference.kicad_sch (2026-10-16)



Parts:
C70001, C70002: 22u X7R 10V; C_1206_3216Metric
C70003, C70005, C70007: 1u X7R 10V; C_1206_3216Metric
C70004, C70006, C70008: 10u X7R 10V; C_1206_3216Metric
C70009: 100n X7R 10V; C_1206_3216Metric

Connections:
SYS_56562df4__GND: C70001.2, C70002.2, C70003.2, C70004.2, C70005.2, C70006.2, C70007.2, C70008.2, C70009.2
SYS_08572049__HOST_3V3: C70008.1, C70009.1
SYS_ce166826__HOST_5: C70004.1, C70005.1, C70006.1, C70007.1
monitoring-transport__RAW_REFCAP: C70002.1, C70003.1
monitoring-transport__RAW_REFIO: C70001.1

Notes on the sheet:
DIGITAL SCCI ENGINEERING / ARTIFICIAL SIGNALS / MONITORING AND COMPANION
Dedicated raw current/voltage ADC and wired processed-feature companion. Endpoint charge ADCs remain separate.
All labels are native electrical connections. Digital artificial-load interface; no clinical, chronic or body-radio qualification.
Hardware permissions and terminal guards remain independent of transport. Loss of data rejects the observation.
