pratham-cloud-ctrl/Project-ATO/electronics/stage4/integrated-pcb/integration/boards/power/afe3.kicad_sch

## KiCad design electronics/stage4/integrated-pcb/integration/boards/power/afe3.kicad_sch (2026-10-16)



Parts:
C64100: 10u X7R 50V; C_1206_3216Metric
C64101: 10u X7R 16V; C_1206_3216Metric
C64102, C64103: 10n C0G 50V; C_1206_3216Metric
J60410: QUIESCENT TRIM / TEST ONLY; PinHeader_1x03_P2.54mm_Vertical
R64100: 19113.924R 0.1%; R_0805_2012Metric
R64101: 10k 0.1%; R_0805_2012Metric
R64102: 47k; R_0805_2012Metric
U60410: TPS7A4901DGNR; Texas_DGN0008D_VSSOP-8-1EP_3x3mm_P0.65mm_EP2x2.94mm_Mask1.5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

Connections:
SYS_65aafbb6__AFE_3V3: C64101.1, C64103.1, J60410.1, R64100.1, R64102.1, U60410.1 (OUT)
SYS_fca1c340__AFEAGND: C64100.2, C64101.2, C64102.2, J60410.3, R64101.2, R64102.2, U60410.4 (GND), U60410.9 (EP_GND)
power__AFE_3V3_FB: C64103.2, J60410.2, R64100.2, R64101.1, U60410.2 (FB)
power__AFE_3V3_NR: C64102.1, U60410.6 (NR_SS)
power__ISO_P12: C64100.1, U60410.5 (EN), U60410.8 (IN)

Notes on the sheet:
DIGITAL SCCI ENGINEERING / ARTIFICIAL LOADS / BATTERY AND POWER
2S protected pack, independent supervisor rails, host converters and floating AFE supplies. Digital circuit design, not implant qualification.
All labels are native electrical connections. PG is diagnostic; full qualification remains the nine independent supervision windows.
Converter shutdown does not discharge boost paths or remove stored energy. Body-facing shutdown remains the separate terminal guards.
