pratham-cloud-ctrl/Project-ATO/electronics/stage4/integrated-pcb/integration/boards/power/input.kicad_sch

## KiCad design electronics/stage4/integrated-pcb/integration/boards/power/input.kicad_sch (2026-10-16)



Parts:
C60001: 100u 16V LOW ESR; C_1206_3216Metric
C60002: 100n X7R 25V; C_1206_3216Metric
D60001: SS34-E3/57T; D_SMC
F60001: 2A FUSE 1206; Fuse_1206_3216Metric
SW60001: MASTER SPST / OFFBOARD; PinHeader_1x02_P2.54mm_Vertical

Connections:
SYS_56562df4__GND: C60001.2, C60002.2
SYS_f199d834__PACK_BUS: C60001.1, C60002.1, SW60001.2
power__PACK_FUSED: D60001.2 (A), F60001.2
power__PACK_POS: F60001.1
power__PACK_REVERSE_OK: D60001.1 (K), SW60001.1

Notes on the sheet:
DIGITAL SCCI ENGINEERING / ARTIFICIAL LOADS / BATTERY AND POWER
2S protected pack, independent supervisor rails, host converters and floating AFE supplies. Digital circuit design, not implant qualification.
All labels are native electrical connections. PG is diagnostic; full qualification remains the nine independent supervision windows.
Converter shutdown does not discharge boost paths or remove stored energy. Body-facing shutdown remains the separate terminal guards.
