pratham-cloud-ctrl/Project-ATO/electronics/stage4/integrated-pcb/integration/boards/power/island.kicad_sch

## KiCad design electronics/stage4/integrated-pcb/integration/boards/power/island.kicad_sch (2026-10-16)



Parts:
C60400: 22u X7R 16V; C_1206_3216Metric
C60401, C60402: 10u X7R 50V; C_1206_3216Metric
U60400: TMR3-0522; TRACO_TMR3_SIP8_21.8x9.1_P2.54

Connections:
SYS_56562df4__GND: C60400.2, U60400.1 (VIN_MINUS)
SYS_ce166826__HOST_5: C60400.1, U60400.2 (VIN_PLUS)
SYS_fca1c340__AFEAGND: C60401.2, C60402.2, U60400.7 (AFE_RETURN)
power__ISO_N12: C60402.1, U60400.8 (VOUT_MINUS)
power__ISO_P12: C60401.1, U60400.6 (VOUT_PLUS)

Notes on the sheet:
DIGITAL SCCI ENGINEERING / ARTIFICIAL LOADS / BATTERY AND POWER
2S protected pack, independent supervisor rails, host converters and floating AFE supplies. Digital circuit design, not implant qualification.
All labels are native electrical connections. PG is diagnostic; full qualification remains the nine independent supervision windows.
Converter shutdown does not discharge boost paths or remove stored energy. Body-facing shutdown remains the separate terminal guards.
