pratham-cloud-ctrl/Project-ATO/electronics/stage4/integrated-pcb/integration/boards/power/power.kicad_sch

## KiCad design electronics/stage4/integrated-pcb/integration/boards/power/power.kicad_sch (2026-10-16)






Parts:
J60001: AT31004 PROTECTED 2S PACK / 6.4 TO 8.4V; PinHeader_1x02_P2.54mm_Vertical
J60002: POWER REQUEST / STATUS; PinHeader_1x12_P2.54mm_Vertical
J60003: HOST AND SUPERVISOR RAILS; PinHeader_1x07_P2.54mm_Vertical
J60004: FLOATING RECORDING RAILS; PinHeader_1x04_P2.54mm_Vertical
J60005: CONVERTER TEST POINTS; PinHeader_1x05_P2.54mm_Vertical
J60006: EXISTING MONITOR REFERENCES; PinHeader_1x03_P2.54mm_Vertical

Connections:
SYS_3fdd5066__AFE_P5: J60004.2
SYS_4f66f129__MON_VREF: J60006.1
SYS_37cfe02a__MON_VMID: J60006.2
SYS_65aafbb6__AFE_3V3: J60004.1
SYS_66aba95b__SUP_5: J60003.2
SYS_15689dc4__VH_24: J60003.6
SYS_56562df4__GND: J60001.2, J60002.12, J60003.7, J60005.5, J60006.3
SYS_08572049__HOST_3V3: J60003.3
SYS_ab932142__SUP_3V3: J60002.10, J60003.1
SYS_ce166826__HOST_5: J60003.4
SYS_d73cd2ee__AFE_N5: J60004.3
SYS_ee59c76b__PWR_FAULT_N: J60002.11
SYS_f199d834__PACK_BUS: J60005.1
SYS_fb2237f8__VA_15: J60003.5
SYS_fca1c340__AFEAGND: J60004.4, J60005.4
power__BATT_OK: J60002.3
power__BOOST_ENABLE: J60002.5
power__HOST_3V3_PG: J60002.6
power__HOST_5_PG: J60002.7
power__HOST_ENABLE: J60002.4
power__ISO_N12: J60005.3
power__ISO_P12: J60005.2
power__PACK_POS: J60001.1
power__PWR_REQUEST: J60002.1
power__SUP_3V3_PG: J60002.8
power__SUP_5_PG: J60002.9
power__SUP_READY: J60002.2

Notes on the sheet:
DIGITAL SCCI ENGINEERING / ARTIFICIAL LOADS / BATTERY AND POWER
2S protected pack, independent supervisor rails, host converters and floating AFE supplies. Digital circuit design, not implant qualification.
