pratham-cloud-ctrl/Project-ATO/electronics/stage4/integrated-pcb/integration/boards/power/sup3.kicad_sch

## KiCad design electronics/stage4/integrated-pcb/integration/boards/power/sup3.kicad_sch (2026-10-16)



Parts:
C61000: 10u X7R 25V; C_1206_3216Metric
C61001: 22u X7R 16V; C_1206_3216Metric
L60100: 2.2uH SRP5030T-2R2M; L_Bourns_SRP5030T
R61000: 31250R 0.1%; R_0805_2012Metric
R61001: 10000R 0.1%; R_0805_2012Metric
R61002: 100k; R_0805_2012Metric
R61003: 47k; R_0805_2012Metric
U60100: TPS62160DGKR; VSSOP-8_3x3mm_P0.65mm

Connections:
SYS_56562df4__GND: C61000.2, C61001.2, R61001.2, R61003.2, U60100.1 (PGND), U60100.4 (AGND)
SYS_ab932142__SUP_3V3: C61001.1, L60100.2, R61000.1, R61002.1, R61003.1, U60100.6 (VOS)
SYS_f199d834__PACK_BUS: C61000.1, U60100.2 (VIN), U60100.3 (EN)
power__SUP_3V3_FB: R61000.2, R61001.1, U60100.5 (FB)
power__SUP_3V3_PG: R61002.2, U60100.8 (PG)
power__SUP_3V3_SW: L60100.1, U60100.7 (SW)

Notes on the sheet:
DIGITAL SCCI ENGINEERING / ARTIFICIAL LOADS / BATTERY AND POWER
2S protected pack, independent supervisor rails, host converters and floating AFE supplies. Digital circuit design, not implant qualification.
All labels are native electrical connections. PG is diagnostic; full qualification remains the nine independent supervision windows.
Converter shutdown does not discharge boost paths or remove stored energy. Body-facing shutdown remains the separate terminal guards.
