pratham-cloud-ctrl/Project-ATO/electronics/stage4/integrated-pcb/integration/boards/recording-front-end/bank0.kicad_sch

## KiCad design electronics/stage4/integrated-pcb/integration/boards/recording-front-end/bank0.kicad_sch (2026-10-16)





Parts:
C30020, C30030, C30200, C30201, C30202, C30203, C30300, C30301, C30302, C30303: 100n X7R 16V; C_0805_2012Metric
C30100, C30101, C30102, C30103: 470p C0G 50V; C_0805_2012Metric
R30100, R30101, R30102, R30103: 4.99k 0.1%; R_0805_2012Metric
R30200, R30201, R30202, R30203: 10M; R_0805_2012Metric
U30020: TMUX7412FRRPR; Texas_RRP0016A_WQFN16_4x4_P0.65_EP2.6
U30100, U30101, U30102, U30103: TMUX6219DGKR; VSSOP-8_2.3x2mm_P0.5mm

Connections:
SYS_0bc4e447__AFE_CONNECT: U30020.6 (SEL4), U30020.7 (SEL3), U30020.14 (SEL2), U30020.15 (SEL1)
SYS_3fdd5066__AFE_P5: C30020.1, C30200.1, C30201.1, C30202.1, C30203.1, U30020.11 (VDD), U30100.4 (VDD), U30101.4 (VDD), U30102.4 (VDD), U30103.4 (VDD)
SYS_4eb6b999__AFE_ACQUIRE: U30100.6 (SEL_ACQUIRE), U30101.6 (SEL_ACQUIRE), U30102.6 (SEL_ACQUIRE), U30103.6 (SEL_ACQUIRE)
SYS_8c3f25bb__AFE_IN02_P: C30102.1, U30102.1 (D_RHD)
SYS_65aafbb6__AFE_3V3: U30100.5 (EN), U30101.5 (EN), U30102.5 (EN), U30103.5 (EN)
SYS_3232ae4c__AFE_IN01_P: C30101.1, U30101.1 (D_RHD)
SYS_05097029__AFE_IN00_P: C30100.1, U30100.1 (D_RHD)
SYS_d73cd2ee__AFE_N5: C30030.1, C30300.1, C30301.1, C30302.1, C30303.1, U30020.2 (VSS_NEG), U30100.7 (VSS_NEG), U30101.7 (VSS_NEG), U30102.7 (VSS_NEG), U30103.7 (VSS_NEG)
SYS_f208be39__AFE_IN03_P: C30103.1, U30103.1 (D_RHD)
SYS_fca1c340__AFEAGND: C30020.2, C30030.2, C30100.2, C30101.2, C30102.2, C30103.2, C30200.2, C30201.2, C30202.2, C30203.2, C30300.2, C30301.2, C30302.2, C30303.2, R30200.2, R30201.2, R30202.2, R30203.2, U30020.3 (GND), U30020.17 (EP_SHIELD), U30100.2 (S1_CLAMP), U30100.3 (GND), U30101.2 (S1_CLAMP), U30101.3 (GND), U30102.2 (S1_CLAMP), U30102.3 (GND), U30103.2 (S1_CLAMP), U30103.3 (GND)
recording-front-end__AFE_FAULT_N: U30020.10 (FF_N)
recording-front-end__REC00_CONTACT: R30100.1
recording-front-end__REC00_PROT: R30200.1, U30020.16 (D1_INTERNAL), U30100.8 (S2_PROTECTED)
recording-front-end__REC00_SERIES: R30100.2, U30020.1 (S1_CONTACT)
recording-front-end__REC01_CONTACT: R30101.1
recording-front-end__REC01_PROT: R30201.1, U30020.13 (D2_INTERNAL), U30101.8 (S2_PROTECTED)
recording-front-end__REC01_SERIES: R30101.2, U30020.12 (S2_CONTACT)
recording-front-end__REC02_CONTACT: R30102.1
recording-front-end__REC02_PROT: R30202.1, U30020.8 (D3_INTERNAL), U30102.8 (S2_PROTECTED)
recording-front-end__REC02_SERIES: R30102.2, U30020.9 (S3_CONTACT)
recording-front-end__REC03_CONTACT: R30103.1
recording-front-end__REC03_PROT: R30203.1, U30020.5 (D4_INTERNAL), U30103.8 (S2_PROTECTED)
recording-front-end__REC03_SERIES: R30103.2, U30020.4 (S4_CONTACT)

Notes on the sheet:
DIGITAL RESEARCH CIRCUIT / ARTIFICIAL SIGNALS / NO PCB OR IMPLANT QUALIFICATION
Spinal concept: 16 positive contacts + 1 shared reference + separate passive bias; amplifier linearity and biological recording remain conditional.
Per column: contact -> 4.99k -> quad protected S/D -> protected node -> S2; S1 grounds RHD until ACQUIRE is admitted.
470pF is at the RHD pin; 10M bleeds the internal node. Switch capacitance/leakage/injection and shared reference mismatch remain modeled assumptions.
Fault threshold follows +/-5V rails and is far outside RHD +/-0.4V linear DC range. External low-voltage qualification is mandatory before unclamping.
