pratham-cloud-ctrl/Project-ATO/electronics/stage4/integrated-pcb/integration/boards/recording-front-end/bank1.kicad_sch

## KiCad design electronics/stage4/integrated-pcb/integration/boards/recording-front-end/bank1.kicad_sch (2026-10-16)





Parts:
C30021, C30031, C30204, C30205, C30206, C30207, C30304, C30305, C30306, C30307: 100n X7R 16V; C_0805_2012Metric
C30104, C30105, C30106, C30107: 470p C0G 50V; C_0805_2012Metric
R30104, R30105, R30106, R30107: 4.99k 0.1%; R_0805_2012Metric
R30204, R30205, R30206, R30207: 10M; R_0805_2012Metric
U30021: TMUX7412FRRPR; Texas_RRP0016A_WQFN16_4x4_P0.65_EP2.6
U30104, U30105, U30106, U30107: TMUX6219DGKR; VSSOP-8_2.3x2mm_P0.5mm

Connections:
SYS_0bc4e447__AFE_CONNECT: U30021.6 (SEL4), U30021.7 (SEL3), U30021.14 (SEL2), U30021.15 (SEL1)
SYS_3fdd5066__AFE_P5: C30021.1, C30204.1, C30205.1, C30206.1, C30207.1, U30021.11 (VDD), U30104.4 (VDD), U30105.4 (VDD), U30106.4 (VDD), U30107.4 (VDD)
SYS_4eb6b999__AFE_ACQUIRE: U30104.6 (SEL_ACQUIRE), U30105.6 (SEL_ACQUIRE), U30106.6 (SEL_ACQUIRE), U30107.6 (SEL_ACQUIRE)
SYS_7e367734__AFE_IN04_P: C30104.1, U30104.1 (D_RHD)
SYS_65aafbb6__AFE_3V3: U30104.5 (EN), U30105.5 (EN), U30106.5 (EN), U30107.5 (EN)
SYS_59100ef9__AFE_IN05_P: C30105.1, U30105.1 (D_RHD)
SYS_325713b8__AFE_IN07_P: C30107.1, U30107.1 (D_RHD)
SYS_380216f6__AFE_IN06_P: C30106.1, U30106.1 (D_RHD)
SYS_d73cd2ee__AFE_N5: C30031.1, C30304.1, C30305.1, C30306.1, C30307.1, U30021.2 (VSS_NEG), U30104.7 (VSS_NEG), U30105.7 (VSS_NEG), U30106.7 (VSS_NEG), U30107.7 (VSS_NEG)
SYS_fca1c340__AFEAGND: C30021.2, C30031.2, C30104.2, C30105.2, C30106.2, C30107.2, C30204.2, C30205.2, C30206.2, C30207.2, C30304.2, C30305.2, C30306.2, C30307.2, R30204.2, R30205.2, R30206.2, R30207.2, U30021.3 (GND), U30021.17 (EP_SHIELD), U30104.2 (S1_CLAMP), U30104.3 (GND), U30105.2 (S1_CLAMP), U30105.3 (GND), U30106.2 (S1_CLAMP), U30106.3 (GND), U30107.2 (S1_CLAMP), U30107.3 (GND)
recording-front-end__AFE_FAULT_N: U30021.10 (FF_N)
recording-front-end__REC04_CONTACT: R30104.1
recording-front-end__REC04_PROT: R30204.1, U30021.16 (D1_INTERNAL), U30104.8 (S2_PROTECTED)
recording-front-end__REC04_SERIES: R30104.2, U30021.1 (S1_CONTACT)
recording-front-end__REC05_CONTACT: R30105.1
recording-front-end__REC05_PROT: R30205.1, U30021.13 (D2_INTERNAL), U30105.8 (S2_PROTECTED)
recording-front-end__REC05_SERIES: R30105.2, U30021.12 (S2_CONTACT)
recording-front-end__REC06_CONTACT: R30106.1
recording-front-end__REC06_PROT: R30206.1, U30021.8 (D3_INTERNAL), U30106.8 (S2_PROTECTED)
recording-front-end__REC06_SERIES: R30106.2, U30021.9 (S3_CONTACT)
recording-front-end__REC07_CONTACT: R30107.1
recording-front-end__REC07_PROT: R30207.1, U30021.5 (D4_INTERNAL), U30107.8 (S2_PROTECTED)
recording-front-end__REC07_SERIES: R30107.2, U30021.4 (S4_CONTACT)

Notes on the sheet:
DIGITAL RESEARCH CIRCUIT / ARTIFICIAL SIGNALS / NO PCB OR IMPLANT QUALIFICATION
Spinal concept: 16 positive contacts + 1 shared reference + separate passive bias; amplifier linearity and biological recording remain conditional.
Per column: contact -> 4.99k -> quad protected S/D -> protected node -> S2; S1 grounds RHD until ACQUIRE is admitted.
470pF is at the RHD pin; 10M bleeds the internal node. Switch capacitance/leakage/injection and shared reference mismatch remain modeled assumptions.
Fault threshold follows +/-5V rails and is far outside RHD +/-0.4V linear DC range. External low-voltage qualification is mandatory before unclamping.
