pratham-cloud-ctrl/Project-ATO/electronics/stage4/integrated-pcb/integration/boards/recording-front-end/bank3.kicad_sch

## KiCad design electronics/stage4/integrated-pcb/integration/boards/recording-front-end/bank3.kicad_sch (2026-10-16)





Parts:
C30023, C30033, C30212, C30213, C30214, C30215, C30312, C30313, C30314, C30315: 100n X7R 16V; C_0805_2012Metric
C30112, C30113, C30114, C30115: 470p C0G 50V; C_0805_2012Metric
R30112, R30113, R30114, R30115: 4.99k 0.1%; R_0805_2012Metric
R30212, R30213, R30214, R30215: 10M; R_0805_2012Metric
U30023: TMUX7412FRRPR; Texas_RRP0016A_WQFN16_4x4_P0.65_EP2.6
U30112, U30113, U30114, U30115: TMUX6219DGKR; VSSOP-8_2.3x2mm_P0.5mm

Connections:
SYS_0bc4e447__AFE_CONNECT: U30023.6 (SEL4), U30023.7 (SEL3), U30023.14 (SEL2), U30023.15 (SEL1)
SYS_3fdd5066__AFE_P5: C30023.1, C30212.1, C30213.1, C30214.1, C30215.1, U30023.11 (VDD), U30112.4 (VDD), U30113.4 (VDD), U30114.4 (VDD), U30115.4 (VDD)
SYS_4eb6b999__AFE_ACQUIRE: U30112.6 (SEL_ACQUIRE), U30113.6 (SEL_ACQUIRE), U30114.6 (SEL_ACQUIRE), U30115.6 (SEL_ACQUIRE)
SYS_4f7d5988__AFE_IN14_P: C30114.1, U30114.1 (D_RHD)
SYS_4fabccc5__AFE_IN12_P: C30112.1, U30112.1 (D_RHD)
SYS_32c4c1cc__AFE_IN13_P: C30113.1, U30113.1 (D_RHD)
SYS_65aafbb6__AFE_3V3: U30112.5 (EN), U30113.5 (EN), U30114.5 (EN), U30115.5 (EN)
SYS_53213f89__AFE_IN15_P: C30115.1, U30115.1 (D_RHD)
SYS_d73cd2ee__AFE_N5: C30033.1, C30312.1, C30313.1, C30314.1, C30315.1, U30023.2 (VSS_NEG), U30112.7 (VSS_NEG), U30113.7 (VSS_NEG), U30114.7 (VSS_NEG), U30115.7 (VSS_NEG)
SYS_fca1c340__AFEAGND: C30023.2, C30033.2, C30112.2, C30113.2, C30114.2, C30115.2, C30212.2, C30213.2, C30214.2, C30215.2, C30312.2, C30313.2, C30314.2, C30315.2, R30212.2, R30213.2, R30214.2, R30215.2, U30023.3 (GND), U30023.17 (EP_SHIELD), U30112.2 (S1_CLAMP), U30112.3 (GND), U30113.2 (S1_CLAMP), U30113.3 (GND), U30114.2 (S1_CLAMP), U30114.3 (GND), U30115.2 (S1_CLAMP), U30115.3 (GND)
recording-front-end__AFE_FAULT_N: U30023.10 (FF_N)
recording-front-end__REC12_CONTACT: R30112.1
recording-front-end__REC12_PROT: R30212.1, U30023.16 (D1_INTERNAL), U30112.8 (S2_PROTECTED)
recording-front-end__REC12_SERIES: R30112.2, U30023.1 (S1_CONTACT)
recording-front-end__REC13_CONTACT: R30113.1
recording-front-end__REC13_PROT: R30213.1, U30023.13 (D2_INTERNAL), U30113.8 (S2_PROTECTED)
recording-front-end__REC13_SERIES: R30113.2, U30023.12 (S2_CONTACT)
recording-front-end__REC14_CONTACT: R30114.1
recording-front-end__REC14_PROT: R30214.1, U30023.8 (D3_INTERNAL), U30114.8 (S2_PROTECTED)
recording-front-end__REC14_SERIES: R30114.2, U30023.9 (S3_CONTACT)
recording-front-end__REC15_CONTACT: R30115.1
recording-front-end__REC15_PROT: R30215.1, U30023.5 (D4_INTERNAL), U30115.8 (S2_PROTECTED)
recording-front-end__REC15_SERIES: R30115.2, U30023.4 (S4_CONTACT)

Notes on the sheet:
DIGITAL RESEARCH CIRCUIT / ARTIFICIAL SIGNALS / NO PCB OR IMPLANT QUALIFICATION
Spinal concept: 16 positive contacts + 1 shared reference + separate passive bias; amplifier linearity and biological recording remain conditional.
Per column: contact -> 4.99k -> quad protected S/D -> protected node -> S2; S1 grounds RHD until ACQUIRE is admitted.
470pF is at the RHD pin; 10M bleeds the internal node. Switch capacitance/leakage/injection and shared reference mismatch remain modeled assumptions.
Fault threshold follows +/-5V rails and is far outside RHD +/-0.4V linear DC range. External low-voltage qualification is mandatory before unclamping.
