pratham-cloud-ctrl/Project-ATO/electronics/stage4/integrated-pcb/integration/boards/recording-front-end/reference.kicad_sch

## KiCad design electronics/stage4/integrated-pcb/integration/boards/recording-front-end/reference.kicad_sch (2026-10-16)



Parts:
C30500: 2.2n C0G 50V; C_0805_2012Metric
C30510, C30511, C30512, C30513: 100n X7R 16V; C_0805_2012Metric
R30500: 4.99k 0.1%; R_0805_2012Metric
R30501: 10M; R_0805_2012Metric
R30502, R30503: 499k 0.1%; R_0805_2012Metric
U30024: TMUX7412FRRPR; Texas_RRP0016A_WQFN16_4x4_P0.65_EP2.6
U30500: TMUX6219DGKR; VSSOP-8_2.3x2mm_P0.5mm

Connections:
SYS_0bc4e447__AFE_CONNECT: U30024.15 (SEL1)
SYS_3fdd5066__AFE_P5: C30510.1, C30512.1, U30024.11 (VDD), U30500.4 (VDD)
SYS_4eb6b999__AFE_ACQUIRE: U30500.6 (SEL_ACQUIRE)
SYS_65aafbb6__AFE_3V3: U30500.5 (EN)
SYS_86b728f8__AFE_REF: C30500.1, U30500.1 (D_RHD)
SYS_d73cd2ee__AFE_N5: C30511.1, C30513.1, U30024.2 (VSS_NEG), U30500.7 (VSS_NEG)
SYS_fca1c340__AFEAGND: C30500.2, C30510.2, C30511.2, C30512.2, C30513.2, R30501.2, R30503.2, U30024.3 (GND), U30024.4 (S4_CONTACT), U30024.5 (D4_INTERNAL), U30024.6 (SEL4), U30024.7 (SEL3), U30024.8 (D3_INTERNAL), U30024.9 (S3_CONTACT), U30024.12 (S2_CONTACT), U30024.13 (D2_INTERNAL), U30024.14 (SEL2), U30024.17 (EP_SHIELD), U30500.2 (S1_CLAMP), U30500.3 (GND)
recording-front-end__AFE_FAULT_N: U30024.10 (FF_N)
recording-front-end__BIAS_CONTACT: R30502.1
recording-front-end__BIAS_MID: R30502.2, R30503.1
recording-front-end__REF_CONTACT: R30500.1
recording-front-end__REF_PROT: R30501.1, U30024.16 (D1_INTERNAL), U30500.8 (S2_PROTECTED)
recording-front-end__REF_SERIES: R30500.2, U30024.1 (S1_CONTACT)

Notes on the sheet:
DIGITAL RESEARCH CIRCUIT / ARTIFICIAL SIGNALS / NO PCB OR IMPLANT QUALIFICATION
Spinal concept: 16 positive contacts + 1 shared reference + separate passive bias; amplifier linearity and biological recording remain conditional.
REF_CONTACT passes through the same disconnect/clamp topology; one AFE_REF node feeds all sixteen minus pins (192pF intrinsic typical).
BIAS_CONTACT is separate and never a stimulation return. Passive current arithmetic does not establish a medical current limit.
