pratham-cloud-ctrl/Project-ATO/electronics/stage4/integrated-pcb/integration/boards/supervision/afe_bank0.kicad_sch

## KiCad design electronics/stage4/integrated-pcb/integration/boards/supervision/afe_bank0.kicad_sch (2026-10-16)





Parts:
C50600, C50601, C50602, C50603, C51013, C51014, C51015, C51016: 100n X7R 16V; C_0805_2012Metric
J50600: REC00 ACTUAL RHD-SIDE TAP; PinHeader_1x02_P2.54mm_Vertical
J50601: REC01 ACTUAL RHD-SIDE TAP; PinHeader_1x02_P2.54mm_Vertical
J50602: REC02 ACTUAL RHD-SIDE TAP; PinHeader_1x02_P2.54mm_Vertical
J50603: REC03 ACTUAL RHD-SIDE TAP; PinHeader_1x02_P2.54mm_Vertical
R56000, R56010, R56020, R56030: 10M 0.1%; R_0805_2012Metric
R56001, R56011, R56021, R56031: 1M 0.1%; R_0805_2012Metric
U50600, U50601, U50602, U50603: TLV3202DGKR; VSSOP-8_2.3x2mm_P0.5mm
U51013, U51014, U51015, U51016: SN74LVC1G08DBVR; SOT-23-5

Connections:
SYS_3fdd5066__AFE_P5: C50600.1, C50601.1, C50602.1, C50603.1, U50600.8 (VCC), U50601.8 (VCC), U50602.8 (VCC), U50603.8 (VCC)
SYS_8c3f25bb__AFE_IN02_P: J50602.1, R56020.1
SYS_65aafbb6__AFE_3V3: C51013.1, C51014.1, C51015.1, C51016.1, R56001.1, R56011.1, R56021.1, R56031.1, U51013.5 (VCC), U51014.5 (VCC), U51015.5 (VCC), U51016.5 (VCC)
SYS_3232ae4c__AFE_IN01_P: J50601.1, R56010.1
SYS_05097029__AFE_IN00_P: J50600.1, R56000.1
SYS_f208be39__AFE_IN03_P: J50603.1, R56030.1
SYS_fca1c340__AFEAGND: C50600.2, C50601.2, C50602.2, C50603.2, C51013.2, C51014.2, C51015.2, C51016.2, J50600.2, J50601.2, J50602.2, J50603.2, U50600.4 (GND), U50601.4 (GND), U50602.4 (GND), U50603.4 (GND), U51013.3 (GND), U51014.3 (GND), U51015.3 (GND), U51016.3 (GND)
supervision__AFE_WIN_HI: U50600.3 (IN1+), U50601.3 (IN1+), U50602.3 (IN1+), U50603.3 (IN1+)
supervision__AFE_WIN_LO: U50600.6 (IN2-), U50601.6 (IN2-), U50602.6 (IN2-), U50603.6 (IN2-)
supervision__REC00_DC_OK: U51013.4 (Y)
supervision__REC00_HI_OK: U50600.1 (OUT1), U51013.1 (A)
supervision__REC00_LO_OK: U50600.7 (OUT2), U51013.2 (B)
supervision__REC00_SENSE: R56000.2, R56001.2, U50600.2 (IN1-), U50600.5 (IN2+)
supervision__REC01_DC_OK: U51014.4 (Y)
supervision__REC01_HI_OK: U50601.1 (OUT1), U51014.1 (A)
supervision__REC01_LO_OK: U50601.7 (OUT2), U51014.2 (B)
supervision__REC01_SENSE: R56010.2, R56011.2, U50601.2 (IN1-), U50601.5 (IN2+)
supervision__REC02_DC_OK: U51015.4 (Y)
supervision__REC02_HI_OK: U50602.1 (OUT1), U51015.1 (A)
supervision__REC02_LO_OK: U50602.7 (OUT2), U51015.2 (B)
supervision__REC02_SENSE: R56020.2, R56021.2, U50602.2 (IN1-), U50602.5 (IN2+)
supervision__REC03_DC_OK: U51016.4 (Y)
supervision__REC03_HI_OK: U50603.1 (OUT1), U51016.1 (A)
supervision__REC03_LO_OK: U50603.7 (OUT2), U51016.2 (B)
supervision__REC03_SENSE: R56030.2, R56031.2, U50603.2 (IN1-), U50603.5 (IN2+)

Notes on the sheet:
DIGITAL SCCI ENGINEERING / ARTIFICIAL LOADS / NATIVE INDEPENDENT SUPERVISION
18 guarded stimulation conductors, 17 measured RHD-side windows; conditional healthy-switch blanking is not proven isolation.
All net labels are native electrical connections. Actual physical delay, leakage, failed switches and shared supplies remain bounded limitations.
Independent phase cap, heartbeat watchdog, rail windows and deliberate rearm have different functions. No automatic retry or reverse pulse.
