pratham-cloud-ctrl/Project-ATO/electronics/stage4/integrated-pcb/integration/boards/supervision/defaults.kicad_sch

## KiCad design electronics/stage4/integrated-pcb/integration/boards/supervision/defaults.kicad_sch (2026-10-16)

Schematic: defaults.kicad_sch

Parts:
R50950, R50951, R50952, R50953, R50954, R50955, R50956, R50957, R50958, R50959, R50960, R50961: 10k; R_0805_2012Metric

Connections:
SYS_6a132103__CH1_RUN: R50957.1
SYS_7db86ec0__PHASE_REARM0: R50952.1
SYS_46e29157__PHASE_REARM1: R50953.1
SYS_46ea5f03__CH0_REQUEST: R50954.1
SYS_56ebc071__CH0_MON_PERMIT: R50960.1
SYS_84f28705__CH1_ROUTE_LOCKED: R50959.1
SYS_695f3a7c__CH0_RUN: R50956.1
SYS_56562df4__GND: R50950.2, R50951.2, R50952.2, R50953.2, R50954.2, R50955.2, R50956.2, R50957.2, R50958.2, R50959.2, R50960.2, R50961.2
SYS_1954027d__CH0_ROUTE_LOCKED: R50958.1
SYS_82531809__FAULT_RESET: R50951.1
SYS_aa321af6__CH1_MON_PERMIT: R50961.1
SYS_bb444a6e__SUP_REARM: R50950.1
SYS_dd388269__CH1_REQUEST: R50955.1

Notes on the sheet:
DIGITAL SCCI ENGINEERING / ARTIFICIAL LOADS / NATIVE INDEPENDENT SUPERVISION
18 guarded stimulation conductors, 17 measured RHD-side windows; conditional healthy-switch blanking is not proven isolation.
All net labels are native electrical connections. Actual physical delay, leakage, failed switches and shared supplies remain bounded limitations.
Independent phase cap, heartbeat watchdog, rail windows and deliberate rearm have different functions. No automatic retry or reverse pulse.
