pratham-cloud-ctrl/Project-ATO/electronics/stage4/integrated-pcb/integration/boards/supervision/host_rails_2.kicad_sch

## KiCad design electronics/stage4/integrated-pcb/integration/boards/supervision/host_rails_2.kicad_sch (2026-10-16)

Schematic: host_rails_2.kicad_sch

Parts:
C50203, C50204, C50205: 100n X7R 16V; C_0805_2012Metric
R52030: 108750R 0.1%; R_0805_2012Metric
R52031, R52033, R52041, R52043, R52051, R52053: 10k 0.1%; R_0805_2012Metric
R52032: 121250R 0.1%; R_0805_2012Metric
R52034, R52044, R52054: 10k; R_0805_2012Metric
R52040: 327500R 0.1%; R_0805_2012Metric
R52042: 402500R 0.1%; R_0805_2012Metric
R52050: 560000R 0.1%; R_0805_2012Metric
R52052: 620000R 0.1%; R_0805_2012Metric
U50203, U50204, U50205: TPS3700DDCR; SOT-23-6

Connections:
SYS_15689dc4__VH_24: R52050.1, R52052.1
SYS_56562df4__GND: C50203.2, C50204.2, C50205.2, R52031.2, R52033.2, R52041.2, R52043.2, R52051.2, R52053.2, U50203.2 (GND), U50204.2 (GND), U50205.2 (GND)
SYS_ab932142__SUP_3V3: C50203.1, C50204.1, C50205.1, R52034.1, R52044.1, R52054.1, U50203.5 (VDD), U50204.5 (VDD), U50205.5 (VDD)
SYS_ce166826__HOST_5: R52030.1, R52032.1
SYS_fb2237f8__VA_15: R52040.1, R52042.1
supervision__H5_OV: R52032.2, R52033.1, U50203.4 (INB-_OV)
supervision__H5_RAIL_OK: R52034.2, U50203.1 (OUTA_UV_N), U50203.6 (OUTB_OV_N)
supervision__H5_UV: R52030.2, R52031.1, U50203.3 (INA+_UV)
supervision__H15_OV: R52042.2, R52043.1, U50204.4 (INB-_OV)
supervision__H15_RAIL_OK: R52044.2, U50204.1 (OUTA_UV_N), U50204.6 (OUTB_OV_N)
supervision__H15_UV: R52040.2, R52041.1, U50204.3 (INA+_UV)
supervision__H24_OV: R52052.2, R52053.1, U50205.4 (INB-_OV)
supervision__H24_RAIL_OK: R52054.2, U50205.1 (OUTA_UV_N), U50205.6 (OUTB_OV_N)
supervision__H24_UV: R52050.2, R52051.1, U50205.3 (INA+_UV)

Notes on the sheet:
DIGITAL SCCI ENGINEERING / ARTIFICIAL LOADS / NATIVE INDEPENDENT SUPERVISION
18 guarded stimulation conductors, 17 measured RHD-side windows; conditional healthy-switch blanking is not proven isolation.
All net labels are native electrical connections. Actual physical delay, leakage, failed switches and shared supplies remain bounded limitations.
Independent phase cap, heartbeat watchdog, rail windows and deliberate rearm have different functions. No automatic retry or reverse pulse.
