pratham-cloud-ctrl/Project-ATO/electronics/stage4/integrated-pcb/integration/boards/supervision/supervision.kicad_sch

## KiCad design electronics/stage4/integrated-pcb/integration/boards/supervision/supervision.kicad_sch (2026-10-16)

Schematic: supervision.kicad_sch

Parts:
J50001: EXTERNAL SUPERVISOR AND HOST RAILS; PinHeader_1x07_P2.54mm_Vertical
J50002: FLOATING AFE RAILS AND OBSERVED CONTROLS; PinHeader_1x06_P2.54mm_Vertical
J50003: RAW CONTROL / STATUS; PinHeader_1x12_P2.54mm_Vertical
J50004: EXISTING MONITOR OBSERVATIONS; PinHeader_1x09_P2.54mm_Vertical
J50005: EXPORTED NATIVE HEALTH / PERMISSION; PinHeader_1x13_P2.54mm_Vertical
J50006: DRIVER INTERNAL DIFFERENTIAL VOLTAGES; PinHeader_1x05_P2.54mm_Vertical

Connections:
SYS_0bc4e447__AFE_CONNECT: J50002.5
SYS_2d0e5b2e__CH0_QUIESCENT_OK: J50005.5
SYS_3fdd5066__AFE_P5: J50002.2
SYS_4eb6b999__AFE_ACQUIRE: J50002.6
SYS_4f66f129__MON_VREF: J50004.4
SYS_6a132103__CH1_RUN: J50003.7
SYS_7db86ec0__PHASE_REARM0: J50003.10
SYS_20eba8c2__CH1_QUIESCENT_OK: J50005.6
SYS_37cfe02a__MON_VMID: J50004.3
SYS_46e29157__PHASE_REARM1: J50003.11
SYS_46ea5f03__CH0_REQUEST: J50003.4
SYS_56ebc071__CH0_MON_PERMIT: J50004.5
SYS_65aafbb6__AFE_3V3: J50002.1
SYS_66aba95b__SUP_5: J50001.2
SYS_77c24b0d__GLOBAL_GUARD_EN: J50005.12
SYS_84f28705__CH1_ROUTE_LOCKED: J50003.9
SYS_88c50083__SUP_ARMED: J50005.9
SYS_401be33b__CH1_A_ROUTER: J50006.3
SYS_502efdd4__CH1_I_MON: J50004.2
SYS_695f3a7c__CH0_RUN: J50003.6
SYS_917b1360__CH0_A_ROUTER: J50006.1
SYS_8359fceb__CH1_EXT_SUP_OK: J50005.8
SYS_15689dc4__VH_24: J50001.6
SYS_56562df4__GND: J50001.7, J50003.12, J50004.9, J50005.13, J50006.5
SYS_98321c7b__AFE_ISOLATED_READY: J50005.4
SYS_1954027d__CH0_ROUTE_LOCKED: J50003.8
SYS_08572049__HOST_3V3: J50001.3
SYS_82531809__FAULT_RESET: J50003.2
SYS_93547907__RAILS_QUALIFIED: J50005.2
SYS_a83d484c__WATCHDOG_OK: J50005.3
SYS_aa321af6__CH1_MON_PERMIT: J50004.6
SYS_ab932142__SUP_3V3: J50001.1
SYS_bb444a6e__SUP_REARM: J50003.1
SYS_c73180be__CH1_B_BR: J50006.4
SYS_ce166826__HOST_5: J50001.4
SYS_d3eac10b__CH0_EXT_SUP_OK: J50004.7
SYS_d73cd2ee__AFE_N5: J50002.3
SYS_dd388269__CH1_REQUEST: J50003.5
SYS_de0a854a__CH1_EXT_SUP_OK: J50004.8
SYS_e3faaec0__WDI: J50003.3
SYS_e26747fb__CH0_EXT_SUP_OK: J50005.7
SYS_ee476f53__CH0_B_BR: J50006.2
SYS_f8e43b73__CH0_I_MON: J50004.1
SYS_fb2237f8__VA_15: J50001.5
SYS_fca1c340__AFEAGND: J50002.4
SYS_ff7fdc58__RESET_READY: J50005.1
supervision__CH0_ALLOW: J50005.10
supervision__CH1_ALLOW: J50005.11

Notes on the sheet:
DIGITAL SCCI ENGINEERING / ARTIFICIAL LOADS / NATIVE INDEPENDENT SUPERVISION
18 guarded stimulation conductors, 17 measured RHD-side windows; conditional healthy-switch blanking is not proven isolation.
