pratham-cloud-ctrl/Project-ATO/firmware/nrf5340/app/src/ato_pins.h

#ifndef ATO_PINS_H
#define ATO_PINS_H
/* Logical carrier mapping, not a wiring instruction for an unmodified DK.
 * P0.00/.01 retain LFXO. P0.02/.03 require NFCT disabled in the overlay/UICR.
 * Four additional 165s serialize ACTUAL active Q and health, not candidate data. */
enum {
    PIN_PRELOAD=2, PIN_COMMIT=3, PIN_ROUTE_REARM=4, PIN_ROUTE_ACK=5,
    PIN_WANT0=6, PIN_WANT1=7,
    PIN_RAW_SCK=8, PIN_RAW_MOSI=9, PIN_RAW_MISO=10, PIN_RAW_CS=11,
    PIN_RAW_RESET=12,
    PIN_AFE_SCK=13, PIN_AFE_MOSI=14, PIN_AFE_MISO=15, PIN_AFE_CS=16,
    PIN_AFE_CONNECT=17, PIN_AFE_RECORD=18, PIN_AFE_FAULT=19,
    PIN_MON_SCK=20, PIN_MON_MISO=21, PIN_BOTH_CNV=22,
    PIN_MON_CS0=23, PIN_MON_CS1=24,
    PIN_INT_RUN0=25, PIN_INT_RUN1=26,
    PIN_MON_REARM0=27, PIN_MON_REARM1=28,
    PIN_CTRL_SCK=29, PIN_CTRL_MOSI=30, PIN_DAC_CS=31,
    PIN_REQ0=32, PIN_REQ1=33, PIN_PLUS0=34, PIN_MINUS0=35,
    PIN_PLUS1=36, PIN_MINUS1=37, PIN_DRV_REARM=38,
    PIN_SUP_REARM=39, PIN_FAULT_RESET=40, PIN_WDI=41,
    PIN_PHASE_REARM0=42, PIN_PHASE_REARM1=43,
    PIN_UART_TX=44, PIN_UART_RX=45, PIN_SIDEBAND_LOAD=46,
    PIN_SIDEBAND_DATA=47
};
#define SIDEBAND_SENTINEL_MASK UINT32_C(0xfc000000)
#define SIDEBAND_SENTINEL_VALUE UINT32_C(0xa4000000)
#define ATO_RAW_SLOT_US 100u
#define ATO_RHD_FRAME_US 1000u
#define ATO_RHD_WORDS 19u
#define ATO_RHD_SLOTS_US 8u
#define ATO_RHD_RECOVERY_US 10000u
#define ATO_RAW_RECORDS 256u
#define ATO_RHD_RECORDS 256u
#define ATO_ENDPOINT_RECORDS 64u
#endif
