pratham-cloud-ctrl/Project-ATO/scripts/build_stage3_closeout_report.py

"""Render the historical conservative Stage 3 qualification verdict from saved evidence.

Default output remains explicitly DRAFT while the final replay is unavailable.
An explicit replay summary and audit can be supplied only as a pair. Loading them
does not itself close Stage 3; the report always reserves the exit decision for
the independent root review. No source/result/receipt is rewritten by this file.
"""
from __future__ import annotations

import argparse
from functools import partial
import hashlib
import json
import math
from pathlib import Path
from xml.sax.saxutils import escape

import matplotlib
from PIL import Image as PILImage
from reportlab.lib import colors
from reportlab.lib.styles import ParagraphStyle
from reportlab.pdfbase import pdfmetrics
from reportlab.pdfbase.ttfonts import TTFont
from reportlab.pdfgen.canvas import Canvas
from reportlab.platypus import Image, PageBreak, Paragraph, SimpleDocTemplate, Spacer, Table, TableStyle


ROOT = Path(__file__).resolve().parents[1]
OUT = ROOT / "output/pdf/ATO_stage3_closeout.pdf"
INK, BLUE, TEAL, GRAY = "#15293D", "#225B86", "#12756D", "#627485"
WIDTH = 475
DATE = "12 October 2026"
OBSERVER = "experiments/stage3/observed-state-observer/frozen/observer-confirmation-summary-12oct.json"
DEVELOPMENT = "experiments/stage3/observed-state-observer/frozen/observer-development-summary-12oct.json"
HISTORICAL = "results/stage3/isolated-pilot/summary.json"
MONITOR = "electronics/stage4/monitoring-study/results.json"


def load_json(path: Path) -> dict:
    value = json.loads(path.read_text(encoding="utf-8"))
    if not isinstance(value, dict):
        raise ValueError(f"Expected a JSON object: {path}")
    return value


def sha256(path: Path) -> str:
    return hashlib.sha256(path.read_bytes()).hexdigest()


def require(condition: bool, message: str) -> None:
    if not condition:
        raise ValueError(message)


def relative(path: Path) -> str:
    try:
        return path.resolve().relative_to(ROOT).as_posix()
    except ValueError:
        return path.name


def saved_evidence() -> tuple[dict, dict, dict, dict]:
    observer = load_json(ROOT / OBSERVER)
    development = load_json(ROOT / DEVELOPMENT)
    historical = load_json(ROOT / HISTORICAL)
    monitor = load_json(ROOT / MONITOR)
    # Fail if these report-specific scope assumptions change. Other studies keep
    # their own full auditors; this is not another scientific receipt writer.
    assert observer["no_dose"] and not observer["observer_private_inputs_used"]
    assert observer["independent_noise_pairs"] == 16 and observer["grid_captures"] == 32
    assert observer["current_supports_per_capture"] == 550 and observer["horizons_per_support"] == 26
    assert observer["coordinate_residuals"] == 915200 and observer["all_declared_coverage_available"]
    assert observer["all_conditions_both_grids_within_budget"]
    assert not observer["authoritative_predictor_or_pilot_changed"]
    assert not observer["neural_increment_assistance_or_retained_learning_tested"]
    assert historical["specification"]["practice_trials"] == 4
    assert historical["total_practice_launched_profiles"] == 0
    assert historical["total_off_launched_profiles"] == 0
    assert not historical["assisted_retained_advantage_established"]
    assert not monitor["four_percent_target_earned"] and len(monitor["runs"]) == 33
    return observer, development, historical, monitor


def replay_inputs(args: argparse.Namespace, observer: dict, development: dict) -> tuple[dict | None, dict | None]:
    if bool(args.pilot_summary) != bool(args.pilot_audit):
        raise ValueError("Supply both --pilot-summary and --pilot-audit, or neither.")
    if not args.pilot_summary:
        return None, None
    summary_path, audit_path = args.pilot_summary.resolve(), args.pilot_audit.resolve()
    require(summary_path.parent == audit_path.parent, "Replay summary and audit must share their package root.")
    require(summary_path.name == "summary.json" and audit_path.name == "audit.json", "Use the frozen package summary.json/audit.json pair.")
    package = summary_path.parent
    summary, audit = load_json(summary_path), load_json(audit_path)
    require(summary.get("schema") == "ato.stage3.frozen-observer-pilot.summary.v1", "Unreviewed replay summary schema.")
    require(audit.get("schema") == "ato.stage3.frozen-observer-pilot.audit.v1", "Unreviewed replay audit schema.")
    manifest = load_json(package / "artifact-manifest.json")
    require(manifest.get("schema") == "ato.stage3.frozen-observer-pilot.artifact-manifest.v1", "Unreviewed package manifest schema.")
    listed = set()
    for item in manifest["files"]:
        name = item["path"]
        path = (package / name).resolve()
        require(path.is_relative_to(package) and name not in listed, "Invalid/duplicate manifest path.")
        require(path.is_file() and path.stat().st_size == item["bytes"] and sha256(path) == item["sha256"],
                f"Replay package bytes changed: {name}")
        listed.add(name)
    require({"summary.json", "audit.json", "preflight.json", "root-review.json"} <= listed, "Missing replay identity bindings.")
    require(summary["preflight_sha256"] == sha256(package / "preflight.json"), "Replay preflight hash mismatch.")
    require(summary["review_sha256"] == sha256(package / "root-review.json"), "Replay pre-generation review hash mismatch.")
    pre_generation = load_json(package / "root-review.json")
    require(pre_generation["authorized"] is True and pre_generation["preflight_sha256"] == summary["preflight_sha256"],
            "Replay pre-generation review is not bound to its preflight.")
    expected_counts = {"practice_trials": 32, "off_assessments": 64, "total_launched_profiles": 0,
        "total_off_launched_profiles": 0, "frozen_vectors": 32, "frozen_targets": 832,
        "current_diagnostics": 32, "future_guard_targets": 800, "warmup_guard_targets": 800,
        "guard_checks": 1600, "guard_failures": 0, "current_diagnostic_failures": 0, "distinct_noise_arrays": 12}
    for key, expected in expected_counts.items():
        require(summary[key] == expected, f"Changed finite replay scope/outcome: {key}")
    for key in ("all_observers_sealed", "all_updates_causal", "matched_arms_identical"):
        require(summary[key] is True, f"Replay contract failed: {key}")
    for key in ("retained_advantage_established", "expert_transfer_established", "learner_spinal_neural_increment_established",
                "active_delivery_path_implemented", "actual_monitoring_exercised", "stage3_completion_decided_here"):
        require(summary[key] is False, f"Unreviewed active/efficacy scope: {key}")
    context = summary["baseline_context"]
    require(context == load_json(package / "preflight.json")["baseline_context"], "Admission context differs from approved preflight.")
    require(context["qualified"] is True and context["action_prefix"] == [] and
            context["temporal_holdout_used_for_admission"] is False and context["private_family_selector"] is False,
            "Changed no-dose admission domain.")
    require(context["support_start_s"] == .1 and context["support_end_s"] == 2.845 and context["sample_s"] == .005,
            "Changed finite admission supports.")
    require(context["instruction_hz"] == 1.0 and context["task_time_offset_s"] == 0.0, "Changed known cue domain.")
    require(len(context["horizons_s"]) == 26 and len(context["allocation_m"]) == 26, "Incomplete horizon vector.")
    expected_allocations = [max(a, b) for a, b in zip(
        [max(row["allocation_by_horizon_m"][h] for row in development["development"]) for h in range(26)],
        observer["aggregate_allocation_by_horizon_m"])]
    for h, (horizon, actual, expected) in enumerate(zip(context["horizons_s"], context["allocation_m"], expected_allocations)):
        require(math.isclose(horizon, .025 + .005*h, abs_tol=1e-12), "Changed execution horizon.")
        require(math.isfinite(actual) and actual <= .015 and math.isclose(actual, expected, rel_tol=2e-8, abs_tol=1e-11),
                "Admission allocation differs from development/confirmation evidence.")
    require(math.isclose(summary["maximum_allocation_m"], max(expected_allocations), rel_tol=2e-8, abs_tol=1e-11),
            "Wrong maximum admission allocation.")
    expected_audit = {"saved_records": 8, "sessions": 96, "sanitized_measurements_checked": 57600,
        "controller_replays": 32, "frozen_target_predictions_checked": 1664, "actual_noise_arrays_checked": 12}
    for key, expected in expected_audit.items():
        require(audit[key] == expected, f"Changed saved audit scope: {key}")
    for key in ("all_predeclared_sessions_present", "all_outcomes_retained", "source_input_freeze_verified"):
        require(audit[key] is True, f"Saved audit failed: {key}")
    require(audit["negative_controls"]["passed"] == 15 and audit["negative_controls"]["failed"] == 0,
            "Software contract probes failed or changed scope.")
    require(summary["tested_candidate_failed_gate_counts"] == {
        "independent_actual_response_domain_qualified": 192, "learning_interaction_qualified": 192,
        "whole_vector_correction_interval_within25mm": 192, "policy_enabled": 48}, "Changed candidate gate findings.")
    require(summary["grid_differences"]["launch_decisions_changed"] == 0, "Grid changed launch outcome.")
    return summary, audit


def exit_review(args: argparse.Namespace, replay: dict | None) -> dict | None:
    if not args.exit_review:
        return None
    require(replay is not None, "An exit review requires the explicit frozen replay summary/audit pair.")
    review = load_json(args.exit_review)
    require(review.get("schema") == "ato.stage3.closeout-review.v1", "Unreviewed exit-review schema.")
    require(review.get("decision") == "COMPLETE_WITHIN_SELECTED_DIGITAL_SCOPE", "Exit review does not authorize finite completion.")
    require(review.get("date") == "2026-10-12" and bool(review.get("reviewer")), "Missing explicit exit reviewer/date.")
    for key, path in [("reviewed_replay_summary_sha256", args.pilot_summary),
                      ("reviewed_replay_audit_sha256", args.pilot_audit),
                      ("package_manifest_sha256", args.pilot_summary.parent / "artifact-manifest.json")]:
        require(review.get(key) == sha256(path), f"Exit review is not bound to current {key}.")
    digest = review.get("independent_saved_data_review_sha256", "")
    require(len(digest) == 64 and all(c in "0123456789abcdef" for c in digest), "Missing independent saved-data review identity.")
    require(digest == sha256(ROOT / "docs/stage3/frozen-observer-pilot-independent-review.md"),
            "Independent saved-data review bytes differ from the exit decision.")
    for key, path in [("independent_audit_receipt_sha256", ROOT / "provenance/stage3-frozen-pilot-independent-audit.json"),
                      ("independent_auditor_sha256", ROOT / "scripts/audit_frozen_observer_pilot.py")]:
        require(review.get(key) == sha256(path), f"Independent audit identity differs: {key}")
    require(review.get("full_same_cohort_reproduction_passed") is True and
            review.get("source_and_original_evidence_unchanged") is True, "Exit decision lacks completed reproduction/source review.")
    require(review.get("active_delivery_implemented") is False and
            review.get("actual_monitoring_newly_validated") is False and
            review.get("retained_advantage_established") is False, "Exit decision overstates active/efficacy scope.")
    return review
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
