pratham-cloud-ctrl/Project-ATO/(commit log)

2026-10-07 Define spinal-interface concept, evidence boundaries and parametric mechanics
    [evidence-matrix.csv]
2026-10-07 Implement paired synthetic studies, negative controls and host-tested pulse integration
    [application_pulse_events.csv, application_pulse_requests.csv, firmware_pulse_trace.csv, motor_beta_sensitivity.csv, motor_example_trace.csv, motor_latency_mismatch.csv, motor_sensitivity.csv, motor_sessions.csv]
2026-10-07 Complete verified electronics revision, CAD, paper and digital walkthrough
    [C_0805_2012Metric.step, PinHeader_1x02_P2.54mm_Vertical.step, PinHeader_1x03_P2.54mm_Vertical.step, PinHeader_1x04_P2.54mm_Vertical.step, R_0805_2012Metric.step, SOIC-16_3.9x9.9mm_P1.27mm.step, SOIC-8_3.9x4.9mm_P1.27mm.step, SOT-23.step]
2026-10-08 Specify full SCCI mechanisms architecture and Stage 1 requirements
    [assumptions.csv, capability-map.csv, requirements.csv, source-audit.csv, verification-matrix.csv]
2026-10-08 Quantify SCCI architecture and add preliminary native CAD allocation
    [ATO_stage2_allocation.FCStd, ATO_stage2_allocation.step, biological-envelope-audit.csv, blanking.csv, channel-scaling.csv, compliance.csv, electrical-source-audit.csv, noise.csv]
2026-10-08 Close Stage 2 architecture audit with explicit scheduling and memory allocations
    [electrical-source-audit.csv, functional-port-map.csv, verification-progress.csv]
2026-10-08 Make CAD inspection receipt portable across Windows and Linux
2026-10-08 Implement Stage 3 SCCI mechanism studies and scoped verification
    [motor-summary.json, parameter-provenance.csv, verification-progress.csv]
2026-10-09 Qualify Stage 3 numerics and observed mechanism domains
    [motor-convergence-summary.json, parameter-provenance.csv, verification-progress.csv]
2026-10-12 Trace SCCI mechanisms through bounded pilot and native monitor
    [bom.csv, channel0.kicad_sch, channel1.kicad_sch, monitoring_cell.kicad_sch, requirements-trace.csv, verification-progress.csv]
2026-10-12 Verify phase-charge study and portable source reproduction
    [bom.csv, channel0.kicad_sch, channel1.kicad_sch, interval-results.csv, monitoring_cell.kicad_sch, requirements-trace.csv]
2026-10-12 Bound Stage 3 closeout and record engineering tool recommendations
2026-10-12 Confirm bounded observed-state prediction and verify target toolchain
    [verification-progress.csv]
2026-10-13 Specify conditional SCCI concept and preserve conservative findings
    [assumption-ledger.csv, learning-curves.csv, verification-progress.csv]
2026-10-13 Implement native dual-source driver and bounded circuit studies
    [bom.csv, current_driver.kicad_sch, interval-results.csv, permission0.kicad_sch, permission1.kicad_sch, source0.kicad_sch, source1.kicad_sch]
2026-10-13 Implement isolated native spinal recording front end
    [acquisition.kicad_sch, bank0.kicad_sch, bank1.kicad_sch, bank2.kicad_sch, bank3.kicad_sch, bom.csv, recording_front_end.kicad_sch, reference.kicad_sch]
2026-10-13 Implement native contact routing and MCP-backed verification
    [address.kicad_sch, admission.kicad_sch, bom.csv, collision.kicad_sch, contact_router.kicad_sch, requirements-trace.csv, source0.kicad_sch, source1.kicad_sch]
2026-10-13 Implement independent terminal shutdown and supervision
    [admission.kicad_sch, admission_2.kicad_sch, afe_bank0.kicad_sch, afe_bank1.kicad_sch, afe_bank2.kicad_sch, afe_bank3.kicad_sch, afe_bank4.kicad_sch, afe_logic.kicad_sch]
2026-10-14 Implement power reference and complete quantitative budgets
    [afe3.kicad_sch, afen.kicad_sch, afep.kicad_sch, bom.csv, boost15.kicad_sch, boost24.kicad_sch, enable.kicad_sch, enable_2.kicad_sch]
2026-10-14 Complete monitoring and companion interface package
    [adc.kicad_sch, bom.csv, companion.kicad_sch, handoff.kicad_sch, health.kicad_sch, inputs.kicad_sch, monitoring-transport-wiring.csv, monitoring_transport.kicad_sch]
2026-10-14 Implement actual nRF5340 target firmware and bounded control runtime
    [nrf5340-pin-map.csv, requirements-trace.csv]
2026-10-15 Integrate populated SCCI reference boards and controller carrier
    [ATO_integrated.kicad_sch, BT40F_Manufacturer_66Pad.FCStd, BT40F_Manufacturer_66Pad.step, RHD2216_QFN56_8x8_P0.5_EP6.1.FCStd, RHD2216_QFN56_8x8_P0.5_EP6.1.step, TRACO_TMR3_SIP8_21.8x9.1_P2.54.FCStd, TRACO_TMR3_SIP8_21.8x9.1_P2.54.step, Texas_DGN0008D_VSSOP-8-1EP_3x3mm_P0.65mm_EP2x2.94mm_Mask1.57x1.89mm.FCStd]
2026-10-16 Complete native mechanical assemblies and conditional spinal package
    [ATO_engineering_assemblies.blend, ATO_future_interface.FCStd, ATO_future_interface.step, ATO_future_interface.stl, ATO_future_interface_exploded.FCStd, ATO_future_interface_exploded.step, ATO_harness_routes.FCStd, ATO_mating_interfaces.FCStd]
2026-10-16 Complete integrated SCCI manuscript and digital release dossier
    [evidence-claims.csv, requirements-claims-trace.csv]
2026-10-17 Review complete SCCI project and fix UART frame scheduling
    [ato_backend.c, build_revision.py, verify_revision.py, verify_stage6_release.py]
2026-10-17 Normalize firmware text bindings and check canonical Git artifacts [skip ci]
    Only release-verification code, its receipt, the review entry and Git manifest change. Historical study inputs and workflow remain identical to 7825512, whose full study run continues. Run the integrated release workflow explicitly for this corrected commit to validate the changed release layer without duplicating the unchanged study sweep.
    [verify_stage6_release.py]
2026-10-20 Add visual reader guides for theory, CAD and KiCad [skip ci]
    [build_reader_previews.py, verify_stage6_release.py, verify_viewer_navigation.py]
2026-10-20 Add browser CAD and PCB inspection with complete native downloads
    [ATO_Future_Interface.step, ATO_contact-router.step, ATO_controller-carrier.step, ATO_current-driver.step, ATO_monitoring-cell.step, ATO_monitoring-transport.step, ATO_power.step, ATO_recording-front-end.step]
